martiyanov/bukifon/docs/assets/design-panel-3.jpg

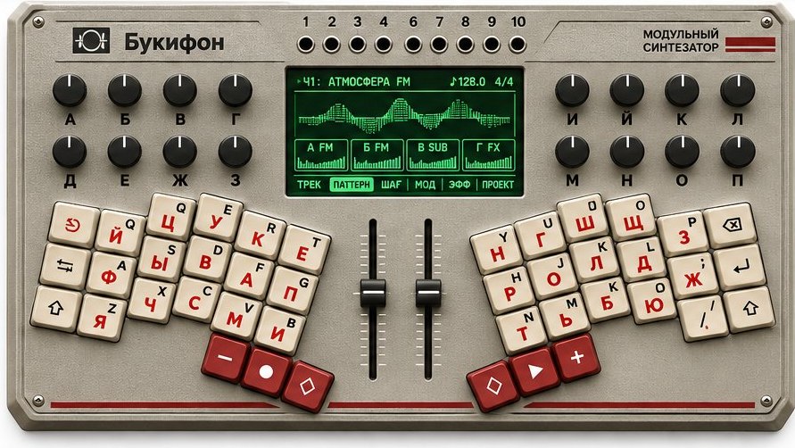
docs/assets/design-panel-3.jpg
