martiyanov/bukifon/docs/press/design-panel-1.jpg

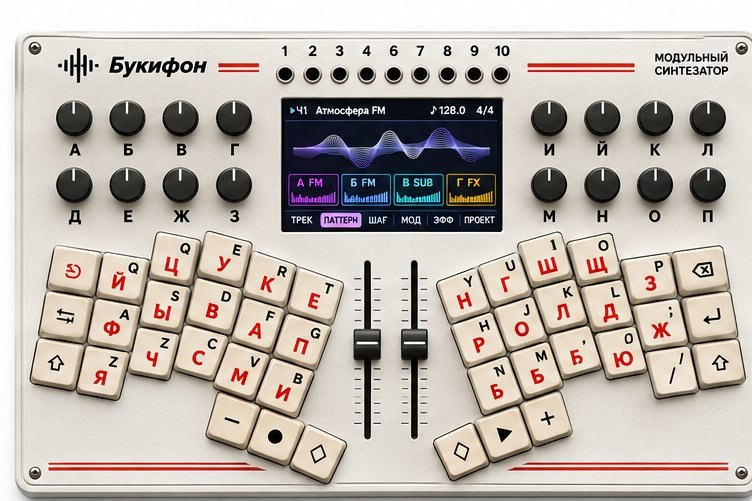
docs/press/design-panel-1.jpg
