martiyanov/bukifon/README.md

# Букифон (Bukifon) — открытая платформа: сэмплер + синтезатор + модули

**Версия: 0.57.0** · сайт: **https://bukifon.ru/** (канон, HTTPS), `bukifon.com` → 301, зеркало: https://martiyanov.github.io/bukifon/ (см. [`VERSION`](VERSION), [`CHANGELOG.md`](CHANGELOG.md))

**Букифон** — настольный музыкальный инструмент-платформа, который собирается из
доступных компонентов, печатается на 3D-принтере, расширяется модулями и полностью
открыт: схемы (KiCad), прошивка (C++), механика (STL/генератор), документация.

## Народный синтезатор

Букифон задуман как **народный инструмент**: доступный, повторяемый и открытый. Целевые
ориентиры комплекта (без печати и работы): «народный» на ESP32-S3 — **≤ $200**,
«стандарт» на ESP32-P4 — **≤ $300**, «полный» с аналоговыми картриджами — **≤ $400**.
Подробности и cost-down план — [spec/00-vision.md §13](spec/00-vision.md).

## Что это по сути

Один корпус **380 × 210 × 63 мм**, три режима:

- **Sampler** (в духе Elektron Digitakt) — сэмплы, запись/импорт по USB-C и SD,
  срезы, гранулярность, insert-FX, p-locks, условия триггеров;
- **Synth** (в духе Elektron Syntakt) — 4 части, 8 голосов, 4-оп FM, wavetable,
  ZDF-фильтры, лестница Муга, 3D-мод-матрица 16 слотов;
- **Hybrid** — сэмплы как источники синтеза, общий секвенсор и мод-матрица.

Плюс **режим компьютерной клавиатуры/контроллера**: USB-C композит (HID-клавиатура + MIDI +
UAC2 аудио), DAW-режим (16 энкодеров как CC, transport), **Wi-Fi и Bluetooth** (BLE-MIDI,
BLE HID, передача проектов). То есть Букифон — ещё и необычная механическая клавиатура
с 16 ручками.

**Свои модули может писать каждый:** программный модуль (SDK `BukifonModule`, C++/Lua),
аналоговый картридж на шине 26-pin или сменная панельная дека (18 пэдов / 42 клавиши).
Подробнее — [spec/00-vision.md §12](spec/00-vision.md).

## Текущее состояние (v0.57.0)

| Блок | Состояние |
|---|---|
| **Панель v0.4** | 380 × 210 × 3 мм: 42 клавиши Lapka-42 (точная геометрия, ±18°), 16 энкодеров Ø14, экран 5.0″ 800×480 без рамки, 10 mini-jack, 2 фейдера 60 мм; пересечений 0 |
| **Корпус v0.5-B** | **клин 8°**: 380 × 210 × 61.5 мм (перед 32 / зад 61.5), 6 деталей watertight, печать без поддержек 279 г / 18.3 ч, fitcheck 32/0, профиль 1:1 для картонной проверки |
| **EXT в прошивке** | 8 MIDI-треков (CH/PC/vel/len, 1 CC p-lock), clock out/in 24 ppqn, GEN на внешних, live record, save/load EXTP+CRC32, DIN+USB без дублей; UI-вкладка EXT; **407/407 тестов** (`docs/70 §7`) |
| **Микрофон/голос (реализовано)** | PANEL-2 rev.3: **ICS-43434 I2S MEMS** + порт Ø1.8 (122, 5.5) + LED; CORE-2 rev.3: I2S1 GPIO40/41/42 + J19 + 3.5 мм jack/MAX9814/TS5A + SW3 mute; прошивка: захват/запись ≤30 с/битбокс kick-snare-hat/UNDO/приватность/UI MIC; **407/407 тестов** |
| **Идея → звук** | метрики интуитивности в docs/68: time-to-sound ≤10 с, time-to-idea ≤30 с, 0 критических ошибок за 5 мин, blind-тест 5 людей |
| **Module SDK v0.2** | манифест `bukifon.module.v2` (schema/id/version/api/abi/permissions/params/sha256), валидатор + безопасный loader (API/ABI/SHA до исполнения), 2 примера (`mod_tape_delay`, `mod_euclid_arp`), упаковка `--check` |
| **Внешний секвенсор** | **8 MIDI-треков + 4 внутренние партии**: channel/PC/vel/length, clock out/in, p-lock CC, GEN на внешних, live record; паритет с Octatrack по MIDI (`docs/70`) |
| **Философия интерфейса** | «конституция»: 10 принципов, зеркальная карта ручка↔ячейка, грамматика жестов (`docs/68`) |
| **Читаемость** | экран 5″ 800×480 = 188 PPI, пиксель 0.135 мм; шкала 12/18/24–28 px, проверка по угловым минутам и контрасту (`docs/69`) |
| **Демо = панель** | раскладка как у реального синтезатора (16 энкодеров вокруг экрана, 10 джеков сверху, кластеры ±18°, фейдеры между кластерами); проверка `tools/check_demo_layout.js` → LAYOUT OK (`docs/67`) |
| **Внешнее ревью** | ChatGPT-ревью (`tools/chatgpt_review.sh`, Codex) — 10 рисков, 5 изменений; внедрены контекст-строка/HOME/UNDO/COMPARE/Shift-overlay (`docs/reviews/`, `docs/65 §4a`) |
| **UX-паттерны** | исследование синтезаторных практик (Elektron, Kaleidoscope Минкина, Nord/Deluge/OP-1/Push/M8) и рубрика 9/10 — `docs/65`; GEN-страница, мультивыбор, пресеты, A/B, mod-индикация в демо |
| **Home offload** | `tools/home_offload.sh` — rsync+SSH на домашний ПК (8 ядер, RTX 3060); host-тесты прошли там 226/226 |
| **Темы в прошивке** | 4 темы × 12 токенов (docs/62), рендер на токенах, CLI `--theme`, **226/226 тестов** |
| **UI/UX** | 3 итерации, 16 энкодеров (8 страниц + 8 макросов), фейдеры TRACK/SCENE/DJ + Fn, REC-ресемплинг, 4 темы экрана 800×480 (`docs/61–64`) |
| **Кириллица** | 66 глифов 6×8 (А–Я, а–я, Ё/ё), UTF-8 lookup, транслитерация удалена; метрика: max 90 px при ячейке 94 px; 10 скриншотов RU/EN |
| **Локализация** | UI RU/EN: 90+ ключей (`tr()`), переключение и сохранение языка (project v2), **кириллический glyph-пакет 6×8 (66 глифов, транслитерация удалена)**, 10 RU/EN-скриншотов |
| **Хранение** | storage backend (MockFlash/SD/NVS-stub), **атомарная A/B запись** с CRC32 и recovery; project v2, preset bank, язык — через backend; power-cut/bit-flip тесты |
| **Проект v2** | `.bkfp`: 4 партии + 8 EXT-треков + GEN + mic + модули + тема/транспорт, CRC32, миграция v1, транзакционная загрузка |
| **P4 bring-up app** | UART-баннер/чип/PSRAM, I2C-скан 8/8, RGB565-паттерны, engine bench ≤650 µs, I2S MEMS 1 с; **сборка 330 512 Б, 0 warnings** (IDF 5.5, home) |
| **P4 toolchain** | **сборка проверена** на `pole`: ESP-IDF v5.5 → `bukifon_p4.bin` 250 КБ (83 % app-раздела свободно), bootloader+table; PlatformIO P4 по-прежнему не умеет (`docs/59`) |
| **Демо RU/EN** | 256 ключей, переключатель RU/EN (URL `?lang=en`, localStorage), canvas через `t()`; **a11y**: роли/aria, клавиатурные энкодеры/фейдеры/джеки, видимый фокус, live-region; UX-тест 8/8 RU и EN |
| **Веб-демо** | интерактивная модель: [martiyanov.github.io/bukifon/demo](https://martiyanov.github.io/bukifon/demo/) — 42 клавиши, 16 энкодеров, секвенсор, FM-звук, 4 режима (`docs/58`) |
| **Закупки** | единый лист: P1 $426 + PWR $276.92 + LCD-адаптер $72.8 + печать $42 ≈ **$784** с зачётом пересечений (`docs/54`) |
| **Серийники/QR** | `tools/make_labels.py` (A4 3×8, 60×30 мм, QR+manifest), identity 114 B + двухслотовая flash-модель (`docs/55`); **216/216 тестов** |
| **Протокол P1** | 8 сценариев, пороги, пустые таблицы, матрица P4/H743 + CSV-форма (`docs/56`) |
| **LCD-адаптер** | FFC-40 breakout для HotLCD ST7262 (31×0R pinout-jumper, 35 TP, JST подсветки), ERC 0/0 — проверка экрана на стенде до PCB (`docs/49`) |
| **Release bundle** | `tools/make_release_bundle.sh` → 339 файлов / 15 МБ, SHA256SUMS; `RELEASE_BUNDLE.md`, `docs/50` |
| **Медиа** | PNG→JPEG (60 файлов, −83 МБ), SVG→.svg.gz (19, −46 МБ), дубликаты убраны; tracked **71 МБ** (`docs/52`) |
| **Дисплей** | RGB565 поверх RGB888 FPC-40: **TFT-H050A1SVIST4R40** (HotLCD/ST7262, 40-pin, 1000 нит, $18–25), резерв NHD/EJ050NA; DSI — rev.3.1 (`docs/47`) |
| **PWR-стенд** | 13 измерений до PCB (`docs/44`); BOM: база $123.92 + EVM $153 = **$276.92** (вариант A, D-79); breadboard запрещён |
| **Fab dry-run** | 4 пакета `fab/*/rev1-scaffold`: 16 Gerber-слоёв, PTH+NPTH (129/45/45/4 отверстий), CPL⊆BOM, Edge.Cuts, **checker PASS**; `tools/export_fab_dryrun.sh` — проверка пайплайна до заказа |
| **P4 NVS/partitions** | `partitions.csv` (nvs 24K, factory 1 MiB, storage 1 MiB, coredump 64K), real NVS backend, self-test `project.meta`/`lang`; **bin 369 552 Б, 65 % factory свободно** |
| **PCB rev.1: статус** | 0 placeholder, но **328 упрощённых падов** и GND без заливки: полные реальные пассивы/зоны **не проходят DRC** на 200×108 при 373 компонентах — оставлен DRC-clean каркас (0/0); скрипты упаковки/зон сохранены до трассировки после MCU freeze (docs/82 §12, D-105) |
| **PCB rev.1: реальные футпринты** | **0 placeholder**; кастомные `.kicad_mod` (P4-адаптер, C6, MP1584, Choc) + стандартные KiCad (TRS/DC/кнопки/QFN); DRC-классы Default/Power/USB_HS(90 Ω)/Audio/RF; **DRC 0/0**, RULES PASS; план GND-полигонов |
| **PCB rev.1: нетлист + футпринты** | CORE-2 **373 refs/1224 пада** (16 placeholder), PANEL-2 left/right 181/174 (по 21 Choc), PWR-2 128 (0 placeholder); **DRC 0/0**, verify PASS; unconnected — неразведённые цепи |
| **PCB rev.1 scaffolds** | KiCad-каркасы: CORE-2 200×108 6L, PANEL-2 2×180×190 4L, PWR-2 90×70 4L/2oz; Edge.Cuts/NPTH/keepout, **DRC 0/0**, verify ±0.05 мм (`hardware/*/rev1/`) |
| **Раскладка Lapka-42** | клавиши PANEL-2 исправлены: каждая плата — свои 21 (L01–L21 / R01–R21) по spec (остаточное 0.006 мм от Lapka-42), DRC 0/0; превью `docs/assets/panel-lapka-*.png` |
| **Вырезы разъёмов** | **11 задних**: MIDI IN/OUT **TRS-A Ø8.2** (X30/44), DC Ø9 X91, EXP Ø8.2 X120.5, mic Ø8.2 X140, **LINE OUT** (стерео TRS) X160, PHONES X172, AUDIO IN L/R X184/196, **CV5/6** X208/220; SD 12×2, USB-C; перемычки ≥3.8 мм; B-light **228.9 г/11.0 ч**; fitcheck 16/0 |
| **Board-fit (PCB rev.1)** | контуры для KiCad: CORE-2 200×108, PANEL-2 две платы 180×180 (360×190), PWR-2 90×70; DXF/assembly/spec, 22 проверки 0 конфликтов (`mechanical/board-fit/`) |
| **PANEL-2 ∥ панели** | стойки/плата наклонены вместе с панелью: угол **0.00°**, зазор **12 мм**, оси энкодеров/клавиш ⊥ панели; fitcheck B-light **47/0**; B-light **228.9 г/11.0 ч**; `panel_parallel.jpg` |
| **Корпуса** (с микрофоном) | B_mic ≈278 г/18.4 ч, C_mic ≈316 г/20.9 ч (порт/LED/MEMS на панелях; fitcheck 44/0 и 49/0) |
| **Корпуса** | A flat 301 г/19.9 ч · B 8° 275.5 г/18.2 ч · **B-light 228.9 г / 11.0 ч** · C 12° 313.2 г/20.7 ч; B_mic 276.8, C_mic 314.6; PANEL-2 ∥ панели (0.00°) — `docs/45` |
| **Factory test** | 14 тестов, CLI `factory --json`, loopback-плаг, EOL 2–2.5 мин (`docs/46`); **183/183 тестов** |
| **Product BOM P4 (первый SKU)** | `BOM-p4.csv` + `docs/33/40` (rev.3 с микрофоном): COGS **$241/$215/$196** на 1/10/25 (mic-узел $17.6); **P4 Standard $299** (gross 28.1 % на 10, net ~18 %), Full Bundle $399; S3 lite — $224/$199/$181 |
| **Сборка** | `renders/templates/bukifon_assembly_map_1to1.pdf` (4 стр: слои, панель 1:1, крепёж/шлейфы), `docs/34`, `docs/35` print-first, 3D exploded |
| **UI = философия** | 16 ячеек зеркально ручкам, шкала 12/18/24–28 px, контекст-строка, HOME; Cream AA; **263/263 тестов** (`docs/66/68/69`) |
| **GEN/UX в прошивке** | PROB/EUCLID/MUTATE/SCALE/ARP/EVOLVE/SEED (детерминированно), 5-я вкладка GEN, 8 пресетов с CRC32, A/B, мультивыбор, mod-visible «M»; **248/248 тестов** (`docs/66`) |
| **Прошивка v0.7** | **160/160 тестов**; S3 HAL сборка SUCCESS; spike `spike_s3` SUCCESS; **P1 P4-профиль** PASS (RGB/DSI 52 fps, HS UAC2 8×8, max block 320 µs); UI 4 режимов; Module API v0.1 |
| **CORE-2 rev.2 (основная плата)** | ESP32-P4 + ESP32-C6, 32 МБ PSRAM, USB HS, RGB565/DSI, ERC 0/0; DFM/DFT: 30 TP, **21 self-test** (вкл. микрофон), recovery, 6 слоёв — PRE-FREEZE |
| **Корпус B-light** | **228.9 г / 11.0 ч** (−17 % массы, −39 % времени): стенки 2.0/дно 1.8, 3 периметра + локальные рёбра, панели-оболочки; 6 STL watertight, fitcheck **47/0**; PANEL-2 ∥ панели |
| **CORE-2 rev.2** | схема внесена: J17/J18, входы 12V_EXT/N12_EXT/+5V_EXT/5V_LED, EN-развязки, CV IN3/4 на MCP3208, re-pin J14/J15/J16, DNP 46; **ERC 0/0**, pinmap PASS |
| **PANEL-2 rev.2** | J13/J14 (5V_LED, LED_RET, EN_RAILS, EN_LED5), re-pin по канону, GATE_IN на MCP23017 0x23, LED_DATA 3.3 В + shifter; **ERC 0 err/6 warn**, verify 1290/0 |
| **PWR-2 rev.1** | батарея 1S2P + BMS BQ297 + **MAX17048** + рельсы шины: +12 В 330 мА (TPS61088), −12 В 95 мА (LMR33630 IBB), +5 В 1.6 А, +5V_LED; master load-switch, EN рельсов, питание только от BQ24074 OUT/VSYS; ERC **0/0**, PRE-FREEZE |
| **Электроника rev.1** | **CORE-2** (ESP32-P4 + ESP32-C6 Wi-Fi/BLE по SPI, USB HS composite, аудио PCM5102A/PCM1808, CV, MIDI, шина) — ERC **0/0**, pinmap PASS (54/55 GPIO), **PRE-FREEZE**; **PANEL-2** (16 энкодеров + 42 клавиши через 4× MCP23017, LCD, 10 джеков, 2 фейдера, 3 шлейфа) — ERC 0 errors / 6 warnings, **PRE-FREEZE**. Не заказывать до бенчмарка P1 |
| **Прошивка v0.6** | host-демо UI 800×480, секвенсор 4×16 (хранение 8 дорожек), save/load с CRC16, Module API v0, режимы Synth/Sampler/DAW/USB-keyboard, каркасы USB composite и BLE/Wi-Fi; **120/120 тестов**; сборки ESP32-S3 и RP2040; P4 — toolchain пока нет |
| **P1-стенд** | `docs/26` — что купить (P4 EV, H743, S3, PCM5102A/1808, дисплей, SD, БП/нагрузка), схема стенда, протокол измерений и таблица решения; без стенда MCU не фиксируется |
| **Cost-down / первый SKU** | `docs/27`: product BOM вместо «мастерской», S3-base **kit $199** (партия 10–25, direct-sale), P4 $299 после P1, full $399 bundle; батарея — не россыпь 18650 |
| **Бумажный макет** | `renders/templates/bukifon_paperkit_1to1.pdf` (4 стр: панель 1:1 ×2, профиль 8°, карта 7 проверок) + `docs/28` |
| **Бенчмарк P1** | workload freeze + харнесс `firmware/bench` (7 сценариев, JSON/CSV, детерминизм, 0 аллокаций): host worst **218 µs** = 16.4 % дедлайна, 431 µs запаса до критерия 650 µs; `bench_s3` собран; **протокол приёма стендов P4/H743 готов** (`docs/56`, CSV-форма), стенды — следующие |
| **SDK модулей** | Module API v0 (10 функций, лимиты, WCET/bypass), каталог `modules/` (template + gain_fx C++ + LFO Lua), `tools/validate_module.py`, `tools/new_module.sh`, CI `modules.yml` |
| **BOM (draft)** | 92 позиции: база ≈ 21 657 ₽ (~$271), полный ≈ 32 518 ₽ (~$406); «народная» цель ≤ $200 / стандарт ≤ $300 — cost-down план в spec/00 §13 |
| **Безопасность** | история очищена от GPS EXIF и vendor-PDF с IP, санитизация путей, `SECURITY.md`, `tools/security_scan.sh` |

## Ключевые документы

| Документ | О чём |
|---|---|
| [spec/90-requirements-registry.md](spec/90-requirements-registry.md) | реестр требований R-01…, журнал решений D-01… — единственный источник истины |
| [docs/12-roadmap.md](docs/12-roadmap.md) | дорожная карта P0–P8 с числовыми критериями выхода |
| [docs/10-elektron-hardware.md](docs/10-elektron-hardware.md) | что стоит внутри Elektron (ColdFire, DSP56300, SHARC, FPGA) |
| [docs/11-esp32-feasibility.md](docs/11-esp32-feasibility.md) | можно ли на ESP32: расчёт нагрузки, P4/S3/H743/Teensy |
| [docs/03-second-opinion-mcu.md](docs/03-second-opinion-mcu.md) | независимое ревью плана (DeepSeek) |
| [docs/04-consultation-gpt.md](docs/04-consultation-gpt.md) | консультация GPT/Codex (gpt-5.6) по MCU и архитектуре |
| [docs/00-context-transfer.md](docs/00-context-transfer.md) | контекст проекта для передачи другим агентам |
| [PULL_REQUEST.md](PULL_REQUEST.md) | описание MR v0.4 |
| [docs/20-analog-projects.md](docs/20-analog-projects.md) | разведка аналогов (Deluge, M8, Polyend, Daisy, PreenFM, Norns…) |
| [docs/21-ergonomics.md](docs/21-ergonomics.md) | эргономика: клин 8°, 32/61.5 мм, экран 35° |
| [docs/22-night-plan.md](docs/22-night-plan.md) | ночной план и scope freeze |
| [docs/23-nightly-report.md](docs/23-nightly-report.md) | отчёт ночи: что готово/симулируется/нельзя заказывать |
| [docs/24-module-sdk.md](docs/24-module-sdk.md) | SDK модулей: Module API v0, упаковка, ограничения |
| [docs/25-power-architecture.md](docs/25-power-architecture.md) | питание: ±12 В, BQ24074, MAX17048, земля, стенд до PCB |
| [docs/26-p1-bench-kit.md](docs/26-p1-bench-kit.md) | P1-стенд: закупка, схема, протокол измерений, таблица решения MCU |
| [docs/27-costdown.md](docs/27-costdown.md) | cost-down, product BOM, первый SKU S3-kit $199, батарея, дефицит |
| [docs/28-paper-kit.md](docs/28-paper-kit.md) | бумажный макет 1:1 за 30 минут: 7 проверок эргономики |
| [docs/29-p1-order.md](docs/29-p1-order.md) | точный список заказа P1-стенда (что, где, сколько) |
| [docs/54-shopping-list.md](docs/54-shopping-list.md) | **единый закупочный лист**: P1 + PWR + LCD-адаптер + печать, итоги A–D, порядок |
| [docs/30-security-purge.md](docs/30-security-purge.md) | запрос на purge старых PII-объектов GitHub (SHA) |
| [docs/31-core-s3-constraints.md](docs/31-core-s3-constraints.md) | CORE-S3: GPIO 31, 1-bit SD, USB endpoint ceiling, RGB+1FB, TPS63802 |
| [docs/32-progress-report.md](docs/32-progress-report.md) | сводный отчёт v0.4→v0.13.0: вехи, блокеры, следующий шаг |
| [docs/49-lcd-adapter.md](docs/49-lcd-adapter.md) | LCD FFC-40 адаптер и pinout J12 |
| [docs/50-downloads.md](docs/50-downloads.md) | где скачать STL/PDF/BOM/прошивку |
| [docs/51-pwr-log.md](docs/51-pwr-log.md) | журнал 13 измерений PWR и матрица go/no-go |
| [docs/52-media-policy.md](docs/52-media-policy.md) | форматы медиа и размер репозитория |
| [docs/54-shopping-list.md](docs/54-shopping-list.md) | единый закупочный лист до PCB |
| [docs/55-labels-traceability.md](docs/55-labels-traceability.md) | серийники, QR-метки, traceability |
| [docs/56-p1-measurements.md](docs/56-p1-measurements.md) | протокол P1: P4 vs H743 |
| [docs/57-usability-test.md](docs/57-usability-test.md) | тест эргономики на макете |
| [docs/58-web-demo.md](docs/58-web-demo.md) | веб-демо интерфейса и звука |
| [docs/59-p4-toolchain.md](docs/59-p4-toolchain.md) | P4: ESP-IDF scaffold и сборка |
| [docs/60-module-distribution.md](docs/60-module-distribution.md) | упаковка и распространение модулей |
| [docs/61-ui-design.md](docs/61-ui-design.md) | UI/UX: итерации и лучшие практики |
| [docs/62-screen-palette.md](docs/62-screen-palette.md) | палитра экрана 800×480 (4 темы) |
| [docs/63-resampling-looper.md](docs/63-resampling-looper.md) | ресемплинг (v1.0) и луппер (backlog) |
| [docs/64-fader-modes.md](docs/64-fader-modes.md) | режимы фейдеров: Octatrack-сцены, DJ, Fn |
| [docs/65-ux-patterns.md](docs/65-ux-patterns.md) | UX-паттерны синтезаторов, связка с железом, рубрика 9/10 |
| [docs/66-ux-implementation.md](docs/66-ux-implementation.md) | реализация UX-паттернов: GEN, пресеты, A/B, мультивыбор |
| [docs/67-panel-demo-layout.md](docs/67-panel-demo-layout.md) | сверка раскладки демо с панелью v0.4 |
| [docs/68-interface-philosophy.md](docs/68-interface-philosophy.md) | философия интерфейса и продукта (конституция) |
| [docs/69-screen-legibility.md](docs/69-screen-legibility.md) | читаемость экрана 800×480: физика, шрифты, контраст |
| [docs/70-external-sequencer.md](docs/70-external-sequencer.md) | Букифон как секвенсор для внешних синтезаторов |
| [docs/71-mic-voice.md](docs/71-mic-voice.md) | микрофон/голос: запись, битбокс, вокодер, приватность |
| [docs/72-assembly-workshops.md](docs/72-assembly-workshops.md) | где собрать: мастерские Москвы/СПб/НН, RFQ, цены |
| [docs/73-morning-report.md](docs/73-morning-report.md) | утренний отчёт: состояние, блокеры, план, риски |
| [docs/74-usability-test-harness.md](docs/74-usability-test-harness.md) | blind UX-тест: 8 задач, таймер, JSON (`/demo/?test=1`) |
| [docs/75-release-readiness.md](docs/75-release-readiness.md) | ворота G1–G12 до v1.0-rc, статусы, stop/go |
| [docs/76-known-limitations.md](docs/76-known-limitations.md) | честные ограничения v1.0-rc (до покупки) |
| [docs/77-quick-start.md](docs/77-quick-start.md) | быстрый старт: идея за 10 минут |
| [docs/78-support-repair.md](docs/78-support-repair.md) | поддержка/ремонт: диагностика, recovery, запчасти, гарантия |
| [docs/79-competitors-2026.md](docs/79-competitors-2026.md) | аналоги 2025–2026, позиционирование и цены |
| [docs/80-day1-bringup.md](docs/80-day1-bringup.md) | день 1 с железом: PWR→P1→CORE-2, 15 шагов, stop/go |
| [docs/81-faq.md](docs/81-faq.md) · [docs/press/](docs/press/) | FAQ для покупателя · пресс-кит (буилерплейт RU/EN, изображения) |
| [docs/82-pcb-layout-plan.md](docs/82-pcb-layout-plan.md) | план разводки rev.1: стеки, floorplan, DRC/DFM, критичные цепи |
| [docs/83-fab-package.md](docs/83-fab-package.md) · [fab/](fab/) | состав fab-пакета, CPL/BOM, чек-лист, приёмка; `tools/check_fab_package.py` |
| [docs/84-costdown.md](docs/84-costdown.md) | cost-down: где деньги, варианты снижения, маржа $299/$319/$349 |
| [docs/85-second-source.md](docs/85-second-source.md) | вторые источники, supply-риски, чек-лист до заказа |
| [docs/86-backlog-webapp-plugin.md](docs/86-backlog-webapp-plugin.md) | бэклог: сайт на VDS, PWA-приложение, DAW-плагин |
| [docs/91-software-modules.md](docs/91-software-modules.md) | софтовые модули/машины: `.bkm`, USB/SD/Wi-Fi, sandbox, каталог |
| [docs/87-v1.0-rc-notes-draft.md](docs/87-v1.0-rc-notes-draft.md) | черновик release notes v1.0-rc (критерии, проверки) |
| [docs/88-vds-deploy.md](docs/88-vds-deploy.md) | деплой сайта на VDS (bukifon.ru/.com): DNS, TLS, скрипт |
| [docs/en/README.md](docs/en/README.md) · [quick-start](docs/en/quick-start.md) | English docs index / quick start |
| [docs/72-assembly-workshops.md](docs/72-assembly-workshops.md) | где собрать: мастерские Москвы/СПб/НН, RFQ, цены |
| [docs/73-morning-report.md](docs/73-morning-report.md) | утренний отчёт: состояние, блокеры, план, риски |
| [docs/74-usability-test-harness.md](docs/74-usability-test-harness.md) | blind UX-тест: 8 задач, таймер, JSON (`/demo/?test=1`) |
| [docs/75-release-readiness.md](docs/75-release-readiness.md) | ворота G1–G12 до v1.0-rc, статусы, stop/go |
| [docs/76-known-limitations.md](docs/76-known-limitations.md) | честные ограничения v1.0-rc (до покупки) |
| [docs/77-quick-start.md](docs/77-quick-start.md) | быстрый старт: идея за 10 минут |
| [docs/78-support-repair.md](docs/78-support-repair.md) | поддержка/ремонт: диагностика, recovery, запчасти, гарантия |
| [docs/79-competitors-2026.md](docs/79-competitors-2026.md) | аналоги 2025–2026, позиционирование и цены |
| [docs/80-day1-bringup.md](docs/80-day1-bringup.md) | день 1 с железом: PWR→P1→CORE-2, 15 шагов, stop/go |
| [docs/81-faq.md](docs/81-faq.md) · [docs/press/](docs/press/) | FAQ для покупателя · пресс-кит (буилерплейт RU/EN, изображения) |
| [docs/82-pcb-layout-plan.md](docs/82-pcb-layout-plan.md) | план разводки rev.1: стеки, floorplan, DRC/DFM, критичные цепи |
| [docs/83-fab-package.md](docs/83-fab-package.md) · [fab/](fab/) | состав fab-пакета, CPL/BOM, чек-лист, приёмка; `tools/check_fab_package.py` |
| [docs/84-costdown.md](docs/84-costdown.md) | cost-down: где деньги, варианты снижения, маржа $299/$319/$349 |
| [docs/85-second-source.md](docs/85-second-source.md) | вторые источники, supply-риски, чек-лист до заказа |
| [docs/86-backlog-webapp-plugin.md](docs/86-backlog-webapp-plugin.md) | бэклог: сайт на VDS, PWA-приложение, DAW-плагин |
| [docs/91-software-modules.md](docs/91-software-modules.md) | софтовые модули/машины: `.bkm`, USB/SD/Wi-Fi, sandbox, каталог |
| [docs/87-v1.0-rc-notes-draft.md](docs/87-v1.0-rc-notes-draft.md) | черновик release notes v1.0-rc (критерии, проверки) |
| [docs/88-vds-deploy.md](docs/88-vds-deploy.md) | деплой сайта на VDS (bukifon.ru/.com): DNS, TLS, скрипт |
| [docs/en/README.md](docs/en/README.md) · [quick-start](docs/en/quick-start.md) | English docs index / quick start |
| [docs/53-pwr-log.md](docs/51-pwr-log.md) | журнал 13 измерений PWR и go/no-go |
| [docs/33-bom-s3.md](docs/33-bom-s3.md) | product BOM S3-base: COGS 1/10/25, опции, маржа |
| [docs/34-assembly.md](docs/34-assembly.md) | пошаговая сборка S3-base (B-light) |
| [docs/35-print-first.md](docs/35-print-first.md) | что печатать первым и как проверить жёсткость |
| [docs/36-rc-definition.md](docs/36-rc-definition.md) | Definition of Done для v1.0-rc (S3-base) |
| [docs/37-compliance.md](docs/37-compliance.md) | RED/GPSR, батарея, EMC, SBOM, гарантия, SKU-экономика |
| [docs/05-benchmark-workload.md](docs/05-benchmark-workload.md) | workload freeze P1 и критерии |
| [docs/05a-benchmark-howto.md](docs/05a-benchmark-howto.md) | как запустить бенчмарк на S3/P4/H743 |
| [docs/56-p1-measurements.md](docs/56-p1-measurements.md) | **протокол P1 P4 vs H743**: стенд, 8 сценариев, пороги, матрица решения, fallback H743 |
| [docs/p1-results-template.csv](docs/p1-results-template.csv) | машиночитаемая форма результатов P1 (P4/H743 × 8 сценариев) |
| [modules/](modules/) | каталог модулей: шаблон, примеры gain_fx и LFO |
| [firmware/bench/](firmware/bench/) | харнесс P1 (fm/granular/mix/psram/ui/usb, JSON/CSV) |
| [SECURITY.md](SECURITY.md) | политика безопасности и приватности |

## Компоновка панели v0.4

Канон — [`spec/panel-spec-v0.4.json`](spec/panel-spec-v0.4.json) (координаты всех элементов в мм).
Печать 1:1: [renders/templates/bukifon_v04_panel_1to1.pdf](renders/templates/bukifon_v04_panel_1to1.pdf)
(**A3** 420×297) или [4×A4 с перекрытием](renders/templates/bukifon_v04_panel_tiles_A4.pdf); печатать 100 %, проверить линейку 50 мм.

| Элемент | Координаты (мм) |
|---|---|
| Клавиши | 2 × 21 Lapka-42, Choc 18 × 17, половины ±18°, кластеры центром (83, 148) и (297, 148) |
| Энкодеры Ø14 | X = 25.2 / 54.1 / 82.6 / 111.4 и 269.3 / 297.8 / 326.6 / 355.8; Y = 35.7 / 68.5 |
| Экран 5.0″ | вырез 108 × 64.8, центр (190, 58.7), без рамки |
| Mini-jack 3.5 | 10 шт., X = 129.9…247.8 (шаг 13.1), Y = 10.5 |
| Фейдеры | X = 175.1 / 204.0, центр Y = 150, прорезь 2.5 × 63 |
| Динамики | **нет** (по ТЗ) |
| Разъёмы под экраном | **нет** (по ТЗ) |

Превью: [renders/templates/bukifon_v04_render.png](renders/templates/bukifon_v04_render.png),
сравнение с концептом заказчика: [renders/templates/bukifon_v04_vs_concept.jpg](renders/templates/bukifon_v04_vs_concept.jpg).

## 3D-печать (корпус v0.4)

- STL/3MF: [`mechanical/stl_v04/`](mechanical/stl_v04/) — panel_L/panel_R, body_L/body_R, foot, keycap;
  сборка `bukifon_v04_assembly.3mf`;
- рендеры: [`mechanical/preview_v05_compare/`](mechanical/preview_v05_compare/) (сравнение вариантов, изометрия, вид сверху,
  наложение на 2D-эталон, разнесённый вид, close-up);
- параметры печати и время: [mechanical/prints.md](mechanical/prints.md);
- сборка: [mechanical/assembly.md](mechanical/assembly.md), проверки: [mechanical/fit_check.md](mechanical/fit_check.md).

## Сборка прошивки (прототип RP2040)

```bash
export PLATFORMIO_CORE_DIR=/tmp/piocore
/tmp/msvenv/bin/pio run -d firmware/Bukifon      # сборка UF2
cd firmware/host && make test                    # host-тесты DSP (407 тестов)
```

## Структура репозитория

Текущее — в рабочих папках; старые версии доступны в **git-тегах** и `dist/bukifon-fresh-*.bundle` (архивные папки удалены 06.11.2025 для чистоты дерева); карта — [STRUCTURE.md](STRUCTURE.md).

```
spec/            требования, архитектура, электрика, механика, прошивка, реестр требований
docs/            обзор, гайд сборки, лицензии, ревью MCU, консультация GPT, дорожная карта
hardware/        KiCad: CORE-1, PANEL-1, деки, аналоговые модули, питание
firmware/        прошивка (движок, драйверы, UI, тесты)
mechanical/      параметрический генератор корпуса, STL/3MF, рендеры, печать/сборка
tools/           генераторы раскладок, печатных листов, трассировка концепта
renders/         шаблоны 1:1 и превью (templates/)
refs/            эскизы и фото заказчика, пакет handoff v0.3
BOM.csv          сводный BOM
```

## Версионирование

SemVer + аннотированный тег на каждый релиз. Правила — в [AGENTS.md](AGENTS.md).
История — [CHANGELOG.md](CHANGELOG.md). Теги: `v0.1.0` (прототип 315×145), `v0.2.0`
(печатные листы), `v0.3.0` (раскладка 380×210), `v0.4.0` (канон v0.4).

## Лицензии и атрибуция

- аппаратура и механика — CERN-OHL-S-2.0;
- прошивка — GPL-3.0-or-later;
- документация — CC BY-SA 4.0;
- раскладка Lapka-42 — атрибуция braindefender/lapka-42 (см. [NOTICE](NOTICE)).

## Репозиторий

**https://github.com/martiyanov/bukifon** — `main` (стабильная ветка), работа ведётся
в `feature/panel-v04-canonical` до слияния MR.
