martiyanov/bukifon/mechanical/README.md

# Букифон — механика корпуса (v1.0)

3D-печатный корпус-геймпад для открытого синтезатора **Букифон**:
315 × 145 × 48 мм (высота без ручек), две рукоятки, 8 ручек, 2 слайдера,
сменный модуль ввода (18 пэдов **или** 42 клавиши), верхний и нижний доки.

- Спецификация: [`spec/30-mechanics.md`](../spec/30-mechanics.md) (главный
  контракт), [`spec/10-panel-ui.md`](../spec/10-panel-ui.md) (координаты
  органов управления), [`spec/00-vision.md`](../spec/00-vision.md),
  [`spec/20-electronics.md`](../spec/20-electronics.md) §9 (разъёмы).
- Лицензия: **CERN-OHL-S-2.0** (см. `LICENSE`).
- Генератор: `generator/case.py` + `generator/params.py`
  (все числа — из spec, с комментариями-источниками).

## 0a. Актуальные варианты корпуса (v0.5, текущий генератор)

| Вариант | Угол | Файлы STL | Масса / время | Когда |
|---|---|---|---|---|
| **A — flat** | 0° | `stl_v05_A/` (body 193/190×210×60, копия v0.4) | ≈302 г / 20.0 ч | студия/настольный, v0.4-совместимость |
| **B — клин 8°** | 8° | `stl_v05_B/` | ≈277 г / 18.3 ч | базовый v1.0-rc |
| **B-light** | 8° | `stl_v05_B_light/` (+ mic_guide/clip) | ≈231 г / 11.2 ч с микрофоном | народная версия (0.6/3 периметра) |
| **C — клин 12°** | 12° | `stl_v05_C/` (+ battery_lid, stand) | ≈314 г / 20.8 ч | нишевый: отсек 1S2P + подставка |

Генератор: `generator/case_v05.py A|B|C`; fitcheck: `fitcheck_v05_light.py`
(B-light), `fitcheck_v05_A.py` (A), `fitcheck_v05_C.py` (C); документы —
`docs/45-case-variants.md`, `prints.md`, `docs/27-costdown.md` §5.

## 1. Что лежит в папке

```
mechanical/
├── generator/
│   ├── params.py          # ВСЕ константы (габарит, Z-стек, окна, платы)
│   ├── case.py            # параметрический генератор → STL + assembly.json
│   ├── fitcheck.py        # проверка коллизий → fit_check.md
│   ├── render_blender.py  # рендеры (Blender headless)
│   └── assembly.json      # сгенерированные трансформы сборки (для рендера)
├── stl_v05_A/             # flat 0°: body_L/R, panel_L/R, foot, keycap (+3MF, сборка)
├── stl_v05_B/             # клин 8°: body_L/R (v1.0-rc)
├── stl_v05_B_light/       # клин 8° облегчённый + микрофон (mic_guide/clip/holder)
├── stl_v05_C/             # клин 12° + батарейный отсек + подставка
├── stl/                   # 20 STL (список ниже)
├── preview/               # PNG-рендеры (iso, front, rear, exploded, parts_all,
│                          #   deck_pad_closeup, deck_keys_closeup)
├── test_fit/test_cross.stl# калибровочный крест (втулка M3 + шип + паз)
├── prints.md              # карта печати: ориентация, материал, граммы, время
├── assembly.md            # порядок сборки и крепёж
├── fit_check.md           # отчёт о проверке коллизий (генерируется)
├── exploded.jpg           # взрыв-схема (копия из preview/)
└── README.md              # этот файл
```

## 2. Как перегенерировать

Зависимости: Python 3.12+ (venv `/tmp/msvenv`), `trimesh 5.x`, `manifold3d`,
`shapely 2.x`, `mapbox_earcut`, `numpy`, `matplotlib`; Blender 5.1 (только для
рендеров).

```bash
cd <repo>

# 1) STL + assembly.json + fit_check.md
MPLCONFIGDIR=/tmp/mplcache /tmp/msvenv/bin/python mechanical/generator/case.py

# 2) рендеры (Blender headless, Cycles CPU; ~30–60 c на кадр)
MPLCONFIGDIR=/tmp/mplcache /Applications/Blender.app/Contents/MacOS/Blender \
  -b -P mechanical/generator/render_blender.py -- \
  --samples 48 --res 1600 1000
```

Время генерации STL — около **2–3 секунд**, все детали watertight.
`fit_check.md` перезаписывается автоматически при каждом запуске `case.py`.

Параметры правятся **только** в `params.py`; `case.py` читает их и строит
геометрию. Если правится spec — сначала spec, потом `params.py` (каждая
константа помечена источником).

## 3. Состав STL (20 файлов)

| Файл | Кол-во в изделии | Габарит, мм | Материал |
|---|---|---|---|
| `bottom_L.stl`, `bottom_R.stl` | 2 | 157.5 × 145 × 43 | PETG |
| `panel_upper_L.stl`, `panel_upper_R.stl` | 2 | 157.5 × 66 × 3 | PLA/PETG |
| `deck_plate_L_pads.stl`, `deck_plate_R_pads.stl` | 2 | 148 × 78 × 2.5 | PLA |
| `deck_plate_L_keys.stl`, `deck_plate_R_keys.stl` (опция) | — | 148 × 78 × 2.5 | PLA |
| `knob.stl` | 8 | Ø18 × 15 | PETG прозрачный |
| `pad_cap.stl` | 18 | 20 × 20 × 9 | TPU/PLA |
| `keycap.stl` | 42 (KEYS) | 17.5 × 16.5 × 8 | PLA полупрозрачный |
| `fader_cap.stl` | 2 | 16 × 9 × 8 | PETG |
| `shoulder_cap.stl` | 4 | Ø10 × 4 | PETG |
| `light_guide.stl` | 9 | Ø4 × 6 | PETG прозрачный |
| `dock_cradle.stl` | 1 | 110 × 45 × 23 | PETG |
| `bay_hatch.stl` | 1 | 210 × 70 × 2 | PETG |
| `rear_plate_L.stl`, `rear_plate_R.stl` | 2 | 150 × 44 × 2 | PETG |
| `grip_pad.stl` | 2 | 55 × 85 × 3.5 | TPU |
| `seam_key.stl` | 2 | 6 × 3 × 2 | PETG |
| `test_fit/test_cross.stl` | 1 | 30 × 16 × 15 | PLA/PETG |

Все детали ≤ 220 × 220 (Ender-3): максимум — `bay_hatch` 210 мм.
Габариты и watertight-статус каждой детали — в `fit_check.md` §2.

## 4. Что проверено

| Проверка | Как | Результат |
|---|---|---|
| Замкнутость (watertight) всех STL | `trimesh` в `case.py` | **все 20 деталей watertight**, самопересечений нет |
| Габариты деталей ≤ 220³ | автоматически | OK |
| Коллизии плат (CORE-1, PANEL-1, DECK, экран) | точные булевы пересечения (manifold3d) | OK, кроме 1 известного конфликта (см. ниже) |
| Коллизии ручек/колпачков/накладок с пластинами | булевы пересечения | OK |
| Z-стек и зазоры (0…61) | арифметика по params | OK |
| Габарит корпуса | STL + сборка | 315 × 145 × 46 (+2 мм TPU = 48) |

**Один известный конфликт** (честно, в `fit_check.md` §2 и §4):
2 из 4 стоек слайдеров (Y = 94) проходят через зону CORE-1 (200 × 108 @ Z16).
Варианты: 2 отверстия Ø6.4 в CORE-1 **или** сдвиг слайдеров/стоек на 5–7 мм.
Колпачки пэдов/клавиш, экран, док, задняя панель, крышка брюха — без
пересечений (касания < 3 мм³ считаются посадкой «в натяг»).

Не проверялось: реальная топология PCB и высоты компонентов, трассы
шлейфов, прочность PETG, точность FDM (для неё — калибровочный крест).

## 5. Отклонения от spec (осознанные, с числами)

1. **«Рукоятки до 56 мм»** не достижимы при полноразмерной панели 315 × 145:
   любая точка выше 46 пересекает панельные пластины. Корпус 0…46,
   рукоятки — подвесные поды 0…8 (толщина 8 «сверх дна»), полная высота с
   TPU-ножками **48 мм**, ручки 46…61. Это зафиксировано в `fit_check.md` §4.
2. **«Горб под ладонь +8»** реализован как подушка рукоятки толщиной 8 мм
   ниже дна скорлупы + скругление R22, а не как подъём над панелью.
3. **«Седло» 0.8 мм** панели не выполнено: панель плоская (печать без
   поддержек и совместимость с окнами важнее; R8 по углам сохранён).
4. **PANEL-1 300 × 132 и DECK 290 × 78 на одном Z = 37 пересекаются** по
   spec/30 §1. В модели у PANEL-1 сделан вырез 290 × 78 (`PANEL1_CUT`), DECK
   ставится в вырез. Требуется учесть в разводке PANEL-1.
5. **Переходные отверстия плат**: стойки панельных пластин Ø6.2 проходят
   сквозь PANEL-1 в точках (12,40), (100,10), (215,10), (303,40); стойки
   DECK Ø6.2 — (88,138), (125,138), (190,138), (227,138). Нужно учесть в PCB.
6. **DECK PCB сдвинут на 1.7 мм** к задней стенке (Y 64.5…142.3, 78 мм):
   при Y 66…144 PCB упирается в переднюю стенку скорлупы.
7. **`rear_plate` разделён на L/R** по 150 × 44 × 2: деталь 300 мм не влезает
   в Ender-3 (220). Стык по X = 157.5, скрыт; всего 6 винтов M3.
8. **`dock_cradle` 110 × 45 × 23** вместо 110 × 40 × 20: L-образная скоба
   крепится к задней стенке и стоит **за** корпусом (Y −42…3), чтобы не
   накрывать экран и ручки; +5 Y и +3 Z — крепёжные лапки и полка.
9. **Колпачки KEYS** 17.5 × 16.5 не проходят в окно 14.2 — это гнездо Choc;
   колпачки стоят **над** пластиной (Z 45.6…53.6), верх клавиш выше
   номинала spec/30 §1 (46.8). Окно 14.2 оставлено как окно гнезда.
10. **Пэды**: колпачок 20 × 20 × 9 проходит в окно 20.6 × 20.6 (зазор 0.3/
    сторону), верх 47.6 (+1.6 над панелью вместо +0.8).
11. **Шипы шва 6 × 3** — отдельные печатные шпонки `seam_key` (2 шт.) в пазах
    половин: так `bottom_L/R` остаются ровно 157.5 мм. 4 стяжных винта
    M3 × 16 — горизонтальные, доступ из брюха после снятия крышки.

## 6. Быстрые ссылки

- Как печатать: [`prints.md`](prints.md)
- Как собирать: [`assembly.md`](assembly.md)
- Отчёт о коллизиях: [`fit_check.md`](fit_check.md)
<!-- section:v1.7-readme -->

---

# Букифон v1.7 — корпус 380 × 210 × 63 (task-9)

Актуальная версия корпуса — по утверждённому концепту заказчика
(`refs/concept-panel.jpg`, `spec/panel-spec-v1.7.json`).

## Файлы v1.7

```
mechanical/
├── generator/params_v17.py      # все константы; панель читается из JSON
├── generator/case_v17.py        # генератор: STL + 3MF + assembly_v17.json
├── generator/fitcheck_v17.py    # проверки (секция v1.7 в fit_check.md)
├── generator/render_v17.py      # рендеры Blender → preview_v17/
├── stl_v17/                     # body_L/R, panel_L/R, foot, keycap_v17 (STL + 3MF)
├── preview_v17/                 # iso_top, front_panel, exploded, panel_closeup,
│                                #   top_ortho (строго сверху) + top_ortho_overlay
│                                #   (наложение на утверждённый 2D-эталон)
├── prints.md                    # раздел «Букифон v1.7»
├── assembly.md                  # раздел «Букифон v1.7»
└── fit_check.md                 # секция v1.7 (0 конфликтов)
```

## Как перегенерировать v1.7

```bash
cd <repo>
MPLCONFIGDIR=/tmp/mplcache /tmp/msvenv/bin/python mechanical/generator/case_v17.py
MPLCONFIGDIR=/tmp/mplcache /Applications/Blender.app/Contents/MacOS/Blender \
  -b -P mechanical/generator/render_v17.py -- --samples 36 --res 1600 1000
```

## Решения v1.7

1. **Габарит в сборе:** 380 × 210 × 63 мм — корпус 0…60 (дно 3, стенка 2.5),
   панель 60…63 (3 мм), втулки/винты утоплены; ножки Ø12 × 2.5 утоплены в дно
   и высоту не добавляют.
2. **Разрез печати X = 190** (детали ≤ 220): панель 193 + 190 мм,
   корпус 193 + 190 мм. Шов проходит через окно экрана (скрыт стеклом),
   между джеками (184.5 / 195.5), между фейдерами (180 / 200) и по
   центральному зазору клавиатур (143.7…236.3) — на лицевой стороне видна
   только тонкая линия в промежутках.
3. **Стык:** шип 3 × 1.2 мм в нижних слоях панели + паз 3.2; шип дна корпуса
   3 × 3 мм + паз. Печать без поддержек: панели лицом вверх, корпус —
   открытой полостью вверх.
4. **Панель** (380 × 210 × 3): 42 окна Choc 14 × 14 с поворотом по JSON,
   16 × Ø7.2 под EC11 + утопление гайки Ø14.4 × 1.4, 10 × Ø6.2 mini-jack +
   гайка Ø8.2, вырез экрана 108 × 64.8 без рамки + 4 × M2.5 снизу,
   2 окна фейдеров 8 × 68 + 8 × M2.5, 4 × M3 по углам, вырез USB-C на задней
   кромке (9.4 × 3.6).
5. **Внутри:** PANEL-1 rev.2 360 × 190 на 6 стойках Z47 (с вырезами под
   панельные компоненты), CORE-1 rev.3 200 × 108 на 4 стойках Z12,
   батарея 1S2P 18650 в 3 седлах у правой стенки, рёбра жёсткости,
   6 вентщелей в дне, окно USB-C-кабеля в задней стенке.
6. **Платы** PANEL-1 rev.2 / CORE-1 rev.3 приняты как посадочные габариты
   (документации ревизий в репозитории нет) — см. fit_check §v1.7-2.
<!-- section:v0.4-readme -->

---

# Букифон v0.4 — панель по канону (task-10)

Канон панели — `spec/panel-spec-v0.4.json` (точная Lapka-42 ±18°).
Пересобрана **только панель**; корпус/ножки/крепёж — из v1.7.

```
mechanical/
├── generator/params_v04.py     # все координаты панели из v0.4 JSON
├── generator/case_v04.py       # panel_L/R + копии корпуса/ножек/колпачков
├── generator/fitcheck_v04.py   # проверки → секция v0.4 в fit_check.md
├── generator/render_v04.py     # рендеры → preview_v04/
├── stl_v04/                    # panel_L/R (+3MF), копии body/foot/keycap_v17
├── preview_v04/                # iso_top, top_ortho, top_ortho_overlay,
│                               #   panel_closeup (строго по канону v0.4)
└── fit_check.md                # секция v0.4 (0 конфликтов)
```

Перегенерация:

```bash
MPLCONFIGDIR=/tmp/mplcache /tmp/msvenv/bin/python mechanical/generator/case_v04.py
MPLCONFIGDIR=/tmp/mplcache /Applications/Blender.app/Contents/MacOS/Blender \
  -b -P mechanical/generator/render_v04.py -- --samples 32 --res 1600 1000
```

Ключевые проверки v0.4: все центры вырезов = JSON ±0.05 мм; 83 сквозных
отверстия; 0 пересечений (корпус/платы/компоненты); габарит 380 × 210 × 63;
overlay `top_ortho_overlay.png` — наложение на `renders/templates/bukifon_v04_render.png`.
