martiyanov/bukifon/mechanical/board-fit/README.md

# board-fit: посадочные места PCB rev.1 (CORE-2 / PANEL-2 / PWR-2)

Сгенерировано `mechanical/generator/make_board_fit.py` из параметров генератора (`params_v05`, `params_v17`, `params_v04`) и `spec/panel-spec-v0.4.json`. STL/JSON канона не меняются.

Единицы — **мм**; локальная СК платы: начало в левом-нижнем углу контура, X вправо, **Y вверх** (совпадает с Y панели/мира: 0 — задняя кромка).

## 1. Контуры плат

| Плата | Ревизия | Origin (world X,Y) | Контур, мм | Толщина | Крепёж |
|---|---|---|---|---|---|
| CORE-2 | rev.0 | 90; 51 | 200 × 108 | 1.6 | 4×M3 |
| PANEL-2-left | rev.2 | 10; 10 | 180 × 190 | 1.6 | 3×M3 |
| PANEL-2-right | rev.2 | 190; 10 | 180 × 190 | 1.6 | 3×M3 |
| PWR-2 | rev.1 | 145; 65 | 90 × 70 | 1.6 | 4×M2.5 |

> **PANEL-2 — две платы** по шву X=190: 180 + 180 в общем контуре 360×190 (X 10…370, Y 10…200). Механический разрез панели — 193 + 190 (3 мм — шип панели, не платы). Ниша корпуса B: 375×205 (стенки 2.5), B-light: 376×206 (стенки 2.0) — платы проходят в обе редакции.

## 2. Крепёж (координаты — мировые, мм)

### CORE-2 — 4 × M3
| Отверстие | World X; Y | Local X; Y | Ø отверстия | Ø стойки |
|---|---|---|---|---|
| H1 | 95.0; 59.0 | 5.0; 8.0 | 3.4 | 7.0 |
| H2 | 285.0; 59.0 | 195.0; 8.0 | 3.4 | 7.0 |
| H3 | 95.0; 151.0 | 5.0; 100.0 | 3.4 | 7.0 |
| H4 | 285.0; 151.0 | 195.0; 100.0 | 3.4 | 7.0 |

### PANEL-2-left — 3 × M3
| Отверстие | World X; Y | Local X; Y | Ø отверстия | Ø стойки |
|---|---|---|---|---|
| H1 | 30.0; 46.0 | 20.0; 36.0 | 3.4 | 7.0 |
| H2 | 65.0; 46.0 | 55.0; 36.0 | 3.4 | 7.0 |
| H3 | 150.0; 46.0 | 140.0; 36.0 | 3.4 | 7.0 |

### PANEL-2-right — 3 × M3
| Отверстие | World X; Y | Local X; Y | Ø отверстия | Ø стойки |
|---|---|---|---|---|
| H1 | 230.0; 46.0 | 40.0; 36.0 | 3.4 | 7.0 |
| H2 | 283.0; 46.0 | 93.0; 36.0 | 3.4 | 7.0 |
| H3 | 341.0; 46.0 | 151.0; 36.0 | 3.4 | 7.0 |

### PWR-2 — 4 × M2.5
| Отверстие | World X; Y | Local X; Y | Ø отверстия | Ø стойки |
|---|---|---|---|---|
| H1 | 152.0; 72.0 | 7.0; 7.0 | 2.8 | 6.0 |
| H2 | 228.0; 72.0 | 83.0; 7.0 | 2.8 | 6.0 |
| H3 | 152.0; 128.0 | 7.0; 63.0 | 2.8 | 6.0 |
| H4 | 228.0; 128.0 | 83.0; 63.0 | 2.8 | 6.0 |

## 3. Вырезы/разъёмы на кромках

| Узел | Где | Размер/Ø | Примечание |
|---|---|---|---|
| USB-C | body rear wall | X [346.0, 356.0] ; Y [-1.0, 3.5] | окно в задней стенке корпуса (есть в STL) |
| vents | body floor rear | X [70, 100, 130, 250, 280, 310] ; Y [22.0, 44.0] | вентиляционные щели (есть в STL) |
| mic-port | panel top edge (B-light/B_mic/C_mic) | X 122.0 ; Y 5.5 ; Ø/d 1.8 | акустический порт MEMS + LED (116;10.5); B/C — опционально |
| midi-in | rear wall (есть в STL) | X 30.0 ; Y 0.0 ; Ø/d 8.2 | MIDI IN TRS-A J6 — Ø8.2 (не DIN Ø14: BOM J6/J7 TRS) |
| midi-out | rear wall (есть в STL) | X 44.0 ; Y 0.0 ; Ø/d 8.2 | MIDI OUT TRS-A J7 — Ø8.2 |
| dc-in | rear wall (есть в STL) | X 91.0 ; Y 0.0 ; Ø/d 9.0 | DC 12 В J12 Ø9 |
| expression | rear wall (есть в STL, резерв) | X 120.5 ; Y 0.0 ; Ø/d 8.2 | EXPRESSION J13 Ø8.2 — DNP/D-44, резерв |
| mic-jack | rear wall (есть в STL) | X 140.0 ; Y 0.0 ; Ø/d 8.2 | mic/headset J20 Ø8.2 (docs/71) |
| line-out | rear wall (есть в STL) | X 160.0 ; Y 0.0 ; Ø/d 8.2 | LINE OUT L/R (стерео TRS J8) |
| phones | rear wall (есть в STL) | X 172.0 ; Y 0.0 ; Ø/d 8.2 | PHONES J9 Ø8.2 |
| audio-in-l | rear wall (есть в STL) | X 184.0 ; Y 0.0 ; Ø/d 8.2 | AUDIO IN L J10 Ø8.2 |
| audio-in-r | rear wall (есть в STL) | X 196.0 ; Y 0.0 ; Ø/d 8.2 | AUDIO IN R J11 Ø8.2 |
| cv5 | rear wall (есть в STL) | X 208.0 ; Y 0.0 ; Ø/d 8.2 | CV OUT 5 (задний джек, D-44) |
| cv6 | rear wall (есть в STL) | X 220.0 ; Y 0.0 ; Ø/d 8.2 | CV OUT 6 (задний джек) |
| sd-card | left side wall (есть в STL) | X 0.0 ; Y [150.0, 162.0] | microSD: сквозной слот 12×2 |
| usb-c | rear wall (есть в STL) | X [346.0, 356.0] ; Y [-1.0, 3.5] | USB-C: окно в задней стенке |

> В STL сейчас реально есть только **USB-C-окно** (346…356, задняя стенка), **вентиляционные щели** и **порт MEMS** (B-light/B_mic/C_mic). Остальные вырезы (MIDI TRS, DC, EXPRESSION, mic jack, SD) — предложение; перед печатью корпуса их нужно добавить в генератор.

## 4. Keepout'ы (панель/платы)

### CORE-2
| Зона | Тип/размер | Local | Назначение |
|---|---|---|---|
| USB-C | 12×6 | 255; -49 | USB-C: окно в задней стенке X 346…356, кабель/FFC до окна |
| C6-antenna | 40×20 | 0; 0 | антенна ESP32-C6: зона 40×20 у задней кромки, keepout ≥15 мм (медь/винты/батарея вне) |
| analog | 40×39 | 160; 69 | аналог (DAC/ADC/OUT): отдельная зона, звезда GND |
| DC-DC | 70×59 | 0; 49 | импульсные преобразователи: подальше от аналога/аудио |

### PANEL-2-left
| Зона | Тип/размер | Local | Назначение |
|---|---|---|---|
| screen | 56×69 | 124; 14 | экран 5" 108×64.8 + 2 мм, FPC-40 — без меди/высоких компонентов |
| L_ENC_A | круг Ø16 | 15; 26 | энкодер EC11 Ø14 + гайка Ø14.4 |
| L_ENC_E | круг Ø16 | 15; 58 | энкодер EC11 Ø14 + гайка Ø14.4 |
| L_ENC_B | круг Ø16 | 44; 26 | энкодер EC11 Ø14 + гайка Ø14.4 |
| L_ENC_F | круг Ø16 | 44; 58 | энкодер EC11 Ø14 + гайка Ø14.4 |
| L_ENC_C | круг Ø16 | 73; 26 | энкодер EC11 Ø14 + гайка Ø14.4 |
| L_ENC_G | круг Ø16 | 73; 58 | энкодер EC11 Ø14 + гайка Ø14.4 |
| L_ENC_D | круг Ø16 | 101; 26 | энкодер EC11 Ø14 + гайка Ø14.4 |
| L_ENC_H | круг Ø16 | 101; 58 | энкодер EC11 Ø14 + гайка Ø14.4 |
| L_K01 | 20×19 | 65; 91 | Choc v1: окно 14×14, сокет hot-swap |
| L_K02 | 20×19 | 84; 101 | Choc v1: окно 14×14, сокет hot-swap |
| L_K03 | 20×19 | 101; 107 | Choc v1: окно 14×14, сокет hot-swap |
| L_K04 | 20×19 | 43; 92 | Choc v1: окно 14×14, сокет hot-swap |
| L_K05 | 20×19 | 61; 107 | Choc v1: окно 14×14, сокет hot-swap |
| L_K06 | 20×19 | 79; 117 | Choc v1: окно 14×14, сокет hot-swap |
| L_K07 | 20×19 | 96; 123 | Choc v1: окно 14×14, сокет hot-swap |
| L_K08 | 20×19 | 21; 102 | Choc v1: окно 14×14, сокет hot-swap |
| L_K09 | 20×19 | 41; 108 | Choc v1: окно 14×14, сокет hot-swap |
| L_K10 | 20×19 | 3; 101 | Choc v1: окно 14×14, сокет hot-swap |
| L_K11 | 20×19 | 57; 124 | Choc v1: окно 14×14, сокет hot-swap |
| L_K12 | 20×19 | 74; 134 | Choc v1: окно 14×14, сокет hot-swap |
| L_K13 | 20×19 | 91; 139 | Choc v1: окно 14×14, сокет hot-swap |
| L_K14 | 20×19 | 20; 118 | Choc v1: окно 14×14, сокет hot-swap |
| L_K15 | 20×19 | 38; 125 | Choc v1: окно 14×14, сокет hot-swap |
| L_K16 | 20×19 | 2; 118 | Choc v1: окно 14×14, сокет hot-swap |
| L_K17 | 20×19 | 19; 135 | Choc v1: окно 14×14, сокет hot-swap |
| L_K18 | 20×19 | 76; 156 | Choc v1: окно 14×14, сокет hot-swap |
| L_K19 | 20×19 | 1; 135 | Choc v1: окно 14×14, сокет hot-swap |
| L_K20 | 20×19 | 94; 164 | Choc v1: окно 14×14, сокет hot-swap |
| L_K21 | 20×16 | 110; 174 | Choc v1: окно 14×14, сокет hot-swap |
| F1 | 16×63 | 157; 108 | фейдер 60 мм: корпус 16×75, прорезь 2.5×63 |
| J01 | круг Ø10 | 120; 0 | mini-jack 3.5: гайка Ø8.2, вырез по кромке Y |
| J02 | круг Ø10 | 133; 0 | mini-jack 3.5: гайка Ø8.2, вырез по кромке Y |
| J03 | круг Ø10 | 146; 0 | mini-jack 3.5: гайка Ø8.2, вырез по кромке Y |
| J04 | круг Ø10 | 159; 0 | mini-jack 3.5: гайка Ø8.2, вырез по кромке Y |
| J05 | круг Ø10 | 172; 0 | mini-jack 3.5: гайка Ø8.2, вырез по кромке Y |
| MIC_LED | круг Ø8 | 106; 0 | LED MIC ON Ø1.6 + цековка Ø2.8 (116;10.5) |

### PANEL-2-right
| Зона | Тип/размер | Local | Назначение |
|---|---|---|---|
| screen | 56×69 | 0; 14 | экран 5" 108×64.8 + 2 мм, FPC-40 — без меди/высоких компонентов |
| R_ENC_A | круг Ø16 | 79; 26 | энкодер EC11 Ø14 + гайка Ø14.4 |
| R_ENC_E | круг Ø16 | 79; 58 | энкодер EC11 Ø14 + гайка Ø14.4 |
| R_ENC_B | круг Ø16 | 108; 26 | энкодер EC11 Ø14 + гайка Ø14.4 |
| R_ENC_F | круг Ø16 | 108; 58 | энкодер EC11 Ø14 + гайка Ø14.4 |
| R_ENC_C | круг Ø16 | 137; 26 | энкодер EC11 Ø14 + гайка Ø14.4 |
| R_ENC_G | круг Ø16 | 137; 58 | энкодер EC11 Ø14 + гайка Ø14.4 |
| R_ENC_D | круг Ø16 | 166; 26 | энкодер EC11 Ø14 + гайка Ø14.4 |
| R_ENC_H | круг Ø16 | 166; 58 | энкодер EC11 Ø14 + гайка Ø14.4 |
| R_K01 | 20×19 | 95; 91 | Choc v1: окно 14×14, сокет hot-swap |
| R_K02 | 20×19 | 76; 101 | Choc v1: окно 14×14, сокет hot-swap |
| R_K03 | 20×19 | 59; 107 | Choc v1: окно 14×14, сокет hot-swap |
| R_K04 | 20×19 | 117; 92 | Choc v1: окно 14×14, сокет hot-swap |
| R_K05 | 20×19 | 99; 107 | Choc v1: окно 14×14, сокет hot-swap |
| R_K06 | 20×19 | 81; 117 | Choc v1: окно 14×14, сокет hot-swap |
| R_K07 | 20×19 | 64; 123 | Choc v1: окно 14×14, сокет hot-swap |
| R_K08 | 20×19 | 139; 102 | Choc v1: окно 14×14, сокет hot-swap |
| R_K09 | 20×19 | 119; 108 | Choc v1: окно 14×14, сокет hot-swap |
| R_K10 | 20×19 | 157; 101 | Choc v1: окно 14×14, сокет hot-swap |
| R_K11 | 20×19 | 103; 124 | Choc v1: окно 14×14, сокет hot-swap |
| R_K12 | 20×19 | 86; 134 | Choc v1: окно 14×14, сокет hot-swap |
| R_K13 | 20×19 | 69; 139 | Choc v1: окно 14×14, сокет hot-swap |
| R_K14 | 20×19 | 140; 118 | Choc v1: окно 14×14, сокет hot-swap |
| R_K15 | 20×19 | 122; 125 | Choc v1: окно 14×14, сокет hot-swap |
| R_K16 | 20×19 | 158; 118 | Choc v1: окно 14×14, сокет hot-swap |
| R_K17 | 20×19 | 141; 135 | Choc v1: окно 14×14, сокет hot-swap |
| R_K18 | 20×19 | 84; 156 | Choc v1: окно 14×14, сокет hot-swap |
| R_K19 | 20×19 | 159; 135 | Choc v1: окно 14×14, сокет hot-swap |
| R_K20 | 20×19 | 66; 164 | Choc v1: окно 14×14, сокет hot-swap |
| R_K21 | 20×16 | 50; 174 | Choc v1: окно 14×14, сокет hot-swap |
| F2 | 16×63 | 6; 108 | фейдер 60 мм: корпус 16×75, прорезь 2.5×63 |
| J06 | круг Ø10 | 5; 0 | mini-jack 3.5: гайка Ø8.2, вырез по кромке Y |
| J07 | круг Ø10 | 18; 0 | mini-jack 3.5: гайка Ø8.2, вырез по кромке Y |
| J08 | круг Ø10 | 32; 0 | mini-jack 3.5: гайка Ø8.2, вырез по кромке Y |
| J09 | круг Ø10 | 45; 0 | mini-jack 3.5: гайка Ø8.2, вырез по кромке Y |
| J10 | круг Ø10 | 58; 0 | mini-jack 3.5: гайка Ø8.2, вырез по кромке Y |
| battery | 40×67 | 102; 45 | 2×18650 под PANEL-2: без высоких компонентов снизу |

### PWR-2
| Зона | Тип/размер | Local | Назначение |
|---|---|---|---|
| battery-conn | 30×60 | 60; 5 | батарейный разъём/предохранитель/шунт — у края |
| hot-loop | 40×40 | 0; 0 | TPS61088 + индуктивность: тепловой полигон, горячий контур |

Правила: **MEMS ≥10 мм от WS2812/BL**; **антенна C6 keepout ≥15 мм**; батарея под PANEL-2 — без высоких компонентов; экран +2 мм; клавиши/энкодеры/фейдеры — по `spec/panel-spec-v0.4.json` ±0.1 мм.

## 5. DXF для KiCad

| Файл | Содержимое |
|---|---|
| `core2.dxf` | контур + 4×M3 (Ø3.4) |
| `panel2left.dxf` | контур 180×190 + 3×M3 + вырезы джеков по кромке |
| `panel2right.dxf` | контур 180×190 + 3×M3 + вырезы джеков |
| `pwr2.dxf` | контур 90×70 + 4×M2.5 (Ø2.8) |
| `assembly.dxf` | все контуры и отверстия в мировой СК |

Импорт: KiCad → File → Import → DXF, слой **Edge.Cuts**; единицы мм, Y-up (как в файлах). Контуры замкнутые, отверстия — CIRCLE.

## 6. Проверки (2D)

| Проверка | Условие | Результат | Статус |
|---|---|---|---|
| CORE-2: контур внутри ниши B (2.5…377.5 / 2.5…207.5) | зазор ≥1 мм | 48.50 мм | **OK** |
| CORE-2: контур внутри ниши B-light | зазор ≥1 мм | 49.00 мм | **OK** |
| CORE-2: отверстия = центры стоек (4×M3) | Δ≤0.01 мм | вне допуска: 0 | **OK** |
| CORE-2: стойки не режут кромку контура | ≥0.5 мм от кромки | проблемных: 0 | **OK** |
| PANEL-2-left: контур внутри ниши B (2.5…377.5 / 2.5…207.5) | зазор ≥1 мм | 7.50 мм | **OK** |
| PANEL-2-left: контур внутри ниши B-light | зазор ≥1 мм | 8.00 мм | **OK** |
| PANEL-2-left: отверстия = центры стоек (3×M3) | Δ≤0.01 мм | вне допуска: 0 | **OK** |
| PANEL-2-left: стойки не режут кромку контура | ≥0.5 мм от кромки | проблемных: 0 | **OK** |
| PANEL-2-right: контур внутри ниши B (2.5…377.5 / 2.5…207.5) | зазор ≥1 мм | 7.50 мм | **OK** |
| PANEL-2-right: контур внутри ниши B-light | зазор ≥1 мм | 8.00 мм | **OK** |
| PANEL-2-right: отверстия = центры стоек (3×M3) | Δ≤0.01 мм | вне допуска: 0 | **OK** |
| PANEL-2-right: стойки не режут кромку контура | ≥0.5 мм от кромки | проблемных: 0 | **OK** |
| PWR-2: контур внутри ниши B (2.5…377.5 / 2.5…207.5) | зазор ≥1 мм | 62.50 мм | **OK** |
| PWR-2: контур внутри ниши B-light | зазор ≥1 мм | 63.00 мм | **OK** |
| PWR-2: отверстия = центры стоек (4×M2.5) | Δ≤0.01 мм | вне допуска: 0 | **OK** |
| PWR-2: стойки не режут кромку контура | ≥0.5 мм от кромки | проблемных: 0 | **OK** |
| PANEL-2: половины не перекрываются (шов X=190) | площадь <0.01 мм² | 0.000 мм² | **OK** |
| PANEL-2-left: keepout'ы компонентов внутри контура | 0 выходов за контур | 0 | **OK** |
| PANEL-2-right: keepout'ы компонентов внутри контура | 0 выходов за контур | 0 | **OK** |
| CORE-2/PWR-2 keepout'ы (antenna, DC-DC, battery-conn) | информационные зоны floorplan | см. board-spec/README | **OK** |
| MEMS (122;5.5) ≥10 мм от WS2812/BL | по правилу docs/82 §3 | keepout r=10 мм в board-spec | **OK** |
| Антенна C6: keepout ≥15 мм | 40×20 у задней кромки CORE-2 | см. CORE-2 keepout | **OK** |

0 конфликтов — контуры в нише, отверстия на стойках, половины PANEL-2 не перекрываются, отверстия вне keepout. Дополнение к `mechanical/fit_check.md` (секция board-fit).

## 7. Расхождения с docs/82 §2 (исправлено в docs/82)

- В docs/82 было «PANEL-2 6×M3 (30/145/260 × 30/180)» — **не совпадает** с фактическим fitcheck: 6 стоек PANEL-2 = (30/65/150/230/283/341; Y=46) в координатах панели (world Y ≈ 46.6 при 8°). Эти числа и есть в board-spec.

- docs/82 «PANEL-2 380×210-контур» — фактический контур платы 360×190 (X 10…370, Y 10…200), как в fitcheck; панель 380×210 — механическая деталь.

- Шов PANEL-2: X=190 (левая/правая платы по 180 мм), механический разрез панели 193+190.

## 9. mount_plane PANEL-2 (round 35)

PANEL-2 монтируется **параллельно панели**: 6×M3 стоек — оси ∥ нормали панели,
верх ∥ панели; низ панели ↔ верх платы = **12.0 мм**, низ платы 13.6 мм;
углы: A 0°, B/B-light/B_mic 8°, C/C_mic 12°. В `board-spec.json` у PANEL-2 добавлено
поле `mount_plane` (угол по вариантам, offset 12 мм, толщина 1.6, ось крепежа —
нормаль, 6 стоек). Fitcheck: строки [P] — угол 0.00°, зазор 12.00 мм, 0 конфликтов.
