martiyanov/bukifon/hardware/panel2/README.md

# PANEL-2 rev.3 — PRE-FREEZE (не заказывать плату)

Схема панели **v0.4** (380 × 210 мм): 16 × EC11, 42 × Kailh Choc (Lapka-42, матрица 6×7), экран 5.0" 800×480 RGB 16 бит, 10 × mini-jack, 2 фейдера 60 мм, 17 × WS2812B. Статус: **PRE-FREEZE / DO NOT FABRICATE** — цель этапа не «плата к заказу», а проверенный контракт CORE-2 ↔ PANEL-2 и ревью решений. **rev.3**: **I2S MEMS-микрофон ICS-43434** (верхняя кромка: порт **Ø1.8 в (X 122.0, Y 5.5)**, цековка Ø3.4×0.7, углубление MEMS Ø5×1.2, LED MIC ON **Ø1.6 в (X 116.0, Y 10.5)** — fitcheck mechanical), аппаратный мьют + LED (R-37), линии I2S1 в **J16 IDC-6** (pinout 1:1 с CORE-2 J19). rev.2: EN_RAILS/EN_LED5, 5V_LED/LED_RET, LED_DATA 3.3 В, GATE_IN на панели.

Лицензия: CERN-OHL-S-2.0. Геометрия: `spec/panel-spec-v0.4.json` (единственный источник); реестр требований: `spec/90-requirements-registry.md` (R-01…R-11).

## 1. Файлы

| Файл | Что |
|---|---|
| `PANEL-2.kicad_sch` | схема (KiCad 10, S-expr 20250114), A0, штамп PRE-FREEZE на листе |
| `PANEL-2.pdf`, `svg/` | экспорт схемы |
| `PANEL-2.net` | netlist (импорт в pcbnew) |
| `erc/PANEL-2-erc.rpt` | ERC-отчёт (0 errors, 6 warnings — см. §5) |
| `pinmap.md`, `pinmap.csv` | контракт PANEL-2 ↔ CORE-2: все линии, направления, уровни |
| `matrix.md` | матрица 42 клавиш (ключ → строка/столбец/диод/номер JSON) + энкодеры → MCP |
| `interfaces.md` | электрические интерфейсы: джеки/защита, дисплей, энкодеры, матрица, фейдеры, LED, питание |
| `BOM-panel2.csv` | черновой BOM (номинал/корпус/артикул/кол-во) |
| `tools/gen_panel2.py` | генератор схемы и всех таблиц из одного источника данных |
| `tools/verify_netlist.py` | сверка netlist ↔ контракт (intent, pinmap.csv, matrix.md) |

Пересборка: `cd hardware/panel2 && ./tools/build.sh` (генерация → ERC → PDF/SVG/netlist → проверка).

## 2. Архитектурные решения

1. **Энкодеры через I2C, 4 × MCP23017**: 16 × (A,B,SW) = 48 + матрица 13 = 61 линия. 2 чипа дают только 32 входа — недостаточно; 4 чипа (0x20…0x23) сводят всё к SDA/SCL/INT. Скорость: INT-чтение 75 мкс, 16 энкодеров ≤ 24 % шины, матрица 500 Гц ≈ 10 %.
2. **Три шлейфа, а не один IDC-26**: сигналов 37 (21 LCD + 3 I2C/INT + 1 LED + 10 джеков + 2 фейдера) — в IDC-26 помещается максимум 13 сигнальных. Отсюда **J12 FFC-40** (LCD RGB) + **J13 IDC-16** (цифровое/питание) + **J14 IDC-26** (аналог, «сигнал/AGND»). Это ответ на вопрос «хватает ли одного IDC-26» — нет. Подробно: `pinmap.md` §1.
3. **Джек-поле**: 4 CV OUT + 4 CV IN + GATE OUT + GATE IN (10 по R-06). Аудио — **5 джеков на задней панели CORE-2** (LINE OUT L, LINE OUT R, PHONES, AUDIO IN L, AUDIO IN R; AC-coupling — `interfaces.md` §1.2; решение Lead 05.11).
4. **Экран**: FPC-40 на панели (J11) + FFC-40 в CORE-2 (J12); **драйвер подсветки — на CORE-2** (высокое напряжение не идёт через шлейф панели), на PANEL-2 только `BL_PWM` + клеммы `BL_ANODE`/`BL_CATHODE`; J15 — альтернатива SPI (DNP).
5. **Защита джеков**: CV OUT 1k + SMAJ12A; CV IN 100R + SMAJ15A (0.1 % погрешности); GATE OUT 1k + SMAJ5.0A; GATE IN 4.7k + BAT54S + 74LVC1G17.
6. **Матрица**: 1N4148 в каждой клавише (антифантом), строки сканируются по одной, внешние подтяжки 10 кОм по столбцам. rev.2 canon: ROW1…6 = GPB0…5 (выходы), COL1…7 = GPA0…6 (входы).
8. **rev.3 — цифровой микрофон** (docs/71, D-91/D-94): **ICS-43434** (I2S MEMS, 24 бит/48 кГц, 3.3 В) на верхней кромке панели; акустический порт **Ø1.8 (X 122.0, Y 5.5)** с цековкой Ø3.4×0.7, сеткой и поролоном 1–2 мм, звуковод ≤3 мм; MEMS — под звуководом (X≈122) с зазором до WS2812/BL ≥10 мм; LED MIC ON — **Ø1.6 в (X 116.0, Y 10.5)**. Питание через **аппаратный мьют SW1** (разрывает +3V3, R-37) + FB1 600 Ом + 10u/100n; ESD SRV05-4 + серия 33R на BCK/WS/DATA; LED_MICON = «питание микрофона вкл.». Линии I2S1 — **J16 IDC-6** (1 BCK, 2 GND, 3 WS, 4 GND, 5 DATA, 6 +3V3; канон 1:1 с CORE-2 **J19**), TP36…TP39. 85 сквозных отверстий = 83 из JSON + порт + LED (JSON не менялся).
7. **rev.2 sync с CORE-2/PWR-2**: J13.9/13 = `5V_LED`, J13.16 = `LED_RET` (отдельный коммутируемый возврат LED, не через землю аудио), J13.15 = `EN_RAILS` (0x23 GPA7), J14.25 = `EN_LED5` (0x23 GPB6); `GATE_IN` читается на PANEL-2 (0x23 GPB7, через 1k от 74LVC1G17) → 0 GPIO CORE-2; `LED_DATA` с CORE-2 — 3.3 В (U44/R90 на CORE-2 DNP), level shifter U6 — на PANEL-2.

## 3. Статус ERC

| Плата | Errors | Warnings | Компонентов | Соединений |
|---|---:|---:|---:|---:|
| PANEL-2 rev.3 | **0** | **6** (isolated_pin_label, nets SPI2_* на DNP-разъёме J15) | 361 | 1019 |

## 4. Проверки (не «на глаз»)

* **Геометрия**: генератор берёт позиции клавиш тем же кодом, что и `spec/panel-spec-v0.4.json` (`tools/make_canonical_v04.py`), и **assert**-ит отклонение от JSON: текущее **0.00 мм** (порог 0.1 мм).
* **Уникальность**: 42 клавиши → 42 уникальные ячейки (6×7), 42 диода; 16 энкодеров → 48 уникальных линий в MCP23017; 4 чипа имеют разные адреса.
* **Netlist ↔ контракт**: `tools/verify_netlist.py` сверяет netlist с pinmap.csv и matrix.md.
* **ERC**: `kicad-cli sch erc` — 0 errors; 6 warnings перечислены в §5.

## 5. Предупреждения ERC (все 6 — осознанные)

`isolated_pin_label` × 6: `SPI2_SCK`, `SPI2_MOSI`, `SPI2_CS`, `SPI2_DC`, `SPI2_RST`, `SPI2_MISO` — цепи альтернативного SPI-дисплея на J15 (DNP, R-18 открыт). Каждая цепь имеет один пин (разъём); в CORE-2 они придут, если SPI-вариант будет выбран. На PCB-этапе либо подключить их к CORE-2, либо убрать J15.

## 6. Открытые вопросы (статус после ревью Lead 05.11)

| # | Вопрос | Статус |
|---|---|---|
| 1 | Аудио-джеки (LINE/PHONES/AUDIO IN) | ✅ **решено**: 5 джеков на задней панели CORE-2 (LINE OUT L, LINE OUT R, PHONES, AUDIO IN L, AUDIO IN R). Верхние 10 — 4 CV OUT + 4 CV IN + GATE OUT + GATE IN. AC-coupling — `interfaces.md` §1.2 |
| 2 | Распиновка FPC-40 | ⏳ **TBD**: пин-аут по datasheet конкретного модуля 5.0" перед PCB (текущая таблица — предлагаемый контракт, `pinmap.md` §5) |
| 3 | Подсветка | ✅ **решено**: boost/CC-драйвер перенесён на **CORE-2**; на PANEL-2 только `BL_PWM`, `BL_ANODE`, `BL_CATHODE`; модуль со своим драйвером → пара BL_ANODE/BL_CATHODE DNP |
| 4 | Крепёж 4×M3 vs 6 стоек | ✅ **решено**: 6×M3 по механике PANEL-1 rev.2 (30/145/260 × 30/180) |
| 5 | 25 пинов CORE-2 (I2C/INT + LCD RGB + BL_PWM) | ✅ **решено**: принято и передано в CORE-2 |
| 6 | `DISP` (LCD_DISP, CORE-2 GPIO50) | ⚠️ **открыт**: CORE-2 `pinmap.md` §8 ожидает LCD_DISP, но в J12 PANEL-2 цепи DISP нет. Решение — вывести на свободный пин J12 (напр. 33) при финализации pinout FPC-40 |
| 7 | `GATE_IN_CLEAN` на J14.19 | ⚠️ **на стороне CORE-2**: в `core2/pinmap.md` §9 линия ещё указана на J14.19, но rev.2-решение — читать на PANEL-2 (0x23 GPB7). CORE-2 должен убрать её из своего pinout |
| 8 | CVIN3/4 → MCP3208 CH4/CH5, EXPRESSION теряет канал | ⚠️ **на стороне CORE-2** (открытые N-2/N-3 в `core2/rev2-plan.md` §9) |
| 9 | Акустический порт MEMS + LED MIC ON | ✅ **согласовано с mechanical**: порт **Ø1.8, центр (X 122.0, Y 5.5)**, цековка Ø3.4×0.7, углубление MEMS Ø5×1.2 снизу, звуковод ≤3 мм; LED MIC ON **Ø1.6, центр (X 116.0, Y 10.5)**. 85 сквозных отверстий (83 JSON + порт + LED), `spec/panel-spec-v0.4.json` не менялся, B-light ≈231.4 г / 11.2 ч |
| 10 | CORE-2 rev.3: I2S1 RX + ответный **J19 IDC-6** | ⚠️ **канон**: PANEL-2 **J16** ↔ CORE-2 **J19**, 1:1 — 1 BCK, 2 GND, 3 WS, 4 GND, 5 DATA, 6 3V3. **Конфликт к решению Lead:** в `hardware/core2` rev.3 фактический J19 — *3V3_MIC, GND, BCK, WS, DATA, GND* (pins 3/4/5 = BCK/WS/DATA). Для кабеля 1:1 нужен один порядок: либо CORE-2 J19 → 1 BCK, 2 GND, 3 WS, 4 GND, 5 DATA, 6 3V3 (4 цепи на CORE-2), либо PANEL-2 J16 → 1 3V3, 2 GND, 3 BCK, 4 WS, 5 DATA, 6 GND (4 цепи на PANEL-2, без смены компонентов) |
| 11 | Резервный MEMS `SPH0645LM4H` | ⚠️ назначение выводов совпадает, но **пады LGA-6 другого размера** (Knowles 3.5×2.65 vs InvenSense) — замена = другой footprint |

## 7. Режимы работы (требование заказчика: DAW-контроллер + HID)

**Схема PANEL-2 при этом не меняется**: 42 клавиши уже HID-совместимы (матрица 6×7 с диодами, скан 500 Гц; одновременно читаются все 6 строк — n-key rollover ограничен только сканом), 16 энкодеров — 16 относительных каналов, 2 фейдера — абсолютные, 10 джеков — CV/GATE. Меняется только прошивка CORE-2 (реестр R-12/R-18):

| Режим | Что делает | Использует на PANEL-2 |
|---|---|---|
| **HID-клавиатура** | 42 клавиши как раскладка (ноты/аккорды/транспорт/шаги) со слоями (SHIFT-слой, 3 слоя), 16 энкодеров как колёса/зум/скраб | матрица 6×7 + 16 × A/B |
| **MIDI-контроллер** | 16 энкодеров → CC (банки по 16 CC), нажатия энкодеров → CC/PC, 2 фейдера → CC 7/11 (volume/expression), 42 клавиши → note/transport | матрица, энкодеры, фейдеры |
| **BLE-MIDI / BLE-HID** | те же функции по радио: BLE-MIDI (GATT-MIDI) + BLE-HID; на ESP32-S3 — нативно, на ESP32-P4 — через компаньон ESP32-C6 (CORE-2) | ничего не меняется |
| **USB-композит** | один USB-кабель: HID-клавиатура + USB-MIDI + UAC2 аудио-интерфейс (запись с PCM1808 / воспроизведение в PCM5102A) | матрица/энкодеры/фейдеры/джеки |

Переключение режимов — по USB-дескриптору при подключении и/или комбинации SHIFT; аудио-джеки (rear) и CV/GATE (верх) работают независимо от режима. PANEL-2 остаётся «тупой» панелью ввода: вся логика режимов и радио — на CORE-2.

## 8. Что не сделано (осознанно)

* `.kicad_pcb`: разводка/трассировка не делалась (PCB-этап после freeze).
* Footprint Kailh Choc hot-swap и FPC-40 зависят от выбранных компонентов — на PCB-этапе.
* Номиналы защиты требуют проверки на макете (TVS под конкретные модули); драйвер подсветки — на CORE-2, на PANEL-2 его нет.
* **Акустика микрофона** (чувствительность, SNR, тест речи/свиста на 30 см) проверяется только на образце PANEL-2 + шлейфе J16 + CORE-2 rev.3; сейчас — схема и порт.
