martiyanov/bukifon/hardware/panel/README.md

# Букифон — схемы PANEL-1 / DECK-PAD / DECK-KEYS

Открытые схемы (KiCad 10, формат `.kicad_sch` версии 20250114) трёх плат панели
синтезатора-геймпада Букифон. Лицензия: **CERN-OHL-S-2.0** (см. `spec/00-vision.md` §5).

Лист схемы: PANEL-1 — A1, DECK-PAD — A1, DECK-KEYS — A0 (KiCad paper size).

| Плата | Габарит | Файл | Состав |
|---|---|---|---|
| **PANEL-1** | 300 × 132 × 1.6 мм | `panel-1/panel-1.kicad_sch` | 8 × EC11 + RC, 6 × 74HC165 (48 бит), 4 плечевых 6×6, экран 2.8" 1×14, 9 × WS2812B-2020, IDC-16 (дека), IDC-32 (CORE-1) |
| **DECK-PAD** | 290 × 78 × 1.6 мм | `deck-pad/deck-pad.kicad_sch` | 18 × такт 12×12×5 (матрица 3×6), 18 × WS2812B-2020, 2 × слайдер 30 мм, MCP23017 (0x20), 2 × 74HC4067 + 18 мест FSR, IDC-16 |
| **DECK-KEYS** | 290 × 78 × 1.6 мм | `deck-keys/deck-keys.kicad_sch` | 42 × Kailh Choc hot-swap + 42 × 1N4148 (матрица 6×7), 42 × SK6812MINI-E, 2 × слайдер 30 мм, MCP23017 (0x20), 2 индикатора режима, IDC-16 |

Контракт: `spec/10-panel-ui.md` §2–5, `spec/20-electronics.md` §2, §6. Спецификация не менялась.
Все координаты органов управления в таблицах — из `spec/10-panel-ui.md` (система панели:
X 0…315 вправо, Y 0…145 вперёд, мм).

---

## 1. Артефакты

```
hardware/panel/
├── panel-1/     panel-1.kicad_sch  panel-1.pdf  panel-1.svg.gz/  panel-1.net
├── deck-pad/    deck-pad.kicad_sch deck-pad.pdf deck-pad.svg.gz/ deck-pad.net
├── deck-keys/   deck-keys.kicad_sch deck-keys.pdf deck-keys.svg.gz/ deck-keys.net
├── erc/         <плата>-erc.rpt  (ERC-отчёты KiCad), <плата>-bom.csv (BOM KiCad)
├── matrix-tables.md   таблицы: 48 бит 74HC165, матрица пэдов 3×6, матрица клавиш 6×7,
│                      каналы 74HC4067/FSR, LED-цепочки, координаты ↔ цепи, DECK_ID
├── BOM-panel.csv      BOM трёх плат: номинал / корпус / артикул-предложение / кол-во
├── coords-panel.csv   координаты всех органов управления (77 позиций) для механики:
│                       X/Y в системе панели, отверстие/окно, ROW/COL матрицы
└── tools/
    ├── kicad_sch.py       мини-библиотека записи .kicad_sch (S-expression)
    ├── gen.py             генератор трёх схем + matrix-tables.md + BOM-panel.csv
    ├── verify_netlist.py  проверка netlist ↔ проектная таблица ↔ matrix-tables.md
    └── build.sh           полный прогон: генерация, ERC, экспорт, проверка
```

Пересборка (нужен KiCad 10 CLI):

```bash
cd hardware/panel && ./tools/build.sh
```

Проверено на KiCad **10.0.4** (macOS). Скрипт использует только стоковые библиотеки
символов KiCad: `Device`, `74xx`, `Interface_Expansion`, `LED`, `Diode`, `Switch`,
`Connector_Generic`, `Transistor_FET`, `power`.

## 2. Статус ERC и проверок

| Плата | ERC ошибки | ERC предупреждения | Цепей / выводов в netlist | Проверок netlist |
|---|---:|---:|---:|---:|
| PANEL-1 | **0** | **0** | 76 цепей / 396 выводов | 2967 (суммарно) |
| DECK-PAD | **0** | **0** | 67 цепей / 338 выводов | ↑ |
| DECK-KEYS | **0** | **0** | 114 цепей / 500 выводов | ↑ |

ERC выполнялся `kicad-cli sch erc` со стандартными правилами (без проекта и без
переопределений severity). Отчёты — `erc/<плата>-erc.rpt`.

Что реально проверено (не «на глаз»):

1. **ERC** каждой схемы = 0 нарушений (включая `pin_not_connected`,
   `power_pin_not_driven`, `pin_to_pin`, `endpoint_off_grid`, `lib_symbol_mismatch`).
2. **`tools/verify_netlist.py`** читает экспортированные KiCad-netlist-ы и файлы
   спецификации, и проверяет **2967 утверждений**:
   - совпадение pin→net в netlist с проектной картой соединений генератора
     (ловит неверные координаты выводов, «повисшие» метки, случайные замыкания
     совпавших координат) — сравнение в обе стороны, включая лишние соединения;
   - **спецификация ↔ netlist**: карта 48 бит 74HC165 (`spec/20` §6.1), распиновка
     J-DECK IDC-16 (`spec/20` §6.2, 16 пинов × 3 платы), число LED и строк матриц
     (§6.1/6.3/6.4), адрес MCP23017 = 0x20 (A0…A2 = GND), INTA → `DECK_INT`,
     номиналы делителей DECK_ID (33k/4.7k и 4.7k/33k);
   - таблицы из `matrix-tables.md` (48 бит 74HC165, матрица пэдов 3×6, матрица клавиш
     6×7, LED-цепочки, 16 пинов J-DECK) против netlist;
   - **`coords-panel.csv` ↔ `spec/10-panel-ui.md`**: 8 энкодеров, 4 плечевых, экран,
     все 18 пэдов, 42 клавиши, 2 слайдера на обеих деках — координаты из CSV
     сравниваются с таблицами спецификации (наборы координат, с точностью 0.1 мм).
3. Экспорт PDF/SVG (`kicad-cli sch export pdf|svg`) открывается, netlist-ы
   импортируемы в pcbnew.

Итог последнего прогона: `verification checks: 2967, failures: 0`.
Важно: `spec/10-panel-ui.md` был обновлён Lead-ом по ходу работы (верхняя часть панели
Y 0…66, ниша деки 66…145, пэды Y 78/104/130, слайдеры 98…128, клавиши X 20…110/205…295,
ряды 74/91/108, thumb-ряд y 126); координаты в схемах/таблицах/CSV пересчитаны под
актуальную версию, проверка `coords-panel.csv ↔ spec` это подтверждает.

## 3. Архитектурные решения, важные для чтения схем

- **Соединения заданы именами цепей** (метка на 2.54 мм выводе каждого пина).
  Это стандартный способ рисовать большие матричные/шинные схемы и единственный
  практичный при 42 клавишах и 48 битах сдвиговых регистров: схема читается по
  именам цепей, а полная карта соединений — в `matrix-tables.md` (сверена с netlist).
  Разводка «проводами» была бы нечитаемой и не несёт дополнительной информации.
- **Питание**: символы `power:+3V3`, `power:GND`, `power:+5V` + `PWR_FLAG` (в начале
  каждой схемы). `PWR_FLAG` нужен ERC, чтобы обозначить, что питание приходит по
  шлейфу, а не вырабатывается на плате.
- **Символы производных библиотечных элементов** (`74HC165`, `1N4148`, `SK6812MINI-E`,
  `MCP23017x-x-SP`, `2N7002`) взяты как базовые аналоги (`74LS165`, `1N4001`,
  `SK6812`, `MCP23017x-x-SO`, `Q_NMOS_GSD`) с правильным значением/корпусом: иначе
  ERC выдаёт `lib_symbol_mismatch` на каждый экземпляр. Электрически и по цоколёвке
  они идентичны; важно для BOM — там стоит правильное изделие.
- **74HC165**: каскад `U1.Q7 → U2.DS → … → U6.Q7 = HC_QH`; бит 0 — `U1.D0`,
  бит 47 — `U6.D7` (первым по MISO читается `U6.H`). Свободные биты 28…47
  посажены на GND; `~Q7` не используются (no-connect), `~CE` = GND.
- **WS2812B-2020 / SK6812MINI-E**: цепочка PANEL-1 (9 LED) питается от **+5 В**
  (`spec/20-electronics.md` §2/§3/§6.1), данные `LED_DATA` (GP7, 3.3 В) идут через
  буфер **U7 74HCT1G125** (VCC = +5 В, TTL-совместимый вход) → R300 330 Ω → `LED_IN`
  → LED_ENC1…8 → LED_STATUS → `LED_OUT` (pin 7 J-DECK) → цепочка деки (18 или 42 LED).
  100 нФ на каждый светодиод, ёмкости — на +5 В. Цепочки дек питаются тем же +5 В
  через **pin 16 IDC-16** (`spec/20-electronics.md` §6.2: pin 15 = FSR, pin 16 = +5V):
  `LED_IN` приходит с панели уже с уровнем 5 В, т.е. уровни данных и питания
  светодиодов совпадают (даташитные ограничения соблюдены).
- **Энкодеры**: каждая фаза — 10 кΩ к +3V3 (это и есть R фильтра) + 100 нФ на GND
  ⇒ 16 RC-цепочек; кнопка энкодера — отдельный 10 кΩ pull-up (8 шт.).
- **Слайдеры/FSR**: RC 1 кΩ + 100 нФ стоят на PANEL-1, перед MCP3208 (CH0/CH1 для
  SL1/SL2, CH6 для FSR), как в `spec/20-electronics.md` §6.2.
- **I2C**: на PANEL-1 добавлены 4.7 кΩ подтяжки для сегмента шлейфа деки (на CORE-1
  свои 4.7 кΩ) — эффективно 2.35 кΩ, допустимо для 100 кГц/400 кГц.
- **Матрицы пэдов/клавиш**: столбцы читаются с внешними 10 кΩ подтяжками
  (`R21..R26`/`R21..R27`): встроенные 100 кΩ MCP23017 слабоваты для шлейфа 10 см.
  Строки — выходы MCP23017, активный низкий; диоды 1N4148 в деке клавиш
  (анод = клавиша, катод = столбец).

## 4. Ограничения и открытые вопросы

1. **Все LED-цепочки на +5 В** (дефект «WS2812 при 3.3 В» закрыт). Панель: GP7 (3.3 В) →
   буфер **U7 74HCT1G125** (VCC = +5 В, TTL-совместимый вход) → R300 330 Ω → LED_ENC1…8 →
   LED_STATUS → `LED_OUT`; 9×WS2812B-2020 и их 100 нФ — на +5 В. Деки: +5 В приходит
   через **pin 16 IDC-16** (`spec/20-electronics.md` §6.2), 18×WS2812B-2020 /
   42×SK6812MINI-E и их 100 нФ — на +5 В; `LED_IN` с панели уже имеет уровень 5 В,
   поэтому уровни питания светодиодов и данных совпадают. Питание +5 В на панели —
   J-CORE pin 21, на деках — pin 16 J-DECK; на каждой плате стоит `PWR_FLAG` (+5V).
2. **DECK_ID** — точные значения по `spec/20-electronics.md` §6.2: DECK-PAD = 33k/3.3k
   ⇒ **0.30 В**, DECK-KEYS = 3.3k/33k ⇒ **3.00 В** (допуск ±0.15 В). Проверяется
   `verify_netlist.py` по номиналам из netlist.
3. **`DECK_INT` → GP28** — закреплено в `spec/20-electronics.md` §2 (GP28 = DECK_INT,
   прерывание MCP23017 деки; при этом GATE1 = GP22, GATE2 = GP26, DECK_ID = GP27).
   Цепь идёт: pin 5 J-DECK → pin 19 J-CORE → GP28 CORE-1; подписано в схемах и в
   `matrix-tables.md` §2.6.
4. **Kailh Choc hot-swap**: посадочного места в стоковых библиотеках KiCad нет,
   поле Footprint у `KEYn` пустое (иначе ERC ругается на несуществующую библиотеку).
   Нужно нарисовать footprint гнезда (CPG1350) — это задача этапа PCB.
5. **IDC-32 (2×16)**: в стоковой библиотеке `Connector_IDC` есть 2×08, но нет 2×16,
   поэтому в схеме стоит `PinHeader_2x16_P2.54mm_Vertical`; при заказе платы
   заменить на IDC-бокс 2×16 (или оставить штыревой разъём + шлейф).
6. **Нумерация выводов светодиодов** (DIN/DOUT/VDD/VSS) взята из символов библиотеки
   KiCad 10 (`LED:WS2812B-2020`, `LED:SK6812`), а не из даташита. Перед разводкой
   платы сверить с даташитом конкретного светодиода (для SK6812MINI-E вывод 1 = VSS
   в библиотеке KiCad).
7. **Только схема**: `.kicad_pcb` (размещение/трассировка), 3D-модели и проверка
   технологичности в этот объём не входят. Схемы дают полный netlist для импорта.
8. **Монтаж**: `PANEL-1` — 1.6 мм, EC11 и тактовые кнопки THT, логика SMD (SOIC/DIP по
   BOM); TP-точки не добавлялись (не требуются спецификацией).
9. **Питание LED-цепочек**: все цепочки на +5 В (9 LED панели + 18/42 LED деки;
   до 51 LED при DECK-KEYS). При 10 мА на LED это ≤ 510 мА по +5 В (бюджет +5 В —
   до 0.8 А, `spec/20-electronics.md` §3), +3V3 разгружен до экрана и логики.
   Ограничение яркости в прошивке (`spec/40-firmware.md`) всё равно обязательно:
   средний ток LED держать ≤ 10 мА, чтобы не перегревать деки и шлейф.

## 5. Соответствие спецификации (что где реализовано)

| Требование `spec/20-electronics.md` §6 / `spec/10-panel-ui.md` | Реализация |
|---|---|
| PANEL-1: 8 × EC11 + RC 10k/100n на фазах, подтяжки | `ENC1..ENC8`, R100…R122 10k, C100…C115 100n, R201…R208 (push) |
| 6 × 74HC165 каскадом, CP/PL/QH, 48 бит | `U1..U6`, цепи `HC_CP`/`HC_PL`/`HC_QH`, биты 0…47 в `matrix-tables.md` §1 |
| Биты 0…15 энкодеры A/B, 16…23 кнопки энкодеров, 24…27 L1/L2/R1/R2 | `ENCn_A`/`ENCn_B`, `ENCn_PUSH`, `BTN_L1/L2/R1/R2` (проверено netlist) |
| 4 плечевых 6×6 | `BTN_L1`, `BTN_L2`, `BTN_R1`, `BTN_R2` (`SW_PUSH_6mm`) |
| Экран 2.8" ST7789, 1×14, 3V3, BL через 2N7002 (ШИМ GP15) | `J-LCD`, `Q1` 2N7002, `R301` 33 Ω, `R302` 100 Ω, `R303` 10k |
| 9 × WS2812B-2020 с LED_OUT, питание +5 В, буфер 74HCT1G125 | `LED_ENC1..8` + `LED_STATUS`, `LED_DATA → U7 74HCT1G125 (VCC=+5V) → R300 330 Ω → LED_IN → … → LED_OUT`; деки получают +5 В по pin 16 J-DECK |
| Разъём деки IDC-16 (2×8) по §6.2 | `J-DECK`, пины 1…16 ровно как в §6.2 (pin 15 = FSR, **pin 16 = +5V** для LED-цепочек деки), сверено netlist |
| IDC-32 к CORE-1 (SPI1, SPI0 SCK/MISO, HC_PL, LED_DATA, I2C0, питание) | `J-CORE` 2×16, pinout в §2.6 `matrix-tables.md` и текстом в схеме; pin 21 = +5V (LED-цепочка) |
| DECK_INT → CORE-1 GP28 | цепь `DECK_INT`: J-DECK pin 5 → J-CORE pin 19 → GP28 (GATE1/2 = GP22/GP26, DECK_ID = GP27) |
| DECK-PAD: 18 тактовых 12×12×5 | `PAD1..PAD18` (`SW_PUSH-12mm`), матрица 3×6 на MCP23017 |
| 18 × WS2812B-2020 | `LED_PAD1..18` (+5 В с pin 16 J-DECK) |
| 2 × слайдер 30 мм 10k на 3.3 В | `SL1`, `SL2` (`PTA3043`), wiper → `SLn_RAW` |
| MCP23017 0x20, матрица 3×6, INT | `U1`, A0…A2 = GND, `INTA → DECK_INT`, IOC |
| 2 × 74HC4067 + 18 мест FSR | `U2`, `U3`, `FSR1..FSR18` + 18 × 10k pull-up, `FSR → J-DECK.15` |
| DECK-KEYS: 42 гнезда Choc + 42 × 1N4148, матрица 6×7 | `KEY1..KEY42` + `D1..D42`, матрица в `matrix-tables.md` §4 |
| 42 × SK6812MINI-E | `LED_KEY1..42` (+5 В с pin 16 J-DECK) |
| 2 × слайдер + 2 индикатора режима | `SL1`, `SL2`, `LED_MODE1/2` на GPA7/GPB7 |
| DECK_ID: PAD 0.3 В, KEYS 3.0 В | `R10` 33k / `R11` 3.3k → **0.30 В**; `R4` 3.3k / `R5` 33k → **3.00 В** |
| Имена для прошивки (`PADn`, `KEYn`, `ENCn`, `LED_*`, `SL*`) | позиционные обозначения в схемах и `netlist` совпадают с `spec/10-panel-ui.md` §6 |

## 6. Как читать схемы

1. Верхний уровень — блоки с текстовыми комментариями (энкодеры, регистры, экран,
   LED, разъёмы). Внутри блока — компоненты с метками цепей.
2. Имя цепи — то, что читает прошивка: например `ENC3_PUSH`, `ROW2`, `COL5`,
   `MUX_S1`, `LED_CH12`, `SL1_RAW`.
3. Полная таблица «координата панели ↔ цепь ↔ бит/канал» — `matrix-tables.md`;
   она автоматически сверяется с netlist при каждом `./tools/build.sh`.
4. Если меняете схему — правьте `tools/gen.py` (данные в начале файла) и запускайте
   `./tools/build.sh`: перегенерируются схемы, таблицы, BOM, ERC и проверка.

## 7. BOM

`BOM-panel.csv` (разделитель `;`) — три платы, строки сгруппированы по
номинал+корпус, есть итоги по позициям. Колонка «Артикул (предложение)» — типовые
MPN для закупки (проверять наличие/цену при заказе; сводный BOM проекта с ценами —
`../docs/BOM.md`, задача task-6). Для деков BOM считается на один вариант: PANEL-1
общая для обоих деков, LED-цепочки отличаются (9 + 18 либо 9 + 42).
