martiyanov/bukifon/hardware/power/README.md

# PWR-BATT-1 — встроенное аккумуляторное питание Букифон

**Ревизия:** 1.0 · **Дата:** 2026-11-05 · **Лицензия:** CERN-OHL-S-2.0
**Исполнитель:** hw-power (подсистема питания)
**Схема:** `PWR-BATT-1.kicad_sch` (KiCad 10, `version 20250114`), генератор `gen_batt_sch.py`
**Статус ERC:** **0 ошибок, 1 предупреждение** (см. §8)

Задача: дать Букифон встроенный аккумулятор **1S2P Li-ion 18650** и зарядку от **USB-C**,
не переделывая CORE-1. Выход блока — **те же 12 В**, которые CORE-1 уже умеет принимать
через J-DC: все рельсы ±12 В/+5 В/+3.3 В, аудио, CV и порты шины продолжают работать
без изменений в схеме ядра.

---

## 1. Что это и почему «брюшная» плата, а не секция CORE-1

Выбран **отдельный модуль PWR-BATT-1 (150 × 60 мм, брюшной/нижний отсек)**:

| Критерий | Отдельная плата (выбрано) | Секция CORE-1 rev.2 |
|---|---|---|
| Площадь CORE-1 | CORE-1 уже 200 × 108 занята, ERC 0/0; батарее нужно ≈ 55 × 60 мм под силовую часть + 2 × 18650 вне платы | пришлось бы расширять/перекомпоновать ядро — риск для готового ERC и разъёмов |
| Тепло | TP4056 (1.3 Вт) + MT3608 (0.7 Вт) греются; лучше отдельно от аналогового аудиотракта CORE-1 | нагрев рядом с PCM5102A/TL074 и −12 В инвертором |
| Сервис/безопасность | батарея и её защита — сменный узел; вынимается/меняется без разборки ядра | замена банок = разборка всего прибора |
| Механика | брюшной/нижний отсек уже предусмотрен (`bay_hatch`, окно снизу) | нужен новый вырез в скорлупе |
| Совместимость | CORE-1 **не меняется вообще** (только кабель J-DC → J5) | правка CORE-1, повторный ERC, риск регресса |

Размер: **150 × 60 × 1.6 мм**, 4 × M3, крепление к нижней скорлупе; силовая часть
(USB-C, TP4056, boost, BMS) — на плате, **2 × 18650 — в держателях рядом** (см. §7).

---

## 2. Архитектура

```
        J4 (12 В внешний БП, с панельного J-DC)                J1 USB-C (заряд, 5 В)
              │                                                  │
        F1 2A │                                                 CC1/CC2 ─ R1,R2 5.1k → GND (UFP!)
              ├─ F1 ── D4 SMAJ15A(TVS) ── C9 100мкФ/25В           │
              │                                                  U1 USBLC6-2SC6 (ESD)
              │                                                  │
              ▼ 12V_EXT_F                                        F2 1.1A (полифьюз)
        D3 SS34 (диод ИЛИ, защита от переполюсовки)               │  CHG_IN (5 В)
              │                                                  ▼
              │                                            U2 TP4056 (1 A, 4.2 В)
              │                                              │        │
              │                                    LED1 CHRG/LED2 STDBY
              │                                              ▼
              │                                    J2 BMS 1S 2P (B−/B+/P−/P+)
              │                                              │  SYS_BAT_P (3.0…4.2 В)
              │                                        F3 2A ─ SW1 (BATT ON/OFF)
              │                                              │  VBAT_SW
              │                                        C4 22мкФ
              │                                              ▼
              │                                    U3 MT3608 boost 1.2 МГц
              │                                     L1 22мкГн, D2 SS34
              │                                     ОС: 12V_BUS → 91k/4.7k → 12.22 В
              │                                              │
              │                                       R9 100k ↑EN
              │                                       Q1 2N7002 ← EXT_DET (R10 100k/R11 22k)
              └──────────────┬───────────────────────────────┘
                             ▼
                     12V_BUS ── C7/C8 22мкФ ── J5 → CORE-1 (вход J-DC) ── все рельсы
                             │
                             ├─ J6 MON: BAT_ADC (R16 100k/R17 47k, C10) → MCP3208 CH4
                             │          TEMP_ADC (R7/R8 200k → 1/2)     → MCP3208 CH5
                             └─ TP1 (VBAT) / TP2 (12V_OUT) / TP3 (GND)
```

### 2.1 Режимы

| Режим | Условие | Что происходит | Кто питает 12 В |
|---|---|---|---|
| **Внешний БП** | на J4 есть 12 В | D3 открыт, шина = 12 В − 0.45 В ≈ **11.55 В**; EXT_DET ≈ 2.16 В открывает Q1 → **EN MT3608 = 0 → boost выключен**; батарея не разряжается | внешний БП (приоритет) |
| **Батарея** | J4 без напряжения | Q1 закрыт, R9 поднимает EN → boost работает, шина = **12.22 В − 0.45 В ≈ 11.75 В**; D3 заперт (обратное смещение) | батарея через boost |
| **Заряд + работа** | USB-C подключён | TP4056 заряжает банки 1 А; система в это время работает от батареи или от внешнего БП; boost не мешает заряду (EN не связан с VBUS) | по наличию J4 |
| **Батарея OFF** | SW1 в OFF | банки отключены от boost; прибор работает только от внешнего 12 В | внешний БП |
| **Хранение** | SW1 OFF + батареи вынуты/отключены | ток утечки BMS ≈ 3…5 мкА | — |

Ключевое: **приоритет внешнего источника — аппаратный** (не прошивочный). Он реализован
не «идеальным диодом на компараторе», а связкой «диод ИЛИ SS34 + гашение EN буста»
(см. §9, почему так и когда ставить MOSFET ideal-diode). Если внешний БП пропал, boost
включается сам; переход «внешний → батарея» проходит без сброса Pico (на шине остаётся
11.55 → 11.75 В, CORE-1 имеет 1000 мкФ и свои стабилизаторы).

### 2.2 Почему выход именно 12 В, а не 5 В

CORE-1 формирует **все** рельсы из одного входа 12 В: MP1584 → +5 В, AP2112 → +3.3 В,
MC34063 → −12 В. Подать 12 В на месте J-DC — единственный способ запитать прибор
**без переделки** CORE-1 (и единственный, который даёт −12 В для аналоговых модулей).
Подача 5 В напрямую потребовала бы второго boost и не дала бы −12 В.

---

## 3. Состав и номиналы (ключевое)

| Узел | Компонент | Номинал / расчёт |
|---|---|---|
| USB-C вход | J1 16P, R1/R2 5.1k (CC1/CC2 → GND) | UFP-резисторы: без них зарядник USB-C не даст 5 В |
| ESD | U1 USBLC6-2SC6 | I/O1 на VBUS, I/O2 на CC1; порт **только зарядный**, D+/D− не используются |
| Защита входа | F2 полифьюз 1.1 А, C1 10 мкФ | заряд ≤ 1 А |
| Заряд | U2 TP4056-42-ESOP8, R3 1.2k (PROG) | I = 1000 мА; CV 4.2 В ±1 %; CE = VCC (всегда включён) |
| Индикация | LED1 (CHRG, красный), LED2 (STDBY, зелёный), R4/R5 1k | ток ≈ 3 мА, open-drain выходы TP4056 |
| Контроль T | TH1 NTC 10k B3950 на банках, R6 10k от CHG_IN | окно 45…80 % VCC = штатная логика TP4056: заряд блокируется < 0 °C и > 45 °C |
| АЦП температуры | R7/R8 200k (÷2), C3 100n | 0…2.5 В на CH5; при отключённом USB ≈ 0 В ⇒ **прошивка видит сам факт заряда** |
| Батарея | 2 × 18650 3.6 В 3.5 А·ч в параллель (1S2P) | 3.5…7 А·ч, 12.6…25 Вт·ч (в ТЗ 5…7 А·ч); 3.0…4.2 В |
| Защита | J2 — модуль BMS 1S 2P (DW01A + FS8205A), 5 А | перезаряд 4.25…4.30 В, переразряд 2.35…2.50 В, КЗ/перегрузка 3…6 А |
| Предохранитель батареи | F3 полифьюз 2 А | до выключателя, защищает шлейф/плату |
| Выключатель | SW1 SPDT (MSK-12C02) | полное отключение банок = хранение/транспорт |
| Boost | U3 MT3608 (SOT-23-6), L1 22 мкГн / 3 А, D2 SS34, C4 22 мкФ, C7/C8 22 мкФ/25 В | f 1.2 МГц; Vout = 0.6 · (1 + 91k/4.7k) = **12.22 В**; ОС снимается **после** D2 (компенсация падения диода) |
| Приоритет | D3 SS34, R10 100k / R11 22k (EXT_DET), Q1 2N7002, R9 100k, C5/C6 100n | внешние 12 В ⇒ EN = 0 ⇒ boost off |
| Выход | J5 (KF128-2P, 3.81 мм) → CORE-1 J-DC | 11.75…11.8 В в батарейном режиме |
| Контроль | R16 100k / R17 47k, C10 100n → CH4 | 3.0 В → 0.96 В, 4.2 В → 1.34 В (0…3.3 В шкала) |
| TVS | D4 SMAJ15A + C9 100 мкФ/25 В на входе 12 В | импульсы БП, статика |

Полный перечень — `BOM-power.csv` (55 позиций).

---

## 4. Расчёт времени работы

### 4.1 Энергия в батарее

- 2 × 18650 по 3.5 А·ч в параллель: **7.0 А·ч**, номинал 3.6 В → **25.2 Вт·ч**
- с учётом BMS-отсечки 3.0 В и температурных потерь: **≈ 21 Вт·ч полезных**
  (вариант с банками 2.5 А·ч: 5 А·ч / 18 Вт·ч / ≈ 15 Вт·ч полезных)
- η(boost MT3608 при 3.6 → 12 В, 0.2…1.5 А) ≈ **0.85** (паспорт 93 % при 5 В→12 В,
  но при 3.6 В и малом токе реально 0.80…0.88; при 3.0 В — 0.78)

Время = `E_полезн / (P_12В / η)`

### 4.2 Сценарии (бюджет CORE-1 из spec/20 §3)

| Сценарий | +12 В | −12 В | +5 В | +3.3 В | P(12 В шина) | P(батарея) | Ток батареи | Время (21 Вт·ч) |
|---|---|---|---|---|---|---|---|---|
| **Idle** (меню, экран, LED 20 %, без модулей) | 30 мА = 0.36 Вт | 30 мА = 0.36 / 0.70 = 0.51 Вт | 0.25 А = 1.25 / 0.88 = 1.42 Вт | 0.09 А → 0.30 / 0.85 = 0.35 Вт | **2.6 Вт** | 3.1 Вт | 0.86 А | **≈ 6.8 ч** |
| **Типичный** (1 аналоговый модуль, LED 40 %, наушники) | 0.12 А = 1.44 Вт | 60 мА = 0.72 / 0.70 = 1.03 Вт | 0.37 А = 1.85 / 0.88 = 2.10 Вт | 0.10 А → 0.33 / 0.85 = 0.39 Вт | **5.0 Вт** | 5.8 Вт | 1.62 А | **≈ 3.6 ч** |
| **Максимум по бюджету CORE-1** (3 модуля, LED 100 %, громко) | 0.40 А = 4.80 Вт | 0.20 А = 2.40 / 0.70 = 3.43 Вт | 0.80 А = 4.00 / 0.88 = 4.55 Вт | 0.12 А → 0.40 / 0.85 = 0.47 Вт | **13.3 Вт** | 15.6 Вт | 4.3 А | 1.35 ч **теоретически** |
| **Предел блока на батарее** (тепловой/токовый лимит MT3608) | 12 В / 0.42 А | — | — | — | **≈ 5 Вт** | 5.9 Вт | 1.64 А | **≈ 3.5 ч** |

**Вывод:** на батарее прибор рассчитан на **2…3.5 Вт на шине 12 В** (типично 5 Вт,
предел 5…6 Вт). Максимальный бюджет CORE-1 (13.3 Вт на шине) на батарее **недостижим** —
это ограничение MT3608 (ключ 2 А), а не банок: при 13.3 Вт входной ток буста был бы 4.3 А.
Полная мощность (3 модуля + все LED на максимум) — **только от внешнего 12 В 2 А**
или от USB-C PD (не реализовано, см. §10).

**Режим «максимум» на батарее** (предложение для прошивки): при питании от батареи
автоматически ограничивать яркость WS2812-цепочек (например, ≤ 30 %) и предупреждать
при попытке включить 3 аналоговых модуля; BAT_ADC даёт «сколько осталось», TEMP_ADC
(≈ 0 В при отсутствии заряда) — признак «работаем от батареи».

### 4.3 Заряд

- 1 А на 7 А·ч → CC ≈ 6.5 ч, с CV-хвостом **7.5…8 ч**; на банки 2.5 А·ч — 5.5 ч
- заряд от USB-C 5 В/1 А (любой 5 A-БП или зарядник телефона ≥ 1.5 А; 1.1 А полифьюз)
- заряд и работа одновременно **разрешены** (TP4056 не отключает нагрузку), но время
  заряда растёт на ток нагрузки; при работе от батареи во время заряда суммарный
  ток через банки может быть 0.6…1.6 А — для 2 банок это ≤ 0.25C, безопасно

---

## 5. Контроль: как измерять батарею

| Сигнал | Куда | Формула / расчёт | Что даёт |
|---|---|---|---|
| `BAT_ADC` (J6 pin 1) | **MCP3208 CH4** | `Vadc = Vbat · 47/(100+47)`; код = `Vadc/3.3·4096` ⇒ `Vbat = Vadc · 3.128`; 1 LSB ≈ 2.5 мВ ≈ 2.5 мВ на 1 код | напряжение банок, % заряда (по кривой Li-ion), «пора заряжать» |
| `TEMP_ADC` (J6 pin 2) | **MCP3208 CH5** | `Vadc = Vtemp/2`; при 25 °C ≈ 1.25 В; **0 В = заряд не идёт** (нет 5 В на плече NTC) | температура банок при заряде + признак «USB-C подключён» |
| `LED1` (красный) | локально на плате | CHRG open-drain | индикация «идёт заряд» |
| `LED2` (зелёный) | локально на плате | STDBY open-drain | индикация «заряд окончен» |
| `LED3` (зелёный) | локально на плате | от 12V_EXT_F | «внешний БП подключён» |
| `LED4` (синий) | локально на плате | после SW1 | «батарея включена» |
| `TP1/TP2/TP3` | тестовые площадки | — | наладка: VBAT / 12.22 В / GND |

### 5.1 Конфликт с картой АЦП CORE-1 и минимальная правка

На CORE-1 (рев. 1.0, ERC 0/0) **CH4 и CH5 притянуты к AGND** (README CORE-1 §5, п.7:
«резерв — притянуты к AGND, не висят в воздухе»). Это единственный конфликт с существующей
схемой ядра. Он снимается **минимальной правкой CORE-1 rev.2**:

1. убрать два резистора-перемычки CH4/CH5 на AGND (DNP, площадки остаются);
2. добавить на CORE-1 разъём **J-BATT-MON 1×3** (шаг 2.54): `1 = CH4`, `2 = CH5`, `3 = AGND`;
   шлейф 10 см до J6 на PWR-BATT-1;
3. в прошивке `MCP3208 CH4 = BAT`, `CH5 = BAT_TEMP`; калибровка в 24C32 (0x57, уже есть).

Если правку CORE-1 делать не хочется, альтернатива — **не выводить** BAT_ADC/TEMP_ADC,
а определять заряд/разряд только по просадке 12 В шины… это требует внешнего делителя
на свободный GPIO, которого нет. Поэтому рекомендуется правка rev.2 с 2 DNP + 1 разъём
(цена — копейки, ERC не затрагивается).

**Второй конфликт (механика, §7):** второй USB-C (зарядный) — новое отверстие в задней
панели. Свободное место в таблице §9 spec/20: после MASTER VOL (X = 188) зона
X 190…282 не занята. Предложение: **USB-C (заряд) X = 210, Z = 24, Ø/размер 12 × 7**.
Правка `spec/20-electronics.md` §9 и `rear_plate` в механике (1 строка).

---

## 6. Безопасность

**Что стоит в схеме (защита по цепочке «банка → система»):**

| Уровень | Элемент | Порог / поведение |
|---|---|---|
| Банка | защищённые 18650 с собственным PTC (рекомендуется) | резервный уровень |
| BMS 1S 2P | DW01A + FS8205A | перезаряд 4.25…4.30 В (откл.), переразряд 2.35…2.50 В (откл.), перегруз 3…6 А, КЗ — отключение, автовосстановление после снятия нагрузки |
| Температура заряда | NTC на банках + TP4056 TEMP | заряд запрещён < 0 °C и > 45 °C (внутренняя логика TP4056), индикация — LED мигает/не заряжает |
| Ток батареи | F3 полифьюз 2 А (самовосстановление) | КЗ в шлейфе/плате |
| Ток заряда | F2 полифьюз 1.1 А | КЗ в USB-C/TP4056; TP4056 ограничивает 1 А |
| Вход 12 В | F1 2 А + D4 SMAJ15A TVS + D3 SS34 (переполюсовка) | импульсы, статика, «минус на плюсе» |
| Выход 12 В | D2 SS34 (обратный ток), CORE-1: F1 2 А + TVS + 1000 мкФ | шина защищена дважды |
| Выключатель | SW1 SPDT | полное отключение банок (хранение/транспорт) |

**Категорически нельзя:**
1. **Ставить банки «минусом на плюс»** — держатель 18650 симметричен, BMS **не** защищает
   от переполюсовки. Проверить полярность мультиметром до включения; маркировка «+» на плате
   и на держателе, ключ-выступ на держателе (reverse-polarity protected holders — предпочтительны).
2. Смешивать банки **разной ёмкости/химии/износа** (параллель!) — только одинаковые,
   одного производителя и партии, заряженные до одинакового напряжения (±0.02 В).
   Разброс → переток между банками.
3. Заряжать **током > 1 А** (R3 1.2k = 1 А; ниже 1.2k — режим вне спецификации TP4056-SOP8),
   заряжать без NTC или с отключённым TEMP-контролем.
4. **Замыкать выход** батареи: BMS отключит, но ток КЗ (десятки ампер) старит контакты;
   F3 — вторичная защита.
5. Разбирать/паять **непосредственно на выводах банок** — только точечная сварка или холдеры.
6. Заряжать при **T < 0 °C** (литий осаждается металлом → внутреннее КЗ) и **T > 45 °C**
   (риск разгона). После «глубокого» разряда (< 2.5 В) банку не заряжать — утилизировать.
7. Оставлять прибор заряжаться **без присмотра на горючей поверхности** (общее правило
   для DIY Li-ion; TP4056 не имеет независимого второго уровня защиты по напряжению).
8. Хранить при 100 % заряда месяцами — деградация; хранить при **3.7…3.8 В (≈ 50 %)**,
   10…25 °C, SW1 = OFF, в сухом месте вне прибора при длительном хранении.

**Транспортировка:** SW1 = OFF, лучше — вынуть банки; при авиаперевозке банки только
в ручной клади, клеммы изолированы, ≤ 100 Вт·ч на элемент (18650 3.5 А·ч = 12.6 Вт·ч — ок).

---

## 7. Встраивание в корпус

**Плата:** 150 × 60 × 1.6, 4 × Ø3.3 (M3 + термовтулка 4.6 × 6), стойки 6 мм.
**Батарейный отсек:** 2 × 18650 в параллель:

| Вариант держателя | Габарит | Примечание |
|---|---|---|
| 2 × Keystone 1042 (SMT, 1 банка) | 2 × (77.1 × 21 × 15) | на плате 150 × 60 два холдера 77 мм по длине — влезают в 150 × 60 только повёрнутыми: 2 × 21 = 42 < 60, длина 77 < 150 ✔ |
| Сдвоенный держатель (2-slot, 77.1 × 39.8 × 14.9) | 77 × 40 × 15 | компактнее, один узел, банки параллельно |
| Банки без держателя (точечная сварка + 3D-корпус) | 68 × 38 × 20 | минимум объёма, нужен принтерный ложемент |

**Конфликт Z-стека (важно, нужен решение механики):** по `spec/30-mechanics.md` §1
брюшной отсек — **Z 0…8** (окно снизу 200 × 60), дно скорлупы на Z = 8, внутренняя
полость с 11.4, CORE-1 на 16. То есть под CORE-1 доступно **8 мм**, а 2 × 18650
с держателем требуют **≈ 21 мм** (банка Ø18.4 + 2 мм). «Запихнуть» в существующий
брюшной отсек нельзя.

Предлагаемые варианты (по возрастанию вмешательства):

- **A (рекомендую). «Батарейная брюшная коробка»:** `bay_hatch` (210 × 70 × 2) заменяется
  на `battery_hatch` — коробку **150 × 62 × 24** с 4 × M3, выступающую на ≈ 16 мм ниже
  дна (как батарейный блок геймпада). Внутри — плата PWR-BATT-1 (60 мм) + 2 × 18650.
  При этом: нижний док (окно PORT2 36 × 10 в дне) переносится на заднюю часть
  `bay_hatch` или отменяется — **это решение Lead/mechanical**, см. §10.
- **B. Внешний «батарейный картридж»** в нижний док: 110 × 70 × 25 по формату модулей
  шины, разъём 2 × 12 В + 3 контроля. Плюс: ноль изменений корпуса, минус: блок
  свисает снизу, ёмкость та же, но выглядит как отдельный модуль.
- **C.** Батарея в рукоятках/тыльном «горбе»: там нет полости (рукоятки — сплошные
  накладки, Z 0…8 сверх дна), нужен полный редизайн скорлупы. Не рекомендую.

**Раскладка платы (150 × 60):** левые 60 × 60 — USB-C (край, вырез 12 × 7), F2, U1, U2
TP4056, индикаторы LED1/LED2 (световоды Ø3 на торец/низ); центр 40 × 60 — BMS-модуль,
F3, SW1 (доступ через батарейную крышку), TH1; правые 50 × 60 — boost (L1, U3, D2),
K1-разъёмы J4/J5/J6 (клеммники 3.81 мм, доступ при снятой крышке), TP1…TP3.
Провода к батарейному отсеку — силиконовые 20 AWG ≤ 15 см (КЗ-стойкие), витая пара
для NTC. (Разводка PCB — следующий этап, вместе с CORE-1; footprint'ы в схеме черновые.)

---

## 8. ERC и проверка

```
cd hardware/power && /opt/homebrew/bin/python3 gen_batt_sch.py     # схема + ERC + PDF/SVG + BOM
```
- KiCad **10.0.4**, `kicad-cli sch erc --severity-all`: **0 ошибок, 1 предупреждение**
- предупреждение: `lib_symbol_mismatch` для `USBLC6-2SC6` — артефакт генератора
  (символ в библиотеке KiCad задан через `extends "USBLC6-2P6"`, встроенная копия
  разворачивается генератором; электрически это тот же символ, в KiCad GUI открывается
  без замечаний). Устраняется копированием символа в проектную библиотеку (как
  `bukifon.kicad_sym` в hardware/core) — на электрику не влияет.
- 27 цепей; netlist выгружен (`netlist.net` = KiCad s-expr, `netlist.xml` = XML) и
  сверен с таблицей компонентов генератора; счётчики цепей и пинов совпадают.
- **ERC не проверяет** номиналы, тепловые режимы, токи — см. §4 и §6 (расчёт вручную).
- **На макете не проверялось:** пульсации и КПД MT3608 при 3.0 В и 6 Вт, тепловой режим
  TP4056 при 1 А (ESOP8 с EPAD, нужно ≥ 300 мм² меди), поведение перехода
  «внешний ↔ батарея» (нагрузка 0.5 А), точность порога EXT_DET (разброс R10/R11 ±5 % →
  ±0.1 В, гистерезис не заложен — дребезг при просадке внешнего БП ниже 10 В **возможен**,
  рекомендуется C6 и, при наладке, резистор 1 МОм ОС от BOOST_EN для гистерезиса).

---

## 9. Решения и отклонения от буквы задания (важно)

1. **BMS — готовым модулем 1S 2P (J2, 4 контакта), а не дискретно DW01A + 2 × FS8205A.**
   Причина: у модуля уже разведены силовые полигоны и защита от переполюсовки нагрузки,
   он дешевле и проверен; дискретная версия в схеме дала бы лишние 8 позиций и ошибки
   в типовой обвязке. Если нужна дискретная реализация — DW01A есть в библиотеке KiCad,
   FS8205A — нет (заменить на 2 × AO3400 / SI2302, схема типовая, 10 деталей).
2. **«Идеальный диод» = SS34 (D3/D2) + гашение EN буста, а не MOSFET-ideal-diode с
   компаратором.** Задача говорит «ideal-diode на SS34/MOSFET» — SS34-вариант реализован
   и достаточен: при внешних 12 В boost выключен по EN, а D2 закрыт обратным смещением,
   т.е. батарея не разряжается. Цена: 0.45 В падения и 0.5 Вт потерь на D2 при 1.2 А.
   **Улучшение на будущее:** P-MOSFET AO3401A + компаратор (например, TLV4021) или
   готовый TPS2113A — КПД +3…4 %, но +6 деталей. Вариант на MOSFET без компаратора
   рискован (канал проводит в обе стороны, нужна логика затвора).
3. **TPS61088 не выбран.** Он держит полную мощность (10 А ключ), но это QFN-20 3 × 3
   с обязательной разводкой и термопадом — для DIY-платы 150 × 60 на 2 слоя
   неоправданно; MT3608 + программное ограничение нагрузки на батарее дешевле,
   и полная мощность всё равно доступна от внешнего БП. Если заказчик захочет
   «всё от батареи» — замена узла U3 на TPS61088 (документ: `availability.md`, §альтернативы).
4. **TP4056, а не BQ24075.** BQ24075 (QFN-16, power-path) лучше (может питать нагрузку
   от USB без разряда батареи), но: QFN-16 3 × 3 не паяется вручную новичком, требует
   внешнего индуктора/настройки ILIM, и в РФ/LCSC дешевле и доступнее TP4056.
   Power-path в нашей топологии не критичен: система питается от 12 В-шины, а не от 5 В.
   BQ24075 оставлен как опция в `availability.md`.
5. **USB-C на PWR-BATT-1 — только заряд (VBUS + CC).** MIDI по USB-C остаётся на Pico
   (как в ТЗ). D+/D− не разведены, SBU — no-connect, ESD стоит на VBUS и CC1.
   Это второй USB-C на задней панели; если заказчик хочет **один** разъём,
   нужен USB-C-хаб/мультиплексор или зарядка от 5 В через Pico — не рекомендую
   (Pico VBUS нельзя нагружать током заряда).
6. **Термистор один**, обслуживает и TP4056 (аппаратная отсечка по T), и АЦП (через
   делитель 200k/200k). Ограничение: температура читается только при подключённом
   USB-C (верх плеча NTC — от 5 В). Это осознанно: при разряде контроль температуры
   не нужен (BMS + PTC), а «0 В на TEMP_ADC» прошивка использует как признак «заряд идёт».
7. **Не реализовано (осознанно, вне объёма этой задачи):** USB-C PD/QC (5 В/1 А
   достаточно: 7 А·ч заряжаются за 7.5 ч; PD ускорил бы до 3 ч, но требует
   контроллера, например CH224K), заряд от внешнего 12 В (можно добавить buck 12→5 В
   и диод ИЛИ — сейчас заряд только USB-C), индикация уровня заряда на экране
   (нужна прошивка, железо готово: CH4).
8. **GND на PWR-BATT-1 — единая цепь** (PGND). На CORE-1 она приходит на вход J-DC
   (там PGND/TVS/полифьюз), а «звезда» AGND/DGND/PGND уже сделана на CORE-1 (NT1/NT2).
   Отдельных земель на этой плате не нужно: аналоговых сигналов нет, только медленные
   АЦП-делители с RC-фильтрами.

---

## 10. Открытые вопросы (к Lead / mechanical / firmware)

1. **Механика батарейного отсека** — блокирующий: 2 × 18650 (21 мм) не входят в брюшной
   отсек (8 мм). Нужно решение по варианту A/B (§7) и правка `spec/30-mechanics.md`
   (Z-стек, `bay_hatch` → `battery_hatch`, судьба нижнего дока PORT2).
2. **Второй USB-C на задней панели** — подтвердить координату X = 210, Z = 24
   (правка `spec/20-electronics.md` §9 + `rear_plate`) либо выбрать вариант «зарядный
   разъём в батарейной крышке/снизу».
3. **CORE-1 rev.2**: снять притяжки CH4/CH5 к AGND, добавить J-BATT-MON 1×3
   (CH4/CH5/AGND). Это единственная правка ядра.
4. **Прошивка**: драйвер MCP3208 CH4/CH5, кривая Li-ion → %, порог «заряжать»,
   ограничение яркости LED на батарее, запрет «3 модуля на батарее»,
   признак «внешний БП / батарея» (по BAT_ADC и TEMP_ADC).
5. **BOM**: цены/поставщики в `BOM-power.csv` не заполнены (по правилам задачи — не
   выдумывать). Доступность и ориентиры — `availability.md`; влить позиции в общий
   `BOM.csv` (зона docs-bom) после согласования с Lead.
6. **BCD/DRC**: разводка платы (150 × 60, 2 слоя) не делалась — следующий этап после
   фиксации механического варианта; силовые полигоны 12 В/батареи ≥ 2 мм,
   тепловой полигон TP4056 ≥ 300 мм², кельвиновские точки для FB.

---

## 11. Файлы

| Файл | Что это |
|---|---|
| `PWR-BATT-1.kicad_sch` | схема KiCad 10 (главный артефакт), 55 компонентов, 27 цепей |
| `PWR-BATT-1.kicad_pro` | проект KiCad |
| `gen_batt_sch.py` | генератор схемы + ERC + PDF/SVG/netlist/BOM |
| `tools/kicad_sch.py` | писатель `.kicad_sch` (копия `hardware/panel/tools/`, автор hw-panel) |
| `erc/erc.rpt`, `erc/erc.json` | ERC-отчёт (`--severity-all`) |
| `PWR-BATT-1.pdf`, `svg/PWR-BATT-1.svg.gz` | экспорт схемы (A2, 1 лист) |
| `netlist.net`, `netlist.xml` | netlist (s-expr и XML) |
| `BOM-power.csv` | BOM: артикул, позиция, номинал, корпус, MPN/замены, примечание |
| `availability.md` | доступность ключевых позиций (веб, с датой и ссылками) |

```bash
# проверка артефактов
cd hardware/power
ls PWR-BATT-1.kicad_sch PWR-BATT-1.kicad_pro erc/erc.rpt PWR-BATT-1.pdf svg/PWR-BATT-1.svg.gz \
   netlist.net netlist.xml BOM-power.csv README.md availability.md
grep -E "ERC messages" erc/erc.rpt
```
