martiyanov/bukifon/hardware/power2/README.md

# PWR-2 (rev.1) — батарея + рельсы шины для CORE-2

> ## ⛔ PRE-FREEZE / DO NOT FABRICATE
> **Схема не готова к заказу плат.** Нельзя отправлять в производство до:
> 1) стендовых измерений §8 `power-tree-pwr2.md` (КПД/шум/тепло/ток OFF, в первую очередь
>    инвертирующий −12 В и power-path BQ24074);
> 2) согласования правок CORE-2 rev.2 `interfaces.md` §5 (DNP MT3608 #1/#2, MC34063, BMS);
> 3) подписи требований `spec/90-requirements-registry.md` (design freeze);
> 4) решения по разъёму J3 при 3 А (IDC-20 ↔ Micro-Fit 3.0).
> Это исследовательская ревизия новой триады CORE-2 / PANEL-2 / PWR-2, а не релиз.
> V1.0-плата питания — `hardware/power/` (PWR-BATT-1), **она не меняется**.

**Роль:** третья плата триады. CORE-2 отвечает за MCU/аудио/CV/USB и **заряд с power-path
(BQ24074)**; PANEL-2 — за UI. PWR-2 = энергия: пакет 1S2P с защитой, гейдж и **рельсы
шины модулей +12 В / −12 В / +5 В / +5V_LED**, соединение с CORE-2 одним силовым (IDC-20)
и одним управляющим (IDC-12) разъёмом.

**Лицензия:** CERN-OHL-S-2.0 (аппаратура) · **ERC:** 0 errors / 0 warnings (KiCad 10.0.4).

**Основание:** консультация инженера по питанию — [`docs/25-power-architecture.md`](../../docs/25-power-architecture.md);
решения **D-27…D-31** — [`spec/90-requirements-registry.md`](../../spec/90-requirements-registry.md);
freeze-пакет — [`docs/schema/pwr2.md`](../../docs/schema/pwr2.md).

---

## 1. Что на плате

| Блок | Состав |
|---|---|
| **Пакет 1S2P** | 2 × 18650 параллельно (холдеры вне платы, J1 3P), F1 5 А, Q1 AO3401A (защита от переполюсовки), D1 SMBJ5.0A TVS, TH1 NTC 10 k на банке |
| **BMS 1S** | U1 BQ297xy + Q2/Q3 AO3400A (общий исток), VBAT = P+ → BQ24074 BAT (CORE-2); OVP 4.25–4.30 В, UVP 2.35–2.50 В, OCP/SCP; BMS = аварийная защита, не кнопка |
| **Master load switch** | Q4/Q5 back-to-back AO3401A (reverse blocking, ≈22 мОм), Q6 MMBT3904 драйвер, J2/SW1 (панельный тумблер), C2 100 n (плавный пуск/inrush), D2 TVS |
| **Fuel gauge** | U2 MAX17048 (I2C 0x36, ±7.5 мВ, без шунта), Kelvin-питание от банки (R10 10 Ω), C4/C5, серия 22 Ω на I2C; **резервный ADC** — `BATT_MON` (сырой VBAT через 1 к) на CH6 CORE-2 |
| **+12 В (330 мА)** | U3 TPS61088 синхронный boost 12.15 В (10-А ключ, запас 4×), L1 10 мкГн, C-L-C π-фильтр (L2 4.7 мкГн + 2 × 47 мкФ/25 В), F2 0.5 А, **D7 SS34** (back-feed), D3 SMAJ15A, R17 разряд |
| **−12 В (95 мА)** | U4 LMR33630 в **инвертирующем buck-boost** (GND МС = −12 В, VIN = VSYS+12 В = 15.7 В), L3 22 мкГн, ОС 110k/10k = 12.0 В, EN через оптопару U5 PC817, π-фильтр (L4 + 2 × 47 мкФ/25 В), F3 0.3 А, **D8 SS34**, D4 SMAJ15A, R24 разряд |
| **+5 В (1.6 А)** | U6 TPS61088 boost 5.10 В, L5 10 мкГн, π-фильтр (L6 + 2 × 47 мкФ), F4 2 А, D5 SMBJ5.0A, R28 разряд |
| **+5V_LED** | F5 2.5 А, C33 47 мкФ, D6 SMBJ5.0A, **Q7 AO3400A low-side ключ возврата** (EN_LED5, OFF по умолчанию) |
| **Супервизор** | U7 MCP130-270: `PWR_GOOD` open-drain (LOW = VSYS < 2.70 В) |
| **EN-входы** | EN_BUS12 (Q9), EN_N12 (U5 оптопара), EN_LED5 (Q7), EN_5V (Q10) — все **3.3 V-safe**, дефолт: рельсы ON, LED OFF |
| **Разъёмы** | J3 IDC-20 (VSYS/VBAT/+12/−12/+5/5V_LED/LED_RET + парные PGND), J4 IDC-12 (BATT_MON/NTC/I2C/ALRT/PWR_GOOD/4×EN), J1 PACK 3P, J2 панельный тумблер, TP1…TP9 |

## 2. Ключевые решения (и почему)

1. **Преобразователи питаются только от VSYS (BQ24074 OUT), не от PACK.** Иначе ломается
   power-path и алгоритм окончания заряда (требование ревью питания).
2. **Заряд остаётся на CORE-2 (BQ24074).** PWR-2 — «энергетическая» плата, но не зарядник:
   одна точка ответственности за power-path.
3. **±12 В: синхронный boost + инвертирующий buck-boost. MC34063 и charge-pump исключены**
   (КПД 55–75 % / 30–60 %, шум в аудиополосе, ключ 1.5 А не тянет 3 В→12 В/300 мА).
   Подробное сравнение с push-pull-трансформатором — `power-tree-pwr2.md` §3.
4. **−12 В сделан как IBB («buck с плавающей землёй»)**: МС видит VIN = 15.7 В, её «земля» =
   −12 В, выход = системная земля; ОС — обычный делитель (Vref 1.0 В), EN — через оптопару.
   КПД 87 %, тепла 0.17 Вт, один индуктор, нет кастомных трансформаторов.
5. **TPS61088 ×2** (+12 В и +5 В) — один MPN, одна квалифицируемая МС на стенде (меньше
   риска для PRE-FREEZE). Альтернатива cost-down — TPS61090 для +5 В с исключением на VBAT<3.4 В.
6. **D7/D8 (SS34) в выходах ±12 В** — не «диод ИЛИ», а **защита от back-feed**: внешний 12 В
   (на CORE-2) и шина модулей не могут «тянуть» наши преобразователи, а батарея не
   разряжается через выход при работе от внешнего БП. Это делает топологию
   двух-источниковой безопасной **аппаратно**, без обязательной координации по EN.
7. **`PWR_GOOD` = open-drain супервизор 2.70 В** (ниже UVP BMS 2.5 В) — система узнаёт о
   просадке заранее; pull-up на CORE-2.
8. **Master switch — back-to-back P-FET**, а не «BMS как выключатель»: BMS остаётся аварийной
   защитой, а питание выключается штатно (тумблер), с плавным пуском через C2.
9. **LED-ветка коммутируется по возврату** (low-side AO3400A): питание +5 В для логики/аудио
   остаётся всегда, а цепочка WS2812 обесточивается (нет утечки и «тлеющих» LED), и возврат
   LED не течёт через землю аудио-CORE-2.
10. **Гейдж + резервный ADC**: MAX17048 (I2C 0x36) даёт SOC; `BATT_MON` — независимая
     аналоговая проверка через MCP3208 CH6 CORE-2 (делитель остаётся на CORE-2 — не дублируем).

## 3. Файлы

| Файл | Что это |
|---|---|
| `PWR-2.kicad_sch` + `PWR-2.kicad_pro` | схема KiCad 10 (S-expr 20250114, 1 лист A0), 128 компонентов, 59 цепей |
| `PWR-2.pdf`, `svg/PWR-2.svg.gz` | экспорт схемы (баннер PRE-FREEZE на листе) |
| `erc/erc.rpt`, `erc/erc.json` | ERC (`kicad-cli sch erc --severity-all`): **0 errors / 0 warnings** |
| `netlist.net`, `netlist.xml` | netlist (s-expr и XML, относительные пути в `<source>`) |
| `BOM-power2.csv` | BOM: артикул PM-PWR2-NNN; MPN (draft); номинал; кол-во; позиции; корпус; примечание |
| `power-tree-pwr2.md` | дерево питания: таблица рельсов (Vin/Vout/Imax/КПД/тепло), бюджеты, сравнение топологий ±12 В, защиты, тепловой бюджет, ток OFF, стенд-план |
| `interfaces.md` | контракт PWR-2 ↔ CORE-2: J3/J4, EN-семантика, земли, I2C-карта, калибровка гейджа, правки CORE-2 rev.2 |
| `picomod2.kicad_sym`, `sym-lib-table` | проектная библиотека (TPS61088, MAX17048 — draft pinout) |
| `gen_pwr2_sch.py` | генератор схемы + ERC + PDF/SVG/netlist + BOM |
| `tools/kicad_sch.py` | писатель `.kicad_sch` (копия `hardware/core2/tools/`, автор hw-core) |
| `dfm.md` | DFM/testability: TP1–TP9 + J4-пады, self-test 8, DFM 3 А/J3, чек-лист 15 |
| `bench-macet.md` | карта стенда-макета (gate до PCB): M1–M11, B-метки, быстрый чек-лист |
| `../../docs/schema/pwr2.md` | freeze-пакет: рельсы, топология ±12 В, земля/тепло, перечень стендовых измерений |
| `../../docs/44-pwr-bench.md` | **процедура стенда до PCB**: состав/бюджет $80–150, 13 измерений T1–T13 с критериями |

## 4. Как перегенерировать и проверить

```bash
cd hardware/power2
/opt/homebrew/bin/python3 gen_pwr2_sch.py     # схема + ERC + PDF/SVG/netlist + BOM
/Applications/KiCad/KiCad.app/Contents/MacOS/kicad-cli sch erc --severity-all \
    --format report -o erc/erc.rpt PWR-2.kicad_sch
grep "ERC messages" erc/erc.rpt               # → Errors 0  Warnings 0
```

## 5. Ограничения (что НЕ сделано)

- **Нет PCB/DRC** — только схема (PRE-FREEZE). Footprint'ы частично draft
  (`QFN-20 3×3`, `SOIC-8 PowerPAD`, `DIP-4` оптопара, IDC) — проверять при разводке.
- **Пиноут TPS61088 и MAX17048 в проектных символах — DRAFT** (номера выводов по памяти
  архитектуры); сверить с datasheet TI/Maxim до трассировки. Электрическая топология
  (функции выводов) корректна.
- **Номиналы индукторов/конденсаторов — расчётные стартовые**; после стенда (КПД, ripple)
  возможна коррекция (10 → 6.8 мкГн и т.п.).
- **Не проверено на макете**: КПД/тепло/шум всех трёх преобразователей, поведение IBB на
  VBAT 3.0 В, power-path BQ24074 при заряде + максимальной нагрузке, ток OFF, пороги BMS
  с реальными деталями.
- **Не заказаны** цены/поставщики в BOM (не выдумывались); MPN — черновые.
- **Утечка/поведение при выключении**: расчёт ≤ 10 мкА вклада PWR-2; полный ток OFF
  системы зависит от BQ24074 на CORE-2 — измерять.
- **GPIO-бюджет CORE-2 исчерпан (0 свободных)** → 4 EN-линии требуют MCP23017 на PANEL-2
  (или не разводятся, дефолт = всё включено).

## 6. Что нельзя заказывать до бенчмарка P1

1. **Плату PWR-2** — до подписи spec/90 и измерений §8 (`power-tree-pwr2.md`).
2. **−12 В (IBB) без стендовой проверки**: инвертирующий buck с плавающей землёй —
   обязательный тест на макете при VBAT 3.0 В / 150 мА (Vout, ripple, тепло, поведение EN).
3. **Разъём J3** — если 3 А не пройдут по нагреву/падению (IDC 2.54 мм на границе),
   перейти на **Molex Micro-Fit 3.0** (2×6) до разводки.
4. **TPS61088 ×2** — проверить реальную доступность/цену; альтернатива +5 В: TPS61090 (2 А).
5. **CORE-2 rev.2** — сначала согласовать DNP-список (MT3608 #1/#2, MC34063, BMS) и
   точку подключения +12 В/5 В/−12 В (`interfaces.md` §5), иначе два источника на шине.
6. **Аккумуляторы** — не закупать партию до решения 1S2P vs 2S (при 2S все токи вдвое
   ниже и КПД ±12 В выше; см. `power-tree-pwr2.md` §2.2, §7).
7. **BQ24074 thermal** — до разводки CORE-2-REV2 замерить нагрев при 1.5 А заряда
   (линейный, до ~2 Вт) и при необходимости снизить ILIM/ISET.

## 7. Открытые вопросы

1. Бюджет +5 В: 1.0 А (CORE-2 power-tree) против 1.6 А (с учётом входа MP1584 → +3V3_MCU).
   Рекомендация — перевести MP1584 на +12 В (снимает 0.5 А с +5 В).
2. Одновременный максимум VSYS 2.74…4.9 А против 3 А power-path BQ24074 — прошивочный
   профиль/cap LED; при 2S — снимается.
3. Правки CORE-2 rev.2 (DNP + 4 EN + подтяжки) — `interfaces.md` §5.
4. Разъём J3 (IDC-20 vs Micro-Fit 3.0) при 3 А.
5. Точка подключения +12 В (12V_EXT с D2, падение 0.45 В) и −12 В (без диод-ИЛИ на CORE-2).
6. Уточнить семантику MAX17048 `QSTRT`/`CTG` по datasheet (сейчас QSTRT=GND, CTG=NC).

## DFM/testability

До разводки: [`dfm.md`](dfm.md) — TP рельсов/EN, self-test БП/гейджа, DFM 3 А/J3, чек-лист 15.
