martiyanov/bukifon/hardware/panel2/adapter-lcd/README.md

# LCD FFC-40 адаптер (HotLCD ST7262) — PRE-FREEZE bench adapter

**Не заказывать плату без ревью.** Назначение — проверить 5.0″ 800×480 RGB565 FFC-40 панель (MPN **TFT-H050A1SVIST4R40**, ST7262) на P1-стенде до PCB: повторяет pinout PANEL-2 **J12** (FFC-40, 23 сигнала) и даёт тестпоинты на все линии панели. Полная документация — [`docs/49-lcd-adapter.md`](../../../docs/49-lcd-adapter.md).

## 1. Файлы

| Файл | Что |
|---|---|
| `LCD-ADAPTER.kicad_sch` | схема (KiCad 10, A1, штамп PRE-FREEZE) |
| `LCD-ADAPTER.pdf`, `svg/` | экспорт схемы |
| `LCD-ADAPTER.net` | netlist |
| `erc/LCD-ADAPTER-erc.rpt` | ERC-отчёт (0 errors) |
| `BOM-lcd-adapter.csv` | BOM (черновой) |
| `pinout-adapter.csv` | таблица J12 pin ↔ J1 ↔ 0R ↔ J2 pin ↔ панель |
| `tools/gen_lcd_adapter.py` | генератор схемы/BOM/доков |

## 2. Схема в двух словах

* **J1** — вход FFC-40 (ZIF 0.5 мм), pinout = PANEL-2 J12 (rev.2, 23 сигнала: 16 RGB, PCLK/DE/HSYNC/VSYNC, BL_PWM, BL_ANODE/BL_CATHODE, LCD_3V3, GND).
* **J2** — выход FFC-40 на хвост панели (пин-аут — предположение, 0R-перемычки позволяют переназначить любую линию).
* **0R-перемычки (R1…R31)** — «pinout jumper»: P_<сигнал> ↔ J12-линия / GND / DISP_CTRL. Позволяют собрать правильный пин-аут после промера образца.
* **Тестпоинты** — 31 сигнал панели (R0-R7, G0-G7, B0-B7, PCLK, DE, HS, VS, DISP, LED_A, LED_K) + BL_PWM, +3V3, GND.
* **J3** (JST PH 2-pin) — вход внешнего boost подсветки 18…22 В / 40 мА (R34/R35); штатно подсветка идёт с CORE-2 через J12 (R30/R31).
* Габарит 120 × 76 мм, 2 слоя, крепление панели 4 × M3 (outline панели 120.7 × 75.8).

## 3. Pinout (генерируется из той же таблицы, что схема)

| J2 pin | панель (предложение) | через 0R к | J12 pin |
|---:|---|---|---:|
| 1 | LED_K | P_LED_K ↔ J12.32 / J3 | 32 |
| 2 | LED_A | P_LED_A ↔ J12.31 / J3 | 31 |
| 4 | 3V3 | +3V3 | 27, 27 |
| 6 | R0 | GND (0R) | — |
| 7 | R1 | GND (0R) | — |
| 8 | R2 | GND (0R) | — |
| 9 | R3 | P_R3 ↔ J12.3 | 3 |
| 10 | R4 | P_R4 ↔ J12.4 | 4 |
| 11 | R5 | P_R5 ↔ J12.5 | 5 |
| 12 | R6 | P_R6 ↔ J12.6 | 6 |
| 13 | R7 | P_R7 ↔ J12.7 | 7 |
| 14 | G0 | GND (0R) | — |
| 15 | G1 | GND (0R) | — |
| 16 | G2 | P_G2 ↔ J12.8 | 8 |
| 17 | G3 | P_G3 ↔ J12.9 | 9 |
| 18 | G4 | P_G4 ↔ J12.10 | 10 |
| 19 | G5 | P_G5 ↔ J12.11 | 11 |
| 20 | G6 | P_G6 ↔ J12.12 | 12 |
| 21 | G7 | P_G7 ↔ J12.13 | 13 |
| 22 | B0 | GND (0R) | — |
| 23 | B1 | GND (0R) | — |
| 24 | B2 | GND (0R) | — |
| 25 | B3 | P_B3 ↔ J12.14 | 14 |
| 26 | B4 | P_B4 ↔ J12.15 | 15 |
| 27 | B5 | P_B5 ↔ J12.16 | 16 |
| 28 | B6 | P_B6 ↔ J12.17 | 17 |
| 29 | B7 | P_B7 ↔ J12.18 | 18 |
| 31 | PCLK | P_PCLK ↔ J12.21 | 21 |
| 32 | DE | P_DE ↔ J12.22 | 22 |
| 33 | HS | P_HS ↔ J12.23 | 23 |
| 34 | VS | P_VS ↔ J12.24 | 24 |
| 35 | DISP | DISP_CTRL (10k→3V3, TP) | — |
| 37 | 3V3 | +3V3 | 27, 27 |
| 38 | 3V3 | +3V3 | 27, 27 |

## 4. Что проверить до питания

1. Прозвонить GND (J2 3/5/30/36/39/40) и 3V3 (4/37/38) — КЗ нет.
2. Сверить пин-аут панели с даташитом (O-15): при расхождении перепаять 0R.
3. Проверить контактную сторону FFC (same/opposite) и pin 1.
4. Подсветка: не подавать 18…22 В на J12 — только J3 (R34/R35).

## 5. Открытые вопросы

* **O-15** — LCD_DISP: на PANEL-2 J12 DISP нет; на адаптере DISP подтянут к 3V3 (можно подать внешний на TP). Решение о пине J12 — после проверки образца.
* Пин-аут HotLCD — предположение, подтверждается мультиметром/даташитом образца.
* PCB (2 слоя, 120×76) не разводился: сначала заказ/проверка образцов (docs/42 §144).
