martiyanov/bukifon/spec/90-requirements-registry.md

# Реестр требований Букифона (единственный источник истины)

Причина появления: в репозитории одновременно жили три разных описания железа
(315×145/8 ручек/2.8″ против 380×210/16 ручек/5″, плюс старые цифры в README и
firmware/README). Этот файл фиксирует актуальные требования; всё, что противоречит
ему — устарело и должно быть исправлено или удалено.

Статус: **черновик на подпись** (см. раздел «Подпись»).
Дата: 05.11.2025.

## 1. Зафиксировано (закрыто)

| ID | Требование | Значение | Статус |
|---|---|---|---|
| R-01 | Форм-фактор | настольный, 380 × 210 × 63 мм | ✅ закрыто |
| R-02 | Панель | 380 × 210 × 3 мм, PETG, без динамиков, без джеков под экраном | ✅ закрыто |
| R-03 | Клавиатура | 2 × 21 = 42 клавиши Lapka-42, Choc 18×17, половины ±18° | ✅ закрыто |
| R-04 | Энкодеры | 16 шт., Ø14, сетка 27 мм, 2 блока A–D / E–H | ✅ закрыто |
| R-05 | Экран | 5.0″ 800×480, вырез 108 × 64.8, без рамки | ⚠️ под вопросом (P1: SPI vs DSI) |
| R-06 | Джек-поле | 10 × mini-jack 3.5 мм сверху (шаг 13.1) | ✅ закрыто |
| R-07 | Фейдеры | 2 шт., 60 мм, между клавиатурами | ✅ закрыто |
| R-08 | Питание | Li-ion 1S2P 18650 / LiPo 5000 мА·ч, USB-C заряд | ✅ закрыто |
| R-09 | Аудио | PCM5102A DAC + PCM1808 ADC (вход для сэмплирования) | ✅ закрыто |
| R-10 | CV | 2 × MCP4728 (6 CV out), MCP3208 (CV in) | ✅ закрыто |
| R-11 | Шина модулей | 26-pin (питание ±12 В, CV, gate, аудио) | ✅ закрыто |

## 2. Открыто (нужно решение в P1–P2)

| ID | Требование | Варианты | Когда решаем |
|---|---|---|---|
| R-12 | MCU | ESP32-P4 (рекоменд.) / ESP32-S3 «лайт» / STM32H743 | P1 (бенчмарк) |
| R-13 | Число дорожек сэмплера | 8 стерео / **8 моно** / 6 моно | P2 (cut-list) |
| R-14 | Число голосов синтеза | 8 / 6 | P2 |
| R-15 | Insert-FX на дорожку | 2 / **1 insert + 2 send** | P2 |
| R-16 | Time-stretch | phase vocoder / **только гранулярный** | P2 |
| R-17 | USB audio | стерео FS / **UAC2 multichannel HS** | P1 (замер) |
| R-18 | Экран: интерфейс | SPI 13 fps / DSI 60 fps / LTDC | P1 |
| R-19 | Модули | **статические C++ (аудио) + Lua (control)** / WASM / отдельный MCU | P2 |
| R-20 | Критерий реального времени | **max block time ≤ 0.65 мс** при дедлайне 1.333 мс + 24 ч soak без xruns | P1–P2 |
| R-21 | Память под сэмплер | 8 mono × 30 с = 23 МБ + 1.54 МБ фреймбуферы → **32 МБ PSRAM обязательны**, длинные сэмплы стримятся с SD | P1 |
| R-22 | Цифровой expansion | TDM/I²S + SPI mailbox (26-pin только аналоговая) | P2 |
| R-23 | Quality tiers | каталог FX, admission control stretch, фикс. итерации ZDF | P2 |
| R-24 | Альтернатива MCU | STM32H743 + SDRAM (LTDC/DMA2D, HS USB через ULPI) | P1 |
| R-25 | USB-композит | один USB-C: **HID-клавиатура + MIDI + UAC2** (+CDC для отладки), TinyUSB composite | P4 |
| R-26 | Радио | **Wi-Fi + Bluetooth** обязательно: S3 — нативно; P4 — сопроцессор ESP32-C6 (Wi-Fi 6/BLE 5.3, SDIO/UART) | P1–P2 |
| R-27 | Режим DAW-клавиатуры | HID-клавиатура с раскладками (Lapka-42 как печатная клавиатура), transport/consumer control, MIDI-контроллер (CC + Mackie/HUI по запросу) | P4 |
| R-28 | BLE MIDI + BLE HID | BLE-MIDI (NimBLE) и BLE HID клавиатура, переключение режимов без перезагрузки | P4 |
| R-29 | **Мгновенная запись/ресемплинг**: в любой момент игры записать звук синтезатора (с эффектами/секвенсором) и сразу использовать как сэмпл — назначить на дорожку/пэд, зациклить, сохранить на SD. Запись не должна прерывать звук и не аллоцировать в audio-пути. | 06.11 | ответ заказчика |
| R-30 | **Многодорожечный лупер** (backlog, после v1.0-rc): N дорожек, overdub, undo, reverse/half-speed, синхронизация с транспортом, квантизация длины по тактам. | 06.11 | ответ заказчика (бэклог) |
| R-31 | **Фейдеры-мультирежим**: Octatrack-сцены (кроссфейдер A↔B), DJ-кроссфейд, модификатор Fn = громкость, MACRO, pickup без скачков. | 06.11 | ответ заказчика |
| R-32 | **UX-паттерны**: L1 без меню, L2 ≤1 жест, L3 ≤2, модуляция видна, мультивыбор, сцены, undo/pickup, пресеты, генеративные функции (PROB/EUCLID/MUTATE/SCALE/ARP/EVOLVE/SEED). | 06.11 | docs/65 |
| R-33 | **Внешний MIDI-секвенсор**: 8 треков (channel/PC/note/vel/length), clock out/in, transport, p-lock CC, GEN на внешних, live record, save/load — паритет с Octatrack по MIDI-части. | 06.11 | ответ заказчика |
| R-34 | **MIDI-роутинг**: DIN out + USB MIDI out одновременно, без дублей; CV/GATE как отдельные голоса. | 06.11 | docs/70 |
| R-35 | **USB-MIDI host** (P4) — опция rev.3, не блокер v1.0-rc. | 06.11 | docs/70 |
| R-36 | **Clock/транспорт**: master 24 ppqn, slave, jitter ≤1 мс, start/stop/continue. | 06.11 | docs/70 |
| R-37 | **Микрофон/голос**: запись голоса в любой момент → сэмпл/пэд; всегда доступный вход (MEMS I2S + 3.5 мм), аппаратный mute + LED. | 06.11 | ответ заказчика |
| R-38 | **Битбокс → паттерн**: onset/velocity → шаги, классы kick/snare/hat (v1.0 простые, v1.1 классы). | 06.11 | docs/71 |
| R-39 | **Вокодер** (backlog v1.1): 8–16 полос, голос = модулятор, внутренний синтез = несущая. | 06.11 | docs/71 |
| R-40 | **Сборка и производство**: контрактные мастерские РФ (Москва/СПб/НН) — платы, корпуса, пилот; RFQ-шаблон и чек-лист передачи. | 06.11 | docs/72 |
| R-41 | **Сайт на VDS** (bukifon.ru/.com, как agonarena.ru): nginx/TLS/DNS, витрина + `app.` — бэклог после v1.0-rc. | 06.11 | ответ заказчика |
| R-42 | **Веб-приложение** (не демо): PWA, Web MIDI in/out, микрофон (запись/битбокс), 4+8 треков, project v2, WAV/stems export, share, RU/EN. | 06.11 | docs/86 |
| R-43 | **DAW-плагин**: VST3/AU (JUCE 8) + CLAP, общий C++ движок, пресеты project v2; после RC/пилота. | 06.11 | docs/86 |
| R-44 | **Домены/инфраструктура**: bukifon.ru/.com, DNS, TLS (Let's Encrypt), деплой/бэкапы; без секретов в репо. | 06.11 | docs/86 |
| R-45 | **Софтовые модули/машины**: `.bkm` (manifest, подпись, ABI), установка USB/SD/Wi-Fi, менеджер модулей, sandbox/лимиты; machine/effect/generator/utility. | 06.11 | docs/91 |
| R-46 | **Загрузка по Wi-Fi/USB**: локальный web-UI на C6 (`/modules`), upload/install/manage, без аудио-стриминга. | 06.11 | docs/91 |

## 3. Устаревшие документы (требуют правки в P2)

| Документ | Что неверно | Действие |
|---|---|---|
| `README.md` | 315 × 145 × 48, 8 ручек, 2.8″ | переписать под v0.4 |
| `firmware/README.md` | Flash 36.1 %, RAM 80.1 % — для старой панели | пометить как прототип RP2040 |
| `spec/20-electronics.md` §2 | 8 энкодеров, 2.8″, Pico, все GPIO заняты | обновить под 16 энкодеров / 5″ |
| `spec/40-firmware.md` §4 | 8 энкодеров, 320×240 | обновить |
| `spec/10-panel-ui.md` | раскладка 315×145 | заменить ссылкой на `spec/panel-spec-v0.4.json` |

## 4. Журнал решений

| # | Дата | Решение | Основание |
|---|---|---|---|
| D-01 | 05.11 | панель 380×210 (а не 340×185) | при ±18–22° две Lapka + фейдеры не влезают в 185 |
| D-02 | 05.11 | клавиши — точная Lapka-42, половины ±18° | концепт нарисован «на глаз» (RMS 7.5 мм) |
| D-03 | 05.11 | 10 джеков сверху, без джеков под экраном | ТЗ заказчика |
| D-04 | 05.11 | нет динамиков | ТЗ заказчика |
| D-05 | 05.11 | платформа = сэмплер + синтез + модули сообщества | требование заказчика |
| D-06 | 05.11 | первый этап — бенчмарк, не rev.3 | ревью `docs/03-second-opinion-mcu.md` |
| D-07 | 05.11 | ESP32-P4 — основной кандидат (после бенчмарка) | USB HS + DSI + 32 МБ PSRAM |
| D-08 | 05.11 | критерий бенчмарка — max block time ≤ 0.65 мс (дедлайн 1.333 мс), а не средний CPU | консультация GPT/Codex (`docs/04`) |
| D-09 | 05.11 | S3 исключён для 8×8 UAC2 (9.2 Мбит/с > FS); сравнение P4 vs STM32H743 | консультация GPT/Codex |
| D-10 | 05.11 | cut-list: сначала сложность FX → admission control stretch → ZDF-итерации → голоса → дорожки | консультация GPT/Codex |
| D-11 | 05.11 | цифровой expansion-интерфейс TDM/I²S + SPI mailbox; недоверенный audio-rate — RP2350-картридж | консультация GPT/Codex |
| D-12 | 05.11 | SemVer + тег на каждый релиз, README обновляется в том же коммите | требование заказчика (AGENTS.md) |
| D-13 | 06.11 | «Народный синтезатор»: S3-версия ≤ $200 — основная, P4 + C6 — «стандарт/pro»; цена — критерий P6 | требование заказчика + BOM draft |
| D-14 | 06.11 | USB-композит (HID клавиатура + MIDI + UAC2) и Wi-Fi/BT — обязательные функции, не опции | требование заказчика |
| D-15 | 06.11 | Аудио-джеки (LINE OUT L/R, PHONES, AUDIO IN L/R) — на задней панели CORE-2; 10 верхних джеков = CV/GATE | hw-panel/PANEL-2, вопрос закрыт |
| D-16 | 06.11 | Подсветка экрана: boost MT3608 на CORE-2 (высокое напряжение не идёт через шлейф панели) | hw-panel, hw-core |
| D-17 | 06.11 | Крепёж панели: 6 × M3 (по стойкам механики), не 4 | PANEL-2 / mechanical |
| D-18 | 06.11 | PANEL-2 ↔ CORE-2: 3 шлейфа (FFC-40 LCD, IDC-16 цифра/питание, IDC-26 аналог); 16 энкодеров и матрица 42 клавиш через 4× MCP23017 (61 линия → 3) | PANEL-2 verify: 1314 проверок, 0 провалов |
| D-19 | 06.11 | FPC-40 пин-аут дисплея — TBD по datasheet выбранного модуля 5.0″ (до PCB-этапа) | PANEL-2 |
| D-20 | 06.11 | Корпус v1.0-rc: **клин 8°**, перед 32 / зад 61.5 мм, экран 35° к панели, R4 | docs/21 + mechanical v0.5-B |
| D-21 | 06.11 | CORE-2: ESP32-C6 по **SPI** (esp-hosted), SDIO не выбран из-за бюджета GPIO (54/55 занято) | CORE-2 |
| D-22 | 06.11 | PANEL-2: **4× MCP23017** (0x20–0x23), 3 шлейфа FFC-40 + IDC-16 + IDC-26; открытый пункт: CORE-2 README должен быть синхронизирован (было 3×) | PANEL-2 / CORE-2 |
| D-23 | 06.11 | USB-композит на выделенных HS-пинах P4, ESD USBLC6, BQ24074 power-path; TinyUSB в прошивке | CORE-2 / firmware |
| D-24 | 06.11 | Module API — **v0 experimental**, стабильный ABI только после бенчмарка P1 | firmware |
| D-25 | 06.11 | «Народная» версия — ESP32-S3 (Wi-Fi/BT нативно), P4+C6 — «стандарт/pro» | spec/00 §13, BOM |
| D-26 | 06.11 | Публичный репозиторий: PII/секреты запрещены, обязательные проверки `tools/security_scan.sh` + `tools/sanitize_paths.sh` | SECURITY.md / AGENTS.md |
| D-27 | 06.11 | Бюджет шины: +12 В ≈ 330 мА, −12 В ≈ 95 мА (не 300 мА на каждый) | консультация GPT, docs/25 |
| D-28 | 06.11 | PWR-2: без MC34063/charge-pump; sync boost + inverting buck-boost или push-pull ±14 В + LDO, π-фильтры | docs/25 |
| D-29 | 06.11 | Питание PWR-2 только от BQ24074 OUT/VSYS; батарея через fuse+BMS; NTC→TS; ideal-diode не нужен; master load-switch + EN рельсов | docs/25 |
| D-30 | 06.11 | MAX17048 остаётся, ADC-делитель — только резервный контроль | docs/25 |
| D-31 | 06.11 | После P1 — сначала PCB rev.1, затем SDK v0.1, cost-down последним | консультация GPT |
| D-32 | 06.11 | PWR-2: +12 В TPS61088 boost, −12 В LMR33630 IBB, +5 В TPS61088; push-pull оставлен резервом rev.2 | PWR-2, docs/25 |
| D-33 | 06.11 | EN рельсов — с MCP23017 PANEL-2 (у P4 0 свободных GPIO), дефолт: рельсы ON, LED OFF | PWR-2 |
| D-34 | 06.11 | CORE-2 rev.2 DNP: MT3608 #2 (+5 В), MC34063 (−12 В), BMS (модуль питания PWR-2); +12 В от PWR-2 → 12V_EXT (D2) | PWR-2 |
| D-35 | 06.11 | Прошивочный cap WS2812 (0.55 А) и профиль яркости; полная мощность — от внешнего 12 В | PWR-2 |
| D-36 | 06.11 | J3 (PWR-2↔CORE-2) — IDC-20/CORE-2 IDC-12; при >100 мВ падения на 3 А → Micro-Fit 3.0 | PWR-2 |
| D-37 | 06.11 | Разделить **product BOM** и workshop/tooling; считать фактический пластик (279 г), партии 5–25 | docs/27 |
| D-38 | 06.11 | Первый SKU: **S3-base kit $199**, партия 10–25, direct-sale, статус limited DIY/beta; P4-стандарт $299 — после P1; full $399 — опционный bundle | docs/27 |
| D-39 | 06.11 | Не продавать kit с россыпью 18650: assembled — 1S LiPo или сваренный 1S2P+NTC; DIY-kit — батарея опция, старт от внешнего БП | docs/27 |
| D-40 | 06.11 | J3 — **Micro-Fit 3.0** для силовых (≥2 VSYS, 3–4 GND); IDC — только сигнальные линии | docs/27, PWR-2 |
| D-41 | 06.11 | 3.3 В MCU — отдельный buck-boost от VSYS; не питать через 1S→+12→MP1584 (двойное преобразование/шум) | docs/27 |
| D-42 | 06.11 | VSYS: прошивочный cap LED, последовательный запуск рельсов, профиль «battery»; полная яркость + картриджи — только внешний БП | docs/27 |
| D-43 | 06.11 | Дисплей: зафиксировать MPN, закупка batch 20–50 + FPC-адаптер; MCP4728 — один адрес + программирование на стенде | docs/27 |
| D-44 | 06.11 | EXPRESSION убран; CV OUT 5/6 — резерв/тест-пэды в прототипе, 2 задних джека в rev.3 | CORE-2 rev.2 |
| D-45 | 06.11 | J3: прототип IDC-20 (тест), rev.2 — Micro-Fit 3.0; O-11 закрыт | docs/27, CORE-2 |
| D-46 | 06.11 | Два профиля выхода: **S3-base** (первый SKU $199) и **full/P4**; S3 — полноценный профиль P1, не reference | docs/31 |
| D-47 | 06.11 | CORE-S3: SD **1-bit SDMMC**, RGB565 один framebuffer + dirty rects + bounce, без UART, медленные сигналы на MCP23017 | docs/31 |
| D-48 | 06.11 | CORE-S3 USB: **stereo UAC2 24/48** + HID+MIDI+CDC на FS; 8×8 UAC2 только P4/H743 (HS) | docs/31 |
| D-49 | 06.11 | 3.3 В CORE-S3: **TPS63802** (fallback TPS63020), 1 А cont / ≥1.5 А transient | docs/31 |
| D-50 | 06.11 | Корпус B-light: цель 225–245 г / 11–14 ч; масса снимается с оболочек, возвращается в стойки/шов/рёбра | docs/27, docs/31 |
| D-51 | 06.11 | **S3-base: SPI-дисплей 800×480** (6 линий, partial redraw 10–20 fps; full ~13 fps) — на N16R8 RGB565 не помещается (31 доступная линия, нужно 38–40); RGB565/DSI — только P4 full. Пересмотреть после devkit-спайка | CORE-S3 rev.0 |
| D-52 | 06.11 | CORE-S3: GATE2 и CV OUT5/6 не разводятся (нет линий/0x23 занят), DISP к +3V3; TPS63000 placeholder → TPS63802/TPS63020 до PCB | CORE-S3 rev.0 |
| D-53 | 06.11 | v1.0-rc = **собранный S3-base**; критический путь разделён: S3-ветка (10–14 нед) и P4-ветка ($299, после P1) | docs/36 |
| D-54 | 06.11 | **RC Definition of Done** + критерии приёмки (8 тестов) — docs/36; без них не начинать PCB | docs/36 |
| D-55 | 06.11 | $199 = **founders beta 10–25 шт, at-cost**, не розничная цена; честный S3 Complete $249–269; landed COGS для $199 ≤$125–135 | docs/37 |
| D-56 | 06.11 | Первая партия **без батареи** (внешний БП); позже — только traceable pack с PCM/NTC | docs/37, D-39 |
| D-57 | 06.11 | Compliance до продаж: RED/GPSR (ЕС), pre-compliance EMC/ESD, SBOM/лицензии модулей, support/RMA | docs/37 |
| D-58 | 06.11 | **Первый SKU — P4-версия с RGB565/DSI** (Complete); S3-base $199 отменён, S3 уходит в «lite later» | ответ заказчика |
| D-59 | 06.11 | Стартовый комплект — **Complete ($299)**, не founders beta; Full Bundle $399 позже | ответ заказчика |
| D-60 | 06.11 | **P1-стенд заказан** (P4 EV + H743 + кодеки, ~$110–130) — решение принято | ответ заказчика |
| D-61 | 06.11 | **Репозиторий пересоздать** (удалить и создать заново с чистой историей) для purge PII | ответ заказчика |
| D-62 | 06.11 | Тестовая половинка B-light (70 г / 3.4 ч) — **печатать**; батарея в первой партии **не продаётся** | ответ заказчика |
| D-63 | 06.11 | Базовый DFT: **единое 30-точечное pogo-поле** (CORE 14 / PANEL-2 7 / PWR-2 9), шаг 2.54, одна сторона | docs/42 |
| D-64 | 06.11 | Серийники/калибровки: identity во **flash factory_data** (2 копии + CRC) + eFuse MAC; калибровки — 24C32; SN/QR на корпусе | docs/42 |
| D-65 | 06.11 | Recovery: ROM USB download (BOOT+RESET), UART-пады, dual OTA + factory image, safe mode, rollback после 3 неудач | docs/42 |
| D-66 | 06.11 | Stackup: CORE/PWR — 4 слоя, PANEL-2 — 4 слоя (2 только после route-review); bow/twist ≤0.75 % | docs/42 |
| D-67 | 06.11 | EOL: **2–2.5 мин** авто+оператор, полный цикл 6–8 мин/устройство; first-pass yield ≥80 % на 5 прототипах; founders beta = 3 инженерных + 2 валидационных | docs/42 |
| D-68 | 06.11 | P4 recovery: **UART0 + BOOT обязательны**, JTAG 10-pin — DNP-пады для bring-up; ROM UART download как аварийный путь | CORE-2 DFM |
| D-69 | 06.11 | 24C32 карта: SN/ревизии/калибровки по offset-карте DFM + дубль во flash factory_data; QR/SN на корпусе | CORE-2 DFM |
| D-70 | 06.11 | TP28–TP30 (LED_RET, I2S_BCK, I2S_LRCK) добавить пады в следующей правке схемы CORE-2 | CORE-2 DFM |
| D-71 | 06.11 | MAX17048 0x36, EN-полярность по PWR-2 interfaces — утверждено; FPC-40 RGB pinout фиксируется вместе с MPN дисплея до PCB | CORE-2/PANEL-2 DFM |
| D-72 | 06.11 | DSI — опция rev.3; первый SKU — **RGB565 FPC-40** дисплей | docs/36, D-58 |
| D-73 | 06.11 | Дисплей первого SKU: **RGB565 поверх RGB888 FPC-40** (20 линий: 16 data + PCLK + DE + HS/VS); DE-only (18) — только после подтверждения datasheet и стенда | docs/47 |
| D-74 | 06.11 | Основной кандидат панели — **MIDAS MDT0500D5ISC-RGB** (2 образца до freeze), резерв Topway/BuyDisplay; RGB565 подключать на старшие биты RGB888, младшие — GND | docs/47 |
| D-75 | 06.11 | DSI — только rev.3.1 (Topway LMT050FNCFWA после получения controller/lane/init), не в первой PCB | docs/47 |
| D-76 | 06.11 | PWR-стенд: **EVM-платы** (TPS61088EVM-677, LMR33630ADDAEVM в IBB, TPS63802EVM, BQ24074EVM, BQ29700EVM, MAX17048 EVKIT/breakout), сверлёные платы, **breadboard запрещён** | docs/44 |
| D-77 | 06.11 | Fallback H743 — **отдельная плата CORE-2-H743** с общим outline/разъёмами/FFC, не dual-MCU плата; мезонин-подход как запас | rev3-plan |
| D-78 | 06.11 | Вычисления — на домашний ПК через Tailscale (рендеры Blender/сборки); SSH пока не настроен | docs/48 |
| D-79 | 06.11 | PWR-стенд: **вариант A** — 3 критичных EVM (LMR33630ADDAEVM-IBB, TPS61088EVM-677, BQ24074EVM ≈$150) + bare-IC на сверлёных платах + MAX17048 breakout; стенд ≈$250–280; samples параллельно | docs/44 §24 |
| D-80 | 06.11 | Критерии PWR-стенда (docs/44 §7): DC ±2 %, ripple ≤30 мВpp (target 20), audio ≤1 мВrms, load-step 33↔330/10↔95 мА, recovery ≤250–300 мкс, η ≥85/75 %, тепло ≤85 °C@25 °C, ток OFF ≤100 мкА, BMS OVP 4.25–4.30/0.35–2.50, J3 ≤100 мВ@3 А | docs/44 |
| D-81 | 06.11 | `bench-bom.csv` дополнить мелочёвкой под 13 тестов (+~$15–20: IDC-20+шлейф, PC817/2N7002, AO3401A, SS34/полифьюз/TVS, π-фильтры) | docs/44 |
| D-82 | 06.11 | UX-итерации UI: MAIN/FM/ENV/FX страницы, mute/solo, undo, copy/paste паттерна, 4 темы экрана; палитра — docs/62 | docs/61–62 |
| D-83 | 06.11 | **Мгновенный ресемплинг** — обязательная функция v1.0-rc (R-29): запись с любого момента без остановки звука, назначение на пэд/дорожку, SD | docs/63 |
| D-84 | 06.11 | **Многодорожечный луппер** — бэклог после v1.0-rc (R-30), не входит в первый релиз | docs/63 |
| D-87 | 06.11 | Внешний секвенсор: **8 MIDI-треков + 4 внутренние партии** одновременно, единый seq engine, общий GEN/транспорт | docs/70 |
| D-88 | 06.11 | MIDI out: **DIN + USB** одновременно; USB-MIDI host — опция rev.3 (P4 host mode) | docs/70 |
| D-89 | 06.11 | UX внешнего секвенсора: страница **EXT**, p-lock CC (удержать шаг + энкодер), CC learn, live record; без новых кнопок | docs/70 |
| D-91 | 06.11 | Микрофон: **I2S MEMS (ICS-43434/SPH0645) на PANEL-2** + **3.5 мм mic jack с MAX9814 AGC** на CORE-2; до PCB — rev.3 обеих плат | docs/71 |
| D-92 | 06.11 | Приватность: **аппаратный mic mute switch + LED**, запрет записи при mute, никакой передачи звука без явного действия | docs/71 |
| D-93 | 06.11 | Голос как вход: в v1.0-rc — запись голоса → сэмпл и битбокс→шаги (onset/velocity); классы и вокодер — v1.1 | docs/71 |
| D-94 | 06.11 | «Торчащий» микрофон: 3.5 мм гусиная шея + печатная клипса/держатель; порт/сетка на верхней кромке PANEL-2 | docs/71 |
| D-97 | 06.11 | Сайт/VDS/веб-приложение — **бэклог после v1.0-rc**; сначала железо/релиз, не распылять силы | docs/86 |
| D-98 | 06.11 | Веб-приложение — PWA на базе демо (Web MIDI, микрофон, треки, export), без аккаунтов в MVP | docs/86 |
| D-99 | 06.11 | Плагин: JUCE 8 → VST3+AU+Standalone, затем CLAP; движок общий с прошивкой | docs/86 |
| D-100 | 06.11 | bukifon.ru/.com — DNS на VDS, TLS Let's Encrypt, деплой rsync/git; секреты вне репо | docs/86 |
| D-101 | 06.11 | PCB rev.1 layout scaffolds из `mechanical/board-fit/`: CORE-2 200×108/6 слоёв, PANEL-2 L/R 180×190/4, PWR-2 90×70/4 (2 oz); DRC 0, verify ±0.05 мм | docs/82 §9 + hardware/*/rev1 |
| D-102 | 06.11 | Первый импорт нетлиста в каркасы: CORE-2 373 refs/16 placeholder, PANEL-2 L181+R174/21+21, PWR-2 128/0; DRC 0 errors, unconnected зафиксированы; трассировка — после MCU freeze | docs/82 §10 + hardware/*/rev1 |
| D-103 | 06.11 | Реальные футпринты (0 placeholder): custom A1/C6/MP1584/CHOC + KiCad стандартные; DRC-классы/impedance (USB_HS 90 Ω, Power/Audio/RF), правила; DRC 0/0; GND-полигоны — план до трассировки | docs/82 §11 + hardware/*/rev1 |
| D-104 | 06.11 | Fab dry-run из каркасов rev.1: gerbers/drill/CPL/BOM/PDF в `fab/<board>/rev1-scaffold`, `tools/export_fab_dryrun.sh`, checker PASS (4 пакета); не для заказа PCB | docs/83 §8 + fab/ |
| D-105 | 06.11 | Реальные пассивы и GND-полигоны rev.1 — **частично**: 0 placeholder, стандартные пады упрощённые (328), GND/AGND/PGND не залиты (DRC не проходит из-за плотности); скрипты `build_full_pcb.py`/`add_gnd_zones.py` сохранены; нужен MCU freeze + трассировка | docs/82 §12 + hardware/*/rev1 |
| D-107 | 06.11 | Софтовые модули — **бэклог после v1.0-rc**; единый движок/пресеты с DAW-плагином | docs/91 |
| D-108 | 06.11 | `.bkm` = zip+manifest+подпись Ed25519+sha256; установка SD→USB→Wi-Fi; sandbox MPU/watchdog | docs/91 |
| D-106 | 06.11 | Двусторонняя расстановка реальных футпринтов + GND-зоны — **попытка FAIL**: DRC 1810/1160/1152/896 (clearance/shorting/courtyard/zones_intersect), area хватает; main DRC 0/0 оставлен, two-sided в `rev1/two-sided/`; нужен floorplanner после MCU freeze | docs/82 §13 |
| D-96 | 06.11 | Сборка: прототипы — Резонит/Интер-Плата, пилот — А-Контракт/НПП Асти/Телерем, корпуса — Modelica3D/ПИМТЕХ/фаблаб, профильная сборка — VG-Line (Москва) | docs/72 |
| D-95 | 06.11 | Принцип «идея → звук»: метрики time-to-sound ≤10 с, time-to-idea ≤30 с, blind-тест 5 людей — в docs/68 | docs/68 |
| D-90 | 06.11 | Паритет-цель v1.0-rc: 8 треков/канал/PC/vel/length, clock, transport, 1 CC p-lock, GEN, save/load | docs/70 |
| D-86 | 06.11 | UX-рубрика 9/10 (docs/65 §5) принята как критерий готовности интерфейса; GEN-страница и мультивыбор — в v1.0-rc | docs/65 |
| D-85 | 06.11 | **Фейдеры с режимами**: TRACK / SCENE (Octatrack A↔B морфинг) / DJ (equal-power) / MACRO / Fn-модификатор (мастер-громкость); pickup без скачков | docs/64 |

## 6a. Открытые вопросы (не закрывать без измерений)

| ID | Вопрос | Что нужно |
|---|---|---|
| O-1 | +5 В CORE-2 занижен (1.0 → 1.6 А) | **решено**: отдельный 3.3 В buck-boost от VSYS (D-41), +5 В бюджет 1.6 А |
| O-2 | VSYS 3 А vs пик 2.74–3.38 А | **решено**: cap LED + последовательный запуск + профиль (D-42) |
| O-3 | CORE-2 rev.2 DNP-список | в работе (task-18), зафиксировать D-34 |
| O-4 | 4 EN-линии при 0 свободных GPIO P4 | **решено**: с MCP23017 PANEL-2 (D-33) |
| O-5 | J3 на 3 А | **решено**: Micro-Fit 3.0 (D-40) |
| O-6 | 1S2P vs 2S | первый kit/P4 — **1S**; 2S — отдельная PWR-3 для full (D-39) |
| O-7 | Символы TPS61088/MAX17048 | draft, сверить с datasheet до трассировки |
| O-8 | `PWR_GOOD`/`FUEL_ALRT` некуда читать на P4 | **решено**: свободные GPIO ESP32-C6 (P4); опрос MAX17048 по I2C (S3) |
| O-9 | PANEL-2 J14 CVIN3/4 и GATE_IN отсутствуют в CORE-2 | **решено**: CVIN3/4 → MCP3208 CH4/CH5; GATE_IN → MCP23017 0x23 GPB7 на PANEL-2; EXPRESSION убрать/на C6 |
| O-10 | Цифровое расширение TDM/I2S+SPI (R-22) не влезает в J16 | **отложено** до rev.3 (отметить в rev2-plan) |
| O-11 | J3 IDC-20 vs Micro-Fit 3.0 | **прототип — IDC-20** (тест ≤100 мВ/≤30 °C), **rev.2 — Micro-Fit 3.0** (D-40) |
| O-15 | LCD_DISP: CORE-2 ждёт GPIO50, в J12 PANEL-2 цепи DISP нет | решить при фиксации FPC-40 (вывести на свободный пин J12) |
| O-13 | `GATE_IN_CLEAN` в CORE-2 pinmap | **решено**: читается на PANEL-2 (0x23 GPB7), из CORE-2 убрано (rev.2) |
| O-14 | EXPRESSION после переноса CVIN3/4 | **решено**: убран в rev.2 (D-44) |
| O-16 | CV OUT 5/6 (MCP4728 #2 A/B) не выведены в J14 | **прототип**: тест-пэды/резерв; **rev.3**: 2 задних джека на CORE-2 (D-44) |
| O-17 | `TL074 qty=20` в BOM-cores3 (ожидается 4–6) | пересчитать по netlist CORE-S3 до PCB |
| O-18 | `TPS63000` placeholder в CORE-S3 | заменить на TPS63802/TPS63020 (D-49) до PCB |
| O-19 | Дисплей 5″ SPI не имеет отдельной product-строки в BOM-s3 | добавить MPN/40–50-pin до закупки |

## 5. Подпись

- [ ] Заказчик подтверждает R-01…R-11 и cut-list по R-13…R-16.
- [ ] После подписи документ считается «design freeze» для P3–P5.
