martiyanov/bukifon/docs/00-overview.md

# Букифон — обзор для пользователя

**Версия:** 1.0 · **Дата:** 2025-11-05
**Что это:** открытый настольный цифро-аналоговый синтезатор-геймпад, который собирается
из покупных модулей, печатается на 3D-принтере и расширяется картриджами.

---

## 1. Одним абзацем

Букифон — это инструмент размером с большую книгу (315 × 145 × 48 мм, ≤ 700 г), который
можно держать двумя руками как геймпад: ладони на рукоятках, большие пальцы — на сменной
деке ввода (пэды или клавиши), указательные — на верхнем ряду из восьми энкодеров, экран
по центру. Внутри — Raspberry Pi Pico с 8-голосым движком и двумя ядрами, честный I2S-ЦАП
PCM5102A, 4 CV-выхода и 4 CV-входа, MIDI USB и TRS. Снизу — «брюшной» отсек под аналоговые
картриджи, снаружи — верхний и нижний доки. Проект полностью открыт: схемы, прошивка,
механика и BOM с ценами.

Эталонное описание — [`spec/00-vision.md`](../spec/00-vision.md).

## 2. Как его держать и что где находится

| Зона | Что там | Для чего |
|---|---|---|
| Верхняя панель (Y 0…60) | экран 2.8″ по центру, 8 энкодеров EC11 с подсветкой, 4 плечевые кнопки | «крутилки» и навигация: CUTOFF/RESONANCE/ADSR/LEVEL/TEMPO |
| Сменная дека (Y 60…145) | DECK-PAD: 18 пэдов + 2 слайдера; DECK-KEYS: 42 клавиши Choc + 2 слайдера | ввод нот, шагов секвенсора, перформанс |
| Рукоятки | слева и справа, с канавками под пальцы | хват двумя руками, инструмент стоит на рукоятках |
| Задняя стенка | DC 12 В, тумблер, USB, RESET, LINE/PHONES, MIDI TRS, CV/GATE джеки, MASTER VOL | всё, что «втыкается» |
| Брюхо (снизу) | 2 слота шины Bukifon Bus | аналоговые картриджи |
| Верх/низ | доки на 26-pin шину | модули снаружи, как картриджи |

Эргономическое правило: **перехват не требуется ни для одной функции** — все органы
достижимы из основного хвата. Точные координаты — [`spec/10-panel-ui.md`](../spec/10-panel-ui.md) §1–§3.

## 3. Три уровня модульности

Букифон расширяется на трёх уровнях — это главная архитектурная идея.

### L1 — аппаратные модули (шина Bukifon Bus, 26 pin)

Один стандарт разъёма (2×13 IDC, 2.54 мм) на все порты: питание +12 В/−12 В/+5 В/+3.3 В,
4 CV (2 в модуль, 2 из модуля), 2 гейта, 2 аудиолинии, I2C, SPI. Модуль — плоский
картридж 110 × 70 мм: вставляется в брюшной слот или в док снаружи. Электрический
контракт — [`spec/20-electronics.md`](../spec/20-electronics.md) §7.

Базовые модули-примеры: **VCO-1** (AS3340), **FILTER-1** (LM13700 SVF), **PROTO-1**
(макетка). Опционально: **LADDER-1** (AS3320, лестница Муга) и **ENSEMBLE-1**
(BBD/PT2399-ансамбль в духе Поливокса) — [`spec/20-electronics.md`](../spec/20-electronics.md) §1.

### L2 — программные модули (открытый API)

Движки, фильтры, эффекты, модуляторы и секвенсоры — это C++-модули с интерфейсом
`IModule`/`IOscillator`/`IEffect`/…, которые регистрируются статически и появляются
в меню. Свой модуль можно написать, не трогая ядро: [`spec/40-firmware.md`](../spec/40-firmware.md) §9.

### L3 — «умные» модули (автоопределение)

У каждого аппаратного модуля — EEPROM 24C02/24C32 на I2C по адресу `0x50 + номер порта`.
Первые 32 байта — дескриптор: тип, число параметров, имя, CV-маршруты, потребление,
CRC. Прошивка сама находит модуль при старте и горячем подключении, показывает его
на странице MODULES и, для I2C-модулей, шлёт `SET_PARAM`. Нет EEPROM — порт просто
показывается как «пусто», аудио не блокируется. Формат — [`spec/40-firmware.md`](../spec/40-firmware.md) §8.

### Плюс сменные деки и доки

Дека — не «шина», а отдельный посадочный узел: 290 × 78 мм, свой шлейф 2×8 IDC,
автоопределение по аналоговому `DECK_ID`. Сейчас есть DECK-PAD (пэды) и DECK-KEYS
(42 клавиши); в тот же узел можно сделать свою деку. Доки сверху и снизу — тот же
26-pin стандарт, что и внутренние слоты.

## 4. Шина и деки: как это стыкуется

```
                 ┌──────────── PANEL-1 (300×132) ────────────┐
   экран 2.8″ ───┤ 8×EC11 + 6×74HC165 + 4 кнопки + 9×WS2812  │
                 └───────┬───────────────────────┬────────────┘
                 IDC-32  │                       │ IDC-16 (deck)
                         │                       ├── DECK-PAD (18 пэдов, 2 слайдера)
                 ┌───────┴──────── CORE-1 (200×108) ─────────┐
                 │ Pico + PCM5102A + MCP4728 + MCP3208 + MIDI │
                 └───┬───────────────┬───────────────┬───────┘
              IDC-26 │          IDC-26│          IDC-26│
             PORT0 (верхний док)  PORT1 (слот A)  PORT2 (слот B / нижний док)
```

- **Данные с панели:** 6 × 74HC165 каскадом по SPI0, 48 бит: энкодеры, их кнопки,
  плечевые кнопки, резерв. Слайдеры и CV — в MCP3208.
- **Экран:** SPI1 (ST7789, 320×240), подсветка — ШИМ через ключ 2N7002.
- **Подсветка:** одна цепочка WS2812 от GP7: 9 LED панели → LED_OUT в деку
  (18 у PAD или 42 у KEYS). Прошивка знает длину по `DECK_ID`.
- **Дека:** I2C (MCP23017), 2 аналоговых слайдера, `DECK_ID`, опционально FSR
  и INT. Распиновка — [`spec/20-electronics.md`](../spec/20-electronics.md) §6.2.

## 5. Звук и управление: что берём у лучших

Букифон не «ещё один субтрактив». Звук собран из трёх школ, и это зафиксировано
в спецификации:

- **4 независимые части** (как в Kaleidoscope): у каждой свой тембр, свои осцилляторы,
  фильтр, огибающие и эффекты. На часть — 2 осциллятора: wavetable (8 таблиц × 2048 ×
  8 mip-уровней) + **4-операторный FM с 8 алгоритмами** в духе Digitone, плюс
  additive/waveshaper/wavefolder/hardsync/ring-mod, sub, noise, unison до 4 голосов.
  Всего 8 голосов, 2× оверсэмплинг FM-ядра — [`spec/40-firmware.md`](../spec/40-firmware.md) §2.1.
- **3D-мод-матрица** (главная фишка Kaleidoscope): 16 слотов вида
  `[источник] → [цель] → [глубина] → [кривая] → [часть] → [условие]`. Модулировать можно
  **чем угодно что угодно**: огибающие — время других огибающих, LFO — глубину других
  слотов, секвенсорные дорожки — параметры FX, выходы частей — части-получатели.
  Разрешены кросс-части и обратные связи (отрицательная стабилизирует, положительная
  даёт хаос); глубина ограничивается и сглаживается. Экран показывает фактическое,
  уже промодулированное значение — [`spec/40-firmware.md`](../spec/40-firmware.md) §2.3.
- **Elektron-воркфлоу**: секвенсор 16 шагов × 4 дорожки с независимой длиной, скорости
  и swing; **параметр-локи** (любой параметр части на шаг, до 8 локов), **sound-локи**,
  **условия триггеров** (1st/not-1st/fill/!fill/A:B/проценты), **микротайминг** ±1/16 шага,
  **performance-макросы** (4 шт., каждый до 8 целей), **ctrl-all**, живая и пошаговая
  запись, копирование шагов/паттернов, арпеджиатор на дорожку — [`spec/40-firmware.md`](../spec/40-firmware.md) §6.1.
- **Аналоговые характеры Муг и Поливокс** — двумя путями. Цифровой: модель
  4-полюсной лестницы Муга с насыщением и drive, и «поливоксовый» характер
  (формантный резонанс + трёхголосный ансамбль/BBD) — параметр CHARACTER и режим POLYVOX.
  Аналоговый: звук части физически выводится на шину (AUD_IN → модуль → AUD_OUT),
  обрабатывается картриджами **LADDER-1** и **ENSEMBLE-1** и возвращается в микс
  с компенсацией задержки — [`spec/40-firmware.md`](../spec/40-firmware.md) §2.1,
  [`spec/00-vision.md`](../spec/00-vision.md) §2a.

## 5a. Питание и интерфейсы (v1.1)

В v1.1 добавлены автономность и «взрослые» входы-выходы — контракт
[`spec/50-v1.1.md`](../spec/50-v1.1.md) §1–3.

**Батарея.** 1S2P литий-ион 18650 (3.6 В ном., 5000–7000 мА·ч ≈ 18–25 Вт·ч) с BMS
(DW01+/FS312F) и предохранителем 3 А. Заряд — по отдельному **USB-C «CHARGE»** через
TP4056 (1 А, полный заряд ~5–7 ч) с индикацией. Boost MT3608 поднимает до **12.2 В/2 А**
и подаёт на существующий вход J-DC — вся цепочка CORE-1 (MP1584 → 5.1 В, AP2112K → 3.3 В,
MC34063 → −12 В) работает без переделки. При подключённом внешнем БП батарея
заряжается и не разряжается (ideal-diode / MOSFET-OR). Время работы: ≈6 ч тихо,
≈3.5 ч обычная игра, ≈2 ч максимум; заряд + игра — не ограничено.

**USB-C MIDI.** Два разъёма: **USB-C DATA/MIDI** (Pico, USB-MIDI class через TinyUSB:
16 каналов, MPE-lite, SysEx-дамп патчей) и **USB-C CHARGE** (только питание TP4056).
TRS MIDI IN/OUT Type A сохраняются и работают одновременно с USB.

**Аудиовход.** AUDIO IN L/R на **PCM1808** (I2S ADC, 24 бит/96 кГц) — внешний звук
заводится в цифровой тракт (FX, вокодер-лайт). Нужен MCLK 256fs (~12.288 МГц).
**Педаль экспрессии / sustain** — TRS 6.35 мм → MCP3208 CH4 (бывший резерв) —
четвёртая CV-ось в мод-матрице.

**Безопасность:** только качественные 18650 с защитой и одинаковые элементы в 1S2P;
не заряжать при < 0 °C, не оставлять на солнце; BMS — до холдера; F3 A — по выходу.

**Вариант B «A5» (компактный настольный, 210 × 148 × 40 мм).** Второй эскиз заказчика
(`refs/sketch2-folded-a4.jpg`): 16 энкодеров (8 + 8), экран 2.8″ в обрамлении 8 кнопок, 2 слайдера
по центру, две группы 3×3 пэдов, батарея 1S2P внутри. Для него потребуются **PANEL-1B**
(~200 × 110) и **CORE-1B** (та же архитектура + PCM1808 + батарейное питание), корпус
без рукояток; прошивка ядра не меняется, добавляются страница «16 параметров» и Audio In.
Раскладка и координаты — [`spec/50-v1.1.md`](../spec/50-v1.1.md) §4; черновая
визуализация — [`renders/templates/bukifon_v04_render.png`](../renders/templates/bukifon_v04_render.png).
Артефакты v1.0 (handheld 315 × 145) остаются в силе.

## 6. Что в коробке (после сборки)

- CORE-1 — плата ядра с Pico, ЦАП/АЦП, MIDI, микшером и тремя портами шины.
- PANEL-1 — плата панели с 8 энкодерами, 6 × 74HC165, экраном, подсветкой.
- Одна дека ввода на выбор: **DECK-PAD** (18 RGB-пэдов + 2 слайдера) или
  **DECK-KEYS** (42 клавиши Choc + 2 слайдера). Вторая — опция.
- Два аналоговых модуля-примера (VCO-1, FILTER-1) и макетный PROTO-1.
- Корпус из PETG (16 деталей, печать 18–22 ч), панель, задняя стенка, крышка брюха,
  ручки, колпачки, световоды, ножки.
- БП 12 В 2 А (опция v1.1 — аккумуляторный блок 1S2P 18650 + TP4056/USB-C + MT3608),
  шлейфы IDC, USB-кабель, крепёж.
- Прошивка с фабричным банком 16 патчей (64 патча всего), документация и лицензии.

Смета и ссылки на покупку — [`docs/BOM.md`](BOM.md). Чего в v1.0 **нет**:
аккумулятора, SD-карты, беспроводного MIDI, корпуса с наклоном — это задел на v1.1.

## 7. Что можно делать сразу

1. **Играть:** DECK-PAD — пэды/шаги, DECK-KEYS — 3.5 октавы изоморфной раскладки;
   SHIFT меняет слой (ноты / аккорды / шаги секвенсора).
2. **Крутить:** 8 энкодеров — параметры текущей страницы; нажатие — сброс,
   ENC1/ENC8 + SHIFT — листание страниц (OSC, FILTER/ENV, LFO/MOD, SEQ, CV I/O,
   MODULES, FX, SYSTEM). UI — [`spec/10-panel-ui.md`](../spec/10-panel-ui.md) §4.
3. **Секвенсить:** 16 шагов × 4 дорожки, plocks, условия, swing, микротайминг,
   цепочки паттернов, арпеджиатор.
4. **Патчить аналог:** CV/GATE на шину и джеки, 4 CV out / 4 CV in, 1V/oct,
   калибровка в EEPROM.
5. **Подключать MIDI:** USB-MIDI и TRS Type A, MPE-lite, aftertouch, CC-learn,
   MIDI-клок.
6. **Расширять:** картриджи L1/L3, свои программные модули L2, своя дека.

## 8. С чего начать

| Шаг | Документ |
|---|---|
| Понять, что и за сколько покупать | [`docs/BOM.md`](BOM.md), [`BOM.csv`](../BOM.csv) |
| Что нового в v1.1 (батарея, USB-C, AUDIO IN, вариант «A5») | [`spec/50-v1.1.md`](../spec/50-v1.1.md) |
| Заказать → напечатать → спаять → прошить | [`docs/01-quickstart.md`](01-quickstart.md) |
| Разобраться в лицензиях и атрибуции | [`docs/09-licensing.md`](09-licensing.md) |
| Электрика, пины, шина | [`spec/20-electronics.md`](../spec/20-electronics.md) |
| Панель и UI | [`spec/10-panel-ui.md`](../spec/10-panel-ui.md) |
| Корпус и печать | [`spec/30-mechanics.md`](../spec/30-mechanics.md) |
| Прошивка и API | [`spec/40-firmware.md`](../spec/40-firmware.md) |

## 9. Источники истины и структура репозитория

Расхождение с файлами `spec/` — ошибка; изменения вносит только Lead.

```
spec/        контракты: vision, panel-ui, electronics, mechanics, firmware
hardware/    KiCad-проекты плат (CORE-1, PANEL-1, деки, модули)
firmware/    прошивка (arduino-pico / Pico SDK), host-сборка, тесты
mechanical/  STL, параметрический генератор корпуса, карты печати
docs/        обзор, quickstart, BOM, лицензии, гайд сборки
refs/        эскиз заказчика и референсы
```

## 10. Лицензии коротко

- Аппаратура и механика — **CERN-OHL-S-2.0** (схемы, PCB, STL, BOM).
- Прошивка — **GPL-3.0-or-later**.
- Документация — **CC BY-SA 4.0**.

Подробно — [`docs/09-licensing.md`](09-licensing.md).
