martiyanov/bukifon/docs/25-power-architecture.md

# Архитектура питания Букифона (консультация GPT, 06.11.2025)

Источник: консультация инженера по питанию (Codex/gpt-5.6), полный текст — в отчёте
этого раунда. Ниже — зафиксированные решения для PWR-2 и правила P1.

## Главный вывод

Текущая архитектура перегружена: три MT3608 + MC34063 + зарядник на одной CORE-2 дают
тепло и помехи рядом с аудио. «±12 В × 300 мА на рельс» — это ~7.2 Вт и ~2.4–3 А от 1S,
а не «маломощная шина».

**Реальный бюджет шины (P1):** +12 В ≈ **330 мА**, −12 В ≈ **95 мА**.
Если картриджам нужно больше — отдельно обосновать и пересчитать от батареи.

## ±12 В: что выбираем

| Вариант | КПД от 1S | Шум после фильтра | Вердикт |
|---|---:|---:|---|
| MC34063 boost + inverter | 50–70 % | 30–200 мВ p-p, гармоники ~100 кГц | ❌ исключить |
| Charge-pump + LDO | 30–60 % | средний/высокий | ❌ исключить |
| Push-pull → ±14 В → LDO | 70–82 % | 1–10 мВ p-p | ✅ при расчёте трансформатора |
| Sync boost + inverting buck-boost | 78–90 % | 5–30 мВ p-p после LC/LDO | ✅ рекомендуется для PWR-2 |
| Готовый DC/DC-модуль ≥10 Вт | 75–90 % | 20–200 мВ p-p | ⚠️ только как референс для P1 |

После преобразователя — **π-фильтр C–L–C** (22–47 мкФ / 4.7–10 мкГн / 47–100 мкФ).
Источники: [TI MC34063A](https://www.ti.com/product/MC34063A), [TI SN6505](https://www.ti.com/lit/ds/symlink/sn6505b.pdf).

## Цепь питания

```
2×18650 (parallel) → fuse 4–5 A → BMS 1S → BQ24074 BAT
USB-C → BQ24074 IN
BQ24074 OUT/VSYS → master load-switch → CORE-2 + PWR-2 converters
                                        ├── +12 В (EN)
                                        ├── −12 В (EN)
                                        └── +5 В LED/BL (EN)
```

Правила:
- преобразователи питаются **только от VSYS/OUT BQ24074**, не от PACK;
- NTC 10 кОм на банке → TS BQ24074 — обязателен;
- fuse у батареи, индивидуальные fusible-соединения банок — желательно;
- master load-switch (back-to-back MOSFET) с настоящим shutdown;
- ideal-diode между BMS и BQ24074 **не нужен** (лишнее падение);
- BMS cutoff — аварийный порог, **не кнопка питания**;
- BQ24074 линейный: до ~2 Вт при 1.5 А заряда → медь, thermal vias, тепловой тест.

Источник: [TI BQ24074](https://www.ti.com/product/BQ24074).

## Fuel gauge

**MAX17048 остаётся** (I²C, ±7.5 мВ, без шунта, моделирует SOC под нагрузкой);
ADC-делитель — только независимый контроль напряжения. Калибровка: разряд 4.2→3.0 В
при реальной средней нагрузке, проверка SOC в 100/75/50/25/10/0 %, RCOMP по химии.
Источник: [ADI MAX17048](https://www.analog.com/en/products/max17048.html).

## Земля и тепло

- PGND преобразователей — на PWR-2 и одним силовым соединением на CORE-2;
- AGND аудио/CV — одна контролируемая точка у codec/reference;
- возврат WS2812/BL **не** через землю PCM1808/PCM5102A;
- ±12 В — парные supply/return, не «земля через корпус»;
- тепловые риски: MT3608 5 В/1 А (~5 Вт), MT3608 BL 20 В (dv/dt), MT3608 +12 В (~4 Вт),
  MC34063 −12 В (исключаем), BQ24074 (до 2 Вт), WS2812 (импульсный ток).

## Что измерить на стенде до PCB (обязательно для P1)

1. Электронные нагрузки на каждом рельсе при VBAT 4.2 / 3.6 / 3.0 В.
2. Одновременный worst-case: экран 100 %, LED-паттерн, USB HS, SD write, Wi-Fi TX,
   аудио и оба картриджа.
3. Load-step 10→100 %: выброс, восстановление, brownout.
4. Ripple (ground-spring) и спектр 20 Гц–10 МГц.
5. FFT аудиовыхода при вкл/выкл BL, Wi-Fi, WS2812 и ±12 В.
6. CV-ошибка/шум в мВ и переходные при смене LED/экрана.
7. Температура BQ24074, ключей, диодов, дросселей, банок за 60 минут (<80 °C компоненты).
8. USB plug/unplug, заряд + max load, выключение, BMS cutoff/recovery, пуск при 3.0 В.

Первые тесты — от лабораторного БП/симулятора батареи с ограничением тока, не от голых 18650.

## Границы

- **До P1:** зафиксировать бюджеты, проверить BQ24074+BMS+VSYS, выбрать топологию ±12 В
  экспериментом с аудио-FFT, проверить MT3608 при 3.0 В, тепловая карта, 2 ч → 24 ч soak.
- **После P1:** PCB rev.1 (CORE-2/PANEL-2/PWR-2) → bring-up → Module SDK v0.1 → cost-down.
- **Не делать сейчас:** заказывать платы, считать MT3608 «2 А выходными», использовать BMS
  как кнопку, стабилизировать SDK/ABI до фиксации шины.
