martiyanov/bukifon/docs/23-nightly-report.md

# Ночной отчёт: 05–06.11.2025 (v0.6.0)

Цель ночи по плану GPT: **интегрированный цифровой прототип**, который запускается и
проверяет будущие платы. Достигнуто; аппаратная v1.0 — нет и не планировалась.

## Что готово и проверено

| Артефакт | Статус | Проверка |
|---|---|---|
| Host-демо UI 800×480 | готово | `firmware/tests/run_sim_demo.sh` — 16 тактов, 1 536 000 frames, два прогона byte-identical |
| Секвенсор 4×16 + p-lock + save/load | готово | host-тесты: 112/112, покрытие 83.5 % |
| Module API v0 + 2 примера | готово (experimental) | тесты модулей, budget/bypass |
| Режимы Synth/Sampler/DAW/USB-keyboard | каркас | unit-тесты переключения |
| USB composite HID+MIDI+UAC2+CDC | каркас (descriptor builder) | unit-тесты; TinyUSB glue — TODO(hw) |
| BLE-MIDI/HID, Wi-Fi AP/web/OTA | заглушки API | state machine + тесты |
| Корпус v0.5-B (клин 8°) | готово | 6 STL watertight, fitcheck 32/0, профиль 1:1 |
| CORE-2 rev.1 | pre-freeze | ERC 0/0, pinmap PASS, 54/55 GPIO |
| PANEL-2 rev.1 | pre-freeze | ERC 0 errors/6 warnings, 1288 проверок, 4× MCP23017 |
| BOM draft | готово (draft) | база ≈ $271, полный ≈ $406 |
| Сайт RU/EN | обновлён v0.6.0 | GitHub Pages 200 |
| Безопасность | вычищено | `tools/security_scan.sh` — ok |

## Что симулируется (не железо)

- UI и ввод — host-симулятор, не P4;
- USB-композит — только дескрипторы, не реальный枚举;
- BLE/Wi-Fi — заглушки API, не радио;
- P4-сборка не проверена (нет toolchain), проверена S3 и RP2040;
- CORE-2/PANEL-2 — схемы, без PCB и без бенчмарка реального времени.

## Что НЕЛЬЗЯ заказывать до P1-бенчмарка

1. PCB CORE-2/PANEL-2 и корпус — схемы pre-freeze.
2. Физический модуль P4 (слот 2×32) — не выбран.
3. RGB565 vs DSI (R-18) — открыто.
4. SDIO vs SPI для C6 — выбран SPI по бюджету GPIO (пересмотр при необходимости).
5. Запас VSYS 3 % — помечен как исключение, требует проверки power-path.

## Известные расхождения/долги

- CORE-2 README упоминает 3× MCP23017, PANEL-2 требует 4× (0x20–0x23) — синхронизировать (D-22).
- FPC-40 пин-аут дисплея — TBD по datasheet модуля.
- P4 toolchain/плата — ждём; env:p4 закомментирован.
- «Народная» цена ≤ $200 не достигнута: draft ≈ $271; нужен cost-down (spec/00 §13).
- Старые коммиты GitHub могут оставаться доступными по SHA после rewrite — нужен purge
  (см. SECURITY.md).

## Следующие шаги (P1–P3)

1. Заказать devkit P4 + H743, заморозить workload (P0 уже частично: демо-сценарий есть).
2. Бенчмарк: granular PSRAM, DSP-ядра, USB 8×8, дисплей; критерий max block time ≤ 0.65 мс.
3. Свести MCP23017/шлейфы, выбрать дисплей (FPC-40), решить DSI/SPI.
4. Cost-down до «народной» цены; вариант S3 как основной.
5. После бенчмарка — freeze требований и rev.1 PCB.
