martiyanov/bukifon/spec/00-vision.md

# Букифон — открытый модульный настольный синтезатор

**Версия спецификации:** 1.0 (контракт для команды)
**Дата:** 2025-11-05
**Автор концепции:** Lead (по эскизу заказчика `refs/sketch1-panel.jpg`)

---

## 0. Название

**Букифон / Bukifon**: «буки» (вторая буква кириллицы, «аз буки веди») + греч. φωνή — голос/звук.
Читается как «звук букв/знаков» и как инструмент в ряду «граммофон/саксофон/меллотрон».
Логотип: `mechanical/branding/bukifon_wordmark.svg`.

## 1. Что это

Букифон — настольный цифро-аналоговый синтезатор, который:

1. **Собирается технологично** из покупных модулей (Raspberry Pi Pico, PCM5102A, MCP4728,
   MCP3208, 74HC165, EC11, тактовые кнопки, слайдеры) и/или из 2-3 печатных плат,
   которые можно заказать на JLCPCB/Rezon/Seeed.
2. **Печатается на 3D-принтере** (корпус по эскизу заказчика, все детали ≤ 220×220×220 мм,
   без поддержек, крепёж M3 + термовтулки).
3. **Модульный на трёх уровнях**:
   - **L1 — аппаратные модули** (аналоговые и цифровые) подключаются к шине Букифон
     Bus (26 pin): 2 слота внутри корпуса + верхний док + нижний док;
   - **L2 — программные модули** (движки, эффекты, модуляторы, секвенсоры) с открытым API;
   - **L3 — «умные» модули** (со своим МК) автоопределяются по I2C-EEPROM и появляются
     в меню синтезатора.
4. **Полностью открытый**: схемы (KiCad, CERN-OHL-S-2.0), прошивка (GPL-3.0-or-later),
   механика (STL + параметрический генератор, CERN-OHL-S-2.0), BOM с ценами и ссылками.

## 2. Ключевые решения (и почему)

| Решение | Выбор | Причина |
|---|---|---|
| Мозг | Raspberry Pi Pico (RP2040), Arduino-ядро arduino-pico | доступен, дёшев (~4 $), 2 ядра, PIO для I2S, отлаженный Arduino-стек |
| Альтернативные мозги | ESP32-S3, Teensy 4.0, Arduino Nano 33 (адаптер) | модульность L1: brain-cartridge меняется без переделки корпуса |
| ЦАП звука | PCM5102A (I2S, 112 дБ) | 3 $, идеально для DIY, не требует MCLK |
| ЦАП CV | MCP4728 (4×12 бит, I2C) | 4 CV-выхода 0..10 В, дешёвый DIP/SOIC |
| АЦП CV | MCP3208 (8×12 бит, SPI) | 4 CV-входа + 2 фейдера + служебные каналы |
| Ввод | 8 энкодеров EC11 + 18 пэдов + 2 слайдера через 74HC165 | без дребезга, без I2C-задержек, копейки |
| Экран | 3.5" IPS 480×320 SPI (ST7796/ILI9488) | точно как на эскизе, ~10 $ |
| Питание | 12 В 2 А внешний БП → +12 В / −12 В / +5 В / +3.3 В | совместимо с аналоговыми модулями (еврорек-подобные ±12 В) |
| Шина модулей | 26-pin IDC: питание, 4 CV, 2 гейта, 2 аудио, I2C, SPI | один стандарт для всех 4 портов |

## 2a. Звук и управление: что берём у лучших

Заказчик попросил вобрать лучшее из трёх школ. Реализация:

| Источник | Что берём | Где в проекте |
|---|---|---|
| **Vadim Minkin «Kaleidoscope»** ([mmag.ru](https://mmag.ru/magazin/synthesizers/vadim-minkin-kaleidoscope-sale.html), [bonedo.de](https://www.bonedo.de/artikel/vadjuse-kaleidoscope-digitaler-generativer-synthesizer/)) | 4 независимых части с разными тембрами; **3D-мод-матрица** — модулировать можно что угодно чем угодно, включая время огибающих, другие модуляторы, другие части, обратные связи; генеративный секвенсор с функциональными модуляторами; экран показывает фактическое (модулированное) значение | `40-firmware.md` §2.3, §6.2 |
| **Elektron (Digitone/Digitakt)** | постраничный UI на 8 энкодеров; **параметр-локи**, sound-локи, условия триггеров, микротайминг, swing, цепочки паттернов, performance-макросы, ctrl-all, живая/пошаговая запись, арпеджиатор на дорожку | `40-firmware.md` §6.1 |
| **Moog / Поливокс** | честный аналоговый тракт через шину: модули **LADDER-1** (лестничный фильтр Муга на AS3320) и **ENSEMBLE-1** (ансамбль/BBD в духе Поливокса) + цифровые модели обоих характеров, включаемые без модуля | `20-electronics.md` §7, `40-firmware.md` §2.1 |

FM — не «плюс к субтрактиву», а равноправный движок: **4 оператора, 8 алгоритмов**,
оверсэмплинг 2×, гибрид FM + wavetable. Аналоговый звук — не эмуляция «для галочки»:
звук части можно физически вывести на аналоговый модуль (AUD_IN → модуль → AUD_OUT) и
вернуть в микс с компенсацией задержки.

## 3. Границы проекта (v1.0)

**В объёме:**
- CORE-1: плата ядра (Pico, питание, АЦП/ЦАП, MIDI, аудиомикшер, 4 порта шины).
- PANEL-1: плата панели (8 энкодеров, 18 пэдов, 2 слайдера, экран, 8 индикаторов).
- 2 аналоговых модуля-примера: **VCO-1** (AS3340) и **FILTER-1** (LM13700 SVF).
- Макетный модуль **PROTO-1** (для своих схем).
- Корпус, панель, док-станции, крепёж — STL + параметрический генератор.
- Прошивка: 8-голосый движок, 16-шаговый секвенсор, 4 CV out / 4 CV in, MIDI USB + TRS,
  пресеты, API модулей.
- Документация: сборка, BOM, разработка модулей, лицензии.

**Вне объёма v1.0 (задел на v1.1):** корпус с наклоном, аккумулятор, SD-карта,
эффект-процессор на втором RP2040, беспроводной MIDI.

## 4. Себестоимость

Точные позиции, ссылки и цены — в `docs/BOM.md` и `BOM.csv` (фиксация 2025-11-05,
USD ≈ 80 ₽). Итоги по BOM:

| Вариант | Позиций | Бюджет (импорт), ₽ | Оптимум (розница РФ), ₽ |
|---|---:|---:|---:|
| База: CORE-1 + PANEL-1 + DECK-PAD + VCO-1 + FILTER-1 + PROTO-1 + корпус + кабели + БП | 79 | **16 855** | **32 198** |
| Опции: DECK-KEYS, FSR-velocity, LADDER-1, ENSEMBLE-1, 2-й VCO, 6.35 мм, аккумулятор/USB-C/PCM1808 (v1.1) | 35 | +12 720 | +24 263 |
| Полный комплект | 114 | **29 575** | **56 460** |

Минимальный вход (одна дека, без филамента/расходников) — ≈ 14 000 / 27 200 ₽.
Первоначальная оценка ≈ 11 300 ₽ оказалась оптимистичной (экран 2.8", 8 конструкций
плат, AS33xx, курс и доставка) — см. сверку в `docs/BOM.md`.

## 5. Лицензии

- Аппаратура (схемы, PCB, BOM): **CERN-OHL-S-2.0**
- Прошивка: **GPL-3.0-or-later**
- Механика (STL, SCAD, генератор): **CERN-OHL-S-2.0**
- Документация: **CC BY-SA 4.0**

## 6. Источники истины

| Файл | Что фиксирует | Владелец |
|---|---|---|
| `spec/10-panel-ui.md` | координаты всех органов управления, окна, UI-раскладка | Lead |
| `spec/20-electronics.md` | карта пинов, шина, питание, аудиотракт, перечень плат | Lead |
| `spec/30-mechanics.md` | габариты, разбиение на печать, Z-уровни, док-станции | Lead |
| `spec/40-firmware.md` | контракт прошивки, API модулей, тесты | Lead |

Любое расхождение с этими файлами — ошибка. Изменения вносит только Lead.

## 12. Платформа: сэмплер + синтезатор + модули сообщества (05.11.2025)

Букифон — не один инструмент, а **платформа** в одном корпусе 380 × 210 × 63:

1. **Сэмплер в духе Elektron Digitakt.** 8 стерео-дорожек, запись/импорт сэмплов
   (USB-C mass storage + SD), time-stretch/pitch-shift, срезы и гранулярность,
   2 insert-эффекта на дорожку, per-track LFO, параметр-локи, условия триггеров,
   микротайминг, ctrl-all. Сэмплы хранятся в PSRAM/SD, звук — PCM5102A.
2. **Синтезатор в духе Elektron Syntakt.** 4 части, 8 голосов: 4-операторный FM,
   wavetable, ZDF-фильтры, лестница Муга (AS3320), характер Поливокса,
   4 огибающих с loop-режимом, 3D-мод-матрица 16 слотов, аналоговые модули
   (VCO на AS3340, фильтр на LM13700, PT2399) через шину 26-pin.
3. **Открытые модули для сообщества.** Любой может написать свой модуль:
   - **программный** — C++/Lua-модуль через SDK: `BukifonModule` (init/process/
     параметры/UI-сетка), ставится на SD/USB, появляется в списке машин;
   - **аналоговый** — картридж на шине 26-pin (питание ±12 В, CV, gate, аудио),
     формат `hardware/modules/CARTRIDGE.md`, корпус печатается по шаблону;
   - **панельный** — сменная дека (18 пэдов / 42 клавиши) с EEPROM-идентификацией.
4. **Один и тот же звуковой движок** переключается между режимами (Sampler / Synth /
   Hybrid), состояние проекта общее; секвенсор и мод-матрица работают одинаково
   во всех режимах.

Следствия для железа: CORE-1 rev.3 — PSRAM 8 МБ + SD, USB-C (данные + питание),
PCM5102A + PCM1808 (вход для сэмплирования), 2 × MCP4728 (CV), шина модулей;
панель — 16 энкодеров, экран 5″ 800×480, 10 mini-jack, 2 фейдера, 42 клавиши.

## 13. «Народный синтезатор» — позиционирование (06.11.2025)

Букифон должен стать **народным инструментом**: доступным по цене, повторяемым в сборке
и открытым для сообщества. Это не «ещё один премиум-синт», а платформа, которую может
собрать мастерская в регионе, кружок или один человек на своём 3D-принтере.

### Принципы

1. **Цена как функция.** Целевые ориентиры (комплект, без печати корпуса и работы):
   - «Народный» (ESP32-S3, 8 моно-дорожек, 6 голосов, экран 5″ 800×480) — **≤ $200**;
   - «Стандарт» (ESP32-P4, 8 дорожек/8 голосов, UAC2) — **≤ $300**;
   - «Полный» (P4 + аналоговые картриджи + аккумулятор) — **≤ $400**.
   Текущий draft BOM: база ≈ $271, полный ≈ $406 — нужно cost-down (см. ниже).
2. **Повторяемость.** Один BOM, один набор STL, печатные шаблоны 1:1, проверка fitcheck,
   версии по SemVer — чтобы у двух сборщиков получился одинаковый инструмент.
3. **Открытость без заложников.** KiCad, C++, STL, документация, RU/EN; никаких закрытых
   прошивок и облаков; формат проекта документирован и переносим.
4. **Ремонтопригодность.** Модульность (CORE/PANEL/PWR/деки/картриджи), стандартные
   компоненты (Choc, EC11, Thonkiconn, 18650), доступность в РФ и на LCSC/Mouser.
5. **Сообщество.** Модули пишутся сообществом (C++/Lua/картриджи), каталог модулей,
   примеры, «свой модуль за вечер»; локальные мастерские собирают kits.

### Cost-down план (к P6 дорожной карты)

| Рычаг | Экономия (оценка) |
|---|---|
| ESP32-S3-модуль вместо P4-девборда в «народной» версии | −$20…40 |
| Модуль P4 вместо EV-board (если P4) | −$30…50 |
| Дисплей 5″ RGB FPC без тачскрина, оптовая цена | −$5…10 |
| Один разъём IDC-26 + MCP23017 вместо россыпи GPIO | −$3…6 |
| Печать корпуса владельцем/мастерской (без PCBA-услуг) | −$30…60 |
| Отказ от аналоговых картриджей в базовой версии | −$20…40 |
| Унификация плат (3 вместо 5-6 конструкций) | −$5…10 |
| Аккумулятор 1S2P 18650 вместо LiPo + BMS | −$5…10 |

Цель: «народная» версия **≤ $200**, «стандарт» **≤ $300** при сохранении 42 клавиш,
16 энкодеров, экрана 5″ и 10 джеков.

### Что НЕ режем ради цены

- 42 клавиши Lapka-42 и splay — это эргономика, ради которой всё делается;
- 16 энкодеров — основной способ управления FM/сэмплером;
- экран 5″ 800×480 — рабочий стандарт (Polyend Tracker, см. docs/20);
- открытость схем/прошивки/геометрии.

## 14. Режим компьютерной клавиатуры и DAW (06.11.2025)

Букифон должен работать **и как самостоятельный инструмент, и как клавиатура/контроллер
для компьютера**:

1. **USB-композит на одном USB-C**: HID-клавиатура (42 клавиши Lapka-42 как печатная
   раскладка с слоями и макросами) + MIDI (class-compliant) + UAC2 аудиоинтерфейс
   (+CDC для отладки). Переключение режимов — без перезагрузки.
2. **DAW-режим**: 16 энкодеров как CC-контроллеры с банками; transport (play/stop/rec);
   по желанию — Mackie Control/HUI эмуляция; 42 клавиши как ноты или хоткеи.
3. **Wi-Fi + Bluetooth обязательны**: BLE-MIDI (играть без провода), BLE HID-клавиатура,
   Wi-Fi для передачи проектов/сэмплов и обновлений (веб-редактор, RTP-MIDI — опционально).
   - ESP32-S3 — радио нативно (народная версия);
   - ESP32-P4 — сопроцессор **ESP32-C6** (Wi-Fi 6 + BLE 5.3) по SDIO/UART (версия «стандарт/pro»).
4. **Печатная клавиатура как бонус**: Lapka-42 — это сплит-клавиатура; в режиме HID
   устройство становится необычной «механической клавиатурой» с 16 ручками, что само по себе
   фича для тех, кто много работает за компьютером.
