martiyanov/bukifon/spec/20-electronics.md

# 20. Электрическая архитектура и шина Букифон (handheld)

Контракт для `hw-core`, `hw-modules`, `firmware-dsp`. Имена цепей обязательны.

---

## 1. Состав электроники

| Плата | Габарит (мм) | Что делает |
|---|---|---|
| **CORE-1** | 200 × 108 × 1.6 | Pico (SMD-пайка на кастеляцию), питание, I2S-ЦАП, CV-ЦАП/АЦП, MIDI, аналоговый микшер, 3 порта шины |
| **PANEL-1** | 300 × 132 × 1.6 | 8 энкодеров + световоды, 6×74HC165, 4 плечевых кнопки, экран 2.8", 9×WS2812, разъём deck |
| **DECK-PAD** | 290 × 78 × 1.6 | 18 RGB-пэдов, 2 слайдера, MCP23017, 2×74HC4067 (FSR-velocity), 18×WS2812 — сменный модуль ввода |
| **DECK-KEYS** | 290 × 78 × 1.6 | 42 клавиши Choc (матрица 6×7 + 1N4148), 42×SK6812MINI-E, 2 слайдера, MCP23017 — сменный модуль ввода |
| **MOD-VCO-1** | 110 × 70 × 1.6 | аналоговый VCO на AS3340 |
| **MOD-FILTER-1** | 110 × 70 × 1.6 | аналоговый SVF на LM13700 |
| **MOD-LADDER-1** | 110 × 70 × 1.6 | лестничный фильтр Муга на AS3320 (DIP-18): CV cutoff, резонанс, drive, LP/HP |
| **MOD-ENSEMBLE-1** | 110 × 70 × 1.6 | ансамбль/хорус в духе Поливокса: 2 × BBD-линия или PT2399-ансамбль + фильтр-формант |
| **MOD-PROTO-1** | 110 × 70 × 1.6 | макетный модуль (все цепи шины на гребёнке) |

Внутренние модули — плоские картриджи, вставляются в «брюшной» отсек снизу.
Модули верхнего/нижнего дока — те же картриджи, крепятся снаружи печатной скобой.

## 2. CORE-1: карта пинов Raspberry Pi Pico

| GPIO | Функция | Куда |
|---|---|---|
| GP0 | UART0 TX | MIDI OUT через 74HCT125 |
| GP1 | UART0 RX | MIDI IN через 6N137 |
| GP2 | SPI0 SCK | MCP3208 SCLK + 74HC165 CP |
| GP3 | SPI0 MOSI | MCP3208 DIN |
| GP4 | SPI0 MISO | MCP3208 DOUT + 74HC165 QH |
| GP5 | GPIO | MCP3208 CS |
| GP6 | GPIO | 74HC165 PL |
| GP7 | GPIO/PIO | **LED_DATA** — WS2812-цепочка (27/51 LED); данные через буфер 74HCT1G125 (5 В), цепочка питается от +5 В |
| GP8 | I2C0 SDA | MCP4728, 24C32 (pull-up 4.7 k на 3.3 В) |
| GP9 | I2C0 SCL | MCP4728, 24C32 |
| GP10 | SPI1 SCK | PANEL-1 → экран SCK |
| GP11 | SPI1 MOSI | PANEL-1 → экран SDI |
| GP12 | GPIO | LCD_CS |
| GP13 | GPIO | LCD_DC |
| GP14 | GPIO | LCD_RST |
| GP15 | PWM | LCD_BL (подсветка, ключ 2N7002) |
| GP16 | PIO I2S | PCM5102A BCK |
| GP17 | PIO I2S | PCM5102A LRCK |
| GP18 | PIO I2S | PCM5102A DIN |
| GP19 | GPIO | PORT0_CS — верхний док |
| GP20 | GPIO | PORT1_CS — внутренний слот A |
| GP21 | GPIO | PORT2_CS — внутренний слот B / нижний док |
| GP22 | GPIO | **GATE1** (2N7000, на шину и джек) |
| GP26 | GPIO | **GATE2** (2N7000, на шину и джек) |
| GP27 | ADC1 | **DECK_ID** (аналоговое определение деки, делитель 33k/3.3k) |
| GP28 | GPIO | **DECK_INT** (прерывание MCP23017 деки; прерывание доступно на любом GPIO) |
| VSYS | 5 В | +5V через диод Шоттки SS34 |
| 3V3 | — | только Pico; панель питается от отдельного LDO 3.3 В |
| RUN | reset | кнопка RESET на задней стенке |
| USB | USB FS | разъём Pico — вырез в задней стенке |

**Монтаж Pico:** SMD-пайка на кастеляцию (низкий профиль, 6 мм) или низкопрофильные
гребёнки 2 мм. В корпусе высота 48 мм — критично.

## 3. Питание

Вход: **12 В DC, 2 А**, 5.5/2.1 мм, центр «+». Альтернатива — модуль батареи
(3×18650 + boost 12 В) в нижнем доке.

```
J-DC ── F1 2A ── D1 SS34 ──┬── +12V ── модули
                           ├── U1 MP1584 (5.1 В, 3 А) ── +5V
                           │        └── U2 AP2112K-3.3 ── +3V3 (панель, экран, LED)
                           └── U3 MC34063 инвертор ── -12V (250 мА)
TVS SMAJ15A + 1000 мкФ/25 В на входе, ферриты 600 Ом на +5V и ±12V
```

| Рельс | Бюджет |
|---|---|
| +12 В | 3 порта × 60 мА + запас, лимит 400 мА |
| −12 В | 3 × 40 мА, лимит 200 мА |
| +5 В | Pico 120 мА, MIDI 10 мА, лог. 20 мА → ≤ 0.8 А |
| +3.3 В | экран 60 мА, панель 30 мА → ≤ 120 мА (LDO 600 мА) |
| +5 В (LED) | 27/51 × WS2812 ≈ 220/420 мА при ограничении яркости прошивкой |

## 4. Аудиотракт

```
Pico PIO I2S ── PCM5102A ── L,R (2.1 В rms) ──┬── 10 мкФ/10 k ──┐
                                              │                ├── TL074 инверт. сумматор (22 k/10 k)
PORT0..2 AUD_OUT (±5 В) ── 10 k ── защита ────┴────────────────┤
                                                               │
                                  MASTER VOL (сдвоенный 10 k) ─┤
                                                               │
                                  TL072 буфер ── 100 Ω ──┬── 3.5 мм LINE OUT (стерео)
                                                         └── 3.5 мм PHONES
```

- **AUD_IN** (core → module) = DAC L через буфер ×0.5, 1 kΩ, 1 В rms.
- **AUD_OUT** (module → core) = 10 kΩ в сумматор, ±5 В, AC.
- Защита каждого аудиовхода: 1 kΩ + BAT54S + 100 pF.
- MASTER VOL — на задней стенке, сдвоенный потенциометр 10 kΩ (лог.).

## 5. CV / GATE

| Сигнал | Диапазон | Схема |
|---|---|---|
| CV1…CV4 (шина) | 0…10 В | MCP4728 #1 **A0** (0x60) CH A…D (Vref 2.048) → TL074 ×4.883 → 1 kΩ + BAT54S |
| CV OUT 1…2 (джеки) | 0…10 В | MCP4728 #2 **A1** (0x61) CH A/B → TL074 ×4.883 → 1 kΩ + BAT54S |
| CV IN 1…2 (джеки) | −10…+10 В | инверт. аттенюатор 100 kΩ/16.5 kΩ со сдвигом +1.65 В (47 k/47 k от +3V3 через буфер TL074): Vadc = 1.65 − 0.165·Vin → BAT54S → RC → MCP3208 CH2/CH3 (измеряет обе полуволны) |
| CV-возврат с модулей | — | **не предусмотрен шиной** (все 4 линии CV — core→module); умные модули сообщают состояние по I2C/SPI |
| GATE1/2 | 0/5 В | 2N7000 open-drain + 4.7 kΩ на +5 В + 1 kΩ |
| Калибровка | EEPROM 24C32 (адрес **0x57**, чтобы не конфликтовать с EEPROM модулей 0x50+порт) | 2 точки на канал CV |

MCP3208 (Vref 3.3 В): CH0 = SL1, CH1 = SL2, CH2/CH3 = CV IN 1/2 (джеки),
CH4/CH5 = резерв (модуляция/внешний вход), CH6 = FSR-мультиплексор (velocity / deck),
CH7 = SYS_MON. **CV-ЦАП: 2 × MCP4728** — #1 (0x60) на шину CV1…4, #2 (0x61) на джеки CV OUT 1/2.
DECK_ID — на внутренний ADC Pico (GP27).

## 6. PANEL-1, DECK-PAD, DECK-KEYS

### 6.1 PANEL-1

- 8 × EC11 (гладкие), RC на фазах 10 kΩ + 100 nF (16 шт.), подтяжки 10 kΩ.
- 6 × 74HC165 каскадом: CP = GP2, PL = GP6, QH → MISO (GP4), 48 бит.
  Бит 0…15 — энкодеры A/B (ENC1…8), 16…23 — кнопки энкодеров,
  24…27 — BTN_L1/L2/R1/R2, 28…47 — резерв (под будущие крылья/педали).
- 4 × плечевые кнопки 6×6 мм — на те же 74HC165 (биты 24…27).
- Экран 2.8" ST7789: разъём 1×14, SPI1, 3V3, BL через 2N7002 (ШИМ GP15).
- 9 × WS2812B-2020 (8 ручек + статус), цепочка: GP7 → PANEL → **LED_OUT в deck**.
- Разъём deck — IDC-16 (2×8) на PANEL-1, ответная вилка на DECK.
- DECK_INT (MCP23017 INTA) → PANEL-1 → CORE-1 **GP28**. GATE1 = GP22, GATE2 = GP26.
- **Питание LED-цепочек деки: +5 В** (пин 16 IDC-16). Данные LED_IN приходят с выхода
  последнего LED панели (уровень 5 В), поэтому деки и панель работают на одном уровне.
- IDC-32 (2×16) к CORE-1: SPI1 (SCK, MOSI), LCD_CS/DC/RST/BL, SPI0 SCK/MISO,
  HC165_PL, LED_DATA, I2C0 SDA/SCL (для deck), 3V3, 5V, GND.

### 6.2 Интерфейс deck (IDC-16, 2×8)

| Pin | Сигнал | Pin | Сигнал |
|---|---|---|---|
| 1 | 3V3 | 2 | GND |
| 3 | SDA (I2C0) | 4 | SCL (I2C0) |
| 5 | INT (MCP23017) | 6 | GND |
| 7 | LED_IN (WS2812) | 8 | GND |
| 9 | SL1 (аналог) | 10 | GND |
| 11 | SL2 (аналог) | 12 | GND |
| 13 | DECK_ID (аналог) | 14 | GND |
| 15 | FSR (аналог, опция) | 16 | **+5V** (питание LED-цепочек деки) |

- DECK_ID: делитель 3V3 — DECK_PAD = 0.30 В (**33 k / 3.3 k**), DECK_KEYS = 3.00 В (**3.3 k / 33 k**),
  читается ADC GP27 (±0.15 В допуск).
- MCP23017 адрес 0x20 (дека) / 0x21 (резерв).
- SL1/SL2 → MCP3208 CH0/CH1 (через шлейф PANEL-1, RC 1 k/100 nF).
- FSR → MCP3208 CH6; на DECK-PAD 18 FSR через 2 × 74HC4067 (EN и S0…S3 от MCP23017).

### 6.3 DECK-PAD

- 18 × тактовая кнопка 12×12×5 (THT), 18 × WS2812B-2020, 2 × слайдер 30 мм (10 kΩ на 3.3 В).
- FSR-опция: 18 посадочных мест под FSR-плёнку + 2 × 74HC4067 (32 канала).
- 4 отверстия M3, разъём IDC-16 в правом заднем углу (ответная часть).
- Занимает 42 из 48 бит 74HC165? **Нет:** пэды читаются через MCP23017 (16 I/O)
  матрицей 3×6 (3 выхода, 6 входов), а не через HC165 — так меньше проводов.
  HC165 PANEL-1 обслуживает только энкодеры/кнопки.

### 6.4 DECK-KEYS

- 42 гнезда Kailh Choc (hot-swap), диоды 1N4148 (матрица 6 строк × 7 столбцов = 42).
- 42 × SK6812MINI-E, цепочка в общий LED-поток после LED_IN.
- 2 × слайдер 30 мм в центральной зоне, 2 индикатора режима.
- MCP23017 (0x20) — матрица и сканирование, INT на PANEL-1.
- Колпачки (MBK-подобные) печатаются; шаг 18 × 17 мм.

## 7. Шина Bukifon Bus — 26 pin (2×13 IDC, 2.54 мм)

Три порта: PORT0 = верхний док, PORT1 = внутренний слот A, PORT2 = слот B / нижний док.

| Pin | Сигнал | Направление | Уровень |
|---|---|---|---|
| 1 | +12V | питание | 12 В |
| 2 | GND | | |
| 3 | -12V | питание | −12 В |
| 4 | GND | | |
| 5 | +5V | питание | 5 В |
| 6 | GND | | |
| 7 | +3V3 | питание | 3.3 В, ≤ 100 мА на порт |
| 8 | GND | | |
| 9 | CV1 | core → module | 0…10 В |
| 10 | GND | | |
| 11 | CV2 | core → module | 0…10 В |
| 12 | GND | | |
| 13 | CV3 | core → module | 0…10 В |
| 14 | GND | | |
| 15 | CV4 | core → module | 0…10 В |
| 16 | GND | | |
| 17 | GATE1 | core → module | 0/5 В |
| 18 | GATE2 | core → module | 0/5 В |
| 19 | AUD_IN | core → module | ±5 В, AC |
| 20 | AUD_OUT | module → core | ±5 В, AC |
| 21 | SDA | I2C0 | 3.3 В |
| 22 | SCL | I2C0 | 3.3 В |
| 23 | SCK | SPI0 | 3.3 В |
| 24 | MOSI | SPI0 | 3.3 В |
| 25 | MISO | SPI0 | 3.3 В |
| 26 | CS | core → module | активный низкий, отдельный на порт |

Требования к модулю:
1. Вилка IDC-26, шлейф ≤ 15 см.
2. Потребление: +12 В ≤ 60 мА, −12 В ≤ 40 мА, +5 В ≤ 150 мА, +3V3 ≤ 100 мА.
3. EEPROM 24C02/24C32 на I2C по адресу **0x50 + номер порта** (перемычки):
   первые 32 байта — дескриптор (см. `40-firmware.md`).
4. Аудио — только AC; постоянка на шину запрещена.
5. MISO — только при CS = 0 (или буфер).

## 8. Разъёмы CORE-1

| Обозначение | Тип | Назначение |
|---|---|---|
| P0 | IDC-26 вилка (на верхнюю панель, шлейф) | верхний док |
| P1, P2 | IDC-26 вилка вниз | внутренние слоты / нижний док |
| J-PANEL | IDC-32 (2×16) | PANEL-1 |
| J-DECK | IDC-16 (2×8) на PANEL-1 | сменный deck |
| J-MIDI-IN/OUT | TRS 3.5 мм Type A | MIDI |
| J-LINE | 3.5 мм стерео | LINE OUT |
| J-PHONES | 3.5 мм стерео | наушники |
| J-CVOUT1/2 | 3.5 мм моно | CV OUT |
| J-CVIN1/2 | 3.5 мм моно | CV IN |
| J-GATE1/2 | 3.5 мм моно | GATE OUT |
| J-DC | 5.5/2.1 мм | 12 В |
| J-PWR-SW | тумблер | питание |
| HDR-EXT | 1×3 | SWD |

**Разъёмы для джеков — панельные, к CORE-1 подключаются проводами через клеммники
2×12 (3.81 мм).** Это важно: корпус разбирается, плата не висит на разъёмах.

### 8a. Механические вырезы печатных плат (согласовано с механикой)

Вырезы не несут меди, не влияют на ERC/netlist, но обязательны при разводке PCB.

| Плата | Вырезы | Координаты (в системе платы, от левого нижнего угла, мм) |
|---|---|---|
| CORE-1 (200×108) | 2 × Ø6.4 | (79.5, 75.5) и (120.5, 75.5) — проход стоек слайдеров SL1/SL2 |
| PANEL-1 (300×132) | 4 × Ø6.2 | (4.5, 33.5), (132.5, 8.5), (167.5, 8.5), (295.5, 33.5) — стойки панельных пластин |
| PANEL-1 (300×132) | вырез под DECK | 290 × 74 мм: X 300−290, Y 58…132 (см. мех. fit_check §4) |
| DECK (290×78) | 4 × Ø6.2 | (75.5, 73.5), (112.5, 73.5), (177.5, 73.5), (214.5, 73.5) — стойки деки |

Допуск отверстий +0.3 мм; вокруг вырезов keep-out без меди 1 мм.

## 9. Задняя стенка (для механики)

330 → фактическая ширина 315, высота 48, полезная зона 250 × 40 (X 32…282).
Координаты X от левого края, Y (Z) от низа.

| Элемент | X | Z | Ø/размер |
|---|---|---|---|
| J-DC | 40 | 15 | 9.0 |
| J-PWR-SW | 40 | 33 | 13 × 10 |
| USB-C DATA (Pico) | 62 | 24 | 12 × 7 (R2) |
| USB-C CHARGE (v1.1) | 210 | 24 | 12 × 7 (R2) |
| RESET | 78 | 24 | 6.0 |
| J-LINE | 92 | 15 | 6.0 |
| J-PHONES | 92 | 33 | 6.0 |
| J-MIDI-IN | 110 | 15 | 6.0 |
| J-MIDI-OUT | 110 | 33 | 6.0 |
| J-CVOUT1/2 | 128, 142 | 15 | 6.0 |
| J-CVIN1/2 | 128, 142 | 33 | 6.0 |
| J-GATE1/2 | 156, 170 | 15 | 6.0 |
| MASTER VOL | 188 | 24 | 7.2 |
| Окно PORT0 (верх док) | 157.5 | верх | 36 × 10 на верхней панели |
| Окно PORT2 (низ док) | 157.5 | низ | 36 × 10 на дне |

## 10. Кабели

| Кабель | Кол-во | Длина |
|---|---|---|
| IDC-26 мама-мама | 3 | 12 см |
| IDC-32 мама-мама | 1 | 15 см |
| IDC-16 мама-мама (deck) | 2 | 10 см |
| Шлейф экрана 1×14 | 1 | 10 см |

## 11. Чек-лист CORE-1 для ERC

- [ ] Pico-посадочное место (2×20 кастеляция + гребёнки), маркировка.
- [ ] Питание: F1, TVS, SS34, MP1584, AP2112, MC34063, 4 рельса.
- [ ] PCM5102A + RC + развязка.
- [ ] 2 × MCP4728 (0x60/0x61) + 6 каналов буфера TL074 + защита.
- [ ] MCP3208 + 6 входных цепей.
- [ ] TL074 сумматор + TL072 буфер + MASTER VOL.
- [ ] MIDI IN 6N137, MIDI OUT 74HCT125.
- [ ] 24C32.
- [ ] P0/P1/P2 IDC-26, J-PANEL IDC-32, клеммники джеков.
- [ ] 2 × 2N7000 (гейты), 2N7002 (подсветка), LED_DATA с резистором 330 Ω.
- [ ] Разъём deck IDC-16, INT/FSR/SL1/SL2/DECK_ID.
- [ ] PANEL-1: 6 × 74HC165, 4 плечевых, разъём экрана, разъём деки.
- [ ] AGND/DGND/PGND, одна точка соединения.
