martiyanov/bukifon/spec/40-firmware.md

# 40. Прошивка: контракт, API модулей, тесты

Контракт для `firmware-dsp`. Язык — C++17, среда — **arduino-pico** (Raspberry Pi Pico,
RP2040, 2 ядра), альтернативная сборка — Pico SDK. Прошивка **GPL-3.0-or-later**.

---

## 1. Разделение по ядрам

| Ядро | Задача | Частота |
|---|---|---|
| core0 | UI, энкодеры, пэды/клавиши, экран, меню, MIDI-парсер, CV-логика, секвенсор | цикл ~1 кГц |
| core1 | аудио-движок: генерация, фильтры, огибающие, эффекты, микшер, I2S DMA | 48 кГц, блок 128/256 сэмплов |

- I2S через PIO (BCK GP16, LRCK GP17, DIN GP18), DMA double-buffer, 16 бит.
- Архитектура — **4 части (track/part)**, как у Kaleidoscope: у каждой свой тембр, свой
  секвенсор и свои маршруты модуляции. Полифония общая: 8 голосов распределяются
  между частями динамически (настраиваемое распределение 8/0/0/0 … 2/2/2/2).
- Итоговый звук — 24 бит внутри, 16 бит на PCM5102A, dither + мягкий лимитер.
- Обмен между ядрами — lock-free SPSC-очереди (параметры UI→аудио, счётчики аудио→UI).
- Вся работа с I2C/SPI — только на core0 (аудио не блокируется).

## 2. Аудио-движок: 4 части × 2 осциллятора, FM 4-op, аналоговые модели

### 2.1 Осцилляторы и синтез
- 2 осциллятора на голос: wavetable (8 таблиц × 2048 × 8 mip-уровней) + **4-операторный FM**
  (8 алгоритмов в духе Digitone, ratios 0.5…32, уровни, feedback на оператор).
- Additive/waveshaper/wavefolder/hardsync/ring-mod — по одному режиму на осциллятор.
- Sub-осциллятор, noise, unison до 4 голосов с detune/spread.
- Anti-aliasing: 2× oversampling FM-ядра + mip-таблицы; проверка «алиасинг < −60 дБ».
- Фильтры: ZDF SVF (LP/BP/HP/Notch, 12/24 дБ) + **модель лестничного фильтра Муга**
  (4-полюсный ZDF-ladder с насыщением и drive) — выбор характера на каждую часть.
- **Polyvox-характер**: цифровая модель «Поливокса» — фильтр с формантным резонансом +
  трёхголосный ensemble/BBD-хорус, включённый после фильтра (параметр CHARACTER 0…100 %
  и отдельный режим POLYVOX). Настоящий аналог — через модули шины LADDER-1/ENSEMBLE-1
  (звук уходит на AUD_IN и возвращается в AUD_OUT, задержка компенсируется).
- Шум/драйв/биткраш — на часть.

### 2.2 Огибающие и LFO
- 4 огибающих на часть: **ADSR + режим function generator** (loop / one-shot / гейт,
  кривые лог/лин/эксп, время 0.5 мс…20 с, ретриггер, keytrack).
- 4 LFO: 8 форм, free/sync/retrig/keytrack, диапазон до **аудио-рейта** (0.02 Гц…2 кГц),
  сглаживание, фаза, фейд-ин.
- 2 random/S&H (Smooth/Random), 2 циклич. модулятора (шаг-модулятор 8 шагов).

### 2.3 3D-мод-матрица (главная фишка Kaleidoscope)
- **16 слотов** модуляции; каждый: [источник] → [цель] → [глубина −100…+100] → [кривая] →
  [часть-получатель] → [условие].
- Источники: 4 огибающих, 4 LFO, random, velocity, aftertouch, keytrack, CV1…4, MIDI CC,
  секвенсорные дорожки, **другие слоты матрицы** (модуляция модуляции), выходы частей.
- Цели: **любой параметр любого голоса/части**, включая **время и кривую огибающих,
  частоту LFO, глубину других слотов, шаговый режим секвенсора, параметры FX**.
- Разрешены **кросс-части и обратные связи** (отрицательная — стабилизация, положительная —
  хаос); глубина ограничивается и сглаживается, чтобы не было клиппинга/разгона.
- Слоты можно назначать на панель (8 энкодеров + 4 макро) и сохранять в патч.
- Экран показывает **фактическое (модулированное) значение** параметра — как в Kaleidoscope.

### 2.4 Голоса и CPU
- 8 голосов суммарно; бюджет ≤ 75 % core1 при 8 голосах + 2 эффектах.
- При перегрузке — приоритет: голоса с меньшим временем жизни, плавное затухание.

## 3. MIDI

- USB-MIDI (TinyUSB) + TRS UART (31250).
- Каналы 1…16, MPE-lite (канал-на-голос, pitch bend per channel), aftertouch (poly).
- CC-learn: энкодеры назначаются на CC из меню.
- Clock: master/slave (24 ppqn), Start/Stop/Continue.
- SysEx: дамп патча (≤ 512 байт), запрос версии.

## 4. Ввод: deck, энкодеры, кнопки

- **Автоопределение deck** через DECK_ID (GP27): DECK_PAD (0…0.5 В) / DECK_KEYS (2.8…3.3 В).
  Цепочка WS2812: 9 LED панели + 18 (PAD) или 42 (KEYS) LED деки = 27 или 51.
- **DECK-PAD**: 18 пэдов через MCP23017 (матрица 3×6, активный низкий, антидребезг 5 мс),
  velocity — опция FSR (MCP3208 CH6 через 2×74HC4067): velocity = f(нарастание силы);
  без FSR — fixed 127.
- **DECK-KEYS**: 42 клавиши через MCP23017 (матрица 6×7 + диоды), антидребезг 3 мс,
  раскладка изоморфная (по умолчанию — хроматика от C3, 3.5 октавы), слой SHIFT меняет
  назначение (ноты/аккорды/шаги секвенсора).
- **Энкодеры**: квадратурное декодирование с ускорением (1/2/4/8 шагов в зависимости
  от скорости), 6×74HC165 (SPI0, CS GP6/PL), чтение 20 кГц.
- **Слайдеры**: 12 бит через MCP3208, фильтр скользящего среднего, дед-зона 2 LSB.
- **Плечевые**: L1/L2 — октава, R1 — SHIFT, R2 — PLAY/STOP.

## 5. CV / GATE

- MCP4728 #1 (0x60): CH A…D — CV1…CV4 на шину; MCP4728 #2 (0x61): CH A/B — джеки CV OUT 1/2.
  Обновление 1 кГц,
  4-точечная калибровка (0/25/50/100 %) в EEPROM 24C32, вывод в вольтах.
- MCP3208: CH0/CH1 — слайдеры, CH2/CH3 — CV IN 1/2 (джеки), CH4/CH5 — резерв,
  CH6 — FSR/velocity, CH7 — SYS_MON. CV-возврата с шины нет (все 4 линии CV — выходы).
- CV→параметр: назначаемые маршруты 1V/oct с квантованием, фильтрация 100 Гц.
- GATE1/2 — 2N7000, длительность/задержка настраиваются, режим «clock out».

## 6. Секвенсор: Elektron-воркфлоу + генеративный движок

### 6.1 Электрон-механика (обязательно)
- 16 шагов × **4 дорожки** (по одной на часть), длина дорожки независима (1…16),
  скорость 1/1…1/8, swing 0…70 %, микротайминг ± 1/16 шага.
- **Параметр-локи (plocks)** на шаг: любой параметр части, до 8 локов на шаг;
  **sound-locks**: шаг может играть другой пресет (как в Digitakt/Digitone).
- **Условия триггера**: 1st, not-1st, fill, !fill, A:B (1:2…8:8), проценты 0…100 %.
- **Performance-макросы** 4 шт., каждый → до 8 целей со своей кривой; отдельный экран.
- **Ctrl-all**: удержание R1 — изменение параметра во всех частях одновременно.
- Живая запись, пошаговая запись, copy/paste шага/паттерна, undo (1 уровень), квантайз.
- Паттерны: 8 на проект, цепочка паттернов до 16, сохранение в патч.
- Арпеджиатор на часть: up/down/updown/random, октавы 1…4, gate, latch, свой режим
  plocks (арп сам может быть модулирован матрицей).

### 6.2 Генеративный слой (из Kaleidoscope)
- Каждая дорожка имеет **функциональный «шаговый модулятор»**: 8 шагов, значениями
  которых могут быть константы, функции (синус/пила/шум/рамп), результаты других
  модуляторов и **огибающие в режиме loop**.
- **Параметрическая ритмика**: вероятность триггера, «динамические» условия
  (например, каждый 2-й проход по диапазону), ратио-паттерны.
- Генеративный слой работает поверх обычного секвенсора и не конфликтует с MIDI-клоком
  и внешним секвенсором (как в Kaleidoscope).

## 7. Пресеты и хранение

- 64 патча в файловой системе LittleFS (flash) + RAM-кэш.
- 24C32: калибровка CV, DECK_ID-калибровка, таблица модулей, счётчик часов.
- Формат патча — структура ≤ 512 байт, версия, CRC16; совместимость с SysEx.
- Фабричный банк (16 патчей) вкомпилирован.

## 8. API модулей (аппаратных, шина)

Модуль обязан иметь EEPROM 24C02/24C32 по адресу **0x50 + номер порта**.
Первые 32 байта — дескриптор:

| Смещение | Поле |
|---|---|
| 0 | magic `'P','M','O','D'` |
| 4 | transport: 0 = аналоговый, 1 = I2C-управляемый, 2 = SPI |
| 5 | kind: 1 VCO, 2 VCF, 3 VCA, 4 LFO, 5 FX, 6 секвенсор, 0xFF свой |
| 6 | params (0…16) |
| 7 | version |
| 8…23 | name (16 байт ASCII) |
| 24…27 | CV-маршруты (4 байта: 0=нет, 1=CV1…4 на вход модуля) |
| 28…29 | макс. ток по +12 В, мА / 10 |
| 30…31 | CRC16 |

Поведение:
- при старте и по горячему подключению (GP21-22 мониторинг) сканируются 3 порта;
- для transport=1 (I2C) прошивка шлёт `SET_PARAM(index, value)` по адресу модуля;
- для аналоговых — модуль показывается в меню страницы MODULES как «пассивный»,
  с подсказкой, какие CV/гейты к нему приходят;
- ошибки/отсутствие EEPROM — порт показывается как «пусто», без блокировки аудио.

## 9. Программные модули (API)

```cpp
struct IModule {
  virtual const char* name() const = 0;
  virtual void process(float* l, float* r, size_t n) = 0;   // для FX
  virtual void tick() {}                                     // 1 кГц, для UI-модулей
};
// реестр: MOD_REGISTER(MyFx); — сборка списка через X-macro
```
- Типы: `IOscillator`, `IFilter`, `IEffect`, `IModulator`, `ISequencer`.
- Регистрация статическая (нет динамической загрузки на RP2040): модули включаются
  в сборку, доступны в меню.
- Внешние (I2C) модули — через `HwModuleProxy` (обёртка над дескриптором).

## 10. Структура репозитория `firmware/`

```
firmware/
  Букифон/                Arduino-скетч (main.cpp + build)
    Bukifon.ino
    platformio.ini        (env: pico; core: arduino-pico)
  src/
    audio/                движок (портируемый C++, без Arduino-зависимостей)
    dsp/                  таблицы, фильтры, осцилляторы
    ui/                   меню, страницы, отрисовка
    io/                   encoders, deck, cv, midi, leds
    modules/              программные модули + реестр
    storage/              presets, eeprom
  host/                   native-сборка (g++/cmake) для тестов
  tests/                  unit + render-тесты
  tools/                  render_wav, fft_report
```

## 11. Тесты (обязательны)

1. **Host-сборка** `firmware/host` — `g++ -std=c++17 -O2` без Arduino-зависимостей,
   движок компилируется и рендерит 5 с WAV.
2. **FFT-проверка**: нота A4 = 440 Гц ± 0.1 %; в спектре нет побочных выше −60 дБ
   (алиасинг) в полосе до 20 кГц; тест 8 голосов; тест FM-алгоритмов (8 шт.) на
   отсутствие субгармоник/артефактов; тест ladder-модели на устойчивость при res=100 %.
3. **Огибающие**: ADSR-тайминги ± 2 %; проверка клика на краях (± 1 сэмпл);
   loop-режим без разрывов; модуляция времени огибающей другим модулятором.
   **Тест матрицы**: 16 слотов, кросс-части и обратная связь — выход конечен, без NaN/клиппинга.
   **Тест секвенсора**: plocks/условия/микротайминг/MIDI-клок — unit-тесты.
4. **MIDI-парсер**: unit-тесты на note on/off, CC, pitch bend, SysEx dump.
5. **Прошивка компилируется** для RP2040 (PlatformIO/arduino-cli). Если инструменты
   недоступны — `host`-сборка + скрипт `firmware/tools/build_pico.sh` с инструкцией.
6. Отчёт `firmware/tests/REPORT.md` с числами.

## 12. Что получает `firmware-dsp`

- `spec/10-panel-ui.md` — имена и раскладка.
- `spec/20-electronics.md` — карта пинов, цепи, deck-интерфейс.
- `spec/30-mechanics.md` — только для понимания ограничений корпуса.
- Запрещено менять `spec/`; расхождения — сообщать Lead.
