martiyanov/bukifon/spec/50-v1.1.md

# 50. Версия 1.1: аккумулятор, USB-C, расширенные входы/выходы, вариант «A5»

Заказчик добавил требования (05.11.2025):
1. **встроенный аккумулятор**;
2. **различные входы и выходы**, CV, **MIDI по USB-C**;
3. второй эскиз `refs/sketch2-folded-a4.jpg` — **свёрнутый лист A4** (формат A5, 210 × 148):
   компактный настольный вариант.

Этот файл фиксирует решения и объём доработки. Артефакты v1.0 (handheld 315×145)
остаются в силе; ниже — что добавляется.

---

## 1. Питание с аккумулятором (PWR-BATT-1)

**Топология:** батарейный блок подаёт **12 В** на вход J-DC синтезатора — тогда вся
существующая цепочка CORE-1 (MP1584 5.1 В, AP2112K 3.3 В, MC34063 −12 В) работает
без переделки; при подключённом внешнем БП батарея заряжается и не разряжается
(ideal-diode / MOSFET-OR).

```
USB-C (заряд 5 В) ── USBLC6-2SC6 ── TP4056 (1 А) ── 1S2P 18650 (3.6 В, 5000–7000 мА·ч)
                                                        │ BMS DW01+FS312F / готовый 1S BMS
                                                        ▼
                              MT3608 (boost 12.2 В, 2 А) ── ideal-diode ──► 12V (J-DC)
J-DC 12 В (внешний БП) ── SS34 ──────────────────────────────┘ (приоритет внешнего)
```

| Параметр | Значение |
|---|---|
| Батарея | 1S2P Li-ion 18650: 3.6 В номинально, 4.2 В максимум, 2.8 В отсечка BMS |
| Ёмкость | 5000–7000 мА·ч ≈ 18–25 Вт·ч |
| Заряд | USB-C 5 В, TP4056 1 А (полный заряд ~5–7 ч) |
| Повышение | MT3608 до 12.2 В, 2 А (пиковая), КПД ≈ 88 % |
| Защита | BMS: перезаряд/переразряд/КЗ/перегрузка; термистор; предохранитель 3 А |
| Индикация | 2 светодиода заряда + напряжение батареи на ADC (CH4/CH5 MCP3208) |
| Разъёмы | USB-C «CHARGE» (5 В), выход на J-DC (12 В) |

**Расчёт времени работы** (КПД boost 0.88, глубина разряда 80 %):

| Режим | Потребление 12 В | Вт | Время (21 Вт·ч) |
|---|---|---|---|
| Тихо, 2 аналоговых модуля, экран 30 % | 0.10 А | 1.2 Вт + 5 В 0.25 А → ≈ 2.5 Вт | **≈ 6.0 ч** |
| Обычная игра, 3 модуля, LED 30 % | 0.18 А | ≈ 4.2 Вт | **≈ 3.5 ч** |
| Максимум (4 модуля, все LED, наушники) | 0.40 А | ≈ 7.5 Вт | **≈ 2.0 ч** |
| Заряд + игра одновременно | — | внешний БП 12 В 2 А | не ограничено |

**Решение по месту (05.11.2025, после проверки fit_check):** батарея 2×18650 с
холдером (68 × 40 × 21 мм) не влезает в брюшной отсек Z 0…8. Принят **вариант A —
«батарейная спина»**: на дне, между рукоятками, печатается выступ 150 × 62 мм,
выступающий на 16 мм ниже дна (общая толщина 48 + 16 = 64 мм в центре), с
закруглением R8 и крышкой `battery_hatch` на 4 винта M3. Это эргономично
(подушечка под пальцы при хвате двумя руками), не требует редизайна рукояток,
и сохраняет оба внутренних слота шины. Нижний док PORT2 при этом переносится
на верхнюю кромку (рядом с PORT0) — см. спеку 20 §8 (уточнение для мех. v1.1).
Ориентировочно: `bottom_L/R` +8…16 мм по Z в центральной зоне, `battery_hatch`,
2 стойки, 6 отверстий M3.

**Безопасность:** только качественные 18650 с защитой; не заряжать при <0 °C;
не оставлять на солнце; при набухании — утилизировать; BMS ставится до батарейного
холдера; предохранитель по выходу.

### 1a. Принятые решения по PWR-BATT-1 (после схемы)

- Схема `hardware/power/PWR-BATT-1.kicad_sch` (55 компонентов, ERC 0 ошибок / 1
  предупреждение): USB-C 16P (CC 5.1k UFP, USBLC6-2SC6, полифьюз 1.1 А) → TP4056 →
  BMS 1S 2P → MT3608 (L 22 мкГн, SS34, ОС 91k/4.7k = 12.22 В) → J-DC CORE-1.
  Приоритет внешнего питания аппаратный (диод ИЛИ + EXT_DET → EN буста).
- **Встройка — вариант A** (см. §1): батарейная спина 150 × 62 × 16 мм.
- **Второй USB-C (CHARGE)** — задняя стенка, X = 210, Z = 24, 12 × 7 (правка
  `rear_plate`); USB-C DATA — существующий разъём Pico.
- **CORE-1 rev.2:** снять притяжки MCP3208 CH4/CH5 к AGND (DNP), добавить
  `J-BATT-MON` 1×3 (CH4 = BAT_ADC 100k/47k, CH5 = TEMP_ADC NTC/2, AGND).
  Без этой правки контроль батареи некуда вывести (все GPIO заняты).
- **Прошивка v1.1:** кривая Li-ion → %, индикация заряда, ограничение яркости LED
  на батарее, запрет «3 модуля на батарее» (MT3608 не вытянет), сигнал EXT_DET.

## 2. USB-C MIDI и данные

- **USB-C #1 (DATA/MIDI):** разъём Pico выведен на заднюю стенку; USB-MIDI class
  (TinyUSB), 16 каналов, MPE-lite; одновременно USB-питание/зарядка (Pico) и
  передача SysEx (дамп патчей).
- **USB-C #2 (CHARGE):** только питание TP4056, без данных; маркировка на корпусе.
- TRS MIDI IN/OUT (Type A) сохраняются — работают одновременно с USB.

## 3. Расширенные входы и выходы

| Разъём | Тип | Что даёт |
|---|---|---|
| CV OUT 1…2 | TS 3.5 мм | 0…10 В, калибровка |
| CV IN 1…2 | TS 3.5 мм | ±10 В, инверт. аттенюатор со сдвигом |
| GATE OUT 1…2 | TS 3.5 мм | 0/5 В |
| **AUDIO IN L/R** (v1.1) | TS 3.5 мм ×2 или стерео | внешний звук в цифровой тракт (FX, вокодер-лайт) — **PCM1808** (I2S ADC, 24 бит/96 кГц) на CORE-1B |
| **EXPRESSION / SUSTAIN** (v1.1) | TRS 6.35 мм | педаль экспрессии → MCP3208 CH4 (сейчас резерв) |
| PHONES | 3.5 мм стерео | TPA6132 или буфер TL072 |
| LINE OUT | 3.5 мм стерео + 6.35 мм моно | мастер-микс |
| MIDI IN / OUT | TRS 3.5 мм Type A | + USB-C MIDI |
| DC 12 В | 5.5/2.1 | внешний БП / заряд |
| **USB-C CHARGE** | USB-C | заряд батареи |

Прошивка: PCM1808 добавляет I2S-вход (второй PIO-стрим или тот же PIO), EXPRESSION —
4-я CV-ось в мод-матрице, USB-C MIDI уже поддержан. Отражено в `spec/40-firmware.md`
как v1.1-расширение (не ломает v1.0).

## 4. Вариант B: компактный корпус «A5» (свёрнутый A4)

Формат 210 × 148 × 40 мм (рукоятки/скос — по желанию), **настольный**, батарея 1S2P
внутри. Раскладка по второму эскизу: 16 ручек (8 + 8), экран в центре в обрамлении
8 маленьких кнопок (4 + 4), 2 слайдера в центре, две группы 3×3 пэдов.

Координаты панели (X вправо 0…210, Y к себе 0…148):

| Элемент | Координаты | Примечание |
|---|---|---|
| Ручки ENC1…8 (левая группа) | x = 10, 27, 44, 61; y = 14, 34 | Ø11 мм, шаг 17 |
| Ручки ENC9…16 (правая группа) | x = 149, 166, 183, 200; y = 14, 34 | зеркально |
| Экран 2.8" (окно 54 × 42) | центр (105, 30) | x 78…132, y 9…51 |
| Кнопки у экрана BTN1…4 | x = 73; y = 12, 24, 36, 48 | 9 × 9 мм |
| Кнопки у экрана BTN5…8 | x = 137; y = 12, 24, 36, 48 | зеркально |
| Слайдеры SL1/SL2 | x = 94 / 116; ход y 92…122 | 30 мм |
| Пэды PAD1…9 | x = 16, 35, 54; y = 90, 109, 128 | 16 × 16, шаг 19 |
| Пэды PAD10…18 | x = 156, 175, 194; y = 90, 109, 128 | зеркально |
| STATUS RGB | (105, 66) | |
| Задняя стенка | 210 × 40 | DC, USB-C ×2, MIDI TRS ×2, CV/GATE, LINE, PHONES, AUDIO IN, EXPR |

Черновая визуализация: `renders/variantB_panel.png` (генерируется
`tools/panel_layout.py --variant-b`).

**Что нужно доработать для варианта B:**
- **PANEL-1B** — новая плата панели ~200 × 110 мм (16 энкодеров, 6×(74HC165) или
  8×(MCP23017), 8 кнопок, экран, 18 пэдов, LED); схема — переиспользовать блоки
  `hardware/panel/`, переразвести.
- **CORE-1B** — та же архитектура + PCM1808 (audio in) + батарейный разъём/гейт;
  корпус без рукояток, толщина 40 мм.
- **Корпус B** — 210 × 148 × 40, печать на любой 220-принтер в 2 половинах,
  отсек 2×18650, батарейный люк.
- Прошивка: без изменений ядра, добавить страницу «16 параметров» и Audio In.

## 5. Статус и порядок работ

| Узел | v1.0 (handheld 315×145) | v1.1 |
|---|---|---|
| CORE-1 | готово (ERC 0/0) | CORE-1B: + PCM1808, + батарейное питание |
| PANEL-1 / деки | готово (ERC 0/0) | PANEL-1B для варианта B |
| Корпус | готово (STL, 20 деталей) | отсек батареи + USB-C CHARGE; вариант B |
| PWR-BATT-1 | — | **в работе** (`hardware/power/`) |
| Прошивка | host-тесты 67/67 | + audio-in, + педаль, + индикация заряда |
| BOM | `BOM.csv` (97 поз.) | + батарея, TP4056, MT3608, BMS, USB-C, PCM1808 |

Обновление BOM под 2×MCP4728 и батарею — отдельный патч (`docs/BOM.md`, `BOM.csv`).
