martiyanov/bukifon/hardware/core2/dfm.md

# CORE-2 (P4) — DFM / testability (до разводки PCB)

> **STATUS: PRE-FREEZE / DO NOT FABRICATE.** Документ фиксирует требования к тестопригодности,
> серийному номеру, recovery и DFM **до** разводки CORE-2 rev.2 (P4-ветка — главная).
> Основание: `docs/36-rc-definition.md` §2 (критерии приёмки) и §4.4 (DFM до разводки),
> `docs/38-dfm-testability.md`. Платы не заказывать до P1-стенда и подписи реестра.

## 1. Test points (≤30; доступ после сборки)

TP1…TP32 — все в `CORE-2.kicad_sch` (TP28–TP30: LED_RET/I2S_BCK/I2S_LRCK; TP31/TP32:
MIC_DATA/MIC_BCK — mic D-91); остальные сигналы доступны на разъёмах/падах компонентов.
BOOT/RESET/UART0 — TP17/TP18 + J4 (UART0 TP), отдельных падов не требуют.

| # | TP | Цепь | Где / доступ | Назначение |
|---:|---|---|---|---|
| 1 | TP1 | `VBUS_CHG` | USB-C вход, пад 1.5 мм | заряд/питание USB |
| 2 | TP2 | `VSYS` | выход BQ24074, пад | power-path, battery |
| 3 | TP3 | `12V` | после D2 (12V_EXT→+12 В) | шина +12 В |
| 4 | TP4 | `-12V` | после D19 (N12_EXT→−12 В) | шина −12 В |
| 5 | TP5 | `5V` | +5 В (PWR-2 J17, после FB7) | логика/аудио 5 В |
| 6 | TP6 | `3V3` | +3V3 AP2112K | периферия/аудио |
| 7 | TP7 | `3V3_MCU` | MP1584 выход | P4/PSRAM (706 мА) |
| 8 | TP8 | `BATT_MON` | делитель R75/R76 | контроль VBAT |
| 9 | TP9 | `I2S_MCLK` | 12.288 МГц | аудио-клок |
| 10 | TP10 | `SD_CLK` | SDIO CLK | SD |
| 11 | TP11 | `USB_HS_DP` | USB HS D+ (A1.6) | USB HS |
| 12 | TP12 | `USB_HS_DM` | USB HS D− (A1.7) | USB HS |
| 13 | TP13 | `AGND` | аналоговая земля | опора измерений |
| 14 | TP14 | `DGND` | цифровая земля | опора |
| 15 | TP15 | `PGND` | силовая земля | опора |
| 16 | TP16 | `LED_DATA` | после 74HCT1G125 | цепочка WS2812 |
| 17 | TP17 | `CHIP_PU` | reset P4 | BOOT/JTAG |
| 18 | TP18 | `BOOT` | GPIO35 strap | download boot |
| 19 | TP19 | `3V3_C6` | LDO C6 | Wi-Fi/BLE C6 |
| 20 | TP20 | `BL_20V` | MT3608 #3 выход | подсветка (осторожно, 20 В) |
| 21 | TP21 | `C6_CS` | SPI2 CS1 | линк C6 |
| 22 | TP22 | `C6_RST` | reset C6 | линк C6 |
| 23 | TP23 | `N12_EXT` | вход −12 В с PWR-2 | protection D19/D20 |
| 24 | TP24 | `5V_EXT` | вход +5 В с PWR-2 | protection FB7/C117 |
| 25 | TP25 | `5V_LED` | вход 5V_LED с PWR-2 | LED-ветвь |
| 26 | TP26 | `PWR_GOOD` | J18.6, open-drain | VSYS<2.70 В |
| 27 | TP27 | `EN_RAILS` | J16.15 → J18.7/8/10 | EN +12/−12/+5 |
| 28 | TP28 | `LED_RET` | J16.16 → J18.18 | возврат LED (Q7 PWR-2) |
| 29 | TP29 | `I2S_BCK` | пад у PCM5102A/PCM1808 | аудио BCK |
| 30 | TP30 | `I2S_LRCK` | пад у кодека | аудио LRCK |
| 31 | TP31 | `MIC_DATA` | J19.5 / пад | MEMS I2S1 data (D-91) |
| 32 | TP32 | `MIC_BCK` | J19.1 / пад | MEMS I2S1 bit clock (D-91) |

Групповой доступ (не отдельные TP): I2C — J16.1/3 и J18.3/4; SPI2 — J16?/U40 пады + C6 (TP21);
CV OUT1-4/CV IN1-4/GATE — J14; MIDI — J6/J7; SDIO D0-D3/CMD — пады J5; UART0 — J4 (TX/RX/GND);
C6 SPI — TP21/22 + U31; PWR-2 EN/I2C/гейдж — J18.

**Правила:** TP не под разъёмом/шлейфом; пад ≥1.5 мм, маска открыта, шелкография `TPn` + цепь;
TP на 20 В (TP20) — только с предупреждением и щупом 100:1; все TP доступны после сборки
(верх/низ платы с учётом корпуса, docs/21 — 6×M3, задняя крышка).

## 2. Self-test 20 + mic (21) (прошивка + производственный тест)

| # | Тест | Метод | Pass | Auto (BIST) |
|---:|---|---|---|---|
| 1 | Рельсы | DMM на TP2/3/4/5/6/7/19/23/24/25 + PWR_GOOD | 3.0–4.4 / 11.7±0.3 / −11.55±0.3 / 5.1±0.15 / 3.3±0.1 / 3.3±0.1 / 3.3±0.1 В; PWR_GOOD high | частично (PWR_GOOD/BATT_MON) |
| 2 | I2C-скан | I2C0 400 кГц | адреса 0x57, 0x60, 0x61, 0x20–0x23 (панель), 0x36 (PWR-2) | да |
| 3 | EEPROM 24C32 | чтение/запись 32 байт @0x57 | совпадение, SN читается | да |
| 4 | MCP23017 (панель) | запись/чтение IODIR/GPIO, INT | 4 чипа, INT wire-OR работает | да |
| 5 | MCP4728 ×2 | запись каналов, readback (DAC reg) | 8 каналов, код = запись ±1 LSB | да |
| 6 | MCP3208 | чтение CH0–CH7 при известных входах | код монотонен, шум ≤3 LSB | да |
| 7 | C6 линк | esp-hosted RPC: версия/скан Wi-Fi | ответ <100 мс, версия читается | да |
| 8 | Кодек loopback | LINE OUT → AUDIO IN кабелем, синус 1 кГц | уровень −6…−3 dBFS, SNR ≥80 дБ (THD+N ≤0.05 %) | да |
| 9 | RGB-дисплей | тест-картинка/чекер, BL_PWM | нет битых пикселей/полос, 800×480, ≥15 fps full | частично (визуально) |
| 10 | SDIO | mount, запись/чтение 1 МБ, CRC | CRC ok, latency ≤50 мс, hot-remove без потерь | да |
| 11 | Клавиатура/энкодеры | скан 42×6×7 через MCP23017, 16 энкодеров | все клавиши/шаги, debounce 5–10 мс | да (оператор) |
| 12 | Фейдеры | MCP3208 CH2/3 | 0…3.3 В, шум ≤3 LSB | да |
| 13 | CV OUT1-4 | loopback CV OUT→CV IN, 0/5/10 В | ошибка ≤±0.5 % FS | да (кабель) |
| 14 | CV IN1-4 | калибратор 0/±10 В | код ±1 %, защита TVS не греется | да |
| 15 | GATE OUT/IN | J14.17/19 loopback | 0/5 В, задержка ≤1 мс | да |
| 16 | MAX17048 | I2C 0x36: V, SOC, ALRT | V ±15 мВ от TP8, ALRT | да |
| 17 | NTC/TS | TEMP_MON (MCP3208 CH7), заряд при 25 °C | 10 кОм→код, TS в окне | да |
| 18 | USB HS composite | enumerate Win/macOS/Linux, HID+MIDI+UAC2+CDC | 0 drop/reconnect за 30 мин | да |
| 19 | UART0/BOOT | J4 лог + BOOT strap | лог 115200, download boot | да |
| 20 | Серийник/ревизия | чтение EEPROM, QR на корпусе | SN/rev/date/batch совпадают | да |
| 21 | **Mic (D-91)** | MEMS: I2S1 record 48/24, VAD; electret: MIC_SEL=1, MAX9814 AGC, loopback mic→PCM1808→I2S0; SW3 mute=0 и LED | запись без клиппинга, SNR ≥65 дБ, mute глушит, задержка ≤5 мс | да (оператор) |

## 3. Serialization / traceability

На CORE-2 есть **24C32 (U41, I2C 0x57, 4 КБ)** — используем как основной носитель:
| Offset | Поле | Формат |
|---|---|---|
| 0x000 | magic `BFSN` + версия карты | 4+1 байт |
| 0x008 | SN (10 символов, base32) | 10 байт |
| 0x018 | ревизия платы (rev.2 = 0x02) | 1 байт |
| 0x019 | дата сборки (YYMMDD) | 3 байт |
| 0x01C | batch id | 2 байт |
| 0x020 | калибровка CV DAC (offset/gain ×8 каналов) | 32 байт |
| 0x040 | калибровка AUDIO (bias/уровень) | 16 байт |
| 0x100 | лог производства (тест/оператор/дата) | 64 байт |

Fallback: OTP/eFuse P4 или защищённая flash-зона `nvs` + копия в 24C32; QR/DataMatrix на
корпусе (SN+rev), дублируется на наклейке платы (не под разъёмом). Прошивка читает SN через
I2C при boot, пишет в USB-дескриптор (iSerial) и лог.

## 4. Recovery / bootloader

- **P4 ROM download:** UART0 (J4: GND/TX/RX) + BOOT (GPIO35=0, GPIO36=1 для joint download);
  `esptool`/`idf.py flash`; BOOT-кнопка SW1 и RESET SW2 на плате.
- **USB:** P4 ROM не имеет USB-DFU как S3; recovery — через UART0; в приложении — CDC/DFU-класс
  (esp_tinyusb) для обновления без кнопок; проверить на P1 (открытый пункт).
- **Partition table:** factory + ota_0 + ota_1 + otadata + nvs; `esp_ota_mark_app_valid` rollback;
  safe mode: 3 неудачных boot → factory + подсветка ошибки; watchdog.
- **Что добавить на PCB сейчас:** BOOT/RESET кнопки (есть), UART0 TP J4 (есть), тестпады
  GPIO35/GPIO36, индикатор питания/заряда (есть LED CHG), 2-пин recovery jumper (BOOT→GND) —
  опционально; отдельный JTAG-разъём не нужен (P4 JTAG — через UART0/USB на P1 проверить).
- **Битая прошивка:** ROM не стартует app → UART0 download; OTA rollback; SD/USB hot-remove
  не повреждает проект (журнал/резерв, docs/36 тест 5).

## 5. DFM (CORE-2 rev.2)

- **Стек:** 6 слоёв (RGB/HS USB/DSI), 1.6 мм FR4, 1 oz; min trace/space 0.10/0.10 мм, via 0.2/0.45.
- **Импедансы:** USB HS 90 Ω differential (TP11/12), SDIO 50 Ω, RGB PCLK/data — согласование,
  длина PCLK/DE к FPC ≤40 мм; I2S — экранировать/короткие.
- **FPC-40 (J15):** ориентация pin1 (треугольник), ключ/стоппер, stiffener; под шлейфом нет
  меди/TP; ground fingers; фиксация после сборки.
- **Разъёмы J14/J15/J16/J17/J18:** шелкография pin1/направление, ключ IDC, ответные вилки;
  J17/J18 — силовые пары PGND, при 3 А — альтернатива Micro-Fit 3.0 (O-11).
- **Крепёж:** 6×M3 (3.2 мм отверстия, keepout Ø6 мм, без меди/TP под головкой), стойки корпуса
  docs/21; высота под FPC/шлейфы.
- **Панелизация:** 2×2 (или 4×1) с рельсами 5 мм, tooling holes, fiducials 3×1 мм, V-score только
  прямые края; зазоры между платами ≥2 мм.
- **Зазоры:** 20 В BL ≥0.5 мм (лучше 2 мм), HV-зона маркировать; AGND/DGND/PGND — звезда NT1/NT2,
  stitching via; C6 antenna keepout ≥15 мм без меди/шелкографии.
- **Шелкография:** `CORE-2 rev.2`, pin1 всех разъёмов, полярность диодов/электролитов/LED,
  SN/QR-зона, TP-подписи, предупреждение о 20 В; не ставить шелкографию под FPC.
- **TP/пады:** не под разъёмами и не в зоне шлейфов, доступ после сборки, маска открыта.
- **ESD/защита:** USBLC6, TVS на входы/джеках, polyfuse; проверка после сборки.
- **Mic (D-91):** J19 canon (1 BCK, 2 GND, 3 WS, 4 GND, 5 DATA, 6 +3V3; PANEL-2 J16 1:1) — экранированный кабель ≤150 мм, BCK/WS/DATA в отдельной зоне от BL_20V и
  WS2812 (guard GND между), 3V3_MIC через FB8; аналоговая часть MAX9814/PCM1808 — keepout от
  цифровых/20 В; TP31/32 не под шлейфом; SW3 mute доступен снаружи; loopback mic→PCM1808→DAC.

## 5a. Сверка с datasheet (MAX9814 / TS5A23157, 2026-11-06)

Официальные datasheet: [MAX9814 (Analog Devices)](https://www.analog.com/media/en/technical-documentation/data-sheets/MAX9814.pdf),
[TS5A23157 (TI)](https://www.ti.com/lit/ds/symlink/ts5a23157.pdf). Сверены все пины U46/U47;
**найдено 4 расхождения — исправлены в схеме** (ERC 0/0 после правки).

### MAX9814 (TDFN-14, U46)

| Пин | Datasheet | У нас (net) | Статус |
|---:|---|---|---|
| 1 | CT (тайминг AGC) | `CT` → C125 **470 нФ** → AGND | ✔ (номинал приведён к datasheet) |
| 2 | SHDN, active-low | `SHDN` ← R113 100k к 3V3_MIC; SW3 → AGND = mute | ✔ полярность верна: SW3 замкнут = shutdown |
| 3 | CG | `CG` → C124 2.2 мкФ → AGND | ✔ |
| 4, 11 | N.C. → GND | `AGND` | ✔ |
| 5 | VDD (1 мкФ bypass) | `3V3_MIC` (C128 10 мкФ + C129 100 нФ) | ✔ |
| 6 | MICOUT | `MIC_AGC` → C126 1 мкФ | ✔ |
| 7 | GND | `AGND` | ✔ |
| 8 | MICIN | `MICIN_A` ← C127 100 нФ ← `MIC_IN` | ✔ |
| 9 | A/R | `AGND` → 1:500 | ✔ |
| 10 | GAIN | `AGND` → 50 дБ | ✔ (40/50/60 по strap) |
| 12 | BIAS (0.47 мкФ) | `BIAS` → C123 470 нФ | ✔ |
| 13 | MICBIAS | `MICBIAS_N` → C122 1 мкФ; R106 2.2 к → `MIC_BIAS` | ✔ |
| 14 | **TH** (AGC threshold) | **`TH`** ← R107 150k от MICBIAS, R108 100k на AGND (V_TH≈0.4·MICBIAS) | **исправлено** (был EP) |
| EP | Exposed pad → GND | `EP` (pin 15) → AGND | **исправлено** (пад добавлен) |

### TS5A23157 (DGS/VSSOP-10, U47)

| Пин | Datasheet | У нас (net) | Статус |
|---:|---|---|---|
| 1 | IN1 | `MIC_SEL` | ✔ |
| 2 | NO1 | `SW_MIC` | **исправлено** (NO=MIC) |
| 3 | GND | `AGND` | ✔ |
| 4 | NO2 | `SW_MIC` | **исправлено** |
| 5 | **IN2** | `MIC_SEL` | **исправлено** (был COM2) |
| 6 | **COM2** | `SW_R_COM` | **исправлено** (был NC2) |
| 7 | **NC2** | `AUDIN_R_F` (LINE R) | **исправлено** (был IN2) |
| 8 | V+ | `3V3` | ✔ |
| 9 | NC1 | `AUDIN_L_F` (LINE L) | ✔ |
| 10 | COM1 | `SW_L_COM` | ✔ |

**Truth table:** IN=L → NC–COM ON; IN=H → NO–COM ON. Поэтому NO=MIC, NC=LINE:
`MIC_SEL=0` → LINE (R110 100k PD — дефолт), `MIC_SEL=1` → MIC. COM1/COM2 → C78/C80 → PCM1808
VINL/VINR — подтверждено.

**Вердикт:** pinout и полярность теперь соответствуют datasheet; остаётся только сверить
посадочные места (TDFN-14-1EP, MSOP-10) с land pattern производителя на этапе PCB.

## 6. Чек-лист «перед заказом PCB» (20 пунктов)

1. [ ] Реестр `spec/90` подписан, PRE-FREEZE снят для rev.2.
2. [ ] P1-стенд P4/C6/PSRAM пройден (DMA/дисплей/USB/AUDIO).
3. [ ] ERC 0/0 и `check_pinmap`/`check_schematic` PASS на финальной схеме.
4. [ ] Все TP (TP1–TP32) на плате, не под разъёмами.
5. [ ] BOOT/RESET + UART0 J4 + strap-пады GPIO35/36.
6. [ ] EEPROM 24C32 на I2C 0x57, адреса панели 0x20–0x23, 0x36 PWR-2 свободны/подтверждены.
7. [ ] Recovery-сценарий (UART0 download) проверен на devkit.
8. [ ] Стек/импедансы подтверждены фабрикой (HS USB 90 Ω, 6 слоёв).
9. [ ] FPC-40 pinout сверен с PANEL-2 J12 (D-19), ключ/ориентация.
10. [ ] J14/J15/J16/J17/J18 pinout и ключи сверены с PANEL-2/PWR-2.
11. [ ] 6×M3, keepout, высоты проверены по docs/21 (корпус).
12. [ ] Панелизация/fiducials/tooling согласованы с фабрикой.
13. [ ] 20 В BL-зона: зазоры/маркировка; C6 antenna keepout.
14. [ ] Test points/маска/шелкография (pin1, полярность, rev, SN) проверены.
15. [ ] DNP-список (46) и BOM-core2 сходятся с монтажной картой.
16. [ ] DFM-ревью фабрики (min drill/annular ring/soldermask).
17. [ ] Производственный тест-план (docs/38) и прошивка BIST готовы.
18. [ ] Серийные номера/QR и способ записи EEPROM согласованы.
19. [ ] Корпус/крепёж/разъёмы имеют 3D-проверку (fit), нет пересечений.
20. [ ] Страховка: заказ 3–5 прототипов, резерв на respin.

## 7. PANEL-2 / PWR-2 / CORE-S3

- PANEL-2: `hardware/panel2/dfm.md` — TP 3V3/5V/GND/I2C/INT/LED_DATA/BL_PWM, self-test
  матрицы/энкодеров/фейдеров/LED/джеков, DFM FFC-40/IDC-16/IDC-26 и 10 джеков.
- PWR-2: `hardware/power2/dfm.md` — TP рельсов/PWR_GOOD/LED_RET, self-test БП/EN/гейджа/NTC,
  DFM силовых цепей 3 А и J3 (IDC vs Micro-Fit).
- CORE-S3 (lite later): `hardware/cores3/dfm.md` — сокращённый пакет; S3-base уходит в «lite later».
