martiyanov/bukifon/hardware/core2/power-tree.md

# CORE-2 rev.2 — дерево питания и бюджеты токов

> **STATUS: PRE-FREEZE / DO NOT FABRICATE.** rev.2: рельсы ±12 В/+5 В/5V_LED приходят
> с **PWR-2** (J17), CORE-2 формирует только локальные +3V3 / +3V3_C6 / +3V3_MCU / BL_20 V.
> **Схема CORE-2 — rev.2** (ERC 0/0); DNP-список (46) и изменения — `rev2-plan.md`. Числа расчётные.

## 1. Топология rev.2

```
USB-C (5 V, данные+заряд) -> USBLC6 -> F1 1.5 A -> BQ24074 (power-path, заряд 1S2P)
       BQ24074 BAT <-> PWR-2 J3 «VBAT» (пакет 1S2P + BMS + MAX17048 на PWR-2)
       BQ24074 OUT = VSYS --> PWR-2 J3 «VSYS» --> master switch --> PWR-2 boost/IBB:
            +12 V (330 мА) --D7--> CORE-2 12V_EXT --D2--> +12 V  (DNP MT3608 #1)
            -12 V (95 мА)  --D8--> CORE-2 N12_EXT --D19--> -12 V (DNP MC34063)
            +5 V (1.6 А)   -----> CORE-2 +5V_EXT ------> +5 V  (DNP MT3608 #2)
            5V_LED/LED_RET -----> CORE-2 5V_LED / LED_RET (WS2812, низкий ключ на PWR-2)

CORE-2 local:
  +5 V --> AP2112K --> +3V3 (periph/analog)   [+3V3 150 мА из 450]
  +5 V --> AP2112K --> +3V3_C6 (C6 radio)     [+3V3_C6 250 мА из 450]
  +5 V --> MP1584  --> +3V3_MCU (P4/PSRAM)    [+3V3_MCU 700 мА из 2400; вход ~510 мА]
  +5 V --> MT3608 #3 --> BL_20 V (LCD BL)     [BL_20 30 мА из 100; вход ~80 мА]
  AGND/DGND/PGND — звезда NT1/NT2; входы ±12/+5 защищены D19/D20/C112-C115, D2.
```

## 2. Рельсы, импортируемые с PWR-2 J3

| Рельс | Vout на CORE-2 | Бюджет | Пик | Нагрузки CORE-2 | Запас |
|---|---|---:|---:|---|---:|
| +12V (PWR-2) | 11.7 (12.15 до D7) | 330 мА | 420 мА | шина 2 порта 120 + ОУ 30 + MP1584 (опц. вариант a) 216 | 36 % |
| -12V (PWR-2) | -11.55 (-12.0 до D8) | 95 мА | 150 мА | шина 2 порта 80 + ОУ 15 | 58 % |
| +5V (PWR-2) | 5.10 | 1600 мА | 2000 мА | см. таблицу +5 В rev.2 (1500 мА) / вариант a 990 мА | 25 % |
| 5V_LED (PWR-2) | 5.0 + LED_RET | 550 мА | 2500 мА | WS2812 74 LED (прошивочный cap 550 мА) | 78 % |

Источник цифр: `hardware/power2/power-tree-pwr2.md` §2 (TPS61088 ×2, LMR33630 IBB).
Падения D7/D8 на PWR-2 (0.45 В) учтены: +11.7 В / −11.55 В на CORE-2.

## 3. Локальные рельсы CORE-2 (rev.2)

| Рельс | Источник | Преобразователь | Бюджет | Возможность | Запас | Основные нагрузки |
|---|---|---|---:|---:|---:|---|
| +3V3 | +5 V | AP2112K-3.3 (600 mA LDO) | 150 мА | 450 мА | 67 % | LCD logic 60, MCP23017 x4 4, MCP4728 x2 2, MCP3208 1, 24C32 1, PCM5102A 20, PCM1808 VDD 15, mic (MAX9814+MEMS) 8, логика 10, датчики 20 |
| +3V3_C6 | +5 V | AP2112K-3.3 dedicated (600 mA) | 250 мА | 450 мА | 44 % | ESP32-C6 Wi-Fi/BLE peak 240, модуль/IO 10 |
| +3V3_MCU | +5 V (вариант b) | MP1584 buck (3 A) | 700 мА | 2400 мА | 71 % | P4+PSRAM пик 600, IO 100; вход с +5: 510 мА |
| BL_20V | +5 V | MT3608 boost #3 (2 A switch) | 30 мА | 100 мА | 70 % | LCD backlight LED string 20-25 мА; вход с +5: 80 мА |

Проверка запаса ≥25 %: все локальные рельсы проходят (+3V3 67 %, +3V3_C6 44 %,
+3V3_MCU 71 %, BL_20V 70 %). Импортируемые: +12 36 %, −12 58 %, +5 **25 %** (ровно),
5V_LED 78 %. Исключение — **VSYS/power-path** (см. §5), зафиксировано в O-2.

## 4. +5 В: бюджет 1.0 → 1.6 А (O-1)

| Нагрузка | Ток | Примечание |
|---|---:|---|
| WS2812 74 LED (кап 550 мА) | 550 мА | отдельная ветвь PWR-2 (F5 2.5 А, Q7) |
| PCM1808 VCC 30 + MIDI 10 + панельная логика 20 | 60 мА | +5 |
| AP2112K-3.3 (+3V3 периферия, 150 мА) | 110 мА | +5 |
| AP2112K-3.3 (+3V3_C6, 250 мА) | 190 мА | +5 |
| MP1584 -> +3V3_MCU (700 мА, вариант b: от +5) | 510 мА | +5 |
| вход BL-boost (19-22 В, 25 мА) | 80 мА | +5 |
| **Итого +5 (логика, вариант b)** | **950 мА** | из 1.6 А бюджета |
| 5V_LED (отдельно) | 550 мА | из того же TPS61088 через F5 |
| **Полная нагрузка на +5 PWR-2** | **1500 мА** | 1.6 А бюджет / 2.0 А возможность |

**Вариант (a):** MP1584 → +3V3_MCU перевести на +12 В (освобождает 510 мА на +5,
добавляет 216 мА на +12). Итоги: +5 = 1540 мА (77 % возможности),
**+12 = 366 мА при бюджете 330/возможности 420 → запас 13 % (<25 %)**.

**Вариант (b):** оставить MP1584 на +5 В, принять бюджет **1.6 А**.
Итоги: +5 = 1500 мА (75 % возможности, **запас 25 %**), +12 = 150 мА (45 % бюджета).

**Рекомендация — (b).** Причина: +12 В у PWR-2 ограничен 330 мА бюджетом / 420 мА
возможностью, и MP1584 съедает 216 мА резерва; +5 В имеет TPS61088 с 10-А ключом и
запас 25 % ровно. Вариант (a) — предпочтителен после 2S-пака (O-6) или увеличения
+12 бюджета PWR-2 до ≥450 мА; переделки CORE-2 не требует (только вход MP1584).
Тепло PWR-2 на +5: ≈0.76 Вт при 1.5 А (при бюджете 1.6 А — 0.81 Вт) — стенд обязателен.

## 5. VSYS / power-path: 3 А против пика 2.74–3.38 А (O-2, D-35)

| Сценарий (PWR-2 §2.2) | I(VSYS) @3.7 В | @3.0 В |
|---|---:|---:|
| Idle (меню, LED 20 %) | 0.66 А | 0.82 А |
| Типичный (1 модуль, LED 40 %) | 2.13 А | 2.62 А |
| **Реалистичный максимум** | **2.74 А** | **3.38 А** |
| Сумма паспортных бюджетов | 3.94 А | 4.87 А |

BQ24074 power-path рассчитан на ≈3 А. Меры: **прошивочный cap WS2812 550 мА** +
профиль яркости (на батарее ≤30 %, автоснижение при `PWR_GOOD=0`), последовательное
включение рельсов (EN_RAILS → LED), запрет «3 картриджа + max яркость» на батарее.
Полная мощность — от внешнего 12 В (снимает +12, но **+5 остаётся от VSYS**); для
абсолютного максимума — 2S (O-6).

## 6. Защита входов, inrush, DNP

| Вход | Защита CORE-2 |
|---|---|
| `12V_EXT` | D2 SS34 (diode-OR с внешним J-DC), C110 100 мкФ/25 В, C111 100 нФ; на PWR-2 — D7 SS34 + F2 0.5 А |
| `N12_EXT` | **D19 SS34** series, **D20 SMAJ15A**, C112 100 мкФ/25 В, C113 100 нФ; на PWR-2 — D8 SS34 + F3 0.3 А |
| `+5V_EXT` | C114 100 мкФ/10 В, C115 100 нФ; на PWR-2 — F4 2 А + C-L-C |
| `5V_LED` / `LED_RET` | ключ Q7 + F5 2.5 А на PWR-2; на CORE-2 только 100 нФ у разъёма |
| USB-C | USBLC6-2SC6, F1 1.5 A, BQ24074 ILIM |

DNP rev.2 (см. `rev2-plan.md` §3): MT3608 #1/#2, MC34063, BMS, EXPRESSION/SPARE (46 позиций). Остаются:
MT3608 #3 (BL), MP1584, AP2112K ×2, BQ24074, USB/ESD.

## 7. Тестпоинты rev.2

| TP | Цепь | Назначение |
|---|---|---|
| TP1 | `VBUS_CHG` | USB-C input |
| TP2 | `VSYS` | power-path output |
| TP3 | `12V` | +12 V from PWR-2 (after D2) |
| TP4 | `-12V` | −12 V from PWR-2 (after D19) |
| TP5 | `5V` | +5 V from PWR-2 |
| TP6 | `3V3` | +3.3 V peripherals |
| TP7 | `3V3_MCU` | +3.3 V MCU/PSRAM |
| TP8 | `BATT_MON` | battery ADC |
| TP9 | `I2S_MCLK` | 12.288 MHz |
| TP10 | `SD_CLK` | SDIO clock |
| TP11 | `USB_HS_DP` | USB D+ |
| TP12 | `USB_HS_DM` | USB D- |
| TP13 | `AGND` | analog ground |
| TP14 | `DGND` | digital ground |
| TP15 | `PGND` | power ground |
| TP16 | `LED_DATA` | WS2812 data |
| TP17 | `CHIP_PU` | reset |
| TP18 | `BOOT` | boot strap GPIO35 |
| TP19 | `3V3_C6` | C6 rail |
| TP20 | `BL_20V` | backlight rail |
| TP21 | `C6_CS` | C6 SPI select |
| TP22 | `C6_RST` | C6 reset |
| TP23 | `N12_EXT` | −12 V input from PWR-2 (rev.2) |
| TP24 | `5V_EXT` | +5 V input from PWR-2 (rev.2) |
| TP25 | `5V_LED` | LED rail (rev.2) |
| TP26 | `PWR_GOOD` | supervisor (rev.2) |
| TP27 | `EN_RAILS` | EN analog rails (rev.2) |

## 8. Что нельзя заказывать до стенда PWR-2 (O-5/O-6)

1. Тепло/КПД TPS61088 +5 В при 1.5 А (0.76 Вт) и +12 В при 330/420 мА.
2. −12 В LMR33630 IBB при VBAT 3.0 В / 150 мА (ripple, устойчивость EN).
3. Падение/нагрев J3 IDC-20 при 3 А (критерий ≤100 мВ / ≤30 °C) → IDC vs Micro-Fit.
4. Профиль яркости LED и последовательность EN по замерам VSYS-пиков.
5. Решение 1S2P vs 2S (O-6) — меняет бюджеты и выбор варианта (a)/(b).
