martiyanov/bukifon/hardware/panel2/interfaces.md

# PANEL-2 — электрические интерфейсы (PRE-FREEZE draft)

Сгенерировано `tools/gen_panel2.py`. **Плата не заказывается** — документ фиксирует контракт для ревью (R-01…R-11, `spec/90-requirements-registry.md`).

## 1. Джек-поле (10 × 3.5 мм, R-06, шаг 13.1 мм, верхний ряд)

Принятое назначение: **4 CV OUT + 4 CV IN + GATE OUT + GATE IN** (строго 10 по R-06). Аудио-джеков в верхнем поле нет — LINE/PHONES/AUDIO IN выносятся на заднюю панель CORE-2 (см. §1.2); это предмет решения Lead (см. README «Открытые вопросы»).

| Джек | X | Y (панель) | Назначение | Уровень | Защита на PANEL-2 |
|---|---:|---:|---|---|---|
| J01 | 129.9 | 10.5 | CV OUT 1 (out) | 0..10 V | MCP4728 (CORE-2) → 1k → TVS SMAJ12A |
| J02 | 143.0 | 10.5 | CV OUT 2 (out) | 0..10 V | MCP4728 → 1k → TVS SMAJ12A |
| J03 | 156.1 | 10.5 | CV OUT 3 (out) | 0..10 V | MCP4728 → 1k → TVS SMAJ12A |
| J04 | 169.2 | 10.5 | CV OUT 4 (out) | 0..10 V | MCP4728 → 1k → TVS SMAJ12A |
| J05 | 182.3 | 10.5 | CV IN 1 (in) | ±10 V | 100R → TVS SMAJ15A → MCP3208 (CORE-2) |
| J06 | 195.4 | 10.5 | CV IN 2 (in) | ±10 V | 100R → TVS SMAJ15A → MCP3208 |
| J07 | 208.5 | 10.5 | CV IN 3 (in) | ±10 V | 100R → TVS SMAJ15A → MCP3208 |
| J08 | 221.6 | 10.5 | CV IN 4 (in) | ±10 V | 100R → TVS SMAJ15A → MCP3208 |
| J09 | 234.7 | 10.5 | GATE OUT (out) | 0/5 V | 1k → TVS SMAJ5.0A (open-drain CORE-2) |
| J10 | 247.8 | 10.5 | GATE IN (in) | 0..12 V | 4.7k → BAT54S → 74LVC1G17 → CORE-2 GPIO |

### 1.1 Защита (детали)

* **CV OUT (J01…J04)**: выход буфера CORE-2 → `1 кОм` → TVS **SMAJ12A** на GNDA + `100 нФ`. TVS ограничивает выброс / ошибочное подключение ±12 В к выходу; 1 кОм развязывает буфер.
* **CV IN (J05…J08)**: джек → `100 Ом` → узел `CVINn` (в CORE-2) + TVS **SMAJ15A** на GNDA + `100 нФ`. 100 Ом при входном 100 кОм CORE-2 даёт **0.1 %** погрешности — важно для 1 В/окт; TVS 15 В не открывается при штатных ±12 В и срабатывает на выбросы; ток при ±24 В ≤ 90 мА.
* **GATE OUT (J09)**: `1 кОм` + TVS **SMAJ5.0A** + `100 нФ` (open-drain 2N7000 на CORE-2, подтяжка 4.7 кОм к +5 В — на CORE-2).
* **GATE IN (J10)**: `4.7 кОм` + **BAT54S** (кламп к +3.3 В / GNDA: ток при +12 В ≤ 1.8 мА) + `100 нФ` + **74LVC1G17** (триггер Шмитта, 3.3 В) → `GATE_IN_CLEAN` в CORE-2.
* **Земли**: цифровая `GND` и аналоговая `GNDA` соединены в одной точке (R112 = 0 Ω) — звезда на PCB, чтобы не гнать цифровые токи через аналоговый возврат.

### 1.2 Аудио — 5 джеков на задней панели CORE-2 (решение Lead 05.11)

Верхнее джек-поле PANEL-2 (10 шт., R-06) — только CV/GATE. Аудио целиком на CORE-2:

| Джек (rear) | Тип | AC-coupling | Защита |
|---|---|---|---|
| LINE OUT L | 3.5 мм моно/TRS | `10 мкФ` + `10 кОм` на GNDA (срез ~1.6 Гц) | `1 кОм` + `BAT54S` + `100 пФ` на выходе буфера TL072 |
| LINE OUT R | 3.5 мм моно/TRS | `10 мкФ` + `10 кОм` | `1 кОм` + `BAT54S` + `100 пФ` |
| PHONES | 3.5 мм TRS (стерео) | `10 мкФ` + `10 кОм` на канал, последовательно `100 Ом` | `BAT54S` |
| AUDIO IN L | 3.5 мм моно/TRS | `2.2 мкФ` + `10 кОм` (срез ~7 Гц) | `1 кОм` + `BAT54S` + `100 пФ` |
| AUDIO IN R | 3.5 мм моно/TRS | `2.2 мкФ` + `10 кОм` | `1 кОм` + `BAT54S` + `100 пФ` |

Постоянка на разъёмы не выходит (последовательный конденсатор), вход PCM1808 защищён от фантомного питания. PANEL-2 эти цепи не содержит и не меняет.

## 2. Экран 5.0" 800×480 RGB 16 бит

* **J11** — FPC-40 (0.5 мм) под хвост панели; **J12** — FFC-40 в CORE-2. Пины: R0-R4 (5), G0-G5 (6), B0-B4 (5), PCLK, DE, HSYNC, VSYNC, BL_PWM, BL_ANODE, BL_CATHODE + LCD_3V3/GND (5 В на J12 не нужно — boost уехал в CORE-2). ⚠️ **Пин-аут TBD** по datasheet конкретного модуля 5.0" перед PCB.
* RGB565: младшие биты R5/G6/G7/B5 не разводятся — 16 бит достаточно для UI (65 536 цветов); панель 24-битная, младшие биты можно посадить на GND на CORE-2.
* Тайминг-бюджет (ориентир): 800×480 @ 60 Гц, PCLK ≈ 33 МГц, HBP/HFP/VBP/VFP — по datasheet панели; линии PCLK/DE/HSYNC/VSYNC — короткие, с FFC 0.5 мм «земля-сигнал-земля».
* **Подсветка**: драйвер (boost ~19 В / CC) перенесён на **CORE-2** — высокое напряжение не тащим через шлейф панели. На PANEL-2 только: `BL_PWM` (вход драйвера), `BL_ANODE` и `BL_CATHODE` — клеммы LED-линейки панели (J11 pin 31/30), выведенные на J12 (pin 31/32). Если выбранный модуль 5.0" имеет собственный драйвер подсветки — пара BL_ANODE/BL_CATHODE не используется (DNP), BL_PWM идёт прямо на модуль.
* Альтернатива **J15** (1×14, DNP): SPI-дисплей по R-18 (SPI2_SCK/MOSI/CS/DC/RST/MISO/BL). Nets SPI2_* намеренно никуда не идут — это точка расширения; ERC даёт 6 warnings `isolated_pin_label` на них (см. README).

### 2.1 J12 ↔ внешний FFC-40 LCD-адаптер (стенд, `docs/49-lcd-adapter.md`)

Текущий pinout J12 (FFC-40, 23 сигнала) **повторяется 1:1** стендовым адаптером `hardware/panel2/adapter-lcd/` — чтобы проверить экран на P1-стенде до PCB:

| J12 pin | сигнал | J12 pin | сигнал |
|---:|---|---:|---|
| 1 | `GND` | 2 | `GND` |
| 3 | `R0` | 4 | `R1` |
| 5 | `R2` | 6 | `R3` |
| 7 | `R4` | 8 | `G0` |
| 9 | `G1` | 10 | `G2` |
| 11 | `G3` | 12 | `G4` |
| 13 | `G5` | 14 | `B0` |
| 15 | `B1` | 16 | `B2` |
| 17 | `B3` | 18 | `B4` |
| 19 | `GND` | 20 | `GND` |
| 21 | `PCLK` | 22 | `DE` |
| 23 | `HSYNC` | 24 | `VSYNC` |
| 25 | `GND` | 26 | `GND` |
| 27 | `LCD_3V3` | 28 | `LCD_3V3` |
| 29 | `GND` | 30 | `BL_PWM` |
| 31 | `BL_ANODE` | 32 | `BL_CATHODE` |
| 33 | `GND` | 34 | `GND` |
| 35 | `GND` | 36 | `GND` |
| 37 | `GND` | 38 | `GND` |
| 39 | `GND` | 40 | `GND` |

Адаптер: J1 = вход FFC-40 (этот pinout), 31 тестпоинт на линии панели, 0R-«перемычки» для набора реального пин-аута HotLCD (TFT-H050A1SVIST4R40, ST7262), J2 = FFC-40 на хвост панели, J3 = вход внешнего boost подсветки 18…22 В. Плата 2 слоя, ~120×76, крепление панели 4×M3. Схема: `adapter-lcd/LCD-ADAPTER.kicad_sch` (ERC 0/0).

**O-15 (LCD_DISP)** — статус **«адаптер ждёт образец»**: в J12 линии DISP нет; на адаптере DISP подтянут к +3V3 (10k) и выведен на тестпоинт для внешнего управления. Пин J12 под DISP назначается после проверки панели (кандидат — свободный pin 33).

## 3. Энкодеры (16 × EC11) — I2C

| Параметр | Значение |
|---|---|
| Чипы | 4 × MCP23017: 0x20 (ENC1…8: GPA=A, GPB=B), 0x21 (ENC9…16: GPA=A, GPB=B), 0x22 (16 × SW), 0x23 (матрица + EN-линии + GATE_IN) |
| Шина | I2C0, 400 кГц, подтяжка 4.7 кОм на +3V3 (на PANEL-2) |
| INT | INTA всех чипов open-drain → общая линия `INT` + 10 кОм; IOC на обеих сторонах |
| Фильтр фазы | 10 кОм подтяжка → 1 кОм → 100 нФ → вход MCP (fc ≈ 1.6 кГц) |
| Кнопка энкодера | 10 кОм подтяжка + 100 нФ, дебаунс 5…10 мс в прошивке |
| Бюджет шины | INT-событие = 1 × 2-байтовое чтение ≈ 75 мкс; 16 энк. × 200 событий/с = 3200 × 75 мкс = 24 % шины; скан матрицы 500 Гц ≈ 10 %; запас > 60 % |

**Почему 3 чипа, а не 2**: 16 энкодеров × 3 линии = 48 входов; 2 × MCP23017 = 32 — не хватает. Выбирать «напрямую» = 48 GPIO + 13 матрицы = 61 линия на шлейфе — нереально. 4 чипа дают 3 линии (SDA/SCL/INT) вместо 61.

## 4. Матрица клавиш (42 × Choc, 6×7)

* rev.2 (canon CORE-2): строки ROW1…ROW6 = **GPB0…GPB5** (выходы, прижимаются к 0 по одной); столбцы COL1…COL7 = **GPA0…GPA6** (входы, внешняя подтяжка 10 кОм).
* В каждой клавише — **1N4148**: анод = клавиша, катод = столбец → фантом при диагональных нажатиях исключён.
* Скан: 6 × (запись + чтение) ≈ 0.5 мс при 400 кГц → рекомендовано 500 Гц (2 мс). INT по изменению столбцов (IOC) — мгновенная реакция.
* Полная таблица ключ → строка/столбец/диод — `matrix.md`.

### 4.1 EN-линии питания и GATE_IN (rev.2, D-33)

| Линия | Источник/приёмник | Назначение | Логика |
|---|---|---|---|
| `EN_RAILS` | MCP23017 0x23 **GPA7** → J13.15 → CORE-2 → PWR-2 | разрешение +12/−12/+5 В | active-high **disable**; high-Z (MCP вход после сброса) = рельсы ON |
| `EN_LED5` | MCP23017 0x23 **GPB6** → J14.25 → CORE-2 → PWR-2 J18.9 | включение 5V_LED (Q7 low-side на PWR-2) | active-high **enable**, default OFF |
| `GATE_IN_CLEAN` | джек J10 → 4.7k+BAT54S+100n → 74LVC1G17 → 1k → MCP23017 0x23 **GPB7** | состояние GATE IN читается прошивкой **по I2C** (0 GPIO CORE-2) | 0/3.3 В |

> Рельсы +12/−12/+5 включаются PWR-2 по умолчанию; PANEL-2 только *разрешает* их (high-Z = ON) и **не** разводит силовые EN — это делает CORE-2 (0R R94…R96).

## 5. Фейдеры (2 × 60 мм)

* 10 кОм линейные (Bourns PTA6043), включены между +3V3 и GNDA; ток 0.33 мА.
* Ползунок → `1 кОм` → `100 нФ` на GNDA → `FADER1/FADER2` → **MCP3208 на CORE-2** (12 бит; 0.8 мВ/LSB, fc RC = 1.6 кГц).
* Линейность: резистивная дорожка линейная (не логарифм); прошивка может применить кривую.

## 6. LED-индикация (17 × WS2812B-2020)

* 16 колец под энкодерами + 1 статус; питание **5V_LED** с **отдельным возвратом LED_RET** (коммутируемый Q7 на PWR-2; возврат LED не идёт через землю аудио/цифровую GND).
* Данные: `LED_DATA` с CORE-2 — **3.3 В** (на CORE-2 буфер U44/R90 **DNP**); на PANEL-2 level shifter **U6 74HCT1G125** (VCC = 5V_LED, /OE = 0) → 330 Ω → цепочка; 100 нФ на каждый LED между 5V_LED и LED_RET.
* Бюджет тока: 17 × 10 мА = 170 мА по 5V_LED (cap прошивки 0.55 А); ограничение яркости — в прошивке; при LED_RET = OFF цепочка обесточена.

## 7. Питание PANEL-2

| Рельс | Откуда | Потребители | Оценка |
|---|---|---|---|
| +3V3 | CORE-2 (J13) | 4 × MCP23017, матрица/подтяжки, буфер Шмитта, 74HCT1G125 | ≈ 30 мА |
| 5V_LED | CORE-2 (J13.9/13, PWR-2) | 17 × WS2812, VCC буфера U6 | ≈ 175 мА (cap 0.55 А) |
| LED_RET | PANEL-2 → PWR-2 (J13.16) | возврат LED-цепочки через Q7 на PWR-2 | тот же ток |
| GND / GNDA | CORE-2 (J13/J14) | возвраты | — |

## 8. I2S MEMS-микрофон (rev.3, docs/71, D-91/D-94)

**MPN:** `ICS-43434` (TDK InvenSense, I2S MEMS, 24 бит, 3.3 В, −26 дБFS, LGA-6 3.5×2.65); резерв — `SPH0645LM4H` (Knowles; pin-функции совпадают, **пады другого размера**).

| Параметр | Значение |
|---|---|
| Интерфейс | I2S1 RX: `MIC_BCK` (SCK), `MIC_WS` (LRCLK), `MIC_DATA` (SD) |
| Питание | +3V3 через аппаратный мьют и ferrite bead 600 Ом (развязка от WS2812/BL) |
| Развязка | FB1 + 10 мкФ + 100 нФ (MIC_VDD), 100 нФ на MIC_VDD_SW |
| ESD/RC | SRV05-4 (ESD-матрица на BCK/WS/DATA) + серия 33 Ом перед выводами MEMS |
| Канал | LR = GND → моно/левый канал I2S1 |
| Мьют (R-37) | **SW1** разрывает питание микрофона + R120 100k (разряд) + **LED_MICON** (R121 1k) — горит только при включённом питании |
| Линии на CORE-2 | **J16 IDC-6** ↔ CORE-2 **J19 IDC-6** (канон 1:1): 1 MIC_BCK, 2 GND, 3 MIC_WS, 4 GND, 5 MIC_DATA, 6 +3V3; в CORE-2 rev.3 — I2S1 RX. ⚠️ **конфликт к решению Lead:** фактический J19 в `hardware/core2` rev.3 = *3V3_MIC, GND, BCK, WS, DATA, GND* — порядок нужно выровнять (4 цепи, README §6 п.10) |
| TP | TP36 MIC_BCK, TP37 MIC_WS, TP38 MIC_DATA, TP39 MIC_VDD |
| Акустический порт | **Ø1.8 мм**, центр **(X 122.0, Y 5.5)** панели; цековка Ø3.4×0.7, углубление MEMS Ø5×1.2 снизу; сетка + поролон 1–2 мм, звуковод ≤3 мм (MEMS под звуководом, X≈122) — по fitcheck mechanical |
| LED MIC ON | **Ø1.6 мм**, центр **(X 116.0, Y 10.5)**; R121 1k от MIC_VDD_SW |

**Приватность (R-37):** мьют физически разрывает питание MEMS — прошивка не может включить микрофон программно; LED — единственный индикатор. Требование docs/71 §2/§5.

**Layout-правила (PCB):** MEMS — у верхней кромки под звуководом (X≈122), ≥10 мм от WS2812 и разъёма подсветки; земля MIC — отдельный полигон/звезда к GND у J16; I2S-линии — «сигнал/земля» в шлейфе, длина ≤100 мм.
