martiyanov/bukifon/hardware/power2/bench-macet.md

# PWR-2 — карта стенда-макета (gate до PCB)

> **STATUS: PRE-FREEZE / DO NOT FABRICATE.** Карта макета, на котором проходят **13 обязательных
> измерений** PWR-2 до заказа платы (DFM: `docs/42-dfm-review-gpt.md` §8 — стоп-фактор
> «PWR-стенд»).
>
> - **Полный протокол (методика, критерии, пустые таблицы):**
>   [`docs/44-pwr-bench.md`](../../docs/44-pwr-bench.md) — **Часть II** (§7–§25: 13 измерений
>   T1…T13, критерии D-76, 3×3 matrix, ripple+FFT A–D, ток OFF, BMS, гейдж, EVM-бюджет).
> - **BOM стенда:** [`bench-bom.csv`](bench-bom.csv) (≈$103, 18 позиций; EVM — отдельно, §24
>   docs/44).
> - **Платформа по D-76:** EVM-платы + **сверлёные платы с пайкой**;
>   **breadboard (макетные «дырчатые» платы без пайки) запрещён.**
> - Схема PWR-2: [`PWR-2.kicad_sch`](PWR-2.kicad_sch); бюджеты: [`power-tree-pwr2.md`](power-tree-pwr2.md);
>   интерфейс: [`interfaces.md`](interfaces.md); DFM-чек-лист: [`dfm.md`](dfm.md) §4.

## 1. Узлы стенда (M1…M12)

| ID | Узел | Платформа (D-76) | Позиции `bench-bom.csv` | Тесты |
|---|---|---|---|---|
| M1 | Имитатор батареи | ЛБП 0…5 В/5 А + 0.1 Ω/5 Вт (Ri) | P-12/P-13 (нагрузка/резисторы) | T1–T7 |
| M2 | Пакет 1S2P + BMS | 2×18650 в холдерах → F1 5 А → BQ29700EVM-сборка | P-07, P-08, P-09 | T6, T8, T9, T10 |
| M3 | Заряд/power-path | **BQ24074EVM** | P-05 (bare) / EVM §24 | T6 |
| M4 | +12 В | **TPS61088EVM-677** + D7 SS34 + π (сверлёная плата) | P-01/P-02 | T1–T4 |
| M5 | +5 В | **TPS61088EVM-677** (2-й) или **TPS63802EVM** (вариант B) | P-01/P-02/P-04 | T1–T4, T2b/T3b |
| M6 | −12 В IBB | **LMR33630ADDAEVM**, переделанный в IBB + D8 SS34 + π | P-03 | **T5**, T1–T4 |
| M7 | 5V_LED / LED_RET | мини-плата: AO3400A low-side + 9.1 Ω/5 Вт (550 мА) | P-14/P-15 | T3 (B), T12 |
| M8 | Master switch | мини-плата: 2×AO3401A + MMBT3904 + C2 100 n | P-14/P-15 | T7, T11 |
| M9 | Гейдж | **MAX17048 EVKIT** / Adafruit breakout (I2C 0x36) | P-06 | T10 |
| M10 | Приборы | INA226 ×2–3 (P-10), термопара K (P-17), осц. ≥100 МГц, DMM 4½ ×2 | P-10, P-17 | все |
| M11 | Разъём J3 | IDC-20 + шлейф (2 пина/полярность) | добавить в bench-bom | T13 |
| M12 | +3.3 В (CORE-S3) | **TPS63802EVM** — справочно (D-41/D-49) | P-04 | T2b/T3b |

## 2. Схема соединений

```
        ┌──────────────── M1: имитатор батареи ────────────────┐
        │  ЛБП 0…5 В / 5 А  +  0.1 Ω / 5 Вт (Ri = 1S2P)       │
        └───────────────────────┬─────────────────────────────┘
                                │ PACK+ ── F1 5 А ──┐
                          ┌─────┴──────┐           │
                          │ M2: BMS 1S │  P+ = VBAT│
                          └─────┬──────┘           │
                                │ VBAT             │
        ┌───────────────────────┴──────────────────┴──────────────────────┐
        │ M3: BQ24074EVM   USB 5 В / 1.5 А → IN,  OUT = VSYS,  BAT = VBAT  │
        └───────────────────────────────┬─────────────────────────────────┘
                                        │ VSYS  (INA226#1: шунт 5 мОм)
     ┌──────────────┬───────────────────┼────────────────────┬───────────────────┐
     ▼              ▼                   ▼                    ▼                   ▼
 [M4 +12 В]     [M5 +5 В]         [M6 −12 В IBB]        [M12 +3.3 В]        [M8 master sw]
 TPS61088EVM    TPS61088EVM       LMR33630EVM (IBB)     TPS63802EVM        2×AO3401A
     │              │                   │                    │                   │
  D7 SS34         π-фильтр           D8 SS34             (справочно)        от VSYS → VSYS_SW
     │              │                   │                                           │
  π-фильтр       INA226#3           π-фильтр                                    M7: LED-ключ
     │              │                   │                                           │
 INA226#2      нагрузка 3.2 Ω      нагрузка 126 Ω                          5V_LED → 9.1 Ω → PGND
 (+12 В)          (1.6 А)             (95 мА)                                  (550 мА, эмул. WS2812)
     │              │                   │
  нагрузка       5V_LED ветвь       PGND (возврат −12 В — только PGND)
  36 Ω/5 Вт
  (330 мА)

 M9: MAX17048 EVKIT — VDD ← VBAT (Kelvin), GND = PGND, SDA/SCL → USB-I2C (0x36), ALRT → лог
 M10: INA226 ×2–3 → USB-I2C (0x40/0x41/0x44); DMM V на B2/B3/B4; осц. на B2/B3/B4; термопары
```

**Ключевые связи (не путать):**
- **VSYS → boost +12 → (D7) → +12**; **VSYS → IBB −12** (GND микросхемы IBB = −12 В!);
  **VSYS → +5** (и опционально **VSYS → TPS63802 → +3.3** для CORE-S3);
- **заряд:** USB 5 В → BQ24074 IN; BQ24074 OUT = VSYS; BQ24074 BAT = VBAT (P+ после BMS);
- **5V_LED:** +5 В → F5 2.5 А → 5V_LED → низковольтный ключ AO3400A → LED_RET → PGND;
- **PGND** — одна силовая земля стенда; у IBB она же «выход buck» (см. docs/44 T5).

## 3. Где мерить (B-метки) и чем

| Метка | Цепь | Точка/способ | Прибор |
|---|---|---|---|
| B1 | VSYS | шунт 5 мОм, 4-проводно | INA226#1 + DMM |
| B2 | +12 В (после D7/π) | Kelvin на выходном конденсаторе | INA226#2, DMM, осц. 1×+пружина |
| B3 | −12 В (после D8/π) | Kelvin; осц. **дифференциально** (2 канала A−B) | DMM, осц. |
| B4 | +5 В | Kelvin на выходном конденсаторе | INA226#3, DMM, осц. |
| B5 | 5V_LED | шунт 10 мОм последовательно | DMM/INA |
| B6 | LED_RET | точка ключа Q7 | осц. (переключение EN) |
| B7 | VBAT (P+) | двунаправленный шунт 5 мОм | INA226, DMM |
| B8 | PACK+ | µA-режим | DMM 4½ |
| B9 | PGND | опорная точка пробников (только здесь «земля») | — |
| B10 | PWR_GOOD | лог. вход | осц./лог. анализатор |
| B11 | EN_BUS12/N12/LED5/5V | генератор 0/3.3 В + DMM | DMM, осц. |
| B12 | FUEL_SDA/SCL/ALRT | USB-I2C | адаптер + скрипт |

## 4. Правила проводки (обязательны)

1. **Только пайка**: EVM, сверлёные платы, мини-PCB. **Breadboard и Dupont-«сопли» запрещены**
   (D-76): контактные потери и шум несопоставимы с платой.
2. **Витая пара** для силовых пар (supply+return): VSYS, +12 В, −12 В, +5 В, 5V_LED.
   Провод **20 AWG** (до 3 А), длина ≤15 см.
3. **Kelvin-сенс** — отдельные тонкие провода (26–28 AWG) прямо к выводам выходного
   конденсатора; шунт INA226 — 4-проводно.
4. **Ripple**: 1× пробник с пружиной земли на конденсаторе; для −12 В — дифференциально
   (земля осциллографа **не** подключается к −12 В).
5. Силовые петли — минимальной площади; входные конденсаторы EVM/мини-платы — максимально
   близко к ИС (это то, что нельзя воспроизвести на макете — см. §5).
6. Все соединения — пайка/клеммы с натягом; никаких «скруток» в силовых путях.

## 5. Что на EVM, что на мини-плате, что нельзя проверить на EVM

| Проверяется | Где | Комментарий |
|---|---|---|
| Топология/КПД/шум/тепло преобразователей | EVM (M4–M6, M12) | нижняя оценка; финальный ripple/тепло — на PCB |
| IBB −12 В (переделка EVM) | EVM + мини-плата | перепайка ОС/земли по TI SLVA542 |
| Power-path/тепло BQ24074 | BQ24074EVM | T6 |
| EN-обвязка, master switch, LED-ключ | мини-плата (пайка) | аналогов нет на EVM |
| Разъём J3 при 3 А | реальный IDC-20 | T13 |
| **Нельзя на EVM:** | | |
| тепловой режим реальной платы 130×80 (θJA/медь/полигоны) | — | консервативная оценка + финал на PCB |
| layout-зависимый шум (горячие петли, звезда PGND, AGND) | — | T3 = нижняя оценка |
| взаимодействие с CORE-2 (PWR_GOOD/EN от MCP23017, BL/Wi-Fi/USB HS) | — | только на связке |
| ток OFF (утечки платы), EMI/ESD в корпусе, soak 24 ч | — | на PCB/собранном изделии |
| точный КПД на финальных индукторах/разводке | — | оценка ±3…5 % |

Полный список «что нельзя проверить на EVM» — `docs/44` **§7.0** (10 пунктов).

## 6. Быстрый чек-лист первого дня

1. ☐ Собрать мини-платы: IBB-обвязка (L 22 мкГн, C_in 22 мкФ/25 В, C_out 22 мкФ×2, R 110k/10k,
   C_BOOT 100 н, C_VCC 1 мкФ, D8), master switch, LED-ключ, EN-опто — **только пайка**.
2. ☐ Прозвонить: PGND↔N12 **не** КЗ; вход 25 В керамика; полярность C_out (N12 — минус).
3. ☐ Первый пуск IBB: ЛБП 3.7 В, **ограничение 0.3 А**, без нагрузки, смотреть −12 В на 126 Ω.
4. ☐ Подключить INA226 ×2–3 + USB-I2C, проверить лог 1 Гц (CSV по §5 docs/44).
5. ☐ Прогнать T1 (3×3) → затем T2/T5; на термопары — U(TPS61088), U(LMR33630), U(BQ24074), банки.
6. ☐ ES-меры: обувь/коврик; банки — только защищённые; заряд — под присмотром.

## 7. Результаты

- Логи: `results/T01_<дата>.csv` … `results/T13_*.csv`; скриншоты FFT/step:
  `results/T03_fft_A…D.png`, `results/T04_step_*.png`.
- Сводная таблица PASS/FAIL — `docs/44` **§23**, затем `docs/schema/pwr2.md` §5–§6.
- После 13/13 PASS: обновить `power-tree-pwr2.md` (измеренные КПД/тепло/шум),
  `BOM-power2.csv` (если номиналы менялись) и `docs/schema/pwr2.md` §6 — **только затем PCB**.
- Перед PCB — `dfm.md` §4 (чек-лист 15) и `docs/42` §8 (обязательные пункты).

## 8. Безопасность (коротко)

- Первые тесты — **от имитатора батареи**, не от «голых» 18650; F1 5 А в плюсовом проводе — всегда.
- Ограничение тока ЛБП ≤5 А; КЗ/SCP-тесты — только с ограничением и предохранителем.
- «Земля» осциллографа **не** на −12 В (только дифф./2 канала).
- Li-ion: заряд только с NTC/TS и под присмотром; при нагреве банки >45 °C — стоп.
