martiyanov/bukifon/hardware/power2/dfm.md

# PWR-2 — DFM / testability

> **STATUS: PRE-FREEZE / DO NOT FABRICATE.** Пакет до разводки PWR-2 (главная P4-ветка).
> Общий обзор — `docs/38-dfm-testability.md`; CORE-2 — `hardware/core2/dfm.md`.

## 1. Test points (TP1…TP9 на схеме + 3 пада)

| TP | Цепь | Где | Назначение |
|---|---|---|---|
| TP1 | `PACK+` | после F1/Q1 | пакет 1S2P |
| TP2 | `VBAT` | после BMS | заряд/разряд |
| TP3 | `VSYS` | J3.1/2 | выход BQ24074 OUT |
| TP4 | `+12V` | J3.5/6 | шина +12 В (330 мА) |
| TP5 | `−12V` | J3.9/10 | шина −12 В (95 мА) |
| TP6 | `+5V` | J3.13/14 | шина +5 В (1.6 А) |
| TP7 | `5V_LED` | J3.17 | LED-ветвь |
| TP8 | `LED_RET` | J3.18 | возврат LED (Q7) |
| TP9 | `PWR_GOOD` | U7 | VSYS<2.70 В |
| TP-P1* | `EN_BUS12/N12/5V/LED5` | J4.7–10 | EN-линии |
| TP-P2* | `FUEL_SDA/SCL` | J4.3/4 | MAX17048 0x36 |
| TP-P3* | `NTC_PACK` | J4.2 | TS/NTC |

`*` — пады на разъёме J4 (доступ после сборки).

## 2. Self-test

| # | Тест | Метод | Pass |
|---:|---|---|---|
| 1 | Рельсы | DMM TP4/5/6/7: 11.7/−11.55/5.1/5.0 В | ±3 %, ripple ≤50 мВ |
| 2 | VSYS | TP3 3.0–4.4 В, master switch | без просадки при 3 А |
| 3 | PWR_GOOD | U7: VSYS<2.70 В → LOW | срабатывание, гистерезис |
| 4 | EN-линии | J4.7–10: high-Z=ON, high=OFF | +12/−12/+5 вкл/выкл по EN |
| 5 | MAX17048 | I2C 0x36: V/SOC | V ±15 мВ, SOC монотонен |
| 6 | NTC | J4.2 10 кОм | TS в окне, заряд не блокируется при 25 °C |
| 7 | Заряд | BQ24074 (CORE-2) 1 А | ток/тепло, termination |
| 8 | 5V_LED ключ | EN_LED5=1 | LED_RET замкнут на PGND через Q7 |

## 3. DFM

- Силовые пути: 3 А по VSYS/VBAT — ширина ≥3 мм/слой, 2 слоя меди, vias 0.3×3+;
  пары PGND в J3, звезда PGND у входных ёмкостей.
- J3 (IDC-20) 3 А — на границе; альтернатива Micro-Fit 3.0 (O-11/D-36): при падении >100 мВ
  или нагреве >30 °C перейти.
- Индукторы/бусты: тепловой зазор, полигоны, снабберы; −12 В IBB — изоляция GND МС.
- F1/F2-F5, TVS, NTC: посадочные, полярность, шелкография.
- BMS/пакет: холдеры вне платы (J1 3P), NTC на банке, Kelvin гейджа.
- Панелизация 2×2, fiducials, tooling; 4×M3 (по корпусу).
- Шелкография: `PWR-2 rev.1`, полярность, TP, rev/SN, предупреждение о токе 3 А.

## 4. Чек-лист перед PCB (15)

> **Процедура подтверждения п.1, 5, 11 (и всего gate «стенд до PCB»):**
> [`docs/44-pwr-bench.md`](../../docs/44-pwr-bench.md) — Часть II: 13 обязательных измерений
> T1…T13 (методика, приборы, точки, критерии PASS/FAIL по D-76, длительность, пустые таблицы),
> 3×3 load matrix, ripple+FFT (BL/Wi-Fi/WS2812), USB+charge+max load, ток OFF ≤100 мкА,
> BMS-пороги, переполюсовка, гейдж, EVM-бюджет. Платформа — EVM + пайка, **breadboard запрещён**.
> Карта стенда — [`bench-macet.md`](bench-macet.md).
> **PCB заказывается только при 13/13 PASS** (или документированном исключении Lead).

1. [ ] Бюджеты +12/−12/+5/5V_LED подтверждены стендом (КПД/тепло/шум).
2. [ ] J3/J4 pinout сверены с CORE-2 J17/J18.
3. [ ] VSYS/VBAT 3 А: ширина/медь/vias/термал.
4. [ ] Решение IDC-20 vs Micro-Fit 3.0 (O-11).
5. [ ] −12 В IBB: устойчивость/ripple/EN оптопара.
6. [ ] BMS/пакет/холдеры/предохранитель 5 А.
7. [ ] MAX17048 Kelvin, адрес 0x36, подтяжки.
8. [ ] PWR_GOOD/EN-линии 3.3 V-safe.
9. [ ] TVS/полифьюзы/супервизор.
10. [ ] TP1–TP9 + J4-пады доступны.
11. [ ] Тепло TPS61088/LMR33630 при max.
12. [ ] Панелизация/fiducials/крепёж.
13. [ ] Шелкография pin1/полярность/rev.
14. [ ] BOM-power2 и монтажная карта сходятся.
15. [ ] Производственный тест (рельсы/EN/гейдж) готов.
