martiyanov/bukifon/hardware/panel2/dfm.md

# PANEL-2 — DFM / testability

> **STATUS: PRE-FREEZE / DO NOT FABRICATE.** Пакет до разводки PANEL-2 rev.2 (главная P4-ветка).
> Общий обзор — `docs/38-dfm-testability.md`; CORE-2 — `hardware/core2/dfm.md`.

## 1. Test points (≤20, доступ после сборки)

| TP | Цепь | Где | Назначение |
|---|---|---|---|
| TP-P1 | `3V3` | J13.11 / пад | логика MCP23017/LCD |
| TP-P2 | `5V` (`5V_LED`) | J13.9/13 | LED-цепочка |
| TP-P3 | `DGND` | пад у J13 | опора |
| TP-P4 | `AGND` | пад у J14 | опора аналога |
| TP-P5 | `I2C0_SDA` | J13.1 | шина |
| TP-P6 | `I2C0_SCL` | J13.3 | шина |
| TP-P7 | `PANEL_IRQ` | J13.5 | INT экспандеров |
| TP-P8 | `LED_DATA` | J13.7 | WS2812 |
| TP-P9 | `BL_PWM` | J12.30 | подсветка |
| TP-P10 | `BL_ANODE` | J12.31 | 19–22 В (осторожно) |
| TP-P11 | `CVOUT1…4` | J14.1/3/5/7 | CV выходы |
| TP-P12 | `CVIN1…4` | J14.9/11/13/15 | CV входы |
| TP-P13 | `GATE_OUT` | J14.17 | GATE |
| TP-P14 | `GATE_IN_CLEAN` | J14.19 | GATE вход |
| TP-P15 | `FADER1/2` | J14.21/23 | фейдеры |

## 2. Self-test

| # | Тест | Метод | Pass |
|---:|---|---|---|
| 1 | Матрица 42 клавиши | скан 6×7 через MCP23017 0x23, диагональные комбинации | все 42, фантомов 0 |
| 2 | 16 энкодеров | A/B/push через 0x20/0x21/0x22 | 16/16, шаг/направление, debounce |
| 3 | INT панели | IOC по клавише/энкодеру | IRQ ≤5 мс |
| 4 | LED-цепочка 17 WS2812 | залить белым/цветами, проверить порядок | 17/17, без мерцания |
| 5 | Дисплей RGB565 | тест-картинка 800×480, BL_PWM 10–100 % | нет битых пикселей/полос |
| 6 | Фейдеры | MCP3208 CH2/3 (на CORE-2) | 0…3.3 В, шум ≤3 LSB |
| 7 | Джеки CV/GATE | loopback J14 ↔ CORE-2 CV | ошибка ≤±0.5 % FS, защита не греется |
| 8 | I2C-адреса | скан 0x20–0x23 | все 4 чипа, без конфликтов |

## 3. DFM

- FFC-40 J12: pin1/ключ, stiffener, ground fingers, без меди/TP под шлейфом; кабель ≤150 мм.
- IDC-16 J13 / IDC-26 J14: ключ, pin1, ответные вилки; J14 — «сигнал/GNDA» (нечёт/чёт).
- 10 джеков: шаг 13.1 мм, крепёж на панель, зазор до энкодеров; TVS/RC у джеков.
- Энкодеры/клавиши: 10 кОм/100 нФ фильтры, посадочные под EC11/Choc, без люфта.
- Панель: 6×M3? (по docs/21 — крепёж корпуса), зазор до шлейфа, шелкография подписей джеков.
- LED: 74HCT1G125 (если 5 В) или прямой 3.3 В, 330 Ω, 100 нФ на LED.
- Шелкография: `PANEL-2 rev.2`, pin1, полярность, номера джеков/клавиш, SN-зона.
- Панелизация: 2×2 с рельсами, fiducials, V-score.

## 4. Чек-лист перед PCB (15)

1. [ ] J12 FFC-40 pinout сверен с CORE-2 J15 (D-19).
2. [ ] J13/J14 pinout сверены с CORE-2 J16/J14.
3. [ ] 4×MCP23017 адреса 0x20–0x23, INT wire-OR, 3 линии J13.15/J14.25/GATE_IN.
4. [ ] LED_DATA 3.3 В и level shifter на PANEL-2.
5. [ ] BL_ANODE/BL_CATHODE и зазоры 20 В.
6. [ ] Джеки/фейдеры/энкодеры/клавиши посажены по panel-spec.
7. [ ] TVS/RC защита джеков.
8. [ ] 6×M3/крепёж и высоты по корпусу.
9. [ ] TP не под шлейфами/джек-полем.
10. [ ] Шелкография pin1/полярность/rev/SN.
11. [ ] I2C подтяжки 4.7 к/2.2 к и ёмкость шины.
12. [ ] Скан-матрица без фантомов (диоды 1N4148).
13. [ ] Панелизация/fiducials/tooling.
14. [ ] BOM-panel2 и монтажная карта сходятся.
15. [ ] Производственный self-test (раздел 2) готов в прошивке.
