martiyanov/bukifon/hardware/power2/interfaces.md

# PWR-2 ↔ CORE-2 — интерфейсный контракт

> **STATUS: PRE-FREEZE / DO NOT FABRICATE.** Контракт исследовательский: часть выводов
> требует правки CORE-2 rev.2 (см. §5). Схема PWR-2: [`PWR-2.kicad_sch`](PWR-2.kicad_sch),
> бюджеты: [`power-tree-pwr2.md`](power-tree-pwr2.md).

## 0. Роли плат в триаде

| Плата | Что делает | Что НЕ делает |
|---|---|---|
| **CORE-2** | ESP32-P4+PSRAM, аудио, CV, USB-C (данные+MIDI+UAC2), **BQ24074 (заряд + power-path)**, +3V3/+3V3_C6/+3V3_MCU, BL-boost 19–22 В, шина IDC-26 | не содержит батарейного пакета, BMS и рельсов ±12 В/+5 В (переданы PWR-2) |
| **PANEL-2** | 4 × MCP23017, LCD RGB565, энкодеры/клавиши, джеки CV/GATE | не питается от PWR-2 напрямую (только через CORE-2) |
| **PWR-2** | пакет 1S2P + BMS + NTC + предохранитель + reverse-FET, MAX17048, master load-switch, **+12 В / −12 В / +5 В / +5V_LED**, PWR_GOOD, EN | не заряжает батарею, не формирует 3.3 В, не питается от PACK напрямую (только VSYS) |

**Единственный путь энергии в преобразователи PWR-2 — `VSYS` (выход BQ24074 OUT).**
Это требование ревью: иначе ломается power-path и окончание заряда.

---

## 1. J3 — силовой разъём PWR-2 ↔ CORE-2 (IDC-20, 2×10, 2.54 мм)

Парные пины — для парной трассировки supply/return и распределения тока 3 А.
Возвраты на PWR-2 сведены в одну звезду PGND (на PCB, у входных ёмкостей).

| Pin | Сигнал | Направление | Уровень / ток | Примечание |
|---:|---|---|---|---|
| 1, 2 | **VSYS** | CORE-2 → PWR-2 | 3.0…4.4 В, до **3 А** | выход BQ24074 OUT (power-path); вход master-switch PWR-2 |
| 3, 4 | **VBAT** | PWR-2 → CORE-2 | 3.0…4.2 В, заряд до 1.5 А / разряд до 3 А | P+ после BMS (Q1/Q2/Q3) → BQ24074 BAT; путь заряда |
| 5, 6 | **+12V** | PWR-2 → CORE-2 | **11.7 В** (после D7), бюджет 330 мА, пик 420 мА | идёт в CORE-2 на вход 12 В (диод ИЛИ с внешним БП, см. §5.2) |
| 7, 8 | **PGND** | — | возврат +12 В | пара к +12 В |
| 9, 10 | **−12V** | PWR-2 → CORE-2 | **−11.55 В** (после D8), бюджет 95 мА, пик 150 мА | шина модулей, аналоговые картриджи |
| 11, 12 | **PGND** | — | возврат −12 В | пара к −12 В (для IBB возврат = PGND) |
| 13, 14 | **+5V** | PWR-2 → CORE-2 | 5.10 В, бюджет 1.6 А, пик 2.0 А | логика, аудио (PCM1808), MIDI, вход BL-boost, LDO 3V3/3V3_C6, MP1584 |
| 15, 16 | **PGND** | — | возврат +5 В | пара к +5 В |
| 17 | **5V_LED** | PWR-2 → CORE-2 | 5.0 В, 0.55 А (прошивочный cap) | питание цепочки WS2812 (74 LED) |
| 18 | **LED_RET** | PWR-2 ← CORE-2 | возврат LED, 0.55 А | **коммутируемый возврат**: Q7 (AO3400A) на PWR-2; OFF = цепочка обесточена |
| 19, 20 | **PGND** | — | общий | единственная «силовая» точка соединения земель |

Токи: 2 пина на цепь, IDC 2.54 мм ≈ 1 А/контакт → 2 А на пару. Для 3 А (VSYS/VBAT) —
**на границе**: см. открытый вопрос в `power-tree-pwr2.md` §9.5 (переход на Micro-Fit 3.0).

## 2. J4 — управляющий разъём (IDC-12, 2×6, 2.54 мм)

| Pin | Сигнал | Направление | Уровень | Примечание |
|---:|---|---|---|---|
| 1 | **BATT_MON** | PWR-2 → CORE-2 | 3.0…4.2 В (сырой VBAT через 1 к) | на CORE-2 → делитель 100k/47k → **MCP3208 CH6** (резервный контроль) |
| 2 | **NTC_PACK** | PWR-2 → CORE-2 | 10 k NTC, нижний вывод = B− | на CORE-2 → **TS BQ24074** (обязателен!) и делитель 10k/10k → **CH7 TEMP_MON** |
| 3 | **FUEL_SDA** | ↔ | 0/3.3 В, open-drain | I2C0 CORE-2, **адрес MAX17048 = 0x36**; подтяжки 2.2k — на CORE-2; на PWR-2 серия 22 Ом |
| 4 | **FUEL_SCL** | ← CORE-2 | 0/3.3 В | то же |
| 5 | **FUEL_ALRT** | PWR-2 → CORE-2 | open-drain, LOW = тревога | подтяжка на CORE-2 (100k к +3V3) |
| 6 | **PWR_GOOD** | PWR-2 → CORE-2 | open-drain, **LOW = VSYS < 2.70 В** | подтяжка на CORE-2 (100k к +3V3); активный низкий! |
| 7 | **EN_BUS12** | CORE-2 → PWR-2 | 0/3.3 В, high-Z = rail ON | **высокий уровень ВЫКЛЮЧАЕТ +12 В** (Q9 тянет EN МС к PGND) |
| 8 | **EN_N12** | CORE-2 → PWR-2 | 0/3.3 В, high-Z = rail ON | высокий = ВЫКЛ −12 В (через PC817, ток LED ≤ 2.1 мА) |
| 9 | **EN_LED5** | CORE-2 → PWR-2 | 0/3.3 В | **высокий = LED-ветка ВКЛ** (Q7 low-side); по умолчанию OFF |
| 10 | **EN_5V** | CORE-2 → PWR-2 | 0/3.3 В, high-Z = rail ON | высокий = ВЫКЛ +5 В (Q10) |
| 11, 12 | **PGND** | — | — | возврат сигналов |

**Полярность EN:** EN_BUS12 / EN_N12 / EN_5V — «active-high disable» (pull-up внутри
PWR-2, CORE-2 только тянет/отпускает), поэтому входы **3.3 V-safe** (никаких 4.2 В на
GPIO). EN_LED5 — «active-high enable». Дефолт без CORE-2: все рельсы, кроме LED, включены.

### 2.1 Семантика PWR_GOOD

`PWR_GOOD` — open-drain выход супервизора **MCP130-270** (порог 2.70 В, гистерезис 10 мВ):
- VSYS ≥ 2.70 В → выход отпущен → CORE-2 (подтяжка 100k к +3V3) читает **1**;
- VSYS < 2.70 В → выход притянут к PGND → **0**;
- UVP BMS 2.35–2.50 В — ниже порога PWR_GOOD, т.е. система узнаёт о проблеме заранее.

## 3. Что PWR-2 предоставляет CORE-2 по энергии (сводка)

| Рельс | Vout на J3 | Бюджет | Пик | КПД | Тепло на PWR-2 |
|---|---|---|---|---|---|
| +12V | 11.7 В (12.15 до D7) | 330 мА | 420 мА | 0.93 | 0.30 Вт |
| −12V | −11.55 В (−12.0 до D8) | 95 мА | 150 мА | 0.87 | 0.17 Вт |
| +5V | 5.10 В | 1.6 А | 2.0 А | 0.91 | 0.81 Вт |
| 5V_LED | 5.0 В + LED_RET | 0.55 А | 2.5 А (F5) | ≈1.0 | 0.01 Вт |
| VBAT | 3.0…4.2 В | 3 А | 5–8 А (BMS) | ≈1.0 | 0.2…0.4 Вт |

Падения D7/D8 (по 0.45 В) намеренны: это защита от back-feed внешнего 12 В и от
взаимного «перетягивания» источников. Бюджеты CORE-2 (12 В: 330 мА) с запасом 25 %
перекрываются с учётом падения.

## 4. Земля (правила, обязательные на PCB)

1. На PWR-2 — **одна силовая земля PGND** (медно-сплошная, без разрезов под
   преобразователями); возвраты ±12 В/+5 В/LED подводятся к звезде у входных ёмкостей
   отдельными полигонами/дорожками (парная трассировка).
2. Соединение с CORE-2 — **одним силовым путём** через J3 pins 19/20 (и пары возвратов);
   на CORE-2 это приходит в звезду PGND/AGND (net-tie).
3. **AGND аудио/CV формируется на CORE-2** (одна точка). PWR-2 не имеет AGND — это
   осознанно: на PWR-2 нет аналоговых сигналов, только медленные делители.
4. Возврат WS2812 и BL-boost **не должен** идти через землю PCM1808/PCM5102A:
   - WS2812: возврат = `LED_RET` → Q7 → PGND на PWR-2 (не через аудио-полигон CORE-2);
   - BL-boost: остаётся на CORE-2, его возврат — отдельный полигон PGND у boost.
5. ±12 В трассировать парой (supply + return) от J3 до входов модулей.

## 5. Требуемые правки CORE-2 rev.2 (вне зоны PWR-2)

| # | Что | Зачем |
|---|---|---|
| 5.1 | **DNP**: U2 MT3608 (+5 В), U5 MC34063 (−12 В), BMS (BQ297xy + 2 × N-MOS) | два источника на одной шине недопустимы; пакет и рельсы теперь на PWR-2 |
| 5.2 | **+12 В от PWR-2** завести на узел `12V_EXT` (там уже есть SS34 D2 «diode-OR external 12 V (PWR-2)»); внешний БП 12 В остаётся на J-DC/12V_EXT | D7 на PWR-2 не даёт внешнему БП back-feed'ить буст; при внешних 12 В шина = 11.55 В, при батарее = 11.7 В; MT3608 #1 можно оставить (DNP по желанию) — конфликта нет благодаря D2 |
| 5.3 | **+5 В от PWR-2** подать вместо выхода MT3608 #2 на узел +5 В (после его DNP) | тот же принцип; BL-boost #3 остаётся на CORE-2 и питается от PWR-2 +5 В |
| 5.4 | **−12 В от PWR-2** подать на узел −12 В (после DNP MC34063) | отрицательные источники нельзя диод-ИЛИть |
| 5.5 | подтяжки `PWR_GOOD` и `FUEL_ALRT` — 100k к +3V3 на CORE-2 | open-drain выходы PWR-2 |
| 5.6 | EN-линии (4 шт.): в бюджете GPIO P4 **0 свободных** → взять с PANEL-2 MCP23017 (свободные линии экспандеров) и провести на J4 CORE-2 | иначе EN не управляются; дефолт PWR-2 = всё включено, LED выключен |
| 5.7 | `NTC_PACK` → TS BQ24074: проверить обвязку TS (10 k NTC, окно 0…45 °C) | обязательный температурный контроль заряда |
| 5.8 | `BATT_MON` → CH6, `NTC_PACK` → CH7 (делители уже есть в CORE-2) | резервный ADC-контроль |
| 5.9 | +5 В бюджет 1.6 А (сейчас 1.0 А) **или** перевести MP1584 на +12 В | в CORE-2 не учтён вход MP1584 (~0.51 А) |
| 5.10 | Бюджет VSYS 3 А: одновременный максимум 2.74…4.9 А — прошивочный cap + предупреждение по PWR_GOOD | power-path BQ24074 |

## 6. I2C — карта адресов (CORE-2 I2C0)

| Адрес | Устройство | Плата |
|---|---|---|
| 0x20…0x23 | MCP23017 ×4 | PANEL-2 |
| 0x36 | **MAX17048 (fuel gauge)** | **PWR-2** |
| 0x57 | 24C32 (калибровка) | CORE-2 |
| 0x60, 0x61 | MCP4728 ×2 | CORE-2 |

Конфликтов нет. Подтяжки 2.2k стоят на CORE-2; на PWR-2 — последовательные 22 Ом
(R11/R12) и 100 nF у гейджа. Шина 3.3 В; MAX17048 питается от банки (до 4.2 В), его
I/O — open-drain, абсолютный максимум по datasheet проверить (ревью: 6 В — ок).

## 7. Калибровка гейджа (1S2P)

1. **RCOMP** — по химии банок (Li-ion 3.6/3.7 В: типовое значение подбирается зарядом/
   разрядом; регистр 0x0C `CONFIG`); после записи — `POR`/`QUICKSTART` (регистр 0x06 =
   0x4000) и обнулить `SOC` (0x06 = 0x0000) для пересчёта.
2. **Полный цикл**: заряд до 4.20 В (CV-хвост по BQ24074) → пауза 2 ч → разряд реальной
   нагрузкой до 3.0 В (лог 1 Гц по I2C) → заряд. Проверить: SOC 100 % при 4.18…4.20 В,
   SOC 0 % при 3.0…3.1 В, линейность в середине.
3. **Параллельные банки (1S2P)**: гейдж видит суммарное напряжение и считает SOC по
   напряжению → **ёмкость не измеряется** (MAX17048 — ModelGauge v3 по напряжению/модели,
   не кулонометр). Для % заряда в 1S2P это корректно (напряжение то же), но:
   - `SOC` будет «прыгать» при нагрузке из-за Ri·I (2 × 18650: Ri ≈ 25 мОм/банка →
     12 мОм/пара; при 3 А просадка 36 мВ ≈ 3 % SOC — допустимо);
   - калибровать при **типичной** нагрузке (не на холостом ходу);
   - заводской `VERSION` (0x08) и `CONFIG` зафиксировать в 24C32 (калибровки CORE-2).
4. **Резервный ADC**: `BATT_MON` (CH6) даёт абсолютное напряжение без I2C — по нему
   проверять согласие с гейджем (±30 мВ); расхождение > 50 мВ = плохой контакт/смещение.
5. **Температура**: NTC → TS (заряд) и CH7 (прошивка); гейдж температуры не измеряет.

## 8. Последовательность включения (рекомендация)

```
USB/батарея → BQ24074 OUT = VSYS (CORE-2) → J3 → master switch →
   +5V (CORE-2: 3V3_MCU/3V3_C6/3V3, BL-boost вход) → P4 старт →
   прошивка включает +12/−12 (EN = 0/отпущено) → аналоговые модули → LED-ветка (EN_LED5=1) → BL
```
Отключение: LED → BL → ±12 В (EN = 1) → master switch (всё). BMS — только авария.

## 9. Открытые вопросы по интерфейсу

1. Разъём J3 при 3 А (IDC-20, 2 пина/цепь) — см. §9.5 в `power-tree-pwr2.md`.
2. Точка подключения +12 В на CORE-2: `12V_EXT` (с D2) или отдельный вход с ещё одним
   SS34 — влияет на итоговое падение (0.45 vs 0.9 В).
3. 4 EN-линии при 0 свободных GPIO P4 — источник линий (MCP23017 PANEL-2) и их путь.
4. PWR_GOOD активный низкий — подтвердить прошивкой CORE-2.
5. Нужен ли `MASTER_SW` (состояние тумблера) в CORE-2? Сейчас **не выводится** (при
   выключенном тумблере CORE-2 всё равно обесточен, читать нечем).
