martiyanov/bukifon/hardware/power2/power-tree-pwr2.md

# PWR-2 — дерево питания, токи, КПД и тепло

> **STATUS: PRE-FREEZE / DO NOT FABRICATE.** Числа — расчётные (даташиты + бюджеты
> CORE-2 `hardware/core2/power-tree.md`); на макете не измерялись. См. §8 (стенд) и
> `docs/schema/pwr2.md` (перечень обязательных измерений до разводки).

Схема: [`PWR-2.kicad_sch`](PWR-2.kicad_sch) · генератор: [`gen_pwr2_sch.py`](gen_pwr2_sch.py) ·
интерфейс: [`interfaces.md`](interfaces.md) · ERC: `erc/erc.rpt` (0 errors / 0 warnings).

---

## 1. Топология

```
                    J1 PACK (2x18650 1S2P, 3.0...4.2 В)
                          │  B+ ── F1 5 A ── Q1 P-FET (reverse) ── VBAT ──► J3 «VBAT» ──► CORE-2 BQ24074 BAT
                          │                                          │
                          │  B- ── BMS (BQ297xy + Q2/Q3 AO3400A) ── P- (PGND)
                          │
                          └── TH1 NTC 10k ──► J4 «NTC_PACK» ──► CORE-2 TS BQ24074 (и CH7 TEMP_MON)
                                                 └──► MAX17048 (I2C 0x36, Kelvin на банку)

   CORE-2 BQ24074 OUT ──► VSYS (J3) ──► Master load switch (Q4/Q5 back-to-back, Q6 драйвер)
                                            │
                                        VSYS_SW ──┬── U3 TPS61088 boost ──► 12.15 В ── C-L-C ── F2 0.5 A ──► +12V шины (330 мА)
                                                  ├── U6 TPS61088 boost ──►  5.10 В ── C-L-C ── F4 2 A   ──► +5V  (1.6 А)
                                                  │                                              └── F5 2.5 A ──► 5V_LED ──► Q7 low-side ──► LED_RET
                                                  └── U4 LMR33630 IBB   ──► -12.0 В ── C-L-C ── F3 0.3 A ──► -12V шины (95 мА)
                                                          (GND МС = -12 В, VIN = VSYS+12 В = 15.7 В)
```

Ключевые принципы (по ревью консультанта, 2026-11-05):

1. **Заряд и power-path остаются на CORE-2** (BQ24074). PWR-2 не заряжает и не «отбирает»
   батарею: единственный вход энергии для преобразователей — **VSYS = BQ24074 OUT**.
   Поэтому при подключённом USB система питается от USB, а батарея заряжается — power-path
   не ломается.
2. **BMS — аварийная защита, а не кнопка питания.** Питание выключает master load-switch
   (back-to-back P-FET + драйвер) по панельному тумблеру; BMS срабатывает только при
   OVP/UVP/OCP/SCP.
3. **Нет MC34063 и нет charge-pump** (см. §3): +12 В — синхронный boost, −12 В —
   инвертирующий buck-boost (IBB), +5 В — синхронный boost.
4. **Питание батареи: 2×18650 → F1 5 А → Q1 (защита от переполюсовки) → BMS → VBAT → BQ24074 BAT.**
   Ideal-diode между BMS и BQ24074 не нужен (единственный путь, его роль играет power-path).
5. **±12 В и +5 В — свои π-фильтры C-L-C** (22–47 мкФ / 4.7–10 мкГн / 47–100 мкФ) и
   полифьюзы на выходе; возвраты — отдельными пинами в разъёме (парные).
6. **`PWR_GOOD`** = open-drain выход супервизора MCP130-270 (LOW = VSYS ниже 2.70 В);
   подтяжка — на CORE-2 к +3V3.

---

## 2. Таблица рельсов (Vin / Vout / Imax / КПД / тепло)

Расчёт: `Pin = Pout/η`; `Iin = Pin/Vin`; `Heat = Pin − Pout`. Vin = VSYS (3.0…4.4 В,
номинал 3.7 В); Iin приведён для 3.7 В и для худшего 3.0 В.

| Рельс | Топология | Vout | Imax (бюджет) | Возможность | η | Pout | Pin @3.7 В | Iin @3.7 В | Iin @3.0 В | Тепло |
|---|---|---|---|---|---|---|---|---|---|---|
| **+12V** | TPS61088 sync boost, L 10 мкГн | 12.15 В | **330 мА** | 420 мА (ключ 10 А) | 0.93 | 4.01 Вт | 4.31 Вт | 1.17 А | 1.44 А | **0.30 Вт** |
| **−12V** | LMR33630 IBB (floating GND), L 22 мкГн | −12.0 В | **95 мА** | 150 мА | 0.87 | 1.14 Вт | 1.31 Вт | 0.35 А | 0.44 А | **0.17 Вт** |
| **+5V** | TPS61088 sync boost, L 10 мкГн | 5.10 В | **1.6 А** | 2.0 А (ключ 10 А) | 0.91 | 8.16 Вт | 8.97 Вт | 2.42 А | 2.99 А | **0.81 Вт** |
| **+5V_LED** | AO3400A low-side (28 мОм) + F5 2.5 А | 5.0 В | 0.55 А (прошивка) | 2.5 А (полифьюз) | ≈1.00 | 2.75 Вт | (учтено в +5V) | — | — | 0.008 Вт |
| **VBAT→BQ24074** | BMS 2×AO3400A + F1 5 А + Q1 | 3.0…4.2 В | 3.0 А | 5–8 А (BMS) | ≈1.00 | — | — | — | — | 0.18…0.36 Вт (BMS, Q1) |
| **Master switch** | 2×AO3401A back-to-back (≈22 мОм) | — | 3.0 А | 4 А | ≈1.00 | — | — | — | — | 0.20 Вт @3 А |

### 2.1 Бюджеты по нагрузкам (откуда 330 / 95 / 1.6 А)

**+12 В (330 мА)** — шина модулей, 2 порта: 2 × 60 мА = 120 мА; ОУ аудио/ЦАП по +12 В = 30 мА;
запас на 1 аналоговый картридж/расширение = 180 мА. Лимит по ТЗ — «≤300 мА»: бюджет 330 мА
есть **потолок шины**, а не непрерывная нагрузка.

**−12 В (95 мА)** — 2 порта × 40 мА = 80 мА; V− ОУ (TL074/TL072, PCM5102A charge pump не
использует −12 В, но ОУ сумматора/буфера — да) = 15 мА. Лимит по ТЗ «≤300 мА»: превышение
бюджета в 3 раза **невозможно физически** на 1S — при 300 мА×12 В = 3.6 Вт от батареи это
3.6/(0.87·3.0) = 1.4 А только на отрицательный рельс; поэтому бюджет зафиксирован 95 мА, а
возможность преобразователя — 150 мА (запас 58 %).

**+5 В (1.6 А)** — ⚠️ здесь **исправлен бюджет CORE-2** (в `hardware/core2/power-tree.md`
указано 1000 мА):

| Нагрузка +5 В | Ток |
|---|---|
| WS2812-цепочка 74 LED (прошивочный cap) | 550 мА |
| PCM1808 VCC 30 + MIDI 10 + панельная логика 20 | 60 мА |
| AP2112K-3.3 (+3V3 периферия, бюджет 150 мА) | 110 мА (вход LDO) |
| AP2112K-3.3 (+3V3_C6, бюджет 250 мА) | 190 мА (вход LDO) |
| **MP1584 → +3V3_MCU (700 мА из 5 В)** | **510 мА** ← в CORE-2 пропущено |
| вход BL-boost (19–22 В) | 80 мА |
| **Итого** | **1500 мА** → бюджет 1.6 А, возможность 2.0 А |

Это открытый пункт для CORE-2 rev.2: либо +5 В бюджет 1.6 А (как здесь), либо +3V3_MCU
питать от +12 В (buck с 12 В выгоднее: 3.3·0.7/(0.88·12.15) = 216 мА по +12 В против
510 мА по +5 В). **Рекомендация: перевести MP1584 на +12 В** — снимает 0.5 А с +5 В.

### 2.2 Одновременная нагрузка на VSYS (ограничение BQ24074)

| Сценарий | +12 В | −12 В | +5 В | Pin (3.7 В) | I(VSYS) @3.7 В | I @3.0 В |
|---|---|---|---|---|---|---|
| Idle (меню, LED 20 %) | 60 мА | 20 мА | 0.35 А | 0.22+0.28+1.96 = 2.5 Вт | 0.66 А | 0.82 А |
| Типичный (1 модуль, LED 40 %) | 180 мА | 55 мА | 0.85 А | 2.35+0.76+4.76 = 7.9 Вт | 2.13 А | 2.62 А |
| Реалистичный максимум | 240 мА | 80 мА | 1.05 А | 3.14+1.10+5.89 = 10.1 Вт | **2.74 А** | **3.38 А** |
| Сумма паспортных бюджетов | 330 мА | 95 мА | 1.6 А | 4.31+1.31+8.97 = 14.6 Вт | **3.94 А** | **4.87 А** |

**Ограничение (исключение, зафиксировано):** BQ24074 power-path рассчитан на ~3 А
(`hardware/core2/power-tree.md`: VSYS 3000 мА). Сумма бюджетов (3.94…4.87 А) **недостижима**
одновременно; реалистичный максимум 2.74 А @3.7 В (запас 9 % к 3 А — ниже нормы 25 %).
Причины: 1S-батарея + power-path 3 А, а не преобразователи PWR-2 (у них запас 2.4…7×).

**Меры (обязательны на этапе прошивки/наладки):**
1. Прошивочный cap LED (550 мА) — уже в бюджете; на батарее ≤ 30 % яркости.
2. Запрет «3 аналоговых картриджа + максимальная яркость» одновременно на батарее.
3. `PWR_GOOD` + `BATT_MON` → предупреждение и автоснижение яркости.
4. Для полной мощности — внешний 12 В на J-DC (диод ИЛИ на CORE-2, D2 SS34) либо переход на
   **2S-пак** в rev.2 (тогда ±12 В бусты работают с 7.4 В, КПД выше, токи в 2 раза ниже).
5. Не забыть: BQ24074 ILIM 1.5 А ограничивает **заряд**, не систему; system-путь — отдельный.

---

## 3. Почему ±12 В именно так (сравнение топологий)

Решения **D-27/D-28** (`spec/90-requirements-registry.md`) и `docs/25-power-architecture.md`.

Требование: **+12 В ≤ 330 мА** и **−12 В ≤ 95 мА** из 1S (3.0…4.4 В), шум в аудиополосе
минимален (рельсы идут в аналоговые картриджи и ОУ), цена/размер — DIY-уровня.

| Вариант | КПД (3.7→12 В) | Шум | Цена | Размер | Тепло | Вывод |
|---|---|---|---|---|---|---|
| **MC34063 инвертор + boost** | 55…75 % | плохой: 33…50 кГц, иглы 2.5 А ключа в аудиополосе и выше | $0.2 | малый | 1.2…1.7 Вт на −12 В | **исключён** (ревью): ключ 1.5 А не тянет 12 В/300 мА из 3 В (нужно 1.9 А), КПД/шум неприемлемы |
| **Charge-pump + LDO** | 30…60 % | средний | $0.3 | малый | высокий (LDO) | **исключён**: 12 В из 3.7 В требует ×4 каскада; >100 мА недостижимы |
| **Push-pull трансформатор ±14 В + LDO** | 70…76 % (без потерь LDO) | **лучший** (изолированный, после LDO < 1 мВ) | $5…7 | средний | 0.5…0.8 Вт на LDO + 0.4 Вт ключи | **резерв**: нет в наличии дешёвого трансформатора 1:4 для SN6501/SN6505 под 3.3 В→12 В; оставить как вариант rev.2, если шум не пройдёт стенд |
| **✅ Выбрано: TPS61088 sync boost (+12 В) + LMR33630 IBB (−12 В)** | **93 % / 87 %** | средний, снимается C-L-C π-фильтром и раздельными возвратами | $1.7 + $0.9 | малый: 2 индуктора 10/22 мкГн, QFN-20 + SOIC-8 | **0.30 + 0.17 Вт** | лучший баланс: 2 современных синхронных преобразователя, нет кастомных магнитиков, есть запас по току/теплу |

### 3.1 Как работает −12 В (IBB, ключевая инженерная деталь)

LMR33630 — обычный **синхронный buck**, включённый «инвертирующим buck-boost» (TI SLVA542):
- «земля» микросхемы (pin 1/9) подключена к **−12 В**;
- VIN микросхемы = VSYS − (−12 В) = **15.7 В** при 3.7 В батареи (макс 16.4 В, керамика 25 В);
- выход buck = **системная земля (PGND)**, т.е. относительно своей земли МС выдаёт +12 В
  (коэффициент 12/15.7 = 0.76 — штатный buck);
- индуктор L3 идёт от SW к PGND; входные ёмкости — между VSYS и −12 В, выходные — между PGND
  и −12 В;
- ОС — обычный делитель R19/R20 в домене МС (Vref 1.0 В): `|Vout| = 1.0·(1+110k/10k) = 12.0 В`;
- **EN** — через оптопару PC817 (уровень CORE-2 3.3 В → домен −12 В), дефолт ON;
- PGND-возврат рельса — это PGND (по топологии), поэтому пара «−12 В / возврат» на разъёме
  реализована как два пина PGND рядом с −12 В (парная трассировка, звезда на PWR-2).

Почему не «просто MC34063 с плавающей землёй» (как в CORE-1 rev.1): тот же принцип, но
MC34063 не синхронный, ключ 1.5 А, 33 кГц, КПД 70 % — на 3 В батареи это 1.4 А входа и
1.2 Вт тепла. LMR33630 — синхронный, 400 кГц…2.1 МГц, Rds малый, тепла 0.17 Вт.

### 3.2 Почему +12 В и +5 В — один и тот же TPS61088

- +12 В: 330 мА из 10-А ключа → запас 4.4×, η 93 %, тепла 0.3 Вт.
- +5 В: 1.6 А → запас 2.4×, η 91 %.
- Один MPN в BOM и **одна квалифицируемая микросхема** на стенде (меньше риска для
  PRE-FREEZE), одинаковая обвязка (SS, FB, π-фильтр).
- Альтернатива для cost-down после замера: **+5 В на TPS61090** (2 А, $1.0, 16-pin QFN),
  с исключением «при VBAT < 3.4 В LED cap 400 мА» (Iin 2.3 А > 2 А ключа). Зафиксировано.

---

## 4. Защиты и поведение

| Узел | Защита | Где |
|---|---|---|
| Пакет | предохранитель F1 5 А, TVS D1 SMBJ5.0A, NTC TH1 10 k на банке | PWR-2 |
| Переполюсовка банки/пакета | Q1 P-FET (body diode в рабочем направлении, обратное — закрыто) + **держатели с ключом** + маркировка; F1 как вторичная защита | PWR-2 |
| BMS | BQ297xy: OVP 4.25–4.30 В, UVP 2.35–2.50 В, OCP/SCP через Q2/Q3 (AO3400A, 2×2.8 А имп.) + F1 | PWR-2 |
| Заряд | BQ24074: ILIM 1.5 А, DPPM, TS по NTC (заряд запрещён < 0 °C и > 45 °C), ITERM, TMR | CORE-2 |
| КЗ/перегрузка выходов | F2 0.5 А (+12 В), F3 0.3 А (−12 В), F4 2 А (+5 В), F5 2.5 А (LED) — самовосстанавливающиеся | PWR-2 |
| Импульсы/статика на рельсах | D3 SMAJ15A (12 В), D4 SMAJ15A (−12 В), D5/D6 SMBJ5.0A (5 В/LED), D2 SMBJ5.0A (VSYS_SW) | PWR-2 |
| Плавный старт | SS-конденсаторы TPS61088 (C9/C28), C-L-C фильтры, C2 100 n на затворах load-switch (ограничение inrush), внутренний soft-start LMR33630 | PWR-2 |
| Разряд при выключении | R17 4.7 k (+12 В), R24 4.7 k (−12 В), R28 1 k (+5 В), R32 1 k (5V_LED), R29 100 k (LED_RET) | PWR-2 |
| Обратная закачка с шины | CORE-2: SS34 (D2) на внешний 12 В; на PWR-2 — полифьюзы + TVS | CORE-2/PWR-2 |
| «Не сосать батарею» при OFF | master switch режет VSYS_SW (все преобразователи), LED-ветка OFF по умолчанию, утечки PWR-2 ≤ 10 мкА (§6) | PWR-2 |

**Порядок секвенирования (рекомендация прошивке):** VSYS → +5 В (нужен для логики CORE-2) →
+12/−12 В (EN по умолчанию ON) → LED-ветка по команде → BL по команде. Выключение обратное:
LED → аналоговые ±12 В → +5 В → master switch.

---

## 5. Тепловой бюджет

| Источник тепла | При бюджете | При реалистичном максимуме |
|---|---|---|
| U3 TPS61088 (+12 В) | 0.30 Вт | 0.22 Вт |
| U4 LMR33630 (−12 В) | 0.17 Вт | 0.14 Вт |
| U6 TPS61088 (+5 В) | 0.81 Вт | 0.53 Вт |
| Master switch Q4/Q5 (22 мОм, 3 А) | 0.20 Вт | 0.13 Вт |
| BMS Q2/Q3 + Q1 + F1 (~50 мОм, 2.4 А) | 0.29 Вт | 0.29 Вт |
| LED-ключ Q7 (28 мОм, 0.55 А) | 0.008 Вт | 0.008 Вт |
| Гейдж + делители + EN | 0.01 Вт | 0.01 Вт |
| **Итого PWR-2** | **≈ 1.8 Вт** | **≈ 1.3 Вт** |

Оценка перегрева: плата 130 × 80 мм, 2 слоя 35 мкм, двусторонняя медь ≈ 208 см²;
естественная конвекция h ≈ 10 Вт/(м²·К) → Rth ≈ 1/(10·0.0208) ≈ 4.8 К/Вт (идеал) —
реально с учётом локальных пятен **10…20 К/Вт**. При 1.3…1.8 Вт: **ΔT ≈ 15…30 К**
→ при 40 °C внутри корпуса корпуса ИС ≤ 70 °C (TPS61088 θJA ≈ 45 К/Вт в QFN-20 3×3;
при 0.81 Вт на +5 В → +36 К от своего полигона; нужно ≥ 300 мм² меди под U6 и thermal vias).

**Вне PWR-2, но критично (передать в CORE-2):** BQ24074 линейный — при заряде 1.5 А
рассеивает (5.0 − 3.7)·1.5 ≈ **1.95 Вт** → нужен полигон ≥ 400…600 мм², 9 thermal vias,
термотест 30 мин (корпус ≤ 85 °C), при перегреве — снизить заряд до 1.0 А (ISET).

---

## 6. Ток выключенного состояния

| Потребитель (master OFF, USB отключён) | Ток от банки |
|---|---|
| MAX17048 (VDD = Kelvin на банку) | ≤ 3 мкА (sleep) |
| BMS BQ297xy + утечки FET | ≤ 3 µА (datasheet) |
| Q1/Q2/Q3/Q9/Q10 утечки | ≤ 2 µА |
| MCP130 (VDD = VSYS_SW — обесточен) | 0 |
| Преобразователи (EN = 0, VSYS_SW = 0) | 0 |
| **Итого вклад PWR-2** | **≤ 10 мкА** |
| BQ24074 Q(OUT) + CORE-2 остаток | измеряется (цель системы ≤ 100 мкА) |

**Цель системы:** ≤ 100 мкА от пакета при OFF → саморазряд 7 А·ч-пакета не заметен
(0.1 мА × 24 ч = 2.4 мА·ч/сут ≈ 0.03 %/сут). Если BQ24074 даст больше 100 мкА — рассмотреть
полное отключение пакета вторым полюсом тумблера (разрыв VBAT) в rev.2.

---

## 7. Время работы (для справки)

Пакет 2 × 18650 (7 А·ч, 25 Вт·ч, полезно ≈ 21 Вт·ч), средний КПД тракта PWR-2 0.90:

| Сценарий | Pin от батареи | Время |
|---|---|---|
| Idle | 2.5 Вт | ≈ 8 ч |
| Типичный (1 модуль, LED 40 %) | 7.9 Вт | ≈ 2.7 ч |
| Реалистичный максимум | 10.1 Вт | ≈ 2.1 ч |

Это ниже PWR-1 (там был 1 boost и рельсы CORE-1): у CORE-2 больше нагрузок (P4+PSRAM,
LCD 800×480, Wi-Fi C6, SD, 74 WS2812). Если нужно ≥ 4 ч типичной работы — вариант **2S2P**
(14.4 Вт·ч → 28 Вт·ч) или 4 × 18650 в параллель (14 А·ч).

---

## 8. Что измерять на стенде ДО разводки (PRE-FREEZE gate)

| # | Измерение | Условия | Критерий |
|---|---|---|---|
| 1 | +12 В / −12 В / +5 В на всём диапазоне VBAT | VBAT 3.0 / 3.6 / 4.2 В; нагрузка 10/50/100 % бюджета; 10 мин | Vout ±3 % (12.15 / −12.0 / 5.10 В) |
| 2 | КПД каждого преобразователя | Pin/Pout по 4-проводной схеме, 3 точки VBAT × 3 нагрузки | ≥ 0.88 (+12), ≥ 0.82 (−12), ≥ 0.88 (+5) |
| 3 | Ripple + FFT на ±12 В | 20 МГц полоса, 1× пробник, 10 мВ/дел, нагрузка 50 % | < 5 мВ p-p; в аудиополосе 20 Гц…20 кГц < 1 мВ rms; пики: fsw + гармоники, с BL/Wi-Fi/WS2812 — не выше +6 дБ |
| 4 | Load-step | +12 В 10→90 % (100 мА), −12 В 10→90 %, +5 В 0.1→1.2 А (74 WS2812 burst) | выброс < ±5 %, восстановление < 200 мкс |
| 5 | IBB −12 В на минимуме | VBAT 3.0 В, нагрузка 150 мА, 30 мин | Vout −12.0 ±3 %, входная ёмкость 15.7 В, T(U4) ≤ 80 °C |
| 6 | USB-C + заряд + максимум нагрузки | USB 5 В 1.5 А + нагрузка реалистичный максимум | power-path не разряжает пакет; T(BQ24074) ≤ 85 °C; DPPM стабилен |
| 7 | Ток OFF | master OFF, USB отключён, 4½-значный мультиметр | ≤ 100 мкА (PWR-2 ≤ 10 мкА) |
| 8 | BMS: OVP/UVP/OCP/SCP | ЛБП с ограничением тока, электронная нагрузка | OVP 4.25–4.30 В, UVP 2.35–2.50 В, OCP/SCP по паспорту BQ297xy; автовосстановление |
| 9 | Переполюсовка / горячее подключение | одна банка вставлена обратно (имитация — источник), hot-plug | Q1 закрыт, F1 не срабатывает при штатном токе; TVS не пробит |
| 10 | Гейдж MAX17048 | сравнение с 4½-значным вольтметром при 3.0/3.6/4.2 В; I2C 0x36 | ±7.5 мВ; SOC воспроизводим; ALRT по порогу |
| 11 | Master switch | 0.1…3 А, нагрев, inrush 100 мкФ+ | падение ≤ 80 мВ @3 А, T(ключей) ≤ 70 °C; пуск без срабатывания BMS |
| 12 | EN-линии | 0/3.3 В с CORE-2 (или ЛБП), все 4 EN | EN low = рельс off, EN high = on; входной ток EN ≤ 1 мА; 4.4 В на входе EN не появляется (3.3 V-safe) |

---

## 9. Открытые вопросы (к Lead / CORE-2 / прошивке)

1. **+5 В бюджет 1.6 А** против 1.0 А в `hardware/core2/power-tree.md` (пропущен вход
   MP1584 → +3V3_MCU). Решение: либо принять 1.6 А (PWR-2 уже рассчитан), либо перенести
   MP1584 на +12 В (рекомендация: −0.5 А с +5 В, +0.22 А на +12 В).
2. **VSYS 3 А (BQ24074) vs одновременный максимум 2.74…4.9 А** — исключение зафиксировано;
   прошивочный профиль обязателен (см. §2.2).
3. **CORE-2 rev.2 DNP**: U1/U2 (MT3608 +12/+5), U5 (MC34063 −12), BMS (BQ297xy + 2 NMOS) —
   иначе два источника на одной шине. Список и последствия — в `interfaces.md` §5.
4. **Разъём J3 IDC-20** при 3 А: IDC 2.54 мм обычно 1 А/контакт; у нас парные пины (2 пина
   на 2 А) — **на границе**. Проверить на стенде падение/нагрев; при > 100 мВ — перейти на
   Molex Micro-Fit 3.0 (2×6, до 5 А/контакт) или JST VH. Решение до разводки.
5. **NTC → BQ24074 TS**: сеть делителя и пороги (0 °C/45 °C) реализуются на CORE-2 —
   подтвердить, что TS-обвязка в CORE-2 соответствует 10 k NTC.
6. **PWR_GOOD** активный низкий (open-drain) — согласовать с прошивкой CORE-2 (подтяжка 100 k
   к +3V3, читать инверсию).
