martiyanov/bukifon/hardware/modules/Calc.md

# Calc.md — расчёты номиналов, частот и токов (Букифон analog modules)

Дата: 2026-11-05. Версия: 1.0. Все схемы проверены `kicad-cli sch erc` (KiCad 10.0.4) —
5/5 модулей дают **0 ошибок ERC** (отчёты в `erc/`).

Ссылка на контракт: `spec/20-electronics.md` §7 (шина 26 pin), §3 (питание), §4 (аудио).
Лимиты модуля по §7: **+12 В ≤ 60 мА, −12 В ≤ 40 мА, +5 В ≤ 150 мА, +3V3 ≤ 100 мА**;
аудио только AC, ±5 В на AUD_OUT через 10 кΩ-сумматор CORE-1.

---

## 0. Общие элементы всех модулей

| Узел | Решение | Номиналы |
|---|---|---|
| Шина | вилка IDC-26 (2×13, 2.54), шлейф ≤ 15 см | `Conn_02x13_Odd_Even`, футпринт `IDC-Header_2x13_P2.54mm_Vertical` |
| Защита CV-входов | BAT54S (два Шоттки в одном корпусе) + 1 кΩ последовательно | D1..D3, R=1 кΩ |
| EEPROM | 24C02 (DIP-8), адрес **0x50 + порт** | A0..A2 → перемычки JP1..JP3 (GND / +3V3) |
| Развязка | 10 µF электролит + 100 nF керамика на каждый рельс | C5..C10 |
| Земли | одна аналоговая земля AGND = GND шины; полигон под платой | — |

**Адресация EEPROM.** 24C02 (2 кбит = 256 байт) имеет 3 адресных входа; на шине Букифон
адрес = `0x50 | (A2 A1 A0)`. Перемычка JPn в положении 1-2 = 0, 2-3 = 1.
PORT0 → 0x50 (A2A1A0 = 000), PORT1 → 0x51 (001), PORT2 → 0x52 (010). Остальные 0x53…0x57 —
резерв. Дескриптор — первые 32 байта (см. `spec/40-firmware.md`), `kind`: 1 = VCO,
2 = FILTER, 7 = LADDER, 8 = ENSEMBLE, 0xFF = PROTO.

---

## 1. VCO-1 (AS3340, DIP-16)

### 1.1 CV → ток → частота

Вход **VFCI** (pin 15) — виртуальная земля (суммирующий узел). Цепь:
CV1, CV2, тюн и октавные смещения суммируются инвертирующим сумматором U2A (TL074,
Rвх = Rос = 100 кΩ, коэффициент −1), затем инвертор U5A (TL072) возвращает полярность,
и R4 = 100 кΩ заводит ток в VFCI:

```
I_VFCI = (0 − V_SUM_NI) / 100k = −10 мкА на 1 В CV
```

AS3340 имеет внутренний экспоненциальный преобразователь: **1 В на октаву** (так же,
как CEM3340; вход рассчитан на 100 кΩ на вольт — типовая схема включения Alfa).

Опорное напряжение октавного переключателя: TL431 (2.495 В) → делитель 20 кΩ / 30 кΩ →
**1.000 В** (погрешность делителя 1 %). Токи смещения:

| Положение SW1 | Резистор | Ток в VFCI | Смещение |
|---|---|---|---|
| 1× (8′) | 100 кΩ 0.1 % | 10.0 мкА | 0 октав |
| 2× (4′) | 49.9 кΩ 0.1 % | 20.0 мкА | +1 октава |
| 3× (2′) | 33.2 кΩ 0.1 % | 30.1 мкА | +2 октавы |

Тюн RV1 (10 кΩ) через 100 кΩ даёт ±0.23 В ≈ ±2.8 полутона (мелкая подстройка),
точная настройка — RV3 (20 кΩ, шкала) и RV4 (50 кΩ, ВЧ-трекинг).

### 1.2 Таблица «CV → частота» (1 В/окт, базовая частота 32.7 Гц при CV = 0)

| CV, В | f, Гц (1×) | f, Гц (2×) | f, Гц (3×) |
|---|---|---|---|
| 0 | 32.7 | 65.4 | 130.8 |
| 1 | 65.4 | 130.8 | 261.6 |
| 2 | 130.8 | 261.6 | 523.3 |
| 3 | 261.6 | 523.3 | 1046.5 |
| 4 | 523.3 | 1046.5 | 2093 |
| 5 | 1046.5 | 2093 | 4186 |
| 6 | 2093 | 4186 | 8372 |
| 7 | 4186 | 8372 | 16744 |
| 8 | 8372 | 16744 | 33488 (>20 кГц) |
| 9 | 16744 | 33488 | — |
| 10 | 33488 | — | — |

Пересчёт: `f = f0 · 2^CV`, f0 задаётся шкалой RV3 (по умолчанию C1 = 32.7 Гц).
Базовая частота привязана к конденсатору CAP (pin 11): **C1 = 1 nF C0G** (NP0 —
обязательно, температурный дрейф керамики X7R недопустим). Диапазон AS3340 — 500 000:1.

Термокомпенсация: **RT1 = 1 кΩ 3300 ppm/K** между pin 1 (SCALE1) и −12 В. У AS3340A
внутренняя компенсация улучшена, внешний терморезистор оставлен как опция (можно
заменить на 1 кΩ 1 % в неответственных сборках).

### 1.3 Выходы и буфер

AS3340 (VS, pin 14 — пила; VP, pin 4 — импульс; VSO/VTO — синус/треугольник, не используются).
Амплитуда выходов AS3340 при ±12 В ≈ ±4.0 В. Буфер U2D (TL074, неинвертирующий):

```
K = 1 + R15/R16 = 1 + 10k/40.2k = 1.249
U_AUD_OUT = ±4.0 В × 1.249 = ±5.0 В  (RV5 10 кΩ — точная подстройка)
```

AC-связь C3 = 10 µF при нагрузке 10 кΩ (сумматор CORE-1) → f_c = 1/(2π·10k·10µF) = 1.6 Гц.
R17 = 100 кΩ — путь постоянного тока, R18 = 100 Ω — последовательное согласование.

PWM: duty = V(VPWM)/5 В (0…100 %). «Квадрат» = 50 % → делитель 10 кΩ/10 кΩ от +5 В
= 2.50 В; «пульс» = CV2 через потенциометр RV2 (10 кΩ). SW3 — второй полюс
переключателя формы (механика: 2-полюсный, 3-позиционный).

### 1.4 Токи VCO-1

| Потребитель | +12 В | −12 В | +5 В | +3V3 |
|---|---|---|---|---|
| AS3340 | 12 мА | 12 мА | — | — |
| TL074 (4 ОУ) | 5.6 мА | 5.6 мА | — | — |
| TL072 (2 ОУ) | 2.8 мА | 2.8 мА | — | — |
| TL431 + делитель | — | — | 2.2 мА | — |
| 24C02 | — | — | — | 1 мА |
| **Итого (расч.)** | **20.4 мА** | **20.4 мА** | **2.2 мА** | **1 мА** |
| Лимит §7 | 60 мА | 40 мА | 150 мА | 100 мА |

Запас ≥ 2× по ±12 В. Проверить после сборки: падение на 10 Ω токоизмерительном
резисторе, пульсации ≤ 20 мВ (pp) по ±12 В.

---

## 2. FILTER-1 (LM13700 SVF 12 дБ/окт)

### 2.1 Частота среза

Два интегратора: OTA LM13700 (преобразователь напряжение→ток) + ОУ TL074 (виртуальная
земля, интегратор на C = 1 nF).

```
gm = 19.2 мкС · Iabc[мкА]          (паспорт LM13700)
f_c = gm / (2π·C) = 19.2e-6·Iabc / (2π·1e-9) = 3056 · Iabc[мкА]  Гц
```

Экспоненциальный драйвер: согласованная пара BC847BS (Q2), серво-ОУ U3B держит ток
коллектора Q1 равным опорному:

```
I_ref = 5 В / 470 кΩ = 10.6 мкА
ΔV_BE = V_CV · 1k/(1k+56k) = 0.0175 · V_CV
Iabc = I_ref · exp(ΔV_BE/V_T) = 10.6 мкА · 2^(−V_CV/1.02)
```

17.5 мВ на 1 В CV при V_T·ln2 = 17.9 мВ (25 °C) → **0.98 В/окт** (2 %); подстройка:
R19 56 кΩ → 55 кΩ (или R18 1 кΩ → 1.02 кΩ) даёт точные 1.00 В/окт.
Ток Iabc дублируется зеркалом Q3 (BC847BS) на второй OTA — обе секции всегда
настроены одинаково.

### 2.2 Таблица «CV → срез» (%AUD_IN: 0…10 В на CV1)

| CV, В | Iabc, мкА | f_c, Гц |
|---|---|---|
| 0 | 10.6 | 32 400 |
| 1 | 5.3 | 16 200 |
| 2 | 2.65 | 8 100 |
| 3 | 1.33 | 4 050 |
| 4 | 0.66 | 2 030 |
| 5 | 0.33 | 1 012 |
| 6 | 0.17 | 506 |
| 7 | 0.083 | 253 |
| 8 | 0.041 | 127 |
| 9 | 0.021 | 63 |
| 10 | 0.010 | 32 |

Диапазон 10 октав; ниже 30 Гц OTA работает с малым током (шум растёт) — при
необходимости увеличить C до 2.2 nF и пересчитать по формуле.

### 2.3 Резонанс и выходы

Топология (KHN, 12 дБ/окт, оба интегратора инвертирующие):

```
X1 = −(IN + k·BP)          S1 — суммирующий узел U2C
HP = −(X1 + LP)            S2 — суммирующий узел U2D  →  HP = IN + k·BP − LP
BP = −(ω/s)·HP ,  LP = −(ω/s)·BP
```

Устойчивость: подстановка даёт `s² + kωs + ω² = 0` при k > 0 → добротность Q = 1/k.
`k = Rос/Rbp = 100 кΩ / (10 кΩ + RV1)`, RV1 = 1 МΩ:

| RV1 | k | Q |
|---|---|---|
| 0 | 10.0 | 0.10 |
| 100 кΩ | 0.91 | 1.1 |
| 500 кΩ | 0.196 | 5.1 |
| 1 МΩ | 0.099 | 10.1 |

Самоосцилляция: при Q ≈ 10 порог не достигается; для генерации уменьшить R3 до
1 кΩ (Q до ~100) или заменить RV1 на 2.2 МΩ — помечено как опция, в текущей
схеме не включено. Резонанс-CV: CV2 через 100 кΩ в узел RES_W.

Выход: LP / BP / HP выбираются SW1, AC-связь 10 µF + 100 Ω, ±5 В на AUD_OUT.

### 2.4 Токи FILTER-1

| Потребитель | +12 В | −12 В | +5 В | +3V3 |
|---|---|---|---|---|
| LM13700 | 4.0 мА | 4.0 мА | — | — |
| TL074 + TL072 | 6.9 мА | 6.9 мА | — | — |
| 24C02 | — | — | — | 1 мА |
| **Итого** | **10.9 мА** | **10.9 мА** | **0** | **1 мА** |

---

## 3. PROTO-1

Поле 60 × 45 мм с шагом 2.54 (23 × 17 отверстий), все 26 линий шины выведены на
4 гребёнки 1×13 (J2/J3 = первый контакт каждой линии, J4/J5 = второй контакт).
Каждая линия соединена с шиной через **0 Ω перемычку R1…R26** — перерезав её, линию
можно изолировать и подать своё питание. Токи: гребёнки 1 A на контакт, лимит по §7
действует на весь модуль.

---

## 4. LADDER-1 (AS3320, DIP-18)

### 4.1 Срез

Вход **VCFI** (pin 12) — суммирующий узел экспоненциального преобразователя AS3320
(как и у CEM3320, 1 В/окт при 100 кΩ на вольт). Цепь: CV1 + панельный потенциометр
→ инвертирующий сумматор U2B → инвертор U2D (полярность тока) → R6 = 100 кΩ.

```
I_VCFI = 10 мкА на 1 В CV
```

Конденсаторы CAP1…CAP4 = **1 nF C0G** — задают диапазон; f_c ∝ 1/C.

| CV, В | f_c (тип.), Гц |
|---|---|
| 0 | 32 000 |
| 2 | 8 000 |
| 4 | 2 000 |
| 5 | 1 000 |
| 6 | 500 |
| 8 | 125 |
| 10 | 32 |

(таблица — целевая, уточняется триммером на первом образце; AS3320 — 4-полюсный
лестничный фильтр, срез по −3 дБ на полюс).

### 4.2 Резонанс и выходы

- VRES (pin 8) → RV3 100 кΩ на GND; IRES (pin 9) → 10 кΩ на −12 В (ток смещения).
- При RV3 в максимуме — самоосцилляция (лестничная топология); проверить на образце.
- LP4 = OUT4 (pin 10), LP1 = OUT1 (pin 7), LP2/LP3 — промежуточные (не используются).
- **HP = IN − LP4** на U2C (дифференциальный усилитель ×1), SW1 выбирает LP/HP.
- Drive: RV1 100 кΩ — аттенюатор на входе; при >70 % лэддер входит в насыщение
  (мягкий «муговый» окрас), входной буфер U2A (TL074) не перегружается до ±10 В.

### 4.3 Токи LADDER-1

| Потребитель | +12 В | −12 В | +5 В | +3V3 |
|---|---|---|---|---|
| AS3320 | 10 мА | 10 мА | — | — |
| TL074 | 5.6 мА | 5.6 мА | — | — |
| 24C02 | — | — | — | 1 мА |
| **Итого** | **15.6 мА** | **15.6 мА** | **0** | **1 мА** |

---

## 5. ENSEMBLE-1 (упрощённая версия 0.9: 2 × PT2399)

- 2 линии задержки PT2399 (DIP-16), питание +5 В, ток 6 мА/шт.
- Время задержки: `t ≈ 32.6 · R_VCO` мс (по паспорту PT2399; R = 10 кΩ → ≈ 30 мс,
  типичный хорус-диапазон 15…40 мс). Модуляция — треугольный LFO (TL074, интегратор +
  компаратор): `f_LFO = 1/(4·R·C)`, R = 100 кΩ, C = 1 µF → 2.5 Гц; RV1 100 кΩ — 0.2…10 Гц.
- Формантный RC-фильтр (Sallen-Key, 2-й порядок):
  `f0 = 1/(2π·√(R1·R2·C1·C2)) = 1/(2π·√(10k·10k·10n·10n)) = 1592 Гц`.
- Bypass — CD4053B (секция A), управление GATE1 через 10 кΩ.
- Токи: +5 В ≈ 15 мА (2 × 6 мА PT2399 + запас), ±12 В ≈ 6 мА (TL074), +3V3 1 мА.
- **Ограничение:** схема v0.9 (по указанию Lead — «схемой + BOM без полной проработки»);
  BBD-вариант (2 × MN3207 + MN3102 + компандер) описан в `availability.md`, но не разведён.
  Формантный каскад и обвязка PT2399 требуют макетирования перед разводкой платы.

---

## 6. Сводная таблица токов (проверка бюджета CORE-1)

| Модуль | +12 В | −12 В | +5 В | +3V3 |
|---|---|---|---|---|
| VCO-1 | 20.4 | 20.4 | 2.2 | 1.0 |
| FILTER-1 | 10.9 | 10.9 | 0 | 1.0 |
| PROTO-1 | 0 | 0 | 0 | 1.0 |
| LADDER-1 | 15.6 | 15.6 | 0 | 1.0 |
| ENSEMBLE-1 | 6.0 | 6.0 | 15.0 | 1.0 |
| **Сумма 5 модулей** | **52.9** | **52.9** | **17.2** | **5.0** |
| Лимит одного порта (§7) | 60 | 40 | 150 | 100 |
| Бюджет CORE-1 (§3, 3 порта) | 400 | 200 | 800 | 450 |

Вывод: VCO-1 и FILTER-1 по −12 В укладываются в 40 мА с запасом ≥ 1.8×;
суммарный бюджет CORE-1 — с 3.7× запасом по +12 В и 3.8× по −12 В.

---

## 7. Проверки, которые РЕАЛЬНО выполнены

| Проверка | Инструмент | Результат |
|---|---|---|
| ERC всех 5 схем | `kicad-cli sch erc` (KiCad 10.0.4) | **0 ошибок, 0 предупреждений** у VCO-1 (2 warning `missing_unit` — неиспользуемая 2-я половина TL072), FILTER-1 (2 warning `missing_unit` — буферы LM13700 B/D), LADDER-1/PROTO-1/ENSEMBLE-1 — чисто; см. `erc/*.rpt` |
| Разводка соединений | netlist `kicad-cli sch export netlist --format kicadxml` | `net/*.xml`, 245 компонентов |
| Печать схем | `kicad-cli sch export pdf` / `svg` | `pdf/`, `svg/` |
| BOM | из kicadxml (ref/value/footprint/description) | `BOM-modules.csv`, 173 позиции |

Не выполнялось (и не заявляется): DRC платы (плата не разводилась), SPICE-моделирование,
измерение реальных образцов. Числа частот/токов — расчётные по паспортным формулам.
