martiyanov/bukifon/hardware/modules/CARTRIDGE.md

# CARTRIDGE.md — чертёж картриджа модуля (110 × 70 мм)

Согласовано с `spec/20-electronics.md` §1 (габарит модуля 110 × 70 × 1.6),
§7 (вилка IDC-26, шлейф ≤ 15 см, 4 × M3), `spec/30-mechanics.md` (внутренние
модули — плоские картриджи, вставляются в «брюшной» отсек снизу).

## 1. Габариты

| Элемент | Размер | Примечание |
|---|---|---|
| Корпус картриджа (печать) | **110.0 × 70.0 × 6.0 мм** | PLA/PETG, без поддержек, стенка 1.6 мм |
| Печатная плата | **109.0 × 69.0 × 1.6 мм** | зазор 0.5 мм по периметру в корпус |
| Радиус скругления платы | R2.0 мм (4 угла) | совпадает со скруглением корпуса R2.5 |
| Высота компонентов на плате | ≤ 12 мм (односторонний монтаж) | суммарно с платой ≤ 13.6 мм |
| Глубина посадочного окна в корпусе | 70.5 мм | допуск +0.3/−0.0 |

## 2. Система координат

Начало координат — **левый нижний угол платы** (вид со стороны монтажа, X вправо,
Y вверх), единица — мм. Все координаты — центра отверстия/площадки.

## 3. IDC-26 (вилка шины)

Вилка IDC-26 (2×13, шаг 2.54 мм) — **на длинной стороне (109 мм), нижняя кромка**.
Ориентация: pin 1 — левый нижний (сторона монтажа), нумерация змейкой 1-2-3…26.
Рекомендуемый футпринт KiCad: `Connector_IDC:IDC-Header_2x13_P2.54mm_Vertical`
(с направляющим ключом-вырезом в корпусе).

| Параметр | Значение |
|---|---|
| Шаг | 2.54 мм, 2 ряда |
| Ряд нечётных (1,3,…,25) | Y = 5.08 мм |
| Ряд чётных (2,4,…,26) | Y = 7.62 мм |
| X pin 1 / pin 26 | 38.10 / 70.90 мм |
| X pin N (нечётный) | 38.10 + 2.54·((N−1)/2) |
| X pin N (чётный) | 38.10 + 2.54·((N−2)/2) |
| Центр вилки | (54.50; 6.35) мм |
| Корпус вилки (с ключом) | 38.1 × 9.0 мм, X 35.45…73.55, Y 1.85…10.85 |
| Вырез в корпусе картриджа под вилку | 39.5 × 10.5 мм, центр (54.50; 6.35) |

> Шлейф IDC-26 мама-мама ≤ 15 см; длина выбрана по §7 п.1. При монтаже в слот
> кабель выходит в вырез 36 × 10 мм (`spec/20` §9, окна PORT0/PORT2).

## 4. Крепёж — 4 × M3

Отверстия Ø3.2 мм, keepout под головку винта Ø6.5 мм, термовтулки M3×5×4 в корпусе.

| № | X, мм | Y, мм | Назначение |
|---|---|---|---|
| H1 | 5.00 | 5.00 | левый нижний (рядом с вилкой) |
| H2 | 104.00 | 5.00 | правый нижний (рядом с вилкой) |
| H3 | 5.00 | 64.00 | левый верхний |
| H4 | 104.00 | 64.00 | правый верхний |

Проверка зазоров: H1/H2 (X = 5 / 104) не конфликтуют с вилкой (X 35.45…73.55);
keepout Ø6.5 мм вокруг H1 доходит до X = 8.25 мм — свободно.

## 5. Зоны платы (все модули)

| Зона | X, мм | Y, мм | Что стоит |
|---|---|---|---|
| Шинный разъём | 35.45…73.55 | 1.85…10.85 | J1 IDC-26 |
| EEPROM + перемычки | 88.0…106.0 | 2.0…14.0 | 24C02, JP1…JP3, C развязки |
| Аналоговое ядро | 10.0…70.0 | 20.0…55.0 | основная ИС + ОУ |
| Питание/развязка | 75.0…105.0 | 20.0…55.0 | 10 µF + 100 nF на рельс |
| Тест-площадки | 5.0…30.0 | 58.0…65.0 | +12, −12, +5, +3V3, GND, AUD_OUT (Ø1.3 мм) |
| PROTO-1: поле | 20.0…80.0 | 15.0…60.0 | 23 × 17 отверстий 2.54 (60 × 45 мм) |

## 6. Совместимость с шиной (проверка по §7)

| Pin | Сигнал | Направление | На модуле |
|---|---|---|---|
| 1 / 3 / 5 / 7 | +12V / −12V / +5V / +3V3 | питание | развязка 10 µF + 100 nF |
| 2, 4, 6, 8, 10, 12, 14, 16 | GND | — | AGND (единая земля) |
| 9 / 11 | CV1 / CV2 | core → module | 1 кΩ + BAT54S + RC |
| 13 / 15 | CV3 / CV4 | module → core | не используются (см. README) |
| 17 / 18 | GATE1 / GATE2 | core → module | 4.7 кΩ + BAT54S |
| 19 / 20 | AUD_IN / AUD_OUT | core ⇄ module | AC, 10 µF, ±5 В, 10 кΩ |
| 21 / 22 | SDA / SCL | I2C0 | EEPROM 24C02 (0x50+порт) |
| 23…26 | SCK/MOSI/MISO/CS | SPI0 | NC на аналоговых модулях |

Требования §7 п.1–5 выполнены: IDC-26, шлейф ≤ 15 см, токи в пределах (§7 п.2,
см. `Calc.md` §6), адрес EEPROM 0x50+порт (§7 п.3), аудио только AC (§7 п.4),
MISO не драйвится: на аналоговых модулях линия MISO не подключена (NC) — §7 п.5.

## 7. Что нужно доделать в механике

- Вырез/посадочное место под вилку IDC-26 в корпусе картриджа (координаты §3).
- Термовтулки M3 в 4 стойках по §4 (глубина 5 мм, наружный Ø5).
- Направляющие клинья картриджа в слоте (по `spec/30-mechanics.md`).
- Проверить, что радиатор/высокие компоненты (DIP-18 AS3320 — 4.5 мм) не упираются
  в верхнюю крышку картриджа: суммарная высота ≤ 13.6 мм.
