martiyanov/bukifon/hardware/panel/matrix-tables.md

# Bukifon PANEL-1 / DECK-PAD / DECK-KEYS — таблицы соединений

Сгенерировано `tools/gen.py` из тех же структур данных, что и схемы; сверено с
экспортированными netlist-ами скриптом `tools/verify_netlist.py` (см. `erc/` и README).
Координаты — в системе панели `spec/10-panel-ui.md` §1 (X 0…315 вправо, Y 0…145 вперёд), мм.

---

## 1. PANEL-1: 74HC165 — карта 48 бит

6 × 74HC165 включены каскадом: `U1.Q7 → U2.DS → … → U6.Q7 = HC_QH` (MISO).
Первым из линии читается `U6.H` (бит 47), последним — `U1.A` (бит 0).
Тактирование: `HC_CP` = GP2 (SPI0 SCK), загрузка: `HC_PL` = GP6, данные: `HC_QH` = GP4.

| Бит | 74HC165 | Вход | Цепь | Функция |
|---:|---|---|---|---|
| 0 | U1 | D0 | `ENC1_A` | ENC1 фаза A |
| 1 | U1 | D1 | `ENC1_B` | ENC1 фаза B |
| 2 | U1 | D2 | `ENC2_A` | ENC2 фаза A |
| 3 | U1 | D3 | `ENC2_B` | ENC2 фаза B |
| 4 | U1 | D4 | `ENC3_A` | ENC3 фаза A |
| 5 | U1 | D5 | `ENC3_B` | ENC3 фаза B |
| 6 | U1 | D6 | `ENC4_A` | ENC4 фаза A |
| 7 | U1 | D7 | `ENC4_B` | ENC4 фаза B |
| 8 | U2 | D0 | `ENC5_A` | ENC5 фаза A |
| 9 | U2 | D1 | `ENC5_B` | ENC5 фаза B |
| 10 | U2 | D2 | `ENC6_A` | ENC6 фаза A |
| 11 | U2 | D3 | `ENC6_B` | ENC6 фаза B |
| 12 | U2 | D4 | `ENC7_A` | ENC7 фаза A |
| 13 | U2 | D5 | `ENC7_B` | ENC7 фаза B |
| 14 | U2 | D6 | `ENC8_A` | ENC8 фаза A |
| 15 | U2 | D7 | `ENC8_B` | ENC8 фаза B |
| 16 | U3 | D0 | `ENC1_PUSH` | ENC1 кнопка (нажатие) |
| 17 | U3 | D1 | `ENC2_PUSH` | ENC2 кнопка (нажатие) |
| 18 | U3 | D2 | `ENC3_PUSH` | ENC3 кнопка (нажатие) |
| 19 | U3 | D3 | `ENC4_PUSH` | ENC4 кнопка (нажатие) |
| 20 | U3 | D4 | `ENC5_PUSH` | ENC5 кнопка (нажатие) |
| 21 | U3 | D5 | `ENC6_PUSH` | ENC6 кнопка (нажатие) |
| 22 | U3 | D6 | `ENC7_PUSH` | ENC7 кнопка (нажатие) |
| 23 | U3 | D7 | `ENC8_PUSH` | ENC8 кнопка (нажатие) |
| 24 | U4 | D0 | `BTN_L1` | плечевая L1 (OCT−) |
| 25 | U4 | D1 | `BTN_L2` | плечевая L2 (OCT+) |
| 26 | U4 | D2 | `BTN_R1` | плечевая R1 (SHIFT) |
| 27 | U4 | D3 | `BTN_R2` | плечевая R2 (PLAY/STOP) |
| 28 | U4 | D4 | `GND` | резерв (подтянут к GND) |
| 29 | U4 | D5 | `GND` | резерв (подтянут к GND) |
| 30 | U4 | D6 | `GND` | резерв (подтянут к GND) |
| 31 | U4 | D7 | `GND` | резерв (подтянут к GND) |
| 32 | U5 | D0 | `GND` | резерв (подтянут к GND) |
| 33 | U5 | D1 | `GND` | резерв (подтянут к GND) |
| 34 | U5 | D2 | `GND` | резерв (подтянут к GND) |
| 35 | U5 | D3 | `GND` | резерв (подтянут к GND) |
| 36 | U5 | D4 | `GND` | резерв (подтянут к GND) |
| 37 | U5 | D5 | `GND` | резерв (подтянут к GND) |
| 38 | U5 | D6 | `GND` | резерв (подтянут к GND) |
| 39 | U5 | D7 | `GND` | резерв (подтянут к GND) |
| 40 | U6 | D0 | `GND` | резерв (подтянут к GND) |
| 41 | U6 | D1 | `GND` | резерв (подтянут к GND) |
| 42 | U6 | D2 | `GND` | резерв (подтянут к GND) |
| 43 | U6 | D3 | `GND` | резерв (подтянут к GND) |
| 44 | U6 | D4 | `GND` | резерв (подтянут к GND) |
| 45 | U6 | D5 | `GND` | резерв (подтянут к GND) |
| 46 | U6 | D6 | `GND` | резерв (подтянут к GND) |
| 47 | U6 | D7 | `GND` | резерв (подтянут к GND) |

Соответствие пинов 74HC165: D0…D7 = выводы 11,12,13,14,3,4,5,6; CP = 2, ~PL = 1,
~CE = 15 (GND), DS = 10, Q7 = 9, ~Q7 = 7 (не используется, no-connect), VCC = 16, GND = 8.

## 2. PANEL-1: координаты ↔ цепи

### 2.1 Энкодеры EC11 (`spec/10-panel-ui.md` §2.2)

| Имя | X | Y | Функция v1.0 | Цепи |
|---|---:|---:|---|---|
| ENC1 | 30.0 | 24.0 | CUTOFF | `ENC1_A`, `ENC1_B` (74HC165 биты 0/1), `ENC1_PUSH` (бит 16) |
| ENC2 | 66.0 | 24.0 | RESONANCE | `ENC2_A`, `ENC2_B` (74HC165 биты 2/3), `ENC2_PUSH` (бит 17) |
| ENC3 | 30.0 | 56.0 | ATTACK | `ENC3_A`, `ENC3_B` (74HC165 биты 4/5), `ENC3_PUSH` (бит 18) |
| ENC4 | 66.0 | 56.0 | DECAY | `ENC4_A`, `ENC4_B` (74HC165 биты 6/7), `ENC4_PUSH` (бит 19) |
| ENC5 | 249.0 | 24.0 | SUSTAIN | `ENC5_A`, `ENC5_B` (74HC165 биты 8/9), `ENC5_PUSH` (бит 20) |
| ENC6 | 285.0 | 24.0 | RELEASE | `ENC6_A`, `ENC6_B` (74HC165 биты 10/11), `ENC6_PUSH` (бит 21) |
| ENC7 | 249.0 | 56.0 | LEVEL/MIX | `ENC7_A`, `ENC7_B` (74HC165 биты 12/13), `ENC7_PUSH` (бит 22) |
| ENC8 | 285.0 | 56.0 | TEMPO | `ENC8_A`, `ENC8_B` (74HC165 биты 14/15), `ENC8_PUSH` (бит 23) |

RC-фильтр на каждой фазе: 10 kΩ к +3V3 (он же подтяжка) + 100 nF на GND.
Кнопка энкодера: 10 kΩ к +3V3, второй контакт на GND, активный низкий.

### 2.2 Плечевые кнопки (`spec/10-panel-ui.md` §2.3)

| Имя | X | Y | Ø | Функция | Бит 74HC165 |
|---|---:|---:|---:|---|---:|
| BTN_L1 | 16 | 8 | 8 | OCT- | 24 |
| BTN_L2 | 52 | 8 | 8 | OCT+ | 25 |
| BTN_R1 | 263 | 8 | 8 | SHIFT | 26 |
| BTN_R2 | 299 | 8 | 8 | PLAY/STOP | 27 |

### 2.3 Экран 2.8" ST7789 — разъём `J-LCD` 1×14

| Pin | Цепь | К CORE-1 |
|---:|---|---|
| 1 | `GND` | — |
| 2 | `+3V3` | — |
| 3 | `LCD_CS` | GP12 |
| 4 | `LCD_DC` | GP13 |
| 5 | `LCD_RST` | GP14 |
| 6 | `LCD_SCK` | GP10 (SPI1 SCK) |
| 7 | `LCD_MOSI` | GP11 (SPI1 MOSI) |
| 8 | `GND` | — |
| 9 | `LCD_BL_A` | через 33 Ω от +3V3 |
| 10 | `LCD_BL_K` | сток Q1 2N7002 |
| 11 | `GND` | — |
| 12 | `GND` | — |
| 13 | `GND` | — |
| 14 | `GND` | — |

Подсветка: `LCD_BL` (GP15, ШИМ) → 100 Ω → затвор Q1 (2N7002), 10 kΩ на GND,
сток Q1 = `LCD_BL_K` (pin 10), исток = GND; анод (pin 9) через 33 Ω на +3V3.

### 2.4 LED-цепочка PANEL-1 (9 × WS2812B-2020)

Цепочка питается от **+5 В**. `LED_DATA` (GP7, 3.3 В) → U7 `74HCT1G125` (VCC = +5 В, TTL-вход) → R300 330 Ω → `LED_IN` = LED_ENC1 → … → LED_ENC8 → LED_STATUS → `LED_OUT` (pin 7 J-DECK → LED_IN деки). 100 нФ на каждый светодиод — на +5 В.

| # | Позиция | Цепь DIN | Цепь DOUT |
|---:|---|---|---|
| 1 | LED_ENC1 | `LED_IN` | `LED_CHAIN1` |
| 2 | LED_ENC2 | `LED_CHAIN1` | `LED_CHAIN2` |
| 3 | LED_ENC3 | `LED_CHAIN2` | `LED_CHAIN3` |
| 4 | LED_ENC4 | `LED_CHAIN3` | `LED_CHAIN4` |
| 5 | LED_ENC5 | `LED_CHAIN4` | `LED_CHAIN5` |
| 6 | LED_ENC6 | `LED_CHAIN5` | `LED_CHAIN6` |
| 7 | LED_ENC7 | `LED_CHAIN6` | `LED_CHAIN7` |
| 8 | LED_ENC8 | `LED_CHAIN7` | `LED_CHAIN8` |
| 9 | LED_STATUS | `LED_CHAIN8` | `LED_OUT` |

### 2.5 Разъём деки `J-DECK` IDC-16 (2×8) — `spec/20-electronics.md` §6.2

| Pin | Сигнал PANEL | Pin | Сигнал |
|---:|---|---:|---|
| 1 | `+3V3` | 2 | `GND` |
| 3 | `SDA` | 4 | `SCL` |
| 5 | `DECK_INT` | 6 | `GND` |
| 7 | `LED_OUT` | 8 | `GND` |
| 9 | `SL1_RAW` | 10 | `GND` |
| 11 | `SL2_RAW` | 12 | `GND` |
| 13 | `DECK_ID` | 14 | `GND` |
| 15 | `FSR_RAW` | 16 | `+5V` |

Pin 16 = **+5 В** — питание LED-цепочек деки (`spec/20-electronics.md` §6.2); данные
`LED_IN` приходят с панели с уровнем 5 В, поэтому уровни светодиодов деки и данных совпадают.
SL1/SL2: на PANEL-1 RC 1 kΩ + 100 nF → `SL1`/`SL2` → MCP3208 CH0/CH1 (CORE-1).
FSR: RC 1 kΩ + 100 nF → `FSR` → MCP3208 CH6. DECK_ID → GP27 (ADC1/ADC2 вход Pico).
Interrupt деки → `DECK_INT` → **GP28** (`spec/20-electronics.md` §2: «GP28 — DECK_INT,
прерывание MCP23017 деки»; GATE1 = GP22, GATE2 = GP26, DECK_ID = GP27).
На PANEL-1 цепь идёт: pin 5 J-DECK → pin 19 J-CORE → GP28 CORE-1.

### 2.6 `J-CORE` IDC-32 (2×16) → CORE-1 `J-PANEL`

| Pin | Сигнал | Пины Pico (CORE-1) | Pin | Сигнал |
|---:|---|---|---:|---|
| 1 | `+3V3` | LDO 3.3 В | 2 | GND |
| 3 | `LCD_SCK` | GP10 | 4 | LCD_MOSI / GP11 |
| 5 | `LCD_CS` | GP12 | 6 | LCD_DC / GP13 |
| 7 | `LCD_RST` | GP14 | 8 | LCD_BL / GP15 |
| 9 | `HC_CP` | GP2 | 10 | HC_PL / GP6 |
| 11 | `HC_QH` | GP4 | 12 | LED_DATA / GP7 |
| 13 | `SDA` | GP8 | 14 | SCL / GP9 |
| 15 | `SL1` | MCP3208 CH0 | 16 | SL2 / MCP3208 CH1 |
| 17 | `FSR` | MCP3208 CH6 | 18 | DECK_ID / GP27 |
| 19 | `DECK_INT` | GP28 (DECK_INT) | 20 | GND |
| 21 | `+5V` | MP1584 / LED-цепочка | 22 | GND |
| 23 | `GND` | — | 24 | GND |
| 25 | `GND` | — | 26 | GND |
| 27 | `GND` | — | 28 | GND |
| 29 | `GND` | — | 30 | GND |
| 31 | `GND` | — | 32 | GND |

Чётные пины 2, 6…20 — GND; 22…32 — GND (шлейф, экран). Полная таблица — в схеме
(`Text` у разъёма) и в `panel-1/panel-1.kicad_sch`.

---

## 3. DECK-PAD: матрица 3×6 на MCP23017 (адрес 0x20)

Строки `ROW1..ROW3` — выходы GPA0..GPA2 (поочерёдно 0), столбцы `COL1..COL6` —
входы GPB0..GPB5 с внешней подтяжкой 10 кΩ к +3V3 (R21..R26), активный низкий уровень.

| Пэд | ROW | COL | X | Y | Цепь строки | Цепь столбца |
|---|---:|---:|---:|---:|---|---|
| PAD1 | 1 | 1 | 22 | 78 | `ROW1` (GPA0) | `COL1` (GPB0) |
| PAD2 | 1 | 2 | 48 | 78 | `ROW1` (GPA0) | `COL2` (GPB1) |
| PAD3 | 1 | 3 | 74 | 78 | `ROW1` (GPA0) | `COL3` (GPB2) |
| PAD4 | 2 | 1 | 22 | 104 | `ROW2` (GPA1) | `COL1` (GPB0) |
| PAD5 | 2 | 2 | 48 | 104 | `ROW2` (GPA1) | `COL2` (GPB1) |
| PAD6 | 2 | 3 | 74 | 104 | `ROW2` (GPA1) | `COL3` (GPB2) |
| PAD7 | 3 | 1 | 22 | 130 | `ROW3` (GPA2) | `COL1` (GPB0) |
| PAD8 | 3 | 2 | 48 | 130 | `ROW3` (GPA2) | `COL2` (GPB1) |
| PAD9 | 3 | 3 | 74 | 130 | `ROW3` (GPA2) | `COL3` (GPB2) |
| PAD10 | 1 | 4 | 241 | 78 | `ROW1` (GPA0) | `COL4` (GPB3) |
| PAD11 | 1 | 5 | 267 | 78 | `ROW1` (GPA0) | `COL5` (GPB4) |
| PAD12 | 1 | 6 | 293 | 78 | `ROW1` (GPA0) | `COL6` (GPB5) |
| PAD13 | 2 | 4 | 241 | 104 | `ROW2` (GPA1) | `COL4` (GPB3) |
| PAD14 | 2 | 5 | 267 | 104 | `ROW2` (GPA1) | `COL5` (GPB4) |
| PAD15 | 2 | 6 | 293 | 104 | `ROW2` (GPA1) | `COL6` (GPB5) |
| PAD16 | 3 | 4 | 241 | 130 | `ROW3` (GPA2) | `COL4` (GPB3) |
| PAD17 | 3 | 5 | 267 | 130 | `ROW3` (GPA2) | `COL5` (GPB4) |
| PAD18 | 3 | 6 | 293 | 130 | `ROW3` (GPA2) | `COL6` (GPB5) |

`INT` (INTA, вывод 20) → `DECK_INT` (pin 5 J-DECK); `A0..A2` = GND → адрес 0x20;
`/RESET` через 10 kΩ на +3V3; NC (выводы 11, 14) не подключены.

### 3.1 74HC4067 / FSR (опция velocity)

S0..S3 = GPA3..GPA6 (общие для обоих мультиплексоров), ~E1 = GPB6, ~E2 = GPB7.
`COM` обоих мультиплексоров объединён в цепь `FSR` → pin 15 J-DECK → MCP3208 CH6.
Каждый канал: +3V3 → 10 kΩ → узел `FSRn` → плёнка FSR → GND; узел на вход Ix.

| MUX | Канал | Цепь | Пэд | ROW/COL пэда | X | Y |
|---|---:|---|---|---:|---:|---:|
| U2 | I0 | `FSR1` | PAD1 | 1/1 | 22 | 78 |
| U2 | I1 | `FSR2` | PAD2 | 1/2 | 48 | 78 |
| U2 | I2 | `FSR3` | PAD3 | 1/3 | 74 | 78 |
| U2 | I3 | `FSR4` | PAD4 | 2/1 | 22 | 104 |
| U2 | I4 | `FSR5` | PAD5 | 2/2 | 48 | 104 |
| U2 | I5 | `FSR6` | PAD6 | 2/3 | 74 | 104 |
| U2 | I6 | `FSR7` | PAD7 | 3/1 | 22 | 130 |
| U2 | I7 | `FSR8` | PAD8 | 3/2 | 48 | 130 |
| U2 | I8 | `FSR9` | PAD9 | 3/3 | 74 | 130 |
| U2 | I9 | `FSR10` | PAD10 | 1/4 | 241 | 78 |
| U2 | I10 | `FSR11` | PAD11 | 1/5 | 267 | 78 |
| U2 | I11 | `FSR12` | PAD12 | 1/6 | 293 | 78 |
| U2 | I12 | `FSR13` | PAD13 | 2/4 | 241 | 104 |
| U2 | I13 | `FSR14` | PAD14 | 2/5 | 267 | 104 |
| U2 | I14 | `FSR15` | PAD15 | 2/6 | 293 | 104 |
| U2 | I15 | `FSR16` | PAD16 | 3/4 | 241 | 130 |
| U3 | I0 | `FSR17` | PAD17 | 3/5 | 267 | 130 |
| U3 | I1 | `FSR18` | PAD18 | 3/6 | 293 | 130 |

Если плёнка FSR не установлена, узел подтянут к +3V3 → канал читается как максимум;
это нормально, velocity-режим просто выключен в прошивке.

### 3.2 DECK-PAD: слайдеры и DECK_ID

| Имя | X | Ход Y | Функция | Цепь |
|---|---:|---|---|---|
| SL1 | 137.0 | 98…128 | CUTOFF | `SL1_RAW` (pin 9 J-DECK) |
| SL2 | 178.0 | 98…128 | MIX | `SL2_RAW` (pin 11 J-DECK) |

DECK_ID (pin 13): 33 kΩ на +3V3, 3.3 kΩ на GND → 3.3 × 3.3 / 36.3 = **0.30 В**
(`spec/20-electronics.md` §6.2: DECK_PAD = 0.30 В ±0.15 В).

---

## 4. DECK-KEYS: матрица 6×7 на MCP23017 (адрес 0x20)

ROW1..ROW3 — левая половина, ROW4..ROW6 — правая; COL1..COL6 — основные колонки,
COL7 — ряд больших пальцев. ROWn = GPA(n−1) (низкий активный), COLn = GPB(n−1)
с внешней подтяжкой 10 кΩ к +3V3 (R21..R27). Диод 1N4148: анод = клавиша, катод = столбец.
GPA7 / GPB7 свободны → 2 индикатора режима (`LED_MODE1`, `LED_MODE2`, 1 kΩ, активный низкий).

| Клавиша | ROW | COL | X | Y | Диод |
|---|---:|---:|---:|---:|---|
| KEY1 | 1 | 1 | 20 | 74 | D1 (анод=клавиша, катод=`COL1`) |
| KEY2 | 1 | 2 | 38 | 74 | D2 (анод=клавиша, катод=`COL2`) |
| KEY3 | 1 | 3 | 56 | 74 | D3 (анод=клавиша, катод=`COL3`) |
| KEY4 | 1 | 4 | 74 | 74 | D4 (анод=клавиша, катод=`COL4`) |
| KEY5 | 1 | 5 | 92 | 74 | D5 (анод=клавиша, катод=`COL5`) |
| KEY6 | 1 | 6 | 110 | 74 | D6 (анод=клавиша, катод=`COL6`) |
| KEY7 | 2 | 1 | 20 | 91 | D7 (анод=клавиша, катод=`COL1`) |
| KEY8 | 2 | 2 | 38 | 91 | D8 (анод=клавиша, катод=`COL2`) |
| KEY9 | 2 | 3 | 56 | 91 | D9 (анод=клавиша, катод=`COL3`) |
| KEY10 | 2 | 4 | 74 | 91 | D10 (анод=клавиша, катод=`COL4`) |
| KEY11 | 2 | 5 | 92 | 91 | D11 (анод=клавиша, катод=`COL5`) |
| KEY12 | 2 | 6 | 110 | 91 | D12 (анод=клавиша, катод=`COL6`) |
| KEY13 | 3 | 1 | 20 | 108 | D13 (анод=клавиша, катод=`COL1`) |
| KEY14 | 3 | 2 | 38 | 108 | D14 (анод=клавиша, катод=`COL2`) |
| KEY15 | 3 | 3 | 56 | 108 | D15 (анод=клавиша, катод=`COL3`) |
| KEY16 | 3 | 4 | 74 | 108 | D16 (анод=клавиша, катод=`COL4`) |
| KEY17 | 3 | 5 | 92 | 108 | D17 (анод=клавиша, катод=`COL5`) |
| KEY18 | 3 | 6 | 110 | 108 | D18 (анод=клавиша, катод=`COL6`) |
| KEY19 | 1 | 7 | 39 | 126 | D19 (анод=клавиша, катод=`COL7`) |
| KEY20 | 2 | 7 | 57 | 126 | D20 (анод=клавиша, катод=`COL7`) |
| KEY21 | 3 | 7 | 75 | 126 | D21 (анод=клавиша, катод=`COL7`) |
| KEY22 | 4 | 1 | 205 | 74 | D22 (анод=клавиша, катод=`COL1`) |
| KEY23 | 4 | 2 | 223 | 74 | D23 (анод=клавиша, катод=`COL2`) |
| KEY24 | 4 | 3 | 241 | 74 | D24 (анод=клавиша, катод=`COL3`) |
| KEY25 | 4 | 4 | 259 | 74 | D25 (анод=клавиша, катод=`COL4`) |
| KEY26 | 4 | 5 | 277 | 74 | D26 (анод=клавиша, катод=`COL5`) |
| KEY27 | 4 | 6 | 295 | 74 | D27 (анод=клавиша, катод=`COL6`) |
| KEY28 | 5 | 1 | 205 | 91 | D28 (анод=клавиша, катод=`COL1`) |
| KEY29 | 5 | 2 | 223 | 91 | D29 (анод=клавиша, катод=`COL2`) |
| KEY30 | 5 | 3 | 241 | 91 | D30 (анод=клавиша, катод=`COL3`) |
| KEY31 | 5 | 4 | 259 | 91 | D31 (анод=клавиша, катод=`COL4`) |
| KEY32 | 5 | 5 | 277 | 91 | D32 (анод=клавиша, катод=`COL5`) |
| KEY33 | 5 | 6 | 295 | 91 | D33 (анод=клавиша, катод=`COL6`) |
| KEY34 | 6 | 1 | 205 | 108 | D34 (анод=клавиша, катод=`COL1`) |
| KEY35 | 6 | 2 | 223 | 108 | D35 (анод=клавиша, катод=`COL2`) |
| KEY36 | 6 | 3 | 241 | 108 | D36 (анод=клавиша, катод=`COL3`) |
| KEY37 | 6 | 4 | 259 | 108 | D37 (анод=клавиша, катод=`COL4`) |
| KEY38 | 6 | 5 | 277 | 108 | D38 (анод=клавиша, катод=`COL5`) |
| KEY39 | 6 | 6 | 295 | 108 | D39 (анод=клавиша, катод=`COL6`) |
| KEY40 | 4 | 7 | 240 | 126 | D40 (анод=клавиша, катод=`COL7`) |
| KEY41 | 5 | 7 | 258 | 126 | D41 (анод=клавиша, катод=`COL7`) |
| KEY42 | 6 | 7 | 276 | 126 | D42 (анод=клавиша, катод=`COL7`) |

DECK_ID (pin 13): 3.3 kΩ на +3V3, 33 kΩ на GND → 3.3 × 33 / 36.3 = **3.00 В**
(`spec/20-electronics.md` §6.2: DECK_KEYS = 3.00 В ±0.15 В).

### 4.1 DECK-KEYS: LED-цепочка (42 × SK6812MINI-E)

`LED_IN` (pin 7 J-DECK) → LED_KEY1 → … → LED_KEY42 → `LED_END` (последний DOUT, без
нагрузки). Порядок = порядок номеров KEYn (левая половина 1…21, правая 22…42).

| # | Цепь DIN | Цепь DOUT | Клавиша | X | Y |
|---:|---|---|---|---:|---:|
| 1 | `LED_IN` | `LED_CH1` | KEY1 | 20 | 74 |
| 2 | `LED_CH1` | `LED_CH2` | KEY2 | 38 | 74 |
| 3 | `LED_CH2` | `LED_CH3` | KEY3 | 56 | 74 |
| 4 | `LED_CH3` | `LED_CH4` | KEY4 | 74 | 74 |
| 5 | `LED_CH4` | `LED_CH5` | KEY5 | 92 | 74 |
| 6 | `LED_CH5` | `LED_CH6` | KEY6 | 110 | 74 |
| 7 | `LED_CH6` | `LED_CH7` | KEY7 | 20 | 91 |
| 8 | `LED_CH7` | `LED_CH8` | KEY8 | 38 | 91 |
| 9 | `LED_CH8` | `LED_CH9` | KEY9 | 56 | 91 |
| 10 | `LED_CH9` | `LED_CH10` | KEY10 | 74 | 91 |
| 11 | `LED_CH10` | `LED_CH11` | KEY11 | 92 | 91 |
| 12 | `LED_CH11` | `LED_CH12` | KEY12 | 110 | 91 |
| 13 | `LED_CH12` | `LED_CH13` | KEY13 | 20 | 108 |
| 14 | `LED_CH13` | `LED_CH14` | KEY14 | 38 | 108 |
| 15 | `LED_CH14` | `LED_CH15` | KEY15 | 56 | 108 |
| 16 | `LED_CH15` | `LED_CH16` | KEY16 | 74 | 108 |
| 17 | `LED_CH16` | `LED_CH17` | KEY17 | 92 | 108 |
| 18 | `LED_CH17` | `LED_CH18` | KEY18 | 110 | 108 |
| 19 | `LED_CH18` | `LED_CH19` | KEY19 | 39 | 126 |
| 20 | `LED_CH19` | `LED_CH20` | KEY20 | 57 | 126 |
| 21 | `LED_CH20` | `LED_CH21` | KEY21 | 75 | 126 |
| 22 | `LED_CH21` | `LED_CH22` | KEY22 | 205 | 74 |
| 23 | `LED_CH22` | `LED_CH23` | KEY23 | 223 | 74 |
| 24 | `LED_CH23` | `LED_CH24` | KEY24 | 241 | 74 |
| 25 | `LED_CH24` | `LED_CH25` | KEY25 | 259 | 74 |
| 26 | `LED_CH25` | `LED_CH26` | KEY26 | 277 | 74 |
| 27 | `LED_CH26` | `LED_CH27` | KEY27 | 295 | 74 |
| 28 | `LED_CH27` | `LED_CH28` | KEY28 | 205 | 91 |
| 29 | `LED_CH28` | `LED_CH29` | KEY29 | 223 | 91 |
| 30 | `LED_CH29` | `LED_CH30` | KEY30 | 241 | 91 |
| 31 | `LED_CH30` | `LED_CH31` | KEY31 | 259 | 91 |
| 32 | `LED_CH31` | `LED_CH32` | KEY32 | 277 | 91 |
| 33 | `LED_CH32` | `LED_CH33` | KEY33 | 295 | 91 |
| 34 | `LED_CH33` | `LED_CH34` | KEY34 | 205 | 108 |
| 35 | `LED_CH34` | `LED_CH35` | KEY35 | 223 | 108 |
| 36 | `LED_CH35` | `LED_CH36` | KEY36 | 241 | 108 |
| 37 | `LED_CH36` | `LED_CH37` | KEY37 | 259 | 108 |
| 38 | `LED_CH37` | `LED_CH38` | KEY38 | 277 | 108 |
| 39 | `LED_CH38` | `LED_CH39` | KEY39 | 295 | 108 |
| 40 | `LED_CH39` | `LED_CH40` | KEY40 | 240 | 126 |
| 41 | `LED_CH40` | `LED_CH41` | KEY41 | 258 | 126 |
| 42 | `LED_CH41` | `LED_END` | KEY42 | 276 | 126 |

---

## 5. Сводка по шинам питания (по схемам)

| Плата | +5V (оценка) | +3V3 (оценка) | Что питается |
|---|---|---|---|
| PANEL-1 | 9 LED × ~10 мА + буфер U7 (5 мА) | ≈ 100 мА (экран 60 мА) | 9×WS2812B-2020 (+5 В), 74HCT1G125, 8×EC11 (RC), 6×74HC165, ST7789, Q1 BL |
| DECK-PAD | 18 LED × ~10 мА (pin 16 J-DECK) | MCP23017 (1 мА) + 2 мультиплексора + матрица | 18×WS2812B-2020 (+5 В), 18×12 мм кнопок, FSR-делители |
| DECK-KEYS | 42 LED × ~10 мА (pin 16 J-DECK) | MCP23017 + матрица + 2 fader | 42×SK6812MINI-E (+5 В) |

Все LED-цепочки питаются от **+5 В**: панель — напрямую (J-CORE pin 21), деки — через
pin 16 IDC-16 (`spec/20-electronics.md` §6.2). Данные `LED_DATA` (GP7, 3.3 В) проходят
через буфер U7 `74HCT1G125` (VCC = +5 В) и далее идут по цепочке с уровнем 5 В, включая
`LED_IN` деки — уровни светодиодов и данных совпадают, даташитные ограничения соблюдены.

Ограничение яркости — обязанность прошивки (`spec/40-firmware.md`): 9 LED на панели и 18/42
в деке; при 10 мА на LED суммарно по +5 В ≈ 120…200 мА (бюджет +5 В — до 0.8 А).

## 6. Обозначения для прошивки

| Сущность | Обозначение в схеме | Индексы |
|---|---|---|
| Энкодеры | `ENC1..ENC8` (+ `ENCn_A`, `ENCn_B`, `ENCn_PUSH`) | 1…8 |
| Плечевые | `BTN_L1`, `BTN_L2`, `BTN_R1`, `BTN_R2` | — |
| Пэды | `PAD1..PAD18` (+ `ROW1..3`, `COL1..6`) | 1…18 |
| Клавиши | `KEY1..KEY42` (+ `ROW1..6`, `COL1..7`) | 1…42 |
| Слайдеры | `SL1`, `SL2` (+ `SL1_RAW`, `SL2_RAW`) | 1…2 |
| RGB панели | `LED_ENC1..8`, `LED_STATUS` | 9 |
| RGB пэдов | `LED_PAD1..18` | 18 |
| RGB клавиш | `LED_KEY1..42` | 42 |
| Тип деки | `DECK_ID` | PAD = 0.41 В, KEYS = 2.89 В |
