martiyanov/bukifon/hardware/power/availability.md

# PWR-BATT-1 — доступность ключевых позиций

**Дата проверки:** 2026-11-05 (веб-поиск; ссылки — карточки поставщиков).
**Правило:** цены не выдумываются. Ниже — только то, что видно в карточках на дату проверки
(ориентировочно, за малые партии; фактическая цена зависит от партии/доставки/курса).
Пустая ячейка = данных нет, не проверялось.

| Позиция | Что именно | Доступность (2026-11-05) | Ориентир цены | Ссылка / замена |
|---|---|---|---|---|
| **TP4056** | `TP4056-MS-N1`, SOP-8-EP, MSKSEMI | **есть, 22 520 шт** (LCSC C54863579) | $0.057 (10+), $0.035 (1k+) | [LCSC C54863579](https://www.lcsc.com/product-detail/C54863579.html) |
| **TP4056** (замена) | `TP4056 (LX)`, lingxingic | **есть, 8 480 шт** (LCSC C49246856) | $0.037 (20+), $0.019 (20k+) | [LCSC C49246856](https://www.lcsc.com/product-image/C49246856.html) |
| TP4056 (готовый модуль) | плата 5 В/1 А с USB-C, 2.5 × 1.8 см | есть, AliExpress/Таобао | $0.08…0.20 | [пример пула модулей](https://www.accio.ai/find-product/tp4056-module-board) |
| **BQ24075** (альтернатива) | `BQ24075RGTR`, QFN-16-EP 3 × 3 | есть, TI (у LCSC/ДиП) | ≈ 0.95 $ (6.8 ¥) / 1 шт, дешевле от 100 | [карточка BQ24075RGTR](https://ebumall.ningmengdou.com/product/detail/82019) · замена: TP4056 (выбрано) |
| **MT3608** | `MT3608`, SOT-23-6, XI'AN Aerosemi, 1.2 МГц / 2 А | **есть** (LCSC C84817) | $0.06 (≈, см. BOM-обзор [hardware-x](https://www.hardware-x.com/action/showFullTableHTML?isHtml=true&tableId=utbl3&pii=S2468-0672%2825%2900025-2)) | [LCSC C84817](https://www.lcsc.com/ko/product-detail/C84817.html) |
| MT3608 (модуль) | плата step-up 2…24 В → 5…28 В, 2 А | есть (AliExpress, РФ-магазины) | 17…25 ₽ / 0.2…0.3 $ | [пример: voron.ua](https://old.voron.ua/en/search.php?search=dc-dc) |
| **TPS61088** (альтернатива «полная мощность») | QFN-20 3 × 3, 10 А ключ | есть у TI-дистрибьюторов | не проверено | замена: MT3608 + ограничение нагрузки (выбрано) |
| **BMS 1S 2P** | модуль DW01A + FS8205A, 2.5…5 А, 15 × 35 мм | есть (AliExpress, arduino.ua, РФ) | $0.3…0.8 | [пример: BMS 1S на DW01A/8205A](https://arduino.ua/cat504-1s) |
| **USB-C 16P** | `TYPE-C-31-M-12`, Korean Hroparts, SMD right-angle | **есть** (LCSC C165948; MOQ 5) | $0.188 (5+), $0.13 (150+) | [LCSC C165948](https://www.lcsc.com/product-detail/C165948.html) |
| USB-C (панельный пигтейл) | гнездо USB-C на кабель 15 см, 2 × USB-C | есть | $0.5…1.5 | замена SMD-разъёма, если нужен вынос на заднюю панель |
| **18650 держатель ×1 (SMT)** | Keystone **1042** (SMT, 1 банка) / **1043** (PCB) | есть у TME/Mouser/LCSC | ≈ 1.5…2.5 $ | [TME: держатели 18650 KEYS1042/1043/1049](https://www.tme.eu/html/EN/battery-holders-18650/ramka_10489_EN_pelny.html) |
| **18650 держатель ×2** | Keystone **1049** (PCB, 2 банки) | есть у TME | ≈ 2.5…3.5 $ | там же; либо сдвоенный 2-slot 77.1 × 39.8 × 14.9 ([SDTC](https://www.wantitall.co.za/SDTC-Tech-37V-18650-Battery-Holder-2Slot-Parallel-or-Series-PCB-SMT-Battery-Case-with-Copper-Pin-Contacts-for--ap-B08592R2CN.html)) |
| **Банки 18650** | 3.5 А·ч, защищённые (или без защиты + BMS) | есть (LiitoKala, Samsung INR18650-35E, РФ-магазины) | $2.5…5 / шт | рекомендуется: одинаковые, одна партия, **защищённые** как резервный уровень |
| **NTC 10k B3950** | термистор-бусина Ø1.5…2 мм, 10 кОм | есть | $0.1…0.3 | монтируется на банках, выводы — на J3 pin3 |
| **SS34** | SMA, 3 А / 40 В Schottky | есть (LCSC, РФ) | $0.02…0.05 | замена: SK34, 1N5822 |
| **USBLC6-2SC6** | SOT-23-6, ESD 2 линии | есть (LCSC C7519 и др.) | $0.05…0.10 | замена: PRTR5V0U2X, TPD2E2U06 |
| **SMAJ15A** | TVS 15 В, SMA | есть | $0.03…0.06 | замена: P6SMB16A |
| **Полифьюзы 1.1 / 2 А** | 1206 PPTC (MF-MSMF110/200) | есть | $0.05…0.12 | замена: 1206L110/1206L200 |
| **MC34063 / MP1584** | (на CORE-1, не на PWR-BATT-1) | см. `hardware/core/BOM-core.csv` | — | — |

## Выводы по доступности

1. **Все ключевые позиции доступны** на LCSC/ AliExpress/ TME; дефицитных нет.
   Самые «узкие»: сдвоенные держатели 18650 (TME, но есть и одиночные Keystone) и
   качественные банки 3.5 А·ч (только у проверенных продавцов — подделки 18650 массовы).
2. **TP4056 и MT3608 — копеечные и массовые** (22 тыс. и C84817 в наличии): выбор этих
   микросхем снижает риск закупки, в отличие от BQ24075/TPS61088 (QFN, дороже, 10…20×).
3. **USB-C 16P** (C165948, MOQ 5) — стандартный, для панельного варианта есть пигтейлы.
4. **BMS 1S 2P** — массовый товар, но качество разное: брать с реальными заявленными
   порогами (4.25/2.5 В) и с силовыми полигонами, а не «на 1 А». Проверять порог
   отключения каждого модуля перед установкой (ЛБП + вольтметр).
5. **Банки:** для 1S2P критично подобрать пару (ёмкость ±5 %, Ri ±10 %, напряжение ±0.02 В),
   иначе переток и ускоренная деградация.

## Что не проверено

- Наличие на **Rezon/Чип-и-Дип** (РФ) — не смотрел вебом в этот раз; цены РФ-розницы
  обычно 2…4× от LCSC.
- **Цены в `BOM-power.csv` намеренно пустые** — по правилам задачи цены не выдумываются;
  заполнять после решения Lead о канале закупки (LCSC vs РФ).
- Даты карточек: часть источников показывает дату обновления карточки 2026-09…2026-10
  (LCSC), т.е. данные свежие на дату проверки.
