martiyanov/bukifon/PULL_REQUEST.md

# MR: Букифон v0.4 — каноническая панель + 3D-корпус + платформа модулей

## Что в этом MR

**1. Каноническая раскладка панели v0.4** (`spec/panel-spec-v0.4.json`)
- Панель **380 × 210 × 3 мм**, глубина 63 мм.
- **42 клавиши** — точная геометрия Lapka-42 (21 на половину, Choc 18 × 17, родной
  splay), половины развёрнуты **±18°** как на утверждённом концепте. Относительная
  геометрия не искажена (в отличие от трассировки по фото).
- **16 энкодеров** Ø14: X = 25.2/54.1/82.6/111.4 и 269.3/297.8/326.6/355.8, Y = 35.7/68.5.
- **10 mini-jack 3.5 мм**: X = 129.9…247.8 (шаг 13.1), Y = 10.5.
- **Экран 5.0″ 800×480**: вырез = активная область 108 × 64.8, без рамки, центр (190, 58.7).
- **2 фейдера**: X = 175.1 / 204.0, прорезь 2.5 × 63, ход 60 мм.
- Проверка пересечений: **0** (`renders/templates/bukifon_v04_collisions.json`).

**2. 3D-корпус v0.4** (`mechanical/`)
- `stl_v04/`: panel_L 193×210×3, panel_R 190×210×3, body_L/R, ножки, колпачки; 3MF сборка.
- Все STL watertight, печать без поддержек, панель режется 193 + 190 мм с шипом.
- **83 сквозных выреза**, центры = JSON с точностью **0.0000 мм**; fitcheck: **0 конфликтов**.
- Рендеры: `mechanical/preview_v04/` (top_ortho, overlay на эталон, iso, closeup, exploded).

**3. Документы**
- `docs/10-elektron-hardware.md` — что стоит внутри Elektron (ColdFire + DSP56300/SHARC/FPGA).
- `docs/11-esp32-feasibility.md` — можно ли на ESP32: расчёт нагрузки, сравнение S3 / P4 /
  RP2040 / STM32H7 / Teensy, вердикт (v1.0 — ESP32-S3, v1.1 — ESP32-P4).
- `docs/12-roadmap.md` — дорожная карта P1–P7 с критериями выхода и рисками.
- `docs/00-context-transfer.md` — контекст проекта для передачи другим агентам.
- `spec/00-vision.md §12`, `README.md` — позиционирование платформы: **сэмплер (Digitakt-класс)
  + синтезатор (Syntakt-класс) + открытые модули сообщества** (программные, аналоговые
  картриджи, сменные деки).

**4. Прочее**
- Принят и сохранён машиночитаемый пакет заказчика v0.3: `refs/handoff_v03/` (JSON, DXF,
  SVG, CSV, OpenSCAD, HANDOFF.md), `spec/panel-spec-v0.3.json`.
- Печатные листы 1:1: `renders/templates/bukifon_v04_panel_1to1.pdf` (2 × A4 с перекрытием).
- Сравнение с концептом: `renders/templates/bukifon_v04_vs_concept.jpg`.

## Как проверить

1. `python tools/panel_from_json.py spec/panel-spec-v0.4.json bukifon_v04` — пересборка
   шаблона/рендера/проверки пересечений (должно быть 0).
2. `python mechanical/generator/case_v04.py && python mechanical/generator/fitcheck_v04.py` —
   пересборка STL и проверка (0 конфликтов).
3. Открыть `renders/templates/bukifon_v04_panel_1to1.pdf` и напечатать 1:1 (проверить
   линейку 50 мм) — наложить на макет.

## Известные ограничения

- Концепт-картинка нарисована «на глаз»: реальная Lapka-42 ложится на неё с RMS ≈ 7.5 мм.
  Для производства используется точная геометрия Lapka-42 (этот MR), а не картинка.
- Физический макет заказчика соответствует наклону ≈ ±22°; при 210 мм высоты панели
  с экраном 5″ такой наклон не помещается (нужно ~230 мм). В v0.4 принято ±18°.
- Для окончательных посадочных отверстий клавиш нужен оригинальный `.kicad_pcb` Lapka-42
  (сейчас используется открытая геометрия проекта braindefender/lapka-42).
