martiyanov/bukifon/docs/82-pcb-layout-plan.md

# План разводки PCB rev.1 (CORE-2 / PANEL-2 / PWR-2)

Документ-«мостик» между PRE-FREEZE-схемами и разводкой. Разводка начинается **только после**
MCU freeze (docs/56) и PWR 13/13 (docs/51); до этого — подготовка правил и посадочных мест.

## 1. Стек и материалы

| Плата | Слои | Стек | Толщина | Медь | Примечание |
|---|---|---|---|---|---|
| CORE-2 | 6 | Sig / GND / Sig / PWR / GND / Sig | 1.6 мм | 1 oz (внутр. 0.5 oz) | USB HS 90 Ω, I2S, аудио |
| PANEL-2 | 4 | Sig / GND / PWR / Sig | 1.6 мм | 1 oz | **две платы 180+180** в контуре 360×190, 42 клавиши, FPC-40 |
| PWR-2 | 4 | Sig / GND / PWR / Sig | 1.6 мм | **2 oz** | 1.6 А + батарея, тепловые полигоны |
| CORE-S3 (lite) | 4 | Sig / GND / PWR / Sig | 1.6 мм | 1 oz | отдельный профиль |

Импеданс: USB HS D+/D− — **90 Ω ±10 %** (дифф.), USB FS — 90 Ω; I2S/SPI — без импеданса,
но длина <50 мм; PSRAM/Flash — короткие трассы, без стабов.

## 2. Контуры и крепёж (зафиксировано: `mechanical/board-fit/`)

Источник чисел — `mechanical/generator/make_board_fit.py` (из параметров генератора
и `spec/panel-spec-v0.4.json`), пакет: **`mechanical/board-fit/`**
(`board-spec.json`, DXF `core2/panel2left/panel2right/pwr2` + `assembly.dxf`, SVG/PNG,
README). Проверки 2D: 22 проверки, **0 конфликтов** (`mechanical/fit_check.md`).

| Плата | Контур, мм | Origin (world X; Y) | Крепёж | Ø отв. / стойки |
|---|---|---|---|---|
| CORE-2 rev.0 | **200 × 108** | 90; 51 | 4 × M3 | Ø3.4 / Ø7.0 |
| PANEL-2 rev.2, левая | **180 × 190** | 10; 10 | 3 × M3 (всего 6) | Ø3.4 / Ø7.0 |
| PANEL-2 rev.2, правая | **180 × 190** | 190; 10 | 3 × M3 (всего 6) | Ø3.4 / Ø7.0 |
| PWR-2 rev.1 | **90 × 70** | 145; 65 | 4 × M2.5 | Ø2.8 / Ø6.0 |

- **PANEL-2 — две платы** по шву X=190 (180 + 180 в общем контуре 360×190:
  X 10…370, Y 10…200). Механический разрез панели — **193 + 190** (3 мм — шип
  панели, не платы; PCB повторяет шов, но без шипа).
- Стойки PANEL-2 фактически: **(30, 65, 150, 230, 283, 341) × Y=46** в координатах
  панели (world Y ≈ 46.6 при клине 8°). Прежние «(30/145/260 × 30/180)» были TBD и
  **не совпали** с fitcheck — заменены фактическими.
- CORE-2/PWR-2: контуры = внутренняя ниша корпуса; ниша B — 375×205 (стенки 2.5),
  B-light — 376×206 (стенки 2.0); платы проходят в обе редакции (зазор ≥7.5 мм).
- Вырезы/разъёмы и keepout'ы — таблицы в `mechanical/board-fit/README.md`:
  USB-C-окно (X 346…356), вентиляция, порт MEMS (122;5.5) и LED (116;10.5);
  джеки/энкодеры/клавиши/фейдеры/экран — по JSON; MIDI TRS/DC/EXPRESSION/mic jack/SD —
  предложение (в STL вырезов пока нет, добавить в корпус перед печатью).
- Импорт DXF в KiCad: File → Import → DXF, слой **Edge.Cuts**, мм, Y-up (файлы уже в
  таком виде).

## 2a. PANEL-2 — параллельна панели (плата, а не горизонтальная полка)

Для эргономики (оси энкодеров/клавиш ⊥ панели) **PANEL-2 лежит в плоскости панели**:
- наклон: **8°** (B/B-light/B_mic), **12°** (C/C_mic), **0°** (A flat);
- 6×M3 стоек — **оси ∥ нормали панели**, верх стоек ∥ панели; втулки M3 — вдоль нормали;
- зазор низ панели ↔ верх платы: **12.0 мм** (низ платы 13.6 мм; под колпачки/энкодеры);
- энкодеры/клавиши/фейдеры — одинаковые высоты и оси ⊥ панели по всей площади;
- CORE-2/PWR-2 остаются горизонтально; шлейфы J13/J14/J16 достают.

Числа для PCB/сборки: `mechanical/board-fit/board-spec.json` → у плат PANEL-2 поле
`mount_plane` (угол панели по вариантам, offset 12 мм, толщина 1.6, ось крепежа —
нормаль). Fitcheck: строки `[P]` — угол 0.00°, зазор 12.00 мм, оси стоек ∥ нормали
(0 конфликтов). Подробно — `mechanical/prints.md` § «PANEL-2 параллельна панели».

## 3. Зоны размещения (floorplan)

| Плата | Зоны | Правила |
|---|---|---|
| CORE-2 | USB-C (край), P4+C6 (антенна ≥15 мм), PSRAM, DAC/ADC (аналог), PCM5102A/1808, BMS/заряд, SD | аналог отдельной зоной, звезда GND; C6-антенна на краю, keepout под ней; USB HS пары до разъёма без переходных отверстий |
| PANEL-2 (две платы 180+180) | 42 Choc, 16 EC11, 10 джеков, фейдеры, FPC-40, MCP23017×4, MEMS (122,5.5), LED-цепочка | клавиши/энкодеры по JSON ±0.1 мм; MEMS ≥10 мм от WS2812/BL; FPC-40 — прямой выход, без резких изгибов; контуры/стойки — `mechanical/board-fit/` |
| PWR-2 | TPS61088 + индуктивность, LMR33630, BMS, батарейный разъём, master switch | тепловые полигоны, силовые трассы ≥2 мм (2 oz), обратная связь отдельно, TVS у разъёмов |

## 4. Критичные цепи

- **USB HS** (CORE-2): дифф-пара 90 Ω, без стабов, ESD у разъёма, длина <40 мм.
- **I2S/DAC** (CORE-2): MCLK/BCK/WS параллельно, экран GND, аналоговые выходы после DAC —
  отдельная зона, без пересечения с DC-DC.
- **Микрофон** (PANEL-2/CORE-2): MIC_BCK/WS/DATA — короткие, экранированные, I2S1 J16↔J19 1:1;
  MIC_VDD через FB, отдельная земля MIC звездой.
- **LED-цепочка** (PANEL-2): LED_DATA 3.3 В, последовательно 17×WS2812, буфер/уровни, ток ≥1.5 А
  по 5V_LED, возврат LED_RET отдельно от аудио GND.
- **CV/GATE**: MCP4728 → джеки, RC-фильтр, защита; CV IN — TVS, делитель.

## 5. DRC/DFM-правила (минимум)

- зазор/трасса: 6/6 mil (сигнал), 8/8 mil (питание), 10 mil (класс), 0.2 мм к краю;
- переходные: 0.3/0.6 мм (сигнал), 0.45/0.8 мм (питание), термо-барьеры;
- шёлкография: ≥0.15 мм, не на падах; полярность/позиционные обозначения;
- паяльная маска: 0.1 мм зазор; тест-поинты φ1.0 мм (TP1–TP32 CORE-2, TP36–39 PANEL-2);
- отверстия/пазы по краю — фрезой ≥1 мм, радиусы ≥0.5 мм;
- **fiducials** 3×1 мм по углам + tooling holes; panelization ≤220×220 для домашней печати.

## 6. Пошаговый процесс (после freeze)

1. Импорт netlist из `.kicad_sch`; создать `.kicad_pcb` с контуром/крепёжом.
2. Floorplan по §3; критичные цепи — первыми, затем питания, затем сигнал.
3. Заливки GND (4 слоя), проверка возвратных токов; аналог/цифра — звезда.
4. DRC + ERC-чеклист; проверка DFM (docs/38) и test points.
5. Импеданс-отчёт (USB) и stackup от фабрики.
6. Ревью: Lead + внешний (по возможности); фото/скриншоты; чек-лист.
7. Gerber/Drill/CPL → `fab/` по [docs/83](83-fab-package.md); заказ только после gate.

## 7. Риски

- P4 BGA/модуль и USB HS — главный риск первой платы; при возможности — 4 слоя для USB-зоны.
- PANEL-2 360×190 (две платы 180+180): прогиб/панелизация; жёсткость 1.6 мм, 6×M3.
- PWR-2 2 oz: минимальные зазоры; тепловой расчёт TPS61088 (docs/44).
- Микрофон: акустика/изоляция от LED — проверять на прототипе (docs/71).

## 9. Каркасы rev.1 готовы (2026-11-06)

Созданы первые файлы разводки из `mechanical/board-fit/` (D-101). Только контур/крепёж/
keepout/стек — **без компонентов, netlist и меди**; PCB не заказывать.

| Плата | Файл | Контур | Слои/медь | Крепёж | DRC | Verify ±0.05 |
|---|---|---|---|---|---|---|
| CORE-2 | `hardware/core2/rev1/CORE-2-rev1.kicad_pcb` | 200×108 | 6, 1 oz | 4×M3 Ø3.4 | 0/0/0 | PASS |
| PANEL-2-left | `hardware/panel2/rev1/PANEL-2-left-rev1.kicad_pcb` | 180×190 | 4, 1 oz | 3×M3 Ø3.4 | 0/0/0 | PASS |
| PANEL-2-right | `hardware/panel2/rev1/PANEL-2-right-rev1.kicad_pcb` | 180×190 | 4, 1 oz | 3×M3 Ø3.4 | 0/0/0 | PASS |
| PWR-2 | `hardware/power2/rev1/PWR-2-rev1.kicad_pcb` | 90×70 | 4, **2 oz** | 4×M2.5 Ø2.8 | 0/0/0 | PASS |

- Edge.Cuts: прямоугольник + дуги вырезов джеков Ø8.2 (PANEL-2) точно по `board-spec.json`;
  крепёж — NPTH-пады (`np_thru_hole`) с позициями H1…; keepout-зоны (медь/трассы/via)
  для антенны C6, аналога, DC-DC, экрана/клавиш/энкодеров/фейдеров, батареи.
- Стек: 6 слоёв (CORE-2), 4 слоя (PANEL-2, PWR-2 2 oz), толщина 1.6 мм; импедансы — по §1.
- Проверки: `kicad-cli pcb drc --severity-all` — **0 нарушений, 0 unconnected** на всех 4;
  `verify_scaffold.py` — контуры/отверстия/вырезы/keepout/стек совпадают с board-spec (±0.05 мм).
- SVG/PDF контура: `hardware/*/rev1/*.svg|*.pdf`; README — в каждой `rev1/`.
- Особенности: keepout разрешает NPTH-пады (механическая несовместимость антенны C6 и стойки H1 —
  проверить RF до финальной разводки); USB-C keepout из board-spec лежит вне платы (окно корпуса).
- **Дальше (следующий шаг):** импорт netlist CORE-2 rev.3 / PANEL-2 rev.2 / PWR-2 rev.1,
  посадочные места, правила DRC/импедансов, медные полигоны; PCB — только после MCU freeze
  (docs/56) и PWR 13/13 (docs/51).

## 10. Нетлист/футпринты: первый импорт (2026-11-06)

Импорт нетлиста выполнен генератором `hardware/core2/rev1/import_netlist.py` (KiCad CLI не умеет
«Update PCB from schematic»; компоненты/сети/пады сгенерированы из netlist + BOM).
Схемы не менялись, трассировки нет.

| Плата | Refs на плате | Footprints | Placeholder | Pads | DRC errors/warnings | Unconnected |
|---|---:|---:|---:|---:|---:|---:|
| CORE-2 rev.1 | 373 (+4 NPTH) | 373 | **16** | 1224 | **0 / 0** | 499 |
| PANEL-2-left | 181 (+3 NPTH) | 181 | **21** | 585 | **0 / 0** | 368 |
| PANEL-2-right | 174 (+3 NPTH) | 174 | **21** | 443 | **0 / 0** | 265 |
| PWR-2 rev.1 | 128 (+4 NPTH) | 128 | **0** | 328 | **0 / 0** | 263 |

- `verify_import.py`: все ref из нетлиста присутствуют (кроме H-креплений — они представлены
  NPTH-падами каркаса), каждому назначен footprint; `PLACEHOLDER_*` перечислены в README каждой платы.
- Footprint-маппинг: стандартные R/C/SOT/QFN/TDFN/MSOP/USB-C/IDC/FFC — из BOM (KiCad-библиотеки,
  в PCB — bare-имена, библиотека в BOM); кастомные (P4-модуль, C6-MINI-1, джеки TRS/DC, кнопки,
  Choc-клавиши) — placeholder с корректным числом падов; полный список в README.
- Расстановка (не разводка): CORE-2 — USB-C J1 у задней кромки, C6 U31 у антенной зоны (вне keepout),
  A1 в центре; PANEL-2 — энкодеры/клавиши/фейдеры/джеки по центрам keepout/вырезов board-fit,
  остальное поровну; PWR-2 — сетка, силовая зона под ручную разводку. Пересечений с **антенным**
  keepout нет (кроме NPTH H1 — механика, RF-проверка).
- Ограничения: нет трассировки/полигонов; в каркасе пады сгенерированы **упрощённо**
  (0.5×0.8 мм, шаг 1.0) с корректными номерами и числом — реальные `.kicad_mod` из KiCad-библиотек
  (имена footprint'ов уже в BOM) подтянуть при разводке; placeholder'ы и bare-имена требуют замены/
  связывания с библиотеками; DRC-unconnected (499/368/265/263) — ожидаемо на каркасе.
- **Fab dry-run:** `bash tools/export_fab_dryrun.sh` → генерирует `fab/<board>/rev1-scaffold/` на месте (gerbers/drill/CPL/BOM/PDF); в git не хранится; checker PASS; см. docs/83 §8. **Не для заказа.**
- **Дальше:** реальные футпринты кастомных (см. README), правила DRC/импедансов, медные полигоны/GND,
  затем трассировка — только после MCU freeze (docs/56) и PWR 13/13 (docs/51).

## 10a. Исправление раскладки клавиш (06.11.2025)

Найдена и исправлена ошибка каркасов PANEL-2: refs `KEY_*` делились по номеру **без учёта L/R**,
из-за чего на левой плате оказывались `KEY_R01…R11`, на правой — `KEY_L11…L21`, и клавиши
накладывались. Теперь **каждая плата содержит ровно свои 21 клавишу** (`KEY_L01…L21` /
`KEY_R01…R21`) по координатам и углам из `spec/panel-spec-v0.4.json` — это точная геометрия
Lapka-42 (upstream `braindefender/lapka-42`, `KiCad/Lapka42.kicad_pcb`; проверка: после поворота
на +18° остаточное отклонение **0.006 мм**). DRC после исправления — **0/0**; превью:
`docs/assets/panel-lapka-left.png`, `panel-lapka-right.png`.

## 11. Реальные футпринты и DRC-правила (2026-11-06)

- **Placeholder'ы заменены полностью: 0** на всех платах. Кастомные `.kicad_mod` созданы в
  `hardware/*/rev1/footprints/` + `fp-lib-table`: `A1_P4_MODULE_ADAPTER` (2×32, адаптер 90×28),
  `C6_MINI_1` (13.2×16.6), `MP1584_MODULE` (4 пада), `CHOC_V1` (Kailh Choc hot-swap, 18×18).
  Стандартные: TRS — `Connector_Audio:Jack_3.5mm_CUI_SJ1-3535NG_Horizontal`, DC —
  `Connector_BarrelJack:BarrelJack_CUI_PJ-063AH_Horizontal`, кнопки —
  `Button_Switch_THT:SW_PUSH_6mm`, BQ24074 — `Package_DFN_QFN:QFN-16-1EP_3x3mm_P0.5mm_EP1.75x1.75mm`.
  Вставка — через **pcbnew Python API** (реальная геометрия, пады с net).
- **DRC-правила/сет-классы** в `.kicad_pro`: `Default`, `Power` (ширина 1.0 мм; силовые до 2 мм
  при разводке), `USB_HS` (90 Ω: diff width/gap 0.2/0.2, clearance 0.15), `Audio` (0.25 мм),
  `RF` (C6 SPI); track widths 0.2–2.0, via 0.6/0.3 и 0.8/0.45, diff pair 0.2/0.2; каркасные
  silk/courtyard — ignore. Проверка: `verify_import.py` — **RULES PASS** (5 классов, 5 ключевых
  netов: USB_HS_DP/DM, +12V, AUDOUT_L, C6_CS).
- **Счётчики:** CORE-2 373 refs/1259 pads, PANEL-2 181+174/630+488, PWR-2 128/332;
  **DRC 0 errors / 0 warnings** на всех 4; unconnected 499/367/264/263 (допустимо).
- **GND-полигоны (план, заливка позже):** GND на F.Cu/B.Cu после трассировки; AGND — отдельная
  зона (DAC/ADC), звезда в NT1/NT2; PGND — силовая зона у J17, звезда у входных ёмкостей;
  под антенной C6 — keepout без меди; LED-возврат — отдельно к J13. Заливку/stitching — после
  MCU freeze и трассировки.
- **Ограничение:** для не-заменённых стандартных компонентов в каркасе пады упрощённые
  (0.5×0.8/шаг 1.0) — полные `.kicad_mod` подтягиваются при разводке; правила/классы уже готовы.

## 12. Реальные футпринты пассивов и GND-полигоны — статус (2026-11-06)

**Частично выполнено; полный перевод на реальные пассивы и заливка GND пока не прошли DRC.**

| Пункт | Статус |
|---|---|
| Placeholder'ы (A1/C6/MP1584/CHOC/джеки/кнопки/QFN) | **заменены, 0** |
| Стандартные пассивы (R/C/диоды/ОП/MCP/QFN/электролиты/дроссели) | **остались упрощёнными падами 0.5×0.8** — 328 шт.; footprint-имена из BOM/KiCad уже назначены |
| GND/AGND/PGND-полигоны + stitching | **не залиты** (только план §11) |
| DRC | **0 errors / 0 warnings** на всех 4 (текущее состояние) |
| verify_import | **PASS**, но `SIMPLIFIED PADS: 328` (цель 0) |

**Что пробовали (скрипты сохранены):**
- `hardware/core2/rev1/build_full_pcb.py` — загрузка реальных `.kicad_mod` для **всех** 373/181/174/128
  компонентов через pcbnew, MaxRects-упаковка, звёздные AGND/PGND-зоны, stitching. Результат:
  DRC **FAIL** (clearance/shorting/holes_co_located: реальные футпринты крупнее упрощённых падов,
  на 200×108 и 180×190 при 373/181 компонентах упаковка без пересечений не сходится; плюс
  `zones_intersect`/`isolated_copper`/`starved_thermal`).
- `hardware/core2/rev1/add_gnd_zones.py` — GND-зоны, обходящие все keepout, + via stitching.
  CORE-2: 1 `isolated_copper`; PANEL-2: `zones_intersect` (126), `isolated_copper`, `starved_thermal`;
  PWR-2: `starved_thermal`/`isolated_copper` → не применяли.
- GND-полигоны требуют **трассировки/оптимизации размещения** (реальные площади футпринтов,
  зазоры, thermal relief, разрезание зон под keepout) — это следующий шаг после MCU freeze
  (docs/56) и трассировки; текущие каркасы остаются DRC-clean.

**Текущее состояние (принято для rev.1 scaffold):** 0 placeholder, DRC 0/0, verify PASS,
стандартные пады упрощённые (документировано), GND-полигоны — план. Это осознанный компромисс:
каркас не для заказа, а следующий шаг (реальные пассивы+заливка) требует трассировки.

## 13. Двусторонняя расстановка реальных футпринтов + GND-зоны (2026-11-06)

**Попытка №2 (top+bottom) — DRC снова не 0/0; основная версия оставлена DRC-clean.**

- Скрипт: `hardware/core2/rev1/build_two_sided.py`; результаты **удалены из дерева** после фиксации FAIL (воспроизводимы скриптом)
  (копии, **не промоутнуты** в основную). Main-платы по-прежнему DRC **0/0**, verify PASS.
- Разделение сторон: top — IC/разъёмы/клавиши/энкодеры/джеки/фейдеры (A1/U/J/SW/KEY/ENC/F/LED/TB),
  bottom — пассивы (R/C/D/Q/L/TP/FB); баланс по площади ~60/40.
  CORE-2 top **61** / bottom **312**; PANEL-2-left **45/136**; PANEL-2-right **40/134**; PWR-2 **19/109**.
- Футпринты: **все реальные** (`.kicad_mod` из KiCad-библиотек/кастомные), площадь падов
  CORE-2 ≈ **9 881 мм²** при доступных 2×21 600 мм² (по площади помещается).
- **DRC итог (FAIL):** CORE-2 **1810** нарушений (500 clearance, 200 shorting_items,
  200 solder_mask_bridge, silk/courtyard), PANEL-2-left **1160** / right **1152**
  (`courtyards_overlap`, `solder_mask_bridge`, `zones_intersect` 122, `silk_over_copper`),
  PWR-2 **896** (clearance/shorting/silk/courtyard). Unconnected ~499/499/499/499.
- **Причины:** (1) простая shelf/MaxRects-упаковка не обеспечивает зазор 0.15–0.2 мм и
  отсутствие пересечений **courtyard** для реальных футпринтов разной высоты/ширины;
  (2) нижняя сторона (зеркальные футпринты + silk/mask) добавляет `solder_mask_bridge`/
  `silk_overlap`; (3) GND-зоны после такой упаковки пересекаются с keepout/фрагментами
  (`zones_intersect`, `isolated_copper`, `starved_thermal`). По площади места достаточно —
  проблема в **алгоритме размещения**, а не в площади.
- **Что нужно для успеха:** специализированный floorplanner (courtyard-aware, с поворотами и
  явными зонами), итеративная оптимизация + трассировка; это этап **после MCU freeze**, а не
  каркас. Основные DRC-clean платы не тронуты; `SIMPLIFIED PADS` в них остаются **328**.

**Статус:** основная версия — DRC 0/0, 0 placeholder, 328 упрощённых падов, GND-полигоны
не залиты; двусторонний эксперимент зафиксирован как FAIL (DRC-числа в отчёте), артефакты удалены.
