martiyanov/bukifon/docs/75-release-readiness.md

# Готовность к v1.0-rc: ворота, статусы, владельцы

Единая таблица «что осталось до собранного устройства». Инженерная часть закрыта
настолько, насколько возможно без железа; дальше — заказы, печать и измерения.

## 1. Ворота (gates)

| # | Ворота | Условие прохода | Статус | Владелец | Доказательство |
|---|---|---|---|---|---|
| G1 | **Заказ P1-стенда** | заказаны P4 EV, H743, S3, кодеки, дисплеи | ⏳ ждёт оплаты | владелец | docs/54, docs/29 |
| G2 | **Заказ PWR-стенда** | EVM вариант A + bare-IC + нагрузка | ⏳ ждёт оплаты | владелец | docs/44, bench-bom |
| G3 | **LCD-адаптер + образцы** | 2 платы, ZIF/FFC, HotLCD ×2 | ⏳ ждёт оплаты | владелец | docs/49 |
| G4 | **Печать половинки B-light** | 230.9 г / 11.2 ч, без люфтов | ⏳ ждёт печати | владелец/мастерская | docs/35 |
| G5 | **PWR 13/13 PASS** | ripple ≤30 мВ, load-step, тепло, BMS | ⏳ после G2 | инженер | docs/51, docs/44 |
| G6 | **P1 P4 vs H743** | max block ≤650 µs, UI ≥30 fps, USB 8×8, 24 ч | ⏳ после G1 | инженер | docs/56 |
| G7 | **MCU freeze** | выбор платформы по docs/56 | ⏳ после G6 | Lead | spec/90 |
| G8 | **PCB rev.1 заказ** | G5+G6+G7 + DRC/DFM ревью | ⛔ заблокировано | инженер | docs/38, 42 |
| G9 | **3–5 прототипов** | сборка (docs/72), bring-up 15 шагов | ⏳ после G8 | мастерская | docs/43 |
| G10 | **RC DoD** | 8 тестов (docs/36) + UX blind 5 людей | ⏳ после G9 | Lead | docs/36, 74 |
| G11 | **Release bundle v1.0-rc** | герберы/CPL, прошивка bin+source, recovery, гайды | ⏳ после G10 | Lead | RELEASE_BUNDLE.md |
| G12 | **Репозиторий** | пересоздан, PII purge, `.git` ~размер дерева | ⏳ ждёт владельца | владелец | docs/41 |

## 2. Что уже закрыто (инженерно)

- [x] панель/корпуса/эргономика (4 варианта, paperkit, fitcheck 0);
- [x] CORE-2 rev.3, PANEL-2 rev.3, PWR-2 rev.1 — ERC/PINMAP/SCHEMATIC PASS;
- [x] микрофон: схемы + datasheet-сверка (4 расхождения исправлены) + прошивка + UI;
- [x] прошивка: **407/407 тестов**, UI 7 вкладок, 12 треков, GEN/EXT/MIC, SDK, **factory self-test 21**;
- [x] P4 toolchain: ESP-IDF v5.5 собирает bin;
- [x] демо 9/10 + **blind UX-харнесс** + **авто-прогон 8/8** (`node tools/test_demo_ux.js`);
- [x] философия/читаемость/UX-паттерны (docs/65/68/69);
- [x] гид по сборке в РФ (docs/72), закупочный лист (docs/54);
- [x] **PCB rev.1 каркасы**: 4 платы (контуры/нетлист/футпринты), DRC 0/0, fab dry-run PASS
  (не для заказа), скрипты упаковки/GND сохранены (docs/82 §10–12);
- [x] **сайт**: bukifon.ru (HTTPS, канон), .com → 301, деплой/бэкапы/авто-TLS (docs/88);
- [x] **корпуса**: все вырезы разъёмов (11 задних + SD + USB-C), B-light 230.9 г;
- [x] security/EXIF/PII, release bundle, fresh-history bundle;

## 3. Порядок действий (следующие 2 недели при заказе «завтра»)

1. **День 1**: заказ G1+G2+G3; печать G4; пересоздание репо G12.
2. **Дни 2–7**: приход EVM → 13 измерений (2.5 дня) → G5; приход P4 EV → hello/I2C/engine/bench → G6.
3. **Дни 7–10**: MCU freeze (G7); если P4 проходит — PCB rev.1 дизайн; если нет — fallback H743.
4. **Дни 10–21**: заказ PCB+stencil (G8), сборка 3–5 прототипов (G9, docs/72).
5. **Дни 21–28**: bring-up (docs/43), factory self-test 21, RC DoD (G10), UX-тест 5 людей.
6. **Релиз v1.0-rc**: bundle, тег, сайт, отчёт (G11).

## 4. Точки stop/go

- **PWR**: любой FAIL в T3/T4/T5/T6 → фикс макета и повтор, **PCB не заказывать**.
- **P1**: max block >650 µs или UI <30 fps у P4 → H743-ветка (CORE-2-H743), P4 — в lite.
- **Сборка**: first-pass yield <80 % на 5 прототипах → правка DFM/сборки до партии.
- **UX**: <4/5 проходят time-to-sound ≤10 с → правки UI до релиза.

## 5. Чего пока нет (осознанно)

- герберов/CPL (появятся после G7/G8);
- бинарников P4/S3 с реального железа (после G9);
- заводских прошивок/QR партии (после G9);
- финального SBOM с версиями зависимостей (перед релизом).
