martiyanov/bukifon/docs/71-mic-voice.md

# Микрофон и голос как вход: запись, битбокс, вокодер

Идея: **голос — самый быстрый вход musical idea**. Пропеть/настучать идею и сразу получить
сэмпл, паттерн или (позже) вокодер. Микрофон — не «опция для студии», а часть инструмента,
всегда доступная, с честной приватностью (кнопка mute + LED).

## 1. Сценарии

| # | Сценарий | Версия |
|---|---|---|
| 1 | **Записать голос/фразу** в любой момент → сэмпл на пэд, обрезка, loop | v1.0-rc |
| 2 | **Битбокс → паттерн**: настучать «кик/снейр/хэт» → шаги секвенсора (простые классы) | v1.0-rc (onset/velocity), классы — v1.1 |
| 3 | **Вокодер**: голос управляет синтезатором (8–16 полос) | v1.1 (backlog R-39) |
| 4 | Пение в реальном времени как модулятор/экспрессия | v1.2 |

## 2. Аппаратно

### Микрофон
- **Основной: цифровой I2S MEMS-микрофон** (ICS-43434 / SPH0645LM4H) на PANEL-2,
  верхняя кромка, акустический порт с сеткой/поролоном; 24 бит/48 кГц, без аналогового шума.
- **Дополнительный: 3.5 мм TRS jack** (mic/headset) на задней панели CORE-2 для
  петлички/гусиной шеи: электрет → **MAX9814** (AGC, 20–60 дБ) → аналоговый коммутатор →
  PCM1808 (line-in) или отдельный вход. Питание микрофона 3.3 В через bias-резистор 2.2 кОм.
- **«Торчащий» микрофон**: гибкая гусиная шея на 3.5 мм — вставляется в mic-jack, крепится
  клипсой к корпусу; либо короткий жёсткий держатель на верхней кромке (печатная деталь).
- **Приватность (обязательно)**: аппаратный **mic mute switch** (переключатель, разрывающий
  питание/сигнал) + **LED «MIC ON»**; в прошивке — индикатор и запрет записи при mute;
  никакой постоянной передачи звука наружу (Wi-Fi/BT) без явного действия.

### Маршрут сигнала
```
MEMS I2S ──────────────► P4 I2S1 (RX)
3.5mm → MAX9814 AGC ───► PCM1808 IN (L/R) ──► P4 I2S0 (RX)
                                    └─► (v1.1) вокодер: голос = модулятор,
                                        внутренний синтез = несущая
```
- I2S1 на P4 отдельный от аудио-кодека; при необходимости — TDM (mic + codec).
- Задержка: mic→P4 ≤ 5 мс (I2S DMA), для вокодера — компенсация.

### Механика (реализовано: D-94, корпус v0.5-B-light)

**Где порт в печатных вариантах.** Порт есть в `mechanical/stl_v05_B_light/`
(по умолчанию), а также в опциональных `stl_v05_B_mic/` и `stl_v05_C_mic/`
(пересборка: `python mechanical/generator/case_v05.py --mic`). Варианты
`stl_v05_B/` и `stl_v05_C/` — без порта; панель можно заменить на `*_mic`.
Везде координаты одинаковые:

**Порт MEMS (панель).** На верхней (задней) кромке панели, **слева от экрана**:
центр **(X = 122.0, Y = 5.5)**, в 5.5 мм от задней кромки; свободно от джеков
(ближайший X 129.9, гайка Ø8.2 → зазор 3.9 мм) и энкодеров левого блока
(ближайший X 111.4, Y 35.7). Вырезы:
- акустический порт **Ø1.8** сквозной;
- цековка под сетку/поролон **Ø3.4 × 0.7** (снаружи) — защита от пыли/влаги;
- углубление под MEMS/флянец звуковода **Ø5 × 1.2** (снизу), остаточная
  толщина панели над углублением ≈ 0.8 мм;
- **LED MIC ON**: отверстие **Ø1.6** + цековка Ø2.8 × 0.5, центр
  **(X = 116.0, Y = 10.5)** — рядом с портом, слева; зазор до гнезда джека 4.0 мм.

Исходные 83 выреза панели из `spec/panel-spec-v0.4.json` **не менялись**:
панель = JSON + 2 новых отверстия (порт + LED). Fitcheck:
`mechanical/fit_check.md`, секция v0.5-B-light — **41 проверка, 0 конфликтов**.

**Гнездо mic jack в корпусе:** в задней стенке B-light (и B/B_mic/C_mic) —
**Ø8.2, X=140, Z=17** (ось Y); рядом вся аудио-группа: LINE OUT L/R X160,
PHONES X172, AUDIO IN L/R X184/196, CV OUT 5/6 X208/220, MIDI IN/OUT X30/44,
DC X91. Гусиная шея/TRS вставляется сзади, кабель — внутрь к CORE-2 (MAX9814).
Вырезы проверены: перемычки ≥3.8 мм, панель не менялась
(`fit_check.md` § «вырезы разъёмов»).

**Звуковод** (`mechanical/stl_v05_B_light/mic_guide.stl`, опционально STEP):
флянец Ø8 × 1 мм под панелью, раструб Ø6→Ø7, внутренний канал Ø2.0→Ø4.5,
высота **7.5 мм**; низ на 0.5 мм выше PANEL-2 (MEMS на PANEL-2 сверху,
порт — через панель). Клеится/прижимается флянцем в углубление Ø5.

**Держатель гусиной шеи 3.5 мм — 2 печатных варианта:**
1. `mic_clip_rear.stl` — **клипса на заднюю кромку панели**: C-зажим, зев
   **3.6 мм** (панель 3.0 + 0.6), 18 × 16 × 14 мм, вертикальное гнездо
   Ø6.8 × 8 мм с отверстием Ø3.6; масса ≈ 0.65 г, печать 0.4 / 0.12, 100 %,
   без поддержек;
2. `mic_holder_top.stl` — **короткий держатель на верхнюю кромку**: низкий
   профиль 20 × 20 × 11 мм, тот же зев 3.6 мм, гнездо Ø6.8 × 5 мм; масса
   ≈ 0.63 г.

Обе детали watertight, входят в габарит ≤220×220×200, крепятся без винтов
(зажим на кромку). В сборе B-light — отдельные принадлежности (в 3D-превью
рядом с корпусом). Гусиная шея 3.5 мм вставляется в гнездо Ø3.6 (зазор 0.1 мм),
кабель — в mic-jack на задней панели CORE-2.

**Вес/время с микрофоном:** B-light — 230 г / 11.1 ч → **≈231.4 г / 11.2 ч**;
B + mic — **≈278 г / 18.4 ч**; C + mic — **≈316 г / 20.9 ч** (+1.4 г: звуковод
0.1, клипса 0.65, держатель 0.63 г). Fitcheck: B-light 41/0, B-mic 44/0, C-mic 49/0.

**Что проверить на макете/печати:** сетка/поролон в цековке не выступает над
панелью; MEMS не касается панели (зазор 0.5 мм до звуковода); LED виден при
взгляде сверху; клипса держится на кромке без люфта и не мешает панели;
гусиная шея не вырывает гнездо при изгибе.

## 3. Прошивка

| Блок | Что |
|---|---|
| Capture | I2S1 RX, ring buffer 2×N, VAD (порог/AGC), 24/48 |
| Record | запись в PSRAM → сэмпл → пэд/SD (как REC, docs/63), авто-обрезка тишины |
| Beatbox | onset detection (энергия+производная), классификация v1: low/mid/high → kick/snare/hat; velocity → акцент; заполнение шагов с квантизацией |
| Vocoder (v1.1) | 8–16 полос (biquad/FFT), огибающие голоса → усиление полос несущей; formant/vocoder presets |
| UI | страница **MIC**: SOURCE (LINE/MIC), GAIN, THRESH, MONITOR, BEATBOX (on/off + чувствительность), REC → PAD |
| Приватность | MUTE switch → LED; индикатор в контекст-строке; запрет записи при mute |
| Сохранение | mic-настройки в проекте/пресете; сэмплы — как обычные |

## 4. UX (в духе docs/68)

- **L1**: кнопка REC + источник; уровни/индикатор всегда в статусе (маленький).
- **L2**: страница MIC (source/gain/thresh/beatbox/monitor) — один жест.
- **Быстрый сценарий «идея за 10 секунд»**: включил → MIC → REC → спел/настучал → PAD/шаги →
  играешь. Никаких меню.
- **Битбокс**: включил BEATBOX, выбрал партию, настучал — шаги заполнились; UNDO откатывает.
- **Вокодер** (v1.1): GEN/страница VOCODER: несущая (партия), полосы, formant, mix; голос
  управляет фильтрами в реальном времени.

## 5. Требования и критерии приёмки

| # | Требование | Критерий |
|---|---|---|
| 1 | Запись голоса в любой момент | 0 xruns, ≤30 с, сэмпл на пэде |
| 2 | Mute + LED | запись невозможна при mute; LED горит только при включении |
| 3 | Битбокс | ≥80 % попаданий в шаги на 4/4 при 90–140 BPM, классы kick/snare/hat |
| 4 | Задержка mic→P4 | ≤5 мс |
| 5 | Уровень/AGC | нет клиппинга при крике, слышно шёпот (AGC 40 дБ) |
| 6 | Приватность | нет передачи без действия; mute разрывает питание |
| 7 | Вокодер (v1.1) | разборчивость ≥80 % слов по тесту, 8 полос |

## 6. Влияние на ревизии (до заказа PCB!)

- **PANEL-2 rev.3**: MEMS I2S (ICS-43434) + акустический порт + линии I2S1/3V3/GND в J13/J14
  + опционально 3.5 мм mic jack (если на панели) — либо jack на CORE-2.
- **CORE-2 rev.3**: I2S1 RX (2 линии), 3.3 В mic power, MAX9814 + аналоговый коммутатор
  (line/mic), ESD; DFM: TP на MIC_DATA/BCK, экранирование от BL/WS2812.
- **Механика**: отверстие/сетка, клипса гусиной шеи, fitcheck + акустический тест.
- **BOM**: MEMS ~$1–2, MAX9814 ~$1, jack ~$1, сетка/поролон.

## 7. Что нельзя делать

- Не делать «always-on mic» без аппаратного mute и LED.
- Не отправлять звук по Wi-Fi/BT без явного действия пользователя.
- Не добавлять микрофон «после PCB» — это ревизия PANEL-2/CORE-2, делаем до заказа плат.
- Не обещать студийное качество: MEMS + AGC — для идей/битбокса/вокодера, не для вокала.

---

## 8. Реализация PANEL-2 rev.3 (electrical, PRE-FREEZE)

Схема: [`hardware/panel2/PANEL-2.kicad_sch`](../hardware/panel2/PANEL-2.kicad_sch) ·
ERC 0 errors / 6 warnings (прежние `isolated_pin_label` на `SPI2_*` DNP-разъёма J15) ·
[`interfaces.md` §8](../hardware/panel2/interfaces.md) · [`pinmap.md`](../hardware/panel2/pinmap.md) ·
[`matrix.md` §5](../hardware/panel2/matrix.md).

### 8.1 Компоненты и цепь

| Позиция | MPN / номинал | Назначение |
|---|---|---|
| `U8` | **ICS-43434** (TDK InvenSense, LGA-6 3.5×2.65) | I2S MEMS, 24 бит/48 кГц, −26 дБFS, 3.3 В |
| резерв | `SPH0645LM4H` (Knowles) | pin-функции совпадают, **пады другого размера** — замена = новый footprint |
| `SW1` | SS-12D00 (SPST слайд) | **аппаратный мьют**: разрывает +3V3 микрофона (R-37) |
| `R120` | 100 кОм | разряд MIC_VDD при мьюте |
| `FB1` | 600 Ом @100 МГц 0603 | развязка MIC от WS2812/подсветки |
| `C81/C82` | 10 мкФ + 100 нФ | MIC_VDD; `C80` 100 нФ на MIC_VDD_SW |
| `R122…R124` | 33 Ом | серия BCK/WS/DATA перед выводами MEMS |
| `U9` | SRV05-4 | ESD-матрица BCK/WS/DATA (VP=+3V3, VN=GND) |
| `R121` + `LED_MICON` | 1 кОм + LED 0603 | индикатор «MIC ON» (питание включено) |
| `J16` | IDC-6 2×3 (Hirose/аналог) | шлейф I2S1 к CORE-2 |
| `TP36…TP39` | тестпоинты | MIC_BCK / MIC_WS / MIC_DATA / MIC_VDD |

Схема: `3V3 → SW1 (мьют) → MIC_VDD_SW → FB1 → MIC_VDD → U8.VDD`; `U8.LR = GND` (моно/левый);
`U8.SCK/WS/SD → 33R → MIC_BCK/WS/DATA → J16` (ESD на стороне шлейфа).

### 8.2 Пины и линии (PANEL-2 → CORE-2)

| J16 pin | Сигнал | Направление | CORE-2 rev.3 |
|---:|---|---|---|
| 1 | `MIC_BCK` | CORE-2 → PANEL-2 | I2S1 SCK (1.4…3.1 МГц) |
| 2 | `GND` | — | GND (рядом с BCK) |
| 3 | `MIC_WS` | CORE-2 → PANEL-2 | I2S1 WS/LRCLK (48 кГц) |
| 4 | `GND` | — | GND (рядом с DATA) |
| 5 | `MIC_DATA` | PANEL-2 → CORE-2 | I2S1 RX (SD, 24 бит) |
| 6 | `+3V3` | CORE-2 → PANEL-2 | 3.3 В, ≤5 мА (после мьюта) |

На PANEL-2: `MIC_BCK/WS/DATA` также на TP36/TP37/TP38, `MIC_VDD` — TP39.
**J16 (PANEL-2) ↔ J19 (CORE-2) — pinout 1:1**: 1 BCK, 2 GND, 3 WS, 4 GND, 5 DATA, 6 3V3
(зафиксировано; на стороне CORE-2 rev.3 остаётся разводка I2S1 RX).

### 8.3 Акустический порт и механика (согласовано с mechanical)

> Координаты и размеры — **из fitcheck mechanical** (v0.4), `spec/panel-spec-v0.4.json`
> **не менялся**: 85 сквозных отверстий = 83 из JSON + порт + LED; B-light ≈231.4 г / 11.2 ч.

* **Акустический порт Ø1.8 мм**, центр **(X 122.0, Y 5.5)** панели (верхняя кромка, левее
  джек-поля: первый джек J01 — X 129.9). **Цековка Ø3.4 × 0.7 мм** под сетку;
  **углубление под MEMS Ø5 × 1.2 мм снизу** (посадочное место модуля LGA-6 3.5×2.65).
* **LED MIC ON Ø1.6 мм**, центр **(X 116.0, Y 10.5)** — световод/утопление в шелле,
  рядом с портом.
* **Звуковод ≤3 мм** — канал от цековки порта до входного отверстия MEMS на PCB; MEMS
  ставится **под звуковод (X≈122)**. Допустим силиконовый/печатный сапожок-прокладка
  (gasket) между PCB и шеллом; зазор до ближайшего WS2812 и разъёма подсветки ≥10 мм.
* **Сетка** (тканевая/акустическая, 0.2–0.5 мм ячейка) + **поролон 1–2 мм** под ней —
  защита от пыли/влаги; клей/двусторонний скотч по периметру цековки.
* Земля MIC — отдельная звезда к GND у J16 (не через полигон WS2812/подсветки).
* **Опция (D-94)**: клипса/держатель 3.5 мм гусиной шеи — печатная деталь у верхней кромки;
  сама шея вставляется в mic-jack на задней панели CORE-2 (MAX9814), PANEL-2 её не касается.
* Если PANEL-2 смонтирована на стенде без корпуса, порт можно проверить «на весу»:
  микрофон слышит через торец PCB, чувствительность ниже на ~6–10 дБ — для проверки годится.

### 8.4 Тест акустики (после сборки PANEL-2 rev.3 + CORE-2 rev.3)

| # | Тест | Как | Критерий |
|---:|---|---|---|
| 1 | **Питание/мьют** | TP39 при SW1 ON/OFF | 3.3 В / 0 В; LED гаснет |
| 2 | **I2S-данные** | осциллограф/логический анализатор на TP36…TP38 | BCK 1.4…3.1 МГц, WS 48 кГц, данные меняются от звука |
| 3 | **Цифровой ноль** | тишина в комнате, запись 5 с | SNR ≥ 60 дБ (dBA, взвешенный), шум ≤ −60 дБFS |
| 4 | **Речь на 30 см** | обычная громкость, запись 5 с | разборчиво, уровень −18…−6 дБFS, без клиппинга |
| 5 | **Свист на 30 см** | свист/тон 1 кГц (или генератор) на 30 см | уверенная детекция, нет «залипания» VAD |
| 6 | **Крик** | 20 см, максимальная громкость | **нет клиппинга на аналоге** (цифровой — по уровню), AGC в прошивке |
| 7 | **Латентность** | импульс/хлопок + осциллограф | mic→I2S ≤ 5 мс (docs/71 §5 п.4) |
| 8 | **Изоляция от WS2812/BL** | LED на 100 % яркости + BL 100 %, запись 5 с | прирост шума ≤ 3 дБ (ferrite/FB1 работает) |
| 9 | **Мьют-приватность** | SW1 OFF, попытка записи | запись блокируется в прошивке, LED не горит, пиков нет |

> **Без образца PANEL-2 нельзя проверить:** акустику порта (SNR/АЧХ), реальную чувствительность
> (−26 дБFS ±3 дБ), влияние корпуса/поролона, латентность тракта P4 I2S1 — только после сборки
> стенда PANEL-2 + CORE-2 rev.3.

### 8.5 Заказать для прототипа

| Позиция | Кол-во | Примечание |
|---|---:|---|
| ICS-43434 | 2 | + резерв SPH0645LM4H (Knowles) — 1 шт, **другой footprint** |
| Акустическая сетка Ø3.4 мм (под цековку Ø3.4×0.7; ткань/металл, ячейка 0.2–0.5 мм) | 5 | вырезать по месту |
| Поролон 1–2 мм (акустический, закрытоячеистый) | лист | прокладка под сетку |
| J16 IDC-6 + шлейф 6×2.54 100 мм | 2 + 2 | или 1×6 pin header на стенде |
| Слайд-переключатель SS-12D00 | 2 | мьют |
| SRV05-4, FB 600 Ом 0603, 33R/1k/100k, 10u/100n, LED 0603 | по BOM | [`BOM-panel2.csv`](../hardware/panel2/BOM-panel2.csv) |

---

## 5. Реализация CORE-2 rev.3 (D-91) — сделано в схеме

Схема `hardware/core2/CORE-2.kicad_sch` обновлена (rev.3-итерация): ERC **0 errors / 0 warnings**,
`check_pinmap`/`check_schematic` PASS, BOM 265 строк. PII-чисто.

| Узел | Компоненты/цепи | Пины (P4) |
|---|---|---|
| MEMS I2S1 RX с PANEL-2 | J19 IDC-6 canon: **1 `MIC_BCK`, 2 DGND, 3 `MIC_WS`, 4 DGND, 5 `MIC_DATA`, 6 `3V3_MIC`** (PANEL-2 J16 1:1); FB8 + C128 10 мкФ + C129 100 нФ; ESD U48/U49 (USBLC6) | GPIO40 `MIC_BCK`, GPIO41 `MIC_WS`, GPIO42 `MIC_DATA` |
| 3.5 мм mic jack | J20 TRS (tip=`MIC_IN`, ring=`MIC_BIAS`, sleeve=AGND); D30 SMAJ5.0A; C127 100 нФ; R106 2.2 к bias | — |
| MAX9814 AGC | U46 (TDFN-14): CT/CG/BIAS-конденсаторы C125/C124/C123, MICBIAS C122, выход `MIC_AGC` → C126 1 мкФ | — |
| Line/mic switch | U47 TS5A23157: COM1/COM2 → C78/C80 → PCM1808 VINL/VINR; NO=LINE (`AUDIN_L_F/R_F`), NC=MIC (`SW_MIC`); R110 100k PD | GPIO54 `MIC_SEL` (0=LINE, 1=MIC) |
| Приватность (D-92) | SW3 MIC MUTE → SHDN=GND; R113 pull-up; Q5+D31+R114 LED «MIC ON»; прошивка запрещает запись при mute | — |
| TP | TP31 `MIC_DATA`, TP32 `MIC_BCK` (всего TP1–TP32) | — |

**Изменения относительно rev.2:** SDIO **4-bit → 1-bit** (J5 DAT1/2/3 = NC, R32–R34 удалены;
GPIO40/41/42 отданы I2S1; ~6 МБ/с достаточно для 8-дорожечного стриминга); `VBUS_DET` (GPIO54)
заменён на `MIC_SEL` (USB-режим определяется через BQ24074/перечисление); добавлены J19/J20, U46–U49,
Q5, SW3, D30/D31, FB8, C122–C129, R106/R110/R113/R114; TP31/32.
**DFM:** `hardware/core2/dfm.md` — TP, self-test №21 (mic loopback), экранирование J19/аналоговый
keepout, SW3 снаружи, loopback mic→PCM1808→DAC. **План:** `hardware/core2/rev3-plan.md` §4a.

**Что осталось:** PANEL-2 rev.3 — MEMS (ICS-43434/SPH0645) + ответный J19, акустический порт/сетка,
mute MEMS; прошивка I2S1 DMA/VAD/запись (docs/71 §3); сверить pinout MAX9814/TDFN-14 и
TS5A23157/DGS по datasheet до PCB; при необходимости 4-bit SDIO — освободить GATE2/SD_CD/LED.

---

## 8. Реализация в прошивке (v1.0-rc, раунд 15)

**Готово (host-модель, тесты):**

| Блок | Реализация | Тесты |
|---|---|---|
| Capture | `MicCapture` (`src/io/mic.*`): push-модель I2S1, source LINE/MIC, gain dB, RMS level/peak, VAD по порогу | `MicCaptureLevelAndPeak`, `MicGainAffectsLevel`, `MicVadThreshold`, `MicSourceSelection` |
| Record | `beginRecording/endRecording`: буфер **≤30 с** (`kMicMaxSeconds`), авто-обрезка тишины по порогу, имя, PAD, PSRAM/SD, пик | `MicRecordingBasicTake`, `MicRecordingTrimSilence` |
| Приватность | `MicPrivacy`: mute switch + LED, запись запрещена при mute; `micNetworkTransmissionAllowed(false)` — нет неявной передачи BLE/Wi-Fi; MIC в контекст-строке | `MicPrivacyBlocksRecording`, `MicPrivacyLedAndNoNetwork`, `UiMicPrivacyBannerAndContext` |
| Beatbox | `BeatboxDetector`: onset по энергии+производной в 16 окнах (шаг/1/16), классы kick/snare/hat по low/high/ZCR, velocity/акцент; `applyToSteps` пишет ноты 36/38/42 с квантизацией; `BeatboxPattern` — UNDO | `MicBeatboxOnsetDetection`, `MicBeatboxClassRules`, `MicBeatboxAccuracy90/110/140` (≥80 %), `MicBeatboxApplyStepsAndUndo`, `MicBeatboxVelocityAccent`, `MicBeatboxEmptyBar`, `MicBeatboxClassNamesAndNotes` |
| UI | 7-я вкладка **MIC** (MAIN/SEQ/MIX/MOD/GEN/EXT/MIC): MIC ON/MUTED, SOURCE, LEVEL-метр, BEATBOX ON/OFF, REC PAD + имя тейка, поля SRC/GAIN/THR/MON/BEAT/SENS/PAD/LVL + макросы (16-ячеечная зеркальная карта docs/68/69) | `UiMicSnapshotFields`, `UiMicRendersAllThemes`, `UiMicBeatboxAndMeterVisuals`, `UiMicMirrorFields` |

**Скриншот:** [`firmware/artifacts/ui/mic.png`](../firmware/artifacts/ui/mic.png)
(MIC ON, SOURCE MIC, BEATBOX ON, level/peak, REC PAD TAKE 1, поля и макросы).

**Тесты:** 311/311 host (23 новых в раунде 15).

## 8.6 Приёмочный чек-лист шлейфа PANEL-2 ↔ CORE-2

- [ ] J16 (PANEL-2) ↔ J19 (CORE-2) **1:1**: 1 BCK, 2 GND, 3 WS, 4 GND, 5 DATA, 6 +3V3;
- [ ] прозвонить: 3V3 на пине 6, а не на BCK; TP36/TP39 (панель), TP31/TP32 (ядро);
- [ ] шлейф ≤150 мм, экранированный; DATA+GND витой парой;
- [ ] SW1 (панель) и SW3 (ядро) разрывают/глушат микрофон; LED гаснет;
- [ ] запись при mute невозможна (прошивка), индикатор MIC в контекст-строке.

## 8.7 Сверка с datasheet (ЗАКРЫТО 06.11.2025)

MAX9814 (ADI, TDFN-14): pin14=TH (делитель R107 150k/R108 100k от MICBIAS, V_TH≈0.4·MICBIAS),
EP=pin15→AGND, CT=470 нФ; SHDN active-low (SW3 замкнут = mute); GAIN=GND (50 дБ), A/R=GND.
TS5A23157 (TI, DGS-10): исправлены пины 5/6/7 (IN2/COM2/NC2), truth table IN=L→NC–COM (LINE),
IN=H→NO–COM (MIC); MIC_SEL=0 → LINE (PD 100k), 1 → MIC. Netlist/ERC 0/0, check_pinmap/
check_schematic PASS; подробные таблицы — `hardware/core2/dfm.md` §5a, docs/71 §6.
Осталось только сверить footprints TDFN-14-1EP и VSSOP-10 при разводке PCB.

## 9. TODO(hw)

1. **I2S1 RX DMA** (MEMS ICS-43434/SPH0645LM4H), реальный ring buffer, 24 бит/48 кГц,
   `mic→P4 ≤5 мс` замерить; сейчас `MicCapture` — host-модель без I2S.
2. **Line/mic mux** MAX9814 AGC + PCM1808 (CORE-2), bias 2.2 кОм, ESD; выбор LINE/MIC GPIO.
3. **PSRAM/SD запись** сэмпла (сейчас `VoiceTake` в heap host-модели) и воспроизведение на пэд;
   авто-обрезка/loop — как у сэмплов docs/63.
4. **HARDWARE mic mute switch + LED** (GPIO): прошивка проверяет switch до REC и управляет LED;
   в host-модели это `MicPrivacy`.
5. **Beatbox v1.1**: устойчивость к шуму/речи, больше классов/акцентов, CC learn; вокодер
   (v1.1, backlog R-39).
6. **Приватность-аудит**: подтвердить, что Wi-Fi/BT стек не получает mic-буфер; оставить
   только явную пользовательскую передачу.

---

## 6. Сверка с datasheet (MAX9814 / TS5A23157, 2026-11-06)

Официальные datasheet: [MAX9814 (ADI)](https://www.analog.com/media/en/technical-documentation/data-sheets/MAX9814.pdf),
[TS5A23157 (TI)](https://www.ti.com/lit/ds/symlink/ts5a23157.pdf). Сверены все пины U46/U47;
**найдено 4 расхождения, исправлены в схеме** (ERC 0/0).

### MAX9814 (TDFN-14, U46)

| Пин | Datasheet | У нас | Статус |
|---:|---|---|---|
| 1 | CT | C125 **470 нФ** → AGND | ✔ (номинал приведён к datasheet) |
| 2 | SHDN active-low | R113 100k↑, SW3→GND (mute) | ✔ SW3 замкнут = shutdown; разомкнут = mic on |
| 3 | CG | C124 2.2 мкФ → AGND | ✔ |
| 4, 11 | N.C. → GND | AGND | ✔ |
| 5 | VDD (1 мкФ) | 3V3_MIC, C128 10 мкФ + C129 100 нФ | ✔ |
| 6 | MICOUT | MIC_AGC → C126 1 мкФ | ✔ |
| 7 | GND | AGND | ✔ |
| 8 | MICIN | C127 100 нФ ← MIC_IN | ✔ |
| 9 | A/R | AGND (1:500) | ✔ |
| 10 | GAIN | AGND (50 дБ) | ✔ |
| 12 | BIAS (0.47 мкФ) | C123 470 нФ | ✔ |
| 13 | MICBIAS | C122 1 мкФ; R106 2.2 к → bias | ✔ |
| 14 | **TH** | R107 150k / R108 100k (V_TH≈0.4·MICBIAS) | **исправлено** (был EP) |
| EP | пад → GND | pin 15 EP → AGND | **исправлено** (добавлен) |

### TS5A23157 (DGS/VSSOP-10, U47)

| Пин | Datasheet | У нас | Статус |
|---:|---|---|---|
| 1 | IN1 | MIC_SEL | ✔ |
| 2 | NO1 | SW_MIC | **исправлено** (NO=MIC) |
| 3 | GND | AGND | ✔ |
| 4 | NO2 | SW_MIC | **исправлено** |
| 5 | **IN2** | MIC_SEL | **исправлено** (был COM2) |
| 6 | **COM2** | SW_R_COM | **исправлено** (был NC2) |
| 7 | **NC2** | AUDIN_R_F (LINE R) | **исправлено** (был IN2) |
| 8 | V+ | 3V3 | ✔ |
| 9 | NC1 | AUDIN_L_F (LINE L) | ✔ |
| 10 | COM1 | SW_L_COM | ✔ |

**Полярность:** IN=L → NC–COM ON ⇒ `MIC_SEL=0` = LINE (дефолт, R110 PD); IN=H → NO–COM ON ⇒
`MIC_SEL=1` = MIC. COM1/COM2 → C78/C80 → PCM1808 VINL/VINR — подтверждено.
**Вердикт:** пины и полярность соответствуют datasheet; остаётся проверить land pattern
TDFN-14-1EP и MSOP-10 при разводке PCB.
