martiyanov/bukifon/docs/42-dfm-review-gpt.md

# DFM/DFT-ревью (GPT): единый пого-поле, self-test, серийники, recovery

Источник — консультация GPT по производству. Внедряется в `hardware/*/dfm.md`,
`docs/38-dfm-testability.md` и RC DoD (docs/36). Платы пока PRE-FREEZE — это требования
к разводке, а не разрешение заказывать.

## 1. Test points: 30-точечное одностороннее пого-поле

Все точки: круглые пады Ø1.3–1.5 мм, mask opening Ø1.8–2.0 мм, шаг ≥2.54 мм, keepout 1 мм,
одна сторона, не ближе 3 мм к краю и 5 мм к стойкам/высоким деталям.

| Плата | Точек | Обязательные |
|---|---:|---|
| **CORE** | 14 | PGND/DGND/AGND, VBUS_CHG, VSYS, +3V3, USB D+/D−, CHIP_PU/RESET, BOOT/GPIO0, I2S_MCLK, I2S_ADC_DOUT, SD_CLK, SPI3_SCK |
| **PANEL-2** | 7 | GNDA/GND, +3V3_PANEL, +5V_LED, SDA, SCL, PANEL_IRQ, LED_DATA после shifter |
| **PWR-2** | 9 | BATT_CELL_P (Kelvin), VBAT после BMS, VSYS_SW, +12V, −12V, +5V, LED_RET, PWR_GOOD, PGND |
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
