martiyanov/bukifon/docs/assets/case-iso.jpg

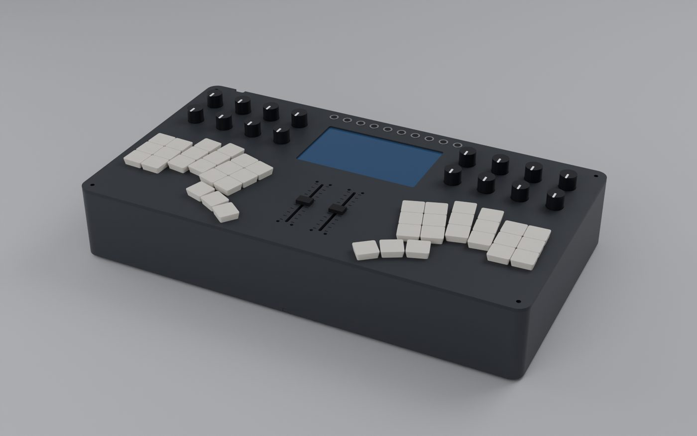
docs/assets/case-iso.jpg
