martiyanov/bukifon/docs/assets/case-profiles.jpg

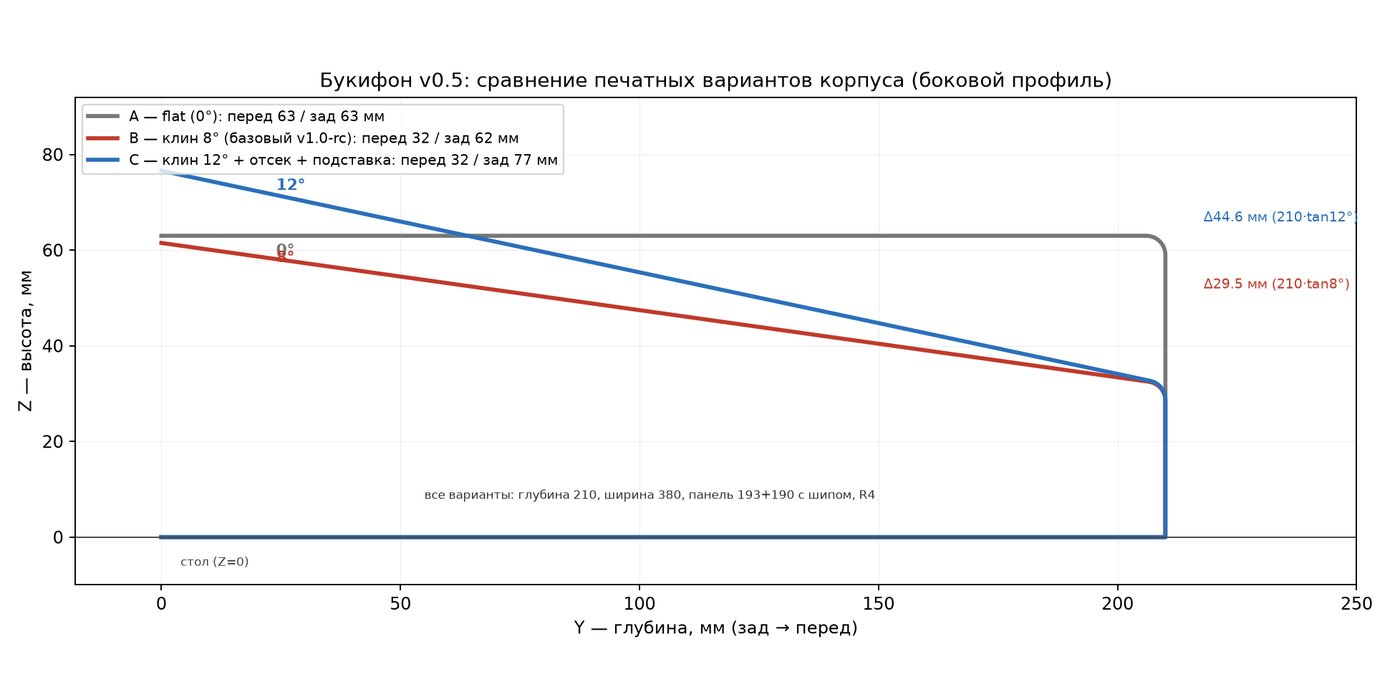
docs/assets/case-profiles.jpg
