martiyanov/bukifon/docs/assets/case-wedge8.jpg

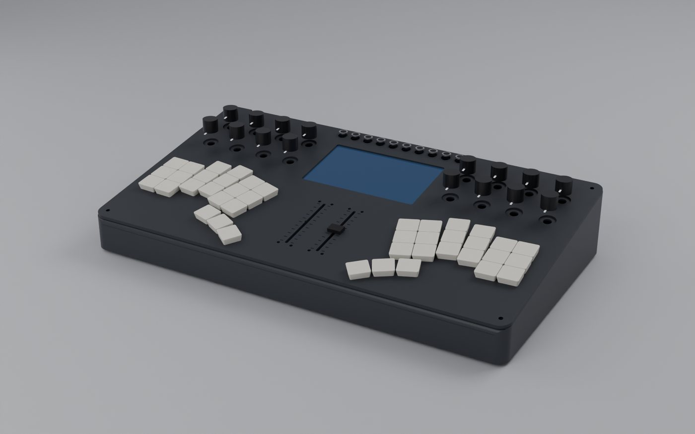
docs/assets/case-wedge8.jpg
