martiyanov/bukifon/docs/assets/closeup.jpg

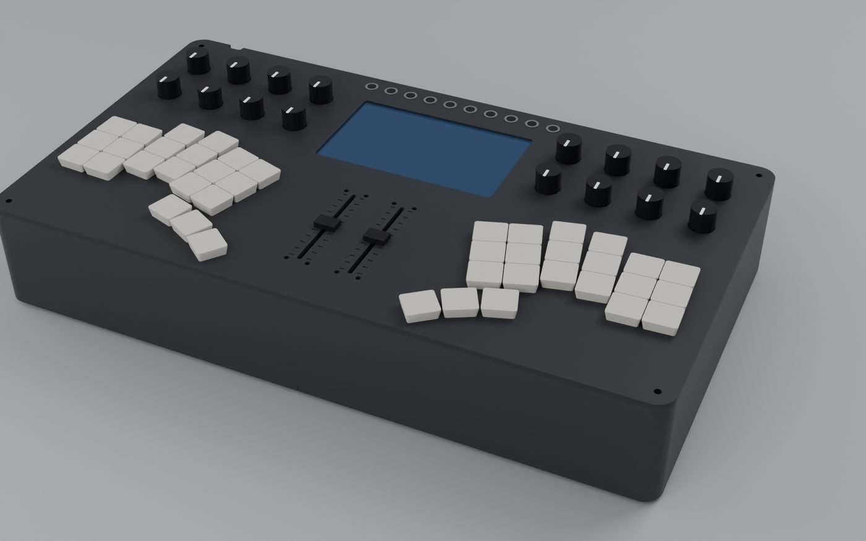
docs/assets/closeup.jpg
