martiyanov/bukifon/docs/assets/compare.jpg

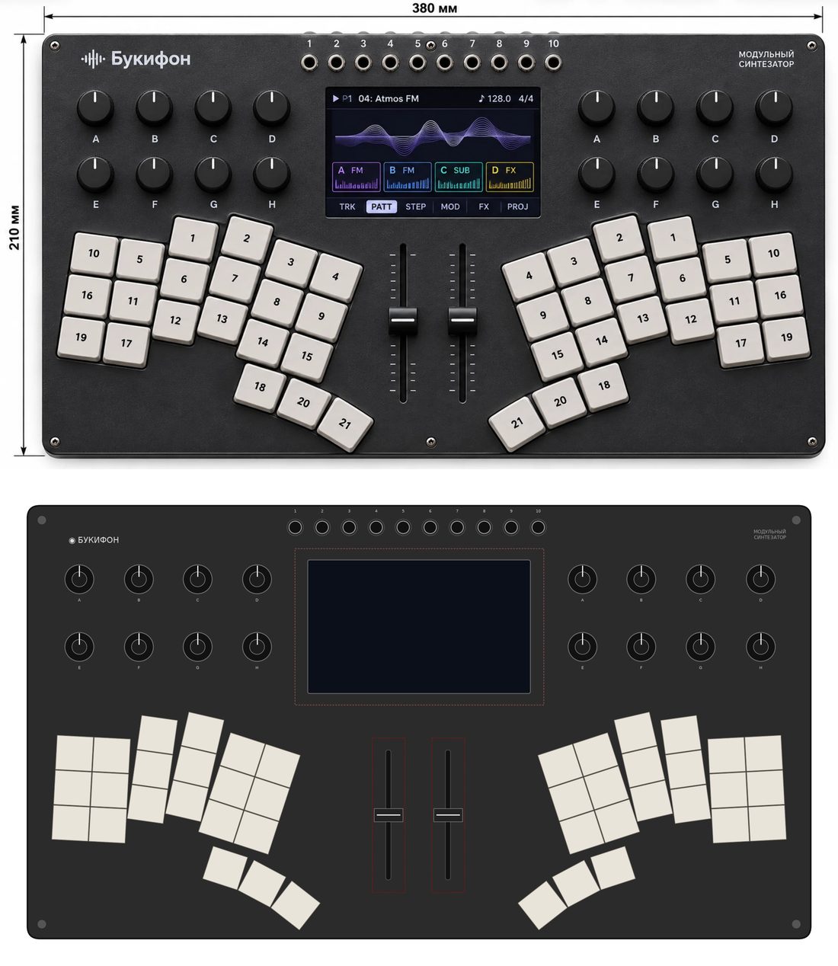
docs/assets/compare.jpg
