martiyanov/bukifon/docs/assets/design-panel-2.jpg

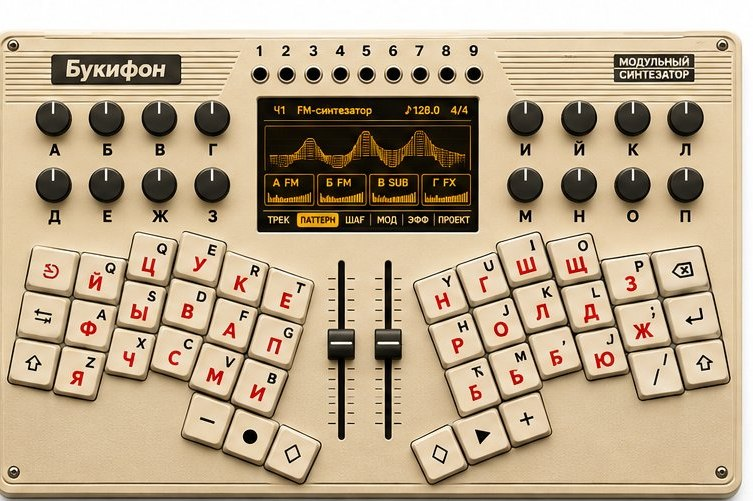
docs/assets/design-panel-2.jpg
