martiyanov/bukifon/docs/assets/panel-lapka-left.png

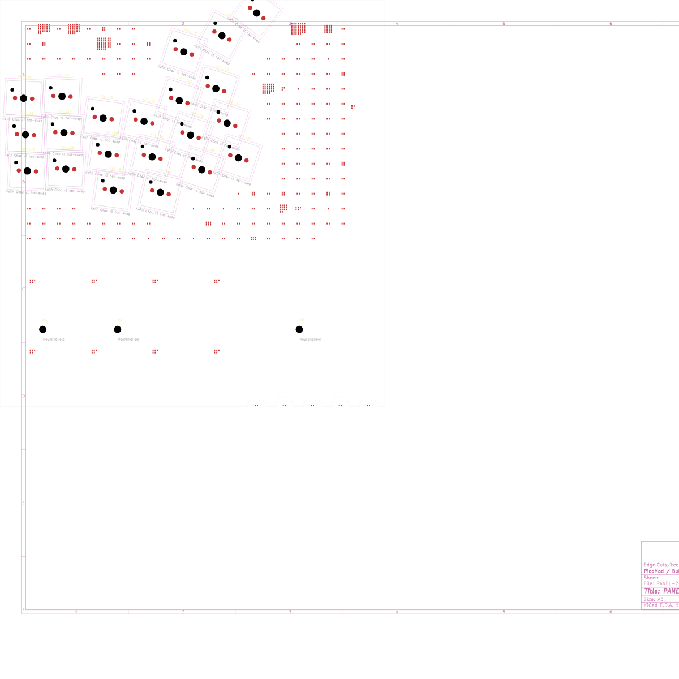
docs/assets/panel-lapka-left.png
