martiyanov/bukifon/docs/assets/panel-lapka-right.png

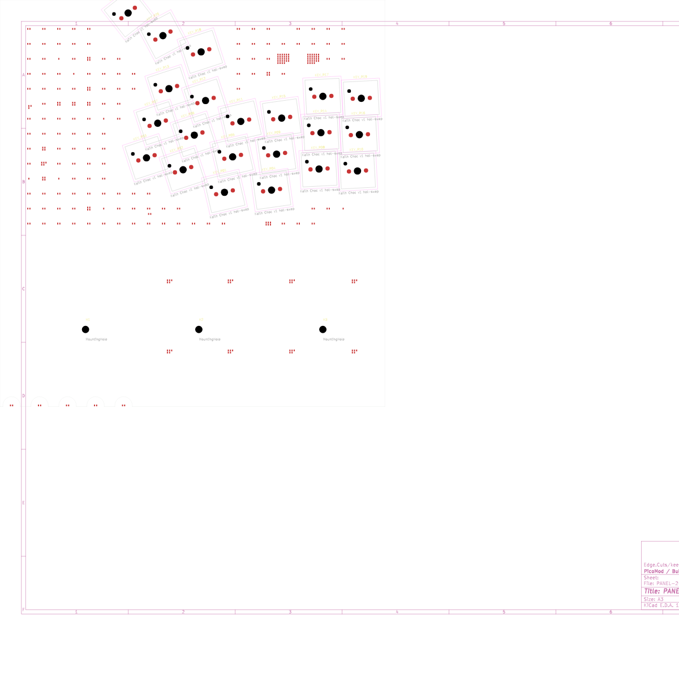
docs/assets/panel-lapka-right.png
