martiyanov/bukifon/docs/assets/panel-ru.jpg

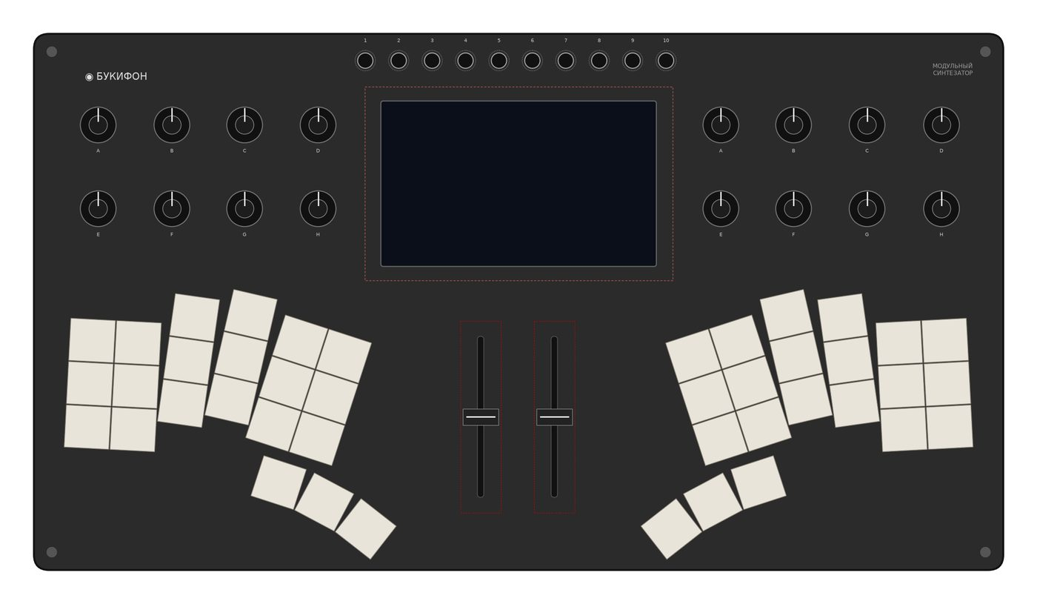
docs/assets/panel-ru.jpg
