martiyanov/bukifon/docs/assets/profile8.jpg

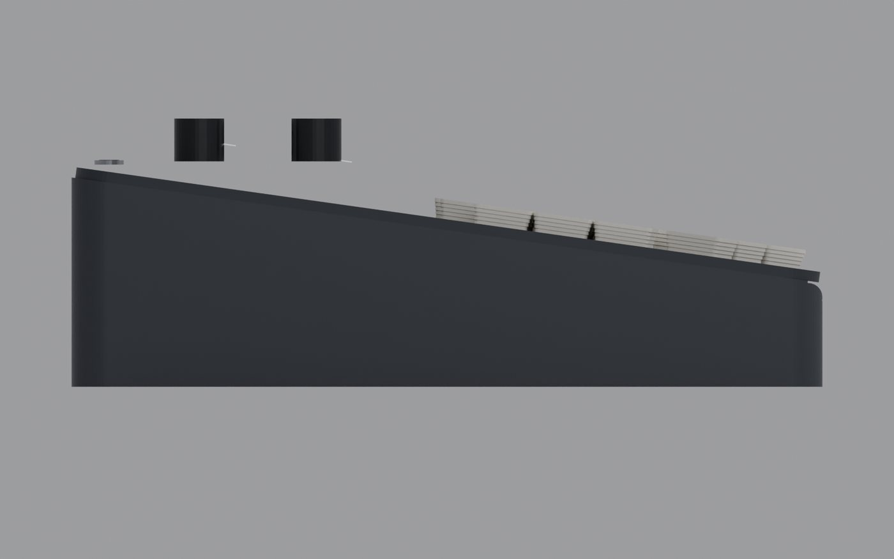
docs/assets/profile8.jpg
