martiyanov/bukifon/docs/assets/ui-daw.jpg

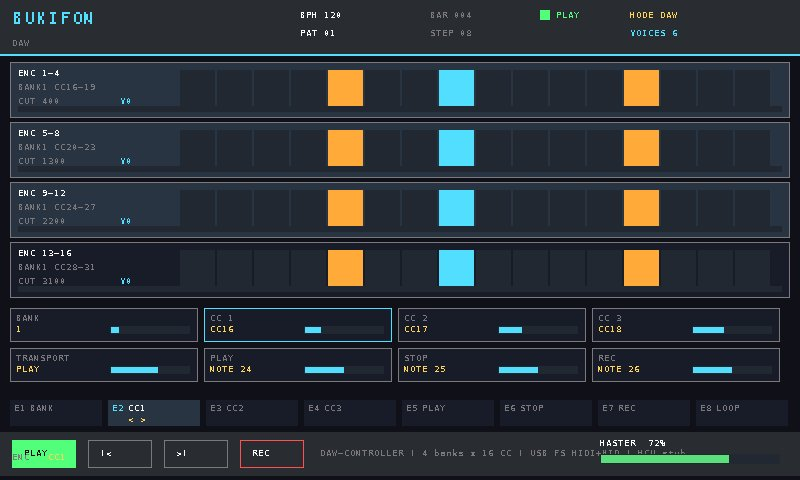
docs/assets/ui-daw.jpg
