martiyanov/bukifon/docs/assets/ui-sampler.jpg

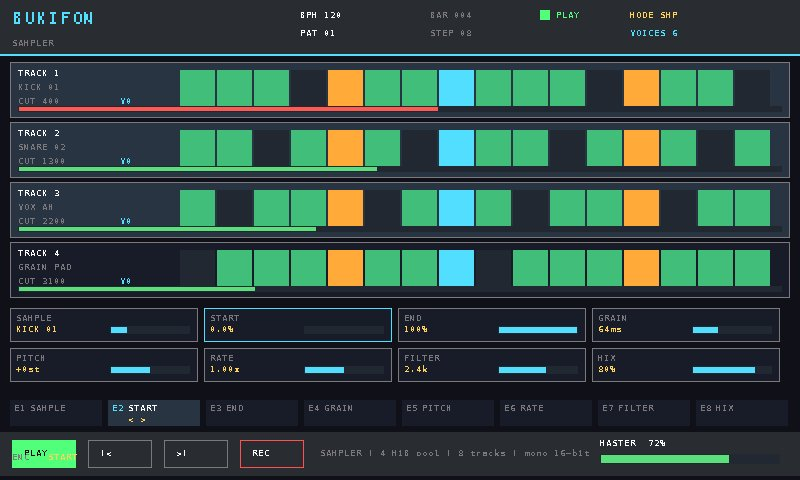
docs/assets/ui-sampler.jpg
