martiyanov/bukifon/docs/assets/ui-synth.jpg

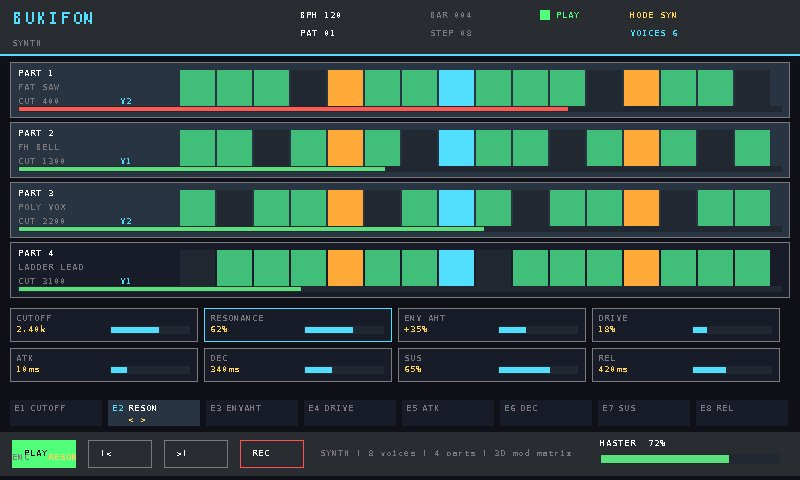
docs/assets/ui-synth.jpg
