martiyanov/bukifon/docs/assets/ui-theme-amber.jpg

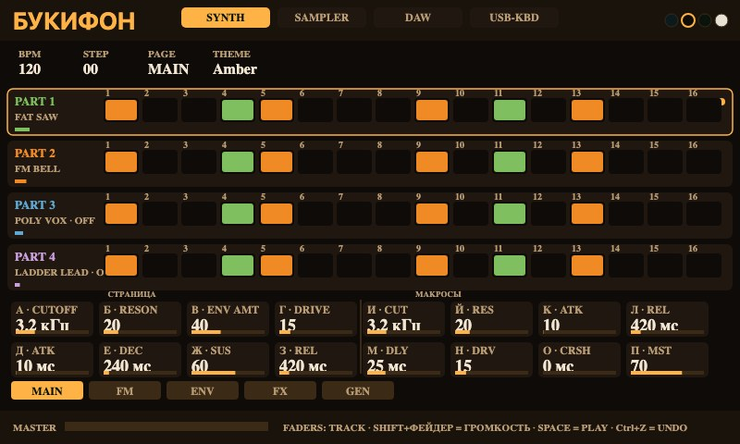
docs/assets/ui-theme-amber.jpg
