martiyanov/bukifon/docs/assets/ui-theme-cream.jpg

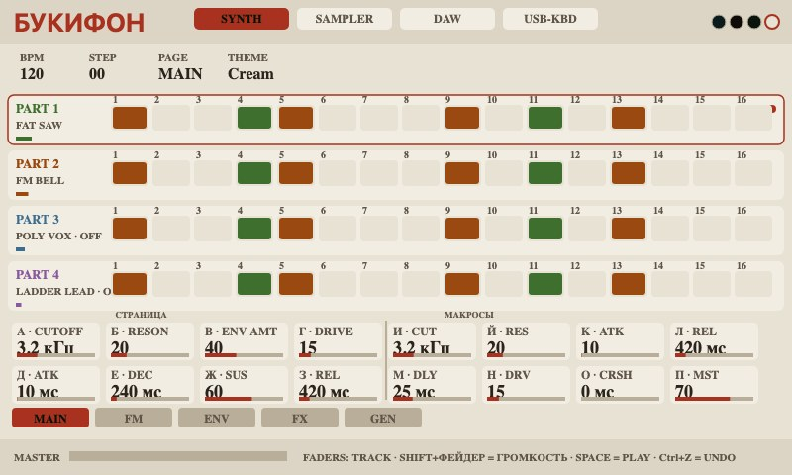
docs/assets/ui-theme-cream.jpg
