martiyanov/bukifon/docs/assets/ui-theme-green.jpg

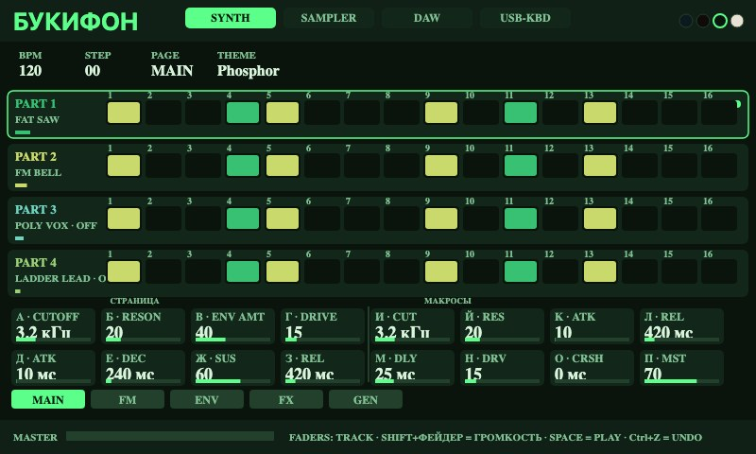
docs/assets/ui-theme-green.jpg
