martiyanov/bukifon/docs/press/screenshot-demo.jpg

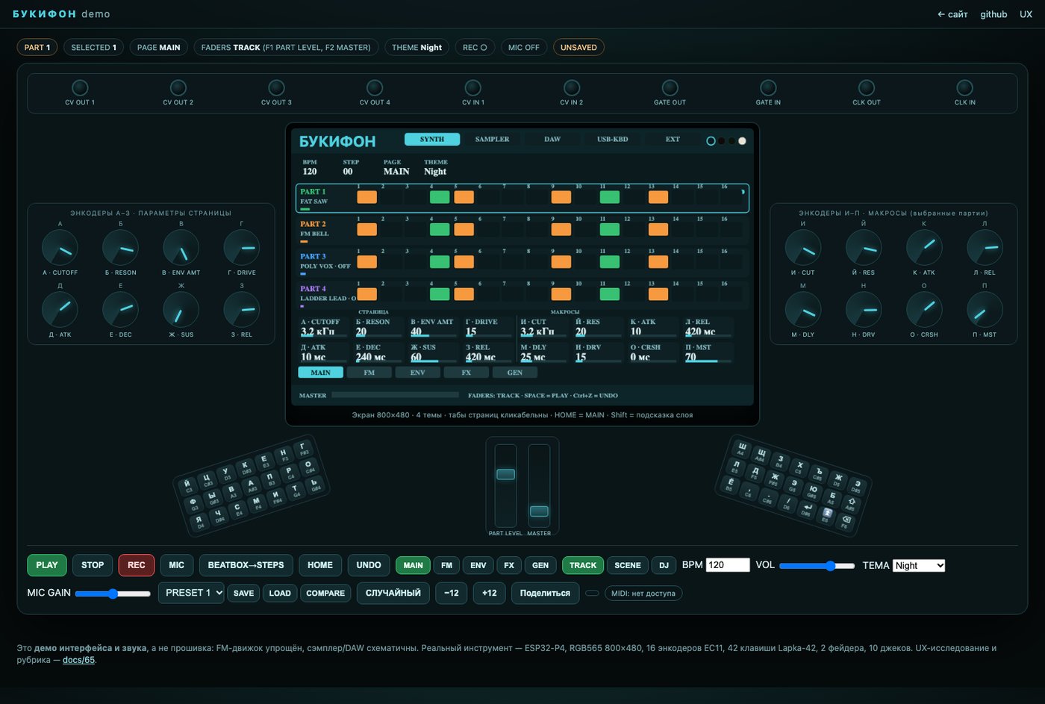
docs/press/screenshot-demo.jpg
