martiyanov/bukifon/docs/press/ui-night.jpg

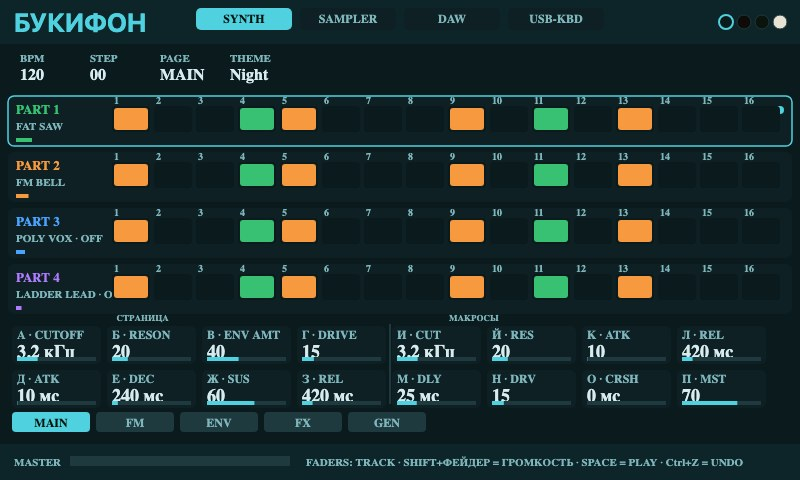
docs/press/ui-night.jpg
