martiyanov/bukifon/hardware/core/CORE-1-blocks.png

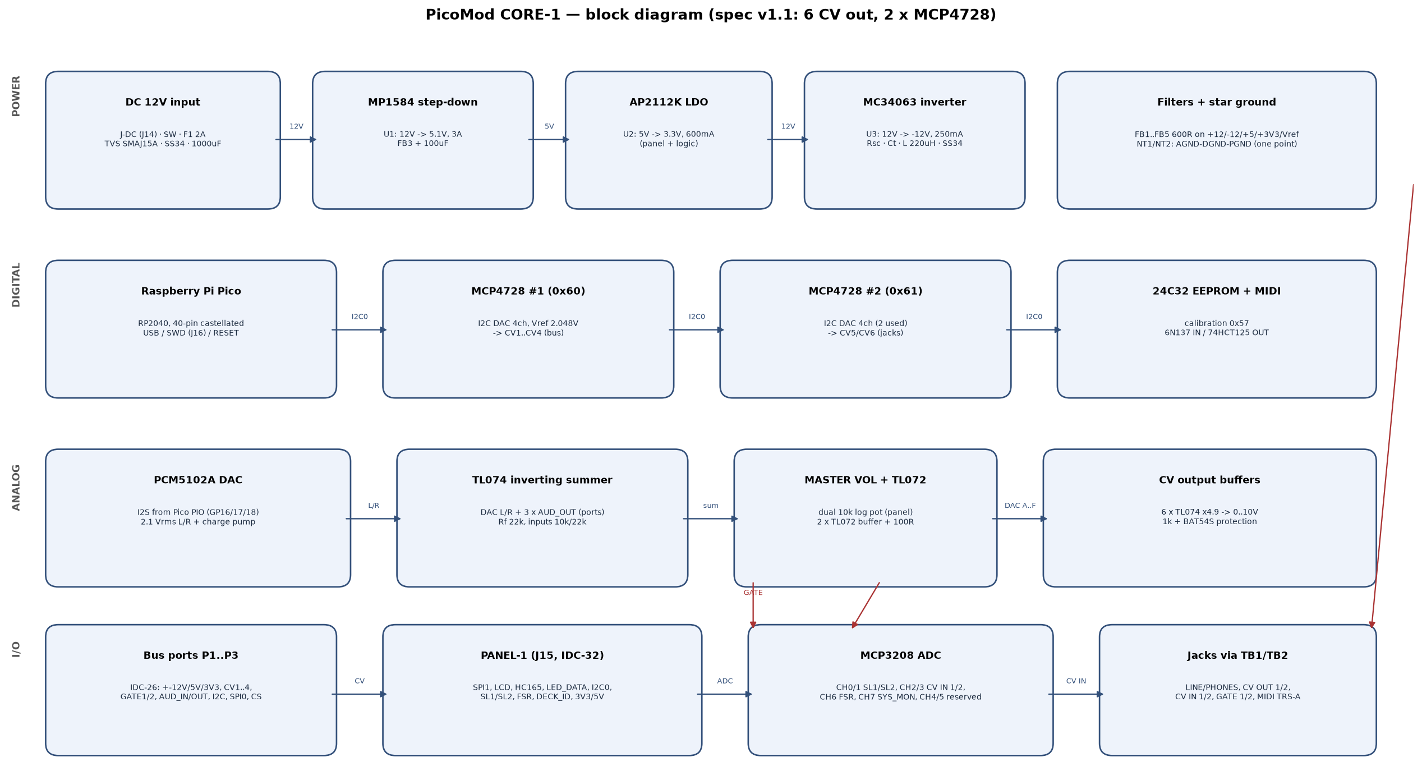
hardware/core/CORE-1-blocks.png
