martiyanov/bukifon/mechanical/board-fit/board-fit-preview.png

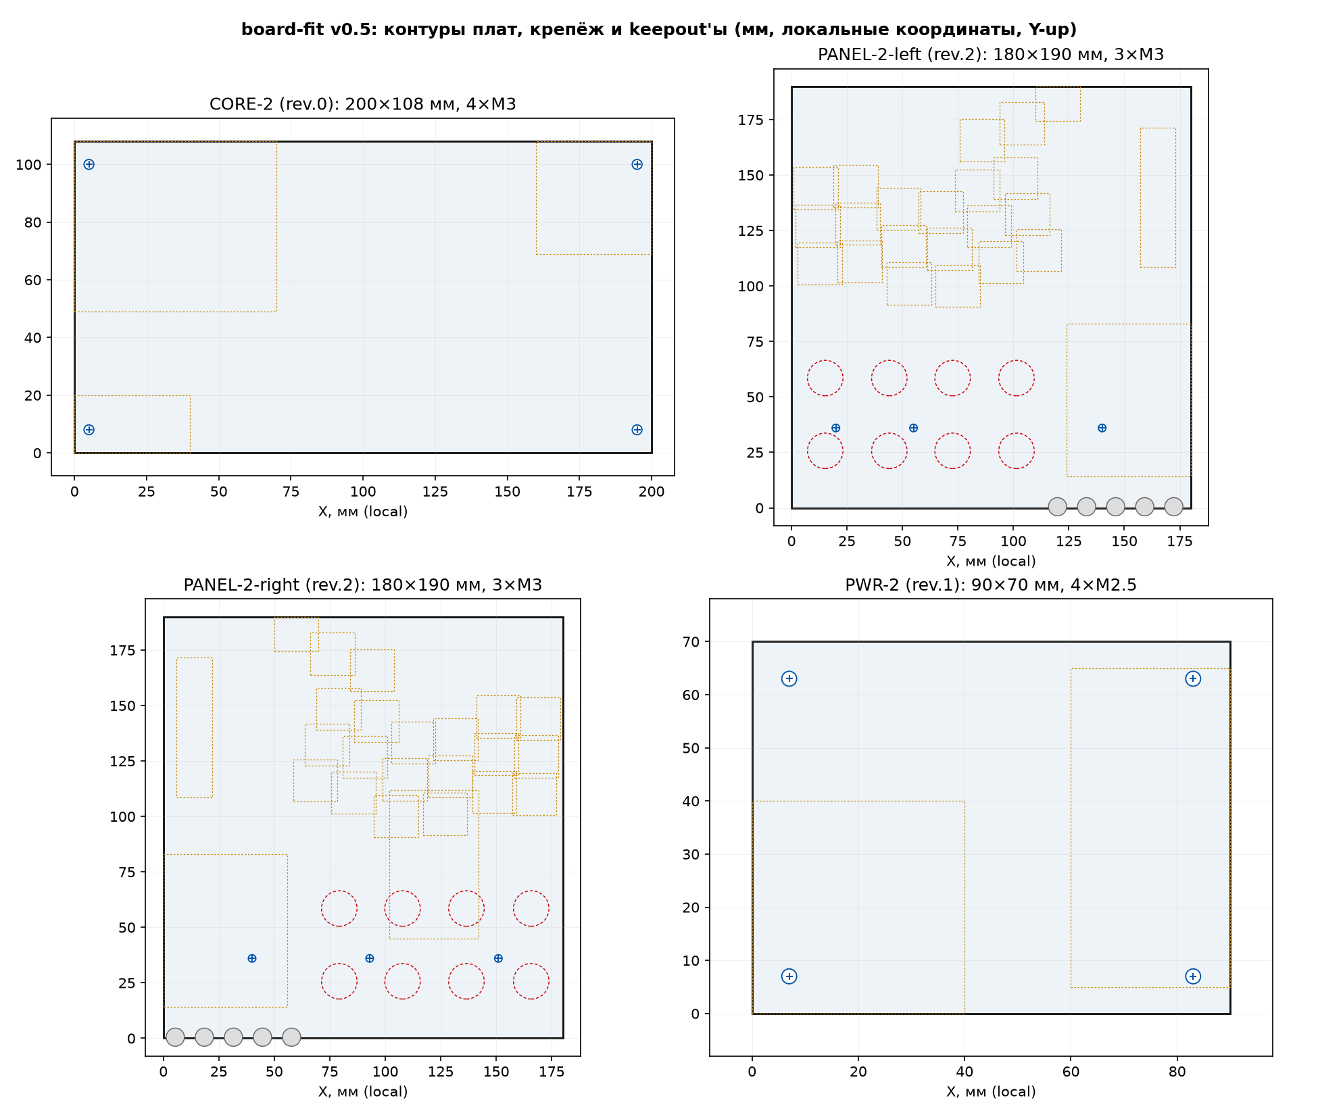
mechanical/board-fit/board-fit-preview.png
