martiyanov/bukifon/mechanical/branding/bukifon_wordmark.png

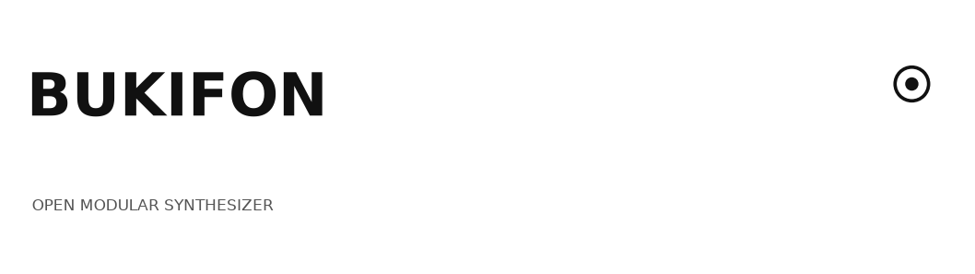
mechanical/branding/bukifon_wordmark.png
