martiyanov/bukifon/mechanical/exploded.png

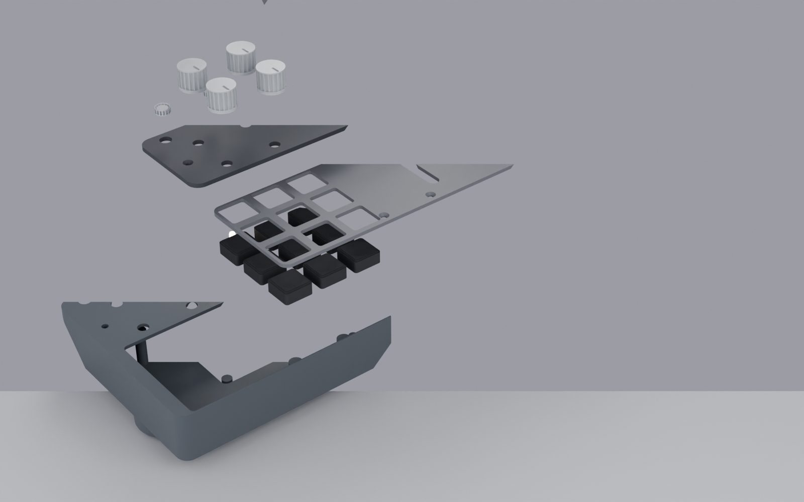
mechanical/exploded.png
