martiyanov/bukifon/mechanical/preview_v05_A/front_panel.jpg

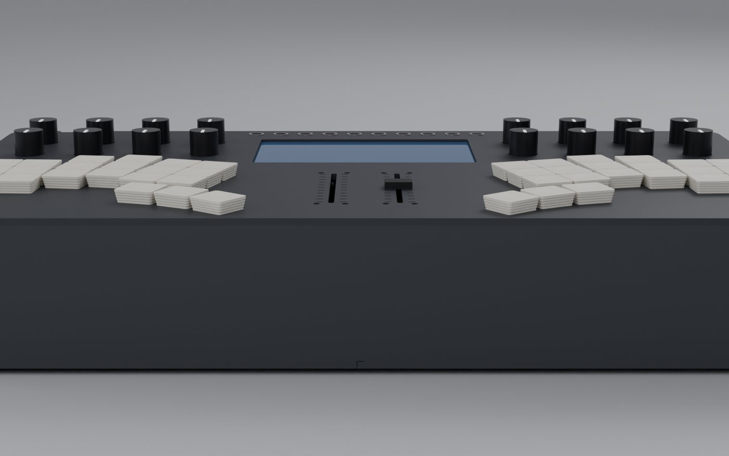
mechanical/preview_v05_A/front_panel.jpg
