martiyanov/bukifon/mechanical/preview_v05_A/left_ports.jpg

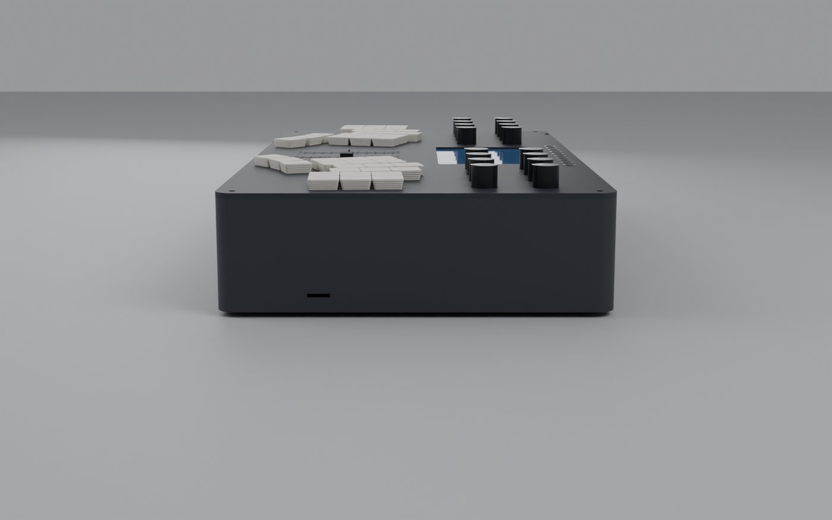
mechanical/preview_v05_A/left_ports.jpg
