martiyanov/bukifon/mechanical/preview_v05_A/rear_ports.jpg

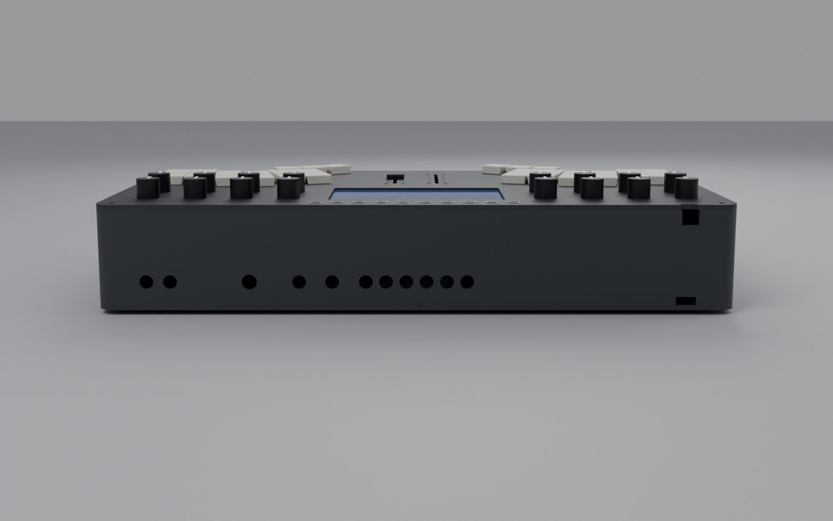
mechanical/preview_v05_A/rear_ports.jpg
