martiyanov/bukifon/mechanical/preview_v05_A/side_profile.jpg

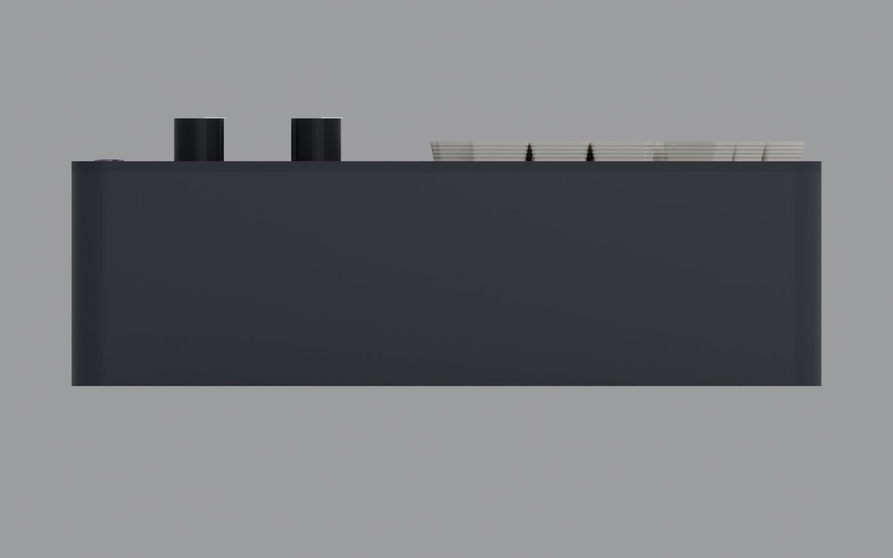
mechanical/preview_v05_A/side_profile.jpg
