martiyanov/bukifon/mechanical/preview_v05_A/top_ortho.jpg

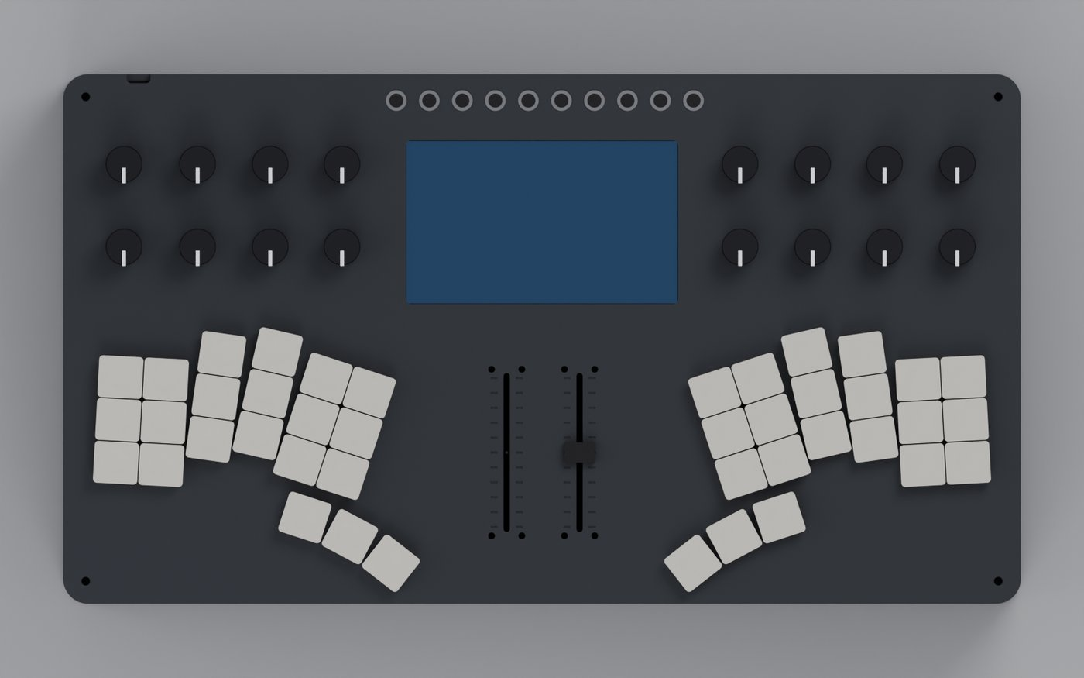
mechanical/preview_v05_A/top_ortho.jpg
