martiyanov/bukifon/mechanical/preview_v05_A_mic/iso_top.jpg

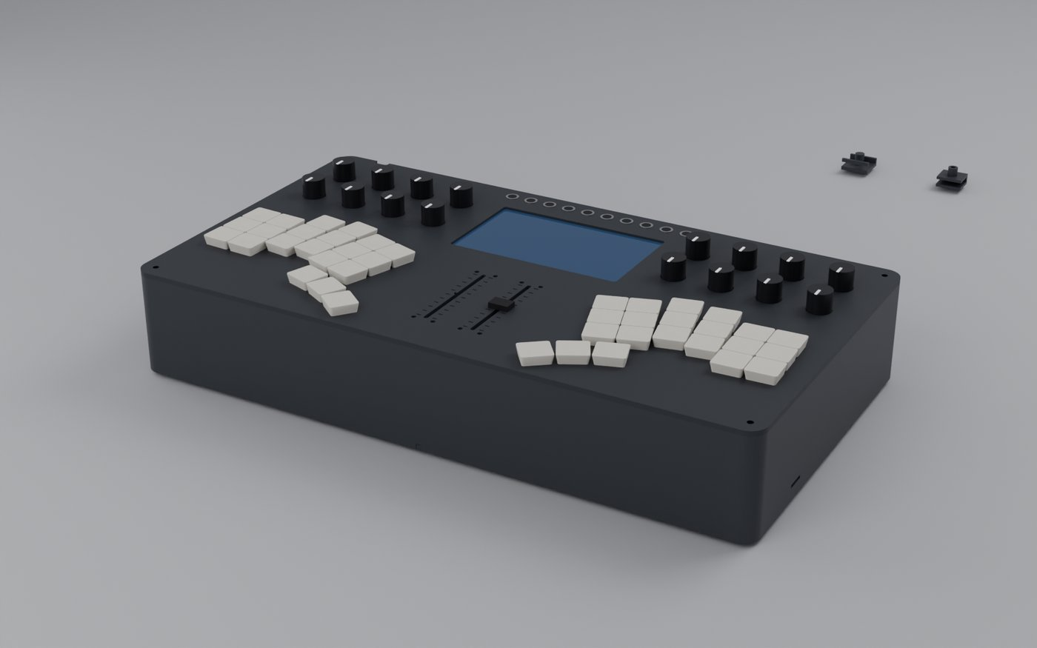
mechanical/preview_v05_A_mic/iso_top.jpg
