martiyanov/bukifon/mechanical/preview_v05_B/exploded.jpg

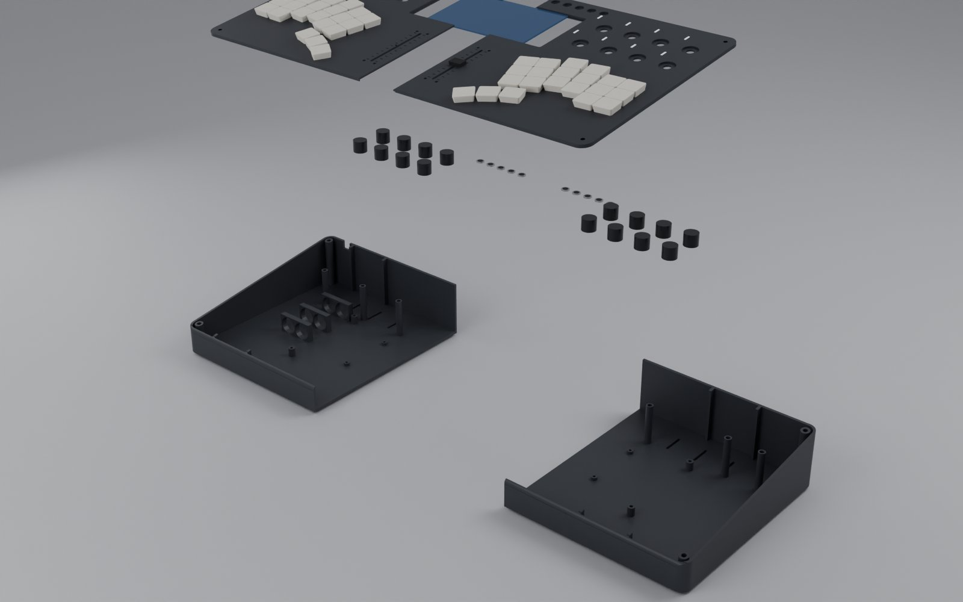
mechanical/preview_v05_B/exploded.jpg
