martiyanov/bukifon/mechanical/preview_v05_B/front_panel.jpg

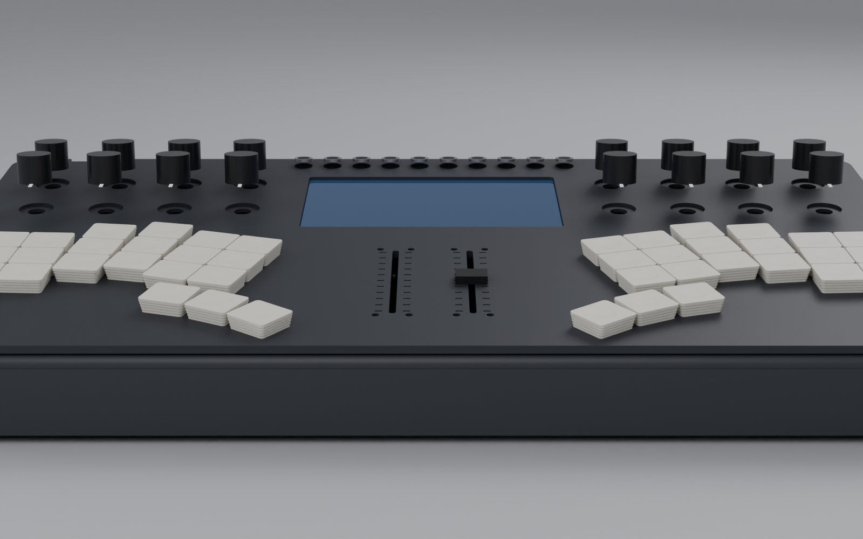
mechanical/preview_v05_B/front_panel.jpg
