martiyanov/bukifon/mechanical/preview_v05_B/panel_parallel.jpg

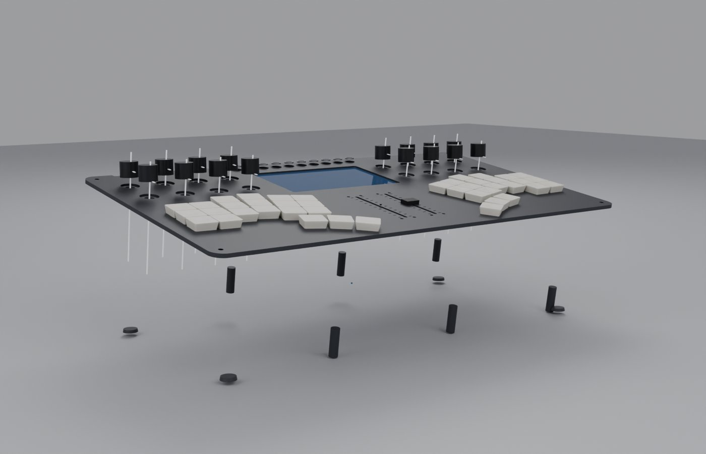
mechanical/preview_v05_B/panel_parallel.jpg
