martiyanov/bukifon/mechanical/preview_v05_B/paperkit_page3_profile.jpg

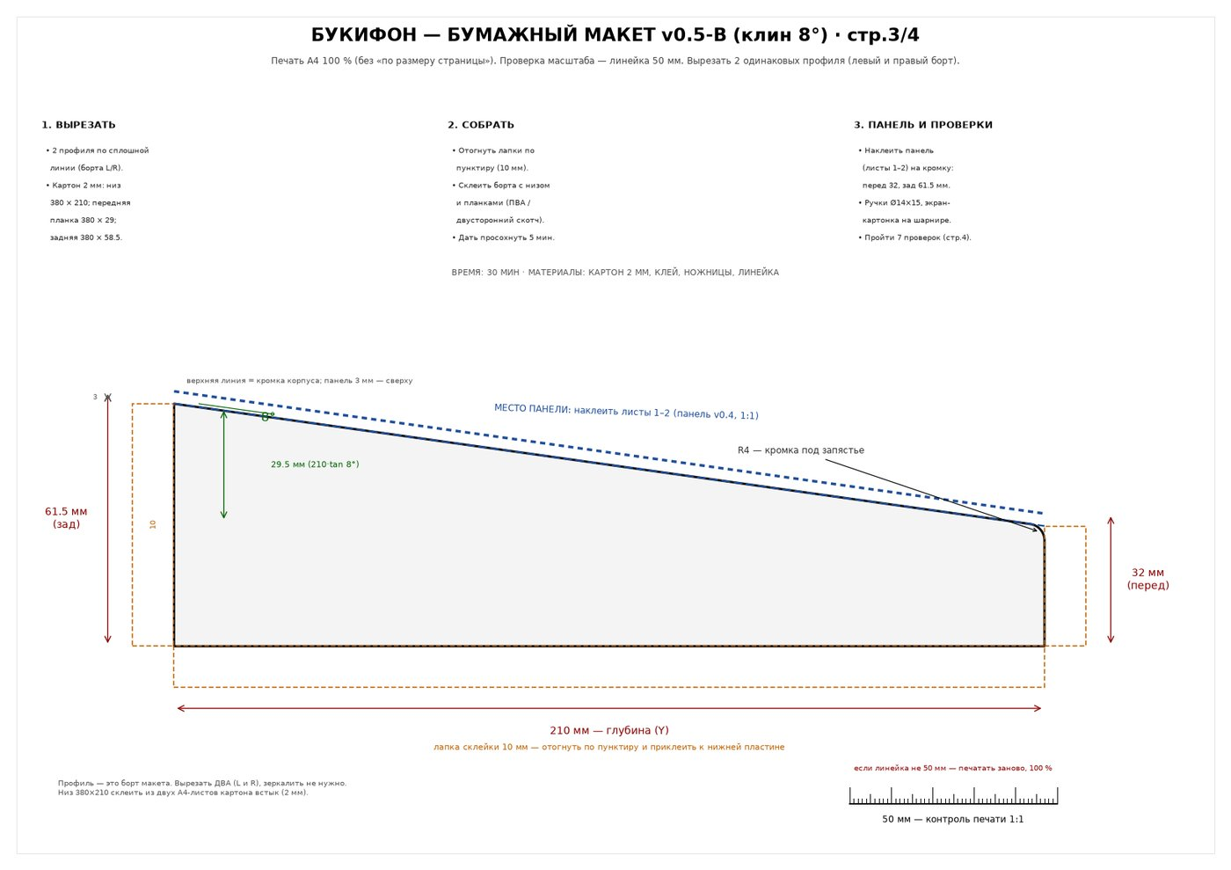
mechanical/preview_v05_B/paperkit_page3_profile.jpg
