martiyanov/bukifon/mechanical/preview_v05_B/paperkit_page4_checkmap.jpg

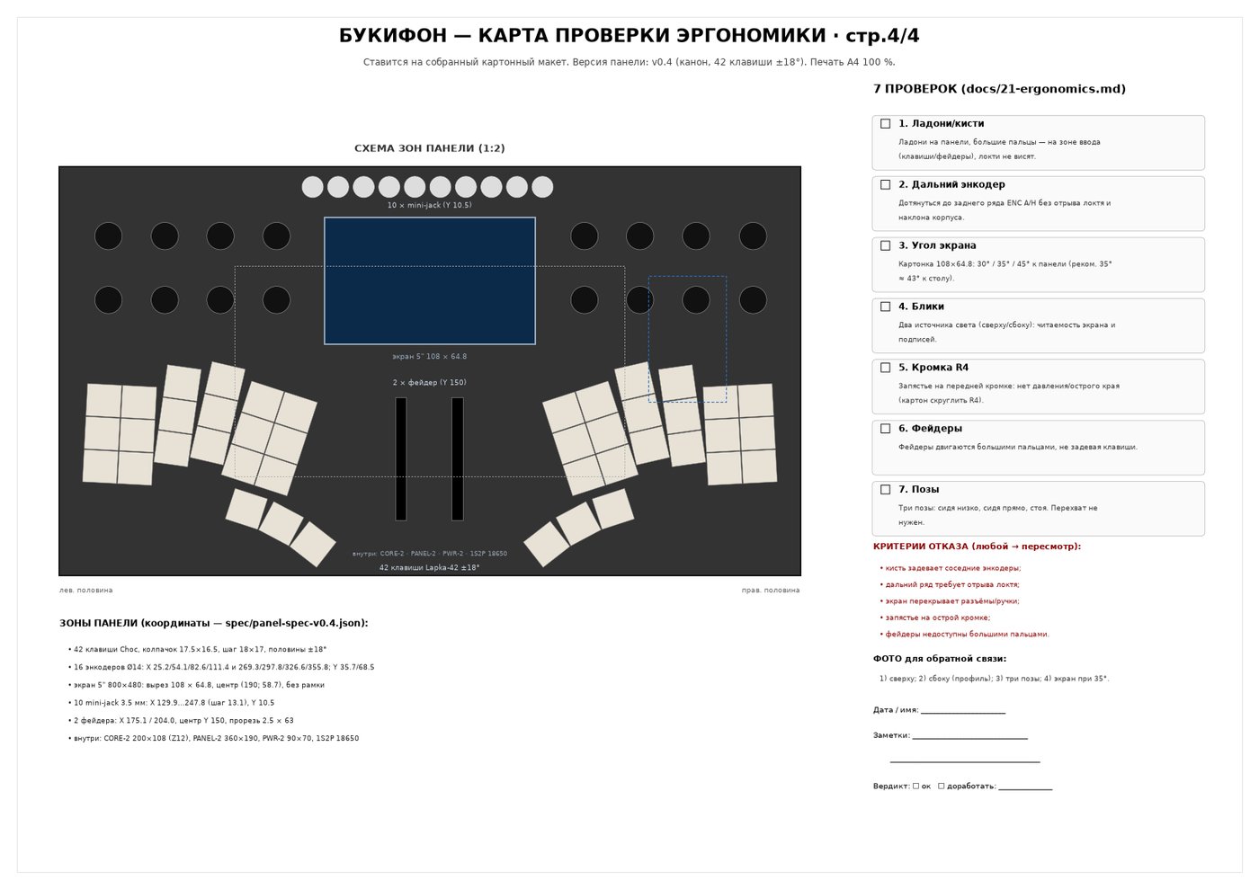
mechanical/preview_v05_B/paperkit_page4_checkmap.jpg
