martiyanov/bukifon/mechanical/preview_v05_B_light/asm_map_p2.jpg

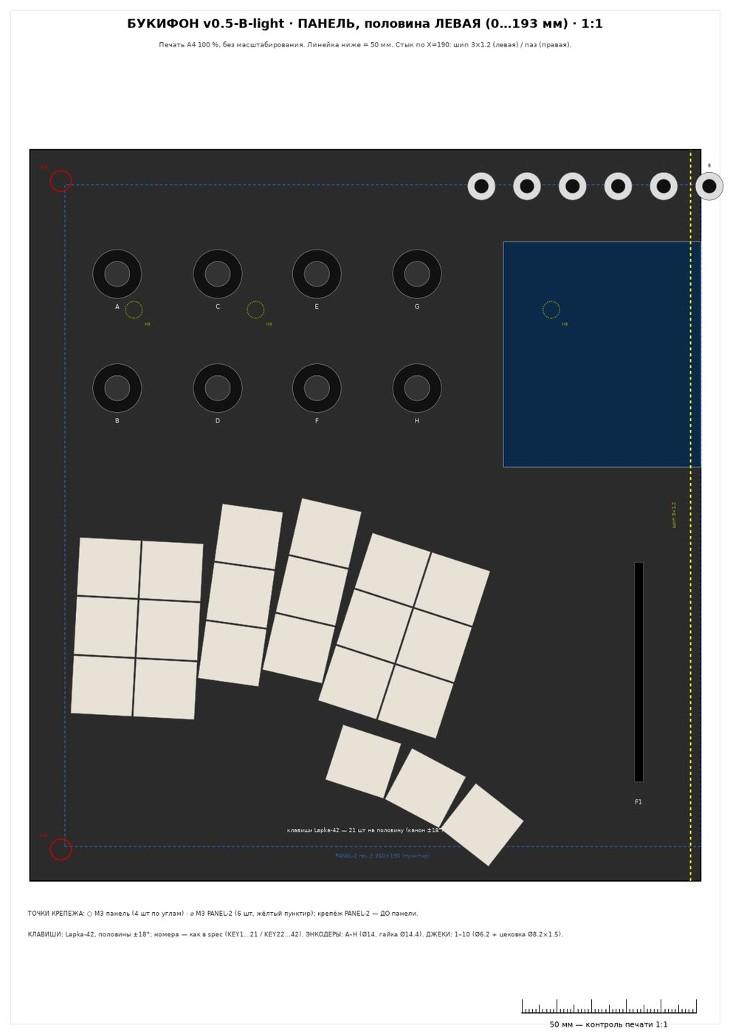
mechanical/preview_v05_B_light/asm_map_p2.jpg
