martiyanov/bukifon/mechanical/preview_v05_B_light/left_ports.jpg

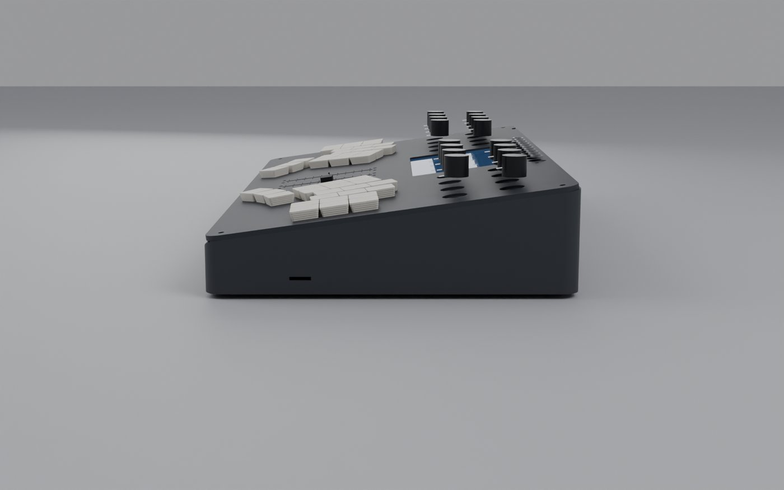
mechanical/preview_v05_B_light/left_ports.jpg
