martiyanov/bukifon/mechanical/preview_v05_B_light/mic_closeup.jpg

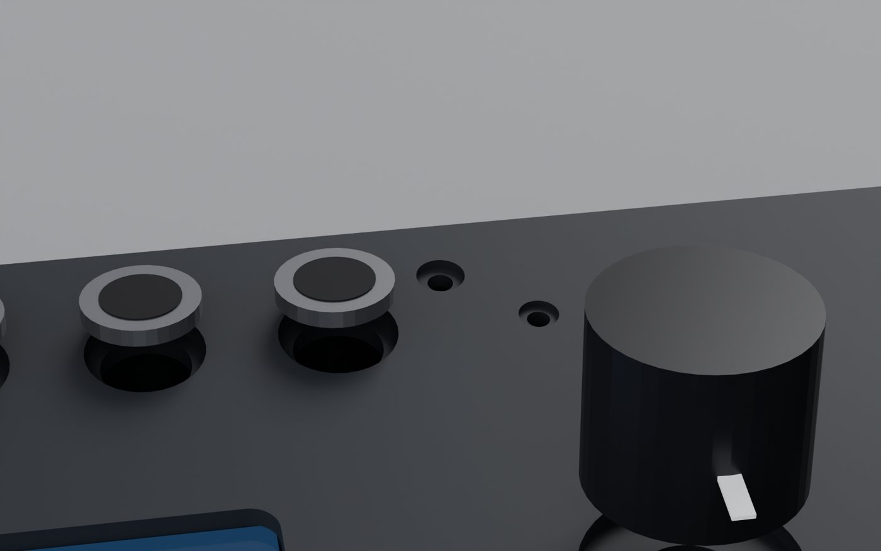
mechanical/preview_v05_B_light/mic_closeup.jpg
