martiyanov/bukifon/mechanical/preview_v05_B_mic/iso_top.jpg

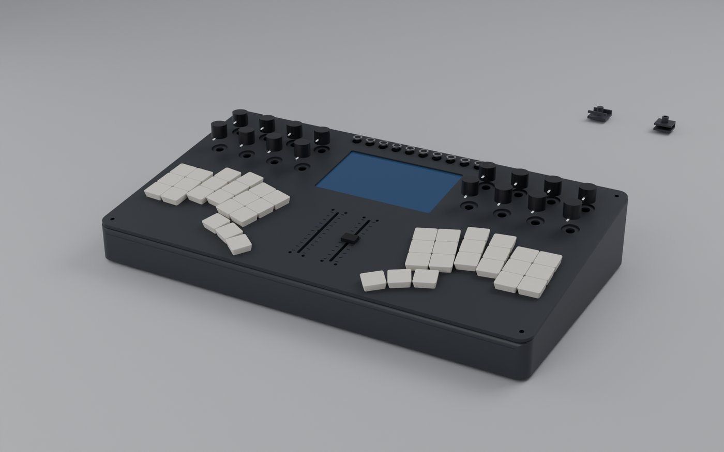
mechanical/preview_v05_B_mic/iso_top.jpg
