martiyanov/bukifon/mechanical/preview_v05_B_mic/rear_ports.jpg

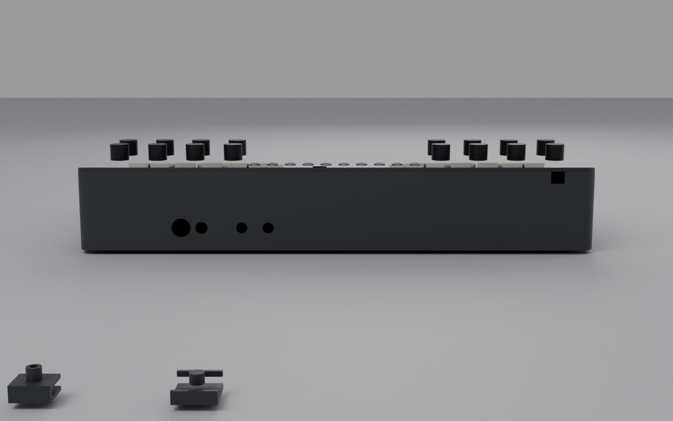
mechanical/preview_v05_B_mic/rear_ports.jpg
