martiyanov/bukifon/mechanical/preview_v05_B_mic/side_profile.jpg

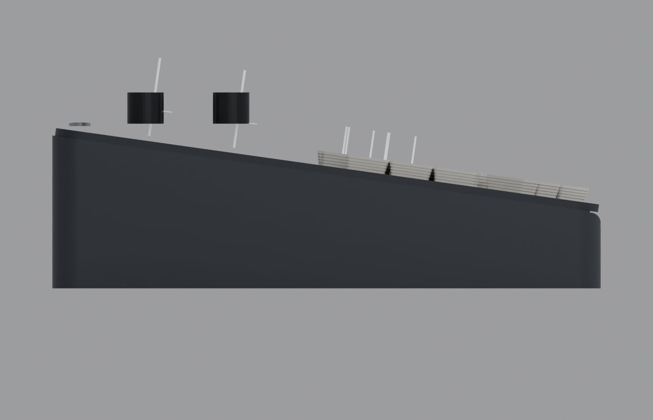
mechanical/preview_v05_B_mic/side_profile.jpg
