martiyanov/bukifon/mechanical/preview_v05_C/exploded.jpg

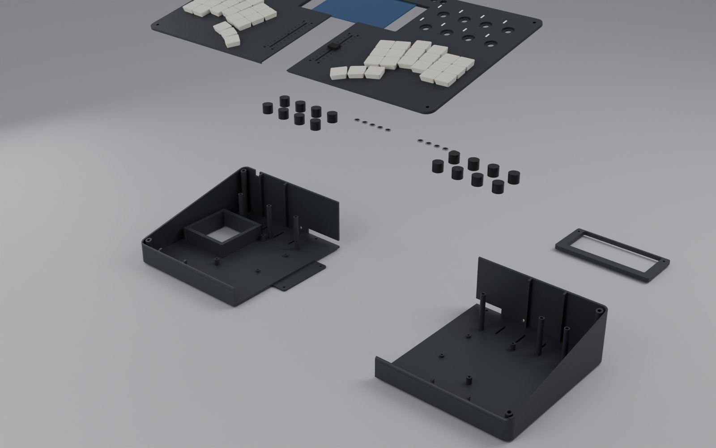
mechanical/preview_v05_C/exploded.jpg
