martiyanov/bukifon/mechanical/preview_v05_C/front_panel.jpg

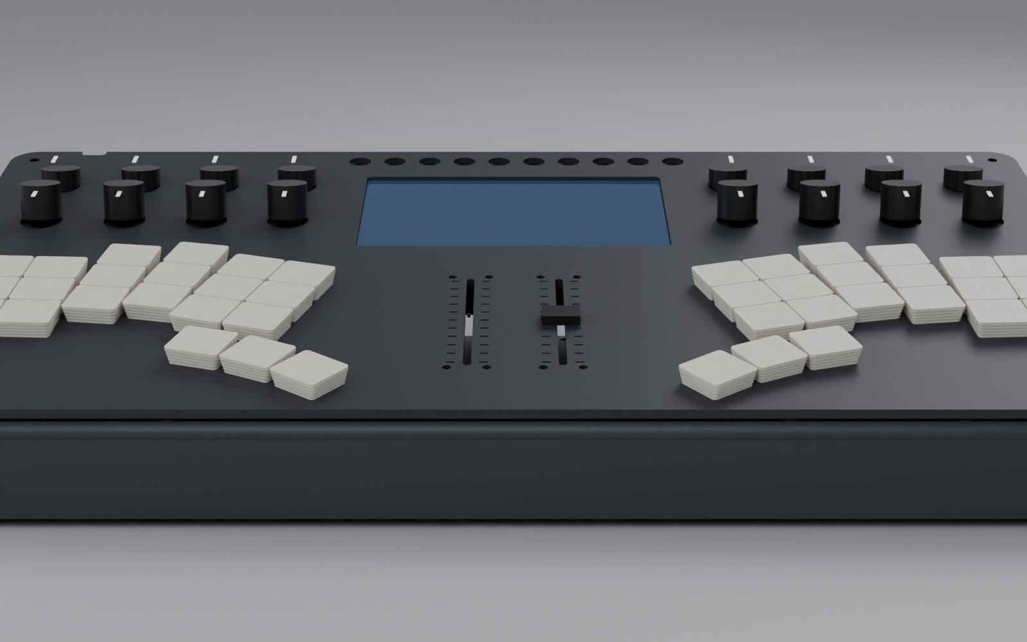
mechanical/preview_v05_C/front_panel.jpg
