martiyanov/bukifon/mechanical/preview_v05_C/panel_parallel.jpg

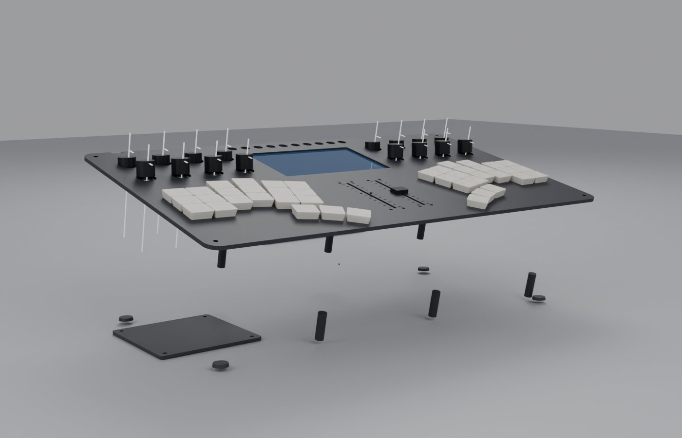
mechanical/preview_v05_C/panel_parallel.jpg
