martiyanov/bukifon/mechanical/preview_v05_C/side_profile.jpg

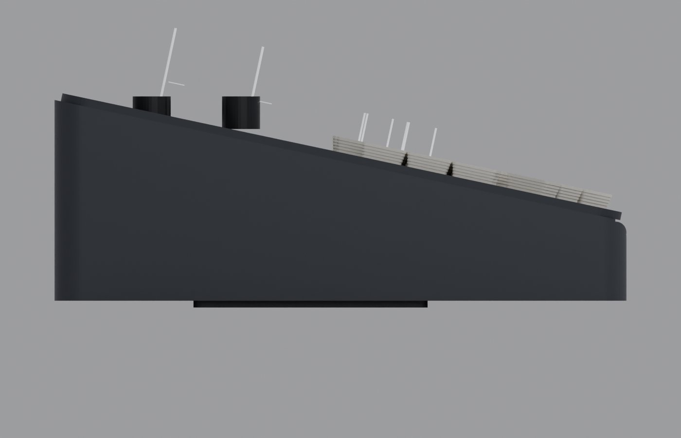
mechanical/preview_v05_C/side_profile.jpg
