martiyanov/bukifon/mechanical/preview_v05_C_mic/mic_closeup.jpg

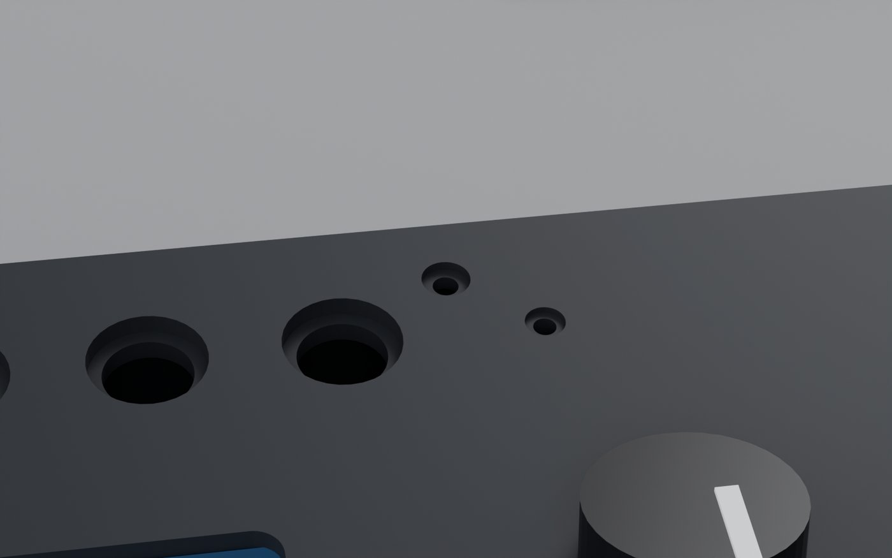
mechanical/preview_v05_C_mic/mic_closeup.jpg
