martiyanov/bukifon/mechanical/preview_v05_C_mic/rear_ports.jpg

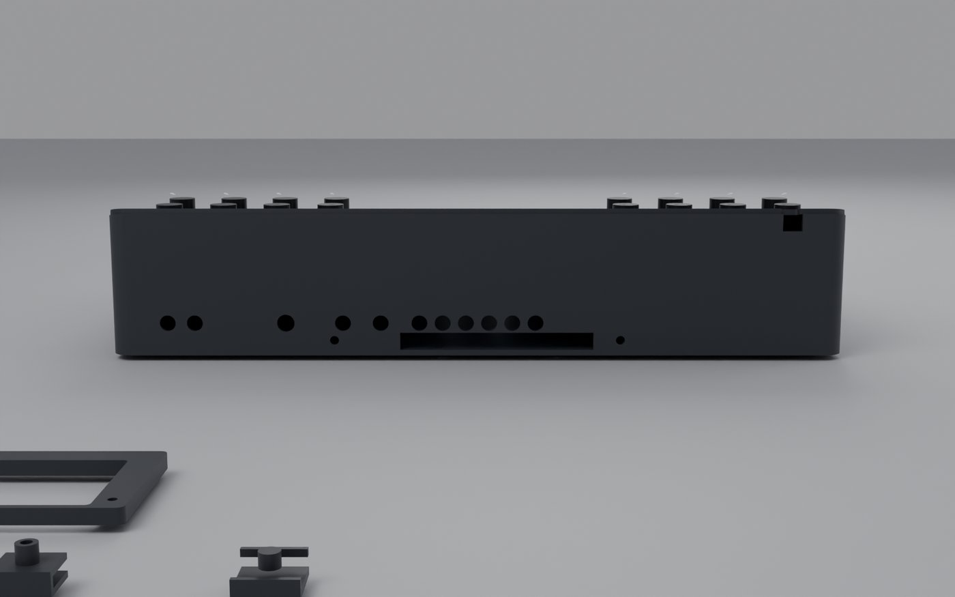
mechanical/preview_v05_C_mic/rear_ports.jpg
