martiyanov/bukifon/mechanical/preview_v05_compare/profiles_compare.jpg

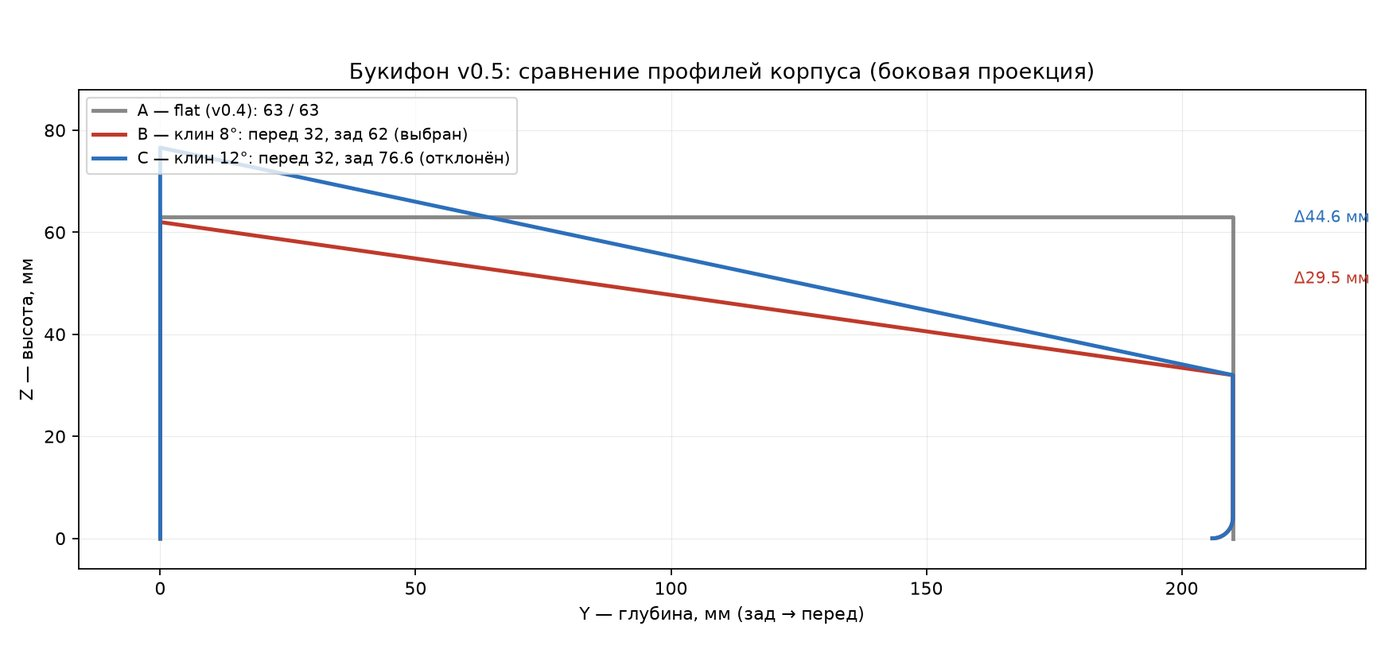
mechanical/preview_v05_compare/profiles_compare.jpg
