martiyanov/bukifon/refs/concept-panel.jpg

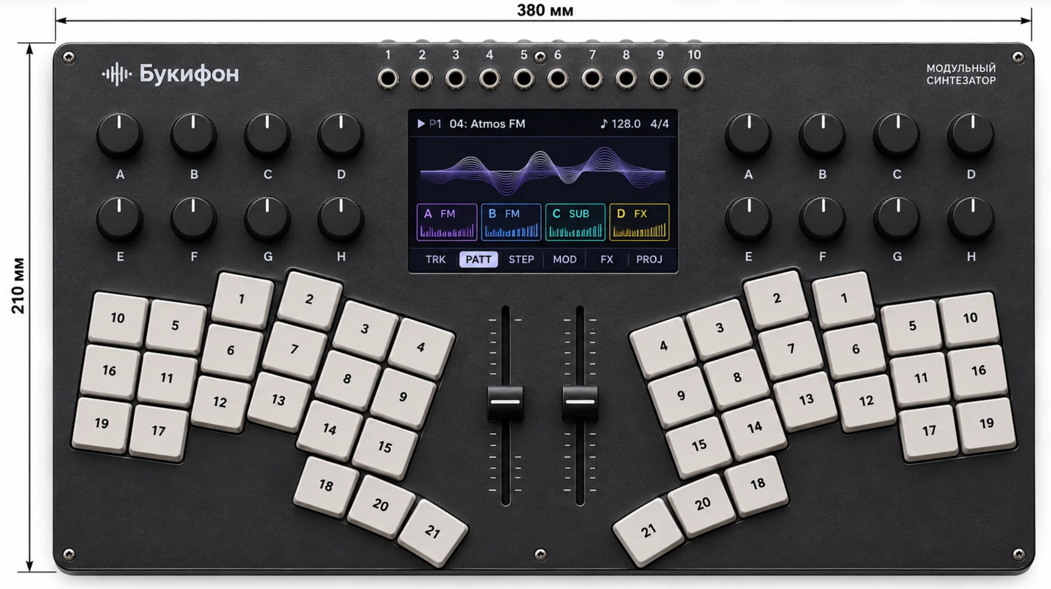
refs/concept-panel.jpg
