martiyanov/bukifon/refs/sketch1-panel.jpg

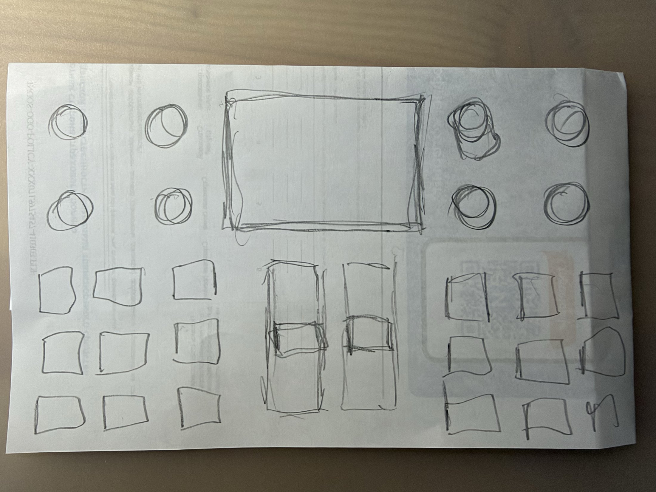
refs/sketch1-panel.jpg
