martiyanov/bukifon/refs/sketch2-folded-a4.jpg

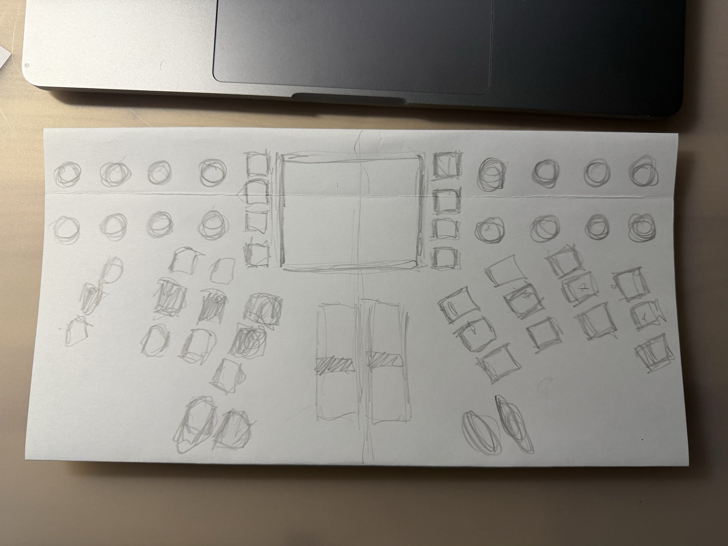
refs/sketch2-folded-a4.jpg
