martiyanov/bukifon/refs/sketch4-keyfit.jpg

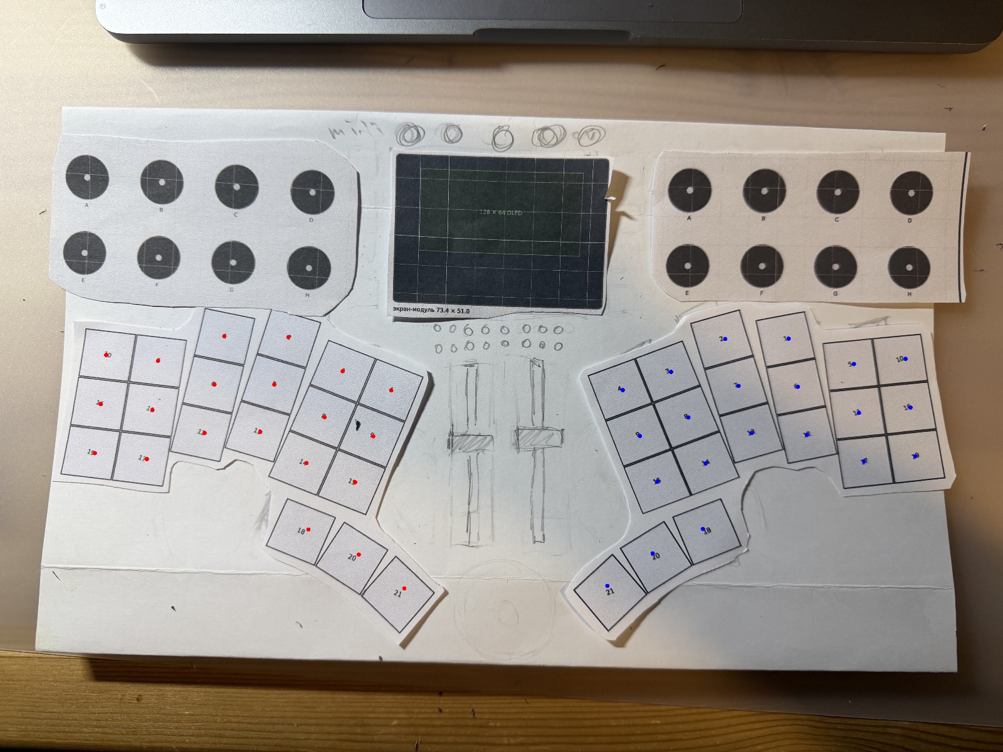
refs/sketch4-keyfit.jpg
