martiyanov/bukifon/renders/mech/bottom_grip.png

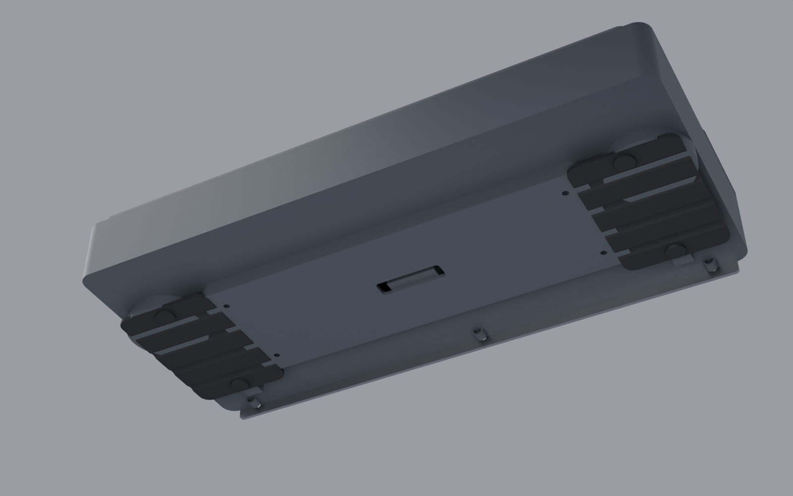
renders/mech/bottom_grip.png
