martiyanov/bukifon/renders/mech/deck_keys_closeup.png

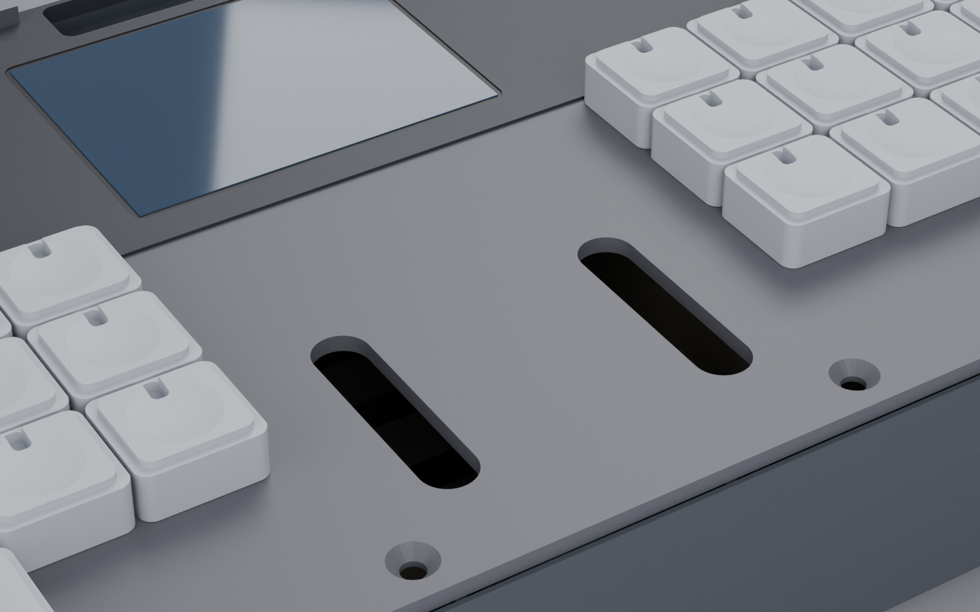
renders/mech/deck_keys_closeup.png
