martiyanov/bukifon/renders/mech/deck_pad_closeup.png

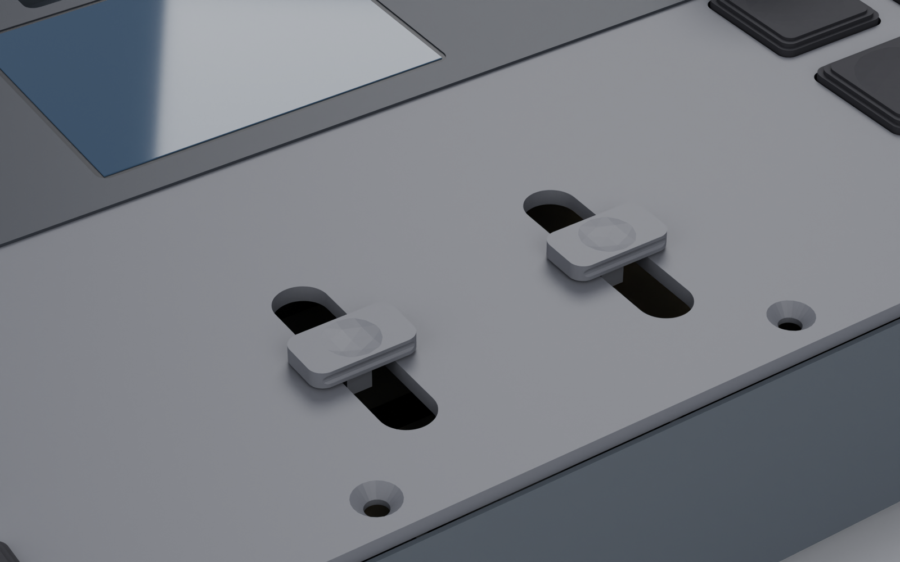
renders/mech/deck_pad_closeup.png
