martiyanov/bukifon/renders/mech/front_panel.png

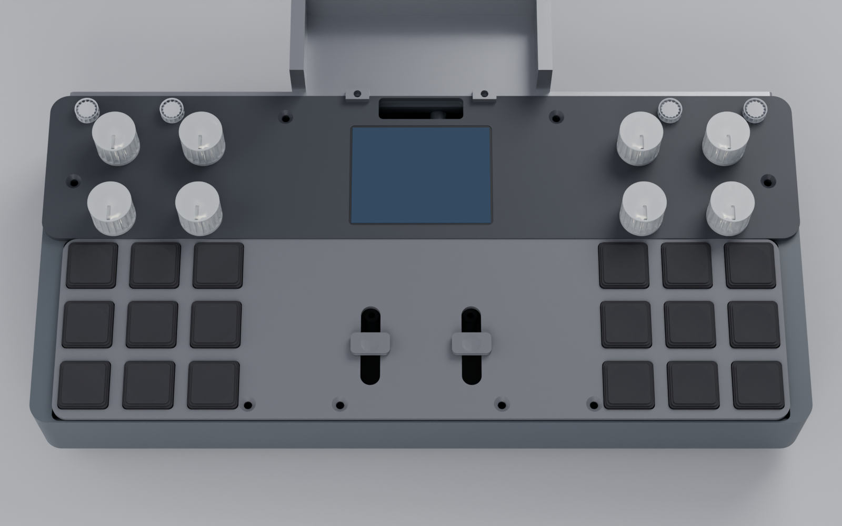
renders/mech/front_panel.png
