martiyanov/bukifon/renders/mech/rear_connectors.png

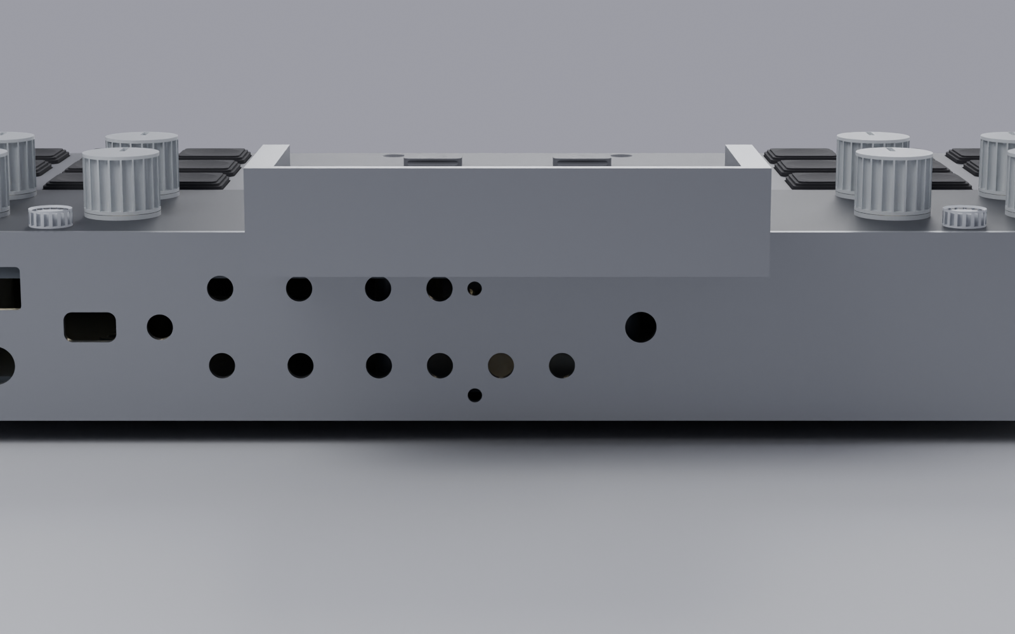
renders/mech/rear_connectors.png
