martiyanov/bukifon/renders/panel_layout.png

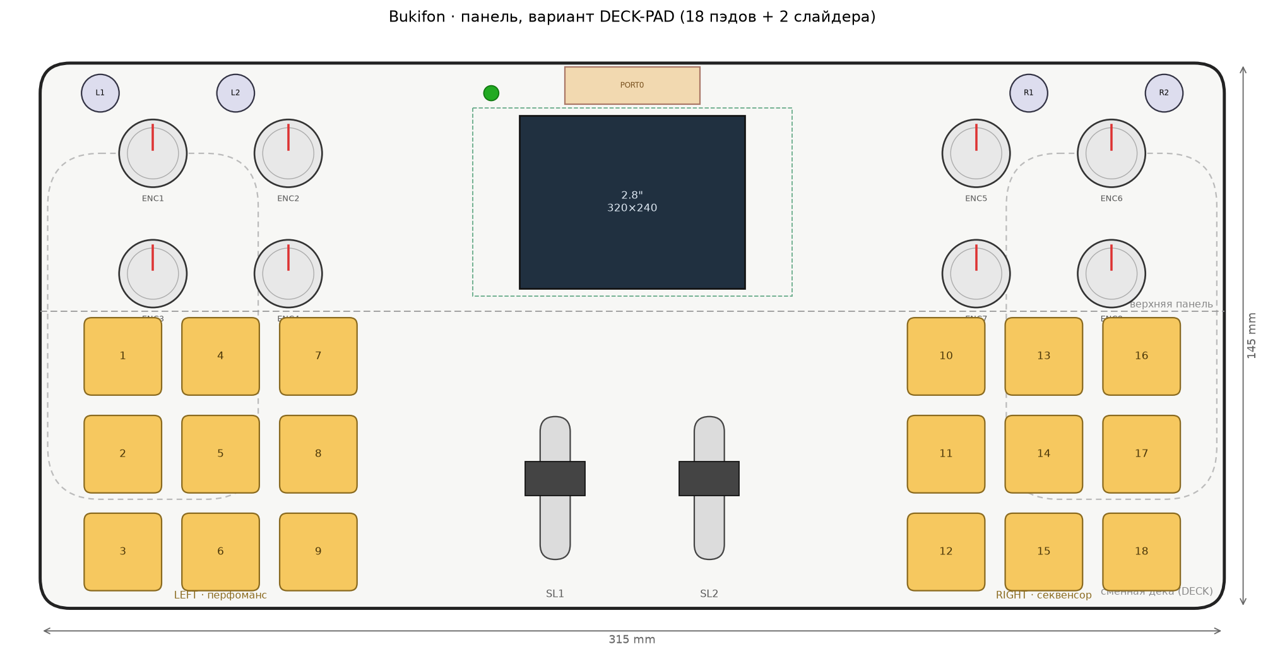
renders/panel_layout.png
