martiyanov/bukifon/renders/panel_layout_keys.png

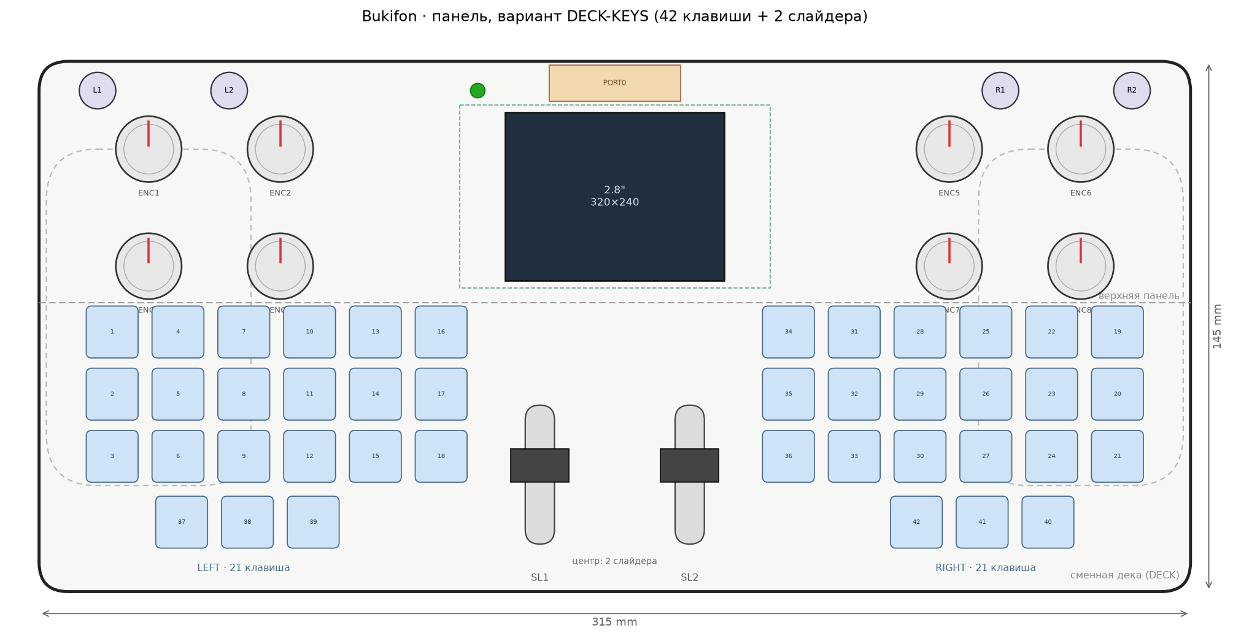
renders/panel_layout_keys.png
