martiyanov/bukifon/renders/templates/bukifon_v1_4_full.png

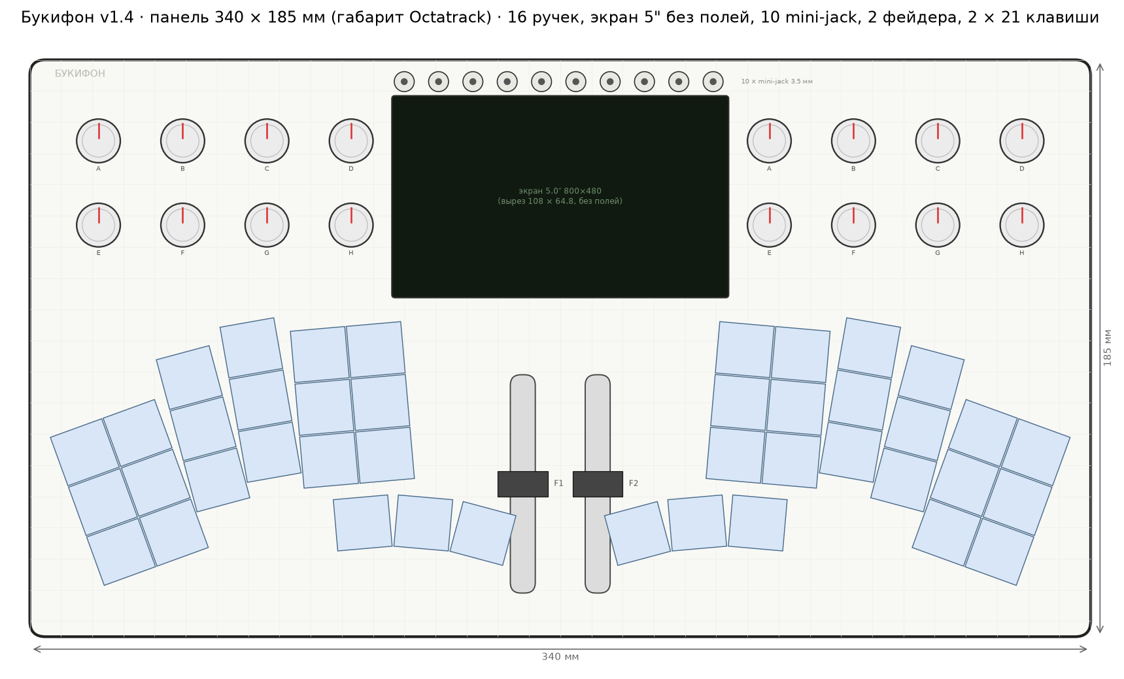
renders/templates/bukifon_v1_4_full.png
