martiyanov/bukifon/renders/templates/bukifon_v1_4_page1.png

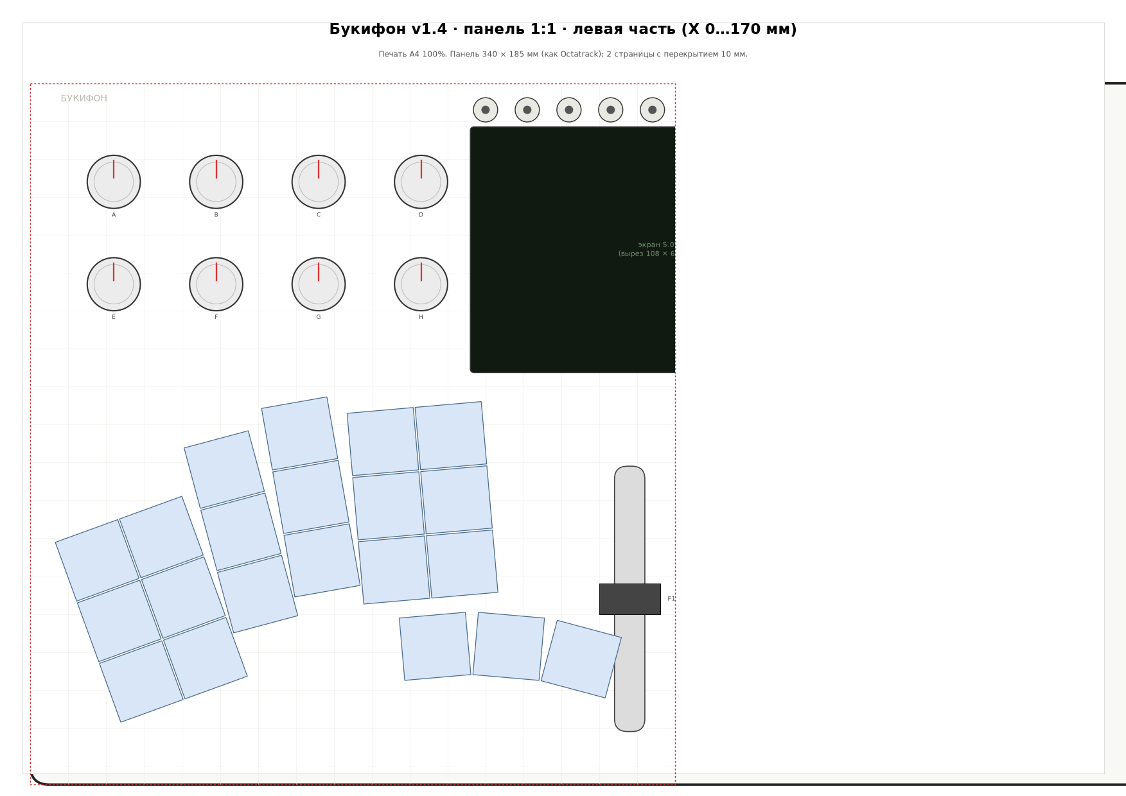
renders/templates/bukifon_v1_4_page1.png
