martiyanov/bukifon/renders/templates/bukifon_v1_4_page2.png

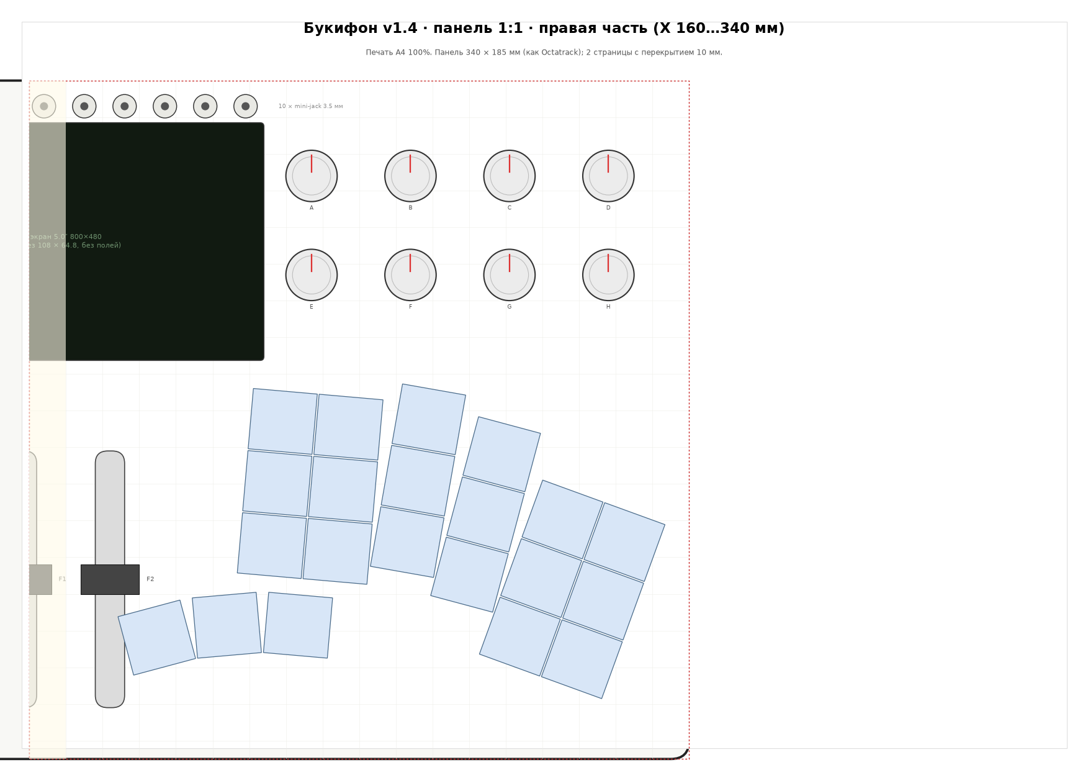
renders/templates/bukifon_v1_4_page2.png
