martiyanov/bukifon/renders/templates/bukifon_v1_4_panel_preview.png

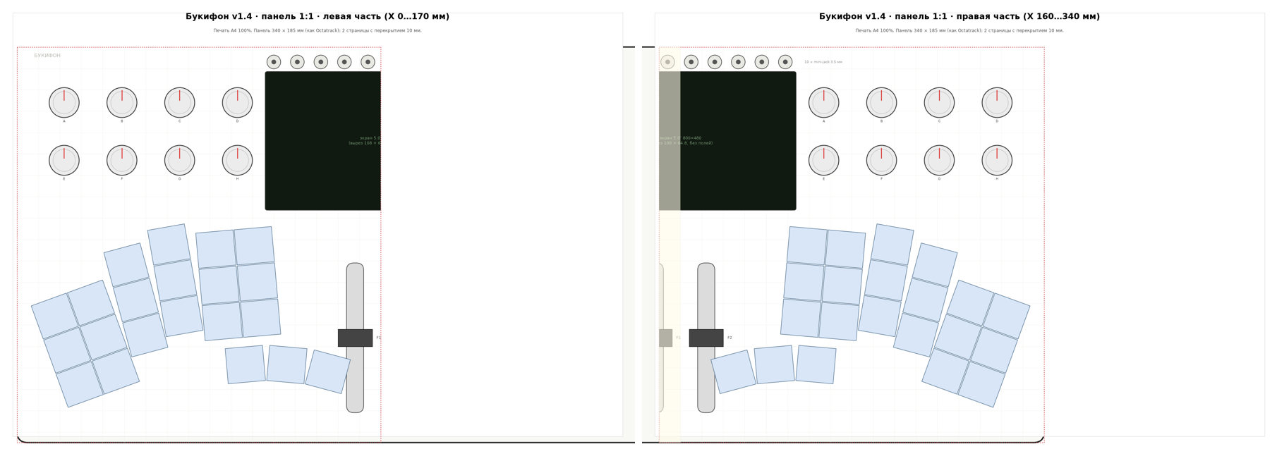
renders/templates/bukifon_v1_4_panel_preview.png
