martiyanov/bukifon/renders/templates/bukifon_v1_5_full.png

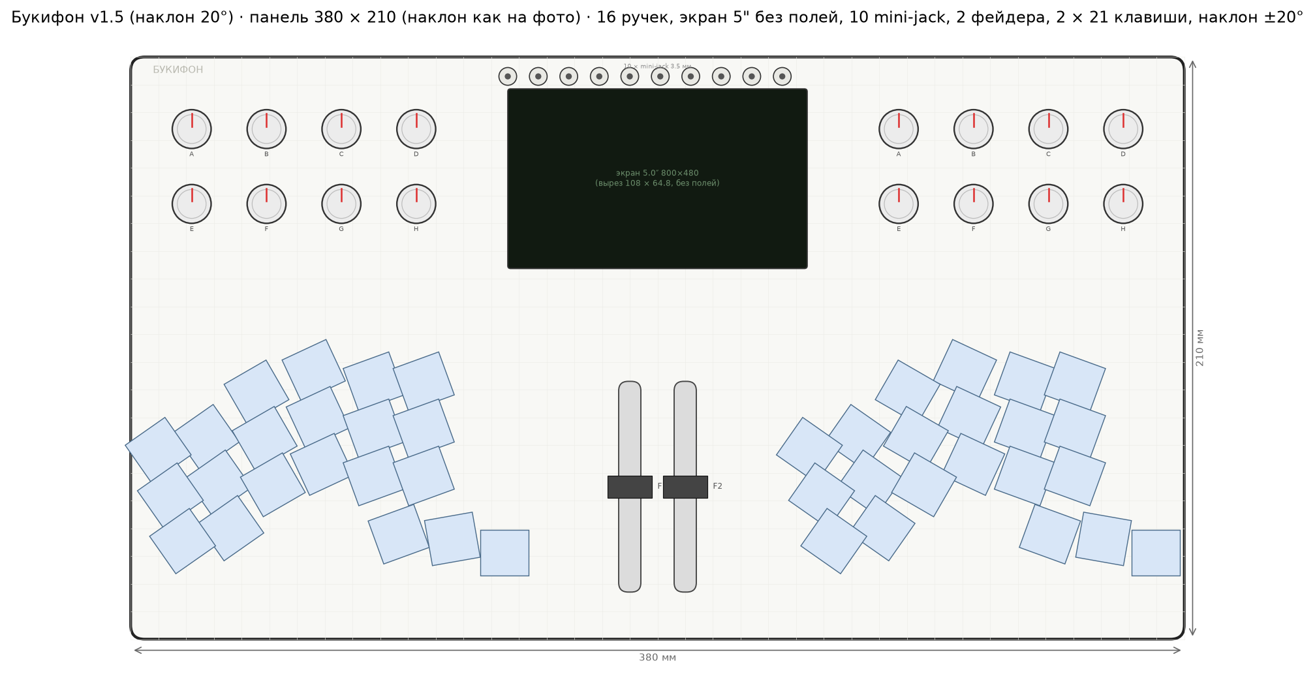
renders/templates/bukifon_v1_5_full.png
