martiyanov/bukifon/renders/templates/bukifon_v1_5_page1.png

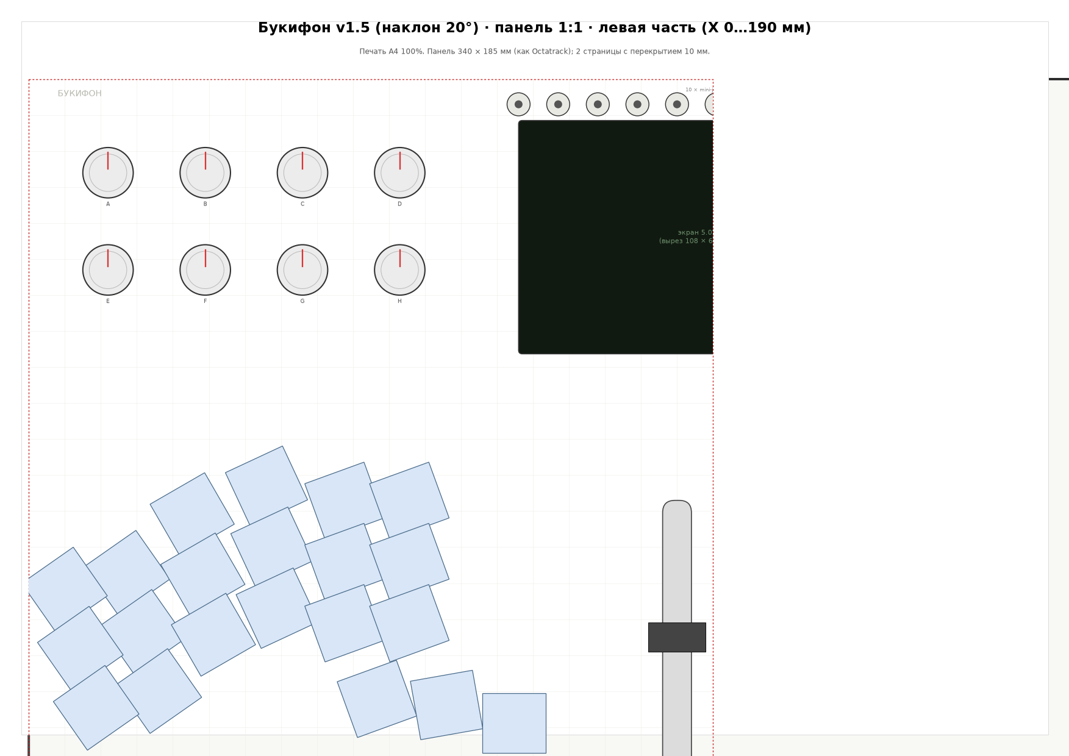
renders/templates/bukifon_v1_5_page1.png
