martiyanov/bukifon/renders/templates/bukifon_v1_5_page2.png

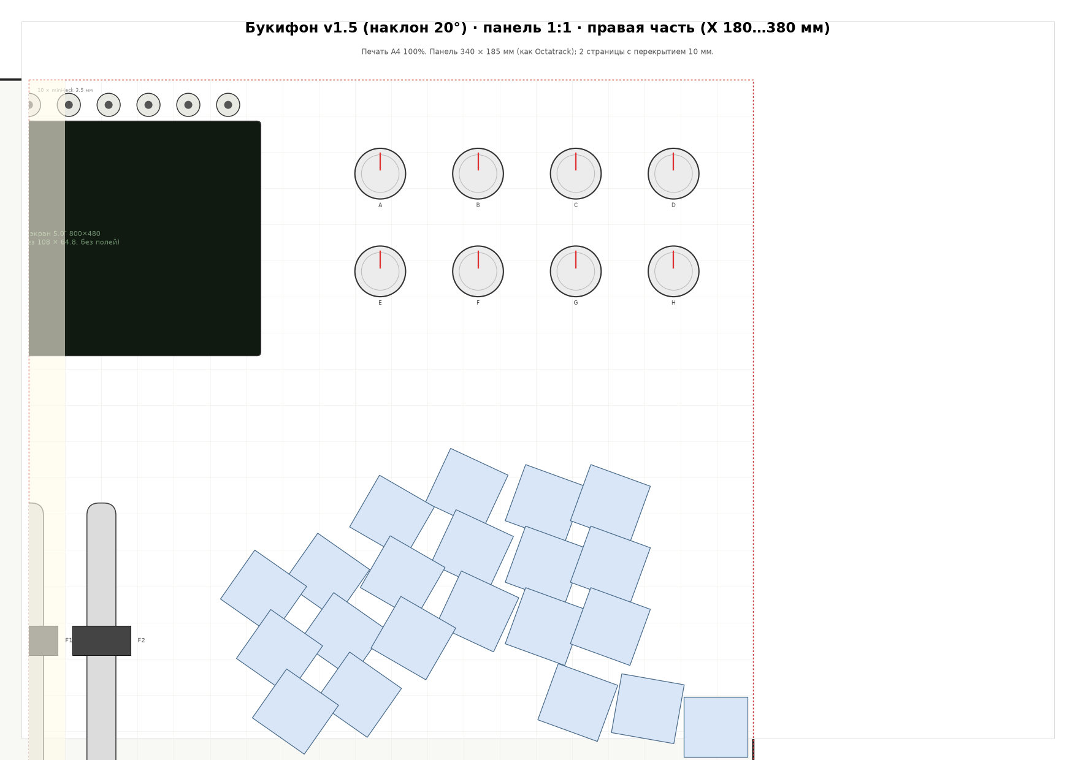
renders/templates/bukifon_v1_5_page2.png
