martiyanov/bukifon/renders/templates/bukifon_v1_5_panel_preview.png

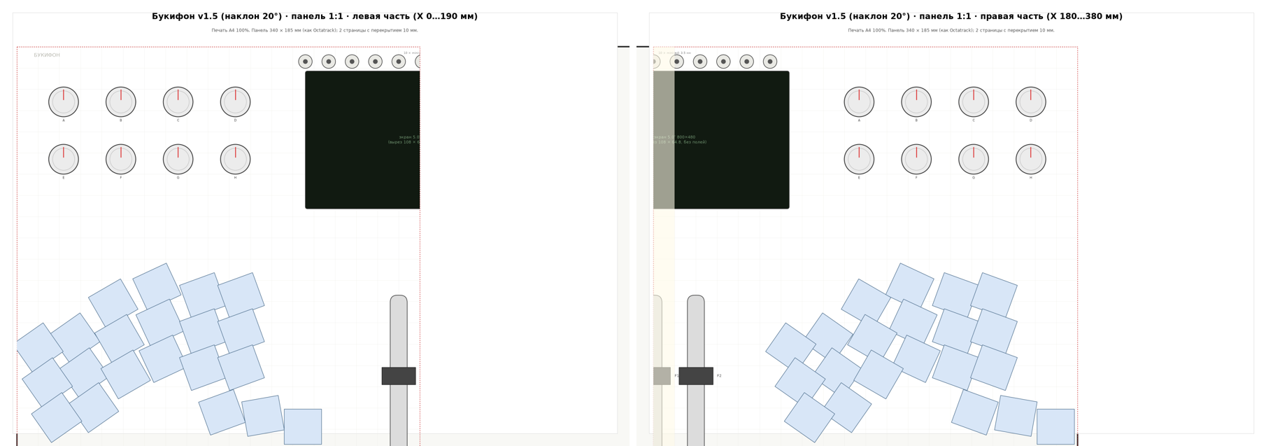
renders/templates/bukifon_v1_5_panel_preview.png
