martiyanov/bukifon/renders/templates/bukifon_v1_6_page1.png

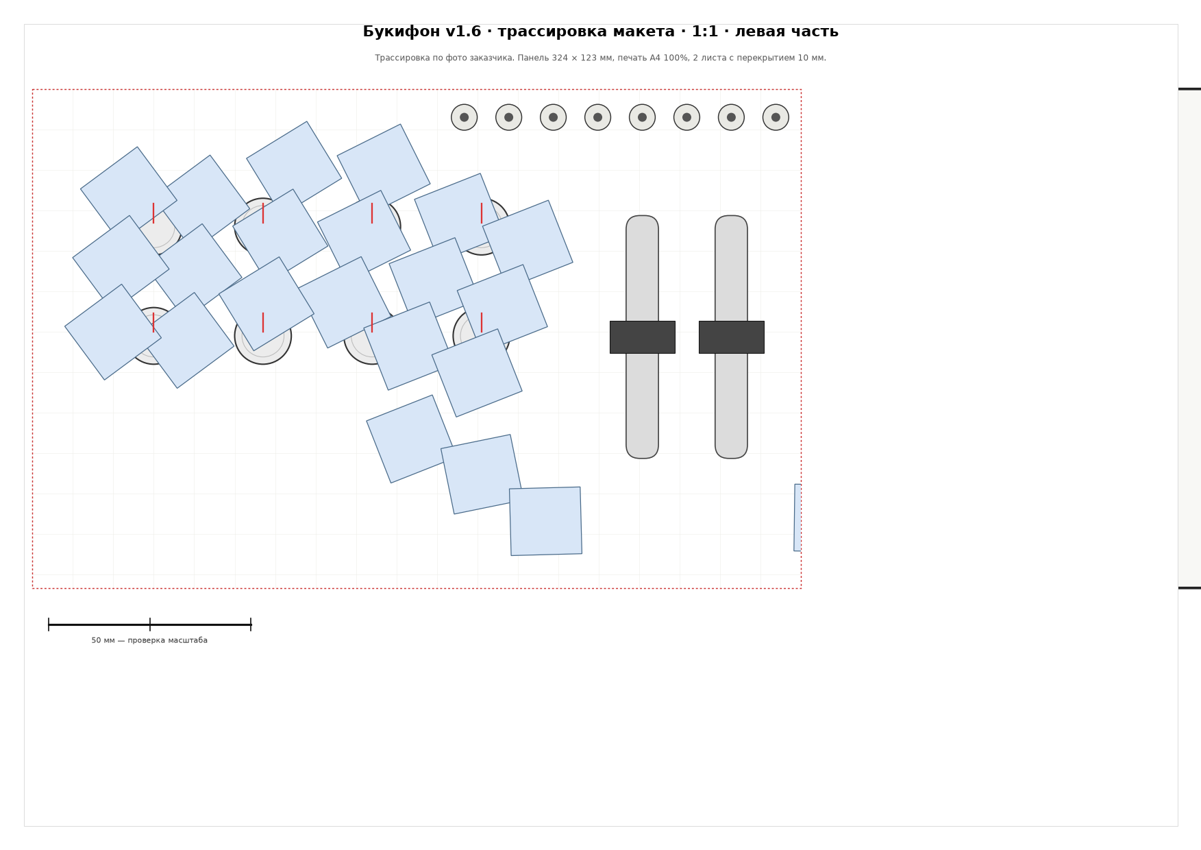
renders/templates/bukifon_v1_6_page1.png
