martiyanov/bukifon/renders/templates/bukifon_v1_6_page2.png

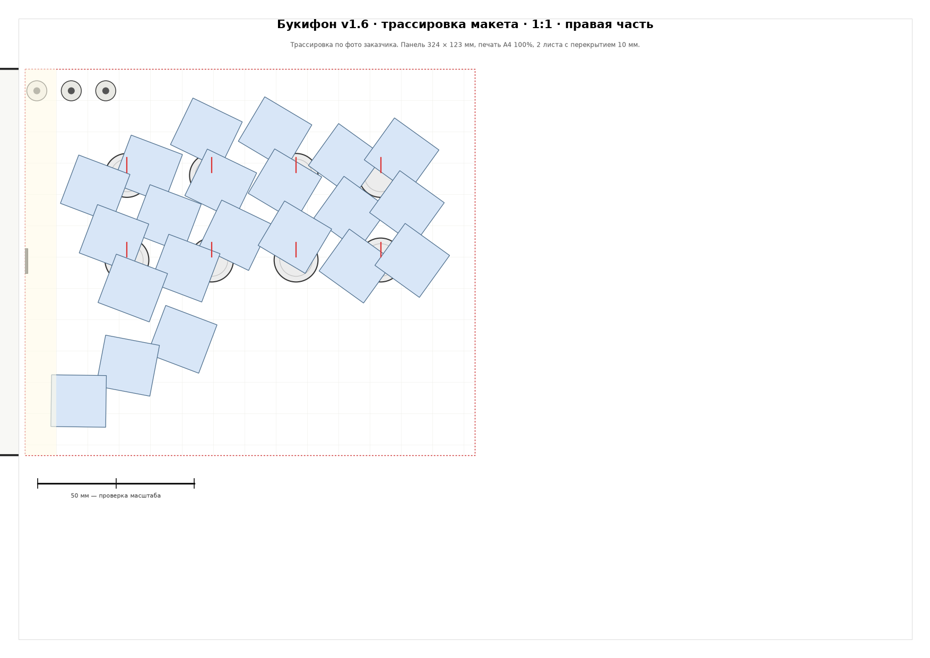
renders/templates/bukifon_v1_6_page2.png
