martiyanov/bukifon/renders/templates/bukifon_v1_6_traced_full.png

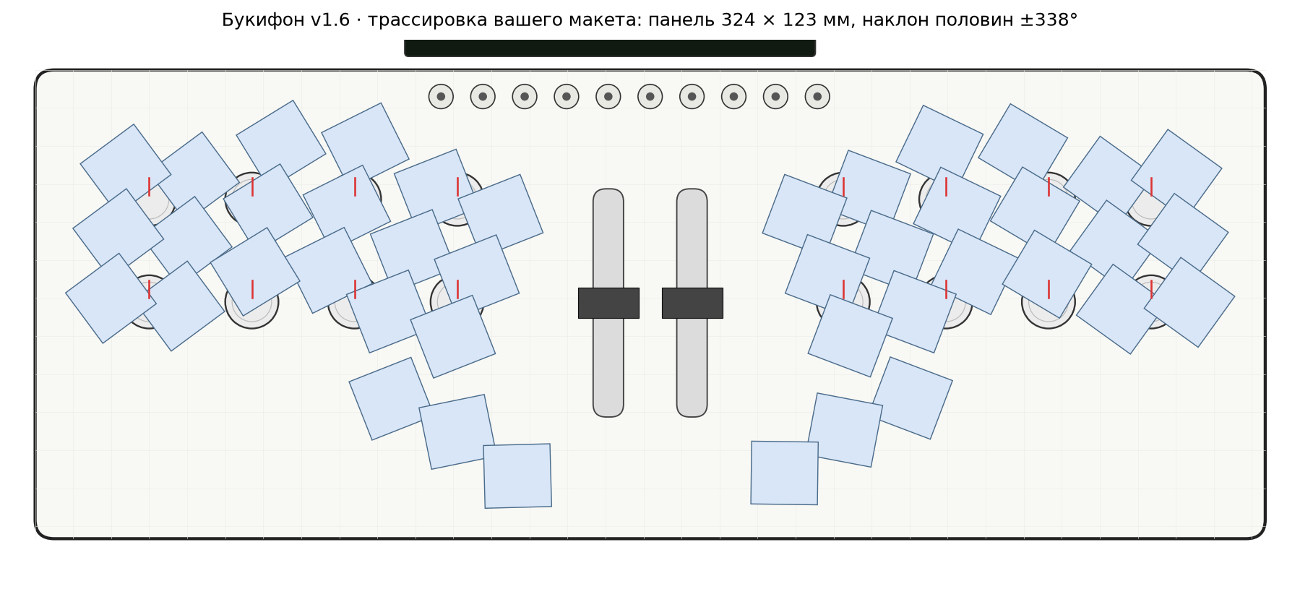
renders/templates/bukifon_v1_6_traced_full.png
