martiyanov/bukifon/renders/templates/bukifon_v1_7_full.png

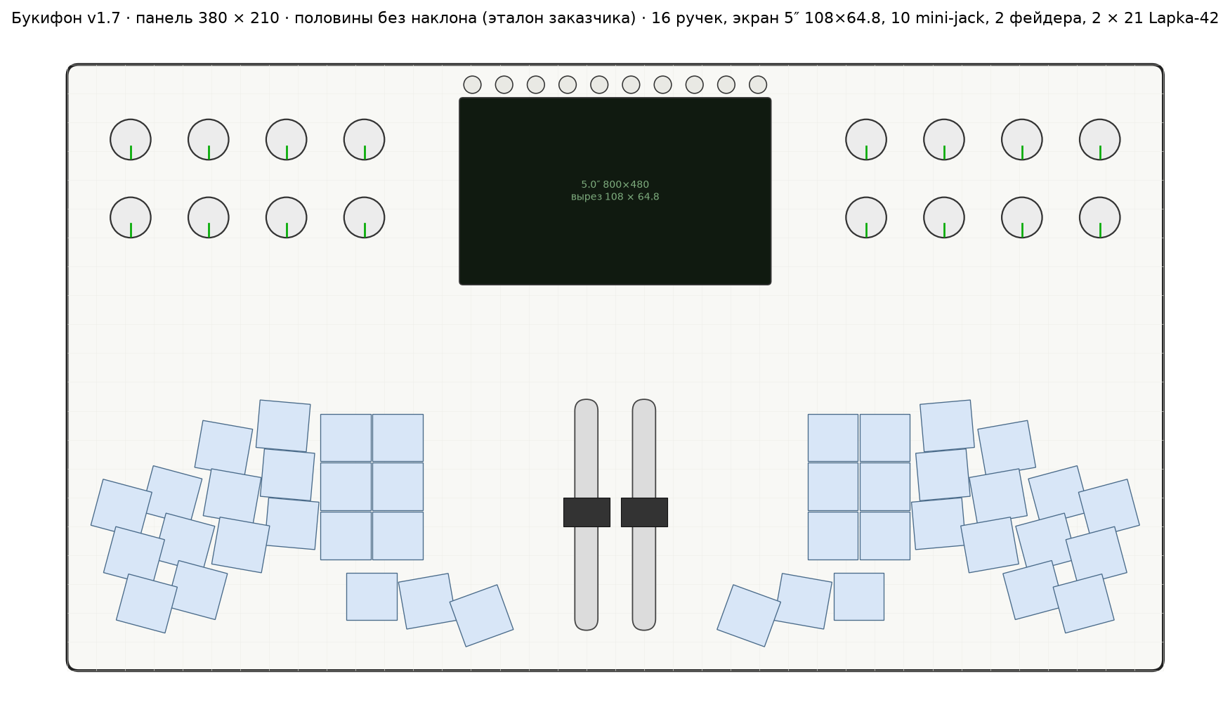
renders/templates/bukifon_v1_7_full.png
