martiyanov/bukifon/renders/templates/bukifon_v1_7_page1.png

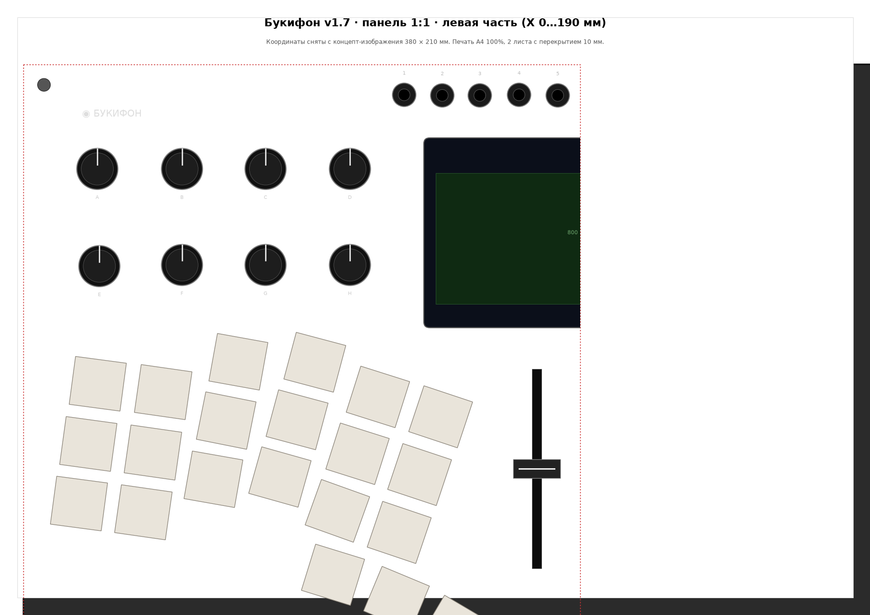
renders/templates/bukifon_v1_7_page1.png
