martiyanov/bukifon/renders/templates/bukifon_v1_7_page2.png

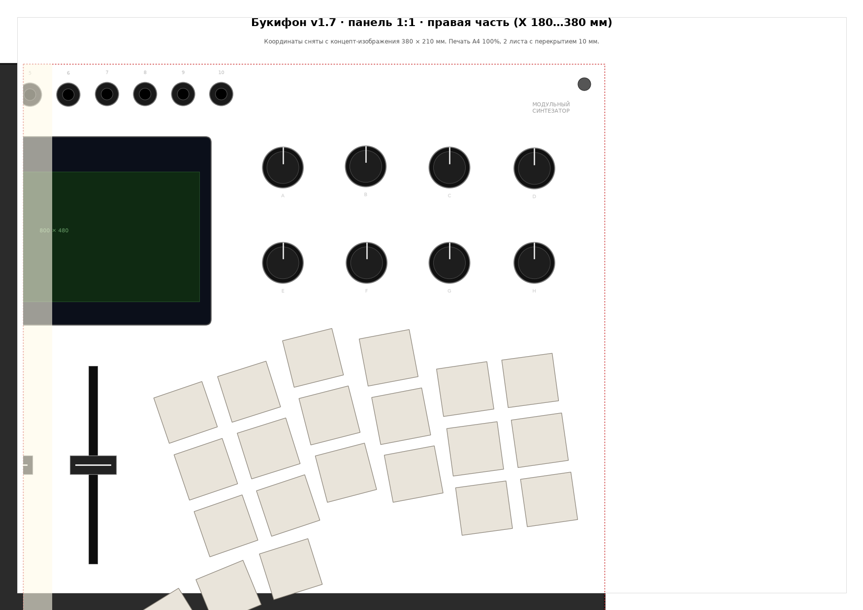
renders/templates/bukifon_v1_7_page2.png
