martiyanov/bukifon/renders/templates/bukifon_v1_7_variants.png

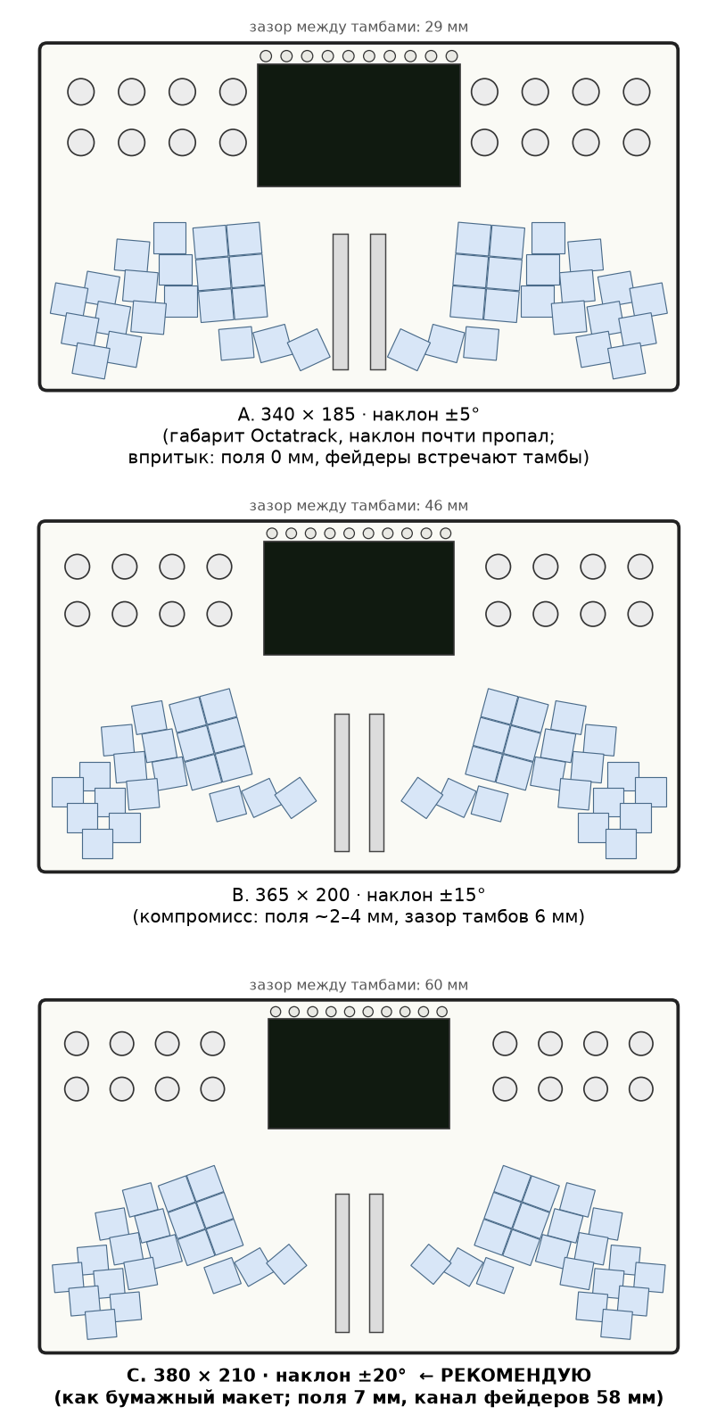
renders/templates/bukifon_v1_7_variants.png
