martiyanov/bukifon/renders/templates/bukifon_v1_8_full.png

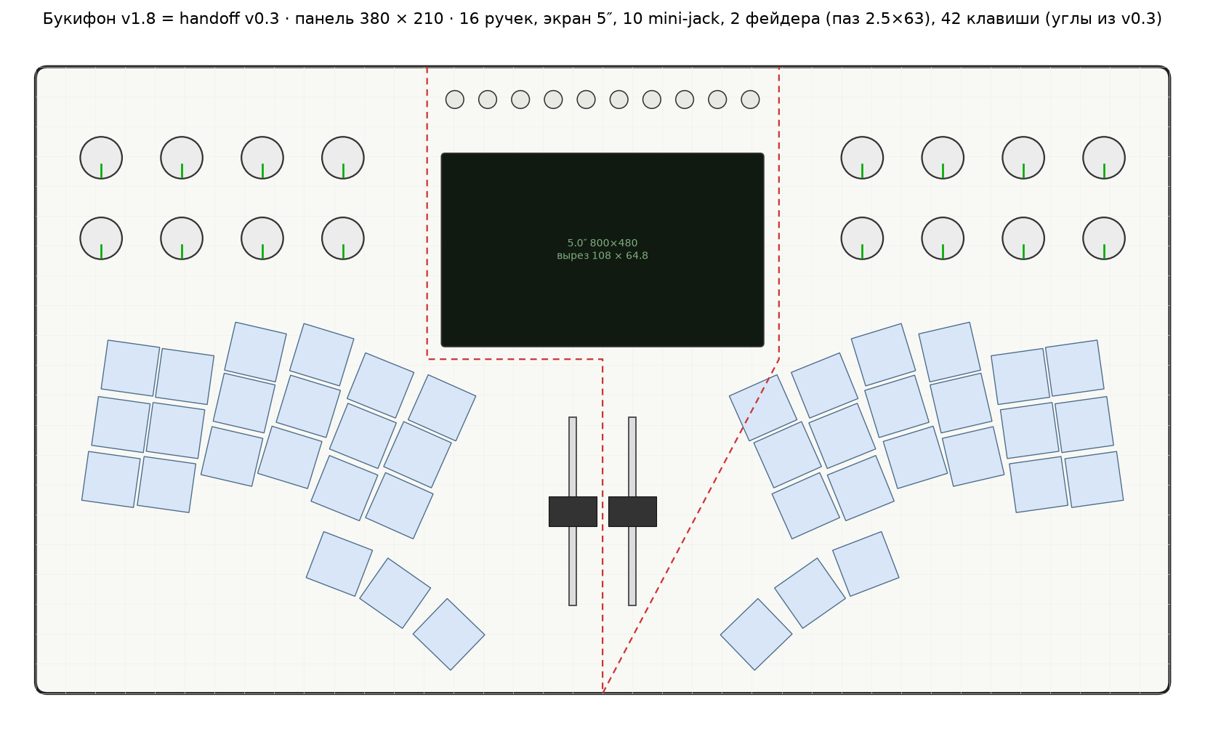
renders/templates/bukifon_v1_8_full.png
