martiyanov/bukifon/renders/templates/bukifon_v1_8_overlay.png

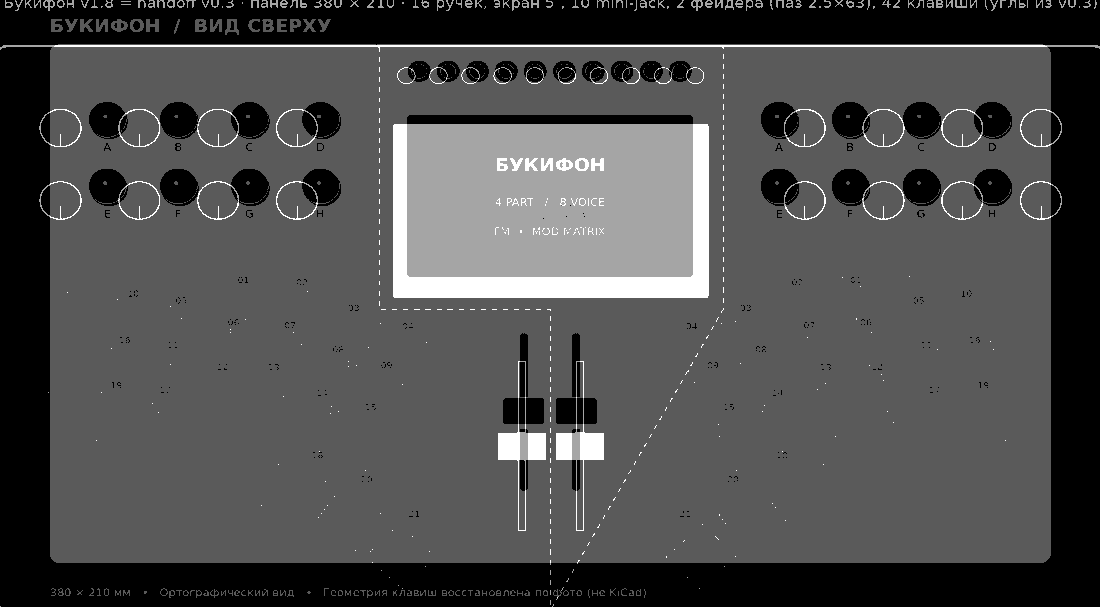
renders/templates/bukifon_v1_8_overlay.png
