martiyanov/bukifon/renders/templates/bukifon_v03_page1.png

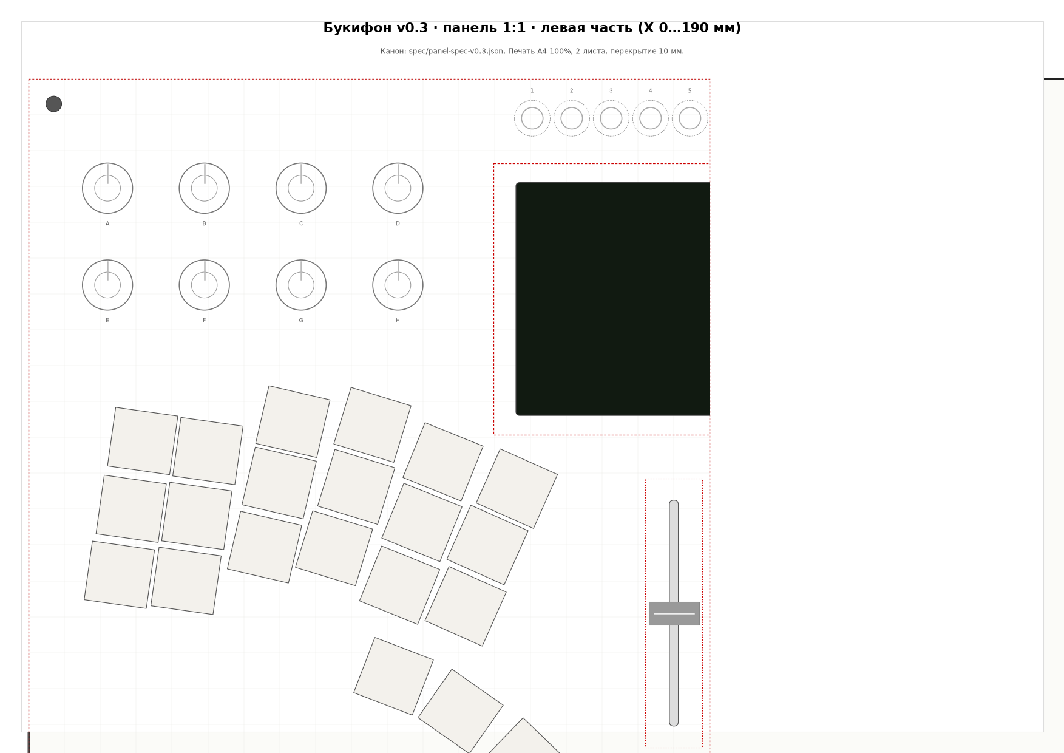
renders/templates/bukifon_v03_page1.png
