martiyanov/bukifon/renders/templates/bukifon_v03_page2.png

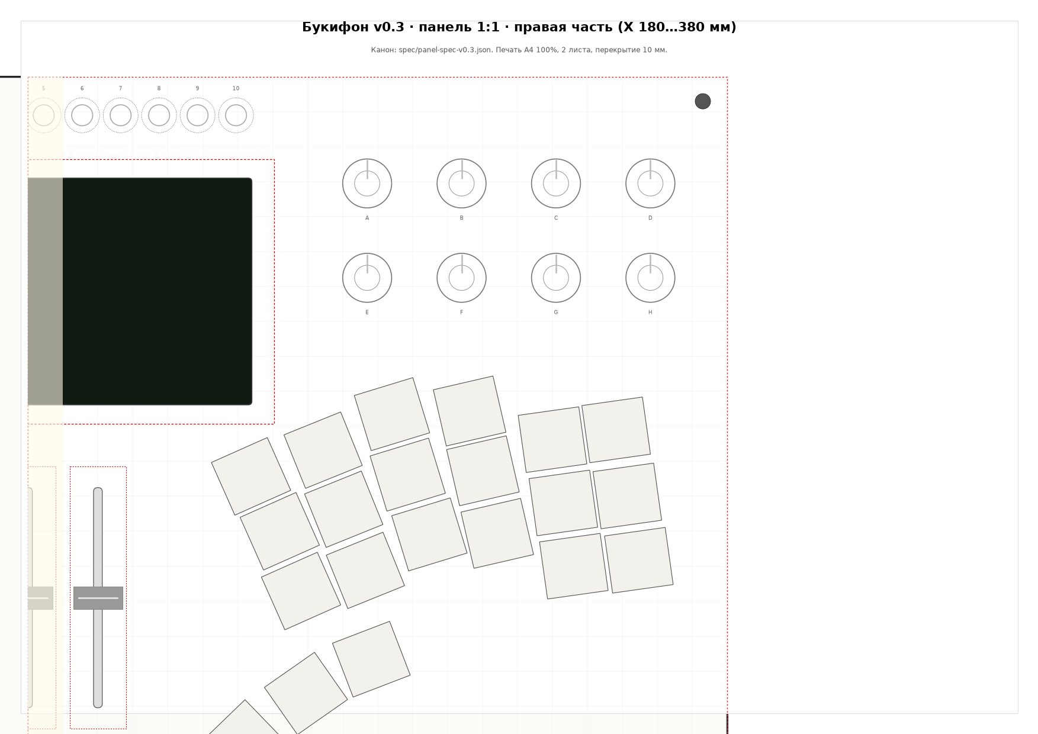
renders/templates/bukifon_v03_page2.png
