martiyanov/bukifon/renders/templates/bukifon_v03_render.png

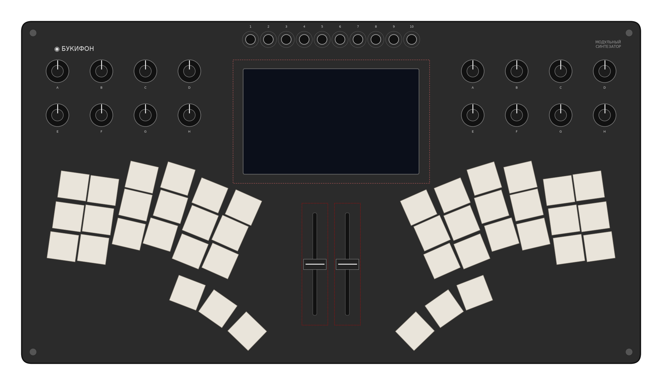
renders/templates/bukifon_v03_render.png
