martiyanov/bukifon/renders/templates/bukifon_v03_template.png

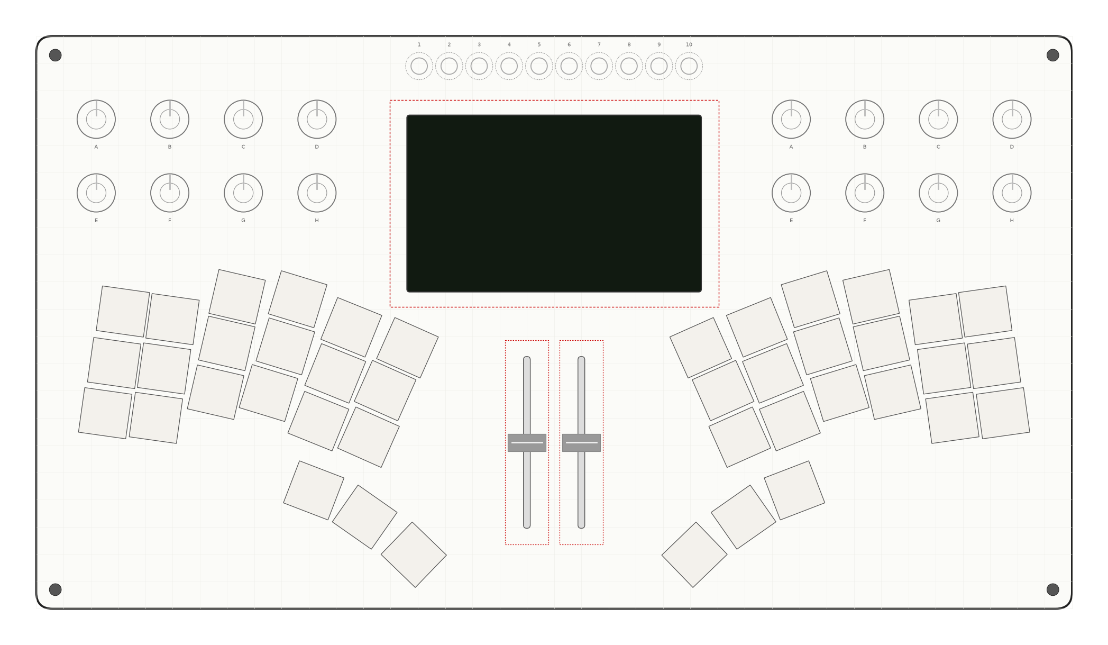
renders/templates/bukifon_v03_template.png
