martiyanov/bukifon/renders/templates/bukifon_v03_vs_concept.png

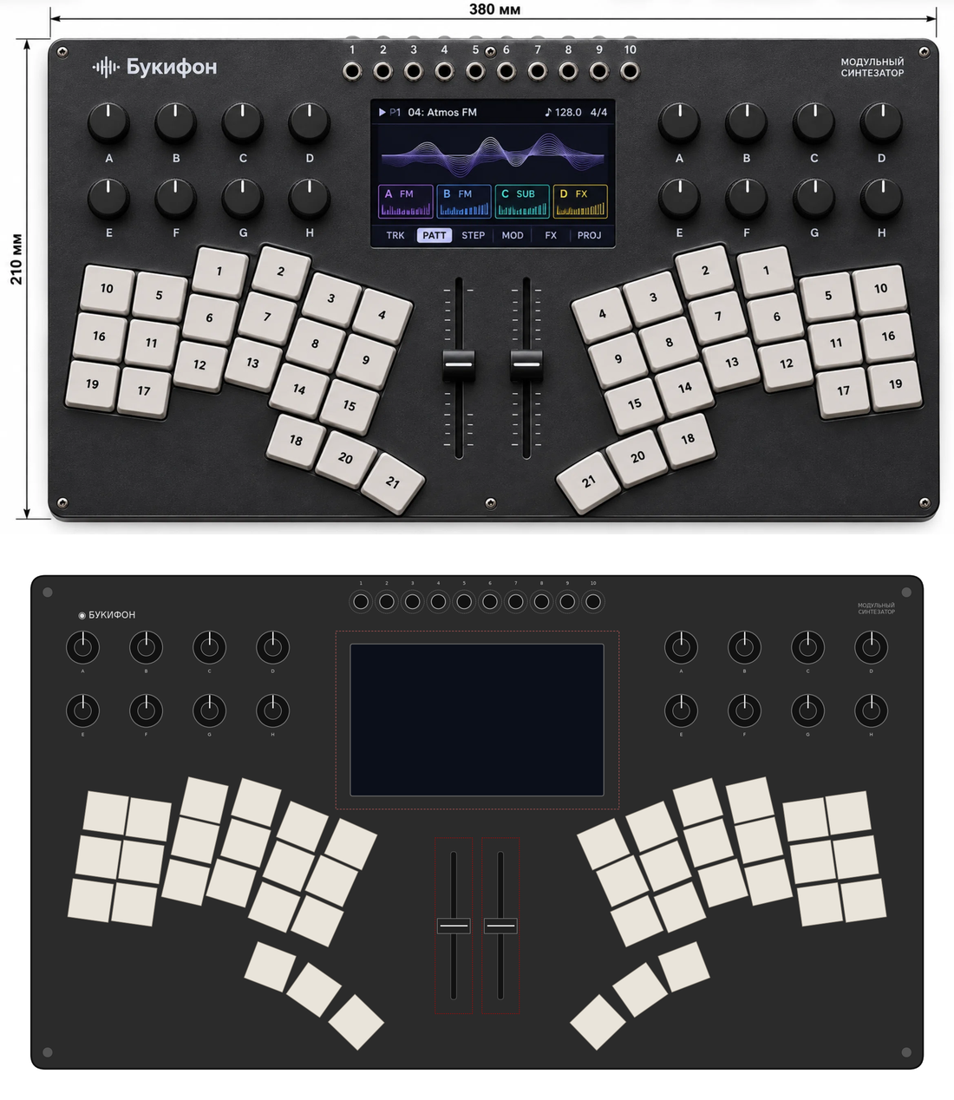
renders/templates/bukifon_v03_vs_concept.png
