martiyanov/bukifon/renders/templates/bukifon_v04_a3.png

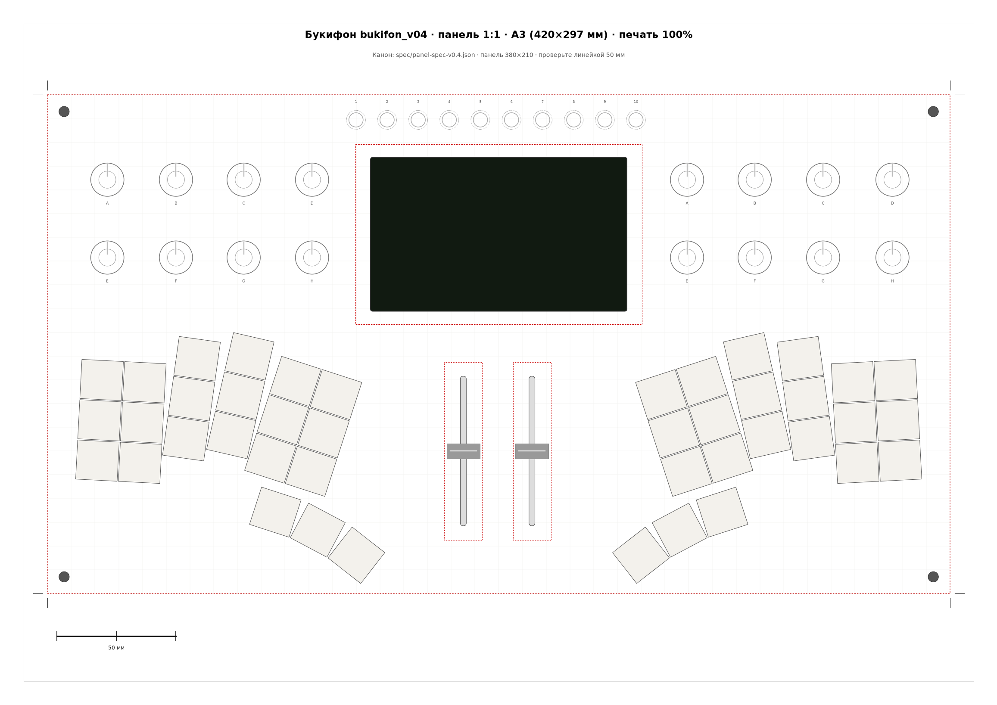
renders/templates/bukifon_v04_a3.png
