martiyanov/bukifon/renders/templates/bukifon_v04_template.png

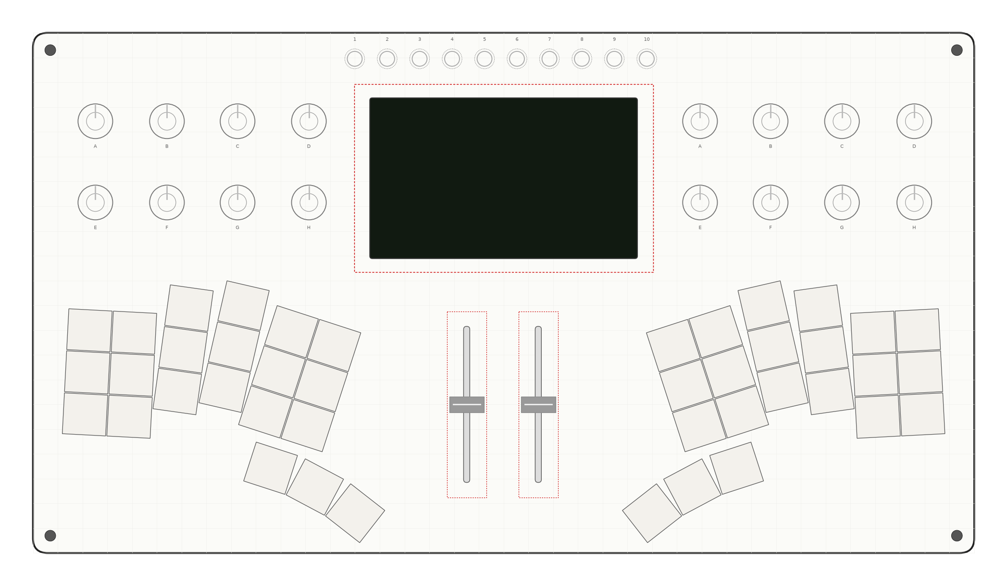
renders/templates/bukifon_v04_template.png
