martiyanov/bukifon/renders/templates/bukifon_v04_tile1.png

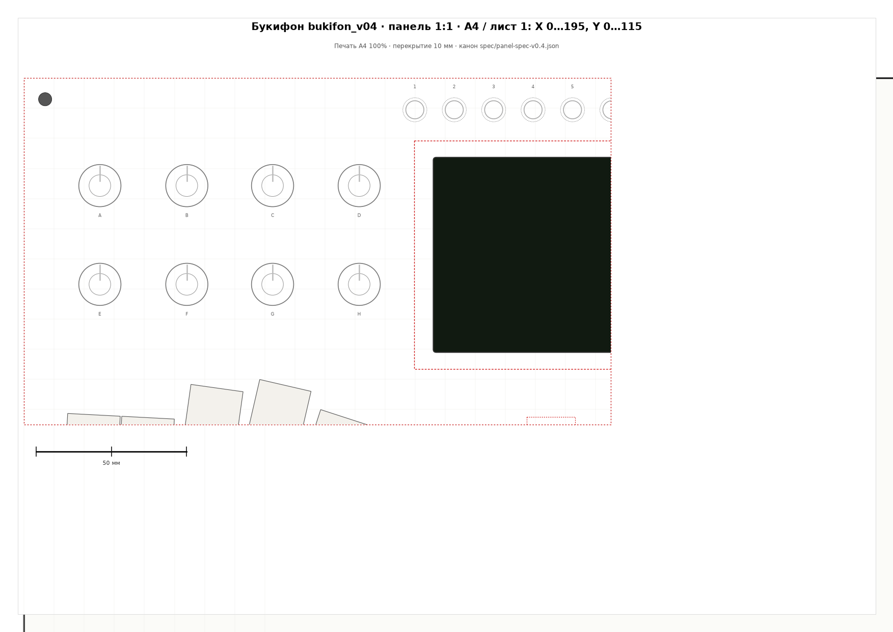
renders/templates/bukifon_v04_tile1.png
