martiyanov/bukifon/renders/templates/bukifon_v04_tile2.png

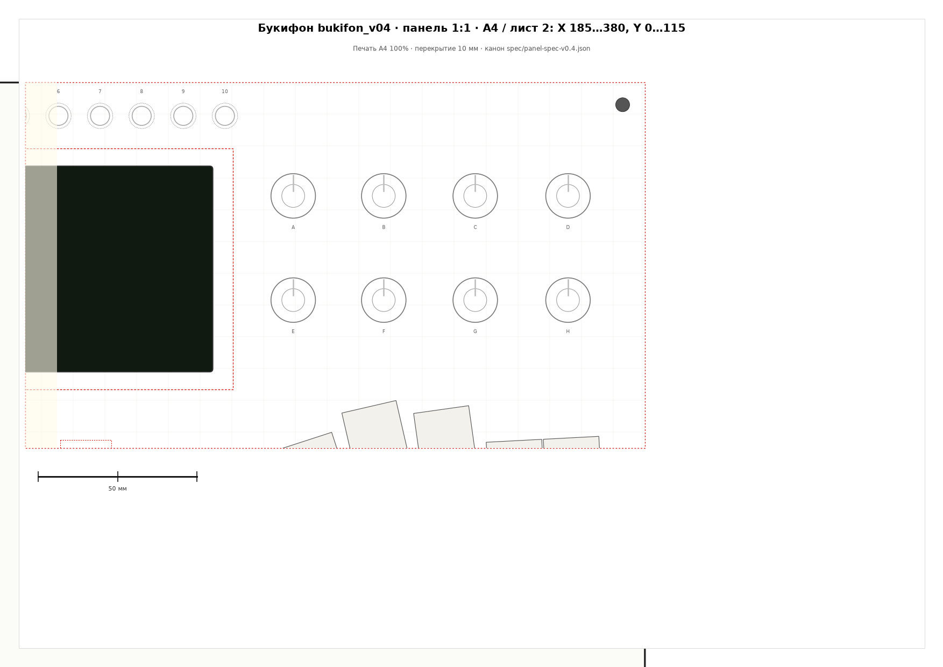
renders/templates/bukifon_v04_tile2.png
