martiyanov/bukifon/renders/templates/bukifon_v04_tile3.png

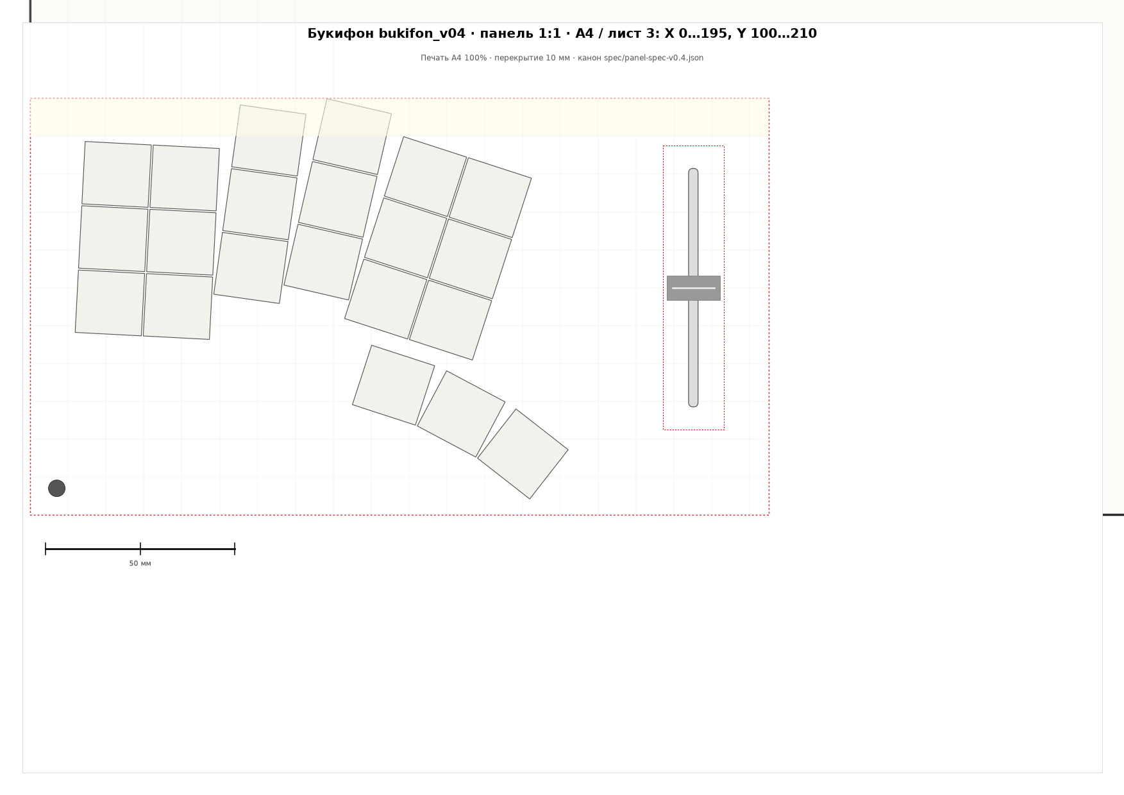
renders/templates/bukifon_v04_tile3.png
