martiyanov/bukifon/renders/templates/bukifon_v04_tile4.png

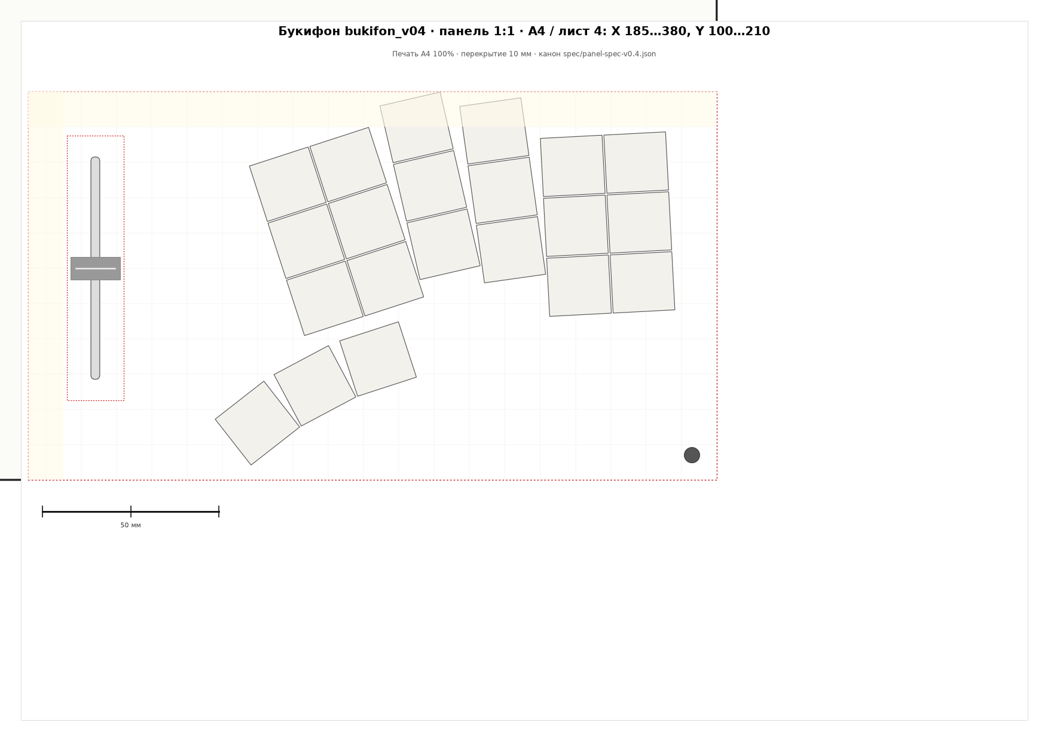
renders/templates/bukifon_v04_tile4.png
