martiyanov/bukifon/renders/templates/compare_ref_v18_v04.png

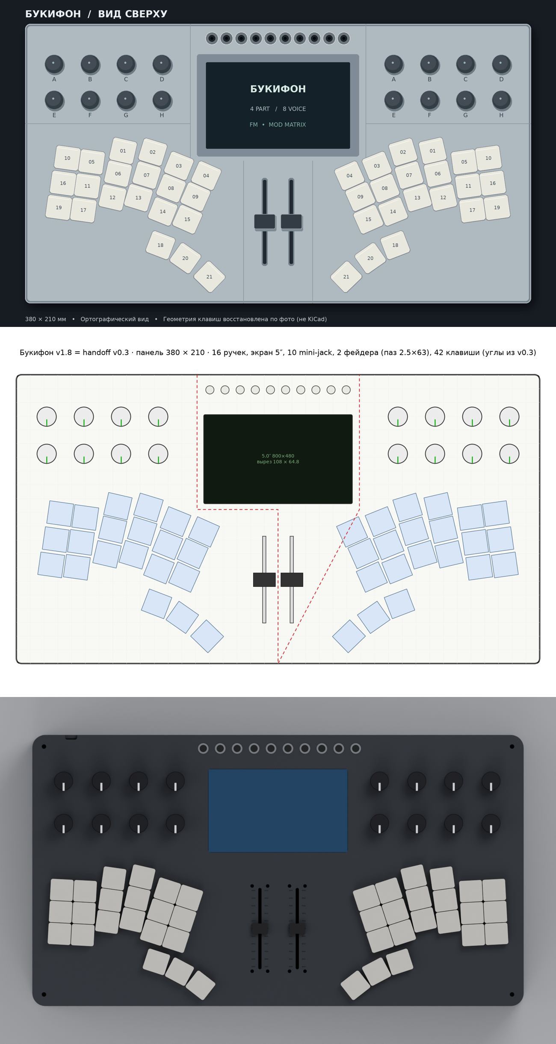
renders/templates/compare_ref_v18_v04.png
