martiyanov/bukifon/renders/templates/digitone2_top_preview.png

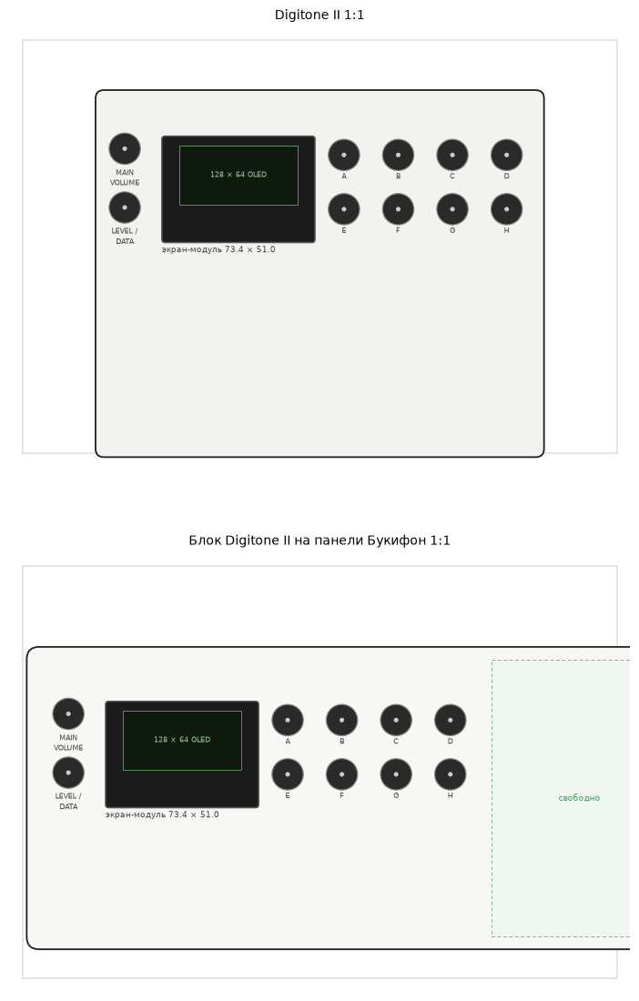
renders/templates/digitone2_top_preview.png
