martiyanov/bukifon/renders/templates/panel_preview.png

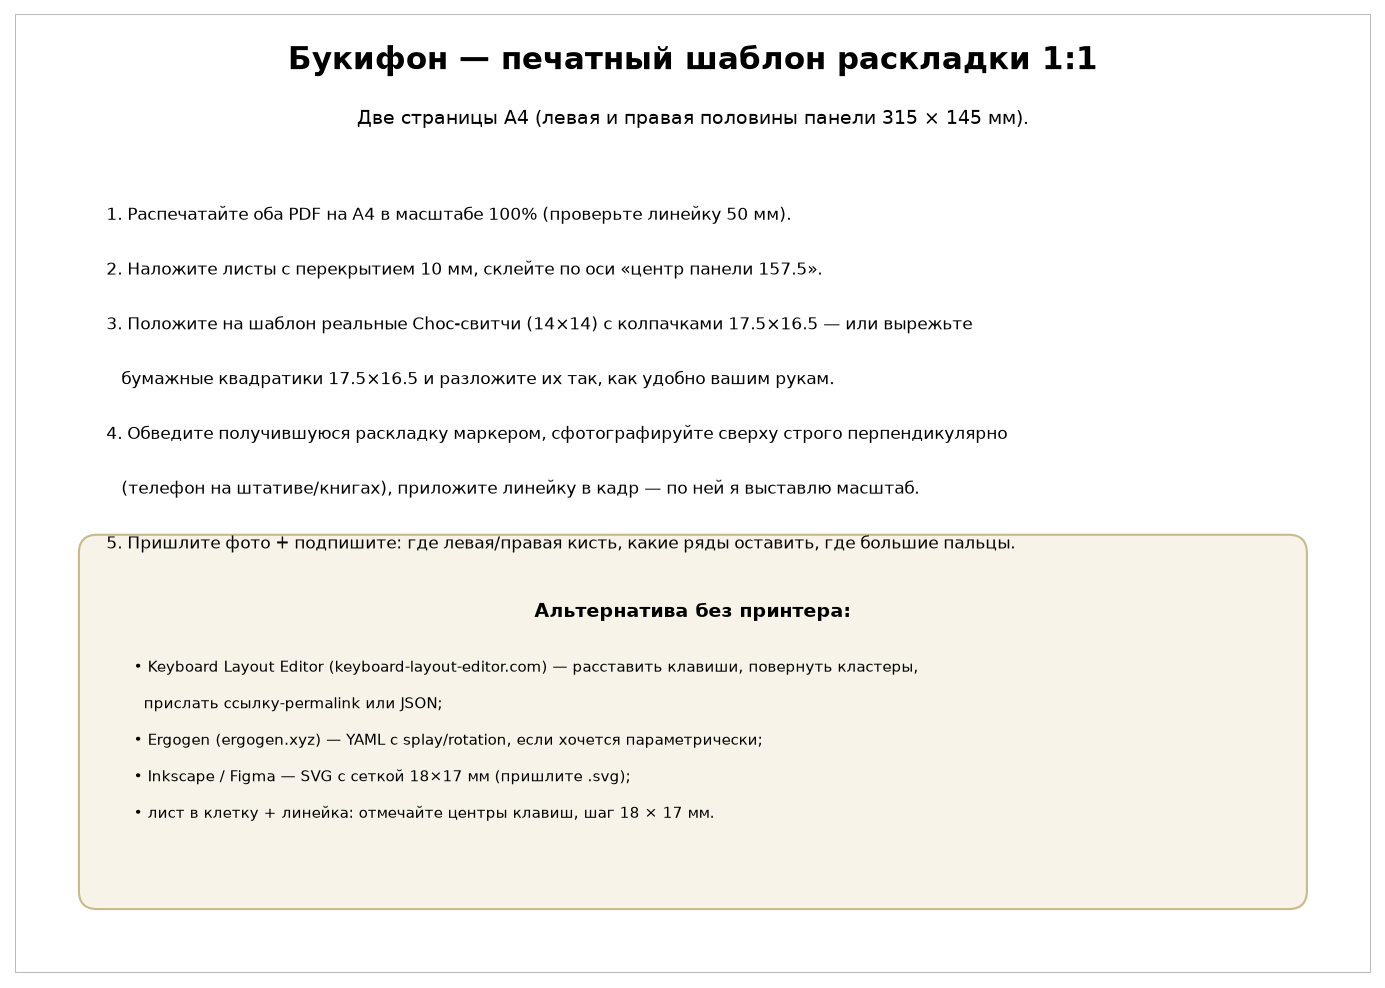
renders/templates/panel_preview.png
