martiyanov/bukifon/renders/templates/v1_7_diff_ref_vs_mine.png

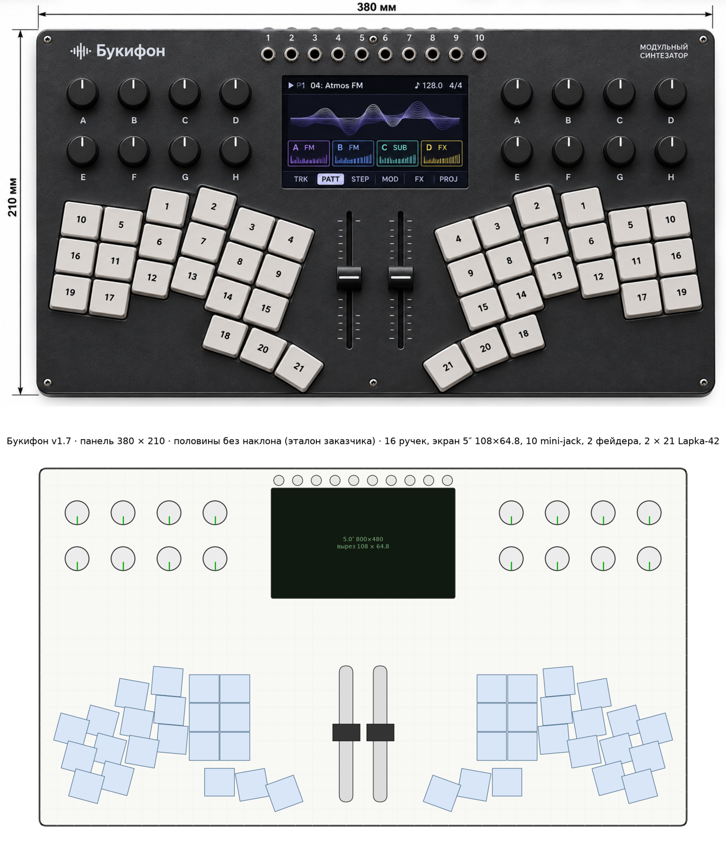
renders/templates/v1_7_diff_ref_vs_mine.png
