martiyanov/bukifon/renders/templates/v1_7_tilt_sign_AB.png

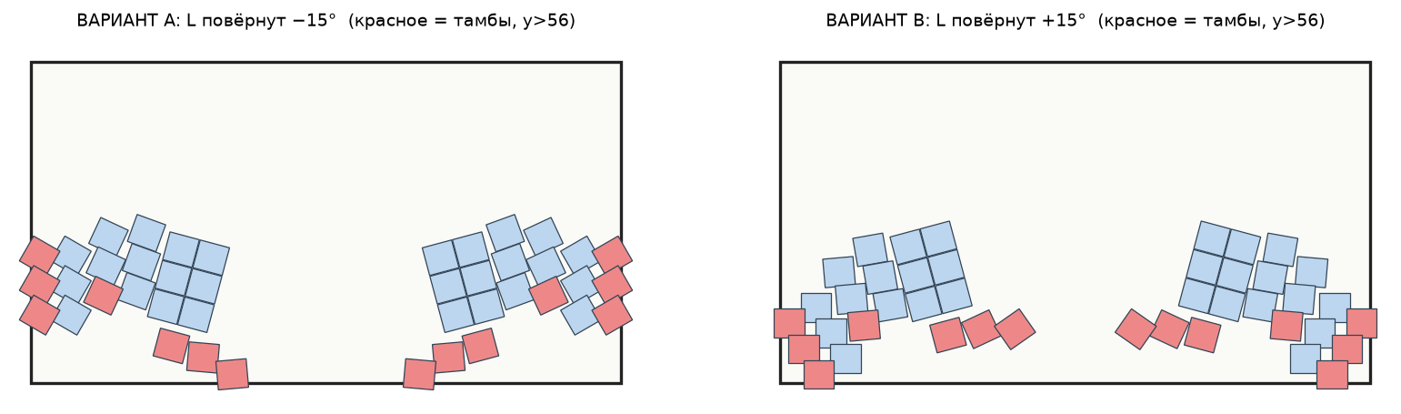
renders/templates/v1_7_tilt_sign_AB.png
