martiyanov/bukifon/renders/templates/v1_8_side_by_side.png

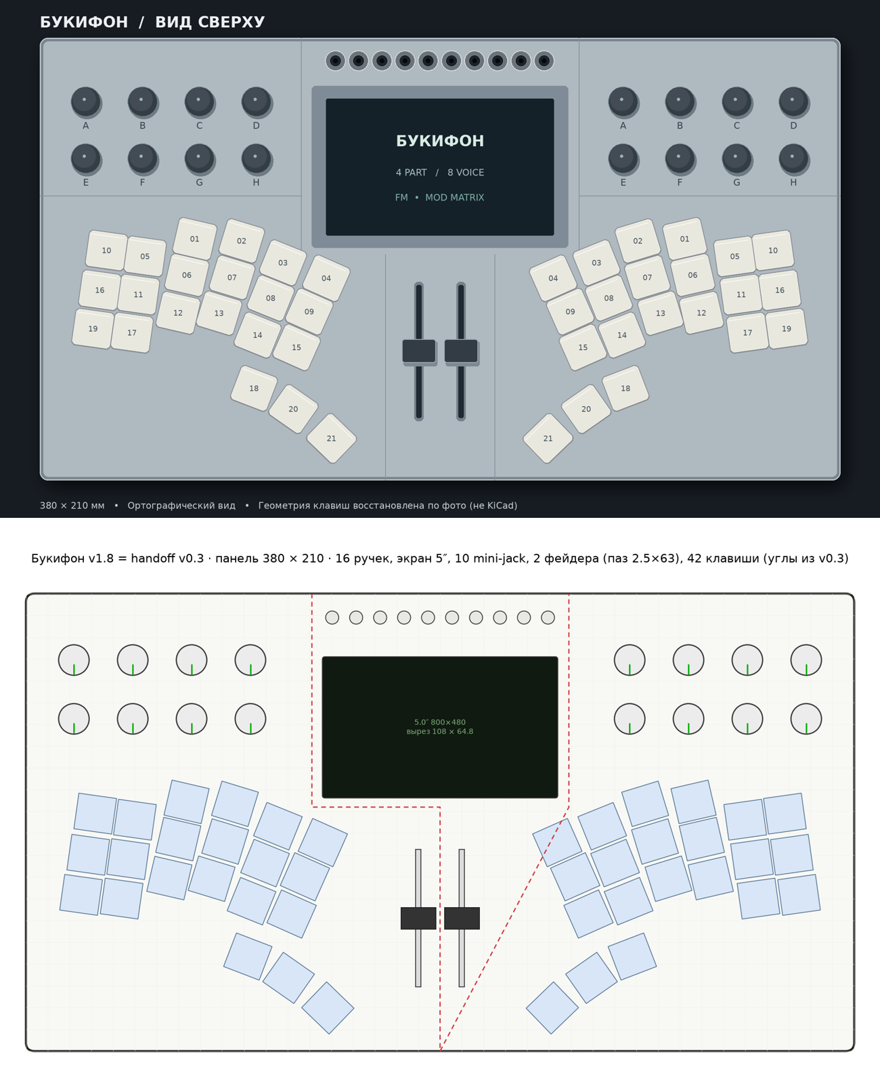
renders/templates/v1_8_side_by_side.png
