martiyanov/bukifon/renders/v1_2_deck_lapka.png

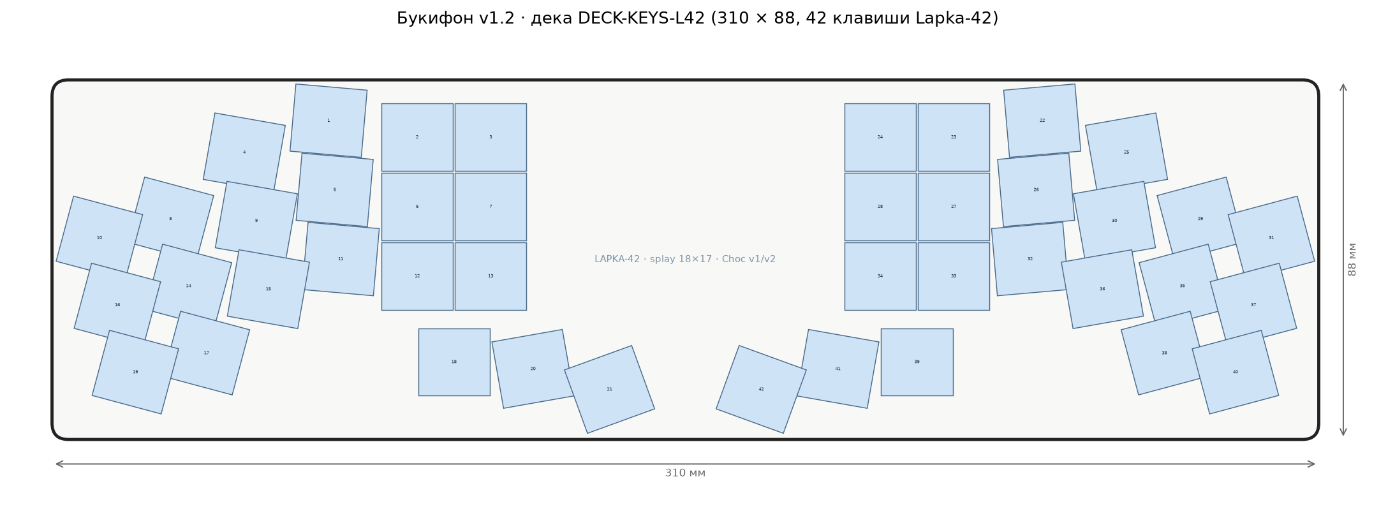
renders/v1_2_deck_lapka.png
