martiyanov/bukifon/renders/v1_2_deck_pads.png

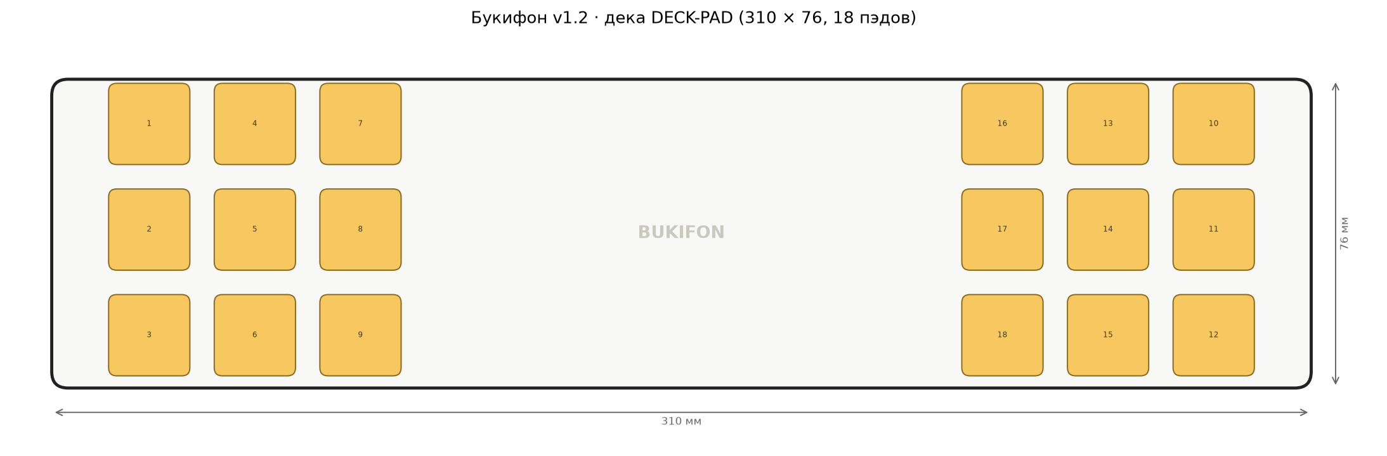
renders/v1_2_deck_pads.png
