martiyanov/bukifon/renders/v1_2_head.png

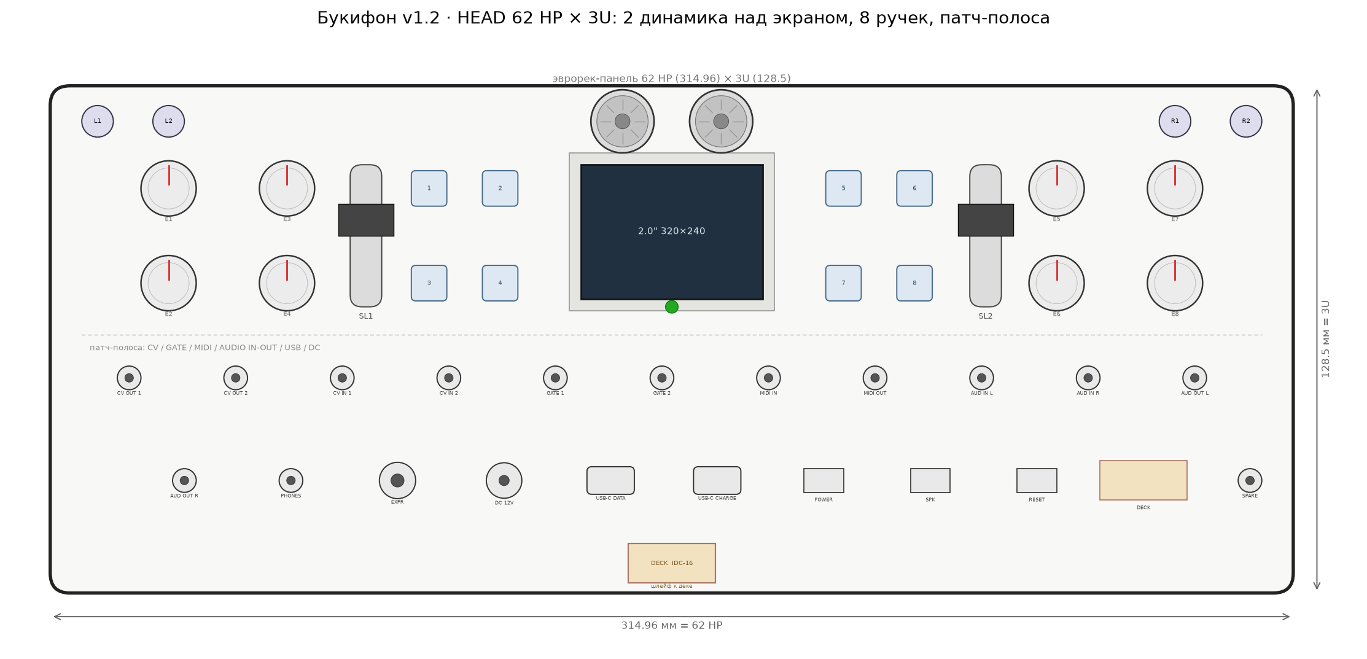
renders/v1_2_head.png
