martiyanov/bukifon/renders/v1_3_option_A.png

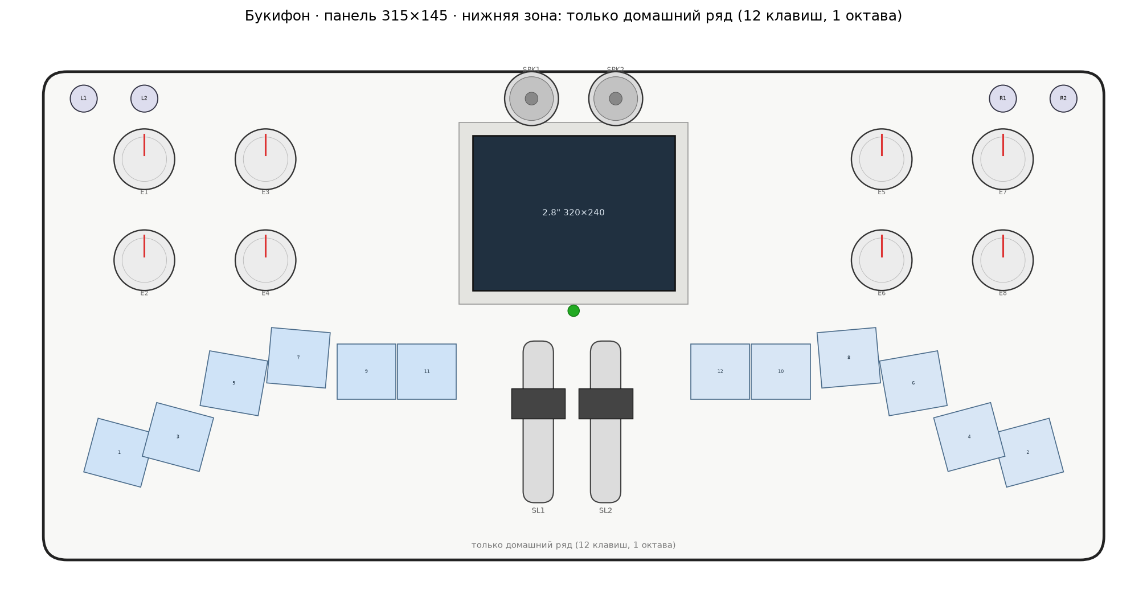
renders/v1_3_option_A.png
