martiyanov/bukifon/renders/v1_3_option_C.png

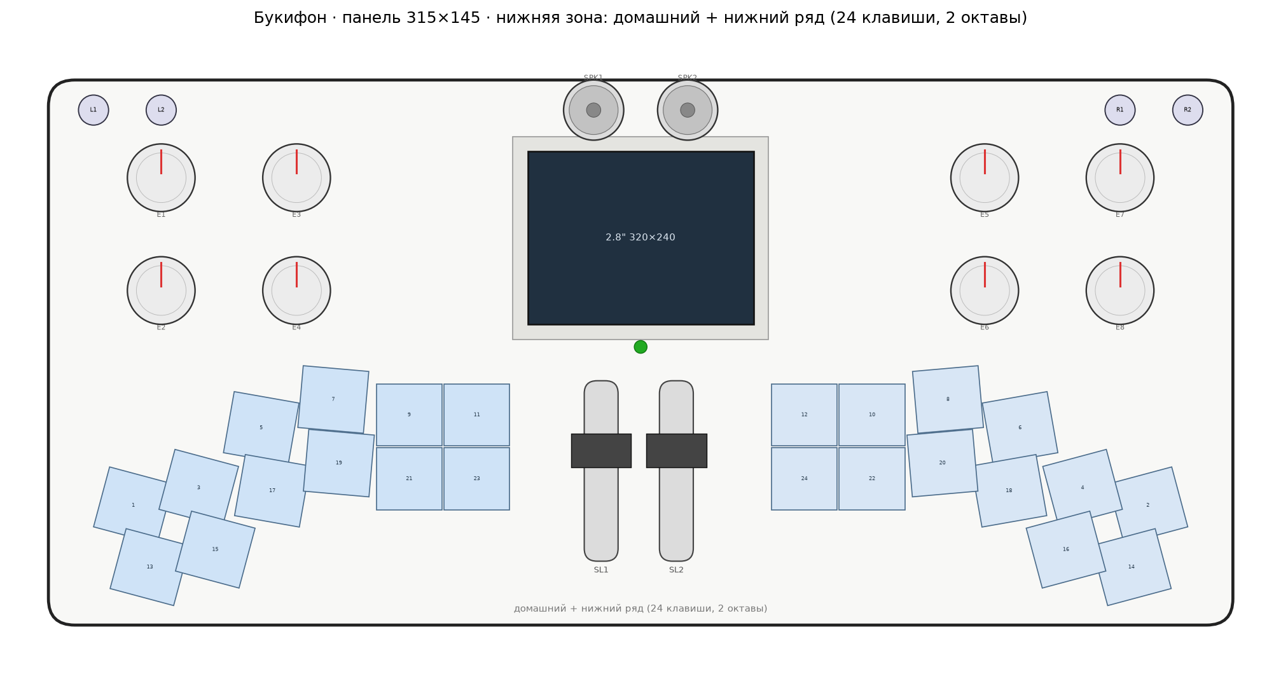
renders/v1_3_option_C.png
