martiyanov/bukifon/renders/v1_3_option_D.png

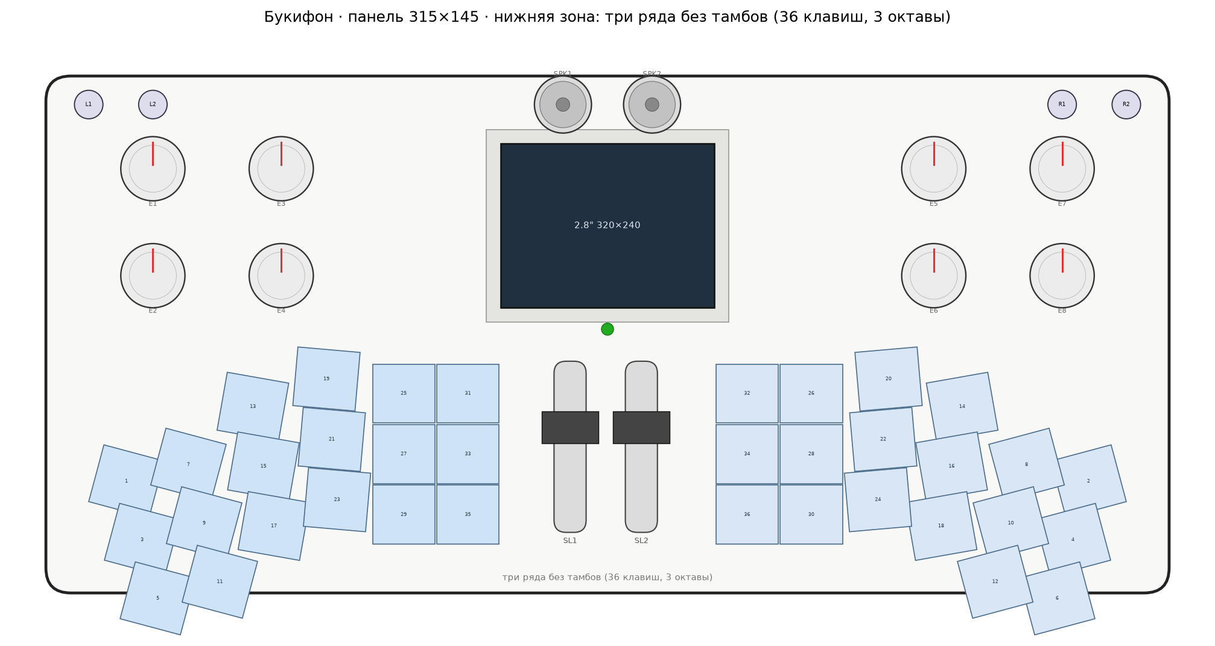
renders/v1_3_option_D.png
