martiyanov/bukifon/renders/v1_8/exploded.png

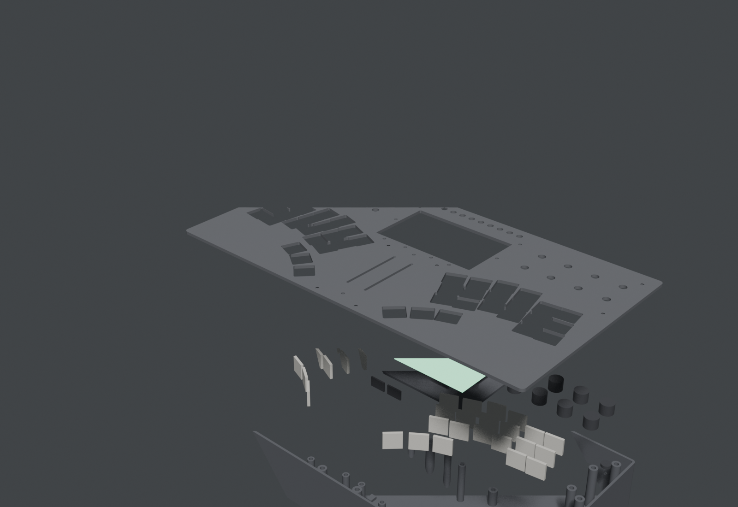
renders/v1_8/exploded.png
