martiyanov/bukifon/renders/v1_8/front.png

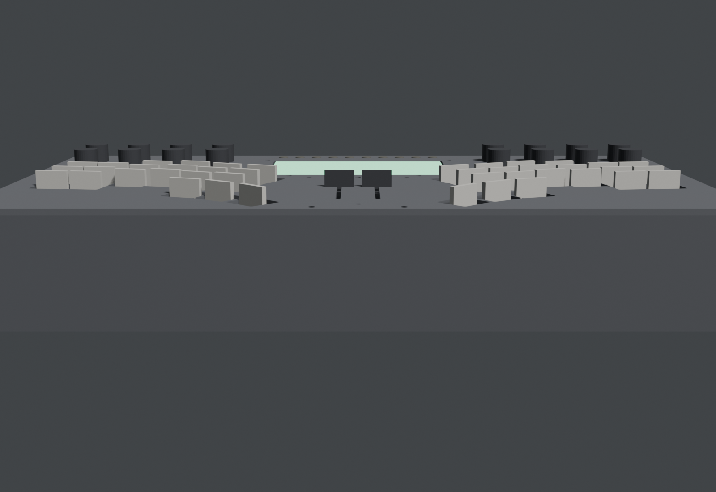
renders/v1_8/front.png
