martiyanov/bukifon/renders/v1_8/hero.png

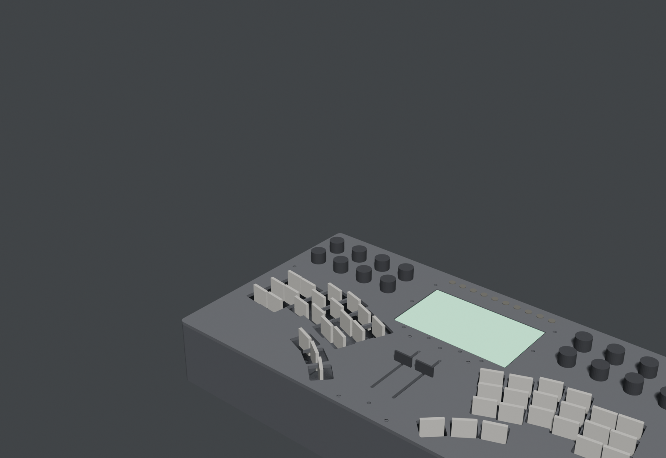
renders/v1_8/hero.png
