martiyanov/bukifon/renders/v1_8/top.png

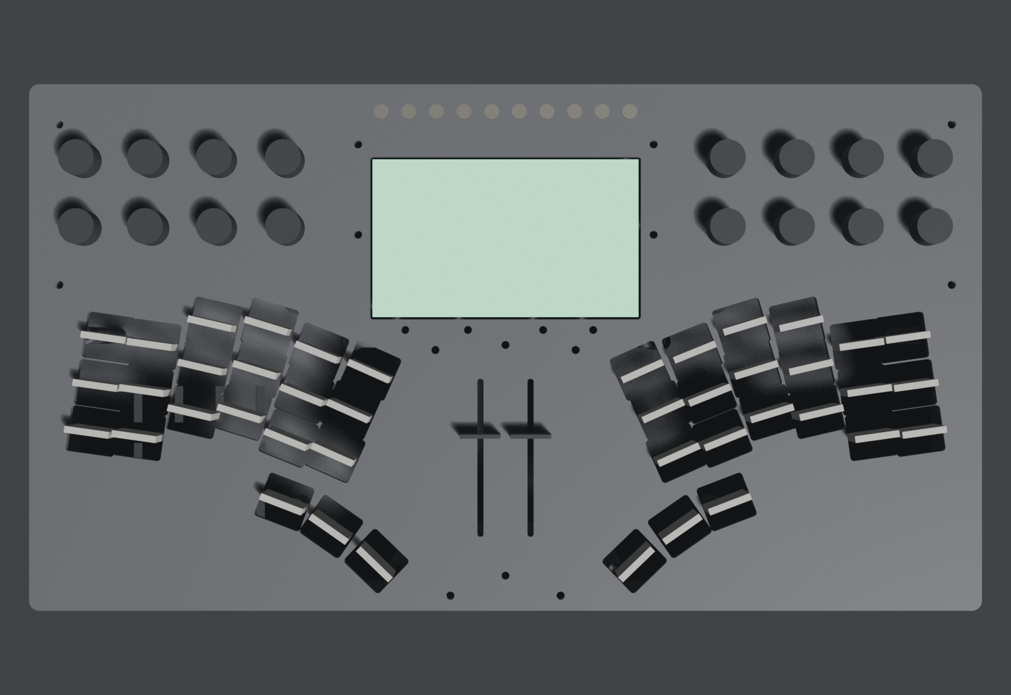
renders/v1_8/top.png
