martiyanov/bukifon/renders/variantB_panel.png

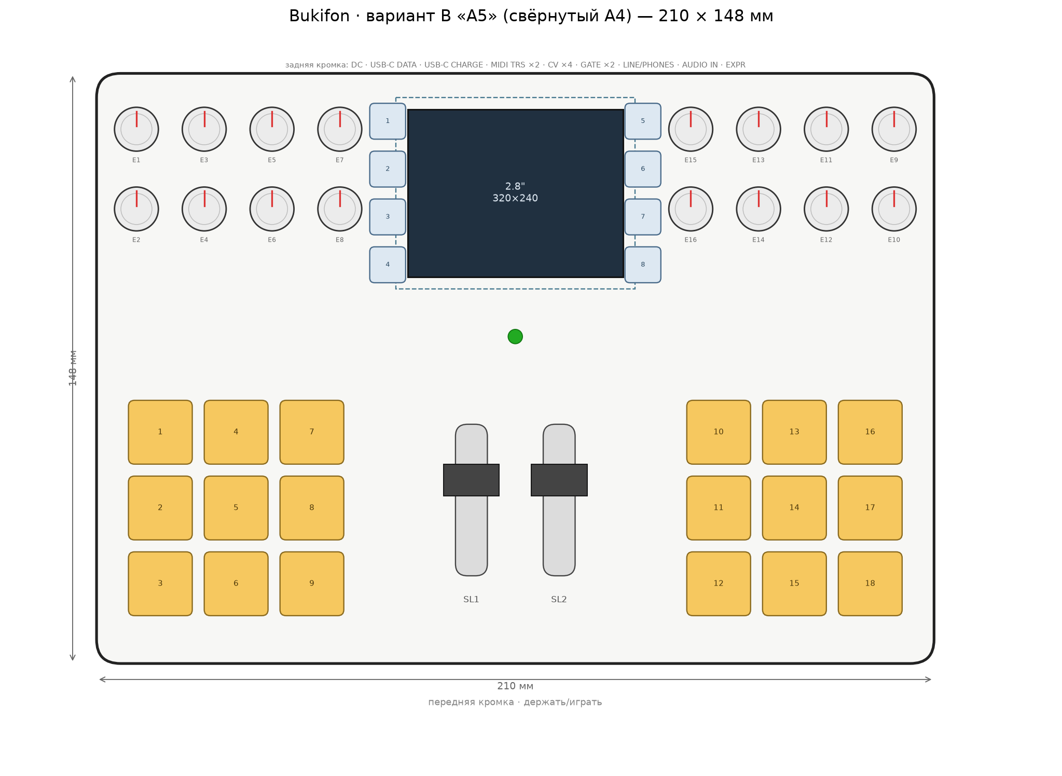
renders/variantB_panel.png
