martiyanov/bukifon/docs/33-bom-s3.md

# 33. Product BOM: P4 Standard ($299) и S3 lite

**Дата:** 2026-11-05 · **Статус: DRAFT** · **Product BOM ≠ мастерский BOM.**
Первый SKU — **P4 Standard (Complete), $299** (P4 + C6, RGB565/DSI, HS USB).
S3 — **lite later** (второй профиль). Мастерский [`BOM.csv`](../BOM.csv) — справочный
(катушки/инструмент), себестоимостью изделия **не является**.

| Файл | Назначение | Позиций |
|---|---|---:|
| [`BOM-p4.csv`](../BOM-p4.csv) | **primary:** P4 Standard, COGS на 1/10/25 шт | 87 (80 kit + 7 опций) |
| [`BOM-s3.csv`](../BOM-s3.csv) | S3 lite (SPI-дисплей, тот же корпус/панель/PWR) | 85 (78 kit + 7 опций) |
| [`BOM.csv`](../BOM.csv) | мастерский/workshop, не product | 92 |

Формат: `;`, UTF-8 BOM, колонки `BOM.csv` + `цена 10+`, `итого 10 шт`, `цена 25+`,
`итого 25 шт`. Курс — **80 ₽/$** (план; закупка в ₽). Все цены — **draft ±30%**.

---

## 1. P4 Standard (Complete) — COGS и состав

### Итоги

| Показатель | 1 шт | Партия 10 | Партия 25 |
|---|---:|---:|---:|
| **COGS, ₽** | **19 240** | **17 187 ₽/шт** | **15 648 ₽/шт** |
| **COGS, $** | **≈ $241** | **≈ $215** | **≈ $196** |
| Платы (3 шт: CORE-2, PANEL-2, PWR-2) | 1 100 ₽ | 780 ₽ | 600 ₽ |
| Опции (все сразу) | +11 050 ₽ ≈ $138 | — | — |

### По блокам (₽/изделие)

| Блок | 1 шт | 10 шт | 25 шт | Позиций |
|---|---:|---:|---:|---:|
| CORE-2 rev.3 (P4+C6, аудио, CV, память, микрофон/voice) | 7 091 | 6 531 | 6 059 | 32 |
| PANEL-2 rev.3 (16 EC11, 42 Choc, 4×MCP23017, фейдеры, 10 джеков, MEMS-микрофон) | 7 153 | 6 099 | 5 415 | 22 |
| PWR-2 rev.1 (TPS61088×2, LMR33630, BMS, fuel gauge) | 2 266 | 1 990 | 1 770 | 18 |
| Дисплей RGB 5″ 800×480 (FPC-40, TFT-H050A1SVIST4R40) | 1 500 | 1 400 | 1 300 | 1 |
| Корпус B-light (230 г PETG) + колпачки/ручки + крепёж + шлейфы + mic-детали | 1 230 | 1 167 | 1 104 | 6 |
| **Итого kit** | **19 240** | **17 187** | **15 648** | **80** |

### Маржа P4

Выручка: $299 = 23 920 ₽; $349 = 27 920 ₽; $399 = 31 920 ₽.

| Цена | COGS (партия 10) | Gross, ₽ | Gross, % | Net после 10 % (логистика/упаковка/платёжка) |
|---|---:|---:|---:|---:|
| **$299** | 17 187 | 6 733 | 28.1 % | 4 341 ₽ (18.1 %) |
| **$349** | 17 187 | 10 733 | 38.4 % | 7 941 ₽ (28.4 %) |
| **$399 Full Bundle** (kit + картриджи + DECK-PAD + премиум-колпачки: COGS 24 487) | 24 487 | 7 433 | 23.3 % | 4 241 ₽ (13.3 %) |

Вывод: **$299 жизнеспособен уже на партии 10** (net ≈18 %), при партии 25 — ≈25 %.
$299 — основная цена; $399 — bundle с картриджами/декой, не «всё сразу».

### rev.3: микрофон/voice (mic node)

Добавлено в **PANEL-2 rev.3** и **CORE-2 rev.3** (сверено с `hardware/panel2/BOM-panel2.csv`
и `hardware/core2/BOM-core2.csv`; протокол — [`docs/71-mic-voice.md`](71-mic-voice.md)):

| Узел | Состав | Итого, ₽ |
|---|---|---:|
| PANEL-2 rev.3 | ICS-43434 (I2S MEMS) 320; J16 IDC-6 + шлейф 160; SW1 SS-12D00 mute 40; LED MIC ON + R121 16; FB1 600Ω 24; SRV05-4 40; MIC passives (33R×3, 10u, 100n) 40 | **640** |
| CORE-2 rev.3 | MAX9814 (TDFN-14) 200; TS5A23157 (line/mic) 96; J20 3.5 мм TRS 120; ESD (D30 SMAJ5.0A + 2× USBLC6-2) 64; MIC passives/биас (R106 2.2k, R107 150k, R108 100k, R110/R113 100k, C122–C128) 120; J19 IDC-6 + FB8 80 | **680** |
| Механика | печать `mic_guide`/`mic_clip_rear`/`mic_holder_top` ≈1.4 г — 5; сетка/поролон — 80 | **85** |
| | **Mic node, 1 шт** | **1 405 ₽ ≈ $17.6** |

На партиях: **1 334 ₽** (10 шт) / **1 264 ₽** (25 шт). COGS с микрофоном:
P4 — **19 240 / 17 187 / 15 648 ₽** (+$17.6 / +$16.7 / +$15.8 к прежним $223/$198/$180);
S3 lite — **17 897 / 15 920 / 14 458 ₽** (тот же mic-node).

При rev.3 **сняты/DNP**: R25/R26/C52, R32–R34 — на COGS не влияют (отражено строкой
`C-2-32` в `BOM-p4.csv`). Оценки цен mic-node — **±30 %** (Mouser/LCSC/LCSC-партии).

---

## 2. Что входит в P4 Standard (Complete) и что опция

**Входит (kit, 80 позиций):** CORE-2 rev.3 (ESP32-P4NRW32 + 32 МБ PSRAM, ESP32-C6-MINI-1,
PCM5102A + PCM1808, 2×MCP4728, MCP3208, 24LC32A, 6N137/74HCT125, BQ24074, MP1584,
2×AP2112K, MT3608 подсветки, USB-C, FFC-40, IDC-26×3/16/20/12, microSD-слот, 7 задних
джеков), PANEL-2 rev.3 (16 EC11, 42×Choc+hot-swap+1N4148, 4×MCP23017, 2 фейдера,
10 mini-jack, 17×WS2812, **ICS-43434 MEMS**), PWR-2 rev.1, **RGB 5″ 800×480 FPC-40**,
**микрофонный узел** (MAX9814 + TS5A23157 + J19/J16 + J20 TRS + mute/LED), корпус B-light
(230 г PETG) + печатные колпачки/ручки + mic-детали + крепёж + шлейфы.

**Опции (вне $299):** аккумуляторный пак 1S2P+NTC 1 500 ₽ (D-56: первая партия без
батареи), внешний БП 12 В 2 А 600 ₽, microSD 32 ГБ 650 ₽, картриджи 4 шт 3 200 ₽,
DECK-PAD 2 600 ₽, премиум-колпачки MBK 1 500 ₽, USB-C кабель + сумка 1 000 ₽.

---

## 3. S3 lite (второй профиль, «на будущее»)

| Показатель | 1 шт | Партия 10 | Партия 25 |
|---|---:|---:|---:|
| COGS, ₽ | **17 897** | **15 920** | **14 458** |
| COGS, $ (80 ₽/$) | **≈ $224** | **≈ $199** | **≈ $181** |

Отличия от P4: ESP32-S3-WROOM-1-N16R8 вместо P4+C6; **SPI-дисплей 5″** вместо RGB565
(D-51); USB FS (stereo UAC2 + MIDI + HID, без 8×8 HS); меньше запаса по голосам/эффектам;
TPS63802 (D-49); BOM 78 kit-позиций (mic/rev.3 включён). Панель, PWR-2, корпус и органы управления — те же.
Позиционирование: $249–269 Complete (см. [`docs/40-kit-contents.md`](40-kit-contents.md)),
lite-вариант первого релиза. Продажа — только после P4 Standard.

---

## 4. Дисплеи: RGB (P4, основной) и SPI (S3 lite)

| | **RGB 5″ 800×480 (P4)** | **SPI 5″ 800×480 (S3 lite)** |
|---|---|---|
| Интерфейс | RGB565 16 бит, FPC-40, +PCLK/DE/HS/VS, BL_PWM/BL_20V | SPI 4-wire (SCK/MOSI/CS/DC/RST/BL), FPC-40 |
| FPS | ≥15 full / ≥30 partial (dirty rect) | ~12–15 full / 10–20 partial |
| Цена (draft) | 1 500 ₽ ≈ $19 (1 шт) / 1 400 / 1 300 | 1 800 / 1 700 / 1 600 |
| MPN/варианты | **TFT-H050A1SVIST4R40 (ST7262, 40-pin)** — primary; резерв NHD-5.0-800480AF-ASXP, EJ050NA-01G (50-pin); DSI — rev.3 (docs/47) | ER-TFTMC050-3 (RA8875/SPI), ILI9488/ST7796S; 40-pin |
| Риск | **pinout/timing/contact side** — 2–3 образца + NHD-эталон (O-15 закрыт, docs/47) | тот же риск; для lite допустимо |

**O-19 закрыт в product BOM:** дисплей — отдельной строкой в `BOM-p4.csv` (RGB, D-01,
MPN TFT-H050A1SVIST4R40) и `BOM-s3.csv` (SPI, D-01, ER-TFTMC050-3); выбор —
[`docs/47-display-selection.md`](47-display-selection.md). Для P4 BL-драйвер уже в CORE-2 (MT3608),
отдельной product-строки не требует.

---

## 5. BOM-хвосты O-17/O-18 (синк с hw-core)

- **O-17 (TL074/TL072):** в `hardware/cores3/BOM-cores3.csv` было `TL074 qty=20`
  и `TL072 qty=3` с дублирующимися позициями (`U37 U37 …`, `U33 U33 U33`).
  По netlist CORE-S3 реально: **TL074 = 4** (U37, U38, U39, U45), **TL072 = 1** (U33)
  → исправлено в `BOM-s3.csv`. В BOM-cores3 на дату — ещё не поправлено (зона hw-core);
  в product BOM считаем по netlist.
- **O-18 (TPS63802):** `TPS63000` placeholder заменён в `BOM-s3.csv` на
  **TPS63802 (fallback TPS63020)** (D-49). CORE-2 использует MP1584 3.3 В (P4) —
  отдельного TPS там нет.
- **O-19:** см. §4 — закрыт.

---

## 6. Отличия product BOM от мастерского `BOM.csv`

| Параметр | `BOM.csv` (workshop) | `BOM-p4.csv` / `BOM-s3.csv` |
|---|---|---|
| Назначение | «всё для мастерской» | себестоимость 1 изделия |
| Позиций | 92 | 71 (P4) / 69 (S3) |
| Пластик | катушки PETG/PLA/TPU | факт B-light 230 г PETG + 100 г PLA |
| Платы | 5+6 конструкций × 5 | 3 платы (CORE/PANEL/PWR) |
| MCU | P4 и S3 | P4 primary; S3 — lite |
| Батарея/БП/microSD/картриджи/дека | в базе | опции (D-39/D-56) |
| Инструмент/расходники | браслет, флюс, припой | исключены |

---

## 7. Риски

| Риск | Влияние | Что делать |
|---|---|---|
| **P4-модуль не выбран** (O-18) | цена/сроки CORE-2, J-MCU | P1-стенд → модуль/адаптер; fallback EV-board $55–70 (только dev) |
| **TFT RGB MPN (O-15/O-19)** | pinout/timing, 40 vs 50-pin | фиксировать MPN, batch 20–50, FPC-адаптер, 2–3 образца |
| TPS61088 / LMR33630 | перемаркировка/дефицит | TI/официальный канал; проверка ripple/тепла |
| EC11 / Choc / фейдеры | главный дефицит и цена | RFQ 2–3 поставщика, запас 10 % |
| PWR-2 rev.1 | 1S/рельсы до P1-бенчмарка | заказ PCB после DRC и P1; DNP-список D-34 |
| PCB 4 слоя CORE-2 | цена ±30 % | панелизация партии 10–25 |

---

## 8. Сверка с BOM плат

Источники: [`hardware/core2/BOM-core2.csv`](../hardware/core2/BOM-core2.csv) (241 строка,
40 DNP), [`hardware/panel2/BOM-panel2.csv`](../hardware/panel2/BOM-panel2.csv) (28),
[`hardware/power2/BOM-power2.csv`](../hardware/power2/BOM-power2.csv) (128).
Правила: пассив агрегирован по классу/корпусу; ИС/разъёмы — отдельными строками по MPN;
DNP-позиции CORE-2 rev.3 исключены (рельсы — с PWR-2, D-32/D-34); добавлены PCB, корпус,
печатные колпачки/ручки, крепёж, шлейфы, дисплей; задние джеки CORE-2 — отдельной строкой
(10 джеков PANEL-2 — CV/GATE).

---

## 9. Что завтра

1. Зафиксировать **MPN P4-модуля** и **RGB 5″ FPC-40** (2–3 образца, адаптер).
2. RFQ: EC11 100+, Choc 200+, PCB 10/25, TFT batch 20–50; заменить оценки.
3. Поправить `BOM-cores3.csv` (O-17) на стороне hw-core и пересинхронизировать S3.
4. Уточнить упаковку/логистику (docs/40) — после первой физической упаковки.
5. P4 Standard COGS target для $299: ≤ $230 landed (сейчас $176–219 без landed).

---

## 10. Ссылки

[`BOM-p4.csv`](../BOM-p4.csv) · [`BOM-s3.csv`](../BOM-s3.csv) · [`BOM.csv`](../BOM.csv) ·
[`docs/40-kit-contents.md`](40-kit-contents.md) · [`docs/27-costdown.md`](27-costdown.md) ·
[`docs/29-p1-order.md`](29-p1-order.md) · [`docs/36-rc-definition.md`](36-rc-definition.md) ·
[`docs/37-compliance.md`](37-compliance.md) · [`spec/90-requirements-registry.md`](../spec/90-requirements-registry.md)
(D-38…D-57, O-15/O-17/O-18/O-19) · [`mechanical/prints.md`](../mechanical/prints.md).
