martiyanov/bukifon/docs/54-shopping-list.md

# 54. Единый закупочный лист (P1 + PWR + LCD-адаптер + печать)

**Дата:** 2026-11-06 · **Статус: DRAFT** · **Курс:** 80 ₽/$ (план; оплата в валюте магазина)
**Цель:** оформить все закупки **до PCB** за один заход, чтобы не платить доставку 4 раза.
**Заказ делает владелец проекта** (доступ к оплате/доставке) — здесь только состав, цены
и порядок. Оценки ±30 % помечены; точные цены — по ссылкам.

Источники/сверка: [`docs/29`](29-p1-order.md) (P1), [`docs/44`](44-pwr-bench.md) +
[`bench-bom.csv`](../hardware/power2/bench-bom.csv) (PWR), [`docs/47`](47-display-selection.md)
(дисплей), [`docs/49`](49-lcd-adapter.md) + [`BOM-lcd-adapter.csv`](../hardware/panel2/adapter-lcd/BOM-lcd-adapter.csv)
(LCD-адаптер), [`docs/45`](45-case-variants.md)/[`prints.md`](../mechanical/prints.md) (печать).

---

## Сводка

| Группа | Что | $ | ₽ | Что блокирует | Приоритет |
|---|---|---:|---:|---|---|
| **A** | P1-стенд: MCU/аудио/дисплеи/приборы/**mic/voice** | **442.4** | **35 392** | фиксацию MCU (P1), старт P2 | **P0** |
| **B** | PWR-стенд: EVM вариант A + база | **276.92** | **22 154** | заказ PCB (критпуть PWR-2) | **P0** |
| **C** | LCD-адаптер: 2 платы + ZIF/FFC/панели | **72.8** | **5 824** | проверку экрана до PCB (O-15) | P1 |
| **D** | Печать/материалы (PETG/PLA/крепёж) | **42** | **3 360** | физическую сборку корпуса | P2 |
| **E** | Для домашнего ПК | **0** | **0** | — | — |
| | **Итого (gross)** | **834.12** | **66 730** | | |

Пересечения A↔B (INA226 ×2, термопара, нагрузка/ЭН ≈ $34) при одном заказе **не дублируются**:
**к оплате ≈ $800 (64 000 ₽)**. Если резервный NUCLEO-H753ZI не нужен — **−$34**; если
лабораторный БП/осциллограф/нагрузка уже есть — **−$90…100** → минимум **≈ $676 (54 100 ₽)**.

---

## A. P1-стенд (бенчмарк MCU)

| # | Позиция | MPN / где | Кол-во | $/шт | Итого $ | Примечание |
|---|---|---|---:|---:|---:|---|
| A1 | ESP32-P4 EV-борд | **356-ESP32P4FNEVBRD** (Mouser/Espressif) | 1 | 62 | 62 | 32 МБ PSRAM, HS USB, DSI — эталон P4 |
| A2 | NUCLEO-H743ZI2 | **511-NUCLEO-H743ZI2** (Mouser) | 1 | 34 | 34 | контрольный кандидат H743 |
| A2b | NUCLEO-H753ZI (резерв) | 511-NUCLEO-H753ZI (Mouser) | 1 | 34 | 34 | если H743 «obsolete» — резерв; можно не брать (−$34) |
| A3 | PCM5102A DAC-модуль | AliExpress/LCSC «PCM5102A module» | 1 | 4 | 4 | I2S out |
| A4 | PCM1808 ADC-модуль | AliExpress / LCSC PCM1808EVM | 1 | 5 | 5 | I2S in, loopback |
| A5 | USB-C кабели (data 480) | любой | 2 | 2.5 | 5 | HS/заряд |
| A6 | USB-C хаб с питанием | любой | 1 | 12 | 12 | HS + заряд одновременно |
| A7 | Лабораторный БП 0–30 В/3 А | местный | 1 | 55 | 55 | ограничение тока; если есть — 0 |
| A8 | Электронная нагрузка 0–5 А | местный/Ali | 1 | 35 | 35 | или мощные резисторы; если есть — 0 |
| A9 | Осциллограф ≥100 МГц | есть/аренда | 1 | 0 | 0 | обязателен для P1 PWR-тестов |
| A10 | Мультиметр + термопара | есть | 1 | 0 | 0 | термопара — в группе B |
| A11 | ESP32-S3-DevKitC-1 (N16R8) | Espressif/LCSC | 1 | 12 | 12 | S3-профиль/лайт |
| A12 | microSD-модуль + карта 32 ГБ | любой | 1 | 8 | 8 | SD-стриминг |
| A13a | **TFT-H050A1SVIST4R40** (ST7262, 40-pin) | HotLCD/AliExpress/LCSC | **2** | 20 | 40 | 2 образца для валидации |
| A13b | **NHD-5.0-800480AF-ASXP** (резерв) | Newhaven/DigiKey | 1 | 65 | 65 | эталон pinout/даташит; можно заменить образцом HotLCD (−$65) |
| A13c | **EJ050NA-01G** (50-pin резерв) | AliExpress | 1 | 22 | 22 | если 40-pin партия не пойдёт |
| A13d | FFC-40 same/opposite + ZIF FH12-40S + адаптер | Ali/LCSC | 1 | 12 | 12 | для стендовой проверки (см. C) |
| A14 | Логический анализатор 8–16 каналов | AliExpress | 1 | 15 | 15 | SPI/I2C/RGB |
| A15 | INA226 (ток/напряжение) | Ali/LCSC | 2 | 3 | 6 | пересечение с B (не дублировать) |
| A16 | **Mic/voice-набор:** ICS-43434 ×2, MAX9814, TS5A23157, J19/J16 IDC-6 ×2, J20 TRS, сетка/поролон | Mouser/LCSC/Ali | 1 компл. | 16.4 | 16.4 | для P1 voice-тестов; в product BOM mic-node ≈1 405 ₽ ($17.6) |
| | **Итого A** | | | | **442.4** | без A2b — $408; без БП/нагрузки — $352 |

> Дисплейные образцы по docs/29 13a оценивались $60–120; по позициям A13a–c выходит
> **$127** (NHD дороже); при замене NHD образцом HotLCD — **$62**. Допустимо ±30 %.

## B. PWR-стенд (13 измерений до PCB)

Утверждено Lead: **вариант A (D-79)**. Полный состав — [`bench-bom.csv`](../hardware/power2/bench-bom.csv),
методика — [`docs/44`](44-pwr-bench.md).

| Подгруппа | Состав | $ | Примечание |
|---|---|---:|---|
| B-base | 25 позиций `bench-bom.csv`: bare-IC TPS61088 ×2, LMR33630 ×2, TPS63802 ×2, BQ24074 ×2, MAX17048; модули Ali; ячейки/холдеры; INA226 ×2; нагрузка; монтаж; **P-19…P-25** (IDC-20+шлейф, USB-I2C, PC817/2N7002, AO3401A/MMBT3904, AO3400A, SS34/полифьюзы/TVS, π-фильтры) | **123.92** | база $103 + дозакупка $20 → $123.92 (не добавлять $20 повторно) |
| B-EVM | **P-EVM-01…04**: LMR33630ADDAEVM-IBB $45 + TPS61088EVM-677 $50 + BQ24074EVM $45 + MAX17048 breakout $13 | **153** | вариант A (D-79), samples B параллельно бесплатно |
| | **Итого B** | **276.92** | ₽ 22 154; пересечение с A (INA226/термопара/нагрузка ≈$34) → net ≈ $243 |

## C. LCD-адаптер (стендовая проверка экрана)

Схема и pinout — [`docs/49`](49-lcd-adapter.md), BOM — [`BOM-lcd-adapter.csv`](../hardware/panel2/adapter-lcd/BOM-lcd-adapter.csv)
(8 уникальных позиций/80 деталей на плату). Нужно **2 платы** (2 ревизии/2 образца).

| # | Позиция | MPN / где | Кол-во | $/шт | Итого $ |
|---|---|---|---:|---:|---:|
| C1 | PCB LCD-ADAPTER, 2 слоя 120×76 | JLCPCB (2 дизайна ×5 шт) | 1 компл. | 12 | 12 |
| C2 | ZIF FFC-40 0.5 мм **Hirose FH12-40S-0.5SH** | LCSC/Mouser (2 на плату) | **4** | 2 | 8 |
| C3 | FFC-40 100 мм, same side | AliExpress | 2 | 1.2 | 2.4 |
| C4 | FFC-40 100 мм, opposite side | AliExpress | 2 | 1.2 | 2.4 |
| C5 | JST PH 2-pin **B2B-PH-K** (вход BL-boost) | LCSC (1 на плату) | **2** | 1 | 2 |
| C6 | TFT-H050A1SVIST4R40 (панель для адаптера) | HotLCD/Ali | **2** | 20 | 40 |
| C7 | 0603: 0R ×68 (34/плату), 100n ×4, 10k ×2, 10u ×2; M3 ×8 | LCSC/Ali | 1 набор | 6 | 6 |
| | **Итого C** | | | | **72.8** |

> «Панель ×2» — те же MPN, что A13a; если 2 из 4 образцов A идут на адаптер — C6 можно
> не покупать отдельно (−$40). JST PH и ZIF — по BOM: 2 ZIF и 1 JST на плату.

## D. Печать и материалы

| # | Позиция | Кол-во | $ | Примечание |
|---|---|---:|---:|---|
| D1 | PETG 1 кг (1.75 мм) | 1 | 18 | B-light 230 г; запас на брак |
| D2 | PLA 0.5 кг (колпачки/ручки) | 1 | 9 | 100 г на комплект |
| D3 | Крепёж M3 + термовтулки 4.6×6 | набор | 6 | 24 втулки + винты M3/M2.5 |
| D4 | Сопло 0.6 мм (для B-light) | 1 | 4 | профиль 0.6/0.28–0.32 |
| D5 | Изопропанол/клей/смазка | набор | 5 | подготовка, втулки |
| | **Итого D** | | **42** | ₽ 3 360; печать на заказ — $25–35/комплект (альтернатива) |

## E. Для домашнего ПК

Ничего: сборка/рендеры/тесты — на текущей машине (docs/48); принтер — если есть.
Если принтера нет — вариант «печать на заказ» (D-альтернатива).

---

## Сборка плат и печать корпуса

Куда отдать в работу (Москва/СПб/НН): Резонит (Зеленоград/СПб, прототипы 2–3 дня),
Интер-Плата (5–500 плат), А-Контракт, НПП «Асти» (полный цикл), Пилотный центр МосПолитеха,
**VG-Line** (музыкальное оборудование, Москва), Телерем (НН), AXIOMA/Эрикон (СПб);
корпуса — Modelica3D/ПИМТЕХ/фаблабы. RFQ-шаблон, ориентиры цен и чек-лист передачи —
[`docs/72-assembly-workshops.md`](72-assembly-workshops.md).

## Порядок заказа (4 волны)

1. **Волна 1 (день 0) — ядро P1:** A1–A6, A11, A12 (Mouser/Espressif/Ali); A7–A8 — у местных,
   если нет своих.
2. **Волна 1b (тот же день) — критические образцы:** A13a–d (дисплеи+FFC/ZIF), **B-EVM:
   LMR33630ADDAEVM-IBB → TPS61088EVM-677 → BQ24074EVM** (Mouser/TI), bare-IC B-base (Mouser),
   P-19…P-25/Ali. **Это критический путь к PCB.**
3. **Волна 2 (после проверки pinout/адаптера) — C:** JLCPCB (адаптер) + C2–C7 (LCSC/Ali).
   Можно параллельно с волной 1b, если MPN ZIF/FFC подтверждены.
4. **Волна 3 — D:** филамент/крепёж/сопло (локально/Ali) — к моменту печати.

**Не заказывать:** PCB CORE-2/PANEL-2/PWR-2 (PRE-FREEZE, до DRC/DFM и RC-DoD —
[`docs/36`](36-rc-definition.md), [`docs/42`](42-dfm-review-gpt.md)).

## Где оценки (±30 %)

- Дисплеи A13a–c и C6 (HotLCD/Ali, партии/доставка), NHD $65 — по каталогу Newhaven/DigiKey;
- A7/A8 (БП, нагрузка) — местные цены; A14 — Ali;
- B-EVM — по каталогам TI/Mouser ($45–50), MAX17048 breakout $13;
- C1 PCB (JLCPCB, зависит от панелизации/доставки), C2 ZIF/FFC (LCSC/Ali);
- D — филамент/крепёж.

Точные MPN/цены — [`docs/29`](29-p1-order.md), [`bench-bom.csv`](../hardware/power2/bench-bom.csv),
[`BOM-lcd-adapter.csv`](../hardware/panel2/adapter-lcd/BOM-lcd-adapter.csv),
[`docs/47`](47-display-selection.md).

## Ссылки магазинов

- **Mouser:** [P4 EV](https://www.mouser.com/c/?q=356-ESP32P4FNEVBRD) ·
  [NUCLEO-H743ZI2](https://www.mouser.com/ProductDetail/STMicroelectronics/NUCLEO-H743ZI2) ·
  [LMR33630ADDAEVM](https://www.mouser.com/c/?q=LMR33630ADDAEVM) ·
  [TPS61088EVM-677](https://www.mouser.com/c/?q=TPS61088EVM-677) ·
  [BQ24074EVM](https://www.mouser.com/c/?q=BQ24074EVM) ·
  [FH12-40S-0.5SH](https://www.mouser.com/c/?q=FH12-40S-0.5SH)
- **LCSC:** [ESP32-S3-WROOM-1](https://www.lcsc.com/) · [INA226](https://www.lcsc.com/) ·
  [FH12-40S-0.5SH](https://www.lcsc.com/) · [B2B-PH-K](https://www.lcsc.com/)
- **AliExpress:** [PCM5102A](https://www.aliexpress.com/) · [PCM1808](https://www.aliexpress.com/) ·
  [TFT-H050A1SVIST4R40](https://www.aliexpress.com/) · [EJ050NA-01G](https://www.aliexpress.com/) ·
  [FFC-40](https://www.aliexpress.com/) · [INA226](https://www.aliexpress.com/)
- **Newhaven:** [NHD-5.0-800480AF-ASXP](https://newhavendisplay.com/5-0-inch-ips-tft-without-touchscreen/)
- **HotLCD:** [TFT-H050A1SVIST4R40](https://www.hotlcd.com/productdetail/1046)
- **JLCPCB:** [LCD-ADAPTER](https://cart.jlcpcb.com/)
