martiyanov/bukifon/docs/29-p1-order.md

# P1: точный список заказа (стенд бенчмарка) — **УТВЕРЖДЁН заказчиком 06.11.2025 (D-60)**

Цель — за минимальные деньги получить ответ «какой MCU тянет Букифон».
Контекст и протокол измерений: [docs/26-p1-bench-kit.md](26-p1-bench-kit.md),
workload: [docs/05](05-benchmark-workload.md), howto: [docs/05a](05a-benchmark-howto.md),
**протокол P1 (8 сценариев/матрица/CSV) — [docs/56](56-p1-measurements.md)**.

> **Единый закупочный лист** (P1 + PWR + LCD-адаптер + печать, итоги A–D, порядок
> и пересечения) — [`docs/54-shopping-list.md`](54-shopping-list.md).

## 1. Обязательный минимум (без него нет вердикта)

| # | Позиция (точный тип) | Где искать | Кол-во | Цена, $ |
|---|---|---|---:|---:|
| 1 | **ESP32-P4-Function-EV-Board** (ESP32-P4, 32 МБ PSRAM, USB HS, DSI) — Mouser **356-ESP32P4FNEVBRD** | [Mouser](https://www.mouser.com/c/?q=356-ESP32P4FNEVBRD), Espressif store | 1 | 55–70 |
| 2 | **NUCLEO-H743ZI2** (STM32H743, LTDC, HS USB) — Mouser **511-NUCLEO-H743ZI2** (в части регионов «obsolete» → NUCLEO-H753ZI как аналог) | [Mouser](https://www.mouser.com/ProductDetail/STMicroelectronics/NUCLEO-H743ZI2) | 1 | 27–40 |
| 3 | **PCM5102A DAC module** (I2S, 3.3 В, GY-PCM5102) | AliExpress/LCSC «PCM5102A DAC module» | 1 | 2–6 |
| 4 | **PCM1808 ADC module** (I2S in) | AliExpress «PCM1808 ADC board» / LCSC PCM1808EVM (C17384468) | 1 | 3–8 |
| 5 | USB-C кабель данных (USB 2.0, 480 Мбит/с) ×2 | любой | 2 | 3–6 |
| 6 | USB-C хаб с внешним питанием (для HS + заряд) | любой | 1 | 10–15 |
| 7 | Лабораторный БП 0–30 В / ≥3 А с ограничением тока | местный магазин/Amazon | 1 | 40–70 |
| 8 | Электронная нагрузка 0–5 А (или мощные резисторы + реле) | местный/Amazon | 1 | 25–50 |
| 9 | Осциллограф ≥100 МГц, 2 канала + пружинный ground | есть/аренда | 1 | — |
| 10 | Мультиметр + термопара/ИК-термометр | есть | 1 | — |

**Минимум: ~$110–130** (без осциллографа/БП, если есть).

## 2. Для полного вертикального теста (P2)

| # | Позиция | Где | Цена, $ |
|---|---|---|---:|
| 11 | **ESP32-S3-DevKitC-1** (N16R8: 16 МБ flash, 8 МБ PSRAM) | Espressif store/LCSC | 10–13 |
| 13 | microSD-модуль (SPI/SDIO) + карта 32 ГБ | любой | 6–10 |
| 13a | **TFT 5.0″ 800×480 RGB, FPC-40, ST7262** — TFT-H050A1SVIST4R40 (HotLCD) ×2; резерв: NHD-5.0-800480AF-ASXP ×1 (Newhaven), EJ050NA-01G ×1 (50-pin, Innolux) | HotLCD/AliExpress/LCSC; Newhaven/DigiKey; Ali | 60–120 |
| 13b | FPC-40 шлейфы/адаптер (same/opposite side) + ответный разъём Hirose FH12-40S | Ali/LCSC | 8–15 |
| 14 | Логический анализатор 8–16 каналов | AliExpress | 10–20 |
| 15 | INA219/INA226 токовый датчик | LCSC | 2–4 |

**Плюс ~$45–65** (без строки 12; детали — docs/54).

## 3. Порядок заказа

1. Сначала **1–4 + 5–6** (ядро стенда) — можно тестировать host-бенч на железе.
2. Потом **7–8** (питание/нагрузка) — для P2 и питания PWR-2.
3. Дисплей (13a/13b; строка 12 заменена ими) — **MPN зафиксирован** (O-15/O-19: TFT-H050A1SVIST4R40, 40-pin ST7262, 2–3 образца; резерв NHD/EJ; DSI — опция rev.3). Заказать сразу после 1–4.
4. S3 (11) — параллельно, для «народной» CORE-S3.

## 4. Что проверить сразу после распаковки

- платы определяются (esptool/STM32CubeProgrammer), PSRAM видна;
- I2S loopback PCM5102A→PCM1808 (синус 1 кГц);
- USB HS на P4/H743 (lsusb, скорость 480);
- замер тока покоя каждой платы;
- зафиксировать серийники и версии чипов в `docs/05-benchmark-workload.md` (раздел platform).

## 5. Бюджет

| Этап | Состав | $ |
|---|---|---:|
| Минимум | 1–6 | 75–100 |
| С питанием/нагрузкой | +7–8 | 140–200 |
| Полный | +11–15 | 190–260 |

## 6. Правила

- Заказ делает владелец проекта (доступ к оплате/доставке).
- Пока стенд не собран — **не заказывать PCB** (CORE-2/PANEL-2/PWR-2 pre-freeze).
- После замеров — заполнить таблицу решения в docs/26 §5 и зафиксировать MCU в spec/90.
