martiyanov/bukifon/docs/BOM.md

# BOM Букифон v0.5 (draft)

**Дата:** 2025-11-05 · **Версия:** 0.5.x · **Статус: DRAFT** — цены ориентировочные, не финальные.
**Валюта:** ₽ (RUB) и $ (USD), пересчёт по курсу **80 ₽/$**. Источники: LCSC, Mouser, DigiKey,
ЧипДип, Farnell, Thonk, AliExpress, JLCPCB (ссылки/цены — в [`BOM.csv`](../BOM.csv)).
**Новая архитектура:** ESP32-P4 (осн.) / ESP32-S3 (лайт), экран 5.0″ 800×480 RGB (FPC-40),
панель v0.4 (380 × 210: 16 EC11, 10 mini-jack, 2 фейдера 60 мм, 42 клавиши Lapka-42),
корпус v0.4/v0.5 (wedge 8°), питание 1S2P 18650 (TP4056/BQ24074 + MT3608).
Контракты: [`spec/90-requirements-registry.md`](../spec/90-requirements-registry.md),
[`spec/panel-spec-v0.4.json`](../spec/panel-spec-v0.4.json), [`spec/70-v1.8-case.md`](../spec/70-v1.8-case.md).

> Это **черновой** BOM: позиции и ориентиры цен для планирования. Перед закупкой — проверить
> наличие и цену по ссылкам (цены дрейфуют, часть — оценка ±30%).

## 1. Итоги

| Вариант | Позиций | Итого, ₽ | Итого, $ |
|---|---:|---:|---:|
| **База** — рабочий инструмент: P4-devboard, 5″ RGB, аудио DAC/ADC, панель, Lapka-42, батарея, корпус | 65 | **21657** | **271** |
| **Полный** — база + аналоговые картриджи (VCO/FILTER/LADDER/ENSEMBLE), DECK-PAD c FSR, ALPS-фейдеры, BQ24074, трафареты | 89 | **32518** | **406** |
| **Дельта** «полный − база» | +24 | +10861 | +136 |

Строки с пометкой «альтернатива» (ESP32-S3, услуга печати/SMD-монтажа) **не входят** в итоги.
Старый BOM v1.0 (Pico, 315×145, 114 позиций, база 16 855 ₽ / полный 56 460 ₽) заменён:
архитектура изменилась (ESP32-P4, экран 5″, 16 энкодеров, 42 клавиши Lapka-42, корпус 380×210).

## 2. Состав по блокам (draft)

#### Ядро v0.5 (MCU, аудио, память, IO)

| ref | Наименование | Номинал/корпус | Кол-во | ₽/шт | Итого, ₽ | $/шт | Итого, $ | Источник | Замена | Входит в |
|---|---|---|---:|---:|---:|---:|---:|---|---|---|
| C-01 | ESP32-P4 dev board / модуль (32 МБ PSRAM) | ESP32-P4-WROOM-1-N16R32 или dev-board, USB HS, RGB/DSI | 1 | 1500 | 1500 | 18.75 | 18.75 | AliExpress/LCSC: модуль ¥60 ≈ $8.5; ESP32-P4-Function-EV-Board $55–70 (Mouser/Voelkner) | ESP32-P4-Function-EV-Board; Waveshare ESP32-P4 | база+полный |
| C-02 | ESP32-S3-WROOM-1-N16R8 (альтернатива «лайт») | 16 МБ flash, 8 МБ PSRAM, PCB-антенна | 1 (опц.) | 410 | 410 | 5.08 | 5.08 | LCSC C2913202: $5.08 (1 шт) | ESP32-S3-WROOM-1-N8R2 | — |
| C-03 | PCM5102A (I2S ЦАП) | модуль/чип, 112 дБ | 1 | 280 | 280 | 3.5 | 3.5 | chipdip.ru (580 ₽) / Ali | PCM5102A-модуль; PCM5122 | база+полный |
| C-04 | PCM1808 (I2S АЦП, AUDIO IN) | TSSOP-14, 24 бит/96 кГц, 2 канала | 1 | 170 | 170 | 2.12 | 2.12 | Mouser 595-PCM1808PW: $2.12 (1 шт) | PCM1808QPWRQ1 (авто), PCM1804 | база+полный |
| C-05 | MCP4728A0-E/UN + MCP4728A1-E/UN | 2×4 канала 12 бит I2C, 0x60 + 0x61 | 2 | 300 | 600 | 3.75 | 7.5 | rlocman.ru ≈330 ₽; Ali ≈$3.5 | MCP4728A7 (один адрес) | база+полный |
| C-06 | MCP3208 (8×12 бит SPI АЦП) | SO-16 | 1 | 400 | 400 | 5 | 5 | chipdip.ru 880 ₽ / Ali | MCP3208-BI/SL | база+полный |
| C-07 | MCP23017 (I2C 16 I/O) | DIP-28/SOIC-28, 0x20/0x21/0x22 | 3 | 230 | 690 | 2.88 | 8.64 | rlocman.ru медиана ≈204 ₽ | MCP23S17 (SPI) | база+полный |
| C-08 | EEPROM 24C32 (калибровка) | DIP-8/SOIC-8, адрес 0x57 | 1 | 60 | 60 | 0.75 | 0.75 | chipdip.ru 280 ₽ / Ali | 24C32 | база+полный |
| C-09 | 6N137 (оптопара MIDI IN) | DIP-8, 10 Мбит/с | 1 | 60 | 60 | 0.75 | 0.75 | platan.ru 24–124 ₽ | HPL6N137-D8 | база+полный |
| C-10 | 74HCT125 (буфер MIDI OUT) | DIP-14 | 1 | 60 | 60 | 0.75 | 0.75 | chipdip/rlocman 56–120 ₽ | SN74HCT125N | база+полный |
| C-11 | MCP1700-3302E (LDO 3.3 В, 250 мА) | TO-92/SOT-23 | 1 | 77 | 77 | 0.96 | 0.96 | LCSC C511277: $0.96 (1 шт) | AP2112K-3.3 (600 мА) | база+полный |
| C-12 | USBLC6-2SC6 (ESD USB) | SOT-23-6 | 1 | 45 | 45 | 0.56 | 0.56 | chipdip.ru / Ali | PRTR5V0U2X | база+полный |
| C-13 | USB-C 16P (DATA + CHARGE) | панельные/на плату, 2 шт | 2 | 100 | 200 | 1.25 | 2.5 | AliExpress / chipdip.ru | USB4085, USB-C 16P | база+полный |
| C-14 | Слот microSD (push-push) | SMD, 0.5 мм | 1 | 50 | 50 | 0.62 | 0.62 | LCSC $0.15–0.65 / Ali | microSD push-push | база+полный |
| C-15 | microSD 32 ГБ (A1/U1) | SDHC, 32 ГБ | 1 | 650 | 650 | 8.12 | 8.12 | любой магазин | 32–64 ГБ A1 | база+полный |
| C-16 | FFC-разъём 40P 0.5 мм | SMD, right angle, flip-top | 1 | 45 | 45 | 0.54 | 0.54 | LCSC $0.54 / Ali | 40P 0.5 мм | база+полный |
| C-17 | FFC-шлейф 40P 0.5 мм, 100 мм | 40 pin, same side | 1 | 90 | 90 | 1.12 | 1.12 | AliExpress | FFC 40P 0.5 | база+полный |
| C-18 | FFC 50P 0.5 мм (комплект) | 50P разъём + шлейф | 1 (опц.) | 160 | 160 | 2 | 2 | AliExpress | — | только полный |
| C-19 | Ферриты/ESD/обвязка питания | 600 Ω 0805 + 100 нФ + электролиты | 1 | 150 | 150 | 1.88 | 1.88 | chipdip/Ali | — | база+полный |
| | **Итого блока** | | | | **5127 / 5287** | | **64 / 66** | | | |

#### Дисплей 5.0″ и подсветка

| ref | Наименование | Номинал/корпус | Кол-во | ₽/шт | Итого, ₽ | $/шт | Итого, $ | Источник | Замена | Входит в |
|---|---|---|---:|---:|---:|---:|---:|---|---|---|
| D-01 | TFT 5.0″ 800×480 IPS RGB, FPC-40 | активная 108×64.8, без рамки (R-05) | 1 | 960 | 960 | 12 | 12 | AliExpress $8.5–15 (MOQ 10) / DigiKey Newhaven $73 | NHD-5.0-800480TF-ATXL# (дорого), 50-pin вариант | база+полный |
| D-02 | Драйвер подсветки (boost CC) | 12 WLED, 19.2 В, 40 мА | 1 | 80 | 80 | 1 | 1 | AliExpress/chipdip | PT4115, MP3302, TPS61165 | база+полный |
| D-03 | Плёнка/пена под стекло | демпфер 0.5–1 мм | 1 | 80 | 80 | 1 | 1 | любой магазин | — | база+полный |
| | **Итого блока** | | | | **1120 / 1120** | | **14 / 14** | | | |

#### Панель: энкодеры, фейдеры, джеки, LED

| ref | Наименование | Номинал/корпус | Кол-во | ₽/шт | Итого, ₽ | $/шт | Итого, $ | Источник | Замена | Входит в |
|---|---|---|---:|---:|---:|---:|---:|---|---|---|
| P-01 | Энкодер EC11 с кнопкой (Ø14-ручка) | D-вал 6 мм, 20 имп/об | 16 | 140 | 2240 | 1.75 | 28 | radelin.ru 87–150 ₽; Ali $1–1.5 | EC11S, PEC11R | база+полный |
| P-02 | Фейдер 60 мм, 10 кОм (китайский) | ход 60 мм, 88×16 мм | 2 | 350 | 700 | 4.38 | 8.76 | AliExpress $3–4 | ALPS RS60N11 (P-03) | база+полный |
| P-03 | ALPS RS60N11 (премиум) | 10 кОм, лог/лин, 60 мм | 2 (опц.) | 750 | 1500 | 9.4 | 18.8 | Farnell/Mouser €8.68 (1 шт) | Bourns PTA6044 | только полный |
| P-04 | Mini-jack 3.5 мм (Thonkiconn/PJ301M-12) | моно/стерео, Ø6, шаг 13.1 | 10 | 60 | 600 | 0.75 | 7.5 | Thonk £0.38–0.49; RU PJ-307 50–80 ₽ | PJ398SM, WQP518MA, PJ307 | база+полный |
| P-05 | Тактовые кнопки 6×6×5 | THT, 4 шт (reset/boot/сервис) | 4 | 13 | 52 | 0.16 | 0.64 | rekshop.ru 13 ₽ | IT-1102WA | база+полный |
| P-06 | SK6812MINI-E (RGB под клавишами) | 3535, 42 шт | 42 | 9 | 378 | 0.11 | 4.62 | chipdip.ru 28 ₽ / 10.3 ₽ от 500 | WS2812B-2020 | база+полный |
| P-07 | WS2812B-2020 (кольца энкодеров + статус) | 2020, 17 шт | 17 | 8 | 136 | 0.1 | 1.7 | radiodetali.com 8.27 ₽ от 100 | SK6812MINI-E | база+полный |
| P-08 | 74HCT1G125 (буфер LED_DATA 3.3→5 В) | SOT-23-5 | 1 | 30 | 30 | 0.38 | 0.38 | chipdip.ru | 74AHCT1G125 | база+полный |
| P-09 | 2N7002 (ключ подсветки) | SOT-23 | 1 | 12 | 12 | 0.15 | 0.15 | chipdip.ru | BSS138 | база+полный |
| P-10 | Ручки Ø14 ×16 / колпачки фейдеров | печать PETG/PLA | 1 | 0 | 0 | 0 | 0 | печать (см. блок «Корпус») | — | база+полный |
| | **Итого блока** | | | | **4148 / 5648** | | **52 / 71** | | | |

#### Клавиатура Lapka-42 (42 клавиши)

| ref | Наименование | Номинал/корпус | Кол-во | ₽/шт | Итого, ₽ | $/шт | Итого, $ | Источник | Замена | Входит в |
|---|---|---|---:|---:|---:|---:|---:|---|---|---|
| K-01 | Kailh Choc v1 (низкопрофильный) | 5-pin, hot-swap | 42 | 35 | 1470 | 0.44 | 18.48 | ergosplits.ru 39.4 ₽/шт (100 шт) | Kailh Choc v2 (только v2-гнёзда) | база+полный |
| K-02 | Гнездо hot-swap Choc | CPG135001S30 | 42 | 5 | 210 | 0.06 | 2.52 | AliExpress $0.07–0.1 | Kailh CPG1350 | база+полный |
| K-03 | Диод 1N4148 (матрица 6×7) | DO-35, 42 шт | 42 | 2.5 | 105 | 0.03 | 1.26 | quartz1.com 6 ₽ (от 100 — 5 ₽) | 1N4148W SOD-123 | база+полный |
| K-04 | Колпачки 42 шт (печать) | PLA полупрозрачный / MBK | 1 | 0 | 0 | 0 | 0 | печать | — | база+полный |
| | **Итого блока** | | | | **1785 / 1785** | | **22 / 22** | | | |

#### Питание и батарея

| ref | Наименование | Номинал/корпус | Кол-во | ₽/шт | Итого, ₽ | $/шт | Итого, $ | Источник | Замена | Входит в |
|---|---|---|---:|---:|---:|---:|---:|---|---|---|
| W-01 | Аккумулятор 18650 Li-Ion (защищённый) | 3.6 В, ≥2500 мА·ч, 2 шт | 2 | 300 | 600 | 3.75 | 7.5 | AliExpress/Ozon | Samsung/LG/Panasonic; 21700 (другой холдер) | база+полный |
| W-02 | Холдер 2×18650 | с выводами, 68×40×21 | 1 | 120 | 120 | 1.5 | 1.5 | AliExpress | — | база+полный |
| W-03 | BMS 1S2P (защита) | DW01+FS312F / модуль 3–5 А | 1 | 150 | 150 | 1.88 | 1.88 | AliExpress | 1S BMS 10 А | база+полный |
| W-04 | TP4056 (заряд 1S, USB-C) | модуль 5 В/1 А | 1 | 100 | 100 | 1.25 | 1.25 | AliExpress | TP4056 с защитой | база+полный |
| W-05 | BQ24074 (charger + power-path) | VQFN-16, 1.5 А, USB-C | 1 (опц.) | 260 | 260 | 3.24 | 3.24 | Mouser 595-BQ24074RGTT: $3.24 | TP4056 + ideal-diode | только полный |
| W-06 | MT3608 (boost 12.2 В/2 А) | модуль, КПД ≈88 % | 1 | 120 | 120 | 1.5 | 1.5 | AliExpress | XL6009 | база+полный |
| W-07 | MP1584EN (buck 5.1 В/3 А) | SO-8EP | 1 | 55 | 55 | 0.69 | 0.69 | chipdip.ru 90 ₽ | — | база+полный |
| W-08 | MC34063A (инвертор −12 В) | DIP-8 | 1 | 25 | 25 | 0.31 | 0.31 | chipdip.ru | — | база+полный |
| W-09 | AP2112K-3.3 (LDO 600 мА) | SOT-23-5 | 1 | 20 | 20 | 0.25 | 0.25 | chipdip.ru 22 ₽ | MCP1700 | база+полный |
| W-10 | SS34 (Шоттки) | SMA, 40 В 3 А, 3 шт | 3 | 10 | 30 | 0.12 | 0.36 | platan.ru 10 ₽ | SK34 | база+полный |
| W-11 | SMAJ15A (TVS входа 12 В) | SMA 400 Вт | 1 | 10 | 10 | 0.12 | 0.12 | platan.ru | P6SMB16A | база+полный |
| W-12 | Полифьюз 1.1 А (USB-C заряд) | MF-R110 | 1 | 20 | 20 | 0.25 | 0.25 | chipdip.ru | F1.1 A | база+полный |
| W-13 | Предохранитель 3 А + держатель | по выходу батареи | 1 | 30 | 30 | 0.38 | 0.38 | chipdip.ru | F3 A стеклянный | база+полный |
| W-14 | Термистор NTC 10 кОм | B3950, 1 % | 1 | 30 | 30 | 0.38 | 0.38 | chipdip.ru | NTC 10k B3435 | база+полный |
| W-15 | Ideal-diode / MOSFET-OR | диод ИЛИ + EXT_DET | 1 | 80 | 80 | 1 | 1 | AliExpress | 2×SS34 (из W-10) | база+полный |
| W-16 | Гнездо DC 5.5/2.1 | панельное | 1 | 35 | 35 | 0.44 | 0.44 | chipdip.ru | DC-005 | база+полный |
| W-17 | Выключатель питания | тумблер/кнопка | 1 | 60 | 60 | 0.75 | 0.75 | elektro.ru | MTS-102 | база+полный |
| W-18 | Пассив питания | электролиты 1000/100 мкФ, ферриты, L 22 мкГн | 1 | 600 | 600 | 7.5 | 7.5 | chipdip/Ali | — | база+полный |
| | **Итого блока** | | | | **2085 / 2345** | | **26 / 29** | | | |

#### Печатные платы и монтаж

| ref | Наименование | Номинал/корпус | Кол-во | ₽/шт | Итого, ₽ | $/шт | Итого, $ | Источник | Замена | Входит в |
|---|---|---|---:|---:|---:|---:|---:|---|---|---|
| B-01 | PCB база: CORE-1 rev.3, PANEL-1 rev.2, DECK-KEYS, PWR-1, панель v0.5 | 5 конструкций × 5 шт, 2 слоя | 1 | 2000 | 2000 | 25 | 25 | JLCPCB (калькулятор) / Rezon | PcbWay/Seeed | база+полный |
| B-02 | PCB полный: DECK-PAD + 5 аналоговых картриджей | 6 конструкций × 5 шт | 1 (опц.) | 1400 | 1400 | 17.5 | 17.5 | JLCPCB | Rezon | только полный |
| B-03 | Трафарет для пасты (stencil) | 5 конструкций | 1 (опц.) | 500 | 500 | 6.25 | 6.25 | JLCPCB | — | только полный |
| B-04 | Услуга SMD-монтажа (оценка) | 5 плат (CORE/PANEL/PWR/DECK) | 1 (опц.) | 2500 | 2500 | 31.25 | 31.25 | JLCPCB PCBA / РФ-подрядчик | — | — |
| | **Итого блока** | | | | **2000 / 3900** | | **25 / 49** | | | |

#### Корпус, печать, крепёж

| ref | Наименование | Номинал/корпус | Кол-во | ₽/шт | Итого, ₽ | $/шт | Итого, $ | Источник | Замена | Входит в |
|---|---|---|---:|---:|---:|---:|---:|---|---|---|
| M-01 | PETG-филамент 1 кг | 1.75 мм | 1 | 700 | 700 | 8.75 | 8.75 | dakson.su 1377 ₽; чеки 625–1438 ₽ | любой PETG | база+полный |
| M-02 | PLA полупрозрачный 0.5 кг | 1.75 мм | 1 | 700 | 700 | 8.75 | 8.75 | любой магазин | — | база+полный |
| M-03 | TPU-филамент 0.5 кг | 1.75 мм, 95A | 1 | 1200 | 1200 | 15 | 15 | regard.ru 2280 ₽/кг | любой TPU | база+полный |
| M-04 | Крепёж M3 (набор) | винты/гайки/стойки | 1 | 300 | 300 | 3.75 | 3.75 | 9v.ru 380 ₽/120 шт | RUICHI KIT-M3 | база+полный |
| M-05 | Термовтулки M3 4.6×6.0 | 100 шт | 1 | 350 | 350 | 4.38 | 4.38 | AliExpress | — | база+полный |
| M-06 | Винты M2.5 (дисплей/фейдеры) | M2.5×6 ×4 + M2.5×8 ×4 | 8 | 4 | 32 | 0.05 | 0.4 | 9v.ru | набор M2.5 | база+полный |
| M-07 | Печать на заказ (если нет принтера) | весь комплект | 1 (опц.) | 3000 | 3000 | 37.5 | 37.5 | печатный сервис | — | — |
| M-08 | Магниты/защёлки/уплотнитель | 6×3 мм, лента | 1 | 200 | 200 | 2.5 | 2.5 | AliExpress | — | база+полный |
| | **Итого блока** | | | | **3482 / 3482** | | **44 / 44** | | | |

#### Кабели и расходники

| ref | Наименование | Номинал/корпус | Кол-во | ₽/шт | Итого, ₽ | $/шт | Итого, $ | Источник | Замена | Входит в |
|---|---|---|---:|---:|---:|---:|---:|---|---|---|
| X-01 | Шлейф IDC-26 (3 шт) | 12 см | 3 | 60 | 180 | 0.75 | 2.25 | darxton.ru 40 ₽ / сборка из ленты | готовый IDC26-8-E | база+полный |
| X-02 | Шлейф IDC-16 (2 шт) | 10 см | 2 | 40 | 80 | 0.5 | 1 | darxton/Ali | IDC-16 | база+полный |
| X-03 | Провод монтажный / Dupont | 22 AWG + Dupont | 1 | 200 | 200 | 2.5 | 2.5 | AliExpress | — | база+полный |
| X-04 | Кабель USB-C (2 шт) | 1 м, data | 2 | 150 | 300 | 1.88 | 3.76 | любой магазин | USB-C 2.0 | база+полный |
| X-05 | Припой, флюс, изопропанол | — | 1 | 700 | 700 | 8.75 | 8.75 | любой магазин | — | база+полный |
| X-06 | Антистатический браслет/мат | — | 1 | 300 | 300 | 3.75 | 3.75 | любой магазин | — | база+полный |
| X-07 | Термоусадка/кембрик | набор | 1 | 150 | 150 | 1.88 | 1.88 | любой магазин | — | база+полный |
| | **Итого блока** | | | | **1910 / 1910** | | **24 / 24** | | | |

#### Полный: аналоговые картриджи

| ref | Наименование | Номинал/корпус | Кол-во | ₽/шт | Итого, ₽ | $/шт | Итого, $ | Источник | Замена | Входит в |
|---|---|---|---:|---:|---:|---:|---:|---|---|---|
| N-01 | AS3340 (VCO-1, Alfa RPAR) | DIP-16 | 1 (опц.) | 700 | 700 | 8.75 | 8.75 | synthcube $7.95–8.13 | AS3340A, CEM3340 | только полный |
| N-02 | LM13700 (FILTER-1) | DIP-16 | 1 (опц.) | 300 | 300 | 3.75 | 3.75 | chipdip.ru 460 ₽ | LM13700N | только полный |
| N-03 | AS3320 (LADDER-1) | DIP-18 | 1 (опц.) | 1200 | 1200 | 15 | 15 | synth-parts €15.59; дефицит | AS3320D/AS3320-HYB; BCM847×4 | только полный |
| N-04 | PT2399 (ENSEMBLE-1) | DIP-16, 2 шт | 2 (опц.) | 70 | 140 | 0.88 | 1.76 | chipdip/Ali | — | только полный |
| N-05 | CD4053 (аналоговый ключ) | DIP-16 | 1 (опц.) | 30 | 30 | 0.38 | 0.38 | chipdip.ru | 74HC4053 | только полный |
| N-06 | TL074 (буферы модулей) | DIP-14, 4 шт | 4 (опц.) | 22 | 88 | 0.28 | 1.12 | chipcity 24 ₽ / chipdip 55 ₽ | TL084 | только полный |
| N-07 | TL072 (буферы модулей) | DIP-8, 2 шт | 2 (опц.) | 25 | 50 | 0.31 | 0.62 | chipdip.ru | NE5532 | только полный |
| N-08 | Панельки DIP-8/14/16/18 | набор ~15 шт | 1 (опц.) | 120 | 120 | 1.5 | 1.5 | rekshop.ru | — | только полный |
| N-09 | EEPROM 24C02 (дескриптор модуля) | DIP-8, 5 шт | 5 (опц.) | 20 | 100 | 0.25 | 1.25 | AliExpress | 24C32 | только полный |
| N-10 | Резисторы 0.1 % | набор 25 шт | 1 (опц.) | 500 | 500 | 6.25 | 6.25 | chipdip.ru | Vishay MRS25 | только полный |
| N-11 | Tempco 1 кОм 3300 ppm/K | THT | 1 (опц.) | 150 | 150 | 1.88 | 1.88 | AliExpress | — | только полный |
| N-12 | Гнёзда/тумблеры модулей | 3.5 мм ×8 + SPDT ×4 | 1 (опц.) | 300 | 300 | 3.75 | 3.75 | micro-chip/elektro | — | только полный |
| N-13 | TL431 (опорное 2.495 В) | TO-92/SOT-23 | 1 (опц.) | 25 | 25 | 0.31 | 0.31 | chipdip.ru | LM4040 | только полный |
| | **Итого блока** | | | | **0 / 3703** | | **0 / 46** | | | |

#### Полный: сменная дека DECK-PAD

| ref | Наименование | Номинал/корпус | Кол-во | ₽/шт | Итого, ₽ | $/шт | Итого, $ | Источник | Замена | Входит в |
|---|---|---|---:|---:|---:|---:|---:|---|---|---|
| F-01 | Тактовые кнопки 12×12×5 | THT, 18 шт | 18 (опц.) | 18 | 324 | 0.23 | 4.14 | quartz1.com 37 ₽ / 24 ₽ от 100 | — | только полный |
| F-02 | WS2812B-2020 (подсветка пэдов) | 2020, 18 шт | 18 (опц.) | 8 | 144 | 0.1 | 1.8 | radiodetali.com | SK6812MINI-E | только полный |
| F-03 | MCP23017 (матрица пэдов) | DIP-28, 0x23 | 1 (опц.) | 230 | 230 | 2.88 | 2.88 | rlocman.ru | MCP23S17 | только полный |
| F-04 | 74HC4067 (FSR-мультиплексор) | SO-24, 2 шт | 2 (опц.) | 50 | 100 | 0.62 | 1.24 | chipdip.ru 190 ₽ / chipcity 53 ₽ | — | только полный |
| F-05 | FSR-плёнка 18 шт | FSR400/402 | 18 (опц.) | 140 | 2520 | 1.75 | 31.5 | AliExpress $1.3–1.5 | Interlink 402 | только полный |
| F-06 | IDC-16 гнездо (дека) | 2×8 | 1 (опц.) | 20 | 20 | 0.25 | 0.25 | quartz1.com | — | только полный |
| | **Итого блока** | | | | **0 / 3338** | | **0 / 42** | | | |

## 3. Что нового по сравнению с v1.0

- **MCU:** Pico RP2040 → **ESP32-P4** (32 МБ PSRAM, USB HS, RGB/DSI); ESP32-S3 — лайт-альтернатива
  (S3 не проходит 8×8 UAC2: 9.2 Мбит/с > FS; экран ~13 fps — `docs/11-esp32-feasibility.md`).
- **Дисплей:** 2.8″ 320×240 ST7789 → **5.0″ 800×480 IPS RGB, FPC-40**, голое стекло под вырез
  108×64.8 + драйвер подсветки ~19 В.
- **Панель:** 8 энкодеров → **16 EC11 (Ø14)**, 4 плечевых → **10 mini-jack** (Thonkiconn/PJ301M-12),
  2 слайдера 30 мм → **2 фейдера 60 мм** (китайские/ALPS RS60N11), Lapka-42 42 × Choc v1
  + hot-swap + 42 × 1N4148 + колпачки (печать).
- **Звук:** PCM5102A (DAC) + **PCM1808** (ADC, AUDIO IN для сэмплера/эффектора), 2 × MCP4728
  (6 CV out), MCP3208 (CV in/фейдеры/батарея), 2 × MCP23017 (+1 на кнопки), microSD.
- **Питание:** 1S2P 18650 + BMS + **TP4056 (USB-C)** / **BQ24074** (power-path) + **MT3608**
  12.2 В + MP1584/MC34063/AP2112 (12/±12/5/3.3 В).
- **Платы:** CORE-1 rev.3, PANEL-1 rev.2, DECK-KEYS-L42, DECK-PAD, PWR-1, 5 аналоговых
  картриджей, панель v0.5 (варианты A/B/C — в `mechanical/stl_v05_*`, появятся).

## 4. Что завтра (не входит в ночную дельту)

1. Сверить позиции/MPN с реальной схемой CORE-1 rev.3 и PANEL-1 rev.2 (после P1–P2).
2. Уточнить цены/наличие: ESP32-P4 (module vs EV-board), 5″ панель (40 vs 50-pin), ALPS RS60N11,
   BQ24074, thumbwheel/encoders с кнопкой; добавить поставщиков РФ.
3. Добавить пассивную обвязку по платам (резисторы/конденсаторы/разъёмы) из будущих BOM плат.
4. Перевести BOM.md в финальный вид (без «draft»), посчитать варианты «бюджет/оптимум» по РФ/импорту.
5. Синхронизировать с `spec/90` (R-12 MCU — после бенчмарка P1).

## 5. Связанные документы

[`docs/02-build-guide.md`](02-build-guide.md) §«Сборка v0.5 (draft)» ·
[`docs/01-quickstart.md`](01-quickstart.md) · [`docs/09-licensing.md`](09-licensing.md) ·
[`spec/90-requirements-registry.md`](../spec/90-requirements-registry.md) ·
[`docs/12-roadmap.md`](12-roadmap.md).

---

## 6. Product BOM (отдельные файлы, с 2026-11-05)

Мастерский `BOM.csv` выше — **workshop/справочный**, не себестоимость изделия.
Product BOM для SKU ведутся отдельно:

| Файл | SKU | COGS (партия 10 / 25) |
|---|---|---:|
| [`BOM-p4.csv`](../BOM-p4.csv) | **P4 Standard (Complete) $299**, P4 Full Bundle $399 | $194 / $176 |
| [`BOM-s3.csv`](../BOM-s3.csv) | S3 Complete/lite ($249–269, later) | $175 / $157 |

Сводки и маржа — [`docs/33-bom-s3.md`](33-bom-s3.md); комплектация SKU, упаковка,
вкладыш, серийники, QC — [`docs/40-kit-contents.md`](40-kit-contents.md).
