martiyanov/bukifon/BOM-s3.csv

ref | блок | наименование | номинал/корпус | кол-во | цена за шт (RUB) | цена итого (RUB) | источник/ссылка | замена | примечание | цена за шт (USD) | итого (USD) | вариант | статус | цена 10+ (RUB/шт) | итого 10 шт (RUB) | цена 25+ (RUB/шт) | итого 25 шт (RUB)
C-S3-01 | CORE-S3 rev.3 | ESP32-S3-WROOM-1-N16R8 | 16 МБ flash, 8 МБ octal PSRAM | 1 | 410 | 410.0 | LCSC C2913202 $5.08 | ESP32-S3-WROOM-1-N8R2 | Ключевая позиция SKU; batch — ±3% | 5.12 | 5.12 | kit | draft; цена с источника | 400 | 400.0 | 390 | 390.0
C-S3-02 | CORE-S3 rev.3 | PCM5102A (I2S DAC) | TSSOP-20 | 1 | 280 | 280.0 | chipdip 580 ₽ / Ali | PCM5122 | Выход | 3.5 | 3.5 | kit | draft; оценка ±30% | 270 | 270.0 | 260 | 260.0
C-S3-03 | CORE-S3 rev.3 | PCM1808 (I2S ADC) | TSSOP-14 | 1 | 170 | 170.0 | Mouser $2.12 | PCM1804 | AUDIO IN / сэмплер | 2.12 | 2.12 | kit | draft; цена с источника | 160 | 160.0 | 150 | 150.0
C-S3-04 | CORE-S3 rev.3 | MCP4728A0-E/UN + MCP4728A1-E/UN | MSOP-10, 0x60/0x61 | 2 | 300 | 600.0 | rlocman ≈330 ₽ | SPI-DAC / прошивка адреса | 6 CV out; один адрес программируется на стенде (D-43) | 3.75 | 7.5 | kit | draft; оценка ±30% | 280 | 560.0 | 260 | 520.0
C-S3-05 | CORE-S3 rev.3 | MCP3208 (8×12 SPI ADC) | SO-16 | 1 | 400 | 400.0 | chipdip 880 ₽ | MCP3208-BI | CV in/фейдеры/батарея | 5 | 5 | kit | draft; оценка ±30% | 370 | 370.0 | 350 | 350.0
C-S3-06 | CORE-S3 rev.3 | EEPROM 24LC32A (калибровка) | DIP-8 | 1 | 60 | 60.0 | chipdip 280 ₽ / Ali | 24C32 | Калибровка/CV | 0.75 | 0.75 | kit | draft; оценка ±30% | 55 | 55.0 | 50 | 50.0
C-S3-07 | CORE-S3 rev.3 | 6N137 (MIDI IN) | DIP-8 | 1 | 60 | 60.0 | platan 24–124 ₽ | HPL6N137 | TRS MIDI | 0.75 | 0.75 | kit | draft; оценка ±30% | 55 | 55.0 | 50 | 50.0
C-S3-08 | CORE-S3 rev.3 | 74HCT125 (MIDI OUT) | SOIC-14 | 1 | 60 | 60.0 | chipdip/rlocman | SN74HCT125 | — | 0.75 | 0.75 | kit | draft; оценка ±30% | 55 | 55.0 | 50 | 50.0
C-S3-09 | CORE-S3 rev.3 | TL074 (CV-буферы) | DIP-14 | 4 | 22 | 88.0 | chipcity 24 ₽ | TL084 | O-17 исправлено по netlist CORE-S3: U37/U38/U39/U45 = 4 шт (в BOM-cores3 было qty=20 — ошибка агрегации; hw-core правит файл) | 0.28 | 1.1 | kit | draft; оценка ±30% | 20 | 80.0 | 18 | 72.0
C-S3-10 | CORE-S3 rev.3 | TL072 (LINE/PHONES) | DIP-8 | 1 | 25 | 25.0 | chipdip | NE5532 | O-17: U33 = 1 шт (в BOM-cores3 было qty=3 — дубли позиций) | 0.31 | 0.31 | kit | draft; оценка ±30% | 23 | 23.0 | 20 | 20.0
C-S3-11 | CORE-S3 rev.3 | TPS63802 (3.3 В buck-boost) | SON-10, 1 А; fallback TPS63020 | 1 | 200 | 200.0 | TI/Mouser $2.3–2.6 (оценка) | TPS63020 (fallback) | O-18 закрыт в product BOM: TPS63000 placeholder заменён на TPS63802/TPS63020 (D-49); цена — оценка | 2.5 | 2.5 | kit | draft; оценка ±30% | 185 | 185.0 | 170 | 170.0
C-S3-12 | CORE-S3 rev.3 | BQ24074 (charger + power-path) | VQFN-16 | 1 | 260 | 260.0 | Mouser $3.24 | TP4056 + ideal-diode | Заряд 1S от USB-C | 3.25 | 3.25 | kit | draft; цена с источника | 240 | 240.0 | 220 | 220.0
C-S3-13 | CORE-S3 rev.3 | MT3608 (boost подсветки 20 В) | SOT-23-6 | 1 | 80 | 80.0 | AliExpress | — | BL_20V | 1 | 1 | kit | draft; оценка ±30% | 70 | 70.0 | 60 | 60.0
C-S3-14 | CORE-S3 rev.3 | USBLC6-2SC6 (ESD USB) | SOT-23-6 | 1 | 45 | 45.0 | chipdip | PRTR5V0U2X | — | 0.56 | 0.56 | kit | draft; оценка ±30% | 40 | 40.0 | 35 | 35.0
C-S3-15 | CORE-S3 rev.3 | 2N7000 (ключ) | TO-92 | 1 | 15 | 15.0 | chipdip | BS170 | — | 0.19 | 0.19 | kit | draft; оценка ±30% | 13 | 13.0 | 12 | 12.0
C-S3-16 | CORE-S3 rev.3 | BAT54S (защита CV/аудио) | SOT-23, 12 шт | 12 | 15 | 180.0 | chipdip | BAV99 | — | 0.19 | 2.25 | kit | draft; оценка ±30% | 13 | 156.0 | 12 | 144.0
C-S3-17 | CORE-S3 rev.3 | Диоды/защита (SS34×7, SMAJ×4) | SMA | 11 | 12 | 132.0 | platan | SK34/P6SMB | 13–15 В шины | 0.15 | 1.65 | kit | draft; оценка ±30% | 11 | 121.0 | 10 | 110.0
C-S3-18 | CORE-S3 rev.3 | Пассив CORE-S3: R 0805 | 83 шт | 83 | 1.2 | 99.6 | LCSC/Ali | — | Резисторы | 0.01 | 1.24 | kit | draft; оценка ±30% | 1 | 83.0 | 0.9 | 74.7
C-S3-19 | CORE-S3 rev.3 | Пассив CORE-S3: C 0805 | 79 шт | 79 | 1.5 | 118.5 | LCSC/Ali | — | Керамика | 0.02 | 1.48 | kit | draft; оценка ±30% | 1.3 | 102.7 | 1.1 | 86.9
C-S3-20 | CORE-S3 rev.3 | Электролиты SMD | 15 шт | 15 | 6 | 90.0 | chipdip | — | 100–220 мкФ | 0.07 | 1.12 | kit | draft; оценка ±30% | 5 | 75.0 | 4.5 | 67.5
C-S3-21 | CORE-S3 rev.3 | Предохранители/ферриты/дроссели | 5+6+2 шт | 13 | 18 | 234.0 | LCSC/chipdip | — | Fuse 1206, 600R, 22uH/1.5uH | 0.23 | 2.92 | kit | draft; оценка ±30% | 16 | 208.0 | 14 | 182.0
C-S3-22 | CORE-S3 rev.3 | Разъёмы CORE-S3 (USB-C, FFC-40, IDC-16, 3×IDC-26, IDC-20, IDC-12, microSD, клеммник, DC) | 1 компл. | 1 | 640 | 640.0 | LCSC/Ali/chipdip | — | Инертные позиции, заказывать первыми | 8 | 8 | kit | draft; оценка ±30% | 600 | 600.0 | 560 | 560.0
C-S3-23 | CORE-S3 rev.3 | Задние джеки CORE-S3 (5 аудио + 2 MIDI) | 3.5 мм, 7 шт | 7 | 60 | 420.0 | Thonk/PJ-307 | PJ301M-12 | LINE L/R, PHONES, AUDIO IN L/R, MIDI IN/OUT | 0.75 | 5.25 | kit | draft; оценка ±30% | 55 | 385.0 | 50 | 350.0
C-S3-24 | CORE-S3 rev.3 | PCB CORE-S3 (1 шт) | 2 слоя, 1.6 мм | 1 | 300 | 300.0 | JLCPCB | Rezon | Панелизация партии 10–25 — ±30% | 3.75 | 3.75 | kit | draft; оценка ±30% | 200 | 200.0 | 150 | 150.0
C-2-26 | CORE-S3 rev.3 | MAX9814 (AGC mic preamp) | TDFN-14, 3×3 мм | 1 | 200 | 200.0 | Mouser/LCSC ≈$2.5 | — | D-91; AGC, V_TH=R107/R108; обвязка ниже | 2.5 | 2.5 | kit | draft; оценка ±30% | 190 | 190.0 | 180 | 180.0
C-2-27 | CORE-S3 rev.3 | TS5A23157 (line/mic switch) | MSOP-10/VSSOP-10 | 1 | 96 | 96.0 | Mouser ≈$1.2 | — | MIC_SEL: LINE по умолчанию (R110 pull-down) | 1.2 | 1.2 | kit | draft; оценка ±30% | 90 | 90.0 | 85 | 85.0
C-2-28 | CORE-S3 rev.3 | J20 MIC IN 3.5 мм TRS (electret) | панельный джек, tip=signal, ring=bias | 1 | 120 | 120.0 | chipdip/Thonk | PJ301M-12 | Задняя стенка; R106 2.2k bias | 1.5 | 1.5 | kit | draft; оценка ±30% | 115 | 115.0 | 110 | 110.0
C-2-29 | CORE-S3 rev.3 | MIC ESD: D30 SMAJ5.0A + 2× USBLC6-2 | SMA + SOT-23-6, 3 шт | 1 | 64 | 64.0 | platan/chipdip | — | Защита J20 и линий mic I2S (U48/U49) | 0.8 | 0.8 | kit | draft; оценка ±30% | 61 | 61.0 | 58 | 58.0
C-2-30 | CORE-S3 rev.3 | MIC passives/биас CORE-2 | R106 2.2k, R107 150k, R108 100k, R110/R113 100k; C122 1u, C123/C125 470n, C124 2.2u, C126 1u, C127 100n, C128 10u | 1 | 120 | 120.0 | LCSC/Ali | — | AGC threshold/attack/release, AC-связь, фильтры питания | 1.5 | 1.5 | kit | draft; оценка ±30% | 115 | 115.0 | 110 | 110.0
C-2-31 | CORE-S3 rev.3 | J19 IDC-6 + FB8 600Ω (mic I2S) | IDC-6 2×3 + феррит | 1 | 80 | 80.0 | quartz1/LCSC | — | MEMS-шлейф PANEL-2 J16 ↔ CORE-2 J19; FB8 фильтр 3.3 В | 1 | 1 | kit | draft; оценка ±30% | 76 | 76.0 | 72 | 72.0
C-2-32 | CORE-S3 rev.3 | Изменения rev.3: R25/R26/C52, R32–R34 сняты (DNP) | — | 1 | 0 | 0.0 | — | — | Не входят в COGS; для сверки с BOM-core2 rev.3 | 0 | 0 | kit | draft; оценка ±30% | 0 | 0.0 | 0 | 0.0
P-2-01 | PANEL-2 rev.3 | MCP23017 (I2C I/O) | SOIC-28, 0x20…0x23 | 4 | 230 | 920.0 | rlocman ≈204 ₽ | MCP23S17 | 16 EC11 + 42 кнопки + 10 джеков; 4 чипа (docs/31) | 2.88 | 11.5 | kit | draft; оценка ±30% | 210 | 840.0 | 190 | 760.0
P-2-02 | PANEL-2 rev.3 | Энкодер EC11 с кнопкой | 16 шт, D-вал 6 мм | 16 | 96 | 1536.0 | Ali/radelin, $0.65–0.90 (опт) | EC11E/EC12 | Главный риск дефицита; опт — ±30% | 1.2 | 19.2 | kit | draft; оценка ±30% | 72 | 1152.0 | 60 | 960.0
P-2-03 | PANEL-2 rev.3 | Kailh Choc v1 | 42 шт | 42 | 35 | 1470.0 | ergosplits 39.4 ₽ | Choc v2 | Опт 100+ — ±30% | 0.44 | 18.38 | kit | draft; оценка ±30% | 30 | 1260.0 | 28 | 1176.0
P-2-04 | PANEL-2 rev.3 | Гнездо hot-swap Choc | 42 шт | 42 | 5 | 210.0 | AliExpress | Kailh CPG1350 | Нет в BOM-panel2 — добавлено (оценка) | 0.06 | 2.62 | kit | draft; оценка ±30% | 4.5 | 189.0 | 4 | 168.0
P-2-05 | PANEL-2 rev.3 | Фейдер 60 мм (POT60) | Bourns PTA6043 / ALPS | 2 | 350 | 700.0 | Ali/Mouser | ALPS RS60N11 | Опт — ±30% | 4.38 | 8.75 | kit | draft; оценка ±30% | 300 | 600.0 | 250 | 500.0
P-2-06 | PANEL-2 rev.3 | Mini-jack 3.5 мм | Thonkiconn/PJ301M-12, 10 шт | 10 | 60 | 600.0 | Thonk £0.38–0.49 | PJ307 | 4 CV OUT + 4 CV IN + GATE OUT + GATE IN | 0.75 | 7.5 | kit | draft; оценка ±30% | 55 | 550.0 | 50 | 500.0
P-2-07 | PANEL-2 rev.3 | 1N4148 (матрица 42 клавиш) | SOD-323, 42 шт | 42 | 2.5 | 105.0 | quartz1 6 ₽ | 1N4148W | — | 0.03 | 1.31 | kit | draft; оценка ±30% | 2.2 | 92.4 | 2 | 84.0
P-2-08 | PANEL-2 rev.3 | WS2812B-2020 (подсветка) | 17 шт | 17 | 8 | 136.0 | radiodetali | SK6812MINI-E | 16 энкодеров + статус | 0.1 | 1.7 | kit | draft; оценка ±30% | 7 | 119.0 | 6 | 102.0
P-2-09 | PANEL-2 rev.3 | 74HCT1G125 (буфер LED) | SOT-23-5 | 1 | 30 | 30.0 | chipdip | 74AHCT1G125 | — | 0.38 | 0.38 | kit | draft; оценка ±30% | 28 | 28.0 | 25 | 25.0
P-2-10 | PANEL-2 rev.3 | 74LVC1G17 (GATE IN) | SOT-23-5 | 1 | 30 | 30.0 | chipdip | — | Шмитт-триггер | 0.38 | 0.38 | kit | draft; оценка ±30% | 28 | 28.0 | 25 | 25.0
P-2-11 | PANEL-2 rev.3 | BAT54S + SMAJ (защита джеков) | SOT-23 + SMA, 10 шт | 10 | 14 | 140.0 | chipdip/platan | — | — | 0.17 | 1.75 | kit | draft; оценка ±30% | 13 | 130.0 | 12 | 120.0
P-2-12 | PANEL-2 rev.3 | Пассив PANEL-2: R 0603 | 106 шт | 106 | 1 | 106.0 | LCSC/Ali | — | Подтяжки/RC | 0.01 | 1.32 | kit | draft; оценка ±30% | 0.9 | 95.4 | 0.8 | 84.8
P-2-13 | PANEL-2 rev.3 | Пассив PANEL-2: C 0603 | 70 шт | 70 | 1 | 70.0 | LCSC/Ali | — | 100 нФ | 0.01 | 0.88 | kit | draft; оценка ±30% | 0.9 | 63.0 | 0.8 | 56.0
P-2-14 | PANEL-2 rev.3 | Разъёмы PANEL-2 (FFC-40, IDC-16, IDC-26) | 1 компл. | 1 | 160 | 160.0 | Hirose FH12 / IDC | — | FFC-40 (FH12-40S) + IDC | 2 | 2 | kit | draft; оценка ±30% | 150 | 150.0 | 140 | 140.0
P-2-15 | PANEL-2 rev.3 | PCB PANEL-2 (1 шт) | 380×210, 2 слоя | 1 | 300 | 300.0 | JLCPCB | Rezon | ±30% | 3.75 | 3.75 | kit | draft; оценка ±30% | 200 | 200.0 | 150 | 150.0
P-2-16 | PANEL-2 rev.3 | ICS-43434 (I2S MEMS-микрофон) | TDK InvenSense, 3.5×2.65 мм, 24 бит, 3.3 В | 1 | 320 | 320.0 | Mouser/LCSC ≈$4 | INMP441 (дешевле) | Акустический порт верхней кромки; MIC ON LED | 4 | 4 | kit | draft; оценка ±30% | 300 | 300.0 | 280 | 280.0
P-2-17 | PANEL-2 rev.3 | J16 IDC-6 + MIC-шлейф | 2×3 box header + шлейф 10 см | 1 | 160 | 160.0 | quartz1/Ali | — | BCK/WS/DATA/3V3/2×GND, 1:1 к CORE-2 J19 | 2 | 2 | kit | draft; оценка ±30% | 150 | 150.0 | 140 | 140.0
P-2-18 | PANEL-2 rev.3 | SW1 SS-12D00 (слайд-мьют) | SPST slide, low profile | 1 | 40 | 40.0 | chipdip/Ali | — | Разрывает питание микрофона (R-37) | 0.5 | 0.5 | kit | draft; оценка ±30% | 38 | 38.0 | 36 | 36.0
P-2-19 | PANEL-2 rev.3 | LED MIC ON + R121 1k | LED 0603 зелёный + резистор | 1 | 16 | 16.0 | LCSC | — | Индикатор питания микрофона | 0.2 | 0.2 | kit | draft; оценка ±30% | 15 | 15.0 | 14 | 14.0
P-2-20 | PANEL-2 rev.3 | FB1 600Ω @100 МГц (MIC) | 0805 | 1 | 24 | 24.0 | LCSC/Ali | — | Развязка MIC от WS2812/BL | 0.3 | 0.3 | kit | draft; оценка ±30% | 23 | 23.0 | 22 | 22.0
P-2-21 | PANEL-2 rev.3 | SRV05-4 (ESD MIC_BCK/WS/DATA) | SOT-23-6 | 1 | 40 | 40.0 | LCSC | — | ESD-матрица 4 линии | 0.5 | 0.5 | kit | draft; оценка ±30% | 38 | 38.0 | 36 | 36.0
P-2-22 | PANEL-2 rev.3 | MIC passives PANEL-2: 33R×3 + 10u + 100n | 0603 | 1 | 40 | 40.0 | LCSC/Ali | — | Серия I2S, развязка | 0.5 | 0.5 | kit | draft; оценка ±30% | 38 | 38.0 | 36 | 36.0
W-2-01 | PWR-2 | TPS61088 (boost +12 В) | QFN-20 | 1 | 250 | 250.0 | TI/Mouser $2.5–3 | — | Шина +12 В (330 мА) | 3.12 | 3.12 | kit | draft; оценка ±30% | 230 | 230.0 | 210 | 210.0
W-2-02 | PWR-2 | TPS61088 (boost +5 В) | QFN-20 | 1 | 250 | 250.0 | TI/Mouser | — | +5 В 1 А | 3.12 | 3.12 | kit | draft; оценка ±30% | 230 | 230.0 | 210 | 210.0
W-2-03 | PWR-2 | LMR33630 (IBB −12 В) | SOIC-8 PowerPAD | 1 | 200 | 200.0 | TI/Mouser $2–2.5 | — | −12 В (D-32) | 2.5 | 2.5 | kit | draft; оценка ±30% | 185 | 185.0 | 170 | 170.0
W-2-04 | PWR-2 | BQ29700 (BMS 1S) | SOT-23-6 | 1 | 60 | 60.0 | chipdip/Ali | FS312F | Без банок (D-39); плата battery-ready | 0.75 | 0.75 | kit | draft; оценка ±30% | 55 | 55.0 | 50 | 50.0
W-2-05 | PWR-2 | MAX17048 (fuel gauge) | SOT-23-6 | 1 | 120 | 120.0 | Mouser $1.5 | — | I2C 0x36 | 1.5 | 1.5 | kit | draft; оценка ±30% | 110 | 110.0 | 100 | 100.0
W-2-06 | PWR-2 | MCP130-270 (супервизор) | SOT-23 | 1 | 40 | 40.0 | chipdip | — | PWR_GOOD | 0.5 | 0.5 | kit | draft; оценка ±30% | 36 | 36.0 | 32 | 32.0
W-2-07 | PWR-2 | PC817 (оптопара EN) | DIP-4 | 1 | 30 | 30.0 | chipdip | — | EN −12 В | 0.38 | 0.38 | kit | draft; оценка ±30% | 28 | 28.0 | 25 | 25.0
W-2-08 | PWR-2 | MOSFET AO3400A/AO3401A + MMBT3904 | SOT-23, 7 шт | 7 | 15 | 105.0 | LCSC | — | BMS/ключи/переполюсовка | 0.19 | 1.31 | kit | draft; оценка ±30% | 13 | 91.0 | 12 | 84.0
W-2-09 | PWR-2 | 2N7002 (ключ EN) | SOT-23, 2 шт | 2 | 12 | 24.0 | chipdip | — | — | 0.15 | 0.3 | kit | draft; оценка ±30% | 11 | 22.0 | 10 | 20.0
W-2-10 | PWR-2 | Диоды защиты (SMBJ/SMAJ) | SMA, 8 шт | 8 | 12 | 96.0 | platan | — | TVS рельсов | 0.15 | 1.2 | kit | draft; оценка ±30% | 11 | 88.0 | 10 | 80.0
W-2-11 | PWR-2 | Дроссели силовые | 6 шт | 6 | 40 | 240.0 | LCSC/Bourns | — | 10uH/4A, 22uH/2A, 4.7uH | 0.5 | 3 | kit | draft; оценка ±30% | 36 | 216.0 | 32 | 192.0
W-2-12 | PWR-2 | Пассив PWR-2 (R 0603) | 36 шт | 36 | 1 | 36.0 | LCSC/Ali | — | ОС/фильтры | 0.01 | 0.45 | kit | draft; оценка ±30% | 0.9 | 32.4 | 0.8 | 28.8
W-2-13 | PWR-2 | Пассив PWR-2 (C 0805/1210) | 33 шт | 33 | 1.5 | 49.5 | LCSC/Ali | — | Вход/выход | 0.02 | 0.62 | kit | draft; оценка ±30% | 1.3 | 42.9 | 1.1 | 36.3
W-2-14 | PWR-2 | Электролиты + предохранители | 12 шт | 12 | 8 | 96.0 | chipdip | — | 47 мкФ, полифьюзы | 0.1 | 1.2 | kit | draft; оценка ±30% | 7 | 84.0 | 6 | 72.0
W-2-15 | PWR-2 | Холдеры 18650 (Keystone) | 2 шт | 2 | 60 | 120.0 | Ali/Mouser | — | Холдеры с ключом; банки — опция | 0.75 | 1.5 | kit | draft; оценка ±30% | 55 | 110.0 | 50 | 100.0
W-2-16 | PWR-2 | Разъёмы PWR-2 (PACK 3P, IDC-20, IDC-12, SW) | 1 компл. | 1 | 160 | 160.0 | LCSC/chipdip | — | — | 2 | 2 | kit | draft; оценка ±30% | 150 | 150.0 | 140 | 140.0
W-2-17 | PWR-2 | NTC 10 кОм + силовой выключатель | 1 компл. | 1 | 90 | 90.0 | chipdip/Ali | — | — | 1.12 | 1.12 | kit | draft; оценка ±30% | 80 | 80.0 | 70 | 70.0
W-2-18 | PWR-2 | PCB PWR-2 (1 шт) | 2 слоя, 1.6 мм | 1 | 300 | 300.0 | JLCPCB | Rezon | ±30% | 3.75 | 3.75 | kit | draft; оценка ±30% | 200 | 200.0 | 150 | 150.0
M-01 | Корпус B-light и печать | Печать корпуса B-light (PETG) | 230 г, 11.1 ч, клин 8° | 230 | 1.5 | 345.0 | PETG 1 кг ≈1500 ₽ (dakson) | B (277 г) / v0.4 | Материал + ~10% брак; без амортизации принтера | 0.02 | 4.31 | kit | draft; оценка ±30% | 1.4 | 322.0 | 1.3 | 299.0
M-02 | Корпус B-light и печать | Печать колпачков/ручек (PLA) | 42 колпачка + 16 ручек ≈100 г | 100 | 1.5 | 150.0 | PLA 1 кг ≈1400 ₽ | премиум-колпачки (опция) | Базовая печать MBK-подобных | 0.02 | 1.88 | kit | draft; оценка ±30% | 1.4 | 140.0 | 1.3 | 130.0
M-03 | Корпус B-light и печать | Крепёж M3 + термовтулки | набор | 1 | 250 | 250.0 | 9v.ru/Ali | — | Винты/втулки/стойки | 3.12 | 3.12 | kit | draft; оценка ±30% | 240 | 240.0 | 230 | 230.0
M-04 | Корпус B-light и печать | Шлейфы/внутренний USB-C/FFC | комплект | 1 | 200 | 200.0 | darxton/Ali | — | IDC/FFC + USB-C | 2.5 | 2.5 | kit | draft; оценка ±30% | 190 | 190.0 | 180 | 180.0
M-05 | Корпус B-light и печать | Печать mic-деталей (mic_guide/mic_clip_rear/mic_holder_top) | PETG/PLA ≈1.4 г | 1 | 5 | 5.0 | печать (профиль B-light) | — | mic_holder_top + клипсы; +1.4 г к 230 г | 0.06 | 0.06 | kit | draft; оценка ±30% | 5 | 5.0 | 5 | 5.0
M-06 | Корпус B-light и печать | Сетка/поролон микрофона (расходник) | акустическая сетка + поролон | 1 | 80 | 80.0 | Ali/хозяйственный | — | Защита порта MEMS | 1 | 1 | kit | draft; оценка ±30% | 80 | 80.0 | 80 | 80.0
O-01 | Опции (вне $199 kit) | Аккумуляторный пак 1S2P matched + NTC | сваренный/с PCM | 1 | 1500 | 1500.0 | сборка/поставщик | 2×18650 в холдерах (600 ₽) | D-39: не продавать россыпь 18650 в kit | 18.75 | 18.75 | опция | draft; оценка ±30% | 1500 | 1500.0 | 1500 | 1500.0
O-02 | Опции (вне $199 kit) | Внешний БП 12 В 2 А | 5.5/2.1 | 1 | 500 | 500.0 | anteyr/любой | — | Старт без батареи | 6.25 | 6.25 | опция | draft; оценка ±30% | 500 | 500.0 | 500 | 500.0
O-03 | Опции (вне $199 kit) | microSD 32 ГБ A1 | SDHC | 1 | 650 | 650.0 | любой магазин | — | Сэмплы/пресеты | 8.12 | 8.12 | опция | draft; оценка ±30% | 650 | 650.0 | 650 | 650.0
O-04 | Опции (вне $199 kit) | Картриджи (VCO-1+FILTER-1+LADDER-1+ENSEMBLE-1) | 4 модуля + PCB | 1 | 3200 | 3200.0 | по BOM модулей | — | Аналоговая часть — опция (D-38) | 40 | 40 | опция | draft; оценка ±30% | 3200 | 3200.0 | 3200 | 3200.0
O-05 | Опции (вне $199 kit) | Сменная дека DECK-PAD | 18 пэдов (+FSR опция) | 1 | 2600 | 2600.0 | по BOM деки | — | Опция | 32.5 | 32.5 | опция | draft; оценка ±30% | 2600 | 2600.0 | 2600 | 2600.0
O-06 | Опции (вне $199 kit) | Премиум-колпачки (MBK) | 42 шт | 1 | 1500 | 1500.0 | Ali/групзакупка | — | Опция | 18.75 | 18.75 | опция | draft; оценка ±30% | 1500 | 1500.0 | 1500 | 1500.0
O-07 | Опции (вне $199 kit) | USB-C кабель + сумка | комплект | 1 | 1000 | 1000.0 | любой магазин | — | Опция | 12.5 | 12.5 | опция | draft; оценка ±30% | 1000 | 1000.0 | 1000 | 1000.0
D-01 | Дисплей 5″ (SPI, lite) | TFT 5.0″ 800×480 IPS SPI, FPC-40 (ER-TFTMC050-3 / ILI9488) | SPI 4-wire, 0.5 мм, 40-pin (варианты: 50-pin) | 1 | 1800 | 1800.0 | BuyDisplay ER-TFTMC050-3 $22.92 (SPI/RA8875, 40-pin) / Ali | ER-TFTM050-3 (ILI9488 SPI), ST7796S 40-pin; 50-pin через адаптер | S3-lite SPI-вариант (D-51). MPN: ER-TFTMC050-3 (контроллер на модуле, SPI/8080) или ILI9488/ST7796S 40-pin; для P4 основной — RGB 40-pin (docs/47) | 22.5 | 22.5 | kit | draft; оценка ±30% | 1700 | 1700.0 | 1600 | 1600.0
