martiyanov/bukifon/BOM.csv

ref | блок | наименование | номинал/корпус | кол-во | цена за шт (RUB) | цена итого (RUB) | источник/ссылка | замена | примечание | цена за шт (USD) | цена итого (USD) | вариант | статус
C-01 | Ядро v0.5 (MCU, аудио, память, IO) | ESP32-P4 dev board / модуль (32 МБ PSRAM) | ESP32-P4-WROOM-1-N16R32 или dev-board, USB HS, RGB/DSI | 1 | 1500 | 1500 | AliExpress/LCSC: модуль ¥60 ≈ $8.5; ESP32-P4-Function-EV-Board $55–70 (Mouser/Voelkner) | ESP32-P4-Function-EV-Board; Waveshare ESP32-P4 | Целевая платформа по spec/90 R-12/D-07; бенчмарк P1 — до закупки плат. S3 — только «лайт» (C-02). | 18.75 | 18.75 | да | draft; оценка ±30%
C-02 | Ядро v0.5 (MCU, аудио, память, IO) | ESP32-S3-WROOM-1-N16R8 (альтернатива «лайт») | 16 МБ flash, 8 МБ PSRAM, PCB-антенна | 1 | 410 | 410 | LCSC C2913202: $5.08 (1 шт) | ESP32-S3-WROOM-1-N8R2 | Не входит в итоги: для 8×8 UAC2 не проходит (9.2 Мбит/с > FS), экран ~13 fps (docs/11). | 5.08 | 5.08 | альтернатива | draft; цена с источника; альтернатива, не в итогах
C-03 | Ядро v0.5 (MCU, аудио, память, IO) | PCM5102A (I2S ЦАП) | модуль/чип, 112 дБ | 1 | 280 | 280 | chipdip.ru (580 ₽) / Ali | PCM5102A-модуль; PCM5122 | Основной выход; на chipdip под заказ. | 3.5 | 3.5 | да | draft; оценка ±30%
C-04 | Ядро v0.5 (MCU, аудио, память, IO) | PCM1808 (I2S АЦП, AUDIO IN) | TSSOP-14, 24 бит/96 кГц, 2 канала | 1 | 170 | 170 | Mouser 595-PCM1808PW: $2.12 (1 шт) | PCM1808QPWRQ1 (авто), PCM1804 | Вход для сэмплера/эффектора (spec/90 R-09); нужен MCLK 256fs. | 2.12 | 2.12 | да | draft; цена с источника
C-05 | Ядро v0.5 (MCU, аудио, память, IO) | MCP4728A0-E/UN + MCP4728A1-E/UN | 2×4 канала 12 бит I2C, 0x60 + 0x61 | 2 | 300 | 600 | rlocman.ru ≈330 ₽; Ali ≈$3.5 | MCP4728A7 (один адрес) | 6 CV out (R-10): #1 на шину CV1…4, #2 на джеки CV5/6. Адрес задаётся исполнением A0/A1. | 3.75 | 7.5 | да | draft; оценка ±30%
C-06 | Ядро v0.5 (MCU, аудио, память, IO) | MCP3208 (8×12 бит SPI АЦП) | SO-16 | 1 | 400 | 400 | chipdip.ru 880 ₽ / Ali | MCP3208-BI/SL | CV in, фейдеры, батарея/температура (spec/50 §1a). | 5 | 5 | да | draft; оценка ±30%
C-07 | Ядро v0.5 (MCU, аудио, память, IO) | MCP23017 (I2C 16 I/O) | DIP-28/SOIC-28, 0x20/0x21/0x22 | 3 | 230 | 690 | rlocman.ru медиана ≈204 ₽ | MCP23S17 (SPI) | 2 шт — 16 энкодеров A/B (32 линии); 1 шт — кнопки энкодеров/панель. Матрица 42 клавиш — 13 GPIO MCU. | 2.88 | 8.64 | да | draft; оценка ±30%
C-08 | Ядро v0.5 (MCU, аудио, память, IO) | EEPROM 24C32 (калибровка) | DIP-8/SOIC-8, адрес 0x57 | 1 | 60 | 60 | chipdip.ru 280 ₽ / Ali | 24C32 | Калибровка CV/DECK_ID, счётчик часов. | 0.75 | 0.75 | да | draft; оценка ±30%
C-09 | Ядро v0.5 (MCU, аудио, память, IO) | 6N137 (оптопара MIDI IN) | DIP-8, 10 Мбит/с | 1 | 60 | 60 | platan.ru 24–124 ₽ | HPL6N137-D8 | TRS MIDI Type A + USB-MIDI. | 0.75 | 0.75 | да | draft; оценка ±30%
C-10 | Ядро v0.5 (MCU, аудио, память, IO) | 74HCT125 (буфер MIDI OUT) | DIP-14 | 1 | 60 | 60 | chipdip/rlocman 56–120 ₽ | SN74HCT125N | MIDI THRU/OUT. | 0.75 | 0.75 | да | draft; оценка ±30%
C-11 | Ядро v0.5 (MCU, аудио, память, IO) | MCP1700-3302E (LDO 3.3 В, 250 мА) | TO-92/SOT-23 | 1 | 77 | 77 | LCSC C511277: $0.96 (1 шт) | AP2112K-3.3 (600 мА) | Питание логики/панели; AP2112K — если нужен больший ток. | 0.96 | 0.96 | да | draft; цена с источника
C-12 | Ядро v0.5 (MCU, аудио, память, IO) | USBLC6-2SC6 (ESD USB) | SOT-23-6 | 1 | 45 | 45 | chipdip.ru / Ali | PRTR5V0U2X | Защита USB-C DATA/CHARGE. | 0.56 | 0.56 | да | draft; оценка ±30%
C-13 | Ядро v0.5 (MCU, аудио, память, IO) | USB-C 16P (DATA + CHARGE) | панельные/на плату, 2 шт | 2 | 100 | 200 | AliExpress / chipdip.ru | USB4085, USB-C 16P | DATA/MIDI и CHARGE (TP4056/BQ24074). | 1.25 | 2.5 | да | draft; оценка ±30%
C-14 | Ядро v0.5 (MCU, аудио, память, IO) | Слот microSD (push-push) | SMD, 0.5 мм | 1 | 50 | 50 | LCSC $0.15–0.65 / Ali | microSD push-push | Сэмплы/пресеты; стриминг с SD. | 0.62 | 0.62 | да | draft; оценка ±30%
C-15 | Ядро v0.5 (MCU, аудио, память, IO) | microSD 32 ГБ (A1/U1) | SDHC, 32 ГБ | 1 | 650 | 650 | любой магазин | 32–64 ГБ A1 | Для 8 моно-дорожек по 30 с + пресеты. | 8.12 | 8.12 | да | draft; оценка ±30%
C-16 | Ядро v0.5 (MCU, аудио, память, IO) | FFC-разъём 40P 0.5 мм | SMD, right angle, flip-top | 1 | 45 | 45 | LCSC $0.54 / Ali | 40P 0.5 мм | Под дисплей FPC-40 (если 50-pin — C-18). | 0.54 | 0.54 | да | draft; цена с источника
C-17 | Ядро v0.5 (MCU, аудио, память, IO) | FFC-шлейф 40P 0.5 мм, 100 мм | 40 pin, same side | 1 | 90 | 90 | AliExpress | FFC 40P 0.5 | Дисплей → PANEL-1. | 1.12 | 1.12 | да | draft; оценка ±30%
C-18 | Ядро v0.5 (MCU, аудио, память, IO) | FFC 50P 0.5 мм (комплект) | 50P разъём + шлейф | 1 | 160 | 160 | AliExpress | — | Только если выбран 50-pin дисплей (проверить даташит панели). | 2 | 2 | полный | draft; оценка ±30%; только «полный»
C-19 | Ядро v0.5 (MCU, аудио, память, IO) | Ферриты/ESD/обвязка питания | 600 Ω 0805 + 100 нФ + электролиты | 1 | 150 | 150 | chipdip/Ali | — | Развязка цифры/аудио, защита входов. | 1.88 | 1.88 | да | draft; оценка ±30%
D-01 | Дисплей 5.0″ и подсветка | TFT 5.0″ 800×480 IPS RGB, FPC-40 | активная 108×64.8, без рамки (R-05) | 1 | 960 | 960 | AliExpress $8.5–15 (MOQ 10) / DigiKey Newhaven $73 | NHD-5.0-800480TF-ATXL# (дорого), 50-pin вариант | Голое стекло под вырез 108×64.8 (spec/70 §5); интерфейс RGB/DSI — проверяется на P1. | 12 | 12 | да | draft; оценка ±30%
D-02 | Дисплей 5.0″ и подсветка | Драйвер подсветки (boost CC) | 12 WLED, 19.2 В, 40 мА | 1 | 80 | 80 | AliExpress/chipdip | PT4115, MP3302, TPS61165 | 5″ панель требует ~19 В на подсветку — от 5 В напрямую нельзя. | 1 | 1 | да | draft; оценка ±30%
D-03 | Дисплей 5.0″ и подсветка | Плёнка/пена под стекло | демпфер 0.5–1 мм | 1 | 80 | 80 | любой магазин | — | Компенсатор под рамку screen_carrier (spec/70 §5). | 1 | 1 | да | draft; оценка ±30%
P-01 | Панель: энкодеры, фейдеры, джеки, LED | Энкодер EC11 с кнопкой (Ø14-ручка) | D-вал 6 мм, 20 имп/об | 16 | 140 | 2240 | radelin.ru 87–150 ₽; Ali $1–1.5 | EC11S, PEC11R | 16 шт по R-04; ручки Ø14 печатаются. | 1.75 | 28 | да | draft; оценка ±30%
P-02 | Панель: энкодеры, фейдеры, джеки, LED | Фейдер 60 мм, 10 кОм (китайский) | ход 60 мм, 88×16 мм | 2 | 350 | 700 | AliExpress $3–4 | ALPS RS60N11 (P-03) | Пазы 2.5×63 в панели (spec/70 §4); проверить на образце. | 4.38 | 8.76 | да | draft; оценка ±30%
P-03 | Панель: энкодеры, фейдеры, джеки, LED | ALPS RS60N11 (премиум) | 10 кОм, лог/лин, 60 мм | 2 | 750 | 1500 | Farnell/Mouser €8.68 (1 шт) | Bourns PTA6044 | Замена китайских фейдеров в «полном» варианте. | 9.4 | 18.8 | полный | draft; цена с источника; только «полный»
P-04 | Панель: энкодеры, фейдеры, джеки, LED | Mini-jack 3.5 мм (Thonkiconn/PJ301M-12) | моно/стерео, Ø6, шаг 13.1 | 10 | 60 | 600 | Thonk £0.38–0.49; RU PJ-307 50–80 ₽ | PJ398SM, WQP518MA, PJ307 | 10 джеков сверху (R-06): CV/GATE/MIDI/audio/phones. | 0.75 | 7.5 | да | draft; оценка ±30%
P-05 | Панель: энкодеры, фейдеры, джеки, LED | Тактовые кнопки 6×6×5 | THT, 4 шт (reset/boot/сервис) | 4 | 13 | 52 | rekshop.ru 13 ₽ | IT-1102WA | Служебные кнопки. | 0.16 | 0.64 | да | draft; оценка ±30%
P-06 | Панель: энкодеры, фейдеры, джеки, LED | SK6812MINI-E (RGB под клавишами) | 3535, 42 шт | 42 | 9 | 378 | chipdip.ru 28 ₽ / 10.3 ₽ от 500 | WS2812B-2020 | Подсветка Lapka-42 (5 В). | 0.11 | 4.62 | да | draft; оценка ±30%
P-07 | Панель: энкодеры, фейдеры, джеки, LED | WS2812B-2020 (кольца энкодеров + статус) | 2020, 17 шт | 17 | 8 | 136 | radiodetali.com 8.27 ₽ от 100 | SK6812MINI-E | 16 энкодеров + статус. | 0.1 | 1.7 | да | draft; оценка ±30%
P-08 | Панель: энкодеры, фейдеры, джеки, LED | 74HCT1G125 (буфер LED_DATA 3.3→5 В) | SOT-23-5 | 1 | 30 | 30 | chipdip.ru | 74AHCT1G125 | Перед цепочкой LED (5 В). | 0.38 | 0.38 | да | draft; оценка ±30%
P-09 | Панель: энкодеры, фейдеры, джеки, LED | 2N7002 (ключ подсветки) | SOT-23 | 1 | 12 | 12 | chipdip.ru | BSS138 | ШИМ подсветки. | 0.15 | 0.15 | да | draft; оценка ±30%
P-10 | Панель: энкодеры, фейдеры, джеки, LED | Ручки Ø14 ×16 / колпачки фейдеров | печать PETG/PLA | 1 | 0 | 0 | печать (см. блок «Корпус») | — | Входит в стоимость филамента; отдельная закупка не нужна. | 0 | 0 | да | draft; цена с источника
K-01 | Клавиатура Lapka-42 (42 клавиши) | Kailh Choc v1 (низкопрофильный) | 5-pin, hot-swap | 42 | 35 | 1470 | ergosplits.ru 39.4 ₽/шт (100 шт) | Kailh Choc v2 (только v2-гнёзда) | Точная геометрия Lapka-42 (R-03). | 0.44 | 18.48 | да | draft; цена с источника
K-02 | Клавиатура Lapka-42 (42 клавиши) | Гнездо hot-swap Choc | CPG135001S30 | 42 | 5 | 210 | AliExpress $0.07–0.1 | Kailh CPG1350 | Посадочное место — в PCB деке. | 0.06 | 2.52 | да | draft; оценка ±30%
K-03 | Клавиатура Lapka-42 (42 клавиши) | Диод 1N4148 (матрица 6×7) | DO-35, 42 шт | 42 | 2.5 | 105 | quartz1.com 6 ₽ (от 100 — 5 ₽) | 1N4148W SOD-123 | Col2Row, катод к столбцу. | 0.03 | 1.26 | да | draft; оценка ±30%
K-04 | Клавиатура Lapka-42 (42 клавиши) | Колпачки 42 шт (печать) | PLA полупрозрачный / MBK | 1 | 0 | 0 | печать | — | Печать: 42 × ~1.5 г PLA — в блоке «Корпус». | 0 | 0 | да | draft; цена с источника
W-01 | Питание и батарея | Аккумулятор 18650 Li-Ion (защищённый) | 3.6 В, ≥2500 мА·ч, 2 шт | 2 | 300 | 600 | AliExpress/Ozon | Samsung/LG/Panasonic; 21700 (другой холдер) | 1S2P 5000–7000 мА·ч; только одинаковые элементы с защитой. | 3.75 | 7.5 | да | draft; оценка ±30%
W-02 | Питание и батарея | Холдер 2×18650 | с выводами, 68×40×21 | 1 | 120 | 120 | AliExpress | — | Батарейная спина 150×62×16 (spec/50 §1). | 1.5 | 1.5 | да | draft; оценка ±30%
W-03 | Питание и батарея | BMS 1S2P (защита) | DW01+FS312F / модуль 3–5 А | 1 | 150 | 150 | AliExpress | 1S BMS 10 А | Перезаряд/переразряд/КЗ; до холдера. | 1.88 | 1.88 | да | draft; оценка ±30%
W-04 | Питание и батарея | TP4056 (заряд 1S, USB-C) | модуль 5 В/1 А | 1 | 100 | 100 | AliExpress | TP4056 с защитой | База: простой заряд; BQ24074 — «полный» (W-05). | 1.25 | 1.25 | да | draft; оценка ±30%
W-05 | Питание и батарея | BQ24074 (charger + power-path) | VQFN-16, 1.5 А, USB-C | 1 | 260 | 260 | Mouser 595-BQ24074RGTT: $3.24 | TP4056 + ideal-diode | Power-path: игра при заряде без разряда батареи. | 3.24 | 3.24 | полный | draft; цена с источника; только «полный»
W-06 | Питание и батарея | MT3608 (boost 12.2 В/2 А) | модуль, КПД ≈88 % | 1 | 120 | 120 | AliExpress | XL6009 | Питает J-DC 12 В (PWR-BATT-1). | 1.5 | 1.5 | да | draft; оценка ±30%
W-07 | Питание и батарея | MP1584EN (buck 5.1 В/3 А) | SO-8EP | 1 | 55 | 55 | chipdip.ru 90 ₽ | — | 5 В для P4/панели/аудио. | 0.69 | 0.69 | да | draft; цена с источника
W-08 | Питание и батарея | MC34063A (инвертор −12 В) | DIP-8 | 1 | 25 | 25 | chipdip.ru | — | −12 В только для аналоговых картриджей (при наличии). | 0.31 | 0.31 | да | draft; оценка ±30%
W-09 | Питание и батарея | AP2112K-3.3 (LDO 600 мА) | SOT-23-5 | 1 | 20 | 20 | chipdip.ru 22 ₽ | MCP1700 | 3.3 В для логики/панели. | 0.25 | 0.25 | да | draft; цена с источника
W-10 | Питание и батарея | SS34 (Шоттки) | SMA, 40 В 3 А, 3 шт | 3 | 10 | 30 | platan.ru 10 ₽ | SK34 | Вход/VSYS/инвертор. | 0.12 | 0.36 | да | draft; цена с источника
W-11 | Питание и батарея | SMAJ15A (TVS входа 12 В) | SMA 400 Вт | 1 | 10 | 10 | platan.ru | P6SMB16A | Защита входа. | 0.12 | 0.12 | да | draft; цена с источника
W-12 | Питание и батарея | Полифьюз 1.1 А (USB-C заряд) | MF-R110 | 1 | 20 | 20 | chipdip.ru | F1.1 A | По схеме PWR-BATT-1. | 0.25 | 0.25 | да | draft; оценка ±30%
W-13 | Питание и батарея | Предохранитель 3 А + держатель | по выходу батареи | 1 | 30 | 30 | chipdip.ru | F3 A стеклянный | Безопасность 1S2P. | 0.38 | 0.38 | да | draft; оценка ±30%
W-14 | Питание и батарея | Термистор NTC 10 кОм | B3950, 1 % | 1 | 30 | 30 | chipdip.ru | NTC 10k B3435 | Контроль температуры батареи (CH5 MCP3208). | 0.38 | 0.38 | да | draft; оценка ±30%
W-15 | Питание и батарея | Ideal-diode / MOSFET-OR | диод ИЛИ + EXT_DET | 1 | 80 | 80 | AliExpress | 2×SS34 (из W-10) | Приоритет внешнего 12 В, EN буста (spec/50 §1a). | 1 | 1 | да | draft; оценка ±30%
W-16 | Питание и батарея | Гнездо DC 5.5/2.1 | панельное | 1 | 35 | 35 | chipdip.ru | DC-005 | Вход 12 В. | 0.44 | 0.44 | да | draft; оценка ±30%
W-17 | Питание и батарея | Выключатель питания | тумблер/кнопка | 1 | 60 | 60 | elektro.ru | MTS-102 | — | 0.75 | 0.75 | да | draft; оценка ±30%
W-18 | Питание и батарея | Пассив питания | электролиты 1000/100 мкФ, ферриты, L 22 мкГн | 1 | 600 | 600 | chipdip/Ali | — | По PWR-BATT-1 и CORE-1 rev.3. | 7.5 | 7.5 | да | draft; оценка ±30%
B-01 | Печатные платы и монтаж | PCB база: CORE-1 rev.3, PANEL-1 rev.2, DECK-KEYS, PWR-1, панель v0.5 | 5 конструкций × 5 шт, 2 слоя | 1 | 2000 | 2000 | JLCPCB (калькулятор) / Rezon | PcbWay/Seeed | После ERC и DRC; заказ после бенчмарка P1 (D-06). | 25 | 25 | да | draft; оценка ±30%
B-02 | Печатные платы и монтаж | PCB полный: DECK-PAD + 5 аналоговых картриджей | 6 конструкций × 5 шт | 1 | 1400 | 1400 | JLCPCB | Rezon | Только вместе с блоками «полного» варианта. | 17.5 | 17.5 | полный | draft; оценка ±30%; только «полный»
B-03 | Печатные платы и монтаж | Трафарет для пасты (stencil) | 5 конструкций | 1 | 500 | 500 | JLCPCB | — | Упрощает монтаж SMD (P4/кодеки). | 6.25 | 6.25 | полный | draft; оценка ±30%; только «полный»
B-04 | Печатные платы и монтаж | Услуга SMD-монтажа (оценка) | 5 плат (CORE/PANEL/PWR/DECK) | 1 | 2500 | 2500 | JLCPCB PCBA / РФ-подрядчик | — | Альтернатива ручной пайке; не входит в итоги. | 31.25 | 31.25 | альтернатива | draft; оценка ±30%; альтернатива, не в итогах
M-01 | Корпус, печать, крепёж | PETG-филамент 1 кг | 1.75 мм | 1 | 700 | 700 | dakson.su 1377 ₽; чеки 625–1438 ₽ | любой PETG | Корпус 380×210×63, детали вариантов A/B/C. | 8.75 | 8.75 | да | draft; оценка ±30%
M-02 | Корпус, печать, крепёж | PLA полупрозрачный 0.5 кг | 1.75 мм | 1 | 700 | 700 | любой магазин | — | Колпачки 42 шт + световоды. | 8.75 | 8.75 | да | draft; оценка ±30%
M-03 | Корпус, печать, крепёж | TPU-филамент 0.5 кг | 1.75 мм, 95A | 1 | 1200 | 1200 | regard.ru 2280 ₽/кг | любой TPU | Ножки/накладки/демпферы. | 15 | 15 | да | draft; оценка ±30%
M-04 | Корпус, печать, крепёж | Крепёж M3 (набор) | винты/гайки/стойки | 1 | 300 | 300 | 9v.ru 380 ₽/120 шт | RUICHI KIT-M3 | Стойки плат, панель, корпус. | 3.75 | 3.75 | да | draft; оценка ±30%
M-05 | Корпус, печать, крепёж | Термовтулки M3 4.6×6.0 | 100 шт | 1 | 350 | 350 | AliExpress | — | Запрессовка в PETG. | 4.38 | 4.38 | да | draft; оценка ±30%
M-06 | Корпус, печать, крепёж | Винты M2.5 (дисплей/фейдеры) | M2.5×6 ×4 + M2.5×8 ×4 | 8 | 4 | 32 | 9v.ru | набор M2.5 | Крепление стекла/рамки и фейдеров. | 0.05 | 0.4 | да | draft; оценка ±30%
M-07 | Корпус, печать, крепёж | Печать на заказ (если нет принтера) | весь комплект | 1 | 3000 | 3000 | печатный сервис | — | Альтернатива своему принтеру; не входит в итоги. | 37.5 | 37.5 | альтернатива | draft; оценка ±30%; альтернатива, не в итогах
M-08 | Корпус, печать, крепёж | Магниты/защёлки/уплотнитель | 6×3 мм, лента | 1 | 200 | 200 | AliExpress | — | Крышки батареи/дек. | 2.5 | 2.5 | да | draft; оценка ±30%
X-01 | Кабели и расходники | Шлейф IDC-26 (3 шт) | 12 см | 3 | 60 | 180 | darxton.ru 40 ₽ / сборка из ленты | готовый IDC26-8-E | 3 порта шины. | 0.75 | 2.25 | да | draft; оценка ±30%
X-02 | Кабели и расходники | Шлейф IDC-16 (2 шт) | 10 см | 2 | 40 | 80 | darxton/Ali | IDC-16 | Деки. | 0.5 | 1 | да | draft; оценка ±30%
X-03 | Кабели и расходники | Провод монтажный / Dupont | 22 AWG + Dupont | 1 | 200 | 200 | AliExpress | — | Джеки, клеммники. | 2.5 | 2.5 | да | draft; оценка ±30%
X-04 | Кабели и расходники | Кабель USB-C (2 шт) | 1 м, data | 2 | 150 | 300 | любой магазин | USB-C 2.0 | DATA + CHARGE. | 1.88 | 3.76 | да | draft; оценка ±30%
X-05 | Кабели и расходники | Припой, флюс, изопропанол | — | 1 | 700 | 700 | любой магазин | — | Монтаж/отмывка. | 8.75 | 8.75 | да | draft; оценка ±30%
X-06 | Кабели и расходники | Антистатический браслет/мат | — | 1 | 300 | 300 | любой магазин | — | ESP32-P4 и кодеки чувствительны к статике. | 3.75 | 3.75 | да | draft; оценка ±30%
X-07 | Кабели и расходники | Термоусадка/кембрик | набор | 1 | 150 | 150 | любой магазин | — | — | 1.88 | 1.88 | да | draft; оценка ±30%
N-01 | Полный: аналоговые картриджи | AS3340 (VCO-1, Alfa RPAR) | DIP-16 | 1 | 700 | 700 | synthcube $7.95–8.13 | AS3340A, CEM3340 | Опция: аналоговый VCO на шине 26-pin. | 8.75 | 8.75 | полный | draft; оценка ±30%; только «полный»
N-02 | Полный: аналоговые картриджи | LM13700 (FILTER-1) | DIP-16 | 1 | 300 | 300 | chipdip.ru 460 ₽ | LM13700N | SVF 12 дБ/окт. | 3.75 | 3.75 | полный | draft; оценка ±30%; только «полный»
N-03 | Полный: аналоговые картриджи | AS3320 (LADDER-1) | DIP-18 | 1 | 1200 | 1200 | synth-parts €15.59; дефицит | AS3320D/AS3320-HYB; BCM847×4 | Лестница Муга. | 15 | 15 | полный | draft; оценка ±30%; только «полный»
N-04 | Полный: аналоговые картриджи | PT2399 (ENSEMBLE-1) | DIP-16, 2 шт | 2 | 70 | 140 | chipdip/Ali | — | Ансамбль/хорус (BBD-вариант не разведён). | 0.88 | 1.76 | полный | draft; оценка ±30%; только «полный»
N-05 | Полный: аналоговые картриджи | CD4053 (аналоговый ключ) | DIP-16 | 1 | 30 | 30 | chipdip.ru | 74HC4053 | ENSEMBLE-1. | 0.38 | 0.38 | полный | draft; оценка ±30%; только «полный»
N-06 | Полный: аналоговые картриджи | TL074 (буферы модулей) | DIP-14, 4 шт | 4 | 22 | 88 | chipcity 24 ₽ / chipdip 55 ₽ | TL084 | VCO/FILTER/LADDER/ENSEMBLE. | 0.28 | 1.12 | полный | draft; оценка ±30%; только «полный»
N-07 | Полный: аналоговые картриджи | TL072 (буферы модулей) | DIP-8, 2 шт | 2 | 25 | 50 | chipdip.ru | NE5532 | — | 0.31 | 0.62 | полный | draft; оценка ±30%; только «полный»
N-08 | Полный: аналоговые картриджи | Панельки DIP-8/14/16/18 | набор ~15 шт | 1 | 120 | 120 | rekshop.ru | — | Сменные ОУ/ИС. | 1.5 | 1.5 | полный | draft; оценка ±30%; только «полный»
N-09 | Полный: аналоговые картриджи | EEPROM 24C02 (дескриптор модуля) | DIP-8, 5 шт | 5 | 20 | 100 | AliExpress | 24C32 | Адрес 0x50 + порт. | 0.25 | 1.25 | полный | draft; оценка ±30%; только «полный»
N-10 | Полный: аналоговые картриджи | Резисторы 0.1 % | набор 25 шт | 1 | 500 | 500 | chipdip.ru | Vishay MRS25 | CV/экспо-цепи. | 6.25 | 6.25 | полный | draft; оценка ±30%; только «полный»
N-11 | Полный: аналоговые картриджи | Tempco 1 кОм 3300 ppm/K | THT | 1 | 150 | 150 | AliExpress | — | Термостабильность VCO. | 1.88 | 1.88 | полный | draft; оценка ±30%; только «полный»
N-12 | Полный: аналоговые картриджи | Гнёзда/тумблеры модулей | 3.5 мм ×8 + SPDT ×4 | 1 | 300 | 300 | micro-chip/elektro | — | Входы-выходы картриджей. | 3.75 | 3.75 | полный | draft; оценка ±30%; только «полный»
N-13 | Полный: аналоговые картриджи | TL431 (опорное 2.495 В) | TO-92/SOT-23 | 1 | 25 | 25 | chipdip.ru | LM4040 | Октавные сдвиги VCO. | 0.31 | 0.31 | полный | draft; оценка ±30%; только «полный»
F-01 | Полный: сменная дека DECK-PAD | Тактовые кнопки 12×12×5 | THT, 18 шт | 18 | 18 | 324 | quartz1.com 37 ₽ / 24 ₽ от 100 | — | Пэды 3×3 ×2. | 0.23 | 4.14 | полный | draft; оценка ±30%; только «полный»
F-02 | Полный: сменная дека DECK-PAD | WS2812B-2020 (подсветка пэдов) | 2020, 18 шт | 18 | 8 | 144 | radiodetali.com | SK6812MINI-E | — | 0.1 | 1.8 | полный | draft; оценка ±30%; только «полный»
F-03 | Полный: сменная дека DECK-PAD | MCP23017 (матрица пэдов) | DIP-28, 0x23 | 1 | 230 | 230 | rlocman.ru | MCP23S17 | 3×6. | 2.88 | 2.88 | полный | draft; оценка ±30%; только «полный»
F-04 | Полный: сменная дека DECK-PAD | 74HC4067 (FSR-мультиплексор) | SO-24, 2 шт | 2 | 50 | 100 | chipdip.ru 190 ₽ / chipcity 53 ₽ | — | Velocity-опция. | 0.62 | 1.24 | полный | draft; оценка ±30%; только «полный»
F-05 | Полный: сменная дека DECK-PAD | FSR-плёнка 18 шт | FSR400/402 | 18 | 140 | 2520 | AliExpress $1.3–1.5 | Interlink 402 | Опция velocity; без неё fixed 127. | 1.75 | 31.5 | полный | draft; оценка ±30%; только «полный»
F-06 | Полный: сменная дека DECK-PAD | IDC-16 гнездо (дека) | 2×8 | 1 | 20 | 20 | quartz1.com | — | — | 0.25 | 0.25 | полный | draft; оценка ±30%; только «полный»
