martiyanov/bukifon/hardware/core2/BOM-core2.csv

Артикул | MPN (draft) | Номинал/Тип | Кол-во | Позиции | Корпус | rev.2 | Примечание
PM-C2-001 | USB-C 16P (USB2.0) | USB-C 16P (data+charge) | 1 | J1 | Connector_USB:USB_C_Receptacle_HRO_TYPE-C-31-M-12 |  | USB 2.0 HS composite: HID+MIDI+UAC2+CDC (TinyUSB); rear wall
PM-C2-002 | USBLC6-2SC6 | USBLC6-2SC6 | 1 | U20 | Package_TO_SOT_SMD:SOT-23-6 |  | ESD/клэмп USB HS пары
PM-C2-003 |  | 5.1k | 1 | R28 | Resistor_SMD:R_0805_2012Metric |  | UFP CC1
PM-C2-004 |  | 5.1k | 1 | R29 | Resistor_SMD:R_0805_2012Metric |  | UFP CC2
PM-C2-005 |  | SMAJ5.0A | 1 | D1 | Diode_SMD:D_SMA |  | TVS по VBUS
PM-C2-006 |  | 1.5A | 1 | F1 | Fuse:Fuse_1206_3216Metric |  | polyfuse USB
PM-C2-007 |  | 10uF/10V | 14 | C1 C4 C6 C17 C20 C32 C41 C48 C49 C57 C63 C82 C84 C94 | Capacitor_SMD:C_0805_2012Metric
PM-C2-007 |  | 10uF/10V | 2 | C10 C14 | Capacitor_SMD:C_0805_2012Metric | DNP | DNP rev.2: (+5 V from PWR-2); (MT3608 #1 +12 V)
PM-C2-008 |  | 100nF/16V | 1 | C2 | Capacitor_SMD:C_0805_2012Metric
PM-C2-009 | BQ24074RGT | BQ24074RGT | 1 | U22 |  |  | charger + power-path (1.5 A)
PM-C2-010 |  | 1.5k | 1 | R1 | Resistor_SMD:R_0805_2012Metric |  | ILIM 1.5 A
PM-C2-011 |  | 1.5k | 1 | R2 | Resistor_SMD:R_0805_2012Metric |  | charge current ~1 A
PM-C2-012 |  | 2k | 1 | R3 | Resistor_SMD:R_0805_2012Metric |  | termination
PM-C2-013 |  | 100k | 1 | R4 | Resistor_SMD:R_0805_2012Metric |  | safety timer
PM-C2-014 |  | 10k | 1 | R5 | Resistor_SMD:R_0805_2012Metric | DNP | TS network; DNP rev.2: (N-2): TS driven by PWR-2 NTC_PACK; local 10k bias removed
PM-C2-015 |  | NTC 10k | 1 | TH1 | Resistor_SMD:R_0805_2012Metric | DNP | battery NTC; DNP rev.2: NTC comes from PWR-2 J4 NTC_PACK
PM-C2-016 |  | 100nF | 38 | C3 C5 C7 C19 C21 C22 C26 C37 C54 C55 C56 C60 C61 C62 C64 C68 C69 C73 C75 C81 C83 C85 C86 C87 C88 C89 C90 C91 C92 C93 C95 C96 C97 C98 C101 C102 C103 C129 | Capacitor_SMD:C_0805_2012Metric
PM-C2-016 |  | 100nF | 4 | C118 C119 C120 C121 | Capacitor_SMD:C_0805_2012Metric | NEW
PM-C2-016 |  | 100nF | 4 | C8 C16 C99 C100 | Capacitor_SMD:C_0805_2012Metric | DNP | DNP rev.2: (+5 V from PWR-2); (BMS on PWR-2); (N-2): EXPRESSION chain removed; (N-2): SPARE_ADC channel replaced by CVIN4
PM-C2-017 |  | 1k | 9 | R6 R44 R67 R68 R71 R72 R84 R87 R114 | Resistor_SMD:R_0805_2012Metric
PM-C2-017 |  | 1k | 2 | R103 R104 | Resistor_SMD:R_0805_2012Metric | NEW
PM-C2-018 |  | CHG | 1 | D3 | Capacitor_SMD:C_0805_2012Metric |  | charge LED (open-collector CHG)
PM-C2-019 |  | BATTERY 1S2P | 1 | J2 | Connector_JST:JST_XH_B2B-XH-A_1x02_P2.50mm_Vertical | DNP | 18650 1S2P pack (protected, with NTC); DNP rev.2: pack connector on PWR-2 J1
PM-C2-020 | BQ29700DSER | BQ29700DSER | 1 | U23 | Package_TO_SOT_SMD:SOT-23-6 | DNP | 1S BMS protector; DNP rev.2: (D-34): BMS on PWR-2
PM-C2-021 |  | 330 | 1 | R7 | Resistor_SMD:R_0805_2012Metric | DNP | BMS supply filter; DNP rev.2: (BMS on PWR-2)
PM-C2-022 |  | AO3400A | 1 | Q1 | Package_TO_SOT_SMD:SOT-23 | DNP | charge FET (BMS); DNP rev.2: (BMS on PWR-2)
PM-C2-023 |  | AO3400A | 1 | Q2 | Package_TO_SOT_SMD:SOT-23 | DNP | discharge FET (BMS); DNP rev.2: (BMS on PWR-2)
PM-C2-024 | MT3608 | MT3608 (+12V) | 1 | U24 | Package_TO_SOT_SMD:SOT-23-6 | DNP | boost 12.1 V (bus + analog); DNP rev.2: +12 V from PWR-2 J3 (keep for bench/USB-standalone option)
PM-C2-025 |  | 22uH | 1 | L4 | Inductor_SMD:L_1210_3225Metric
PM-C2-025 |  | 22uH | 2 | L1 L2 | Inductor_SMD:L_1210_3225Metric | DNP | DNP rev.2: (+5 V from PWR-2); (MT3608 #1 +12 V)
PM-C2-026 |  | SS34 | 2 | D21 D22 | Diode_SMD:D_SMA
PM-C2-026 |  | SS34 | 3 | D4 D5 D6 | Diode_SMD:D_SMA | DNP | DNP rev.2: (+5 V from PWR-2); (MC34063); (MT3608 #1 +12 V)
PM-C2-027 |  | 91k | 1 | R10 | Resistor_SMD:R_0805_2012Metric | DNP | FB 12.1 V; DNP rev.2: (MT3608 #1 +12 V)
PM-C2-028 |  | 4.7k | 1 | R11 | Resistor_SMD:R_0805_2012Metric | DNP | DNP rev.2: (MT3608 #1 +12 V)
PM-C2-029 |  | 100pF | 1 | C9 | Capacitor_SMD:C_0805_2012Metric | DNP | feed-forward; DNP rev.2: (MT3608 #1 +12 V)
PM-C2-030 |  | 100k | 1 | R19 | Resistor_SMD:R_0805_2012Metric |  | enable
PM-C2-030 |  | 100k | 2 | R12 R15 | Resistor_SMD:R_0805_2012Metric | DNP | enable; DNP rev.2: (+5 V from PWR-2); (MT3608 #1 +12 V)
PM-C2-031 |  | 220uF/25V | 1 | C11 | Capacitor_SMD:CP_Elec_6.3x7.7 | DNP | DNP rev.2: (MT3608 #1 +12 V)
PM-C2-032 |  | 100nF/50V | 6 | C34 C104 C106 C107 C109 C111 | Capacitor_SMD:C_0805_2012Metric
PM-C2-032 |  | 100nF/50V | 2 | C12 C29 | Capacitor_SMD:C_0805_2012Metric | DNP | DNP rev.2: (MC34063); (MT3608 #1 +12 V)
PM-C2-033 | MT3608 | MT3608 (+5V) | 1 | U25 | Package_TO_SOT_SMD:SOT-23-6 | DNP | boost 5.1 V (LED/panel/audio); DNP rev.2: (D-34): +5 V from PWR-2 J3
PM-C2-034 |  | 75k | 1 | R13 | Resistor_SMD:R_0805_2012Metric | DNP | FB 5.1 V; DNP rev.2: (+5 V from PWR-2)
PM-C2-035 |  | 10k | 1 | R77 | Resistor_SMD:R_0805_2012Metric
PM-C2-035 |  | 10k | 1 | R14 | Resistor_SMD:R_0805_2012Metric | DNP | DNP rev.2: (+5 V from PWR-2)
PM-C2-036 |  | 100pF | 5 | C31 C70 C71 C77 C79 | Capacitor_SMD:C_0805_2012Metric
PM-C2-036 |  | 100pF | 1 | C13 | Capacitor_SMD:C_0805_2012Metric | DNP | DNP rev.2: (+5 V from PWR-2)
PM-C2-037 |  | 220uF/10V | 1 | C15 | Capacitor_SMD:CP_Elec_6.3x7.7 | DNP | DNP rev.2: (+5 V from PWR-2)
PM-C2-038 | MP1584EN module | MP1584 3.3V/3A (MCU) | 1 | U26 |  |  | buck 5V->3.3V for P4/PSRAM
PM-C2-039 |  | 100uF/10V | 2 | C18 C40 | Capacitor_SMD:CP_Elec_6.3x7.7
PM-C2-040 |  | 600R@100MHz | 1 | FB1 | Inductor_SMD:L_0805_2012Metric
PM-C2-041 | AP2112K-3.3 | AP2112K-3.3 | 1 | U27 | Package_TO_SOT_SMD:SOT-23-5 |  | LDO 3.3 V peripherals/analog
PM-C2-042 |  | 1uF | 3 | C24 C25 C35 | Capacitor_SMD:C_0805_2012Metric
PM-C2-043 | MC34063AP | MC34063 | 1 | U28 | Package_DIP:DIP-8_W7.62mm | DNP | inverting -12 V (bus/opamps); DNP rev.2: (D-34): -12 V from PWR-2 J3
PM-C2-044 |  | 0.33 | 1 | R16 | Resistor_SMD:R_0805_2012Metric | DNP | DNP rev.2: (MC34063)
PM-C2-045 |  | 1.5nF | 1 | C27 | Capacitor_SMD:C_0805_2012Metric | DNP | DNP rev.2: (MC34063)
PM-C2-046 |  | 220uH | 1 | L3 | Inductor_SMD:L_1210_3225Metric | DNP | DNP rev.2: (MC34063)
PM-C2-047 |  | 33k | 1 | R17 | Resistor_SMD:R_0805_2012Metric | DNP | DNP rev.2: (MC34063)
PM-C2-048 |  | 3.9k | 1 | R18 | Resistor_SMD:R_0805_2012Metric | DNP | DNP rev.2: (MC34063)
PM-C2-049 |  | 220uF/25V | 1 | C39 | Capacitor_SMD:CP_Elec_6.3x7.7 |  | polarity + to PGND
PM-C2-049 |  | 220uF/25V | 1 | C28 | Capacitor_SMD:CP_Elec_6.3x7.7 | DNP | polarity + to PGND; DNP rev.2: (MC34063)
PM-C2-050 |  | 100uF/25V | 2 | C38 C110 | Capacitor_SMD:CP_Elec_6.3x7.7
PM-C2-050 |  | 100uF/25V | 1 | C30 | Capacitor_SMD:CP_Elec_6.3x7.7 | DNP | DNP rev.2: (MC34063)
PM-C2-051 | MT3608 | MT3608 (+20V BL) | 1 | U29 | Package_TO_SOT_SMD:SOT-23-6 |  | backlight boost 20 V (panel LED string)
PM-C2-052 |  | SS34 | 1 | D7 | Diode_SMD:D_SMA |  | 40 V Schottky
PM-C2-053 |  | 100k | 1 | R20 | Resistor_SMD:R_0805_2012Metric |  | FB 20.4 V
PM-C2-054 |  | 3.09k | 1 | R21 | Resistor_SMD:R_0805_2012Metric
PM-C2-055 |  | 10uF/35V | 1 | C33 | Capacitor_SMD:C_0805_2012Metric
PM-C2-056 | AP2112K-3.3 | AP2112K-3.3 (C6) | 1 | U30 | Package_TO_SOT_SMD:SOT-23-5 |  | dedicated LDO for Wi-Fi/BLE coprocessor
PM-C2-057 |  | 22uF/10V | 2 | C36 C53 | Capacitor_SMD:C_0805_2012Metric
PM-C2-058 |  | SS34 | 1 | D2 | Diode_SMD:D_SMA |  | diode-OR external 12 V (PWR-2)
PM-C2-059 |  | 600R@100MHz | 1 | FB2 | Inductor_SMD:L_0805_2012Metric |  | bus +12V
PM-C2-060 |  | 600R@100MHz | 1 | FB3 | Inductor_SMD:L_0805_2012Metric |  | bus -12V
PM-C2-061 |  | 600R@100MHz | 1 | FB4 | Inductor_SMD:L_0805_2012Metric |  | panel +5V
PM-C2-062 |  | 600R@100MHz | 1 | FB5 | Inductor_SMD:L_0805_2012Metric |  | panel +3V3
PM-C2-063 |  | AGND=DGND | 1 | NT1 | NetTie:NetTie-2_SMD_Pad0.5mm |  | single-point analog/digital ground
PM-C2-064 |  | DGND=PGND | 1 | NT2 | NetTie:NetTie-2_SMD_Pad0.5mm |  | single-point digital/power ground
PM-C2-065 | ESP32-P4NRW32 (+32MB PSRAM, module TBD) | ESP32-P4NRW32 + 32MB PSRAM (module TBD) | 1 | A1 |  |  | PRE-FREEZE: 2x32 logical module slot; adapter/physical module TBD after P1 benchmark
PM-C2-066 |  | 100nF | 6 | C42 C43 C44 C45 C46 C47 | Capacitor_SMD:C_0805_2012Metric |  | P4 decoupling
PM-C2-067 |  | BOOT | 1 | SW1 |  |  | boot strap GPIO35 (download boot)
PM-C2-068 |  | 10k | 1 | R22 | Resistor_SMD:R_0805_2012Metric |  | BOOT pull-up
PM-C2-069 |  | RESET | 1 | SW2 |  |  | reset
PM-C2-070 |  | 10k | 1 | R23 | Resistor_SMD:R_0805_2012Metric |  | CHIP_PU pull-up
PM-C2-071 |  | 100nF | 1 | C51 | Capacitor_SMD:C_0805_2012Metric |  | reset RC
PM-C2-072 |  | 10k | 1 | R24 | Resistor_SMD:R_0805_2012Metric |  | GPIO36 strap PU (joint download boot reachable)
PM-C2-073 |  | 10k | 1 | R91 | Resistor_SMD:R_0805_2012Metric |  | PANEL_IRQ pull-up (4x MCP23017 INTA wire-OR on PANEL-2)
PM-C2-074 |  | UART0 TP | 1 | J4 | Connector_PinHeader_2.54mm:PinHeader_1x03_P2.54mm_Vertical |  | UART0 testpoints/boot log
PM-C2-075 | ESP32-C6-MINI-1 (DNP if ESP32-S3 build) | ESP32-C6-MINI-1 (Wi-Fi6/BLE5.3) | 1 | U31 |  |  | Wi-Fi/BLE coprocessor; DNP if ESP32-S3 build; antenna keep-out >=15 mm
PM-C2-076 |  | 10k | 1 | R27 | Resistor_SMD:R_0805_2012Metric |  | C6 EN pull-up
PM-C2-077 | microSD socket (Hirose DM3AT) | microSD (SDIO 1-bit) | 1 | J5 | Connector_Card:microSD_HC_Hirose_DM3AT-SF-PEJM5 |  | SDMMC slot0, 1-bit (D1-D3 -> mic I2S1)
PM-C2-078 |  | 10k | 2 | R30 R31 | Resistor_SMD:R_0805_2012Metric |  | SDIO pull-up (1-bit)
PM-C2-079 |  | 10k | 1 | R35 | Resistor_SMD:R_0805_2012Metric |  | card detect pull-up
PM-C2-080 | PCM5102A | PCM5102A | 1 | U32 | Package_SO:TSSOP-20_4.4x6.5mm_P0.65mm |  | I2S DAC 112 dB (24/96)
PM-C2-081 |  | 1uF/10V | 1 | C58 | Capacitor_SMD:C_0805_2012Metric |  | charge-pump flying cap
PM-C2-082 |  | 1uF/10V | 1 | C59 | Capacitor_SMD:CP_Elec_6.3x7.7 |  | polarity + to AGND
PM-C2-083 |  | 10k | 1 | R36 | Resistor_SMD:R_0805_2012Metric |  | unmute
PM-C2-084 |  | 100nF | 1 | C65 | Capacitor_SMD:C_0805_2012Metric |  | mute RC: XSMT low at power-up
PM-C2-085 |  | 10uF/16V | 1 | C66 | Capacitor_SMD:CP_Elec_6.3x7.7 |  | AC coupling L
PM-C2-086 |  | 10uF/16V | 1 | C67 | Capacitor_SMD:CP_Elec_6.3x7.7 |  | AC coupling R
PM-C2-087 |  | 100k | 1 | R37 | Resistor_SMD:R_0805_2012Metric |  | bias/DC path
PM-C2-088 |  | 100k | 3 | R38 R63 R65 | Resistor_SMD:R_0805_2012Metric
PM-C2-088 |  | 100k | 2 | R99 R100 | Resistor_SMD:R_0805_2012Metric | NEW
PM-C2-089 |  | TL072 | 1 | U33 | Package_DIP:DIP-8_W7.62mm |  | LINE/PHONES buffer L
PM-C2-090 |  | 100 | 1 | R39 | Resistor_SMD:R_0805_2012Metric |  | LINE OUT L (rear)
PM-C2-091 |  | 100 | 1 | R40 | Resistor_SMD:R_0805_2012Metric |  | LINE OUT R (rear)
PM-C2-092 |  | 100 | 1 | R41 | Resistor_SMD:R_0805_2012Metric |  | PHONES L
PM-C2-093 |  | 100 | 1 | R42 | Resistor_SMD:R_0805_2012Metric |  | PHONES R
PM-C2-094 | PCM1808PWR | PCM1808PWR | 1 | U34 | Package_SO:TSSOP-14_4.4x5mm_P0.65mm |  | I2S ADC 24/96 (sampler/effector input)
PM-C2-095 |  | 10uF/10V | 2 | C72 C128 | Capacitor_SMD:CP_Elec_6.3x7.7
PM-C2-096 |  | 10uF/10V | 1 | C74 | Capacitor_SMD:CP_Elec_6.3x7.7 |  | VCC 5 V analog
PM-C2-097 |  | 100nF | 1 | C76 | Capacitor_SMD:C_0805_2012Metric |  | VDD 3.3 V digital
PM-C2-098 |  | 1k | 1 | R43 | Resistor_SMD:R_0805_2012Metric |  | input protection
PM-C2-099 |  | BAT54S | 1 | D8 | Package_TO_SOT_SMD:SOT-23 |  | clamp
PM-C2-100 |  | 1uF/16V | 1 | C78 | Capacitor_SMD:C_0805_2012Metric |  | AC coupling to VINL (after line/mic switch)
PM-C2-101 |  | BAT54S | 3 | D9 D16 D17 | Package_TO_SOT_SMD:SOT-23
PM-C2-101 |  | BAT54S | 2 | D24 D25 | Package_TO_SOT_SMD:SOT-23 | NEW
PM-C2-102 |  | 1uF/16V | 1 | C80 | Capacitor_SMD:C_0805_2012Metric |  | AC coupling to VINR (after switch)
PM-C2-103 |  | PANEL-2 MEMS mic (IDC-6) | 1 | J19 | Connector_IDC:IDC-Header_2x03_P2.54mm_Vertical |  | rev.3: MEMS I2S1 canon 1=BCK 2=GND 3=WS 4=GND 5=DATA 6=3V3 (mates PANEL-2 J16, 1:1); shielded, ESD
PM-C2-104 |  | 600R@100MHz | 1 | FB8 | Inductor_SMD:L_0805_2012Metric |  | mic 3.3 V filter
PM-C2-105 |  | USBLC6-2SC6 | 1 | U48 | Package_TO_SOT_SMD:SOT-23-6 |  | ESD mic I2S BCK/WS
PM-C2-106 |  | USBLC6-2SC6 | 1 | U49 | Package_TO_SOT_SMD:SOT-23-6 |  | ESD mic I2S DATA
PM-C2-107 |  | MIC IN 3.5mm TRS (electret) | 1 | J20 |  |  | off-board (rear/panel part); rear panel mic/headset jack; tip=signal, ring=bias
PM-C2-108 |  | SMAJ5.0A | 1 | D30 | Diode_SMD:D_SMA |  | ESD/защита mic jack
PM-C2-109 |  | 2.2k | 1 | R106 | Resistor_SMD:R_0805_2012Metric |  | electret bias (2.2k)
PM-C2-110 |  | 100nF | 1 | C127 | Capacitor_SMD:C_0805_2012Metric |  | AC coupling to MAX9814
PM-C2-111 |  | 1uF/10V | 1 | C122 | Capacitor_SMD:C_0805_2012Metric |  | mic bias decoupling
PM-C2-112 |  | MAX9814 (AGC mic amp) | 1 | U46 | Package_DFN_QFN:TDFN-14-1EP_3x3mm_P0.4mm_EP1.78x2.35mm |  | AGC mic preamp (D-91); pinout verified vs datasheet 2026-11-06 (TH/EP fixed)
PM-C2-113 |  | 470nF | 1 | C125 | Capacitor_SMD:C_0805_2012Metric |  | AGC attack/release (CT, datasheet typical)
PM-C2-114 |  | 2.2uF/10V | 1 | C124 | Capacitor_SMD:C_0805_2012Metric |  | DC offset adjust (CG)
PM-C2-115 |  | 470nF | 1 | C123 | Capacitor_SMD:C_0805_2012Metric |  | bias decoupling
PM-C2-116 |  | 100k | 1 | R113 | Resistor_SMD:R_0805_2012Metric |  | SHDN pull-up (mic on)
PM-C2-117 |  | MIC MUTE | 1 | SW3 |  |  | аппаратный mute: SHDN->GND (D-92)
PM-C2-118 |  | 2N7000 | 1 | Q5 | Package_TO_SOT_THT:TO-92_Inline |  | MIC ON LED driver
PM-C2-119 |  | MIC ON | 1 | D31 | Capacitor_SMD:C_0805_2012Metric |  | LED «MIC ON» (D-92)
PM-C2-120 |  | 1uF/16V | 1 | C126 | Capacitor_SMD:C_0805_2012Metric |  | MAX9814 out -> switch
PM-C2-121 |  | TS5A23157 (line/mic switch) | 1 | U47 | Package_SO:MSOP-10-1EP_3x3mm_P0.5mm_EP1.68x1.88mm |  | analog switch line(AUDIO IN)/mic, control MIC_SEL (footprint verify vs DGS)
PM-C2-122 |  | 150k | 1 | R107 | Resistor_SMD:R_0805_2012Metric |  | AGC threshold divider top (V_TH = MCBIAS*0.4)
PM-C2-123 |  | 100k | 1 | R108 | Resistor_SMD:R_0805_2012Metric |  | AGC threshold divider bottom
PM-C2-124 |  | 100k | 1 | R110 | Resistor_SMD:R_0805_2012Metric |  | MIC_SEL pull-down = LINE by default
PM-C2-125 | MCP4728A0-E/UN | MCP4728A0-E/UN (0x60) | 1 | U35 | Package_SO:MSOP-10_3x3mm_P0.5mm |  | CV1..CV4 (bus), I2C 0x60
PM-C2-126 | MCP4728A1-E/UN | MCP4728A1-E/UN (0x61) | 1 | U36 | Package_SO:MSOP-10_3x3mm_P0.5mm |  | CV5/CV6 (panel jacks), I2C 0x61
PM-C2-127 |  | TL074 | 1 | U37 | Package_DIP:DIP-14_W7.62mm |  | CV1 x4.9 buffer
PM-C2-128 |  | 39k | 1 | R45 | Resistor_SMD:R_0805_2012Metric |  | Rf CV1
PM-C2-129 |  | 10k | 1 | R51 | Resistor_SMD:R_0805_2012Metric |  | Rg CV1
PM-C2-130 |  | 1k | 1 | R57 | Resistor_SMD:R_0805_2012Metric |  | output CV1
PM-C2-131 |  | BAT54S | 1 | D10 | Package_TO_SOT_SMD:SOT-23 |  | CV1 protection
PM-C2-132 |  | 39k | 1 | R46 | Resistor_SMD:R_0805_2012Metric |  | Rf CV2
PM-C2-133 |  | 10k | 1 | R52 | Resistor_SMD:R_0805_2012Metric |  | Rg CV2
PM-C2-134 |  | 1k | 1 | R58 | Resistor_SMD:R_0805_2012Metric |  | output CV2
PM-C2-135 |  | BAT54S | 1 | D11 | Package_TO_SOT_SMD:SOT-23 |  | CV2 protection
PM-C2-136 |  | 39k | 1 | R47 | Resistor_SMD:R_0805_2012Metric |  | Rf CV3
PM-C2-137 |  | 10k | 1 | R53 | Resistor_SMD:R_0805_2012Metric |  | Rg CV3
PM-C2-138 |  | 1k | 1 | R59 | Resistor_SMD:R_0805_2012Metric |  | output CV3
PM-C2-139 |  | BAT54S | 1 | D12 | Package_TO_SOT_SMD:SOT-23 |  | CV3 protection
PM-C2-140 |  | 39k | 1 | R48 | Resistor_SMD:R_0805_2012Metric |  | Rf CV4
PM-C2-141 |  | 10k | 1 | R54 | Resistor_SMD:R_0805_2012Metric |  | Rg CV4
PM-C2-142 |  | 1k | 1 | R60 | Resistor_SMD:R_0805_2012Metric |  | output CV4
PM-C2-143 |  | BAT54S | 1 | D13 | Package_TO_SOT_SMD:SOT-23 |  | CV4 protection
PM-C2-144 |  | TL074 | 1 | U38 | Package_DIP:DIP-14_W7.62mm |  | CV5 x4.9 buffer
PM-C2-145 |  | 39k | 1 | R49 | Resistor_SMD:R_0805_2012Metric |  | Rf CV5
PM-C2-146 |  | 10k | 1 | R55 | Resistor_SMD:R_0805_2012Metric |  | Rg CV5
PM-C2-147 |  | 1k | 1 | R61 | Resistor_SMD:R_0805_2012Metric |  | output CV5 (panel)
PM-C2-148 |  | BAT54S | 1 | D14 | Package_TO_SOT_SMD:SOT-23 |  | CV5 protection
PM-C2-149 |  | 39k | 1 | R50 | Resistor_SMD:R_0805_2012Metric |  | Rf CV6
PM-C2-150 |  | 10k | 1 | R56 | Resistor_SMD:R_0805_2012Metric |  | Rg CV6
PM-C2-151 |  | 1k | 1 | R62 | Resistor_SMD:R_0805_2012Metric |  | output CV6 (panel)
PM-C2-152 |  | BAT54S | 1 | D15 | Package_TO_SOT_SMD:SOT-23 |  | CV6 protection
PM-C2-153 |  | TL074 | 1 | U39 | Package_DIP:DIP-14_W7.62mm |  | CV IN1 level shift
PM-C2-154 |  | 16.5k | 2 | R64 R66 | Resistor_SMD:R_0805_2012Metric |  | gain 0.165
PM-C2-154 |  | 16.5k | 2 | R101 R102 | Resistor_SMD:R_0805_2012Metric | NEW | gain 0.165
PM-C2-155 |  | 47k | 1 | R69 | Resistor_SMD:R_0805_2012Metric |  | 1.65 V
PM-C2-156 |  | 47k | 2 | R70 R76 | Resistor_SMD:R_0805_2012Metric
PM-C2-157 | MCP3208-CI/P | MCP3208 | 1 | U40 | Package_DIP:DIP-16_W7.62mm |  | 8-ch 12-bit SPI ADC
PM-C2-158 |  | 600R@100MHz | 1 | FB6 | Inductor_SMD:L_0805_2012Metric |  | ADC reference filter
PM-C2-159 |  | 1k | 1 | R73 | Resistor_SMD:R_0805_2012Metric | DNP | expression pedal; DNP rev.2: (N-2): EXPRESSION chain removed
PM-C2-160 |  | 1k | 1 | R74 | Resistor_SMD:R_0805_2012Metric | DNP | reserved channel to AGND; DNP rev.2: (N-2): SPARE_ADC channel replaced by CVIN4
PM-C2-161 |  | 100k | 1 | R75 | Resistor_SMD:R_0805_2012Metric |  | battery divider (raw VBAT from PWR-2 J18.1)
PM-C2-162 |  | NTC 10k | 1 | TH2 | Resistor_SMD:R_0805_2012Metric |  | pack temperature
PM-C2-163 |  | 2.2k | 2 | R78 R79 | Resistor_SMD:R_0805_2012Metric |  | I2C pull-up
PM-C2-164 | 24LC32A-I/P | 24LC32A | 1 | U41 | Package_DIP:DIP-8_W7.62mm |  | calibration EEPROM 0x57 (A2..A0=1)
PM-C2-165 | 6N137 | 6N137 | 1 | U42 | Package_DIP:DIP-8_W7.62mm |  | MIDI IN optocoupler
PM-C2-166 |  | 220 | 2 | R80 R83 | Resistor_SMD:R_0805_2012Metric
PM-C2-167 |  | 4.7k | 1 | R81 | Resistor_SMD:R_0805_2012Metric |  | 6N137 pull-up
PM-C2-168 | 74HCT125 | 74HCT125 | 1 | U43 | Package_SO:SOIC-14_3.9x8.7mm_P1.27mm |  | MIDI OUT buffer (5 V)
PM-C2-169 |  | 33 | 1 | R82 | Resistor_SMD:R_0805_2012Metric
PM-C2-170 |  | 2N7000 | 1 | Q3 | Package_TO_SOT_THT:TO-92_Inline |  | GATE1 open-drain
PM-C2-171 |  | 100k | 2 | R85 R88 | Resistor_SMD:R_0805_2012Metric |  | gate pull-down
PM-C2-172 |  | 4.7k | 1 | R86 | Resistor_SMD:R_0805_2012Metric |  | GATE1 pull-up
PM-C2-173 |  | 2N7000 | 1 | Q4 | Package_TO_SOT_THT:TO-92_Inline |  | GATE2 open-drain
PM-C2-174 |  | 4.7k | 1 | R89 | Resistor_SMD:R_0805_2012Metric |  | GATE2 pull-up
PM-C2-175 | 74HCT1G125 | 74HCT1G125 | 1 | U44 | Package_TO_SOT_SMD:SOT-353_SC-70-5 | DNP | WS2812 level shifter 3.3->5 V; DNP rev.2: level shifter 74HCT1G125 is on PANEL-2; CORE-2 drives 3.3 V LED_DATA
PM-C2-176 |  | 330 | 1 | R90 | Resistor_SMD:R_0805_2012Metric | DNP | series resistor; DNP rev.2: 330R on PANEL-2
PM-C2-177 |  | PicoMod analog bus IDC-26 PORT1 | 1 | P1 | Connector_IDC:IDC-Header_2x13_P2.54mm_Latch12.0mm_Vertical |  | bus: +-12V, CV1..4, GATE1/2, audio
PM-C2-178 |  | PicoMod analog bus IDC-26 PORT2 | 1 | P2 | Connector_IDC:IDC-Header_2x13_P2.54mm_Latch12.0mm_Vertical |  | bus: +-12V, CV1..4, GATE1/2, audio
PM-C2-179 |  | 0.5A | 1 | F2 | Fuse:Fuse_1206_3216Metric |  | port1 +12V
PM-C2-180 |  | SS34 | 1 | D18 | Diode_SMD:D_SMA |  | reverse protection
PM-C2-181 |  | 0.3A | 1 | F3 | Fuse:Fuse_1206_3216Metric |  | port1 -12V
PM-C2-182 |  | SS34 | 1 | D28 | Diode_SMD:D_SMA |  | reverse protection (was D19; renumbered rev.2)
PM-C2-183 |  | SMAJ15A | 1 | D29 | Diode_SMD:D_SMA |  | TVS port1 (was D20; renumbered rev.2)
PM-C2-184 |  | 10uF/25V | 2 | C105 C108 | Capacitor_SMD:CP_Elec_6.3x7.7
PM-C2-185 |  | 0.5A | 1 | F4 | Fuse:Fuse_1206_3216Metric |  | port2 +12V
PM-C2-186 |  | 0.3A | 1 | F5 | Fuse:Fuse_1206_3216Metric |  | port2 -12V
PM-C2-187 |  | SMAJ15A | 1 | D23 | Diode_SMD:D_SMA |  | TVS port2
PM-C2-188 | IDC-26 | PANEL-2 J14 (IDC-26) analog field [rev.2 canon] | 1 | J14 | Connector_IDC:IDC-Header_2x13_P2.54mm_Latch12.0mm_Vertical |  | CVOUT1-4, CVIN1-4, GATE_OUT, FADER1/2, EN_LED5; evens AGND
PM-C2-189 | FFC-40 0.5mm | PANEL-2 J12 (FFC-40) LCD RGB565+BL [rev.2 canon] | 1 | J15 | Connector_FFC-FPC:Hirose_FH12-40S-0.5SH_1x40-1MP_P0.50mm_Horizontal |  | RGB565 + sync + BL_PWM/BL_20V/BL_CATHODE, 3V3, GND (per PANEL-2 J12)
PM-C2-190 | IDC-16 | PANEL-2 J13 (IDC-16) digital/power [rev.2 canon] | 1 | J16 | Connector_IDC:IDC-Header_2x08_P2.54mm_Latch6.5mm_Vertical |  | I2C, INT, LED_DATA(3V3), 5V_LED/LED_RET, EN_RAILS; R-22 digital exp deferred to rev.3
PM-C2-191 |  | 0R | 1 | R97 | Resistor_SMD:R_0805_2012Metric | NEW | backlight LED return path
PM-C2-192 |  | MIDI IN TRS-A | 1 | J6 |  |  | off-board (rear/panel part); rear panel jack
PM-C2-193 |  | MIDI OUT TRS-A | 1 | J7 |  |  | off-board (rear/panel part); rear panel jack
PM-C2-194 |  | LINE OUT L/R 3.5mm | 1 | J8 |  |  | off-board (rear/panel part); rear panel jack
PM-C2-195 |  | PHONES 3.5mm | 1 | J9 |  |  | off-board (rear/panel part); rear panel jack
PM-C2-196 |  | AUDIO IN L 3.5mm | 1 | J10 |  |  | off-board (rear/panel part); rear panel jack
PM-C2-197 |  | AUDIO IN R 3.5mm | 1 | J11 |  |  | off-board (rear/panel part); rear panel jack
PM-C2-198 |  | DC 12V 5.5/2.1 | 1 | J12 |  |  | off-board (rear/panel part); rear panel jack (from PWR-2)
PM-C2-199 |  | EXPRESSION TRS | 1 | J13 |  | DNP | off-board (rear/panel part); rear panel jack; DNP rev.2: (N-2): EXPRESSION jack removed (CVIN3/4 take CH4/CH5)
PM-C2-200 |  | Rear audio terminal block | 1 | TB1 | TerminalBlock_Phoenix:TerminalBlock_Phoenix_MKDS-1-12-3.81_1x12_P3.81mm_Horizontal |  | jacks -> CORE-2 rear
PM-C2-201 |  | Rear MIDI/DC/EXPR terminal block | 1 | TB2 | TerminalBlock_Phoenix:TerminalBlock_Phoenix_MKDS-1-10-3.81_1x10_P3.81mm_Horizontal | DNP | DNP rev.2: (N-2): rear TB2 removed (EXPRESSION gone; DC/MIDI moved to PWR-2/panel harness)
PM-C2-202 |  | PWR-2 J3 (IDC-20) [rev.2] | 1 | J17 | Connector_IDC:IDC-Header_2x10_P2.54mm_Vertical | NEW | rev.2: силовой разъём PWR-2 J3; при 3 А — альтернатива Micro-Fit 3.0 2x6
PM-C2-203 |  | PWR-2 J4 (IDC-12) [rev.2] | 1 | J18 | Connector_IDC:IDC-Header_2x06_P2.54mm_Vertical | NEW | rev.2: управляющий разъём PWR-2 J4 (гейдж, PWR_GOOD, EN)
PM-C2-204 |  | SS34 | 1 | D19 | Diode_SMD:D_SMA | NEW | rev.2: N12_EXT series back-feed protection
PM-C2-205 |  | SMAJ15A | 1 | D20 | Diode_SMD:D_SMA | NEW | rev.2: N12_EXT TVS
PM-C2-206 |  | 100uF/25V | 1 | C112 | Capacitor_SMD:CP_Elec_6.3x7.7 | NEW | rev.2: N12_EXT bulk
PM-C2-207 |  | 100nF/50V | 1 | C113 | Capacitor_SMD:C_0805_2012Metric | NEW | rev.2: N12_EXT ceramic
PM-C2-208 |  | 100uF/10V | 1 | C114 | Capacitor_SMD:CP_Elec_6.3x7.7 | NEW | rev.2: +5V_EXT bulk
PM-C2-209 |  | 100nF | 1 | C115 | Capacitor_SMD:C_0805_2012Metric | NEW | rev.2: +5V_EXT ceramic
PM-C2-210 |  | 600R@100MHz | 1 | FB7 | Inductor_SMD:L_0805_2012Metric | NEW | rev.2: +5V from PWR-2 filter
PM-C2-211 |  | 100uF/10V | 1 | C117 | Capacitor_SMD:CP_Elec_6.3x7.7 | NEW | rev.2: +5V bulk (replaces DNP C15)
PM-C2-212 |  | 100nF | 1 | C116 | Capacitor_SMD:C_0805_2012Metric | NEW | rev.2: 5V_LED at J16
PM-C2-213 |  | 100k | 1 | R92 | Resistor_SMD:R_0805_2012Metric | NEW | rev.2: PWR_GOOD pull-up (O-8)
PM-C2-214 |  | 100k | 1 | R93 | Resistor_SMD:R_0805_2012Metric | NEW | rev.2: FUEL_ALRT pull-up (O-8)
PM-C2-215 |  | 0R | 1 | R94 | Resistor_SMD:R_0805_2012Metric | NEW | rev.2: EN_RAILS -> EN_BUS12 (J18.7)
PM-C2-216 |  | 0R | 1 | R95 | Resistor_SMD:R_0805_2012Metric | NEW | rev.2: EN_RAILS -> EN_N12 (J18.8)
PM-C2-217 |  | 0R | 1 | R96 | Resistor_SMD:R_0805_2012Metric | NEW | rev.2: EN_RAILS -> EN_5V (J18.10)
PM-C2-218 |  | 0R | 1 | R98 | Resistor_SMD:R_0805_2012Metric | NEW | rev.2: bypass LED level shifter (U44/R90 DNP); 3.3 V to PANEL-2
PM-C2-219 |  | 0R | 1 | R105 | Resistor_SMD:R_0805_2012Metric | NEW | rev.2: display always enabled (PANEL-2 J12 has no DISP pin)
PM-C2-220 |  | TL074 | 1 | U45 | Package_DIP:DIP-14_W7.62mm | NEW | CV IN3 level shift
PM-C2-221 |  | VBUS_CHG | 1 | TP1 | TestPoint:TestPoint_Pad_D1.5mm |  | USB-C input
PM-C2-222 |  | VSYS | 1 | TP2 | TestPoint:TestPoint_Pad_D1.5mm |  | power-path output
PM-C2-223 |  | 12V | 1 | TP3 | TestPoint:TestPoint_Pad_D1.5mm |  | +12 V bus rail
PM-C2-224 |  | -12V | 1 | TP4 | TestPoint:TestPoint_Pad_D1.5mm |  | -12 V bus rail
PM-C2-225 |  | 5V | 1 | TP5 | TestPoint:TestPoint_Pad_D1.5mm |  | +5 V rail
PM-C2-226 |  | 3V3 | 1 | TP6 | TestPoint:TestPoint_Pad_D1.5mm |  | +3.3 V peripherals
PM-C2-227 |  | 3V3_MCU | 1 | TP7 | TestPoint:TestPoint_Pad_D1.5mm |  | +3.3 V MCU/PSRAM
PM-C2-228 |  | BATT_MON | 1 | TP8 | TestPoint:TestPoint_Pad_D1.5mm |  | battery ADC
PM-C2-229 |  | I2S_MCLK | 1 | TP9 | TestPoint:TestPoint_Pad_D1.5mm |  | 12.288 MHz
PM-C2-230 |  | SD_CLK | 1 | TP10 | TestPoint:TestPoint_Pad_D1.5mm |  | SDIO clock
PM-C2-231 |  | USB_HS_DP | 1 | TP11 | TestPoint:TestPoint_Pad_D1.5mm |  | USB D+
PM-C2-232 |  | USB_HS_DM | 1 | TP12 | TestPoint:TestPoint_Pad_D1.5mm |  | USB D-
PM-C2-233 |  | AGND | 1 | TP13 | TestPoint:TestPoint_Pad_D1.5mm |  | analog ground
PM-C2-234 |  | DGND | 1 | TP14 | TestPoint:TestPoint_Pad_D1.5mm |  | digital ground
PM-C2-235 |  | PGND | 1 | TP15 | TestPoint:TestPoint_Pad_D1.5mm |  | power ground
PM-C2-236 |  | LED_DATA | 1 | TP16 | TestPoint:TestPoint_Pad_D1.5mm |  | WS2812 data (after shifter)
PM-C2-237 |  | CHIP_PU | 1 | TP17 | TestPoint:TestPoint_Pad_D1.5mm |  | reset
PM-C2-238 |  | BOOT | 1 | TP18 | TestPoint:TestPoint_Pad_D1.5mm |  | boot strap GPIO35
PM-C2-239 |  | 3V3_C6 | 1 | TP19 | TestPoint:TestPoint_Pad_D1.5mm |  | Wi-Fi/BLE coprocessor rail
PM-C2-240 |  | BL_20V | 1 | TP20 | TestPoint:TestPoint_Pad_D1.5mm |  | backlight rail
PM-C2-241 |  | C6_CS | 1 | TP21 | TestPoint:TestPoint_Pad_D1.5mm |  | C6 SPI select
PM-C2-242 |  | C6_RST | 1 | TP22 | TestPoint:TestPoint_Pad_D1.5mm |  | C6 reset
PM-C2-243 |  | N12_EXT | 1 | TP23 | TestPoint:TestPoint_Pad_D1.5mm |  | -12 V input from PWR-2 (rev.2)
PM-C2-244 |  | 5V_EXT | 1 | TP24 | TestPoint:TestPoint_Pad_D1.5mm |  | +5 V input from PWR-2 (rev.2)
PM-C2-245 |  | 5V_LED | 1 | TP25 | TestPoint:TestPoint_Pad_D1.5mm |  | LED rail from PWR-2 (rev.2)
PM-C2-246 |  | PWR_GOOD | 1 | TP26 | TestPoint:TestPoint_Pad_D1.5mm |  | PWR-2 supervisor (rev.2)
PM-C2-247 |  | EN_RAILS | 1 | TP27 | TestPoint:TestPoint_Pad_D1.5mm |  | EN analog rails (rev.2)
PM-C2-248 |  | LED_RET | 1 | TP28 | TestPoint:TestPoint_Pad_D1.5mm |  | LED return to PWR-2 Q7 (rev.3 DFM)
PM-C2-249 |  | I2S_BCK | 1 | TP29 | TestPoint:TestPoint_Pad_D1.5mm |  | audio bit clock (rev.3 DFM)
PM-C2-250 |  | I2S_LRCK | 1 | TP30 | TestPoint:TestPoint_Pad_D1.5mm |  | audio word clock (rev.3 DFM)
PM-C2-251 |  | MIC_DATA | 1 | TP31 | TestPoint:TestPoint_Pad_D1.5mm |  | MEMS I2S1 data (D-91)
PM-C2-252 |  | MIC_BCK | 1 | TP32 | TestPoint:TestPoint_Pad_D1.5mm |  | MEMS I2S1 bit clock (D-91)
