martiyanov/bukifon/hardware/panel2/BOM-panel2.csv

Номинал | Позиционное обозначение | Корпус / footprint | Артикул (черновой) | Кол-во | Примечание | DNP
0R | R112 | Resistor_SMD:R_0603_1608Metric | RC0603FR-070RL | 1 | net-tie GND-GNDA (одна точка)
100R | R100 R101 R98 R99 | Resistor_SMD:R_0603_1608Metric | RC0603FR-07100RL | 4 | защита CV IN (не влияет на точность: 0.1 % при 100k входа CORE-2)
100k | R120 | Resistor_SMD:R_0603_1608Metric |  | 1
100n | C1 C10 C11 C12 C13 C14 C15 C16 C17 C18 C19 C2 C20 C21 C22 C23 C24 C25 C26 C27 C28 C29 C3 C30 C31 C32 C33 C34 C35 C36 C37 C38 C39 C4 C40 C42 C43 C44 C45 C46 C47 C48 C49 C5 C50 C51 C53 C54 C55 C56 C57 C58 C59 C6 C60 C61 C62 C63 C64 C65 C66 C67 C68 C69 C7 C70 C71 C72 C8 C80 C82 C9 | Capacitor_SMD:C_0603_1608Metric | CC0603KRX7R9BB104 | 72 | RC фаз энкодеров, блокировка ИС/LED, фильтры джеков
10k | R1 R10 R11 R12 R13 R14 R15 R16 R17 R18 R19 R2 R20 R21 R22 R23 R24 R25 R26 R27 R28 R29 R3 R30 R31 R32 R33 R34 R35 R36 R37 R38 R39 R4 R40 R41 R42 R43 R44 R45 R46 R47 R48 R5 R6 R7 R8 R81 R82 R83 R84 R85 R86 R87 R88 R9 R92 | Resistor_SMD:R_0603_1608Metric | RC0603FR-0710KL | 57 | подтяжки фаз/кнопок энкодеров, столбцы матрицы, RESET/INT
10u | C81 | Capacitor_SMD:C_0603_1608Metric | CL10A106KP8NNNC | 1 | вход/выход boost подсветки
1N4148 | D1 D10 D11 D12 D13 D14 D15 D16 D17 D18 D19 D2 D20 D21 D22 D23 D24 D25 D26 D27 D28 D29 D3 D30 D31 D32 D33 D34 D35 D36 D37 D38 D39 D4 D40 D41 D42 D5 D6 D7 D8 D9 | Diode_SMD:D_SOD-323 | 1N4148W | 42 | диод матрицы (антифантом), анод=клавиша, катод=столбец
1k | R102 R104 R105 R114 R121 R49 R50 R51 R52 R53 R54 R55 R56 R57 R58 R59 R60 R61 R62 R63 R64 R65 R66 R67 R68 R69 R70 R71 R72 R73 R74 R75 R76 R77 R78 R79 R80 R94 R95 R96 R97 | Resistor_SMD:R_0603_1608Metric | RC0603FR-071KL | 41 | RC-фильтр фаз энкодеров; последовательные резисторы джеков
330R | R113 | Resistor_SMD:R_0603_1608Metric | RC0603FR-07330RL | 1 | последовательный резистор LED_DATA после буфера
33R | R122 R123 R124 | Resistor_SMD:R_0603_1608Metric | RC0603FR-0733RL | 3 | резистор подсветки LCD (ограничение тока LED-линейки)
4.7k | R103 R110 R111 | Resistor_SMD:R_0603_1608Metric | RC0603FR-074K7L | 3 | I2C pull-up (2 шт.); GATE IN последовательный (1 шт.)
74HCT1G125 | U6 | Package_TO_SOT_SMD:SOT-23-5 | 74HCT1G125 | 1 | буфер LED_DATA 3.3→5 В
74LVC1G17 | U5 | Package_TO_SOT_SMD:SOT-23-5 | 74LVC1G17 | 1 | триггер Шмитта GATE IN (3.3 В)
BAT54S | D53 | Package_TO_SOT_SMD:SOT-23 | BAT54S | 1 | кламп GATE IN к 3.3 В/GNDA
CHOC | KEY_L01 KEY_L02 KEY_L03 KEY_L04 KEY_L05 KEY_L06 KEY_L07 KEY_L08 KEY_L09 KEY_L10 KEY_L11 KEY_L12 KEY_L13 KEY_L14 KEY_L15 KEY_L16 KEY_L17 KEY_L18 KEY_L19 KEY_L20 KEY_L21 KEY_R01 KEY_R02 KEY_R03 KEY_R04 KEY_R05 KEY_R06 KEY_R07 KEY_R08 KEY_R09 KEY_R10 KEY_R11 KEY_R12 KEY_R13 KEY_R14 KEY_R15 KEY_R16 KEY_R17 KEY_R18 KEY_R19 KEY_R20 KEY_R21 |  | Kailh Choc v1 hot-swap (CPG1350) | 42 | Kailh Choc hot-swap (footprint нарисовать на PCB)
EC11 | ENC1 ENC10 ENC11 ENC12 ENC13 ENC14 ENC15 ENC16 ENC2 ENC3 ENC4 ENC5 ENC6 ENC7 ENC8 ENC9 | Rotary_Encoder:RotaryEncoder_Alps_EC11E-Switch_Vertical_H20mm | EC11E15244G1 | 16 | энкодер гладкий с кнопкой, Ø14
FB | FB1 | Inductor_SMD:L_Bourns_SRN6045TA | Ferrite bead 600 Ом @100 МГц (развязка MIC от WS2812/BL) | 1 | развязка питания микрофона от WS2812/подсветки
FFC40 | J12 | Connector_FFC-FPC:Hirose_FH12-40S-0.5SH_1x40-1MP_P0.50mm_Horizontal |  | 1
FPC40 | J11 | Connector_FFC-FPC:Hirose_FH12-40S-0.5SH_1x40-1MP_P0.50mm_Horizontal | Hirose FH12-40S-0.5SH (FPC-40, 0.5 мм, нижний контакт) | 1 | разъём FPC-40 экрана (0.5 мм)
HDR1x14 | J15 | Connector_PinHeader_2.54mm:PinHeader_1x14_P2.54mm_Vertical | 1x14 pin header 2.54 (SPI alt, DNP) | 1 | альтернативный SPI-дисплей (DNP) | да
ICS-43434 | U8 | Sensor_Audio:InvenSense_ICS-43434-6_3.5x2.65mm | ICS-43434 (TDK InvenSense, I2S MEMS, 24 бит, 3.3 В, −26 дБFS) | 1 | I2S MEMS-микрофон 24 бит/48 кГц, 3.3 В; акустический порт верхней кромки
IDC16 | J13 | Connector_IDC:IDC-Header_2x08_P2.54mm_Vertical | IDC-16 2x8 box header | 1 | цифровой шлейф к CORE-2
IDC26 | J14 | Connector_IDC:IDC-Header_2x13_P2.54mm_Vertical | IDC-26 2x13 box header | 1 | аналоговый шлейф к CORE-2
IDC6 | J16 | Connector_IDC:IDC-Header_2x03_P2.54mm_Vertical | IDC-6 2x3 box header (микрофонный шлейф к CORE-2) | 1 | шлейф MIC: BCK/WS/DATA + 3V3 + 2×GND
JACK | J01 J02 J03 J04 J05 J06 J07 J08 J09 J10 | Connector_Audio:Jack_3.5mm_CUI_SJ1-3523N_Horizontal | Rean NYS230 / NJ3FP6C (3.5 mm, панельный) | 10 | mini-jack 3.5 мм панельный
LED0603 | LED_MICON | LED_SMD:LED_0603_1608Metric | LED 0603 зелёный (MIC ON) | 1 | индикатор MIC ON (горит только при включённом питании микрофона)
M3 | H1 H2 H3 H4 H5 H6 | MountingHole:MountingHole_3.2mm_M3 | Mounting hole M3 (3.2 mm) | 6 | крепёж: 6 стоек PANEL-1 rev.2 (30/145/260 × 30/180)
MCP23017 | U1 U2 U3 U4 | Package_SO:SOIC-28W_7.5x17.9mm_P1.27mm | MCP23017-E/SO | 4 | I2C expander: 2× A/B, 1× SW энкодеров, 1× матрица
POT60 | F1 F2 | Potentiometer_THT:Potentiometer_Bourns_PTA6043_Single_Slide | Bourns PTA6043-2015DPB103 (10k, 60 mm) | 2 | фейдер 60 мм, 10 кОм, линейный
SMAJ12A | D44 D45 D46 D47 | Diode_SMD:D_SMA | SMAJ12A | 4 | TVS CV OUT (кламп 12 В)
SMAJ15A | D48 D49 D50 D51 | Diode_SMD:D_SMA | SMAJ15A | 4 | TVS CV IN (кламп 15 В, ±12 В вход не проводит)
SMAJ5.0A | D52 | Diode_SMD:D_SMA | SMAJ5.0A | 1 | TVS GATE OUT (кламп 5 В)
SRV05-4 | U9 | Package_TO_SOT_SMD:SOT-23-6 | SRV05-4 (ESD-матрица 4 линии, 3.3 В) | 1 | ESD-защита линий MIC_BCK/WS/DATA
SW_SPST | SW1 | Button_Switch_THT:SW_DIP_SPSTx01_Slide_6.7x4.1mm_W7.62mm_P2.54mm_LowProfile | SS-12D00 (SPST слайд, мьют питания микрофона) | 1 | аппаратный МЬЮТ: разрывает питание микрофона (R-37, docs/71)
TP | TP1 TP10 TP11 TP2 TP3 TP36 TP37 TP38 TP39 TP4 TP5 TP6 TP7 TP8 TP9 | TestPoint:TestPoint_Pad_D1.0mm | Test point 1.0 mm pad | 15 | тестпоинты
WS2812B-2020 | LED_ENC1 LED_ENC10 LED_ENC11 LED_ENC12 LED_ENC13 LED_ENC14 LED_ENC15 LED_ENC16 LED_ENC2 LED_ENC3 LED_ENC4 LED_ENC5 LED_ENC6 LED_ENC7 LED_ENC8 LED_ENC9 LED_STATUS | LED_SMD:LED_WS2812B-2020_PLCC4_2.0x2.0mm | WS2812B-2020 | 17 | RGB подсветка ручек/статус (5V_LED, возврат LED_RET)
ИТОГО |  |  |  | 361 | 36 уникальных позиций
