martiyanov/bukifon/hardware/power2/bench-bom.csv

ref | позиция | MPN/тип | кол-во | цена $/шт | итого $ | цена ₽/шт | итого ₽ | источник | примечание | статус
P-01 | TPS61088 boost-модуль (регулируемый, 10 А) | модуль | 1 | 3.5 | 3.5 | 280 | 280.0 | AliExpress | макет +12 В и +5 В стенда | draft; оценка ±30%
P-02 | TPS61088RHLR (QFN-20) | IC | 2 | 2.87 | 5.74 | 230 | 459.0 | Mouser 595-TPS61088RHLR | запас/bare-IC для PWR-2 | draft; оценка ±30%
P-03 | LMR33630ADDA (SOIC-8 PowerPAD) | IC | 2 | 2.1 | 4.2 | 168 | 336.0 | Mouser 595-LMR33630ADDA | IBB −12 В | draft; оценка ±30%
P-04 | TPS63802DLAR (SON-10) | IC | 2 | 2.4 | 4.8 | 192 | 384.0 | Mouser 595-TPS63802DLAR | 3.3 В buck-boost (D-49) | draft; оценка ±30%
P-05 | BQ24074RGTT (VQFN-16) | IC | 2 | 3.24 | 6.48 | 259 | 518.0 | Mouser 595-BQ24074RGTT | charge/power-path | draft; оценка ±30%
P-06 | MAX17048G+T (fuel gauge) | IC | 1 | 1.8 | 1.8 | 144 | 144.0 | Mouser 595-MAX17048G+T | I2C 0x36 | draft; оценка ±30%
P-07 | BMS 1S (DW01/FS312F, модуль) | модуль | 2 | 1.5 | 3.0 | 120 | 240.0 | AliExpress | защита 1S, макет | draft; оценка ±30%
P-08 | Холдер 18650 (2 слота) | держатель | 2 | 1.2 | 2.4 | 96 | 192.0 | AliExpress | пакет 1S2P | draft; оценка ±30%
P-09 | 18650 Li-Ion (тестовые, ≥2500 мА·ч) | ячейка | 2 | 6.0 | 12.0 | 480 | 960.0 | AliExpress/местный | ТОЛЬКО для стенда; в продукт — traceable pack | draft; оценка ±30%
P-10 | INA226 (I2C ток/напряжение) | модуль | 2 | 3.0 | 6.0 | 240 | 480.0 | AliExpress | измерение токов рельсов | draft; оценка ±30%
P-11 | USB-C PD trigger 12 В (модуль) | модуль | 1 | 3.0 | 3.0 | 240 | 240.0 | AliExpress | имитация внешнего 12 В | draft; оценка ±30%
P-12 | Электронная нагрузка USB (5 А) | прибор | 1 | 12.0 | 12.0 | 960 | 960.0 | AliExpress | load step/КЗ | draft; оценка ±30%
P-13 | Набор мощных резисторов (нагрузка) | набор | 1 | 8.0 | 8.0 | 640 | 640.0 | AliExpress | альтернатива нагрузке | draft; оценка ±30%
P-14 | Переходные платы SOIC/QFN→DIP | набор | 5 | 1.0 | 5.0 | 80 | 400.0 | AliExpress | монтаж bare-IC | draft; оценка ±30%
P-15 | Макетка + Dupont-провода | набор | 1 | 8.0 | 8.0 | 640 | 640.0 | AliExpress/местный | стенд | draft; оценка ±30%
P-16 | USB-C кабели (data/питание) | кабель | 2 | 2.5 | 5.0 | 200 | 400.0 | местный | — | draft; оценка ±30%
P-17 | Термопара K + адаптер к мультиметру | прибор | 1 | 8.0 | 8.0 | 640 | 640.0 | AliExpress | тепловой контроль DC/DC | draft; оценка ±30%
P-18 | Радиаторы/медная фольга (тепло) | набор | 1 | 4.0 | 4.0 | 320 | 320.0 | AliExpress | нагрев TPS61088/IBB | draft; оценка ±30%
P-19 | IDC-20 (2×10) + шлейф 20 pin | комплект | 1 | 3.0 | 3.0 | 240 | 240 | AliExpress | T13 (3 А на J3); ответный PWR-2 J3 | draft; оценка ±30%
P-20 | USB-I2C адаптер (CH341A или FT232H) | модуль | 1 | 5.0 | 5.0 | 400 | 400 | AliExpress | лог INA226×2–3 + MAX17048 (T5/T10) | draft; оценка ±30%
P-21 | PC817 ×1 + 2N7002 ×3 | набор | 1 | 2.0 | 2.0 | 160 | 160 | AliExpress | EN IBB/EN-линии (T4/T12) | draft; оценка ±30%
P-22 | AO3401A ×2 + MMBT3904 | набор | 1 | 2.0 | 2.0 | 160 | 160 | LCSC/Ali | master load-switch (T11) | draft; оценка ±30%
P-23 | AO3400A ×1 | IC | 1 | 1.0 | 1.0 | 80 | 80 | LCSC | LED-ключ (T3B/T12) | draft; оценка ±30%
P-24 | SS34 ×2 + полифьюзы 0.5/0.3/2/2.5 А + SMAJ15A/SMBJ5.0A + 2N7002 | набор | 1 | 4.0 | 4.0 | 320 | 320 | platan/Ali | воспроизвести D7/D8 на стенде (11.7/−11.55 В) | draft; оценка ±30%
P-25 | π-фильтры: L 4.7 мкГн ×2, L 10 мкГн, C 47 мкФ/25 В ×6, C 22 мкФ/25 В ×2 | набор | 1 | 4.0 | 4.0 | 320 | 320 | LCSC/Ali | T3 ripple/EMI шин | draft; оценка ±30%
P-EVM-01 | LMR33630ADDAEVM (IBB −12 В) | EVM | 1 | 45.0 | 45.0 | 3600 | 3600 | TI/Mouser | вариант A (D-76): главный риск IBB; D-79: утверждено; samples B параллельно (TI/Maxim EVB, 0 $, резерв/сверка) | утверждено, вариант A (D-79)
P-EVM-02 | TPS61088EVM-677 | EVM | 1 | 50.0 | 50.0 | 4000 | 4000 | TI/Mouser | вариант A (D-76): +12/+5 топология, КПД, шум; D-79: утверждено; samples B параллельно (TI/Maxim EVB, 0 $, резерв/сверка) | утверждено, вариант A (D-79)
P-EVM-03 | BQ24074EVM | EVM | 1 | 45.0 | 45.0 | 3600 | 3600 | TI/Mouser | вариант A (D-76): заряд/power-path/тепло (T6); D-79: утверждено; samples B параллельно (TI/Maxim EVB, 0 $, резерв/сверка) | утверждено, вариант A (D-79)
P-EVM-04 | MAX17048 breakout (Adafruit 5580) | breakout | 1 | 13.0 | 13.0 | 1040 | 1040 | Adafruit/Mouser | вариант A (D-76): гейдж (T10); D-79: утверждено; samples B параллельно (TI/Maxim EVB, 0 $, резерв/сверка) | утверждено, вариант A (D-79)
