martiyanov/bukifon/hardware/core/BOM-core.csv

Артикул | MPN | Номинал/Тип | Кол-во | Позиции | Корпус | Примечание
PM-CORE-001 |  | DC 5.5/2.1 12V | 1 | J14 |  | не на CORE-1 (панельный разъём); spec: J-DC; внешний БП
PM-CORE-002 |  | POWER | 1 | SW1 |  | не на CORE-1 (панельный разъём); тумблер питания (задняя стенка)
PM-CORE-003 |  | 2A | 1 | F1 | Fuse:Fuse_1206_3216Metric
PM-CORE-004 |  | SMAJ15A | 1 | D2 | Diode_SMD:D_SMA | TVS 15V
PM-CORE-005 |  | 1000uF/25V | 1 | C1 | Capacitor_SMD:CP_Elec_6.3x7.7
PM-CORE-006 |  | 100nF/50V | 3 | C2 C3 C10 | Capacitor_SMD:C_0805_2012Metric
PM-CORE-007 |  | SS34 | 1 | D1 | Diode_SMD:D_SMA | защита от переполюсовки
PM-CORE-008 |  | MP1584 5.1V/3A | 1 | U1 |  | модуль DC-DC
PM-CORE-009 |  | 100uF/10V | 2 | C4 C14 | Capacitor_SMD:CP_Elec_6.3x7.7
PM-CORE-010 |  | 100nF/25V | 1 | C5 | Capacitor_SMD:C_0805_2012Metric
PM-CORE-011 |  | AP2112K-3.3 | 1 | U2 | Package_TO_SOT_SMD:SOT-23-5 | LDO 3.3V 600mA
PM-CORE-012 |  | 1uF/10V | 2 | C6 C7 | Capacitor_SMD:C_0805_2012Metric
PM-CORE-013 |  | 100nF | 29 | C8 C16 C20 C21 C23 C25 C26 C29 C30 C31 C32 C34 C40 C41 C43 C44 C47 C48 C49 C50 C51 C54 C55 C56 C57 C58 C60 C62 C63 | Capacitor_SMD:C_0805_2012Metric
PM-CORE-014 |  | MC34063 | 1 | U3 | Package_DIP:DIP-8_W7.62mm | инвертор -12V
PM-CORE-015 |  | 0.33 | 1 | R74 | Resistor_SMD:R_0805_2012Metric | spec: Rsc; токовый шунт
PM-CORE-016 |  | 1.5nF | 1 | C59 | Capacitor_SMD:C_0805_2012Metric | spec: Ct
PM-CORE-017 |  | 220uH/0.5A | 1 | L1 | Inductor_SMD:L_1210_3225Metric
PM-CORE-018 |  | SS34 | 1 | D3 | Diode_SMD:D_SMA
PM-CORE-019 |  | 33k | 1 | R75 | Resistor_SMD:R_0805_2012Metric | spec: Rfb1
PM-CORE-020 |  | 3.9k | 1 | R76 | Resistor_SMD:R_0805_2012Metric | spec: Rfb2
PM-CORE-021 |  | 220uF/25V | 1 | C9 | Capacitor_SMD:CP_Elec_6.3x7.7 | полярность: + на PGND
PM-CORE-022 |  | 100uF/25V | 2 | C11 C12 | Capacitor_SMD:CP_Elec_6.3x7.7
PM-CORE-023 |  | 600R@100MHz | 5 | FB1 FB2 FB3 FB4 FB5 | Inductor_SMD:L_0805_2012Metric
PM-CORE-024 |  | 100uF/25V | 1 | C13 | Capacitor_SMD:CP_Elec_6.3x7.7 | полярность: + на PGND
PM-CORE-025 |  | 10uF/10V | 7 | C15 C17 C19 C22 C24 C33 C61 | Capacitor_SMD:C_0805_2012Metric
PM-CORE-026 |  | AGND=DGND | 1 | NT1 | NetTie:NetTie-2_SMD_Pad0.5mm | net-tie AGND-DGND (одна точка)
PM-CORE-027 |  | DGND=PGND | 1 | NT2 | NetTie:NetTie-2_SMD_Pad0.5mm | net-tie DGND-PGND (одна точка)
PM-CORE-028 |  | Raspberry Pi Pico (RP2040) | 1 | A1 | Module:RaspberryPi_Pico_SMD | SMD-пайка на кастеляцию, гребёнки опционально
PM-CORE-029 |  | 100nF | 1 | C18 | Capacitor_SMD:C_0805_2012Metric | ADC_VREF
PM-CORE-030 |  | SS34 | 1 | D4 | Diode_SMD:D_SMA | VSYS через Шоттки
PM-CORE-031 |  | 10k | 1 | R1 | Resistor_SMD:R_0805_2012Metric | pull-up RESET
PM-CORE-032 |  | RESET | 1 | SW2 |  | не на CORE-1 (панельный разъём); кнопка RESET (задняя стенка)
PM-CORE-033 |  | 330 | 1 | R2 | Resistor_SMD:R_0805_2012Metric | WS2812 data
PM-CORE-034 |  | 4.7k | 2 | R3 R4 | Resistor_SMD:R_0805_2012Metric | I2C pull-up
PM-CORE-035 | MCP4728A0-E/UN | MCP4728A0-E/UN (0x60) | 1 | U4 | Package_SO:MSOP-10_3x3mm_P0.5mm | 4x12bit I2C DAC, Vref 2.048V
PM-CORE-036 |  | 24LC32 | 1 | U5 | Package_DIP:DIP-8_W7.62mm | калибровка CV, адрес 0x57 (A2..A0=1)
PM-CORE-037 | MCP4728A1-E/UN | MCP4728A1-E/UN (0x61) | 1 | U16 | Package_SO:MSOP-10_3x3mm_P0.5mm | MCP4728 #2 (CV OUT 1/2), адрес 0x61 (EEPROM)
PM-CORE-038 |  | MCP3208 | 1 | U6 | Package_DIP:DIP-16_W7.62mm | 8x12bit SPI ADC
PM-CORE-039 |  | 6N137 | 1 | U7 | Package_DIP:DIP-8_W7.62mm | оптрон MIDI IN
PM-CORE-040 |  | 220 | 2 | R5 R8 | Resistor_SMD:R_0805_2012Metric
PM-CORE-041 |  | 4.7k | 1 | R6 | Resistor_SMD:R_0805_2012Metric | pull-up 6N137 (3.3V)
PM-CORE-042 |  | 74HCT125 | 1 | U8 | Package_SO:SOIC-14_3.9x8.7mm_P1.27mm | MIDI OUT буфер
PM-CORE-043 |  | 33 | 1 | R7 | Resistor_SMD:R_0805_2012Metric
PM-CORE-044 |  | 2N7000 | 1 | Q1 | Package_TO_SOT_THT:TO-92_Inline | open-drain GATE1
PM-CORE-045 |  | 1k | 9 | R9 R12 R15 R48 R49 R64 R65 R66 R69 | Resistor_SMD:R_0805_2012Metric
PM-CORE-046 |  | 100k | 5 | R10 R13 R16 R44 R46 | Resistor_SMD:R_0805_2012Metric
PM-CORE-047 |  | 4.7k | 1 | R11 | Resistor_SMD:R_0805_2012Metric | pull-up GATE1
PM-CORE-048 |  | 2N7000 | 1 | Q2 | Package_TO_SOT_THT:TO-92_Inline | open-drain GATE2
PM-CORE-049 |  | 4.7k | 1 | R14 | Resistor_SMD:R_0805_2012Metric | pull-up GATE2
PM-CORE-050 |  | 2N7002 | 1 | Q3 | Package_TO_SOT_SMD:SOT-23 | ключ подсветки LCD
PM-CORE-051 |  | PCM5102A | 1 | U9 | Package_SO:TSSOP-20_4.4x6.5mm_P0.65mm | I2S ЦАП 112dB
PM-CORE-052 |  | 1uF/10V | 1 | C27 | Capacitor_SMD:C_0805_2012Metric | charge-pump flying cap
PM-CORE-053 |  | 1uF/10V | 1 | C28 | Capacitor_SMD:CP_Elec_6.3x7.7 | полярность: + на AGND
PM-CORE-054 |  | 10k | 1 | R17 | Resistor_SMD:R_0805_2012Metric | unmute
PM-CORE-055 |  | 10uF/16V | 1 | C35 | Capacitor_SMD:CP_Elec_6.3x7.7 | AC-развязка L
PM-CORE-056 |  | 10uF/16V | 1 | C36 | Capacitor_SMD:CP_Elec_6.3x7.7 | AC-развязка R
PM-CORE-057 |  | 10k | 2 | R18 R19 | Resistor_SMD:R_0805_2012Metric
PM-CORE-058 |  | 1k | 1 | R20 | Resistor_SMD:R_0805_2012Metric | защита аудиовхода порта 0
PM-CORE-059 |  | BAT54S | 3 | D5 D6 D7 | Package_TO_SOT_SMD:SOT-23 | клэмп ±12V
PM-CORE-060 |  | 100pF | 5 | C37 C38 C39 C45 C46 | Capacitor_SMD:C_0805_2012Metric
PM-CORE-061 |  | 22k | 6 | R23 R24 R25 R26 R27 R28 | Resistor_SMD:R_0805_2012Metric
PM-CORE-062 |  | 1k | 1 | R21 | Resistor_SMD:R_0805_2012Metric | защита аудиовхода порта 1
PM-CORE-063 |  | 1k | 1 | R22 | Resistor_SMD:R_0805_2012Metric | защита аудиовхода порта 2
PM-CORE-064 |  | TL074 | 1 | U10 | Package_DIP:DIP-14_W7.62mm | сумматор L
PM-CORE-065 |  | 22k | 1 | R70 | Resistor_SMD:R_0805_2012Metric | Rf сумматора L
PM-CORE-066 |  | 22k | 1 | R71 | Resistor_SMD:R_0805_2012Metric | Rf сумматора R
PM-CORE-067 |  | 10uF/16V | 1 | C42 | Capacitor_SMD:CP_Elec_6.3x7.7 | AUD_IN из DAC L
PM-CORE-068 |  | 10k | 2 | R72 R73 | Resistor_SMD:R_0805_2012Metric | делитель x0.5
PM-CORE-069 |  | 1k | 1 | R29 | Resistor_SMD:R_0805_2012Metric | выход AUD_IN на шину
PM-CORE-070 |  | 10k log dual | 1 | RP1 |  | не на CORE-1 (панельный разъём); MASTER VOL (задняя стенка)
PM-CORE-071 |  | TL072 | 1 | U11 | Package_DIP:DIP-8_W7.62mm | буфер L
PM-CORE-072 |  | 100 | 2 | R30 R31 | Resistor_SMD:R_0805_2012Metric
PM-CORE-073 |  | LINE OUT 3.5mm stereo | 1 | J1 |  | не на CORE-1 (панельный разъём); панельный джек, к клеммнику TB1
PM-CORE-074 |  | PHONES 3.5mm stereo | 1 | J2 |  | не на CORE-1 (панельный разъём); панельный джек, к клеммнику TB1
PM-CORE-075 |  | TL074 | 1 | U12 | Package_DIP:DIP-14_W7.62mm | буфер CV1 x4.9
PM-CORE-076 |  | 39k | 1 | R32 | Resistor_SMD:R_0805_2012Metric | Rf CV1 x4.9
PM-CORE-077 |  | 10k | 1 | R36 | Resistor_SMD:R_0805_2012Metric | Rg CV1 x4.9
PM-CORE-078 |  | 1k | 1 | R40 | Resistor_SMD:R_0805_2012Metric | выход CV1
PM-CORE-079 |  | BAT54S | 1 | D9 | Package_TO_SOT_SMD:SOT-23 | защита CV1
PM-CORE-080 |  | 39k | 1 | R33 | Resistor_SMD:R_0805_2012Metric | Rf CV2 x4.9
PM-CORE-081 |  | 10k | 1 | R37 | Resistor_SMD:R_0805_2012Metric | Rg CV2 x4.9
PM-CORE-082 |  | 1k | 1 | R41 | Resistor_SMD:R_0805_2012Metric | выход CV2
PM-CORE-083 |  | BAT54S | 1 | D10 | Package_TO_SOT_SMD:SOT-23 | защита CV2
PM-CORE-084 |  | 39k | 1 | R34 | Resistor_SMD:R_0805_2012Metric | Rf CV3 x4.9
PM-CORE-085 |  | 10k | 1 | R38 | Resistor_SMD:R_0805_2012Metric | Rg CV3 x4.9
PM-CORE-086 |  | 1k | 1 | R42 | Resistor_SMD:R_0805_2012Metric | выход CV3
PM-CORE-087 |  | BAT54S | 1 | D11 | Package_TO_SOT_SMD:SOT-23 | защита CV3
PM-CORE-088 |  | 39k | 1 | R35 | Resistor_SMD:R_0805_2012Metric | Rf CV4 x4.9
PM-CORE-089 |  | 10k | 1 | R39 | Resistor_SMD:R_0805_2012Metric | Rg CV4 x4.9
PM-CORE-090 |  | 1k | 1 | R43 | Resistor_SMD:R_0805_2012Metric | выход CV4
PM-CORE-091 |  | BAT54S | 1 | D12 | Package_TO_SOT_SMD:SOT-23 | защита CV4
PM-CORE-092 |  | TL074 | 1 | U13 | Package_DIP:DIP-14_W7.62mm | CV IN1 сдвиг 1.65В
PM-CORE-093 |  | TL074 | 1 | U17 | Package_DIP:DIP-14_W7.62mm | буфер CV5 x4.9
PM-CORE-094 |  | 39k | 1 | R77 | Resistor_SMD:R_0805_2012Metric | Rf CV5 x4.9
PM-CORE-095 |  | 39k | 1 | R78 | Resistor_SMD:R_0805_2012Metric | Rf CV6 x4.9
PM-CORE-096 |  | 10k | 1 | R79 | Resistor_SMD:R_0805_2012Metric | Rg CV5 x4.9
PM-CORE-097 |  | 10k | 1 | R80 | Resistor_SMD:R_0805_2012Metric | Rg CV6 x4.9
PM-CORE-098 |  | 1k | 1 | R81 | Resistor_SMD:R_0805_2012Metric | выход CV5 (джек CV OUT 1)
PM-CORE-099 |  | 1k | 1 | R82 | Resistor_SMD:R_0805_2012Metric | выход CV6 (джек CV OUT 2)
PM-CORE-100 |  | BAT54S | 1 | D17 | Package_TO_SOT_SMD:SOT-23 | защита CV5
PM-CORE-101 |  | BAT54S | 1 | D18 | Package_TO_SOT_SMD:SOT-23 | защита CV6
PM-CORE-102 |  | CV OUT 1 (CV5) | 1 | J5 |  | не на CORE-1 (панельный разъём); панельный джек
PM-CORE-103 |  | CV OUT 2 (CV6) | 1 | J6 |  | не на CORE-1 (панельный разъём); панельный джек
PM-CORE-104 |  | 16.5k | 2 | R45 R47 | Resistor_SMD:R_0805_2012Metric | Rf, gain 0.165
PM-CORE-105 |  | BAT54S | 2 | D13 D14 | Package_TO_SOT_SMD:SOT-23
PM-CORE-106 |  | 47k | 2 | R50 R51 | Resistor_SMD:R_0805_2012Metric | 1.65V
PM-CORE-107 |  | 12k | 1 | R67 | Resistor_SMD:R_0805_2012Metric | +5V делитель
PM-CORE-108 |  | 18k | 1 | R68 | Resistor_SMD:R_0805_2012Metric | +5V делитель
PM-CORE-109 |  | CV IN 1 | 1 | J7 |  | не на CORE-1 (панельный разъём); панельный джек
PM-CORE-110 |  | CV IN 2 | 1 | J8 |  | не на CORE-1 (панельный разъём); панельный джек
PM-CORE-111 |  | GATE 1 | 1 | J9 |  | не на CORE-1 (панельный разъём); панельный джек
PM-CORE-112 |  | GATE 2 | 1 | J10 |  | не на CORE-1 (панельный разъём); панельный джек
PM-CORE-113 |  | MIDI IN (TRS-A) | 1 | J11 |  | не на CORE-1 (панельный разъём); панельный джек
PM-CORE-114 |  | MIDI OUT (TRS-A) | 1 | J12 |  | не на CORE-1 (панельный разъём); панельный джек
PM-CORE-115 |  | Bukifon Bus IDC-26 PORT1 | 1 | P1 | Connector_IDC:IDC-Header_2x13_P2.54mm_Latch_Vertical | порт 1
PM-CORE-116 |  | Bukifon Bus IDC-26 PORT2 | 1 | P2 | Connector_IDC:IDC-Header_2x13_P2.54mm_Latch_Vertical | порт 2
PM-CORE-117 |  | Bukifon Bus IDC-26 PORT3 | 1 | P3 | Connector_IDC:IDC-Header_2x13_P2.54mm_Latch_Vertical | порт 3
PM-CORE-118 |  | IDC-32 to PANEL-1 | 1 | J15 |  | spec: J-PANEL; шлейф 15 см
PM-CORE-119 |  | Jacks: LINE/PHONES/CV1/CV2/CVIN1 | 1 | TB1 | TerminalBlock_Phoenix:TerminalBlock_Phoenix_MKDS-1-12-3.81_1x12_P3.81mm_Horizontal | клеммник 3.81 мм
PM-CORE-120 |  | Jacks: CVIN2/GATE/MIDI | 1 | TB2 | TerminalBlock_Phoenix:TerminalBlock_Phoenix_MKDS-1-12-3.81_1x12_P3.81mm_Horizontal | клеммник 3.81 мм
PM-CORE-121 |  | SWD | 1 | J16 | Connector_PinHeader_2.54mm:PinHeader_1x03_P2.54mm_Vertical | spec: HDR-EXT; SWD 1x3
PM-CORE-122 |  | Pico SWD pads | 1 | J13 |  | контактные площадки Pico (DEBUG)
