martiyanov/bukifon/hardware/power/BOM-power.csv

Артикул | Позиция | Номинал / тип | Корпус / посадка | Кол-во | MPN / замены | Примечание | Цена, ₽
PM-PWR-001 | J1 | USB-C 16P (заряд) | USB_C_Receptacle_HRO_TYPE-C-31-M-12 | 1 | HRO TYPE-C-31-M-12 | зарядный вход 5 В; data-линии не используются (MIDI — на Pico)
PM-PWR-002 | R1 | 5.1k | R_0603_1608Metric | 1 | RC0603FR-075K1L | CC1 → GND: UFP-резистор, разрешает 5 В от USB-C
PM-PWR-003 | R2 | 5.1k | R_0603_1608Metric | 1 | RC0603FR-075K1L | CC2 → GND: второй UFP-резистор
PM-PWR-004 | U1 | USBLC6-2SC6 | SOT-23-6 | 1 | USBLC6-2SC6 | ESD-защита: I/O на VBUS (данные не используются), т.к. порт только зарядный
PM-PWR-005 | F2 | 1.1 A | Fuse_1206_3216Metric | 1 | MF-MSMF110 / 1206L110 | самовосстанавливающийся предохранитель по VBUS (заряд ≤ 1 А)
PM-PWR-006 | U2 | TP4056 | SOIC-8-1EP_3.9x4.9mm_P1.27mm_EP2.41x3.3mm | 1 | TP4056-42-ESOP8 | линейный заряд Li-ion 4.2 В, 1 А; BMS-защита стоит между BAT и банками
PM-PWR-007 | R3 | 1.2k | R_0603_1608Metric | 1 | RC0603FR-071K2L | PROG: Iзар = 1000 мА (R = 1200 Ом)
PM-PWR-008 | R4 | 1k | R_0603_1608Metric | 1 | RC0603FR-071KL | ток LED «ИДЁТ ЗАРЯД» (~3 мА)
PM-PWR-009 | R5 | 1k | R_0603_1608Metric | 1 | RC0603FR-071KL | ток LED «ЗАРЯД ОКОНЧЕН»
PM-PWR-010 | LED1 | RED заряд | LED_0603_1608Metric | 1 |  | индикация CHRG (красный)
PM-PWR-011 | LED2 | GREEN готово | LED_0603_1608Metric | 1 |  | индикация STDBY (зелёный)
PM-PWR-012 | C1 | 10uF | C_0805_2012Metric | 1 | CL21B106KOQNNNE | вход TP4056
PM-PWR-013 | C2 | 1uF | C_0805_2012Metric | 1 | CL21B105KBFNNNE | выход BAT TP4056
PM-PWR-014 | R6 | 10k | R_0603_1608Metric | 1 | RC0603FR-0710KL | верх плеча NTC: TEMP = 5 В · Rntc/(Rntc+10k) → 45…80 % VCC = рабочий диапазон TP4056
PM-PWR-015 | TH1 | NTC 10k B3950 | — (в отсеке) | 1 | NTC 10k B3950 (в батарейном отсеке) | термистор НА БАНКАХ, подключается через J3 pin3 (второй вывод — B−)
PM-PWR-016 | R7 | 200k | R_0603_1608Metric | 1 | RC0603FR-07200KL | делитель для АЦП 1/2 (см. R8); нагрузка плеча NTC ≈ 2 %
PM-PWR-017 | R8 | 200k | R_0603_1608Metric | 1 | RC0603FR-07200KL | нижнее плечо TEMP_ADC
PM-PWR-018 | C3 | 100n | C_0805_2012Metric | 1 | CL21B104KBCNNNC | RC-фильтр TEMP_ADC
PM-PWR-019 | BT1 | 18650 3.6V 3.5Ah | BatteryHolder_Keystone_1042_1x18650 | 1 | LiitoKala / Samsung INR18650-35E | банка 1 из 2 (параллельно); холдер в брюшном отсеке, не на плате
PM-PWR-020 | BT2 | 18650 3.6V 3.5Ah | BatteryHolder_Keystone_1042_1x18650 | 1 | LiitoKala / Samsung INR18650-35E | банка 2 из 2 (параллельно); холдер в брюшном отсеке, не на плате
PM-PWR-021 | J2 | BMS 1S 2P | PinHeader_1x04_P2.54mm_Vertical | 1 | BMS 1S 2P 5 A (DW01A+FS8205A) | готовый BMS-модуль: B−, B+, P−, P+ (защита от переразряда/перезаряда/КЗ)
PM-PWR-022 | J3 | BAT PACK 3P | TerminalBlock_4Ucon_1x03_P3.50mm_Vertical | 1 | KF128-3P / 3.81 мм | батарейный отсек: 1 = B+, 2 = B−, 3 = NTC
PM-PWR-023 | F3 | 2 A | Fuse_1206_3216Metric | 1 | MF-MSMF200 / 1206L200 | защита выхода батареи до выключателя (КЗ в шлейфе/плате)
PM-PWR-024 | SW1 | BATT ON/OFF | — (в отсеке) | 1 | MSK-12C02 (SPDT слайдер) | выключатель батареи: полностью отключает банки (хранение/транспорт); положение 2 = OFF
PM-PWR-025 | C4 | 22uF | C_1210_3225Metric | 1 | CL32A226KOJNNNE | вход буста (импульсный ток)
PM-PWR-026 | R9 | 100k | R_0603_1608Metric | 1 | RC0603FR-07100KL | pull-up EN буста (MT3608 включается при EN > 1.5 В)
PM-PWR-027 | Q1 | 2N7002 | SOT-23 | 1 | 2N7002 | гасит EN буста, когда есть внешние 12 В → батарея не разряжается
PM-PWR-028 | C5 | 100n | C_0805_2012Metric | 1 | CL21B104KBCNNNC | фильтр EN
PM-PWR-029 | R10 | 100k | R_0603_1608Metric | 1 | RC0603FR-07100KL | делитель EXT_DET: 12 В → 2.16 В
PM-PWR-030 | R11 | 22k | R_0603_1608Metric | 1 | RC0603FR-0722KL | нижнее плечо EXT_DET
PM-PWR-031 | C6 | 100n | C_0805_2012Metric | 1 | CL21B104KBCNNNC | задержка/фильтр EXT_DET (мягкий переход источник→батарея)
PM-PWR-032 | U3 | MT3608 | SOT-23-6 | 1 | MT3608 | boost 1.2 МГц, ключ 2 А; Vout = 0.6·(1+91k/4.7k) = 12.22 В (ОС снимается ПОСЛЕ D2)
PM-PWR-033 | L1 | 22uH / 3A | L_Bourns-SRN6028 | 1 | Bourns SRN6028-220M | индуктивность буста (насыщение ≥ 3 А — пиковый ток при 3.6 В → 12 В)
PM-PWR-034 | D2 | SS34 | D_SMA | 1 | SS34 (SMA) | диод ИЛИ батарейного плеча: не даёт шине 12 В утекать в буст и обратно
PM-PWR-035 | R12 | 91k | R_0603_1608Metric | 1 | RC0603FR-0791KL | верх ОС: 12.22 В
PM-PWR-036 | R13 | 4.7k | R_0603_1608Metric | 1 | RC0603FR-074K7L | низ ОС: Vref 0.6 В
PM-PWR-037 | C7 | 22uF/25V | C_1210_3225Metric | 1 | CL32A226KOJNNNE | выход буста 1
PM-PWR-038 | C8 | 22uF/25V | C_1210_3225Metric | 1 | CL32A226KOJNNNE | выход буста 2 (пульсации)
PM-PWR-039 | J4 | 12V IN | TerminalBlock_4Ucon_1x02_P3.50mm_Vertical | 1 | KF128-2P / 3.81 мм | вход внешнего БП 12 В: идёт с панельного J-DC (5.5/2.1) через пигтейл
PM-PWR-040 | F1 | 2 A | Fuse_1206_3216Metric | 1 | MF-MSMF200 / 1206L200 | защита входа 12 В (повторяет F1 CORE-1, стоит до пигтейла)
PM-PWR-041 | D3 | SS34 | D_SMA | 1 | SS34 (SMA) | диод ИЛИ внешнего плеча + защита от переполюсовки
PM-PWR-042 | D4 | SMAJ15A | D_SMA | 1 | SMAJ15A | TVS на входе 12 В (импульсы БП, статика)
PM-PWR-043 | C9 | 100uF/25V | CP_Elec_6.3x7.7 | 1 | Low ESR 100 мкФ 25 В | входной электролит (CORE-1 имеет свой 1000 мкФ после J-DC)
PM-PWR-044 | LED3 | GREEN внешний | LED_0603_1608Metric | 1 |  | индикатор «внешний БП подключён»
PM-PWR-045 | R14 | 2.2k | R_0603_1608Metric | 1 | RC0603FR-072K2L | ток LED3 ≈ 4.5 мА от 12 В
PM-PWR-046 | LED4 | BLUE батарея | LED_0603_1608Metric | 1 |  | индикатор «батарея включена» (после SW1)
PM-PWR-047 | R15 | 1k | R_0603_1608Metric | 1 | RC0603FR-071KL | ток LED4 ≈ 1.6 мА
PM-PWR-048 | J5 | 12V OUT → CORE-1 | TerminalBlock_4Ucon_1x02_P3.50mm_Vertical | 1 | KF128-2P / 3.81 мм | выход 12 В на CORE-1 (вход J-DC платы ядра) — все рельсы CORE-1 работают без переделки
PM-PWR-049 | J6 | MON → MCP3208 | PinHeader_1x03_P2.54mm_Vertical | 1 | PH-3P / XH-3P | контроль: 1 = BAT_ADC (CH4), 2 = TEMP_ADC (CH5), 3 = GND
PM-PWR-050 | R16 | 100k | R_0603_1608Metric | 1 | RC0603FR-07100KL | делитель VBAT: 3.0 В → 0.96 В, 4.2 В → 1.34 В (шкала АЦП 0…3.3 В)
PM-PWR-051 | R17 | 47k | R_0603_1608Metric | 1 | RC0603FR-0747KL | нижнее плечо BAT_ADC
PM-PWR-052 | C10 | 100n | C_0805_2012Metric | 1 | CL21B104KBCNNNC | RC-фильтр BAT_ADC (с R16/R17: 1 кГц)
PM-PWR-053 | TP1 | VBAT | TestPoint_Pad_D1.5mm | 1 |  | контроль напряжения банок
PM-PWR-054 | TP2 | 12V_OUT | TestPoint_Pad_D1.5mm | 1 |  | контроль 12.2 В на выходе буста
PM-PWR-055 | TP3 | GND | TestPoint_Pad_D1.5mm | 1 |  | земля для измерений
