martiyanov/bukifon/docs/p1-results-template.csv

run_id | date | platform | board | firmware_commit | workload_version | scenario | metric | value | unit | threshold | pass | fail_reason | checksum | notes
P4-001 |  | P4 | ESP32-P4-Function-EV-Board |  | v1.0 | fm_voice | p50_block |  | us | -
P4-002 |  | P4 | ESP32-P4-Function-EV-Board |  | v1.0 | fm_voice | p95_block |  | us | -
P4-003 |  | P4 | ESP32-P4-Function-EV-Board |  | v1.0 | fm_voice | p99_block |  | us | <=500
P4-004 |  | P4 | ESP32-P4-Function-EV-Board |  | v1.0 | fm_voice | max_block |  | us | <=650
P4-005 |  | P4 | ESP32-P4-Function-EV-Board |  | v1.0 | fm_voice | overruns |  | count | 0
P4-006 |  | P4 | ESP32-P4-Function-EV-Board |  | v1.0 | fm_voice | checksum |  | fnv1a | match
P4-007 |  | P4 | ESP32-P4-Function-EV-Board |  | v1.0 | granular_track | p50_block |  | us | -
P4-008 |  | P4 | ESP32-P4-Function-EV-Board |  | v1.0 | granular_track | p95_block |  | us | -
P4-009 |  | P4 | ESP32-P4-Function-EV-Board |  | v1.0 | granular_track | p99_block |  | us | <=500
P4-010 |  | P4 | ESP32-P4-Function-EV-Board |  | v1.0 | granular_track | max_block |  | us | <=650
P4-011 |  | P4 | ESP32-P4-Function-EV-Board |  | v1.0 | granular_track | overruns |  | count | 0
P4-012 |  | P4 | ESP32-P4-Function-EV-Board |  | v1.0 | granular_track | checksum |  | fnv1a | match
P4-013 |  | P4 | ESP32-P4-Function-EV-Board |  | v1.0 | mix_bus | p50_block |  | us | -
P4-014 |  | P4 | ESP32-P4-Function-EV-Board |  | v1.0 | mix_bus | p95_block |  | us | -
P4-015 |  | P4 | ESP32-P4-Function-EV-Board |  | v1.0 | mix_bus | p99_block |  | us | <=500
P4-016 |  | P4 | ESP32-P4-Function-EV-Board |  | v1.0 | mix_bus | max_block |  | us | <=650
P4-017 |  | P4 | ESP32-P4-Function-EV-Board |  | v1.0 | mix_bus | overruns |  | count | 0
P4-018 |  | P4 | ESP32-P4-Function-EV-Board |  | v1.0 | mix_bus | checksum |  | fnv1a | match
P4-019 |  | P4 | ESP32-P4-Function-EV-Board |  | v1.0 | psram_stream | p50_block |  | us | -
P4-020 |  | P4 | ESP32-P4-Function-EV-Board |  | v1.0 | psram_stream | p95_block |  | us | -
P4-021 |  | P4 | ESP32-P4-Function-EV-Board |  | v1.0 | psram_stream | p99_block |  | us | <=500
P4-022 |  | P4 | ESP32-P4-Function-EV-Board |  | v1.0 | psram_stream | max_block |  | us | <=650
P4-023 |  | P4 | ESP32-P4-Function-EV-Board |  | v1.0 | psram_stream | overruns |  | count | 0
P4-024 |  | P4 | ESP32-P4-Function-EV-Board |  | v1.0 | psram_stream | checksum |  | fnv1a | match
P4-025 |  | P4 | ESP32-P4-Function-EV-Board |  | v1.0 | psram_stream | psram_random_read |  | MB/s | P4>=40; H743>=60
P4-026 |  | P4 | ESP32-P4-Function-EV-Board |  | v1.0 | psram_stream | psram_ns_per_line |  | ns | <=250 (P4)
P4-027 |  | P4 | ESP32-P4-Function-EV-Board |  | v1.0 | ui_frame | fps_full |  | fps | >=30
P4-028 |  | P4 | ESP32-P4-Function-EV-Board |  | v1.0 | ui_frame | frame_p99_full |  | ms | <=33.3
P4-029 |  | P4 | ESP32-P4-Function-EV-Board |  | v1.0 | ui_frame | flush_MBps |  | MB/s | >=22.5
P4-030 |  | P4 | ESP32-P4-Function-EV-Board |  | v1.0 | ui_frame_partial | fps_partial |  | fps | >=60
P4-031 |  | P4 | ESP32-P4-Function-EV-Board |  | v1.0 | ui_frame_partial | frame_p99_partial |  | ms | <=16.7
P4-032 |  | P4 | ESP32-P4-Function-EV-Board |  | v1.0 | usb_descriptor | descriptor_build |  | ms | <=2
P4-033 |  | P4 | ESP32-P4-Function-EV-Board |  | v1.0 | usb_descriptor | enum_time |  | s | stable
P4-034 |  | P4 | ESP32-P4-Function-EV-Board |  | v1.0 | usb_descriptor | usb_drops |  | count | 0
P4-035 |  | P4 | ESP32-P4-Function-EV-Board |  | v1.0 | usb_descriptor | uac2_8x8_MBps |  | MB/s | 2.304
P4-036 |  | P4 | ESP32-P4-Function-EV-Board |  | v1.0 | full_profile | soak_xruns |  | count | 0
P4-037 |  | P4 | ESP32-P4-Function-EV-Board |  | v1.0 | full_profile | soak_overruns |  | count | 0
P4-038 |  | P4 | ESP32-P4-Function-EV-Board |  | v1.0 | full_profile | psram_errors |  | count | 0
P4-039 |  | P4 | ESP32-P4-Function-EV-Board |  | v1.0 | full_profile | temp_C |  | C | <=70
P4-040 |  | P4 | ESP32-P4-Function-EV-Board |  | v1.0 | full_profile | fps_full_soak |  | fps | >=30
P4-041 |  | P4 | ESP32-P4-Function-EV-Board |  | v1.0 | full_profile | fps_partial_soak |  | fps | >=60
H743-042 |  | H743 | NUCLEO-H743ZI2 |  | v1.0 | fm_voice | p50_block |  | us | -
H743-043 |  | H743 | NUCLEO-H743ZI2 |  | v1.0 | fm_voice | p95_block |  | us | -
H743-044 |  | H743 | NUCLEO-H743ZI2 |  | v1.0 | fm_voice | p99_block |  | us | <=500
H743-045 |  | H743 | NUCLEO-H743ZI2 |  | v1.0 | fm_voice | max_block |  | us | <=650
H743-046 |  | H743 | NUCLEO-H743ZI2 |  | v1.0 | fm_voice | overruns |  | count | 0
H743-047 |  | H743 | NUCLEO-H743ZI2 |  | v1.0 | fm_voice | checksum |  | fnv1a | match
H743-048 |  | H743 | NUCLEO-H743ZI2 |  | v1.0 | granular_track | p50_block |  | us | -
H743-049 |  | H743 | NUCLEO-H743ZI2 |  | v1.0 | granular_track | p95_block |  | us | -
H743-050 |  | H743 | NUCLEO-H743ZI2 |  | v1.0 | granular_track | p99_block |  | us | <=500
H743-051 |  | H743 | NUCLEO-H743ZI2 |  | v1.0 | granular_track | max_block |  | us | <=650
H743-052 |  | H743 | NUCLEO-H743ZI2 |  | v1.0 | granular_track | overruns |  | count | 0
H743-053 |  | H743 | NUCLEO-H743ZI2 |  | v1.0 | granular_track | checksum |  | fnv1a | match
H743-054 |  | H743 | NUCLEO-H743ZI2 |  | v1.0 | mix_bus | p50_block |  | us | -
H743-055 |  | H743 | NUCLEO-H743ZI2 |  | v1.0 | mix_bus | p95_block |  | us | -
H743-056 |  | H743 | NUCLEO-H743ZI2 |  | v1.0 | mix_bus | p99_block |  | us | <=500
H743-057 |  | H743 | NUCLEO-H743ZI2 |  | v1.0 | mix_bus | max_block |  | us | <=650
H743-058 |  | H743 | NUCLEO-H743ZI2 |  | v1.0 | mix_bus | overruns |  | count | 0
H743-059 |  | H743 | NUCLEO-H743ZI2 |  | v1.0 | mix_bus | checksum |  | fnv1a | match
H743-060 |  | H743 | NUCLEO-H743ZI2 |  | v1.0 | psram_stream | p50_block |  | us | -
H743-061 |  | H743 | NUCLEO-H743ZI2 |  | v1.0 | psram_stream | p95_block |  | us | -
H743-062 |  | H743 | NUCLEO-H743ZI2 |  | v1.0 | psram_stream | p99_block |  | us | <=500
H743-063 |  | H743 | NUCLEO-H743ZI2 |  | v1.0 | psram_stream | max_block |  | us | <=650
H743-064 |  | H743 | NUCLEO-H743ZI2 |  | v1.0 | psram_stream | overruns |  | count | 0
H743-065 |  | H743 | NUCLEO-H743ZI2 |  | v1.0 | psram_stream | checksum |  | fnv1a | match
H743-066 |  | H743 | NUCLEO-H743ZI2 |  | v1.0 | psram_stream | psram_random_read |  | MB/s | P4>=40; H743>=60
H743-067 |  | H743 | NUCLEO-H743ZI2 |  | v1.0 | psram_stream | psram_ns_per_line |  | ns | <=250 (P4)
H743-068 |  | H743 | NUCLEO-H743ZI2 |  | v1.0 | ui_frame | fps_full |  | fps | >=30
H743-069 |  | H743 | NUCLEO-H743ZI2 |  | v1.0 | ui_frame | frame_p99_full |  | ms | <=33.3
H743-070 |  | H743 | NUCLEO-H743ZI2 |  | v1.0 | ui_frame | flush_MBps |  | MB/s | >=22.5
H743-071 |  | H743 | NUCLEO-H743ZI2 |  | v1.0 | ui_frame_partial | fps_partial |  | fps | >=60
H743-072 |  | H743 | NUCLEO-H743ZI2 |  | v1.0 | ui_frame_partial | frame_p99_partial |  | ms | <=16.7
H743-073 |  | H743 | NUCLEO-H743ZI2 |  | v1.0 | usb_descriptor | descriptor_build |  | ms | <=2
H743-074 |  | H743 | NUCLEO-H743ZI2 |  | v1.0 | usb_descriptor | enum_time |  | s | stable
H743-075 |  | H743 | NUCLEO-H743ZI2 |  | v1.0 | usb_descriptor | usb_drops |  | count | 0
H743-076 |  | H743 | NUCLEO-H743ZI2 |  | v1.0 | usb_descriptor | uac2_8x8_MBps |  | MB/s | 2.304
H743-077 |  | H743 | NUCLEO-H743ZI2 |  | v1.0 | full_profile | soak_xruns |  | count | 0
H743-078 |  | H743 | NUCLEO-H743ZI2 |  | v1.0 | full_profile | soak_overruns |  | count | 0
H743-079 |  | H743 | NUCLEO-H743ZI2 |  | v1.0 | full_profile | psram_errors |  | count | 0
H743-080 |  | H743 | NUCLEO-H743ZI2 |  | v1.0 | full_profile | temp_C |  | C | <=70
H743-081 |  | H743 | NUCLEO-H743ZI2 |  | v1.0 | full_profile | fps_full_soak |  | fps | >=30
H743-082 |  | H743 | NUCLEO-H743ZI2 |  | v1.0 | full_profile | fps_partial_soak |  | fps | >=60
