martiyanov/bukifon/docs/usability-results-template.csv

participant | height_cm | experience | scenario | time_s | errors | comfort_1_5 | comment
P1 | 175 | experienced | hands_on_panel
P1 | 175 | experienced | far_encoder_reach
P1 | 175 | experienced | screen_angle_35
P1 | 175 | experienced | glare_two_lamps
P1 | 175 | experienced | wrist_edge_5min
P1 | 175 | experienced | faders_thumbs
P1 | 175 | experienced | three_postures
