martiyanov/bukifon/renders/mech/parts_all.png

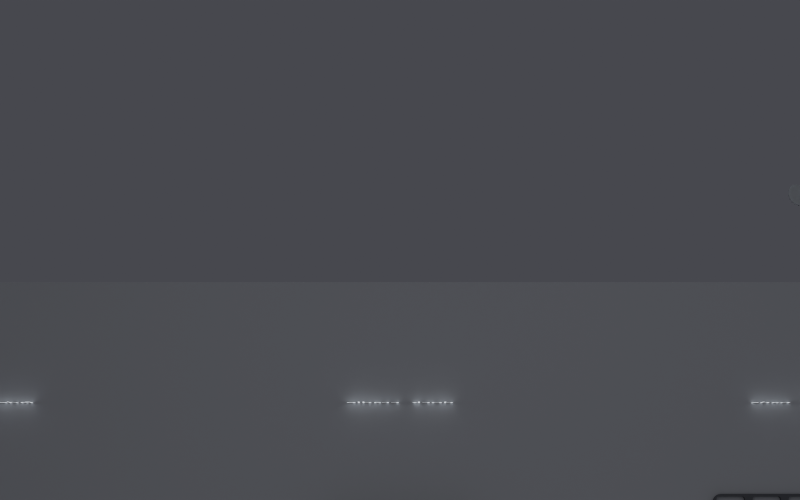
renders/mech/parts_all.png
