martiyanov/bukifon/mechanical/stl_v05_A_mic/bukifon_v05_A_mic_assembly.3mf

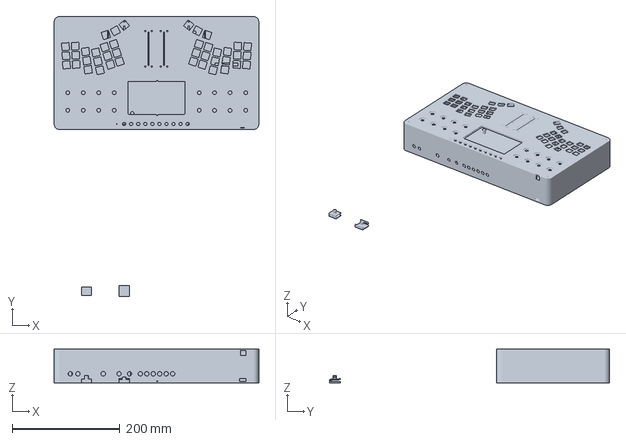
[picture p109: CAD file, 2026-11-06]
mechanical/stl_v05_A_mic/bukifon_v05_A_mic_assembly.3mf
380.0 x 520.0 x 63.0 mm
