martiyanov/bukifon/mechanical/stl_v05_B_light/bukifon_v05_B_light_assembly.3mf

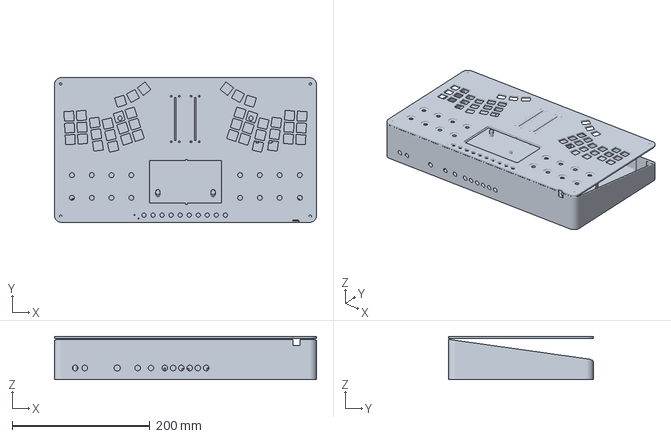
[picture p111: CAD file, 2026-11-06]
mechanical/stl_v05_B_light/bukifon_v05_B_light_assembly.3mf
380.0 x 210.0 x 63.0 mm
