martiyanov/bukifon/mechanical/stl_v05_C_mic/bukifon_v05_C_mic_assembly.3mf

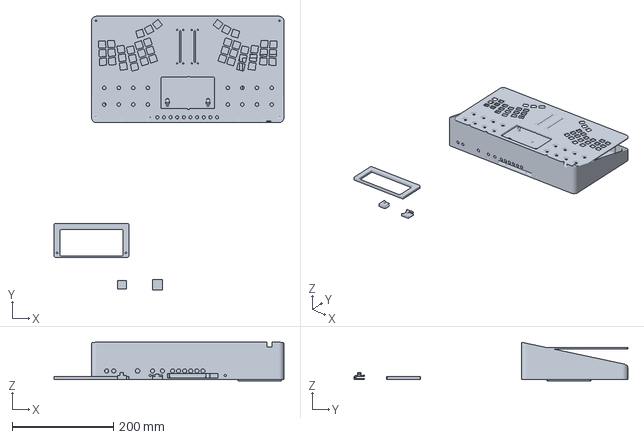
[picture p112: CAD file, 2026-11-06]
mechanical/stl_v05_C_mic/bukifon_v05_C_mic_assembly.3mf
454.0 x 540.0 x 76.2 mm
