martiyanov/bukifon/mechanical/board-fit/assembly.dxf

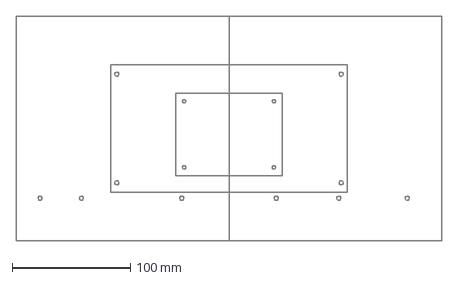
[picture p114: CAD file, 2026-11-06]
mechanical/board-fit/assembly.dxf
360.0 x 190.0 mm
