martiyanov/bukifon/mechanical/stl_v05_C/bukifon_v05_C_assembly.3mf

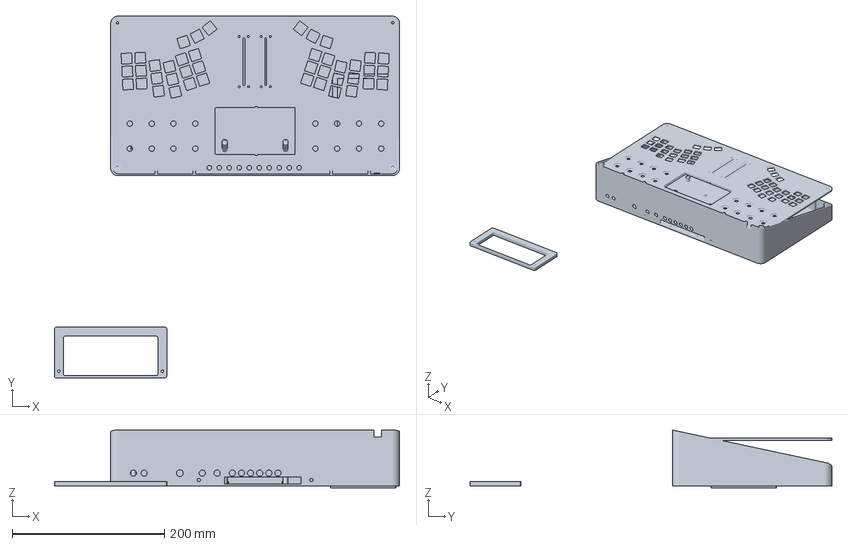
[picture p116: CAD file, 2026-11-06]
mechanical/stl_v05_C/bukifon_v05_C_assembly.3mf
454.0 x 476.0 x 76.2 mm
