martiyanov/bukifon/mechanical/step_v18/bukifon_v1_8_assembly.step

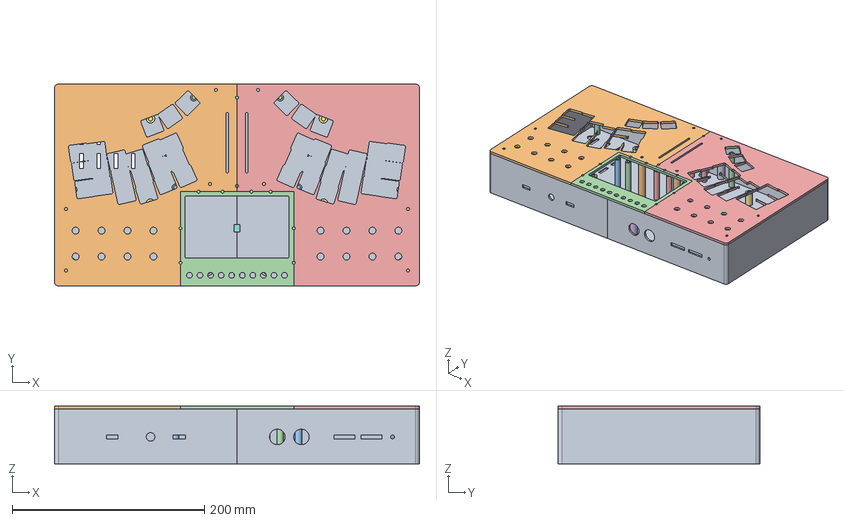
[picture p117: CAD file, 2026-11-05]
mechanical/step_v18/bukifon_v1_8_assembly.step
380.0 x 210.0 x 60.0 mm
