martiyanov/bukifon/mechanical/board-fit/panel2left.dxf

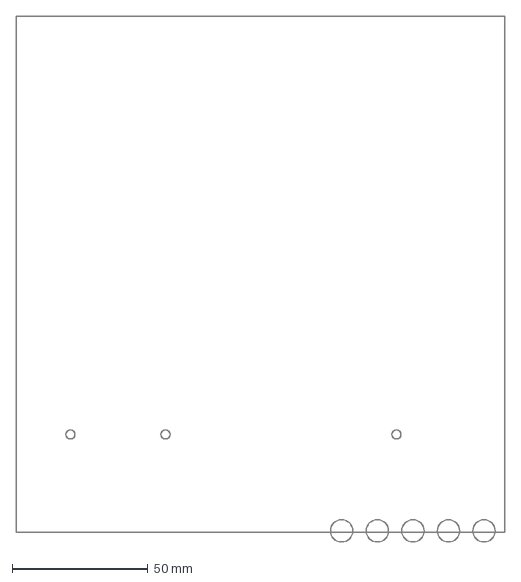
[picture p118: CAD file, 2026-11-06]
mechanical/board-fit/panel2left.dxf
180.0 x 193.6 mm
