martiyanov/bukifon/mechanical/step_v18/bukifon_v1_8_knob.step

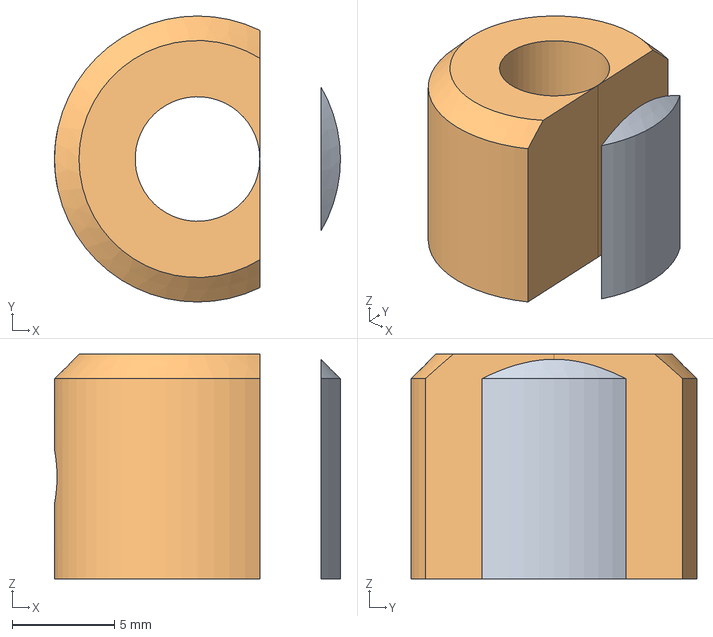
[picture p119: CAD file, 2026-11-05]
mechanical/step_v18/bukifon_v1_8_knob.step
14.0 x 14.0 x 11.0 mm
