martiyanov/bukifon/mechanical/stl_v05_A/body_R.3mf

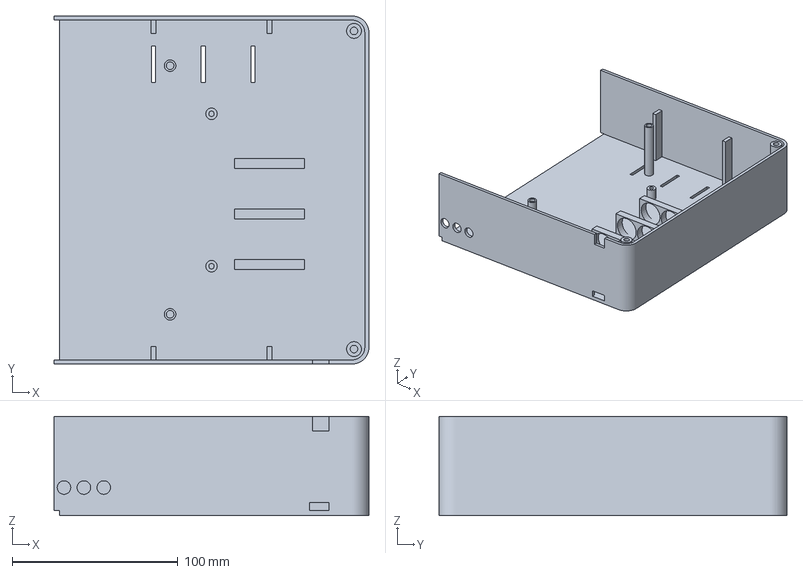
[picture p120: CAD file, 2026-11-06]
mechanical/stl_v05_A/body_R.3mf
190.0 x 210.0 x 60.0 mm
