martiyanov/bukifon/mechanical/stl_v05_B_mic/mic_clip_rear.step

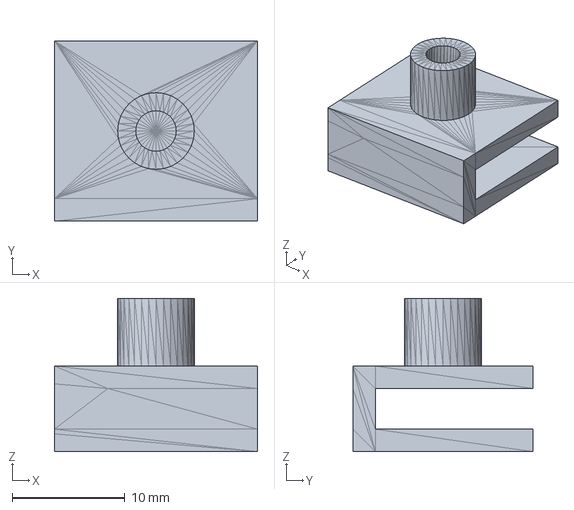
[picture p121: CAD file, 2026-11-06]
mechanical/stl_v05_B_mic/mic_clip_rear.step
18.0 x 16.0 x 13.6 mm
