martiyanov/bukifon/mechanical/stl_v05_C/body_L.3mf

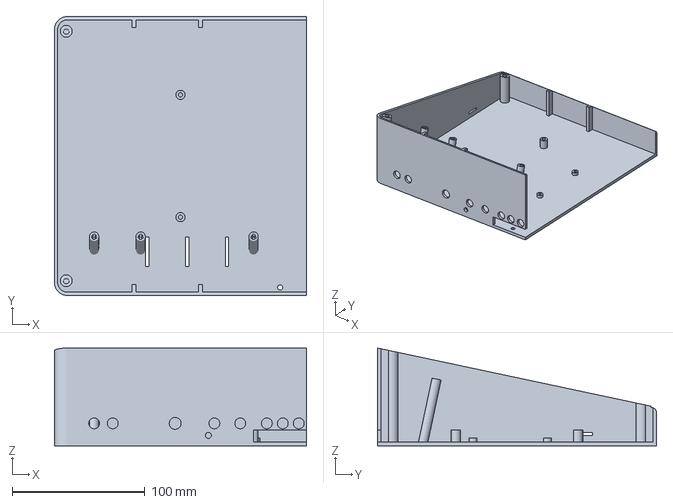
[picture p122: CAD file, 2026-11-06]
mechanical/stl_v05_C/body_L.3mf
190.0 x 210.0 x 73.7 mm
