martiyanov/bukifon/mechanical/test_fit/test_cross.stl

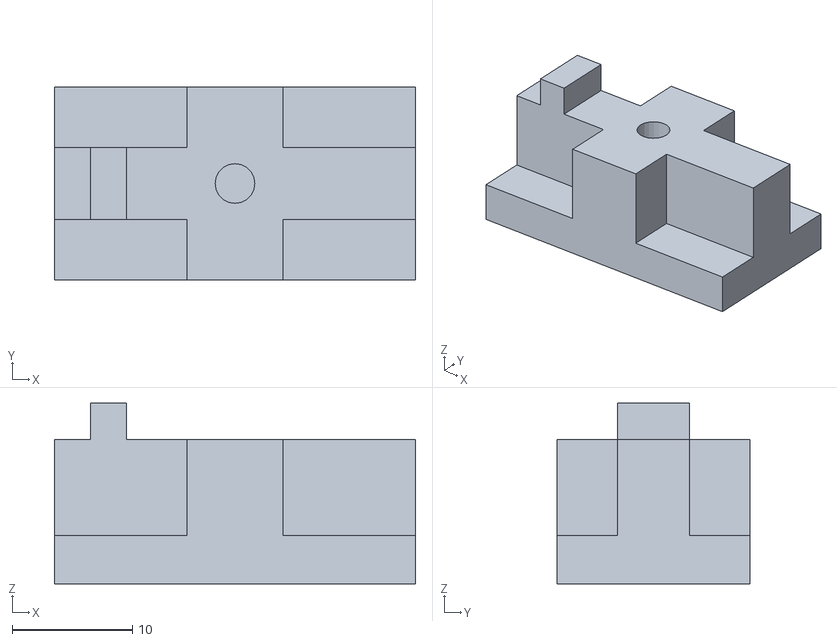
[picture p123: CAD file, 2026-11-05]
mechanical/test_fit/test_cross.stl
30.0 x 16.0 x 15.0
