martiyanov/bukifon/refs/handoff_v03/bukifon_v03_panel.dxf

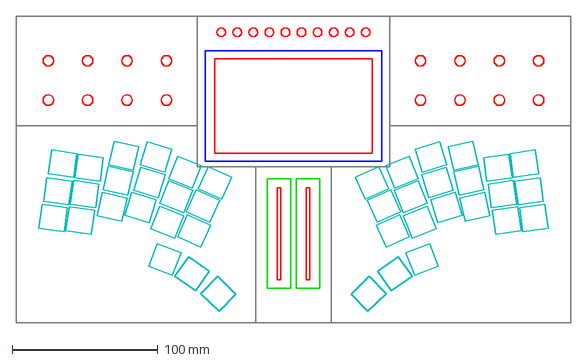
[picture p124: CAD file, 2026-11-05]
refs/handoff_v03/bukifon_v03_panel.dxf
380.0 x 210.0 mm
