martiyanov/bukifon/mechanical/board-fit/panel2right.dxf

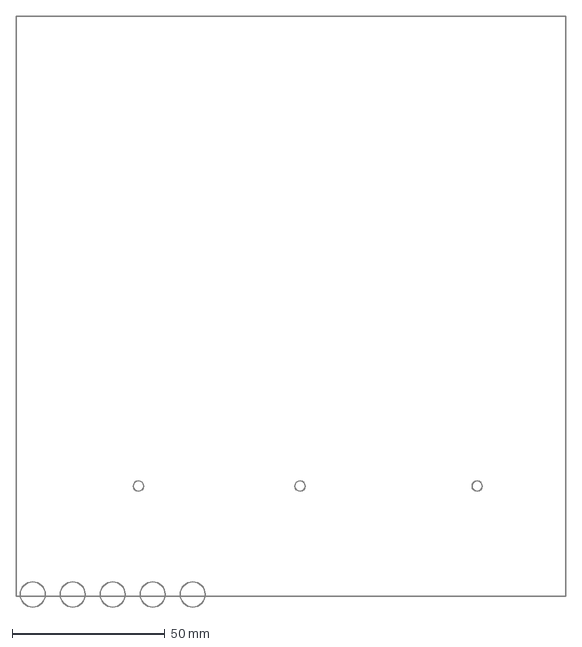
[picture p125: CAD file, 2026-11-06]
mechanical/board-fit/panel2right.dxf
180.0 x 193.6 mm
