martiyanov/bukifon/mechanical/step_v18/bukifon_v1_8_shell_L.step

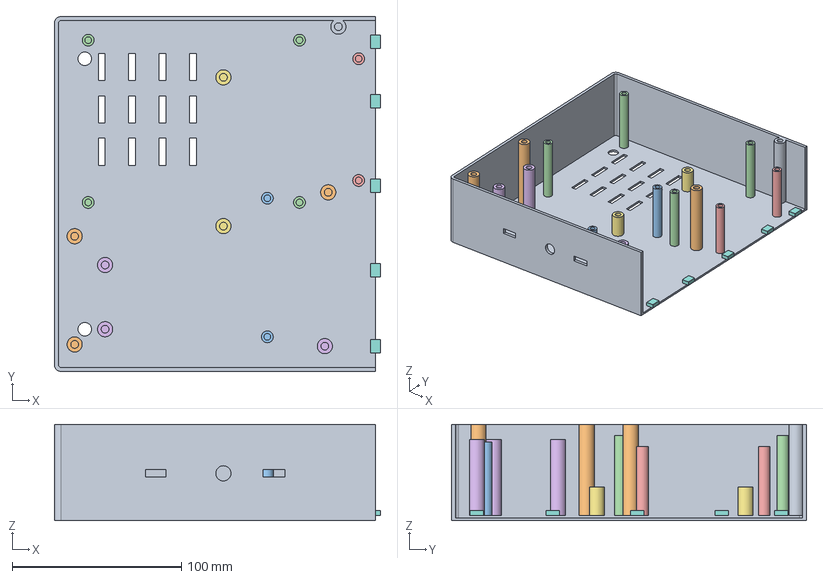
[picture p126: CAD file, 2026-11-05]
mechanical/step_v18/bukifon_v1_8_shell_L.step
193.0 x 210.0 x 57.0 mm
