martiyanov/bukifon/mechanical/stl_v05_A_mic/mic_guide.step

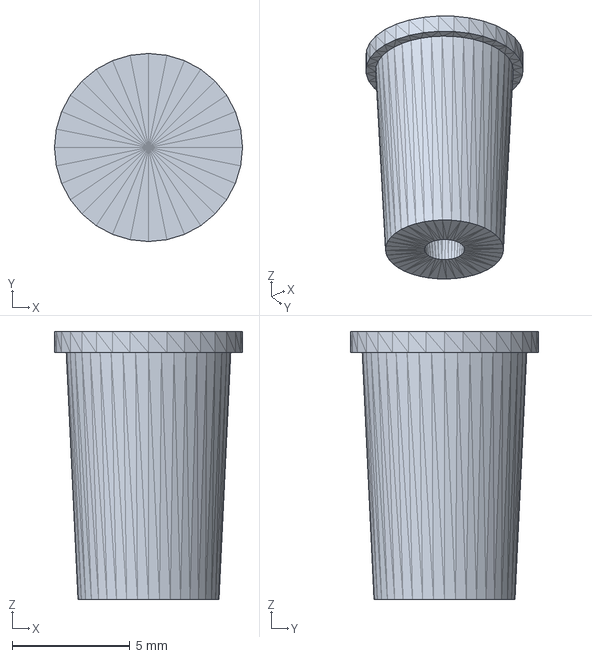
[picture p127: CAD file, 2026-11-06]
mechanical/stl_v05_A_mic/mic_guide.step
8.00 x 8.00 x 11.4 mm
