martiyanov/bukifon/mechanical/stl_v05_B/body_R.3mf

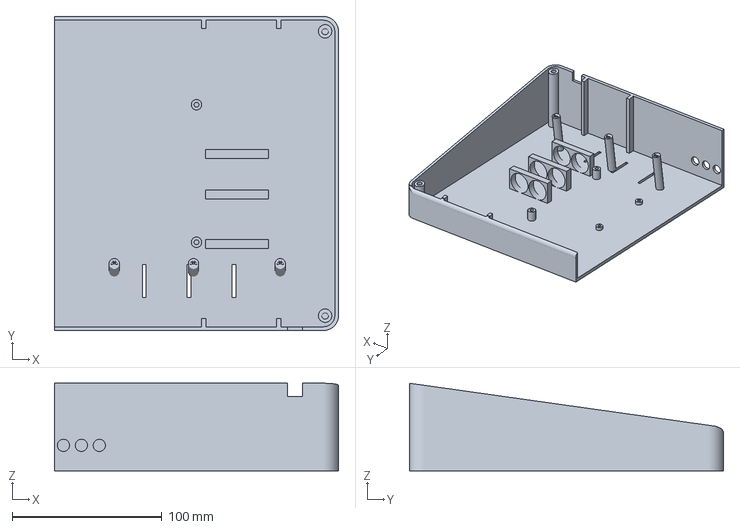
[picture p128: CAD file, 2026-11-06]
mechanical/stl_v05_B/body_R.3mf
190.0 x 210.0 x 58.5 mm
