martiyanov/bukifon/mechanical/stl_v05_C_mic/mic_holder_top.step

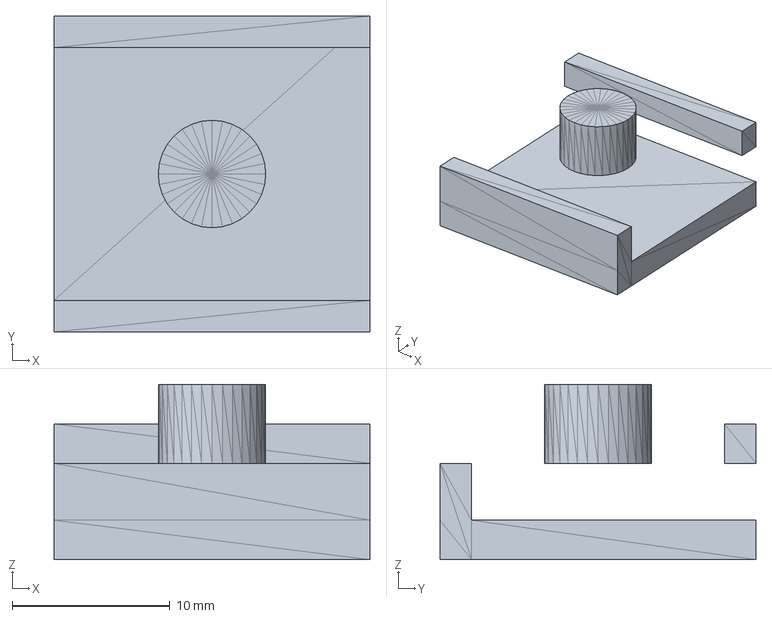
[picture p129: CAD file, 2026-11-06]
mechanical/stl_v05_C_mic/mic_holder_top.step
20.0 x 20.0 x 11.1 mm
