martiyanov/bukifon/mechanical/board-fit/pwr2.dxf

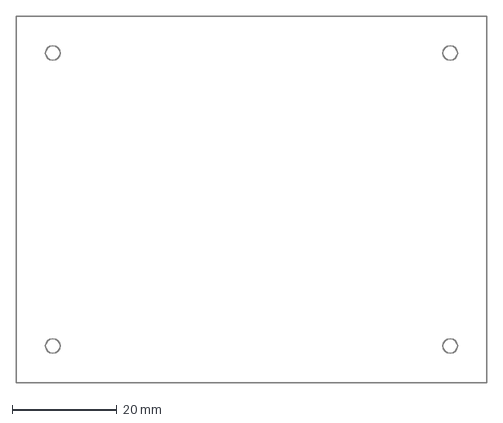
[picture p130: CAD file, 2026-11-06]
mechanical/board-fit/pwr2.dxf
90.0 x 70.0 mm
