martiyanov/bukifon/mechanical/step_v18/bukifon_v1_8_panel_L.step

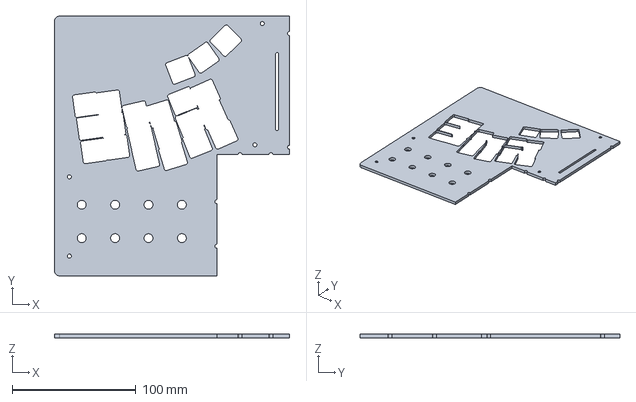
[picture p131: CAD file, 2026-11-05]
mechanical/step_v18/bukifon_v1_8_panel_L.step
190.0 x 210.0 x 3.00 mm
