martiyanov/bukifon/mechanical/stl_v05_C/stand.3mf

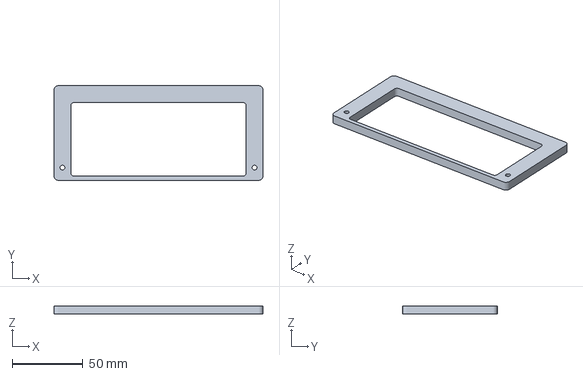
[picture p132: CAD file, 2026-11-06]
mechanical/stl_v05_C/stand.3mf
148.0 x 67.0 x 6.00 mm
