martiyanov/bukifon/mechanical/board-fit/core2.dxf

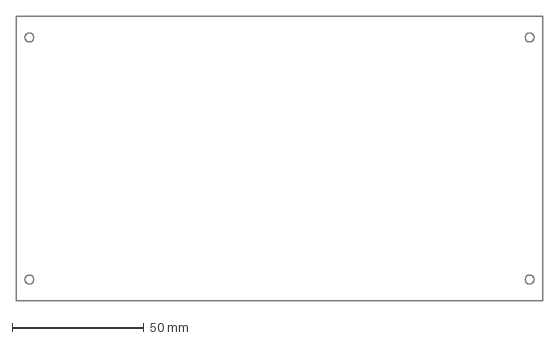
[picture p133: CAD file, 2026-11-06]
mechanical/board-fit/core2.dxf
200.0 x 108.0 mm
