martiyanov/bukifon/mechanical/step_v18/bukifon_v1_8_screen_carrier.step

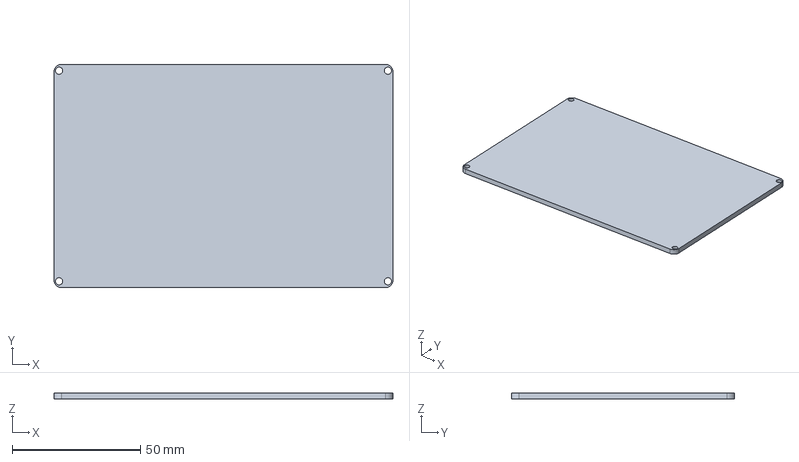
[picture p134: CAD file, 2026-11-05]
mechanical/step_v18/bukifon_v1_8_screen_carrier.step
132.0 x 87.0 x 2.50 mm
