martiyanov/bukifon/mechanical/stl_v05_C/battery_lid.3mf

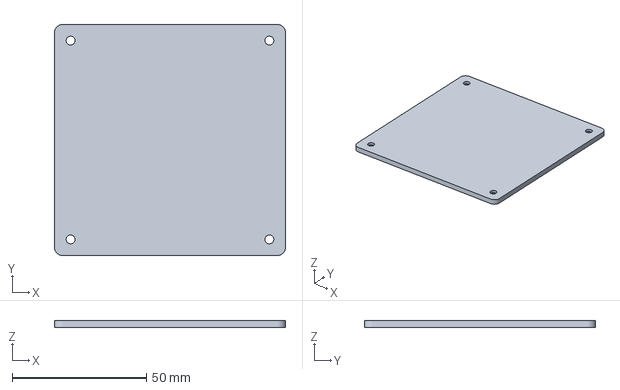
[picture p135: CAD file, 2026-11-06]
mechanical/stl_v05_C/battery_lid.3mf
86.0 x 86.0 x 2.50 mm
