martiyanov/bukifon/mechanical/step_v18/bukifon_v1_8_panel_C.step

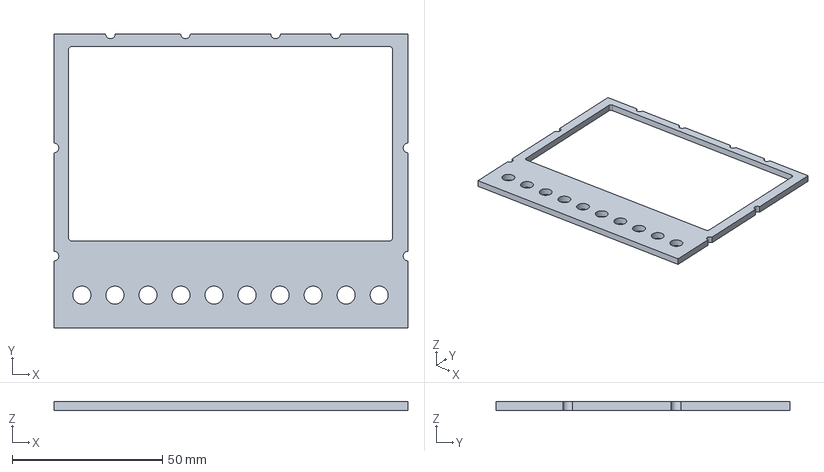
[picture p136: CAD file, 2026-11-05]
mechanical/step_v18/bukifon_v1_8_panel_C.step
117.9 x 98.0 x 3.00 mm
