martiyanov/bukifon/mechanical/stl_v05_B_light/panel_L.stl

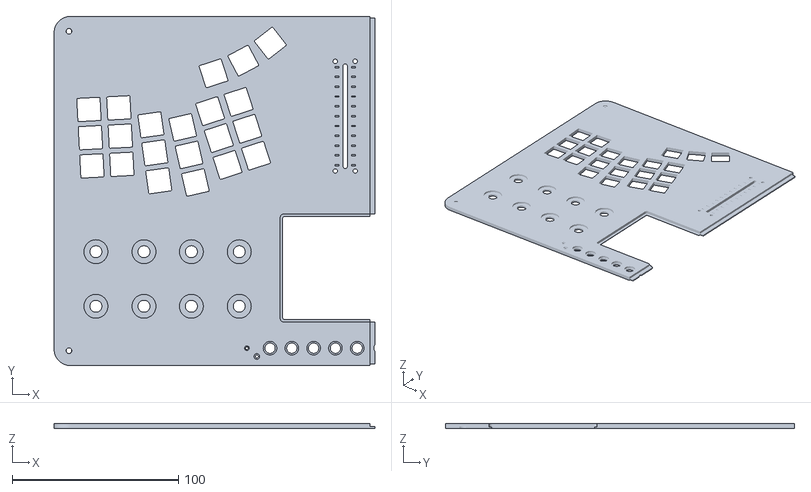
[picture p137: CAD file, 2026-11-06]
mechanical/stl_v05_B_light/panel_L.stl
193.0 x 210.0 x 3.00
