martiyanov/bukifon/mechanical/step_v18/bukifon_v1_8_fader_cap.step

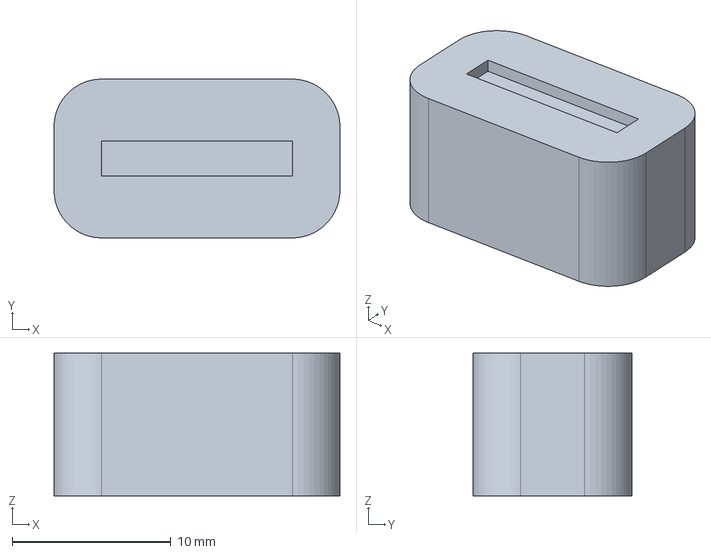
[picture p138: CAD file, 2026-11-05]
mechanical/step_v18/bukifon_v1_8_fader_cap.step
18.0 x 10.0 x 9.00 mm
