martiyanov/bukifon/mechanical/stl_v05_A_mic/panel_R.3mf

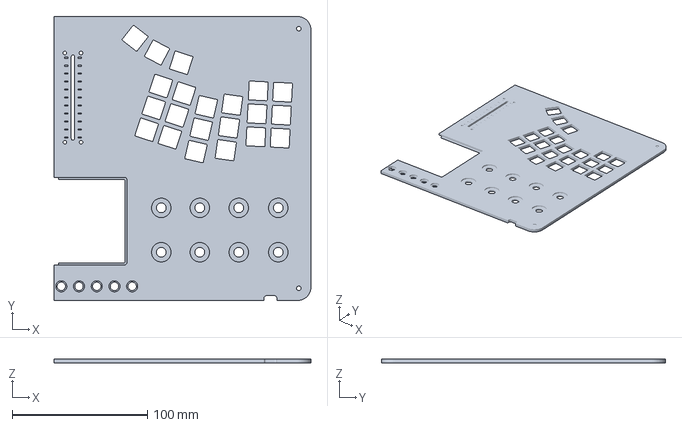
[picture p139: CAD file, 2026-11-05]
mechanical/stl_v05_A_mic/panel_R.3mf
190.0 x 210.0 x 3.00 mm
