martiyanov/bukifon/mechanical/stl_v05_A_mic/foot.3mf

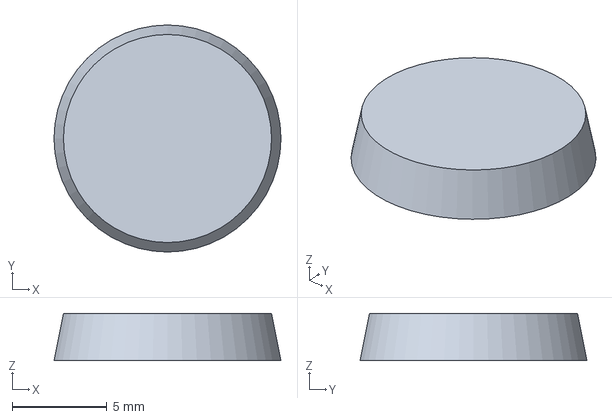
[picture p140: CAD file, 2026-11-05]
mechanical/stl_v05_A_mic/foot.3mf
12.0 x 12.0 x 2.50 mm
