martiyanov/bukifon/mechanical/stl_v05_A_mic/keycap_v17.3mf

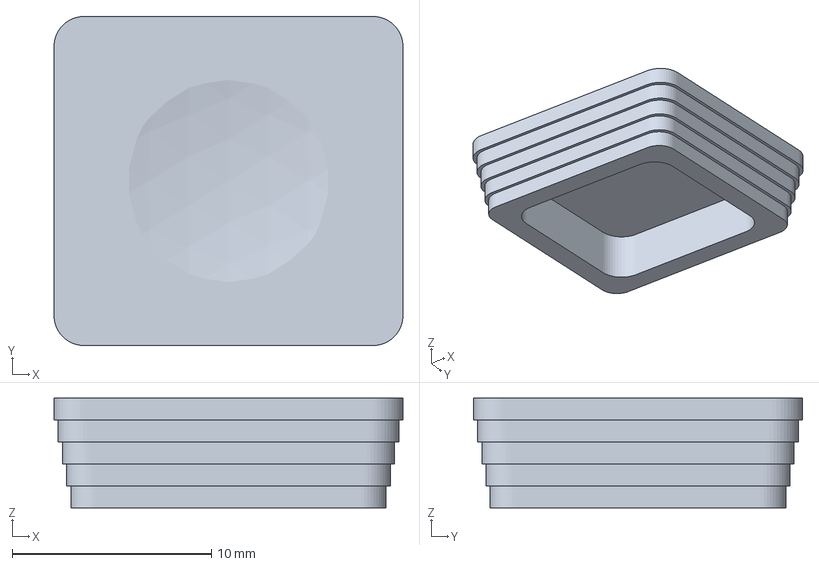
[picture p141: CAD file, 2026-11-05]
mechanical/stl_v05_A_mic/keycap_v17.3mf
17.5 x 16.5 x 5.51 mm
