martiyanov/bukifon/(list of files, cad)

Other CAD files:
mechanical/stl_v05_B_light/body_L.3mf
mechanical/stl_v05_C/body_R.3mf
mechanical/stl_v05_A/body_L.3mf
mechanical/stl_v05_B/body_L.3mf
mechanical/stl_v05_B_light/body_R.3mf
mechanical/stl_v05_B_mic/body_L.3mf
mechanical/stl_v05_C_mic/body_R.3mf
mechanical/step_v18/bukifon_v1_8_panel_R.step
mechanical/stl_v05_A_mic/body_L.3mf
mechanical/step_v18/bukifon_v1_8_shell_R.step
mechanical/stl_v05_A_mic/panel_L.3mf
mechanical/step_v17/bukifon_v1_7_assembly.step
mechanical/step_v17/bukifon_v1_7_fader_cap.step
mechanical/step_v17/bukifon_v1_7_knob.step
mechanical/step_v17/bukifon_v1_7_panel_C.step
mechanical/step_v17/bukifon_v1_7_panel_L.step
mechanical/step_v17/bukifon_v1_7_panel_R.step
mechanical/step_v17/bukifon_v1_7_screen_carrier.step
mechanical/step_v17/bukifon_v1_7_shell_L.step
mechanical/step_v17/bukifon_v1_7_shell_R.step
mechanical/stl/bay_hatch.stl
mechanical/stl/bottom_L.stl
mechanical/stl/bottom_R.stl
mechanical/stl/deck_plate_L_keys.stl
mechanical/stl/deck_plate_L_pads.stl
mechanical/stl/deck_plate_R_keys.stl
mechanical/stl/deck_plate_R_pads.stl
mechanical/stl/dock_cradle.stl
mechanical/stl/fader_cap.stl
mechanical/stl/grip_pad.stl
mechanical/stl/keycap.stl
mechanical/stl/knob.stl
mechanical/stl/light_guide.stl
mechanical/stl/pad_cap.stl
mechanical/stl/panel_upper_L.stl
mechanical/stl/panel_upper_R.stl
mechanical/stl/rear_plate_L.stl
mechanical/stl/rear_plate_R.stl
mechanical/stl/seam_key.stl
mechanical/stl/shoulder_cap.stl
mechanical/stl_v04/bukifon_v04_assembly.3mf
mechanical/stl_v05_A/body_L.stl
mechanical/stl_v05_A/body_R.stl
mechanical/stl_v05_A_mic/body_L.stl
mechanical/stl_v05_A_mic/body_R.stl
mechanical/stl_v05_A_mic/foot.stl
mechanical/stl_v05_A_mic/keycap_v17.stl
mechanical/stl_v05_A_mic/mic_clip_rear.3mf
mechanical/stl_v05_A_mic/mic_clip_rear.stl
mechanical/stl_v05_A_mic/mic_guide.3mf
mechanical/stl_v05_A_mic/mic_guide.stl
mechanical/stl_v05_A_mic/mic_holder_top.3mf
mechanical/stl_v05_A_mic/mic_holder_top.stl
mechanical/stl_v05_A_mic/panel_L.stl
mechanical/stl_v05_A_mic/panel_R.stl
mechanical/stl_v05_B/body_L.stl
mechanical/stl_v05_B/body_R.stl
mechanical/stl_v05_B_light/body_L.stl
mechanical/stl_v05_B_light/body_R.stl
mechanical/stl_v05_B_light/mic_clip_rear.3mf
mechanical/stl_v05_B_light/mic_guide.3mf
mechanical/stl_v05_B_light/mic_guide.stl
mechanical/stl_v05_B_light/mic_holder_top.3mf
mechanical/stl_v05_B_mic/body_L.stl
mechanical/stl_v05_B_mic/body_R.stl
mechanical/stl_v05_B_mic/mic_clip_rear.3mf
mechanical/stl_v05_B_mic/mic_guide.3mf
mechanical/stl_v05_B_mic/mic_guide.stl
mechanical/stl_v05_B_mic/mic_holder_top.3mf
mechanical/stl_v05_C/body_L.stl
mechanical/stl_v05_C/body_R.stl
mechanical/stl_v05_C_mic/battery_lid.stl
mechanical/stl_v05_C_mic/body_L.stl
mechanical/stl_v05_C_mic/body_R.stl
mechanical/stl_v05_C_mic/mic_clip_rear.3mf
mechanical/stl_v05_C_mic/mic_guide.3mf
mechanical/stl_v05_C_mic/mic_guide.stl
mechanical/stl_v05_C_mic/mic_holder_top.3mf
mechanical/stl_v05_C_mic/stand.stl
mechanical/stl_v17/bukifon_v17_assembly.3mf
mechanical/stl_v17/bukifon_v1_7_panel_C.stl
mechanical/stl_v17/bukifon_v1_7_panel_L.stl
mechanical/stl_v17/bukifon_v1_7_panel_R.stl
mechanical/stl_v17/bukifon_v1_7_screen_carrier.stl
mechanical/stl_v17/bukifon_v1_7_shell_L.stl
mechanical/stl_v17/bukifon_v1_7_shell_R.stl
mechanical/stl_v17/panel_L.3mf
mechanical/stl_v17/panel_L.stl
mechanical/stl_v17/panel_R.3mf
mechanical/stl_v17/panel_R.stl
mechanical/stl_v18/bukifon_v1_8_fader_cap.stl
mechanical/stl_v18/bukifon_v1_8_knob.stl
mechanical/stl_v18/bukifon_v1_8_panel_C.stl
mechanical/stl_v18/bukifon_v1_8_panel_L.stl
mechanical/stl_v18/bukifon_v1_8_panel_R.stl
mechanical/stl_v18/bukifon_v1_8_screen_carrier.stl
mechanical/stl_v18/bukifon_v1_8_shell_L.stl
mechanical/stl_v18/bukifon_v1_8_shell_R.stl
