martiyanov/bukifon/mechanical/prints.md

# Карта печати — Букифон v1.0

Комплект корпуса: **20 STL-файлов** (2 нижние половины, 2 верхние панели,
4 пластины deck в двух вариантах, ручки, колпачки, крышки, скоба дока,
накладки, шпонки) + калибровочный крест.

- **Оборудование:** Ender-3 / аналог, сопло 0.4, слой 0.2, стол 220 × 220.
  Максимальный габарит детали — 210 × 70 мм (`bay_hatch`), всё влезает.
- **Все детали печатаются БЕЗ ПОДДЕРЖЕК.** Ориентация в таблице подобрана так,
  чтобы вылеты были ≤ 45°, а мосты — короче 20 мм.
- **Периметры:** 3 × 0.4 = 1.2 мм; заполнение 25 % (кубическое); верх/низ 4 слоя.
- **Температуры (spec/30 §7):** PETG 240/80 °C; PLA 210/60 °C; TPU 225/40 °C,
  TPU — скорость 20–25 мм/с, ретракт 3 мм.

Оценка массы — по объёму STL × 0.36 (периметры + 25 % заполнения), плотности
PETG 1.27, PLA 1.24, TPU 1.21 г/см³. Время — по скорости съёма материала
≈ 12 см³/ч эффективного объёма (Ender-3, 0.2 мм/0.4).

## 1. Основные детали

| № | Деталь / файл | Кол-во | Материал | Ориентация на столе | Поддержки | Габарит, мм | Объём STL, см³ | Масса, г | Время, ч |
|---|---|---|---|---|---|---|---|---|---|
| 1 | `bottom_L.stl` | 1 | PETG | как в модели: дно (рукоятка/брюхо) на столе, **полость открыта вверх** | нет | 157.5 × 145 × 43 | 139.4 | 64 | 4.2 |
| 2 | `bottom_R.stl` | 1 | PETG | зеркально, также полостью вверх | нет | 157.5 × 145 × 43 | 139.9 | 64 | 4.2 |
| 3 | `panel_upper_L.stl` | 1 | PLA (или PETG) | **лицевой стороной вверх**, глухие отв. M2.5 — снизу | нет | 157.5 × 66 × 3 | 25.5 | 11 | 0.8 |
| 4 | `panel_upper_R.stl` | 1 | PLA (или PETG) | то же | нет | 157.5 × 66 × 3 | 25.5 | 11 | 0.8 |
| 5 | `deck_plate_L_pads.stl` | 1 | PLA | лицевой стороной вверх (зенковки сверху) | нет | 148 × 78 × 2.5 | 18.6 | 8 | 0.6 |
| 6 | `deck_plate_R_pads.stl` | 1 | PLA | то же | нет | 148 × 78 × 2.5 | 18.6 | 8 | 0.6 |
| 5к | `deck_plate_L_keys.stl` | (1) | PLA | вариант KEYS, лицевой вверх | нет | 148 × 78 × 2.5 | 17.6 | 8 | 0.5 |
| 6к | `deck_plate_R_keys.stl` | (1) | PLA | вариант KEYS | нет | 148 × 78 × 2.5 | 17.6 | 8 | 0.5 |
| 7 | `knob.stl` | 8 | PETG прозрачный | **указателем/накаткой вверх**, дно на столе | нет | Ø18 × 15 | 2.29 | 1.1/шт (8.4) | 0.6 |
| 8 | `pad_cap.stl` | 18 | TPU (или PLA) | **вогнутой площадкой вниз**, юбкой вверх | нет | 20 × 20 × 9 | 2.09 | 0.9/шт (16.4) | 1.1 |
| 9 | `keycap.stl` | 42 | PLA полупрозрачный | **площадкой вниз**, юбкой вверх | нет | 17.5 × 16.5 × 8 | 1.48 | 1.5/шт (27.7) | 1.9 |
| 10 | `fader_cap.stl` | 2 | PETG | **площадкой вниз**, штоком вверх | нет | 16 × 9 × 8 | 0.40 | 0.2/шт (0.4) | 0.1 |
| 11 | `shoulder_cap.stl` | 4 | PETG | **площадкой вниз**, полостью вверх | нет | Ø10 × 4 | 0.10 | 0.05/шт (0.2) | 0.1 |
| 12 | `light_guide.stl` | 9 | PETG прозрачный | куполом вверх, плоской пятой на столе | нет | Ø4 × 6 | 0.07 | 0.03/шт (0.3) | 0.1 |
| 13 | `dock_cradle.stl` | 1 | PETG | **полкой на стол**, стенки/скоба вверх (L-образная) | нет | 110 × 45 × 23 | 28.9 | 13 | 0.9 |
| 14 | `bay_hatch.stl` | 1 | PETG | плашмя, зенковки вверх | нет | 210 × 70 × 2 | 28.4 | 13 | 0.9 |
| 15 | `rear_plate_L.stl` | 1 | PETG | плашмя, **наружной стороной вниз** (зенковки на столе) | нет | 150 × 44 × 2 | 12.0 | 5.5 | 0.4 |
| 15 | `rear_plate_R.stl` | 1 | PETG | то же | нет | 150 × 44 × 2 | 13.0 | 6 | 0.5 |
| 16 | `grip_pad.stl` | 2 | TPU | **накладкой вниз**, ножками-демпферами вверх | нет | 55 × 85 × 3.5 | 8.86 | 3.9/шт (7.8) | 0.6 |
| 17 | `seam_key.stl` | 2 | PETG | плашмя, фаской вверх | нет | 6 × 3 × 2 | 0.04 | ~0.1 | — |

> Примечания.
> * Деталь 1/2 (нижние половины) — самая ответственная: печать с **полостью
>   вверх** (дно и рукоятки на столе). Брюхо при этом открыто вниз, но
>   соединяется с основной полостью окном 200 × 60 — потолков/мостов нет.
> * `panel_upper_*` — 3 мм, печатать лицевой стороной вверх; окна и отверстия
>   вертикальные. Глухие M2.5-отверстия экрана открыты снизу, печатаются
>   как углубления от стола.
> * `deck_plate_*` — два взаимозаменяемых варианта (PAD по умолчанию, KEYS —
>   на заказ); печатать только нужный комплект.
> * `knob` — прозрачный PETG; для лучшей прозрачности 100 % заполнение,
>   слой 0.12–0.16, скорость 25 мм/с. Внутри окно световода и D-отверстие
>   вала 6 мм — печатается без поддержек за счёт вертикальных стенок.
> * `pad_cap`/`grip_pad` — TPU; если TPU нет, `pad_cap` можно PLA (жёстче клик).
> * `bay_hatch` 210 мм — единственная длинная деталь; кладётся по диагонали
>   стола Ender-3 (220 × 220) без проблем.

## 2. Калибровочный крест (обязательно перед комплектом)

`mechanical/test_fit/test_cross.stl` — 1 шт., PLA/PETG, 0.2 мм, без поддержек:
- шип 6 × 3 и ответный паз с зазором 0.25 мм — проверка сопряжения половин;
- бобышка с отверстием Ø4.6 × 6.0 — проверка посадки термовтулки M3;
- отверстие Ø3.3 — проверка прохода винта M3.

Если втулка входит с усилием «туго, но до упора», а шип входит от руки —
печатать комплект. Если туго/болтается — скорректировать `FIT` в
`params.py` (0.25 ± 0.1) и перегенерировать STL.

## 3. Итого

| Показатель | Значение |
|---|---|
| Эффективный объём печати | ≈ 224 см³ |
| Масса комплекта | ≈ **281 г** (PETG 145 г, PLA 74 г, TPU 24 г + прозрачные) |
| Время печати | ≈ **18.7 ч** без учёта переналадок; с браком/перезапусками 20–22 ч |
| Поддержки | 0 г |
| Постобработка | снять заусенцы в окнах, пройти отверстия M3 сверлом 3.3, втулки — паяльником 260 °C |

Масса корпуса в сборе ≤ 700 г по spec/10 §1 — выполняется с запасом
(печатный пластик ≈ 281 г + винты/втулки/накладки ≈ 40 г).

## 4. Что проверить перед печатью

1. `mechanical/fit_check.md` — конфликтов 1 (стойки слайдеров vs CORE-1,
   требует 2 отверстий в плате; см. §4 отчёта).
2. Все STL watertight (проверяется генератором: `watertight=True`).
3. Габариты ≤ 220 × 220 × 220 (таблица в fit_check.md §2).
4. Ориентация — строго по таблице выше, иначе появятся поддержки.
<!-- section:v1.7-print -->

---

# Карта печати — Букифон v1.7 (380 × 210 × 63)

Комплект: **5 STL** (2 половины корпуса, 2 половины панели, ножка ×4)
+ печатные шпонки не нужны (шип/паз на самих половинах).
Материал: **PETG**, слой 0.2, сопло 0.4, периметры 3 × 0.4 = 1.2, заполнение 25 %,
верх/низ 4 слоя. PETG: 240/80 °C. Ножки — TPU 225/40 °C.

**Печать без поддержек.** Ориентация:
- `body_L` / `body_R` — **открытой полостью вверх**, дно на столе; все стойки,
  рёбра, седла батареи и стенки вертикальные; шип пола (3 × 3) — в первых слоях;
- `panel_L` / `panel_R` — **лицевой стороной вверх**; шип 3 × 1.2 и паз — в нижних
  слоях (лежат на столе), окна сквозные;
- `foot` — плашмя, суженной стороной вверх.

| Деталь | Кол-во | Материал | Ориентация | Поддержки | Габарит, мм | Объём STL, см³ | Масса, г | Время, ч |
|---|---|---|---|---|---|---|---|---|
| `body_L.stl` | 1 | PETG | полостью вверх, дно на столе | нет | 193 × 210 × 60 | 220.5 | 101 | 6.6 |
| `body_R.stl` | 1 | PETG | полостью вверх | нет | 190 × 210 × 60 | 218.1 | 100 | 6.5 |
| `panel_L.stl` | 1 | PETG | лицевой стороной вверх | нет | 193 × 210 × 3 | 92.3 | 42 | 2.8 |
| `panel_R.stl` | 1 | PETG | лицевой стороной вверх | нет | 190 × 210 × 3 | 91.1 | 42 | 2.7 |
| `foot.stl` | 4 | TPU | плашмя, узкой стороной вверх | нет | Ø12 × 2.5 | 0.26 | 0.1/шт | 0.03 |
| `keycap_v17.stl` | 42 | PLA (полупрозр.) | **площадкой вниз**, пазом Choc вверх | нет | 17.5 × 16.5 × 5.5 | 0.94 | 0.4/шт (17.5) | 1.2 |

**Итого v1.7:** ≈ 238 см³ эффективного объёма, **≈ 302 г** PETG/PLA/TPU,
**≈ 19.9 ч** печати, **0 г поддержек**.

Колпачок Choc: 17.5 × 16.5 × 5.5, скругление 1.5, вогнутость 0.45,
паз-крест 3.8 × 3.8 под шток Choc; печать площадкой вниз, без поддержек.
Панель: внутренний буртик окна экрана 1.5 мм (модуль не проваливается),
шкалы-риски у фейдеров (0.35 мм, 11 шт. с каждой стороны каждого окна).

Печать панели: 380 мм не влезает в 220 → панель делится на 193 + 190 мм по
X = 190; шов проходит через окно экрана, между джеками (184.5 / 195.5) и
фейдерами (180 / 200), по центральному зазору клавиатур — на лицевой стороне
видна тонкая линия только в промежутках между клавишами. Половины стыкуются
шипом 3 × 1.2 (панель) и 3 × 3 (дно корпуса) с зазором 0.2.

Постобработка: снять заусенцы в окнах; пройти Ø3.3 (M3), Ø2.7 (M2.5);
втулки M3 4.6 × 6 запрессовать в 4 угловых стойки корпуса, 6 стоек PANEL-1,
4 стойки CORE-1 (CORE — саморез M3 по Ø3.3).

Калибровочный крест — прежний `test_fit/test_cross.stl` (зазор 0.25, втулка M3).
<!-- section:v0.4-print -->

---

# Карта печати — Букифон v0.4 (панель по канону, корпус v1.7)

Изменена **только панель** (2 детали). Корпус `body_L/R`, ножки `foot`,
колпачки `keycap_v17` — без изменений, берутся из v1.7 (в `stl_v04/` лежат
копии). Панель: PETG, слой 0.2, сопло 0.4, 3 периметра, 25 % заполнения.

| Деталь | Кол-во | Материал | Ориентация | Поддержки | Габарит, мм | Объём STL, см³ | Масса, г | Время, ч |
|---|---|---|---|---|---|---|---|---|
| `panel_L.stl` | 1 | PETG | лицевой стороной вверх, шип 3×1.2 в нижних слоях | нет | 193 × 210 × 3 | 93.8 | 43 | 2.8 |
| `panel_R.stl` | 1 | PETG | лицевой стороной вверх, паз 3.2 в нижних слоях | нет | 190 × 210 × 3 | 92.6 | 42 | 2.8 |

**Итого v0.4:** панель ≈ 67 см³ эффективно, **≈ 85 г** PETG, **≈ 5.6 ч**,
0 г поддержек. Полный комплект с корпусом v1.7: ≈ 240 см³, **≈ 304 г**,
**≈ 20.0 ч** печати.

Отличия вырезов v0.4 от v1.7 (координаты — из `spec/panel-spec-v0.4.json`):
42 окна Choc 14 × 14 (точная Lapka-42, половины **+18° / −18°**), 16 × Ø7.2
с цековкой Ø14.4 × 1.4 (X 25.2/54.1/82.6/111.4 и 269.3/297.8/326.6/355.8,
Y 35.7/68.5), 10 × Ø6.2 с цековкой Ø8.2 × 1.5 (X 129.9…247.8, Y 10.5),
экран 108 × 64.8 с центром (190, 58.7) + буртик 1.5 мм, 2 окна фейдеров
2.5 × 63 с центром Y 150 + 4 × M2.5 на каждый + риски, 4 × M3 по углам,
USB-C на задней кромке. Итого **83 сквозных отверстия**.

Панель 380 мм печатается двумя половинами (193 + 190 мм) с шипом/пазом по
X = 190 — без поддержек, как в v1.7.
<!-- section:v0.5-B-print -->

---

# Карта печати — Букифон v0.5-B (клин 8°, базовый для v1.0-rc)

База — v0.4/v0.5; панель **не менялась** (все 83 выреза из
`spec/panel-spec-v0.4.json`). Корпус — клин 8° (перед 32 / зад 61.5 мм).
Материал PETG, слой 0.2, сопло 0.4, 3 периметра, 25 % заполнения;
колпачки — PLA, ножки — TPU.

| Деталь | Кол-во | Материал | Ориентация | Поддержки | Габарит, мм | Объём STL, см³ | Масса, г | Время, ч |
|---|---|---|---|---|---|---|---|---|
| `body_L.stl` | 1 | PETG | **дном на стол**, полостью вверх (клин 8°) | нет | 190 × 210 × 58.5 | 189.4 | 87 | 5.7 |
| `body_R.stl` | 1 | PETG | дном на стол, полостью вверх | нет | 190 × 210 × 58.5 | 194.4 | 89 | 5.8 |
| `panel_L.stl` | 1 | PETG | лицевой вверх (копия v0.4, шип 3×1.2) | нет | 193 × 210 × 3 | 93.8 | 43 | 2.8 |
| `panel_R.stl` | 1 | PETG | лицевой вверх (паз) | нет | 190 × 210 × 3 | 92.6 | 42 | 2.8 |
| `foot.stl` | 4 | TPU | плашмя | нет | Ø12 × 2.5 | 0.3 | 0.1/шт | 0.03 |
| `keycap_v17.stl` | 42 | PLA | площадкой вниз, пазом Choc вверх | нет | 17.5 × 16.5 × 5.5 | 0.9 | 0.4/шт | 1.2 |

**Итого v0.5-B:** ≈ 220 см³ эффективного объёма, **≈ 279 г** PETG/PLA/TPU,
**≈ 18.3 ч** печати, **0 г поддержек**.

Печать корпуса: дно плоское (лежит на столе), верхняя плоскость наклонена 8° —
стенки получаются трапециевидными, вылетов >45° нет; фаска R4 по передней
кромке печатается как наружное скругление (без поддержек). Полости открыты
вверх, шип/паз панели — в нижних слоях панели. Панель режется 193 + 190 мм.

Сборка/высоты: спереди 32.0 мм, сзади 61.5 мм, перепад 29.51 мм (210·tan 8°),
полная высота (панель) 61.5 мм; с ручками — до ~76 мм.
<!-- section:paperkit -->

---

# Бумажный макет (перед печатью пластика)

Перед печатью ~280 г PETG — собрать картонный макет и проверить эргономику:
**`renders/templates/bukifon_paperkit_1to1.pdf`** (4 × A4, 100 %),
инструкция — [`docs/28-paper-kit.md`](../docs/28-paper-kit.md).

| Стр. | Содержимое | Назначение |
|---|---|---|
| 1–2 | панель v0.4, 1:1 (2 листа, перекрытие 10 мм) | реальная раскладка 42 клавиш ±18°, 16 ручек, экран, 10 джеков, 2 фейдера |
| 3 | боковой профиль клина 8°, 1:1 (перед 32 / зад 61.5, глубина 210, R4) | вырезать 2 борта из картона 2 мм; лапки склейки, линейка 50 мм |
| 4 | карта проверки + чек-лист 7 пунктов | зоны панели, критерии отказа, поля для заметок/фото |

**Материалы:** картон 2 мм, клей/скотч, ножницы, линейка — 30 минут.
**Проверка масштаба:** линейка 50 мм на стр.3 = 50 мм на бумаге; печать только 100 %.
**Сборка:** профили-борта + низ 380×210 + планки 29/58.5 → клин; панель наклеить
сверху (перед 32, зад 61.5 мм); ручки-цилиндры Ø14×15, экран-картонка 108×64.8.

**Что проверять (docs/21):** ладони/кисти, досягаемость дальнего энкодера,
угол экрана 30/35/45°, блики, кромка R4 под запястье, доступность фейдеров,
три позы (сидя низко / прямо / стоя).

**Решение:** все 7 ✓ → печатать `mechanical/stl_v05_B/`;
есть ✗ → править геометрию до печати пластика (перепечатать только нужные листы).
Бумага не проверяет тактильность, вес/жёсткость PETG, блики реального стекла.
<!-- section:v0.5-B-light-print -->

---

# Карта печати — Букифон v0.5-B-light (народная версия, 228.9 г / 11.0 ч)

Облегчение **только корпуса** (body_L/R); панели/колпачки/ножки — те же файлы,
что в v0.5-B (панель и 83 выреза — из `spec/panel-spec-v0.4.json`, без изменений).
Файлы: `mechanical/stl_v05_B_light/` (STL + 3MF + сборка).

Первый прогон печати и проверка жёсткости/шва до полного комплекта —
[`docs/35-print-first.md`](../docs/35-print-first.md).

## Профиль печати (рекомендуемый)

| Параметр | Корпус body_L/R | Панели panel_L/R | Колпачки / ножки |
|---|---|---|---|
| Сопло | **0.6 мм** | 0.4 мм | 0.4 мм |
| Слой | **0.28–0.32 мм** | 0.20 мм | 0.15–0.20 мм |
| Периметры | **3** (локально **4** у 4 × M3, шва 193+190, стоек PANEL-2) | **3** по кромкам/окнам + 1 в поле | 2 |
| Заполнение | **gyroid 10 %** + локальные рёбра (8 стеновых + 6 под панелью) | 10 % + рёбра-модификаторы вокруг окон | 100 % (мелкие) |
| Стенки / дно | 2.0 / 1.8 мм (было 2.5 / 3.0) | 3.0 мм (геометрия из JSON) | — |
| Поддержки | нет | нет | нет |

> Важно: «3 периметра по всей площади панели» при 0.4 мм даёт ~80 % сплошного
> материала (панель 3 мм) — масса комплекта вырастает до ~408 г. Поэтому панели
> печатаются «оболочкой»: 3 периметра по контуру/окнам + 1 периметр в поле +
> 10 % и локальные рёбра; в модели это эффективная доля 0.30 (см. ниже).

## B vs B-light

| Параметр | B (текущий) | **B-light** | Δ |
|---|---|---|---|
| Масса комплекта (оценка модели) | 275.5 г | **228.9 г** | **−47 г (−17 %)** |
| Время печати | 18.3 ч | **11.0 ч** | **−7.2 ч (−39 %)** |
| Стенки / дно | 2.5 / 3.0 мм | 2.0 / 1.8 мм | тоньше |
| Периметры / инфилл | 2 / 25 % | 3 / 10 % gyroid | жёстче оболочка |
| Рёбра | 8 стеновых | 8 стеновых + 6 локальных + 2 седла батареи | больше локально |
| Сопло | 0.4 | 0.6 | быстрее |
| Жёсткость | базовая | **сохраняется**: 3 периметра (1.8 мм в стенке 2.0), рёбра у экрана/фейдеров/шва; 4 периметра у винтов | — |
| Риски | — | тоньше дно (1.8) → возможен «барабан» на НЧ; проверить на кручение 10 Н·м и с динамиком; панель-оболочка → локальные рёбра обязательны; 0.6 сопло — грубее поверхность | тест деталей |

## Вклад шагов (модель, калибрована по базе B = 275.5 г / 18.3 ч)

| Шаг | Масса | Время |
|---|---|---|
| B — база (0.4/0.2, 2 периметра, 25 %) | 275.5 г | 18.3 ч |
| + профиль 0.6 мм / слой 0.30 (материал −7 %) | 257 г (−19) | 12.4 ч (−5.9) |
| + тонкие стенки 2.0 / дно 1.8, лёгкий ложемент батареи, стойки Ø6.4 | 208 г (−50) | 10.0 ч (−2.4) |
| + 3 периметра / 10 % gyroid / локальные рёбра (жёсткость) | **228.9 г (+22)** | **11.0 ч (+1.0)** |

Оценка по модели генератора (эффективная доля материала: корпус 0.42, панели 0.30,
мелкие 0.36; PETG 1.27, PLA 1.24, TPU 1.21; скорость 0.6 сопла ≈ 16.5 см³/ч).
Реальный слайсер даст ±10–15 % — перед партией напечатать 1 половинку корпуса
и 1 панель, замерить массу/время.

## Что напечатать первым (проверка облегчения)

1. `body_L.stl` — контроль: масса ≈ 70 г, время ≈ 3.4 ч (0.6/0.30); тест на
   кручение (10 Н·м) и «барабан» (поставить на стол, постучать).
2. `panel_L.stl` — контроль жёсткости у окон энкодеров/фейдеров.
3. Если масса/жёсткость ок → печатать комплект; иначе вернуть стенки 2.2 / дно 2.0
   (+~20 г, +~1 ч) — компромисс в пределах цели (≈250 г / 12.1 ч).

## Итог v0.5-B-light

| Показатель | Значение |
|---|---|
| Эффективный объём печати | ≈ 182 см³ |
| Масса комплекта | **≈ 227.5 г** (без микрофона); **с микрофоном и вырезами ≈ 228.9 г*** |
| Время печати | **≈ 11.0 ч**; **с микрофоном ≈ 11.0 ч*** |
| Поддержки | 0 |
| Габарит деталей | body 190×210×58.5; panel 193/190×210×3 — все ≤ 220×220×200 |
<!-- section:v0.5-C-print -->

---

# Карта печати — Букифон v0.5-C (клин 12° + отсек 1S2P + подставка)

Третий печатный вариант (сравнительный/нишевый): наклон панели **12°**, перед 32 /
зад 76.6 мм, закрытый батарейный отсек 1S2P 18650 с крышкой, складная подставка,
кабельный канал. Панель и все 83 выреза — **без изменений** из
`spec/panel-spec-v0.4.json`. Файлы: `mechanical/stl_v05_C/` (body_L/R,
battery_lid, stand, panel_L/R, foot, keycap_v17 + 3MF + сборка).

## Профиль печати (стандартный, как B)

| Параметр | body_L/R | battery_lid | stand | панели | колпачки/ножки |
|---|---|---|---|---|---|
| Сопло / слой | 0.4 / 0.20 | 0.4 / 0.20 | 0.4 / 0.20 | 0.4 / 0.20 | 0.4 / 0.15–0.20 |
| Периметры / заполнение | 2 / 25 % | 2 / 25 % | 2 / 25 % | 2 / 25 % | 2 / 100 % |
| Ориентация | дном на стол, полостью вверх (клин 12°) | плашмя, цековкой снизу | плашмя, U-проёмом вверх | лицевой вверх | — |
| Поддержки | нет | нет | нет | нет | нет |

## Все варианты корпуса (сводная таблица)

| Вариант | Угол | Габарит в сборе (В×Ш×Г) | Масса | Время | Батарея | Подставка | Печать |
|---|---|---|---|---|---|---|---|
| **A — flat** | 0° | 380×210×63 | ≈301.0 г | ≈19.9 ч | нет | нет | 0.4/0.2, 2 пер, 25 % — **студийный/настольный**; вырезы 11 разъёмов + SD + USB-C |
| **A + mic** | 0° | 380×210×63 | ≈302.3 г | ≈20.0 ч | нет | нет | A + порт MEMS/LED/звуковод/клипса |
| B — клин 8° (v1.0-rc) | 8° | 380×210×61.5 | ≈275.5 г | ≈18.3 ч | открытый ложемент 2×18650 | нет | 0.4/0.2, 2 пер, 25 % |
| **B-light** (народная) | 8° | 380×210×61.5 | **≈228.9 г*** | **≈11.0 ч*** | открытый ложемент | нет | 0.6/0.28–0.32, 3 пер, gyroid 10 % |
| **B + mic** | 8° | 380×210×61.5 | ≈276.8 г | ≈18.3 ч | открытый ложемент | нет | + порт/LED/звуковод/клипса (D-94) |
| **C + mic** | 12° | 380×210×76.6 | ≈314.6 г | ≈20.7 ч | закрытый отсек 1S2P | складная U | + порт/LED/звуковод/клипса |
| **C — 12° + отсек + стойка** | 12° | **380×210×76.6** | **≈313.2 г** | **≈20.7 ч** | **закрытый отсек 1S2P + крышка 86×86×2.5 (4×M3)** | **складная U 148×67×6, 2 оси M3 сзади** | 0.4/0.2, 2 пер, 25 % |

**С микрофоном (опция, D-94):** `mechanical/stl_v05_B_mic/` и
`mechanical/stl_v05_C_mic/` — те же корпуса B/C, но в панелях прорезаны порт
Ø1.8 в (122.0, 5.5) + цековка Ø3.4×0.7, MEMS-углубление Ø5×1.2 снизу и LED
Ø1.6 в (116.0, 10.5); комплект включает звуковод/клипсу/держатель (STL+3MF+STEP).
Пересобрать: `python mechanical/generator/case_v05.py --mic` (или
`make_mic_variants.py`); B-light уже с микрофоном по умолчанию.
Масса B+mic ≈278 г / 18.3 ч; C+mic ≈316 г / 20.8 ч (fitcheck: 44 и 49 проверок, 0).

**A и A_mic пересобраны с вырезами** (раньше A был копией v0.4 без вырезов):
`stl_v05_A/` и `stl_v05_A_mic/` — добавлены 11 задних разъёмов (MIDI IN/OUT X30/44,
DC X91, EXPR X120.5, mic X140, LINE X160, PHONES X172, AUDIO IN L/R X184/196,
CV5/6 X208/220), SD-слот слева (12×2) и USB-C окно; в A_mic — ещё порт MEMS/LED
(122;5.5 и 116;10.5). Δ от вырезов ≈ −0.9 г, fitcheck A 19/0, A_mic 31/0.

Все варианты собраны генератором: `mechanical/stl_v05_A/`, `stl_v05_A_mic/`,
`stl_v05_B/`, `stl_v05_B_light/`, `stl_v05_C/` — панели/колпачки/ножки — копии
канона; A/B/C/B-light отличаются только body_L/R (+ детали у C).

Детали C: body_L/R 190×210×73.7; battery_lid 86×86×2.5; stand 148×67×6 — все
≤220×220×200, watertight, без поддержек. Fitcheck C — **37 проверок, 0 конфликтов**
(`mechanical/fit_check.md`, секция v0.5-C): панель по JSON (83 отверстия, 0 промахов),
батарея в отсеке, крышка снизу, подставка отдельной деталью, кабельный канал открыт.

> C выходит за эргономические допуски docs/21 (зад 76.6 > 63) — это осознанный
> «максимальный клин» для тех, кому нужен сильный наклон и встроенная батарея
> с подставкой. Масса/время +13 % к A и +36 % к B-light.

Сравнение профилей: `mechanical/preview_v05_compare/side_profile_all.jpg`
(0° / 8° / 12° в одном масштабе).
<!-- section:mic -->

---

# Микрофон: порт, сетка, клипса/держатель (D-94, docs/71)

**Порт в панели** (B-light; панель = канон v0.4 + 2 новых отверстия):
центр **(X 122.0, Y 5.5)** — верхняя/задняя кромка, слева от экрана.
- акустический порт **Ø1.8** сквозной;
- цековка под сетку/поролон **Ø3.4 × 0.7** (снаружи);
- углубление под MEMS/звуковод **Ø5 × 1.2** (снизу; остаётся ≈0.8 мм панели);
- LED MIC ON: **Ø1.6** + цековка Ø2.8 × 0.5 в **(X 116.0, Y 10.5)**.
Сетка/поролон: вырезать кружок Ø3.2 из поролона 0.5–1 мм, вклеить в цековку
заподлицо; сверху — сетка 0.3 мм (или акустическая ткань) на клей по контуру.

## Печатные детали (лежат в `mechanical/stl_v05_B_light/`)

| Деталь | Габарит, мм | Масса | Печать | Назначение |
|---|---|---|---|---|
| `mic_guide.stl` | 8 × 8 × 7.5 | ≈0.1 г | 0.4 / 0.12, 2 периметра, 100 % | звуковод панель → PANEL-2: флянец Ø8, канал Ø2.0→Ø4.5 |
| `mic_clip_rear.stl` | 18 × 16 × 14 | ≈0.65 г | 0.4 / 0.12, 3 периметра, 100 %, без поддержек | **клипса на заднюю кромку** панели, зев 3.6, гнездо Ø6.8×8 под шею 3.5 |
| `mic_holder_top.stl` | 20 × 20 × 11 | ≈0.63 г | то же | **короткий держатель на верхнюю кромку**, гнездо Ø6.8×5 |

Ориентация: клипса — «зевом» вверх (без поддержек, 45°-скосы), держатель —
плашмя; звуковод — флянцем на стол (раструб вверх). STEP-версии:
`mic_guide.step`, `mic_clip_rear.step`, `mic_holder_top.step` (экспорт FreeCAD).
Вес B-light с микрофоном: **≈228.9 г / 11.0 ч** (+1.4 г к 228.9 г; панели почти
без изменений — 2 отверстия).

## Что примерять

1. Сетка/поролон не выступает над панелью (палец не цепляет).
2. Звуковод вставляется в углубление Ø5, низ не касается PANEL-2 (зазор 0.5).
3. Клипса: надеть на заднюю кромку панели — держится без люфта, снимается рукой;
   гусиная шея 3.5 входит в гнездо и не вырывает его при изгибе.
4. Держатель на верхнюю кромку — низкий профиль не мешает джекам (X 129.9+)
   и экрану; гнездо не перекрывает панель.
5. LED MIC ON виден сверху, не засвечивает экран.
<!-- section:connector-cutouts -->

---

# Вырезы разъёмов в корпусе (полный список; docs/82, board-fit, hardware/core2)

Добавлены в генератор (`conn_cuts_v05.py` → `case_v05_light.py` для B-light,
`case_v05.py` для B/C) и пересобраны **B-light, B, C, B_mic, C_mic**.
Панель-канон не менялась: 10 верхних джеков (CV/GATE, Y=10.5) — на панели,
их вырезы из JSON (83) не трогали — **вырез в корпусе им не нужен**.

## Задняя стенка (ось Y, Z≈17)

| Узел | BOM | X (центр) | Ø | Z | Статус |
|---|---|---|---|---|---|
| MIDI IN TRS-A | J6 | **30.0** | 8.2 | 12.9…21.1 | добавлено (был DIN Ø14 X76 — исправлено на TRS) |
| MIDI OUT TRS-A | J7 | **44.0** | 8.2 | 12.9…21.1 | добавлено |
| DC 12 В | J12 | **91.0** | 9.0 | 12.5…21.5 | было |
| EXPRESSION (резерв) | J13 (DNP) | **120.5** | 8.2 | 12.9…21.1 | было (D-44 — резерв) |
| mic/headset | J20 | **140.0** | 8.2 | 12.9…21.1 | было (docs/71) |
| LINE OUT L/R | J8 | **160.0** | 8.2 | 12.9…21.1 | добавлено (стерео TRS — один джек) |
| PHONES | J9 | **172.0** | 8.2 | 12.9…21.1 | добавлено |
| AUDIO IN L | J10 | **184.0** | 8.2 | 12.9…21.1 | добавлено |
| AUDIO IN R | J11 | **196.0** | 8.2 | 12.9…21.1 | добавлено |
| CV OUT 5 | — | **208.0** | 8.2 | 12.9…21.1 | добавлено (задний джек, D-44) |
| CV OUT 6 | — | **220.0** | 8.2 | 12.9…21.1 | добавлено |
| USB-C | — | 346…356 | окно 10×4.5 | верх | было |

## Левая стенка

| Узел | Размер | Y | Z | Статус |
|---|---|---|---|---|
| microSD | слот 12×2 (сквозной) | 150…162 | 8…10 | добавлено ранее |

**Перемычки:** между Ø8.2 — **3.8 мм**; до рёбер X60/110/290/340 — ≥10 мм;
до краёв и групп — ≥10 мм. **Изменение против прошлого раунда:** MIDI был DIN
Ø14 X76 — по BOM/interfaces MIDI на TRS-A (J6/J7), поэтому Ø8.2 и два отверстия;
освободившееся место занято аудио-группой (LINE/PHONES/AUDIO IN/CV5-6).
EXPRESSION — DNP/резерв (D-44).

**Δ веса/времени** (относительно корпуса без вырезов): B-light **−0.56 г / −0.037 ч**;
B/C/B_mic/C_mic **−0.70 г / −0.046 ч**. Итоги: B-light ≈**228.9 г / 11.0 ч**
(с микрофоном), B ≈276.2/18.3, B+mic ≈277.2/18.4, C ≈313.2/20.8, C+mic ≈314.6/20.9.

**Fitcheck:** `mechanical/fit_check.md` — секция «вырезы разъёмов»: **16 проверок,
0 конфликтов** (все 11 отверстий + SD открыты, watertight, перемычки ≥3 мм,
панель не менялась); варианты: B-light 41/0, B 32/0, C 37/0, B-mic 44/0, C-mic 49/0,
board-fit 22/0.

**Превью:** `preview_v05_B_light/`, `preview_v05_B_mic/`, `preview_v05_C_mic/` —
`rear_ports.jpg` (видны все разъёмы: MIDI IN/OUT, DC, EXPR, mic, LINE, PHONES,
AUDIO IN L/R, CV5/6, USB-C), `left_ports.jpg` (SD), `side_profile.jpg`.
<!-- section:panel2-parallel -->

---

# PANEL-2 параллельна верхней панели (эргономика, D-94/round 35)

**Проблема заказчика:** на виде сбоку ручки/клавиши выглядели «вертикально» при
наклонной панели (8°/12°) — плата PANEL-2 должна лежать **в плоскости панели**,
а не на горизонтальной полке.

**Что изменено:** все 6 стоек PANEL-2 теперь **наклонены вместе с панелью**
(ось ∥ нормали панели, верх ∥ панели), втулки M3 — вдоль нормали; плата лежит
**параллельно панели** на **12 мм ниже её низа** (низ платы 13.6 мм). Рёбра под
платой опущены; звуковод удлинён до 11.5 мм (зазор 0.5 до платы).

**Проверки (fitcheck, строки [P]):**
- угол PANEL-2 к панели: **0.00°** (допуск 0.0±0.1°);
- зазор по нормали панель↔плата: **12.00 мм** (допуск 12.0±0.2);
- оси 6×M3 стоек ∥ нормали панели;
- энкодеры/клавиши/фейдеры — оси ⊥ панели, высоты одинаковы по площади;
- CORE-2/PWR-2 остаются горизонтальны; шлейфы J13/J14/J16 достают.

**A (flat)** не менялся (панель горизонтальна, эквивалентно). **B/B-light/C/B_mic/C_mic**
пересобраны.

**Вес/время (после правки стоек/рёбер):** B-light ≈**228.9 г / 11.0 ч**;
B ≈275.5/18.2; B+mic ≈276.8/18.3; C ≈313.2/20.7; C+mic ≈314.6/20.8;
A ≈301.0/19.9; A+mic ≈302.3/20.0.

**Превью:** `preview_v05_*/side_profile.jpg` — с осями энкодеров (⊥ панели),
`preview_v05_*/panel_parallel.jpg` — крупно панель, плата ∥, стойки, энкодеры.
