martiyanov/bukifon/docs/02-build-guide.md

# Букифон v1.0 — руководство по сборке

Документ — «монтажная диспетчерская»: порядок операций, контрольные точки, калибровка
и диагностика **по фактически готовым артефактам** репозитория. Подробности схем и
номиналов здесь не дублируются — даны ссылки на PDF, netlist, BOM и таблицы плат.

**Дата:** 2025-11-05 · **Ревизия контракта:** `spec/20-electronics.md` v1.1 (6 CV-выходов,
2 × MCP4728, GATE1 = GP22, GATE2 = GP26, DECK_ID = GP27, DECK_INT = GP28).
**Статус:** схемы, механика и host-прошивка готовы; **разводка печатных плат (PCB/DCR)
не выполнена** — это следующий этап. Сборка «в железе» станет возможной после изготовления
плат по netlist; всё остальное (порядок, калибровка, диагностика, проверки) применимо уже сейчас.

---

## Сборка v0.5 (draft) — короткая версия

> Ниже — **черновая** секция под новую архитектуру v0.5 (ESP32-P4, экран 5.0″, панель v0.4,
> корпус v0.5). Артефакты v0.5 ещё в работе: PCB rev.3/rev.2 не разведены, варианты корпуса
> A/B/C появятся в `mechanical/stl_v05_*`, прошивка под P4 — этап P4. Разделы §0–§11 ниже
> описывают **legacy v1.0** (Pico, 315×145) и остаются как справка по аналоговым модулям,
> калибровке и диагностике. Контракты: [`spec/90-requirements-registry.md`](../spec/90-requirements-registry.md),
> [`spec/70-v1.8-case.md`](../spec/70-v1.8-case.md), [`spec/panel-spec-v0.4.json`](../spec/panel-spec-v0.4.json).
> BOM — [`docs/BOM.md`](BOM.md) (draft), [`BOM.csv`](../BOM.csv).

### 1. Печать корпуса

1. **Варианты A/B/C** (появятся в `mechanical/stl_v05_*`): отличаются высотой/наклоном
   (wedge 8° — клин наклона панели/дна), местом батареи (вариант A — «батарейная спина»
   150 × 62 × 16, высота 63–64 мм, [`spec/50-v1.1.md`](../spec/50-v1.1.md) §1a) и разъёмами.
   До публикации v0.5 доступен корпус v0.4: [`mechanical/stl_v04/`](../mechanical/stl_v04/)
   (6 деталей, 380 × 210 × 63, панель режется 193 + 190 мм с шипом) и v1.7/v1.8:
   [`mechanical/stl_v05_B_light/`](../mechanical/stl_v05_B_light/), [`mechanical/stl_v05_A/`](../mechanical/stl_v05_A/).
2. Материал PETG, сопло 0.4, слой 0.2, **без поддержек**, детали ≤ 220×220;
   карта печати: [`mechanical/prints.md`](../mechanical/prints.md).
3. Сначала калибровочный крест [`mechanical/prints.md`](../mechanical/prints.md) (калибровка)
   (втулка M3 + шип + паз 0.25). Затем — панель/скорлупа; wedge 8° печатать как отдельную
   деталь-клин (ориентация по `prints.md`, иначе появятся поддержки).
4. Проверки: watertight, 0 пересечений (`renders/templates/bukifon_v04_collisions.json`,
   `mechanical/fit_check*.md`), панель 1:1 сверить с
   [`renders/templates/bukifon_v04_panel_1to1.pdf`](../renders/templates/bukifon_v04_panel_1to1.pdf).

### 2. Панель v0.4/v0.5

- 380 × 210 × 3: 42 клавиши Lapka-42 (2 × 21, splay ±18°), 16 энкодеров Ø14 (отв. Ø7.2),
  10 mini-jack (Ø6.0, шаг 13.1), окно экрана 108 × 64.8, 2 паза фейдеров 2.5 × 63.
- Раскладка — [`spec/panel-spec-v0.4.json`](../spec/panel-spec-v0.4.json) (единственный
  источник геометрии, см. [`AGENTS.md`](../AGENTS.md) §3); окна клавиш — по KiCad-футпринту
  Choc (`SW_Choc_V1V2_HS`), а не «колпачок + 1 мм».
- Сверка: 1:1 PDF, рендер (`renders/templates/bukifon_v04_render.png`), 0 пересечений.
- Крепёж панели: 8 × M3×8 в термовтулки (v1.8) или 6 × M3 (v0.4) — по выбранному варианту.

### 3. Платы

- Состав v0.5: **CORE-1 rev.3** (ESP32-P4, PCM5102A, PCM1808, 2 × MCP4728, MCP3208,
  2 × MCP23017, microSD, USB-C, питание), **PANEL-1 rev.2** (16 EC11, 10 джеков, 2 фейдера,
  LED-цепочки, FFC-дисплей), **DECK-KEYS-L42**, **DECK-PAD**, **PWR-1** (1S2P: TP4056/BQ24074,
  MT3608, MP1584, MC34063), 5 аналоговых картриджей.
- **Пока не разведены** (нет `.kicad_pcb`/герберов): схемы v1.x есть только под старую
  панель — [`hardware/core/`](../hardware/core/), [`hardware/power/`](../hardware/power/).
  Заказ плат — после бенчмарка P1 и фиксации MCU (`docs/12-roadmap.md`, P6).
- FFC-дисплей: 40/50-pin 0.5 мм, проверить распиновку панели даташитом; драйвер подсветки
  (~19 В, 40 мА) — отдельный boost/CC на PANEL-1.

### 4. Пайка

1. **PWR-1:** TP4056/BQ24074 → BMS → MT3608 → ideal-diode → 12 В; затем MP1584 (5 В),
   MC34063 (−12 В), AP2112K/MCP1700 (3.3 В). Сначала только DC-DC, проверить рельсы
   (12 / 5 / 3.3 / −12 В ±5 %) и ток покоя — потом ставить MCU и кодеки.
2. **CORE-1:** ESP32-P4-модуль/плата (проверить 3.3 В и USB до пайки), PCM5102A, PCM1808,
   MCP4728 ×2 (адреса 0x60/0x61 — варианты A0/A1), MCP3208, MCP23017, microSD, 6N137/74HCT125.
3. **PANEL-1:** FFC-разъём, EC11 (RC 10k/100n), джеки, фейдеры (RC 1k/100n), LED-цепочки;
   LED_DATA 3.3→5 В через 74HCT1G125.
4. **Деки:** 42 × Choc hot-swap + 42 × 1N4148 (матрица 6×7), SK6812; DECK-PAD — 18 пэдов
   (MCP23017) + 2 × 74HC4067 + FSR (опция).
5. После каждой платы — контроль: КЗ нет, питание в норме, I2C-адреса уникальны
   (0x50…0x52 модули, 0x57 24C32, 0x60/0x61 MCP4728, 0x20…0x23 MCP23017).

### 5. Прошивка

- Прошивка v0.5 под ESP32-P4 **ещё не готова** (этап P4 дорожной карты). Сейчас есть:
  host-тесты DSP (`make -C firmware/host test` — 67/67 в прототипе) и RP2040-прототип
  (`firmware/Bukifon`, PlatformIO); порт на P4/ESP-IDF — после P1.
- Порядок для P4: ESP-IDF → сборка `CORE-1 rev.3` → прошивка → панель (16 энкодеров,
  матрица 42 клавиш, 5″ UI 800×480) → калибровка. Команды появятся вместе с прошивкой
  (следить за `firmware/README.md`).

### 6. Калибровка

- CV out (2 × MCP4728, 6 каналов): 4 точки на канал (0/25/50/100 %), коэффициенты в 24C32.
- CV in (MCP3208): 0/±10 В, проверка кодов; фейдеры — 12 бит, дед-зона.
- Батарея: BAT_ADC (делитель 100k/47k) и TEMP_ADC (NTC/2) — на CH4/CH5 MCP3208
  (`spec/50-v1.1.md` §1a).
- Аналоговые картриджи — 1 В/окт по методике legacy §3.6 (RV3/RV4, ±3 цента).

### 7. ТБ

- **Аккумулятор:** только 18650 с защитой, одинаковые элементы 1S2P; BMS до холдера,
  предохранитель 3 А по выходу, NTC; не заряжать < 0 °C; при набухании — утилизировать;
  USB-C CHARGE без данных.
- **±12 В:** 1000 мкФ на входе разряжается не сразу; первый запуск — через БП с
  ограничением тока 0.3–0.5 А; аналоговые картриджи питать только с шины.
- **Статика:** ESP32-P4/кодеки/CMOS чувствительны — антистатический браслет/мат,
  пайка с заземлённым жалом; LED-цепочки — от 5 В с ограничением тока.

---

---

## 0. Что готово, а что нет (проверено по файлам)

| Артефакт | Статус | Где |
|---|---|---|
| CORE-1: схема, ERC 0/0, PDF/SVG, netlist, BOM, карта джеков | **готово** | [`hardware/core/README.md`](../hardware/core/README.md), [`CORE-1.pdf`](../hardware/core/CORE-1.pdf) |
| PANEL-1, DECK-PAD, DECK-KEYS: схемы, ERC 0/0, PDF, таблицы, verify_netlist 2967/0 | **готово** | [`hardware/panel/README.md`](../hardware/panel/README.md) |
| 5 аналоговых модулей: схемы, ERC 0/0, PDF, BOM (173 позиции), расчёты | **готово** (ENSEMBLE-1 — v0.9) | [`hardware/modules/README.md`](../hardware/modules/README.md) |
| Механика: 20 STL, prints/assembly/fit_check, генератор, рендеры | **готово** | [`mechanical/README.md`](../mechanical/README.md) |
| Прошивка: host-движок + тесты, RP2040-скетч, `platformio.ini` | **host — проверено; RP2040-сборка — нет** (см. §5) | [`firmware/README.md`](../firmware/README.md) |
| `firmware/tests/REPORT.md` | **в работе** (появится отдельно) | — |
| PCB разводка/DRC, герберы | **пока не готово** — только netlist | [`hardware/core/README.md`](../hardware/core/README.md) §6 |
| ENSEMBLE-1 (BBD-вариант) | **не разведён**; PT2399-вариант — v0.9 | [`hardware/modules/availability.md`](../hardware/modules/availability.md) |

**Правило:** всё, что не подтверждено файлом, в этом руководстве помечено «ожидается»
и сверяется со спецификацией. Числа из спецификации — контракт, числа из README плат —
факт реализации; при расхождении побеждает README платы (там же — список отклонений).

---

## 1. CORE-1 — сборка и проверка питания

Файлы: [`CORE-1.pdf`](../hardware/core/CORE-1.pdf) (A0), [`netlist.net`](../hardware/core/netlist.net),
[`wiring-jacks.md`](../hardware/core/wiring-jacks.md), [`BOM-core.csv`](../hardware/core/BOM-core.csv),
[`erc/erc.rpt`](../hardware/core/erc/erc.rpt) (0 ошибок).

Пайка — **строго в четыре этапа**, с проверкой между ними. Не впаивайте Pico, PCM5102A,
MCP4728, MCP3208 до проверки рельсов (п. 1.1).

### 1.1 Этап A — DC-DC и защита (только этот узел)

Ставить: J14 (DC), SW1, F1 2 A, D1 SS34, TVS SMAJ15A, 1000 мкФ/25 В, U1 MP1584,
U2 AP2112K-3.3, U3 MC34063 + L 220 мкГн, D3 SS34, Rsc 0.33, Ct 1.5 нФ, ферриты 600 Ом.

Подайте 12 В через лабораторный БП с ограничением **0.3 А** и измерьте (мультиметр,
4.5 знака):

| Рельс | Номинал | Допуск | Куда смотреть |
|---|---:|---|---|
| +12 В (вход после D1) | 12.0 В | 11.4…12.6 В | F1, D1, TVS |
| +5.1 В (MP1584) | 5.1 В | 4.85…5.35 В | делитель ОС MP1584 |
| +3.3 В (AP2112K) | 3.3 В | 3.14…3.46 В | LDO, ток ≤ 120 мА |
| −12 В (MC34063) | −12.0 В | −12.6…−11.4 В | делитель 33k/3.9k, «плавающая» земля |

Контроль: ток покоя платы **без ИС** — десятки мА; скачок >100 мА или нагрев — ищите КЗ.
Пульсации ±12 В — ≤20 мВ (pp) по [`hardware/modules/Calc.md`](../hardware/modules/Calc.md) §1.4
(там же методика измерения на 10 Ω). «Звезда» земель AGND/DGND/PGND сводится в net-tie
**NT1/NT2** — на схеме это два раздельных узла, соединение выполняется на PCB.

Если −12 В «плывёт» — MC34063 в инвертирующем включении: pin 4 = −12 В, проверьте
номиналы делителя, полярность D3 и индуктивность 220 мкГн.

### 1.2 Этап B — цифра

Ставить: Pico A1 (SMD на кастеляцию), U4/U16 MCP4728, U? MCP3208, 24C32, 6N137,
74HCT125, IDC-26 P1/P2/P3, IDC-32 J15, клеммники TB1/TB2, SWD J16, RESET SW2.

Важные факты из [`hardware/core/README.md`](../hardware/core/README.md) §5:

- **2 × MCP4728**: U4 = **MCP4728A0-E/UN (0x60)** — CV1…CV4 на шину; U16 =
  **MCP4728A1-E/UN (0x61)** — CV OUT 1/2 на джеки. У MSOP-10 нет адресных выводов:
  адрес задаётся исполнением A0/A1, поэтому заказывайте **именно эти два варианта**.
- **24C32 = 0x57** (A2/A1/A0 = 1), чтобы не конфликтовать с EEPROM модулей 0x50…0x52.
- **Pico 3V3 не подключается** (no-connect): Pico питается от VSYS (+5 В через SS34),
  внешний +3V3 даёт AP2112K — два регулятора параллельно не работают.
- **GP22 = GATE1, GP26 = GATE2, GP27 = DECK_ID (ADC1), GP28 = DECK_INT** — по v1.1.
- Обозначения: J-DC → J14, J-PANEL → J15, HDR-EXT → J16 (в BOM есть столбец «spec:»).

Проверьте до подачи: нет КЗ +5 В/3.3 В/12 В на землю; I2C SDA/SCL подтянуты 4.7 кΩ к 3.3 В.
Подайте питание: +3.3 В в норме, Pico определяется USB; если нет — пропаяйте кастеляцию
(все 40 выводов) и проверьте BOOTSEL.

### 1.3 Этап C — аналог

Ставить: PCM5102A + charge pump (CAPP/CAPM, VNEG, LDOO) + 10 мкФ; TL074 U10 (аудио-сумматор
Rf 22k, входы DAC 10k, порты 22k), TL074 U13 (4 CV-буфера ×4.9), TL074 U17 (CV OUT 1/2),
TL072 U11 (2 буфера LINE/PHONES), MASTER VOL; защита BAT54S 1k/100pF на аудио и CV;
2 × 2N7000 (GATE), 2N7002 Q3 (ключ подсветки).

Проверки:

- Аудиовыход сумматора: при MASTER VOL в минимуме — тишина, постоянка на LINE/PHONES
  отсутствует (конденсаторы 10 мкФ).
- CV-выходы: код 0…4095 → 0…10.04 В (коэффициент 4.9; точное значение — при калибровке,
  эталон 4.883 достигается заменой Rf 39k → 38.3k).
- **CV IN 1/2**: `Vadc = 1.65 − 0.165·Vin` (инвертирующий аттенюатор 100k/16.5k со сдвигом
  +1.65 В). При Vin = 0 В ожидается ≈1.65 В (код ≈2048), при +10 В — ≈0 В.
- GATE1/2: open-drain 2N7000, на джеке 0/5 В при нагрузке 4.7 кΩ.

### 1.4 Этап D — приёмка CORE-1

- [ ] Все 4 рельса в допуске, токи в лимитах §3: +12 ≤400 мА, −12 ≤200 мА, +5 ≤0.8 А,
      +3.3 ≤120 мА (LED-цепочки на +5 В — отдельная строка бюджета).
- [ ] I2C: видны 0x57 (24C32), 0x60, 0x61 (MCP4728); MCP3208 отвечает по SPI.
- [ ] Клеммники TB1/TB2 прозвонены по [`wiring-jacks.md`](../hardware/core/wiring-jacks.md).
- [ ] Плата не висит на джеках: джеки — панельные, к TB1/TB2 идут проводами.

---

## 2. PANEL-1 и деки

Файлы: [`hardware/panel/README.md`](../hardware/panel/README.md) (все решения и отклонения),
PDF: [`panel-1.pdf`](../hardware/panel/panel-1/panel-1.pdf),
[`deck-pad.pdf`](../hardware/panel/deck-pad/deck-pad.pdf),
[`deck-keys.pdf`](../hardware/panel/deck-keys/deck-keys.pdf),
таблицы: [`matrix-tables.md`](../hardware/panel/matrix-tables.md),
[`BOM-panel.csv`](../hardware/panel/BOM-panel.csv), [`coords-panel.csv`](../hardware/panel/coords-panel.csv),
ERC: [`erc/panel-1-erc.rpt`](../hardware/panel/erc/panel-1-erc.rpt) (0/0),
проверка netlist: 2967 утверждений, 0 ошибок.

### 2.1 PANEL-1

1. **6 × 74HC165** каскадом: `U1.Q7 → U2.DS → … → U6.Q7 = HC_QH`. Бит 0 = `U1.D0`,
   бит 47 = `U6.D7`; первым по MISO читается `U6.H`. Биты 28…47 (резерв) посажены на GND,
   `~Q7` — no-connect, `~CE` = GND.
2. **8 × EC11**: на каждую фазу 10 кΩ к +3.3 В + 100 нФ на GND (16 RC-цепочек),
   кнопка энкодера — отдельный 10 кΩ pull-up. Вал — гладкий, без фиксации, с кнопкой.
3. **4 плечевых 6×6** — на биты 24…27 (BTN_L1/L2/R1/R2), 10 кΩ pull-up.
4. **Экран 2.8″ ST7789 1×14**: SPI1 (GP10…GP15), `Q1` 2N7002 — ключ подсветки,
   R301 33 Ω / R302 100 Ω / R303 10k. **Ключ подсветки ставится только в одном месте:**
   на PANEL-1 (Q1), на CORE-1 Q3 не запаивать (и наоборот) — двойной ключ недопустим.
5. **9 × WS2812B-2020** — цепочка на **+5 В**: `LED_DATA` (GP7, 3.3 В) → буфер
   **U7 74HCT1G125** (VCC = +5 В, TTL-вход) → R300 330 Ω → `LED_IN` → LED_ENC1…8 →
   LED_STATUS → `LED_OUT` (pin 7 J-DECK). 100 нФ на каждый LED.
6. **Разъёмы**: J-CORE IDC-32 (pin 21 = +5 В для LED), J-DECK IDC-16 (pin 15 = FSR,
   **pin 16 = +5 В** для LED-цепочек деки). I2C-подтяжки 4.7 кΩ на панели для сегмента
   деки (итого ≈2.35 кΩ — допустимо).

**Проверить после пайки:** прозвонить CP/PL/QH и 6 регистров; подать 3.3 В и убедиться,
что на `LED_IN` 0 В; подать 5 В на LED-цепочку — первый LED загорается при подаче данных
(без прошивки можно проверить логическим анализатором/генератором).

### 2.2 DECK-PAD

- **18 × 12×12×5** (THT) — матрица 3×6 на MCP23017 (0x20): строки — выходы (активный
  низкий), столбцы — входы с внешними 10 кΩ pull-up (`R21…R26`). Антидребезг — в прошивке.
- **18 × WS2812B-2020** на +5 В, цепочка после `LED_IN`.
- **2 слайдера 30 мм 10 кΩ** → `SL1_RAW`/`SL2_RAW`; RC 1 кΩ + 100 нФ стоят на PANEL-1.
- **DECK_ID**: делитель **33k/3.3k** → **0.30 В** (допуск ±0.15 В).
- **FSR-опция**: 18 мест + 2 × 74HC4067 (`U2`, `U3`), 18 × 10 кΩ pull-up, выход `FSR`
  на pin 15 J-DECK → MCP3208 CH6. Без FSR — не паять мультиплексоры и плёнки.
- **IDC-16** — ответная часть в правом заднем углу; INT MCP23017 → `DECK_INT` (pin 5).

### 2.3 DECK-KEYS

- **42 × Kailh Choc hot-swap** + **42 × 1N4148** (матрица 6×7): анод диода = клавиша,
  катод = столбец; столбцы — с 10 кΩ pull-up, строки — выходы MCP23017 (0x20).
- **42 × SK6812MINI-E** на +5 В, своя цепочка после `LED_IN` (итого 9 + 42 = 51 LED).
- **DECK_ID**: делитель **3.3k/33k** → **3.00 В** (допуск ±0.15 В).
- 2 слайдера и 2 индикатора режима (`LED_MODE1/2` на GPA7/GPB7).
- Гнёзда Choc — SMD hot-swap; footprint в стоковой библиотеке KiCad отсутствует, при
  разводке платы нарисовать (CPG1350). Колпачки — печать (см. §4).

Смена деки: шлейф отключается **на стороне деки**, разъём на PANEL-1 не тянуть
(`mechanical/assembly.md` §8). Прошивка сама определяет тип по `DECK_ID`.

---

## 3. Аналоговые модули и калибровка 1 В/окт

Общее: [`hardware/modules/README.md`](../hardware/modules/README.md),
расчёты: [`Calc.md`](../hardware/modules/Calc.md), доступность/замены:
[`availability.md`](../hardware/modules/availability.md), чертёж картриджа:
[`CARTRIDGE.md`](../hardware/modules/CARTRIDGE.md), BOM: [`BOM-modules.csv`](../hardware/modules/BOM-modules.csv).
ERC 5/5 = 0 ошибок.

### 3.1 Общий порядок сборки картриджа

1. Шина: вилка IDC-26 (2×13) на длинной стороне; шлейф ≤15 см.
2. Сначала панельки DIP (AS3340/AS3320/LM13700/TL074/TL072/TL431/24C02), потом пассив,
   в конце — разъём и гребёнки (PROTO-1).
3. Развязка: 10 мкФ + 100 нФ на каждый рельс; C0G/NP0 — только там, где указано
   (тайминг VCO, интеграторы SVF, лестница); электролиты — 25 В.
4. **Проверка до установки ИС:** подайте питание с шины (или от БП через IDC-26):
   +12/−12/+5/+3.3 без ИС, ток каждой шины ≤5 мА; затем ставьте ОУ и спецИС.
5. EEPROM 24C02: адрес = 0x50 + порт, перемычки JP1…JP3 в положении 1-2 = 0, 2-3 = 1.
   PORT0 → 0x50, PORT1 → 0x51, PORT2 → 0x52. Дескриптор: `kind` = 1 VCO, 2 FILTER,
   7 LADDER, 8 ENSEMBLE, 0xFF PROTO.

### 3.2 VCO-1 (AS3340)

- CV-сумматор на TL074 + инвертор TL072, Rвх = Rос = 100 кΩ → **−10 мкА на 1 В CV**
  (AS3340: 1 В/окт, 100 кΩ на вольт).
- Опорное октав: TL431 (2.495 В) → делитель **20k/30k → 1.000 В**; токи смещения
  10.0 / 20.0 / 30.1 мкА для ×1/×2/×3 (резисторы 100k / 49.9k / 33.2k, 0.1%).
- **C1 = 1 нФ C0G** (pin 11) — обязательно NP0, X7R недопустим (дрейф).
- **RT1 = 1 кΩ 3300 ppm/K** между pin 1 и −12 В (термокомпенсация; у AS3340A допустимо
  1 кΩ 1% в неответственных сборках).
- Буфер выхода TL074: K = 1 + 10k/40.2k = 1.249 → ±5.0 В на `AUD_OUT`; подстройка RV5.
- Ток модуля: +12/−12 ≈20.4 мА, +5 ≈2.2 мА, +3.3 ≈1 мА — в лимитах шины с запасом ≥2×.

### 3.3 FILTER-1 (LM13700, SVF 12 дБ/окт)

- Два интегратора (OTA + TL074), LP/BP/HP, экспоненциальный срез (1 В/окт при 100 кΩ/В).
- Подстройка: **RV1** — резонанс, **R19** — точный 1 В/окт.
- Особенность: в текущем номинале RV1 = 1 МΩ Q ≈ 10 — сильный резонанс, но без
  самоосцилляции; для генерации уменьшить R3 до 1 кΩ (опция, см. README модулей).

### 3.4 LADDER-1 (AS3320, DIP-18)

- 4-полюсная лестница «как у Муга»: CV cutoff, резонанс, drive, LP/HP.
- AS3320 — дефицит: при недоступности — дискретная лестница на согласованных парах
  BCM847/SSM2212 (4 пары) + OTA; это другой BOM и другая подстройка, см.
  [`availability.md`](../hardware/modules/availability.md).
- Подстройка 1 В/окт — тем же способом, что VCO (п. 3.6), триммером шкалы.

### 3.5 ENSEMBLE-1 (v0.9, PT2399-вариант)

- Реализация: **2 × PT2399 + TL074 + CD4053**, LFO-модуляция задержки, формантный RC-фильтр,
  bypass. **BBD-вариант (MN3007/MN3207 + MN3102) не разведён** — только макет.
- Схема уровня v0.9: обвязка PT2399 и формантный каскад требуют макетирования.
  Порядок: собрать один PT2399-канал на макетке, проверить диапазон задержки и шум,
  затем второй канал и LFO; только после этого — плата.
- «1 В/окт» к ENSEMBLE не относится (эффект, не VCO): калибровка — по слуху/осциллографу
  (глубина модуляции, отсутствие клиппинга, баланс сухого/влажного).

### 3.6 Калибровка 1 В/окт (общая процедура)

Нужны: стабильный источник CV с шагом 1.000 В (CV OUT ядра после калибровки §6 или
лабораторный БП), частотомер/тюнер (или осциллограф + счётчик), мультиметр 4.5 знака,
прогрев 15 минут.

1. Подайте CV = 0.000 В. Триммером шкалы (**RV3** у VCO) выставьте базовую частоту
   32.7 Гц (C1) — по [`Calc.md`](../hardware/modules/Calc.md) §1.2.
2. CV = 1.000 В → ожидается 65.4 Гц; CV = 2.000 В → 130.8 Гц. Если ошибка растёт
   линейно — подстраивайте шкалу (RV3), если «расходится» к верхам — **RV4** (ВЧ-трекинг).
3. Прогон по октавам 0…8 В: отклонение в центах `1200·log2(f_изм/f_ожид)`.
   Цель — **≤ ±3 цента** на всём диапазоне (для 1 В/окт).
4. RV5 — амплитуда `AUD_OUT` ±5.0 В (осциллограф, синус/пила на выходе).
5. Повторите после 30 минут прогрева — уплывание не должно превышать ±2 цента.
6. Запишите результат в паспорт модуля (дата, температура, отклонения).

> Точность 1 В/окт зависит от резисторов 0.1% и C0G; при замене на 1% ждите
> разброс в несколько центов — это нормально для DIY и корректируется в прошивке
> (CV→параметр: 1V/oct с квантованием, `spec/40-firmware.md` §5).

---

## 4. Печать и сборка корпуса

Файлы: [`mechanical/prints.md`](../mechanical/prints.md) (карта печати),
[`assembly.md`](../mechanical/assembly.md) (порядок сборки),
[`fit_check.md`](../mechanical/fit_check.md) (проверка коллизий: 51 строка, 0 конфликтов),
[`README.md`](../mechanical/README.md) (отклонения от spec), STL — [`mechanical/stl_v05_A/`](../mechanical/stl_v05_A/),
рендеры — [`preview_v05_B_light/iso_top.jpg`](../mechanical/preview_v05_B_light/iso_top.jpg),
[`preview_v05_B_light/exploded.jpg`](../mechanical/preview_v05_B_light/exploded.jpg),
[`preview_v05_B_light/front_panel.jpg`](../mechanical/preview_v05_B_light/front_panel.jpg).

### 4.1 Печать

- Сначала **`test_fit/test_cross.stl`** (шип 6×3 + паз 0.25 + бобышка Ø4.6×6.0 + Ø3.3):
  втулка входит «туго, но до упора», шип — от руки. Не сошлось — правьте `FIT` в
  `mechanical/generator/params.py` и перегенерируйте STL.
- Комплект: **20 STL**, ≈281 г пластика (PETG 145 г, PLA 74 г, TPU 24 г + прозрачные),
  **≈18.7 ч** печати (с браком 20–22 ч), **без поддержек**.
- Режимы: PETG 240/80 °C, PLA 210/60 °C, TPU 225/40 °C (20–25 мм/с, ретракт 3 мм);
  сопло 0.4, слой 0.2, 3 периметра, 25% заполнения.
- Прозрачные детали (ручки, световоды) — 100% заполнения, слой 0.12–0.16.

### 4.2 Сборка (порядок из `assembly.md`)

1. Снять заусенцы, пройти M3 сверлом 3.3, M2.5 — 2.7. Запрессовать **24 термовтулки M3**
   паяльником 260 °C (bottom_L 13, bottom_R 11), заподлицо, с внутренней стороны.
2. Скорлупа: 2 шпонки `seam_key`, стяжка 4 × M3×16 через брюхо, щуп 0.1 мм не проходит.
3. **CORE-1 на 4 стойки (Z 16), 4 × M3×6**; **PANEL-1 на 6 стоек (Z 37), 6 × M3×6**;
   шлейф IDC-32 вдоль левой стенки, IDC-26 в брюхо через окно 200×60.
4. Экран — 4 × M2.5×6 к панельной пластине **до** её установки.
5. Панельные пластины: 8 × M3×8 потай; 8 ручек, 4 плечевых колпачка, 9 световодов.
6. Дека: пластина + PCB + 2 слайдера (4 × M2.5×8) + колпачки; 4 × M3×8 потай
   в точках (88/125/190/227, 138).
7. Задняя панель L/R — 6 × M3×10; крышка брюха — 4 × M3×8; док-скоба — 2 × M3×8.
8. Накладки TPU на VHB; проверить: ручки без задевания, колпачки без закусывания,
   слайдеры — полный ход 30 мм, шлейфы не пережаты, корпус не качается.

**Согласовать с PCB при разводке (из `fit_check.md` §4):**
- PANEL-1 300×132 и DECK 290×78 на одном Z = 37 → в PANEL-1 нужен **вырез 290×78**;
- 4 стойки панельных пластин и 4 стойки DECK проходят сквозь PANEL-1 (Ø6.2) — учесть;
- **решено:** 2 стойки слайдеров (Y = 94) проходят через зону CORE-1 → в плате CORE-1
  предусмотрены 2 выреза Ø6.4 (spec/20 §8a); вариант «2 отв. Ø6.4
  в CORE-1, либо перенос слайдеров;
- колпачки KEYS ставятся **над** пластиной (окно 14.2 — окно гнезда Choc), высота клавиш
  выше номинала `spec/30` §1 — это осознанное решение.

---

## 5. Прошивка и первый запуск

Файлы: [`firmware/README.md`](../firmware/README.md),
[`firmware/Bukifon/platformio.ini`](../firmware/Bukifon/platformio.ini),
[`firmware/host/Makefile`](../firmware/host/Makefile),
[`firmware/tests/run_tests.sh`](../firmware/tests/run_tests.sh),
результаты — `firmware/tests/out/` ([`fft_metrics.json`](../firmware/tests/out/fft_metrics.json)).
`firmware/tests/REPORT.md` — **в работе** (Lead: появится отдельно); ориентируйтесь на README.

### 5.1 Host-сборка (уже проверена, числа из README/`fft_metrics.json`)

```bash
make -C firmware/host test        # сборка + unit-тесты
firmware/tests/run_tests.sh       # build + tests + WAV + FFT-отчёт
```

Подтверждено host-прогоном: **67 тестов, 0 падений**; A4 = 440.0000 Гц (0.0000%);
алиасинг −68.6 дБ (лимит −60); 8/8 голосов; ADSR 961/960 samples (+0.10%);
5.00 с / 48 кГц / 16 бит stereo, 0 клипов; 8 FM-алгоритмов без субгармоник;
лестница при resonance 100% и 16-слотовая матрица с обратными связями стабильны.
WAV и метрики — в `firmware/tests/out/`.

### 5.2 Сборка под RP2040

```bash
pio run -d firmware/Bukifon              # сборка
pio run -d firmware/Bukifon -t upload    # прошивка
# либо: firmware/tools/build_pico.sh
```

**Честно:** в среде разработки RP2040-прошивка **не компилировалась** (PlatformIO
не смог писать `~/.platformio` в песочнице — см. `firmware/README.md` §«Build status»);
скетч, `platformio.ini` (`env:pico`, arduino-pico) и HAL-драйверы подготовлены.
На обычной машине выполните команды выше и зафиксируйте результат в `tests/REPORT.md`.

### 5.3 Первый запуск (ожидаемое поведение по спецификации)

Подать 12 В → Pico стартует. Ожидается (проверять по экрану/звуку после прошивки):

1. Заставка и страница 1 OSC; энкодеры листают параметры, нажатие — сброс.
2. Автоопределение деки по `DECK_ID`: PAD (0.30 В) / KEYS (3.00 В); в SYSTEM — тип деки.
3. LED-цепочка: 9 + 18 (PAD) или 9 + 42 (KEYS) = 27/51 LED, без «пропусков».
4. Сканирование 3 портов шины по I2C: модули с EEPROM 0x50…0x52 появляются в MODULES;
   без EEPROM порт показывается «пусто», аудио не блокируется.
5. Звук на LINE OUT, MIDI USB определяется, TRS MIDI обменивается Note On/Off.

Пока прошивка не прошита в железо, все пункты — **контракт**, а не подтверждённый факт.

---

## 6. Калибровка CV и DECK_ID

### 6.1 CV-выходы (DAC)

1. Ручной режим/меню калибровки (по `spec/40-firmware.md` §5 — 4 точки на канал).
2. Измерьте CV OUT 1/2 (джеки) и CV1…CV4 на шине (контакты 9/11/13/15 IDC-26)
   при кодах 0/25/50/100% диапазона. Ожидаемо 0…10.04 В (буфер ×4.9).
3. Введите измеренные значения в калибровку — коэффициенты пишутся в 24C32 (**0x57**)
   и сохраняются после выключения.
4. Проверка: шаг 1 В/окт на CV OUT, погрешность ≤ ±5 мВ на точку (после калибровки);
   при разбросе — заменить Rf 39k на 38.3k (см. `hardware/core/README.md` §5.9).

### 6.2 CV-входы (ADC)

Формула тракта: `Vadc = 1.65 − 0.165·Vin`; ожидаемый код MCP3208:
`code = Vadc / 3.3 · 4096`. Подайте **0 / +5 / +10 / −10 В**:

| Vin, В | Vadc, В | Ожидаемый код (≈) |
|---:|---:|---:|
| +10 | 0.00 | 0 |
| +5 | 0.825 | 1024 |
| 0 | 1.650 | 2048 |
| −10 | 3.30 | 4096 |

Калибровка: 2 точки на канал (по спецификации) с записью в EEPROM. Допуск после
калибровки — ±1% полной шкалы; сдвиг/усиление правятся в прошивке.

### 6.3 DECK_ID

Измерьте на **J-DECK pin 13** (или на делителе деки) относительно GND:

| Дека | Делитель | Ожидаемое | Допуск |
|---|---|---:|---:|
| DECK-PAD | 33k / 3.3k | **0.30 В** | ±0.15 В |
| DECK-KEYS | 3.3k / 33k | **3.00 В** | ±0.15 В |

Не сходится — проверьте пары резисторов и пайку; прошивка различает деки по порогам
0…0.5 В / 2.8…3.3 В (`spec/40-firmware.md` §4).

### 6.4 EEPROM модулей

Адрес 0x50 + порт; первые 32 байта — дескриптор (`magic 'PMOD'`, transport, kind,
params, version, name, CV-маршруты, ток, CRC16). Утилита записи — в `firmware/`
(по `spec/40-firmware.md` §8); на дату документа запись дескриптора в железе не
подтверждена — считать «ожидается».

---

## 7. Диагностика: симптом → причина → решение

| Симптом | Вероятная причина | Решение |
|---|---|---|
| Нет +3.3 В | AP2112K, пайка LDO; КЗ по 3.3 В | проверить вход/выход LDO, ток 3.3 В, пайку SOT-23-5 |
| +5 В «проседает» под нагрузкой | MP1584, дроссель/делитель ОС | пересчитать делитель под 5.1 В, проверить индуктивность и диод |
| −12 В не запускается/плывёт | MC34063 (инвертор, «плавающая» земля) | проверить pin 4 = −12 В, делитель 33k/3.9k, D3 SS34, L 220 мкГн |
| Ток покоя >100 мА без ИС | КЗ, переполюсовка | прозвонка рельсов, искать нагрев (тепловизор/палец) |
| Pico не определяется по USB | кастеляция, BOOTSEL | пропаять все 40 выводов, зажать BOOTSEL, другой кабель |
| I2C не видит MCP4728 | адрес A0/A1, нет подтяжек | заказать MCP4728A0 (0x60) и A1 (0x61); 4.7 кΩ на SDA/SCL |
| Экран белый/чёрный | распиновка 1×14, RST/DC/BL | сверить J-LCD, проверить Q1 2N7002 и R301/R302, 3.3 В |
| Подсветка не регулируется | ключ стоит дважды (PANEL Q1 + CORE Q3) | оставить один ключ, второй не запаивать |
| WS2812 не светится после N-го | направление данных, питание 5 В | проверить DOUT→DIN, +5 В на pin 16 J-DECK, первый LED |
| WS2812 «мигает»/греется | 3.3 В данные на 5 В ленте | буфер 74HCT1G125 на панели, ограничить яркость ≤10 мА/ LED |
| Энкодеры «дребезжат»/пропуски | RC-цепи, подтяжки | 10 кΩ + 100 нФ на фазах, 10 кΩ на кнопку, проверить пайку |
| Пэды/клавиши залипают | матрица, диоды, pull-up | строки активный низкий, 10 кΩ столбцы, диоды 1N4148 (KEYS) |
| Дека не определяется | DECK_ID | измерить 0.30/3.00 В, проверить делители и pin 13 J-DECK |
| Нет звука | PCM5102A/сумматор/MASTER VOL | I2S GP16/17/18, 5 В/3.3 В на ЦАП, 10 мкФ, VOL, TL074 |
| Фон 50 Гц | земляная петля, «звезда» | NT1/NT2 в одной точке, экранирование, питание LED отдельно |
| CV «не в строю» | 1 В/окт, термостабильность | прогрев, RV3/RV4, C0G 1 нФ, RT1 3300 ppm |
| Модуль не виден в MODULES | EEPROM/адрес/CRC | JP1…JP3 (0x50…0x52), дескриптор, CRC16, подтяжки только на CORE |
| Порт «пусто», но звук идёт | нет EEPROM | штатное поведение: порт пуст, аудио не блокируется |
| Треск/клиппинг на 8 голосах | уровень сумматора | MASTER VOL, Rf 22k, мягкий лимитер в прошивке |

---

## 8. Технические средства (ТС) и оснастка

| Средство | Зачем | Где в BOM |
|---|---|---|
| Паяльная станция 300–350 °C + фен | SMD 0603/0805, SOIC, Pico на кастеляцию | вне BOM (инструмент) |
| Мультиметр 4.5 знака | рельсы, CV, DECK_ID | вне BOM |
| Лабораторный БП с ограничением тока | первый запуск, проверка рельсов | вне BOM |
| Осциллограф + частотомер/тюнер | 1 В/окт, амплитуда ±5 В, пульсации | вне BOM |
| Логический анализатор (опц.) | SPI/I2C, LED-цепочка | вне BOM |
| 3D-принтер 220×220, сопло 0.4 | 20 STL | вне BOM |
| Паяльник для втулок / пресс | 24 термовтулки M3 | вне BOM |
| Припой, флюс, изопропанол | монтаж, отмывка | `R-01`, `R-02` |
| Крепёж M3 + термовтулки 4.6×6.0 | корпус | `M-03`, `M-04` |
| Шлейфы IDC-16/26/32, USB | соединения, прошивка | `K-01`, `K-02` |
| PlatformIO / arduino-cli | прошивка RP2040 | вне BOM |

---

## 9. Сверка сводного BOM с BOM плат (расхождения)

Сводный [`BOM.csv`](../BOM.csv) — 97 агрегированных позиций с ценами и вариантами
«бюджет/оптимум»; локальные BOM плат не содержат цен (`hardware/core/BOM-core.csv` —
внутренние коды `PM-CORE-NNN`, MPN только у двух MCP4728). **Количество закупать по
платам, деньги считать по сводному.**

| Позиция | Сводный BOM | BOM плат (CORE 122 / PANEL 43 / MODULES 173 поз.) | Δ | Действие |
|---|---:|---:|---:|---|
| MCP4728 | 1 | **2** (A0 0x60 + A1 0x61) | **+1** | заказать два варианта; критично для адресов |
| SS34 | 2 | 3 (D1, D3, D4) | +1 | добавить 1 |
| BAT54S | 8 | **18** (CORE 11 + модули 7) | **+10** | докупить 10 |
| TL074 | 4 (C-08 ×2 + A-03 ×2) | **8** (CORE 4 + модули 4) | **+4** | докупить 4 |
| TL072 | 2 (C-09 + A-04) | 3 (CORE 1 + модули 2) | +1 | докупить 1 |
| 24C02 | 3 (A-05) | **5** (по одному на модуль) | **+2** | докупить 2 |
| TL431 | 0 | 1 (VCO-1) | **+1** | добавить в закупку |
| 74HCT1G125 | 0 | 1 (буфер LED на PANEL-1) | **+1** | добавить (не путать с 74HCT125 MIDI) |
| 2N7002 | 1 | 2 места (CORE Q3 + PANEL Q1) | 0 | **запаять один**, второй не ставить |
| PT2399 | 2 (E-03, альтернатива BBD) | **2** (ENSEMBLE-1) | 0 | BBD-вариант (MN3007/MN3207/MN3102) **не покупать**, если PT2399 |
| 74HC4053 / CD4053 | 1 | 1 | 0 | допустимая замена |
| 74HC165, WS2812B, SK6812, 1N4148, EC11 | 6 / 27 / 42 / 42 / 8 | 6 / 27 / 42 / 42 / 8 | 0 | совпадает |
| MCP23017 | 2 (на две деки) | 2 (PAD + KEYS) | 0 | на одну деку — 1 |
| AS3340 / AS3320 / LM13700 / 6N137 / MCP3208 / PCM5102A / 24C32 | 1 каждого | 1 каждого | 0 | 24C32 — адрес 0x57 |
| Винты M2.5 | 0 | 8 (4 × M2.5×6 экран + 4 × M2.5×8 слайдеры) | **+8** | докупить M2.5 |
| Винты M3 | набор | 10×M3×6, 12×M3×8 потай, 2×M3×8 полукруг, 6×M3×10, 4×M3×16 | уточнить | в наборе M-03 может не быть M3×16/M3×10 |
| Термовтулки M3 | 100 шт (M-04) | 24 шт нужны | избыток | можно взять 25–30 шт |
| Печатные платы | 6 конструкций (B-01) + 3 (B-02) | фактически 8 файлов схем: CORE, PANEL, 2 деки, 5 модулей | **+** | B-01/B-02 в BOM.md устарели: модулей теперь 5 |

**Итог:** сводный BOM требует правки перед закупкой: **+1 MCP4728 (A1), +10 BAT54S,
+4 TL074, +1 TL072, +2 24C02, +1 TL431, +1 74HCT1G125, +1 SS34, +8 винтов M2.5**,
уточнить M3×16/M3×10 и число PCB (9 схем, не 8). Также обновить `docs/BOM.md` §1
по CV-контракту v1.1 (6 CV-выходов, 2 × MCP4728) — сейчас там указан один ЦАП.

---

## 10. Чек-лист готовности

**Электрика**
- [ ] 4 рельса в допуске, токи в лимитах, пульсации ≤20 мВ.
- [ ] I2C: 0x57 + 0x60 + 0x61; SPI MCP3208; 6 × 74HC165 читаются.
- [ ] Экран, подсветка (ШИМ), 8 энкодеров, 4 плечевых — работают.
- [ ] LED-цепочка 27 (PAD) / 51 (KEYS) без пропусков, яркость ≤10 мА/LED.
- [ ] Слайдеры/FSR/дека определяются, матрицы без залипаний.

**Калибровка**
- [ ] CV OUT 0…10 В, 1 В/окт, 4 точки в 24C32, сохраняется после выключения.
- [ ] CV IN ±10 В: коды по таблице §6.2, допуск ±1%.
- [ ] DECK_ID: 0.30 / 3.00 В ±0.15.
- [ ] VCO/FILTER: 1 В/окт ≤ ±3 цента на 0…8 В, амплитуда ±5 В.
- [ ] Модули видны по EEPROM (0x50…0x52), дескриптор с CRC.

**Механика**
- [ ] Тест-крест сошёлся; 20 STL напечатаны без поддержек, 24 втулки запрессованы.
- [ ] Корпус собран по `assembly.md`, щупа 0.1 мм нет на шве, ручки/колпачки без задеваний.
- [ ] Масса ≤700 г, корпус стоит на ножках, шлейфы не пережаты.
- [ ] Учтены вырезы плат из `spec/20 §8a` (PANEL-1 под DECK, 2 отв. Ø6.4 в CORE-1, стойки деки).

**Прошивка**
- [ ] `make -C firmware/host test` — 67/67; FFT: A4 440.0000 Гц, алиасинг ≤ −60 дБ.
- [ ] `pio run -d firmware/Bukifon` собирается на обычной машине; результат — в REPORT.md.
- [ ] Первый запуск: экран, деки, модули, звук, MIDI USB + TRS.
- [ ] Пресеты 64 шт, калибровки сохраняются, часы/счётчик в 24C32.

**Документация и закупка**
- [ ] BOM сверен с платами, расхождения §9 внесены в `BOM.csv`/`BOM.md`.
- [ ] PCB разведены и заказаны (пока не готово — следующий этап).
- [ ] Лицензии: `NOTICE`, файлы лицензий в корне (см. [`docs/09-licensing.md`](09-licensing.md) §10).

---

## 11. Ссылки на артефакты

| Что | Файлы |
|---|---|
| CORE-1 | [README](../hardware/core/README.md) · [PDF](../hardware/core/CORE-1.pdf) · [SVG](../hardware/core/svg/CORE-1.svg.gz) · [netlist](../hardware/core/netlist.net) · [BOM](../hardware/core/BOM-core.csv) · [джек-карта](../hardware/core/wiring-jacks.md) · [ERC](../hardware/core/erc/erc.rpt) · [блок-схема](../hardware/core/CORE-1-blocks.png) |
| PANEL-1 / деки | [README](../hardware/panel/README.md) · [PDF PANEL](../hardware/panel/panel-1/panel-1.pdf) · [PDF PAD](../hardware/panel/deck-pad/deck-pad.pdf) · [PDF KEYS](../hardware/panel/deck-keys/deck-keys.pdf) · [матрицы](../hardware/panel/matrix-tables.md) · [координаты](../hardware/panel/coords-panel.csv) · [BOM](../hardware/panel/BOM-panel.csv) |
| Модули | [README](../hardware/modules/README.md) · [расчёты](../hardware/modules/Calc.md) · [доступность](../hardware/modules/availability.md) · [картридж](../hardware/modules/CARTRIDGE.md) · [BOM](../hardware/modules/BOM-modules.csv) · PDF: [VCO](../hardware/modules/pdf/MOD-VCO-1.pdf), [FILTER](../hardware/modules/pdf/MOD-FILTER-1.pdf), [LADDER](../hardware/modules/pdf/MOD-LADDER-1.pdf), [ENSEMBLE](../hardware/modules/pdf/MOD-ENSEMBLE-1.pdf), [PROTO](../hardware/modules/pdf/MOD-PROTO-1.pdf) |
| Механика | [README](../mechanical/README.md) · [печать](../mechanical/prints.md) · [сборка](../mechanical/assembly.md) · [fit-check](../mechanical/fit_check.md) · [STL](../mechanical/stl/) · [рендеры](../mechanical/preview_v05_B_light/) |
| Прошивка | [README](../firmware/README.md) · [platformio.ini](../firmware/Bukifon/platformio.ini) · [host Makefile](../firmware/host/Makefile) · [тесты](../firmware/tests/run_tests.sh) · [метрики](../firmware/tests/out/fft_metrics.json) |
| Документы | [BOM](BOM.md) · [обзор](00-overview.md) · [quickstart](01-quickstart.md) · [лицензии](09-licensing.md) |
| Спецификация | [vision](../spec/00-vision.md) · [panel-ui](../spec/10-panel-ui.md) · [electronics](../spec/20-electronics.md) · [mechanics](../spec/30-mechanics.md) · [firmware](../spec/40-firmware.md) |
