martiyanov/bukifon/docs/34-assembly.md

# Сборка Букифона v0.5-B-light (S3-base) — пошаговый гайд

Версия: корпус **v0.5-B-light** (клин 8°, 228.9 г / 11.0 ч), ядро **CORE-S3 rev.0**,
панель **PANEL-2 rev.2**, питание **PWR-2 rev.1**, дисплей 5″ 800×480.
Сборочная карта: [`renders/templates/bukifon_assembly_map_1to1.pdf`](../renders/templates/bukifon_assembly_map_1to1.pdf)
(4 стр.); 3D-вид: [`mechanical/preview_v05_B_light/assembly_exploded.jpg`](../mechanical/preview_v05_B_light/assembly_exploded.jpg);
печать: [`mechanical/prints.md`](../mechanical/prints.md); что печатать первым:
[`docs/35-print-first.md`](35-print-first.md).

## 0. Порядок и почему он такой

**Физический порядок (принят):**
корпус → PANEL-2 → PWR-2 → CORE-S3 → дисплей → шлейфы → панель → энкодеры/клавиши/
джеки/фейдеры → прошивка → калибровка.

Порядок из ТЗ («корпус → панель → энкодеры…») переставить нельзя: **панель закрывает
доступ к стойкам PANEL-2, CORE-S3/PWR-2 и к дисплею** — их ставят до панели. Энкодеры,
клавиши, джеки и фейдеры, наоборот, ставятся **после** панели (гайки/колпачки сверху).
На сборочной карте слои пронумерованы снизу вверх 1→7; эта инструкция им соответствует.

## 1. Что нужно

**Инструмент:** крестовая отвёртка PH0/PH1, ключ/шестигранник 2 мм, пинцет, кусачки,
ESD-браслет (обязательно), мультиметр, штангенциркуль, изопропанол, липкая лента.
**Крепёж** (см. стр.4 карты): 4×M3×8 потай (панель), 6×M3×6 (PANEL-2), 4×M3×6
(CORE-S3), 4×M2.5×6 (дисплей), 8×M2.5×8 (фейдеры), опционально 4×M3×16 (стяжка
половин корпуса). Термовтулки M3 — если стойки без готовой резьбы (по проекту —
отверстия под термовтулки Ø4.0; проверьте партию).
**Шлейфы:** FFC-40 (LCD), IDC-26 (J14), IDC-16 (J13), IDC-20 (J17, питание),
IDC-12 (J18, управление); опционально IDC-26-шина P0/P1/P2.

## 2. Подготовка (10 мин)

1. Разложить детали по слоям, сверить с картой (стр.1): body_L, body_R, panel_L,
   panel_R, foot ×4, keycap ×42.
2. Обезжирить посадочные плоскости (изопропанол), удалить остатки поддержек
   (их быть не должно — профиль печати без поддержек).
3. Надеть ESD-браслет на голое тело/заземление, работать на антистатическом коврике.
4. **Ничего не подключать к питанию** до раздела 9.

## 3. Корпус (15 мин)

1. Вклеить/вставить 4 ножки TPU `foot` в гнёзда Ø13 в дне (изнутри, клеем для TPU
   или на трении — гнездо на 0.1 мм меньше).
2. Соединить body_L + body_R по X=190: торцы должны сойтись без ступеньки (допуск
   ≤0.2 мм). Шов держится шипом/пазом панели и 4×M3×16 (опция); **клей по шву не
   наносить**, пока не проверена электроника — корпус должен разбираться.
3. Проверить дно на стекле: качания не более 0.3 мм; при необходимости — подшкурить
   ножки.

## 4. PANEL-2 rev.2 (15 мин)

1. Уложить PANEL-2 (360×190, параллельно панели) на 6 стоек; верх стоек = 8 мм ниже
   панели. Совместить отверстия; **не притягивать винтами до проверки панели**.
2. 6×M3×6 — затягивать крест-накрест, 0.3–0.4 Н·м, без фанатизма (PETG течёт).
3. Подключить к PANEL-2 шлейфы J12 (FFC-40 — ЖК), J13 (IDC-16), J14 (IDC-26) —
   но пока **не** к CORE-S3 (сначала PWR-2/CORE-S3).
4. На PANEL-2 стоят 42 hot-swap-сокета, 16 EC11 (по факту — на панели), MCP23017
   (0x20–0x23), 10 джеков, 2 фейдера, WS2812B — проверить отсутствие заусенцев на
   разъёмах.

## 5. PWR-2 rev.1 (10 мин)

1. Установить PWR-2 (90×70) на 4 стойки Z6, 4×M2.5 — 0.2–0.25 Н·м.
2. **Батарею пока не ставить!** Сначала проверка без банок: подать внешние 12 В на
   разъём БП, измерить +5 В / +3V3 на тестовых точках, ток ХХ ≤50 мА.
3. Проверить полярность разъёма батареи: плюс — красный (BAT+), минус — чёрный;
   переполюсовка 18650 = КЗ и пожар. BMS — на PWR-2, NTC приклеить к банкам.
4. **±12 В** — только после проверки +5/+3V3; нагрузить 10 мА, проверить ±11.4…12.6 В.

## 6. CORE-S3 rev.0 (10 мин)

1. Уложить CORE-S3 (200×108) на 4 стойки Z12, 4×M3×6 — 0.3–0.4 Н·м.
2. Подключить J17 (IDC-20) ↔ PWR-2 J3, J18 (IDC-12) ↔ PWR-2 J4.
3. Подключить PANEL-2 J14 IDC-26 ↔ CORE-S3 J14, J13 IDC-16 ↔ J16.
4. **USB-C на CORE-S3** — проверка питания от кабеля (без батареи) до вставки
   дисплея и панели.

## 7. Дисплей 5″ (10 мин)

1. 4×M2.5×6 — дисплей к обратной стороне панели (снизу), стекло в окно 108×64.8
   (центр 190; 58.7), буртик 1.5 мм.
2. FFC-40: вставить в J15 (CORE-S3) и J12 (PANEL-2), **ключ-ориентация** — контакты
   к плате, замок закрыть до щелчка; перекос = нет изображения/КЗ.
3. Проверить, что шлейф не пережат стойкой PANEL-2 и не касается вентилятора/динамика.

## 8. Панель и органы управления (25 мин)

1. Уложить панель (panel_L 193 + panel_R 190 с шипом/пазом) на корпус: шип 3×1.2
   входит в паз, шов совпадает с X=190, задняя кромка 61.5 мм, передняя 32.0 мм.
2. 4×M3×8 потай по углам (9/9, 371/9, 9/201, 371/201) — **затягивать по нормали
   панели (8°)**, 0.4 Н·м, ключ с шаровым наконечником.
3. Энкодеры (16 EC11): вставить в окна, затянуть гайки Ø14.4 (не перетягивать —
   треснет 3-мм панель), поставить ручки Ø14×15 с фиксацией на D-вал.
4. Клавиши: 42 Choc v1 hot-swap в сокеты PANEL-2 (ответные пины через панель),
   колпачки keycap_v17 17.5×16.5 — до щелчка, не с усилием.
5. Джеки 3.5 мм: 10 шт, гайки Ø8.2 — 0.15 Н·м; фейдеры: 2 шт, 8×M2.5×8.
6. Проверить зазоры: клавиши не задевают панель, энкодеры не перекашиваются,
   фейдеры ходят без заеданий.

## 9. Прошивка (15 мин)

1. Подключить USB-C к компьютеру; драйвер CDC — порт `ttyACM*`/`COM*`.
2. Прошить S3-base: `idf.py -p <port> flash monitor` (или готовый .bin через
   `esptool`). Убедиться, что DECK_ID читается, PSRAM 8 МБ определяется.
3. Проверить I2C: PANEL-2 MCP23017 должны ответить на 0x20–0x23 (i2c-scan в консоли).
4. Проверить экран: тест RGB565, все три цвета заливки, отсутствие инверсии.

## 10. Калибровка (20 мин)

1. Энкодеры: прогнать 0…1023, проверить отсутствие пропусков/дребезга.
2. Фейдеры: калибровка крайних положений (ADC min/max), проверить плавность.
3. CV: 0 / +5 / +10 В по выходу CV OUT, погрешность ≤1 %, шум ≤5 мВ; CV IN —
   проверить делитель.
4. Батарея (опция): вставить 2×18650 с одинаковым напряжением (±0.05 В), проверить
   заряд/разряд, ток заряда ≤1 А, температуру банок ≤40 °C; **NTC подключить**.
5. Финальный прогон 30 мин под нагрузкой (экран + LED 50 % + картридж), проверить
   нагрев PWR-2/CORE-S3 ≤60 °C.

## 11. Чек-лист «перед включением»

- [ ] все 4 слоя плат закреплены, винты не перетянуты и не касаются трасс;
- [ ] шлейфы вставлены до конца, ключи совпали, замки закрыты; нет перекоса и КЗ;
- [ ] полярность 2×18650 и разъёма батареи проверена мультиметром;
- [ ] прозвонка: +5 В, +3V3, ±12 В относительно GND — нет КЗ на корпус;
- [ ] FFC-40 дисплея вставлен (контакты к плате), замок закрыт;
- [ ] нет свободных винтов/стружки внутри корпуса (потрясти);
- [ ] панель встала ровно: 32.0 / 61.5 мм, шов без ступеньки;
- [ ] сначала внешнее питание 12 В, ток ограничен 0.5 А, **без батареи**;
- [ ] ESD-браслет снят после сборки; питание подключать только при собранном корпусе.

## 12. Типовые ошибки

| Ошибка | Симптом | Лечение |
|---|---|---|
| Перевёрнутый FFC-40 | нет изображения, греется шлейф | перевставить, контакты к плате |
| Переполюсовка 18650 | КЗ, дым, срабатывание BMS | заменить банки/проверить BMS; полярность — по маркировке |
| Перетянутые M3 в 3-мм панель | трещины вокруг винтов, «паутина» | 0.4 Н·м; при трещинах — шайба/ремонт втулкой |
| PANEL-2 затянута до панели | клавиши/энкодеры зажаты, ход пропал | ослабить 6×M3, выставить зазор 8 мм |
| Панель поставлена до плат | нет доступа к PANEL-2/дисплею | разобрать: панель снимается 4×M3 |
| Шлейф пережат стойкой | плавающие ошибки I2C/экрана | переложить шлейф, проверить изгиб |
| Перепутаны IDC-26 и IDC-16 | нет аналога/цифры | разъёмы подписаны; проверить pinmap |
| Батарея стоит при первом включении | бросок тока, «кирпич» | первое включение — только от БП/12 В |

## 13. Ссылки

- Сборочная карта 1:1: `renders/templates/bukifon_assembly_map_1to1.pdf` (стр.1 — слои,
  стр.2–3 — панель 1:1, стр.4 — крепёж/шлейфы/чек-лист).
- `docs/21-ergonomics.md`, `hardware/cores3/README.md`, `hardware/panel2/README.md`,
  `hardware/core2/pinmap.md` — размеры/пинауты.
- Печать: `mechanical/prints.md`; первый прогон печати: `docs/35-print-first.md`.

## Микрофон (PANEL-2 rev.3 / CORE-2 rev.3)

1. **Панель**: акустический порт Ø1.8 (122.0, 5.5) — вставить **поролон 1–2 мм** в цековку
   Ø3.4×0.7, сверху **сетку** заподлицо; MEMS (ICS-43434) припаян на PANEL-2 под звуководом.
2. **Звуковод** `mic_guide`: флянцем вниз, канал Ø2–4.5 к порту; низ — на 0.5 мм выше PANEL-2
   (не давить на плату/микрофон).
3. **J16 ↔ J19**: шлейф IDC-6 **1:1** (1 BCK, 2 GND, 3 WS, 4 GND, 5 DATA, 6 +3V3), длина
   ≤150 мм; проверить 3V3 на пине 6 (не на BCK!), TP36/TP39 (панель) и TP31/TP32 (ядро).
4. **Mute-switch SW1** (панель) и **SW3** (ядро): проверить, что выключение разрывает питание
   микрофона, LED гаснет, запись в прошивке блокируется.
5. **3.5 мм jack J20** (задняя панель): bias 2.2 к; при вставленной гусиной шее — MIC_SEL=1
   (прошивка/меню), при line-in — 0. Не вставлять/вынимать под нагрузкой без mute.
6. **Клипса/держатель** (`mic_clip_rear`/`mic_holder_top`): зев 3.6 мм на кромку, гнездо
   Ø6.8; шея 3.5 входит в Ø3.6 без люфта.
7. **Тест** (self-test 21): речь/свист на 30 см, SNR ≥60 дБ, изоляция от WS2812/BL ≤3 дБ,
   задержка ≤5 мс; при провале — проверить сетку/поролон/полярность MIC_SEL.
