martiyanov/bukifon/docs/35-print-first.md

# Что печатать первым — **утверждено заказчиком 06.11.2025 (D-62)**: проверка облегчённого корпуса v0.5-B-light

Цель: до полной печати (~228.9 г / 11.0 ч) проверить, что облегчение (стенки 2.0 мм,
дно 1.8 мм, 3 периметра, 10 % gyroid, локальные рёбра) не убило жёсткость и шов.
Печатать на профиле из [`mechanical/prints.md`](../mechanical/prints.md):
**сопло 0.6, слой 0.30, 3 периметра (4 у винтов/шва), gyroid 10 %**, корпус без поддержек.

## 1. Первая деталь — `body_L.stl` (≈70 г, ≈3.4 ч)

Почему левая: она больше (193 мм с шипом) и содержит шип для шва. Если она выйдет
кривой — правая не нужна.

Приёмка после печати:
1. **Масса/время** — взвесить: ожидаемо **65–75 г** (при 0.6/0.30). Если >80 г —
   проверьте, не включился ли 25 % infill или 2 периметра.
2. **Плоскость дна** — положить на стекло/плитку: качание ≤0.3 мм, дно без «лодки».
3. **Толщина стенок** — штангенциркулем в 3 точках: 1.9–2.1 мм (стенка), дно
   1.7–1.9 мм. Тоньше 1.6 — вернуть параметры.
4. **Жёсткость на кручение** — зажать один угол в тиски/струбцину, к
   противоположному углу подвесить **5 кг** (≈10 Н·м при плече 190 мм): прогиб
   ≤1.5 мм, без белого «хруста» и трещин. Если больше — вернуть стенки 2.2 / дно 2.0.
5. **«Барабан»** — постучать по дну/стенкам: глухой звук ок; звонкий — мало рёбер,
   добавить 2 ребра под экраном/фейдерами.
6. **Мелочи** — нет расслоений, «паутины», стойки целые, резьбовые отверстия под
   термовтулки M3 не заплыли (прогнать метчиком/винтом).

## 2. Вторая деталь — `body_R.stl` (≈70 г, ≈3.4 ч)

Нужна, чтобы проверить **шов** (главный риск облегчения):

1. Сложить body_L + body_R по X=190: ступенька на дне/стенках **≤0.2 мм**, щель
   ≤0.2 мм; прижать струбциной — щель не «гуляет».
2. Проверить **шип/паз панели**: panel_L (шип 3×1.2) входит в паз panel_R без люфта
   и без закусывания (проверить на бумажных 1:1 листах из
   `renders/templates/bukifon_paperkit_1to1.pdf`, если панель ещё не напечатана).
3. Стойки: 4 угловых M3 + 6 стоек PANEL-2 совпадают по высоте (линейка/шаблон);
   панель, положенная сверху, не качается.
4. **Проверка винтами**: 4×M3×8 по углам — входят по нормали 8°, не срывают резьбу;
   6×M3×6 в стойки PANEL-2 — затягиваются на 0.3–0.4 Н·м.

Если шов/стойки ок → печатать комплект. Если ступенька >0.3 мм или панель качается —
правьте параметры (компенсация усадки по X, стенки 2.2) и перепечатайте только
правую половину.

## 3. Третья деталь — `panel_L.stl` (≈35 г, ≈2.3 ч на 0.4/0.20)

Панель — «оболочка»: 3 периметра по контуру/окнам, 1 в поле, 10 % + рёбра.
Проверить:
1. Масса 32–38 г, коробление ≤0.5 мм на 193 мм (положить на стекло).
2. Окна клавиш/энкодеров/джеков: вставить по одному Choc v1 (hot-swap) и EC11 —
   без закусывания; гайка EC11 затягивается, панель не трескается.
3. Жёсткость: нажать на центр панели (≈5 кг) — прогиб ≤1 мм; если больше —
   добавить рёбра-модификаторы или печатать поле 2 периметрами (+~4 г).
4. Шов: панель L + R стыкуются по шипу/пазу, ступенька ≤0.2 мм.

## 4. Дальше — весь комплект

| Порядок | Деталь | Масса | Время |
|---|---|---|---|
| 1 | body_L | ≈70 г | ≈3.4 ч |
| 2 | body_R | ≈70 г | ≈3.4 ч |
| 3 | panel_L | ≈35 г | ≈2.3 ч |
| 4 | panel_R | ≈34 г | ≈2.3 ч |
| 5 | keycap ×42 | ≈18 г | ≈1.2 ч |
| 6 | foot ×4 | ≈0.5 г | ≈0.1 ч |
| | **итого** | **≈228.9 г** | **≈11.0 ч** |

Печатать можно параллельно (2 принтера): body_L+body_R на одном профиле, панели —
на 0.4 мм; колпачки — отдельной партией.

## 5. Критерии «стоп» (не печатать комплект)

- масса половинки >80 г или время >4.5 ч — профиль не тот;
- прогиб при 10 Н·м >2 мм или трещины у стоек;
- ступенька шва >0.3 мм / панель качается;
- окна не принимают Choc/EC11;
- звонкий «барабан» не лечится рёбрами.

Тогда: стенки 2.2 / дно 2.0 (+~20 г, +~1 ч → ≈250 г / 12.1 ч — всё ещё в цели
225–245 г по массе, время в 11–14 ч). Правки — в `mechanical/generator/case_v05_light.py`
(`LW`, `LF`), STL не менять правкой вручную.

## 6. Что записать в отчёт

1. Фото первой половинки (сверху/сбоку/шов) + линейка в кадре.
2. Масса и время каждой детали (весы/слайсер).
3. Замеры: прогиб при 10 Н·м, ступенька шва, толщины стенок (3 точки).
4. Результат тестов с Choc/EC11/джеком/фейдером.
5. Вердикт: печатать комплект / править параметры (какие).
