martiyanov/bukifon/mechanical/assembly.md

# Порядок сборки корпуса Букифон v1.0

Все размеры в мм. Детали — `mechanical/stl/`, крепёж — M3 (термовтулки
4.6 × 6.0) и M2.5. Зазоры в сопряжениях 0.25 (spec/30 §3).

## 0. Комплектация

### Печатные детали (файл → кол-во)

| Деталь | Файл | Кол-во |
|---|---|---|
| Нижняя скорлупа левая | `bottom_L.stl` | 1 |
| Нижняя скорлупа правая | `bottom_R.stl` | 1 |
| Верхняя панель левая/правая | `panel_upper_L/R.stl` | 1 + 1 |
| Пластина deck PAD левая/правая | `deck_plate_L/R_pads.stl` | 1 + 1 |
| Пластина deck KEYS (опция) | `deck_plate_L/R_keys.stl` | — |
| Ручка | `knob.stl` | 8 |
| Колпачок пэда | `pad_cap.stl` | 18 |
| Колпачок клавиши | `keycap.stl` | 42 (только KEYS) |
| Колпачок слайдера | `fader_cap.stl` | 2 |
| Плечевая кнопка | `shoulder_cap.stl` | 4 |
| Световод | `light_guide.stl` | 9 |
| Скоба верхнего дока | `dock_cradle.stl` | 1 |
| Крышка брюха | `bay_hatch.stl` | 1 |
| Задняя панель L/R | `rear_plate_L/R.stl` | 2 |
| Накладка рукоятки (TPU, с 2 ножками) | `grip_pad.stl` | 2 |
| Шпонка шва 6 × 3 | `seam_key.stl` | 2 |

### Крепёж и расходники

| Позиция | Кол-во | Куда |
|---|---|---|
| Термовтулка M3 (4.6 × 6.0) | 24 | PANEL-1 — 6, верхние панели — 4, DECK — 4, задняя панель — 6, крышка брюха — 4 |
| Винт M3 × 6, полукруг | 10 | CORE-1 — 4, PANEL-1 — 6 |
| Винт M3 × 8, потай | 12 | панельные пластины — 8, крышка брюха — 4 |
| Винт M3 × 8, полукруг | 2 | лапки док-скобы |
| Винт M3 × 10, потай | 6 | задняя панель |
| Винт M3 × 16, полукруг | 4 | стяжка половин по шву (горизонтально) |
| Винт M2.5 × 6 | 4 | экран (снизу в panel_upper) |
| Винт M2.5 × 8 | 4 | слайдеры (2 на каждый) |
| Шпонки 6 × 3 | 2 | печатные `seam_key.stl` |
| Клей/скотч 3M VHB | — | накладки `grip_pad` на рукоятки |
| Шнур/стропа Ø3 | — | ушки ремня в рукоятках (опция) |

### Платы и модули (не входят в механику)

CORE-1 (200 × 108), PANEL-1 (300 × 132), DECK (290 × 78), экран 2.8" 85 × 50,
8 × EC11, 4 плечевые кнопки, 2 слайдера, шлейфы IDC-16/26/32.

## 1. Подготовка

1. Напечатать `test_fit/test_cross.stl`, проверить посадку термовтулки и
   зазор шипа 0.25 (см. `prints.md` §2). При необходимости поправить `FIT`
   в `params.py` и перегенерировать.
2. Снять заусенцы в окнах, пройти все отверстия M3 сверлом 3.3, M2.5 — 2.7.
3. Запрессовать 24 термовтулки паяльником 260 °C:
   - `bottom_L`: PANEL-1 (3), верхняя панель (2), DECK (2), задняя панель (4),
     крышка брюха (2) — 13 шт.;
   - `bottom_R`: те же гнёзда зеркально — 11 шт.
   Втулки ставить с внутренней стороны, заподлицо с бобышкой.

## 2. Сборка скорлупы

1. **Шов.** Вставить 2 шпонки `seam_key` в пазы на верхней кромке `bottom_L`
   (Y ≈ 30 и 55, Z 40.6…43); наложить `bottom_R` по X = 157.5, чтобы шпонки
   вошли в ответные пазы. Проверить, что полости совпадают без ступеньки.
2. **Стяжка половин.** Через брюхо (снизу, крышка ещё не стоит) вкрутить
   4 × M3 × 16 горизонтально в бобышки шва (Y = 52, 68, 84, 100; головка
   утоплена в левой бобышке, резьба — в правой). Тянуть 0.4 Н·м, без фанатизма.
3. Проверить плоскость стыка: щуп 0.1 мм не должен проходить на верхней кромке.

## 3. CORE-1 и PANEL-1

1. **CORE-1** положить сверху на 4 стойки (Z 16, отверстия 190 × 92 по
   центрам), прикрутить 4 × M3 × 6 сверху. Разъёмы портов — вниз, к брюху.
2. **PANEL-1** (300 × 132) опустить в полость на 6 стоек (Z 37), прикрутить
   6 × M3 × 6. Вырез PANEL-1 под DECK — к передней части; шлейф IDC-32
   CORE-1 ↔ PANEL-1 уложить вдоль левой стенки, не пережимая.
3. Шлейфы P1/P2 (IDC-26) вывести в брюхо через окно 200 × 60.
4. **Экран** прикрутить 4 × M2.5 × 6 к внутренней стороне `panel_upper_*`
   (глухие отверстия в 3-мм пластине, Z 43). Экран смотрит в окно 60 × 46.
   Сначала — левая панель с экраном (2 винта), затем правая.

## 4. Панельные пластины

1. Уложить `panel_upper_L` (окно экрана + 4 ручки + 2 плечевые) в «поясок»
   скорлупы, прикрутить 2 × M3 × 8 с потайной головкой (точки (12, 40),
   (100, 10)).
2. `panel_upper_R` — зеркально ((303, 40), (215, 10)).
3. Установить 8 ручек Ø18 на валы EC11 (D-вал 6 мм, посадка с натягом,
   при необходимости — капля фиксатора резьбы), указатель — на 12 часов.
4. Плечевые кнопки L1/L2/R1/R2 (`shoulder_cap`, Ø10) — в отверстия Ø8.
5. Световоды `light_guide` (Ø4 × 6) — под ручки (8 шт.) и статус (1 шт.,
   X 157.5, Y 76 на PANEL-1): вставить сверху в отверстия до упора.

## 5. Сменный DECK

1. Собрать модуль deck вне корпуса: пластина `deck_plate_*` + DECK PCB
   (290 × 78) + 2 слайдера (4 × M2.5 × 8) + колпачки.
   - PAD: 18 × `pad_cap`; KEYS: 42 × `keycap` (окна 14.2 — гнёзда Choc,
     колпачки ставятся сверху на пластину).
2. Подключить шлейф IDC-16 к разъёму в заднем правом углу ниши
   (на PANEL-1), разъём на deck не отсоединять при смене.
3. Опустить deck в нишу 300 × 79, прикрутить 4 × M3 × 8 с потайной головкой
   ((88, 138), (125, 138), (190, 138), (227, 138) — стойки сквозь PCB).
4. Установить 2 колпачка слайдеров `fader_cap` (шток в прорезь 8 × 34).

## 6. Задняя панель и брюхо

1. **Задняя панель**: наложить `rear_plate_L` + `rear_plate_R` на заднюю
   стенку (стык по X = 157.5, скрыт за скорлупой), прикрутить 6 × M3 × 10.
   Все разъёмы — на ней (J-DC, тумблер, USB-C Pico, RESET, LINE, PHONES,
   MIDI IN/OUT, 2 × CV OUT, 2 × CV IN, 2 × GATE, MASTER VOL).
2. **Крышка брюха**: уложить `bay_hatch` в фальц (окно PORT2 36 × 10 — по
   центру), прикрутить 4 × M3 × 8 через отверстия (62.5/252.5, 47.5/97.5).
3. **Док-скоба**: прикрутить `dock_cradle` 2 × M3 × 8 к задней кромке панели
   (Y ≈ 0, X 102.5…212.5); она стоит ЗА корпусом и не закрывает экран.
   Модуль верхнего дока вставляется в скобу, шлейф IDC-26 выходит через
   окно PORT0 (36 × 10, Y = 6).

## 7. Накладки и финиш

1. `grip_pad` (TPU) — в фальц на нижней стороне рукояток (утоплена на
   1.5 мм, выступает на 0.5), посадить на 3M VHB/клей. Ножки-демпферы —
   часть накладки (по 2 на каждую).
2. Ушки ремня Ø3 — в задней части рукояток; продеть стропу (опция).
3. Проверить:
   - ручки вращаются без задевания панели (зазор 14 между осями);
   - пэды/клавиши ходят без закусывания в окнах (зазор 0.3 на сторону);
   - слайдеры — полный ход 30 мм, колпачок не цепляет пластину;
   - шлейфы не пережаты рёбрами, крышка брюха садится без нажима;
   - корпус стоит на 4 ножках, не качается; наклон панели «седло» 0.8 мм
     (в этой версии панель плоская — см. README «Отклонения»).

## 8. Смена deck (PAD ↔ KEYS)

1. Открутить 4 винта пластины deck (сверху).
2. Отсоединить шлейф IDC-16 от разъёма на DECK (разъём на deck, не на
   PANEL-1 тянуть нельзя).
3. Поставить другой deck с собранными колпачками, подключить шлейф,
   прикрутить 4 винта. Прошивка определит тип по `DECK_ID`.

## 9. Меры предосторожности

- Не затягивать винты в термовтулки сильнее 0.4 Н·м — PETG течёт.
- Не гнуть шлейфы IDC под острым углом: радиус ≥ 10 мм, не пережимать
  крышкой брюха (spec/30 §5).
- CORE-1 крепить до установки PANEL-1 (доступ сверху).
- Экран крепить к панельной пластине ДО её установки на корпус.
- Накладки TPU клеить после проверки эргономики (можно снять и переклеить).
<!-- section:v1.7-assembly -->

---

# Порядок сборки — Букифон v1.7 (380 × 210 × 63)

## Комплектация

| Печатные детали | Кол-во |
|---|---|
| `body_L.stl`, `body_R.stl` (нижняя скорлупа, половины) | 1 + 1 |
| `panel_L.stl`, `panel_R.stl` (верхняя панель, половины) | 1 + 1 |
| `foot.stl` (TPU-ножки) | 4 |
| `keycap_v17.stl` (Choc-колпачки, печатные) | 42 |

Крепёж: 4 × M3 × 8 (панель по углам), 6 × M3 × 6 (PANEL-1 rev.2),
4 × M3 × 6 (CORE-1 rev.3), 4 × M2.5 × 6 (экран), 8 × M2.5 × 8 (2 фейдера),
24 термовтулки M3 4.6 × 6 (4 угла + 6 PANEL-1 + 4 CORE-1 — CORE под саморез,
10 запас).

## Порядок

1. **Подготовка.** Проверить печать калибровочным крестом, снять заусенцы,
   пройти отверстия, запрессовать втулки M3 (паяльник 260 °C) в 4 угловые
   стойки, 6 стоек PANEL-1; в стойки CORE-1 — отверстия Ø3.3 под саморез.
2. **Ножки.** 4 × `foot` (TPU) вставить в гнёзда Ø13 в дне (посадка с натягом,
   при необходимости — клей). Ножки утоплены: высота корпуса остаётся 63 мм.
3. **Стык корпуса.** Положить `body_L` и `body_R` на стол, совместить по шву
   X = 190: шип дна 3 × 3 входит в паз 3.2; проверить, что дно и стенки
   совпадают без ступеньки.
4. **CORE-1 rev.3** (200 × 108) — на 4 стойки Z12, 4 × M3 × 6 сверху.
   USB-C-кабель вывести к вырезу на задней кромке (окно 12 × 5 в задней стенке,
   вырез 9.4 × 3.6 в панели).
5. **Батарея 1S2P.** 2 × 18650 уложить в седла у правой стенки (X 300…340,
   Y 56…125), банки «минусом на плюс» не путать; клеммы — к PWR-BATT-1.
6. **PANEL-1 rev.2** (360 × 190) — на 6 стоек Z47, 6 × M3 × 6 сверху.
   Вырезы платы — под ручки/клавиши/джеки/фейдеры.
7. **Экран 5.0″** 800×480 — модуль прикрутить 4 × M2.5 × 6 к обратной стороне
   панели (глухие отверстия Ø2.2), стекло — вплотную в вырез 108 × 64.8.
8. **Компоненты панели:**
   - 16 × энкодеров Ø14 (EC11): гайка/втулка M7 — в утопление Ø14.4, вал в
     Ø7.2; ручки Ø14 — после проверки хода;
   - 10 × mini-jack 3.5 мм — гайка Ø8 в утопление Ø8.2, отверстие Ø6.2;
   - 2 × фейдера — 4 × M2.5 × 8 на каждый, колпачки в окна 8 × 68, ход 60 мм;
   - 42 × Choc v1/v2 — защёлками в окна 14 × 14 (поворот по spec JSON);
     печатные колпачки `keycap_v17` 17.5 × 16.5 × 5.5 — пазом-крестом на шток,
     ориентируясь по углу из JSON.
9. **Панель.** Наложить `panel_L` (с шипом 3 × 1.2) и `panel_R` (с пазом 3.2)
   на корпус, совместить по шву X = 190, прикрутить 4 × M3 × 8 с потайной
   головкой по углам (9/9, 371/9, 9/201, 371/201).
10. **Финиш:** проверить, что шов панели не «гуляет», ножки стоят ровно,
    фейдеры не цепляют панель, клавиши ходят без закусывания.

## Разборка

Обратный порядок: 4 винта панели → панель половинами (тянуть вверх, не
перекашивать шип) → шлейфы/разъёмы → PANEL-1 (6 винтов) → доступ к батарее,
CORE-1, USB-C.

## Особенности v1.7

- Экран без рамки: вырез = активная область 108 × 64.8; модуль крепится изнутри
  к панели (4 × M2.5), стекло вплотную к лицевой поверхности; внутренний буртик
  1.5 мм по контуру окна не даёт модулю провалиться наружу.
- Гайки джеков утоплены в панель на Ø8.2 × 1.5, энкодеров — Ø14.4 × 1.4.
- Шкалы-риски у фейдеров — неглубокие (0.35 мм) с обеих сторон окна.
- Динамиков и разъёмов под экраном нет (по ТЗ v1.7).
- Шов X = 190 проходит через окно экрана (скрыт стеклом), между джеками и
  фейдерами — на лицевой стороне видна тонкая линия в промежутках.
- Батарея — в седлах дна; доступ при снятой панели/PANEL-1.
<!-- section:v0.4-assembly -->

---

# Порядок сборки — Букифон v0.4 (панель по канону)

Корпус, ножки и крепёж — от v1.7 без изменений (см. раздел v1.7 выше).
Меняется только панель: `panel_L.stl` + `panel_R.stl` из `mechanical/stl_v04/`.

## Что переставить на панели (v0.4)

1. **42 клавиши Lapka-42**: половины развёрнуты на **+18° (левая) / −18° (правая)**;
   центры и углы каждой клавиши — 1:1 из `spec/panel-spec-v0.4.json`.
   Окна 14 × 14 под Choc — повёрнуты вместе с клавишами; колпачки `keycap_v17`
   17.5 × 16.5 × 5.5 ставятся пазом-крестом на шток, ориентируясь по углу
   `angle_deg` этой клавиши.
2. **16 энкодеров**: X 25.2/54.1/82.6/111.4 и 269.3/297.8/326.6/355.8,
   Y 35.7/68.5. Гайка/втулка M7 — в цековку Ø14.4 × 1.4, вал — в Ø7.2.
3. **10 mini-jack 3.5**: X 129.9…247.8 (шаг 13.1), Y 10.5; гайка Ø8 —
   в цековку Ø8.2 × 1.5, отверстие Ø6.2.
4. **Экран 5.0″** 800×480: вырез 108 × 64.8 с центром (190, 58.7), без рамки;
   модуль 120.7 × 75.8 прикручивается 4 × M2.5 к обратной стороне панели,
   стекло — вплотную; внутренний буртик 1.5 мм не даёт модулю провалиться.
5. **2 фейдера**: X 175.1 / 204.0, центр по Y = 150; прорезь 2.5 × 63,
   корпус 16 × 75 под панелью; крепление 4 × M2.5 × 8 на каждый;
   шкалы-риски по бокам прорези.
6. **Крепёж панели** (без изменений): 4 × M3 × 8 по углам (9/9, 371/9,
   9/201, 371/201), 6 × M3 × 6 на стойки PANEL-1, 4 × M2.5 × 6 на экран.

Порядок сборки — как в v1.7: корпус (шип/паз дна) → ножки → CORE-1 rev.3 →
батарея → PANEL-1 rev.2 → компоненты панели → панель (шип/паз по шву) →
4 винта по углам. Экран — до установки панели.
<!-- section:v0.5-B-assembly -->

---

# Порядок сборки — Букифон v0.5-B (клин 8°)

Файлы: `mechanical/stl_v05_B/` — body_L/R (клин), panel_L/R (копии v0.4),
foot ×4, keycap_v17 ×42. Внутри — посадочные места под CORE-2 (200×108,
горизонтально, Z12), PANEL-2 (360×190, параллельно панели, −8 мм по нормали),
PWR-2 (90×70, горизонтально, Z6) и батарею 1S2P 18650 (ложемент справа).

## Порядок

1. **Печать** (см. prints.md): половины корпуса, панели, ножки, колпачки.
   Панель — из stl_v04-комплекта (без изменений), вырезы — по JSON v0.4.
2. **Ножки**: 4 × TPU `foot` в гнёзда Ø13 в дне (дно плоское — корпус стоит
   ровно, панель наклонена 8°).
3. **Стык половин**: body_L + body_R по X=190 — прямой стык; соосность задаётся
   шипом/пазом панели (3 × 1.2) и 4 винтами M3 по углам. Сначала проверить
   совпадение дна и стенок без ступеньки.
4. **CORE-2** (200×108) — горизонтально на 4 стойки Z12, 4 × M3 × 6 сверху.
   USB-C-кабель — к окну в задней стенке (у верхней кромки).
5. **PWR-2** (90×70) — горизонтально на 4 стойки Z6 (M2.5), справа от CORE-2
   под ним.
6. **Батарея 1S2P**: 2 × 18650 — в седла у правой стенки (X 302/322, Y 56…121),
   «минусом на плюс» не путать; клеммы — к PWR-2.
7. **PANEL-2** (360×190) — на 6 стоек, верх которых параллелен панели
   (8 мм ниже её), 6 × M3 × 6. Плата — параллельно панели, т.к. клавиши
   и энкодеры жёстко связаны с панелью (это осознанное решение; CORE-2/PWR-2 —
   горизонтальные площадки).
8. **Экран 5.0″** — 4 × M2.5 к обратной стороне панели, стекло в окно
   108 × 64.8 (центр 190; 58.7), буртик 1.5 мм.
9. **Компоненты панели**: 16 энкодеров (Ø7.2 + цековка Ø14.4), 10 джеков
   (Ø6.2 + цековка Ø8.2 × 1.5), 42 Choc (окна 14×14, ±18° по JSON),
   2 фейдера (прорези 2.5×63, 4 × M2.5), колпачки.
10. **Панель**: половинки с шипом/пазом по X=190; 4 × M3 × 8 по углам —
    **винты вкручиваются по нормали панели (наклон 8°)**, нужен ключ с
    шаровым наконечником; тянуть 0.4 Н·м. После установки — проверить,
    что шов не «гуляет», а задняя кромка (61.5 мм) стоит выше передней (32 мм).
11. **Финиш**: проверить ход фейдеров/клавиш, отсутствие задевания за панель,
    устойчивость (4 ножки), кабель USB-C не пережат окном.

## Эргономика (docs/21-ergonomics.md)

- Наклон панели 8°, перед 32 мм, зад 61.5 мм, перепад 29.5 мм — в допусках.
- Фаска R4 по передней кромке корпуса — под запястье.
- Экран 35° к панели проверяется картонным профилем
  `renders/templates/bukifon_v05_wedge8_profile_1to1.pdf`.
<!-- section:v0.5-B-light-assemblykit -->

---

# Варианты корпуса v0.5 (сборка)

- **A — flat (0°)**: `mechanical/stl_v05_A/` — точная копия v0.4 (body 193/190×210×60,
  панель 193+190, foot ×4, keycap ×42), сборка `bukifon_v05_A_assembly.3mf`;
  студийный/настольный вариант (перед/зад 63 мм). Сборка — как v0.4: панель
  193+190 с шипом/пазом, 4×M3 по углам, PANEL-1/CORE/PWR — по v0.4.
- **B / B-light / C** — см. разделы ниже.

# Сборочный комплект v0.5-B-light (S3-base, народная версия)

Пошаговая сборка: [`docs/34-assembly.md`](../docs/34-assembly.md);
что печатать первым: [`docs/35-print-first.md`](../docs/35-print-first.md).

- **Сборочная карта 1:1**: `renders/templates/bukifon_assembly_map_1to1.pdf` —
  стр.1 разнесённая схема слоёв (корпус → батарея → PWR-2 → CORE-S3 → PANEL-2 →
  дисплей → панель), стр.2–3 панель 193+190 в масштабе 1:1 с точками крепежа и
  шипом/пазом, стр.4 крепёж/шлейфы/чек-лист «перед включением».
- **3D разнесённый вид**: `mechanical/preview_v05_B_light/assembly_exploded.jpg`
  (плейсхолдеры CORE-S3 200×108, PANEL-2 360×190, PWR-2 90×70, 2×18650, панель).

**Порядок слоёв (снизу вверх):**
1. body_L + body_R (B-light, 193+190, шип/паз) — 230 г/11.1 ч профиль;
2. батарея 1S2P 18650 в ложементе (опция, справа);
3. PWR-2 rev.1 90×70, Z6 — 4×M2.5; J17 IDC-20 / J18 IDC-12;
4. CORE-S3 rev.0 200×108, Z12 — 4×M3; J14/J15/J16;
5. PANEL-2 rev.2 360×190, 8 мм под панелью — 6×M3;
6. дисплей 5″ — 4×M2.5, FFC-40;
7. панель v0.4 193+190 — 4×M3×8 по углам; 42 Choc, 16 энкодеров, 2 фейдера,
   10 джеков — после панели (гайки сверху).

**Крепёж:** 4×M3×8 (панель), 6×M3×6 (PANEL-2), 4×M3×6 (CORE-S3), 4×M2.5×6
(дисплей), 8×M2.5×8 (фейдеры). **Шлейфы:** FFC-40, IDC-26 (J14), IDC-16 (J13),
IDC-20 (J17), IDC-12 (J18).

> PANEL-2 и дисплей ставятся **до** панели (панель перекрывает доступ к стойкам);
> энкодеры/клавиши/джеки/фейдеры — **после** укладки панели. Это отражено в карте
> и docs/34 (порядок из ТЗ скорректирован по физике сборки).
