martiyanov/bukifon/docs/72-assembly-workshops.md

# Где собрать Букифон: мастерские Москвы, СПб и Нижнего Новгорода

Практический гид: куда отдать **платы в сборку**, **корпус в печать** и **устройство в пилот**.
Данные собраны из открытых источников (06.11.2025); перед заказом уточняйте цены/сроки/наличие
у менеджеров — рынок и санкционные ограничения меняются.

## 1. Что именно нужно собрать

| Работа | Что требуется | Кто берёт |
|---|---|---|
| **Платы** | CORE-2 (6 слоёв, QFN/BGA-free, USB-C, PCM5102A/1808, MAX9814 TDFN, TS5A DGS), PANEL-2 (4 слоя, 360×190, 4× MCP23017, FPC-40 0.5 мм, IDC, 42 Choc THT, 16 EC11 THT), PWR-2 (4 слоя, TPS61088/LMR33630 QFN, BQ297) | контрактные EMS/прототипные участки |
| **Механика** | 6+ STL/3MF PETG (B-light 231 г), клипсы микрофона | 3D-печать на заказ / фаблаб |
| **Сборка устройства** | платы + корпус + клавиши/энкодеры/джеки + шлейфы + прошивка + self-test | EMS полного цикла или мастерская |
| **Пилот 5–25 шт** | повторяемость, тест, серийники/QR, упаковка | контрактное производство |

**Важно:** до заказа PCB нужны P1/PWR-замеры (PRE-FREEZE) — это не отменяется.

## 2. Москва

| Организация | Что делает | Почему подходит | Ссылка |
|---|---|---|---|
| **Резонит** (Зеленоград) | Прототипы и малые серии, срочный монтаж 2–3 дня, собственные трафареты; 0–1000 точек ≈ **3,5 ₽/точка**, подготовка ≈ 3000–3500 ₽ | Быстрые прототипы; 6-слойные платы; QFN — по запросу | [rezonit.ru/price_assembly](https://www.rezonit.ru/price_assembly/) |
| **А-Контракт** | Контрактное производство, монтаж от 01005, мелкие серии, прослеживаемость | Москва, 2-й Рощинский пр., 8; опыт мелких серий | [a-contract.ru](https://a-contract.ru/) |
| **Интер-Плата** | Опытные партии и малые серии **5–500 плат**, давальческие компоненты, под ключ, 1–2 дня расчёт | Хорошо для 5–10 прототипов с нашими компонентами | [контакт/профиль](https://electronix.ru/forum/profile/125771-inter-plata/) |
| **НПП «Асти»** | Мелкосерийное производство полного цикла: платы, кабели, корпусирование, прошивка, тест | Может собрать «изделие», а не только плату | [npp-asti.ru](https://npp-asti.ru/cities/moskva/elektronika/melkoseriynoe-proizvodstvo/) |
| **Пилотное производство Московского Политеха** | Малые/средние партии, AOI, ICT/FT, прошивка, DFM/DFT-аудит | Университетская площадка, хороша для пилота | [mospolytech.ru](https://mospolytech.ru/en/news/moscow-polytech-establishes-pilot-production-facility-for-electronic-device-development-and-assembly/) |
| **VG-Line** (Москва) | Ремонт/моддинг синтезаторов, разработка и **контрактное производство музыкального оборудования**, коворкинг | Единственный найденный профильный «синтезаторный» подрядчик | [modulargrid/vendor](https://modulargrid.net/e/vendors/view/968) |
| **Фаблаб Сколтеха** | Прототипирование, мелкие серии, станки/3D-печать | Для быстрых единичных прототипов | [skoltech.ru](https://www.skoltech.ru/center/fablab-and-machine-shop) |
| **3D-печать**: Modelica3D | Партии PETG (от 22 ₽/г, 118 принтеров) | Корпус B-light 231 г ≈ 5–7 тыс. ₽/шт партией | [modelica3d.ru](https://modelica3d.ru/blog/seriynaya-3d-pechat-petg-partii-detaley/) |
| **3D-печать**: ПИМТЕХ | FDM/SLA/SLS, прототипы и функциональные детали | Альтернатива по корпусам/клипсам | [pimteh.ru](https://pimteh.ru/3d-printing) |

## 3. Санкт-Петербург

| Организация | Что делает | Почему подходит | Ссылка |
|---|---|---|---|
| **Резонит СПб** | Срочный монтаж **2–3 дня**, все виды монтажа, отмывка, тестирование, жгуты, трафареты | Прототипы и малые серии рядом | [rezonit.ru](https://www.rezonit.ru/) |
| **AXIOMA Contract Production** | Сборка печатных плат полного цикла, ISO 9001/ГОСТ, IPC | Промышленная сборка плат | [axioma-smd.ru](https://axioma-smd.ru/kontraktnoye-proizvodstvo/montazh-pechatnih-plat/sborka-pechatnyh-plat-v-sankt-peterburge-polnyy-cikl/) |
| **ГК «Эрикон»** | 2 SMT-линии, отдельный участок мелкосерийного монтажа, 01005 | Мелкие серии, проверенная площадка | [профиль/аудит](https://arpe.ru/) |
| **Фаблаб Политех** | Фаблаб/мастерская: 3D-печать, лазер, электроника, прототипы | Для единичных корпусов/прототипов | [spbstu.ru](https://www.spbstu.ru/) |
| **ЛЭТИ, центр гибкой электроники** | Экспресс-прототипирование, мелкосерийные изделия микротехники | Сложные/гибкие платы, НИР | [ckp-rf.ru](https://ckp-rf.ru/ntirf/objects/ec/1864361/) |

## 4. Нижний Новгород

| Организация | Что делает | Почему подходит | Ссылка |
|---|---|---|---|
| **Телерем** | Контрактное производство электроники, SMD/THT/BGA, сборка приборов, настройка, комплектация; Ульянова, 10а | Полный цикл «плата → прибор» | [профиль](https://nizhniy-novgorod.tvoyaspravka.ru/company/242138009/print) |
| **НПО «Промышленные решения»** | Печатные платы, монтаж, комплектование, тестирование | Локальный производитель плат + сборка | [nnov.npo-pr.ru](https://nnov.npo-pr.ru/service/komplektovanie-elektronnyh-izdelij/) |

Фаблаба в НН на момент обзора нет (по материалам «Поиск НН»); для единичных прототипов —
вузовские лаборатории (НГТУ) и «Точки кипения», либо отправка в Москву/СПб.

## 5. Кого выбрать под задачу

| Задача | Рекомендация |
|---|---|
| **3 прототипа плат** (быстро, 1–2 недели) | Резонит (Зеленоград/СПб, 2–3 дня монтаж) или Интер-Плата (5–500 шт, давальческие) |
| **5–10 прототипов «под ключ»** | Интер-Плата / Резонит (свои компоненты + монтаж); VG-Line — если нужна сборка в корпус и профильная консультация |
| **Пилот 10–25 шт** | А-Контракт, НПП «Асти», Телерем, Пилотный центр МосПолитеха |
| **Корпус B-light** | Modelica3D/ПИМТЕХ (PETG-партия) или фаблаб; дома — свой принтер |
| **Сборка устройства + прошивка + self-test** | НПП «Асти» (полный цикл) или VG-Line (музыкальное оборудование) |

## 6. Что спросить в RFQ (шаблон)

1. Берёте **6-слойные** CORE-2 и **4-слойные** PANEL-2/PWR-2? Минимальная партия?
2. Монтаж **QFN/TDFN/DGS/LGA** (TPS61088, LMR33630, MAX9814, TS5A23157, BQ297, MAX17048, MEMS ICS-43434)? Есть ли AOI/рентген?
3. **Давальческие компоненты** (наши) + закупка недостающих? Компоненты в ленте/трей?
4. FPC-40 0.5 мм (Hirose FH12-40S) и IDC-разъёмы — пайка/установка?
5. **THT**: 42 hot-swap Choc, 16 EC11, 10 Thoniconn, фейдеры — ставите?
6. Подготовка: Gerber, BOM, **CPL/P&P**, stencil, панелизация — что нужно от нас?
7. Сроки: прототип 3–5 шт / пилот 25 шт; цена за точку + setup + stencil?
8. Тест: pogo-тест-пойнты, прошивка (ESP-IDF/PlatformIO), self-test 21 тест — можете прошить/прогнать?
9. Серийники/QR-этикетки (docs/55) — клеите/сканируете?
10. NDA и хранение документации; кто отвечает за замены/брак?

## 7. Ориентиры по цене (прототип, 5 комплектов)

| Статья | Оценка |
|---|---|
| Монтаж CORE-2 (≈1500 точек) | 3,5 ₽ × 1500 ≈ 5 250 ₽/плата |
| Монтаж PANEL-2 (≈2000 точек + THT) | ≈ 7 000–9 000 ₽/плата |
| Монтаж PWR-2 (≈500 точек) | ≈ 1 750 ₽/плата |
| Подготовка/трафареты | ≈ 3 000–3 500 ₽ × 3 |
| **Итого сборка 5 комплектов** | **≈ 90–120 тыс. ₽** (без компонентов) |
| Корпус B-light PETG 231 г | ≈ 5–7 тыс. ₽/шт партией |
| Сборка/прошивка/тест устройства | по запросу (зависит от объёма) |

Точную цену дают только по Gerber+BOM+P&P; в ТЗ приложить [docs/54](54-shopping-list.md)
и [BOM-p4.csv](../BOM-p4.csv).

## 8. Чек-лист перед отправкой

- [ ] Gerber + drill + **BOM с MPN/альтернативами** + **CPL/P&P** (позиции, стороны, повороты);
- [ ] панелизация/технологические поля, fiducials, tooling holes;
- [ ] test points/pogo-поле (DFM docs/38), TP1–TP32;
- [ ] стencil (если делает заказчик);
- [ ] компоненты: давальческие в ленте/трей, с запасом 5–10 %;
- [ ] инструкция по прошивке и self-test (docs/46), серийники (docs/55);
- [ ] контракт/NDA, сроки, приёмка (AOI-отчёт, фото, тест-лог);
- [ ] механика: STL/3MF + допуски, кто печатает и кто собирает.

## 9. DIY/сообщество (если хочется самому)

- **Фаблаб Сколтеха** (Москва), **Фаблаб Политех** (СПб) — 3D-печать, лазер, паяльные станции;
- **VG-Line** (Москва) — ремонт/моддинг/коворкинг, консультация по синтезаторам;
- локальные синт-DIY-встречи/чаты (Telegram/Discord) — пайка, помощь с BOM;
- самостоятельная сборка: паяльная станция + микроскоп, stencil, паста; self-test из docs/46
  и paperkit/assembly map (docs/28/34) позволяют собрать первый экземпляр.
