martiyanov/bukifon/renders/templates/bukifon_assembly_map_1to1.pdf

# БУКИФОН v0.5-B-light · СБОРОЧНАЯ КАРТА: ПОРЯДОК СЛОЁВ

Разнесённая схема (условный масштаб 1:2.5; линейка 50 мм — контроль печати). Панель 1:1 — стр.2–3. Сборка снизу вверх, слои 1→7.

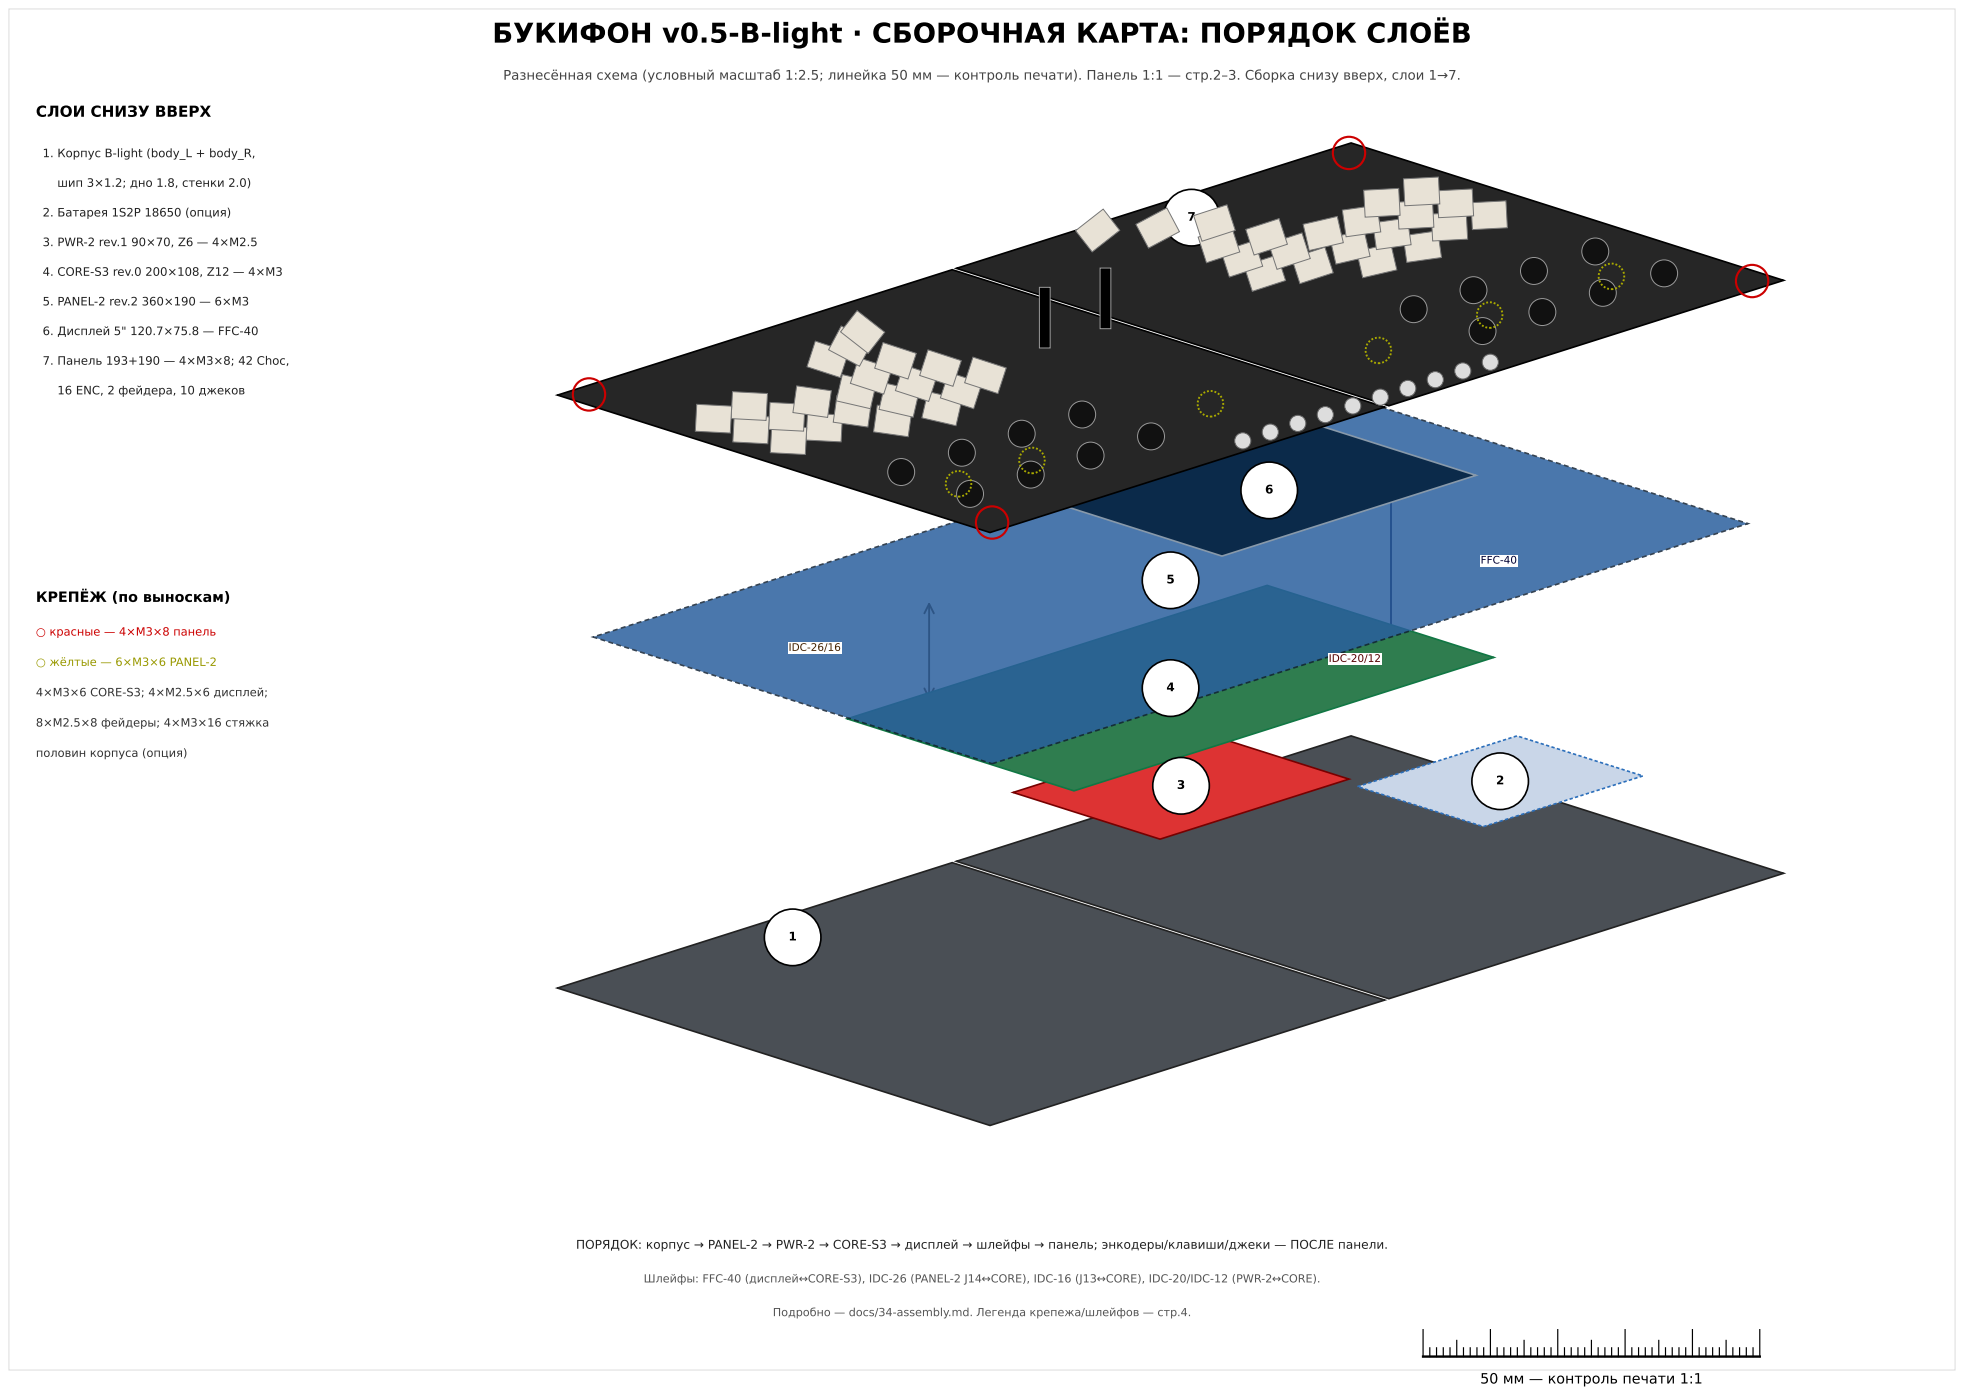
[picture p142: page 1]
1. Корпус B-light (body_L + body_R,; 2. Батарея 1S2P 18650 (опция); 3. PWR-2 rev.1 90×70, Z6 — 4×M2.5; 4. CORE-S3 rev.0 200×108, Z12 — 4×M3; 5. PANEL-2 rev.2 360×190 — 6×M3; 6. Дисплей 5" 120.7×75.8 — FFC-40; ○ красные — 4×M3×8 панель; ○ жёлтые — 6×M3×6 PANEL-2; 4×M3×6 CORE-S3; 4×M2.5×6 дисплей;; FFC-40; IDC-26/16; IDC-20/12

СЛОИ СНИЗУ ВВЕРХ

шип 3×1.2; дно 1.8, стенки 2.0)

7. Панель 193+190 — 4×M3×8; 42 Choc,
16 ENC, 2 фейдера, 10 джеков

КРЕПЁЖ (по выноскам)

8×M2.5×8 фейдеры; 4×M3×16 стяжка
половин корпуса (опция)

ПОРЯДОК: корпус → PANEL-2 → PWR-2 → CORE-S3 → дисплей → шлейфы → панель; энкодеры/клавиши/джеки — ПОСЛЕ панели.

Шлейфы: FFC-40 (дисплей↔CORE-S3), IDC-26 (PANEL-2 J14↔CORE), IDC-16 (J13↔CORE), IDC-20/IDC-12 (PWR-2↔CORE).

Подробно — docs/34-assembly.md. Легенда крепежа/шлейфов — стр.4.

50 мм — контроль печати 1:1

# БУКИФОН v0.5-B-light · ПАНЕЛЬ, половина ЛЕВАЯ (0…193 мм) · 1:1

Печать A4 100 %, без масштабирования. Линейка ниже = 50 мм. Стык по X=190: шип 3×1.2 (левая) / паз (правая).

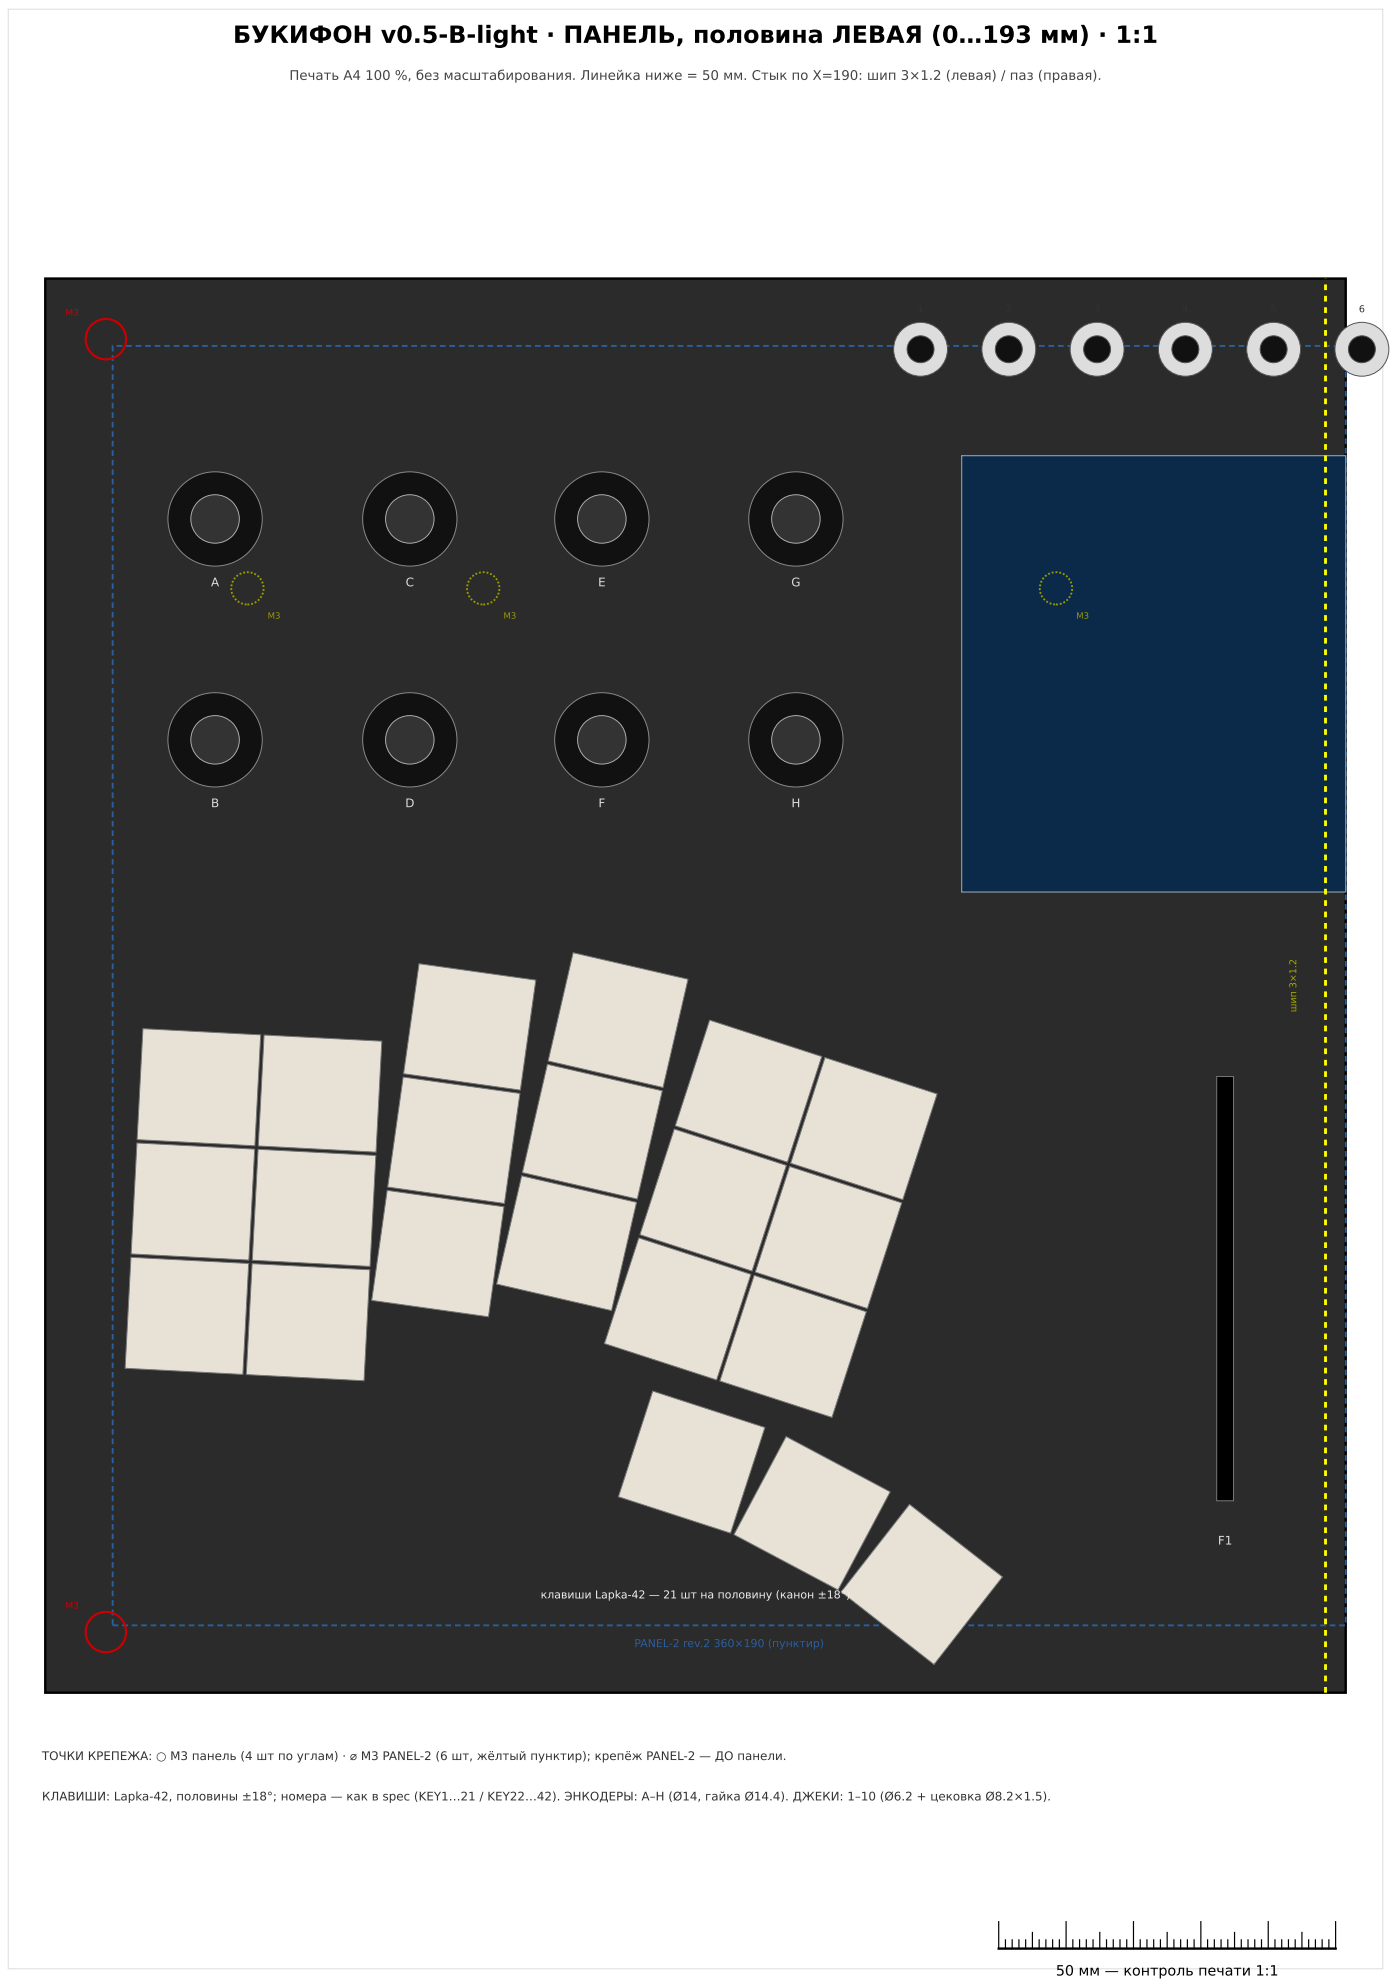
[picture p143: page 2]
шип 3×1.2

клавиши Lapka-42 — 21 шт на половину (канон ±18°)

PANEL-2 rev.2 360×190 (пунктир)

ТОЧКИ КРЕПЕЖА: ○ M3 панель (4 шт по углам) · ⌀ M3 PANEL-2 (6 шт, жёлтый пунктир); крепёж PANEL-2 — ДО панели.

КЛАВИШИ: Lapka-42, половины ±18°; номера — как в spec (KEY1…21 / KEY22…42). ЭНКОДЕРЫ: A–H (Ø14, гайка Ø14.4). ДЖЕКИ: 1–10 (Ø6.2 + цековка Ø8.2×1.5).

# БУКИФОН v0.5-B-light · ПАНЕЛЬ, половина ПРАВАЯ (190…380 мм) · 1:1

Печать A4 100 %, без масштабирования. Линейка ниже = 50 мм. Стык по X=190: шип 3×1.2 (левая) / паз (правая).

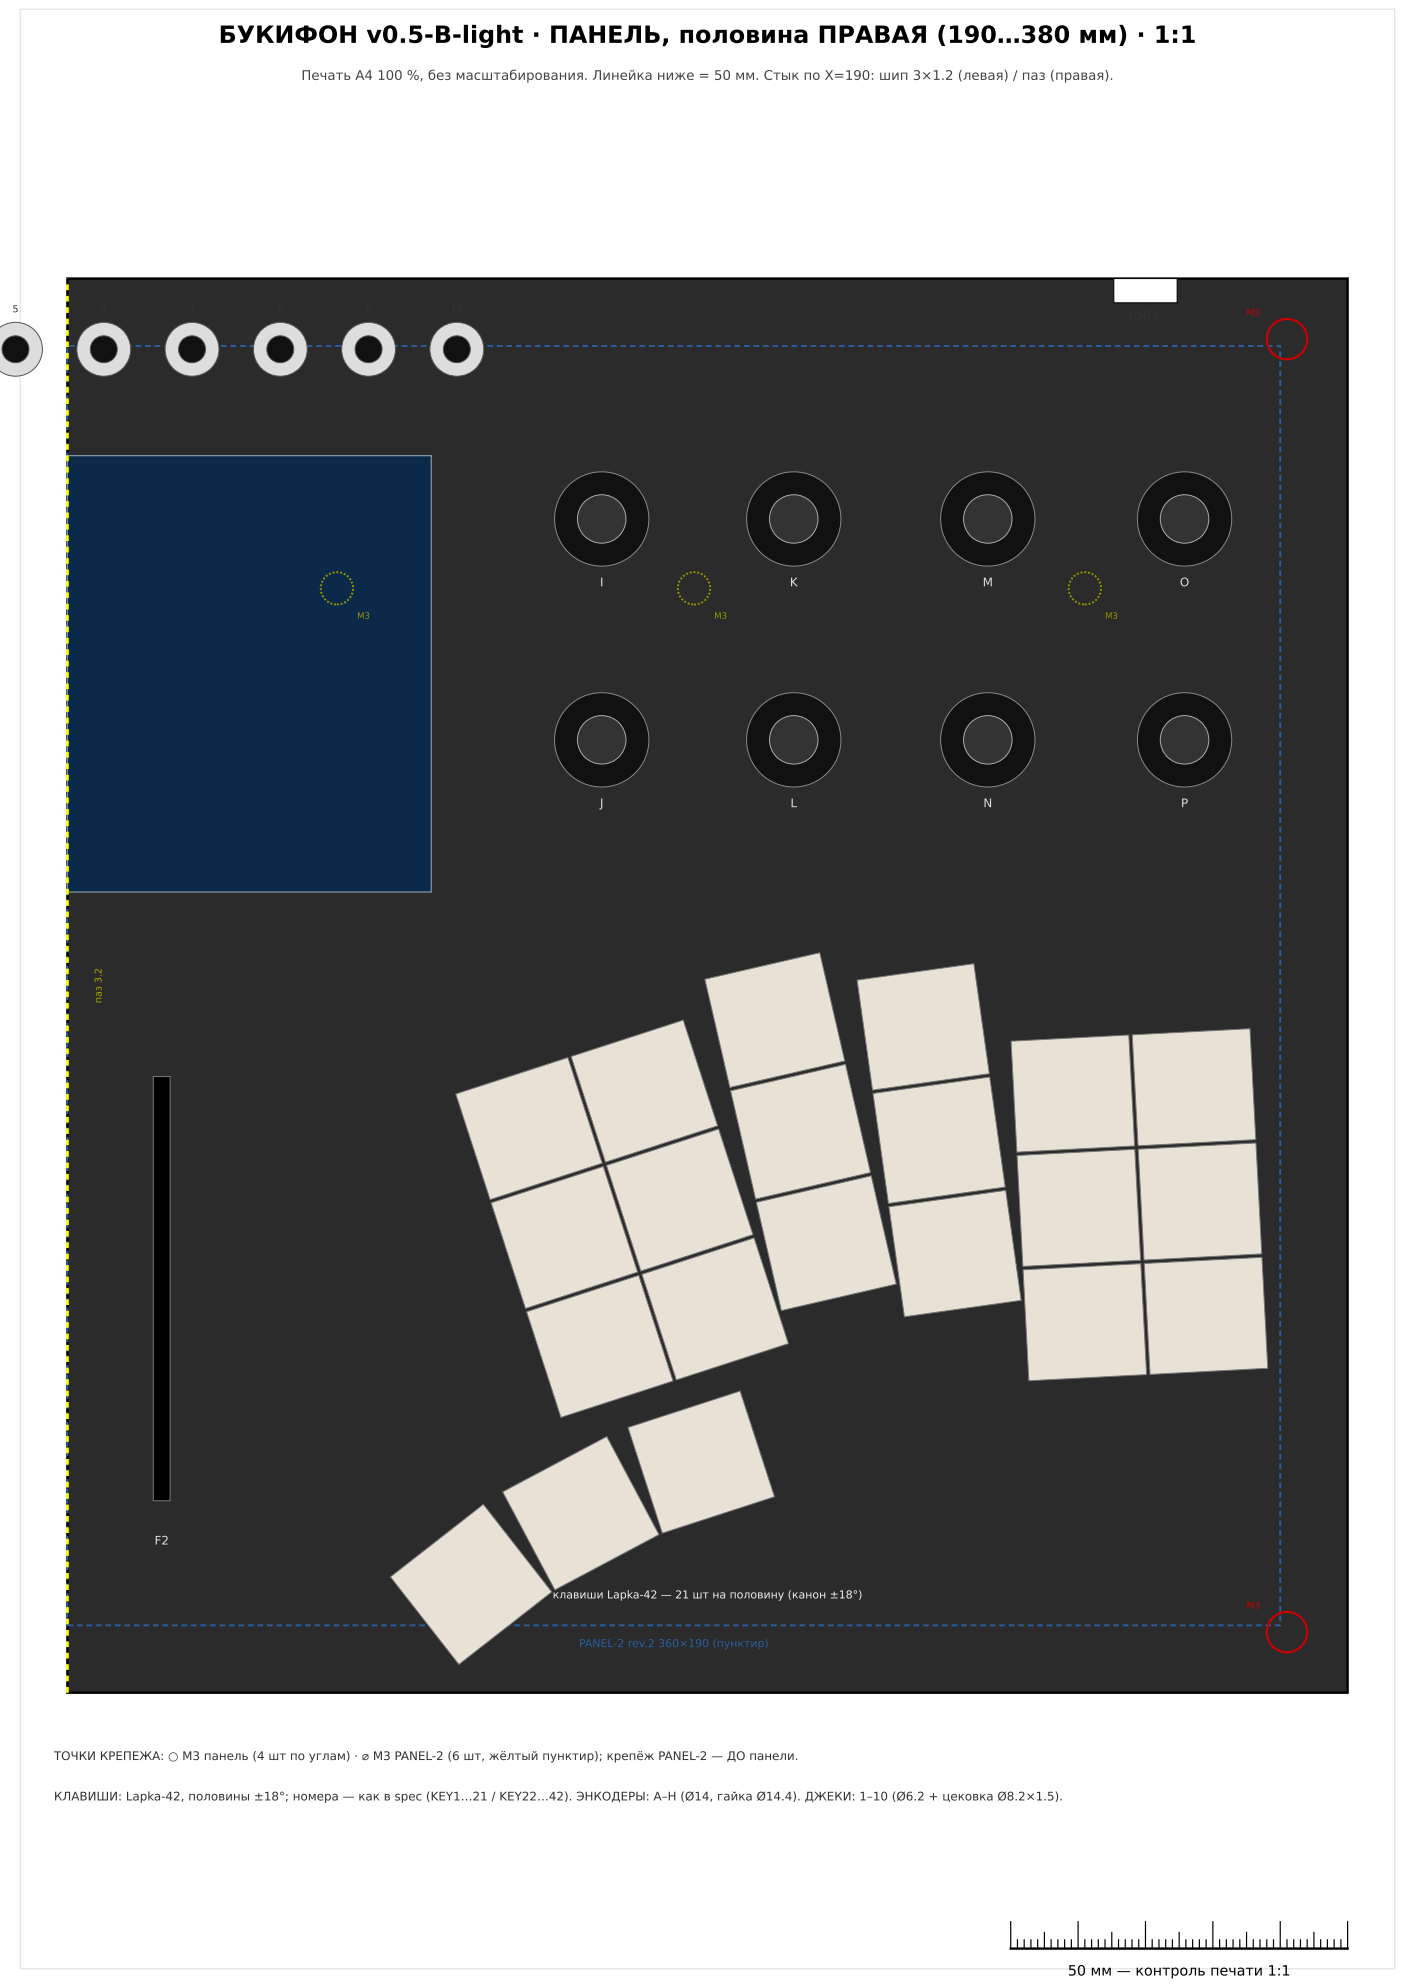
[picture p144: page 3]
USB-C; паз 3.2

клавиши Lapka-42 — 21 шт на половину (канон ±18°)

PANEL-2 rev.2 360×190 (пунктир)

ТОЧКИ КРЕПЕЖА: ○ M3 панель (4 шт по углам) · ⌀ M3 PANEL-2 (6 шт, жёлтый пунктир); крепёж PANEL-2 — ДО панели.

КЛАВИШИ: Lapka-42, половины ±18°; номера — как в spec (KEY1…21 / KEY22…42). ЭНКОДЕРЫ: A–H (Ø14, гайка Ø14.4). ДЖЕКИ: 1–10 (Ø6.2 + цековка Ø8.2×1.5).

# БУКИФОН v0.5-B-light (S3-base) · ЛЕГЕНДА, КРЕПЁЖ И ШЛЕЙФЫ

# ПОРЯДОК СЛОЁВ (снизу вверх)

### 1. body_L + body_R (B-light), шип/паз по X=190

# 2. Батарея 1S2P 18650 в ложементе (опция, справа)

### 3. PWR-2 rev.1 90×70 — 4×M2.5, Z6; J17 IDC-20 / J18 IDC-12

### 4. CORE-S3 rev.0 200×108 — 4×M3×6, Z12; J14/J15/J16

### 5. PANEL-2 rev.2 360×190 — 6×M3×6, 8 мм под панелью

### 6. Дисплей 5" — 4×M2.5×6 к панели, FFC-40

# 7. Панель 193+190 с шипом — 4×M3×8 по углам 8. Компоненты: 16 энкодеров, 42 Choc, 10 джеков, 2 фейдера

# КРЕПЁЖ

Винт | Кол-во | Куда
M3×8 потай | 4 | панель по углам (9/9, 371/9, 9/201, 371/201)
M3×6 | 6 | PANEL-2 на стойки (30/65/150/230/283/341, Y46)
M3×6 | 4 | CORE-S3 на стойки (95/285, Y59/151)
M2.5×6 | 4 | дисплей к панели
M2.5×8 | 8 | 2 фейдера (4 каждый)
M3×16 | 4 | стяжка половин корпуса (опция; шов панели держит шип)

# ШЛЕЙФЫ (проверить ориентацию ключа!)

Тип | Между | Длина
FFC-40 | дисплей ↔ CORE-S3 (J15) / PANEL-2 J12 | 1 шт, 10–15 см
IDC-26 | PANEL-2 J14 ↔ CORE-S3 J14 (аналог/джек) | 1 шт, 10 см
IDC-16 | PANEL-2 J13 ↔ CORE-S3 J16 (цифра/питание) | 1 шт, 10 см
IDC-20 | PWR-2 J3 ↔ CORE-S3 J17 (силовое) | 1 шт, 8–10 см
IDC-12 | PWR-2 J4 ↔ CORE-S3 J18 (управление) | 1 шт, 8–10 см
IDC-26 (шина) | P0/P1/P2 — картриджи/доки | опция

# ПЕРЕД ВКЛЮЧЕНИЕМ (минимум):

- все 4 слоя плат закреплены, шлейфы до конца в разъёмах (ключ совпал);
- полярность 2×18650 и разъёма батареи (переполюсовка = пожар);
- нет короткого замыкания +5/+3V3/±12 на корпус (прозвонить);
- дисплей FFC-40 вставлен, замок закрыт;
- винты затянуты 0.4 Н·м (PETG не перетягивать);
- USB-C/БП: сначала внешний 12 В без батареи, ток ≤0.5 А;
- прошивка: прошить, проверить DECK_ID/PANEL-2 I2C (0x20-0x23);
- калибровка: энкодеры 0…1023, фейдеры, CV out 0/5/10 В.

НЕ ЗАБЫТЬ: PANEL-2 и дисплей — ДО панели; энкодеры/клавиши/джеки/фейдеры — ПОСЛЕ укладки панели (гайки сверху). Порядок сборки и предупреждения — docs/34-assembly.md.
