martiyanov/bukifon/mechanical/preview_v05_B_light/assembly_exploded.jpg

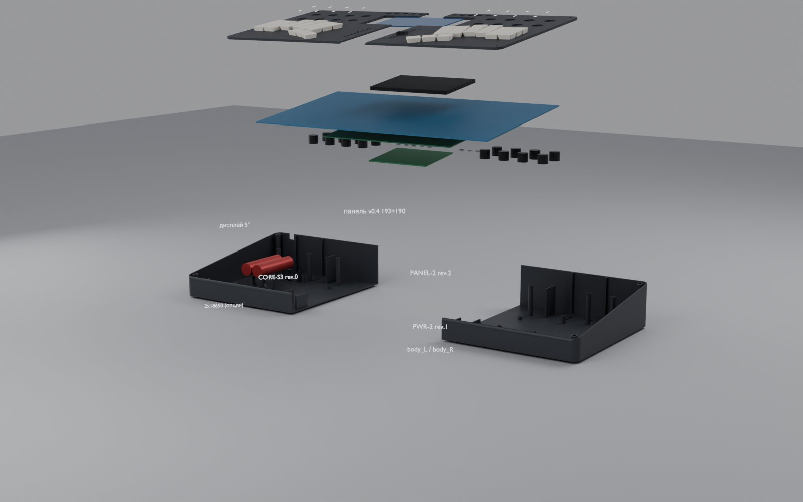
mechanical/preview_v05_B_light/assembly_exploded.jpg
