martiyanov/bukifon/renders/mech/iso_assembly.png

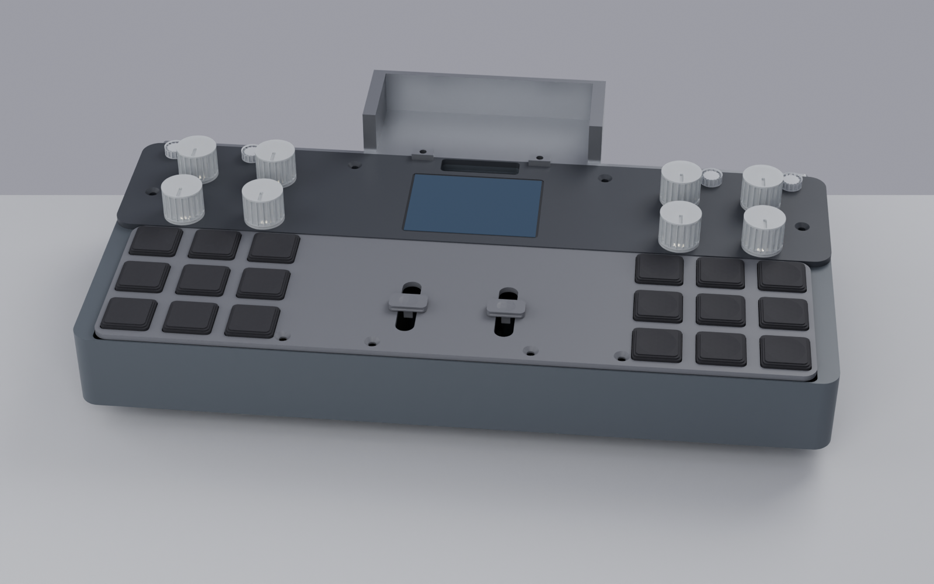
renders/mech/iso_assembly.png
