martiyanov/bukifon/renders/mech/iso_assembly_keys.png

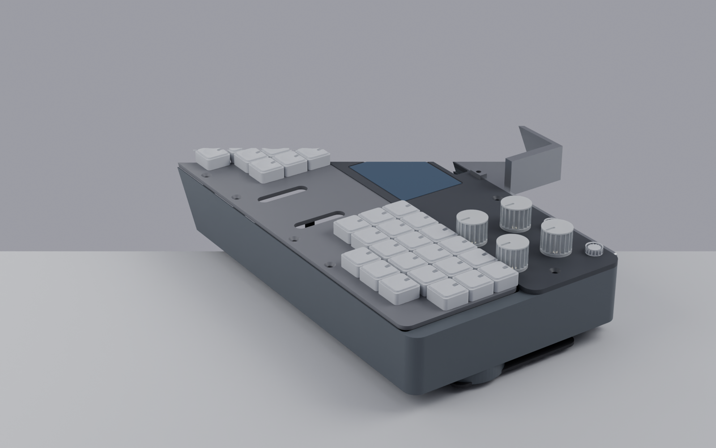
renders/mech/iso_assembly_keys.png
