martiyanov/bukifon/docs/pwr-results-template.csv

test_id | test_name | condition | limit | measured | unit | verdict | notes | date | tester
T1 | 3V3 rail ripple | Vin 5V, Iout 0.5A | <=30 |  | mV
T2 | 5V rail ripple | Vin 12V, Iout 1.0A | <=50 |  | mV
T3 | +12V rail | load 0-330mA | 12.0 ±5% |  | V
T4 | -12V rail | load 0-95mA | -12.0 ±5% |  | V
T5 | 5V load step | 0.2->1.4A | <=150 |  | mV
T6 | 12V load step | 0->0.3A | <=200 |  | mV
T7 | BMS charge | 1S LiPo 0.5C | 4.15-4.25 |  | V
T8 | BMS cutoff | discharge | 2.9-3.1 |  | V
T9 | MAX17048 SOC | known 50% | 45-55 |  | %
T10 | Efficiency 5V | 1A | >=85 |  | %
T11 | Thermal 5V 1A | 10 min | <=70 |  | C
T12 | USB-C 5V/3A | PD source | 4.9-5.1 |  | V
T13 | Protection OCP/OVP | trip test | <=3.3 |  | A
