martiyanov/bukifon/docs/57-usability-test.md

# Тест эргономики на бумажном/печатном макете

Цель — до траты пластика и денег проверить, что за инструментом удобно играть двумя руками,
читать экран и дотягиваться до всех органов. Макет: [paperkit 1:1](28-paper-kit.md) или
напечатанная половинка корпуса ([docs/35](35-print-first.md)).

## Кто и сколько

- 3–5 человек (не только автор): 1 опытный музыкант, 1 новичок, 1 «рост 190+», 1 «рост 160».
- 20–30 минут на человека, без обучения и подсказок.
- Макет на столе, стул обычный; экран-заглушка с картинкой UI (например, `firmware/artifacts/ui/synth.png`,
  напечатанная в размер 108×64.8 мм).

## 7 сценариев (записывать время и ошибки)

| # | Сценарий | Что оцениваем | Критерий «годно» |
|---|---|---|---|
| 1 | Положить обе ладони на панель, большие пальцы — на клавиши | посадка, свисание кистей | обе ладони лежат, большие пальцы достают клавиши без переноса |
| 2 | Дотянуться до дальнего энкодера (ENC A/H) без отрыва локтя | досягаемость | достаёт за ≤1.5 с, локоть на месте |
| 3 | Наклонить/повернуть макет, поймать угол экрана 30/35/45° | читаемость | 35° комфортнее 30° и 45° (отметить) |
| 4 | Два источника света (лампа слева/справа) → блики на экране | блики | при 35° блики не в зоне чтения |
| 5 | Запястье на передней кромке R4, 5 минут игры | давление/усталость | нет боли/вдавленности, кромка не режет |
| 6 | Фейдеры большими пальцами, не глядя | доступность | оба фейдера двигаются без перехвата |
| 7 | Три позы: сидя низко / прямо / стоя | общая эргономика | нет «затекания» за 3–5 мин в каждой |

## Форма записи

`docs/usability-results-template.csv` — колонки:
`participant,height,experience,scenario,time_s,errors,comfort_1_5,comment`
(1 — совсем неудобно, 5 — отлично). Заполнять по каждому сценарию.

## Критерии отказа (что менять в корпусе/панели)

- **≥2 участника** не достают дальний энкодер без переноса локтя → пересмотреть угол/глубину.
- Блики в зоне чтения при рекомендованном угле → матовое стекло/наклон/козырёк.
- Запястье устаёт за 5 минут → увеличить R4/скос/высоту передней кромки.
- Фейдеры требуют перехвата → сдвинуть/наклонить.
- Экран читается только в одной позе → козырёк/угол.

## 6a. Дистанционный blind-тест

Участник не рядом? Отправьте ссылку **https://martiyanov.github.io/bukifon/demo/?test=1** —
харнесс сам проведёт 8 задач с таймером и выдаст JSON. Протокол: [docs/74](74-usability-test-harness.md).

## Что сфотографировать

1. сверху (руки на панели, видно посадку);
2. сбоку (угол экрана, кромка, запястье);
3. три позы;
4. крупно экран при двух источниках света (блики);
5. фото с линейкой у кромки (высота/радиус).

## Что бумага/макет НЕ проверяет

- вес и жёсткость (проверяется печатной половинкой, docs/35);
- тактильность клавиш/энкодеров (только на реальных компонентах);
- тепло/шум;
- реальный UI (только заглушка).

## Результат

Сводка в `docs/57-usability-test.md` (таблица «участник → проблемы → решение»), решение:
какой корпус (A/B/B-light/C) и нужны ли правки панели до PCB.
