martiyanov/bukifon/firmware/bench/results/host.csv

scenario | blocks | block_frames | min_us | max_us | mean_us | p50_us | p95_us | p99_us | overruns | deterministic | pass | checksum
fm_voice | 2000 | 64 | 69.1670 | 315.3330 | 73.6721 | 70.0840 | 88.7184 | 137.9412 | 0 | 1 | 1 | 17058765422961135765
granular_track | 2000 | 64 | 10.8750 | 42.5830 | 11.4957 | 11.1250 | 12.6271 | 17.2109 | 0 | 1 | 1 | 1735647180516965950
mix_bus | 2000 | 64 | 4.9160 | 61.3750 | 5.2822 | 5.0000 | 5.2500 | 14.1254 | 0 | 1 | 1 | 5134474134364094870
psram_stream | 2000 | 64 | 1.2920 | 30.6670 | 1.8301 | 1.5840 | 2.7920 | 3.5848 | 0 | 1 | 1 | 17013409374725469234
ui_frame | 2000 | 64 | 50.5000 | 140.7080 | 52.9458 | 51.4580 | 57.1785 | 96.2592 | 0 | 1 | 1 | 12381763531129155184
ui_frame_partial | 2000 | 64 | 19.7910 | 105.8340 | 21.1707 | 20.2910 | 21.9581 | 47.6371 | 0 | 1 | 1 | 13118147200607307808
usb_descriptor | 2000 | 64 | 0.5830 | 8.1670 | 0.6422 | 0.6250 | 0.6670 | 0.7500 | 0 | 1 | 1 | 10642302694525822900
s3_profile | 2000 | 64 | 52.1250 | 215.9160 | 56.9744 | 53.1250 | 89.8371 | 111.7642 | 0 | 1 | 1 | 894414921837501835
p4_profile | 2000 | 64 | 72.4170 | 269.5420 | 77.6880 | 73.6250 | 100.7729 | 143.5897 | 0 | 1 | 1 | 3291457365238972008
