martiyanov/bukifon/firmware/bench/results/host_p4.csv

scenario | blocks | block_frames | min_us | max_us | mean_us | p50_us | p95_us | p99_us | overruns | deterministic | pass | checksum
p4_profile | 2000 | 64 | 72.3330 | 319.6660 | 76.9570 | 73.5830 | 97.2142 | 132.1723 | 0 | 1 | 1 | 3291457365238972008
