martiyanov/bukifon/firmware/bench/results/host_s3.csv

scenario | blocks | block_frames | min_us | max_us | mean_us | p50_us | p95_us | p99_us | overruns | deterministic | pass | checksum
s3_profile | 2000 | 64 | 51.1660 | 192.1250 | 56.7419 | 53.0830 | 86.5184 | 111.8426 | 0 | 1 | 1 | 894414921837501835
