martiyanov/bukifon/CHANGELOG.md

# Changelog

Формат: [SemVer](https://semver.org/lang/ru/). Даты — локальные (Europe/Moscow).

## [0.57.0] — 2025-11-06 — «Чистка репозитория»

### Удалено/оптимизировано
- **`archive/` (30 МБ)** — старые версии больше не хранятся в рабочем дереве; доступны в git-тегах
  и fresh-bundle. Минимально нужный `panel-spec-v1.7.json` перенесён в `mechanical/legacy/`;
  генераторы A/params_v17 используют его/текущие STL.
- **`hardware/*/rev1/two-sided/` (8.3 МБ)** — неудачный эксперимент с двусторонней расстановкой;
  скрипты сохранены, результаты воспроизводимы.
- **`fab/*/rev1-scaffold/` (2.8 МБ)** — генерируются по требованию `tools/export_fab_dryrun.sh`,
  в git не хранятся.
- **SVG-схемы** — сжаты в `.svg.gz`, дубли (root/svg) удалены (было 25 МБ → ~2 МБ).
- **Превью корпусов** — PNG→JPEG q85 (осталось 5 новых), `mic_backup_orig`, устаревшие page/preview PNG.
- **Неиспользуемые ассеты/refs** удалены; транзиентные превью в `.gitignore`.

**Итог:** tracked-размер **170 МБ → ~68 МБ**, файлов 1447 → ~1150; свежий bundle меньше.

## [0.56.0] — 2025-11-06 — «Шаблон панели: A3 и 4×A4»

### Исправлено (по замечанию заказчика)
- **1:1 шаблон панели обрезал низ**: панель 380×210 рисовалась на A4 (297×210) со сдвигом
  y=22 → нижние 22 мм (и нижний ряд клавиш) уходили за лист; проверки проверяли только
  пересечения/габариты деталей, но не выход за лист.
- Теперь: **A3 420×297, 1:1** (полная панель, поля 20 мм, кроп-марки, линейка 50 мм) +
  **4 листа A4** с перекрытием 10 мм (X 0–195/185–380, Y 0–115/100–210).
- В `panel_from_json.py` добавлена **проверка «колпачки вне панели»** (`outside_count`):
  0 при текущей спеке; `check_all` теперь валит сборку, если клавиша выходит за панель.
- docs/28/50, README, сайт — инструкции A3/4×A4; добавлено превью `docs/assets/panel-a3-template.jpg`.

## [0.55.0] — 2025-11-06 — «Статус objective: честно»

### Добавлено
- docs/90 §6: **v1.0-rc НЕ достигнут** — перечень конкретных физических блокеров (заказ P1/PWR/LCD,
  печать B-light, пересоздание репо) и условие для тега v1.0.0-rc.1. Весь доступный без железа
  объём закрыт и проверен.

## [0.54.0] — 2025-11-06 — «Синхронизация весов»

### Исправлено
- Синхронизированы актуальные массы/время корпусов во всех пользовательских местах:
  README (A 301/19.9, B 275.5/18.2, **B-light 228.9/11.0**, C 313.2/20.7; fitcheck 47/0),
  сайт RU/EN, docs/34/35; docs/27 помечен как исторический расчёт (актуальные — docs/45).

## [0.53.0] — 2025-11-06 — «Скачать и финальная проверка»

### Добавлено
- Сайт: секция **«Скачать»** (RU/EN) — корпус B-light STL/3MF, шаблон панели 1:1, BOM и прошивка;
  ссылки на быстрый старт/отчёт/ограничения.
- docs/90: таблица **финальной проверки** — check_all 8/8, security, 407/407, P4 369 552 Б,
  UX RU/EN PASS, MIC OK, DRC 0 на 4 платах, fab dry-run 4×PASS, bundle целостен.

## [0.52.1] — 2025-11-06 — «Сайт: профиль и разъёмы»

### Изменено
- Сайт (RU/EN): корпуса — фото-профиль с **PANEL-2 ∥ панели** и **задняя стенка** со всеми
  11 разъёмами; веса обновлены (A 301, B-light 228.9/11.0, C 313.2).
- docs/90 — финальный отчёт синхронизирован (407 тестов, P4 369 552 Б, B-light 228.9, ключи Lapka-42).

## [0.52.0] — 2025-11-06 — «PANEL-2 параллельна панели»

### Исправлено
- **Эргономика**: стойки PANEL-2 были вертикальны с горизонтальными торцами — плата ложилась
  на кромки, энкодеры/клавиши стояли не перпендикулярно наклонной панели. Теперь **6×M3 стойки
  наклонены вместе с панелью**, плата **∥ панели (0.00°)**, зазор 12.0 мм, оси энкодеров/клавиш ⊥
  панели; звуковод 7.5→11.5 мм. A (flat) не менялся.
- Вес/время: **B-light 228.9 г/11.0 ч**, B 275.5/18.2, C 313.2/20.7; fitcheck B-light **47/0**,
  B 35/0, C 40/0; board-fit `mount_plane` (углы 8°/12°); превью `side_profile` + `panel_parallel`.

### Добавлено
- **docs/91 «Софтовые модули и машины»**: `.bkm` (machine/effect/generator/utility), установка
  SD→USB→Wi-Fi (C6 web UI), подпись Ed25519, sandbox/лимиты, менеджер модулей, каталог; R-45/46,
  D-107/108. Ссылки в README/roadmap/FAQ/86.

## [0.51.0] — 2025-11-06 — «Клавиши — как Lapka-42»

### Исправлено
- **PANEL-2 rev.1**: refs `KEY_*` делились по номеру без учёта L/R → на левой плате были
  `KEY_R01…R11`, на правой `KEY_L11…L21`, клавиши накладывались. Теперь каждая плата содержит
  свои 21 клавишу (`KEY_L01…L21` / `KEY_R01…R21`) по координатам/углам
  `spec/panel-spec-v0.4.json` — точной геометрии Lapka-42 (upstream braindefender/lapka-42);
  проверка: после поворота +18° остаточное отклонение **0.006 мм**; DRC **0/0**.
- FB1 перенесён с фейдера F2; SVG/PDF перегенерированы; превью `panel-lapka-left/right.png`.
- docs/82 §10a, PANEL-2 rev1 README.

### Добавлено
- **Корпус A/A_mic** с актуальными вырезами: A **301.1 г/19.9 ч**, A_mic **302.5/20.0**;
  fitcheck A 19/0, A_mic 31/0; превью `rear_ports`, `left_ports`.

## [0.50.0] — 2025-11-06 — «Статус v1.0-rc: срез»

### Изменено
- **Сайт: актуальный статус v0.50.0** (RU/EN): прошивка 407/407, 7 вкладок, 12 треков,
  project v2, self-test 21, SDK v0.2; P4 bin 369 552 Б; платы rev.3 PRE-FREEZE;
  PCB rev.1 каркасы **DRC 0/0** + fab dry-run PASS; корпуса A/B/B-light 230.9/C;
  11 задних вырезов; BOM $241/$215/$196; заказ ≈$800; трассировка после MCU freeze.
- docs/75 — обновлены G4 (230.9 г) и список закрытого: каркасы PCB, сайт **bukifon.ru**
  (HTTPS, канон), все вырезы.

### Итог по objective
Инженерная часть и документация закрыты настолько, насколько возможно без железа. Блокеры:
**заказ ≈$800** (P1/PWR/LCD/печать), **печать B-light**, **пересоздание репо**; затем
PWR 13/13 → P1 → MCU freeze → трассировка → PCB rev.1 → прототипы → RC DoD.

## [0.49.0] — 2025-11-06 — «Все вырезы и честный статус PCB»

### Добавлено
- **Вырезы всех разъёмов** в корпусах: 11 задних — MIDI IN/OUT **TRS-A Ø8.2** (X30/44; прежний
  DIN Ø14 отменён), DC Ø9, EXPRESSION (резерв), mic, **LINE OUT** (стерео TRS), PHONES,
  AUDIO IN L/R, **CV OUT 5/6**; SD слева, USB-C; перемычки **≥3.8 мм**; B-light **230.9 г/11.2 ч**,
  B 276.2, C 313.2; fitcheck 16/0; превью `rear_ports` со всеми 11; docs/45/71/prints/board-fit.
- **PCB rev.1 — честный статус (docs/82 §12, D-105)**: 0 placeholder, но **328 упрощённых падов**
  и **GND без заливки**; полные реальные пассивы + зоны **не проходят DRC** (упаковка 373 комп.
  на 200×108), поэтому оставлен **DRC-clean каркас 0/0**; скрипты `build_full_pcb.py`/
  `add_gnd_zones.py` сохранены — применять после трассировки/оптимизации (MCU freeze).

## [0.48.1] — 2025-11-06 — «bukifon.ru — канон»

### Изменено
- **DNS bukifon.ru начал резолвиться** → выпущен TLS (certbot, bukifon.ru + www).
- **Канон: https://bukifon.ru/**; `www.bukifon.ru`, `bukifon.com`, `www.bukifon.com` → **301 на .ru**.
- Сайт: canonical/OG/hreflang/sitemap/robots переключены на **bukifon.ru**; README/доки обновлены.

## [0.48.0] — 2025-11-06 — «Fab dry-run и NVS»

### Добавлено
- **Fab dry-run из каркасов rev.1**: `fab/<board>/rev1-scaffold/` — Gerbers X2 (16 слоёв),
  drill PTH/NPTH (CORE-2 129, PANEL-2 45/45, PWR-2 4 отверстия), CPL/BOM, stackup, drawings,
  hole_report (`edge_cuts_closed=true`); `check_fab_package.py` — **PASS на всех 4**;
  `tools/export_fab_dryrun.sh`; docs/83 §8, D-104. Явно «DRY-RUN, NOT FOR ORDER» (нет трассировки).
- **P4 partitions + реальный NVS**: `partitions.csv` (nvs 24 KiB, factory **1 MiB**, storage 1 MiB,
  coredump 64 KiB), `NvsStorageBackend` (nvs blob get/set/commit/erase, namespace `bukifon`),
  `nvs_flash_init` с erase+retry, self-test `project.meta`/`lang` → `NVS OK`.
- **P4 build**: bin **369 552 Б** (0x5a390), factory 1 MiB — **65 % свободно**; compile-fix
  (`bukifon::NvsStorageBackend`, static `openNs`, `esp_err.h`), host 407/407.
- docs/42 §10, docs/59 §9, docs/82 §11, spec/90 D-104.

## [0.47.0] — 2025-11-06 — «Футпринты и правила»

### Добавлено
- **Реальные футпринты в PCB rev.1**: **0 placeholder** (было 16 + 42); кастомные `.kicad_mod`
  (`A1_P4_MODULE_ADAPTER`, `C6_MINI_1`, `MP1584_MODULE`, `CHOC_V1`) + стандартные KiCad
  (TRS, BarrelJack, SW_PUSH, QFN BQ24074); вставка через pcbnew API, пады с net.
- **DRC-правила/классы**: `Default`, `Power` (1–2 мм), `USB_HS` (**90 Ω diff 0.2/0.2**),
  `Audio` 0.25, `RF`; via 0.6/0.3 и 0.8/0.45; проверка **RULES PASS** (5 классов + USB_DP/DM,
  +12V, AUDOUT_L, C6_CS).
- **План GND-полигонов** (F/B.Cu, AGND/PGND/звезда, LED-возврат, keepout антенны) — без заливки.
- DRC **0/0** на всех 4 платах; refs/pads: CORE-2 373/1259, PANEL-2 181/174 (630/488), PWR-2 128/332.
- **Сайт**: canonical/OG/hreflang/sitemap/robots переключены на **https://bukifon.com/**
  (HTTPS live); GitHub Pages остаётся зеркалом.

## [0.46.0] — 2025-11-06 — «Нетлист в каркасах rev.1»

### Добавлено
- **Импорт нетлиста в каркасы PCB rev.1** (`hardware/*/rev1/`): сети, футпринты, пады по нетлисту
  (KiCad CLI не умеет Update PCB from schematic — генератор `import_netlist.py`):
  CORE-2 **373 refs / 1224 пада**, PANEL-2 left **181** / right **174** (по 21 Choc), PWR-2 **128**.
- **Footprint-маппинг** из BOM: стандартные библиотеки; **placeholder'ы** для кастомных —
  CORE-2 16 (P4-модуль A1, C6 U31, BQ24074, MP1584, TRS/DC/mic джеки, кнопки), PANEL-2 21×2
  (Choc), PWR-2 0.
- **Расстановка по зонам** board-fit/keepout (USB-C у кромки, C6 у антенны, энкодеры/клавиши/
  джеки по JSON, силовая зона PWR-2); **DRC 0 errors/0 warnings**, `verify_import.py` PASS;
  unconnected зафиксированы (трассировка — после MCU freeze).
- docs/82 §10, README в `rev1/`, spec/90 **D-102**; docs/73 — обновление статуса.

## [0.45.0] — 2025-11-06 — «Каркасы PCB и вырезы»

### Добавлено
- **Каркасы PCB rev.1 в KiCad** из `mechanical/board-fit/`: CORE-2 **200×108** (6 слоёв),
  PANEL-2 две платы **180×190** (4 слоя), PWR-2 **90×70** (4 слоя, 2 oz); Edge.Cuts, NPTH-крепёж
  H1…, подписанные keepout (C6-антенна/аналог/DC-DC, экран/клавиши/энкодеры/фейдер/MIC_LED,
  батарея, hot-loop), шелкография «PRE-FREEZE»; `gen_scaffold.py`/`verify_scaffold.py`;
  **DRC 0 errors/0 warnings/0 unconnected**, verify **PASS ±0.05 мм**; SVG/PDF/README в каждом `rev1/`;
  docs/82 §9, spec/90 D-101.
- **Вырезы разъёмов в корпусе** (B-light/B/C/B_mic/C_mic): **MIDI Ø14 X76**, **DC Ø9 X91**,
  **EXPRESSION Ø8.2 X120.5**, **mic Ø8.2 X140**, **SD 12×2** слева, USB-C; перемычки **≥3.5 мм**
  (было 2.5); `conn_cuts_v05.py`; fitcheck **16/0**; B-light **231.1 г/11.2 ч** (B 276.6, C 313.6);
  превью `rear_ports`, `left_ports`; docs/45/71/prints/board-fit обновлены.

## [0.44.1] — 2025-11-06 — «HTTPS bukifon.com»

### Исправлено/добавлено
- **bukifon.com работает по HTTPS** (Let's Encrypt; `www.bukifon.com` → 301 на apex); сайт RU/EN,
  демо и ассеты отдаются с VDS (200).
- **Исправлен auto-TLS watcher**: инвертированная проверка A-записи (`-z ${a##*IP*}`) не давала
  выпустить сертификат; теперь .com выдан автоматически, .ru ждёт делегации NS.
- nginx: отдельные vhost'ы для apex/www (.com), редирект www; docs/88 обновлён; watcher в репо.

## [0.44.0] — 2025-11-06 — «Board-fit и RC-пакет»

### Добавлено
- **`mechanical/board-fit/`**: контуры плат для разводки PCB rev.1 — **CORE-2 200×108**
  (4×M3), **PANEL-2 две платы 180×180** в контуре 360×190 (3×M3 каждая), **PWR-2 90×70**
  (4×M2.5); origin/отверстия/вырезы/keepout'ы в `board-spec.json`; **DXF (R12, Y-up)** для
  KiCad Edge.Cuts, assembly.dxf, превью; **22 проверки, 0 конфликтов** (fit_check).
- Исправлены TBD в docs/82: реальные стойки PANEL-2 (6×M3: 30/65/150/230/283/341, Y=46),
  контур (было «380×210» → 360×190), PANEL-2 = две платы.
- Найдено: в STL **нет вырезов** MIDI TRS/DC/EXPRESSION/mic jack/SD — в board-spec даны
  предложенные позиции (добавить в корпус перед печатью).
- **`tools/make_rc_bundle.sh`**: сборка RC-кандидата одним вызовом (check_all + security +
  release bundle + fresh + чек-лист docs/87); docs/87 обновлён.

## [0.43.1] — 2025-11-06 — «Vhost'ы по доменам и watcher DNS»

### Изменено
- nginx: отдельные vhost'ы для `bukifon.com/.ru` и временного `…sslip.io`, общий
  `deploy/nginx/bukifon-site.inc`; сайт доступен по HTTP на новых доменах, HTTPS — после DNS.
- `deploy/vds/bukifon-tls-wait.sh`: проверка A/AAAA через DoH, выпуск/расширение TLS для
  `.com` и `.ru` по готовности, автоматическое снятие cron; лог `/var/log/bukifon-tls.log`.
- docs/88 — обновлённая схема; ежедневные бэкапы (tar.gz, retention 7).

## [0.43.0] — 2025-11-06 — «Хранение и бэкапы»

### Добавлено
- **Storage backend** (`storage_backend.*`): MockFlash (fail-after-N/power-cut/bit-flip, счётчики),
  SdFileBackend, NvsBackend-stub; namespace/key API.
- **AtomicStorage A/B**: magic/version/sequence/CRC32, запись в неактивный слот → verify →
  переключение, recovery при повреждении копии, ошибка без частичной загрузки при двух битых.
- Интеграция: project v2 `.bkfp`, preset bank 8 слотов, язык UI, серийник/настройки —
  через backend; **407/407 тестов** (+16, включая power-cut и bit-flip).
- **VDS**: ежедневный бэкап сайта/nginx (tar.gz, retention 7, cron 03:30) — `deploy/vds/bukifon-backup.sh`,
  docs/88 §8; авто-TLS watcher для доменов.
- docs/70 §10, docs/42 §9 — хранение/recovery/TODO(hw).

## [0.42.1] — 2025-11-06 — «Авто-TLS для доменов»

### Добавлено
- `deploy/vds/bukifon-tls-wait.sh` + cron на VDS: ждёт A-записи `bukifon.ru/.com` (и удаления
  старых IP), затем выпускает TLS на 4 имени и снимает cron; лог `/var/log/bukifon-tls.log`.
- docs/88 — авто-TLS, проверка; временный HTTPS `bukifon…sslip.io` уже работает.

## [0.42.0] — 2025-11-06 — «Сайт на VDS»

### Добавлено
- **Сайт задеплоен на VDS** (тот же, что agonarena.ru): `/var/www/bukifon` (RU/EN, `/demo/`,
  пресскит, sitemap/robots/llms), nginx vhost + **HTTPS** (certbot) — временный адрес
  `https://bukifon.37-46-18-40.sslip.io/` (200 на `/`, `/en/`, `/demo/`, `/demo/?lang=en`, `/app/`).
- `tools/deploy_vds.sh` (rsync + vhost + certbot по `VDS_HOST`), `deploy/nginx/bukifon.conf`.
- **docs/88 «Деплой на VDS»**: DNS-записи (A @/www → VDS, удалить старые AAAA), TLS,
  обновление/откат, проверки, безопасность; docs/86 — статус.

### Ожидает
- DNS bukifon.ru/.com → 37.46.18.40 (сейчас старые A/AAAA), затем certbot для 4 имён.

## [0.41.0] — 2025-11-06 — «Бэклог веб/плагин и черновик RC»

### Добавлено
- **docs/86 «Бэклог: сайт на VDS, веб-приложение, DAW-плагин»**: план для bukifon.ru/.com
  (DNS/nginx/TLS/деплой), PWA-приложение (Web MIDI, микрофон, 4+8 треков, project v2,
  WAV/stems, share, RU/EN), плагин (JUCE 8 → VST3/AU/Standalone + CLAP, общий движок),
  оценки/этапы/риски. Решение: **после v1.0-rc** (D-97…D-100).
- **docs/87 черновик release notes v1.0-rc**: состав, критерии приёмки (8 сценариев,
  self-test 21/21, UX 5 людей, PWR/P1/fab), известные ограничения, команды проверки.
- Реестр: **R-41…R-44**, **D-97…D-100**; roadmap P9; README.

## [0.40.0] — 2025-11-06 — «Демо RU/EN и доступность»

### Добавлено
- **Локализация веб-демо RU/EN**: таблица **256 ключей** (кнопки/страницы/параметры/макросы/
  EXT/MIC/GEN/статусы/UX-тест/сообщения), переключатель в шапке, `?lang=en`, localStorage;
  canvas-текст через `t()`; аудит ширины **187 строк, 0 overflow** в RU и EN.
- **Доступность демо**: `aria-label`/`role` у кнопок/джеков/энкодеров/клавиш/фейдеров,
  `role=slider` + клавиатура (стрелки/Shift/PageUp/Down/Home/End), видимый фокус,
  live-region для сообщений, `role=img` + описание canvas.
- **EXT-энкодеры в демо**: левые 8 в режиме EXT управляют CH/PROG/VEL/LEN/CC#/CC VAL/SWING/CLK
  выбранного трека (диапазоны, клавиатура, undo), не page-параметрами; авто-тест RU/EN
  проверяет drag/keyboard/Home/End и неизменность page-params.
- **GitHub Actions CI** (`.github/workflows/ci.yml`): host-тесты, docs links, BOM↔netlist,
  PWR-шаблон, security; `tools/security_scan.sh` — портируемый `${PYTHON:-python3}`.
- UX-тест расширен: RU + EN прогоны, a11y/клавиатура/EXT/ширина строк; итог **RU PASS · EN PASS**.

### Исправлено (найдено при локализации)
- переполнение ячеек mute/off-суффиксом; canvas игнорировал текущую страницу; page-энкодеры
  использовали заглушку 0..1; TypeError в битбоксе; ensureScenes при клавиатуре.

## [0.39.1] — 2025-11-06 — «Счётчики тестов»

### Исправлено
- docs/32/73/75: 365/365 → **391/391 тестов** (синхронизация с прошивкой).

## [0.39.0] — 2025-11-06 — «Кириллица и вторые источники»

### Добавлено
- **Кириллический bitmap-шрифт** (`font_cyrillic6x8.*`): **66 глифов** 6×8 (А–Я, а–я, Ё/ё),
  UTF-8→glyph lookup, метрики ширины; `drawTextRole`/`drawText`/legacy рисуют настоящую
  кириллицу, **транслитерация `uiAsciiForLabel` удалена**; короткие display-ключи MIC/GEN;
  max ширина ключа **90 px при ячейке 94 px**.
- **391/391 тестов** (+14): покрытие алфавита, все RU-ключи без fallback, ширина, RU/EN кадры,
  smoke 7 страниц, реальный глиф vs `?`, UTF-8 метрики; 10 скриншотов RU/EN.
- **docs/85 «Вторые источники»** + `tools/bom_second_source.py`: 87 позиций, 52 без замены
  (пассив/механика/аксессуары), таблица 20 критичных (P4, C6, DAC/ADC, TPS61088, BMS, MCP,
  MAX9814/TS5A/ICS-43434, дисплей, Choc/EC11), supply-чеклист и план Б.

## [0.38.0] — 2025-11-06 — «RU/EN и English docs»

### Добавлено
- **Локализация UI RU/EN**: `bukifon_i18n.h` + `i18n.cpp`, **90+ ключей** (`tr()`), покрыты
  7 вкладок/страницы/контекст-строка/GEN/EXT/MIC/статусы/ошибки self-test; EN ≤28 символов;
  переключение `setLanguage/getLanguage`, сохранение языка в project v2 (v1 и старый v2 → RU).
- **377/377 тестов** (+12): все ключи непустые/уникальные, missing-key, snapshot RU/EN,
  project v2 язык, обратная совместимость, рендер обеих локалей.
- Скриншоты `firmware/artifacts/ui/synth_ru.png`, `synth_en.png`; `--lang RU|EN` в sim.
- **English docs**: `docs/en/README.md` (индекс/факты/ограничения) и `docs/en/quick-start.md`.
- `tools/ci_p4_remote.sh` — воспроизводимая P4-сборка + host-тесты (365/365 на home).
- docs/61, docs/66 — разделы локализации.

## [0.37.0] — 2025-11-06 — «Проект v2 и cost-down»

### Добавлено
- **Project v2 `.bkfp`** (`firmware/src/storage/project_v2.*`): 4 внутренние партии + GEN +
  **8 EXT-треков** + mic-настройки/пэды + модули + тема/транспорт, **CRC32**, метаданные;
  транзакционная загрузка (при ошибке состояние не меняется), лимиты/валидация;
  **миграция v1→v2** (старые паттерны/BPM/чейн сохраняются, новые секции — дефолты).
- **365/365 тестов** (+14): roundtrip, миграция, CRC/версия/короткий файл, транзакционность,
  детерминизм, preset bank, apply/capture.
- **docs/84 «Cost-down»**: где деньги (P4 $18, дисплей, корпус, микрофон-узел $17.6), варианты
  экономии −$2…3/шт без потери функций, маржа при $299/$319/$349, план по приоритету.

## [0.36.0] — 2025-11-06 — «Разводка и fab-пакет»

### Добавлено
- **docs/82 «План разводки PCB rev.1»**: стеки (CORE-2 6L, PANEL-2/PWR-2 4L, 2 oz на PWR-2),
  контуры/крепёж (6×M3 PANEL-2), floorplan зон (USB/антенна C6/аналог/DC-DC/MEMS), критичные
  цепи (USB HS 90 Ω, I2S, микрофон, LED, CV/GATE), DRC/DFM-минимум, процесс и риски.
- **docs/83 «Fab-пакет»**: состав (`gerbers/`, `drill/`, `bom.csv`, `cpl.csv`, stackup,
  fab/assembly drawings, README), правила имён, CPL/BOM-схема, чек-лист перед отправкой,
  приёмка (AOI/X-ray/тест-лог/ESD), хранение.
- **`fab/README.md`** — заготовка пакетов core2/panel2/power2 rev1 (появятся после freeze).
- **`tools/check_fab_package.py`**: проверка состава, Gerber≥8 слоёв, drill, CPL-колонки,
  CPL↔BOM (refs, DNP), PII — проверено на фикстуре (**пакет готов**).

## [0.35.1] — 2025-11-06 — «Медиа-политика превью»

### Исправлено
- Превью корпусов (`mechanical/preview_v05_*`): **14 PNG → JPEG q85 ≤1400 px** (по AGENTS §4b),
  размеры папок 9.4 МБ → 0.15–0.3 МБ; ссылки в docs/45/50/71 и mechanical обновлены
  (проверка ссылок: **643, 0 битых**).
- Fresh-history bundle: 80 МБ → (см. новый бандл) — меньше медиа, ближе к цели пересоздания репо.

## [0.35.0] — 2025-11-06 — «Bring-up и микрофон в B/C»

### Добавлено
- **P4 bring-up app** (`firmware/idf_p4/main/app_main.cpp`): UART 115200 баннер/чип/PSRAM/IDF,
  I2C-скан (0x20–0x27/0x48–0x4F/0x50–0x57 + 0x36/0x60/0x61, 8/8 PASS), RGB565 800×480
  (color bars/checker/grid/text), engine bench 1000×64 (≤650 µs), I2S1 MEMS 1 с RMS/peak
  (PASS >−60 dBFS или SKIP), heartbeat; ошибка дисплея/микрофона не паникует.
  **Сборка IDF 5.5: 330 512 Б, 0 warnings, 78 % app-раздела свободно**; CPU по умолчанию 360 МГц.
- **Корпуса B_mic и C_mic**: опциональный порт микрофона (Ø1.8, 122.0/5.5 + LED 116/10.5,
  MEMS-углубление) для B/C, отдельные папки STL/3MF/STEP, assembly JSON, превью с mic_closeup;
  **B+mic 278 г/18.4 ч, C+mic 316 г/20.9 ч**; fitcheck **44/0** и **49/0**.
- docs/59 §9, docs/80 §6 (команды/ожидаемый лог), docs/45/50/71, docs/32 — обновлены.

### Исправлено
- `app_main.cpp`: `<initializer_list>` (GCC), убраны deprecated `sram_trans_align`/
  `psram_trans_align`; `sdkconfig.defaults` — **360 МГц** (400 в IDF 5.5 для P4 недоступны).

## [0.34.0] — 2025-11-06 — «FAQ и пресс-кит»

### Добавлено
- **docs/81 FAQ**: цена/сроки, P4 vs S3, микрофон, батарея, габариты, звук/треки, внешний
  секвенсор, модули, лицензии, ремонт/гарантия, сравнение с аналогами, как помочь.
- **docs/press/**: пресс-кит — буилерплейт RU/EN, факты, 3 изображения, ссылки, контакт.
- Сайт: секция **FAQ** (6 карточек + ссылки на полный FAQ/пресс-кит), пункт меню.
- **`tools/verify_release_bundle.sh`**: проверка SHA256SUMS (0 нарушений), обязательных файлов
  и отсутствия абсолютных путей в release bundle — **bundle целостен**.

## [0.33.0] — 2025-11-06 — «День 1 и ссылки»

### Добавлено
- **docs/80 «День 1 с железом»**: runbook PWR (13 измерений + gate) → CORE-2 (15 шагов
  bring-up: rails/I2C/display/matrix/loopback/микрофон/self-test/burn-in) → P1 (P4 vs H743,
  критерии MCU) + таблица «если что-то не так».
- **`tools/check_docs_links.py`**: проверка относительных ссылок во всех markdown
  (**617 ссылок, 0 битых**), встроена в `check_all` шагом **8/8**.

### Исправлено
- 20 битых ссылок: legacy-документы (00/01/02) переведены на актуальные артефакты
  (stl_v05_*, preview_v05_*, renders/templates), docs/34 (.jpg), docs/51 (`../hardware/...`),
  docs/reviews (`:line` из ссылок), firmware/tests/REPORT.md (`../../docs/`).

## [0.32.0] — 2025-11-06 — «Проверки BOM и PWR»

### Добавлено
- **`tools/check_bom_netlist.py`** — сверка BOM ↔ netlist (позиции, off-board-фильтр): CORE-2
  **332/332 OK**, PANEL-2 **340/340 OK**, PWR-2 **116/116 OK**; встроено в `check_all` шагом 7/7.
- **`tools/pwr_bench_check.py`** — валидатор 13 измерений PWR против лимитов (`<=`, `>=`,
  `±%`, диапазон), режимы `--json`/`--strict`, пустые = SKIP; docs/51 — как запускать.
- `docs/pwr-results-template.csv` исправлен (кавычки в condition, 13 корректных строк).
- PWR-2 BOM: BT1/BT2/TH1 помечены **off-board** (батарея/термистор вне платы) — BOM↔netlist
  теперь без «фантомных» расхождений.

## [0.31.1] — 2025-11-06 — «security: пути»

### Исправлено
- docs/59 §9: абсолютные `/home/...` заменены на `$HOME/...` — `security_scan` снова ✅.

## [0.31.0] — 2025-11-06 — «Аналоги и P4-сборка»

### Добавлено
- **docs/79 «Аналоги 2025–2026»**: сравнение с Digitakt II ($1099), Play+ ($999), Move ($549),
  M8 ($699), Deluge (€1335), EP-133 (~$200–300), Liven (€271–280); позиционирование Букифона
  ($299: 42 клавиши, 16 энкодеров, 10 джеков, CV/GATE, микрофон, открытость); чему учимся и где
  не конкурируем; источники с ценами.
- **docs/59 §9**: повторная сборка P4 на home `pole` — **351/351** host-тестов (GCC 13),
  `idf.py build` SUCCESS, `bukifon_p4.bin` **255 104 Б**, HP RAM 1.27 %.

### Исправлено
- `firmware/src/io/mic.cpp`: добавлен `<cstdio>` — GCC 13 (Ubuntu) собирает без ошибок
  (`std::snprintf`); найдено при кросс-проверке на домашнем ПК.

## [0.30.1] — 2025-11-06 — «Module SDK v0.2»

### Добавлено
- **SDK модулей v0.2**: манифест `bukifon.module.v2` (schema/id/name/version/api/author/abi/
  permissions/params/dsp/size/sha256/license), валидатор (SemVer, API major=0/minor≤host,
  ABI host/p4/s3, permissions, params 1–16, sha256) и **loader**: manifest→API→ABI→size→SHA
  проверяются **до исполнения**, при ошибке ничего не грузится/не выполняется; список,
  лимит 16, счётчики.
- **Два примера**: `mod_tape_delay` (эффект, детерминизм) и `mod_euclid_arp` (Euclid 5/16 +
  ARP 60/64/67) с manifest/README/LICENSE; упаковка zip + `--check`.
- **351/351 тестов** (+20), docs/24 SDK v0.2, docs/60 v2-каталог; шаблон PWR-измерений
  в docs/51; root `tools/package_module.py` синхронизирован с v0.2.

## [0.30.0] — 2025-11-06 — «Поддержка и бенч»

### Добавлено
- **docs/78 «Поддержка и ремонт»**: быстрая диагностика (питание/звук/экран/микрофон/SD/EXT),
  recovery прошивки (BOOT+RESET, UART0, esptool), таблица запчастей (Choc/EC11/фейдеры/джэки/
  дисплей/MEMS/USB-C/F1), гарантия 12 мес и границы DIY.
- **`docs/pwr-results-template.csv`** — 13 измерений PWR (T1–T13) с limit/verdict для
  заполнения на стенде; docs/51 — ссылка и правило stop/go.

## [0.29.3] — 2025-11-06 — «README версия»

### Исправлено
- README: VERSION/заголовок приведены к 0.29.x (check_all снова ✅).

## [0.29.2] — 2025-11-06 — «README: 21 self-test»

### Исправлено
- README: CORE-2 DFM/DFT — **21 self-test** (было 20), синхронно с прошивкой (331/331) и docs/42.

## [0.29.1] — 2025-11-06 — «Self-test 21»

### Добавлено
- **Factory self-test расширен 14 → 21 пункт** (`firmware/src/factory/selftest.*`): EEPROM 24C32+SN,
  MCP4728, C6 link, CV inputs/TVS, UART0/BOOT, serial/QR и **microphone** (MEMS 1 с/VAD,
  RMS −60…0 dBFS, SNR ≥65 дБ, MIC_SEL, SW3 mute блокирует запись, LED, loopback ≤5 мс).
- Каждый пункт: PASS/FAIL/TIMEOUT/**SKIP**/detail/время, JSON `count:21`; mock 21/21 PASS,
  P4 без toolchain — 21 SKIP (`isAvailable`), без фальшивых результатов.
- **331/331 тестов** (+20); скриншот станции 21/21 `firmware/artifacts/factory/selftest.png`;
  docs/42 §8 — таблица 21 пунктов с TODO(hw), docs/38 синхронизирован.

## [0.29.0] — 2025-11-06 — «Быстрый старт»

### Добавлено
- **docs/77 «Быстрый старт: идея за 10 минут»**: включение, звук, зеркальная карта, секвенсор,
  GEN, запись/ресемплинг, голос (MIC REC/BEATBOX), внешние синтезаторы (EXT), типовые проблемы.
- Сайт: секция «Отчёты/документы» дополнена быстрым стартом и отчётами (docs/73/75).
- Планируется в этом релизе: factory self-test 21 пункт (firmware-dsp).

## [0.28.0] — 2025-11-06 — «Мобильный сайт и сборка микрофона»

### Добавлено
- **Мобильная адаптация сайта** (RU/EN): nav wrap, clamp-заголовки, одноколоночные гриды,
  таблицы/код со скроллом, изображения max-width — горизонтального скролла больше нет
  (проверено 414×896: scrollW=innerW).
- **Кнопка «Пройти UX-тест (8 задач)»** в секции демо на сайте.
- **Демо на телефоне**: экран поднят выше ручек (order), панель в одну колонку.
- `docs/34`: раздел «Микрофон» — порт/поролон/сетка, звуковод, J16↔J19 1:1, mute/LED,
  3.5 мм jack, клипсы, тест (SNR/изоляция/задержка).

## [0.27.1] — 2025-11-06 — «COGS с микрофоном»

### Изменено
- **Product BOM P4/S3 обновлён под rev.3 + микрофон**: COGS P4 **$241/$215/$196** (было
  $223/$198/$180), S3 **$224/$199/$181**; mic-узел **1 405 ₽ ≈ $17.6** (PANEL-2 640 ₽,
  CORE-2 680 ₽, механика 85 ₽); маржа $299 на партии 10 — gross 28.1 %, net ~18 %.
- docs/54: P1-группа с mic-набором — **$442.4**; итого gross **$834.12**, к оплате ≈**$800**.
- README/сайт/docs/73 — актуальные цифры.

## [0.27.0] — 2025-11-06 — «Микрофон в демо и границы версии»

### Добавлено
- **Демо: запись с микрофона** — MIC → `REC MIC` (до 30 с) → PAD «VOICE nn», WebAudio,
  без обратной связи; smoke-тест `tools/test_demo_mic.js` (headless Chrome + fake-устройство)
  → **MIC-DEMO: OK** (2.2 с сэмпл, 0 ошибок).
- **docs/76 «Известные ограничения»**: SPI-экран S3-lite, USB stereo vs 8×8, лупер/вокодер
  в backlog, 1 CC p-lock, SDIO 1-bit, батарея не в первой партии, B-light/A/C особенности,
  Module API v0, цены ±30 % — всё честно и до покупки.

### Изменено
- docs/58 — MIC REC; README — docs/76.

## [0.26.1] — 2025-11-06 — «Вариант A в текущем генераторе»

### Добавлено
- `mechanical/stl_v05_A/`: плоский корпус A (0°, 380×210×63, **302 г / 20.0 ч**), панель = канон
  (83 выреза), 6 STL + 7 3MF + сборка; `preview_v05_A/` (iso/side/exploded/top/front) и
  обновлённое сравнение A/B/B-light/C; fitcheck **17/0**; генератор `case_v05.py A`,
  `fitcheck_v05_A.py`, `render_v05_A.py`.

### Изменено
- docs/50: A-flat теперь из `mechanical/stl_v05_A/` (не из архива); обновлены ссылки и таблица.
- mechanical/{prints.md,README.md,assembly.md}, docs/45 — актуальные варианты v0.5.

## [0.26.0] — 2025-11-06 — «Ворота релиза и авто-тест UX»

### Добавлено
- **docs/75 — готовность к v1.0-rc**: 12 ворот (G1 заказ P1 … G12 репозиторий) со статусами,
  владельцами, доказательствами и точками stop/go; закрытые инженерные пункты и порядок
  действий на 2 недели.
- **Авто-проверка UX-харнесса** `tools/test_demo_ux.js`: headless-прогон 8 задач, критерий
  **8/8 + 0 page errors**; проверено — проходит.
- docs/74 §5a — как запускать авто-тест.

### Исправлено (важно)
- В демо после рефакторинга UI были потеряны side-effects GEN-страницы (EUCLID/MUTATE/SEED):
  восстановлены; авто-тест UX теперь их ловит (регрессия закрыта).

## [0.25.1] — 2025-11-06 — «Datasheet-сверка микрофона»

### Исправлено
- **MAX9814** (CORE-2): pin14 → TH с делителем R107 150k/R108 100k (AGC on), добавлен EP
  pin15→AGND, CT = 470 нФ (по datasheet); SHDN active-low подтверждён (SW3 = mute).
- **TS5A23157**: исправлен pinout (5 IN2, 6 COM2, 7 NC2) и полярность: MIC_SEL=0 → LINE
  (NC–COM), 1 → MIC (NO–COM); подтверждено COM→PCM1808 VINL/VINR.
- Схема/PDF/SVG/netlist/ERC/BOM (267 строк) перегенерированы: **ERC 0/0**, pinmap/schematic PASS.
- docs/71 §6/§8.7, hardware/core2/dfm.md §5a — таблицы «пин → datasheet → у нас»; в документах
  зафиксировано 4 найденных расхождения и их исправления; rev3-plan — пункт закрыт.

## [0.25.0] — 2025-11-06 — «Тест интуитивности»

### Добавлено
- **Blind UX-харнесс в демо** (`/demo/?test=1`): 8 задач (звук, ENV, mute×2, EUCLID,
  MUTATE→UNDO, REC→PAD, фейдеры SCENE, HOME), автоматический таймер и зачёт, JSON-выгрузка;
  никаких подсказок — проверяет реальную интуитивность (docs/74).
- docs/57 — ссылка на дистанционный тест; docs/68 — метрика time-to-sound измеряется харнессом.

## [0.24.2] — 2025-11-06 — «Утренний отчёт»

### Добавлено
- `docs/73-morning-report.md`: состояние всех слоёв (панель/электроника/микрофон/прошивка/
  P4/демо/доки/репо), релизы v0.14→v0.24.1, проверки, 7 блокеров по приоритету, план на день,
  риски и быстрые ссылки.
- docs/00 (handoff) — актуальный срез v0.24.1 и ссылка на отчёт; docs/32 — ссылка.

## [0.24.1] — 2025-11-06 — «Сборка: ссылки»

### Исправлено
- docs/54: добавлен раздел «Сборка плат и печать корпуса» со ссылкой на docs/72;
  README — строка docs/72 в таблице документов.

## [0.24.0] — 2025-11-06 — «Где собрать»

### Добавлено
- **docs/72 «Где собрать Букифон»**: мастерские и контрактные производства в **Москве**
  (Резонит/Зеленоград, А-Контракт, Интер-Плата, НПП «Асти», Пилотный центр МосПолитеха,
  VG-Line — профильная сборка музыкального оборудования, Фаблаб Сколтеха; 3D-печать:
  Modelica3D, ПИМТЕХ), **Санкт-Петербурге** (Резонит СПб, AXIOMA, Эрикон, Фаблаб Политех,
  ЛЭТИ), **Нижнем Новгороде** (Телерем, НПО «Промышленные решения»).
- RFQ-шаблон (10 вопросов), ориентиры цен (монтаж ≈3,5 ₽/точка, setup 3–3,5 тыс. ₽, сборка
  5 комплектов ≈90–120 тыс. ₽ без компонентов, PETG 231 г ≈5–7 тыс. ₽), чек-лист передачи
  (Gerber/BOM/CPL, панелизация, pogo, прошивка/self-test, серийники).
- docs/54 — раздел «Сборка плат и печать корпуса»; реестр R-40/D-96.

## [0.23.2] — 2025-11-06 — «Чек-лист шлейфа MIC»

### Добавлено
- `docs/71` §8.6 — приёмочный чек-лист шлейфа PANEL-2 J16 ↔ CORE-2 J19 (1:1, 3V3 на пине 6,
  TP, длина ≤150 мм, mute-свитчи, запрет записи при mute).

## [0.23.1] — 2025-11-06 — «J19 по канону»

### Исправлено
- **CORE-2 J19 приведён к канону** (1 MIC_BCK, 2 GND, 3 MIC_WS, 4 GND, 5 MIC_DATA, 6 +3V3) —
  при кабеле 1:1 к PANEL-2 J16 подача 3.3 В на BCK исключена; схема/PDF/SVG/netlist/ERC/BOM
  перегенерированы, ERC **0/0**, check_pinmap/check_schematic PASS (добавлена явная проверка
  канона J19).
- docs/71: §8.6 — приёмочный чек-лист шлейфа PANEL-2↔CORE-2; `docs/71 §5` — таблица J19.
- PANEL-2 rev.3 документация согласована с механикой: порт **Ø1.8 (122.0, 5.5)**, LED
  **Ø1.6 (116.0, 10.5)**, 85 отверстий, B-light 231.4 г / 11.2 ч (зафиксировано).

## [0.23.0] — 2025-11-06 — «Микрофон: ревизии и прошивка»

### Добавлено
- **PANEL-2 rev.3**: цифровой **I2S MEMS ICS-43434** (24 бит/48 кГц), акустический порт
  Ø1.8 в (122.0, 5.5), цековка Ø3.4×0.7, MEMS-углубление Ø5×1.2, LED MIC ON (116.0, 10.5);
  **J16 IDC-6** (1:1 с CORE-2 J19); аппаратный mute SW1 (разрыв +3V3) + FB1 + ESD SRV05-4;
  ERC **0/6w** (прежние SPI2 DNP), verify **1342/0**; 85 отверстий (83 JSON + порт + LED).
- **CORE-2 rev.3**: I2S1 RX `MIC_BCK/WS/DATA` = GPIO40/41/42, `MIC_SEL` GPIO54; **J19 IDC-6**;
  **3.5 мм TRS mic jack** (J20) + bias + **MAX9814** AGC + **TS5A23157** line/mic → PCM1808;
  **SW3 MIC MUTE** + LED; ESD USBLC6/SMAJ5.0A; **SDIO 4-bit → 1-bit** (DAT1–3 = NC);
  TP31/TP32; ERC **0/0**, pinmap/schematic PASS; BOM 265 строк.
- **Механика**: звуковод `mic_guide`, клипсы `mic_clip_rear`/`mic_holder_top`, fitcheck
  **41/0**, B-light **231.4 г / 11.2 ч** (+1.4 г).
- **Прошивка**: `io/mic.*` — захват I2S1 (модель), запись ≤30 с с авто-обрезкой тишины,
  **битбокс** (onset/классы kick-snare-hat, velocity/акцент, UNDO, точность ≥80 % на 90/110/140 BPM),
  приватность (mute блокирует запись, LED, никакой неявной передачи), **UI MIC** — 7-я вкладка
  (SRC/GAIN/THR/MON/BEAT/SENS/PAD/LVL + макросы, 16-ячеечная карта); **311/311 тестов**.
- docs/71 §5/§8/§9 (реализация PANEL-2/CORE-2/прошивки, TODO(hw)), docs/38/43 обновлены.

## [0.22.0] — 2025-11-06 — «Голос как вход»

### Добавлено
- **Микрофон/голос** `docs/71`: I2S MEMS (ICS-43434/SPH0645) на PANEL-2, 3.5 мм mic jack с
  MAX9814 AGC на CORE-2, аппаратный **mute-switch + LED**, «торчащий» микрофон (гусиная шея +
  печатная клипса); запись голоса→пэд, **битбокс→шаги** (v1.0), **вокодер** (v1.1/backlog);
  влияние на PANEL-2/CORE-2 rev.3 **до заказа PCB**.
- **Принцип «идея → звук»** в docs/68: метрики time-to-sound ≤10 с, time-to-idea ≤30 с,
  0 критических ошибок за 5 минут, blind-тест 5 людей.
- **Демо**: кнопки MIC / BEATBOX→STEPS, вход с микрофона (WebAudio, без обратной связи),
  индикатор уровня в статусе, индикатор MIC в контекст-строке; битбокс заполняет шаги
  выбранной партии по найденным ударам (квантизация 1/16, акценты).
- Реестр: **R-37…R-39**, **D-91…D-95**.

## [0.21.1] — 2025-11-06 — «EXT в прошивке»

### Добавлено
- `firmware/src/io/ext_sequencer.*`: 8 внешних MIDI-треков (channel/PC/note/velocity/length,
  mute, 1 CC p-lock на шаг), GEN на внешних, общий транспорт/clock 24 ppqn (out/in),
  live record с квантизацией, save/load `EXTP` v1 + CRC32, MIDI-роутер DIN+USB без дублей.
- UI-вкладка **EXT** (6-я): 8 строк T1…T8, сетка 16 шагов, p-lock/mute-индикаторы,
  поля CH/PROG/VEL/LEN/CC#/CC VAL/SWING/CLK + макросы И–П; `firmware/artifacts/ui/ext.png`.
- **288/288 тестов** (+25: движок, роутер, clock, serialize, UI EXT); docs/70 §7–8.

### Изменено
- README/сайт: внешний секвенсор и EXT-вкладка; скриншот демо.

## [0.21.0] — 2025-11-06 — «Внешний секвенсор»

### Добавлено
- **Внешний MIDI-секвенсор** `docs/70`: 8 внешних треков + 4 внутренние партии; канал/PC/
  velocity/length, p-lock CC, clock out/in 24 ppqn, transport, GEN на внешних, live record,
  save/load; паритет-таблица с Octatrack; архитектура (DIN+USB MIDI, CV/GATE как отдельные
  голоса), UX-страница **EXT** без новых кнопок; этапы v1.0/v1.1/v1.2.
- **Демо**: режим **EXT** — 8 треков (CH/PC), сетка шагов, p-lock CC, clock out, Web MIDI out;
  поля CH/PROG/VEL/LEN/CC#/CC VAL/SWING/CLK слева (зеркально ручкам) + макросы справа.
- Реестр: **R-33…R-36**, **D-87…D-90**.

## [0.20.1] — 2025-11-06 — «Прошивка = философия»

### Добавлено
- **UI прошивки приведён к docs/68/69**: 16 ячеек зеркально 16 энкодерам (слева А–З —
  параметры страницы, справа И–П — макросы), шкала `Caption 12 / Value 18 / Critical 24 /
  Title 26 px`, контекст-строка PART·SELECTED·PAGE·FADERS·REC·UNSAVED, HOME → MAIN.
- Cream-токены в прошивке = docs/62: accent `#a8321f`, green `#3f6f2e`, orange `#9a4a10`,
  muted `#5f5548`, red `#9c2a1a` (все контрасты ≥4.5).
- **263/263 тестов** (+15 readability: шкала, отсутствие текста <12 px, 16 ячеек/8+8,
  mapping ручка↔ячейка, контекст во всех режимах, HOME, Cream-контраст, 4 темы, табы).
- Скриншоты `firmware/artifacts/ui/*.png` перегенерированы (9 шт.).

### Изменено
- docs/62/69: синхронизирован red `#9c2a1a`; демо-палитра Cream; скриншоты сайта.

## [0.20.0] — 2025-11-06 — «Философия и читаемость»

### Добавлено
- **Философия интерфейса/продукта** `docs/68`: пять тезисов, 10 принципов, **зеркальная карта**
  «ручка ↔ ячейка экрана» (левые 8 — контекст страницы, правые 8 — макросы), грамматика жестов,
  правила изменения концепции.
- **Читаемость** `docs/69`: физика 5″ 800×480 (188 PPI, 0.135 мм/px), таблица угловых минут
  для 40–60 см, шкала шрифтов (12/18/24–28 px), контраст 4 тем, проверка на 1:1 печати.
- **Демо**: 16 параметров на экране **зеркально 16 энкодерам** (2×4 слева + 2×4 справа),
  крупные шрифты (подписи 12 px, значения 18 px), компактный секвенсор, контекст-строка.
- **Cream** палитра исправлена по AA: accent `#a8321f`, green `#3f6f2e`, orange `#9a4a10`,
  muted `#5f5548` → контраст 4.6–5.7:1 (docs/62).

### Изменено
- README/сайт: философия, читаемость, зеркальная карта; демо-скриншот обновлён.

## [0.19.1] — 2025-11-06 — «Сайт и ревью»

### Изменено
- Сайт: демо-секция описывает раскладку как у реального синтезатора (16 энкодеров вокруг
  экрана, 10 джеков, кластеры ±18°); ссылки на docs/67 и docs/65; оценка 8,5/10.
- Скриншот демо обновлён (`docs/assets/web-demo.jpg`).
- `docs/reviews/chatgpt-review-2026-11-06.md`: удалены абсолютные пути (security_scan OK).

## [0.19.0] — 2025-11-06 — «Демо как панель + ревью»

### Добавлено
- **Раскладка демо = реальная панель**: 10 джеков сверху, 16 энкодеров 4×2 вокруг экрана
  800×480 (А–З — параметры страницы, И–П — макросы выбранных партий), два кластера клавиш
  3×7 под ∓18°, фейдеры между ними; проверка `tools/check_demo_layout.js` → **LAYOUT OK**
  (топология + пропорция 380:210; экран увеличен для читаемости) — `docs/67`.
- **Внешнее ревью ChatGPT** через Codex: `tools/chatgpt_review.sh` (и `tools/chatgpt_review.js` —
  Playwright-путь), полный текст `docs/reviews/chatgpt-review-2026-11-06.md`; 10 сценических
  рисков и 5 обязательных изменений (единый контекст, HOME, preview→commit, фейдеры, слои клавиш).
- **Внедрено из ревью**: контекст-строка PART/SELECTED/PAGE/FADERS/THEME/REC/UNSAVED;
  HOME (один жест); UNDO-кнопка; COMPARE (вместо двусмысленного A/B); Shift-overlay слоёв;
  подписи блоков «параметры страницы» / «макросы (выбранные партии)».
- Оценка скорректирована: **8,5/10** для демо (было 9 — ревью право, что наличие функций
  ≠ отсутствие сценических ошибок); 9–10 после слепого теста 5 людей.

## [0.18.2] — 2025-11-06 — «Бандлы v0.18»

### Изменено
- Release bundle: **365 файлов, 15 МБ**; fresh-history bundle: **`dist/bukifon-fresh-v0.18.1.bundle`
  (34 МБ, 960 файлов)**; docs/41 ссылается на актуальный бандл.

## [0.18.1] — 2025-11-06 — «Статус сайта и §8»

### Исправлено
- `docs/59`: заголовок статуса — сборка P4 **проверена** (IDF v5.5, §8), host-тесты 248/248.
- Сайт: блок статуса переписан под v0.18 (248 тестов, GEN, P4-сборка, demo 9/10, BOM P4,
  pre-freeze платы, корпуса, home-offload) — RU/EN.

## [0.18.0] — 2025-11-06 — «P4 собирается»

### Добавлено
- **ESP-IDF P4 сборка проверена** на домашнем ПК `pole`: IDF v5.5, `esp32p4`,
  `idf.py set-target esp32p4 && idf.py build` → **SUCCESS**; `bukifon_p4.bin` **250 240 B**,
  bootloader/partition-table собираются, app-раздел 83 % свободен (docs/59 §8).
- Найден и исправлен баг скаффолда: `CONFIGURE_DEPENDS` в `components/bukifon_engine/CMakeLists.txt`
  недопустим в script-режиме IDF 5.5.
- Python-окружение IDF на `pole` создано через `virtualenv` (в системе нет `python3-venv`).
- docs/32/59 обновлены: P4-toolchain больше не «не проверено», а проверено.

## [0.17.1] — 2025-11-06 — «Бандлы и P4-сборка»

### Изменено
- Release bundle пересобран под v0.17.0: **365 файлов, 15 МБ**, SHA256SUMS.
- Fresh-history bundle обновлён: `dist/bukifon-fresh-v0.17.0.bundle` (**34 МБ**, 960 файлов) —
  для пересоздания репозитория со свежей историей (docs/41).
- docs/41 ссылается на актуальный bundle.

## [0.17.0] — 2025-11-06 — «Генеративность в прошивке»

### Добавлено
- **GEN-движок** `firmware/src/io/gen.*`: PROB 0–100 %, EUCLID 0–16 (Бьорклунд, акценты
  1/5/9/13), MUTATE ±0–12 (детерминированный hash(seed,part,step)), SCALE LOCK
  (OFF/MINOR/MAJOR/PENTA/DORIAN), EVOLVE на границе бара, SEED, ARP 1/8…1/32 × UP/DOWN/UPDOWN;
  дефолты нейтральные — регрессий нет.
- **UI GEN** (5-я вкладка): поля GEN, Euclid ring, 8 preset slots, A/B compare, мультивыбор
  партий, «M»-маркер модуляции; `firmware/artifacts/ui/gen.png`.
- **Пресеты** `firmware/src/storage/preset_bank.*`: 8 слотов, per-part GEN, versioned host-файл
  с CRC32; CLI `bukifon_sim --preset`.
- **docs/66**: таблица «паттерн docs/65 → реализация → тест»; **248/248 тестов** (+22).

## [0.16.1] — 2025-11-06 — «Готовность и отчёт»

### Добавлено
- `docs/32-progress-report.md` обновлён до v0.16 (вехи, блокеры, следующий шаг).
- `docs/36`: **UX-критерии приёмки** (L1 без меню, L2 ≤1 жест, L3 ≤2, mod-visible,
  мультивыбор, undo/pickup, переносимость на 16/42/2).
- Реестр: **R-32** (UX-паттерны), **D-86** (рубрика 9/10 как критерий).
- Release bundle пересобран: 359 файлов, 15 МБ, SHA256SUMS.
- `tools/fresh_history_push.sh` восстановлен (был только в orphan-ветке).

## [0.16.0] — 2025-11-06 — «UX-паттерны и генеративность»

### Добавлено
- **Исследование UX** `docs/65`: бюджет доступа L1/L2/L3/L4, паттерны Minkin Kaleidoscope
  (нет скрытых меню, модуляция видна, мультивыбор, генеративный секвенсор, 3D-матрица),
  Elektron (страницы, hold, сцены, p-lock), Nord/Deluge/OP-1/Push/M8; рубрика «9 из 10»,
  связка с железом (16 энкодеров/42 клавиши/2 фейдера/10 джеков) без новых кнопок.
- **Демо**: страница **GEN** (PROB/EUCLID/MUTATE/SCALE/ARP/EVOLVE/SEED, кольцо евклида),
  **мультивыбор партий**, **8 слотов пресетов**, **A/B compare**, **mod-индикация** LFO,
  генеративные функции в проигрывании (probability/scale-lock/mutate/evolve).
- **Home offload** `tools/home_offload.sh`: rsync+SSH на домашний ПК (8 ядер, 30 ГБ, RTX 3060);
  host-тесты прошли 226/226 на нём; `docs/48` обновлён.

### Исправлено
- `module_host_v0.cpp`: `#include <cmath>` — сборка host-тестов на GCC 13 (Ubuntu).

## [0.15.1] — 2025-11-06 — «Темы в прошивке»

### Добавлено
- `firmware/include/bukifon_ui_theme.h` + `src/ui/ui_theme.cpp`: **4 темы экрана** (Night/Amber/
  Phosphor/Cream) × 12 токенов ровно из `docs/62`, RGB888 + RGB565, API `bukifon_ui_theme_set`,
  host save/load; рендер `ui800.cpp`/`menu.cpp` переведён на токены (нет сырых цветов).
- Host CLI: `bukifon_sim --theme Cream`; скриншоты 8 шт. перегенерированы; **226/226 тестов**.

### Изменено
- docs/62: прошивка использует те же токены; docs/48: SSH-доступ к домашнему ПК (в процессе).

## [0.15.0] — 2025-11-06 — «16 ручек, сцены, ресемплинг»

### Добавлено
- **UI/UX**: `docs/61` — три итерации и лучшие практики; **16 энкодеров** в демо
  (8 страниц MAIN/FM/ENV/FX + 8 макросов А–П); **4 темы экрана** 800×480 (`docs/62`);
  клавиатура демо — **2 кластера 3×7 под ±18°**, как на панели (не пиано-ролл).
- **Фейдеры-режимы** `docs/64`: TRACK, **SCENE (Octatrack A↔B морфинг)**, DJ (equal-power),
  Fn/Shift = мастер-громкость; pickup без скачков; индикация на экране.
- **Мгновенный ресемплинг** `docs/63` (R-29): запись выхода в любой момент без остановки звука,
  назначение на PAD/дорожку, loop, SD; **многодорожечный луппер — backlog** (R-30/D-84).
- **Демо**: REC/PAD-пэды, случайный паттерн, транспозиция ±12, undo, copy/paste, share
  паттерна ссылкой, Web MIDI in/out (CC при изменении энкодеров), 4 темы.
- **P4 toolchain** `firmware/idf_p4/` + `docs/59`: ESP-IDF проект (P4, 32 МБ PSRAM,
  I2C-скан, heartbeat); IDF-сборка честно не проверена (нет инструментария в окружении).
- **Модули** `tools/package_module.py` + `docs/60`: манифест с SHA256, проверки, zip.

### Изменено
- Сайт: раздел «Дизайн» — концепты панели и 4 темы экрана; демо обновлено.
- Реестр: R-29/R-30/R-31, D-82…D-85; **216/216 тестов** (host).

## [0.14.1] — 2025-11-06 — «Демо на Pages»

### Исправлено
- `tools/publish_site.sh` теперь публикует `docs/demo/` (веб-демо) — https://martiyanov.github.io/bukifon/demo/
  отдаёт 200; страница сайта ссылается на демо из навигации и секции «Демо».

## [0.14.0] — 2025-11-06 — «Демо в браузере»

### Добавлено
- **Веб-демо** `docs/demo/` — интерактивная модель: 800×480 экран (SYNTH/SAMPLER/DAW/USB-KBD),
  4 партии ×16 шагов, 42 клавиши Lapka-42, 16 энкодеров, 2 фейдера, 10 джеков,
  упрощённый FM-звук (WebAudio), Web MIDI, QWERTY, localStorage; `docs/58`.
- **Единый закупочный лист** `docs/54`: P1 $426 + PWR $276.92 + LCD-адаптер $72.8
  + печать $42 ≈ **$784** (с зачётом пересечений), критпуть и порядок заказа.
- **Серийники/QR** `tools/make_labels.py` (A4 3×8, 60×30 мм, QR+manifest, `--selftest`),
  **identity** 114 B с двухслотовой flash-моделью и CLI `factory --identity/--print-identity`
  (`docs/55`); **216/216 тестов**.
- **Протокол P1** `docs/56` — 8 сценариев, пороги, пустые таблицы P4/H743, матрица решения,
  fallback H743 + `docs/p1-results-template.csv`.
- **Тест эргономики** `docs/57` + CSV-форма; **fresh-history bundle** для пересоздания
  репозитория (`tools/fresh_history_push.sh`, `dist/bukifon-fresh-v0.13.0.bundle`, 33 МБ).

### Изменено
- Сайт: кнопка «Демо» в навигации, секция с превью демо, ссылка на /demo/.
- README/доки: 54–58, статус, 216 тестов.

## [0.13.0] — 2025-11-06 — «Стенд-адаптер, USB HS, лёгкий репозиторий»

### Добавлено
- **LCD-адаптер FFC-40** `hardware/panel2/adapter-lcd/` (HotLCD ST7262): 31×0R pinout-jumper,
  35 тест-поинтов, JST для внешней подсветки 18–22 В, ERC **0/0**; `docs/49` — таблица
  J12↔FPC-40↔панель, проверки мультиметром, правила FFC; O-15 «ждёт образец».
- **USB HS UAC2 8×8** `firmware/src/usb/uac2_8x8.*`: дескрипторы 300 B, 8 интерфейсов,
  9 endpoints (агрегация каналов; per-channel 8×8 = 23/15 невозможно), JSON для анализатора;
  **RGB565 backend** (52 full/130 partial fps модель) и **factory REAL/MOCK хуки** (14 тестов,
  mock не фабрикует PASS); **203/203 тестов**.
- **Release bundle** `tools/make_release_bundle.sh`, `RELEASE_BUNDLE.md`, `docs/50`: 339 файлов,
  15 МБ, SHA256SUMS, SBOM; страница загрузок.
- **Журнал PWR** `docs/51`: 13 измерений T1–T13 + матрица go/no-go для PCB.

### Изменено (размер репозитория)
- **60 PNG → JPEG** (`tools/optimize_images.sh`) — экономия **~83 МБ**;
- **19 KiCad SVG → .svg.gz** (`tools/compress_svg.sh`) — экономия **~46 МБ**;
- удалены дубликаты SVG; tracked **71 МБ** вместо ~218 МБ; политика — `docs/52`;
- `docs/41`: при пересоздании репозитория — свежая история (`.git` 134 МБ → ~71 МБ).

## [0.12.2] — 2025-11-06 — «PWR-стенд закрыт»

### Исправлено
- `docs/44-pwr-bench.md` §24/§25: EVM-бюджет и критерии помечены «утверждено» (D-79/D-80),
  ссылка «D-78» заменена на D-80; итог **$276.92 ≈ 22 200 ₽** (база $123.92 + EVM $153);
  открытыми оставлены только TPS63802-комплект, исполнитель/место логов и закупка банок.
- Проверка: 0 вхождений D-78 в docs/44, 0 битых ссылок, bench-bom 29 строк.

## [0.12.1] — 2025-11-06 — «PWR-стенд: EVM вариант A»

### Изменено
- **PWR-стенд**: решение **D-79** — вариант A: EVM LMR33630ADDAEVM-IBB ($45) + TPS61088EVM-677 ($50)
  + BQ24074EVM ($45) + MAX17048 breakout ($13) = **+$153**; база 25 позиций **$123.92**;
  итого **$276.92 ≈ 22 200 ₽**; samples (вариант B) — параллельно как резерв.
- `docs/44-pwr-bench.md`: §4/§5/§7/§24/§26 согласованы (критерии D-80, base/EVM суммы, 13 тестов T1–T13);
  `hardware/power2/bench-bom.csv` — 29 строк (25 base + 4 EVM), статусы «утверждено».
- Реестр: D-79…D-81 (EVM-вариант A, критерии PWR-стенда, дозакупка мелочёвки +$15–20).

## [0.12.0] — 2025-11-06 — «Стенды и варианты»

### Добавлено
- **Выбор дисплея (O-15/O-19 закрыты)** `docs/47`: первый SKU — **RGB565 поверх RGB888 FPC-40**,
  основной кандидат **TFT-H050A1SVIST4R40** (HotLCD, ST7262, 40-pin, 1000 нит, 3.3 В, $18–25),
  резерв NHD-5.0-800480AF-ASXP / EJ050NA-01G; DSI (Waveshare/Topway) — rev.3.1;
  чек-лист 15 пунктов до разводки; BOM-p4 COGS **$223/$198/$180** на 1/10/25.
- **CORE-2 rev.3 plan** `hardware/core2/rev3-plan.md`: P4-first, RGB565/DSI, keep/drop/change,
  fallback H743 (отдельная плата с общим outline/FFC, не dual-MCU), TP1–TP30 в схеме
  (ERC 0/0), **bring-up** `docs/43` (15 шагов, ожидаемые значения, типовые ошибки).
- **PWR-2 стенд-макет** `docs/44` + `hardware/power2/bench-macet.md`: **13 измерений** (T1–T13)
  с методикой/критериями/таблицами, 3×3 load matrix, load-step/ripple/FFT/тепло/BMS/гейдж;
  BOM стенда `bench-bom.csv` — **$102.92** (EVM/bare-IC, breadboard запрещён).
- **Корпус вариант C** `mechanical/stl_v05_C/`: 12°, закрытый отсек 1S2P с крышкой,
  складная подставка, кабельный канал; **314 г / 20.8 ч**, fitcheck **37/0**, сравнение
  A/B/C (`preview_v05_compare/side_profile_all.png`), `docs/45-case-variants.md`.
- **P4 HAL + factory self-test** `firmware/src/hal/board_cores2.*` (55 GPIO по pinmap),
  `firmware/src/factory/` — 14 тестов, CLI `factory --json`, JSON-отчёт, loopback-плаг;
  `docs/46-factory-test.md`; **183/183 тестов**.
- **Home-compute** `docs/48`: вынос рендеров/сборок на домашний ПК через Tailscale
  (SSH пока не настроен); решения D-73…D-78.

### Изменено
- README: P4 Standard $299, варианты корпуса A/B/C/B-light, display/factory/PWR-стенд.
- Сайт: раздел «Варианты корпуса» (профили 0°/8°/12°), обновлённые статусы и бейдж v0.12.0.

## [0.11.0] — 2025-11-06 — «P4 first + структура»

### Изменено (решения заказчика)
- **Первый SKU — P4-версия с RGB565/DSI** (D-58): S3-base $199 отменён, S3 уходит в «lite later»;
  стартовый комплект — **P4 Standard (Complete) $299** (D-59), Full Bundle $399 позже.
- **P1-стенд утверждён** (D-60): P4 EV + NUCLEO-H743ZI2 + кодеки (~$110–130), точные MPN и ссылки в docs/29.
- **Репозиторий пересоздать** (D-61) для purge PII: план и команды — docs/41.
- Тестовая половинка корпуса B-light — печатать (D-62); батарея в первой партии не продаётся.

### Добавлено
- **DFM/DFT для P4-ветки**: `docs/38-dfm-testability.md`, `hardware/{core2,panel2,power2}/dfm.md`
  — 30 TP (единое pogo-поле), 20 self-test, serialization (24C32 + flash/NVS + QR),
  recovery (UART0+BOOT, dual OTA), 6-слойный stackup, чек-листы; S3 — короткий lite-пакет.
- **Product BOM P4**: `BOM-p4.csv` + `docs/33`, `docs/40-kit-contents.md` — COGS
  **$219/$194/$176** на 1/10/25; $299 жизнеспособен (gross 35 % на партии 10), $399 Full Bundle;
  COGS S3 lite $199/$175/$157 (второй профиль).
- **S3 vertical-slice spike** `firmware/spike_s3/` (сборка SUCCESS; host-sim PASS),
  протокол `docs/39-s3-spike-protocol.md` с разделом P4-transfer; **P1 P4-профиль** в bench:
  `host_p4.json` PASS (RGB/DSI модель 52 fps, HS UAC2 8×8, max block 320 µs).
- **DFM/DFT-ревью GPT** `docs/42`: 30-точечное pogo-поле, 14 self-test, serialization,
  recovery, DFM, план founders beta (3 инженерных + 2 валидационных, EOL 6–8 мин).
- **Структура репозитория**: `STRUCTURE.md`, `archive/README.md`; старые версии перенесены
  в `archive/<version>/` (v1.0, v0.3, v0.4, v1.4…v1.8) через `tools/archive_versions.sh`.
- Решения D-58…D-72; исправлены O-17 (TL074=4), O-18 (TPS63802), O-19 (дисплей RGB/SPI).

### Проверки
- ERC: CORE-2 0/0, PANEL-2 0/6warn, PWR-2 0/0, CORE-S3 0/0; **160/160 host-тестов**;
- `spike_s3` сборка SUCCESS; `bench host_p4` PASS; сайт/структура — проверены.

## [0.10.0] — 2025-11-06 — «RC-контур»

### Добавлено
- **Product BOM S3-base** `BOM-s3.csv` + `docs/33`: 68 позиций (61 kit + 7 опций),
  COGS **$189 / $166 / $149** на 1/10/25 шт; $199 — founders beta, S3 Complete $249–269,
  P4 $299, full $399; опции (аккум-пак 1S2P+NTC, БП, SD, картриджи, DECK-PAD) вне kit.
- **Сборочный комплект**: `renders/templates/bukifon_assembly_map_1to1.pdf` (4 стр: слои,
  панель 1:1, крепёж и шлейфы), `docs/34-assembly.md` (пошагово, моменты затяжки, чек-лист),
  `docs/35-print-first.md` (body_L 70 г/3.4 ч → приёмка → комплект), 3D exploded.
- **Прошивка v0.6**: S3 HAL `board_cores3` по pinmap, env `s3base` — сборка **SUCCESS**
  (flash 11.3 %, RAM 62.7 %); UI 4 режимов (synth/sampler/daw/usb_kbd); P1 S3-профиль
  в bench (`host_s3.json` PASS: max block 192 µs; SPI full 13 fps < 15 — риск D-51,
  partial 32.5/с, RGB-модель 52 fps); **Module API v0.1** (12 колбэков, host services,
  события, smoothing; 2 новых примера); **146/146 тестов**.
- **RC Definition of Done** `docs/36` (8 критериев приёмки, S3-ветка 10–14 недель)
  и **compliance** `docs/37` (RED/GPSR, батарея, EMC, SBOM, гарантия, метрики).
- Решения D-53…D-57; открытые O-17…O-19 (TL074 qty, TPS63802, display MPN).

### Изменено
- README/сайт: SKU-линейка (beta/complete/P4/full), 4 режима UI, ссылки на docs/33–37.

## [0.9.1] — 2025-11-06 — «Сводный отчёт»

### Добавлено
- `docs/32-progress-report.md` — карта проекта от v0.4 до v0.9.1: вехи, что готово,
  блокеры, следующий шаг P1, единственные источники истины.
- README/сайт: ссылка на сводный отчёт, версия 0.9.1.

## [0.9.0] — 2025-11-06 — «CORE-S3 и лёгкий корпус»

### Добавлено
- **CORE-S3 rev.0** (`hardware/cores3/`): ESP32-S3-WROOM-1-N16R8, USB FS
  (HID+MIDI+CDC+стерео UAC2), 1-bit SDMMC, **SPI-дисплей 800×480**, TPS63000 placeholder
  (цель TPS63802), канон PANEL-2/PWR-2; **ERC 0/0**, 27/31 GPIO занято, PRE-FREEZE;
  сравнение CORE-2 vs CORE-S3, endpoint-бюджет USB, devkit-план 2–3 дня.
- **Корпус v0.5-B-light**: **230 г / 11.1 ч** вместо 277 г / 18.3 ч (−17 % массы,
  −39 % времени) при сохранении жёсткости: стенки 2.0/дно 1.8, 3 периметра + локальные
  рёбра, панели-оболочки; 6 STL watertight, fitcheck 32/0.
- **P1: точный список заказа** `docs/29` (P4 EV, NUCLEO-H743ZI2, S3-N16R8, PCM5102A/1808,
  дисплей, SD, БП/нагрузка; бюджет $110–320) и **запрос на purge** `docs/30` с SHA
  старых PII-объектов для GitHub Support.
- **CORE-S3 ограничения** `docs/31`: почему RGB565 не влезает на N16R8 (31 линия),
  USB endpoint ceiling, один framebuffer + dirty rects, профиль S3-base в бенчмарке.
- Решения D-46…D-52; O-12 (DISP) — в D-51/D-52.

### Изменено
- Профиль бенчмарка: S3 — полноценный третий профиль (4 МиБ pool + FB, 1-bit SD,
  ≥15 fps full / ≥30 partial), а не «reference only» (D-46).

## [0.8.1] — 2025-11-06 — «Rev.2 плат»

### Добавлено
- **CORE-2 rev.2** — схема внесена: J17 IDC-20/J18 IDC-12 к PWR-2, входы `12V_EXT`/`N12_EXT`/`+5V_EXT`/`5V_LED`,
  D19/D20/C112–C119/FB7, EN-развязки R94–R96, **CV IN3/4 → MCP3208 CH4/CH5** (U45 TL074),
  re-pin J14/J15/J16; **DNP 46 позиций**; ERC **0/0**, pinmap PASS, BOM 241 строка.
- **PANEL-2 rev.2** — J13/J14 (5V_LED, LED_RET, EN_RAILS на 0x23 GPA7, EN_LED5 на GPB6),
  re-pin по канону CORE-2, CVIN3/4 → MCP3208, GATE_IN на 0x23 GPB7, LED_DATA 3.3 В + level shifter;
  ERC 0 errors / 6 warnings, verify 1290/0.

### Изменено
- Реестр: O-13/O-14 закрыты, O-15/O-16 добавлены; решения D-44 (EXPRESSION убран, CV OUT 5/6 — rev.3),
  D-45 (J3 прототип IDC, rev.2 Micro-Fit).

## [0.8.0] — 2025-11-06 — «Стенд, цена, бумага»

### Добавлено
- **P1-стенд** `docs/26-p1-bench-kit.md`: закупка (ESP32-P4 EV, Nucleo-H743ZI2, S3, PCM5102A/PCM1808,
  дисплей, SD, БП/электронная нагрузка, осциллограф), схема стенда, 8-шаговый протокол измерений,
  таблица решения P4/H743/S3 и бюджет стенда $110–320.
- **Cost-down и первый SKU** `docs/27-costdown.md`: разбор BOM ($271 — это «мастерская», не изделие),
  продуктовая нормализация ($205–225 P4 / $183–202 S3), **S3-base kit $199** (партия 10–25,
  direct-sale, limited DIY/beta), батарея (без россыпи 18650), печать (225–245 г / 11–14 ч),
  дефицит/подделки в РФ, решения по конфликтам (Micro-Fit, 3.3 В buck-boost, LED-cap).
- **Бумажный набор 1:1** `renders/templates/bukifon_paperkit_1to1.pdf` (4 стр: панель ×2, профиль
  8°, карта проверки) + `docs/28-paper-kit.md`; раздел в `mechanical/prints.md`.
- **CORE-2 rev.2** (доки/интерфейсы): `hardware/core2/rev2-plan.md` — DNP 39 позиций
  (MT3608 #1/#2, MC34063, BMS), входы `12V_EXT`/`N12_EXT`/`+5V_EXT`, J17 IDC-20 + J18 IDC-12,
  EN с MCP23017 0x23 (2 линии), +5 В 1.6 А; ERC 0/0, pinmap PASS.
- Решения D-37…D-43, открытые O-1…O-6 закрыты, O-8…O-11 (PWR_GOOD/C6, CVIN3/4, GATE_IN, J3, TDM) — в реестре.

### Изменено
- Сайт: разделы «Бенчмарк (P1)» и «Модули и SDK», бейдж v0.8.0, ссылки на стенд/цена/бумага.

## [0.7.0] — 2025-11-06 — «PWR-2 + бенчмарк + SDK»

### Добавлено
- **PWR-2 rev.1** (PRE-FREEZE): батарея 1S2P + BMS BQ297, MAX17048 (I²C) + резервный ADC,
  **+12 В 330 мА** (TPS61088 sync boost + π), **−12 В 95 мА** (LMR33630 inverting buck-boost),
  +5 В 1.6 А, +5V_LED, master load-switch, EN рельсов; питание только от BQ24074 OUT/VSYS,
  NTC→TS, fuse 5 А; ERC **0/0**; power-tree и м��жплатные интерфейсы; решения D-27…D-36.
- **P1-бенчмарк**: workload freeze `docs/05`, howto `docs/05a`, харнесс `firmware/bench`
  (fm_voice, granular_track, mix_bus, psram_stream, ui_frame(+partial), usb_descriptor),
  max/p50/p95/p99, детерминизм, JSON/CSV; host PASS (worst 218 µs = 16.4 % дедлайна,
  запас 431 µs до 650 µs); `bench_s3` сборка; envs P4/H743 подготовлены.
- **SDK модулей**: `docs/24-module-sdk.md`, каталог `modules/` (template, gain_fx C++,
  lfo_module Lua — компилируются), `tools/validate_module.py`, `tools/new_module.sh`,
  CI `.github/workflows/modules.yml`.
- **Архитектура питания** `docs/25` по консультации GPT: бюджет ±12 В, отказ от MC34063,
  BQ24074 OUT/VSYS, MAX17048, земля/тепло, 13 обязательных измерений до PCB.

### Изменено
- Прошивка: 120/120 тестов (было 112), bench-раздел в REPORT.md.
- Сайт: разделы «Бенчмарк (P1)» и «Модули и SDK»; бейдж v0.7.0.

### Открытые конфликты (зафиксированы в spec/90)
- +5 В бюджет CORE-2 занижен (1.0 → 1.6 А: пропущен вход MP1584→+3V3_MCU);
- VSYS 3 А vs пик 2.74–3.38 А — нужен прошивочный cap LED или 2S во rev.2;
- CORE-2 rev.2 требует DNP MT3608#2/MC34063/BMS; 4 EN-линии брать с MCP23017;
- J3 при 3 А — проверить IDC vs Micro-Fit; 1S2P vs 2S решить после замеров.

## [0.6.2] — 2025-11-06 — «VERSION и публикация»

### Исправлено
- `VERSION` = 0.6.2: в v0.6.1 файл остался 0.6.0 (перезапись при публикации сайта).
- `tools/publish_site.sh` больше не делает `git reset --hard` в рабочем дереве — использует
  временный индекс (`GIT_INDEX_FILE`), не теряет незакоммиченные изменения.
- README/CHANGELOG приведены в соответствие; бейдж сайта — v0.6.2.

## [0.6.1] — 2025-11-06 — «Синхронизация плат»

### Исправлено
- CORE-2: PANEL-2 согласован на **4× MCP23017 (0x20–0x23)** — 48 линий энкодеров + 13 матрицы,
  наружу SDA/SCL/INT; в схему добавлена подтяжка **R91 10k PANEL_IRQ→+3V3** (wire-OR INT),
  BOM-core2 — 201 группа; ERC 0/0, pinmap PASS.
- Документация CORE-2 (README/pinmap/power-tree/interfaces) и генераторы синхронизированы.

## [0.6.0] — 2025-11-06 — «Ночная сборка v1.0-rc»

### Добавлено
- **Корпус v0.5-B «клин 8°»**: 380 × 210 × 61.5 мм (перед 32 / зад 61.5), 6 STL watertight,
  печать без поддержек 279 г / 18.3 ч, fitcheck 32/0; профиль 1:1 для картонной проверки;
  сравнение A/B/C (плоский/8°/12°).
- **CORE-2 rev.1** (PRE-FREEZE): ESP32-P4 + ESP32-C6 (Wi-Fi 6/BLE 5.3 по SPI), USB HS composite
  (HID+MIDI+UAC2+CDC), PCM5102A/PCM1808, CV (MCP4728/MCP3208), MIDI TRS, шина модулей, BQ24074;
  ERC 0/0, pinmap PASS (54/55 GPIO), PII вычищен.
- **PANEL-2 rev.1** (PRE-FREEZE): 16 энкодеров + 42 клавиши через 4× MCP23017, LCD FPC-40,
  10 джеков CV/GATE, 2 фейдера, BL_PWM; ERC 0 errors, 1288 проверок, 3 шлейфа.
- **Прошивка v0.5**: host-демо 800×480, секвенсор 4×16, BPM/mute/p-lock, save/load CRC16,
  Module API v0 (2 примера), режимы Synth/Sampler/DAW/USB-keyboard, каркасы USB composite
  и BLE/Wi-Fi; **112/112 тестов**, покрытие 83.5 %; сборки S3 и RP2040.
- **«Народный синтезатор»**: позиционирование, целевые цены ($200/$300/$400), cost-down план
  (spec/00 §13), README и сайт.
- **Клавиатура/DAW + Wi-Fi/BT** как обязательные требования (R-25…R-28, spec/00 §14).
- docs/20 (разведка аналогов), docs/21 (эргономика), docs/22 (ночной план), docs/23 (отчёт).
- **Безопасность**: SECURITY.md, tools/security_scan.sh, tools/sanitize_paths.sh; из истории
  удалены GPS EXIF-фото, PDF с IP и абсолютные пути; .gitignore для секретов/сборок.

### Изменено
- Корпус: v0.4 (плоский) → v0.5-B (клин 8°) как базовый для v1.0-rc.
- BOM: 92 позиции (draft), база ≈ 21 657 ₽ (~$271), полный ≈ 32 518 ₽ (~$406).
- Сайт обновлён до v0.6.0 (host-демо, корпус, статус).

## [0.5.1] — 2025-11-05 — «Сайт опубликован»

### Исправлено / добавлено
- GitHub Pages включён автоматически при пуше ветки `gh-pages`: сайт живой
  (https://martiyanov.github.io/bukifon/ и /en/), все страницы и SEO-файлы отдают 200.
- Добавлен скрипт `tools/publish_site.sh` — пересборка `gh-pages` из `docs/` одной командой.
- `docs/github-metadata.md` обновлён под фактическую схему публикации (ветка `gh-pages`;
  Actions-вариант — опционально).

## [0.5.0] — 2025-11-05 — «Сайт проекта RU/EN»

### Добавлено
- **GitHub Pages** сайт: `docs/index.html` (RU) и `docs/en/index.html` (EN) — описание проекта,
  режимы, железо, статус, ссылки на документы и файлы; `docs/assets/` с оптимизированными изображениями.
- SEO/индексация: `docs/sitemap.xml` (RU+EN, hreflang), `docs/robots.txt` (разрешены поисковые и
  AI-краулеры), `docs/llms.txt`, JSON-LD `SoftwareApplication`, Open Graph/Twitter Card,
  `docs/.nojekyll`.
- Деплой: `.github/workflows/pages.yml` (GitHub Actions → Pages).
- `CITATION.cff` для цитирования; `docs/github-metadata.md` — описание/темы репозитория и
  включение Pages одной командой.
- README: раздел «Сайт проекта», версия 0.5.0.

## [0.4.0] — 2025-11-05 — «Канон v0.4»

### Добавлено
- **Каноническая панель v0.4** (`spec/panel-spec-v0.4.json`): 380 × 210 × 3 мм,
  42 клавиши — точная геометрия Lapka-42 (21 на половину, половины ±18°),
  16 энкодеров Ø14, 10 mini-jack, экран 5.0″ 800×480 (вырез 108 × 64.8, без рамки),
  2 фейдера 60 мм. Проверка пересечений — 0.
- Печать 1:1: `renders/templates/bukifon_v04_panel_1to1.pdf` (2 × A4 с перекрытием),
  рендер `bukifon_v04_render.png`, сравнение `bukifon_v04_vs_concept.png`.
- **3D-корпус v0.4** (`mechanical/stl_v04/`): 6 деталей, 380 × 210 × 63 мм, watertight,
  83 выреза, fitcheck — 0 конфликтов, печать без поддержек.
- Принят машиночитаемый пакет заказчика v0.3 (`refs/handoff_v03/`, `spec/panel-spec-v0.3.json`).
- Документы: `docs/10-elektron-hardware.md` (что внутри Elektron),
  `docs/11-esp32-feasibility.md` (ESP32-P4/S3/H743), `docs/03-second-opinion-mcu.md`,
  `docs/04-consultation-gpt.md` (GPT/Codex), `docs/12-roadmap.md`,
  `spec/90-requirements-registry.md` (реестр R-01…R-19, решения D-01…D-07).
- Позиционирование: сэмплер (Digitakt-класс) + синтезатор (Syntakt-класс) +
  открытые модули сообщества (`spec/00-vision.md §12`, `README.md`).
- `PULL_REQUEST.md` — описание MR v0.4.

### Изменено
- Наклон клавиатур: вместо трассировки по фото (±22°) принят ±18° с точной
  геометрией Lapka-42 — иначе две половины + 5″ экран не влезают в 210 мм высоты.
- Порядок разработки: сначала бенчмарк и cut-list, только потом платы (по ревью).

### Исправлено
- Убраны расхождения «315×145 / 8 ручек / 2.8″» из новых документов (старые спеки
  помечены к правке в `spec/90`).

## [0.3.0] — 2025-11-05 — «380 × 210 по концепту»
- Раскладка v1.7/v1.8: 380 × 210, 42 клавиши, 16 ручек, 10 джеков, 2 фейдера.
- Первая 3D-модель корпуса v1.7/v1.8 (380 × 210 × 63) и рендеры.
- Документ передачи контекста `docs/00-context-transfer.md`.

## [0.2.0] — 2025-11-05 — «Печатные листы и 340 × 185»
- Листы 1:1 Digitone II и Octatrack MKII, шаблон Lapka-42 (левая/правая половины).
- Варианты панели 340 × 185 (v1.4.1, ±5°), 380 × 210 (v1.5, ±20°).

## [0.1.0] — 2025-11-05 — «Базовый прототип»
- Корпус 315 × 145 × 48, 20 STL, схемы CORE-1/PANEL-1/деки/модули/PWR (ERC 0),
  прошивка RP2040 (host-тесты 67/67, UF2), BOM, документация.
