martiyanov/bukifon/docs/81-faq.md

# FAQ: частые вопросы о Букифоне

Коротко и честно. Подробности — в ссылках; ограничения — [docs/76](76-known-limitations.md).

## Покупка и цена

**Что такое Букифон?**
Открытый настольный синтезатор-сэмплер-секвенсор: 42 клавиши, 16 энкодеров, 5″ 800×480,
10 джеков, 2 фейдера, микрофон; корпус печатается на 3D-принтере (231–314 г), схемы KiCad,
прошивка C++, модули.

**Сколько стоит?**
Цель: **P4 Standard $299**, Full Bundle $399; S3-lite — $199/$175 (β). COGS P4 на партии 10 —
**$215**, маржа тонкая (gross ~28 %); цены в BOM ±30 % ([docs/33](33-bom-s3.md)).

**Когда можно купить?**
Пока **не продаётся**: v1.0-rc после PWR 13/13, P1-замеров (MCU), PCB rev.1, 3–5 прототипов
и RC DoD. Следить — GitHub/сайт; статус — [docs/75](75-release-readiness.md).

**Можно купить набор для самостоятельной сборки?**
Да, планируется kit: платы + BOM + STL + paperkit. Сборка — [docs/72](72-assembly-workshops.md)
(мастерские) или сам ([docs/34](34-assembly.md)).

## Железо

**P4 или S3?**
P4 — основной: RGB565/DSI, USB HS UAC2 8×8, 32 МБ PSRAM. S3 — lite: SPI-экран (медленнее),
USB stereo. Решение — после P1 ([docs/56](56-p1-measurements.md)).

**Микрофон для чего?**
Запись голоса → сэмпл/пэд, битбокс → шаги секвенсора, вокодер — v1.1. Аппаратный mute + LED,
не «always-on» ([docs/71](71-mic-voice.md)).

**Есть ли батарея?**
В первой партии — внешний БП; батарея 1S LiPo — опция позже (D-39/D-56).

**Сколько весит/какие габариты?**
380×210×61.5 (B-light инпут) / 63 мм; 231–314 г в зависимости от варианта; 4 варианта корпуса
([docs/45](45-case-variants.md)).

**Можно напечатать корпус дома?**
Да, PETG, 0.4/0.2, детали ≤220×220, B-light на 231 г/11.2 ч ([docs/35](35-print-first.md)).

## Звук и софт

**Сколько голосов/дорожек?**
4 внутренние партии + 8 внешних MIDI-треков; P4 — 8 стерео/8 голосов; S3 — 8 моно/6 голосов.

**Можно ли управлять внешними синтезаторами?**
Да: 8 MIDI-треков (канал/PC/vel/length, p-lock CC), clock in/out 24 ppqn, DIN+USB MIDI,
CV/GATE ([docs/70](70-external-sequencer.md)).

**Генеративность?**
PROB/EUCLID/MUTATE/SCALE/ARP/EVOLVE/SEED для внутренних и внешних треков ([docs/66](66-ux-implementation.md)).

**Можно ли загружать софтовые модули/синтезаторы?**
Да, в планах (бэклог v1.1+): `.bkm`-«машины»/эффекты/генераторы, установка по USB/SD/Wi-Fi,
менеджер модулей, подпись и sandbox — [docs/91](91-software-modules.md).

**Модули?**
SDK v0.2: манифест, безопасный loader, примеры; в v1.0 модули статически линкуются, динамика —
после P1 ([docs/24](24-module-sdk.md)).

**Прошивка открыта?**
Да, C++17, host-тесты 351, SDK; обновление по USB, recovery UART ([docs/42](42-dfm-review-gpt.md)).

## Открытость и ремонт

**Лицензии?**
Железо — CERN-OHL-S-2.0, прошивка — GPL-3.0-or-later, документация — CC-BY-SA-4.0
([docs/09](09-licensing.md)).

**Можно ли делать и продавать свои?**
Да по CERN-OHL-S (с сохранением открытости); коммерческая сборка — по [docs/72](72-assembly-workshops.md).

**Ремонт?**
12 мес гарантия (при покупке), открытые схемы, self-test 21, запчасти ([docs/78](78-support-repair.md)).

## Сравнение

**Чем отличается от Digitakt/Move/M8?**
Полная клавиатура + 16 энкодеров + CV/GATE + микрофон, открытые схемы/прошивка/STL, $299;
подробно — [docs/79](79-competitors-2026.md).

**Это «ещё один грувбокс»?**
Нет: гибрид синтезатора, сэмплера, секвенсора и MIDI-хаба, который можно собрать/починить/изменить.

## Участие

**Как помочь?**
Пройти UX-тест (`/demo/?test=1`, [docs/74](74-usability-test-harness.md)), собрать по paperkit и
прислать замечания, предложить модуль, помочь с BOM/поставками, напечатать корпус.
