martiyanov/bukifon/hardware/core2/CORE-2.pdf

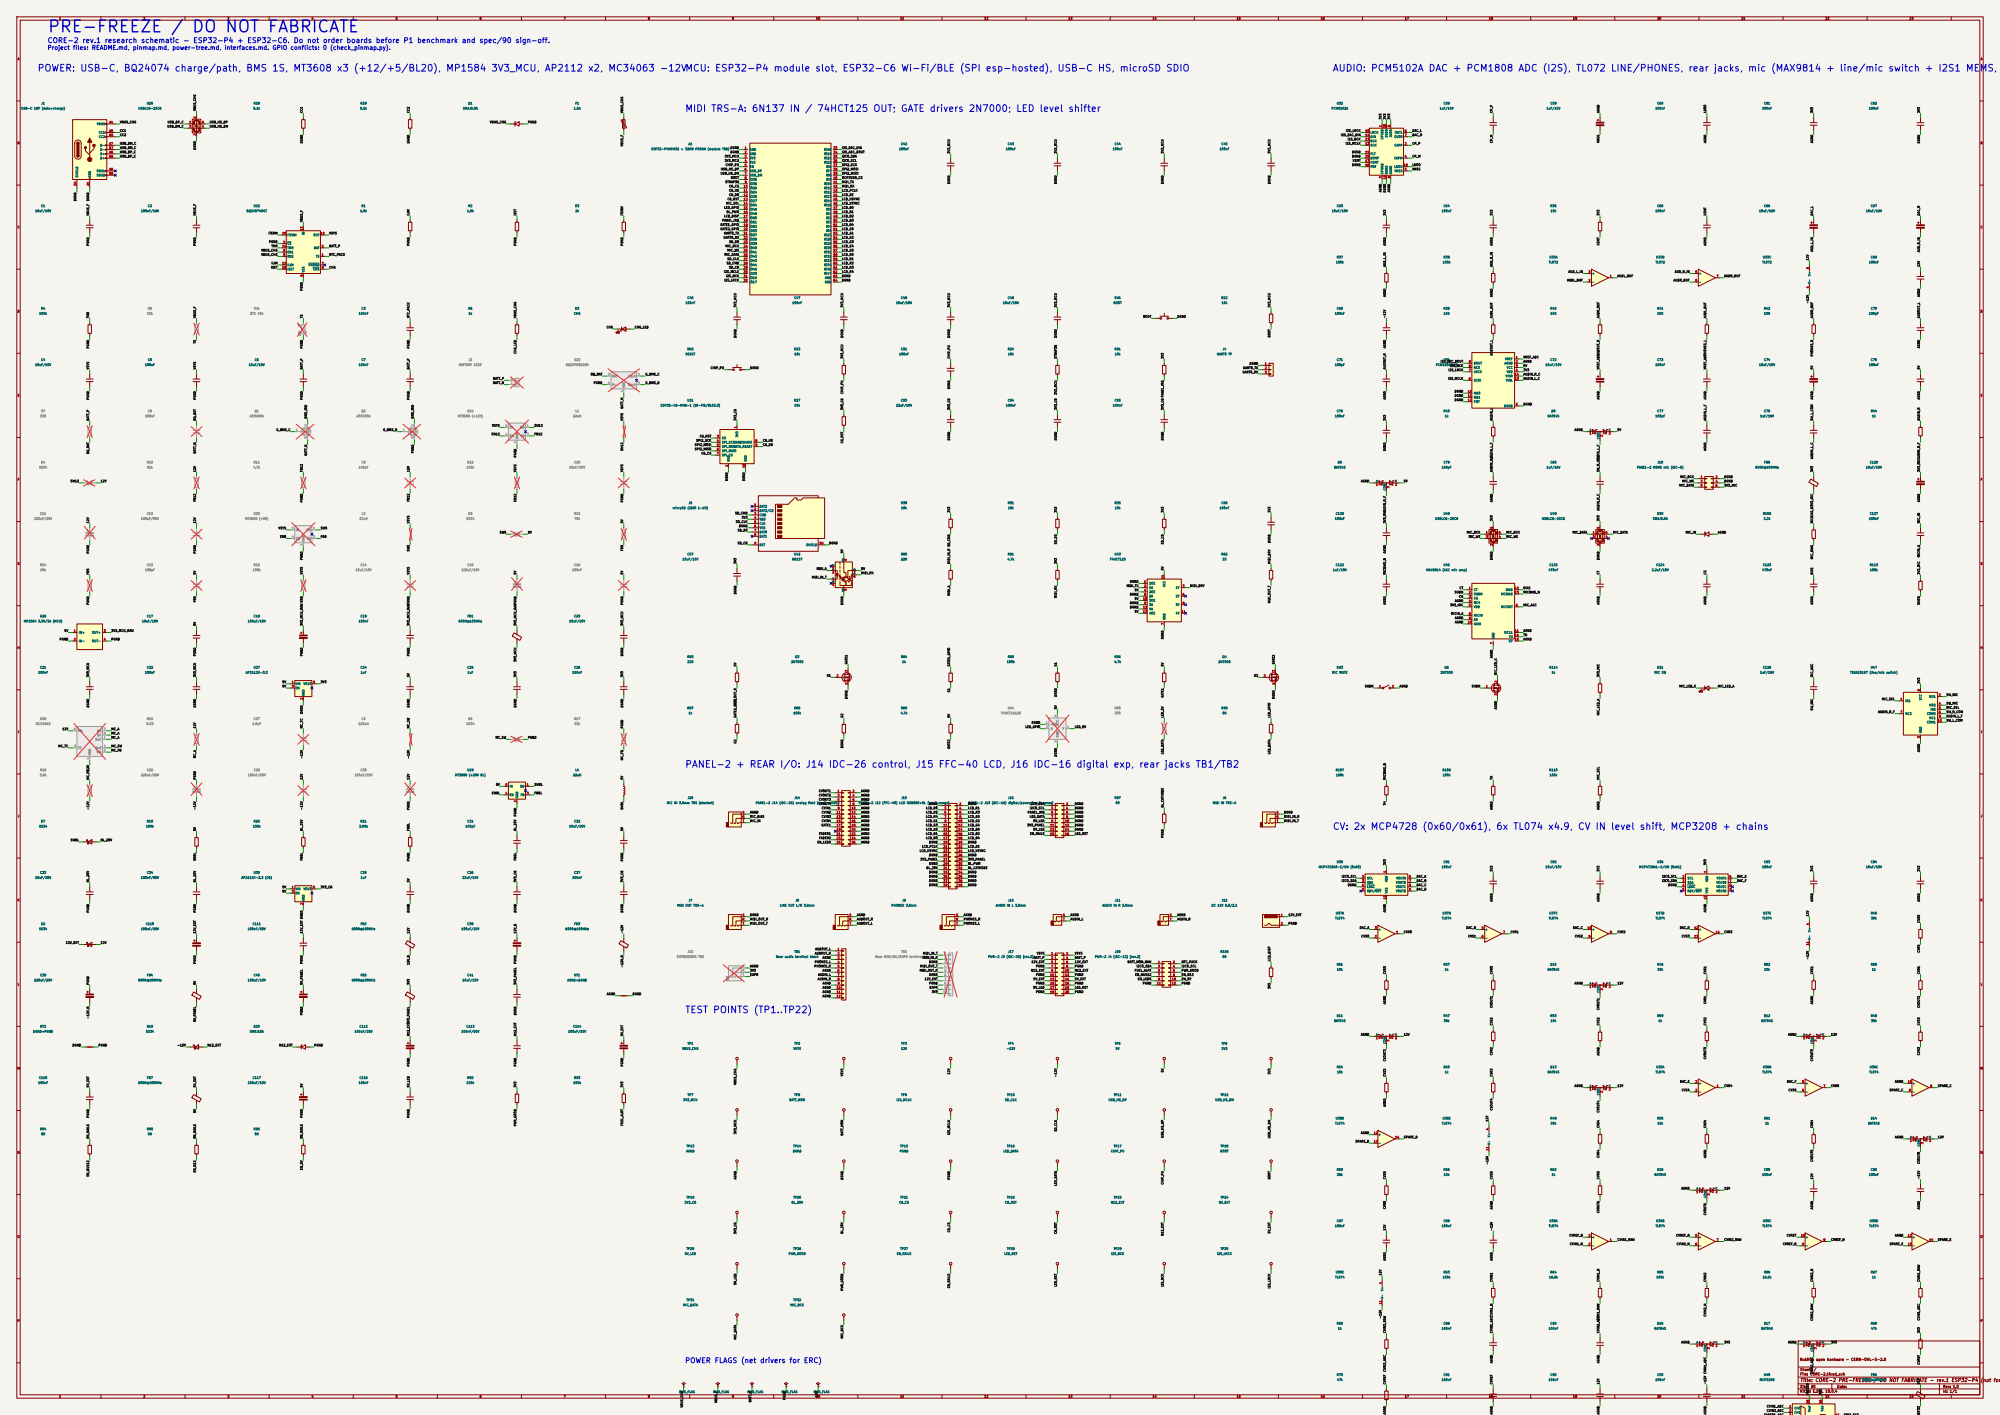
[picture p148: page 1]

PRE-FREEZE / DO NOT FABRICATE

CORE-2 rev.1 research schematic - ESP32-P4 + ESP32-C6. Do not order boards before P1 benchmark and spec/90 sign-off.
Project files: README.md, pinmap.md, power-tree.md, interfaces.md. GPIO conflicts: 0 (check_pinmap.py).

MCU: ESP32-P4 module slot, ESP32-C6 Wi-Fi/BLE (SPI esp-hosted), USB-C HS, microSD SDIO

MIDI TRS-A: 6N137 IN / 74HCT125 OUT; GATE drivers 2N7000; LED level shifter

J19 PANEL-2 MEMS mic (IDC-6) D30

PANEL-2 + REAR I/O: J14 IDC-26 control, J15 FFC-40 LCD, J16 IDC-16 digital exp, rear jacks TB1/TB2

J14 PANEL-2 J14 (IDC-26) analog field [rev.2 canon]

J15 PANEL-2 J12 (FFC-40) LCD RGB565+BL [rev.2 canon]
AGND

CV: 2x MCP4728 (0x60/0x61), 6x TL074 x4.9, CV IN level shift, MCP3208 + chains

POWER FLAGS (net drivers for ERC)

Bukifon open hardware - CERN-OHL-S-2.0

Sheet: /
File: CORE-2.kicad_sch
Title: CORE-2 PRE-FREEZE / DO NOT FABRICATE - rev.1 ESP32-P4 (not for fabrication)

Size: A0 | Rev: 1.0
KiCad E.D.A. 10.0.4 | Id: 1/1
