martiyanov/bukifon/hardware/core/CORE-1.pdf

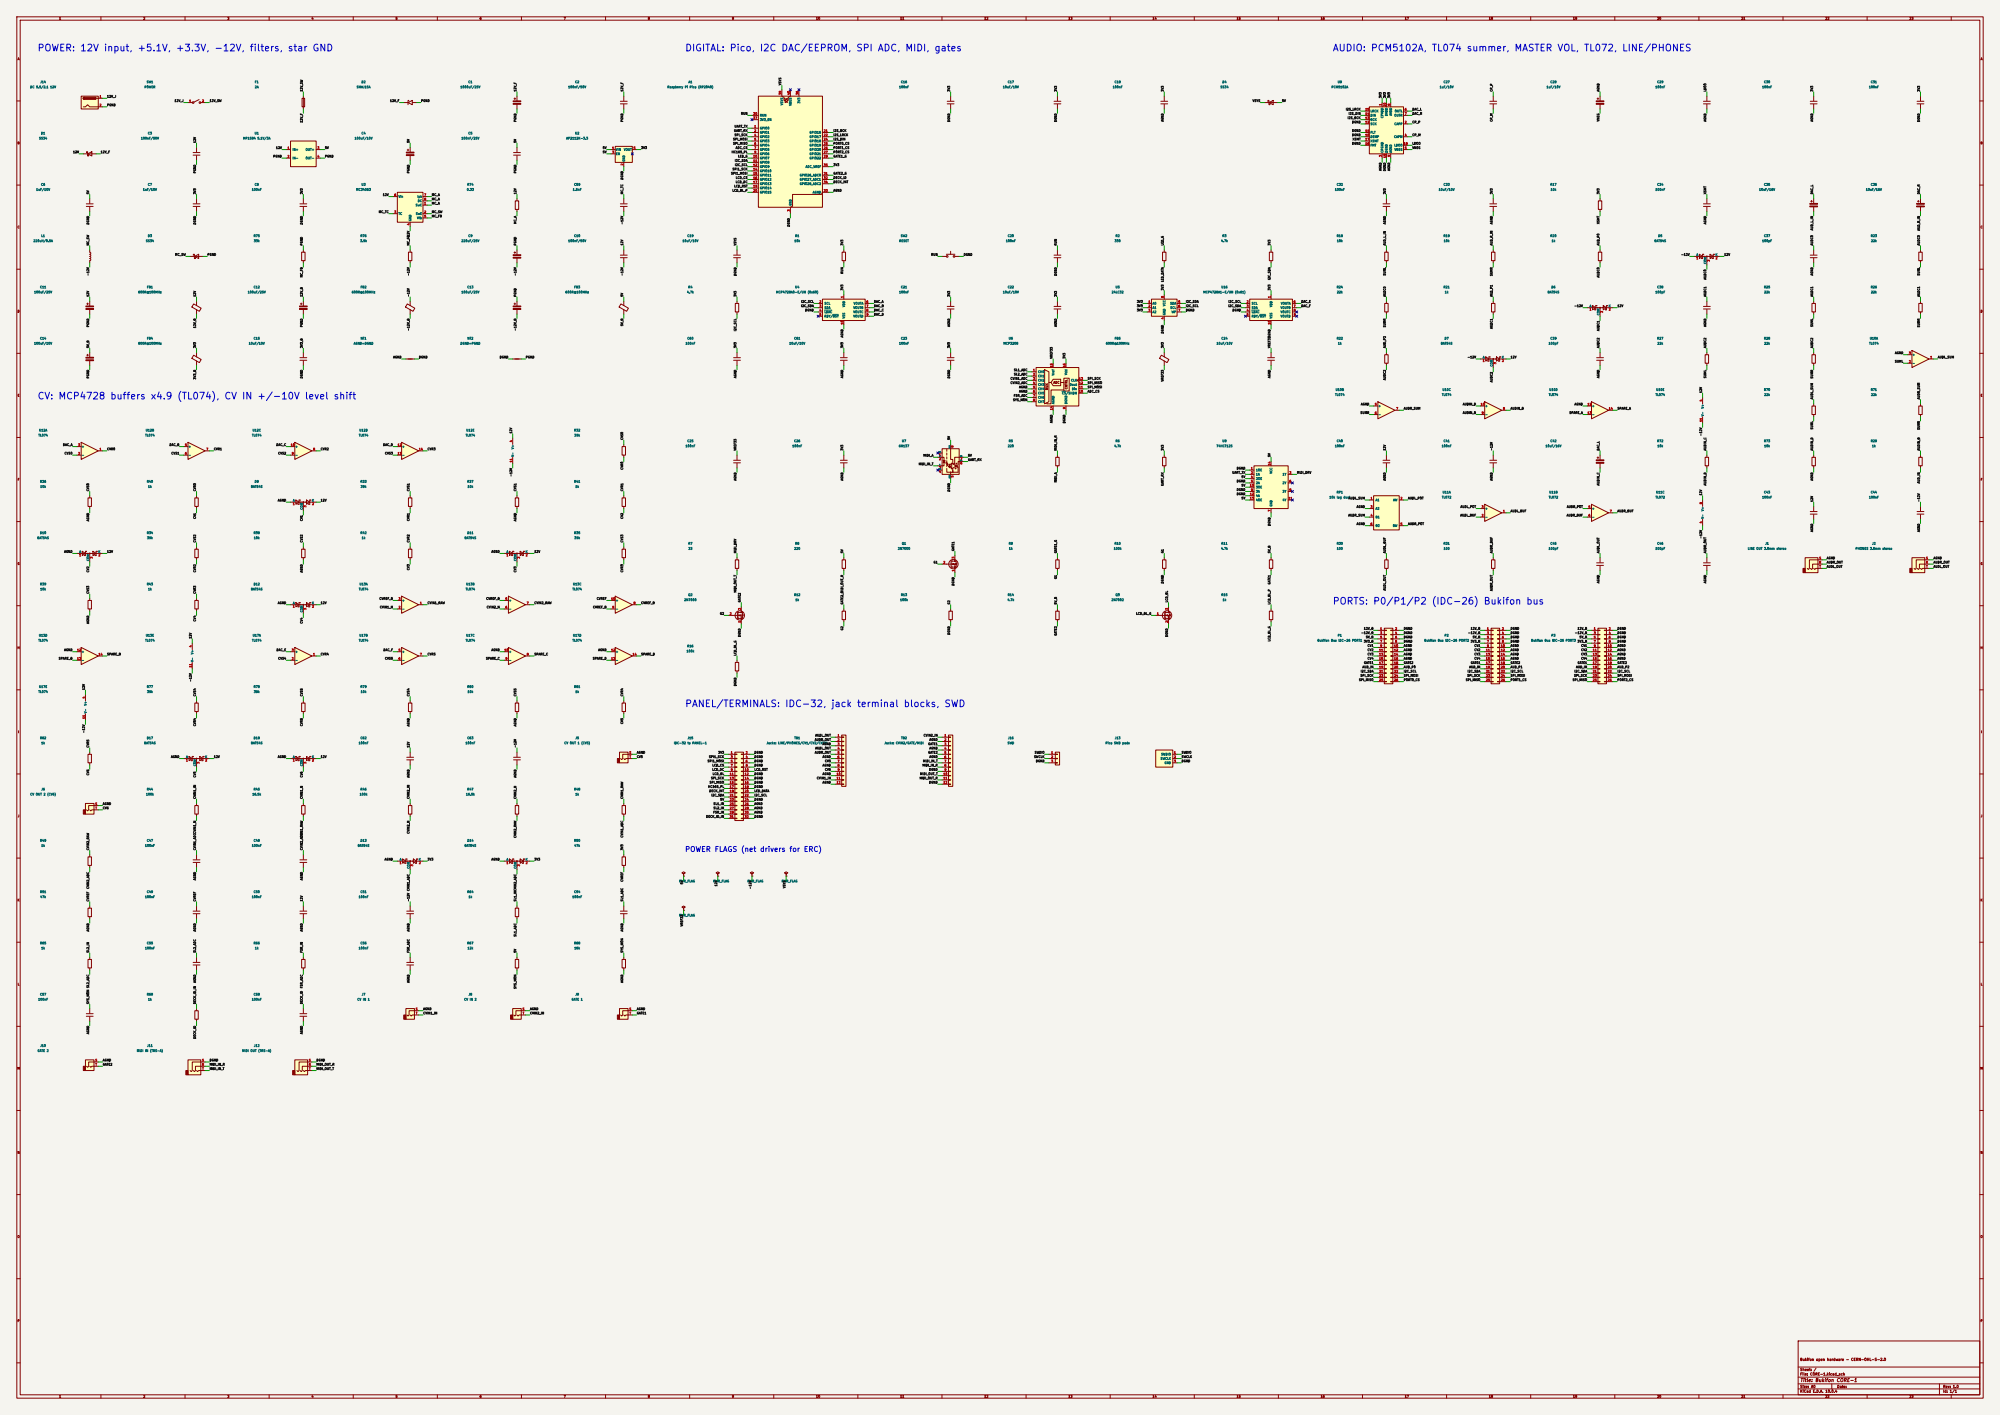
[picture p152: page 1]

AUDIO: PCM5102A, TL074 summer, MASTER VOL, TL072, LINE/PHONES

CV: MCP4728 buffers x4.9 (TL074), CV IN +/-10V level shift

PORTS: P0/P1/P2 (IDC-26) Bukifon bus

PANEL/TERMINALS: IDC-32, jack terminal blocks, SWD

POWER FLAGS (net drivers for ERC)

Bukifon open hardware - CERN-OHL-S-2.0

Size: A0 | Rev: 1.0
KiCad E.D.A. 10.0.4 | Id: 1/1
