martiyanov/bukifon/hardware/power/PWR-BATT-1.pdf

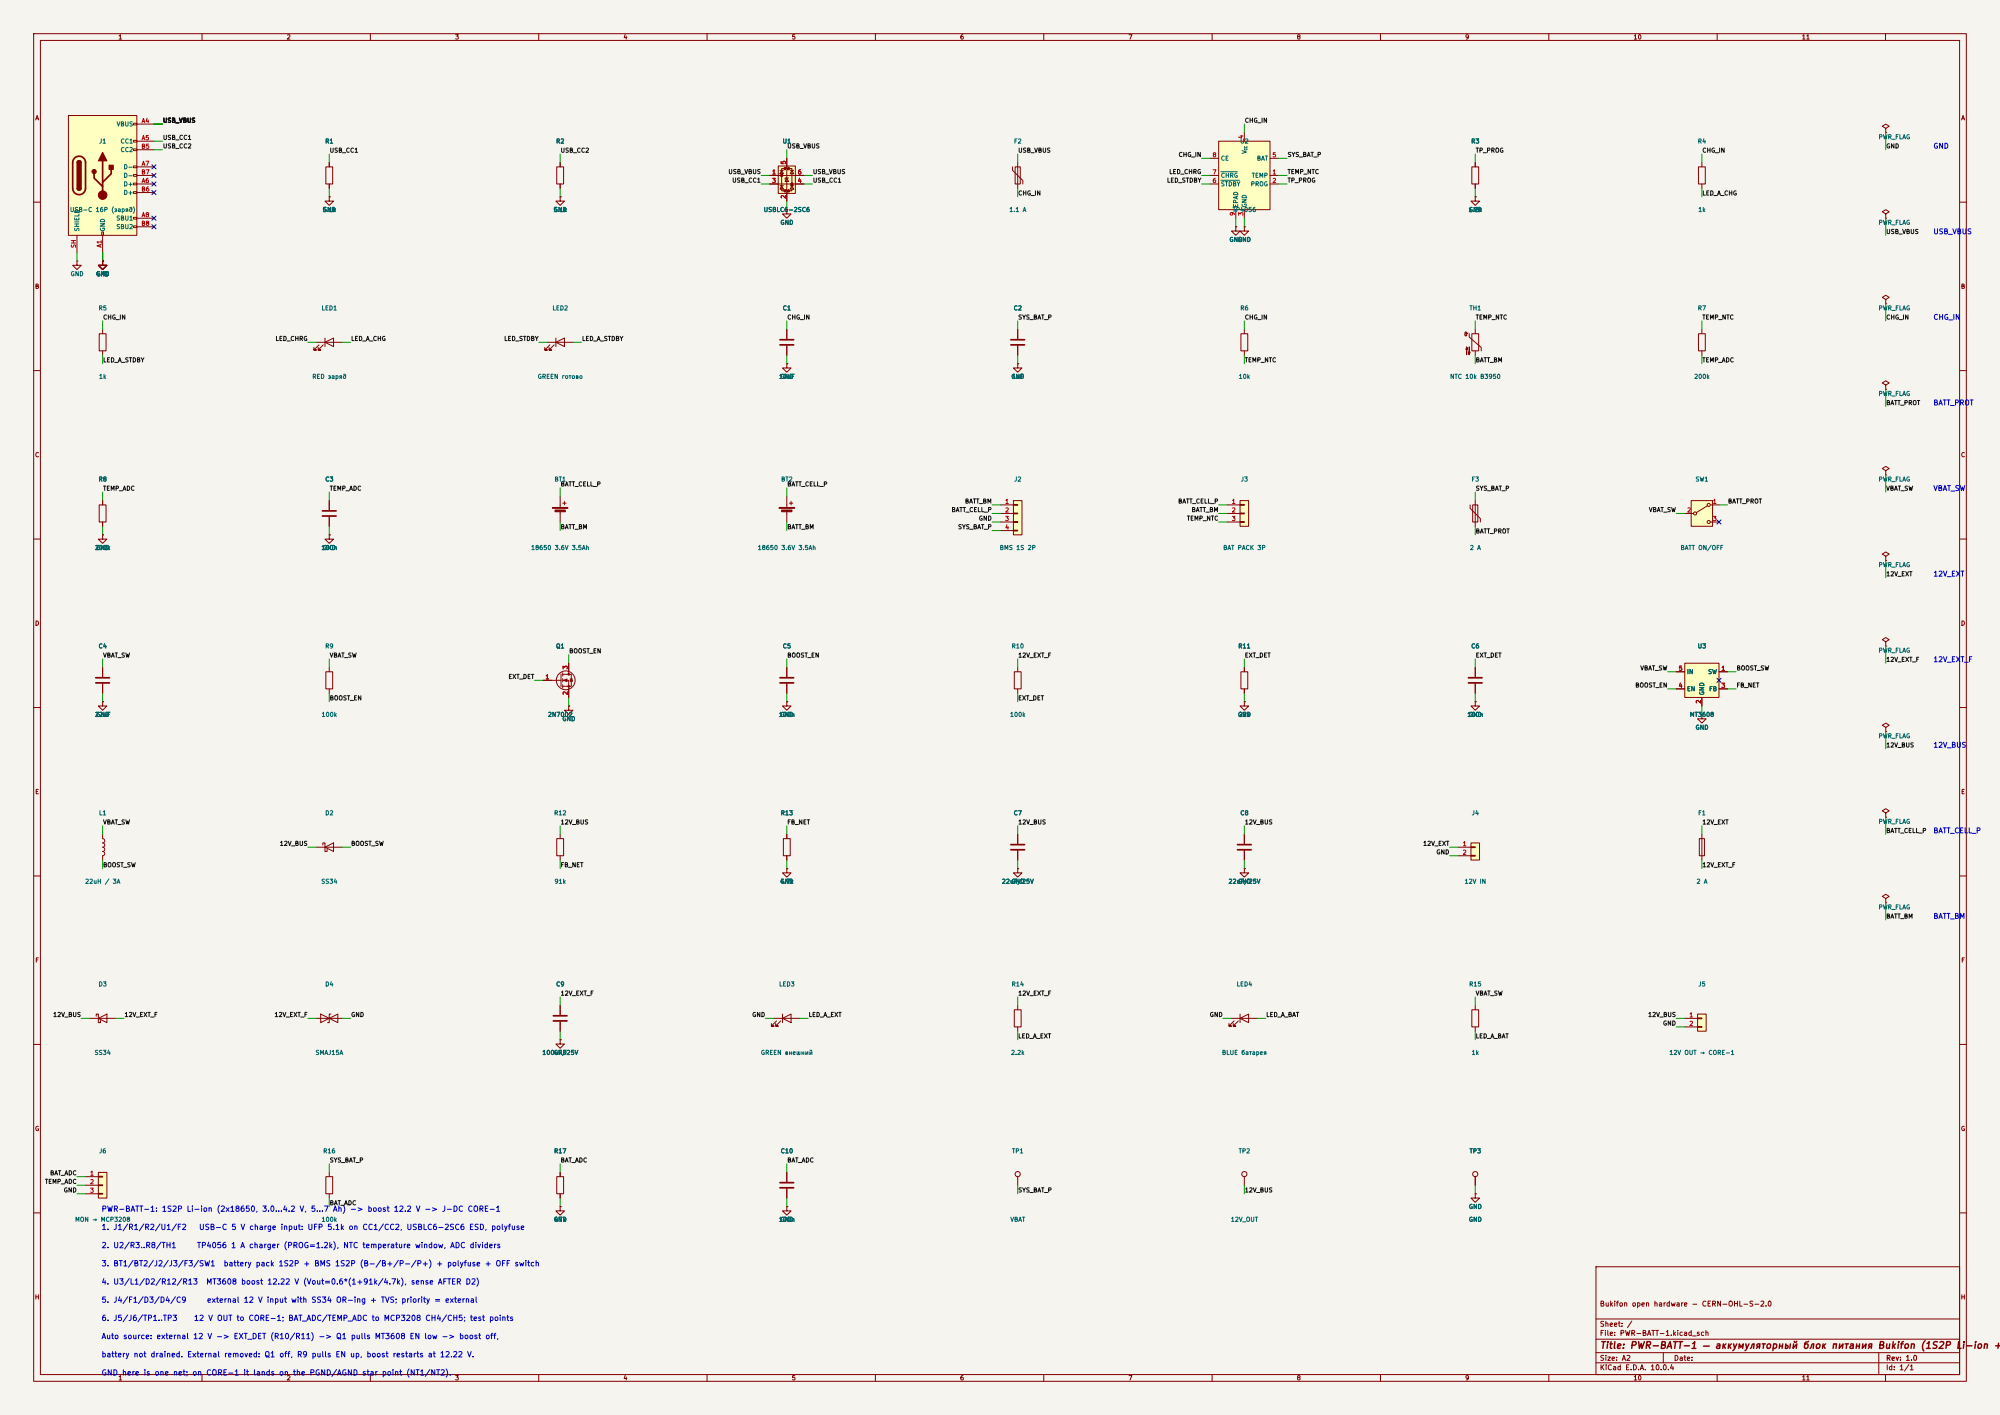
[picture p153: page 1]

SW1 BATT ON/OFF SW

PWR-BATT-1: 1S2P Li-ion (2x18650, 3.0...4.2 V, 5...7 Ah) -> boost 12.2 V -> J-DC CORE-1

3. BT1/BT2/J2/J3/F3/SW1 battery pack 1S2P + BMS 1S2P (B-/B+/P-/P+) + polyfuse + OFF switch

4. U3/L1/D2/R12/R13 MT3608 boost 12.22 V (Vout=0.6*(1+91k/4.7k), sense AFTER D2)

Bukifon open hardware - CERN-OHL-S-2.0

Sheet: /
File: PWR-BATT-1.kicad_sch
Title: PWR-BATT-1 — аккумуляторный блок питания Bukifon (1S2P Li-ion + USB-C + boost 12.2 В)

Auto source: external 12 V -> EXT_DET (R10/R11) -> Q1 pulls MT3608 EN low -> boost off,

battery not drained. External removed: Q1 off, R9 pulls EN up, boost restarts at 12.22 V.

Size: A2 | Rev: 1.0
KiCad E.D.A. 10.0.4 | Id: 1/1

GND here is one net; on CORE-1 it lands on the PGND/AGND star point (NT1/NT2).
