martiyanov/bukifon/hardware/panel2/rev1/PANEL-2-left-rev1.pdf

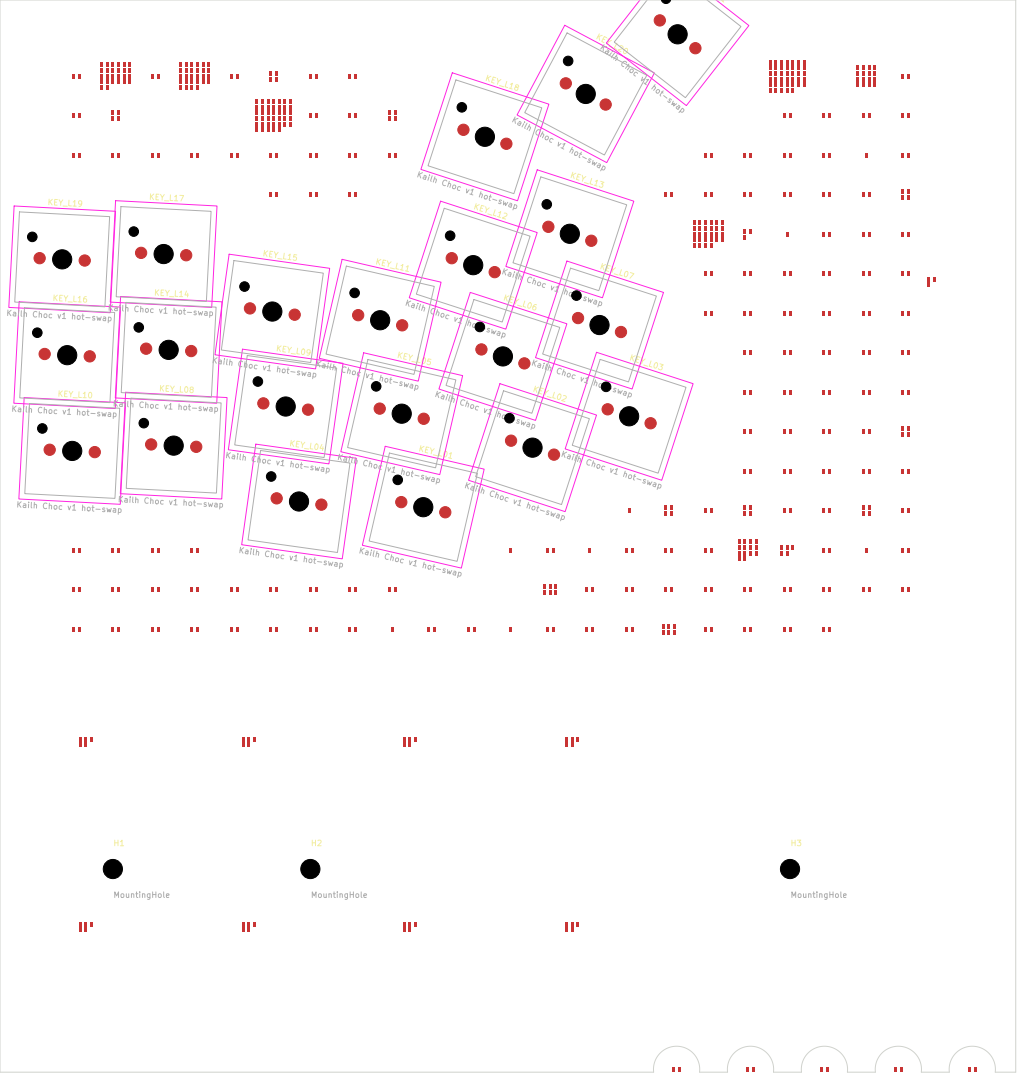
[picture p154: page 1]

Kailh Choc v1 hot-swap

Kailh Choc v1 hot-swap MountingHole

KEY_L16 Kailh Choc v1 hot-swap

Kailh Choc v1 hot-swap Kailh Kailh Choc v1 hot-swap Choc v1 hot-swap MountingHole

Kailh Choc v1 hot-swap Kailh Choc v1 hot-swap MountingHole
