martiyanov/bukifon/hardware/panel2/rev1/PANEL-2-right-rev1.pdf

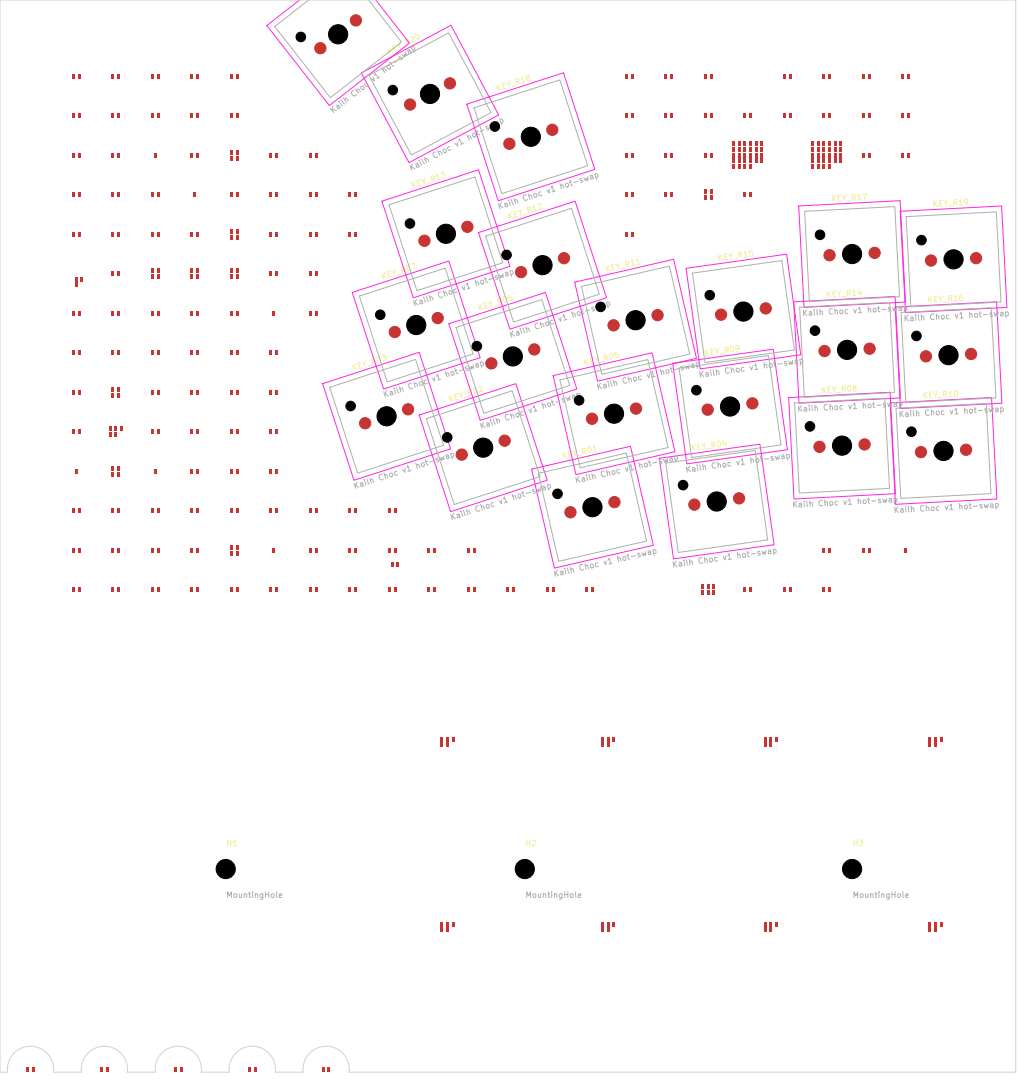
[picture p155: page 1]

Kailh Choc v1 hot-swap MountingHole MountingHole

Kailh Choc v1 hot-swap

Kailh Choc v1 hot-swap Kailh Choc v1 hot-swap MountingHole Kailh Choc v1 hot-swap Kailh Choc v1 hot-swap Kailh Choc v1 hot-swap Kailh Choc v1 hot-swap

KEY_R05 Kailh Choc v1 hot-swap
