martiyanov/bukifon/hardware/core2/rev1/CORE-2-rev1.pdf

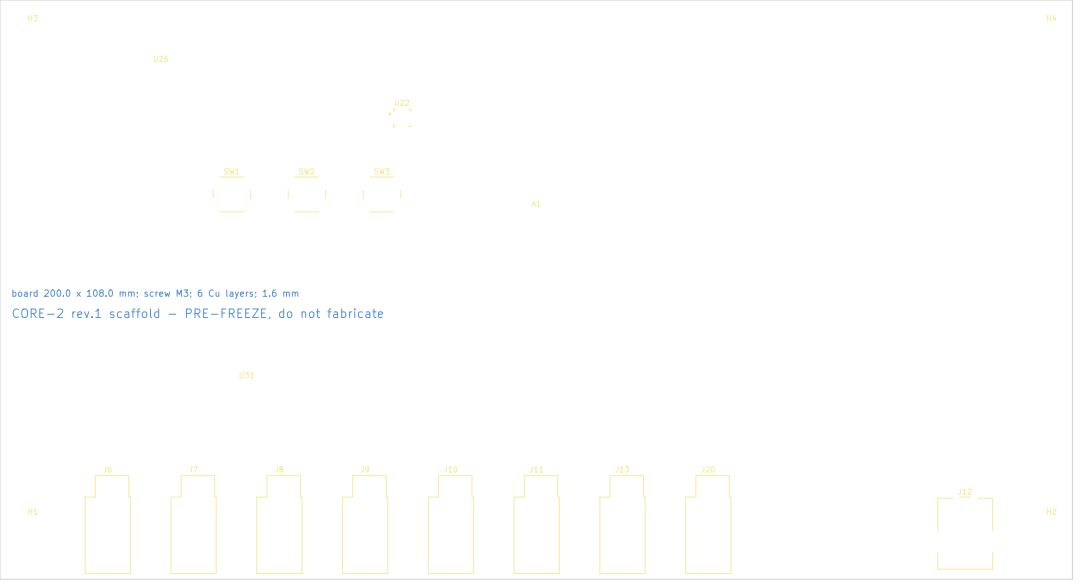
[picture p156: page 1]

J7 board 200.0 x 108.0 mm; screw M3; 6 Cu layers; 1.6 mm CORE-2 rev.1 scaffold - PRE-FREEZE, do not fabricate
