martiyanov/bukifon/hardware/panel2/adapter-lcd/LCD-ADAPTER.pdf

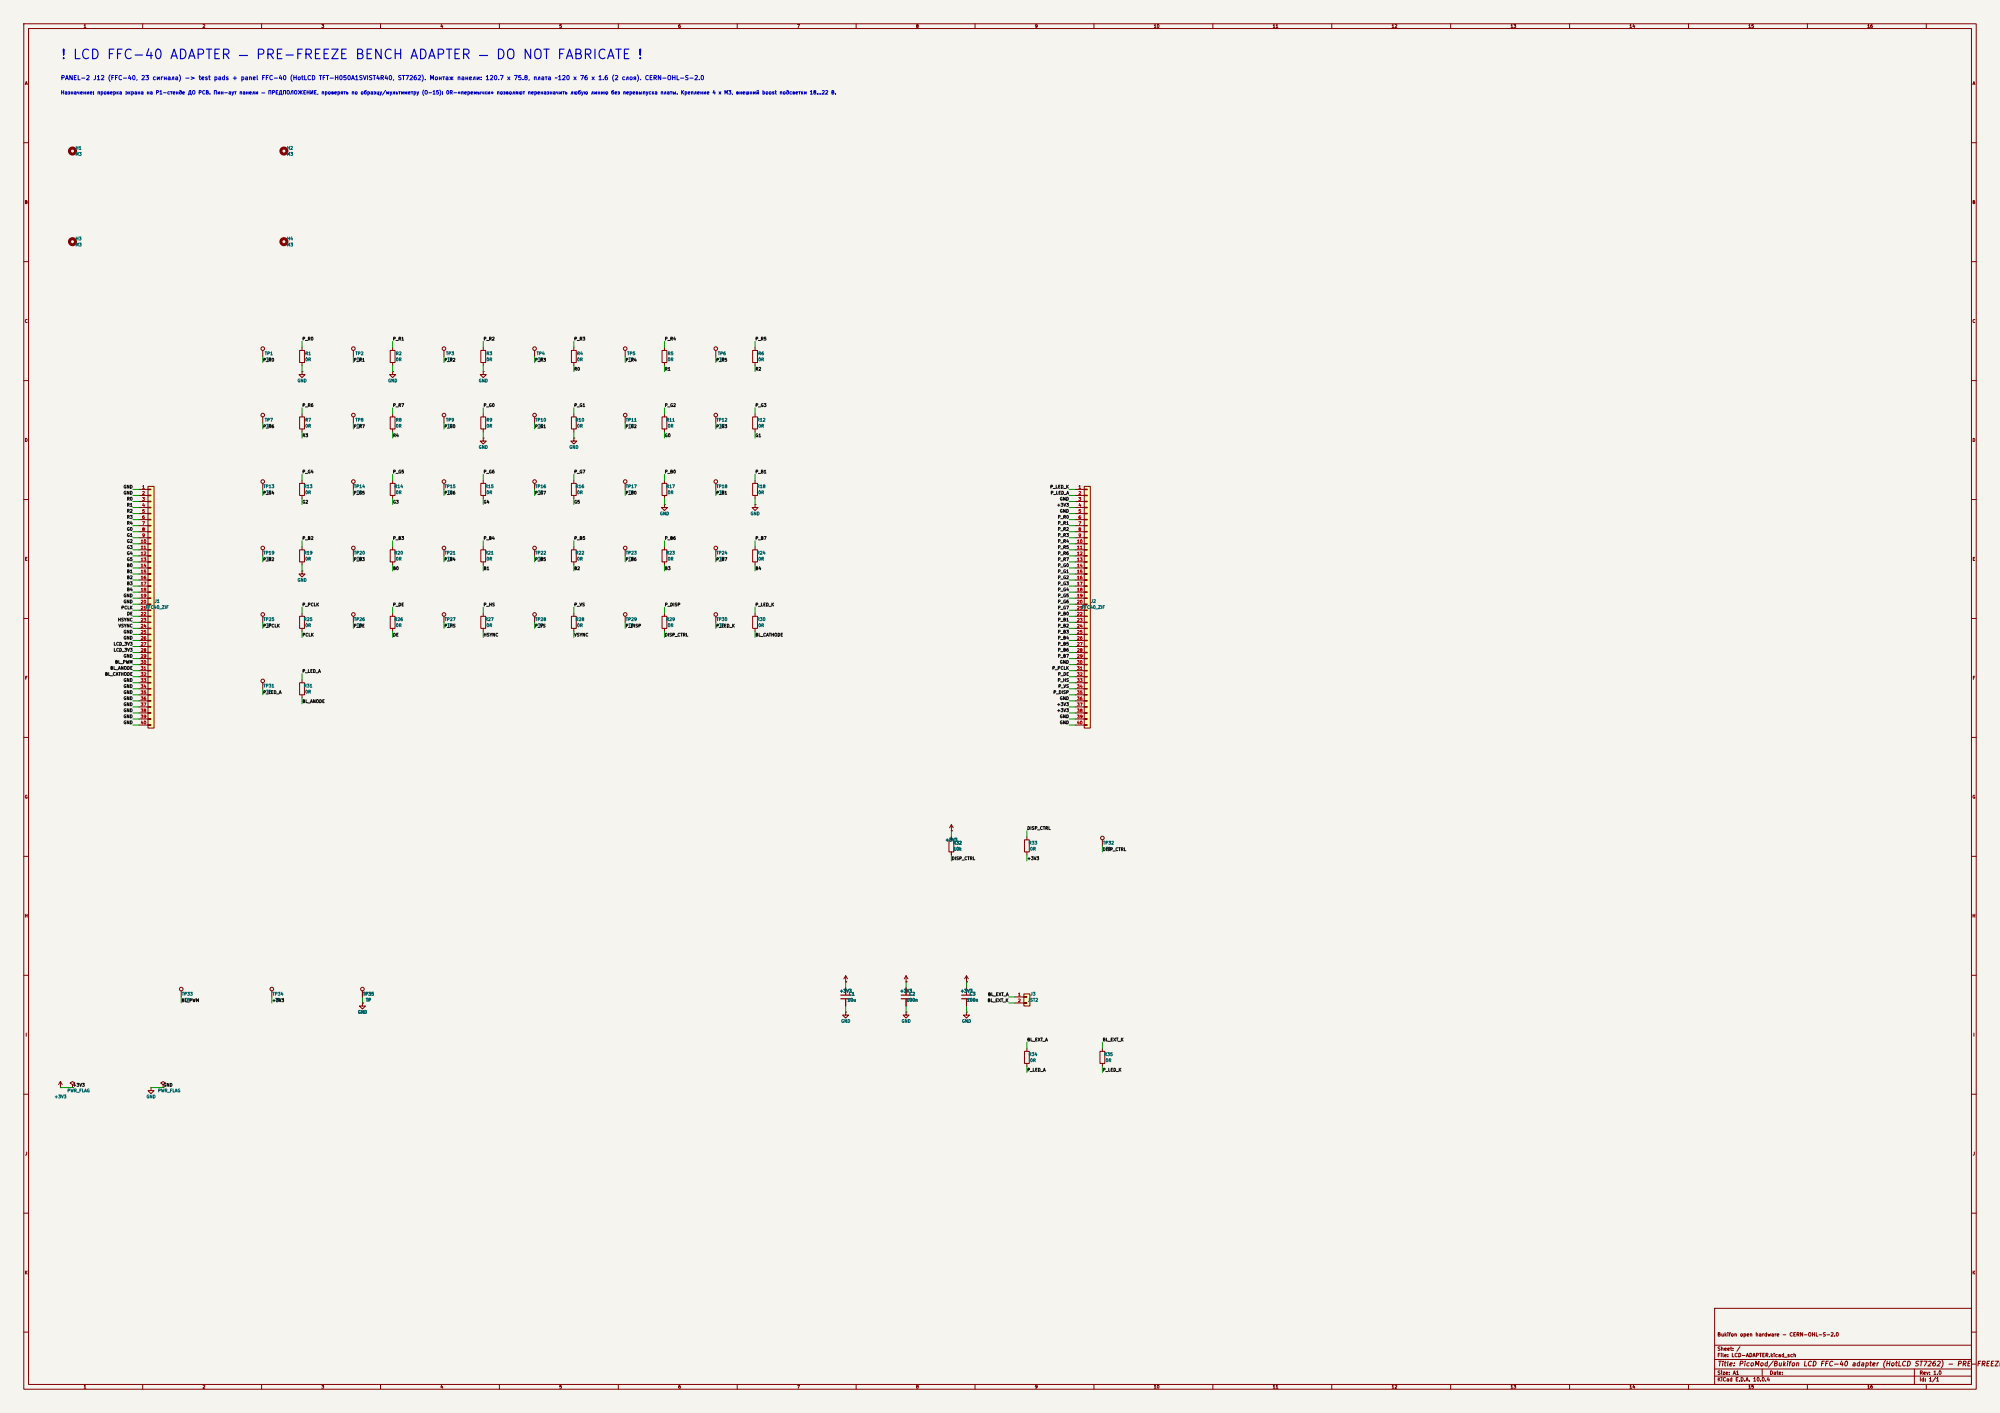
[picture p157: page 1]

! LCD FFC-40 ADAPTER — PRE-FREEZE BENCH ADAPTER — DO NOT FABRICATE !

PANEL-2 J12 (FFC-40, 23 сигнала) -> test pads + panel FFC-40 (HotLCD TFT-H050A1SVIST4R40, ST7262). Монтаж панели: 120.7 x 75.8, плата ~120 x 76 x 1.6 (2 слоя). CERN-OHL-S-2.0

Назначение: проверка экрана на P1-стенде ДО PCB. Пин-аут панели — ПРЕДПОЛОЖЕНИЕ, проверять по образцу/мультиметру (O-15): 0R-«перемычки» позволяют переназначить любую линию без перевыпуска платы. Крепление 4 x M3, внешний boost подсветки 18…22 В.

Bukifon open hardware - CERN-OHL-S-2.0

Sheet: /
File: LCD-ADAPTER.kicad_sch
Title: PicoMod/Bukifon LCD FFC-40 adapter (HotLCD ST7262) - PRE-FREEZE bench adapter, DO NOT FABRICATE

Size: A1 | Rev: 1.0
KiCad E.D.A. 10.0.4 | Id: 1/1
