martiyanov/bukifon/hardware/modules/pdf/MOD-ENSEMBLE-1.pdf

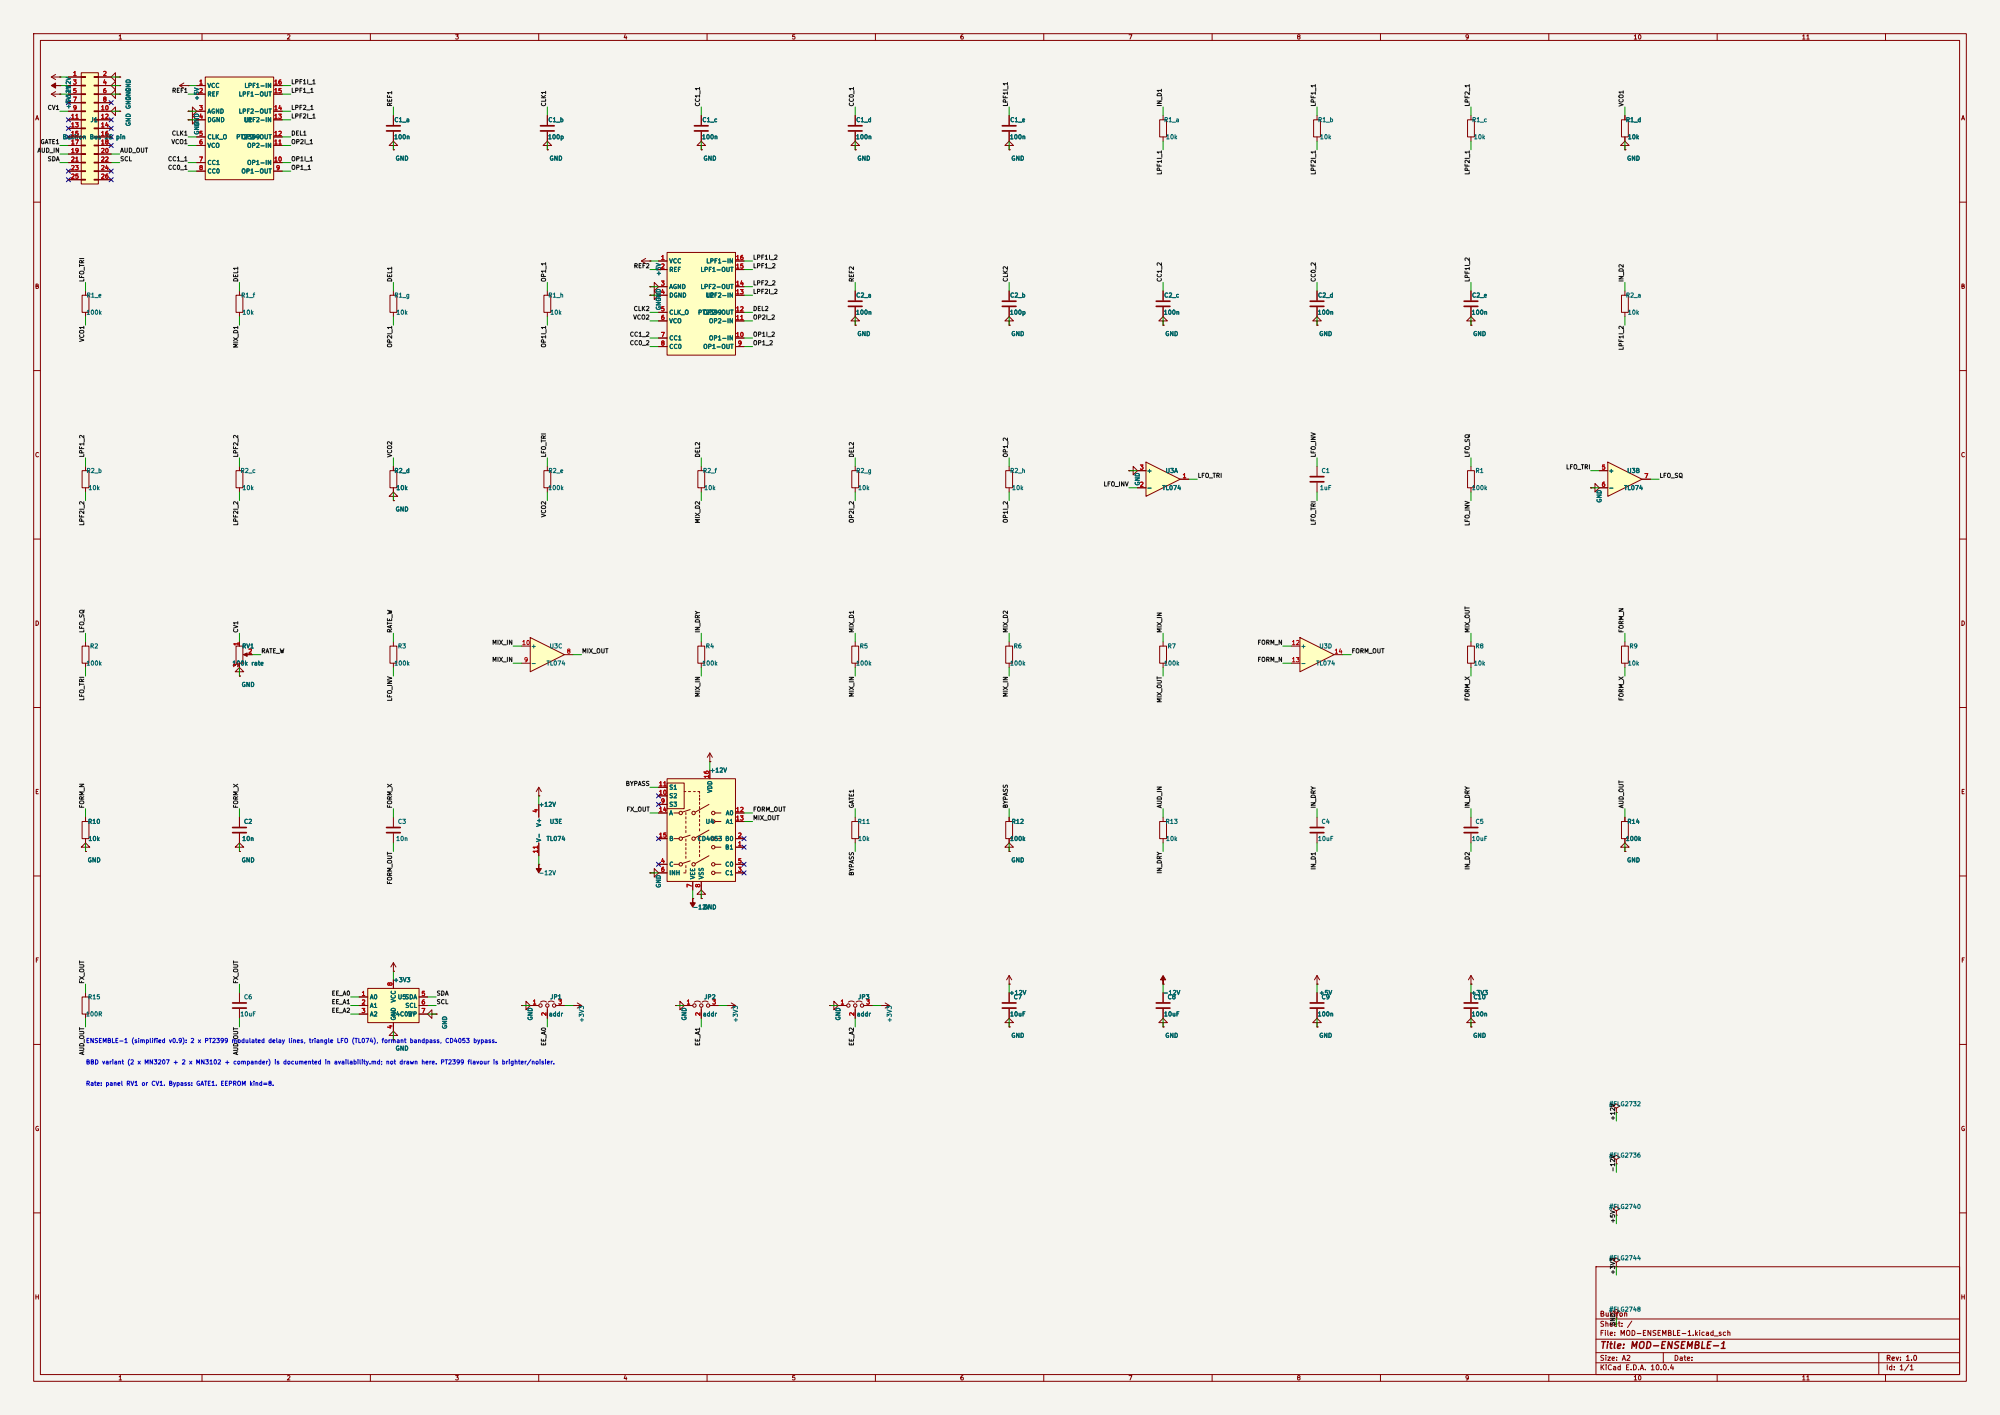
[picture p158: page 1]

BBD variant (2 x MN3207 + 2 x MN3102 + compander) is documented in availability.md; not drawn here. PT2399 flavour is brighter/noisier. Rate: panel RV1 or CV1. Bypass: GATE1. EEPROM kind=8. ENSEMBLE-1 (simplified v0.9): 2 x PT2399 modulated delay lines, triangle LFO (TL074), formant bandpass, CD4053 bypass.

Size: A2 | Rev: 1.0
KiCad E.D.A. 10.0.4 | Id: 1/1
