martiyanov/bukifon/hardware/modules/pdf/MOD-FILTER-1.pdf

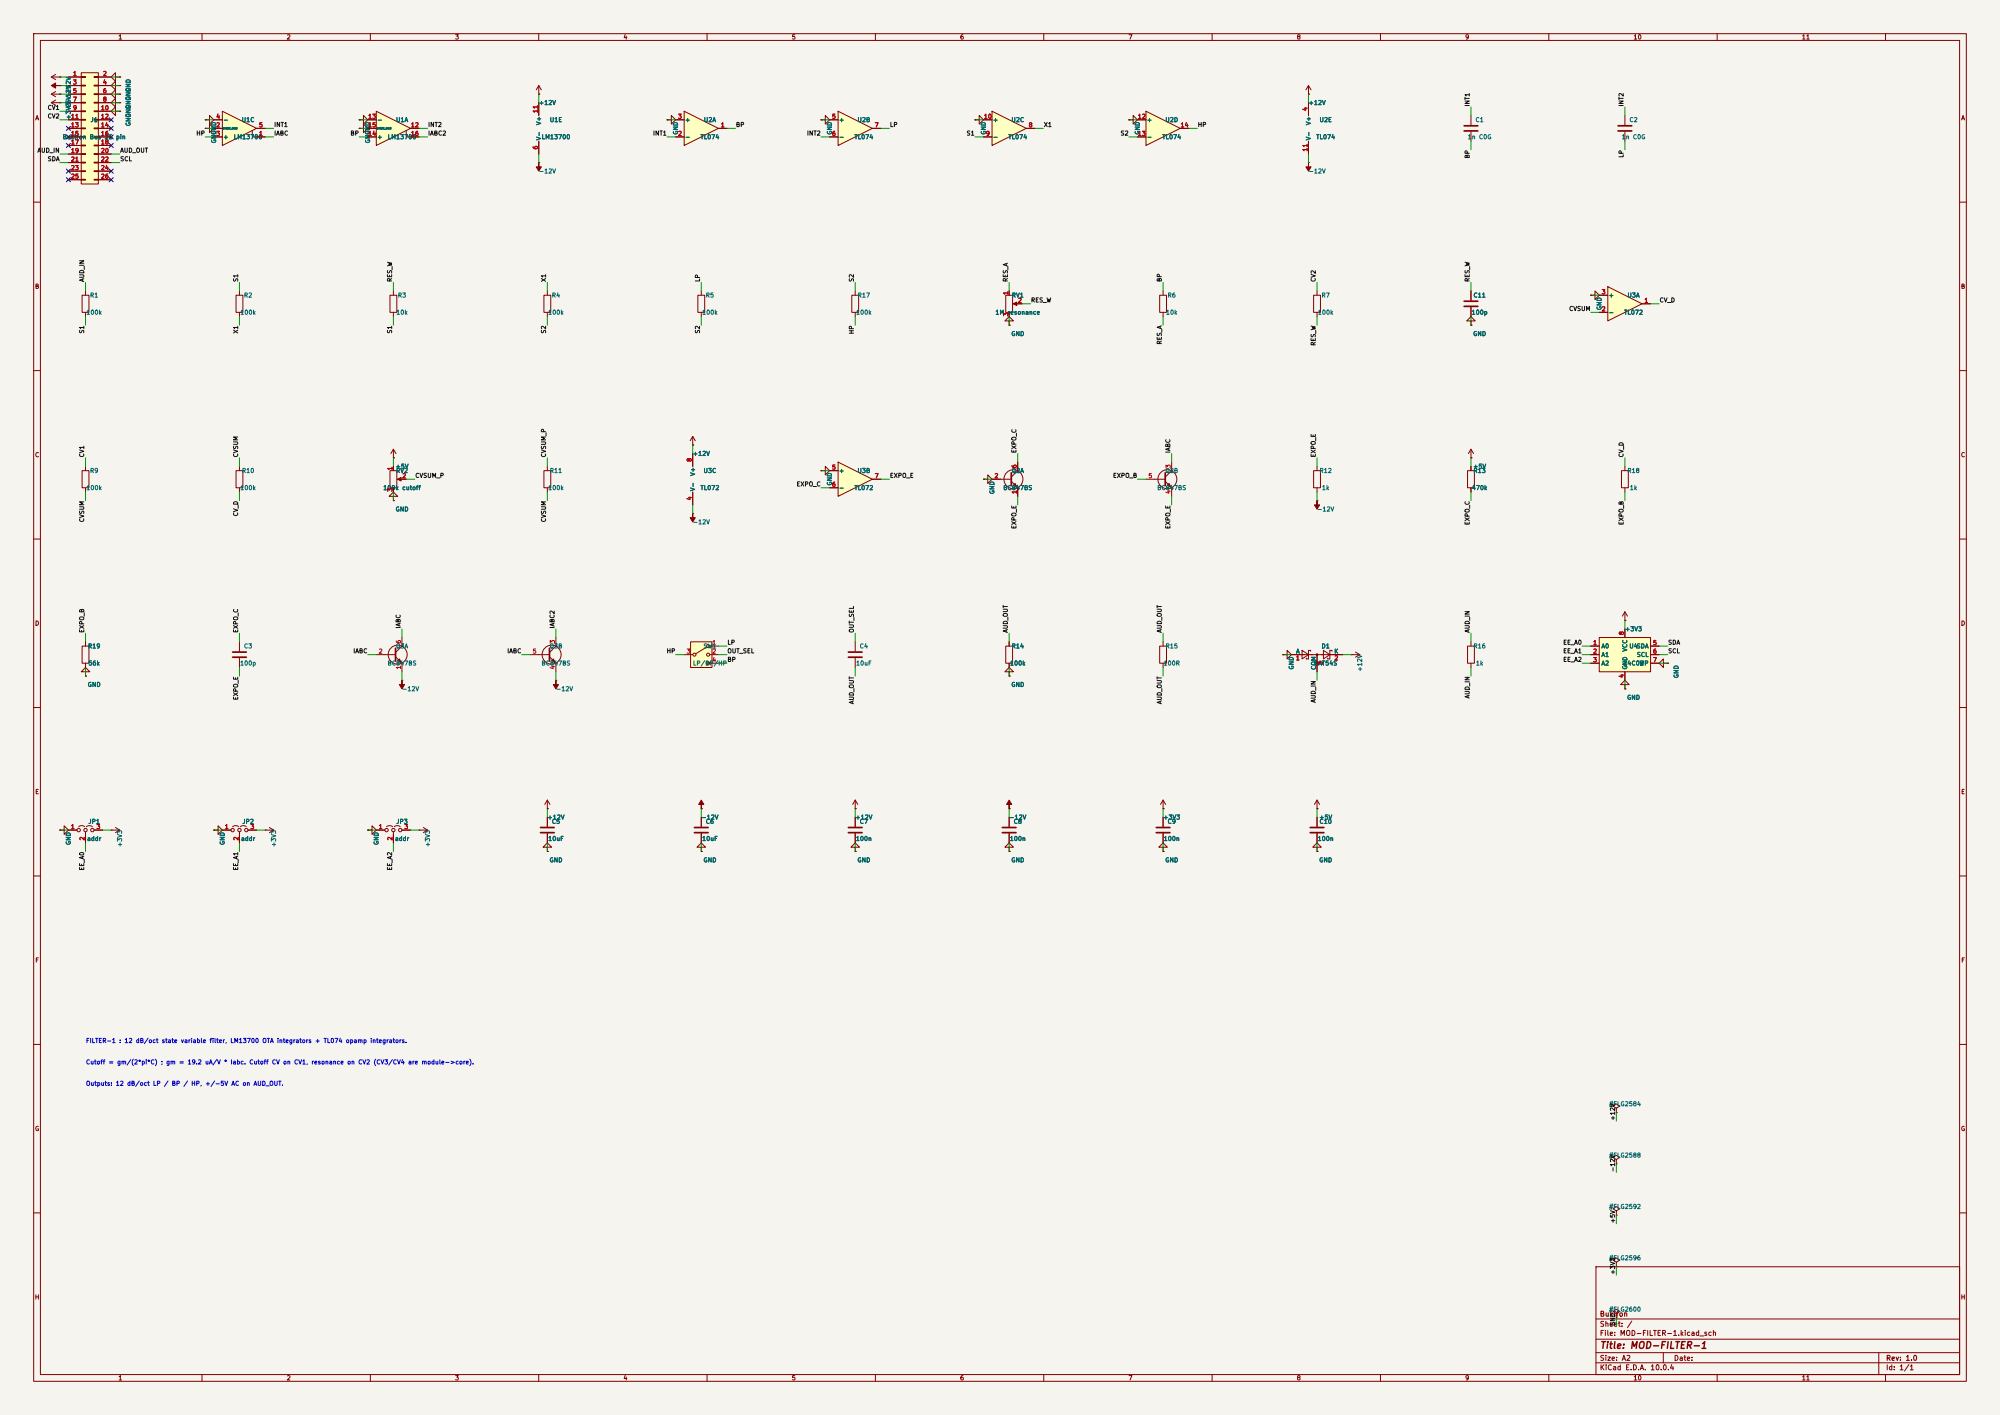
[picture p159: page 1]

IABC Outputs: 12 dB/oct LP / BP / HP, +/-5V AC on AUD_OUT. FILTER-1 : 12 dB/oct state variable filter, LM13700 OTA integrators + TL074 opamp integrators. Cutoff = gm/(2*pi*C) ; gm = 19.2 uA/V * Iabc. Cutoff CV on CV1, resonance on CV2 (CV3/CV4 are module->core).

Size: A2 | Rev: 1.0
KiCad E.D.A. 10.0.4 | Id: 1/1
