martiyanov/bukifon/hardware/modules/pdf/MOD-LADDER-1.pdf

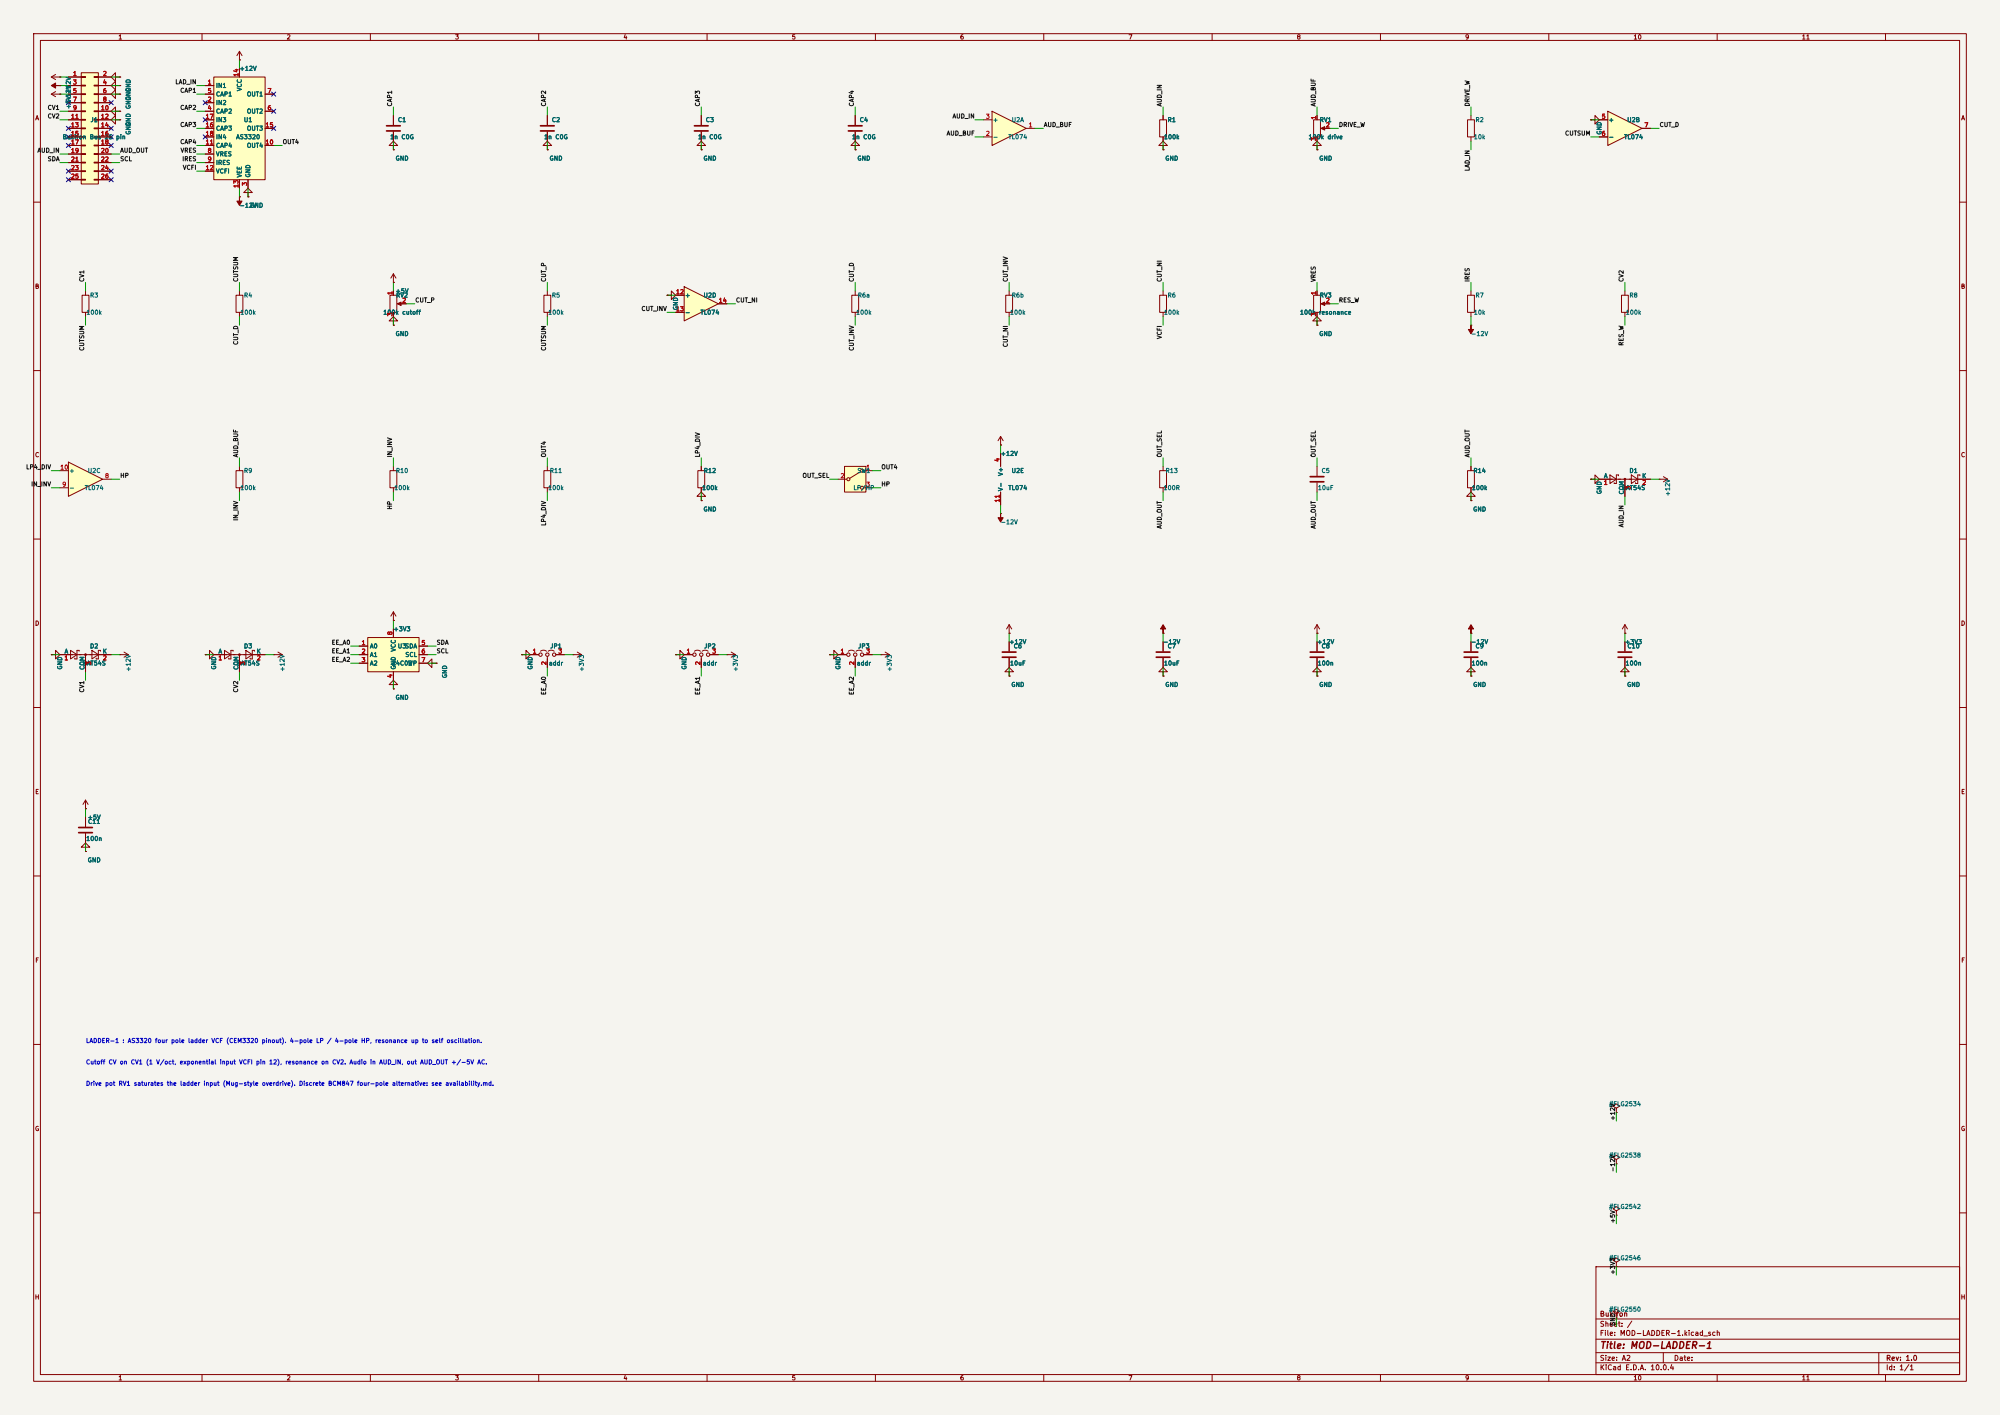
[picture p160: page 1]

Size: A2 | Rev: 1.0
KiCad E.D.A. 10.0.4 | Id: 1/1
