martiyanov/bukifon/hardware/modules/pdf/MOD-PROTO-1.pdf

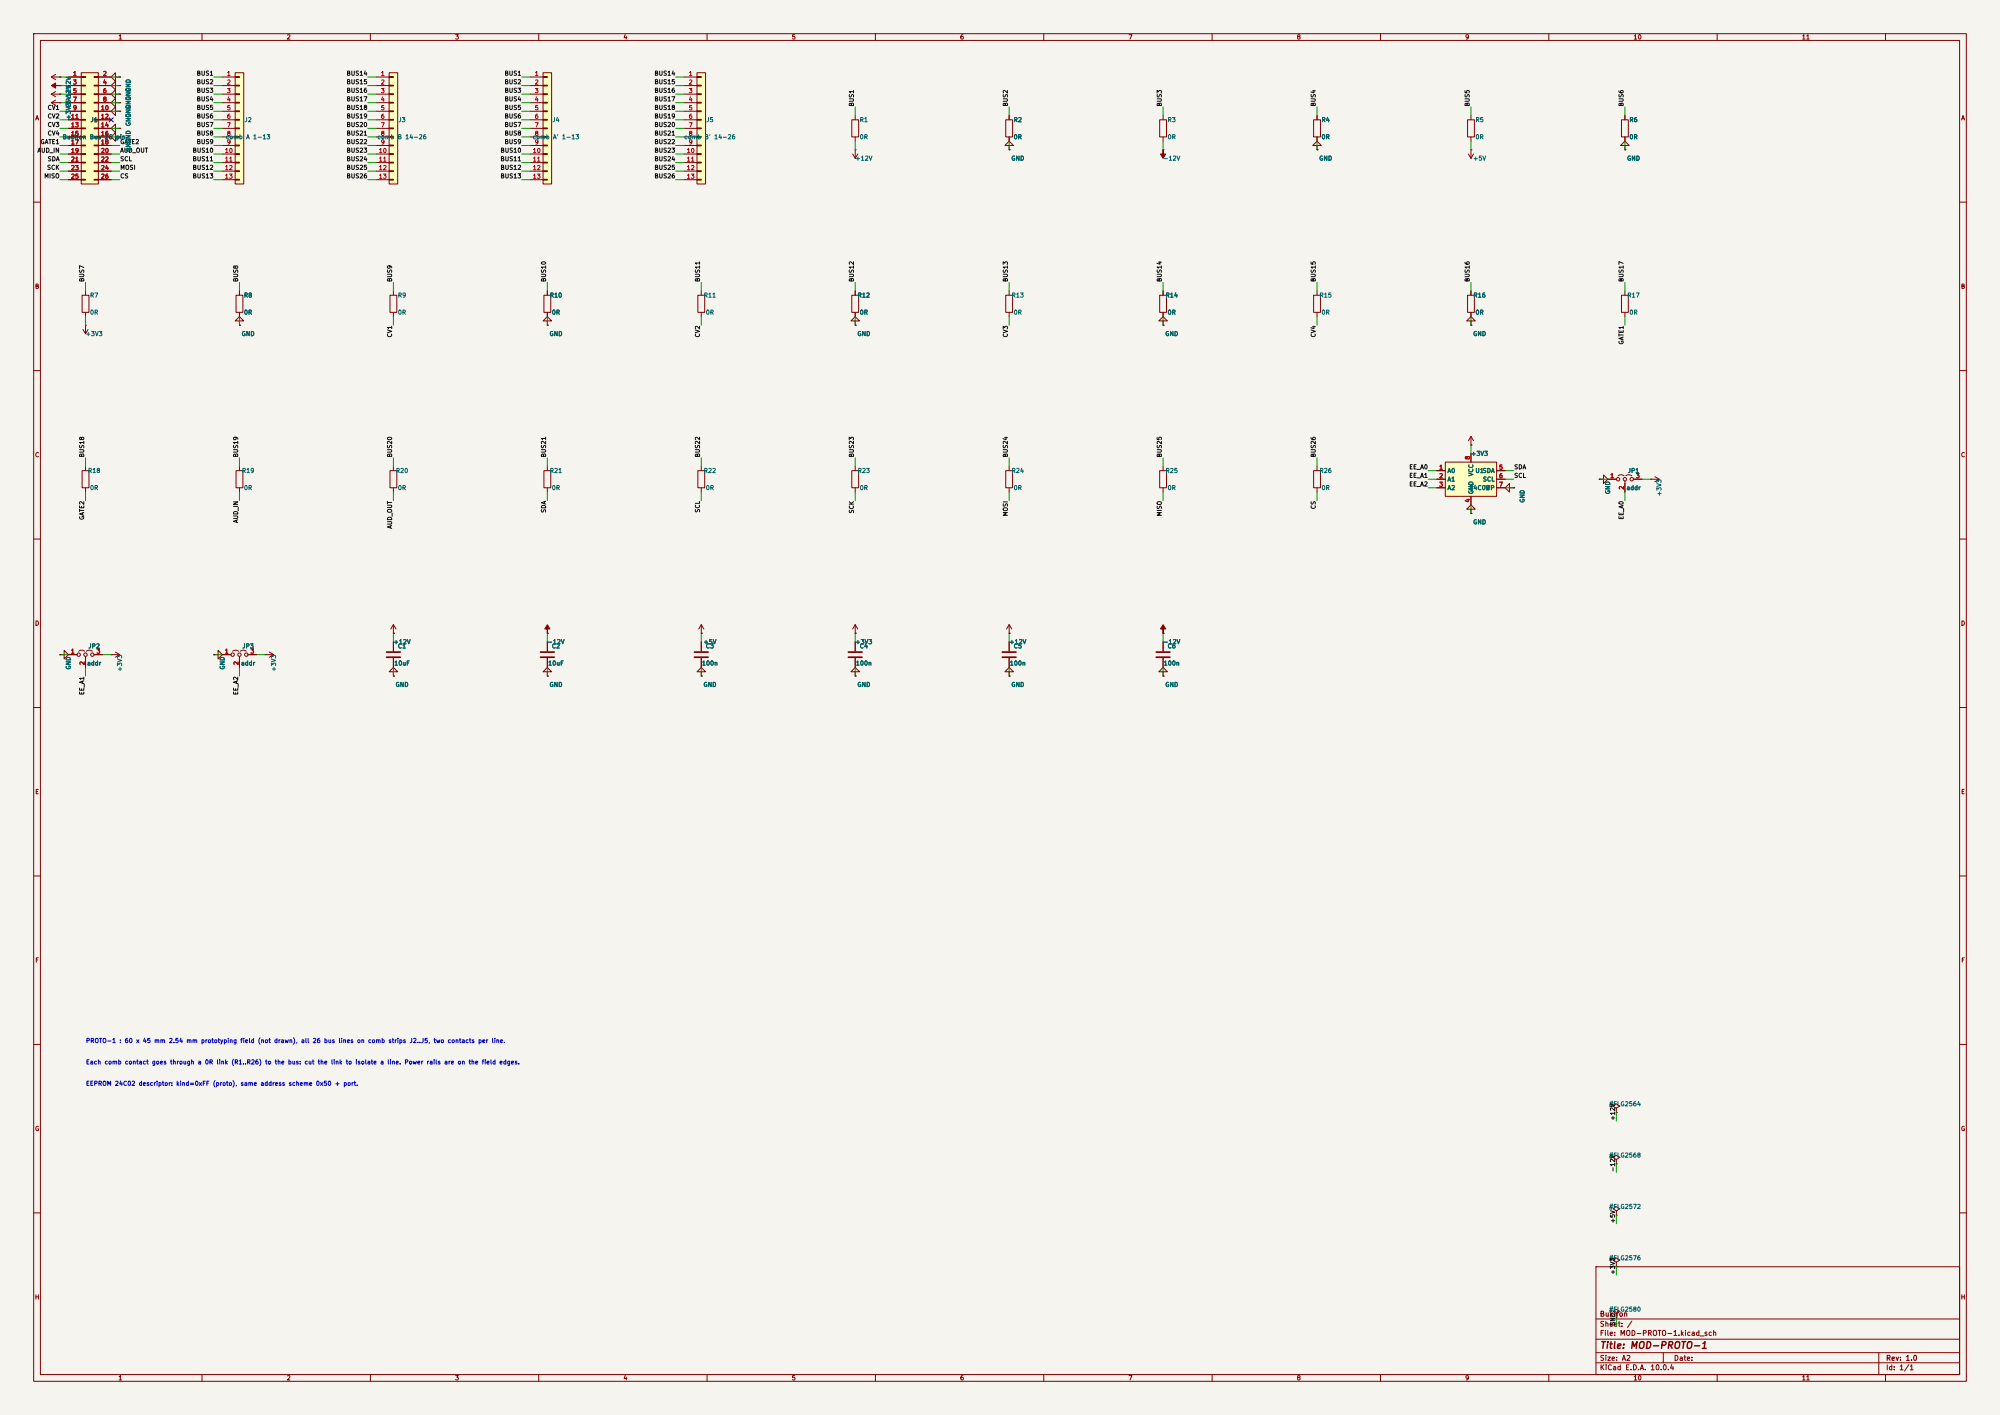
[picture p161: page 1]

EEPROM 24C02 descriptor: kind=0xFF (proto), same address scheme 0x50 + port. Each comb contact goes through a 0R link (R1..R26) to the bus: cut the link to isolate a line. Power rails are on the field edges. PROTO-1 : 60 x 45 mm 2.54 mm prototyping field (not drawn), all 26 bus lines on comb strips J2..J5, two contacts per line. GND GND
GND -12V
J1 Bukifon Bus 26 pin GND

Size: A2 | Rev: 1.0
KiCad E.D.A. 10.0.4 | Id: 1/1
