martiyanov/bukifon/hardware/modules/pdf/MOD-VCO-1.pdf

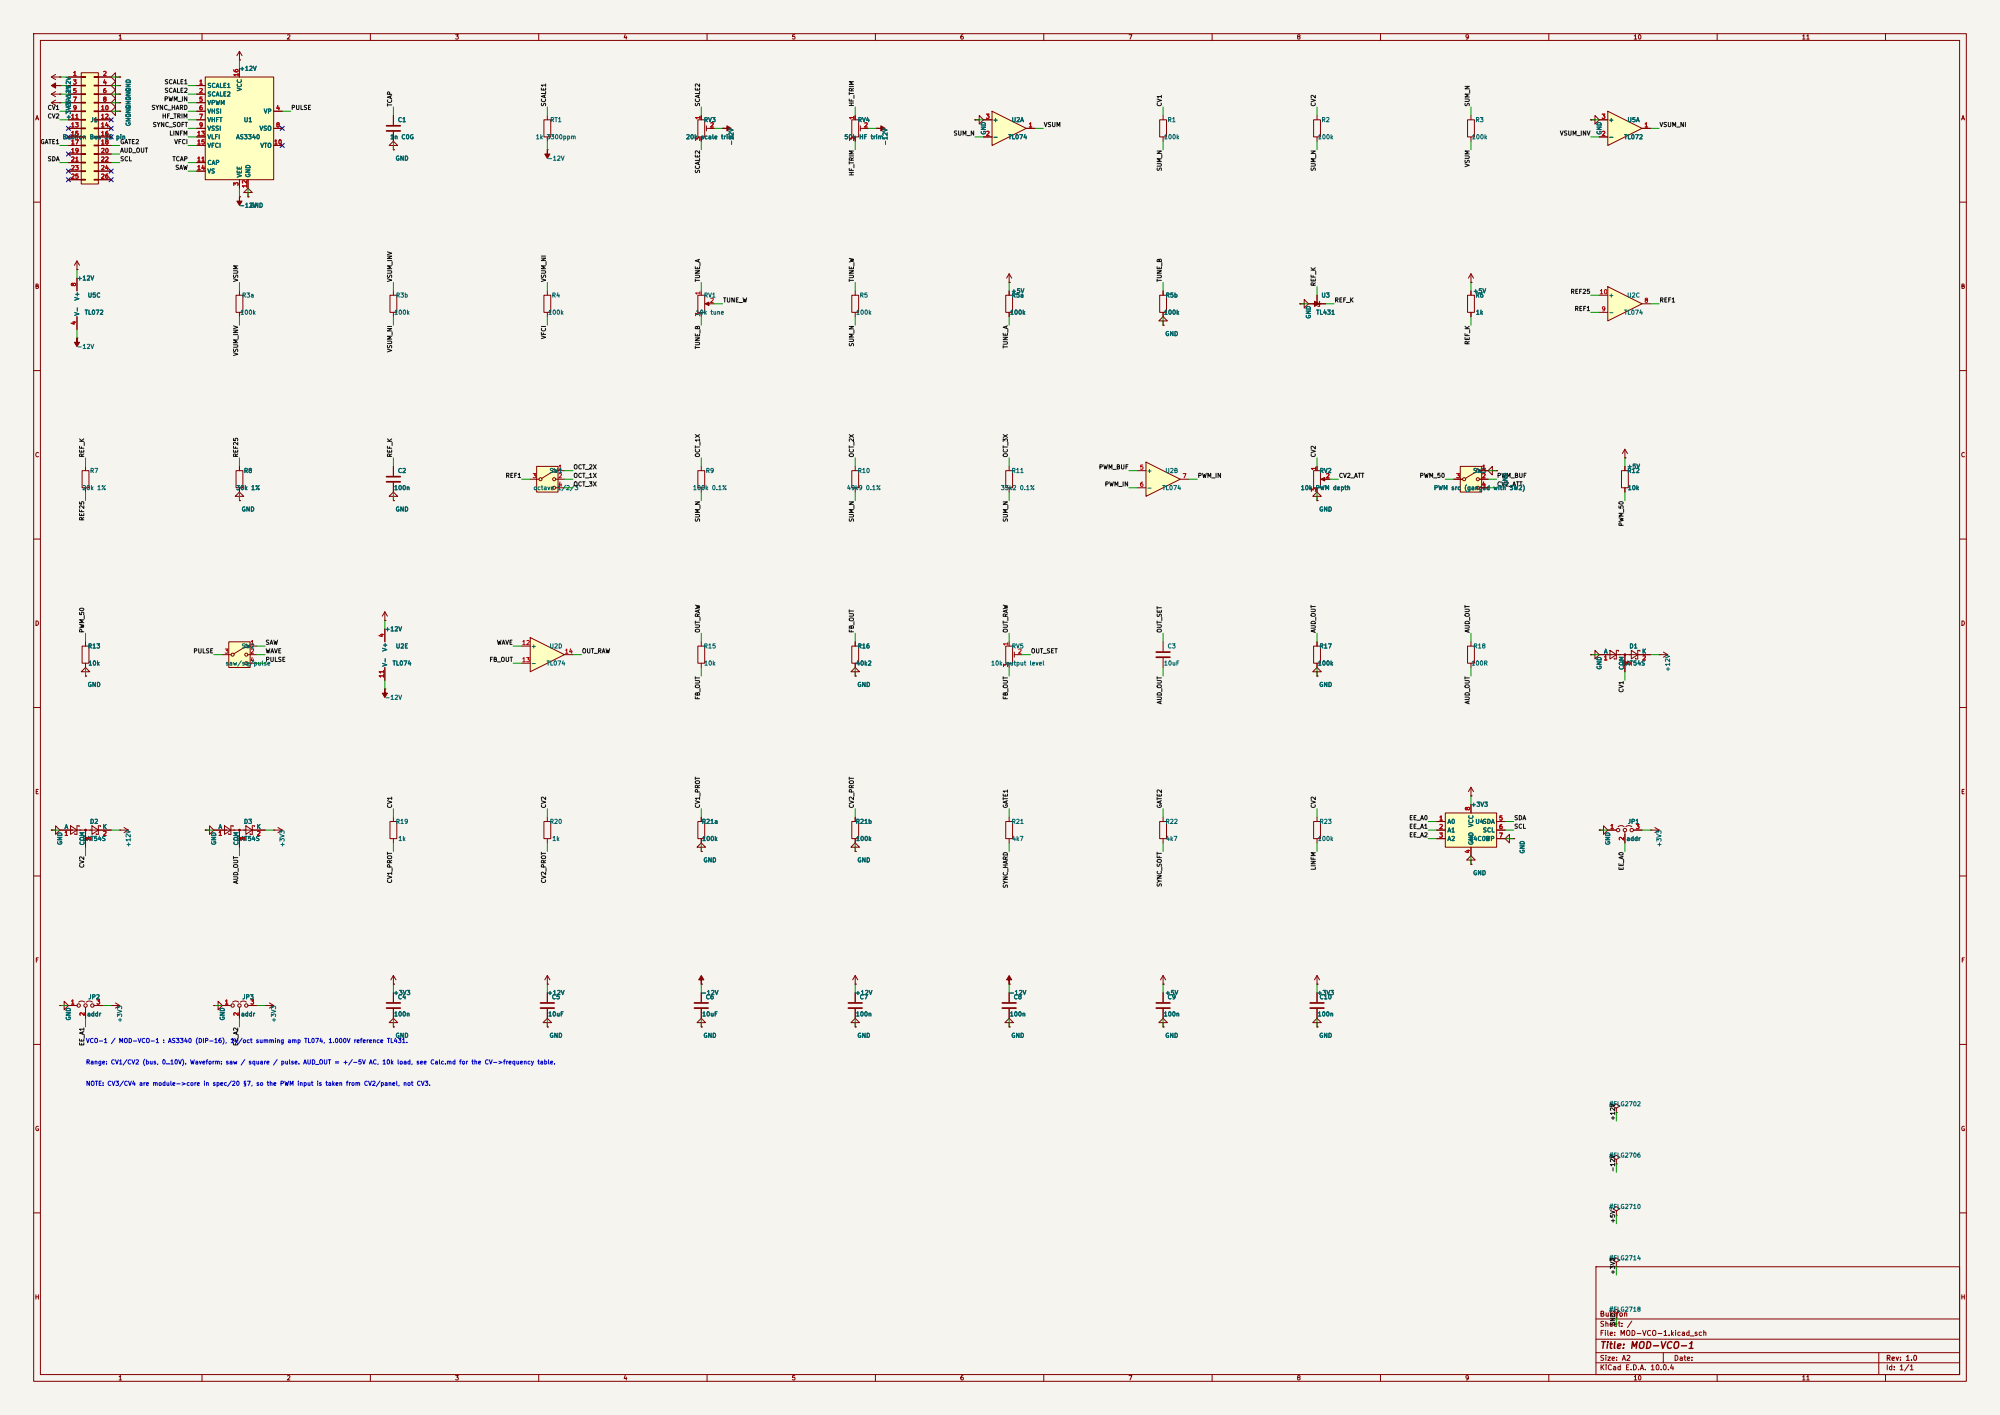
[picture p162: page 1]

SW3 PWM src (ganged with SW2) +5V R6

1k +5V SW3 PWM src (ganged with SW2) 1

10k PWM depth GND GND

NOTE: CV3/CV4 are module->core in spec/20 §7, so the PWM input is taken from CV2/panel, not CV3. Range: CV1/CV2 (bus, 0..10V). Waveform: saw / square / pulse. AUD_OUT = +/-5V AC, 10k load, see Calc.md for the CV->frequency table. VCO-1 / MOD-VCO-1 : AS3340 (DIP-16), 1V/oct summing amp TL074, 1.000V reference TL431.

Size: A2 | Rev: 1.0
KiCad E.D.A. 10.0.4 | Id: 1/1
