martiyanov/bukifon/hardware/panel/panel-1/panel-1.pdf

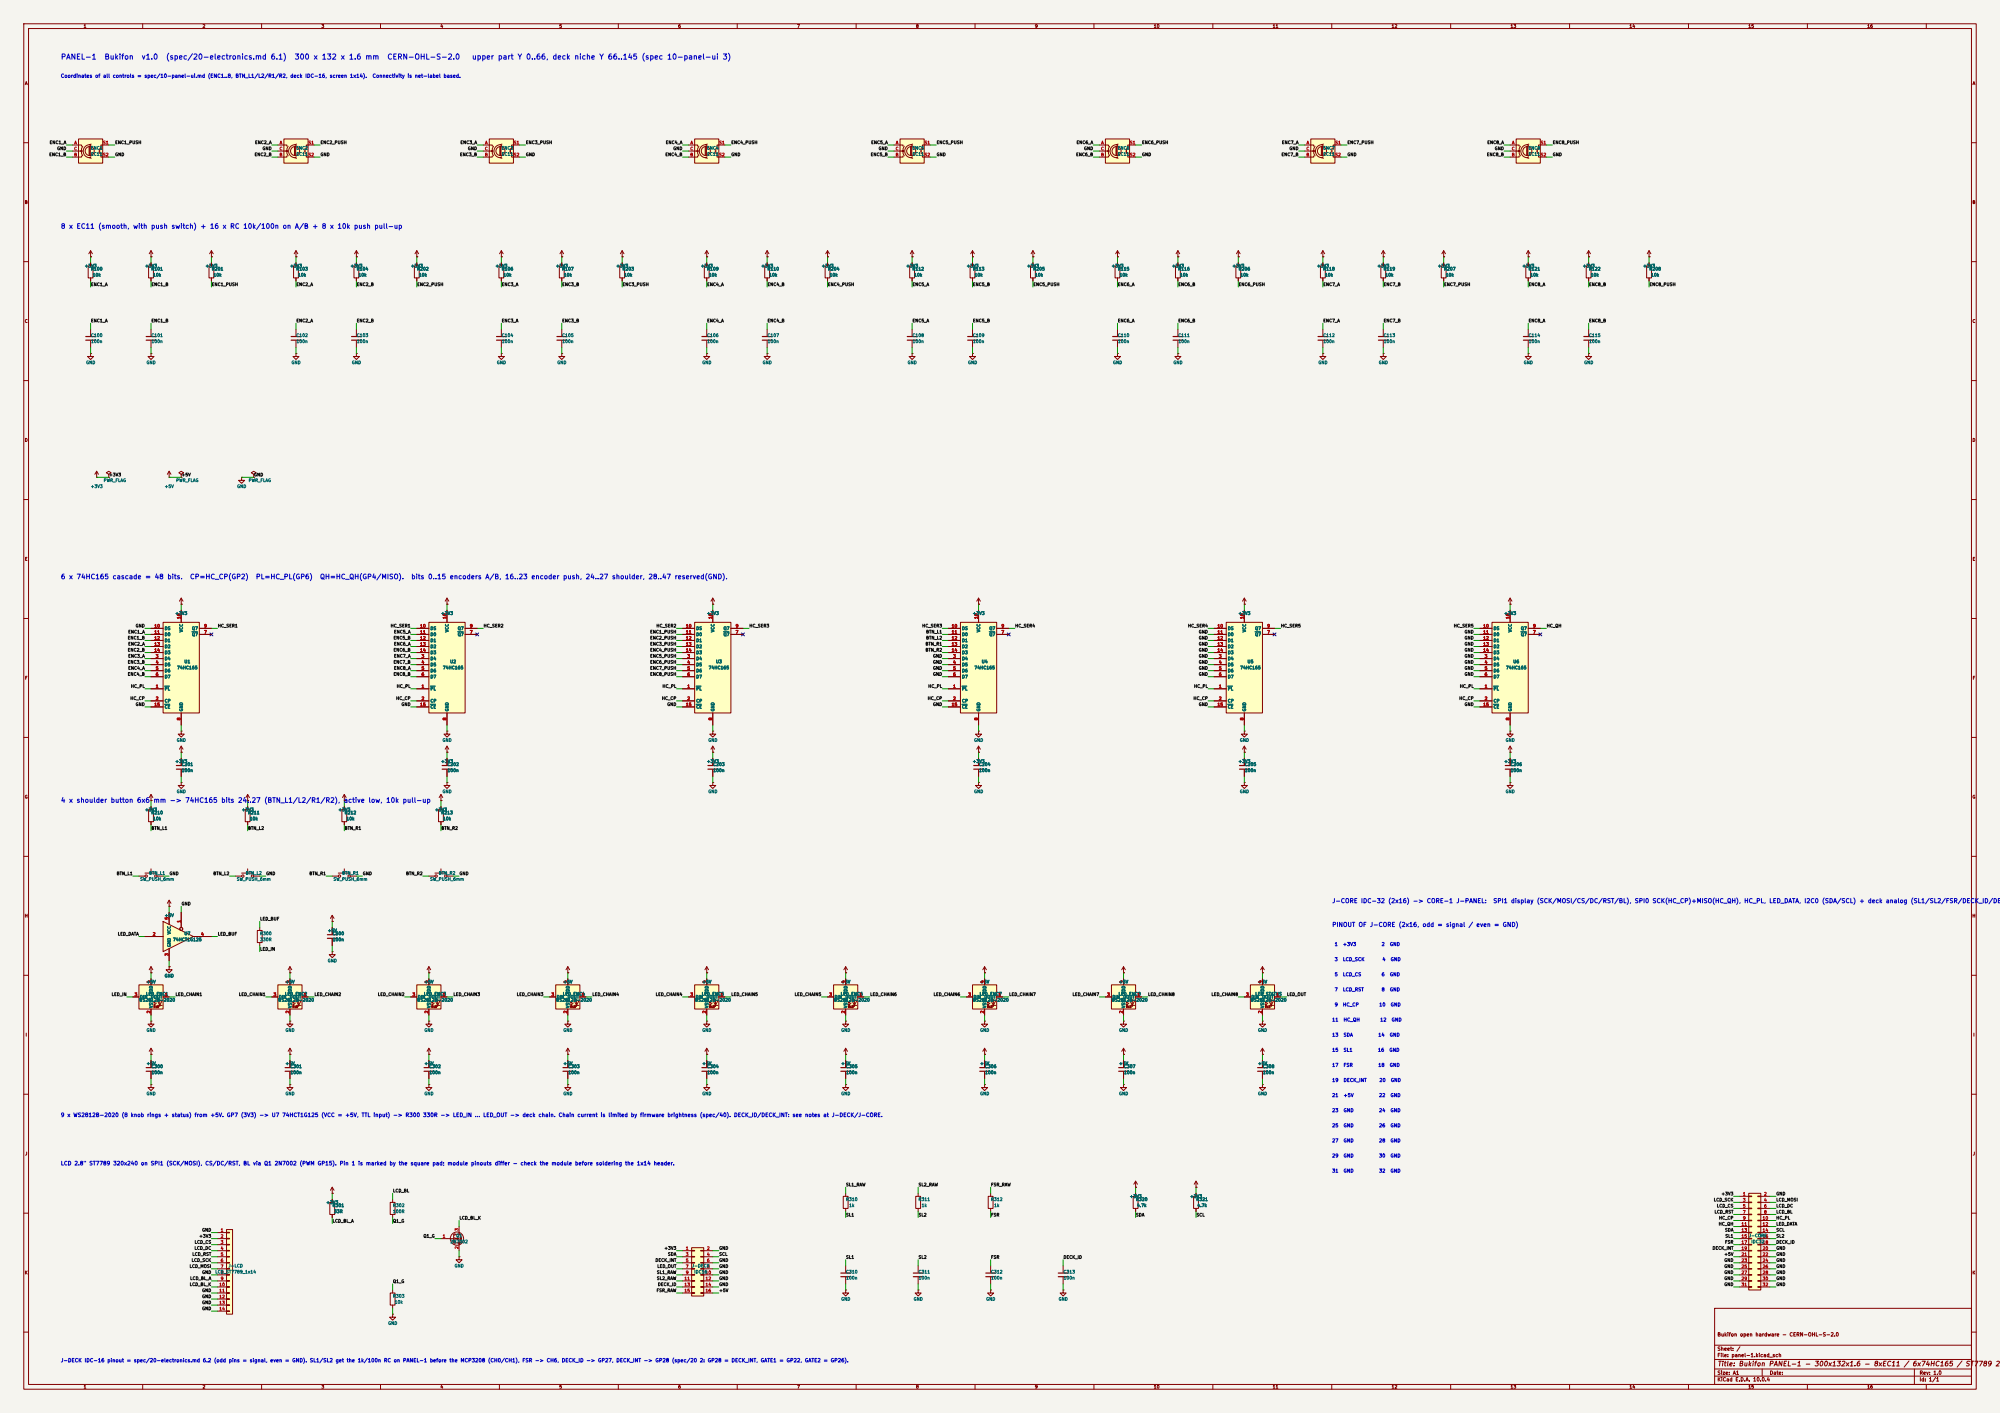
[picture p165: page 1]

Coordinates of all controls = spec/10-panel-ui.md (ENC1..8, BTN_L1/L2/R1/R2, deck IDC-16, screen 1x14). Connectivity is net-label based.

8 x EC11 (smooth, with push switch) + 16 x RC 10k/100n on A/B + 8 x 10k push pull-up

6 x 74HC165 cascade = 48 bits. CP=HC_CP(GP2) PL=HC_PL(GP6) QH=HC_QH(GP4/MISO). bits 0..15 encoders A/B, 16..23 encoder push, 24..27 shoulder, 28..47 reserved(GND).

Bukifon open hardware - CERN-OHL-S-2.0

J-DECK IDC-16 pinout = spec/20-electronics.md 6.2 (odd pins = signal, even = GND). SL1/SL2 get the 1k/100n RC on PANEL-1 before the MCP3208 (CH0/CH1), FSR -> CH6, DECK_ID -> GP27, DECK_INT -> GP28 (spec/20 2: GP28 = DECK_INT, GATE1 = GP22, GATE2 = GP26).

Size: A1 | Rev: 1.0
KiCad E.D.A. 10.0.4 | Id: 1/1
