martiyanov/bukifon/renders/templates/bukifon_paperkit_1to1.pdf

# Букифон bukifon_v04 · панель 1:1 · левая часть (X 0…190 мм)

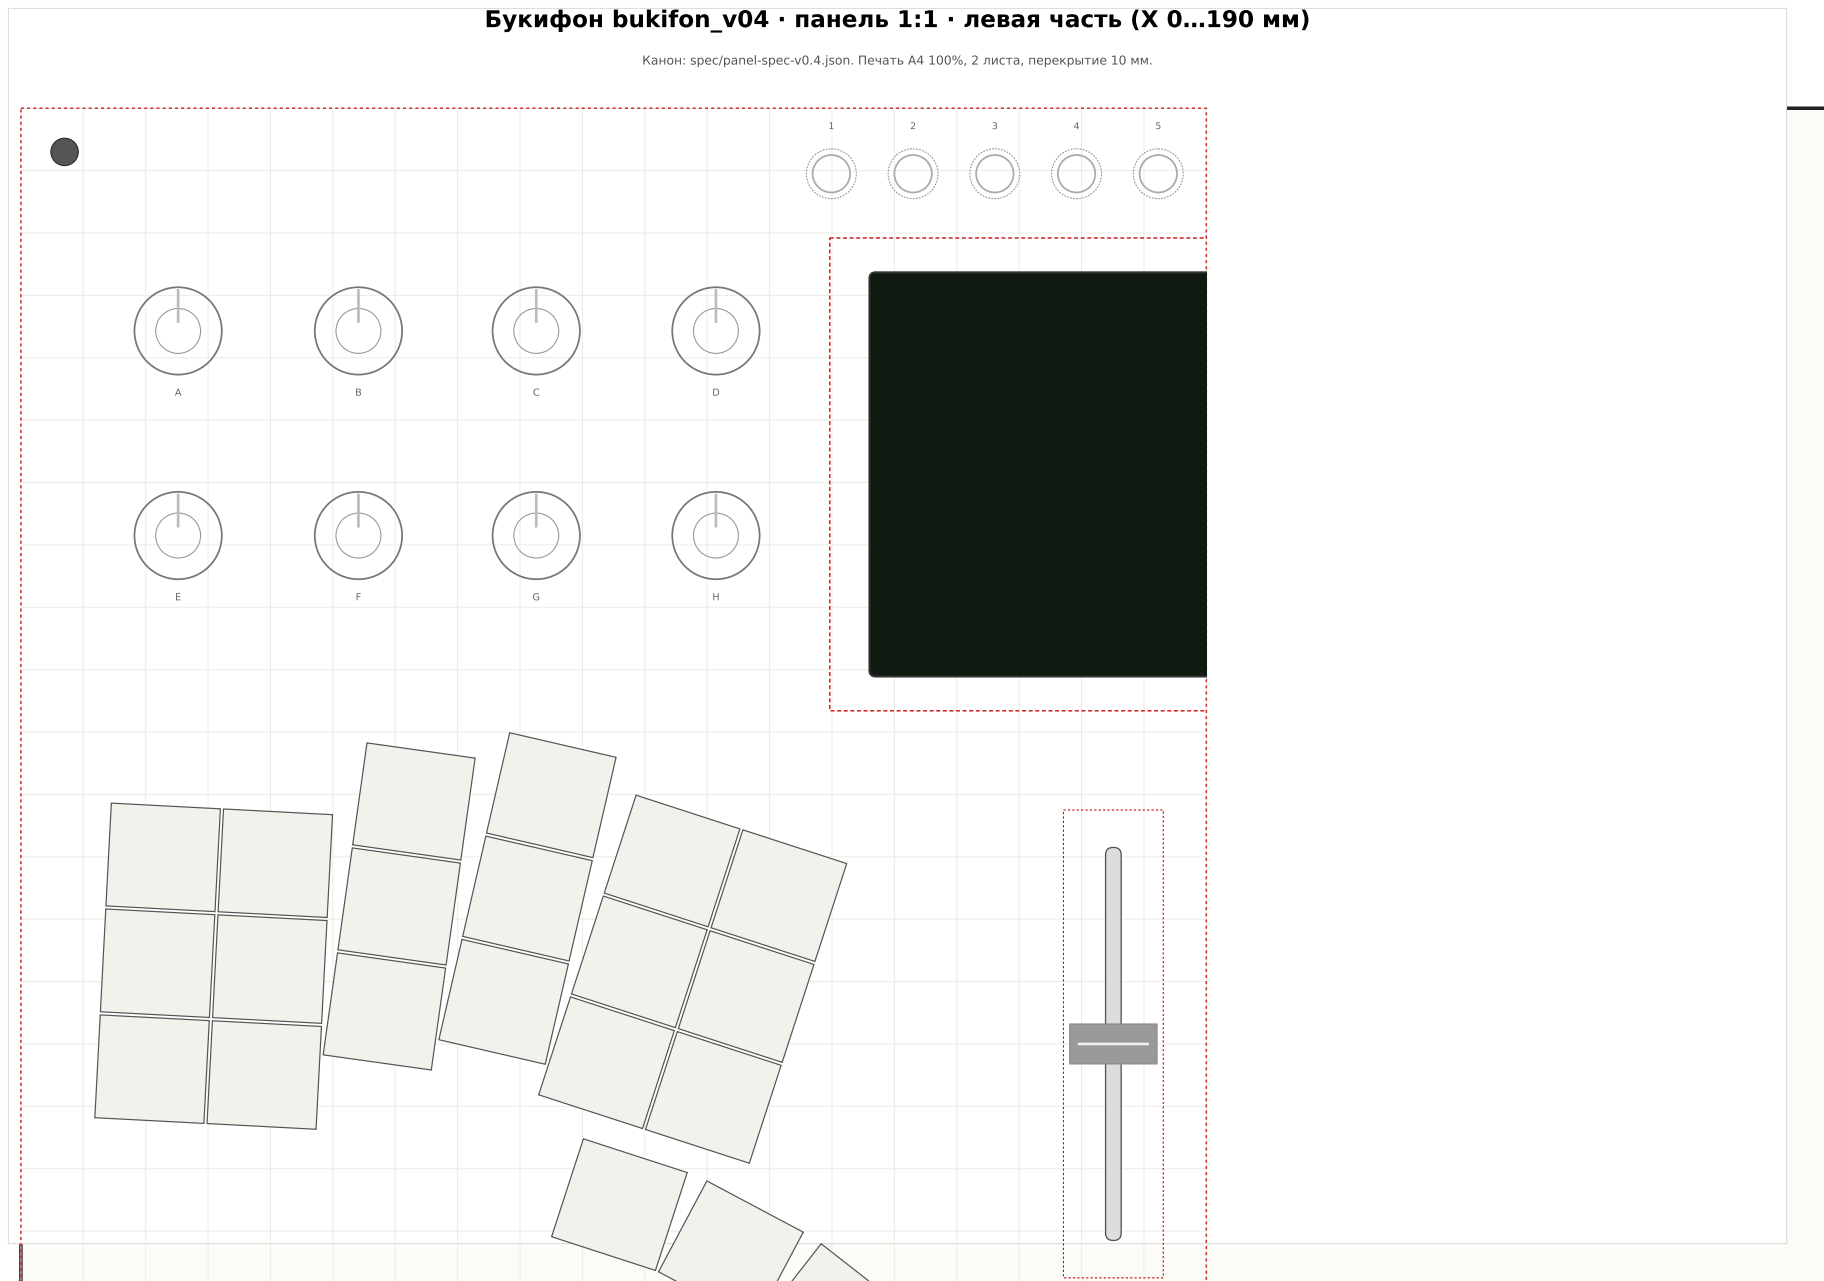
[picture p166: page 1]

Канон: spec/panel-spec-v0.4.json. Печать A4 100%, 2 листа, перекрытие 10 мм.

# Букифон bukifon_v04 · панель 1:1 · правая часть (X 180…380 мм)

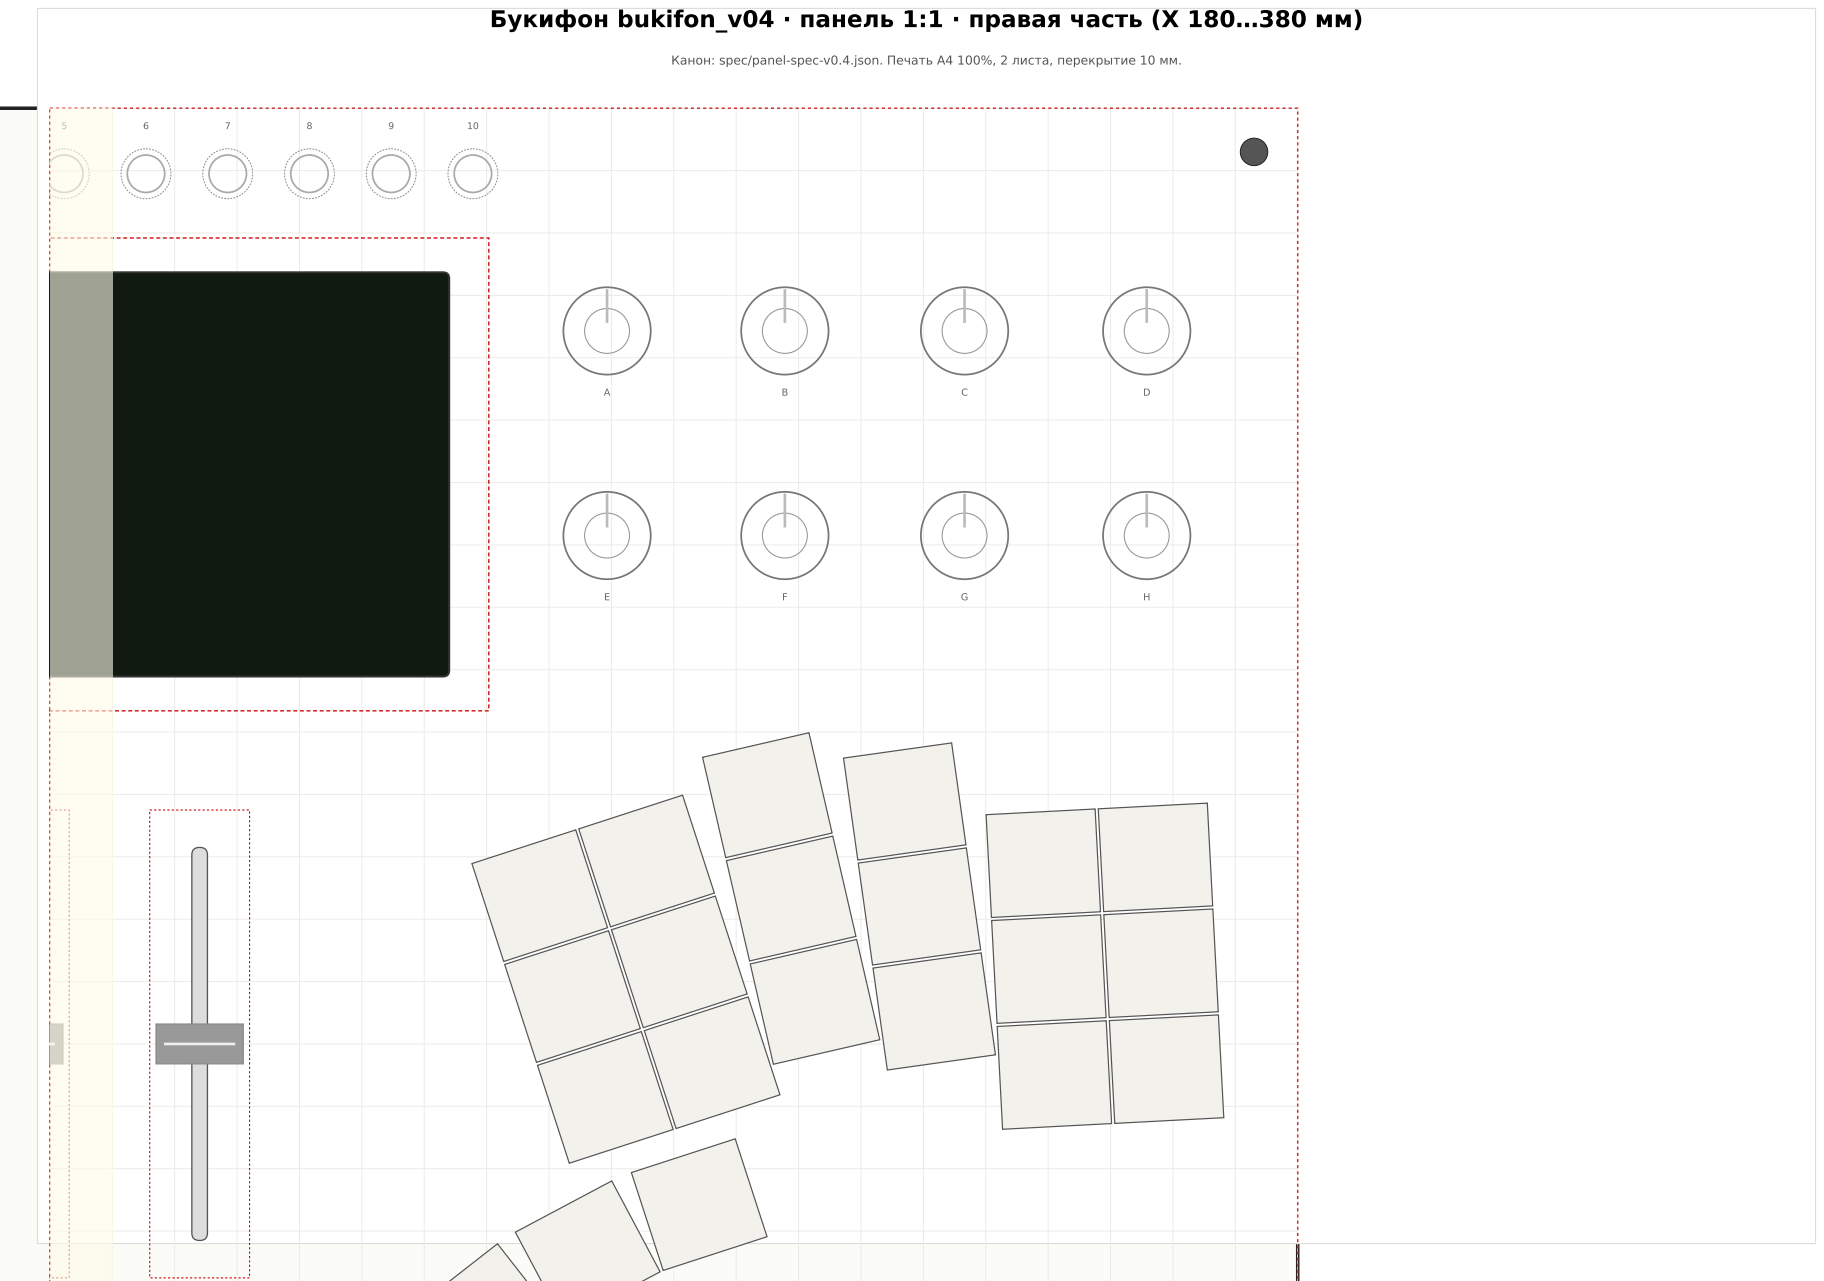
[picture p167: page 2]

Канон: spec/panel-spec-v0.4.json. Печать A4 100%, 2 листа, перекрытие 10 мм.

# БУКИФОН — БУМАЖНЫЙ МАКЕТ v0.5-B (клин 8°) · стр.3/4

Печать A4 100 % (без «по размеру страницы»). Проверка масштаба — линейка 50 мм. Вырезать 2 одинаковых профиля (левый и правый борт).

## 1. ВЫРЕЗАТЬ

- 2 профиля по сплошной
линии (борта L/R).
- Картон 2 мм: низ

380 × 210; передняя

планка 380 × 29;

задняя 380 × 58.5.

## 2. СОБРАТЬ

- Отогнуть лапки по
пунктиру (10 мм).
- Склеить борта с низом
и планками (ПВА /
двусторонний скотч).
- Дать просохнуть 5 мин.

## 3. ПАНЕЛЬ И ПРОВЕРКИ

- Наклеить панель
(листы 1–2) на кромку:
перед 32, зад 61.5 мм.
- Ручки Ø14×15, экран-
картонка на шарнире.
- Пройти 7 проверок (стр.4).

### ВРЕМЯ: 30 МИН · МАТЕРИАЛЫ: КАРТОН 2 ММ, КЛЕЙ, НОЖНИЦЫ, ЛИНЕЙКА

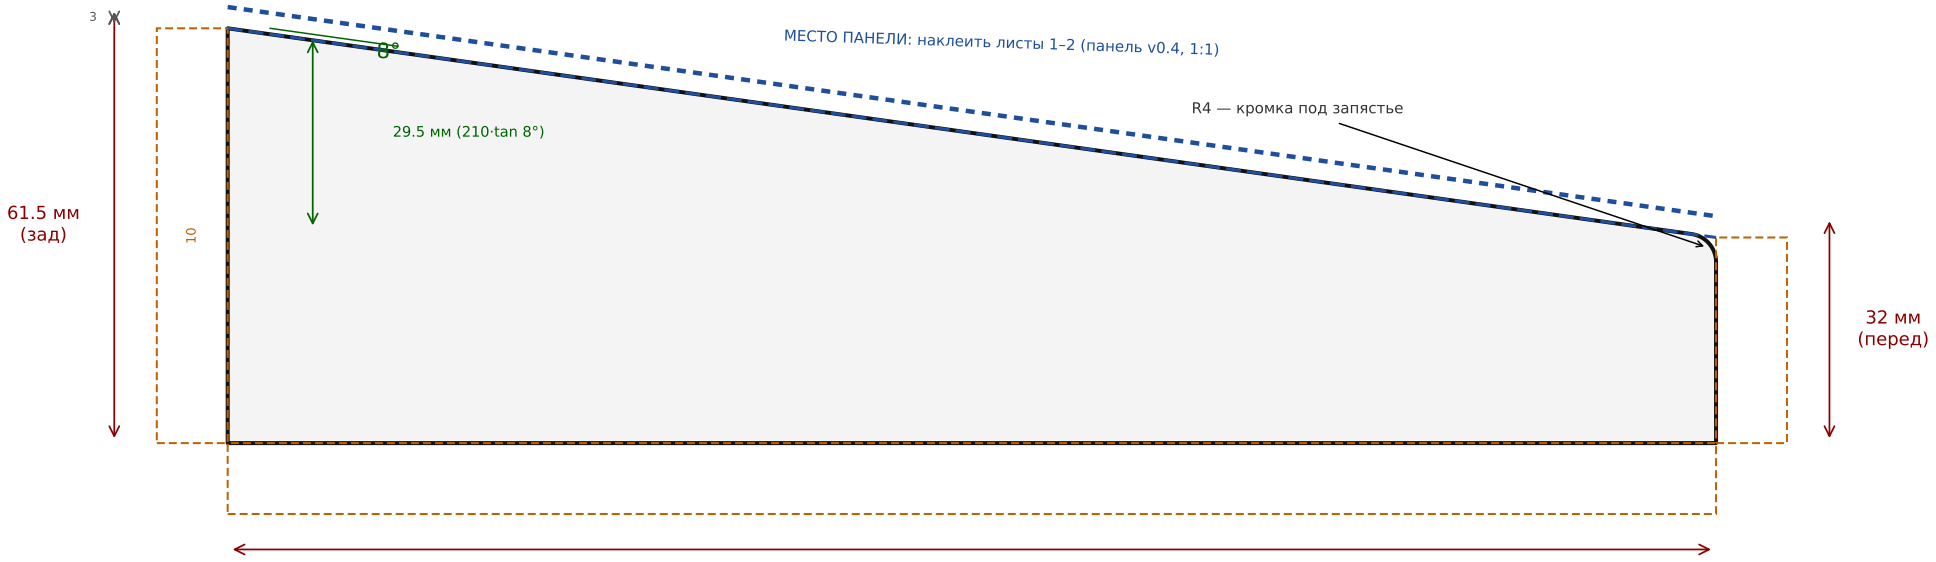
[picture p168: figure]
32 мм (перед); 61.5 мм (зад); 29.5 мм (210·tan 8°); R4 — кромка под запястье

## МЕСТО ПАНЕЛИ: наклеить листы 1–2 (панель v0.4, 1:1)

### лапка склейки 10 мм — отогнуть по пунктиру и приклеить к нижней пластине

## 210 мм — глубина (Y)

верхняя линия = кромка корпуса; панель 3 мм — сверху

## 50 мм — контроль печати 1:1

если линейка не 50 мм — печатать заново, 100 % Профиль — это борт макета. Вырезать ДВА (L и R), зеркалить не нужно. Низ 380×210 склеить из двух A4-листов картона встык (2 мм).

# БУКИФОН — КАРТА ПРОВЕРКИ ЭРГОНОМИКИ · стр.4/4

Ставится на собранный картонный макет. Версия панели: v0.4 (канон, 42 клавиши ±18°). Печать A4 100 %.

## СХЕМА ЗОН ПАНЕЛИ (1:2)

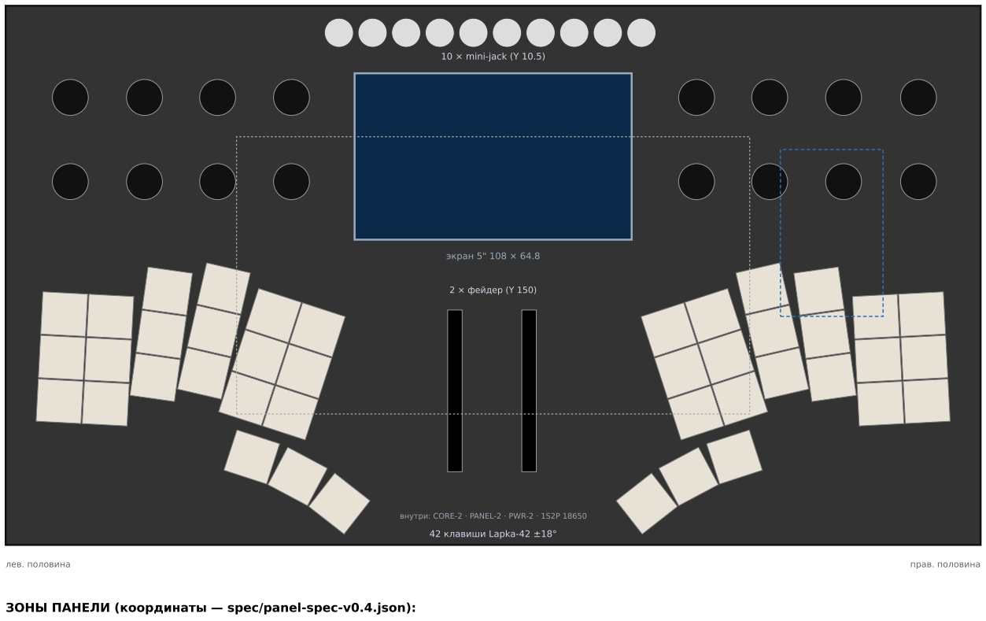
[picture p169: figure]
экран 5" 108 × 64.8; 10 × mini-jack (Y 10.5); 42 клавиши Lapka-42 ±18°; 2 × фейдер (Y 150); лев. половина; прав. половина; ЗОНЫ ПАНЕЛИ (координаты — spec/panel-spec-v0.4.json):

внутри: CORE-2 · PANEL-2 · PWR-2 · 1S2P 18650

- 42 клавиши Choc, колпачок 17.5×16.5, шаг 18×17, половины ±18°
- 16 энкодеров Ø14: X 25.2/54.1/82.6/111.4 и 269.3/297.8/326.6/355.8; Y 35.7/68.5
- экран 5" 800×480: вырез 108 × 64.8, центр (190; 58.7), без рамки
- 10 mini-jack 3.5 мм: X 129.9…247.8 (шаг 13.1), Y 10.5
- 2 фейдера: X 175.1 / 204.0, центр Y 150, прорезь 2.5 × 63
- внутри: CORE-2 200×108 (Z12), PANEL-2 360×190, PWR-2 90×70, 1S2P 18650

## 7 ПРОВЕРОК (docs/21-ergonomics.md)

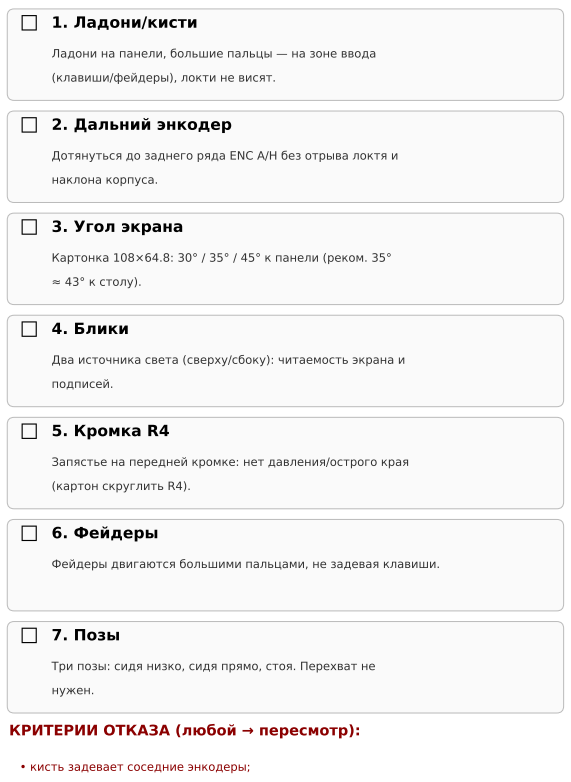
[picture p170: figure]
☐ 1. Ладони/кисти; (клавиши/фейдеры), локти не висят.; ☐ 2. Дальний энкодер; наклона корпуса.; ☐ 3. Угол экрана; ≈ 43° к столу).; ☐ 4. Блики; подписей.; ☐ 5. Кромка R4; (картон скруглить R4).; ☐ 6. Фейдеры; ☐ 7. Позы; нужен.; КРИТЕРИИ ОТКАЗА (любой → пересмотр):; • кисть задевает соседние энкодеры;

Ладони на панели, большие пальцы — на зоне ввода

Дотянуться до заднего ряда ENC A/H без отрыва локтя и

Картонка 108×64.8: 30° / 35° / 45° к панели (реком. 35°

Два источника света (сверху/сбоку): читаемость экрана и

Запястье на передней кромке: нет давления/острого края

Фейдеры двигаются большими пальцами, не задевая клавиши.

Три позы: сидя низко, сидя прямо, стоя. Перехват не

- дальний ряд требует отрыва локтя;
- экран перекрывает разъёмы/ручки;
- запястье на острой кромке;
- фейдеры недоступны большими пальцами.
ФОТО для обратной связи:
1) сверху; 2) сбоку (профиль); 3) три позы; 4) экран при 35°.

Дата / имя: ______________________

Заметки: ______________________________

_______________________________________

Вердикт: ☐ ок ☐ доработать: ______________
