martiyanov/bukifon/renders/templates/bukifon_v04_panel_1to1.pdf

## Букифон bukifon_v04 · панель 1:1 · A3 (420×297 мм) · печать 100%

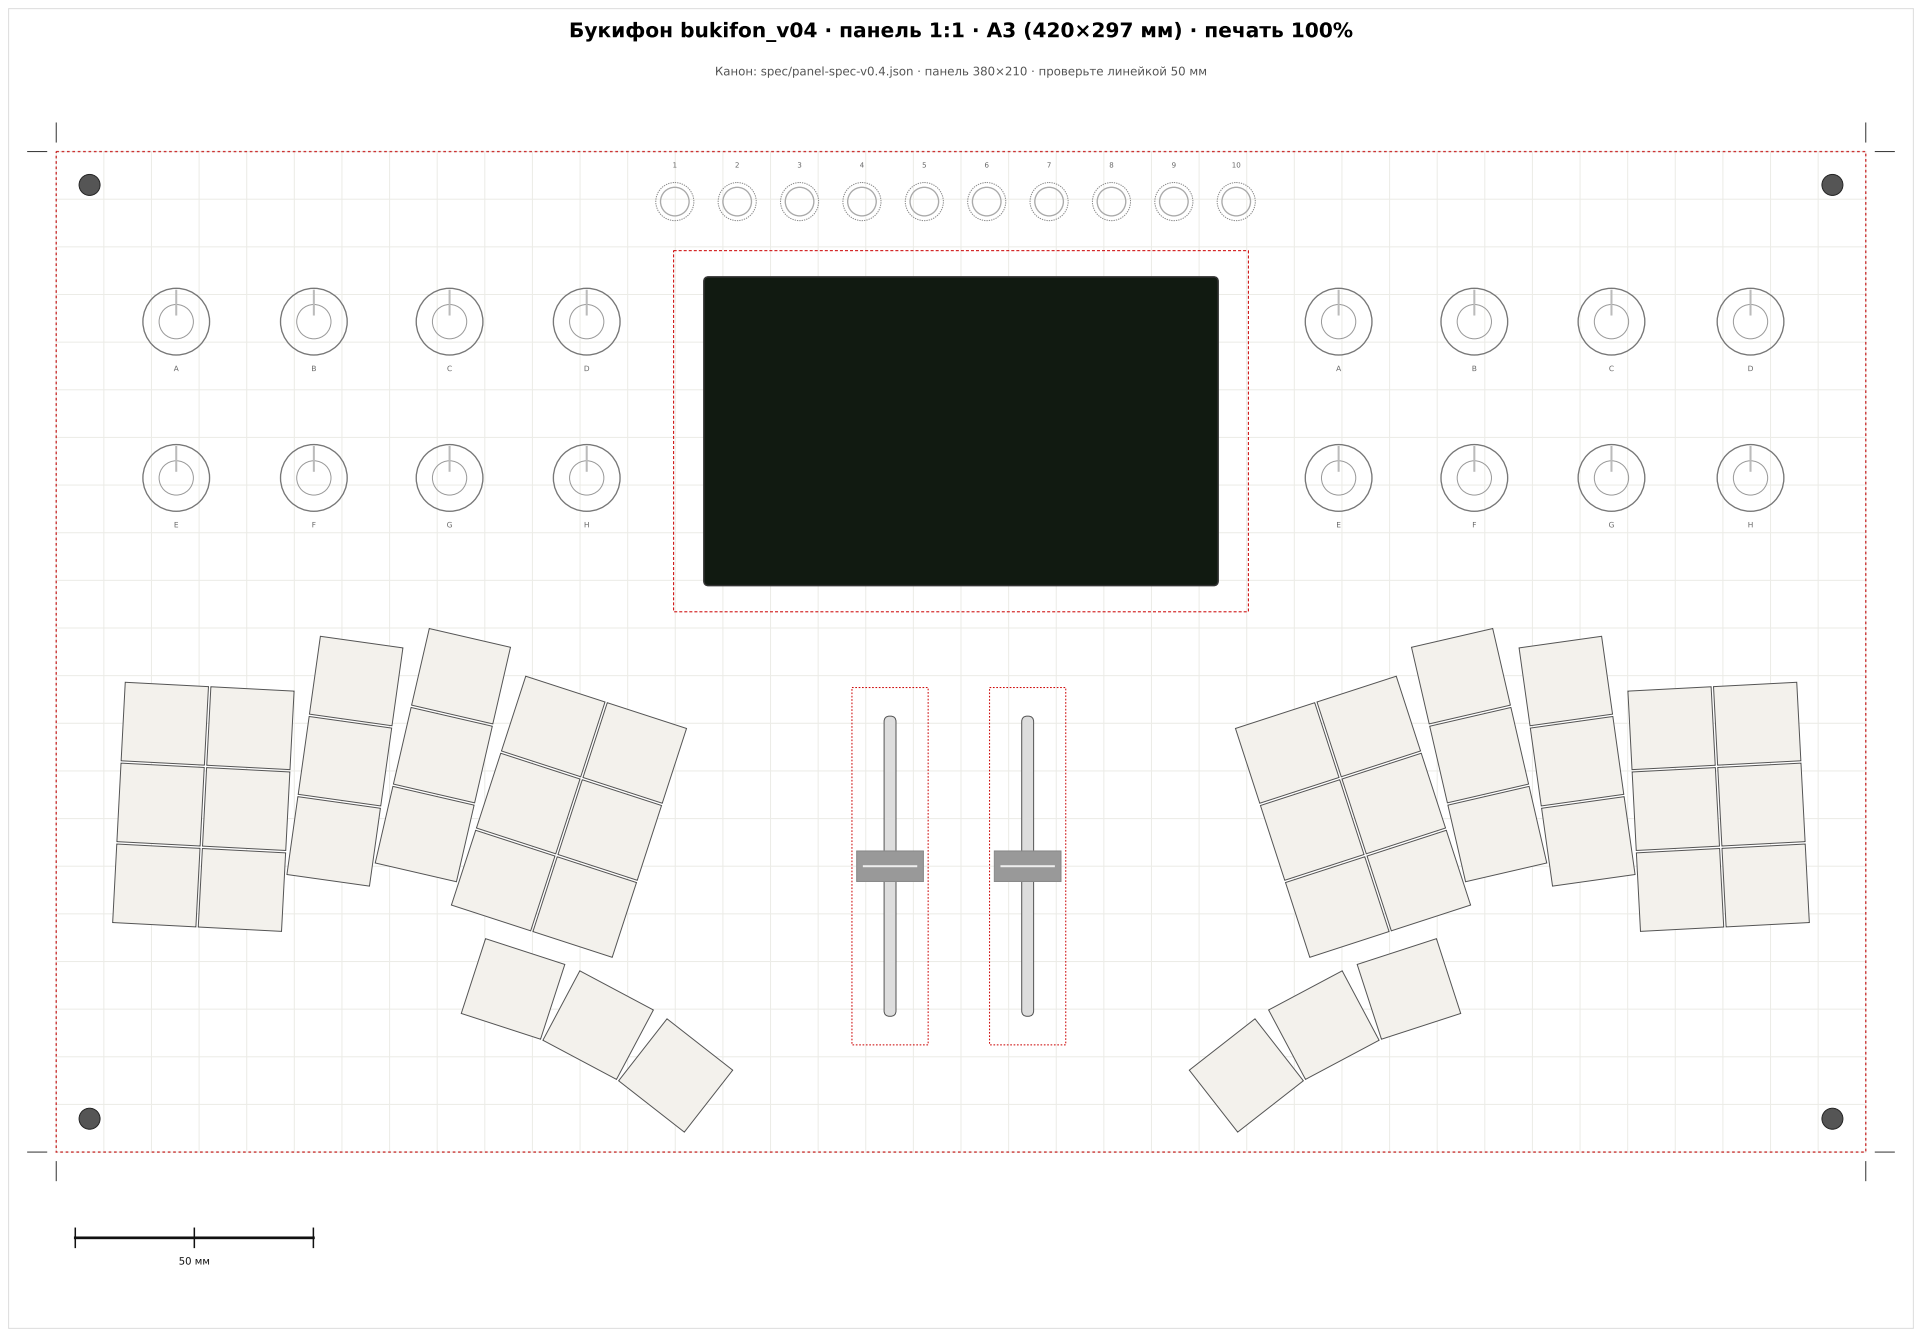
[picture p171: page 1]

Канон: spec/panel-spec-v0.4.json · панель 380×210 · проверьте линейкой 50 мм
