martiyanov/bukifon/renders/templates/bukifon_v04_panel_tiles_A4.pdf

## Букифон bukifon_v04 · панель 1:1 · A4 / лист 1: X 0…195, Y 0…115

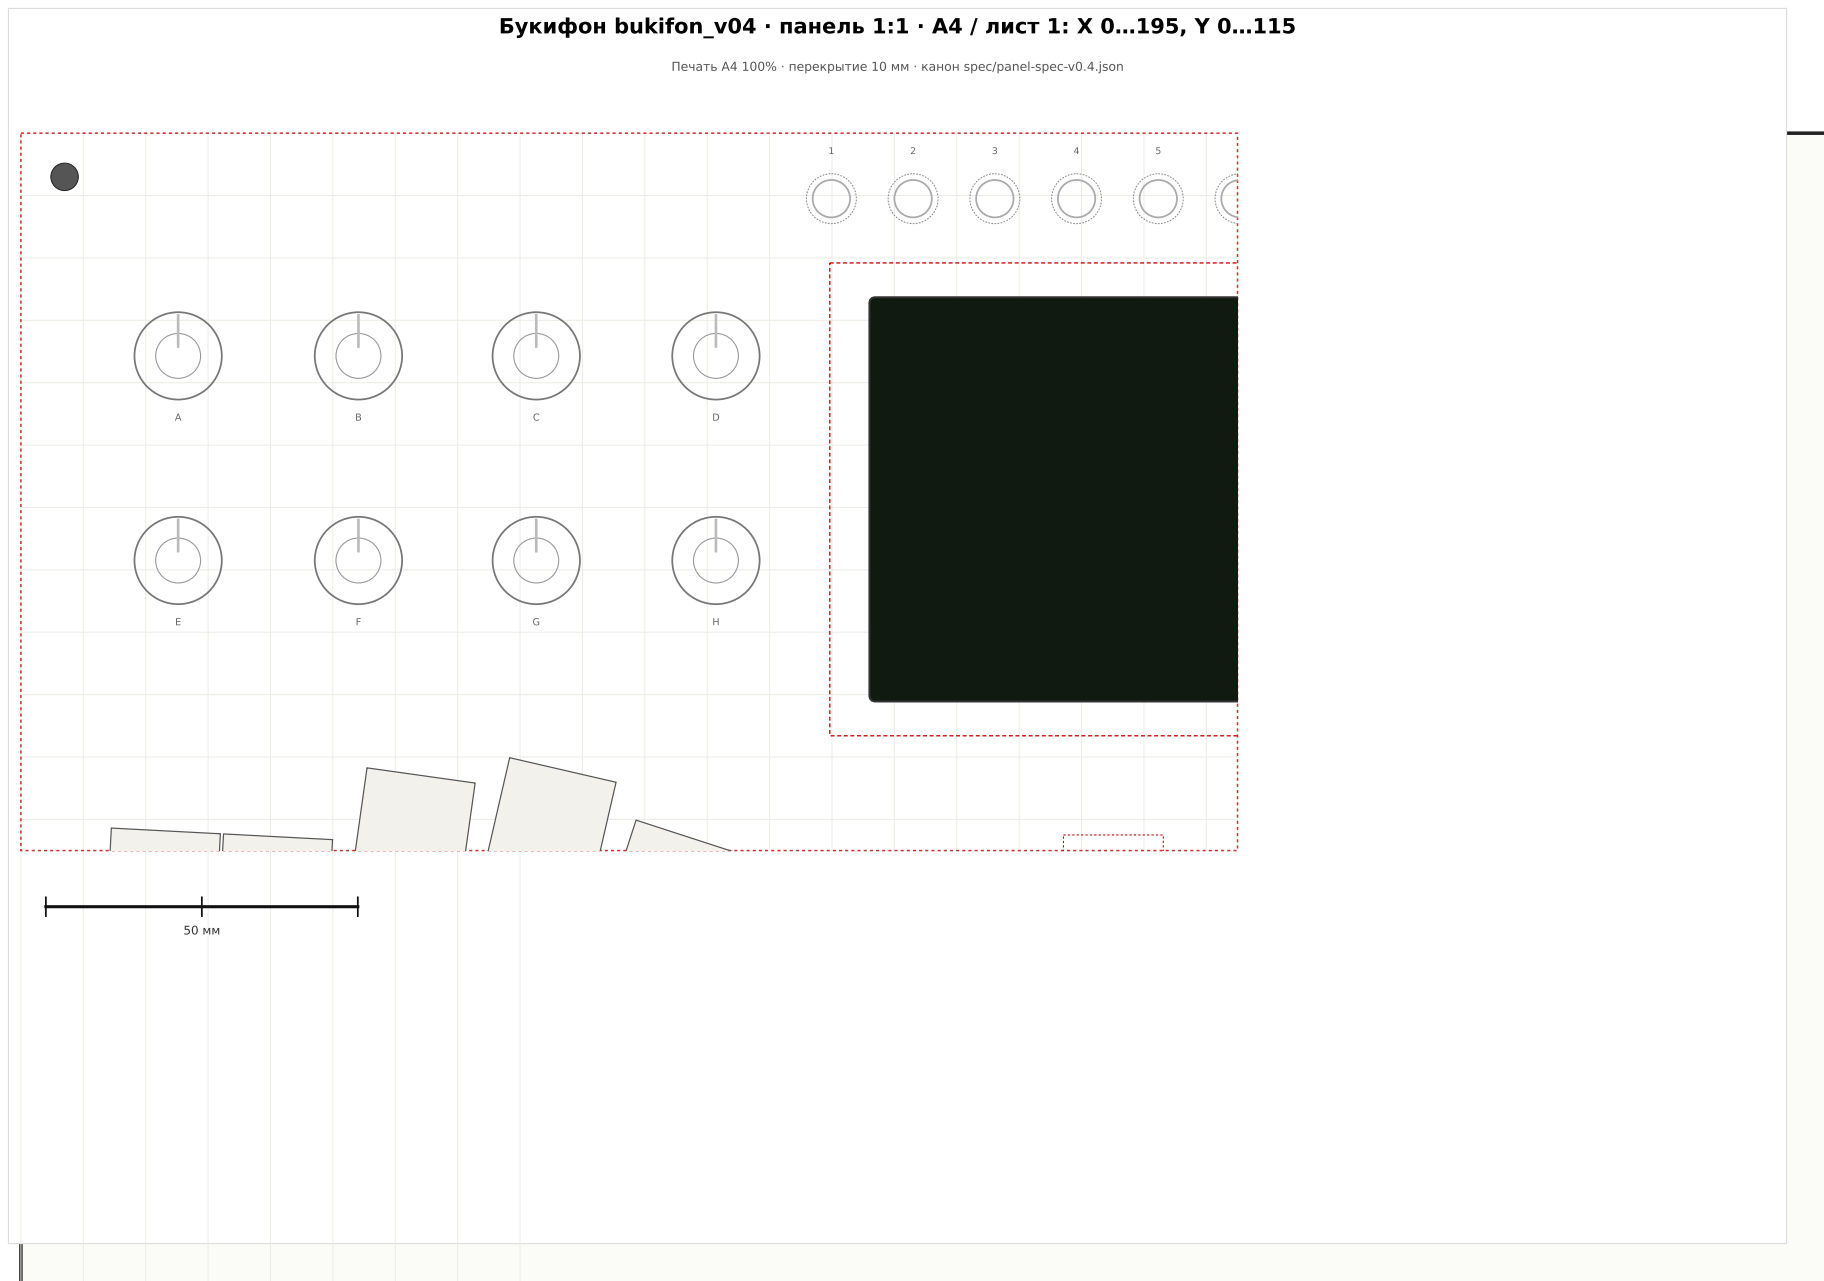
[picture p172: page 1]

Печать A4 100% · перекрытие 10 мм · канон spec/panel-spec-v0.4.json

## Букифон bukifon_v04 · панель 1:1 · A4 / лист 2: X 185…380, Y 0…115

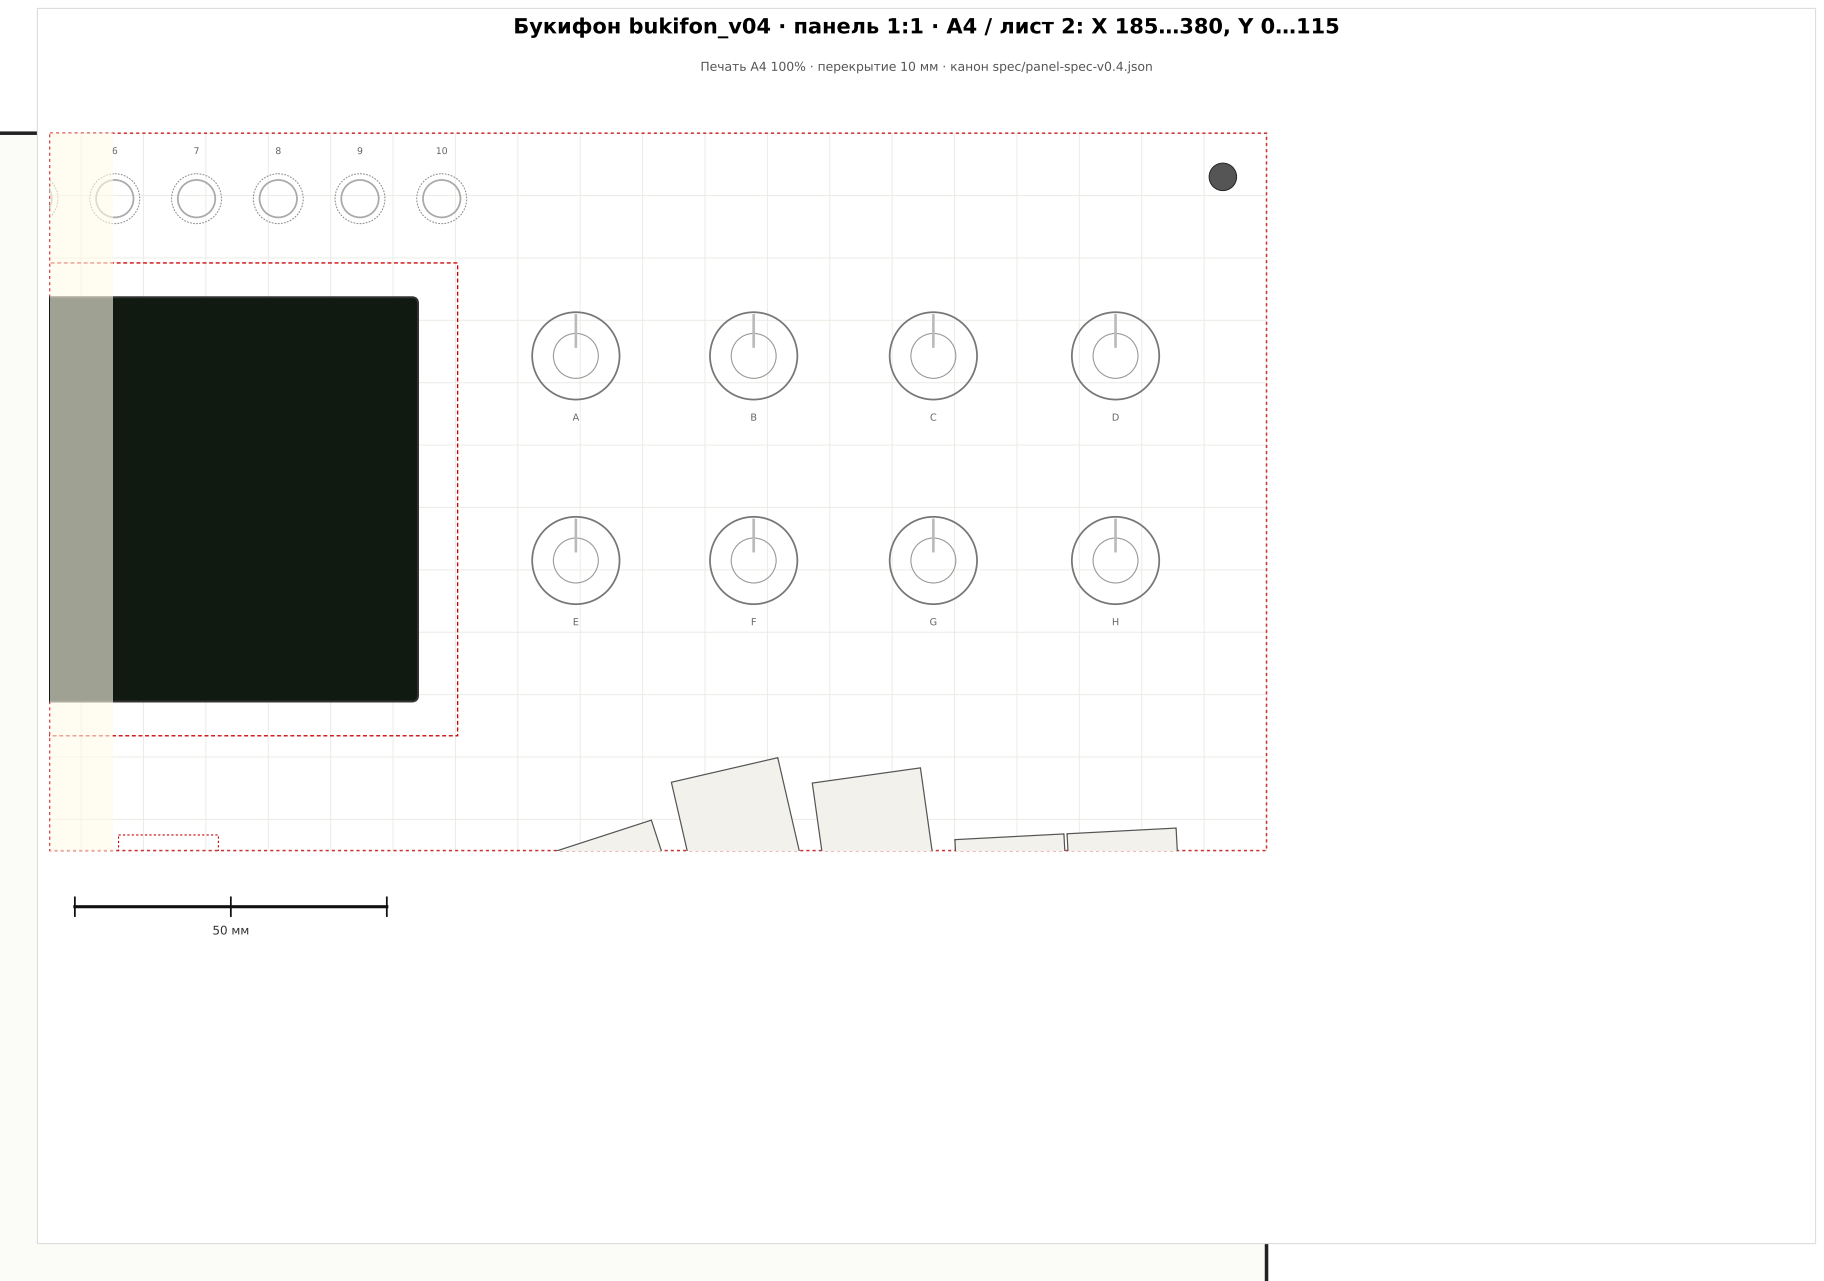
[picture p173: page 2]

Букифон bukifon_v04 · панель 1:1 | · A4 | / лист 3: X | 0…195, Y 100…210

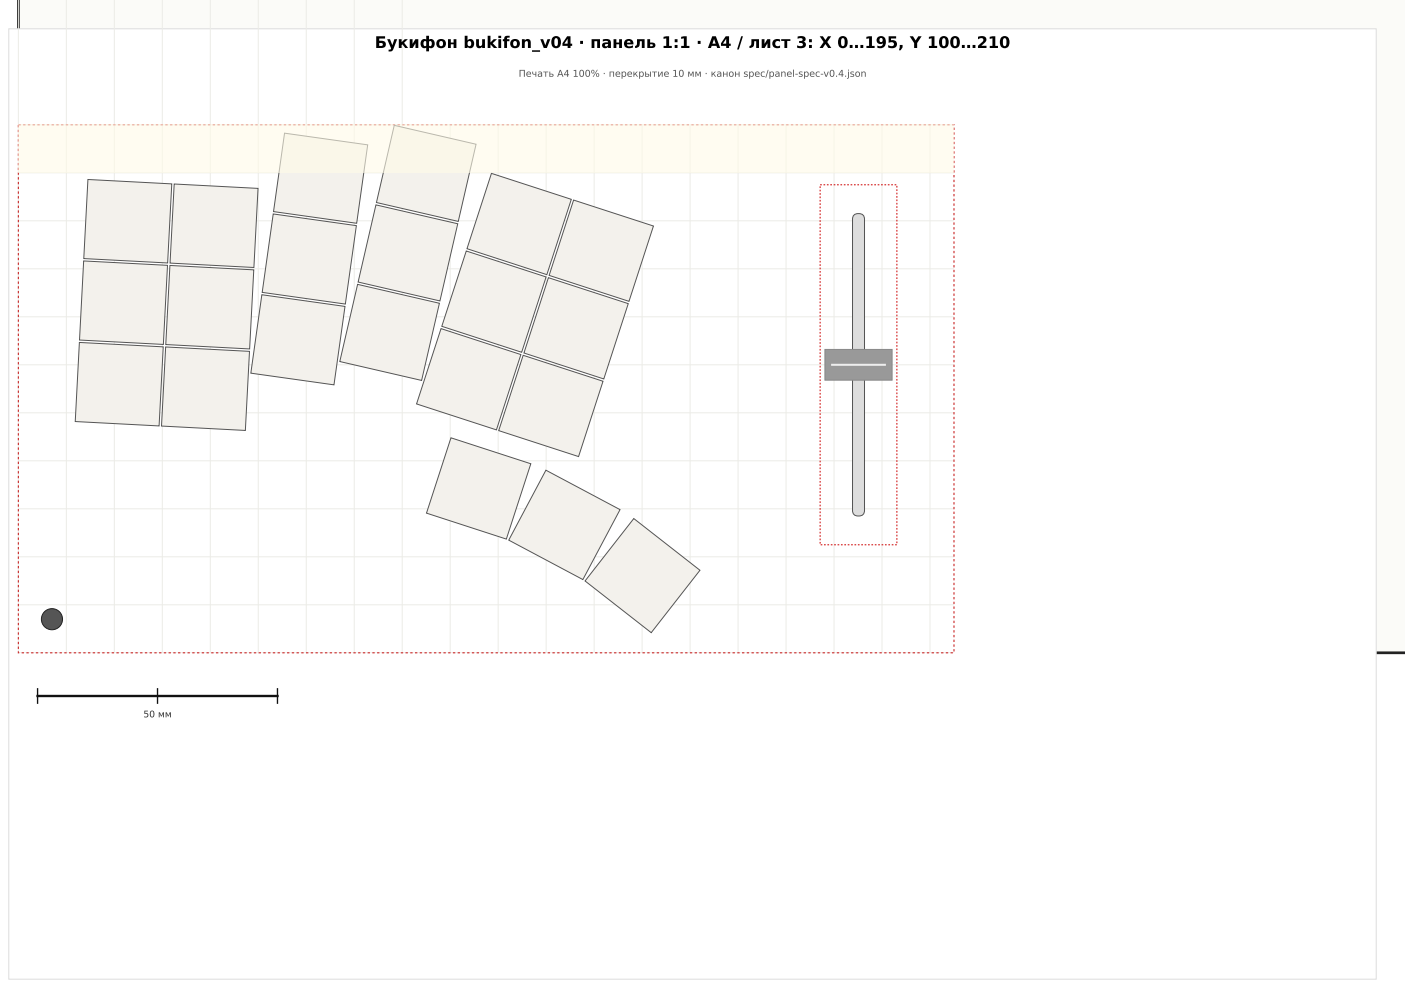
[picture p174: page 3]

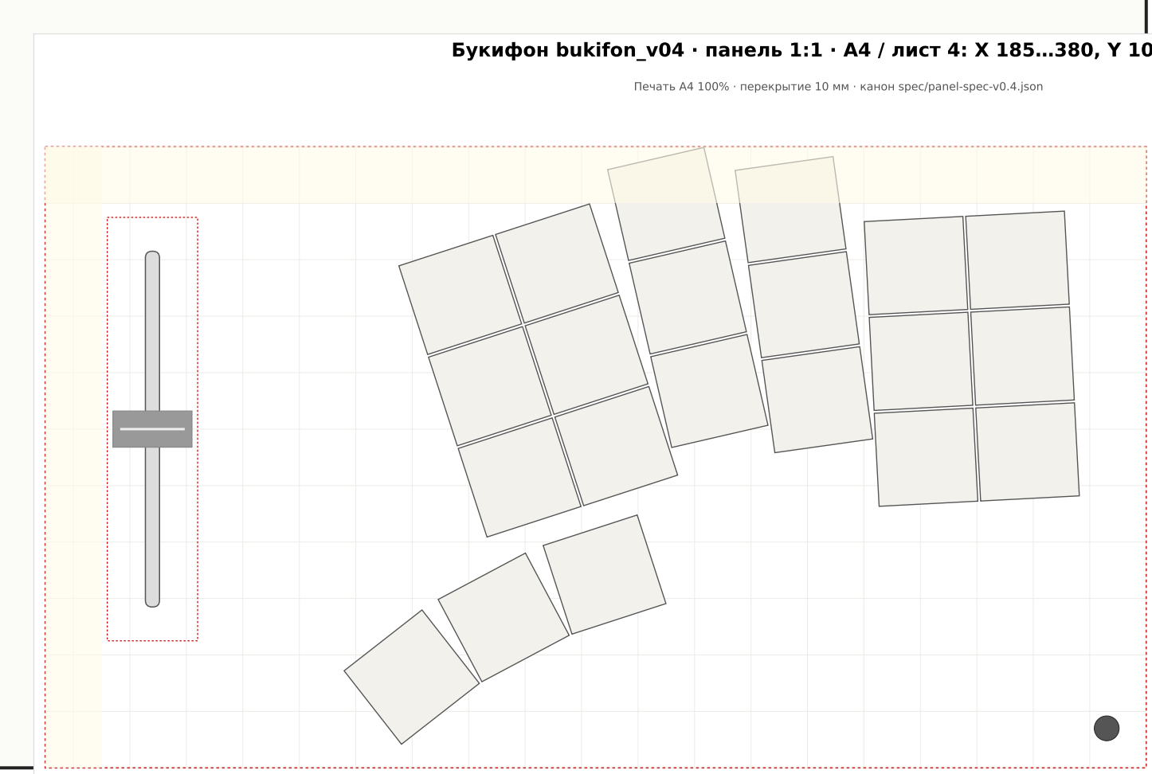
[picture p175: figure]

## Букифон bukifon_v04 · панель 1:1 · A4 / лист 4: X 185…380, Y 100…210

50 мм
