martiyanov/bukifon/renders/templates/bukifon_v1_6_traced_1to1.pdf

# Букифон v1.6 · трассировка макета · 1:1 · левая часть

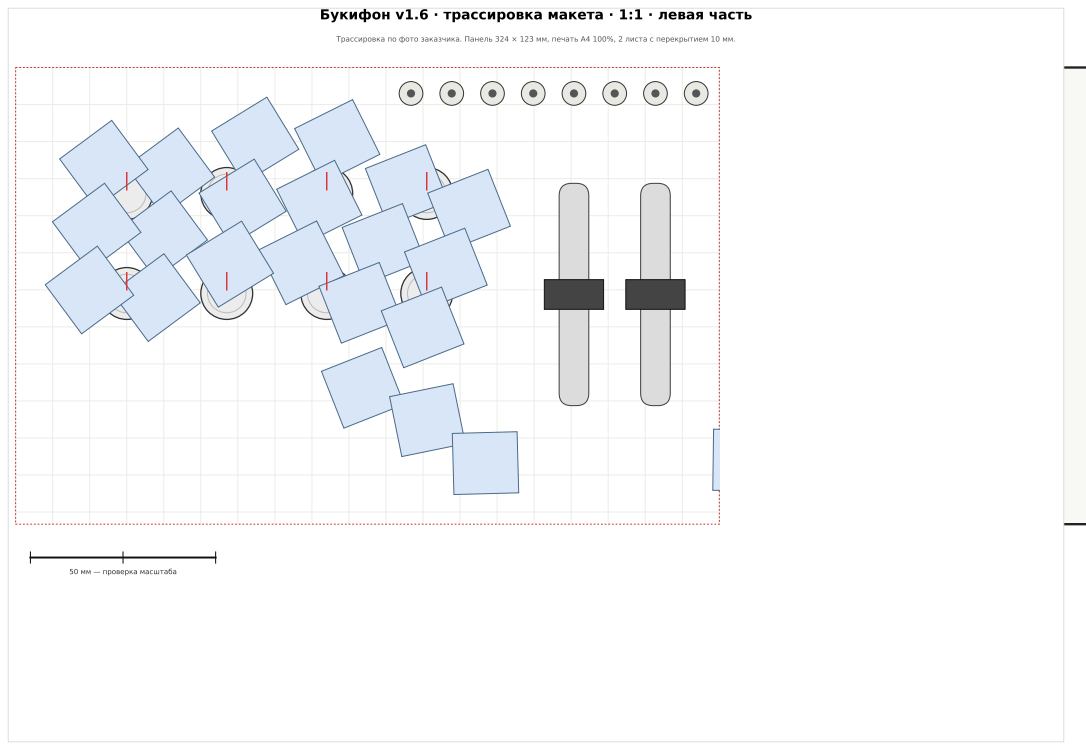
[picture p176: page 1]

Трассировка по фото заказчика. Панель 324 × 123 мм, печать A4 100%, 2 листа с перекрытием 10 мм.

50 мм — проверка масштаба

# Букифон v1.6 · трассировка макета · 1:1 · правая часть

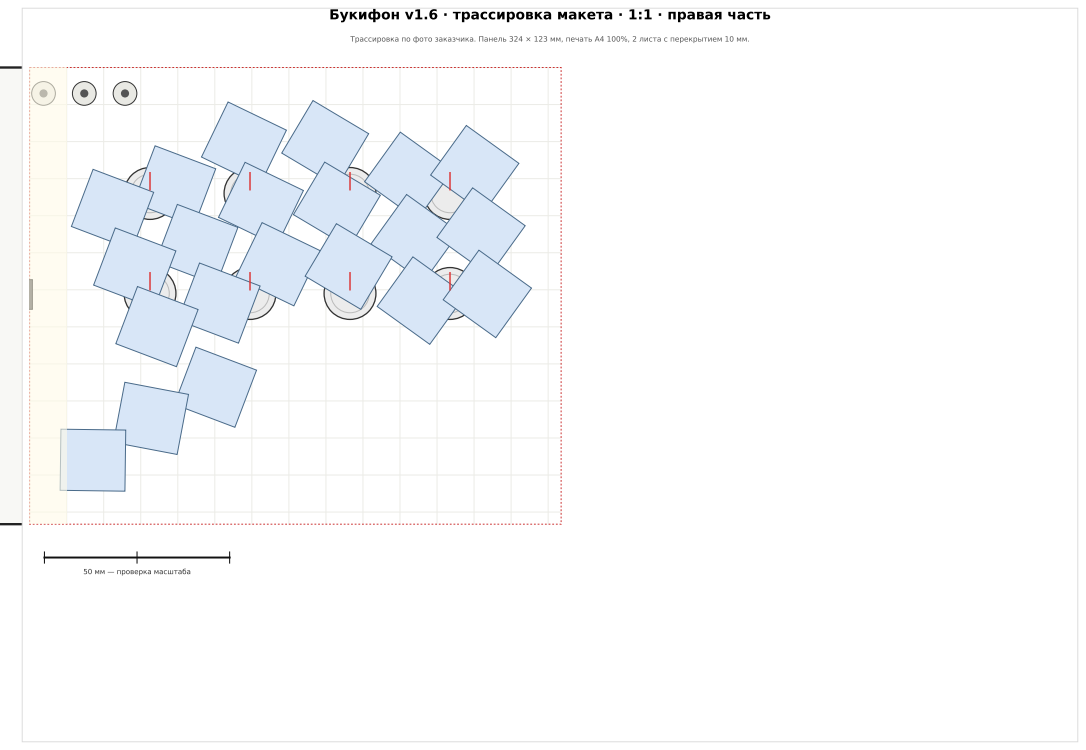
[picture p177: page 2]
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

50 мм — проверка масштаба
