martiyanov/bukifon/renders/templates/octatrack_mk2_1to1.pdf

# Elektron Octatrack MKII · 1:1 · левая часть панели (X 0…160 мм)

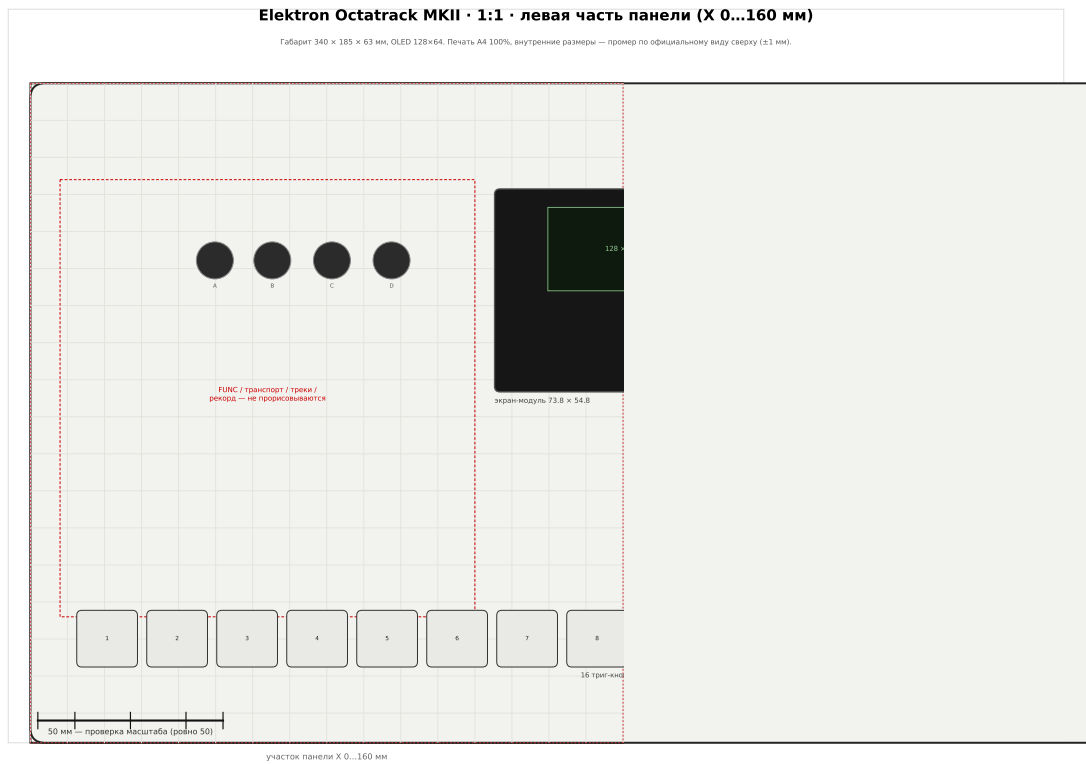
[picture p180: page 1]
16 триг-кнопок; 128 × 64 OLED; экран-модуль 73.8 × 54.8

Габарит 340 × 185 × 63 мм, OLED 128×64. Печать A4 100%, внутренние размеры — промер по официальному виду сверху (±1 мм).

FUNC / транспорт / треки /
рекорд — не прорисовываются

50 мм — проверка масштаба (ровно 50)

участок панели X 0…160 мм

# Elektron Octatrack MKII · 1:1 · правая часть панели (X 150…340 мм)

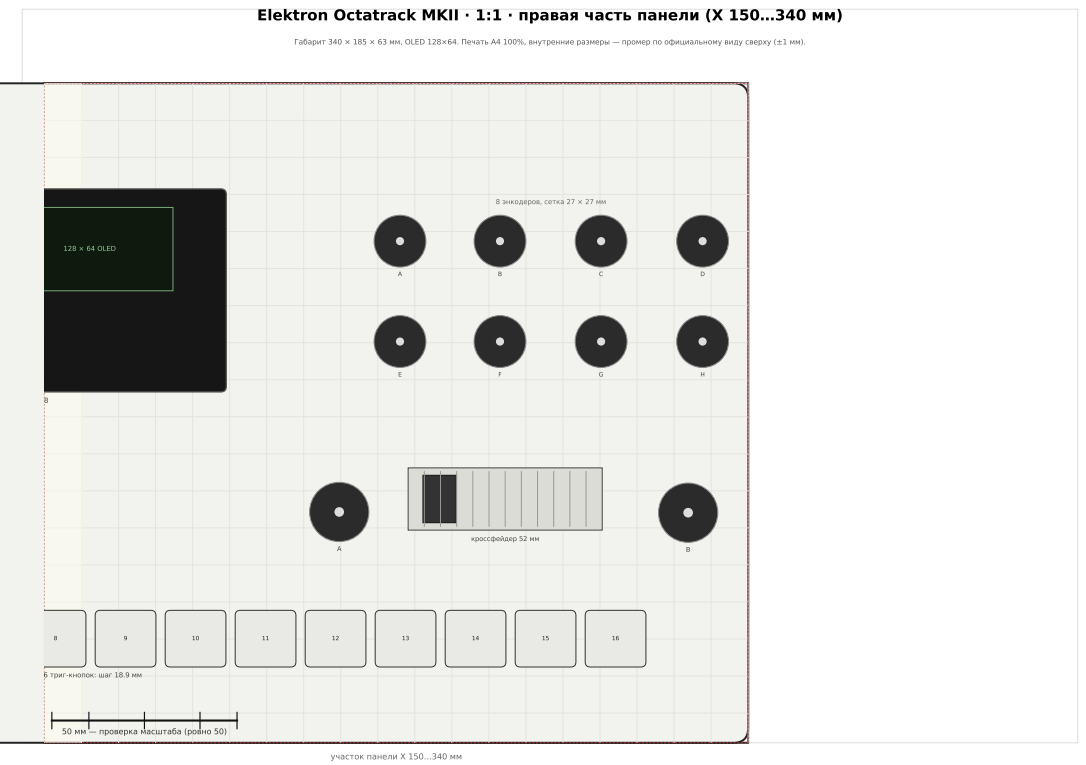
[picture p181: page 2]
кроссфейдер 52 мм; 128 × 64 OLED; экран-модуль 73.8 × 54.8

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

8 энкодеров, сетка 27 × 27 мм

16 триг-кнопок: шаг 18.9 мм

участок панели X 150…340 мм

## Octatrack MKII 1:1 на панели Букифон 315 × 145: триг-ряд, экран, кроссфейдер

Триг-ряд Octatrack (312.9 мм) почти точно ложится на нашу панель 315 мм. 8 энкодеров Octatrack выходят за край на ~13 мм — видно, где нужен сдвиг/уплотнение.

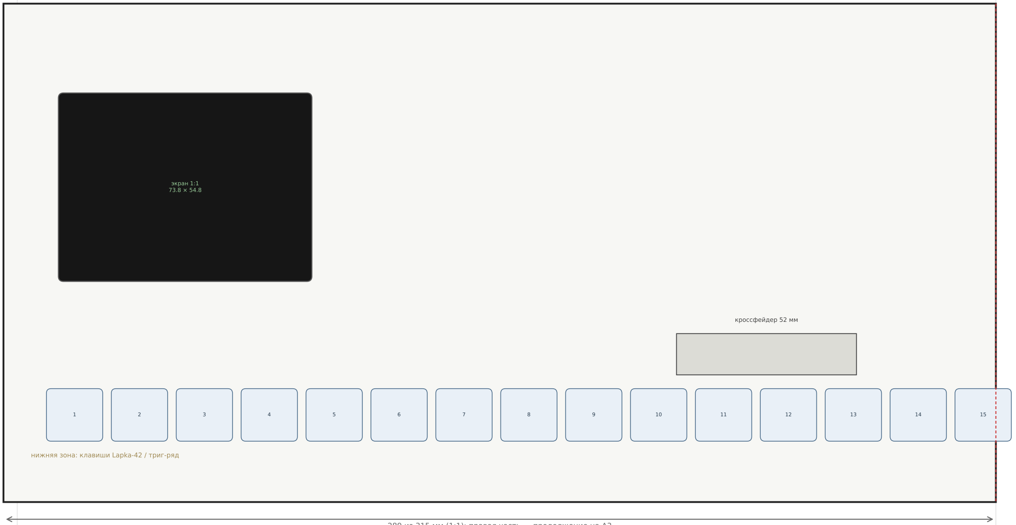
[picture p182: figure]
экран 1:1 73.8 × 54.8; кроссфейдер 52 мм

нижняя зона: клавиши Lapka-42 / триг-ряд

289 из 315 мм (1:1); правая часть — продолжение на A3
