martiyanov/bukifon/renders/templates/digitone2_top_1to1.pdf

# Elektron Digitone II · верхняя панель 1:1 · экран + 8 энкодеров

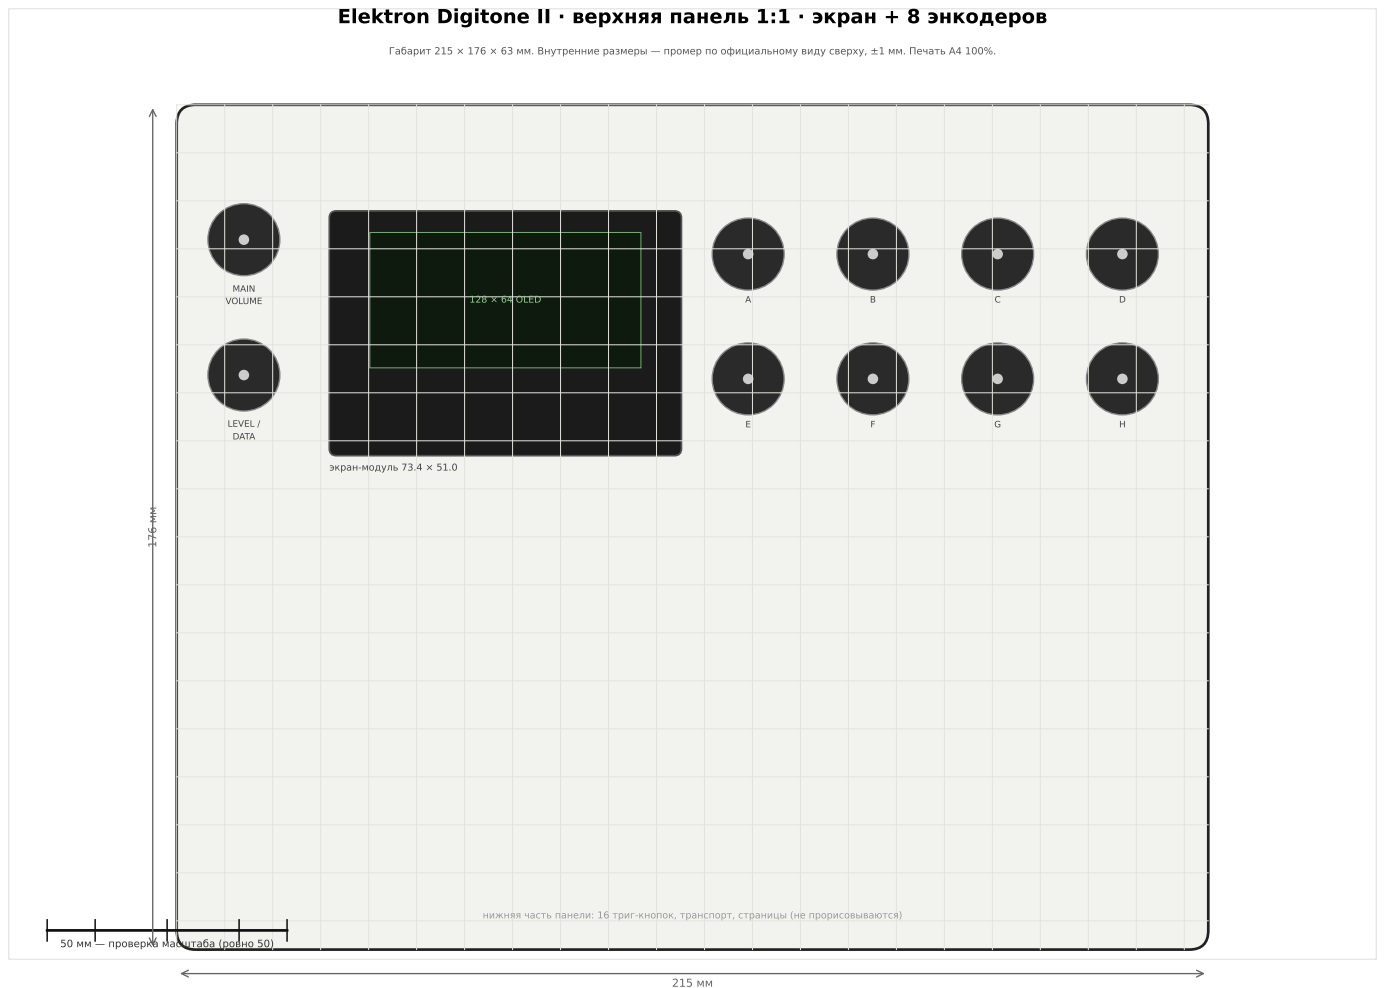
[picture p183: page 1]
128 × 64 OLED; экран-модуль 73.4 × 51.0; MAIN VOLUME; LEVEL / DATA

Габарит 215 × 176 × 63 мм. Внутренние размеры — промер по официальному виду сверху, ±1 мм. Печать A4 100%.

нижняя часть панели: 16 триг-кнопок, транспорт, страницы (не прорисовываются)

50 мм — проверка масштаба (ровно 50)

# Букифон · панель 315 × 145 · блок Digitone II наложен 1:1

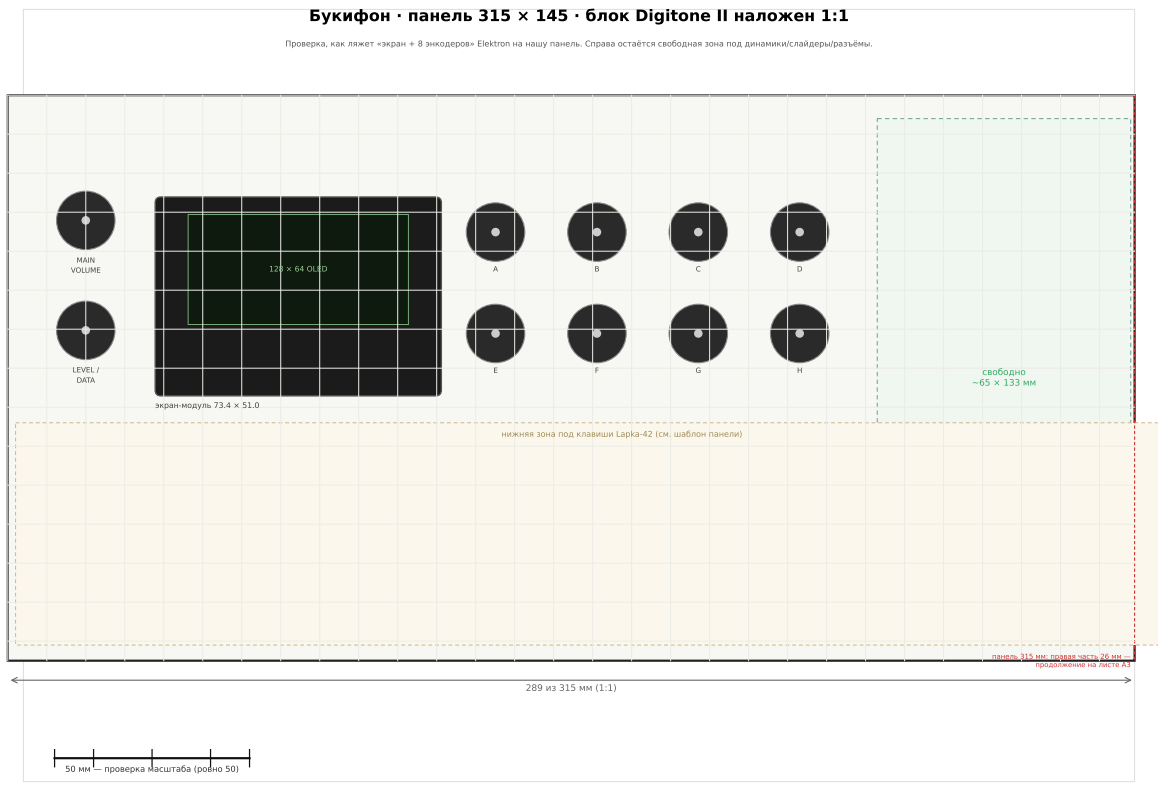
[picture p184: page 2]
128 × 64 OLED; MAIN VOLUME

Проверка, как ляжет «экран + 8 энкодеров» Elektron на нашу панель. Справа остаётся свободная зона под динамики/слайдеры/разъёмы.

LEVEL / DATA | экран-модуль 73.4 × 51.0 | E | F | G | H | ~65 × 133 мм | свободно

нижняя зона под клавиши Lapka-42 (см. шаблон панели)

панель 315 мм: правая часть 26 мм —

продолжение на листе A3

50 мм — проверка масштаба (ровно 50)
