martiyanov/bukifon/renders/templates/lapka42_keycaps_1to1.pdf

# Букифон · клавиши Lapka-42 для вырезания · масштаб 1:1

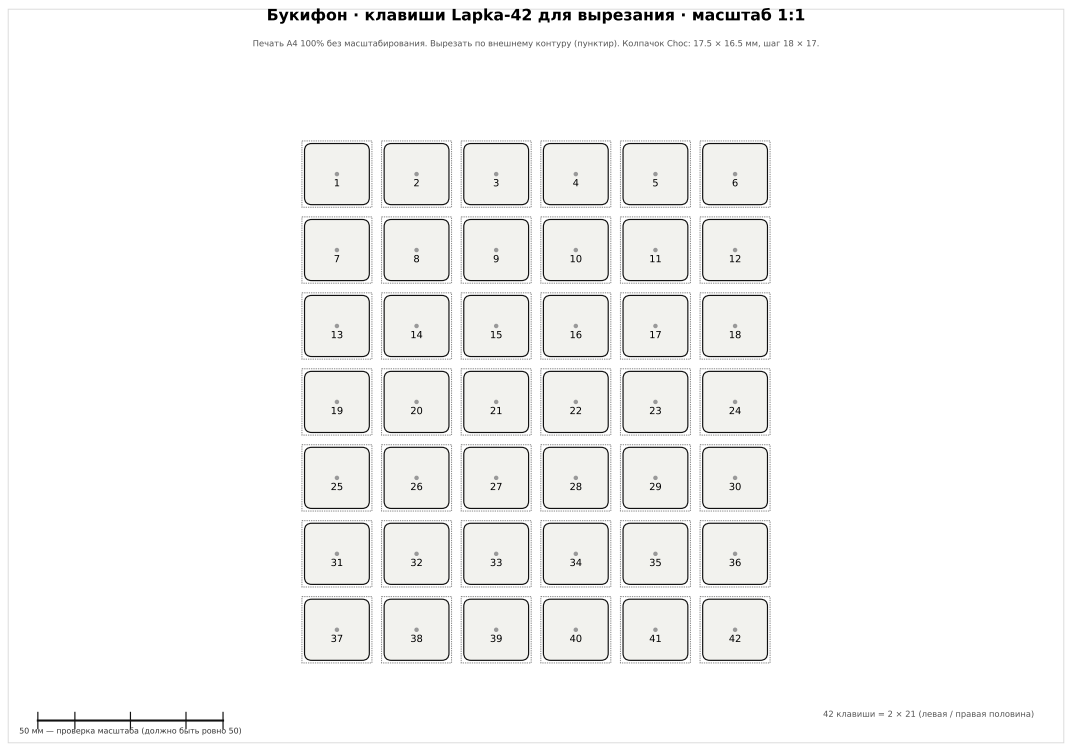
[picture p185: page 1]

Печать A4 100% без масштабирования. Вырезать по внешнему контуру (пунктир). Колпачок Choc: 17.5 × 16.5 мм, шаг 18 × 17.

42 клавиши = 2 × 21 (левая / правая половина)

50 мм — проверка масштаба (должно быть ровно 50)
