martiyanov/bukifon/renders/templates/lapka42_layout_1to1.pdf

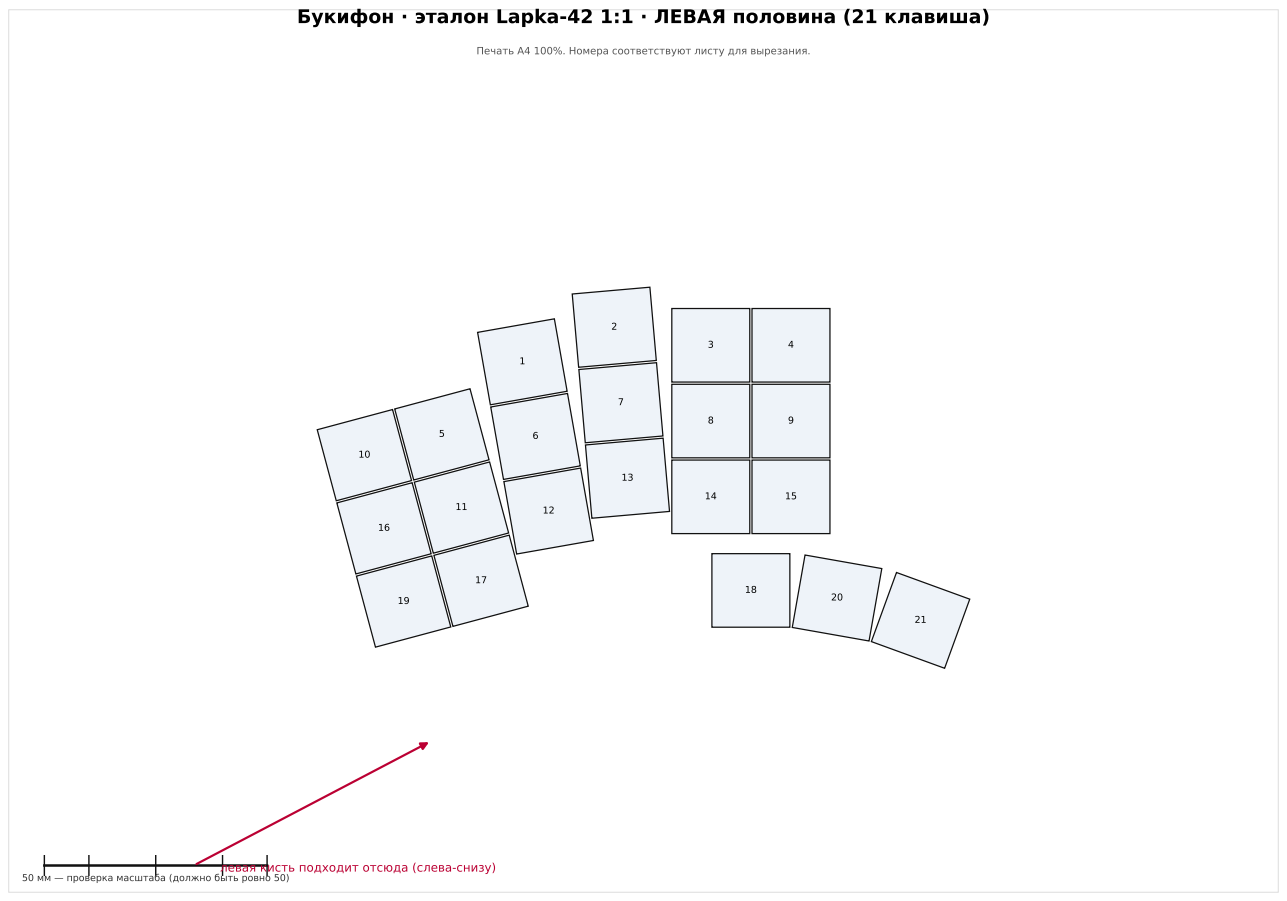
[picture p186: page 1]

Букифон · эталон Lapka-42 1:1 · ЛЕВАЯ половина (21 клавиша)

Печать A4 100%. Номера соответствуют листу для вырезания.

левая кисть подходит отсюда (слева-снизу)

50 мм — проверка масштаба (должно быть ровно 50)

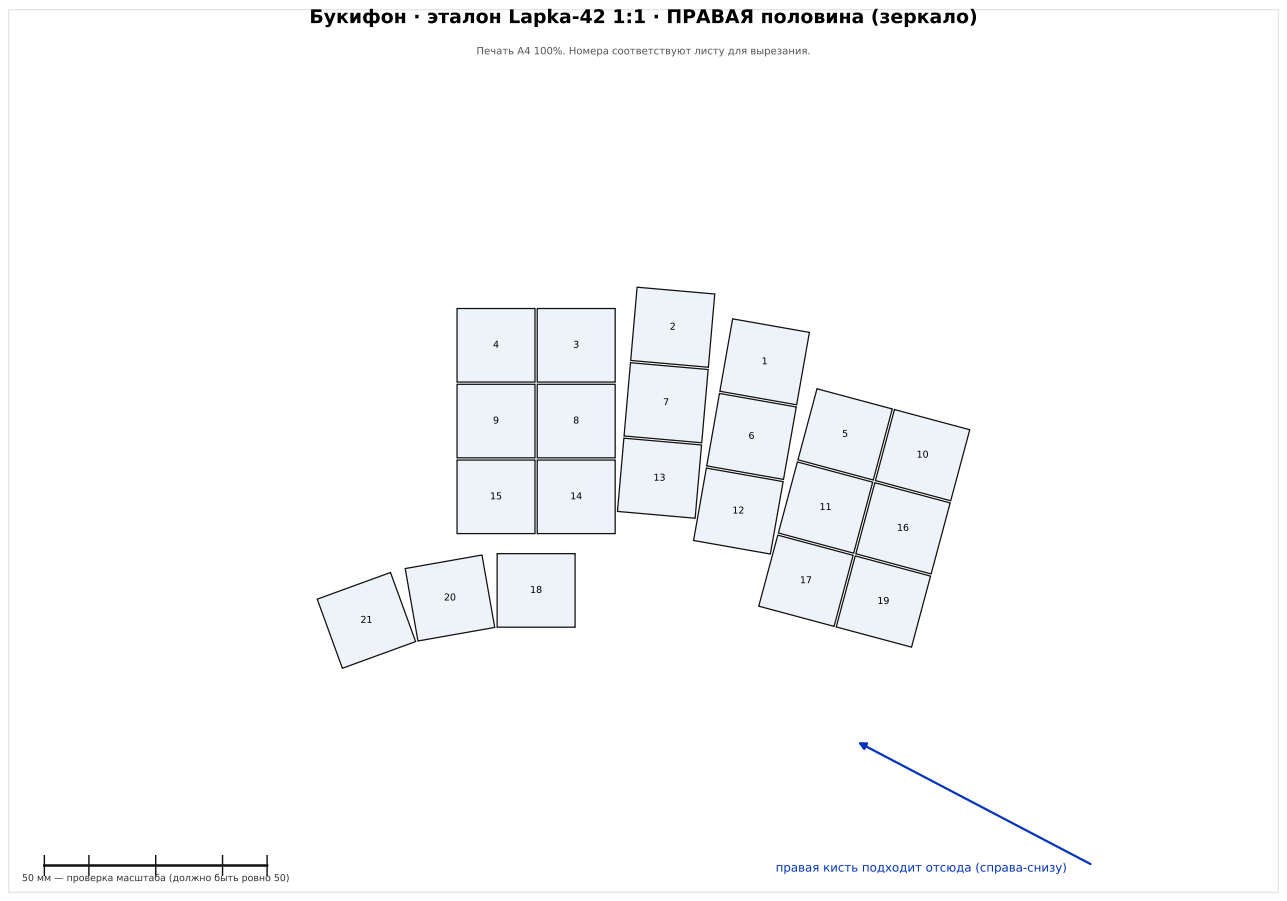
[picture p187: page 2]

Букифон · эталон Lapka-42 1:1 · ПРАВАЯ половина (зеркало)

Печать A4 100%. Номера соответствуют листу для вырезания.

правая кисть подходит отсюда (справа-снизу)

50 мм — проверка масштаба (должно быть ровно 50)
