martiyanov/bukifon/renders/templates/bukifon_v1_8_panel_1to1.pdf

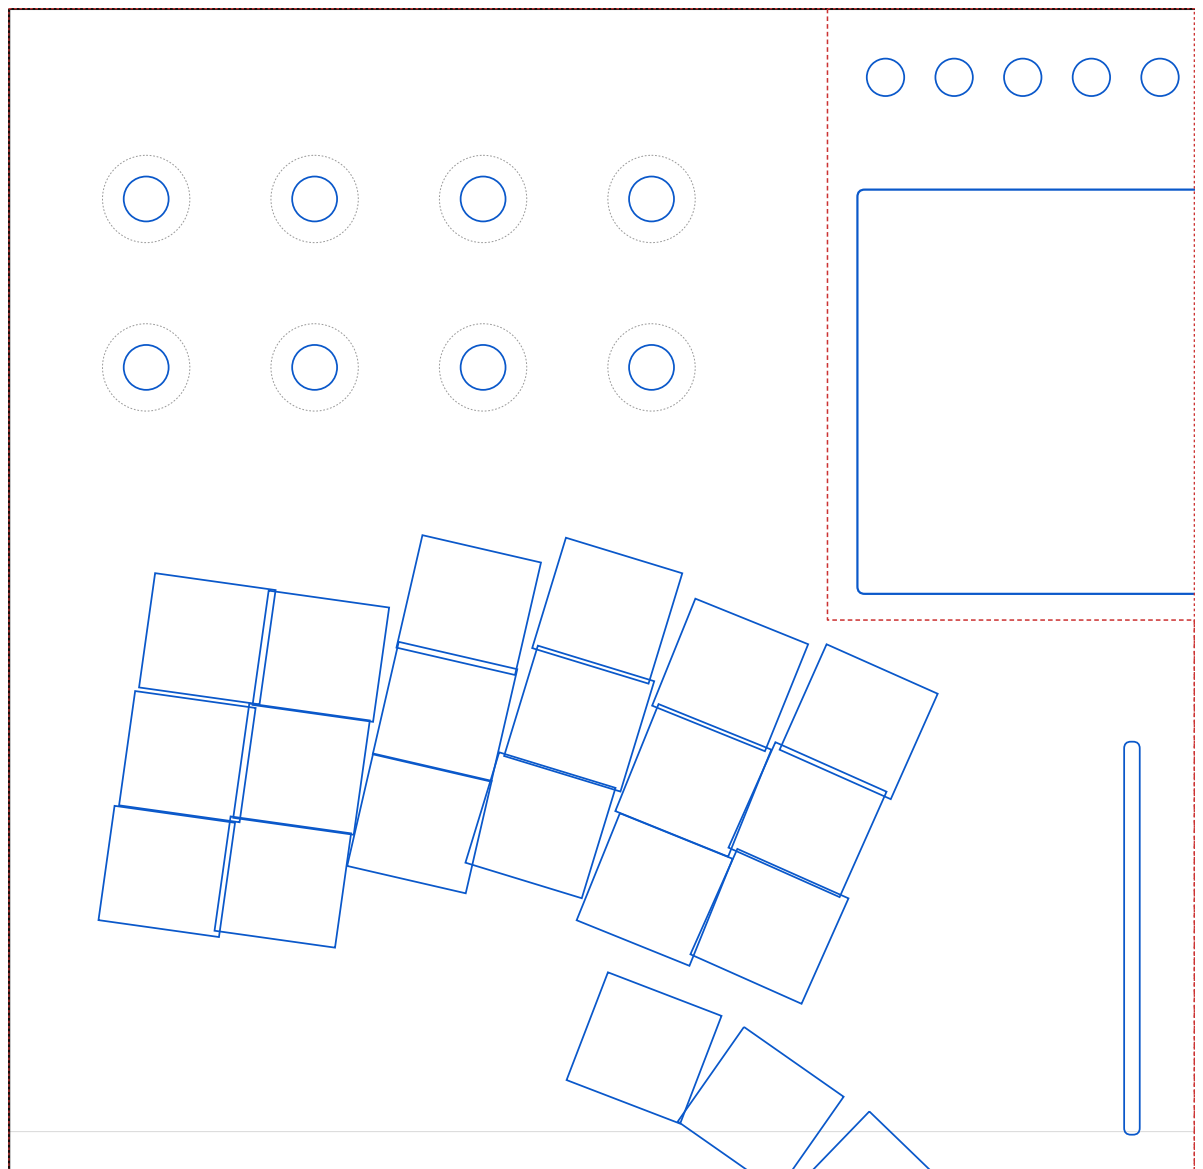
[picture p188: page 1]

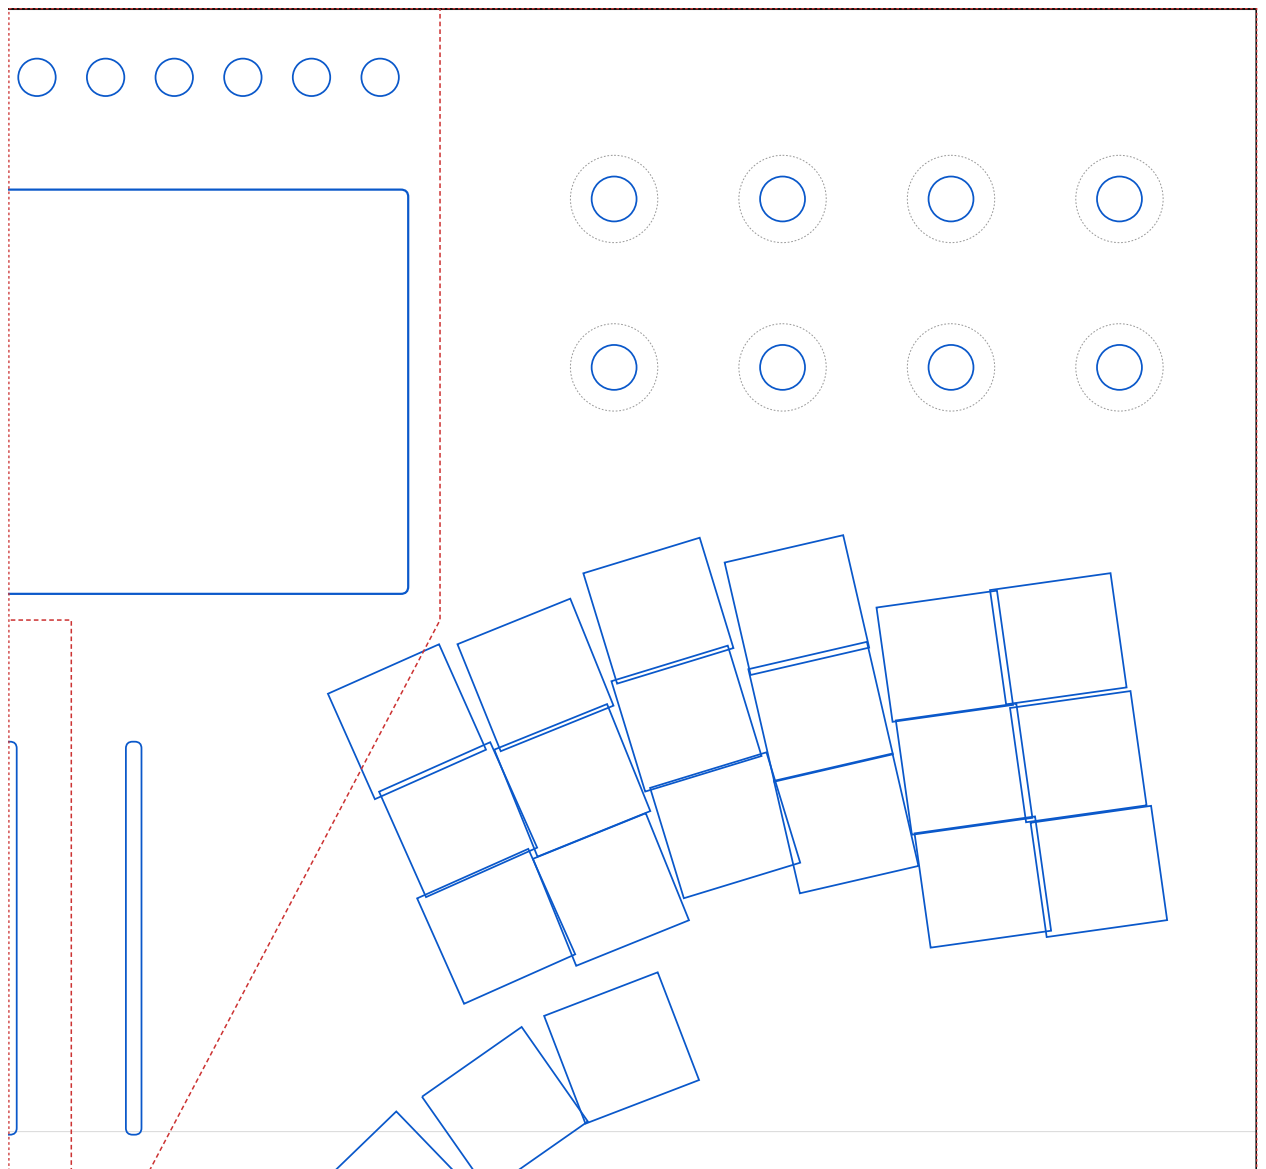
[picture p189: page 2]

# Букифон v1.8 — координаты элементов (мм, Y от верхней кромки)

LCD | вырез 108.0 × 64.8 | X 136.0…244.0 | Y 29.0…93.8 | 0°
J01 | джек 3.5 Ø6.0 | X 140.5 | Y 11.0 | —
J02 | джек 3.5 Ø6.0 | X 151.5 | Y 11.0 | —
J03 | джек 3.5 Ø6.0 | X 162.5 | Y 11.0 | —
J04 | джек 3.5 Ø6.0 | X 173.5 | Y 11.0 | —
J05 | джек 3.5 Ø6.0 | X 184.5 | Y 11.0 | —
J06 | джек 3.5 Ø6.0 | X 195.5 | Y 11.0 | —
J07 | джек 3.5 Ø6.0 | X 206.5 | Y 11.0 | —
J08 | джек 3.5 Ø6.0 | X 217.5 | Y 11.0 | —
J09 | джек 3.5 Ø6.0 | X 228.5 | Y 11.0 | —
J10 | джек 3.5 Ø6.0 | X 239.5 | Y 11.0 | —
ENC | вал Ø7.2 / ручка Ø14 | X 22.0 | Y 30.5 | —
ENC | вал Ø7.2 / ручка Ø14 | X 49.0 | Y 30.5 | —
ENC | вал Ø7.2 / ручка Ø14 | X 76.0 | Y 30.5 | —
ENC | вал Ø7.2 / ручка Ø14 | X 103.0 | Y 30.5 | —
ENC | вал Ø7.2 / ручка Ø14 | X 22.0 | Y 57.5 | —
ENC | вал Ø7.2 / ручка Ø14 | X 49.0 | Y 57.5 | —
ENC | вал Ø7.2 / ручка Ø14 | X 76.0 | Y 57.5 | —
ENC | вал Ø7.2 / ручка Ø14 | X 103.0 | Y 57.5 | —
ENC | вал Ø7.2 / ручка Ø14 | X 277.0 | Y 30.5 | —
ENC | вал Ø7.2 / ручка Ø14 | X 304.0 | Y 30.5 | —
ENC | вал Ø7.2 / ручка Ø14 | X 331.0 | Y 30.5 | —
ENC | вал Ø7.2 / ручка Ø14 | X 358.0 | Y 30.5 | —
ENC | вал Ø7.2 / ручка Ø14 | X 277.0 | Y 57.5 | —
ENC | вал Ø7.2 / ручка Ø14 | X 304.0 | Y 57.5 | —
ENC | вал Ø7.2 / ручка Ø14 | X 331.0 | Y 57.5 | —
ENC | вал Ø7.2 / ручка Ø14 | X 358.0 | Y 57.5 | —
F1 | паз 2.5 × 63 | X 180.0 | Y 117.5…180.5 | 0°
F2 | паз 2.5 × 63 | X 200.0 | Y 117.5…180.5 | 0°
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
R_K20 | окно 19.5 × 18.5 R1.5 | X 259.5 | Y 176.4 | -35.0°
R_K21 | окно 19.5 × 18.5 R1.5 | X 241.5 | Y 190.2 | -44.0°

Источник: handoff v0.3 (фото-реконструкция ±1–2 мм); до производства — импорт KiCad Lapka-42. Швы панели: шапка X 131.2…249.1 до Y 98.0, ниже X=190.
