martiyanov/bukifon/renders/templates/bukifon_v03_panel_1to1.pdf

# Букифон v0.3 · панель 1:1 · левая часть (X 0…190 мм)

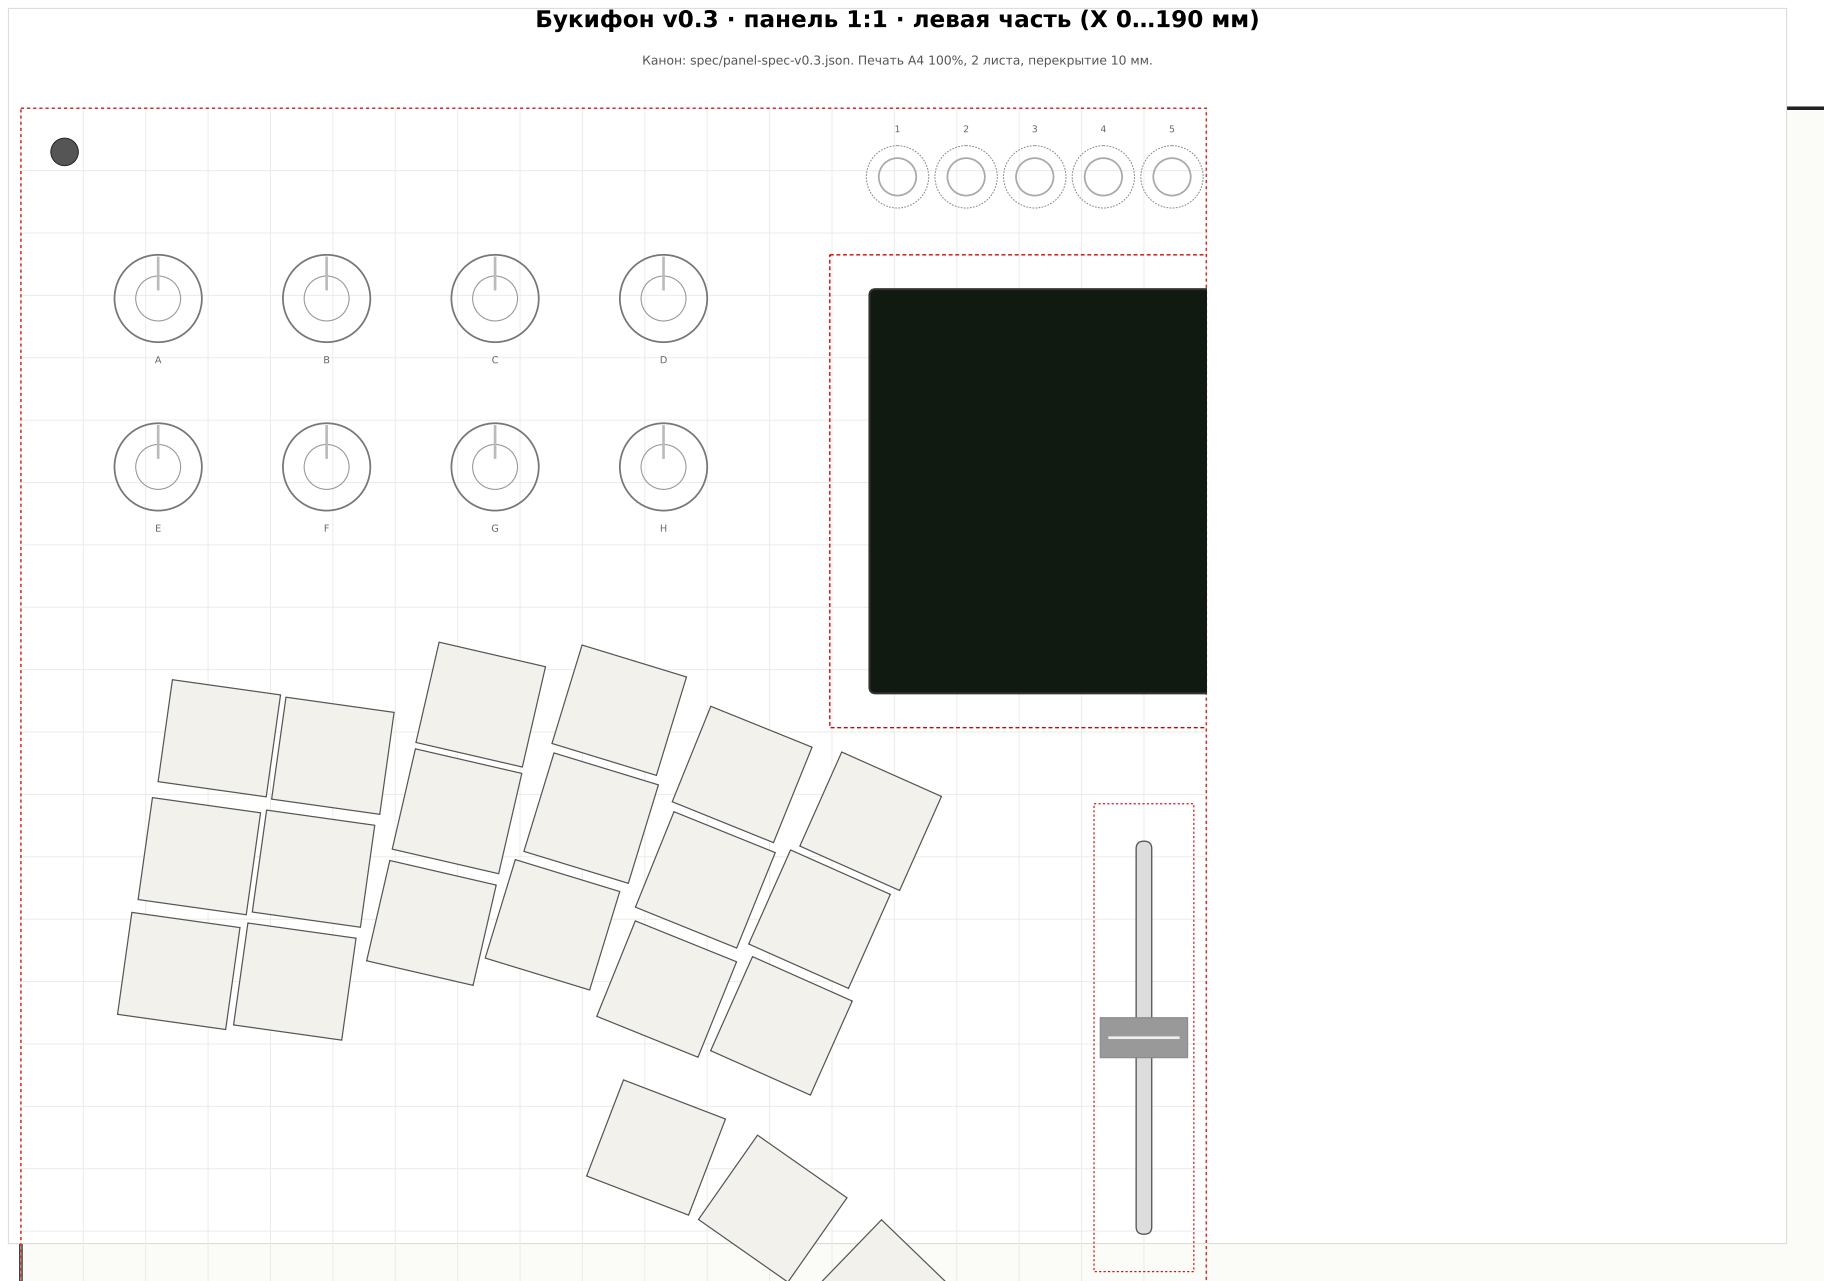
[picture p190: page 1]

Канон: spec/panel-spec-v0.3.json. Печать A4 100%, 2 листа, перекрытие 10 мм.

# Букифон v0.3 · панель 1:1 · правая часть (X 180…380 мм)

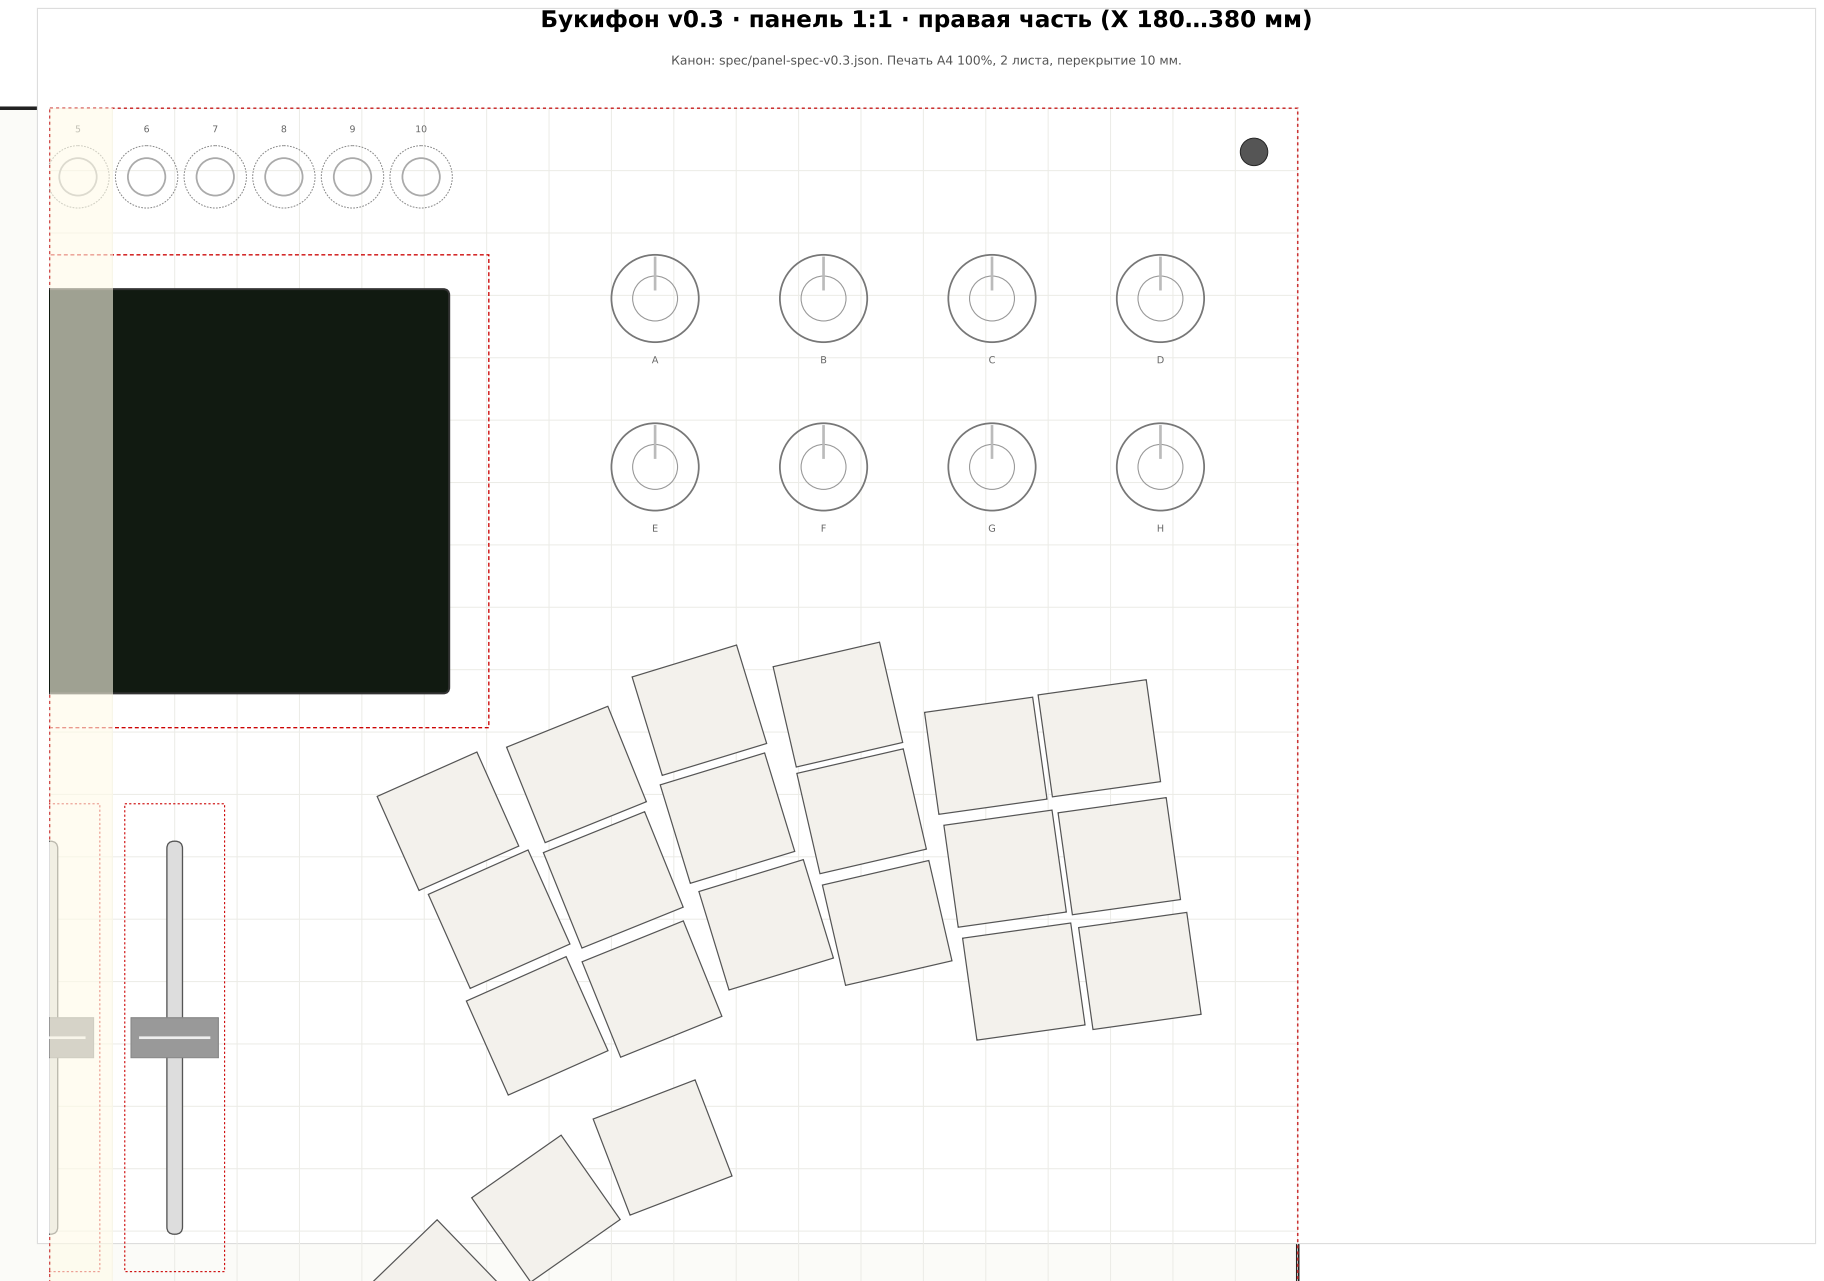
[picture p191: page 2]

Канон: spec/panel-spec-v0.3.json. Печать A4 100%, 2 листа, перекрытие 10 мм.
