martiyanov/bukifon/renders/templates/bukifon_v1_7_panel_1to1.pdf

# Букифон v1.7 · панель 1:1 · левая часть (X 0…190 мм)

## ◉ БУКИФОН

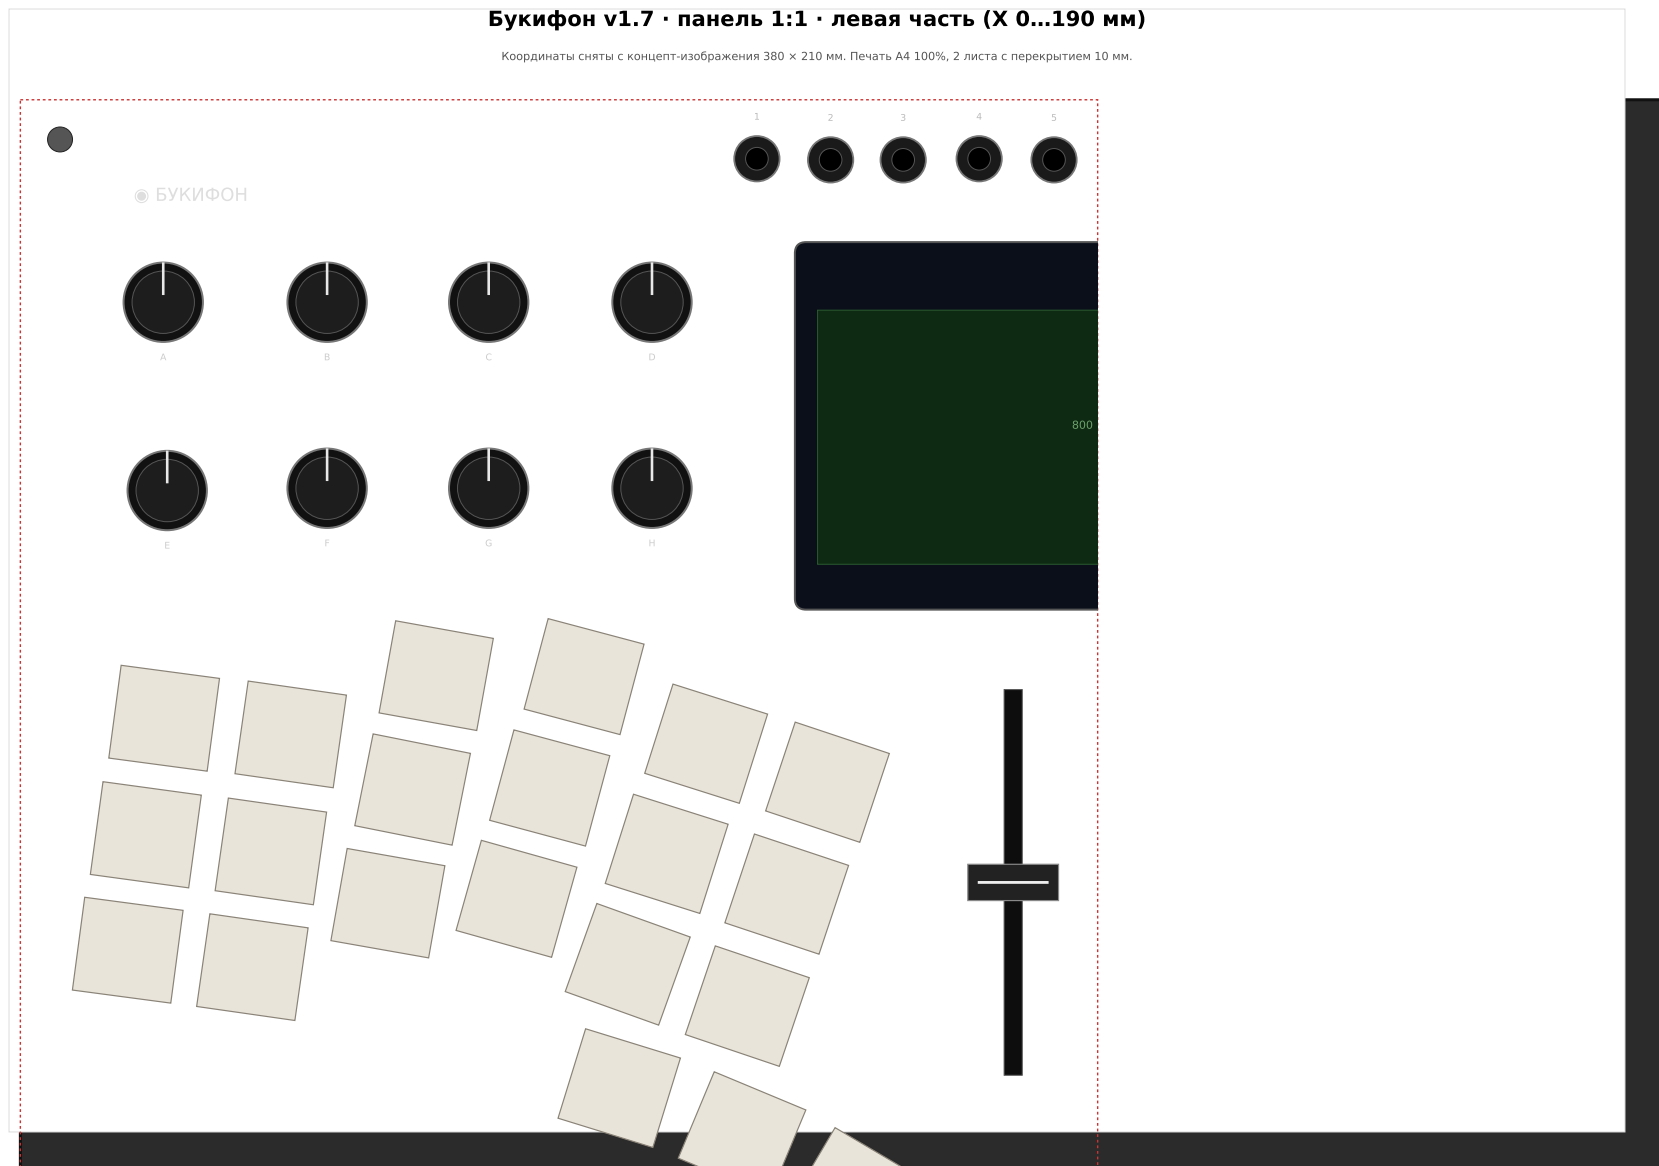
[picture p192: page 1]

Координаты сняты с концепт-изображения 380 × 210 мм. Печать A4 100%, 2 листа с перекрытием 10 мм.

# Букифон v1.7 · панель 1:1 · правая часть (X 180…380 мм)

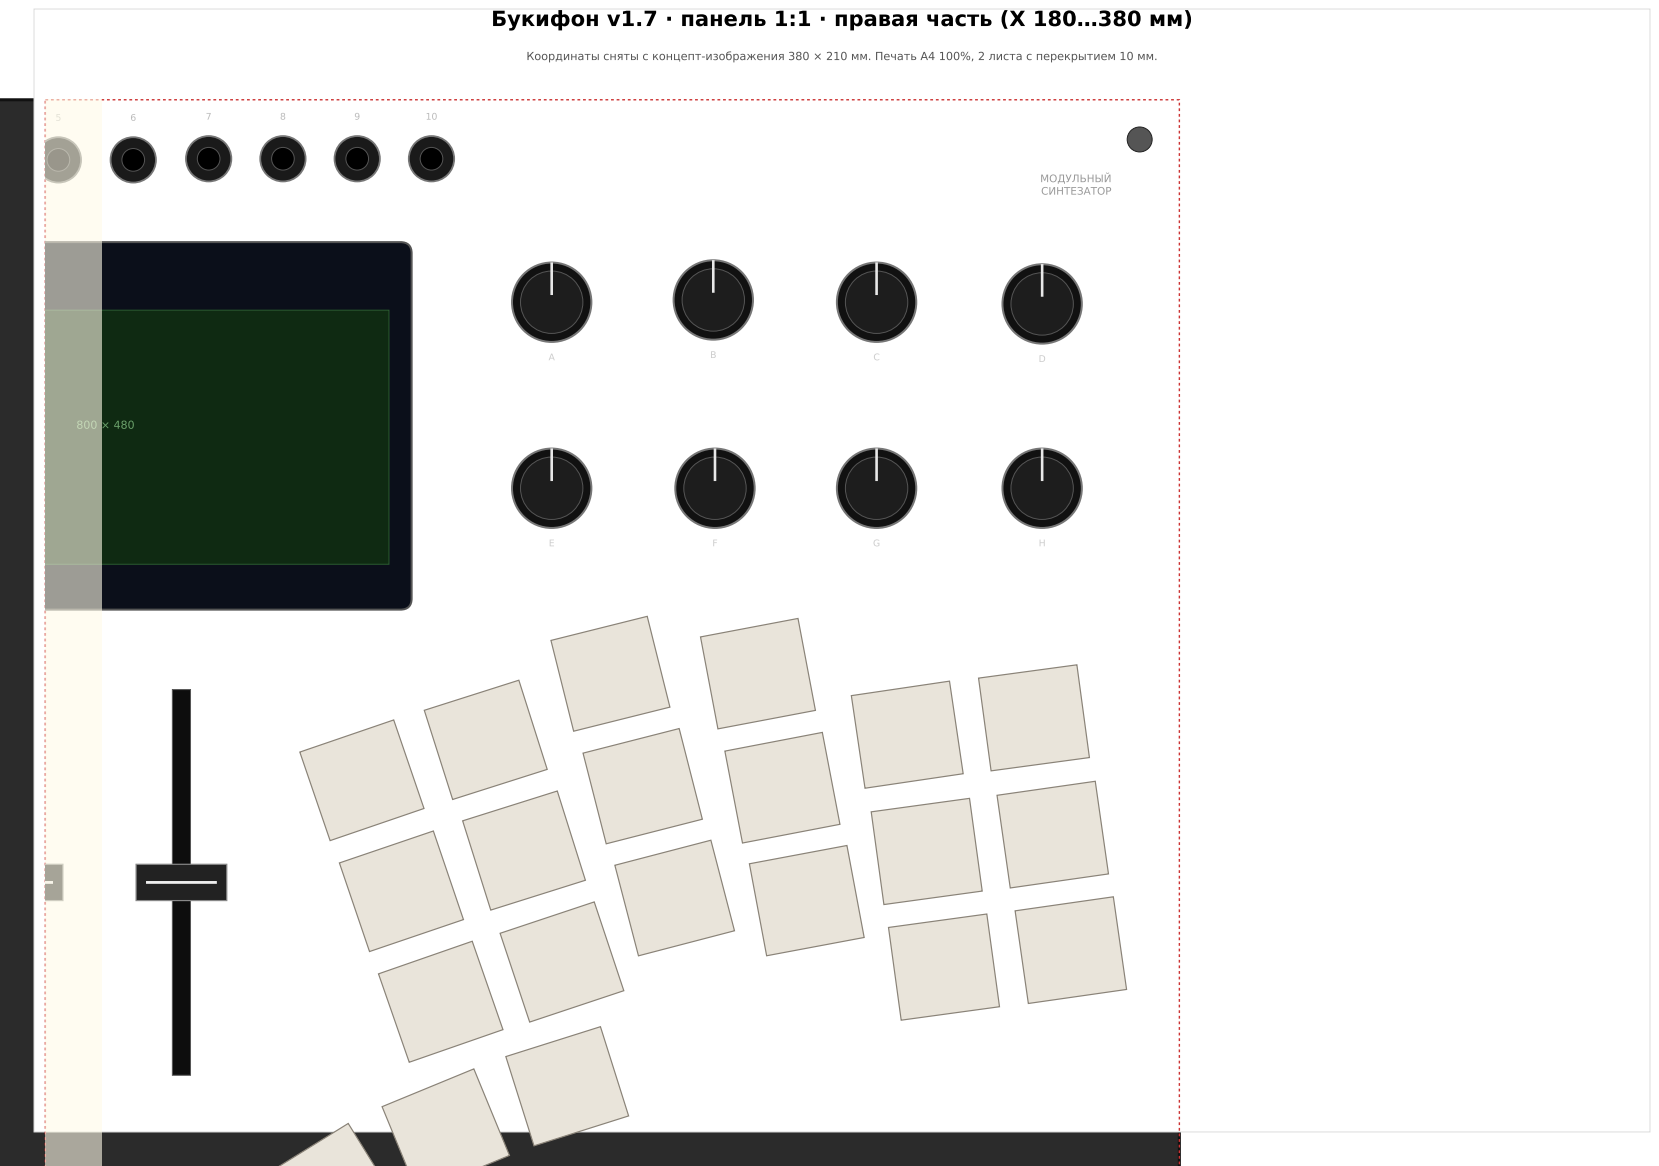
[picture p193: page 2]
МОДУЛЬНЫЙ СИНТЕЗАТОР

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
