martiyanov/bukifon/renders/templates/bukifon_v1_4_panel_1to1.pdf

# Букифон v1.4 · панель 1:1 · левая часть (X 0…170 мм)

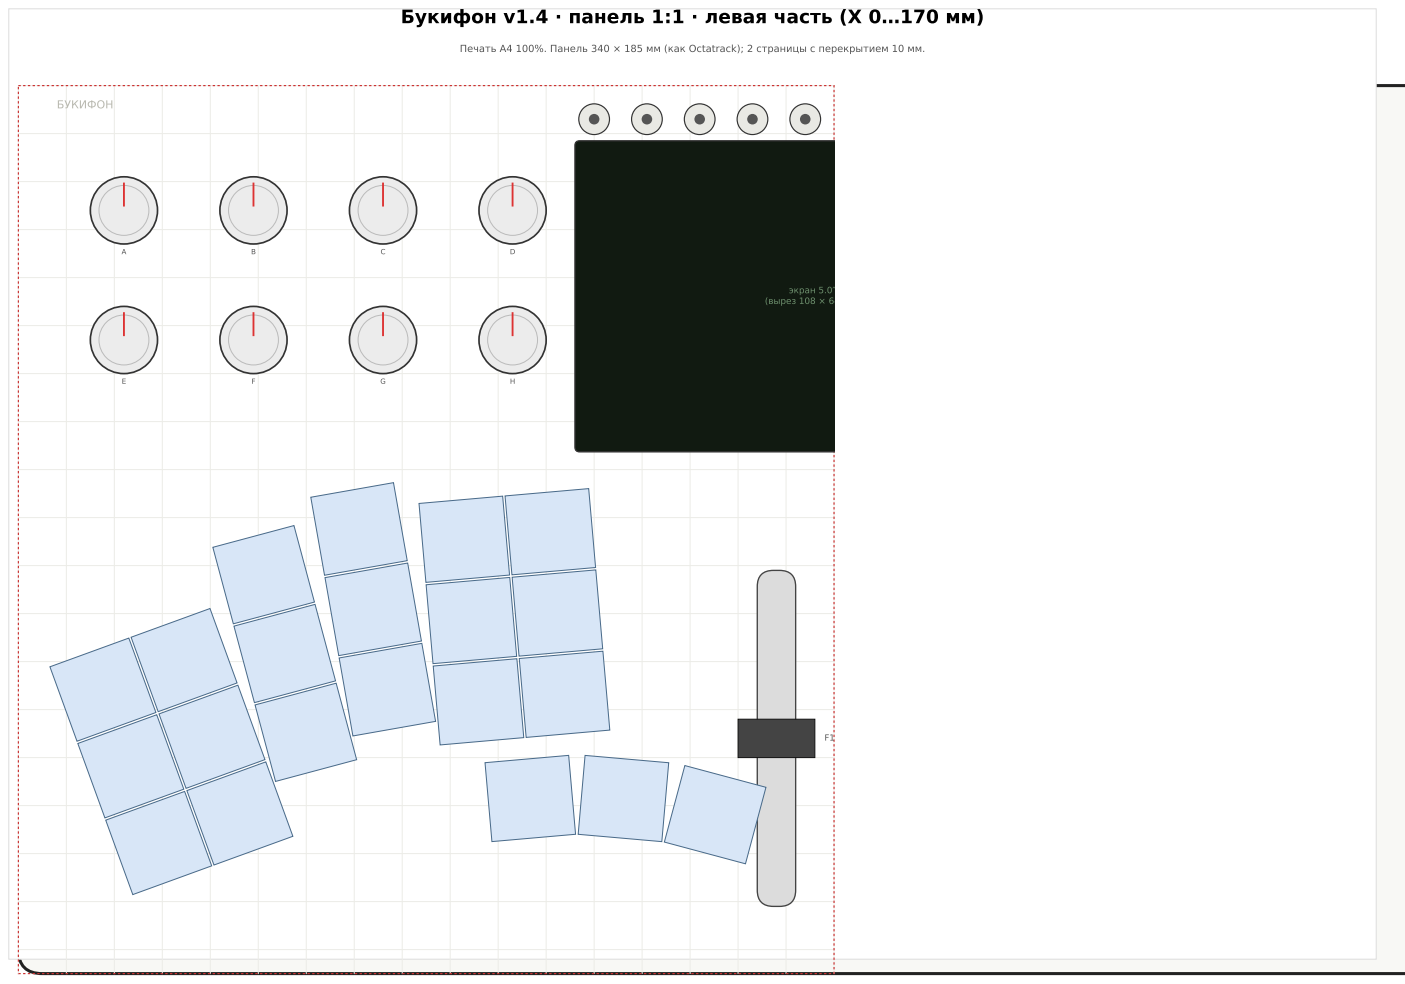
[picture p194: page 1]
БУКИФОН; экран 5.0″ (вырез 108 × 64.8,

Печать A4 100%. Панель 340 × 185 мм (как Octatrack); 2 страницы с перекрытием 10 мм.

# Букифон v1.4 · панель 1:1 · правая часть (X 160…340 мм)

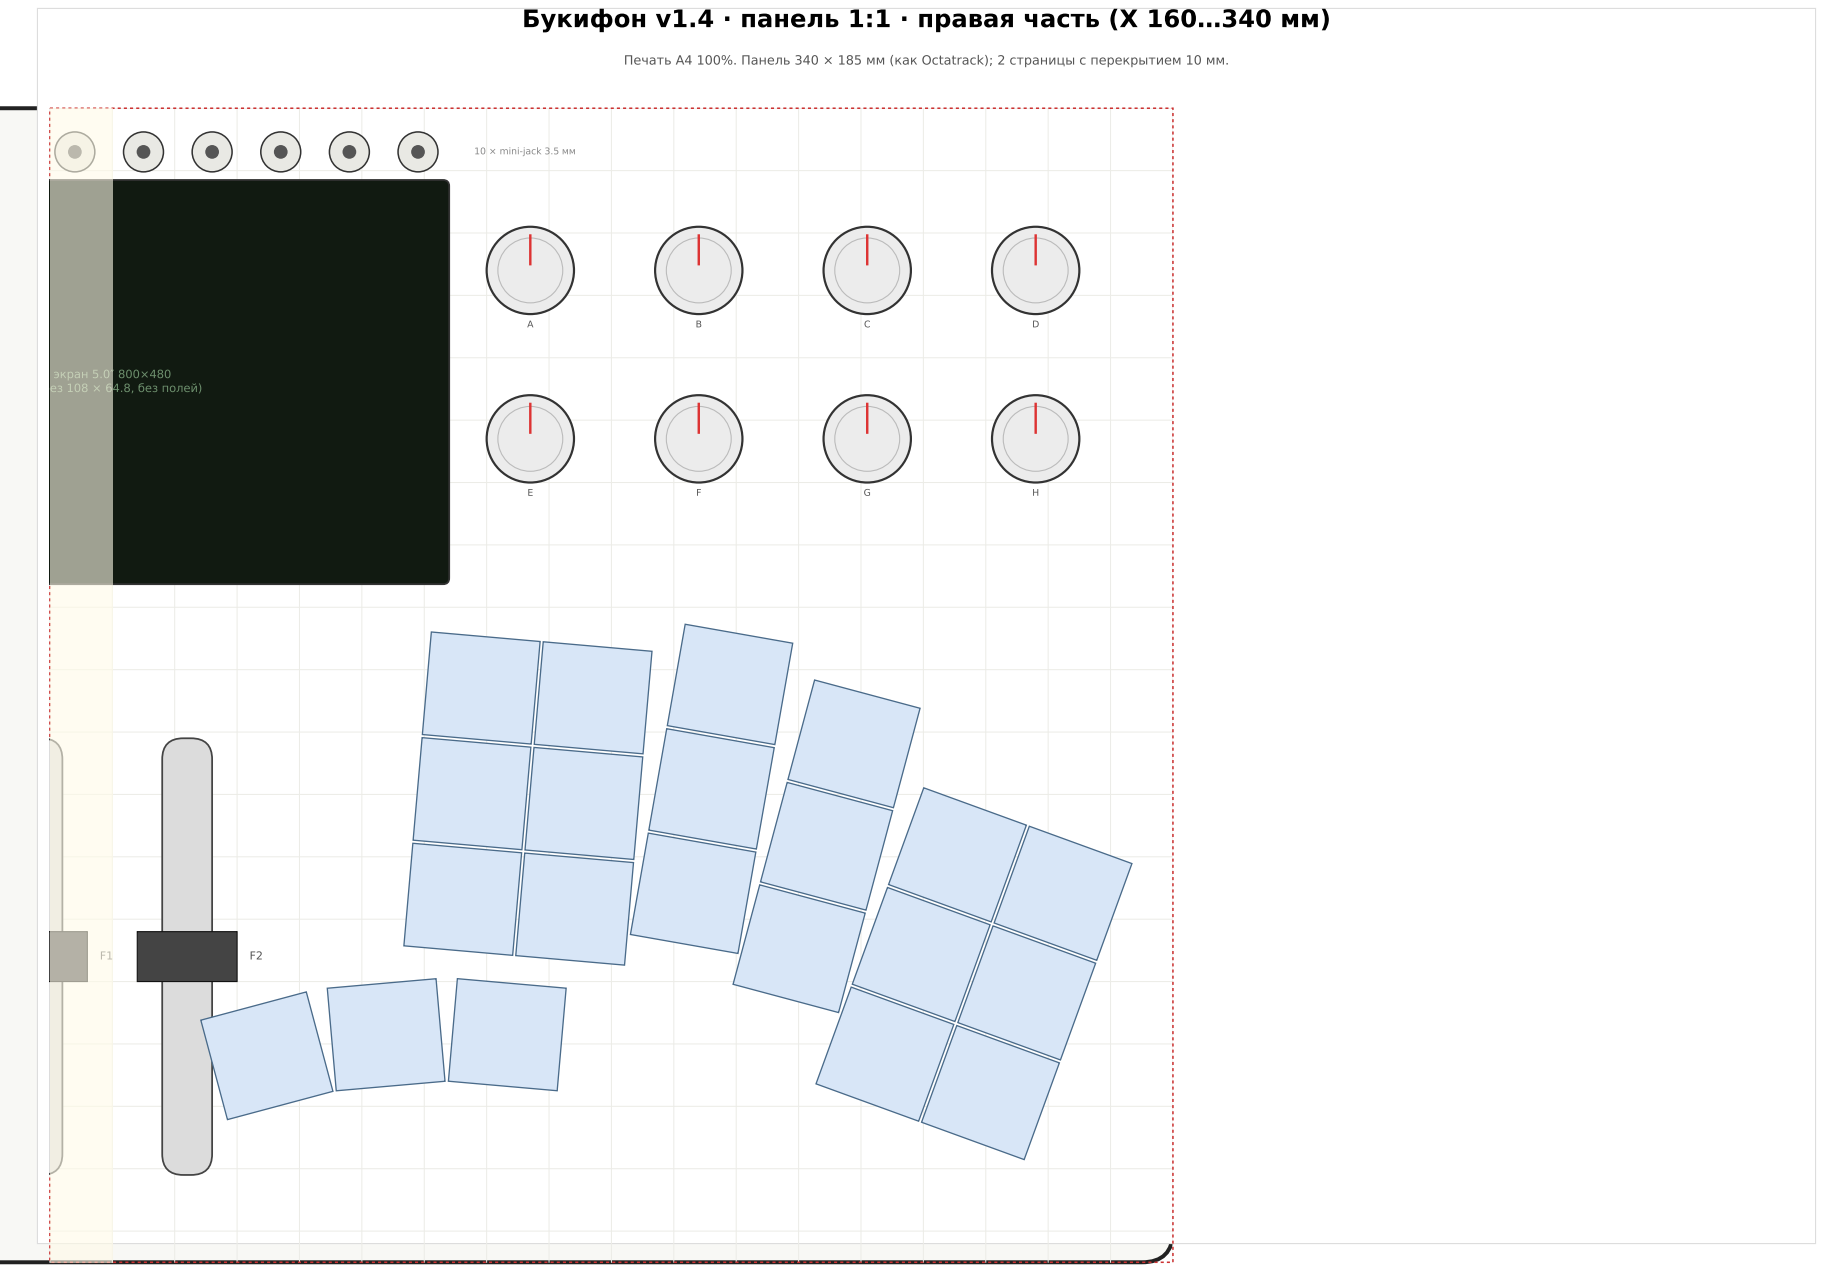
[picture p195: page 2]

Печать A4 100%. Панель 340 × 185 мм (как Octatrack); 2 страницы с перекрытием 10 мм.

10 × mini-jack 3.5 мм

экран 5.0″ 800×480
(вырез 108 × 64.8, без полей)
