martiyanov/bukifon/hardware/panel2/rev1/PANEL-2-right-rev1.kicad_pcb

## KiCad design hardware/panel2/rev1/PANEL-2-right-rev1.kicad_pcb (2026-11-06)

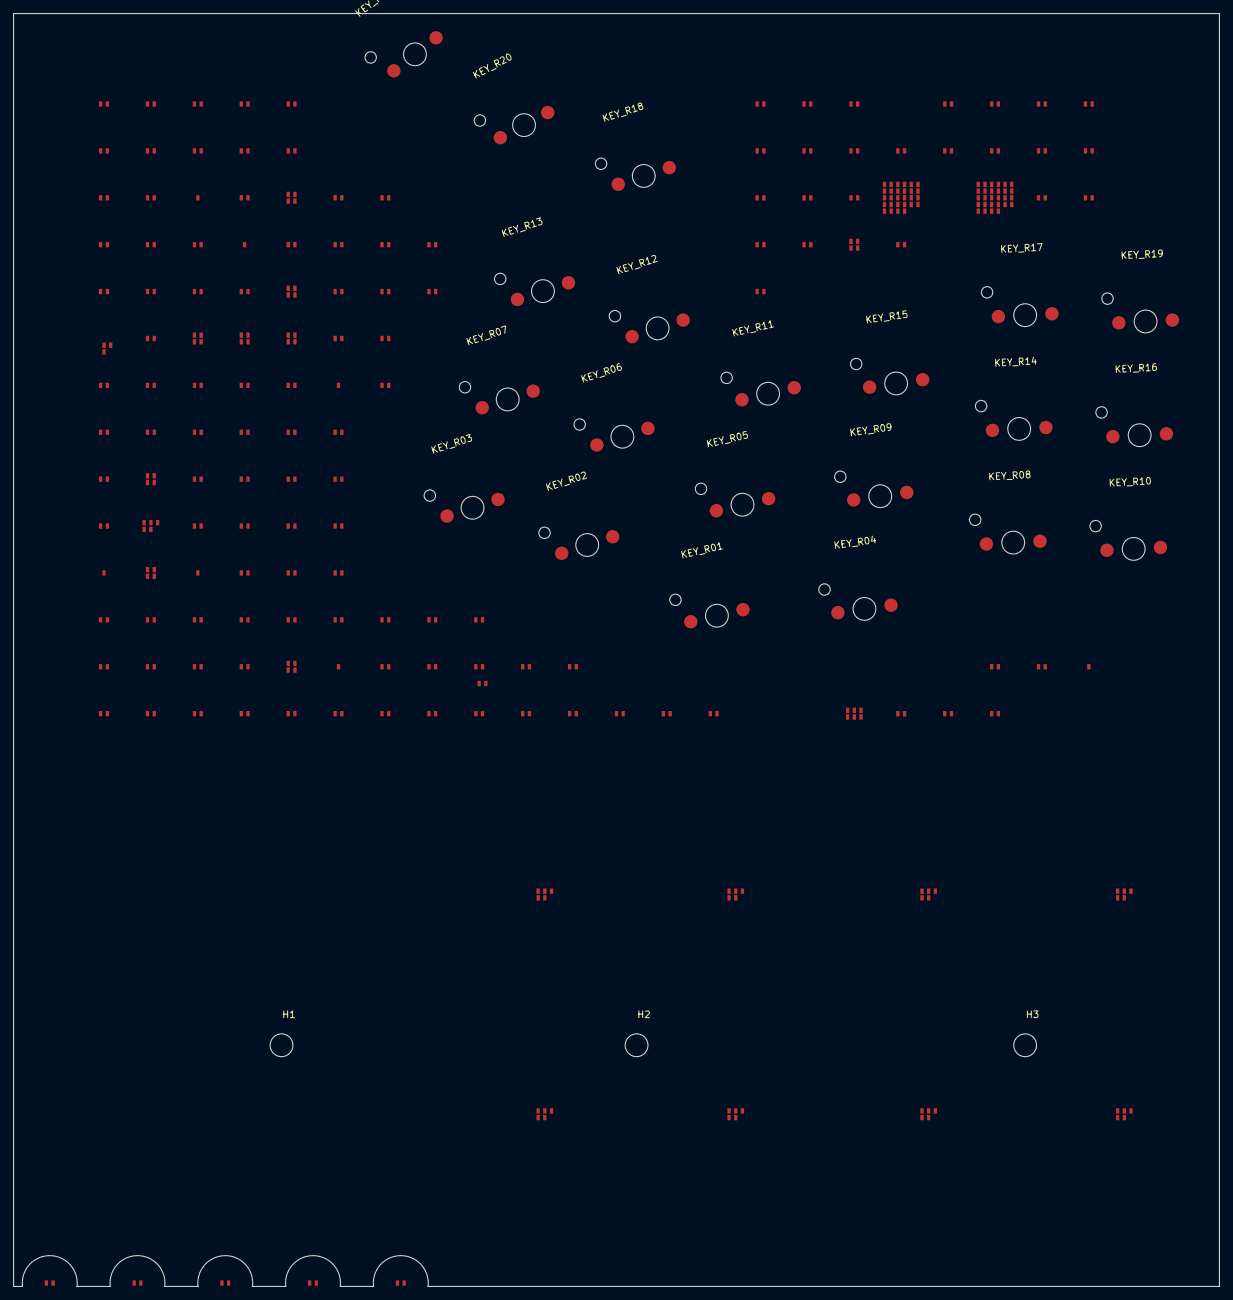
[picture p196: board PANEL-2-right-rev1.kicad_pcb from above]

Board: 4 copper layers, 180.0 x 190.0 mm, 177 parts (0 on the bottom side), 95 nets, no tracks yet.

Parts:
C2, C4, C5, C6, C10, C12, C14, C16, C18, C21, C23, C25, C27, C29, C30, C32, C34, C36, C38, C42, C44, C46, C48, C51, C54, C56, C58, C61, C63, C65, C67, C69, C70, C72, C80, C82: 100n; C_0603_1608Metric
D1, D3, D6, D8, D11, D13, D15, D17, D19, D20, D22, D24, D26, D28, D31, D33, D35, D37, D39, D40, D42: 1N4148; D_SOD-323
D45, D47: SMAJ12A; D_SMA
D49, D50: SMAJ15A; D_SMA
D52: SMAJ5.0A; D_SMA
ENC9, ENC10, ENC11, ENC12, ENC13, ENC14, ENC15, ENC16: EC11; RotaryEncoder_Alps_EC11E-Switch_Vertical_H20mm
F2: POT60; Potentiometer_Bourns_PTA6043_Single_Slide
FB1: FB; L_Bourns_SRN6045TA
H1, H2, H3: MountingHole; MountingHole_M3_3.4mm
J06, J07, J08, J09, J10: JACK; Jack_3.5mm_CUI_SJ1-3523N_Horizontal
KEY_R01, KEY_R02, KEY_R03, KEY_R04, KEY_R05, KEY_R06, KEY_R07, KEY_R08, KEY_R09, KEY_R10, KEY_R11, KEY_R12, KEY_R13, KEY_R14, KEY_R15, KEY_R16, KEY_R17, KEY_R18, KEY_R19, KEY_R20, KEY_R21: Kailh Choc v1 hot-swap; CHOC_V1
LED_ENC3, LED_ENC5, LED_ENC7, LED_ENC9, LED_ENC10, LED_ENC12, LED_ENC14, LED_ENC16: WS2812B-2020; LED_WS2812B-2020_PLCC4_2.0x2.0mm
LED_STATUS: WS2812B-2020; LED_WS2812B-2020_PLCC4_2.0x2.0mm
R2, R4, R6, R8, R9, R10, R14, R16, R18, R21, R23, R25, R27, R29, R30, R32, R34, R36, R38, R41, R43, R45, R47, R81, R83, R85, R87: 10k; R_0603_1608Metric
R49, R50, R52, R54, R56, R58, R61, R63, R65, R67, R69, R70, R72, R74, R76, R78, R94, R96, R105, R114: 1k; R_0603_1608Metric
R98, R101: 100R; R_0603_1608Metric
R103, R110: 4.7k; R_0603_1608Metric
R112: 0R; R_0603_1608Metric
R120: 100k; R_0603_1608Metric
R122, R124: 33R; R_0603_1608Metric
SW1: SW_SPST; SW_DIP_SPSTx01_Slide_6.7x4.1mm_W7.62mm_P2.54mm_LowProfile
TP2, TP4, TP6, TP8, TP10, TP36, TP38: TP; TestPoint_Pad_D1.0mm
U1, U3: MCP23017; SOIC-28W_7.5x17.9mm_P1.27mm
U5: 74LVC1G17; SOT-23-5
U8: ICS-43434; InvenSense_ICS-43434-6_3.5x2.65mm

Connections:
5V_LED: C56.1, C58.1, C61.1, C63.1, C65.1, C67.1, C69.1, C70.1, C72.1, LED_ENC3.4, LED_ENC5.4, LED_ENC7.4, LED_ENC9.4, LED_ENC10.4, LED_ENC12.4, LED_ENC14.4, LED_ENC16.4, LED_STATUS.4, TP6.1
+3V3: C34.1, C36.1, F2.1, R2.1, R4.1, R6.1, R8.1, R9.1, R10.1, R14.1, R16.1, R18.1, R21.1, R23.1, R25.1, R27.1, R29.1, R30.1, R32.1, R34.1, R36.1, R38.1, R41.1, R43.1, R45.1, R47.1, R81.1, R83.1, R85.1, R87.1, R110.1, SW1.1, U1.9, U3.9, U3.16, U5.5
COL1: D19.1, D31.1, D37.1, D40.1, R81.2
COL2: D8.1, D17.1, D35.1
COL3: D15.1, R83.2
COL4: D1.1, D11.1, D22.1, D26.1
COL5: D6.1, D33.1, R85.2
COL6: D3.1, D13.1, D24.1, D28.1
COL7: D20.1, D39.1, D42.1, R87.2
ENC1_A: R49.2, U1.21
ENC1_B: C2.1, R50.2, U1.1
ENC1_B_RAW: R2.2, R50.1
ENC2_B: C4.1, R52.2, U1.2
ENC2_B_RAW: R4.2, R52.1
ENC2_SW: R34.2, U3.22
ENC3_A: C5.1, U1.23
ENC3_B: C6.1, R54.2, U1.3
ENC3_B_RAW: R6.2, R54.1
ENC4_B: R56.2, U1.4
ENC4_B_RAW: R8.2, R56.1
ENC4_SW: R36.2, U3.24
ENC5_B: C10.1, R58.2, U1.5
ENC5_B_RAW: R10.2, R58.1
ENC6_B: C12.1, U1.6
ENC6_SW: R38.2, U3.26
ENC7_A: R61.2, U1.27
ENC7_B: C14.1, U1.7
ENC8_A: R63.2, U1.28
ENC8_B: C16.1, U1.8
ENC9_A_RAW: ENC9.A, R65.1
ENC9_B_RAW: ENC9.B, R18.2
ENC9_SW: ENC9.S1, R41.2, U3.1
ENC10_A_RAW: ENC10.A, R67.1
ENC10_SW: ENC10.S1, U3.2
ENC11_A: C21.1, R69.2
ENC11_A_RAW: ENC11.A, R21.2, R69.1
ENC11_B_RAW: ENC11.B, R70.1
ENC11_SW: ENC11.S1, R43.2, U3.3
ENC12_A_RAW: ENC12.A, R23.2
ENC12_B_RAW: ENC12.B, R72.1
ENC12_SW: ENC12.S1, U3.4
ENC13_A_RAW: ENC13.A, R25.2
ENC13_B_RAW: ENC13.B, R74.1
ENC13_SW: ENC13.S1, R45.2, U3.5
ENC14_A_RAW: ENC14.A, R27.2
ENC14_B_RAW: ENC14.B, R76.1
ENC14_SW: ENC14.S1, U3.6
ENC15_A_RAW: ENC15.A, R29.2
ENC15_B: C30.1, R78.2
ENC15_B_RAW: ENC15.B, R30.2, R78.1
ENC15_SW: ENC15.S1, R47.2, U3.7
ENC16_B_RAW: ENC16.B, R32.2
ENC16_SW: ENC16.S1, U3.8
FADER2: C54.1, R105.2
FADER2_RAW: F2.2, R105.1
GATE_IN_BUF: R114.1, U5.4
GATE_IN_RAW: C51.1, R103.2, U5.2
GND: C2.2, C4.2, C5.2, C6.2, C10.2, C12.2, C14.2, C16.2, C18.2, C21.2, C23.2, C25.2, C27.2, C29.2, C30.2, C32.2, C34.2, C36.2, C38.2, C72.2, C80.2, C82.2, ENC9.C, ENC9.S2, ENC10.C, ENC10.S2, ENC11.C, ENC11.S2, ENC12.C, ENC12.S2, ENC13.C, ENC13.S2, ENC14.C, ENC14.S2, ENC15.C, ENC15.S2, ENC16.C, ENC16.S2, R112.1, R120.2, U1.10, U1.15, U1.16, U1.17, U3.10, U3.15, U3.17, U5.3, U8.2, U8.3
GNDA: C42.2, C44.2, C46.2, C48.2, C51.2, C54.2, D45.2, D47.2, D49.2, D50.2, D52.2, F2.3, J06.S, J07.S, J08.S, J09.S, J10.S, R112.2, TP8.1
INT: U1.20, U3.20
K_L11_N: D11.2, KEY_R01.2
K_L13_N: D13.2, KEY_R04.2
K_L15_N: D15.2, KEY_R08.2
K_L17_N: D17.2, KEY_R13.2
K_L19_N: D19.2, KEY_R16.2
K_L20_N: D20.2, KEY_R19.2
K_R12_N: D33.2, KEY_R03.2
K_R14_N: D35.2, KEY_R07.2
K_R16_N: D37.2, KEY_R10.2
K_R18_N: D39.2, KEY_R15.2
K_R19_N: D40.2, KEY_R17.2
K_R21_N: D42.2, KEY_R20.2
LED_CH9: LED_ENC9.1, LED_ENC10.3
LED_CH16: LED_ENC16.1, LED_STATUS.3
LED_RET: C56.2, C58.2, C61.2, C63.2, C65.2, C67.2, C69.2, C70.2, LED_ENC3.2, LED_ENC5.2, LED_ENC7.2, LED_ENC9.2, LED_ENC10.2, LED_ENC12.2, LED_ENC14.2, LED_ENC16.2, LED_STATUS.2
MCP_RST: U1.18, U3.18
MIC_DATA: R124.1, TP38.1
MIC_DATA_M: R124.2, U8.6
MIC_VDD: C82.1, FB1.2, U8.5
MIC_VDD_SW: C80.1, FB1.1, R120.1, SW1.2
MIC_WS_M: R122.2, U8.1
ROW2: KEY_R06.1, KEY_R11.1, KEY_R19.1
ROW3: KEY_R01.1, KEY_R02.1, KEY_R04.1, KEY_R08.1, KEY_R13.1, KEY_R16.1, KEY_R21.1
ROW5: KEY_R07.1, KEY_R10.1, KEY_R18.1
ROW6: KEY_R03.1, KEY_R05.1, KEY_R09.1, KEY_R12.1, KEY_R17.1, KEY_R20.1
SCL: TP2.1, U1.12, U3.12
SDA: R110.2, U1.13, U3.13
TIP_CVIN1: C46.1, R98.1
TIP_CVIN2: D49.1, J06.T
TIP_CVIN3: C48.1, D50.1, J07.T
TIP_CVIN4: J08.T, R101.1
TIP_CVOUT1: C42.1, R94.2
TIP_CVOUT3: C44.1, R96.2
TIP_GATE_IN: J10.T, R103.1
TIP_GATE_OUT: D52.1, J09.T
