martiyanov/bukifon/hardware/power2/rev1/PWR-2-rev1.kicad_pcb

## KiCad design hardware/power2/rev1/PWR-2-rev1.kicad_pcb (2026-11-06)

Schematic: PWR-2.kicad_sch, PWR-2 PRE-FREEZE / DO NOT FABRICATE - battery + bus rails (…

Parts:
BT1, BT2: 18650 3.6V 3.5Ah; BatteryHolder_Keystone_1042_1x18650
C1, C2, C5, C8, C9, C12, C13, C14, C17, C20, C23, C24, C27, C28, C31, C32, C34, C35, C36, C37, C38, C39, C40: 100n; C_0805_2012Metric
C3, C6, C7, C25, C26: 22uF; C_1210_3225Metric
C4, C15: 1uF; C_0805_2012Metric
C10, C11, C21, C22: 47uF/25V; CP_Elec_6.3x7.7
C16, C18, C19: 22uF/25V; C_1210_3225Metric
C29, C30, C33: 47uF; CP_Elec_6.3x7.7
D1, D2, D5, D6: SMBJ5.0A; D_SMA
D3, D4: SMAJ15A; D_SMA
D7, D8: SS34; D_SMA
F1: 5 A; Fuse_1206_3216Metric
F2: 0.5 A; Fuse_1206_3216Metric
F3: 0.3 A; Fuse_1206_3216Metric
F4: 2 A; Fuse_1206_3216Metric
F5: 2.5 A; Fuse_1206_3216Metric
J1: PACK 3P; TerminalBlock_4Ucon_1x03_P3.50mm_Vertical
J2: SW panel; PinHeader_1x02_P2.54mm_Vertical
J3: J-PWR (IDC-20); IDC-Header_2x10_P2.54mm_Vertical
J4: J-CTRL (IDC-12); IDC-Header_2x06_P2.54mm_Vertical
L1: 10uH / 4A; L_Bourns_SRN6045TA
L2, L6: 4.7uH; L_Bourns_SRN6045TA
L3: 22uH / 2A; L_Bourns_SRN6045TA
L4: 10uH; L_Bourns_SRN6045TA
L5: 10uH / 6A; L_Bourns_SRN6045TA
Q1, Q4, Q5: AO3401A P-FET; SOT-23
Q2, Q3, Q7: AO3400A; SOT-23
Q6: MMBT3904; SOT-23
Q9, Q10: 2N7002; SOT-23
R1, R4, R5, R6, R8, R9, R14, R16, R22, R23, R25, R27, R29, R36, R37, R39: 100k; R_0603_1608Metric
R2, R33, R34, R35, R38: 100R; R_0603_1608Metric
R3, R13, R21, R28, R32: 1k; R_0603_1608Metric
R7, R20: 10k; R_0603_1608Metric
R10: 10R; R_0603_1608Metric
R11, R12: 22R; R_0603_1608Metric
R15: 11k; R_0603_1608Metric
R17, R24: 4.7k; R_0603_1608Metric
R19: 110k; R_0603_1608Metric
R26: 30.9k; R_0603_1608Metric
SW1: POWER OFF/ON
TH1: NTC 10k B3950
TP1: BATT_CELL_P; TestPoint_Pad_D1.5mm
TP2: VBAT; TestPoint_Pad_D1.5mm
TP3: VSYS_SW; TestPoint_Pad_D1.5mm
TP4: 12V_BUS; TestPoint_Pad_D1.5mm
TP5: N12_BUS; TestPoint_Pad_D1.5mm
TP6: 5V_BUS; TestPoint_Pad_D1.5mm
TP7: LED_RET; TestPoint_Pad_D1.5mm
TP8: PWR_GOOD; TestPoint_Pad_D1.5mm
TP9: PGND; TestPoint_Pad_D1.5mm
U1: BQ297xy; SOT-23-6
U2: MAX17048; SOT-23-6
U3, U6: TPS61088; QFN-20-1EP_3x3mm_P0.4mm_EP1.65x1.65mm
U4: LMR33630; SOIC-8_3.9x4.9mm_P1.27mm
U5: PC817; DIP-4_W7.62mm
U7: MCP130-270; SOT-23

Connections:
5V_BUS: C32.1, D5.1 (A1), F4.2, F5.1, J3.13, J3.14, R28.1, TP6.1
5V_F: C29.1, C30.1, C31.1, F4.1, L6.2
5V_LED: C33.1, C34.1, D6.1 (A1), F5.2, J3.17, R32.1
5V_SW: L6.1, R25.1, U6.10 (VOUT), U6.11 (VOUT)
12V_BUS: C13.1, D3.1 (A1), D7.1 (K), J3.5, J3.6, R17.1, TP4.1
12V_F: C10.1, C11.1, C12.1, F2.1, L2.2
12V_OG: D7.2 (A), F2.2
12V_SW: L2.1, R14.1, U3.10 (VOUT), U3.11 (VOUT)
BATT_BM: BT1.2 (-), BT2.2 (-), C1.2, D1.2 (A2), J1.2, Q1.1 (G), Q2.3 (D), R1.2, TH1.2, U1.4 (VSS)
BATT_CELL_P: BT1.1 (+), BT2.1 (+), F1.1, J1.1, R10.1, R13.1, TP1.1
BATT_MON: J4.1, R13.2
BMS_BAT: C1.1, R2.2, U1.5 (BAT)
BMS_MID: Q2.2 (S), Q3.2 (S), R4.2, R5.2
BOOT_N12: C14.1, U4.7 (BOOT)
CS_BMS: R3.1, U1.6 (V-)
EN5_IC: C38.1, Q10.3 (D), R27.2, U6.2 (EN)
EN12_IC: C35.1, Q9.3 (D), R16.2, U3.2 (EN)
EN_5V: C40.1, Q10.1 (G), R38.2, R39.1
EN_5V_C: J4.10, R38.1
EN_BUS12: Q9.1 (G), R33.2, R36.1
EN_BUS12_C: J4.7, R33.1
EN_LED5: C37.1, Q7.1 (G), R35.2, R37.1
EN_LED5_C: J4.9, R35.1
EN_N12: C36.1, R21.1, R22.1, R34.2
EN_N12_C: J4.8, R34.1
EN_N12_IC: C20.1, R23.1, U4.3 (EN), U5.4
FB_5: R25.2, R26.1, U6.4 (FB)
FB_12: R14.2, R15.1, U3.4 (FB)
FB_N12: R19.2, R20.1, U4.5 (FB)
FUEL_ALRT: J4.5, U2.5 (ALRT)
FUEL_SCL: R12.1, U2.4 (SCL)
FUEL_SCL_C: J4.4, R12.2
FUEL_SDA: R11.1, U2.3 (SDA)
FUEL_SDA_C: J4.3, R11.2
G_CHG: Q3.1 (G), R5.1, U1.2 (Cout)
G_DIS: Q2.1 (G), R4.1, U1.3 (Dout)
G_MASTER: C2.1, Q4.1 (G), Q5.1 (G), Q6.2 (C), R6.2
LED_RET: C39.1, J3.18, Q7.3 (D), R29.1, TP7.1
MASTER_SW: J2.2, R7.1, R9.1, SW1.2 (B)
N12_BUS: C24.2, D4.2 (A2), D8.2 (A), J3.9, J3.10, R24.1, TP5.1
N12_F: C21.2, C22.2, C23.2, F3.1, L4.2
N12_OG: D8.1 (K), F3.2
N12_SW: C15.2, C16.2, C17.2, C18.2, C19.2, C20.2, L4.1, R20.2, U4.1 (GND), U4.9 (GND), U5.3
NTC_PACK: J1.3, J4.2, TH1.1
OPT_ANODE: R21.2, U5.1
PACK_F: D1.1 (A1), F1.2, Q1.3 (D)
PGND: C3.2, C4.2, C5.2, C6.2, C7.2, C8.2, C9.2, C10.2, C11.2, C12.2, C13.2, C18.1, C19.1, C21.1, C22.1, C23.1, C24.1, C25.2, C26.2, C27.2, C28.2, C29.2, C30.2, C31.2, C32.2, C33.2, C34.2, C35.2, C36.2, C37.2, C38.2, C39.2, C40.2, D2.2 (A2), D3.2 (A2), D4.1 (A1), D5.2 (A2), D6.2 (A2), J3.7, J3.8, J3.11, J3.12, J3.15, J3.16, J3.19, J3.20, J4.11, J4.12, L3.2, Q3.3 (D), Q6.3 (E), Q7.2 (S), Q9.2 (S), Q10.2 (S), R3.2, R8.2, R9.2, R15.2, R17.2, R19.1, R22.2, R24.2, R26.2, R28.2, R29.2, R32.2, R36.2, R37.2, R39.2, TP9.1, U2.2 (GND), U2.6 (QSTRT), U3.5 (MODE), U3.6 (GND), U3.7 (PGND), U3.12 (AGND), U3.13 (EP), U5.2, U6.5 (MODE), U6.6 (GND), U6.7 (PGND), U6.12 (AGND), U6.13 (EP), U7.3 (VSS)
PWR_GOOD: J4.6, TP8.1, U7.1 (~RST)
Q6_B: Q6.1 (B), R7.2, R8.1
SS_5: C28.1, U6.3 (SS)
SS_12: C9.1, U3.3 (SS)
SW_5: L5.2, U6.8 (SW), U6.9 (SW)
SW_12: L1.2, U3.8 (SW), U3.9 (SW)
SW_N12: C14.2, L3.1, U4.8 (SW)
VBAT: J3.3, J3.4, Q1.2 (S), R1.1, R2.1, TP2.1
VCC_N12: C15.1, U4.6 (VCC)
VGAUGE: C4.1, C5.1, R10.2, U2.1 (VDD)
VSYS: C2.2, J2.1, J3.1, J3.2, Q4.2 (S), R6.1, SW1.1 (A)
VSYS_MID: Q4.3 (D), Q5.2 (S)
VSYS_SW: C3.1, C6.1, C7.1, C8.1, C16.1, C17.1, C25.1, C26.1, C27.1, D2.1 (A1), L1.1, L5.1, Q5.3 (D), R16.1, R23.2, R27.1, TP3.1, U3.1 (VIN), U4.2 (VIN), U6.1 (VIN), U7.2 (VDD)

Notes on the sheet:
PRE-FREEZE / DO NOT FABRICATE
PWR-2 rev.1 research schematic - 1S2P 18650 + BMS + MAX17048 + TPS61088/+12 V + LMR33630 IBB/-12 V + TPS61088/+5 V.
Charger/power-path (BQ24074) stays on CORE-2: PWR-2 converters are fed ONLY by VSYS (BQ24074 OUT). No MC34063, no charge pump.
Docs: README.md, power-tree-pwr2.md, interfaces.md, docs/schema/pwr2.md
PACK 1S2P: 2x18650 parallel, J1 pack, F1 5 A, Q1 reverse-FET, D1 TVS, TH1 NTC
BMS 1S: BQ297xy + 2x AO3400A (common source), OVP/UVP/OCP/SCP; VBAT = P+ -> BQ24074 BAT
MASTER LOAD SWITCH: back-to-back AO3401A, MMBT3904 high-side driver, panel switch J2/SW1, TVS
FUEL GAUGE MAX17048 (I2C 0x36) + Kelvin sense at the cell + analog backup BATT_MON
BUS +12 V: TPS61088 sync boost 12.15 V -> C-L-C pi-filter -> polyfuse 0.5 A -> TVS (budget 330 mA)
BUS -12 V: LMR33630 IBB (GND МС = -12 V, VIN = VSYS+12 V) + opto EN -> pi-filter -> polyfuse 0.3 A (budget 95 mA)
LOGIC/AUDIO +5 V: TPS61088 sync boost 5.10 V -> pi-filter -> polyfuse 2 A (budget 1.0 A)
LED BRANCH: polyfuse 2.5 A + AO3400A low-side switch on the LED return (EN_LED5, OFF by default)
SUPERVISOR + EN INPUTS: MCP130-270 (PWR_GOOD open-drain), 100R/100n EN filters (3.3 V-safe)
INTERFACE: J3 IDC-20 (VSYS/VBAT/+12/-12/+5/5V_LED/LED_RET/pairs), J4 IDC-12 (sense/I2C/status/EN)
TEST POINTS TP1..TP9
POWER FLAGS (net drivers for ERC)

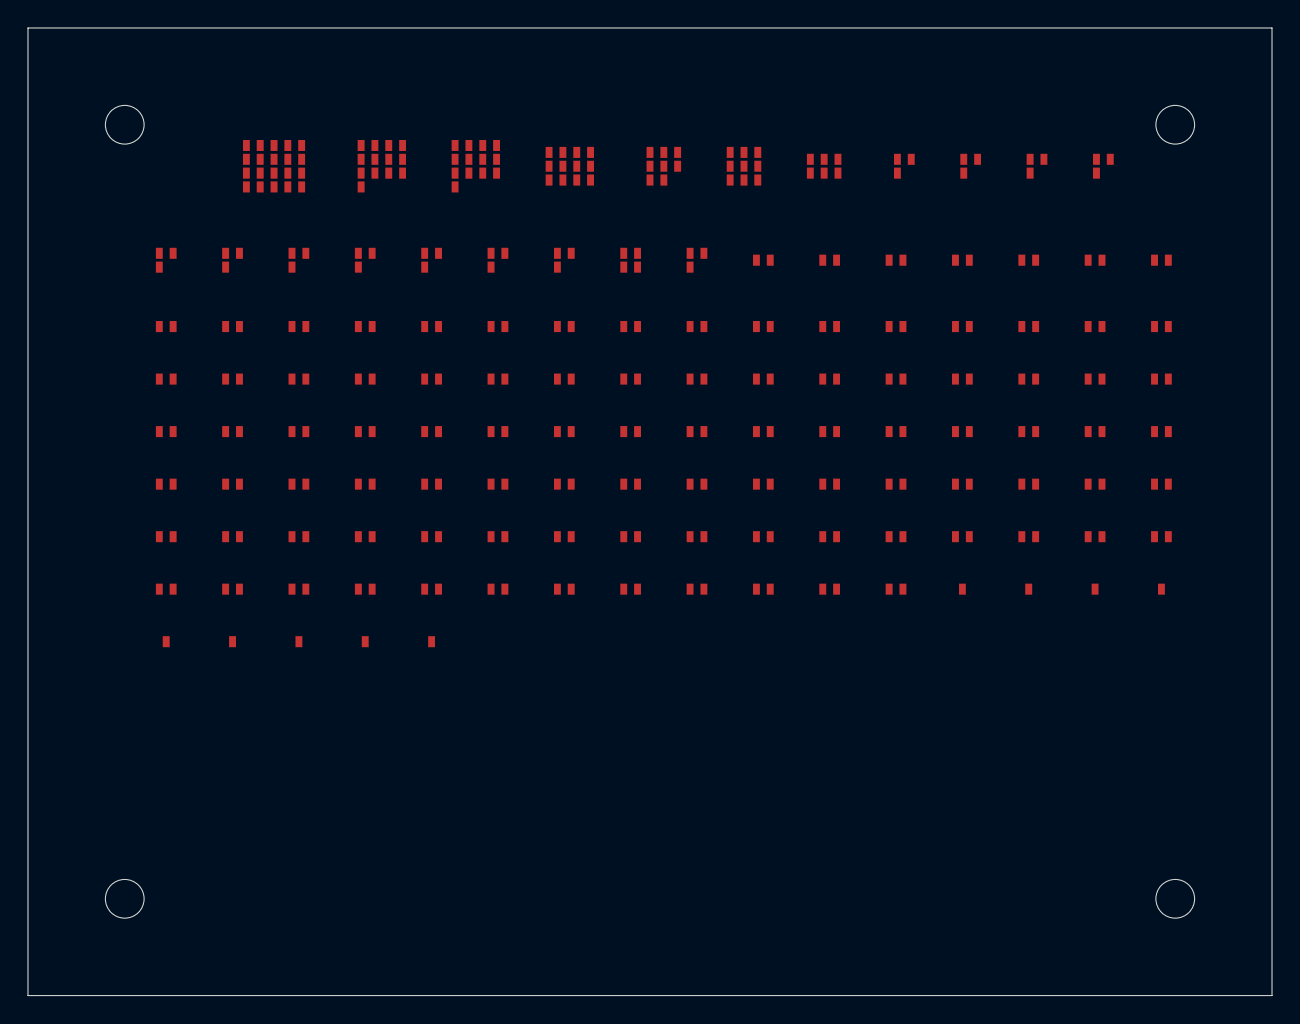
[picture p198: board PWR-2-rev1.kicad_pcb from above]

Board: 4 copper layers, 90.0 x 70.0 mm, 132 parts (0 on the bottom side), 60 nets, no tracks yet.

Other parts of the board:
H1, H2, H3, H4: MountingHole; MountingHole_M2.5_2.8mm
