martiyanov/bukifon/hardware/core/CORE-1.kicad_sch

## KiCad design hardware/core/CORE-1.kicad_sch (2026-11-05)

Schematic: CORE-1.kicad_sch

Parts:
A1: Raspberry Pi Pico (RP2040); RaspberryPi_Pico_SMD
C1: 1000uF/25V; CP_Elec_6.3x7.7
C2, C3, C10: 100nF/50V; C_0805_2012Metric
C4, C14: 100uF/10V; CP_Elec_6.3x7.7
C5: 100nF/25V; C_0805_2012Metric
C6, C7, C27: 1uF/10V; C_0805_2012Metric
C8, C16, C18, C20, C21, C23, C25, C26, C29, C30, C31, C32, C34, C40, C41, C43, C44, C47, C48, C49, C50, C51, C54, C55, C56, C57, C58, C60, C62, C63: 100nF; C_0805_2012Metric
C9: 220uF/25V; CP_Elec_6.3x7.7
C11, C12, C13: 100uF/25V; CP_Elec_6.3x7.7
C15, C17, C19, C22, C24, C33, C61: 10uF/10V; C_0805_2012Metric
C28: 1uF/10V; CP_Elec_6.3x7.7
C35, C36, C42: 10uF/16V; CP_Elec_6.3x7.7
C37, C38, C39, C45, C46: 100pF; C_0805_2012Metric
C59: 1.5nF; C_0805_2012Metric
D1, D3, D4: SS34; D_SMA
D2: SMAJ15A; D_SMA
D5, D6, D7, D9, D10, D11, D12, D13, D14, D17, D18: BAT54S; SOT-23
F1: 2A; Fuse_1206_3216Metric
FB1, FB2, FB3, FB4, FB5: 600R@100MHz; L_0805_2012Metric
J1: LINE OUT 3.5mm stereo
J2: PHONES 3.5mm stereo
J5: CV OUT 1 (CV5)
J6: CV OUT 2 (CV6)
J7: CV IN 1
J8: CV IN 2
J9: GATE 1
J10: GATE 2
J11: MIDI IN (TRS-A)
J12: MIDI OUT (TRS-A)
J13: Pico SWD pads
J14: DC 5.5/2.1 12V
J15: IDC-32 to PANEL-1
J16: SWD; PinHeader_1x03_P2.54mm_Vertical
L1: 220uH/0.5A; L_1210_3225Metric
NT1: AGND=DGND; NetTie-2_SMD_Pad0.5mm
NT2: DGND=PGND; NetTie-2_SMD_Pad0.5mm
P1: Bukifon Bus IDC-26 PORT1; IDC-Header_2x13_P2.54mm_Latch_Vertical
P2: Bukifon Bus IDC-26 PORT2; IDC-Header_2x13_P2.54mm_Latch_Vertical
P3: Bukifon Bus IDC-26 PORT3; IDC-Header_2x13_P2.54mm_Latch_Vertical
Q1, Q2: 2N7000; TO-92_Inline
Q3: 2N7002; SOT-23
R1, R17, R18, R19, R36, R37, R38, R39, R72, R73, R79, R80: 10k; R_0805_2012Metric
R2: 330; R_0805_2012Metric
R3, R4, R6, R11, R14: 4.7k; R_0805_2012Metric
R5, R8: 220; R_0805_2012Metric
R7: 33; R_0805_2012Metric
R9, R12, R15, R20, R21, R22, R29, R40, R41, R42, R43, R48, R49, R64, R65, R66, R69, R81, R82: 1k; R_0805_2012Metric
R10, R13, R16, R44, R46: 100k; R_0805_2012Metric
R23, R24, R25, R26, R27, R28, R70, R71: 22k; R_0805_2012Metric
R30, R31: 100; R_0805_2012Metric
R32, R33, R34, R35, R77, R78: 39k; R_0805_2012Metric
R45, R47: 16.5k; R_0805_2012Metric
R50, R51: 47k; R_0805_2012Metric
R67: 12k; R_0805_2012Metric
R68: 18k; R_0805_2012Metric
R74: 0.33; R_0805_2012Metric
R75: 33k; R_0805_2012Metric
R76: 3.9k; R_0805_2012Metric
RP1: 10k log dual
SW1: POWER
SW2: RESET
TB1: Jacks: LINE/PHONES/CV1/CV2/CVIN1; TerminalBlock_Phoenix_MKDS-1-12-3.81_1x12_P3.81mm_Horizontal
TB2: Jacks: CVIN2/GATE/MIDI; TerminalBlock_Phoenix_MKDS-1-12-3.81_1x12_P3.81mm_Horizontal
U1: MP1584 5.1V/3A
U2: AP2112K-3.3; SOT-23-5
U3: MC34063; DIP-8_W7.62mm
U4: MCP4728A0-E/UN (0x60); MSOP-10_3x3mm_P0.5mm
U5: 24LC32; DIP-8_W7.62mm
U6: MCP3208; DIP-16_W7.62mm
U7: 6N137; DIP-8_W7.62mm
U8: 74HCT125; SOIC-14_3.9x8.7mm_P1.27mm
U9: PCM5102A; TSSOP-20_4.4x6.5mm_P0.65mm
U10, U12, U13, U17: TL074; DIP-14_W7.62mm
U11: TL072; DIP-8_W7.62mm
U16: MCP4728A1-E/UN (0x61); MSOP-10_3x3mm_P0.5mm

Connections:
3V3: A1.35 (ADC_VREF), C7.1, C8.1, C16.1, C17.1, C18.1, C21.1, C22.1, C23.1, C26.1, C30.1, C31.1, C32.1, C33.1, C60.1, C61.1, D13.2 (K), D14.2 (K), FB4.1, FB5.1, J15.1, R1.1, R3.1, R4.1, R6.1, R17.1, R50.1, U2.5 (VOUT), U4.1 (VDD), U5.1 (A0), U5.2 (A1), U5.3 (A2), U5.8 (VCC), U6.16 (Vdd), U9.1 (CPVDD), U9.8 (AVDD), U9.20 (DVDD), U16.1 (VDD)
3V3_B: C15.1, FB4.2, P1.7, P2.7, P3.7
5V: C4.1, C5.1, C6.1, D4.2 (A), FB3.1, J15.23, R8.1, R67.1, U1.3 (OUT+), U2.1 (VIN), U2.3 (EN), U7.7 (EN), U7.8 (VCC), U8.4 (2OE), U8.10 (3OE), U8.13 (4OE), U8.14 (VCC)
5V_B: C14.1, FB3.2, P1.5, P2.5, P3.5, R11.1, R14.1
12V: C3.1, C10.1, C11.1, C40.1, C43.1, C50.1, C62.1, D1.1 (K), D5.2 (K), D6.2 (K), D7.2 (K), D9.2 (K), D10.2 (K), D11.2 (K), D12.2 (K), D17.2 (K), D18.2 (K), FB1.1, R74.1, U1.1 (IN+), U3.6 (Vin), U10.4 (V+), U11.8 (V+), U12.4 (V+), U13.4 (V+), U17.4 (V+)
12V_B: C12.1, FB1.2, P1.1, P2.1, P3.1
12V_F: C1.1, C2.1, D1.2 (A), D2.1 (A1), F1.2
12V_J: J14.1, SW1.1 (A)
12V_SW: F1.1, SW1.2 (B)
-12V: C9.2, C10.2, C41.1, C44.1, C51.1, C59.2, C63.1, D5.1 (A), D6.1 (A), D7.1 (A), FB2.1, L1.2, R76.2, U3.4 (GND), U10.11 (V-), U11.4 (V-), U12.11 (V-), U13.11 (V-), U17.11 (V-)
-12V_B: C13.2, FB2.2, P1.3, P2.3, P3.3
ADC_CS: A1.7 (GPIO5), U6.10 (~CS/SHDN)
AGND: A1.33 (AGND), C18.2, C21.2, C22.2, C24.2, C25.2, C26.2, C28.1, C29.2, C30.2, C32.2, C33.2, C34.2, C37.2, C38.2, C39.2, C40.2, C41.2, C43.2, C44.2, C45.2, C46.2, C47.2, C48.2, C49.2, C50.2, C51.2, C54.2, C55.2, C56.2, C57.2, C58.2, C60.2, C61.2, C62.2, C63.2, D9.1 (A), D10.1 (A), D11.1 (A), D12.1 (A), D13.1 (A), D14.1 (A), D17.1 (A), D18.1 (A), J1.S, J2.S, J5.S, J6.S, J7.S, J8.S, J9.S, J10.S, J15.26, J15.28, J15.30, NT1.1, P1.10, P1.12, P1.14, P1.16, P2.10, P2.12, P2.14, P2.16, P3.10, P3.12, P3.14, P3.16, R36.2, R37.2, R38.2, R39.2, R51.2, R68.2, R73.2, R79.2, R80.2, RP1.3 (A2), RP1.6 (B2), TB1.3, TB1.6, TB1.8, TB1.10, TB1.12, TB2.2, TB2.4, TB2.6, U4.10 (VSS), U6.5 (CH4), U6.6 (CH5), U6.14 (AGND), U9.3 (CPGND), U9.9 (AGND), U10.3 (+), U10.5 (+), U10.12 (+), U13.12 (+), U16.10 (VSS), U17.10 (+), U17.12 (+)
AUDC0: C37.1, D5.3 (COM), R20.2, R23.1, R24.1
AUDC1: C38.1, D6.3 (COM), R21.2, R25.1, R26.1
AUDC2: C39.1, D7.3 (COM), R22.2, R27.1, R28.1
AUDIN_B: R29.1, U10.8, U10.9 (-)
AUDIN_C: C42.2, R72.1
AUDIN_D: R72.2, R73.1, U10.10 (+)
AUDL_BUF: R30.1, U11.1, U11.2 (-)
AUDL_OUT: C45.1, J1.T, J2.T, R30.2, TB1.1, TB1.4
AUDL_POT: RP1.2 (AW), U11.3 (+)
AUDL_SUM: R70.1, RP1.1 (A1), U10.1
AUDR_BUF: R31.1, U11.6 (-), U11.7
AUDR_OUT: C46.1, J1.R, J2.R, R31.2, TB1.2, TB1.5
AUDR_POT: RP1.5 (BW), U11.5 (+)
AUDR_SUM: R71.1, RP1.4 (B1), U10.7
AUD_IN: P1.19, P2.19, P3.19, R29.2
AUD_L_IN: C35.2, R18.1
AUD_P0: P1.20, R20.1
AUD_P1: P2.20, R21.1
AUD_P2: P3.20, R22.1
AUD_R_IN: C36.2, R19.1
CP_M: C27.2, U9.4 (CAPM)
CP_P: C27.1, U9.2 (CAPP)
CV1: D9.3 (COM), P1.9, P2.9, P3.9, R40.2
CV2: D10.3 (COM), P1.11, P2.11, P3.11, R41.2
CV3: D11.3 (COM), P1.13, P2.13, P3.13, R42.2
CV4: D12.3 (COM), P1.15, P2.15, P3.15, R43.2
CV5: D17.3 (COM), J5.T, R81.2, TB1.7
CV6: D18.3 (COM), J6.T, R82.2, TB1.9
CVIN1_ADC: C47.1, D13.3 (COM), R48.2, U6.3 (CH2)
CVIN1_IN: J7.T, R44.1, TB1.11
CVIN1_N: R44.2, R45.1, U13.2 (-)
CVIN1_RAW: R45.2, R48.1, U13.1
CVIN2_ADC: C48.1, D14.3 (COM), R49.2, U6.4 (CH3)
CVIN2_IN: J8.T, R46.1, TB2.1
CVIN2_N: R46.2, R47.1, U13.6 (-)
CVIN2_RAW: R47.2, R49.1, U13.7
CVR0: R32.2, R40.1, U12.1
CVR1: R33.2, R41.1, U12.7
CVR2: R34.2, R42.1, U12.8
CVR3: R35.2, R43.1, U12.14
CVR4: R77.2, R81.1, U17.1
CVR5: R78.2, R82.1, U17.7
CVREF: C49.1, R50.2, R51.1, U13.10 (+)
CVREF_B: U13.3 (+), U13.5 (+), U13.8, U13.9 (-)
CVS0: R32.1, R36.1, U12.2 (-)
CVS1: R33.1, R37.1, U12.6 (-)
CVS2: R34.1, R38.1, U12.9 (-)
CVS3: R35.1, R39.1, U12.13 (-)
CVS4: R77.1, R79.1, U17.2 (-)
CVS5: R78.1, R80.1, U17.6 (-)
DAC_A: U4.6 (VOUTA), U12.3 (+)
DAC_B: U4.7 (VOUTB), U12.5 (+)
DAC_C: U4.8 (VOUTC), U12.10 (+)
DAC_D: U4.9 (VOUTD), U12.12 (+)
DAC_E: U16.6 (VOUTA), U17.3 (+)
DAC_F: U16.7 (VOUTB), U17.5 (+)
DAC_L: C35.1, C42.1, U9.6 (OUTL)
DAC_R: C36.1, U9.7 (OUTR)
DECK_ID: A1.32 (GPIO27_ADC1), C58.1, R69.2
DECK_ID_IN: J15.31, R69.1
DECK_INT: A1.34 (GPIO28_ADC2), J15.19
DGND: A1.3 (GND), A1.8 (GND), A1.13 (GND), A1.18 (GND), A1.23 (GND), A1.28 (GND), A1.38 (GND), C6.2, C7.2, C8.2, C15.2, C16.2, C17.2, C19.2, C20.2, C23.2, C31.2, J11.S, J12.S, J13.3 (GND), J15.2, J15.4, J15.6, J15.8, J15.12, J15.14, J15.16, J15.18, J15.24, J15.32, J16.3, NT1.2, NT2.1, P1.2, P1.4, P1.6, P1.8, P2.2, P2.4, P2.6, P2.8, P3.2, P3.4, P3.6, P3.8, Q1.1 (S), Q2.1 (S), Q3.2 (S), R10.2, R13.2, R16.2, SW2.2, TB2.9, TB2.12, U2.2 (GND), U4.4 (~LDAC), U5.4 (GND), U5.7 (WP), U6.9 (DGND), U7.5 (GND), U8.1 (1OE), U8.5 (2A), U8.7 (GND), U8.9 (3A), U8.12 (4A), U9.10 (DEMP), U9.11 (FLT), U9.12 (SCK), U9.16 (FMT), U9.19 (DGND), U16.4 (~LDAC)
FSR_ADC: C56.1, R66.2, U6.7 (CH6)
FSR_IN: J15.29, R66.1
G1: Q1.2 (G), R9.2, R10.1
G2: Q2.2 (G), R12.2, R13.1
GATE1: J9.T, P1.17, P2.17, P3.17, Q1.3 (D), R11.2, TB2.3
GATE1_G: A1.29 (GPIO22), R9.1
GATE2: J10.T, P1.18, P2.18, P3.18, Q2.3 (D), R14.2, TB2.5
GATE2_G: A1.31 (GPIO26_ADC0), R12.1
HC165_PL: A1.9 (GPIO6), J15.17
I2C_SCL: A1.12 (GPIO9), J15.22, P1.22, P2.22, P3.22, R4.2, U4.2 (SCL), U5.6 (SCL), U16.2 (SCL)
I2C_SDA: A1.11 (GPIO8), J15.21, P1.21, P2.21, P3.21, R3.2, U4.3 (SDA), U5.5 (SDA), U16.3 (SDA)
I2S_BCK: A1.21 (GPIO16), U9.13 (BCK)
I2S_DIN: A1.24 (GPIO18), U9.14 (DIN)
I2S_LRCK: A1.22 (GPIO17), U9.15 (LRCK)
LCD_BL: J15.11, Q3.3 (D)
LCD_BL_G: Q3.1 (G), R15.2, R16.1
LCD_BL_P: A1.20 (GPIO15), R15.1
LCD_CS: A1.16 (GPIO12), J15.7
LCD_DC: A1.17 (GPIO13), J15.9
LCD_RST: A1.19 (GPIO14), J15.10
LDOO: C29.1, U9.18 (LDOO)
LED_DATA: J15.20, R2.2
LED_G: A1.10 (GPIO7), R2.1
MC_A: R74.2, U3.1 (SwC), U3.7 (Ipk), U3.8 (DC)
MC_FB: R75.2, R76.1, U3.5 (Vfb)
MC_SW: D3.1 (K), L1.1, U3.2 (SwE)
MC_TC: C59.1, U3.3 (TC)
MIDI_A: R5.2, U7.2 (A)
MIDI_DRV: R7.1, U8.3 (1Y)
MIDI_IN_R: J11.R, R5.1, TB2.8
MIDI_IN_T: J11.T, TB2.7, U7.3 (C)
MIDI_OUT_R: J12.R, R8.2, TB2.11
MIDI_OUT_T: J12.T, R7.2, TB2.10
PGND: C1.2, C2.2, C3.2, C4.2, C5.2, C9.1, C11.2, C12.2, C13.1, C14.2, D2.2 (A2), D3.2 (A), J14.2, NT2.2, R75.1, U1.2 (IN-), U1.4 (OUT-)
PORT0_CS: A1.25 (GPIO19), P1.26
PORT1_CS: A1.26 (GPIO20), P2.26
PORT2_CS: A1.27 (GPIO21), P3.26
RUN: A1.30 (RUN), C20.1, R1.2, SW2.1
SL1_ADC: C54.1, R64.2, U6.1 (CH0)
SL1_IN: J15.25, R64.1
SL2_ADC: C55.1, R65.2, U6.2 (CH1)
SL2_IN: J15.27, R65.1
SPARE_A: U10.13 (-), U10.14
SPARE_B: U13.13 (-), U13.14
SPARE_C: U17.8, U17.9 (-)
SPARE_D: U17.13 (-), U17.14
SPI1_MOSI: A1.15 (GPIO11), J15.5
SPI1_SCK: A1.14 (GPIO10), J15.3
SPI_MISO: A1.6 (GPIO4), J15.15, P1.25, P2.25, P3.25, U6.12 (Dout)
SPI_MOSI: A1.5 (GPIO3), P1.24, P2.24, P3.24, U6.11 (Din)
SPI_SCK: A1.4 (GPIO2), J15.13, P1.23, P2.23, P3.23, U6.13 (CLK)
SUML: R18.2, R23.2, R25.2, R27.2, R70.2, U10.2 (-)
SUMR: R19.2, R24.2, R26.2, R28.2, R71.2, U10.6 (-)
SWCLK: J13.2 (SWCLK), J16.2
SWDIO: J13.1 (SWDIO), J16.1
SYS_MON: C57.1, R67.2, R68.1, U6.8 (CH7)
UART_RX: A1.2 (GPIO1), R6.2, U7.6 (VO)
UART_TX: A1.1 (GPIO0), U8.2 (1A)
VNEG: C28.2, U9.5 (VNEG)
VREF33: C24.1, C25.1, FB5.2, U6.15 (Vref)
VSYS: A1.39 (VSYS), C19.1, D4.1 (K)
XSMT: C34.1, R17.2, U9.17 (XSMT)

Notes on the sheet:
POWER: 12V input, +5.1V, +3.3V, -12V, filters, star GND
DIGITAL: Pico, I2C DAC/EEPROM, SPI ADC, MIDI, gates
AUDIO: PCM5102A, TL074 summer, MASTER VOL, TL072, LINE/PHONES
CV: MCP4728 buffers x4.9 (TL074), CV IN +/-10V level shift
PANEL/TERMINALS: IDC-32, jack terminal blocks, SWD
PORTS: P0/P1/P2 (IDC-26) Bukifon bus
POWER FLAGS (net drivers for ERC)
