martiyanov/bukifon/hardware/cores3/CORE-S3.kicad_sch

## KiCad design hardware/cores3/CORE-S3.kicad_sch (2026-11-05)

Schematic: CORE-S3.kicad_sch

Parts:
A1: ESP32-S3-WROOM-1-N16R8 (16 MB flash, 8 MB octal P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
C1, C4, C6, C32, C41, C48, C49, C57, C63, C82, C84, C94, C122: 10uF/10V; C_0805_2012Metric
C2: 100nF/16V; C_0805_2012Metric
C3, C5, C7, C42, C43, C44, C45, C46, C47, C51, C52, C56, C60, C61, C62, C64, C65, C68, C69, C73, C75, C76, C81, C83, C85, C86, C87, C88, C89, C90, C91, C92, C93, C95, C96, C97, C98, C101, C102, C103, C115, C116, C118, C119, C120, C121, C126: 100nF; C_0805_2012Metric
C31, C70, C71, C77, C79, C125: 100pF; C_0805_2012Metric
C33: 10uF/35V; C_0805_2012Metric
C34, C104, C106, C107, C109, C111, C113: 100nF/50V; C_0805_2012Metric
C38, C110, C112: 100uF/25V; CP_Elec_6.3x7.7
C39: 220uF/25V; CP_Elec_6.3x7.7
C40, C114, C117: 100uF/10V; CP_Elec_6.3x7.7
C58: 1uF/10V; C_0805_2012Metric
C59: 1uF/10V; CP_Elec_6.3x7.7
C66, C67: 10uF/16V; CP_Elec_6.3x7.7
C72, C74: 10uF/10V; CP_Elec_6.3x7.7
C78, C80: 1uF/16V; C_0805_2012Metric
C105, C108: 10uF/25V; CP_Elec_6.3x7.7
C123: 22uF/6.3V; CP_Elec_6.3x7.7
C124: 22uF/6.3V; C_0805_2012Metric
D1: SMAJ5.0A; D_SMA
D2, D7, D18, D19, D21, D22, D28: SS34; D_SMA
D3: CHG; C_0805_2012Metric
D8, D9, D10, D11, D12, D13, D14, D15, D16, D17, D24, D25: BAT54S; SOT-23
D20, D23, D29: SMAJ15A; D_SMA
F1: 1.5A; Fuse_1206_3216Metric
F2, F4: 0.5A; Fuse_1206_3216Metric
F3, F5: 0.3A; Fuse_1206_3216Metric
FB2, FB3, FB4, FB5, FB6, FB7: 600R@100MHz; L_0805_2012Metric
J1: USB-C 16P (data+charge); USB_C_Receptacle_HRO_TYPE-C-31-M-12
J5: microSD (1-bit SDMMC); microSD_HC_Hirose_DM3AT-SF-PEJM5
J6: MIDI IN TRS-A
J7: MIDI OUT TRS-A
J8: LINE OUT L/R 3.5mm
J9: PHONES 3.5mm
J10: AUDIO IN L 3.5mm
J11: AUDIO IN R 3.5mm
J12: DC 12V 5.5/2.1
J14: PANEL-2 J14 (IDC-26) analog field [rev.2 canon]; IDC-Header_2x13_P2.54mm_Latch12.0mm_Vertical
J15: PANEL-2 J12 (FFC-40) SPI LCD [CORE-S3]; Hirose_FH12-40S-0.5SH_1x40-1MP_P0.50mm_Horizontal
J16: PANEL-2 J13 (IDC-16) digital/power [rev.2 canon]; IDC-Header_2x08_P2.54mm_Latch6.5mm_Vertical
J17: PWR-2 J3 (IDC-20) [rev.2]; IDC-Header_2x10_P2.54mm_Vertical
J18: PWR-2 J4 (IDC-12) [rev.2]; IDC-Header_2x06_P2.54mm_Vertical
L4: 22uH; L_1210_3225Metric
L5: 1.5uH; L_1210_3225Metric
NT1: AGND=DGND; NetTie-2_SMD_Pad0.5mm
NT2: DGND=PGND; NetTie-2_SMD_Pad0.5mm
P1: PicoMod analog bus IDC-26 PORT1; IDC-Header_2x13_P2.54mm_Latch12.0mm_Vertical
P2: PicoMod analog bus IDC-26 PORT2; IDC-Header_2x13_P2.54mm_Latch12.0mm_Vertical
Q3: 2N7000; TO-92_Inline
R1, R2: 1.5k; R_0805_2012Metric
R3: 2k; R_0805_2012Metric
R4, R19, R20, R25, R26, R37, R38, R63, R65, R75, R85, R92, R93, R99, R100, R107: 100k; R_0805_2012Metric
R6, R43, R44, R57, R58, R59, R60, R61, R62, R67, R68, R71, R72, R84, R103, R104: 1k; R_0805_2012Metric
R21: 3.09k; R_0805_2012Metric
R22, R23, R24, R30, R31, R36, R51, R52, R53, R54, R55, R56, R77, R91: 10k; R_0805_2012Metric
R28, R29: 5.1k; R_0805_2012Metric
R39, R40, R41, R42: 100; R_0805_2012Metric
R45, R46, R47, R48, R49, R50: 39k; R_0805_2012Metric
R64, R66, R101, R102: 16.5k; R_0805_2012Metric
R69, R70, R76: 47k; R_0805_2012Metric
R78, R79: 2.2k; R_0805_2012Metric
R80, R83: 220; R_0805_2012Metric
R81, R86: 4.7k; R_0805_2012Metric
R82: 33; R_0805_2012Metric
R94, R95, R96, R97, R98: 0R; R_0805_2012Metric
R106: 560k; R_0805_2012Metric
SW1: BOOT
SW2: RESET
TB1: Rear audio terminal block; TerminalBlock_Phoenix_MKDS-1-12-3.81_1x12_P3.81mm_Horizontal
TH2: NTC 10k; R_0805_2012Metric
TP1: VBUS_CHG
TP2: VSYS
TP3: 12V
TP4: -12V
TP5: 5V
TP6: 3V3
TP8: BATT_MON
TP9: I2S_MCLK
TP10: SD_CLK
TP11: USB_HS_DP
TP12: USB_HS_DM
TP13: AGND
TP14: DGND
TP15: PGND
TP16: LED_DATA
TP17: CHIP_PU
TP18: BOOT
TP20: BL_20V
TP23: N12_EXT
TP24: 5V_EXT
TP25: 5V_LED
TP26: PWR_GOOD
TP27: EN_RAILS
U20: USBLC6-2SC6; SOT-23-6
U22: BQ24074RGT
U29: MT3608 (+20V BL); SOT-23-6
U32: PCM5102A; TSSOP-20_4.4x6.5mm_P0.65mm
U33: TL072; DIP-8_W7.62mm
U34: PCM1808PWR; TSSOP-14_4.4x5mm_P0.65mm
U35: MCP4728A0-E/UN (0x60); MSOP-10_3x3mm_P0.5mm
U36: MCP4728A1-E/UN (0x61); MSOP-10_3x3mm_P0.5mm
U37, U38, U39, U45: TL074; DIP-14_W7.62mm
U40: MCP3208; DIP-16_W7.62mm
U41: 24LC32A; DIP-8_W7.62mm
U42: 6N137; DIP-8_W7.62mm
U43: 74HCT125; SOIC-14_3.9x8.7mm_P1.27mm
U46: TPS63000 (placeholder; replace with TPS63802/TPS6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; VSON-10-1EP_3x3mm_P0.5mm_EP1.65x2.4mm

Connections:
3V3: A1.2 (3V3), C42.1, C43.1, C44.1, C45.1, C46.1, C47.1, C48.1, C49.1, C56.1, C57.1, C61.1, C62.1, C63.1, C64.1, C76.1, C81.1, C82.1, C83.1, C84.1, C96.1, C103.1, C123.1, C124.1, C125.1, D16.2 (K), D17.2 (K), D24.2 (K), D25.2 (K), FB5.1, FB6.1, J5.4 (VDD), R22.1, R23.1, R24.2, R30.1, R31.1, R36.1, R69.1, R78.1, R79.1, R81.1, R91.1, R92.1, R93.1, R106.1, TH2.1, TP6.1, U32.1 (CPVDD), U32.8 (AVDD), U32.20 (DVDD), U34.4 (VDD), U35.1 (VDD), U36.1 (VDD), U40.16 (Vdd), U41.1 (A0), U41.2 (A1), U41.3 (A2), U41.8 (VCC), U46.1 (VOUT)
3V3_PANEL: C41.1, FB5.2, J15.9, J15.27, J15.28, J16.11
5V: C32.1, C74.1, C75.1, C117.1, D8.2 (K), D9.2 (K), FB4.1, FB7.2, L4.1, R19.1, R83.1, R86.1, TP5.1, U29.5 (IN), U34.3 (VCC), U42.7 (EN), U42.8 (VCC), U43.4 (2OE), U43.10 (3OE), U43.13 (4OE), U43.14 (VCC)
5V_EXT: C114.1, C115.1, FB7.1, J17.13, J17.14, TP24.1
5V_LED: C116.1, J16.9, J16.13, J17.17, TP25.1
5V_PANEL: C40.1, FB4.2
12V: C68.1, C85.1, C87.1, C92.1, C120.1, D2.2 (A), D10.2 (K), D11.2 (K), D12.2 (K), D13.2 (K), D14.2 (K), D15.2 (K), FB2.1, TP3.1, U33.8 (V+), U37.4 (V+), U38.4 (V+), U39.4 (V+), U45.4 (V+)
12V_B: C38.1, D18.2 (A), D21.2 (A), F2.1, F4.1, FB2.2
12V_EXT: C110.1, C111.1, D2.1 (K), J12.1, J17.5, J17.6
12V_P1: C104.1, C105.1, D18.1 (K), D29.1 (A1), F2.2, P1.1
12V_P2: C107.1, C108.1, D21.1 (K), D23.1 (A1), F4.2, P2.1
-12V: C69.1, C86.1, C88.1, C93.1, C121.1, D19.1 (K), FB3.1, TP4.1, U33.4 (V-), U37.11 (V-), U38.11 (V-), U39.11 (V-), U45.11 (V-)
-12V_B: C39.2, D22.1 (K), D28.1 (K), F3.1, F5.1, FB3.2
AGND: C59.1, C60.2, C61.2, C63.2, C64.2, C65.2, C68.2, C69.2, C70.2, C71.2, C72.2, C73.2, C74.2, C75.2, C77.2, C79.2, C81.2, C82.2, C83.2, C84.2, C85.2, C86.2, C87.2, C88.2, C89.2, C90.2, C91.2, C92.2, C93.2, C94.2, C95.2, C96.2, C97.2, C98.2, C101.2, C102.2, C118.2, C119.2, C120.2, C121.2, D8.1 (A), D9.1 (A), D10.1 (A), D11.1 (A), D12.1 (A), D13.1 (A), D14.1 (A), D15.1 (A), D16.1 (A), D17.1 (A), D24.1 (A), D25.1 (A), J8.S, J9.S, J10.S, J11.S, J14.2, J14.4, J14.6, J14.8, J14.10, J14.12, J14.14, J14.16, J14.18, J14.20, J14.22, J14.24, J14.26, NT1.1, P1.6, P1.8, P1.10, P1.12, P1.18, P1.20, P1.22, P1.24, P2.6, P2.8, P2.10, P2.12, P2.18, P2.20, P2.22, P2.24, R37.2, R38.2, R51.2, R52.2, R53.2, R54.2, R55.2, R56.2, R70.2, R76.2, R77.2, TB1.3, TB1.6, TB1.9, TB1.10, TB1.11, TB1.12, TP13.1, U32.3 (CPGND), U32.9 (AGND), U34.2 (AGND), U35.10 (VSS), U36.10 (VSS), U38.10 (+), U38.12 (+), U39.12 (+), U40.14 (AGND), U45.10 (+), U45.12 (+)
AUDIN_L: J10.T, P1.17, P2.17, R43.1, TB1.7
AUDIN_L_C: C78.2, U34.13 (VINL)
AUDIN_L_F: C77.1, C78.1, D8.3 (COM), R43.2
AUDIN_R: J11.T, P1.19, P2.19, R44.1, TB1.8
AUDIN_R_C: C80.2, U34.14 (VINR)
AUDIN_R_F: C79.1, C80.1, D9.3 (COM), R44.2
AUDL_BUF: R39.1, R41.1, U33.1, U33.2 (-)
AUDOUT_L: C70.1, J8.T, P1.21, P2.21, R39.2, TB1.1
AUDOUT_R: C71.1, J8.R, P1.23, P2.23, R40.2, TB1.2
AUDR_BUF: R40.1, R42.1, U33.6 (-), U33.7
AUD_L_IN: C66.2, R37.1, U33.3 (+)
AUD_R_IN: C67.2, R38.1, U33.5 (+)
BATT_MON: C101.1, R75.2, R76.1, TP8.1, U40.7 (CH6)
BATT_MON_RAW: J18.1, R75.1
BATT_P: C6.1, C7.1, J17.3, J17.4, U22.2 (BAT), U22.3 (BAT)
BL_20V: C31.1, C33.1, C34.1, D7.2 (A), J15.11, R20.1, TP20.1
BL_CATHODE: J15.12, R97.1
BL_PWM: A1.23 (IO21), J15.8
BOOT: A1.27 (IO0), R22.2, SW1.1, TP18.1
CC1: J1.A5 (CC1), R28.1
CC2: J1.B5 (CC2), R29.1
CHG: D3.1 (K), U22.9 (~CHG)
CHG_LED: D3.2 (A), R6.2
CP_M: C58.2, U32.4 (CAPM)
CP_P: C58.1, U32.2 (CAPP)
CVIN1: J14.9, R63.1
CVIN1_ADC: C89.1, D16.3 (COM), R67.2, U40.1 (CH0)
CVIN1_N: R63.2, R64.1, U39.2 (-)
CVIN1_RAW: R64.2, R67.1, U39.1
CVIN2: J14.11, R65.1
CVIN2_ADC: C90.1, D17.3 (COM), R68.2, U40.2 (CH1)
CVIN2_N: R65.2, R66.1, U39.6 (-)
CVIN2_RAW: R66.2, R68.1, U39.7
CVIN3: J14.13, R99.1
CVIN3_ADC: C118.1, D24.3 (COM), R103.2, U40.5 (CH4)
CVIN3_N: R99.2, R101.1, U45.2 (-)
CVIN3_RAW: R101.2, R103.1, U45.1
CVIN4: J14.15, R100.1
CVIN4_ADC: C119.1, D25.3 (COM), R104.2, U40.6 (CH5)
CVIN4_N: R100.2, R102.1, U45.6 (-)
CVIN4_RAW: R102.2, R104.1, U45.7
CVOUT1: D10.3 (COM), J14.1, P1.5, P2.5, R57.2
CVOUT2: D11.3 (COM), J14.3, P1.7, P2.7, R58.2
CVOUT3: D12.3 (COM), J14.5, P1.9, P2.9, R59.2
CVOUT4: D13.3 (COM), J14.7, P1.11, P2.11, R60.2
CVOUT5: D14.3 (COM), R61.2
CVOUT6: D15.3 (COM), R62.2
CVR0: R45.2, R57.1, U37.1
CVR1: R46.2, R58.1, U37.7
CVR2: R47.2, R59.1, U37.8
CVR3: R48.2, R60.1, U37.14
CVR4: R49.2, R61.1, U38.1
CVR5: R50.2, R62.1, U38.7
CVREF: C91.1, R69.2, R70.1, U39.10 (+)
CVREF_B: U39.3 (+), U39.5 (+), U39.8, U39.9 (-), U45.3 (+), U45.5 (+)
CVS0: R45.1, R51.1, U37.2 (-)
CVS1: R46.1, R52.1, U37.6 (-)
CVS2: R47.1, R53.1, U37.9 (-)
CVS3: R48.1, R54.1, U37.13 (-)
CVS4: R49.1, R55.1, U38.2 (-)
CVS5: R50.1, R56.1, U38.6 (-)
DAC_A: U35.6 (VOUTA), U37.3 (+)
DAC_B: U35.7 (VOUTB), U37.5 (+)
DAC_C: U35.8 (VOUTC), U37.10 (+)
DAC_D: U35.9 (VOUTD), U37.12 (+)
DAC_E: U36.6 (VOUTA), U38.3 (+)
DAC_F: U36.7 (VOUTB), U38.5 (+)
DAC_L: C66.1, U32.6 (OUTL)
DAC_R: C67.1, U32.7 (OUTR)
DGND: A1.1 (GND), A1.40 (GND), A1.41 (GND), C41.2, C42.2, C43.2, C44.2, C45.2, C46.2, C47.2, C48.2, C49.2, C51.2, C52.2, C56.2, C57.2, C62.2, C76.2, C103.2, J1.A1 (GND), J1.A12 (GND), J1.B1 (GND), J1.B12 (GND), J1.SH (SHIELD), J5.6 (VSS), J5.SH (SHIELD), J6.S, J7.S, J15.1, J15.2, J15.10, J15.13, J15.14, J15.15, J15.16, J15.17, J15.18, J15.19, J15.20, J15.21, J15.22, J15.23, J15.24, J15.25, J15.26, J15.29, J15.30, J15.31, J15.32, J15.33, J15.34, J15.35, J15.36, J15.37, J15.38, J15.39, J15.40, J16.2, J16.4, J16.6, J16.8, J16.10, J16.12, J16.14, NT1.2, NT2.1, P1.14, P1.16, P2.14, P2.16, Q3.1 (S), R26.2, R28.2, R29.2, R85.2, SW1.2, SW2.2, TP14.1, U20.2 (GND), U32.10 (DEMP), U32.11 (FLT), U32.16 (FMT), U32.19 (DGND), U34.5 (DGND), U34.10 (MD0), U34.11 (MD1), U34.12 (FMT), U35.4 (~LDAC), U36.4 (~LDAC), U40.9 (DGND), U41.4 (GND), U41.7 (WP), U42.5 (GND), U43.1 (1OE), U43.5 (2A), U43.7 (GND), U43.9 (3A), U43.12 (4A)
ENBL: R19.2, U29.4 (EN)
EN_5V: J18.10, R96.2
EN_BUS12: J18.7, R94.2
EN_LED5: J14.25, J18.9
EN_N12: J18.8, R95.2
EN_RAILS: J16.15, R94.1, R95.1, R96.1, TP27.1
EN_S3: A1.3 (EN), C51.1, R23.2, SW2.1, TP17.1
FADER1: J14.21, R71.1
FADER1_ADC: C97.1, R71.2, U40.3 (CH2)
FADER2: J14.23, R72.1
FADER2_ADC: C98.1, R72.2, U40.4 (CH3)
FB3V3: C125.2, R106.2, R107.1, U46.10 (FB)
FBBL: C31.2, R20.2, R21.1, U29.3 (FB)
FUEL_ALRT: J18.5, R93.2
G1: Q3.2 (G), R84.2, R85.1
GATE1: J14.17, P1.13, P2.13, Q3.3 (D), R86.2
GATE1_GPIO: A1.25 (IO48), R84.1
GATE2: P1.15, P2.15
I2C0_SCL: A1.10 (IO17), J16.3, J18.4, R79.2, U35.2 (SCL), U36.2 (SCL), U41.6 (SCL)
I2C0_SDA: A1.9 (IO16), J16.1, J18.3, R78.2, U35.3 (SDA), U36.3 (SDA), U41.5 (SDA)
I2S_ADC_DOUT: A1.32 (IO39), U34.9 (DOUT)
I2S_BCK: A1.39 (IO1), U32.13 (BCK), U34.8 (BCK)
I2S_DAC_DIN: A1.31 (IO38), U32.14 (DIN)
I2S_LRCK: A1.38 (IO2), U32.15 (LRCK), U34.7 (LRCK)
I2S_MCLK: A1.11 (IO18), TP9.1, U32.12 (SCK), U34.6 (SCKI)
ILIM: R1.1, U22.12 (ILIM)
ISET: R2.1, U22.16 (ISET)
ITERM: R3.1, U22.15 (ITERM)
LCD_CS: A1.18 (IO10), J15.5
LCD_DC: A1.17 (IO9), J15.6
LCD_MOSI: A1.19 (IO11), J15.4
LCD_RST: A1.12 (IO8), J15.7
LCD_SCK: A1.20 (IO12), J15.3
LDOO: C60.1, U32.18 (LDOO)
LED_DATA: J16.7, R98.2, TP16.1
LED_GPIO: A1.35 (IO42), R98.1
LED_RET: J16.16, J17.18
LX1: L5.1, U46.4 (L1)
LX2: L5.2, U46.2 (L2)
MCP3208_CS: A1.7 (IO7), U40.10 (~CS/SHDN)
MIDI_A: R80.2, U42.2 (A)
MIDI_DRV: R82.1, U43.3 (1Y)
MIDI_IN_R: J6.R, R80.1
MIDI_IN_T: J6.T, U42.3 (C)
MIDI_OUT_R: J7.R, R83.2
MIDI_OUT_T: J7.T, R82.2
MIDI_RX: A1.34 (IO41), R81.2, U42.6 (VO)
MIDI_TX: A1.33 (IO40), U43.2 (1A)
N12V_P1: C106.1, D28.2 (A), F3.2, P1.3
N12V_P2: C109.1, D22.2 (A), F5.2, P2.3
N12_EXT: C112.1, C113.1, D19.2 (A), D20.1 (A1), J17.9, J17.10, TP23.1
NTC_PACK: C3.1, J18.2, U22.1 (TS)
PANEL_IRQ: A1.24 (IO47), J16.5, R91.2
PGND: C1.2, C2.2, C3.2, C4.2, C5.2, C6.2, C7.2, C32.2, C33.2, C34.2, C38.2, C39.1, C40.2, C104.2, C105.2, C106.2, C107.2, C108.2, C109.2, C110.2, C111.2, C112.2, C113.2, C114.2, C115.2, C116.2, C117.2, C122.2, C123.2, C124.2, C126.2, D1.2 (A2), D20.2 (A2), D23.2 (A2), D29.2 (A2), J12.2, J17.7, J17.8, J17.11, J17.12, J17.15, J17.16, J17.19, J17.20, J18.11, J18.12, NT2.2, P1.2, P1.4, P2.2, P2.4, R1.2, R2.2, R3.2, R4.2, R21.2, R97.2, R107.2, TP15.1, U22.4 (~CE), U22.8 (VSS), U22.17 (VSS), U29.2 (GND), U46.3 (PGND), U46.9 (GND), U46.11 (PGND)
PHONES_L: J9.T, R41.2, TB1.4
PHONES_R: J9.R, R42.2, TB1.5
PWR_GOOD: A1.15 (IO3), J18.6, R92.2, TP26.1
SD_CLK: A1.8 (IO15), J5.5 (CLK), TP10.1
SD_CMD: A1.22 (IO14), J5.3 (CMD), R30.2
SD_D0: A1.21 (IO13), J5.7 (DAT0), R31.2
SPARE_C: U38.8, U38.9 (-)
SPARE_D: U38.13 (-), U38.14
SPARE_E: U39.13 (-), U39.14
SPARE_F: U45.8, U45.9 (-)
SPARE_G: U45.13 (-), U45.14
SPI3_MISO: A1.6 (IO6), U40.12 (Dout)
SPI3_MOSI: A1.5 (IO5), U40.11 (Din)
SPI3_SCK: A1.4 (IO4), U40.13 (CLK)
SWBL: D7.1 (K), L4.2, U29.1 (SW)
TEMP_MON: C102.1, R77.1, TH2.2, U40.8 (CH7)
TMR: R4.1, U22.14 (TMR)
USB_DM_C: J1.A7 (D-), J1.B7 (D-), U20.3 (I/O2)
USB_DP_C: J1.A6 (D+), J1.B6 (D+), U20.1 (I/O1)
USB_FS_DM: A1.13 (USB_D-), TP12.1, U20.4 (I/O2)
USB_FS_DP: A1.14 (USB_D+), TP11.1, U20.6 (I/O1)
VBUS_CHG: D1.1 (A1), F1.1, J1.A4 (VBUS), J1.A9 (VBUS), J1.B4 (VBUS), J1.B9 (VBUS), R6.1, R25.1, TP1.1, U20.5 (VBUS), U22.5 (EN2), U22.6 (EN1)
VBUS_F: C1.1, C2.1, F1.2, U22.13 (IN)
VNEG: C59.2, U32.5 (VNEG)
VREF33: C94.1, C95.1, FB6.2, U40.15 (Vref)
VREF_ADC: C72.1, C73.1, U34.1 (VREF)
VSYS: C4.1, C5.1, C122.1, C126.1, J17.1, J17.2, TP2.1, U22.10 (OUT), U22.11 (OUT), U46.5 (VIN), U46.6 (EN), U46.7 (PS/SYNC), U46.8 (VINA)
XSMT: C65.1, R36.2, U32.17 (XSMT)

Notes on the sheet:
PRE-FREEZE / DO NOT FABRICATE
CORE-S3 research schematic - ESP32-S3-WROOM-1-N16R8 (USB FS, 8 MB PSRAM). Do not order boards before P1 benchmark and spec/90 sign-off.
GPIO conflicts: 0 (check_pinmap.py). Docs: README.md, pinmap.md, power-tree.md, interfaces.md, comparison in README. PRE-FREEZE.
POWER: USB-C + BQ24074 charge/path, TPS63000 3V3 buck-boost (D-41), +-12V/+5V from PWR-2 J17, BL boost
MCU: ESP32-S3-WROOM-1-N16R8 (USB FS, 8 MB PSRAM), microSD SPI, BOOT/RESET, UART0 TP
AUDIO: PCM5102A DAC + PCM1808 ADC (I2S), TL072 LINE/PHONES, rear jacks
CV: 2x MCP4728 (0x60/0x61), 6x TL074 x4.9, CV IN level shift (1-4), MCP3208 + chains
MIDI TRS-A: 6N137 IN / 74HCT125 OUT; GATE_OUT driver
MODULE BUS: 2x IDC-26 analog bus (+-12V, CV1..4, GATE, audio), per-port protection
PANEL-2 rev.2 canon: J14 IDC-26 analog, J15 FFC-40 SPI display, J16 IDC-16 digital; rear jacks; J17/J18 PWR-2
TEST POINTS (TP1..TP22)
POWER FLAGS (net drivers for ERC)
