martiyanov/bukifon/hardware/modules/MOD-ENSEMBLE-1.kicad_sch

## KiCad design hardware/modules/MOD-ENSEMBLE-1.kicad_sch (2026-11-05)

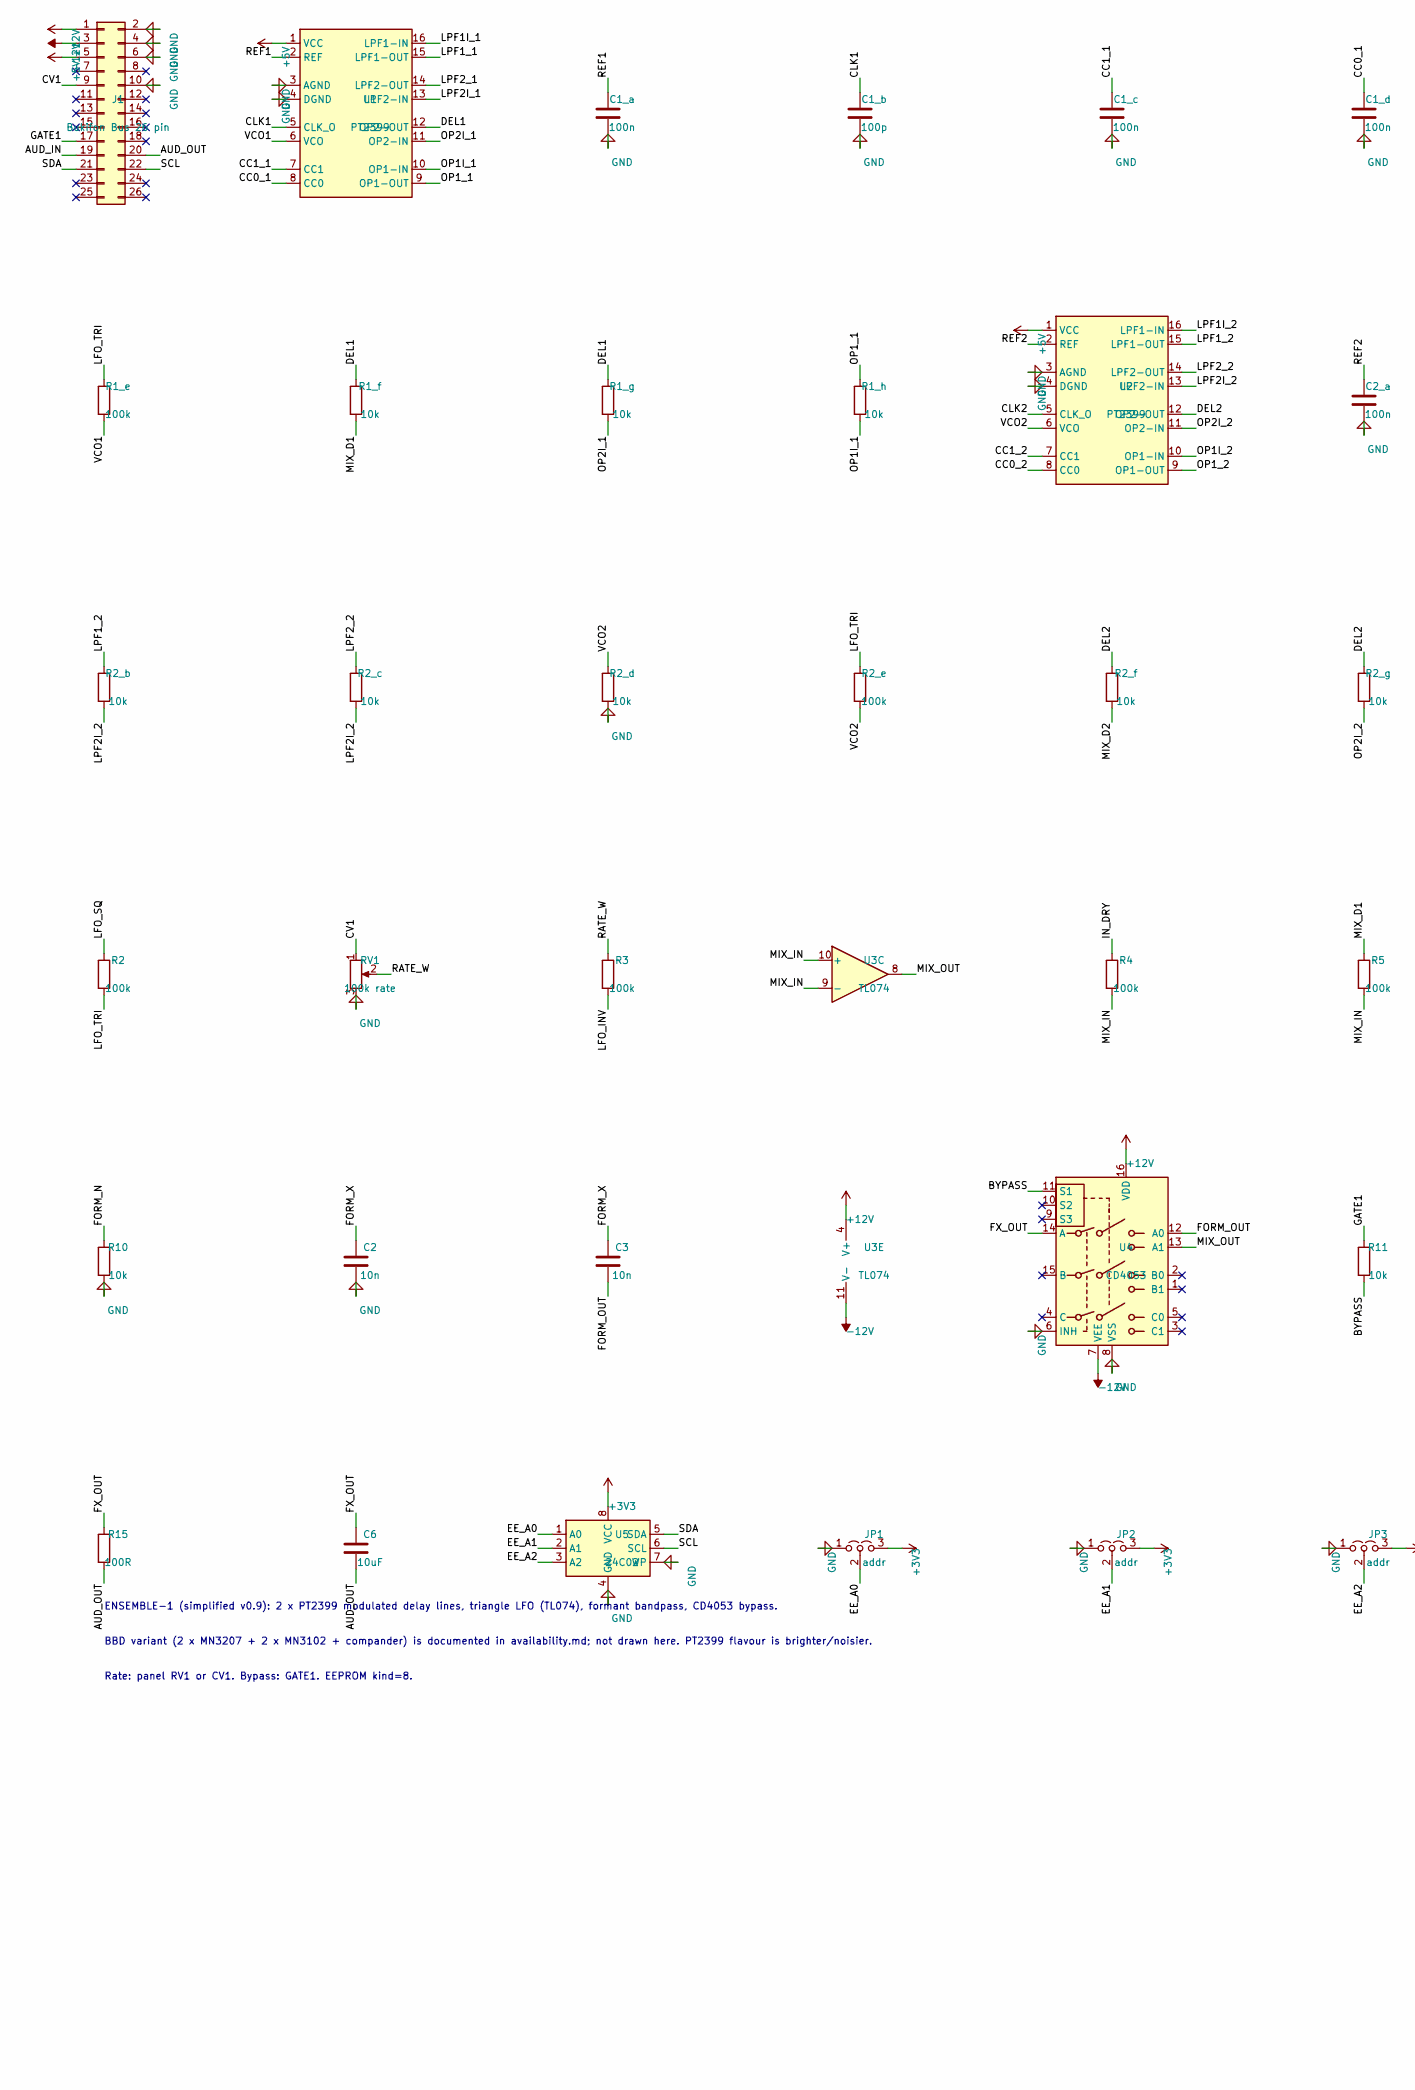
[picture p199: schematic MOD-ENSEMBLE-1.kicad_sch, part in row 1, column 1]

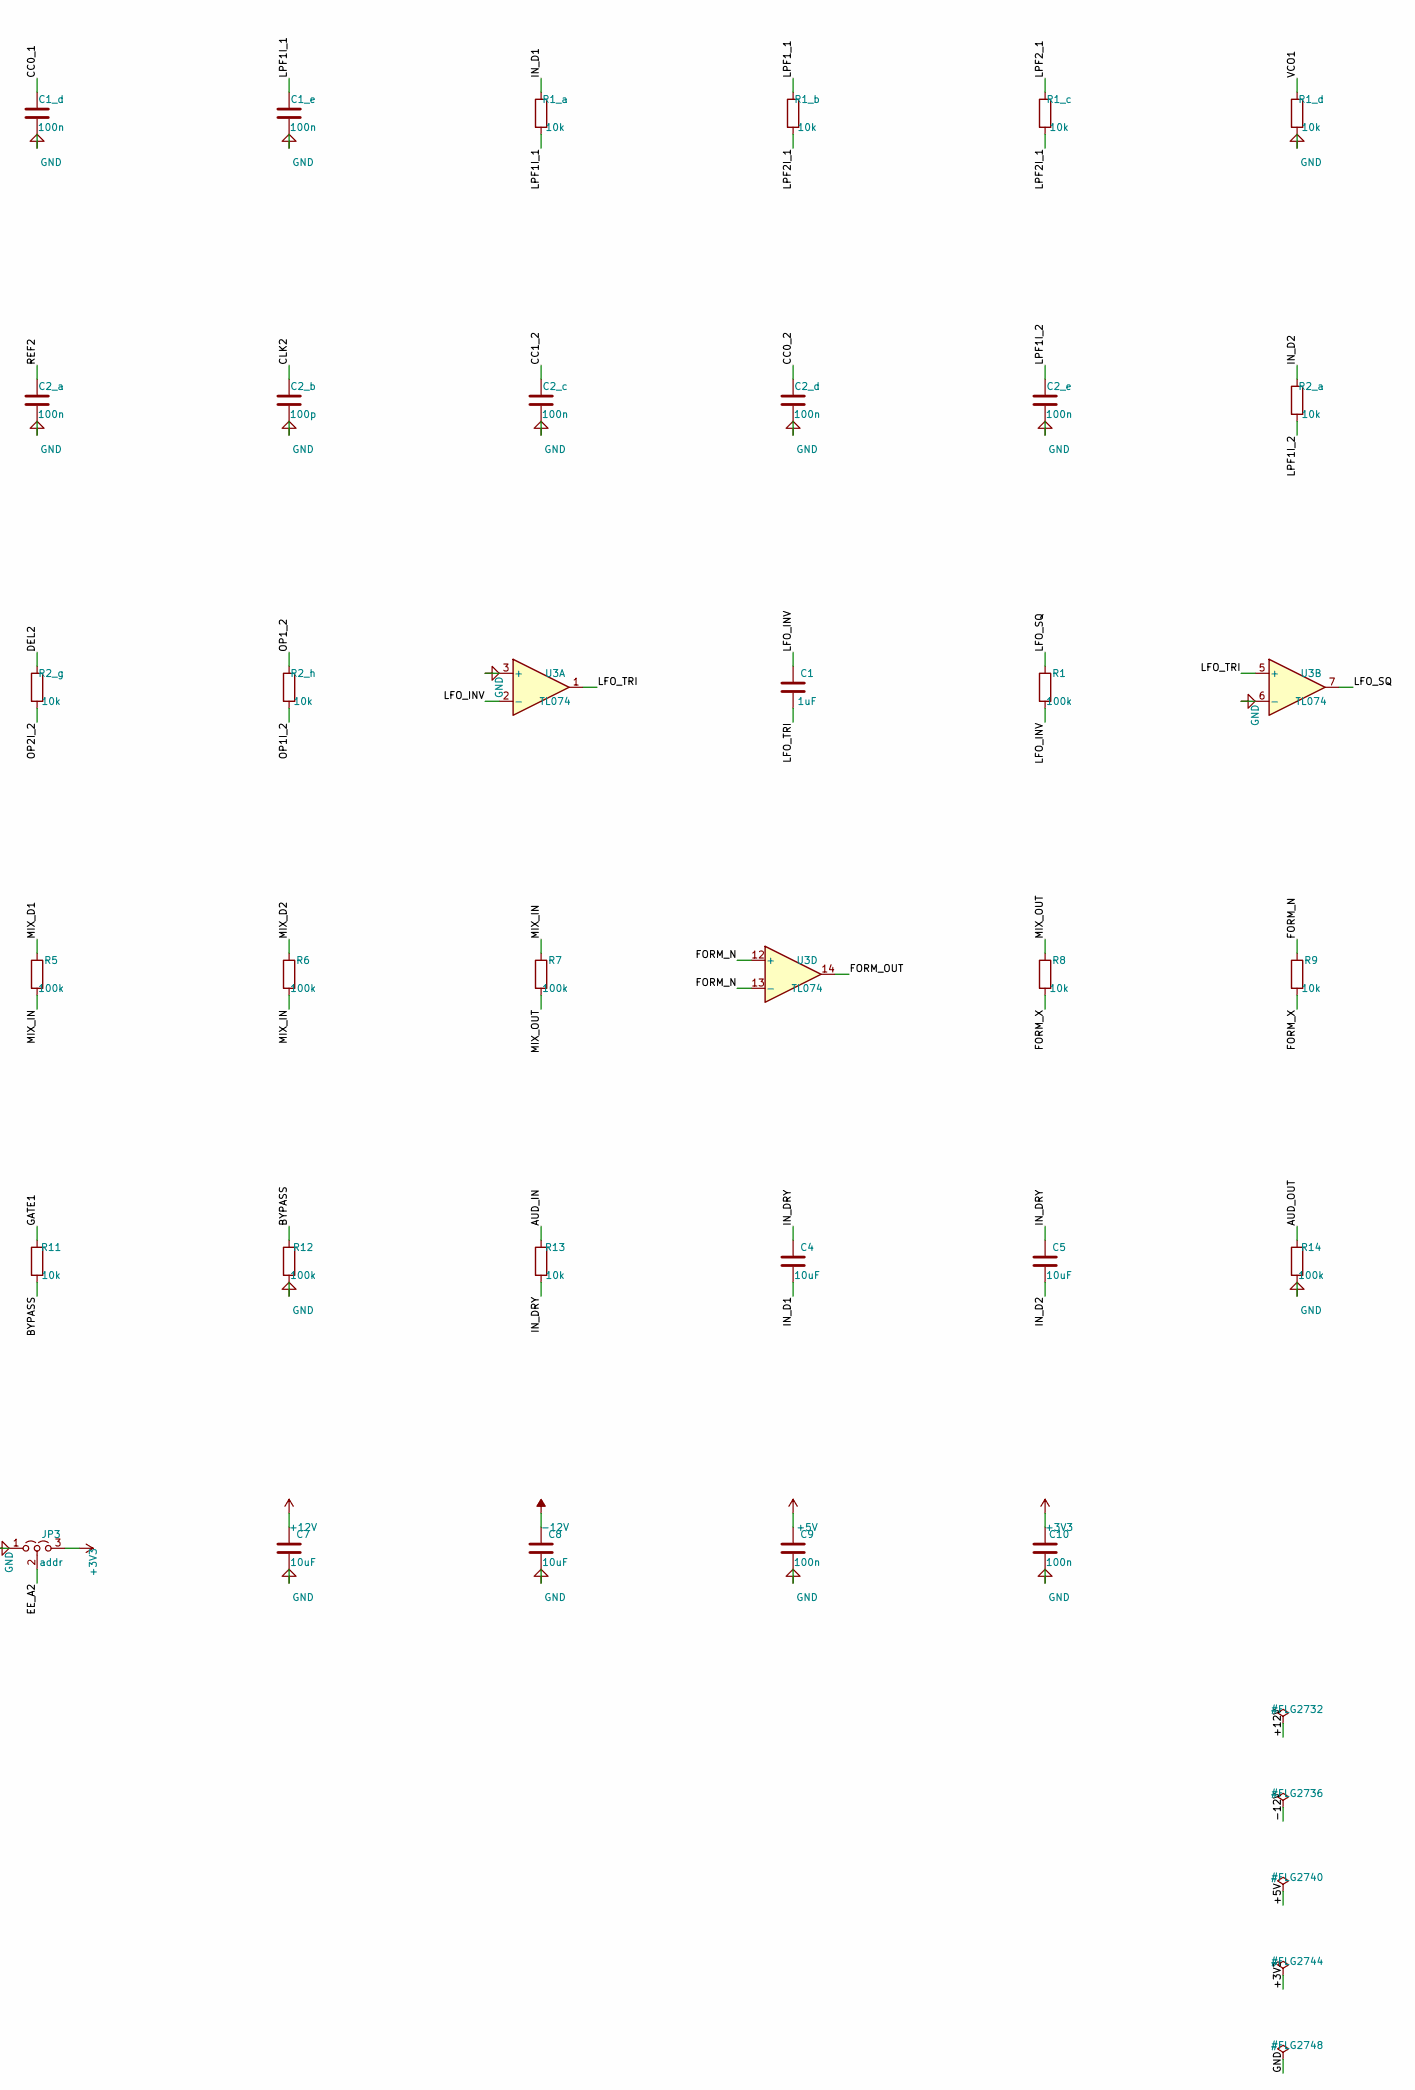
[picture p200: schematic MOD-ENSEMBLE-1.kicad_sch, part in row 1, column 2]

Parts:
C1: 1uF; CP_Radial_D6.3mm_P2.50mm
C1_a, C1_c, C1_d, C1_e, C2_a, C2_c, C2_d, C2_e: 100n; C_Disc_D5.0mm_W2.5mm_P5.00mm
C1_b, C2_b: 100p; C_Disc_D5.0mm_W2.5mm_P5.00mm
C2, C3: 10n; C_Disc_D5.0mm_W2.5mm_P5.00mm
C4, C5, C6, C7, C8: 10uF; CP_Radial_D6.3mm_P2.50mm
C9, C10: 100n; CP_Radial_D6.3mm_P2.50mm
J1: Bukifon Bus 26 pin; IDC-Header_2x13_P2.54mm_Vertical
JP1, JP2, JP3: addr; D_SOD-323
R1, R1_e, R2, R2_e, R3, R4, R5, R6, R7, R12, R14: 100k; R_Axial_DIN0207_L6.3mm_D2.5mm_P7.62mm_Horizontal
R1_a, R1_b, R1_c, R1_d, R1_f, R1_g, R1_h, R2_a, R2_b, R2_c, R2_d, R2_f, R2_g, R2_h, R8, R9, R10, R11, R13: 10k; R_Axial_DIN0207_L6.3mm_D2.5mm_P7.62mm_Horizontal
R15: 100R; R_Axial_DIN0207_L6.3mm_D2.5mm_P7.62mm_Horizontal
RV1: 100k rate; Potentiometer_Alpha_RD901F-40-00D_Single_Vertical
U1, U2: PT2399; DIP-16_W7.62mm
U3: TL074; DIP-14_W7.62mm
U4: CD4053; DIP-16_W7.62mm
U5: 24C02; DIP-8_W7.62mm

Connections:
+3V3: C10.1, JP1.3 (B), JP2.3 (B), JP3.3 (B), U5.8 (VCC)
+5V: C9.1, J1.5, U1.1 (VCC), U2.1 (VCC)
+12V: C7.1, J1.1, U3.4 (V+), U4.16 (VDD)
-12V: C8.1, J1.3, U3.11 (V-), U4.7 (VEE)
AUD_IN: J1.19, R13.1
AUD_OUT: C6.2, J1.20, R14.1, R15.2
BYPASS: R11.2, R12.1, U4.11 (S1)
CC0_1: C1_d.1, U1.8 (CC0)
CC0_2: C2_d.1, U2.8 (CC0)
CC1_1: C1_c.1, U1.7 (CC1)
CC1_2: C2_c.1, U2.7 (CC1)
CLK1: C1_b.1, U1.5 (CLK_O)
CLK2: C2_b.1, U2.5 (CLK_O)
CV1: J1.9, RV1.1
DEL1: R1_f.1, R1_g.1, U1.12 (OP2-OUT)
DEL2: R2_f.1, R2_g.1, U2.12 (OP2-OUT)
EE_A0: JP1.2 (C), U5.1 (A0)
EE_A1: JP2.2 (C), U5.2 (A1)
EE_A2: JP3.2 (C), U5.3 (A2)
FORM_N: R9.1, R10.1, U3.12 (+), U3.13 (-)
FORM_OUT: C3.2, U3.14, U4.12 (A0)
FORM_X: C2.1, C3.1, R8.2, R9.2
FX_OUT: C6.1, R15.1, U4.14 (A)
GATE1: J1.17, R11.1
GND: C1_a.2, C1_b.2, C1_c.2, C1_d.2, C1_e.2, C2.2, C2_a.2, C2_b.2, C2_c.2, C2_d.2, C2_e.2, C7.2, C8.2, C9.2, C10.2, J1.2, J1.4, J1.6, J1.10, JP1.1 (A), JP2.1 (A), JP3.1 (A), R1_d.2, R2_d.2, R10.2, R12.2, R14.2, RV1.3, U1.3 (AGND), U1.4 (DGND), U2.3 (AGND), U2.4 (DGND), U3.3 (+), U3.6 (-), U4.6 (INH), U4.8 (VSS), U5.4 (GND), U5.7 (WP)
IN_D1: C4.2, R1_a.1
IN_D2: C5.2, R2_a.1
IN_DRY: C4.1, C5.1, R4.1, R13.2
LFO_INV: C1.1, R1.2, R3.2, U3.2 (-)
LFO_SQ: R1.1, R2.1, U3.7
LFO_TRI: C1.2, R1_e.1, R2.2, R2_e.1, U3.1, U3.5 (+)
LPF1I_1: C1_e.1, R1_a.2, U1.16 (LPF1-IN)
LPF1I_2: C2_e.1, R2_a.2, U2.16 (LPF1-IN)
LPF1_1: R1_b.1, U1.15 (LPF1-OUT)
LPF1_2: R2_b.1, U2.15 (LPF1-OUT)
LPF2I_1: R1_b.2, R1_c.2, U1.13 (LPF2-IN)
LPF2I_2: R2_b.2, R2_c.2, U2.13 (LPF2-IN)
LPF2_1: R1_c.1, U1.14 (LPF2-OUT)
LPF2_2: R2_c.1, U2.14 (LPF2-OUT)
MIX_D1: R1_f.2, R5.1
MIX_D2: R2_f.2, R6.1
MIX_IN: R4.2, R5.2, R6.2, R7.1, U3.9 (-), U3.10 (+)
MIX_OUT: R7.2, R8.1, U3.8, U4.13 (A1)
OP1I_1: R1_h.2, U1.10 (OP1-IN)
OP1I_2: R2_h.2, U2.10 (OP1-IN)
OP1_1: R1_h.1, U1.9 (OP1-OUT)
OP1_2: R2_h.1, U2.9 (OP1-OUT)
OP2I_1: R1_g.2, U1.11 (OP2-IN)
OP2I_2: R2_g.2, U2.11 (OP2-IN)
RATE_W: R3.1, RV1.2
REF1: C1_a.1, U1.2 (REF)
REF2: C2_a.1, U2.2 (REF)
SCL: J1.22, U5.6 (SCL)
SDA: J1.21, U5.5 (SDA)
VCO1: R1_d.1, R1_e.2, U1.6 (VCO)
VCO2: R2_d.1, R2_e.2, U2.6 (VCO)

Notes on the sheet:
ENSEMBLE-1 (simplified v0.9): 2 x PT2399 modulated delay lines, triangle LFO (TL074), formant bandpass, CD4053 bypass.
BBD variant (2 x MN3207 + 2 x MN3102 + compander) is documented in availability.md; not drawn here. PT2399 flavour is brighter/noisier.
Rate: panel RV1 or CV1. Bypass: GATE1. EEPROM kind=8.
