martiyanov/bukifon/hardware/modules/MOD-FILTER-1.kicad_sch

## KiCad design hardware/modules/MOD-FILTER-1.kicad_sch (2026-11-05)

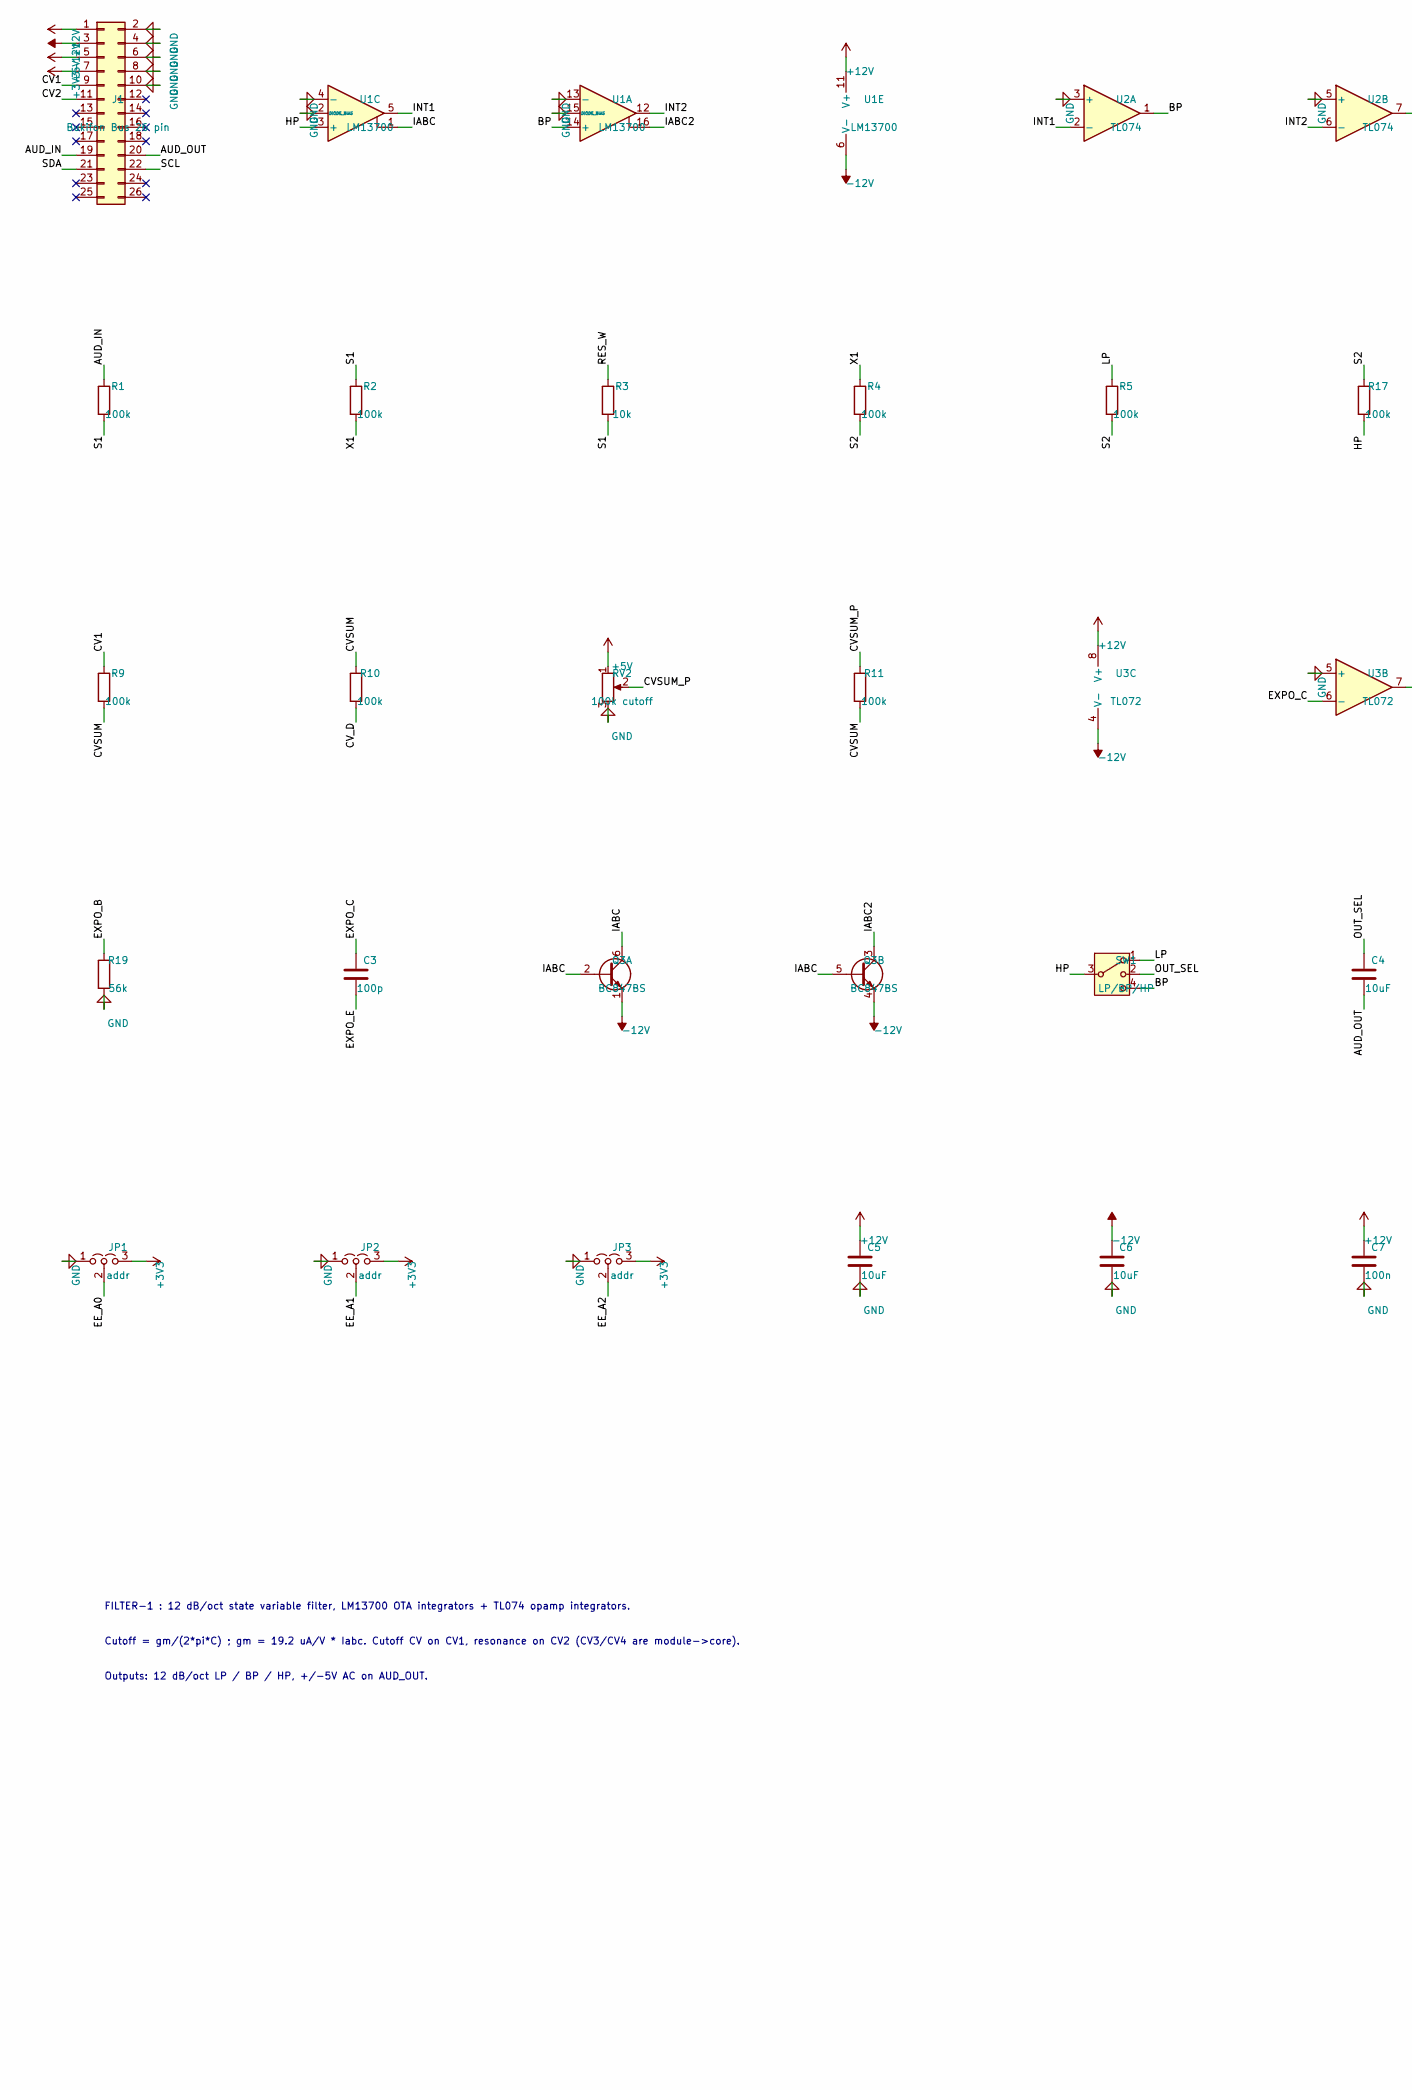
[picture p201: schematic MOD-FILTER-1.kicad_sch, part in row 1, column 1]

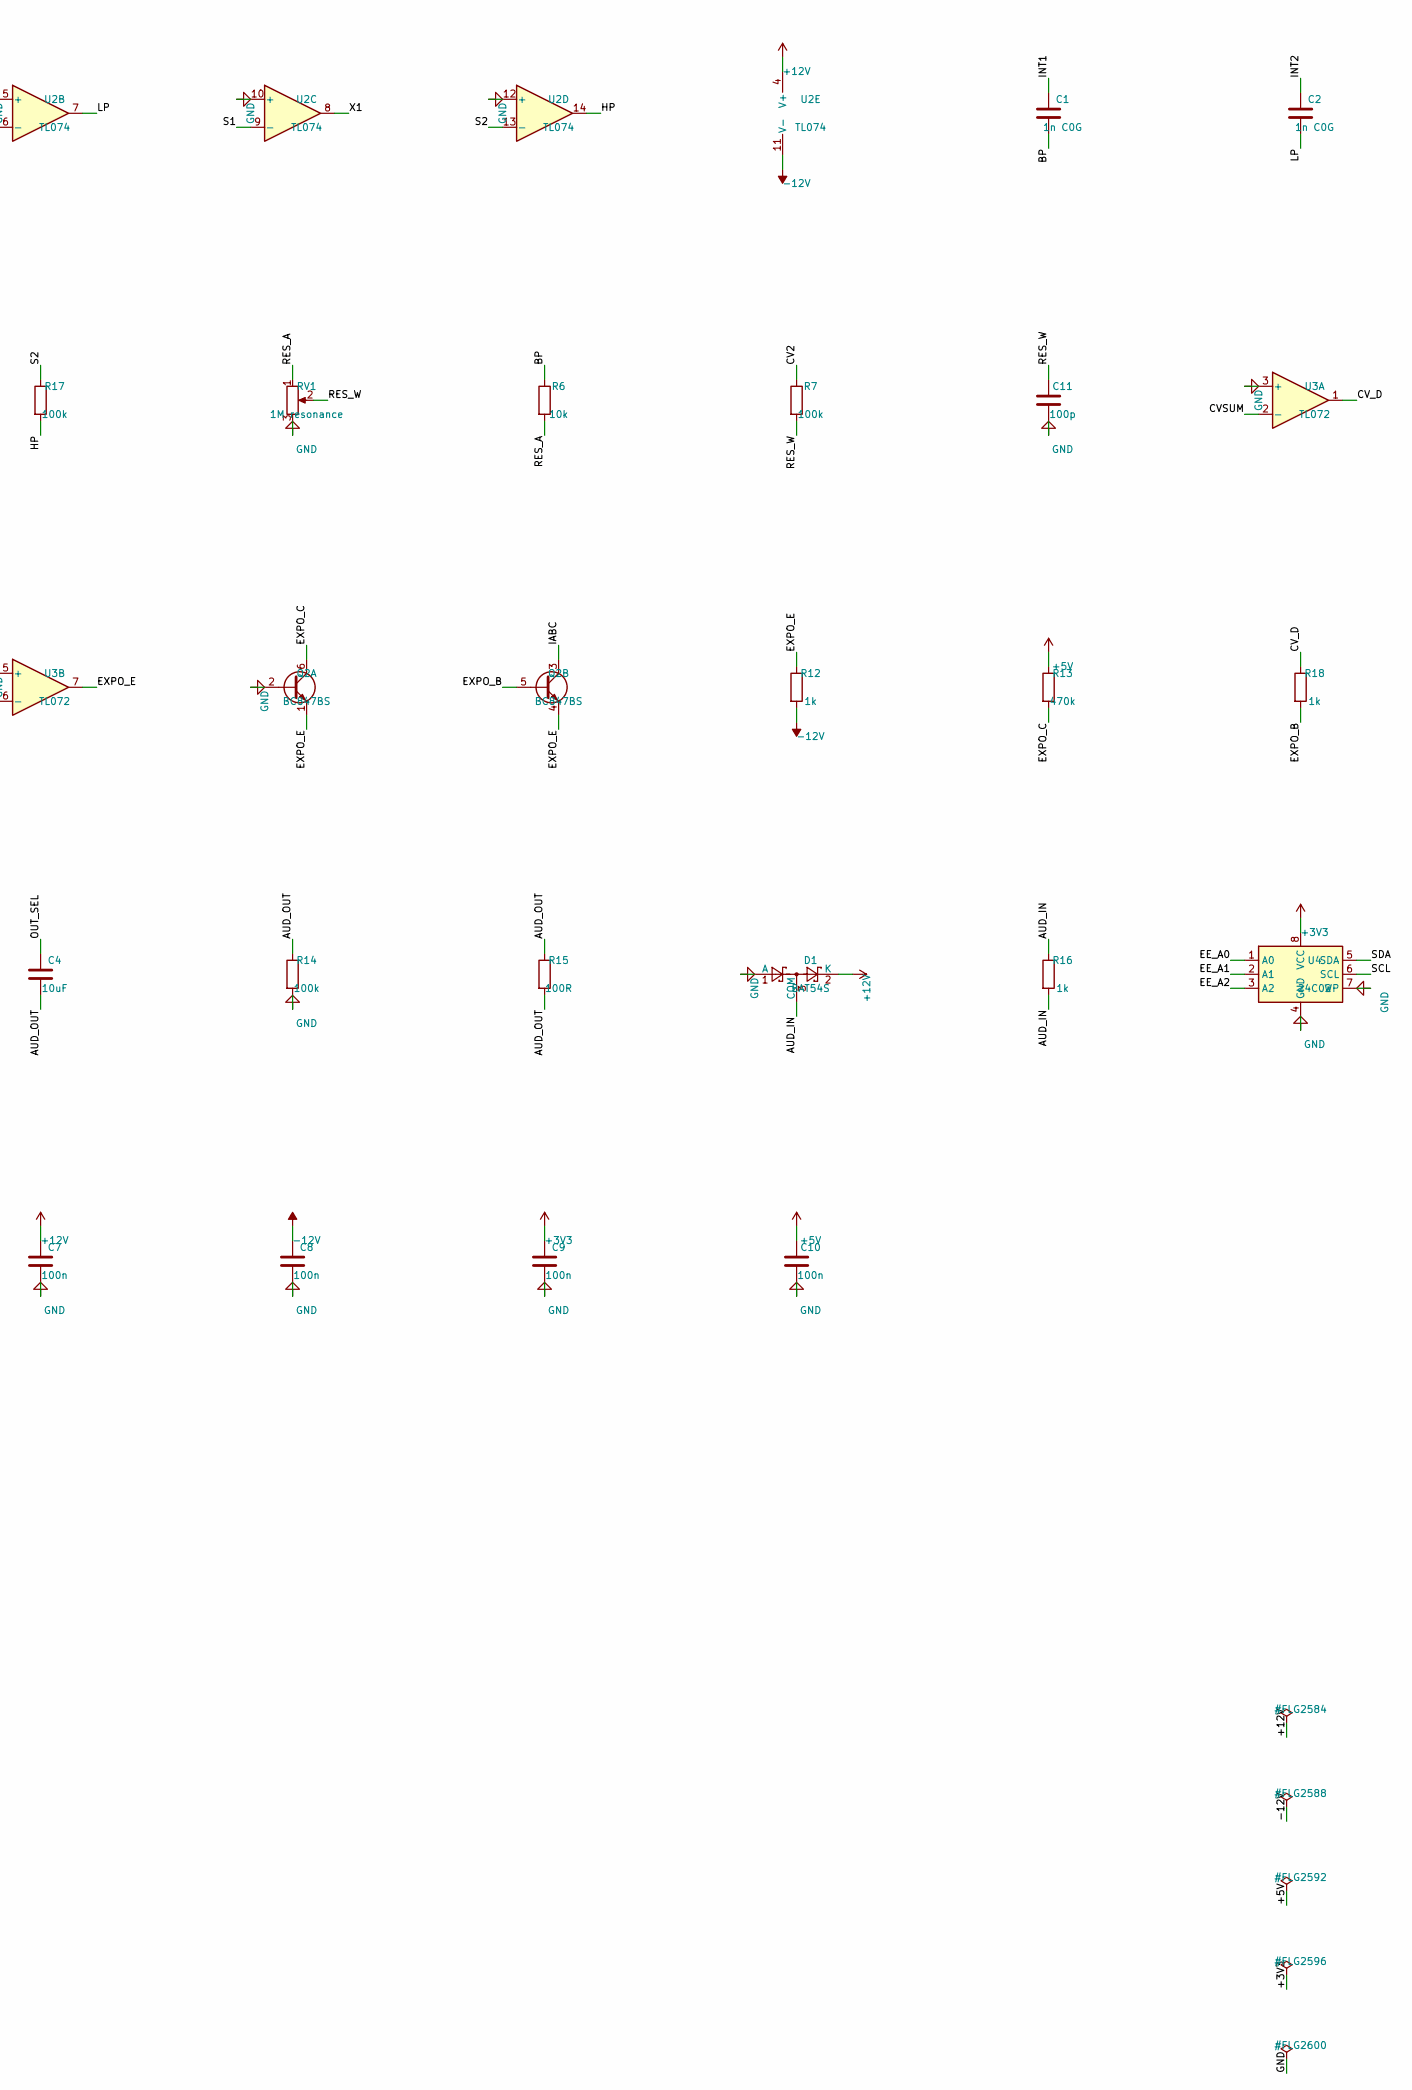
[picture p202: schematic MOD-FILTER-1.kicad_sch, part in row 1, column 2]

Parts:
C1, C2: 1n C0G; C_Disc_D5.0mm_W2.5mm_P5.00mm
C3, C11: 100p; C_Disc_D5.0mm_W2.5mm_P5.00mm
C4, C5, C6: 10uF; CP_Radial_D6.3mm_P2.50mm
C7, C8, C9, C10: 100n; CP_Radial_D6.3mm_P2.50mm
D1: BAT54S; D_SOD-323
J1: Bukifon Bus 26 pin; IDC-Header_2x13_P2.54mm_Vertical
JP1, JP2, JP3: addr; D_SOD-323
Q2, Q3: BC847BS; SOT-23
R1, R2, R4, R5, R7, R9, R10, R11, R14, R17: 100k; R_Axial_DIN0207_L6.3mm_D2.5mm_P7.62mm_Horizontal
R3, R6: 10k; R_Axial_DIN0207_L6.3mm_D2.5mm_P7.62mm_Horizontal
R12, R16, R18: 1k; R_Axial_DIN0207_L6.3mm_D2.5mm_P7.62mm_Horizontal
R13: 470k; R_Axial_DIN0207_L6.3mm_D2.5mm_P7.62mm_Horizontal
R15: 100R; R_Axial_DIN0207_L6.3mm_D2.5mm_P7.62mm_Horizontal
R19: 56k; R_Axial_DIN0207_L6.3mm_D2.5mm_P7.62mm_Horizontal
RV1: 1M resonance; Potentiometer_Alpha_RD901F-40-00D_Single_Vertical
RV2: 100k cutoff; Potentiometer_Alpha_RD901F-40-00D_Single_Vertical
SW1: LP/BP/HP
U1: LM13700; DIP-16_W7.62mm
U2: TL074; DIP-14_W7.62mm
U3: TL072; DIP-8_W7.62mm
U4: 24C02; DIP-8_W7.62mm

Connections:
+3V3: C9.1, J1.7, JP1.3 (B), JP2.3 (B), JP3.3 (B), U4.8 (VCC)
+5V: C10.1, J1.5, R13.1, RV2.1
+12V: C5.1, C7.1, D1.2 (K), J1.1, U1.11 (V+), U2.4 (V+), U3.8 (V+)
-12V: C6.1, C8.1, J1.3, Q3.1 (E1), Q3.4 (E2), R12.2, U1.6 (V-), U2.11 (V-), U3.4 (V-)
AUD_IN: D1.3 (COM), J1.19, R1.1, R16.1, R16.2
AUD_OUT: C4.2, J1.20, R14.1, R15.1, R15.2
BP: C1.2, R6.1, SW1.4, U1.14 (+), U2.1
CV1: J1.9, R9.1
CV2: J1.11, R7.1
CVSUM: R9.2, R10.1, R11.2, U3.2 (-)
CVSUM_P: R11.1, RV2.2
CV_D: R10.2, R18.1, U3.1
EE_A0: JP1.2 (C), U4.1 (A0)
EE_A1: JP2.2 (C), U4.2 (A1)
EE_A2: JP3.2 (C), U4.3 (A2)
EXPO_B: Q2.5 (B2), R18.2, R19.1
EXPO_C: C3.1, Q2.6 (C1), R13.2, U3.6 (-)
EXPO_E: C3.2, Q2.1 (E1), Q2.4 (E2), R12.1, U3.7
GND: C5.2, C6.2, C7.2, C8.2, C9.2, C10.2, C11.2, D1.1 (A), J1.2, J1.4, J1.6, J1.8, J1.10, JP1.1 (A), JP2.1 (A), JP3.1 (A), Q2.2 (B1), R14.2, R19.2, RV1.3, RV2.3, U1.2 (DIODE_BIAS), U1.4 (-), U1.13 (-), U1.15 (DIODE_BIAS), U2.3 (+), U2.5 (+), U2.10 (+), U2.12 (+), U3.3 (+), U3.5 (+), U4.4 (GND), U4.7 (WP)
HP: R17.2, SW1.3, U1.3 (+), U2.14
IABC: Q2.3 (C2), Q3.2 (B1), Q3.5 (B2), Q3.6 (C1), U1.1
IABC2: Q3.3 (C2), U1.16
INT1: C1.1, U1.5, U2.2 (-)
INT2: C2.1, U1.12, U2.6 (-)
LP: C2.2, R5.1, SW1.1, U2.7
OUT_SEL: C4.1, SW1.2
RES_A: R6.2, RV1.1
RES_W: C11.1, R3.1, R7.2, RV1.2
S1: R1.2, R2.1, R3.2, U2.9 (-)
S2: R4.2, R5.2, R17.1, U2.13 (-)
SCL: J1.22, U4.6 (SCL)
SDA: J1.21, U4.5 (SDA)
X1: R2.2, R4.1, U2.8

Notes on the sheet:
FILTER-1 : 12 dB/oct state variable filter, LM13700 OTA integrators + TL074 opamp integrators.
Cutoff = gm/(2*pi*C) ; gm = 19.2 uA/V * Iabc. Cutoff CV on CV1, resonance on CV2 (CV3/CV4 are module->core).
Outputs: 12 dB/oct LP / BP / HP, +/-5V AC on AUD_OUT.
