martiyanov/bukifon/hardware/modules/MOD-LADDER-1.kicad_sch

## KiCad design hardware/modules/MOD-LADDER-1.kicad_sch (2026-11-05)

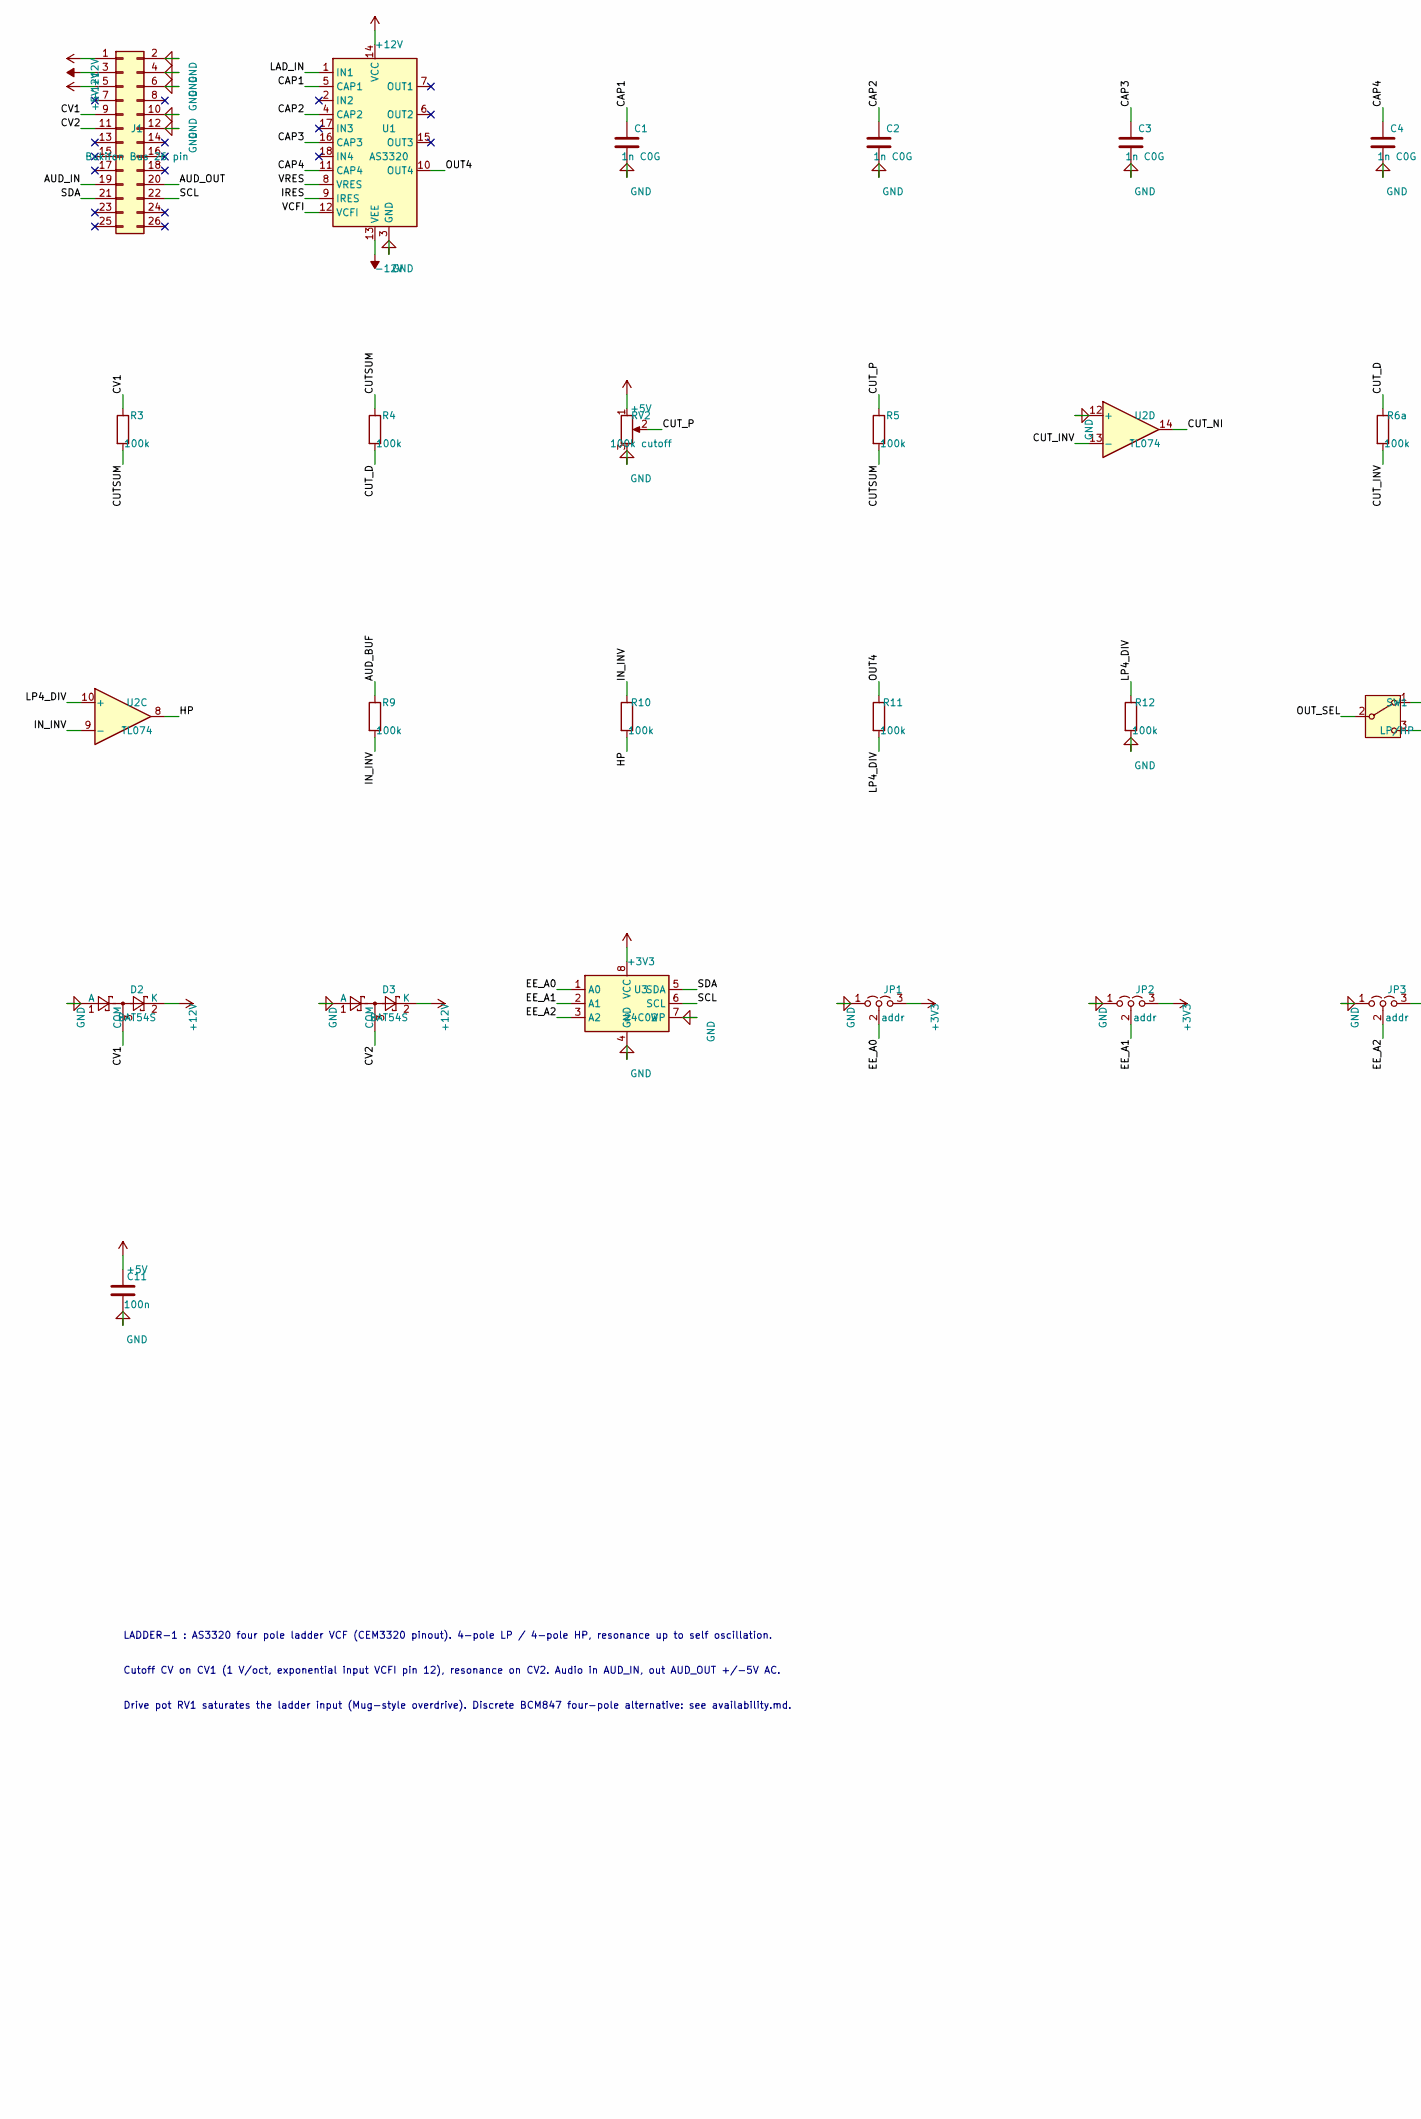
[picture p203: schematic MOD-LADDER-1.kicad_sch, part in row 1, column 1]

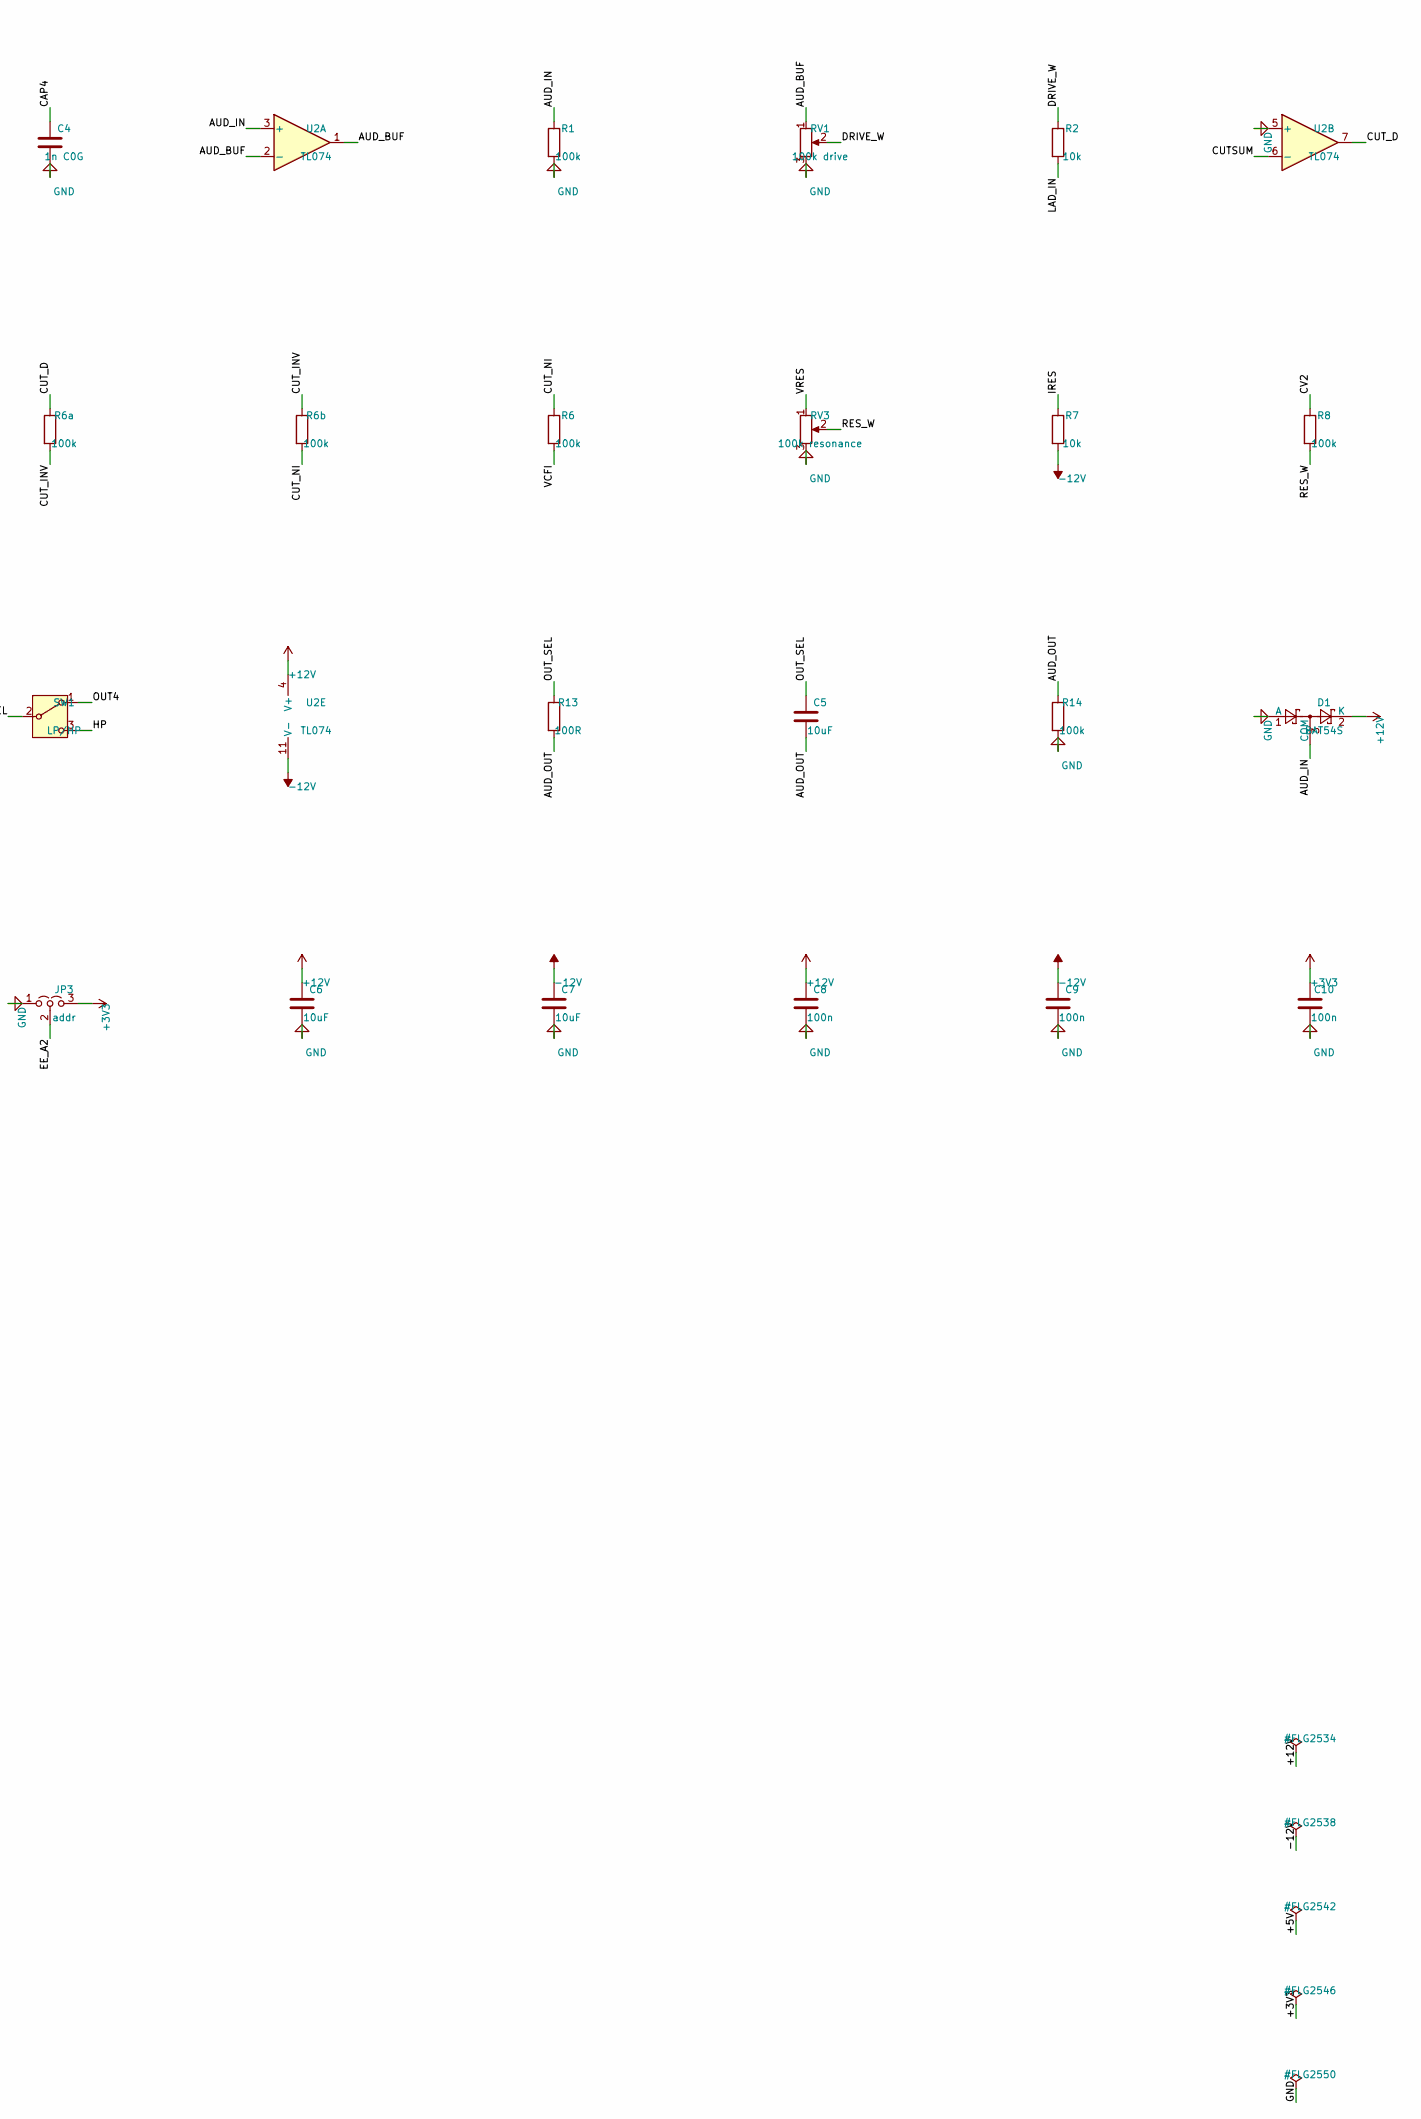
[picture p204: schematic MOD-LADDER-1.kicad_sch, part in row 1, column 2]

Parts:
C1, C2, C3, C4: 1n C0G; C_Disc_D5.0mm_W2.5mm_P5.00mm
C5, C6, C7: 10uF; CP_Radial_D6.3mm_P2.50mm
C8, C9, C10, C11: 100n; CP_Radial_D6.3mm_P2.50mm
D1, D2, D3: BAT54S; D_SOD-323
J1: Bukifon Bus 26 pin; IDC-Header_2x13_P2.54mm_Vertical
JP1, JP2, JP3: addr; D_SOD-323
R1, R3, R4, R5, R6, R6a, R6b, R8, R9, R10, R11, R12, R14: 100k; R_Axial_DIN0207_L6.3mm_D2.5mm_P7.62mm_Horizontal
R2, R7: 10k; R_Axial_DIN0207_L6.3mm_D2.5mm_P7.62mm_Horizontal
R13: 100R; R_Axial_DIN0207_L6.3mm_D2.5mm_P7.62mm_Horizontal
RV1: 100k drive; Potentiometer_Alpha_RD901F-40-00D_Single_Vertical
RV2: 100k cutoff; Potentiometer_Alpha_RD901F-40-00D_Single_Vertical
RV3: 100k resonance; Potentiometer_Alpha_RD901F-40-00D_Single_Vertical
SW1: LP/HP
U1: AS3320; DIP-18_W7.62mm
U2: TL074; DIP-14_W7.62mm
U3: 24C02; DIP-8_W7.62mm

Connections:
+3V3: C10.1, JP1.3 (B), JP2.3 (B), JP3.3 (B), U3.8 (VCC)
+5V: C11.1, J1.5, RV2.1
+12V: C6.1, C8.1, D1.2 (K), D2.2 (K), D3.2 (K), J1.1, U1.14 (VCC), U2.4 (V+)
-12V: C7.1, C9.1, J1.3, R7.2, U1.13 (VEE), U2.11 (V-)
AUD_BUF: R9.1, RV1.1, U2.1, U2.2 (-)
AUD_IN: D1.3 (COM), J1.19, R1.1, U2.3 (+)
AUD_OUT: C5.2, J1.20, R13.2, R14.1
CAP1: C1.1, U1.5 (CAP1)
CAP2: C2.1, U1.4 (CAP2)
CAP3: C3.1, U1.16 (CAP3)
CAP4: C4.1, U1.11 (CAP4)
CUTSUM: R3.2, R4.1, R5.2, U2.6 (-)
CUT_D: R4.2, R6a.1, U2.7
CUT_INV: R6a.2, R6b.1, U2.13 (-)
CUT_NI: R6.1, R6b.2, U2.14
CUT_P: R5.1, RV2.2
CV1: D2.3 (COM), J1.9, R3.1
CV2: D3.3 (COM), J1.11, R8.1
DRIVE_W: R2.1, RV1.2
EE_A0: JP1.2 (C), U3.1 (A0)
EE_A1: JP2.2 (C), U3.2 (A1)
EE_A2: JP3.2 (C), U3.3 (A2)
GND: C1.2, C2.2, C3.2, C4.2, C6.2, C7.2, C8.2, C9.2, C10.2, C11.2, D1.1 (A), D2.1 (A), D3.1 (A), J1.2, J1.4, J1.6, J1.10, J1.12, JP1.1 (A), JP2.1 (A), JP3.1 (A), R1.2, R12.2, R14.2, RV1.3, RV2.3, RV3.3, U1.3 (GND), U2.5 (+), U2.12 (+), U3.4 (GND), U3.7 (WP)
HP: R10.2, SW1.3 (C), U2.8
IN_INV: R9.2, R10.1, U2.9 (-)
IRES: R7.1, U1.9 (IRES)
LAD_IN: R2.2, U1.1 (IN1)
LP4_DIV: R11.2, R12.1, U2.10 (+)
OUT4: R11.1, SW1.1 (A), U1.10 (OUT4)
OUT_SEL: C5.1, R13.1, SW1.2 (B)
RES_W: R8.2, RV3.2
SCL: J1.22, U3.6 (SCL)
SDA: J1.21, U3.5 (SDA)
VCFI: R6.2, U1.12 (VCFI)
VRES: RV3.1, U1.8 (VRES)

Notes on the sheet:
LADDER-1 : AS3320 four pole ladder VCF (CEM3320 pinout). 4-pole LP / 4-pole HP, resonance up to self oscillation.
Cutoff CV on CV1 (1 V/oct, exponential input VCFI pin 12), resonance on CV2. Audio in AUD_IN, out AUD_OUT +/-5V AC.
Drive pot RV1 saturates the ladder input (Mug-style overdrive). Discrete BCM847 four-pole alternative: see availability.md.
