martiyanov/bukifon/hardware/modules/MOD-PROTO-1.kicad_sch

## KiCad design hardware/modules/MOD-PROTO-1.kicad_sch (2026-11-05)

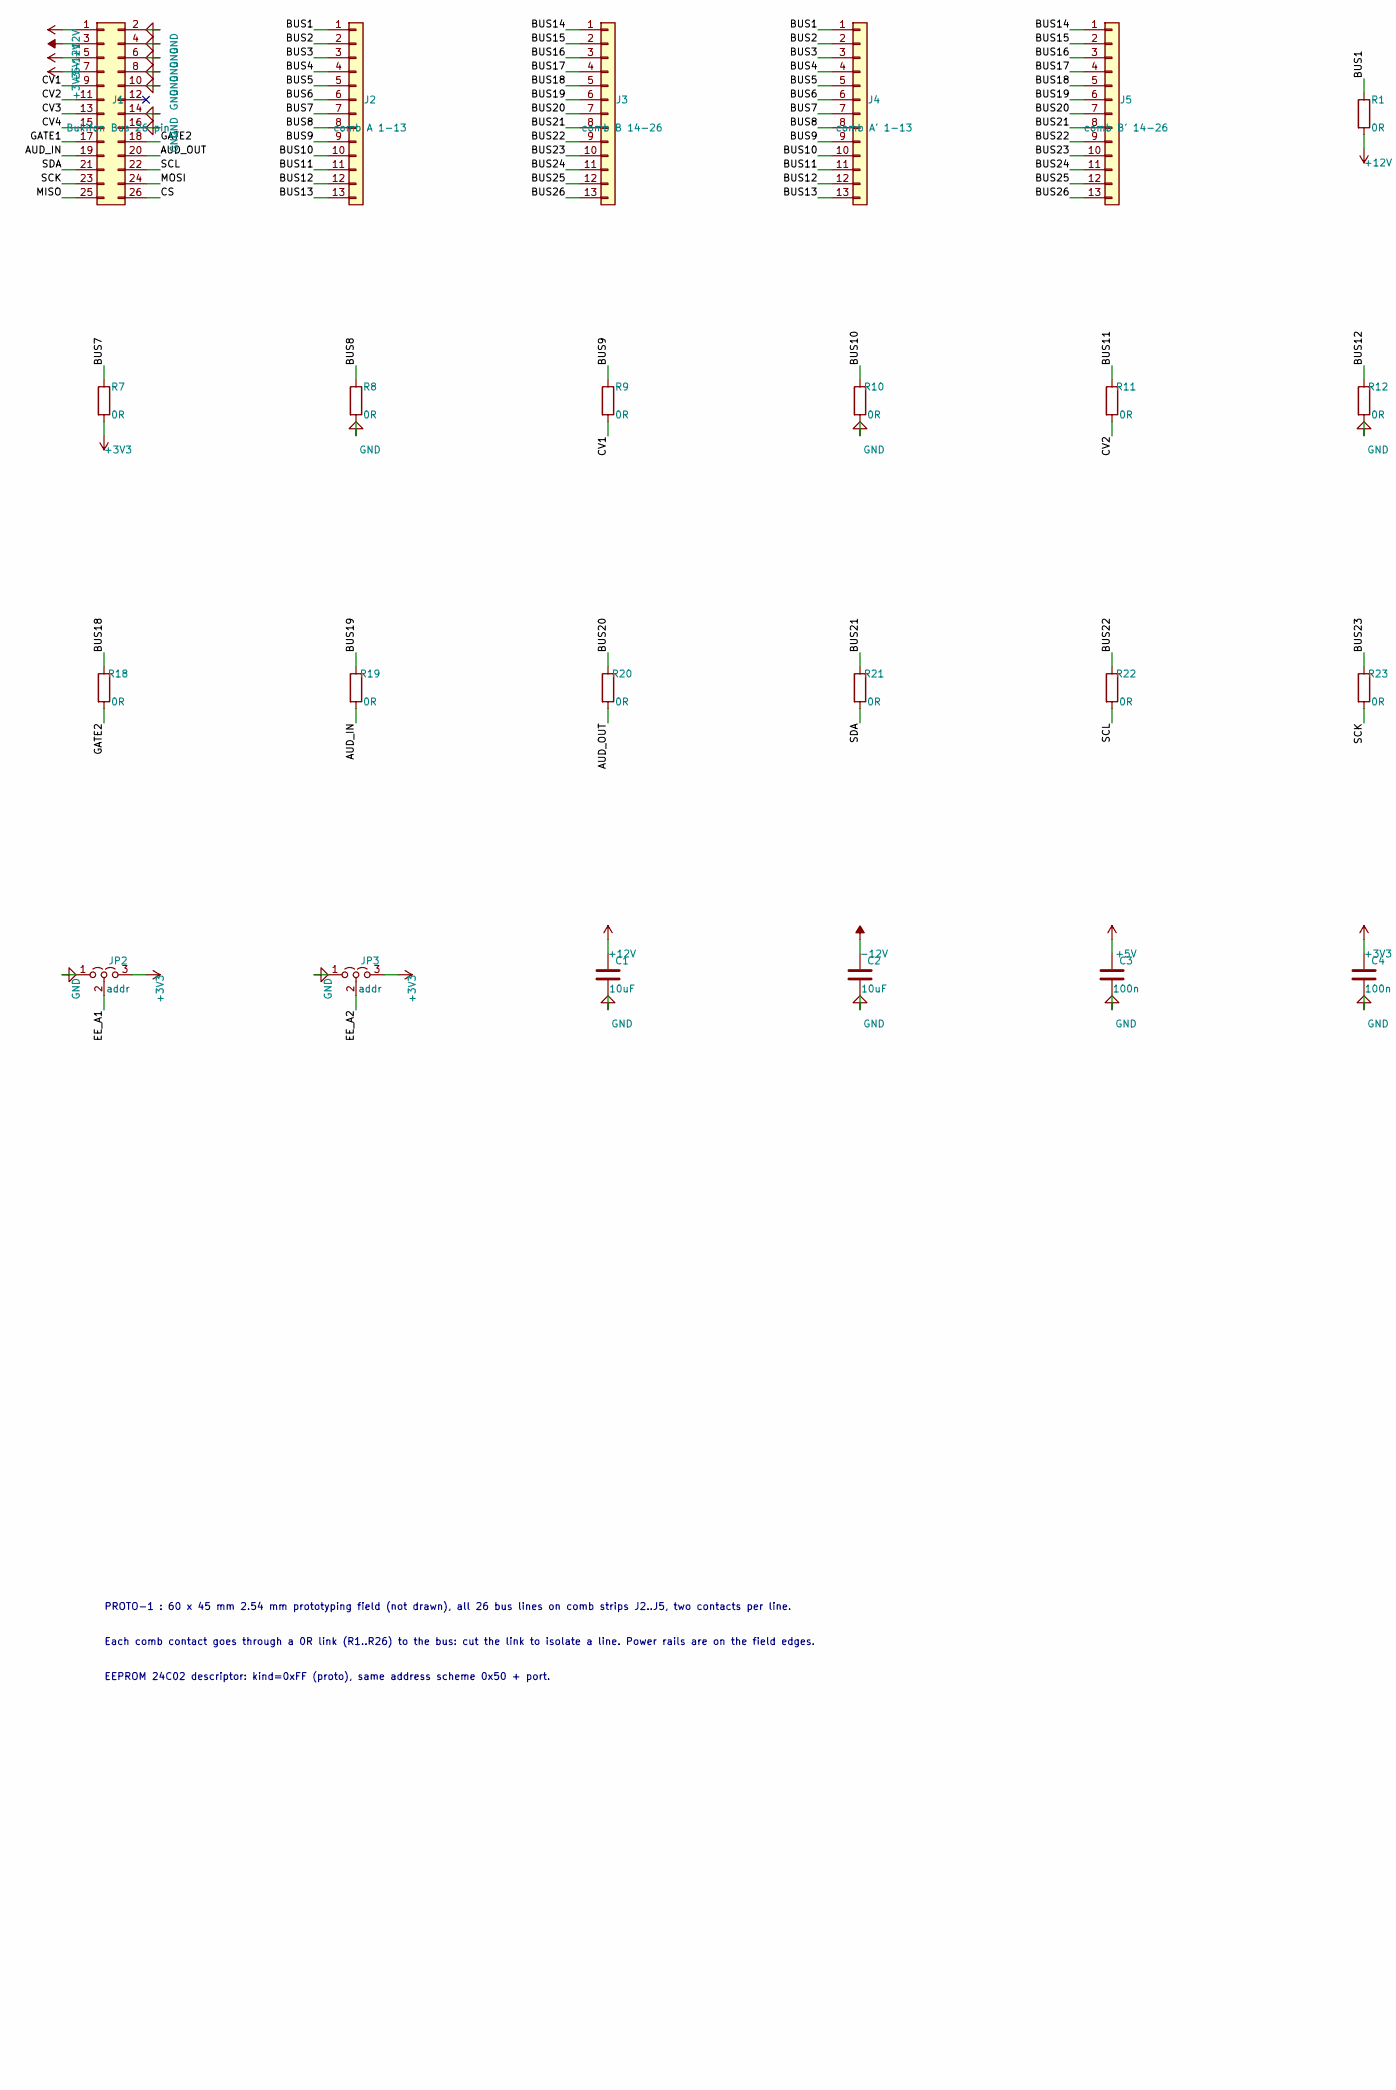
[picture p205: schematic MOD-PROTO-1.kicad_sch, part in row 1, column 1]

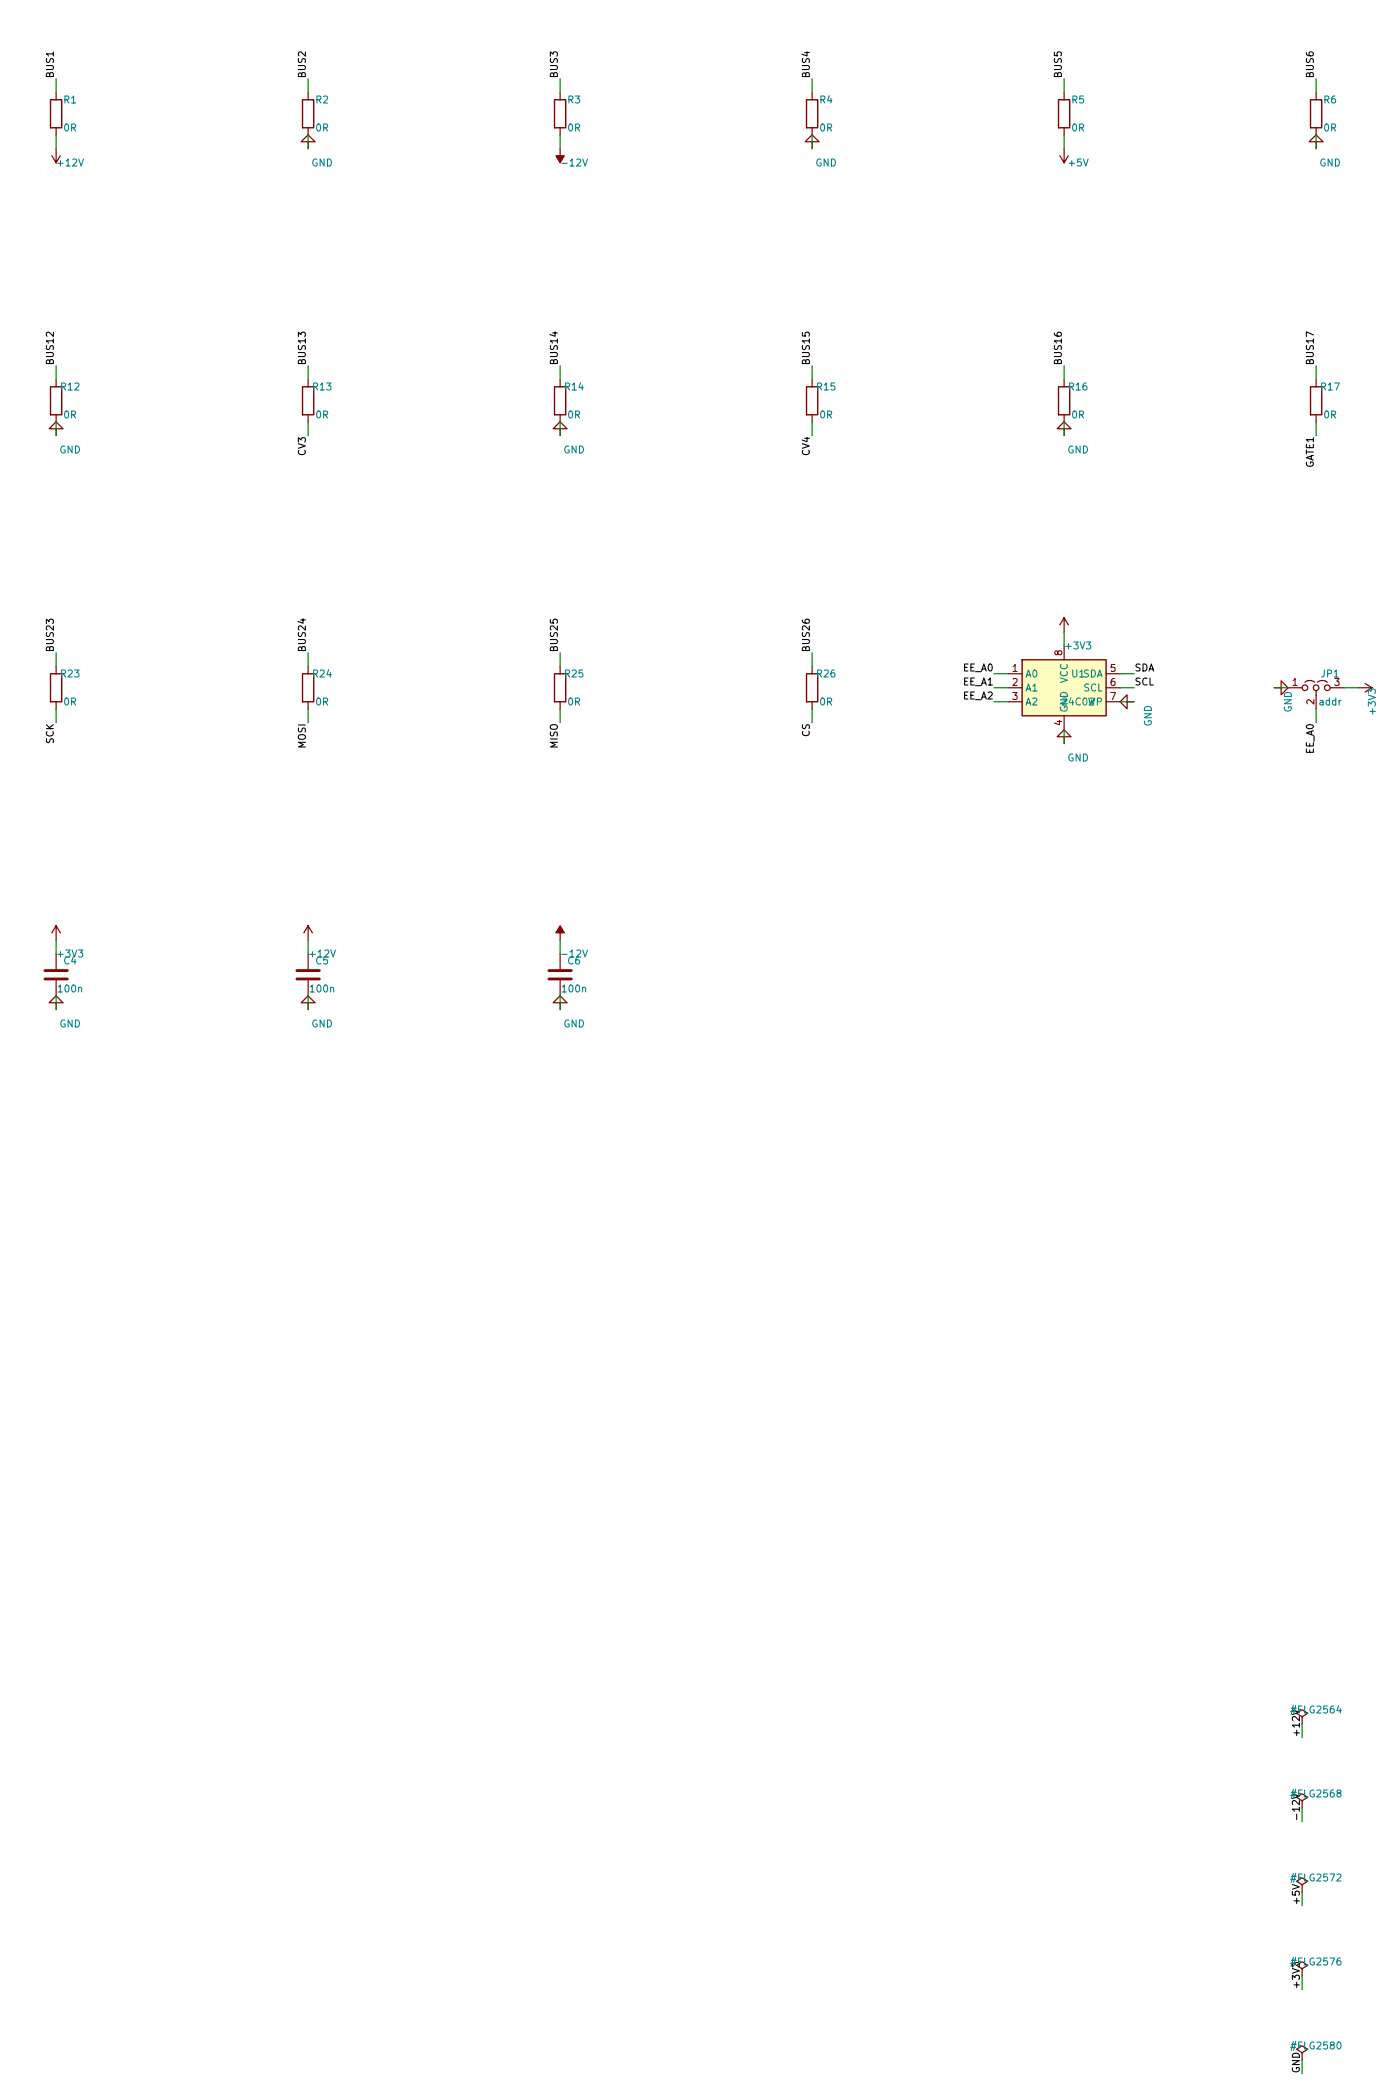
[picture p206: schematic MOD-PROTO-1.kicad_sch, part in row 1, column 2]

Parts:
C1, C2: 10uF; CP_Radial_D6.3mm_P2.50mm
C3, C4, C5, C6: 100n; CP_Radial_D6.3mm_P2.50mm
J1: Bukifon Bus 26 pin; IDC-Header_2x13_P2.54mm_Vertical
J2: comb A 1-13; PinHeader_1x13_P2.54mm_Vertical
J3: comb B 14-26; PinHeader_1x13_P2.54mm_Vertical
J4: comb A' 1-13; PinHeader_1x13_P2.54mm_Vertical
J5: comb B' 14-26; PinHeader_1x13_P2.54mm_Vertical
JP1, JP2, JP3: addr; D_SOD-323
R1, R2, R3, R4, R5, R6, R7, R8, R9, R10, R11, R12, R13, R14, R15, R16, R17, R18, R19, R20, R21, R22, R23, R24, R25, R26: 0R; R_Axial_DIN0207_L6.3mm_D2.5mm_P7.62mm_Horizontal
U1: 24C02; DIP-8_W7.62mm

Connections:
+3V3: C4.1, J1.7, JP1.3 (B), JP2.3 (B), JP3.3 (B), R7.2, U1.8 (VCC)
+5V: C3.1, J1.5, R5.2
+12V: C1.1, C5.1, J1.1, R1.2
-12V: C2.1, C6.1, J1.3, R3.2
AUD_IN: J1.19, R19.2
AUD_OUT: J1.20, R20.2
BUS1: J2.1, J4.1, R1.1
BUS2: J2.2, J4.2, R2.1
BUS3: J2.3, J4.3, R3.1
BUS4: J2.4, J4.4, R4.1
BUS5: J2.5, J4.5, R5.1
BUS6: J2.6, J4.6, R6.1
BUS7: J2.7, J4.7, R7.1
BUS8: J2.8, J4.8, R8.1
BUS9: J2.9, J4.9, R9.1
BUS10: J2.10, J4.10, R10.1
BUS11: J2.11, J4.11, R11.1
BUS12: J2.12, J4.12, R12.1
BUS13: J2.13, J4.13, R13.1
BUS14: J3.1, J5.1, R14.1
BUS15: J3.2, J5.2, R15.1
BUS16: J3.3, J5.3, R16.1
BUS17: J3.4, J5.4, R17.1
BUS18: J3.5, J5.5, R18.1
BUS19: J3.6, J5.6, R19.1
BUS20: J3.7, J5.7, R20.1
BUS21: J3.8, J5.8, R21.1
BUS22: J3.9, J5.9, R22.1
BUS23: J3.10, J5.10, R23.1
BUS24: J3.11, J5.11, R24.1
BUS25: J3.12, J5.12, R25.1
BUS26: J3.13, J5.13, R26.1
CS: J1.26, R26.2
CV1: J1.9, R9.2
CV2: J1.11, R11.2
CV3: J1.13, R13.2
CV4: J1.15, R15.2
EE_A0: JP1.2 (C), U1.1 (A0)
EE_A1: JP2.2 (C), U1.2 (A1)
EE_A2: JP3.2 (C), U1.3 (A2)
GATE1: J1.17, R17.2
GATE2: J1.18, R18.2
GND: C1.2, C2.2, C3.2, C4.2, C5.2, C6.2, J1.2, J1.4, J1.6, J1.8, J1.10, J1.14, J1.16, JP1.1 (A), JP2.1 (A), JP3.1 (A), R2.2, R4.2, R6.2, R8.2, R10.2, R12.2, R14.2, R16.2, U1.4 (GND), U1.7 (WP)
MISO: J1.25, R25.2
MOSI: J1.24, R24.2
SCK: J1.23, R23.2
SCL: J1.22, R22.2, U1.6 (SCL)
SDA: J1.21, R21.2, U1.5 (SDA)

Notes on the sheet:
PROTO-1 : 60 x 45 mm 2.54 mm prototyping field (not drawn), all 26 bus lines on comb strips J2..J5, two contacts per line.
Each comb contact goes through a 0R link (R1..R26) to the bus: cut the link to isolate a line. Power rails are on the field edges.
EEPROM 24C02 descriptor: kind=0xFF (proto), same address scheme 0x50 + port.
