martiyanov/bukifon/hardware/modules/MOD-VCO-1.kicad_sch

## KiCad design hardware/modules/MOD-VCO-1.kicad_sch (2026-11-05)

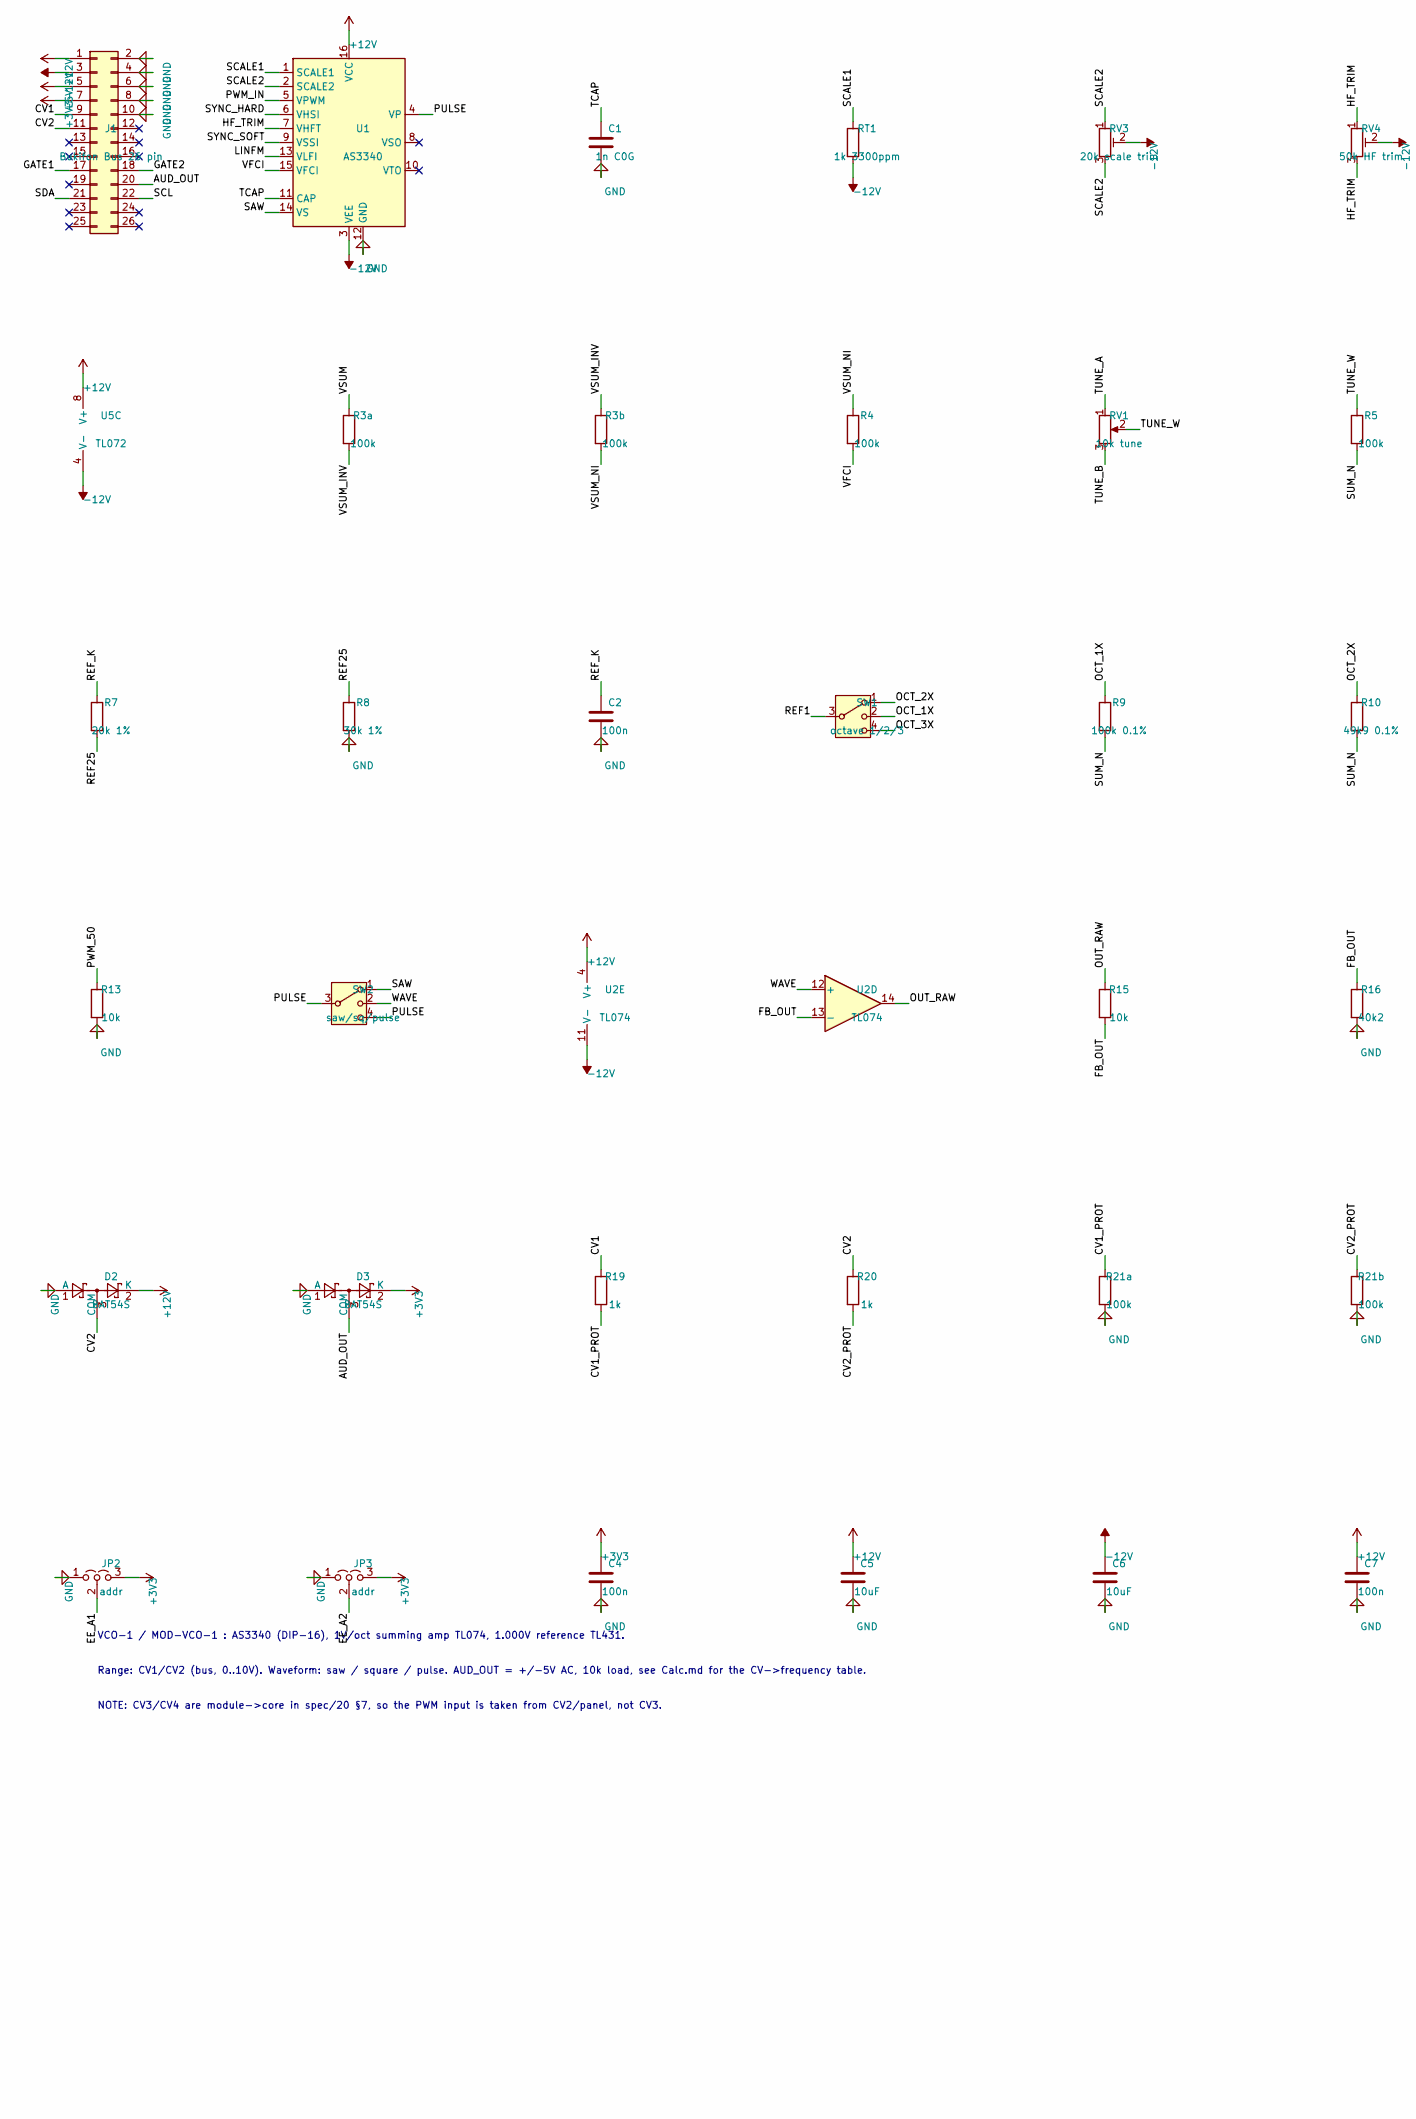
[picture p207: schematic MOD-VCO-1.kicad_sch, part in row 1, column 1]

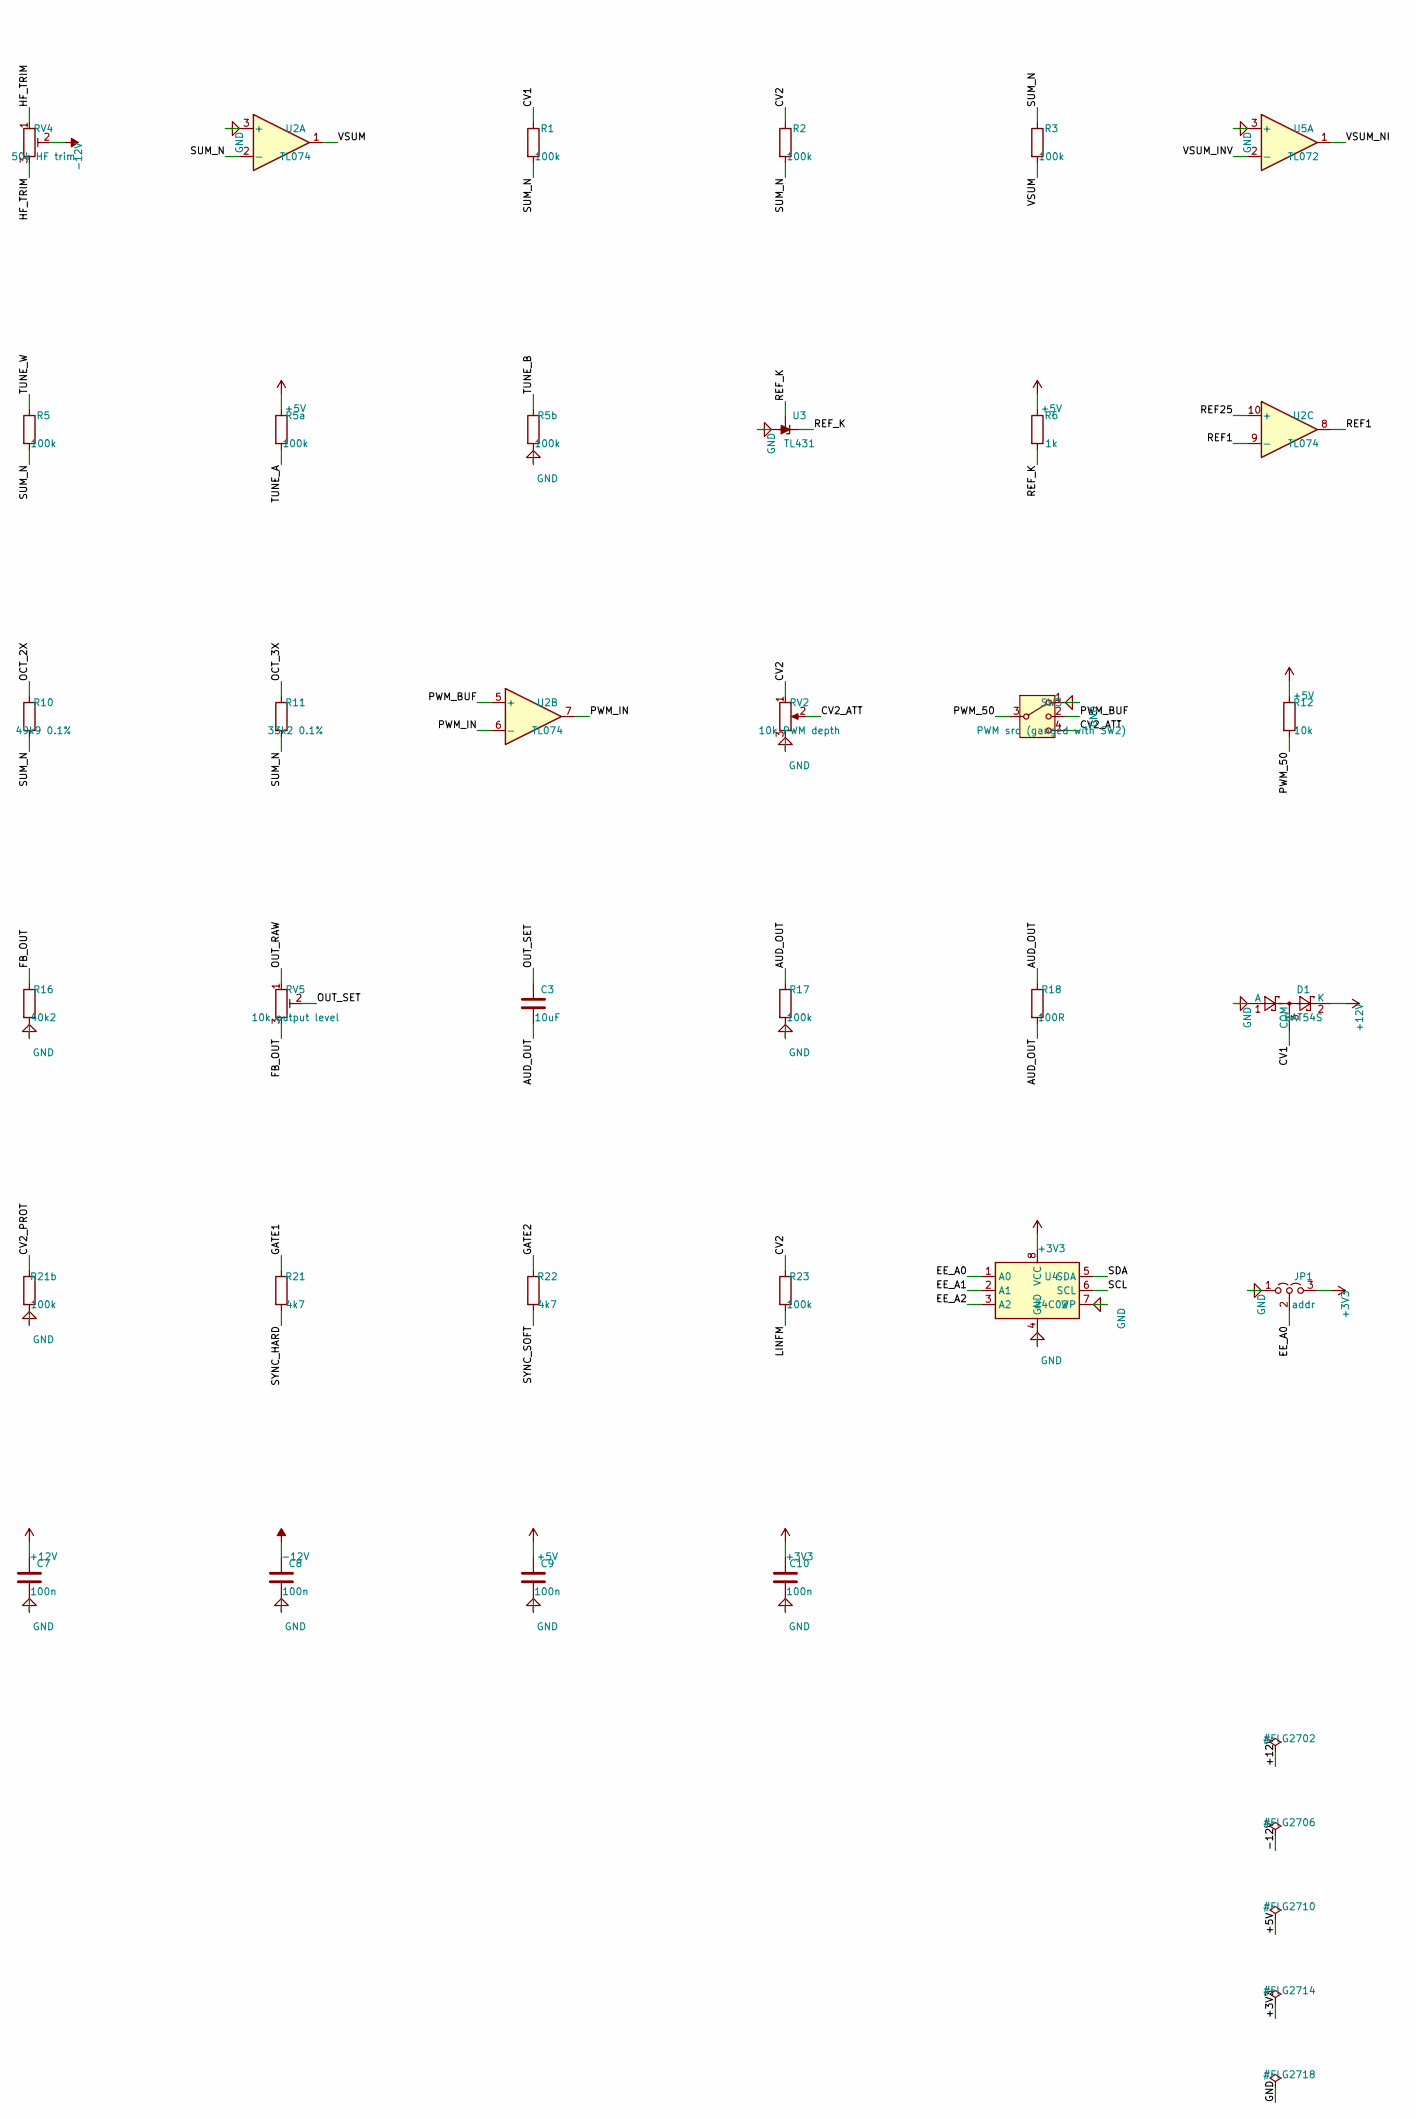
[picture p208: schematic MOD-VCO-1.kicad_sch, part in row 1, column 2]

Parts:
C1: 1n C0G; C_Disc_D5.0mm_W2.5mm_P5.00mm
C2, C4: 100n; C_Disc_D5.0mm_W2.5mm_P5.00mm
C3, C5, C6: 10uF; CP_Radial_D6.3mm_P2.50mm
C7, C8, C9, C10: 100n; CP_Radial_D6.3mm_P2.50mm
D1, D2, D3: BAT54S; D_SOD-323
J1: Bukifon Bus 26 pin; IDC-Header_2x13_P2.54mm_Vertical
JP1, JP2, JP3: addr; D_SOD-323
R1, R2, R3, R3a, R3b, R4, R5, R5a, R5b, R17, R21a, R21b, R23: 100k; R_Axial_DIN0207_L6.3mm_D2.5mm_P7.62mm_Horizontal
R6, R19, R20: 1k; R_Axial_DIN0207_L6.3mm_D2.5mm_P7.62mm_Horizontal
R7: 20k 1%; R_Axial_DIN0207_L6.3mm_D2.5mm_P7.62mm_Horizontal
R8: 30k 1%; R_Axial_DIN0207_L6.3mm_D2.5mm_P7.62mm_Horizontal
R9: 100k 0.1%; R_Axial_DIN0207_L6.3mm_D2.5mm_P7.62mm_Horizontal
R10: 49k9 0.1%; R_Axial_DIN0207_L6.3mm_D2.5mm_P7.62mm_Horizontal
R11: 33k2 0.1%; R_Axial_DIN0207_L6.3mm_D2.5mm_P7.62mm_Horizontal
R12, R13, R15: 10k; R_Axial_DIN0207_L6.3mm_D2.5mm_P7.62mm_Horizontal
R16: 40k2; R_Axial_DIN0207_L6.3mm_D2.5mm_P7.62mm_Horizontal
R18: 100R; R_Axial_DIN0207_L6.3mm_D2.5mm_P7.62mm_Horizontal
R21, R22: 4k7; R_Axial_DIN0207_L6.3mm_D2.5mm_P7.62mm_Horizontal
RT1: 1k 3300ppm; R_Axial_DIN0207_L6.3mm_D2.5mm_P7.62mm_Horizontal
RV1: 10k tune; Potentiometer_Alpha_RD901F-40-00D_Single_Vertical
RV2: 10k PWM depth; Potentiometer_Alpha_RD901F-40-00D_Single_Vertical
RV3: 20k scale trim; Potentiometer_Bourns_3296W_Vertical
RV4: 50k HF trim; Potentiometer_Bourns_3296W_Vertical
RV5: 10k output level; Potentiometer_Bourns_3296W_Vertical
SW1: octave 1/2/3
SW2: saw/sq/pulse
SW3: PWM src (ganged with SW2)
U1: AS3340; DIP-16_W7.62mm
U2: TL074; DIP-14_W7.62mm
U3: TL431; TO-92_Inline
U4: 24C02; DIP-8_W7.62mm
U5: TL072; DIP-8_W7.62mm

Connections:
+3V3: C4.1, C10.1, D3.2 (K), J1.7, JP1.3 (B), JP2.3 (B), JP3.3 (B), U4.8 (VCC)
+5V: C9.1, J1.5, R5a.1, R6.1, R12.1
+12V: C5.1, C7.1, D1.2 (K), D2.2 (K), J1.1, U1.16 (VCC), U2.4 (V+), U5.8 (V+)
-12V: C6.1, C8.1, J1.3, RT1.2, RV3.2, RV4.2, U1.3 (VEE), U2.11 (V-), U5.4 (V-)
AUD_OUT: C3.2, D3.3 (COM), J1.20, R17.1, R18.1, R18.2
CV1: D1.3 (COM), J1.9, R1.1, R19.1
CV1_PROT: R19.2, R21a.1
CV2: D2.3 (COM), J1.11, R2.1, R20.1, R23.1, RV2.1
CV2_ATT: RV2.2, SW3.4
CV2_PROT: R20.2, R21b.1
EE_A0: JP1.2 (C), U4.1 (A0)
EE_A1: JP2.2 (C), U4.2 (A1)
EE_A2: JP3.2 (C), U4.3 (A2)
FB_OUT: R15.2, R16.1, RV5.3, U2.13 (-)
GATE1: J1.17, R21.1
GATE2: J1.18, R22.1
GND: C1.2, C2.2, C4.2, C5.2, C6.2, C7.2, C8.2, C9.2, C10.2, D1.1 (A), D2.1 (A), D3.1 (A), J1.2, J1.4, J1.6, J1.8, J1.10, JP1.1 (A), JP2.1 (A), JP3.1 (A), R5b.2, R8.2, R13.2, R16.2, R17.2, R21a.2, R21b.2, RV2.3, SW3.1, U1.12 (GND), U2.3 (+), U3.2 (A), U4.4 (GND), U4.7 (WP), U5.3 (+)
HF_TRIM: RV4.1, RV4.3, U1.7 (VHFT)
LINFM: R23.2, U1.13 (VLFI)
OCT_1X: R9.1, SW1.2
OCT_2X: R10.1, SW1.1
OCT_3X: R11.1, SW1.4
OUT_RAW: R15.1, RV5.1, U2.14
OUT_SET: C3.1, RV5.2
PULSE: SW2.3, SW2.4, U1.4 (VP)
PWM_50: R12.2, R13.1, SW3.3
PWM_BUF: SW3.2, U2.5 (+)
PWM_IN: U1.5 (VPWM), U2.6 (-), U2.7
REF1: SW1.3, U2.8, U2.9 (-)
REF25: R7.2, R8.1, U2.10 (+)
REF_K: C2.1, R6.2, R7.1, U3.1 (REF), U3.3 (K)
SAW: SW2.1, U1.14 (VS)
SCALE1: RT1.1, U1.1 (SCALE1)
SCALE2: RV3.1, RV3.3, U1.2 (SCALE2)
SCL: J1.22, U4.6 (SCL)
SDA: J1.21, U4.5 (SDA)
SUM_N: R1.2, R2.2, R3.1, R5.2, R9.2, R10.2, R11.2, U2.2 (-)
SYNC_HARD: R21.2, U1.6 (VHSI)
SYNC_SOFT: R22.2, U1.9 (VSSI)
TCAP: C1.1, U1.11 (CAP)
TUNE_A: R5a.2, RV1.1
TUNE_B: R5b.1, RV1.3
TUNE_W: R5.1, RV1.2
VFCI: R4.2, U1.15 (VFCI)
VSUM: R3.2, R3a.1, U2.1
VSUM_INV: R3a.2, R3b.1, U5.2 (-)
VSUM_NI: R3b.2, R4.1, U5.1
WAVE: SW2.2, U2.12 (+)

Notes on the sheet:
VCO-1 / MOD-VCO-1 : AS3340 (DIP-16), 1V/oct summing amp TL074, 1.000V reference TL431.
Range: CV1/CV2 (bus, 0..10V). Waveform: saw / square / pulse. AUD_OUT = +/-5V AC, 10k load, see Calc.md for the CV->frequency table.
NOTE: CV3/CV4 are module->core in spec/20 §7, so the PWM input is taken from CV2/panel, not CV3.
