martiyanov/bukifon/hardware/power/PWR-BATT-1.kicad_sch

## KiCad design hardware/power/PWR-BATT-1.kicad_sch (2026-11-05)

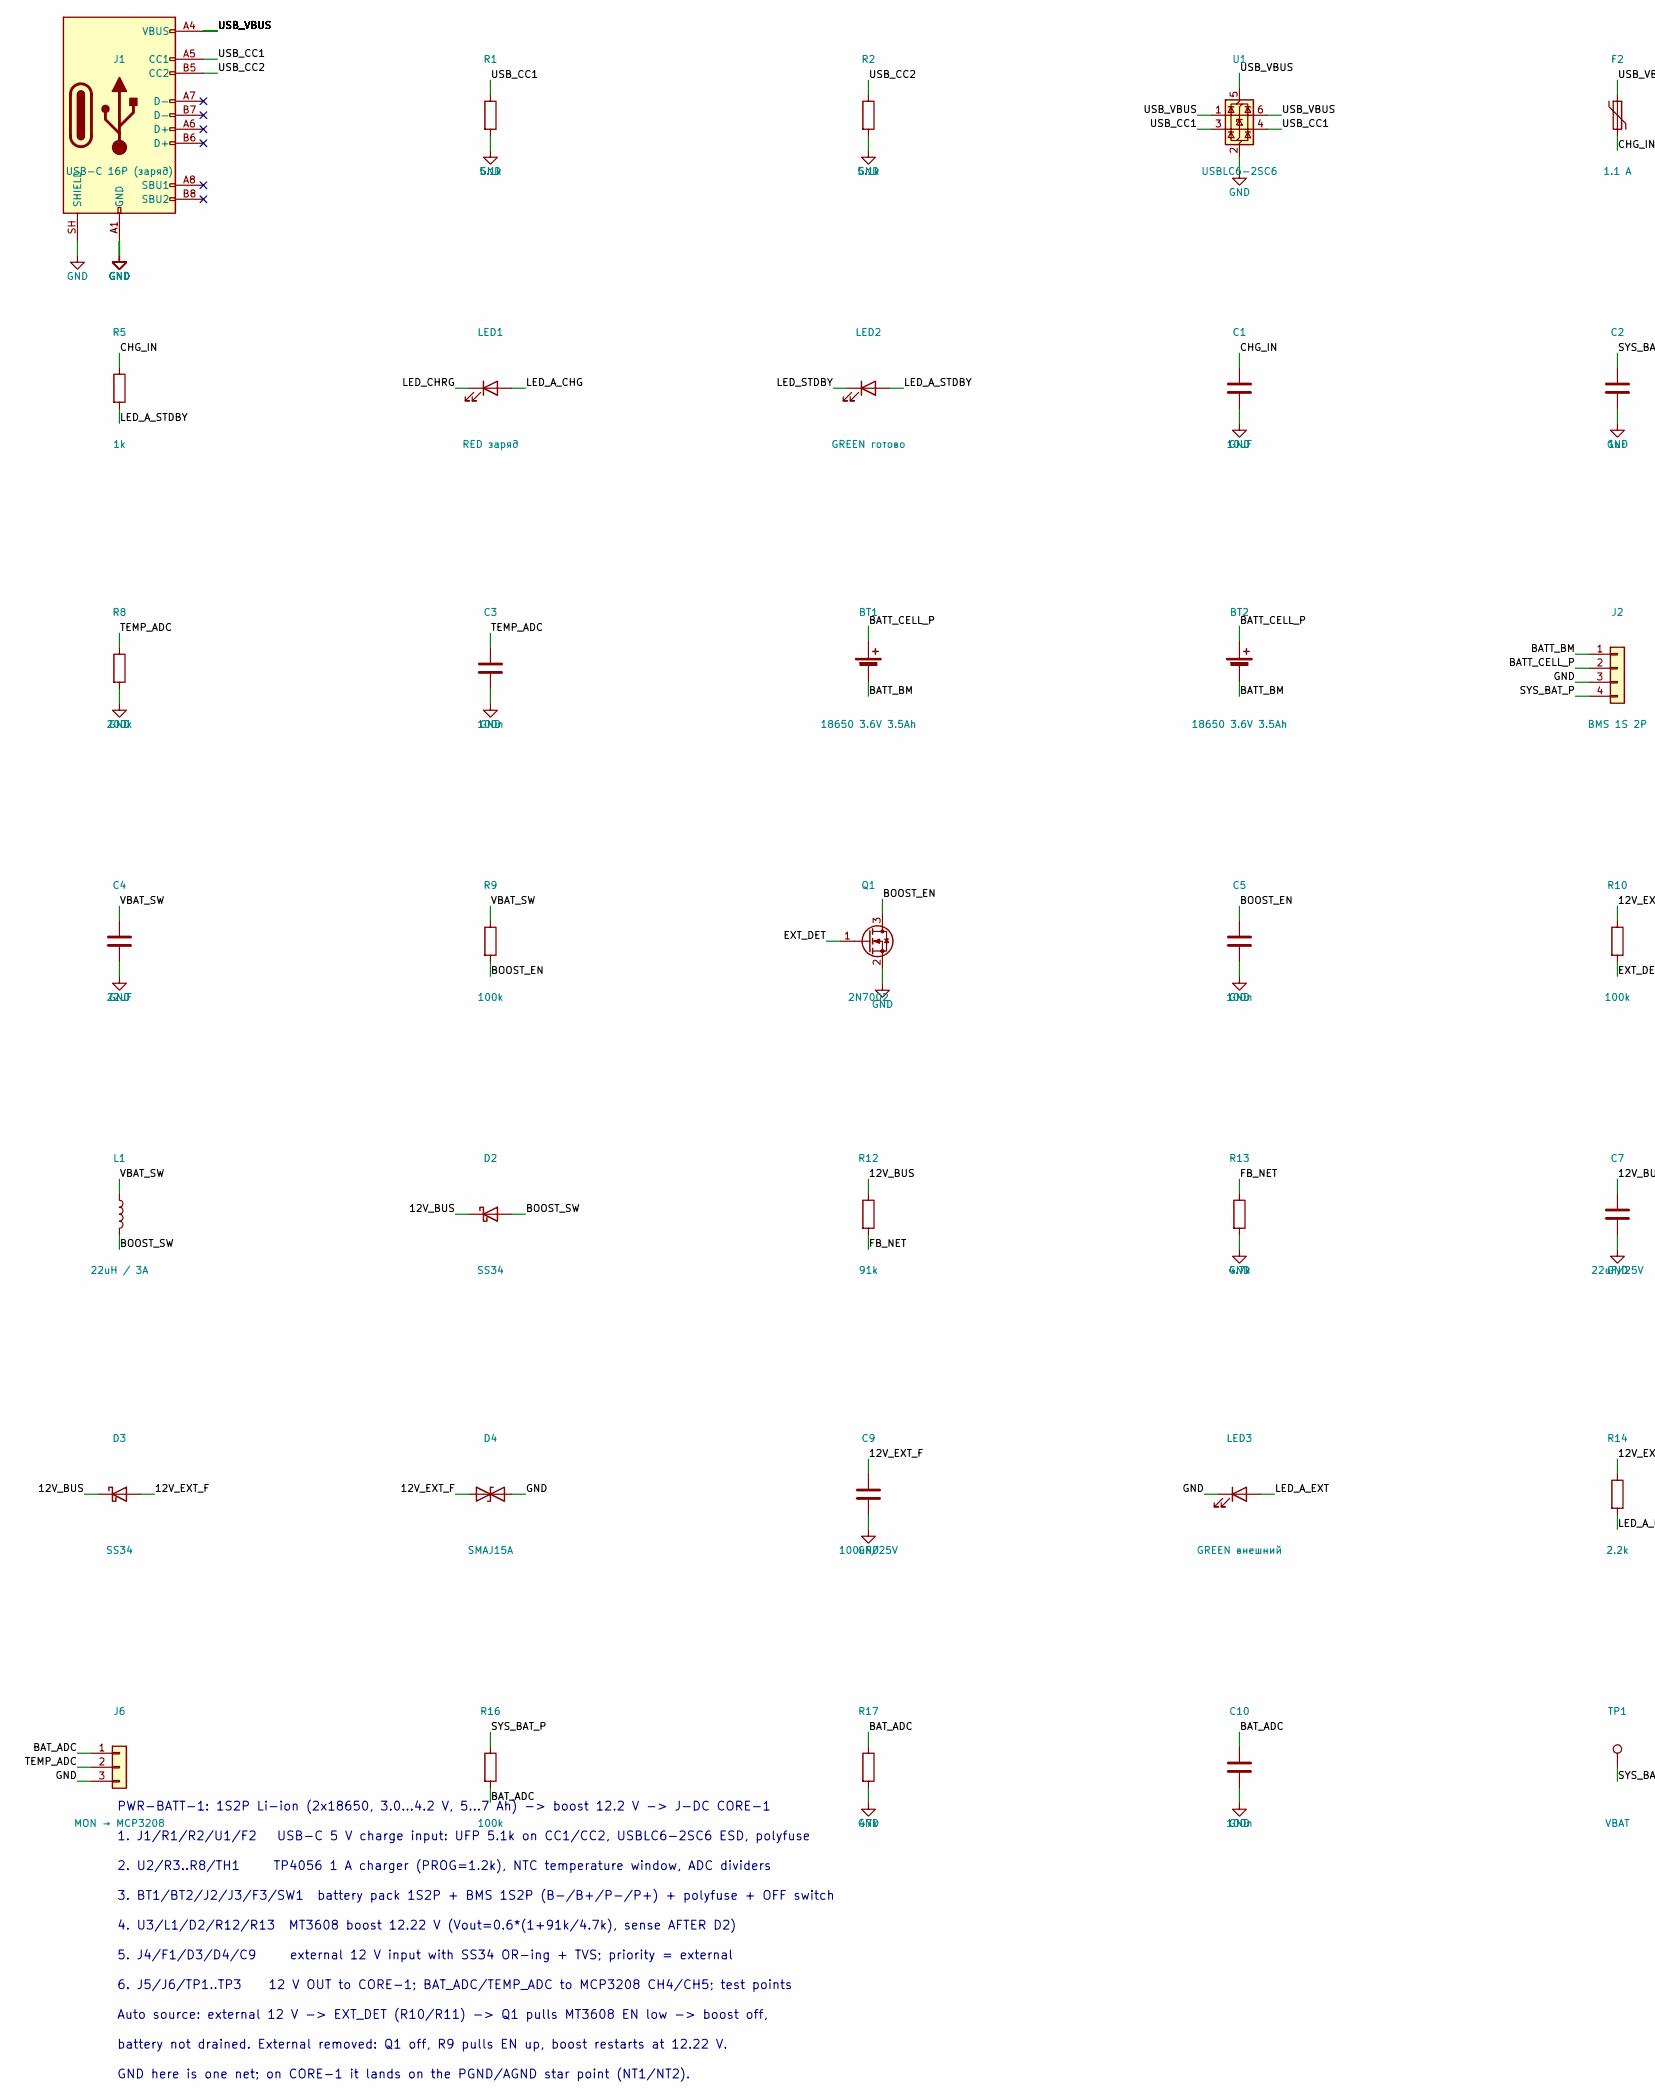
[picture p209: schematic PWR-BATT-1.kicad_sch, part in row 1, column 1]

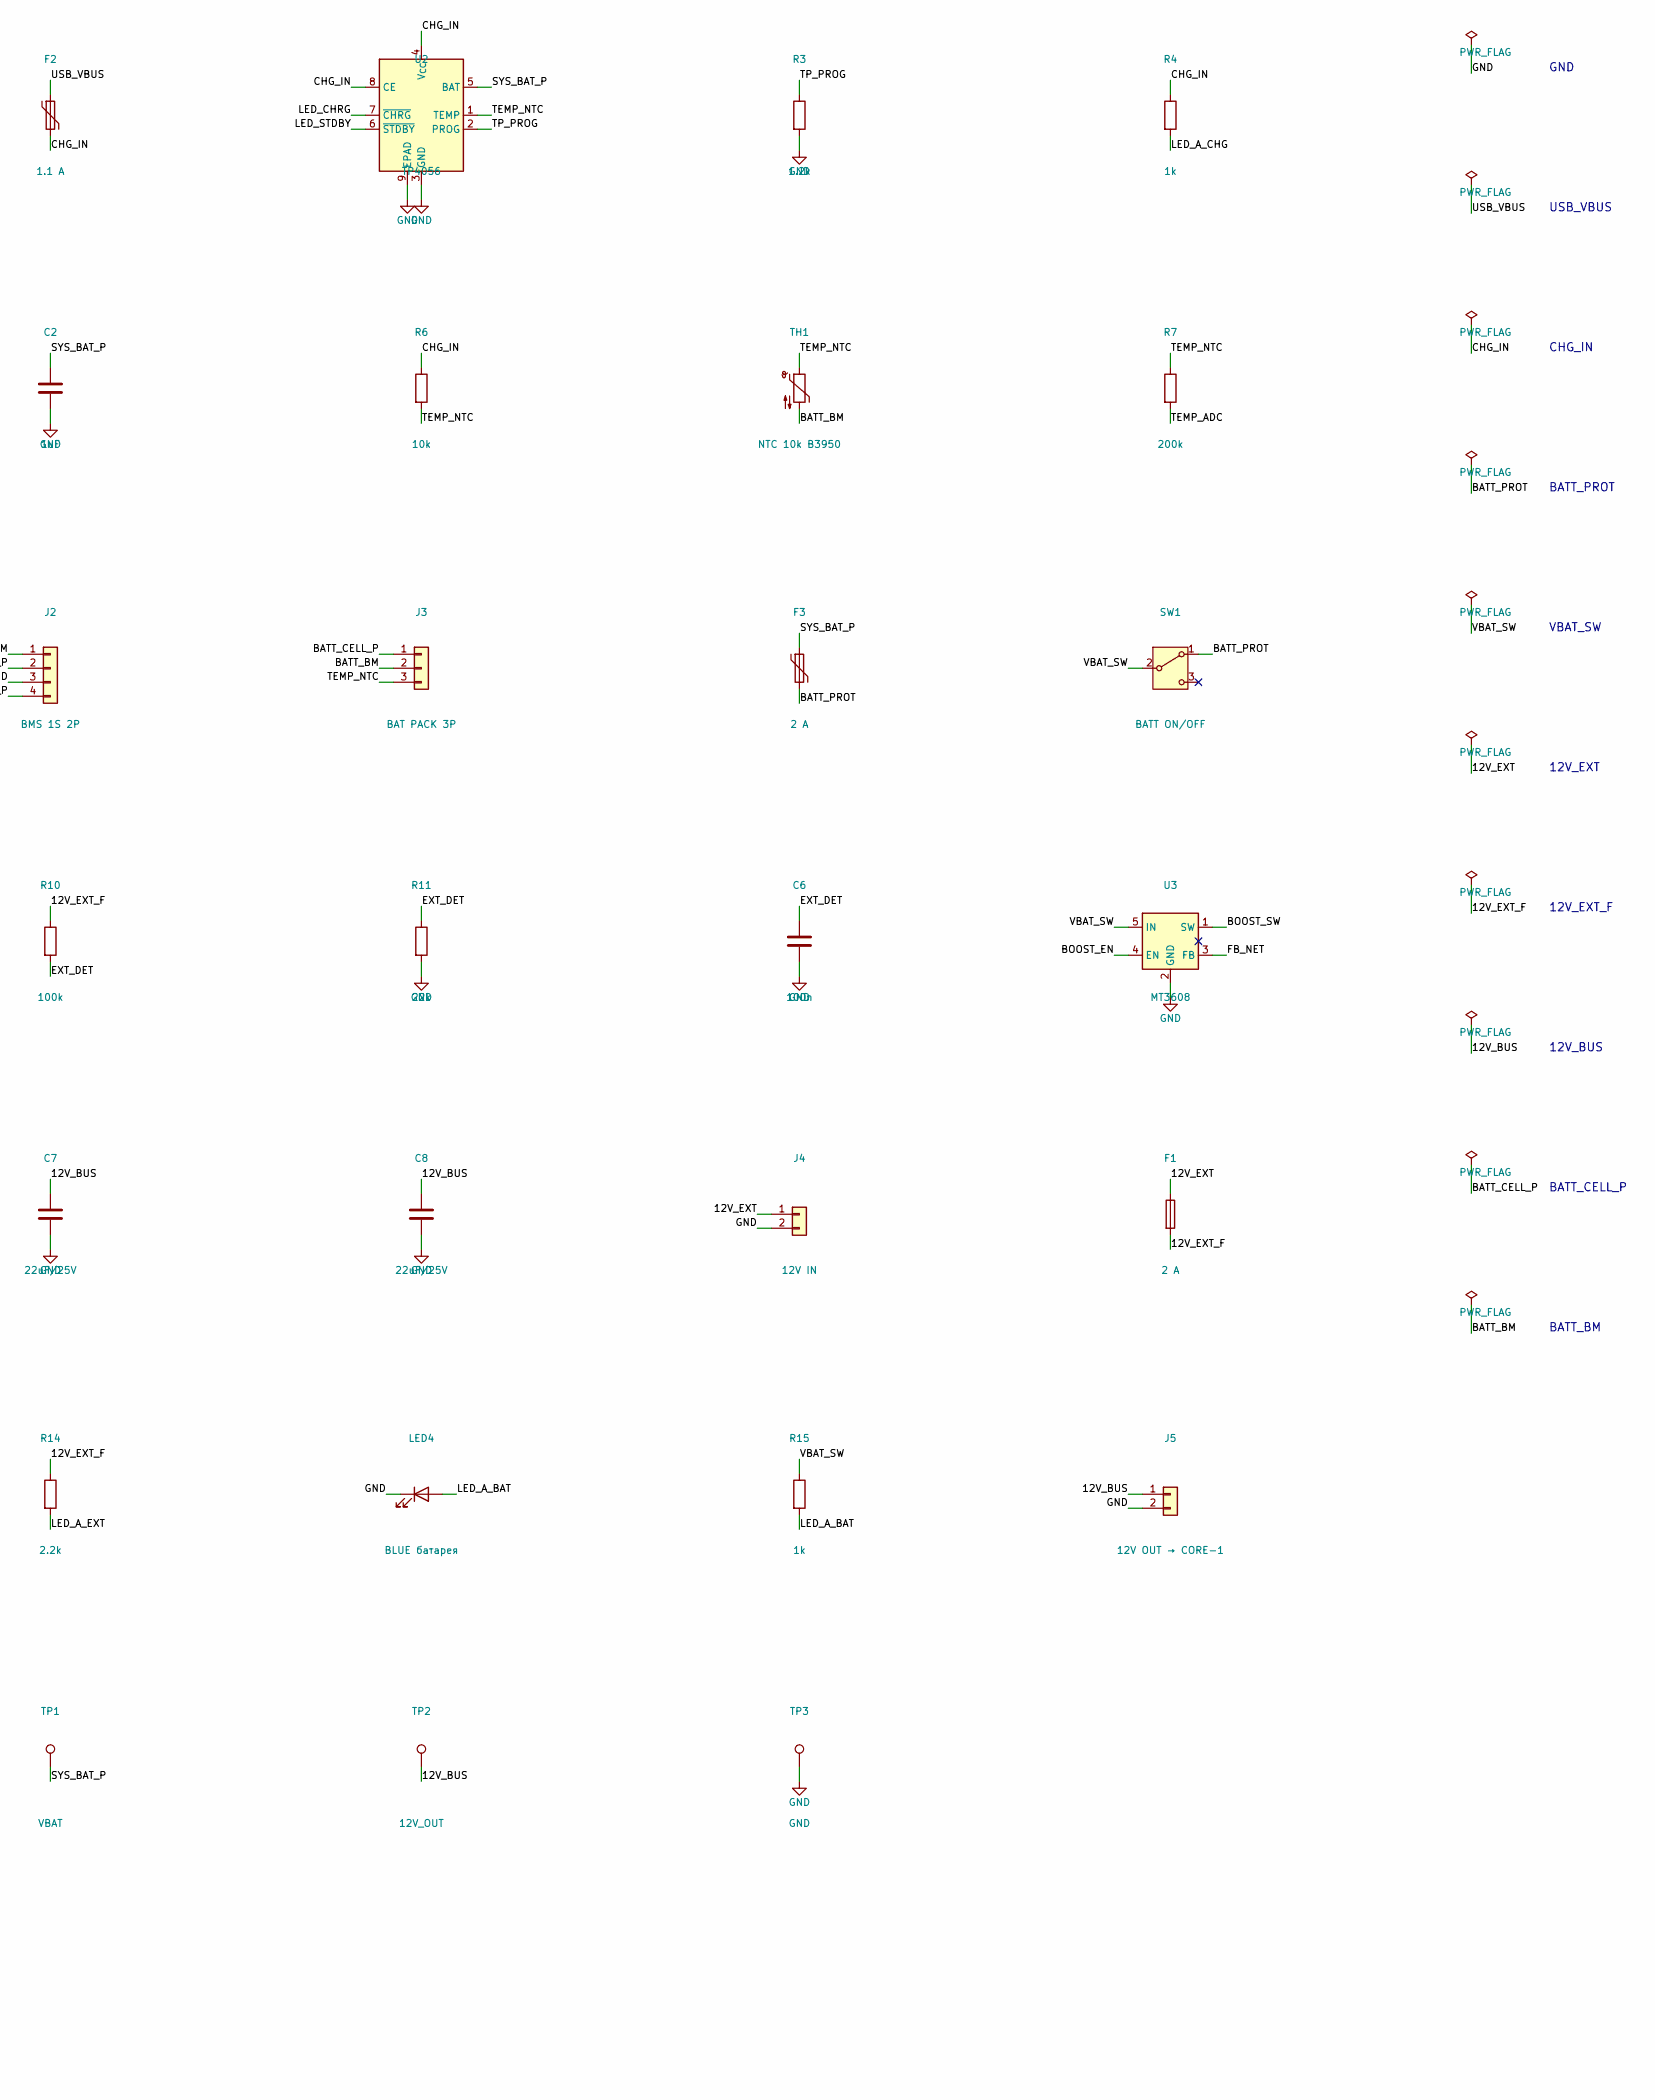
[picture p210: schematic PWR-BATT-1.kicad_sch, part in row 1, column 2]

Parts:
BT1, BT2: 18650 3.6V 3.5Ah; BatteryHolder_Keystone_1042_1x18650; MPN LiitoKala / Samsung INR18650-35E
C1: 10uF; C_0805_2012Metric; MPN CL21B106KOQNNNE
C2: 1uF; C_0805_2012Metric; MPN CL21B105KBFNNNE
C3, C5, C6, C10: 100n; C_0805_2012Metric; MPN CL21B104KBCNNNC
C4: 22uF; C_1210_3225Metric; MPN CL32A226KOJNNNE
C7, C8: 22uF/25V; C_1210_3225Metric; MPN CL32A226KOJNNNE
C9: 100uF/25V; CP_Elec_6.3x7.7; MPN Low ESR 100 мкФ 25 В
D2, D3: SS34; D_SMA; MPN SS34 (SMA)
D4: SMAJ15A; D_SMA; MPN SMAJ15A
F1, F3: 2 A; Fuse_1206_3216Metric; MPN MF-MSMF200 / 1206L200
F2: 1.1 A; Fuse_1206_3216Metric; MPN MF-MSMF110 / 1206L110
J1: USB-C 16P (заряд); USB_C_Receptacle_HRO_TYPE-C-31-M-12; MPN HRO TYPE-C-31-M-12
J2: BMS 1S 2P; PinHeader_1x04_P2.54mm_Vertical; MPN BMS 1S 2P 5 A (DW01A+FS8205A)
J3: BAT PACK 3P; TerminalBlock_4Ucon_1x03_P3.50mm_Vertical; MPN KF128-3P / 3.81 мм
J4: 12V IN; TerminalBlock_4Ucon_1x02_P3.50mm_Vertical; MPN KF128-2P / 3.81 мм
J5: 12V OUT → CORE-1; TerminalBlock_4Ucon_1x02_P3.50mm_Vertical; MPN KF128-2P / 3.81 мм
J6: MON → MCP3208; PinHeader_1x03_P2.54mm_Vertical; MPN PH-3P / XH-3P
L1: 22uH / 3A; L_Bourns-SRN6028; MPN Bourns SRN6028-220M
LED1: RED заряд; LED_0603_1608Metric
LED2: GREEN готово; LED_0603_1608Metric
LED3: GREEN внешний; LED_0603_1608Metric
LED4: BLUE батарея; LED_0603_1608Metric
Q1: 2N7002; SOT-23; MPN 2N7002
R1, R2: 5.1k; R_0603_1608Metric; MPN RC0603FR-075K1L
R3: 1.2k; R_0603_1608Metric; MPN RC0603FR-071K2L
R4, R5, R15: 1k; R_0603_1608Metric; MPN RC0603FR-071KL
R6: 10k; R_0603_1608Metric; MPN RC0603FR-0710KL
R7, R8: 200k; R_0603_1608Metric; MPN RC0603FR-07200KL
R9, R10, R16: 100k; R_0603_1608Metric; MPN RC0603FR-07100KL
R11: 22k; R_0603_1608Metric; MPN RC0603FR-0722KL
R12: 91k; R_0603_1608Metric; MPN RC0603FR-0791KL
R13: 4.7k; R_0603_1608Metric; MPN RC0603FR-074K7L
R14: 2.2k; R_0603_1608Metric; MPN RC0603FR-072K2L
R17: 47k; R_0603_1608Metric; MPN RC0603FR-0747KL
SW1: BATT ON/OFF; MPN MSK-12C02 (SPDT слайдер)
TH1: NTC 10k B3950; MPN NTC 10k B3950 (в батарейном отсеке)
TP1: VBAT; TestPoint_Pad_D1.5mm
TP2: 12V_OUT; TestPoint_Pad_D1.5mm
TP3: GND; TestPoint_Pad_D1.5mm
U1: USBLC6-2SC6; SOT-23-6; MPN USBLC6-2SC6
U2: TP4056; SOIC-8-1EP_3.9x4.9mm_P1.27mm_EP2.41x3.3mm; MPN TP4056-42-ESOP8
U3: MT3608; SOT-23-6; MPN MT3608

Connections:
12V_BUS: C7.1, C8.1, D2.1 (K), D3.1 (K), J5.1, R12.1, TP2.1
12V_EXT: F1.1, J4.1
12V_EXT_F: C9.1, D3.2 (A), D4.1 (A1), F1.2, R10.1, R14.1
BATT_BM: BT1.2 (-), BT2.2 (-), J2.1, J3.2, TH1.2
BATT_CELL_P: BT1.1 (+), BT2.1 (+), J2.2, J3.1
BATT_PROT: F3.2, SW1.1 (A)
BAT_ADC: C10.1, J6.1, R16.2, R17.1
BOOST_EN: C5.1, Q1.3 (D), R9.2, U3.4 (EN)
BOOST_SW: D2.2 (A), L1.2, U3.1 (SW)
CHG_IN: C1.1, F2.2, R4.1, R5.1, R6.1, U2.4 (V_{CC}), U2.8 (CE)
EXT_DET: C6.1, Q1.1 (G), R10.2, R11.1
FB_NET: R12.2, R13.1, U3.3 (FB)
GND: C1.2, C2.2, C3.2, C4.2, C5.2, C6.2, C7.2, C8.2, C9.2, C10.2, D4.2 (A2), J1.A1 (GND), J1.A12 (GND), J1.B1 (GND), J1.B12 (GND), J1.SH (SHIELD), J2.3, J4.2, J5.2, J6.3, LED3.1 (K), LED4.1 (K), Q1.2 (S), R1.2, R2.2, R3.2, R8.2, R11.2, R13.2, R17.2, TP3.1, U1.2 (GND), U2.3 (GND), U2.9 (EPAD), U3.2 (GND)
LED_A_BAT: LED4.2 (A), R15.2
LED_A_CHG: LED1.2 (A), R4.2
LED_A_EXT: LED3.2 (A), R14.2
LED_A_STDBY: LED2.2 (A), R5.2
LED_CHRG: LED1.1 (K), U2.7 (~CHRG)
LED_STDBY: LED2.1 (K), U2.6 (~STDBY)
SYS_BAT_P: C2.1, F3.1, J2.4, R16.1, TP1.1, U2.5 (BAT)
TEMP_ADC: C3.1, J6.2, R7.2, R8.1
TEMP_NTC: J3.3, R6.2, R7.1, TH1.1, U2.1 (TEMP)
TP_PROG: R3.1, U2.2 (PROG)
USB_CC1: J1.A5 (CC1), R1.1, U1.3 (I/O2), U1.4 (I/O2)
USB_CC2: J1.B5 (CC2), R2.1
USB_VBUS: F2.1, J1.A4 (VBUS), J1.A9 (VBUS), J1.B4 (VBUS), J1.B9 (VBUS), U1.1 (I/O1), U1.5 (VBUS), U1.6 (I/O1)
VBAT_SW: C4.1, L1.1, R9.1, R15.1, SW1.2 (B), U3.5 (IN)

Notes on the sheet:
PWR-BATT-1: 1S2P Li-ion (2x18650, 3.0...4.2 V, 5...7 Ah) -> boost 12.2 V -> J-DC CORE-1
1. J1/R1/R2/U1/F2 USB-C 5 V charge input: UFP 5.1k on CC1/CC2, USBLC6-2SC6 ESD, polyfuse
2. U2/R3..R8/TH1 TP4056 1 A charger (PROG=1.2k), NTC temperature window, ADC dividers
3. BT1/BT2/J2/J3/F3/SW1 battery pack 1S2P + BMS 1S2P (B-/B+/P-/P+) + polyfuse + OFF switch
4. U3/L1/D2/R12/R13 MT3608 boost 12.22 V (Vout=0.6*(1+91k/4.7k), sense AFTER D2)
5. J4/F1/D3/D4/C9 external 12 V input with SS34 OR-ing + TVS; priority = external
6. J5/J6/TP1..TP3 12 V OUT to CORE-1; BAT_ADC/TEMP_ADC to MCP3208 CH4/CH5; test points
Auto source: external 12 V -> EXT_DET (R10/R11) -> Q1 pulls MT3608 EN low -> boost off,
battery not drained. External removed: Q1 off, R9 pulls EN up, boost restarts at 12.22 V.
GND here is one net; on CORE-1 it lands on the PGND/AGND star point (NT1/NT2).
GND
USB_VBUS
CHG_IN
BATT_PROT
VBAT_SW
12V_EXT
12V_EXT_F
12V_BUS
BATT_CELL_P
BATT_BM
