martiyanov/bukifon/hardware/panel/deck-keys/deck-keys.kicad_sch

## KiCad design hardware/panel/deck-keys/deck-keys.kicad_sch (2026-11-05)

Schematic: deck-keys.kicad_sch

Parts:
C1, C101, C102, C103, C104, C105, C106, C107, C108, C109, C110, C111, C112, C113, C114, C115, C116, C117, C118, C119, C120, C121, C122, C123, C124, C125, C126, C127, C128, C129, C130, C131, C132, C133, C134, C135, C136, C137, C138, C139, C140, C141, C142: 100n; C_0603_1608Metric
D1, D2, D3, D4, D5, D6, D7, D8, D9, D10, D11, D12, D13, D14, D15, D16, D17, D18, D19, D20, D21, D22, D23, D24, D25, D26, D27, D28, D29, D30, D31, D32, D33, D34, D35, D36, D37, D38, D39, D40, D41, D42: 1N4148; D_SOD-323
J-DECK: IDC16; IDC-Header_2x08_P2.54mm_Vertical
KEY1, KEY2, KEY3, KEY4, KEY5, KEY6, KEY7, KEY8, KEY9, KEY10, KEY11, KEY12, KEY13, KEY14, KEY15, KEY16, KEY17, KEY18, KEY19, KEY20, KEY21, KEY22, KEY23, KEY24, KEY25, KEY26, KEY27, KEY28, KEY29, KEY30, KEY31, KEY32, KEY33, KEY34, KEY35, KEY36, KEY37, KEY38, KEY39, KEY40, KEY41, KEY42: CHOC
LED_KEY1, LED_KEY2, LED_KEY3, LED_KEY4, LED_KEY5, LED_KEY6, LED_KEY7, LED_KEY8, LED_KEY9, LED_KEY10, LED_KEY11, LED_KEY12, LED_KEY13, LED_KEY14, LED_KEY15, LED_KEY16, LED_KEY17, LED_KEY18, LED_KEY19, LED_KEY20, LED_KEY21, LED_KEY22, LED_KEY23, LED_KEY24, LED_KEY25, LED_KEY26, LED_KEY27, LED_KEY28, LED_KEY29, LED_KEY30, LED_KEY31, LED_KEY32, LED_KEY33, LED_KEY34, LED_KEY35, LED_KEY36, LED_KEY37, LED_KEY38, LED_KEY39, LED_KEY40, LED_KEY41, LED_KEY42: SK6812MINI-E; LED_SK6812MINI-E_3.2x2.8mm_P1.5mm_ReverseMount
LED_MODE1, LED_MODE2: LED; LED_0603_1608Metric
R1, R21, R22, R23, R24, R25, R26, R27: 10k; R_0603_1608Metric
R2, R3: 1k; R_0603_1608Metric
R4: 3.3k; R_0603_1608Metric
R5: 33k; R_0603_1608Metric
SL1, SL2: POT30; Potentiometer_Bourns_PTA3043_Single_Slide
U1: MCP23017; DIP-28_W7.62mm

Connections:
+3V3: C1.1, J-DECK.1, LED_MODE1.2 (A), LED_MODE2.2 (A), R1.1, R4.1, R21.1, R22.1, R23.1, R24.1, R25.1, R26.1, R27.1, SL1.1, SL2.1, U1.9 (V_{DD})
+5V: C101.1, C102.1, C103.1, C104.1, C105.1, C106.1, C107.1, C108.1, C109.1, C110.1, C111.1, C112.1, C113.1, C114.1, C115.1, C116.1, C117.1, C118.1, C119.1, C120.1, C121.1, C122.1, C123.1, C124.1, C125.1, C126.1, C127.1, C128.1, C129.1, C130.1, C131.1, C132.1, C133.1, C134.1, C135.1, C136.1, C137.1, C138.1, C139.1, C140.1, C141.1, C142.1, J-DECK.16, LED_KEY1.3 (VDD), LED_KEY2.3 (VDD), LED_KEY3.3 (VDD), LED_KEY4.3 (VDD), LED_KEY5.3 (VDD), LED_KEY6.3 (VDD), LED_KEY7.3 (VDD), LED_KEY8.3 (VDD), LED_KEY9.3 (VDD), LED_KEY10.3 (VDD), LED_KEY11.3 (VDD), LED_KEY12.3 (VDD), LED_KEY13.3 (VDD), LED_KEY14.3 (VDD), LED_KEY15.3 (VDD), LED_KEY16.3 (VDD), LED_KEY17.3 (VDD), LED_KEY18.3 (VDD), LED_KEY19.3 (VDD), LED_KEY20.3 (VDD), LED_KEY21.3 (VDD), LED_KEY22.3 (VDD), LED_KEY23.3 (VDD), LED_KEY24.3 (VDD), LED_KEY25.3 (VDD), LED_KEY26.3 (VDD), LED_KEY27.3 (VDD), LED_KEY28.3 (VDD), LED_KEY29.3 (VDD), LED_KEY30.3 (VDD), LED_KEY31.3 (VDD), LED_KEY32.3 (VDD), LED_KEY33.3 (VDD), LED_KEY34.3 (VDD), LED_KEY35.3 (VDD), LED_KEY36.3 (VDD), LED_KEY37.3 (VDD), LED_KEY38.3 (VDD), LED_KEY39.3 (VDD), LED_KEY40.3 (VDD), LED_KEY41.3 (VDD), LED_KEY42.3 (VDD)
COL1: D1.1 (K), D7.1 (K), D13.1 (K), D22.1 (K), D28.1 (K), D34.1 (K), R21.2, U1.1 (GPB0)
COL2: D2.1 (K), D8.1 (K), D14.1 (K), D23.1 (K), D29.1 (K), D35.1 (K), R22.2, U1.2 (GPB1)
COL3: D3.1 (K), D9.1 (K), D15.1 (K), D24.1 (K), D30.1 (K), D36.1 (K), R23.2, U1.3 (GPB2)
COL4: D4.1 (K), D10.1 (K), D16.1 (K), D25.1 (K), D31.1 (K), D37.1 (K), R24.2, U1.4 (GPB3)
COL5: D5.1 (K), D11.1 (K), D17.1 (K), D26.1 (K), D32.1 (K), D38.1 (K), R25.2, U1.5 (GPB4)
COL6: D6.1 (K), D12.1 (K), D18.1 (K), D27.1 (K), D33.1 (K), D39.1 (K), R26.2, U1.6 (GPB5)
COL7: D19.1 (K), D20.1 (K), D21.1 (K), D40.1 (K), D41.1 (K), D42.1 (K), R27.2, U1.7 (GPB6)
DECK_ID: J-DECK.13, R4.2, R5.1
DECK_INT: J-DECK.5, U1.20 (INTA)
GND: C1.2, C101.2, C102.2, C103.2, C104.2, C105.2, C106.2, C107.2, C108.2, C109.2, C110.2, C111.2, C112.2, C113.2, C114.2, C115.2, C116.2, C117.2, C118.2, C119.2, C120.2, C121.2, C122.2, C123.2, C124.2, C125.2, C126.2, C127.2, C128.2, C129.2, C130.2, C131.2, C132.2, C133.2, C134.2, C135.2, C136.2, C137.2, C138.2, C139.2, C140.2, C141.2, C142.2, J-DECK.2, J-DECK.6, J-DECK.8, J-DECK.10, J-DECK.12, J-DECK.14, J-DECK.15, LED_KEY1.1 (VSS), LED_KEY2.1 (VSS), LED_KEY3.1 (VSS), LED_KEY4.1 (VSS), LED_KEY5.1 (VSS), LED_KEY6.1 (VSS), LED_KEY7.1 (VSS), LED_KEY8.1 (VSS), LED_KEY9.1 (VSS), LED_KEY10.1 (VSS), LED_KEY11.1 (VSS), LED_KEY12.1 (VSS), LED_KEY13.1 (VSS), LED_KEY14.1 (VSS), LED_KEY15.1 (VSS), LED_KEY16.1 (VSS), LED_KEY17.1 (VSS), LED_KEY18.1 (VSS), LED_KEY19.1 (VSS), LED_KEY20.1 (VSS), LED_KEY21.1 (VSS), LED_KEY22.1 (VSS), LED_KEY23.1 (VSS), LED_KEY24.1 (VSS), LED_KEY25.1 (VSS), LED_KEY26.1 (VSS), LED_KEY27.1 (VSS), LED_KEY28.1 (VSS), LED_KEY29.1 (VSS), LED_KEY30.1 (VSS), LED_KEY31.1 (VSS), LED_KEY32.1 (VSS), LED_KEY33.1 (VSS), LED_KEY34.1 (VSS), LED_KEY35.1 (VSS), LED_KEY36.1 (VSS), LED_KEY37.1 (VSS), LED_KEY38.1 (VSS), LED_KEY39.1 (VSS), LED_KEY40.1 (VSS), LED_KEY41.1 (VSS), LED_KEY42.1 (VSS), R2.2, R3.2, R5.2, SL1.3, SL2.3, U1.10 (V_{SS}), U1.15 (A0), U1.16 (A1), U1.17 (A2)
KEY1_N: D1.2 (A), KEY1.2
KEY2_N: D2.2 (A), KEY2.2
KEY3_N: D3.2 (A), KEY3.2
KEY4_N: D4.2 (A), KEY4.2
KEY5_N: D5.2 (A), KEY5.2
KEY6_N: D6.2 (A), KEY6.2
KEY7_N: D7.2 (A), KEY7.2
KEY8_N: D8.2 (A), KEY8.2
KEY9_N: D9.2 (A), KEY9.2
KEY10_N: D10.2 (A), KEY10.2
KEY11_N: D11.2 (A), KEY11.2
KEY12_N: D12.2 (A), KEY12.2
KEY13_N: D13.2 (A), KEY13.2
KEY14_N: D14.2 (A), KEY14.2
KEY15_N: D15.2 (A), KEY15.2
KEY16_N: D16.2 (A), KEY16.2
KEY17_N: D17.2 (A), KEY17.2
KEY18_N: D18.2 (A), KEY18.2
KEY19_N: D19.2 (A), KEY19.2
KEY20_N: D20.2 (A), KEY20.2
KEY21_N: D21.2 (A), KEY21.2
KEY22_N: D22.2 (A), KEY22.2
KEY23_N: D23.2 (A), KEY23.2
KEY24_N: D24.2 (A), KEY24.2
KEY25_N: D25.2 (A), KEY25.2
KEY26_N: D26.2 (A), KEY26.2
KEY27_N: D27.2 (A), KEY27.2
KEY28_N: D28.2 (A), KEY28.2
KEY29_N: D29.2 (A), KEY29.2
KEY30_N: D30.2 (A), KEY30.2
KEY31_N: D31.2 (A), KEY31.2
KEY32_N: D32.2 (A), KEY32.2
KEY33_N: D33.2 (A), KEY33.2
KEY34_N: D34.2 (A), KEY34.2
KEY35_N: D35.2 (A), KEY35.2
KEY36_N: D36.2 (A), KEY36.2
KEY37_N: D37.2 (A), KEY37.2
KEY38_N: D38.2 (A), KEY38.2
KEY39_N: D39.2 (A), KEY39.2
KEY40_N: D40.2 (A), KEY40.2
KEY41_N: D41.2 (A), KEY41.2
KEY42_N: D42.2 (A), KEY42.2
LED_CH1: LED_KEY1.4 (DOUT), LED_KEY2.2 (DIN)
LED_CH2: LED_KEY2.4 (DOUT), LED_KEY3.2 (DIN)
LED_CH3: LED_KEY3.4 (DOUT), LED_KEY4.2 (DIN)
LED_CH4: LED_KEY4.4 (DOUT), LED_KEY5.2 (DIN)
LED_CH5: LED_KEY5.4 (DOUT), LED_KEY6.2 (DIN)
LED_CH6: LED_KEY6.4 (DOUT), LED_KEY7.2 (DIN)
LED_CH7: LED_KEY7.4 (DOUT), LED_KEY8.2 (DIN)
LED_CH8: LED_KEY8.4 (DOUT), LED_KEY9.2 (DIN)
LED_CH9: LED_KEY9.4 (DOUT), LED_KEY10.2 (DIN)
LED_CH10: LED_KEY10.4 (DOUT), LED_KEY11.2 (DIN)
LED_CH11: LED_KEY11.4 (DOUT), LED_KEY12.2 (DIN)
LED_CH12: LED_KEY12.4 (DOUT), LED_KEY13.2 (DIN)
LED_CH13: LED_KEY13.4 (DOUT), LED_KEY14.2 (DIN)
LED_CH14: LED_KEY14.4 (DOUT), LED_KEY15.2 (DIN)
LED_CH15: LED_KEY15.4 (DOUT), LED_KEY16.2 (DIN)
LED_CH16: LED_KEY16.4 (DOUT), LED_KEY17.2 (DIN)
LED_CH17: LED_KEY17.4 (DOUT), LED_KEY18.2 (DIN)
LED_CH18: LED_KEY18.4 (DOUT), LED_KEY19.2 (DIN)
LED_CH19: LED_KEY19.4 (DOUT), LED_KEY20.2 (DIN)
LED_CH20: LED_KEY20.4 (DOUT), LED_KEY21.2 (DIN)
LED_CH21: LED_KEY21.4 (DOUT), LED_KEY22.2 (DIN)
LED_CH22: LED_KEY22.4 (DOUT), LED_KEY23.2 (DIN)
LED_CH23: LED_KEY23.4 (DOUT), LED_KEY24.2 (DIN)
LED_CH24: LED_KEY24.4 (DOUT), LED_KEY25.2 (DIN)
LED_CH25: LED_KEY25.4 (DOUT), LED_KEY26.2 (DIN)
LED_CH26: LED_KEY26.4 (DOUT), LED_KEY27.2 (DIN)
LED_CH27: LED_KEY27.4 (DOUT), LED_KEY28.2 (DIN)
LED_CH28: LED_KEY28.4 (DOUT), LED_KEY29.2 (DIN)
LED_CH29: LED_KEY29.4 (DOUT), LED_KEY30.2 (DIN)
LED_CH30: LED_KEY30.4 (DOUT), LED_KEY31.2 (DIN)
LED_CH31: LED_KEY31.4 (DOUT), LED_KEY32.2 (DIN)
LED_CH32: LED_KEY32.4 (DOUT), LED_KEY33.2 (DIN)
LED_CH33: LED_KEY33.4 (DOUT), LED_KEY34.2 (DIN)
LED_CH34: LED_KEY34.4 (DOUT), LED_KEY35.2 (DIN)
LED_CH35: LED_KEY35.4 (DOUT), LED_KEY36.2 (DIN)
LED_CH36: LED_KEY36.4 (DOUT), LED_KEY37.2 (DIN)
LED_CH37: LED_KEY37.4 (DOUT), LED_KEY38.2 (DIN)
LED_CH38: LED_KEY38.4 (DOUT), LED_KEY39.2 (DIN)
LED_CH39: LED_KEY39.4 (DOUT), LED_KEY40.2 (DIN)
LED_CH40: LED_KEY40.4 (DOUT), LED_KEY41.2 (DIN)
LED_CH41: LED_KEY41.4 (DOUT), LED_KEY42.2 (DIN)
LED_IN: J-DECK.7, LED_KEY1.2 (DIN)
LED_MODE1_K: LED_MODE1.1 (K), R2.1, U1.28 (GPA7)
LED_MODE2_K: LED_MODE2.1 (K), R3.1, U1.8 (GPB7)
MCP_RST: R1.2, U1.18 (~RESET)
ROW1: KEY1.1, KEY2.1, KEY3.1, KEY4.1, KEY5.1, KEY6.1, KEY19.1, U1.21 (GPA0)
ROW2: KEY7.1, KEY8.1, KEY9.1, KEY10.1, KEY11.1, KEY12.1, KEY20.1, U1.22 (GPA1)
ROW3: KEY13.1, KEY14.1, KEY15.1, KEY16.1, KEY17.1, KEY18.1, KEY21.1, U1.23 (GPA2)
ROW4: KEY22.1, KEY23.1, KEY24.1, KEY25.1, KEY26.1, KEY27.1, KEY40.1, U1.24 (GPA3)
ROW5: KEY28.1, KEY29.1, KEY30.1, KEY31.1, KEY32.1, KEY33.1, KEY41.1, U1.25 (GPA4)
ROW6: KEY34.1, KEY35.1, KEY36.1, KEY37.1, KEY38.1, KEY39.1, KEY42.1, U1.26 (GPA5)
SCL: J-DECK.4, U1.12 (SCK)
SDA: J-DECK.3, U1.13 (SDA)
SL1_RAW: J-DECK.9, SL1.2
SL2_RAW: J-DECK.11, SL2.2

Notes on the sheet:
DECK-KEYS Bukifon v1.0 290 x 78 x 1.6 mm (spec/10-panel-ui.md 3.2, spec/20-electronics.md 6.4) CERN-OHL-S-2.0
42 x Kailh Choc (hot-swap socket) + 42 x 1N4148, matrix 6 rows x 7 columns on MCP23017 (0x20) + 42 x SK6812MINI-E + 2 x 30 mm fader + IDC-16
Matrix 6 rows x 7 cols: ROW1..3 = left half, ROW4..6 = right half, COL1..6 = main columns, COL7 = thumb row. ROWn = MCP23017 GPA0..GPA5 (driven low), COLn = GPB0..GPB6 (read with pull-up). Full KEYn <-> (row,col) <-> panel coordinate table: matrix-tables.md
42 x SK6812MINI-E, chain after LED_IN from PANEL-1, powered from +5V (J-DECK pin 16), 100n per LED; last DOUT = no connect.
Matrix 42 keys uses GPA0..5 + GPB0..6; GPA7/GPB7 drive the 2 central-zone mode indicators (1k series, active low).
SL1/SL2 in the central zone (x 110..205, same coordinates as DECK-PAD): 30 mm slide pots across 3V3, 1k/100n RC on PANEL-1.
DECK_ID for DECK-KEYS: 3.3k / 33k -> 3.3*33/36.3 = 3.00 V (spec/20-electronics.md 6.2: 3.00 V +-0.15 V)
J-DECK pin 15 (FSR) is not used on DECK-KEYS -> GND; pin 16 = +5V (LED chain).
