martiyanov/bukifon/hardware/panel/deck-pad/deck-pad.kicad_sch

## KiCad design hardware/panel/deck-pad/deck-pad.kicad_sch (2026-11-05)

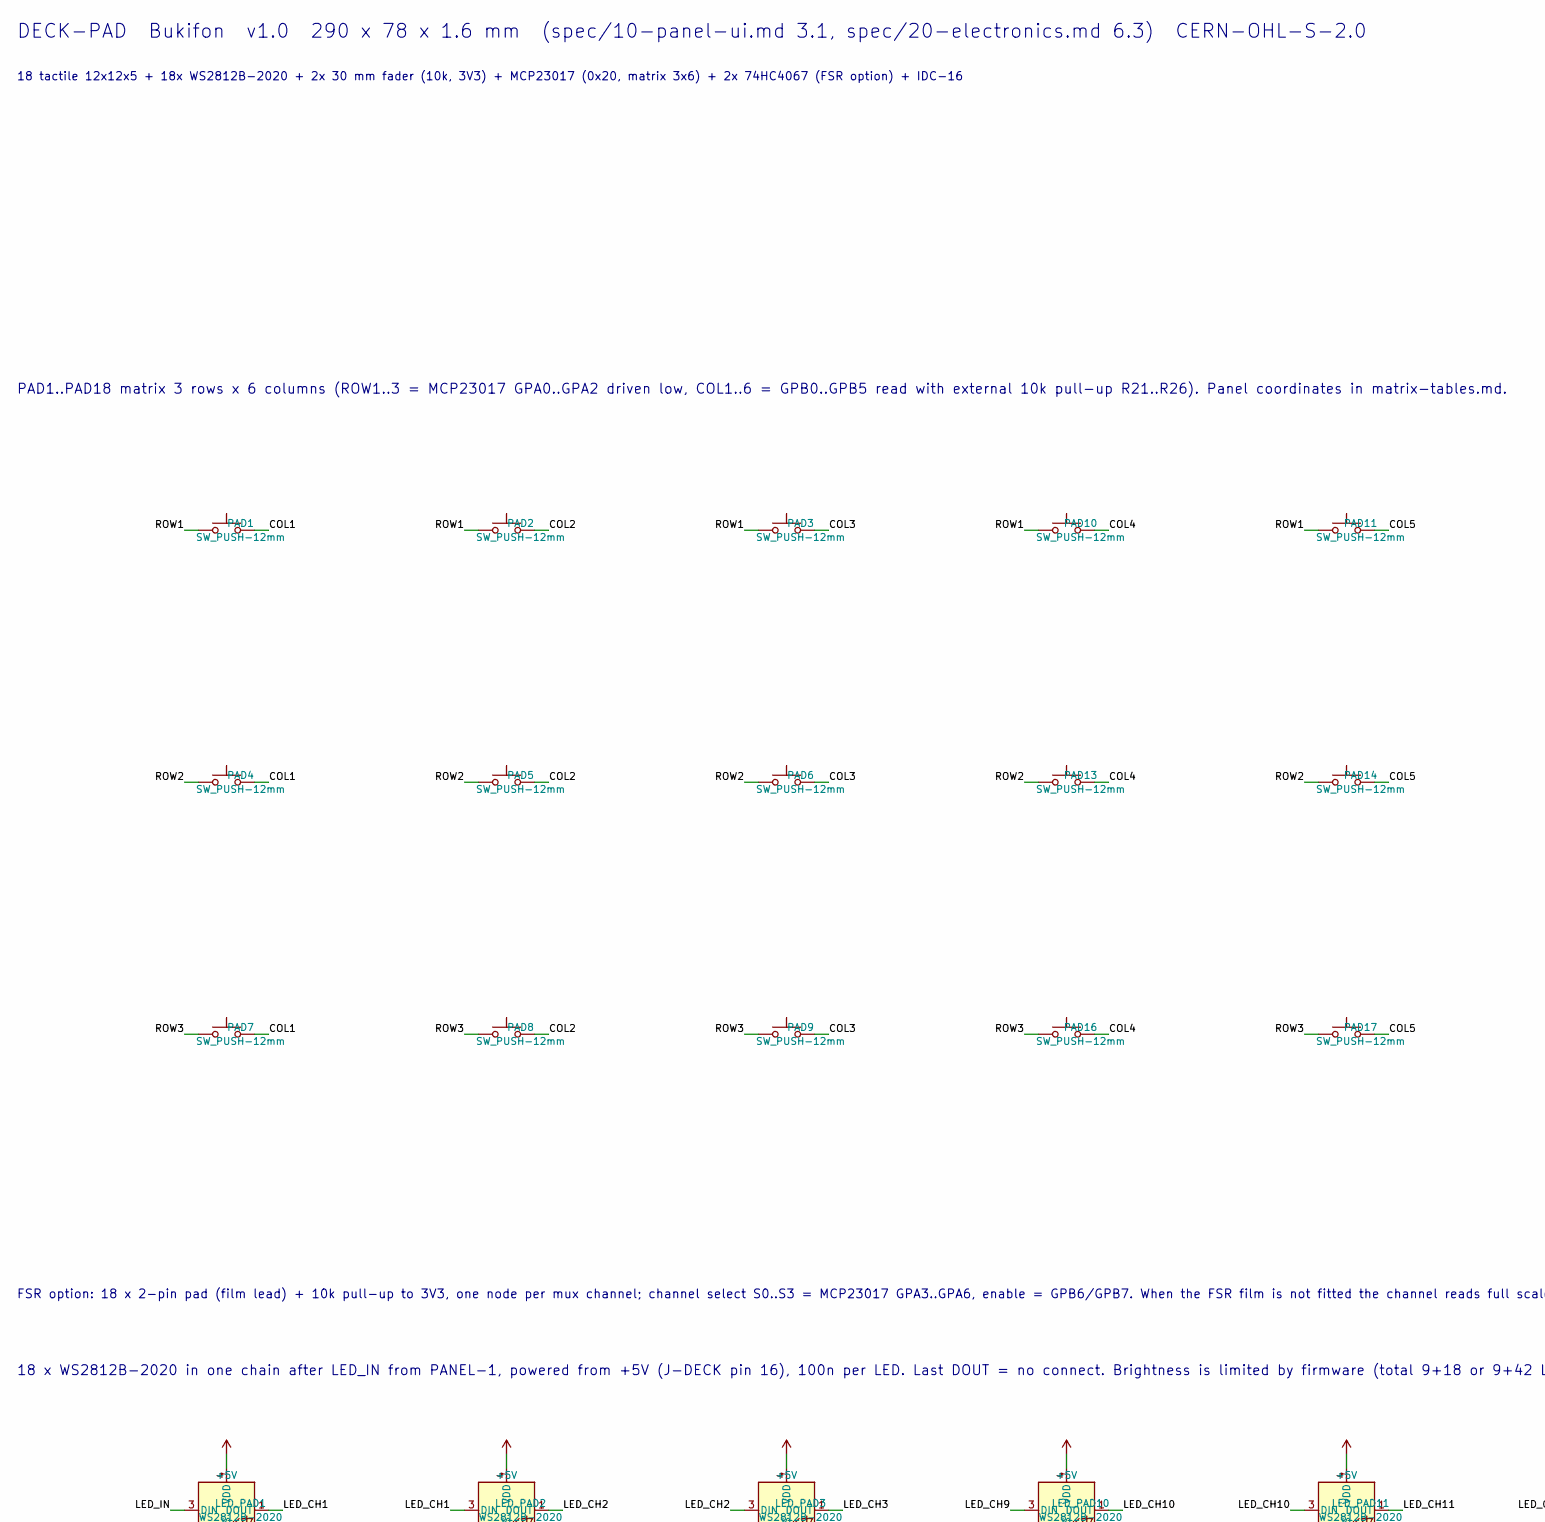
[picture p211: schematic deck-pad.kicad_sch, part in row 1, column 1]

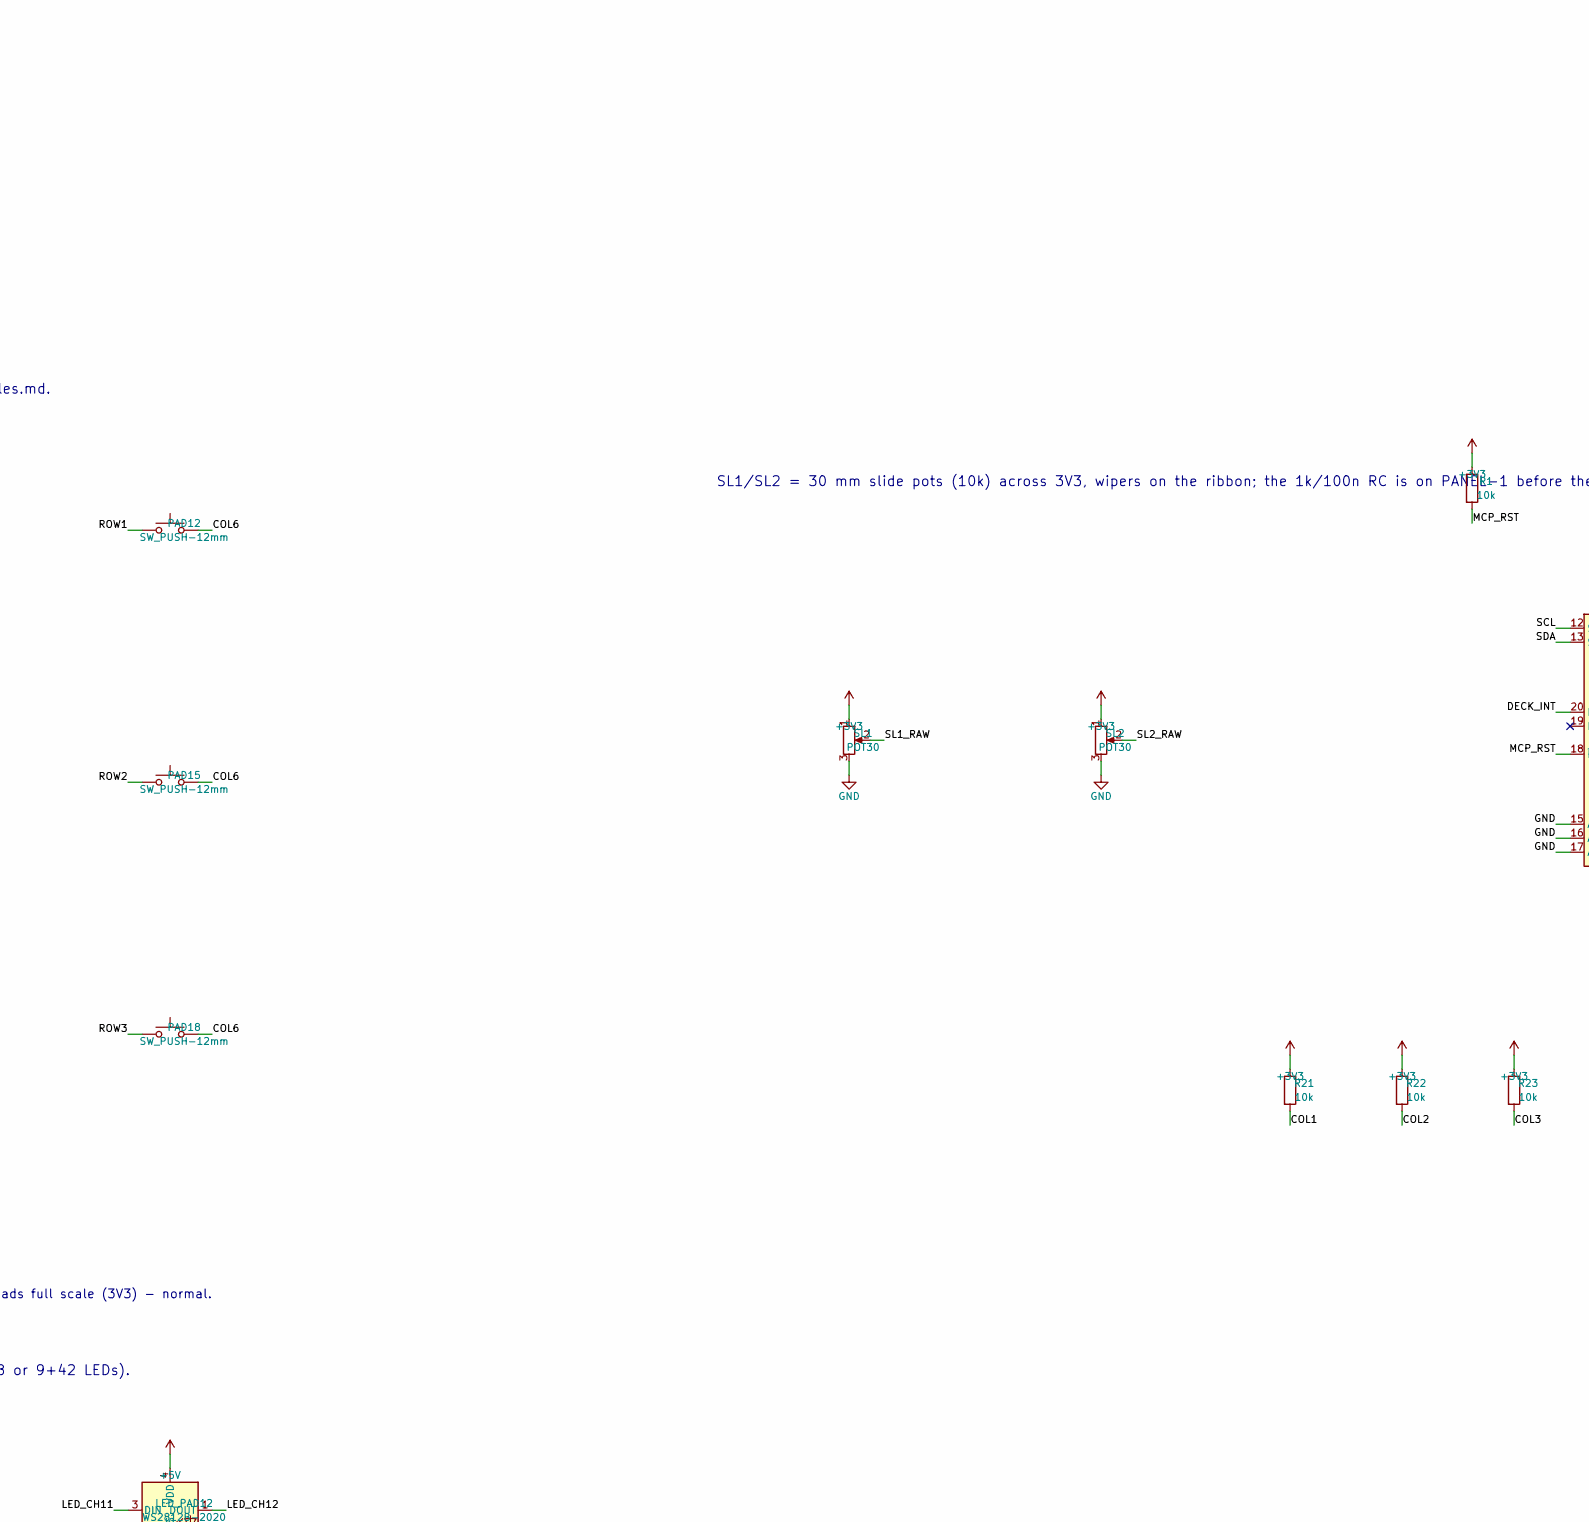
[picture p212: schematic deck-pad.kicad_sch, part in row 1, column 2]

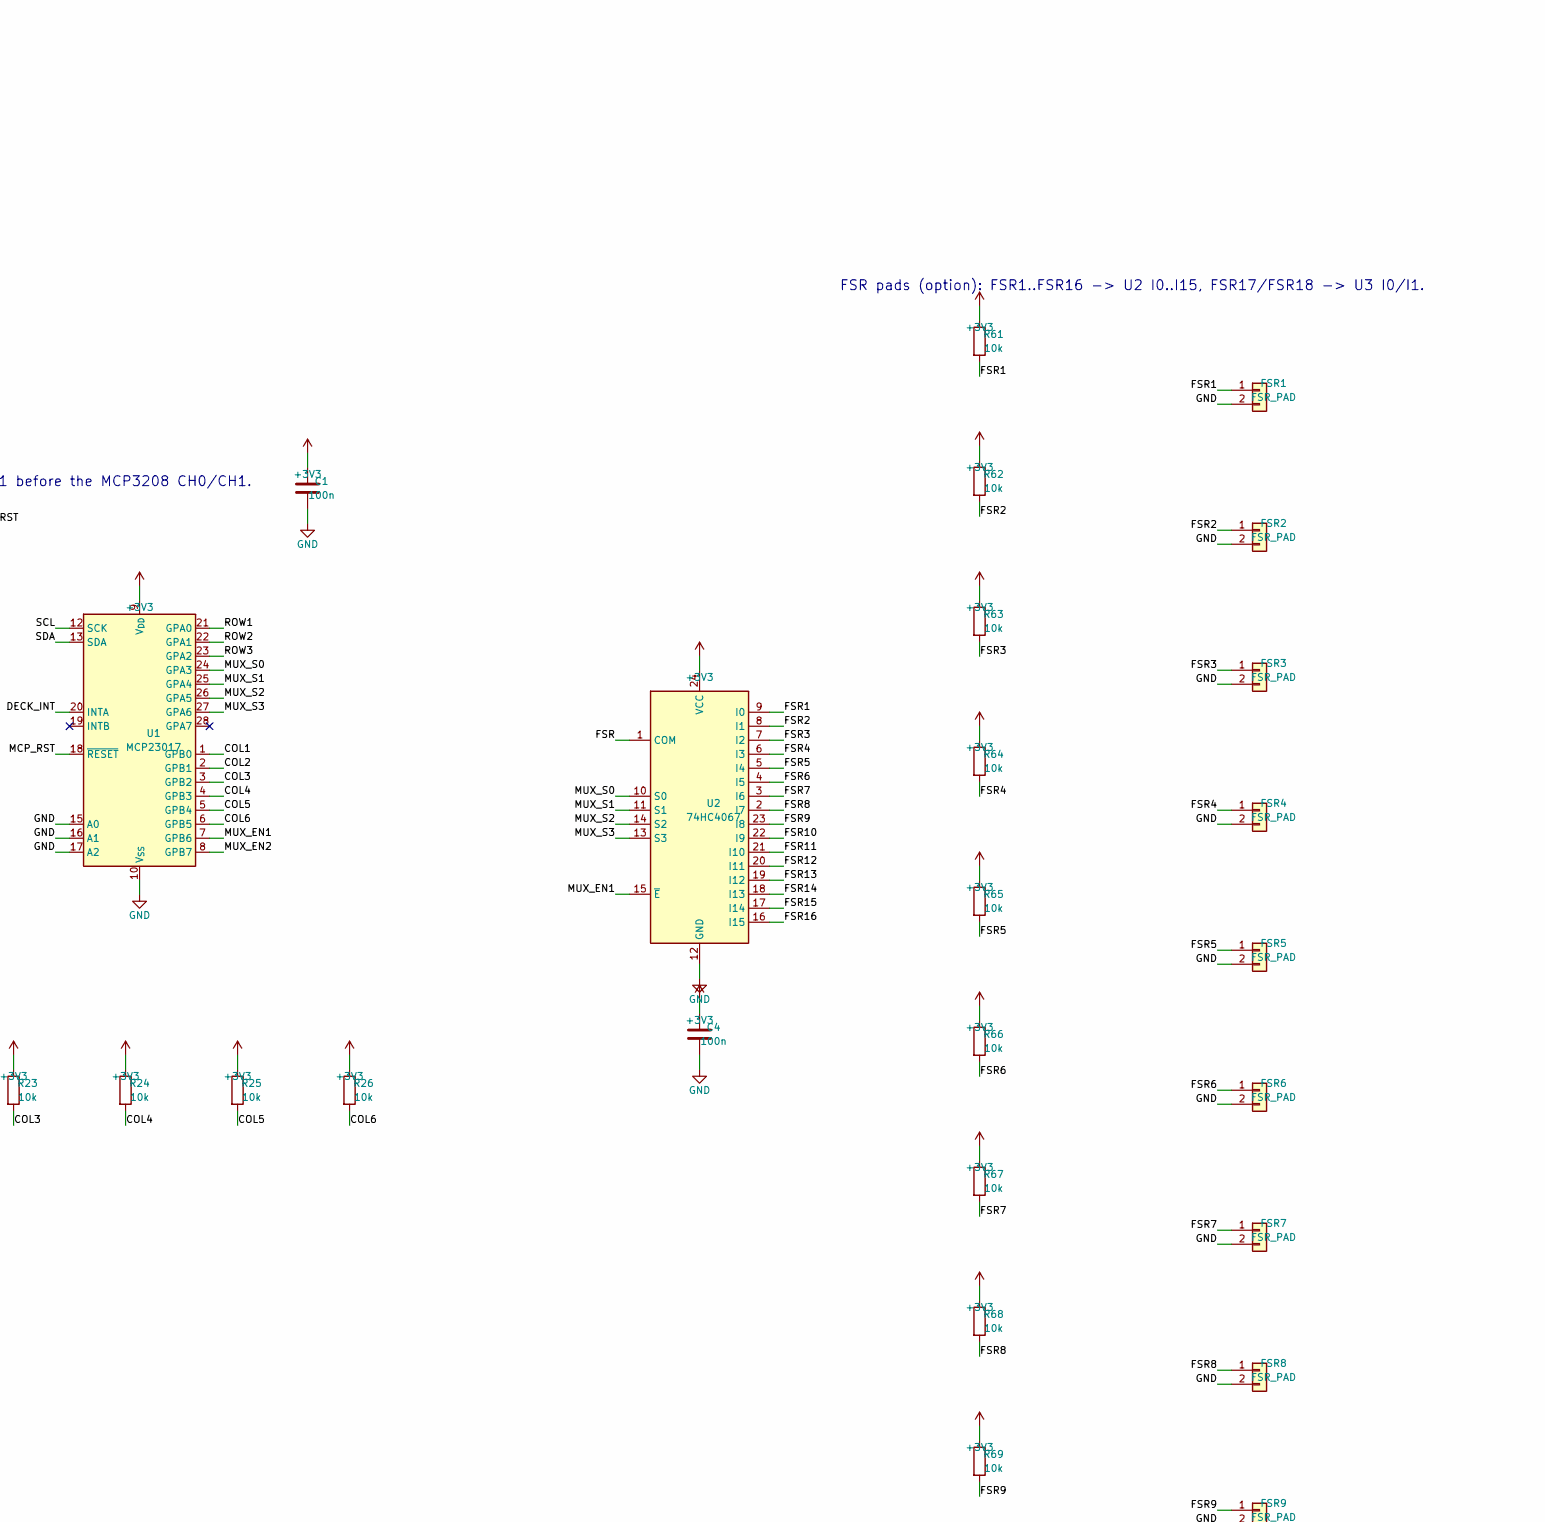
[picture p213: schematic deck-pad.kicad_sch, part in row 1, column 3]

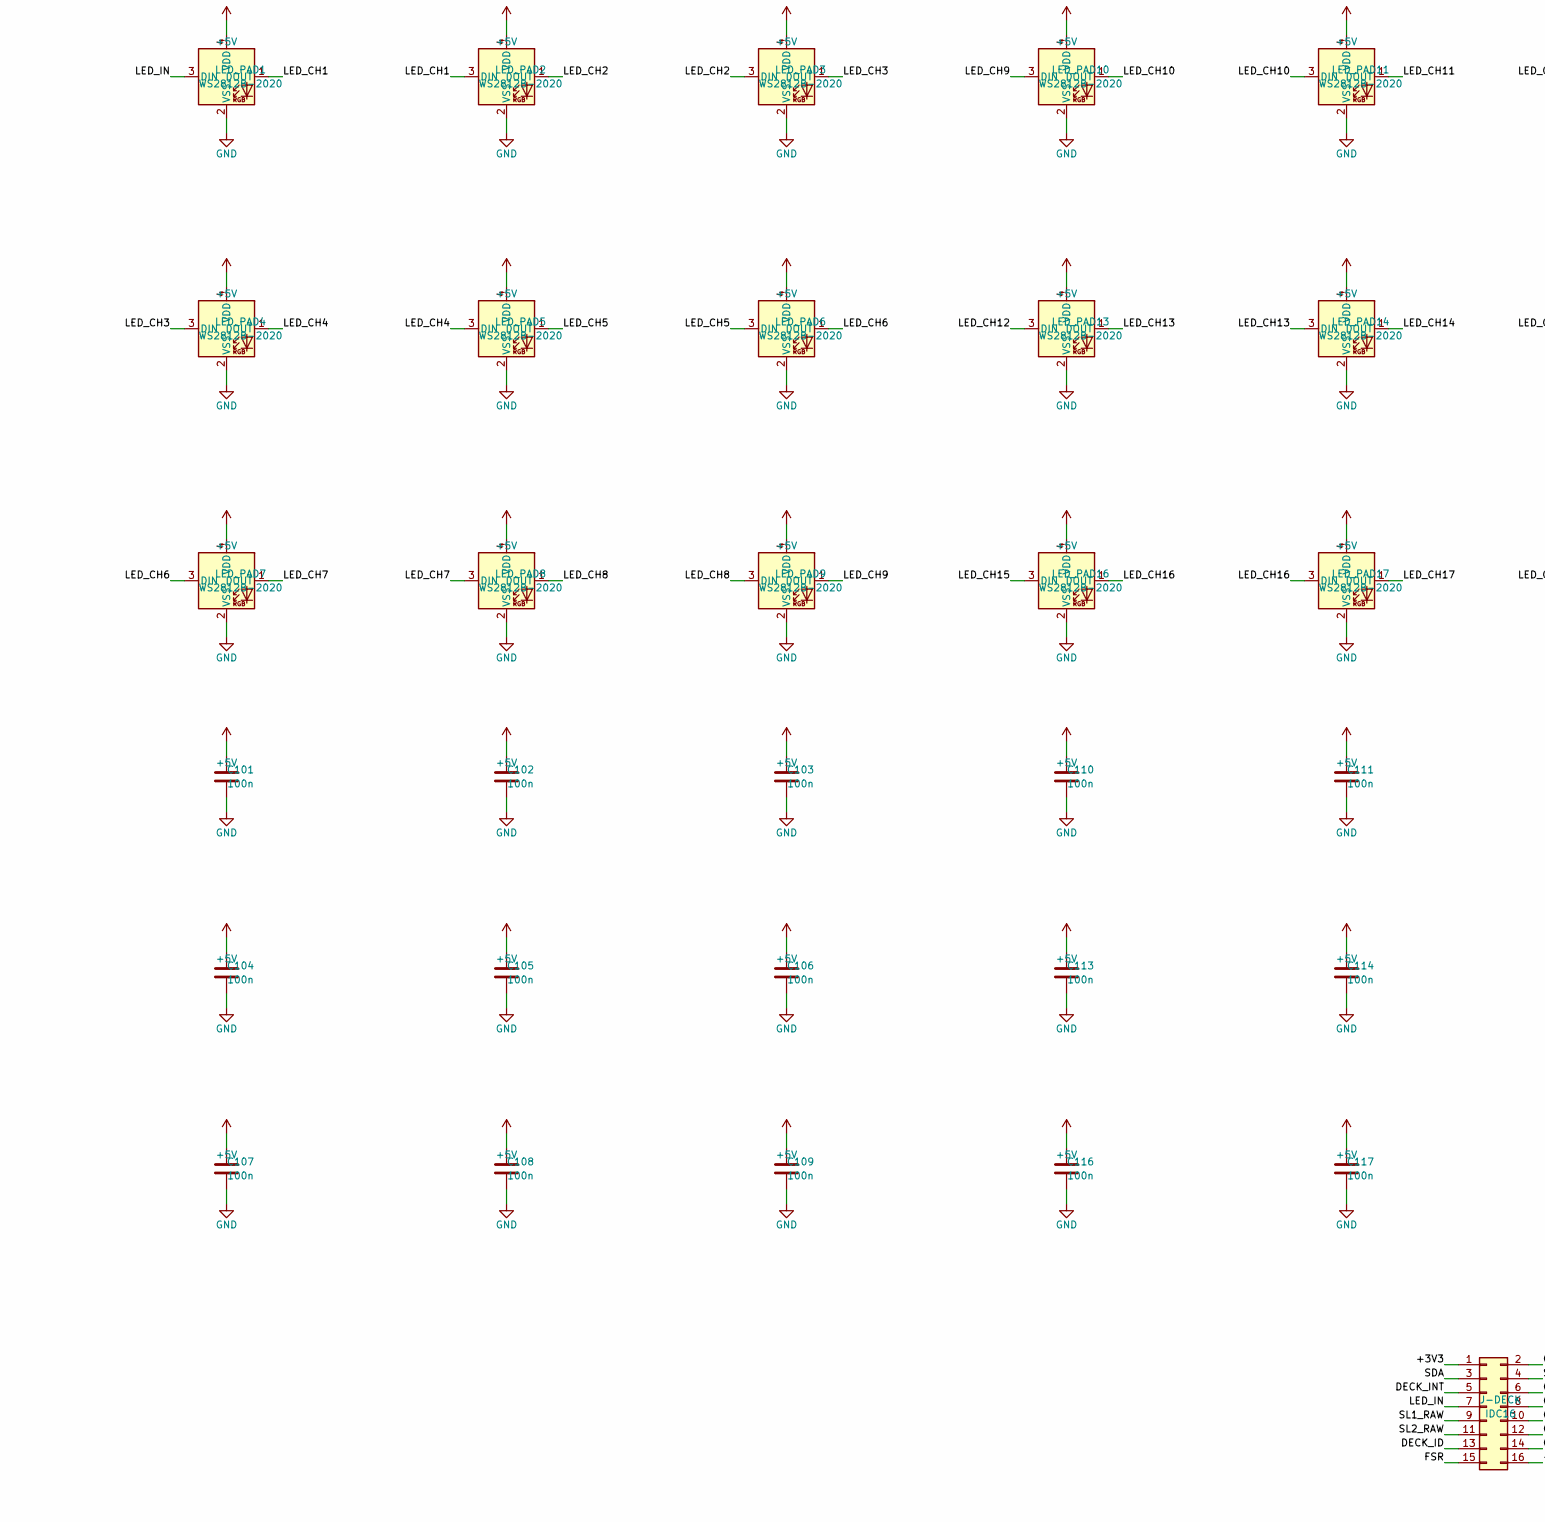
[picture p214: schematic deck-pad.kicad_sch, part in row 2, column 1]

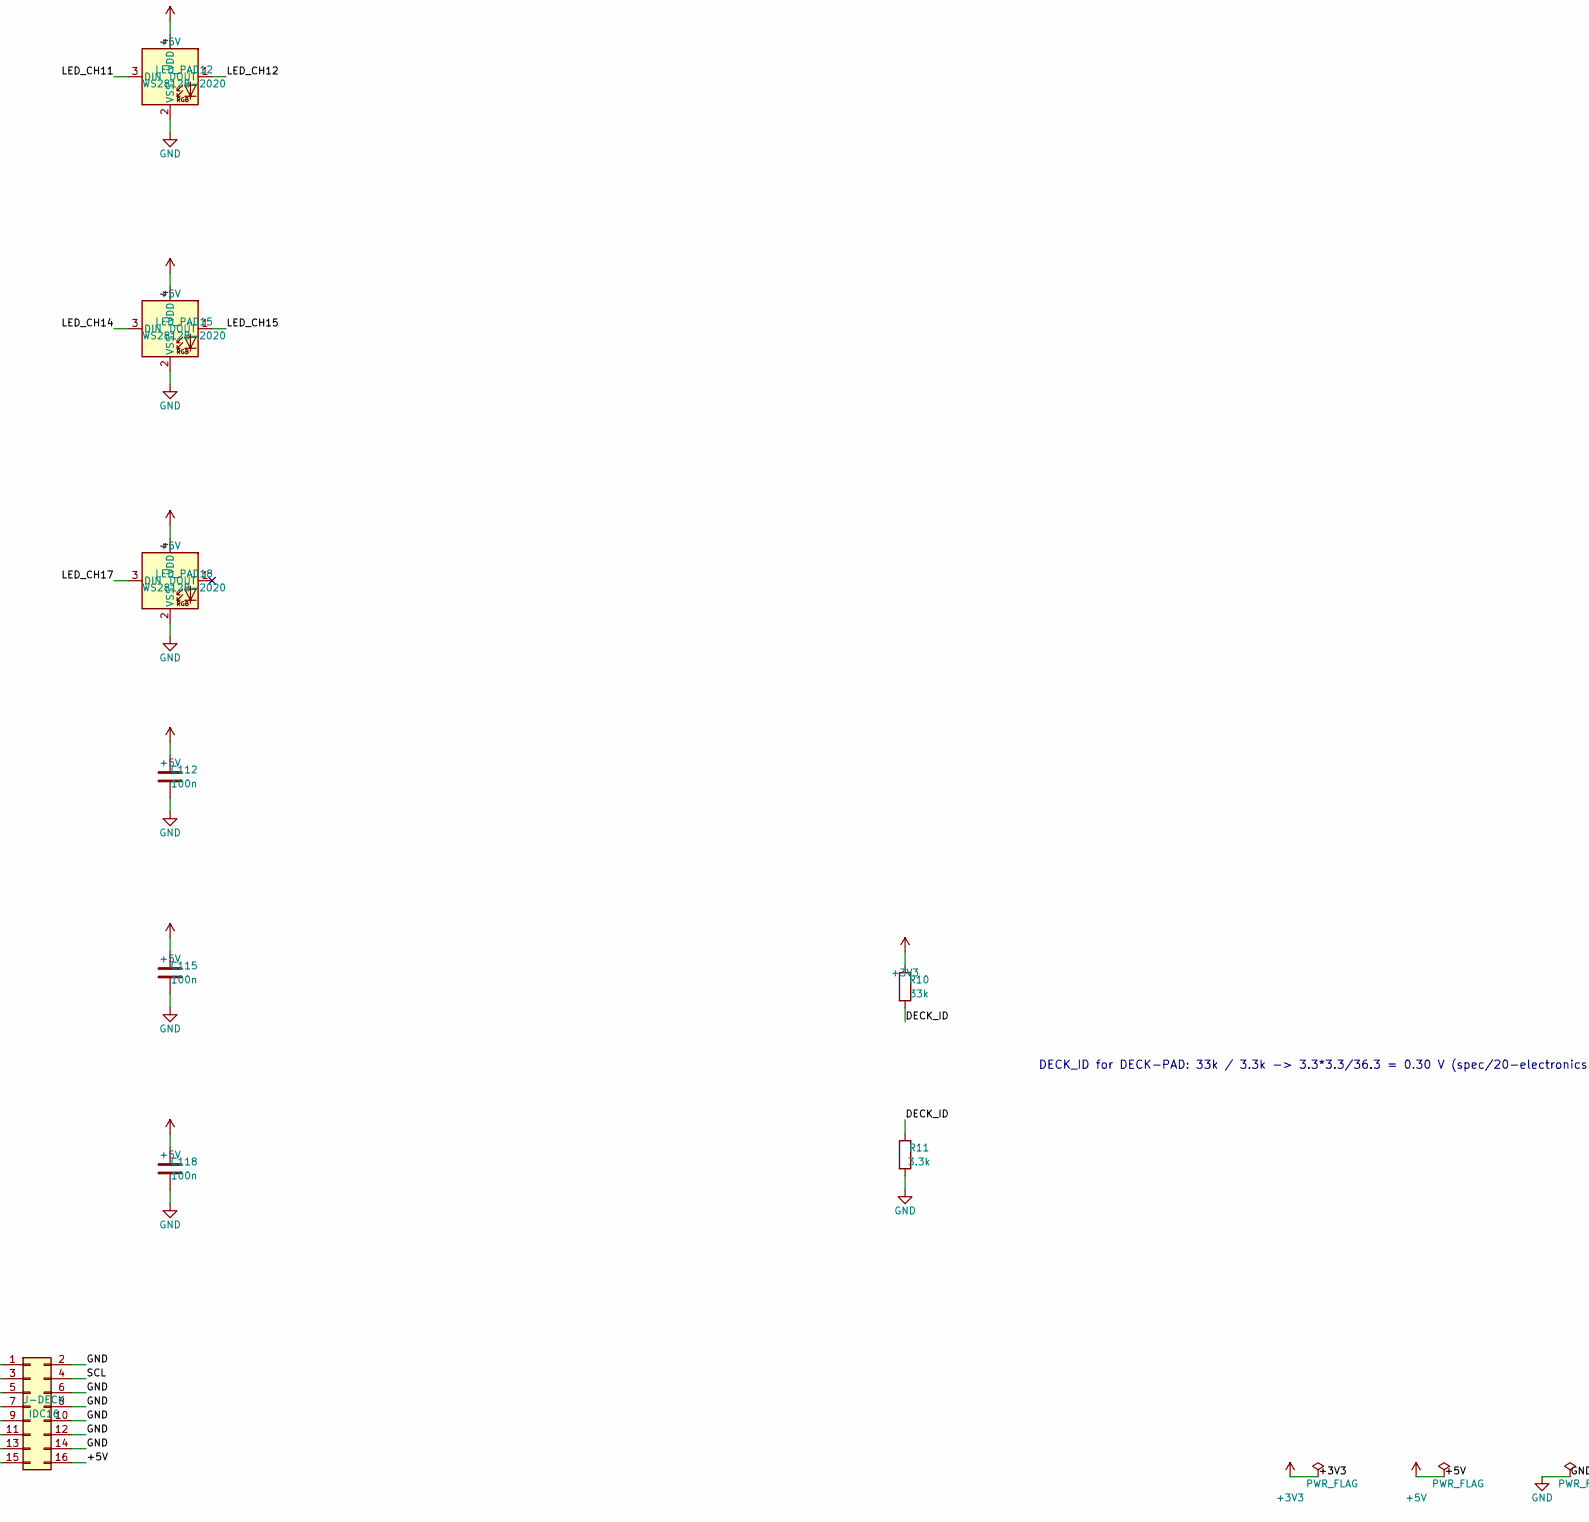
[picture p215: schematic deck-pad.kicad_sch, part in row 2, column 2]

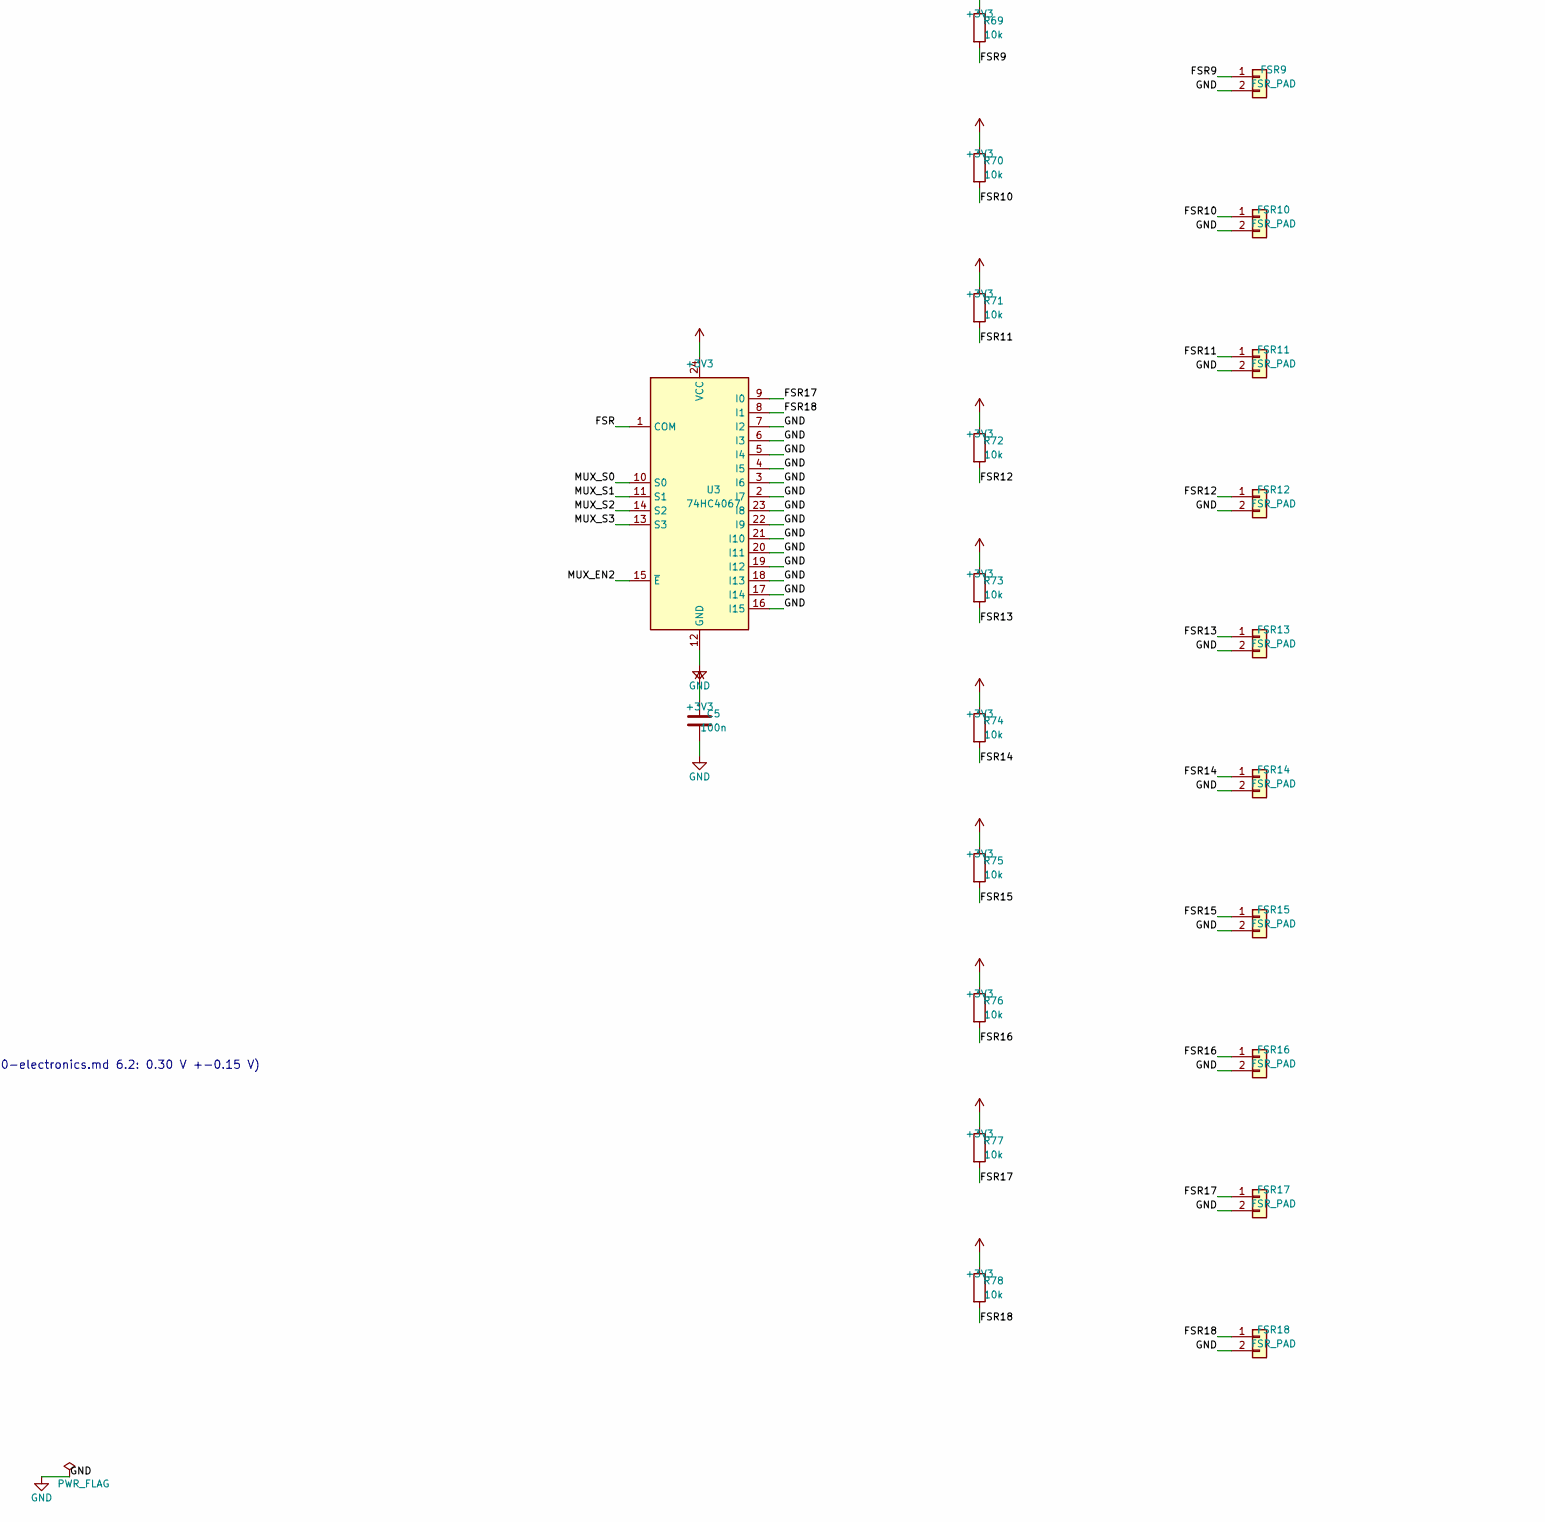
[picture p216: schematic deck-pad.kicad_sch, part in row 2, column 3]

Parts:
C1, C4, C5, C101, C102, C103, C104, C105, C106, C107, C108, C109, C110, C111, C112, C113, C114, C115, C116, C117, C118: 100n; C_0603_1608Metric
FSR1, FSR2, FSR3, FSR4, FSR5, FSR6, FSR7, FSR8, FSR9, FSR10, FSR11, FSR12, FSR13, FSR14, FSR15, FSR16, FSR17, FSR18: FSR_PAD; PinHeader_1x02_P2.54mm_Vertical
J-DECK: IDC16; IDC-Header_2x08_P2.54mm_Vertical
LED_PAD1, LED_PAD2, LED_PAD3, LED_PAD4, LED_PAD5, LED_PAD6, LED_PAD7, LED_PAD8, LED_PAD9, LED_PAD10, LED_PAD11, LED_PAD12, LED_PAD13, LED_PAD14, LED_PAD15, LED_PAD16, LED_PAD17, LED_PAD18: WS2812B-2020; LED_WS2812B-2020_PLCC4_2.0x2.0mm
PAD1, PAD2, PAD3, PAD4, PAD5, PAD6, PAD7, PAD8, PAD9, PAD10, PAD11, PAD12, PAD13, PAD14, PAD15, PAD16, PAD17, PAD18: SW_PUSH-12mm
R1, R21, R22, R23, R24, R25, R26, R61, R62, R63, R64, R65, R66, R67, R68, R69, R70, R71, R72, R73, R74, R75, R76, R77, R78: 10k; R_0603_1608Metric
R10: 33k; R_0603_1608Metric
R11: 3.3k; R_0603_1608Metric
SL1, SL2: POT30; Potentiometer_Bourns_PTA3043_Single_Slide
U1: MCP23017; DIP-28_W7.62mm
U2, U3: 74HC4067; SOIC-24W_7.5x15.4mm_P1.27mm

Connections:
+3V3: C1.1, C4.1, C5.1, J-DECK.1, R1.1, R10.1, R21.1, R22.1, R23.1, R24.1, R25.1, R26.1, R61.1, R62.1, R63.1, R64.1, R65.1, R66.1, R67.1, R68.1, R69.1, R70.1, R71.1, R72.1, R73.1, R74.1, R75.1, R76.1, R77.1, R78.1, SL1.1, SL2.1, U1.9 (V_{DD}), U2.24 (VCC), U3.24 (VCC)
+5V: C101.1, C102.1, C103.1, C104.1, C105.1, C106.1, C107.1, C108.1, C109.1, C110.1, C111.1, C112.1, C113.1, C114.1, C115.1, C116.1, C117.1, C118.1, J-DECK.16, LED_PAD1.4 (VDD), LED_PAD2.4 (VDD), LED_PAD3.4 (VDD), LED_PAD4.4 (VDD), LED_PAD5.4 (VDD), LED_PAD6.4 (VDD), LED_PAD7.4 (VDD), LED_PAD8.4 (VDD), LED_PAD9.4 (VDD), LED_PAD10.4 (VDD), LED_PAD11.4 (VDD), LED_PAD12.4 (VDD), LED_PAD13.4 (VDD), LED_PAD14.4 (VDD), LED_PAD15.4 (VDD), LED_PAD16.4 (VDD), LED_PAD17.4 (VDD), LED_PAD18.4 (VDD)
COL1: PAD1.2, PAD4.2, PAD7.2, R21.2, U1.1 (GPB0)
COL2: PAD2.2, PAD5.2, PAD8.2, R22.2, U1.2 (GPB1)
COL3: PAD3.2, PAD6.2, PAD9.2, R23.2, U1.3 (GPB2)
COL4: PAD10.2, PAD13.2, PAD16.2, R24.2, U1.4 (GPB3)
COL5: PAD11.2, PAD14.2, PAD17.2, R25.2, U1.5 (GPB4)
COL6: PAD12.2, PAD15.2, PAD18.2, R26.2, U1.6 (GPB5)
DECK_ID: J-DECK.13, R10.2, R11.1
DECK_INT: J-DECK.5, U1.20 (INTA)
FSR: J-DECK.15, U2.1 (COM), U3.1 (COM)
FSR1: FSR1.1, R61.2, U2.9 (I0)
FSR2: FSR2.1, R62.2, U2.8 (I1)
FSR3: FSR3.1, R63.2, U2.7 (I2)
FSR4: FSR4.1, R64.2, U2.6 (I3)
FSR5: FSR5.1, R65.2, U2.5 (I4)
FSR6: FSR6.1, R66.2, U2.4 (I5)
FSR7: FSR7.1, R67.2, U2.3 (I6)
FSR8: FSR8.1, R68.2, U2.2 (I7)
FSR9: FSR9.1, R69.2, U2.23 (I8)
FSR10: FSR10.1, R70.2, U2.22 (I9)
FSR11: FSR11.1, R71.2, U2.21 (I10)
FSR12: FSR12.1, R72.2, U2.20 (I11)
FSR13: FSR13.1, R73.2, U2.19 (I12)
FSR14: FSR14.1, R74.2, U2.18 (I13)
FSR15: FSR15.1, R75.2, U2.17 (I14)
FSR16: FSR16.1, R76.2, U2.16 (I15)
FSR17: FSR17.1, R77.2, U3.9 (I0)
FSR18: FSR18.1, R78.2, U3.8 (I1)
GND: C1.2, C4.2, C5.2, C101.2, C102.2, C103.2, C104.2, C105.2, C106.2, C107.2, C108.2, C109.2, C110.2, C111.2, C112.2, C113.2, C114.2, C115.2, C116.2, C117.2, C118.2, FSR1.2, FSR2.2, FSR3.2, FSR4.2, FSR5.2, FSR6.2, FSR7.2, FSR8.2, FSR9.2, FSR10.2, FSR11.2, FSR12.2, FSR13.2, FSR14.2, FSR15.2, FSR16.2, FSR17.2, FSR18.2, J-DECK.2, J-DECK.6, J-DECK.8, J-DECK.10, J-DECK.12, J-DECK.14, LED_PAD1.2 (VSS), LED_PAD2.2 (VSS), LED_PAD3.2 (VSS), LED_PAD4.2 (VSS), LED_PAD5.2 (VSS), LED_PAD6.2 (VSS), LED_PAD7.2 (VSS), LED_PAD8.2 (VSS), LED_PAD9.2 (VSS), LED_PAD10.2 (VSS), LED_PAD11.2 (VSS), LED_PAD12.2 (VSS), LED_PAD13.2 (VSS), LED_PAD14.2 (VSS), LED_PAD15.2 (VSS), LED_PAD16.2 (VSS), LED_PAD17.2 (VSS), LED_PAD18.2 (VSS), R11.2, SL1.3, SL2.3, U1.10 (V_{SS}), U1.15 (A0), U1.16 (A1), U1.17 (A2), U2.12 (GND), U3.2 (I7), U3.3 (I6), U3.4 (I5), U3.5 (I4), U3.6 (I3), U3.7 (I2), U3.12 (GND), U3.16 (I15), U3.17 (I14), U3.18 (I13), U3.19 (I12), U3.20 (I11), U3.21 (I10), U3.22 (I9), U3.23 (I8)
LED_CH1: LED_PAD1.1 (DOUT), LED_PAD2.3 (DIN)
LED_CH2: LED_PAD2.1 (DOUT), LED_PAD3.3 (DIN)
LED_CH3: LED_PAD3.1 (DOUT), LED_PAD4.3 (DIN)
LED_CH4: LED_PAD4.1 (DOUT), LED_PAD5.3 (DIN)
LED_CH5: LED_PAD5.1 (DOUT), LED_PAD6.3 (DIN)
LED_CH6: LED_PAD6.1 (DOUT), LED_PAD7.3 (DIN)
LED_CH7: LED_PAD7.1 (DOUT), LED_PAD8.3 (DIN)
LED_CH8: LED_PAD8.1 (DOUT), LED_PAD9.3 (DIN)
LED_CH9: LED_PAD9.1 (DOUT), LED_PAD10.3 (DIN)
LED_CH10: LED_PAD10.1 (DOUT), LED_PAD11.3 (DIN)
LED_CH11: LED_PAD11.1 (DOUT), LED_PAD12.3 (DIN)
LED_CH12: LED_PAD12.1 (DOUT), LED_PAD13.3 (DIN)
LED_CH13: LED_PAD13.1 (DOUT), LED_PAD14.3 (DIN)
LED_CH14: LED_PAD14.1 (DOUT), LED_PAD15.3 (DIN)
LED_CH15: LED_PAD15.1 (DOUT), LED_PAD16.3 (DIN)
LED_CH16: LED_PAD16.1 (DOUT), LED_PAD17.3 (DIN)
LED_CH17: LED_PAD17.1 (DOUT), LED_PAD18.3 (DIN)
LED_IN: J-DECK.7, LED_PAD1.3 (DIN)
MCP_RST: R1.2, U1.18 (~RESET)
MUX_EN1: U1.7 (GPB6), U2.15 (~E)
MUX_EN2: U1.8 (GPB7), U3.15 (~E)
MUX_S0: U1.24 (GPA3), U2.10 (S0), U3.10 (S0)
MUX_S1: U1.25 (GPA4), U2.11 (S1), U3.11 (S1)
MUX_S2: U1.26 (GPA5), U2.14 (S2), U3.14 (S2)
MUX_S3: U1.27 (GPA6), U2.13 (S3), U3.13 (S3)
ROW1: PAD1.1, PAD2.1, PAD3.1, PAD10.1, PAD11.1, PAD12.1, U1.21 (GPA0)
ROW2: PAD4.1, PAD5.1, PAD6.1, PAD13.1, PAD14.1, PAD15.1, U1.22 (GPA1)
ROW3: PAD7.1, PAD8.1, PAD9.1, PAD16.1, PAD17.1, PAD18.1, U1.23 (GPA2)
SCL: J-DECK.4, U1.12 (SCK)
SDA: J-DECK.3, U1.13 (SDA)
SL1_RAW: J-DECK.9, SL1.2
SL2_RAW: J-DECK.11, SL2.2

Notes on the sheet:
DECK-PAD Bukifon v1.0 290 x 78 x 1.6 mm (spec/10-panel-ui.md 3.1, spec/20-electronics.md 6.3) CERN-OHL-S-2.0
18 tactile 12x12x5 + 18x WS2812B-2020 + 2x 30 mm fader (10k, 3V3) + MCP23017 (0x20, matrix 3x6) + 2x 74HC4067 (FSR option) + IDC-16
PAD1..PAD18 matrix 3 rows x 6 columns (ROW1..3 = MCP23017 GPA0..GPA2 driven low, COL1..6 = GPB0..GPB5 read with external 10k pull-up R21..R26). Panel coordinates in matrix-tables.md.
18 x WS2812B-2020 in one chain after LED_IN from PANEL-1, powered from +5V (J-DECK pin 16), 100n per LED. Last DOUT = no connect. Brightness is limited by firmware (total 9+18 or 9+42 LEDs).
SL1/SL2 = 30 mm slide pots (10k) across 3V3, wipers on the ribbon; the 1k/100n RC is on PANEL-1 before the MCP3208 CH0/CH1.
FSR option: 18 x 2-pin pad (film lead) + 10k pull-up to 3V3, one node per mux channel; channel select S0..S3 = MCP23017 GPA3..GPA6, enable = GPB6/GPB7. When the FSR film is not fitted the channel reads full scale (3V3) - normal.
FSR pads (option): FSR1..FSR16 -> U2 I0..I15, FSR17/FSR18 -> U3 I0/I1.
DECK_ID for DECK-PAD: 33k / 3.3k -> 3.3*3.3/36.3 = 0.30 V (spec/20-electronics.md 6.2: 0.30 V +-0.15 V)
