martiyanov/bukifon/hardware/panel/panel-1/panel-1.kicad_sch

## KiCad design hardware/panel/panel-1/panel-1.kicad_sch (2026-11-05)

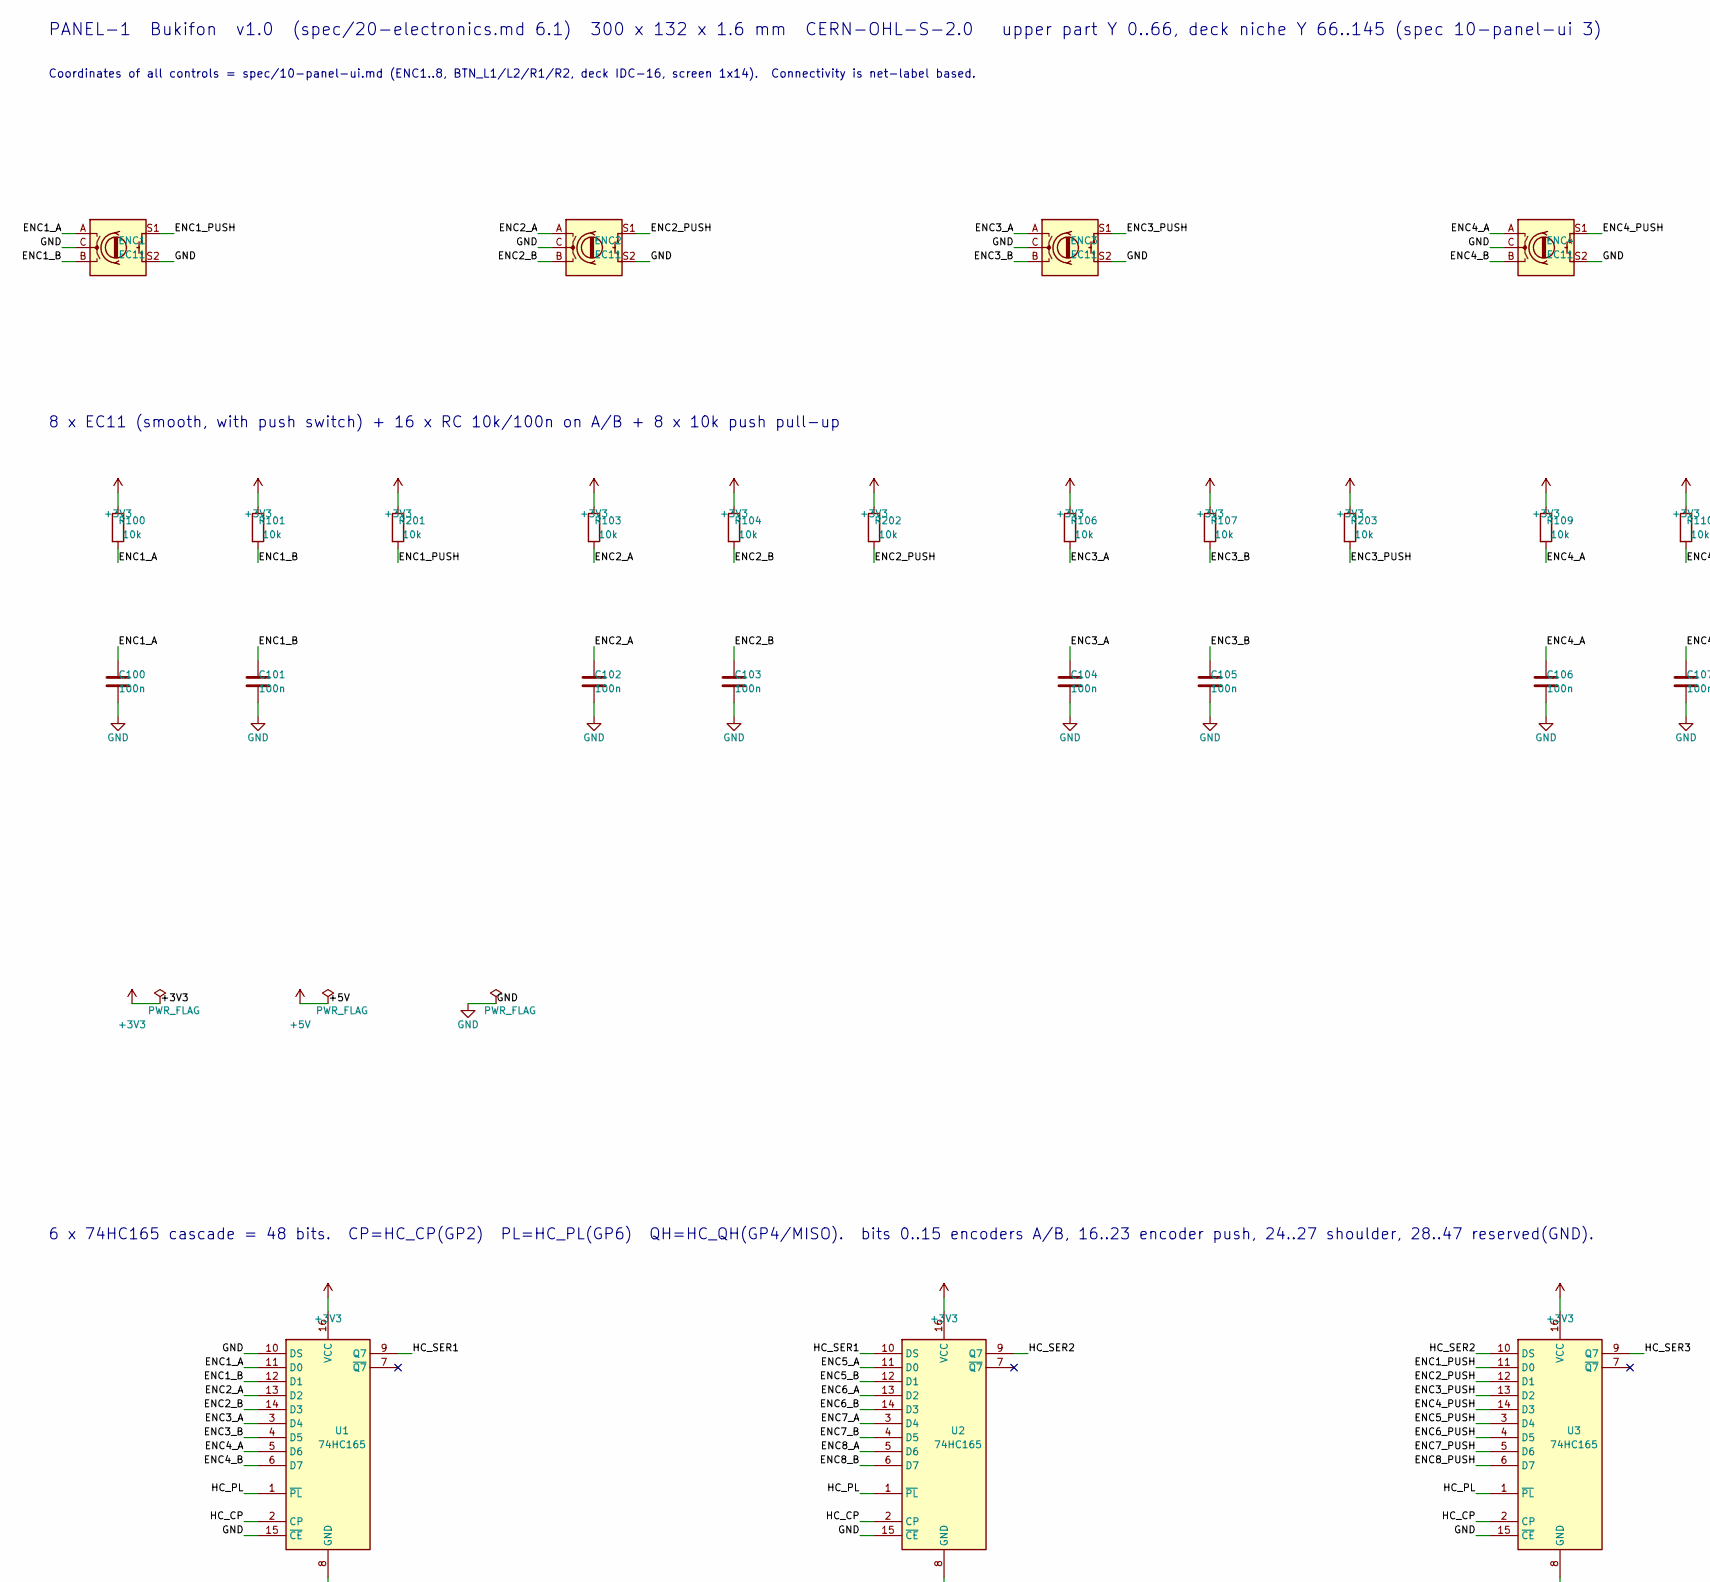
[picture p217: schematic panel-1.kicad_sch, part in row 1, column 1]

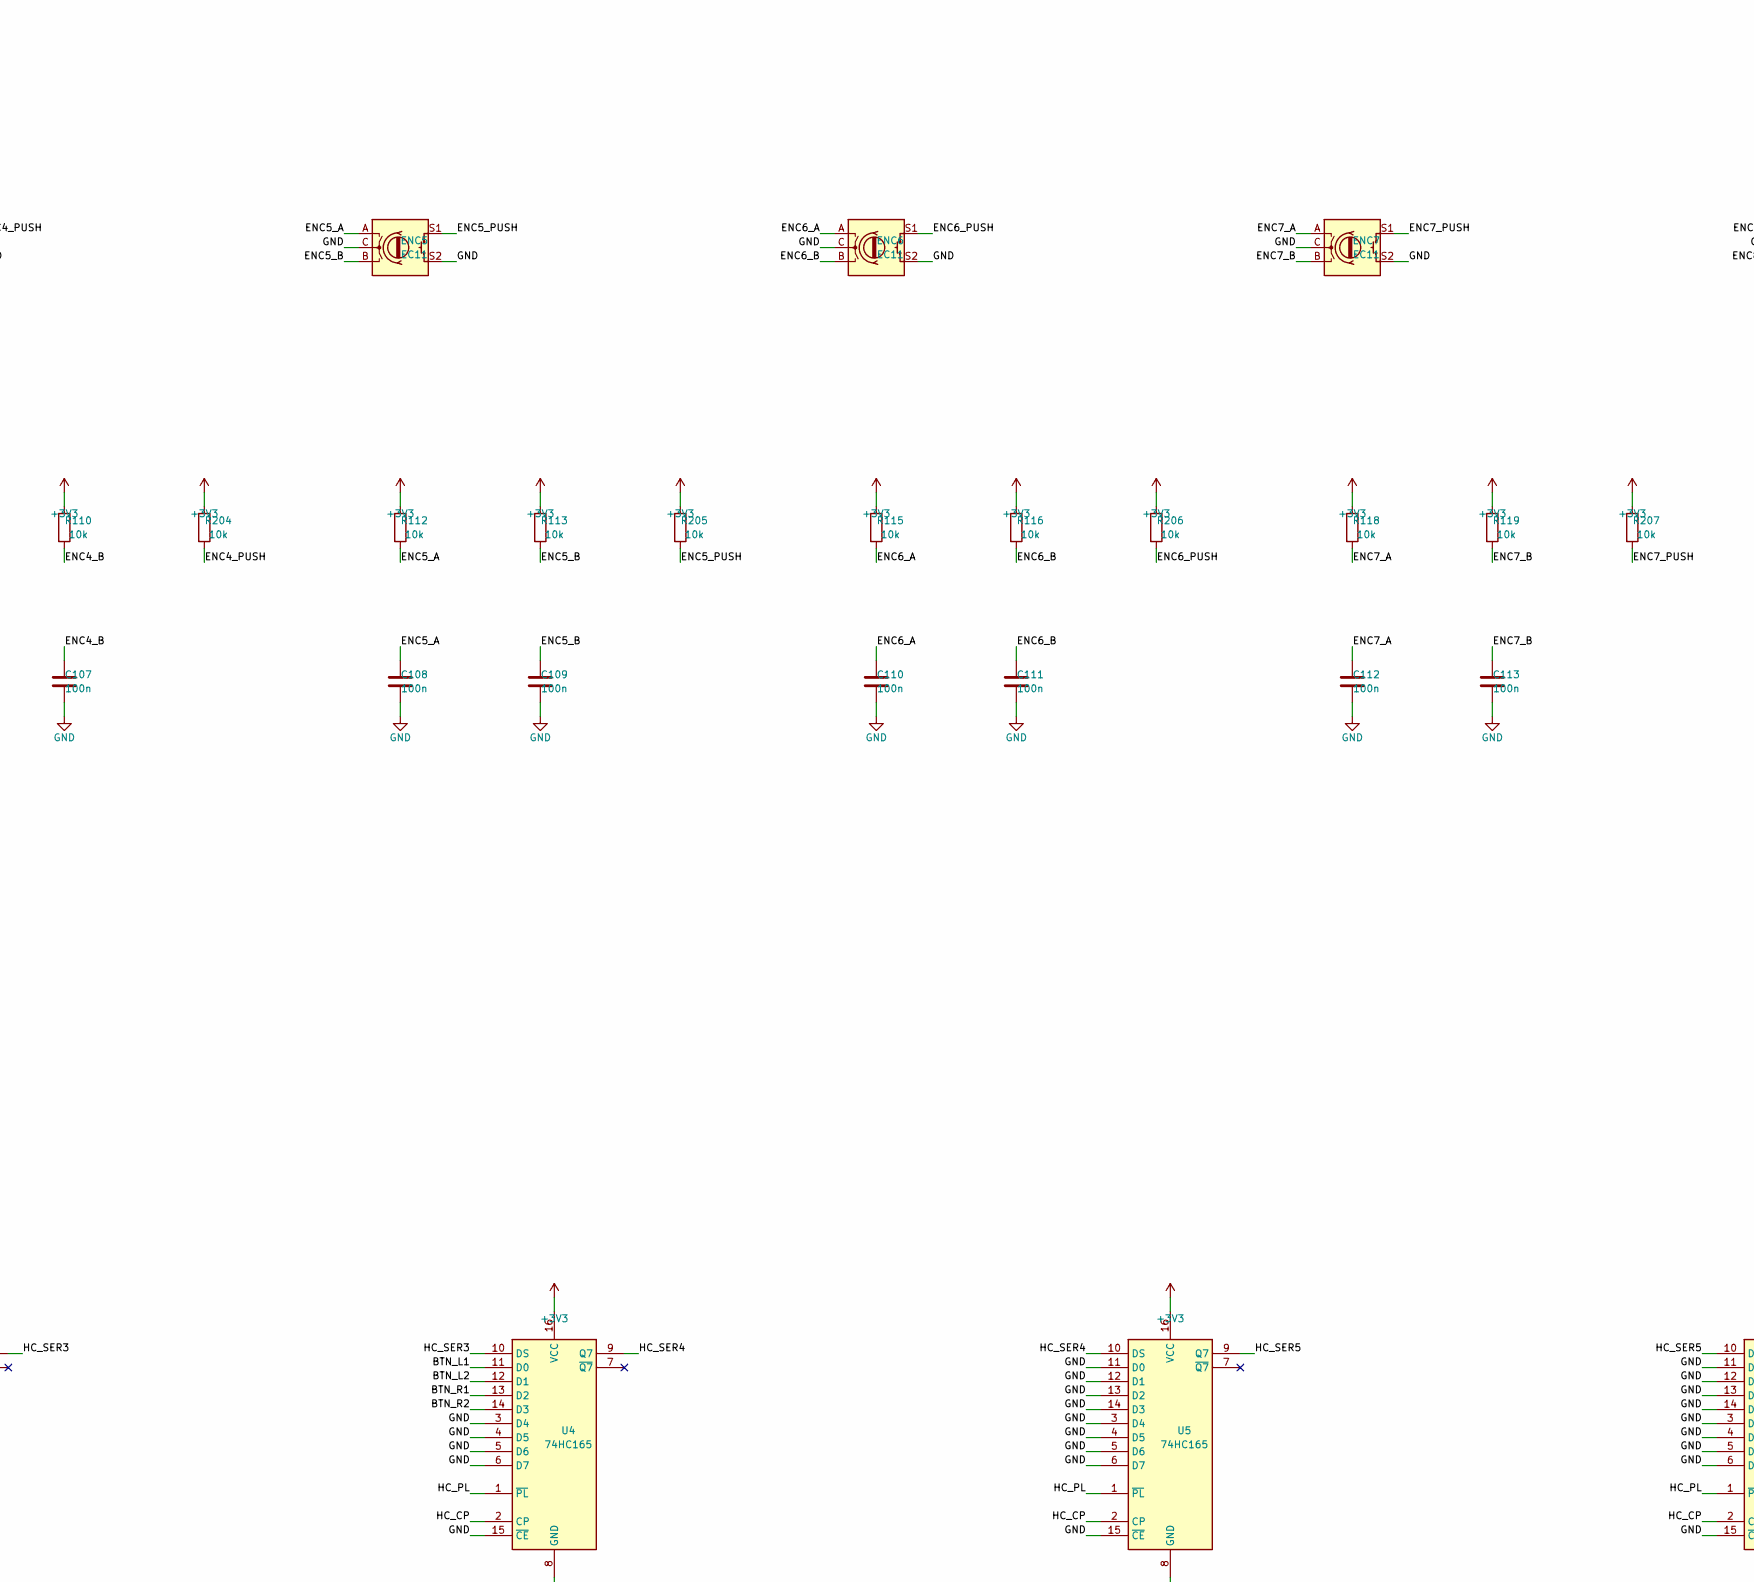
[picture p218: schematic panel-1.kicad_sch, part in row 1, column 2]

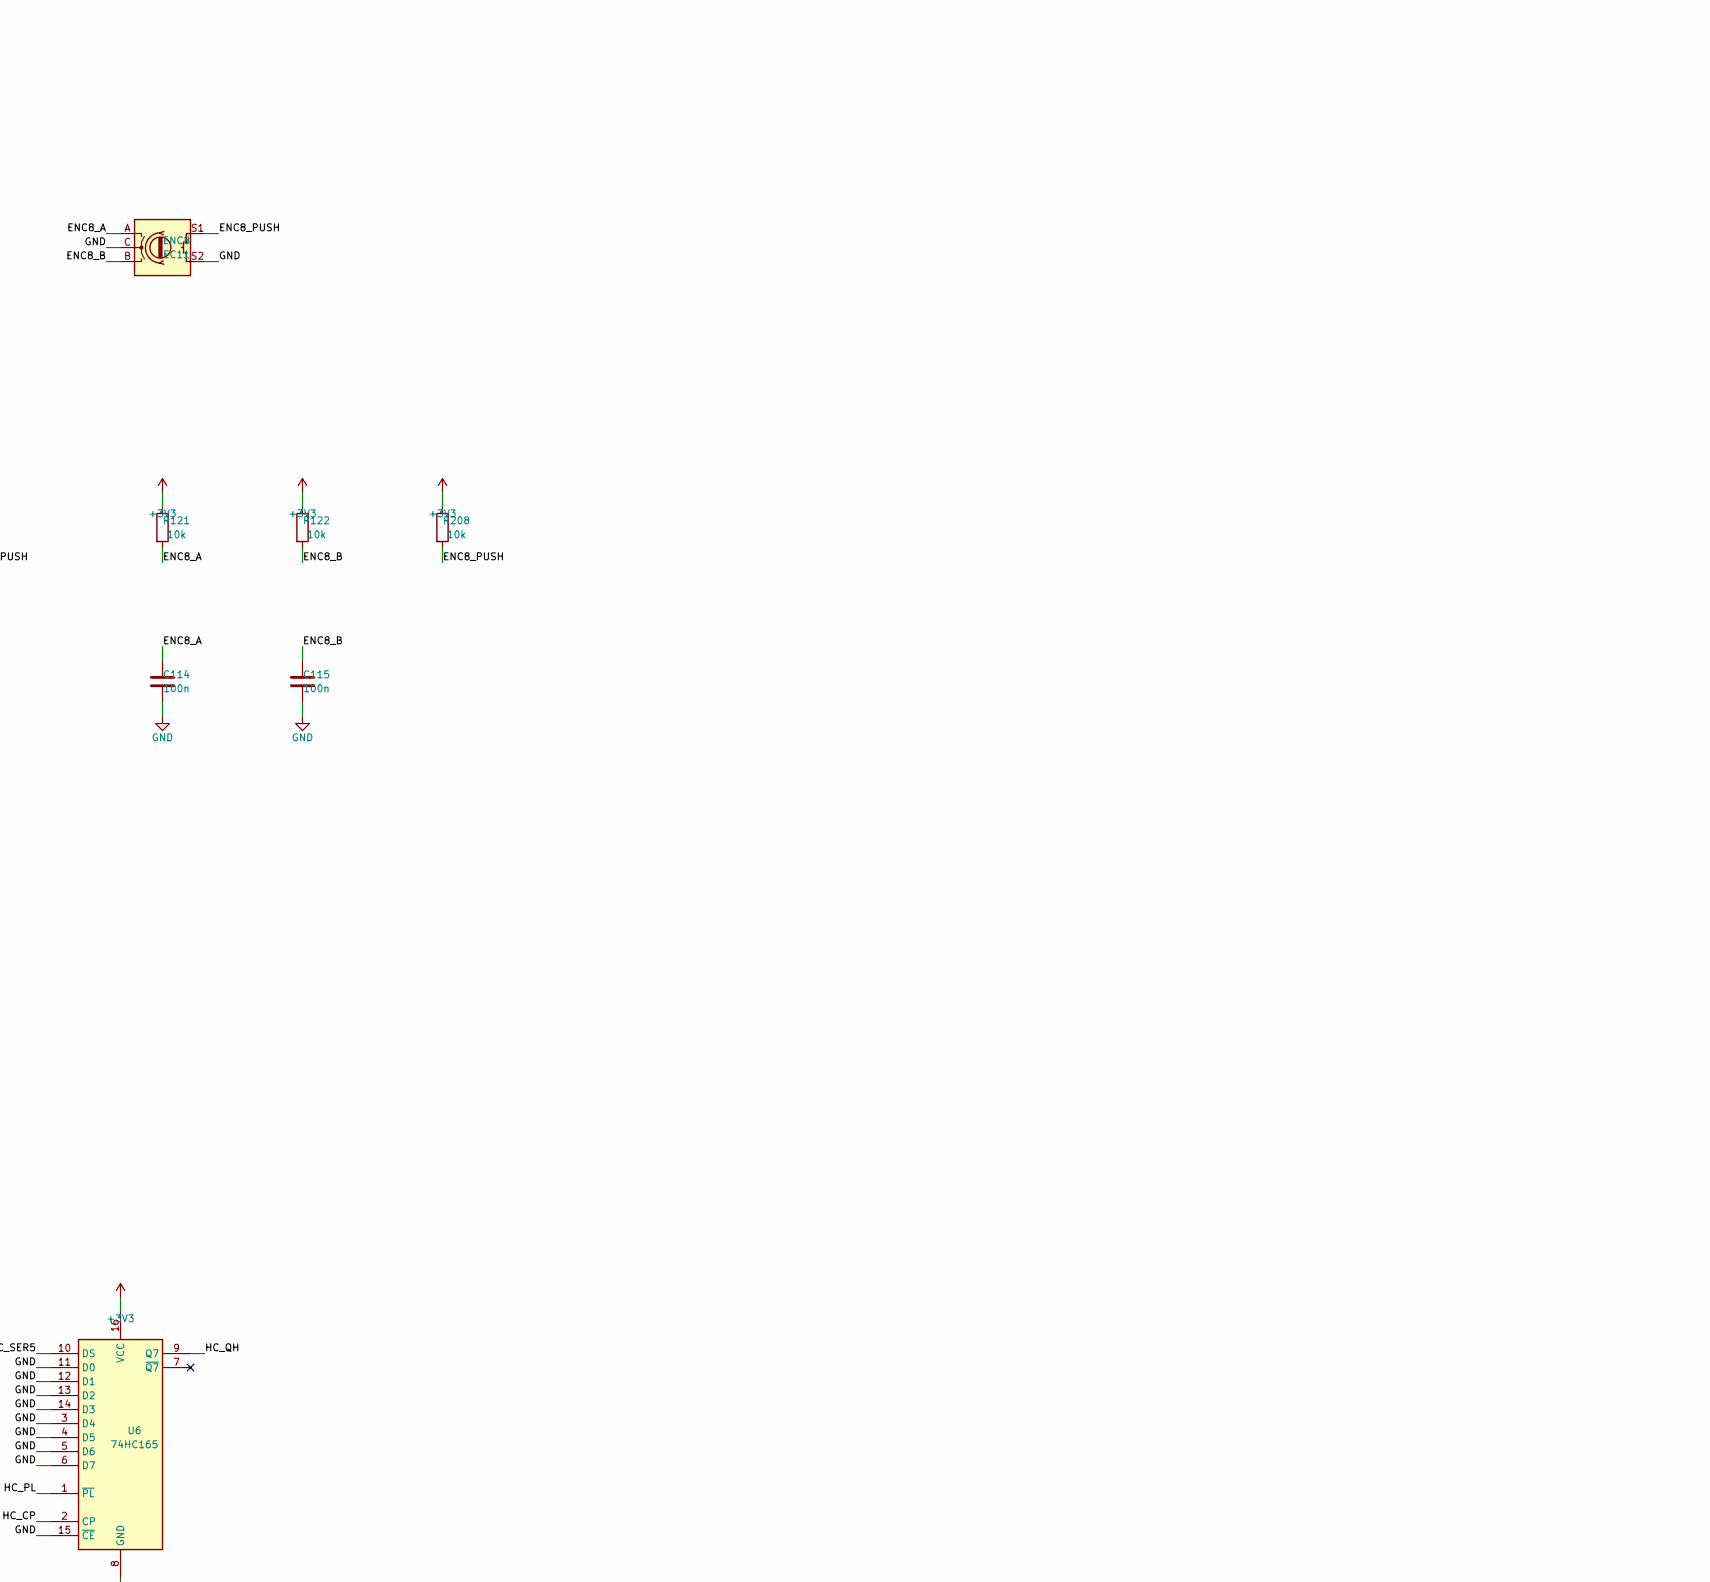
[picture p219: schematic panel-1.kicad_sch, part in row 1, column 3]

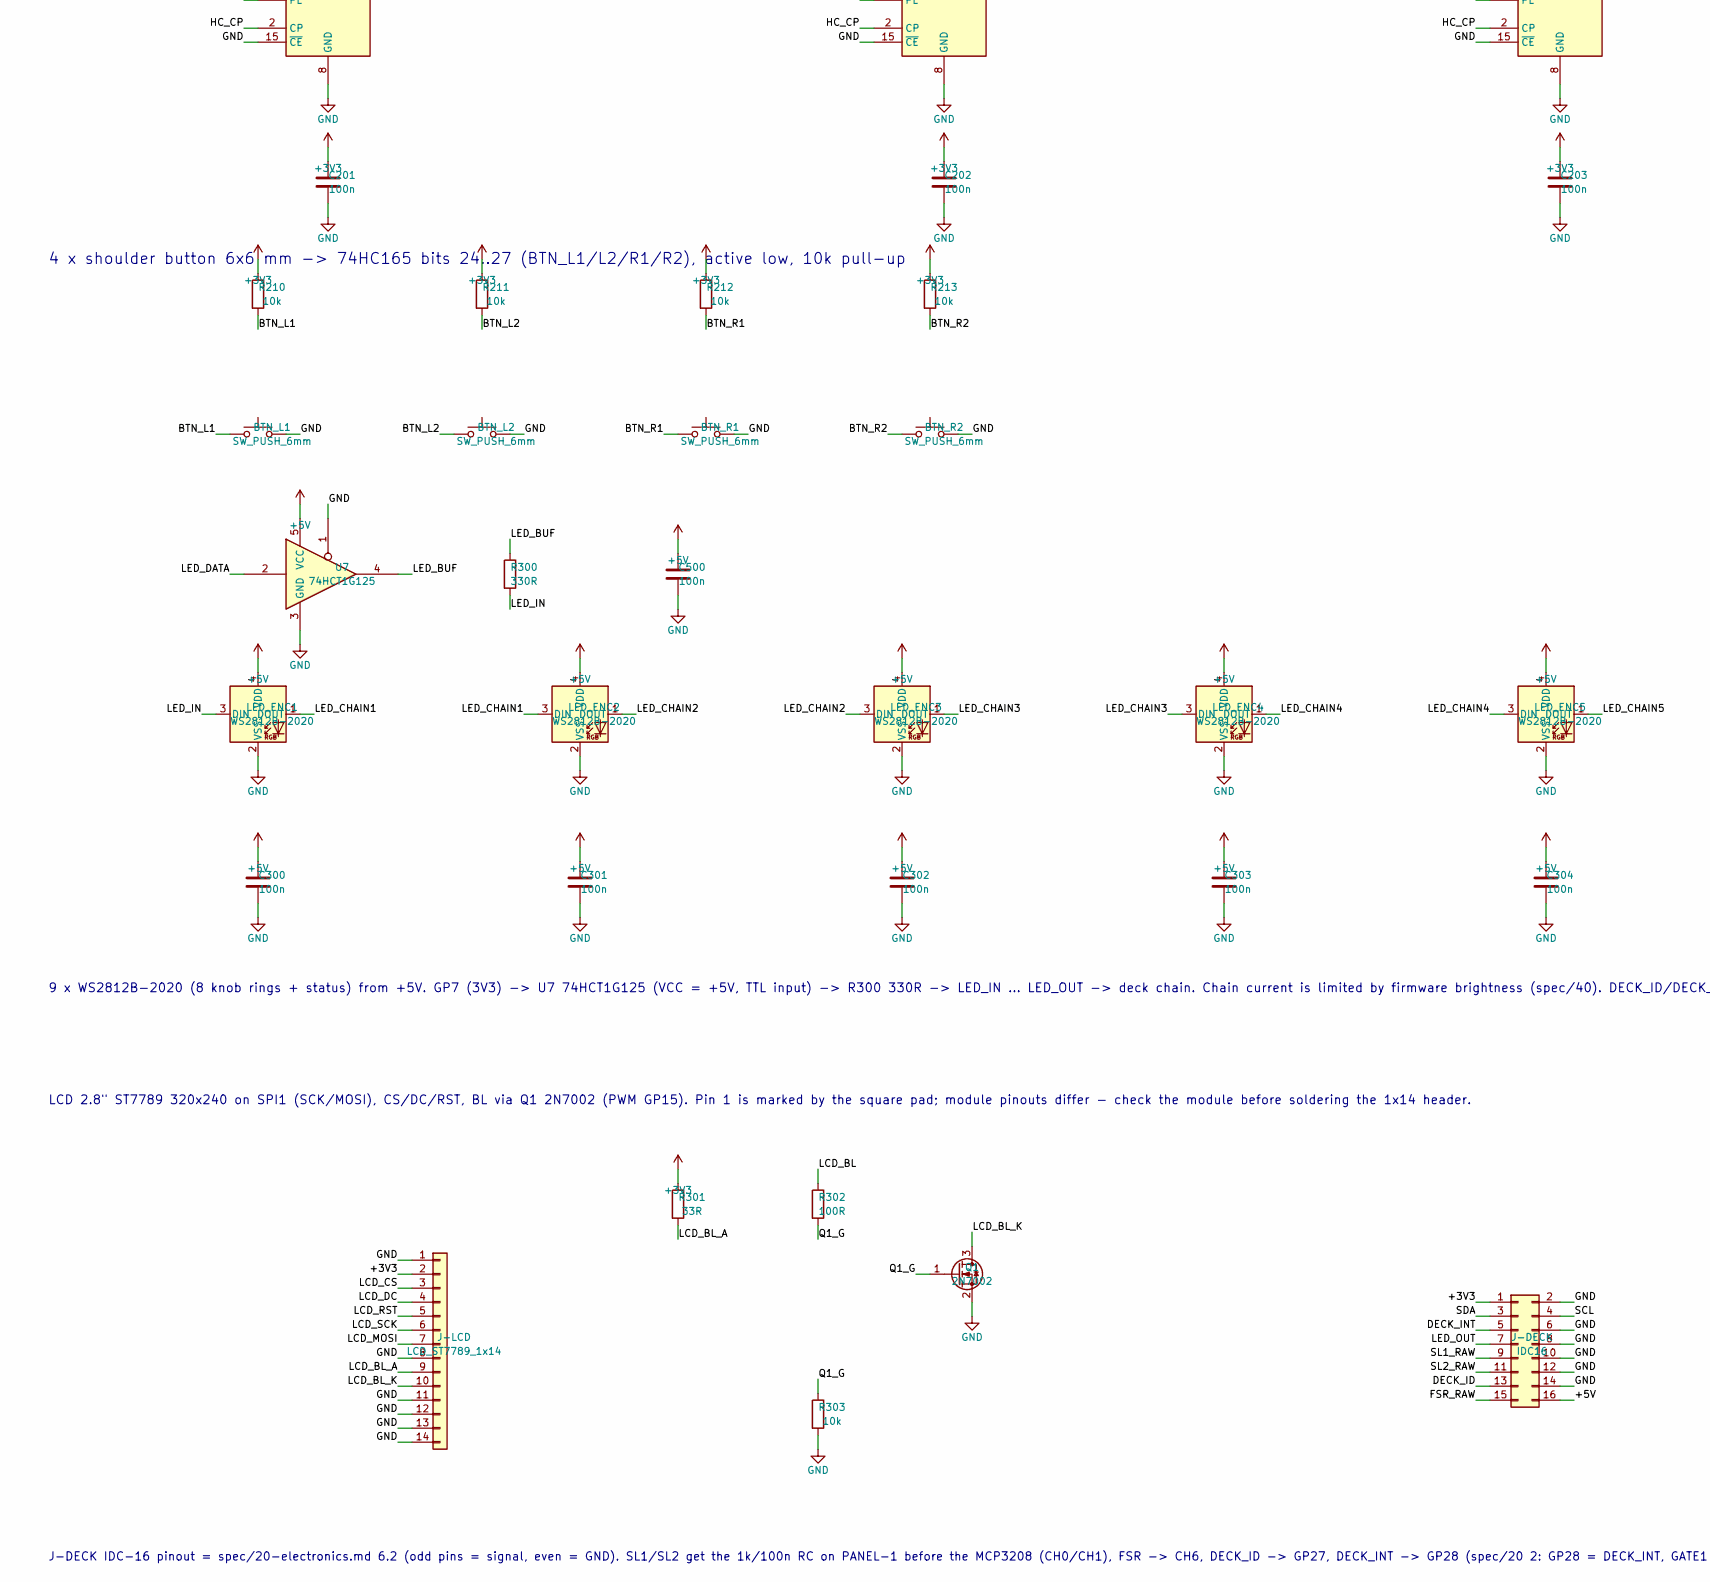
[picture p220: schematic panel-1.kicad_sch, part in row 2, column 1]

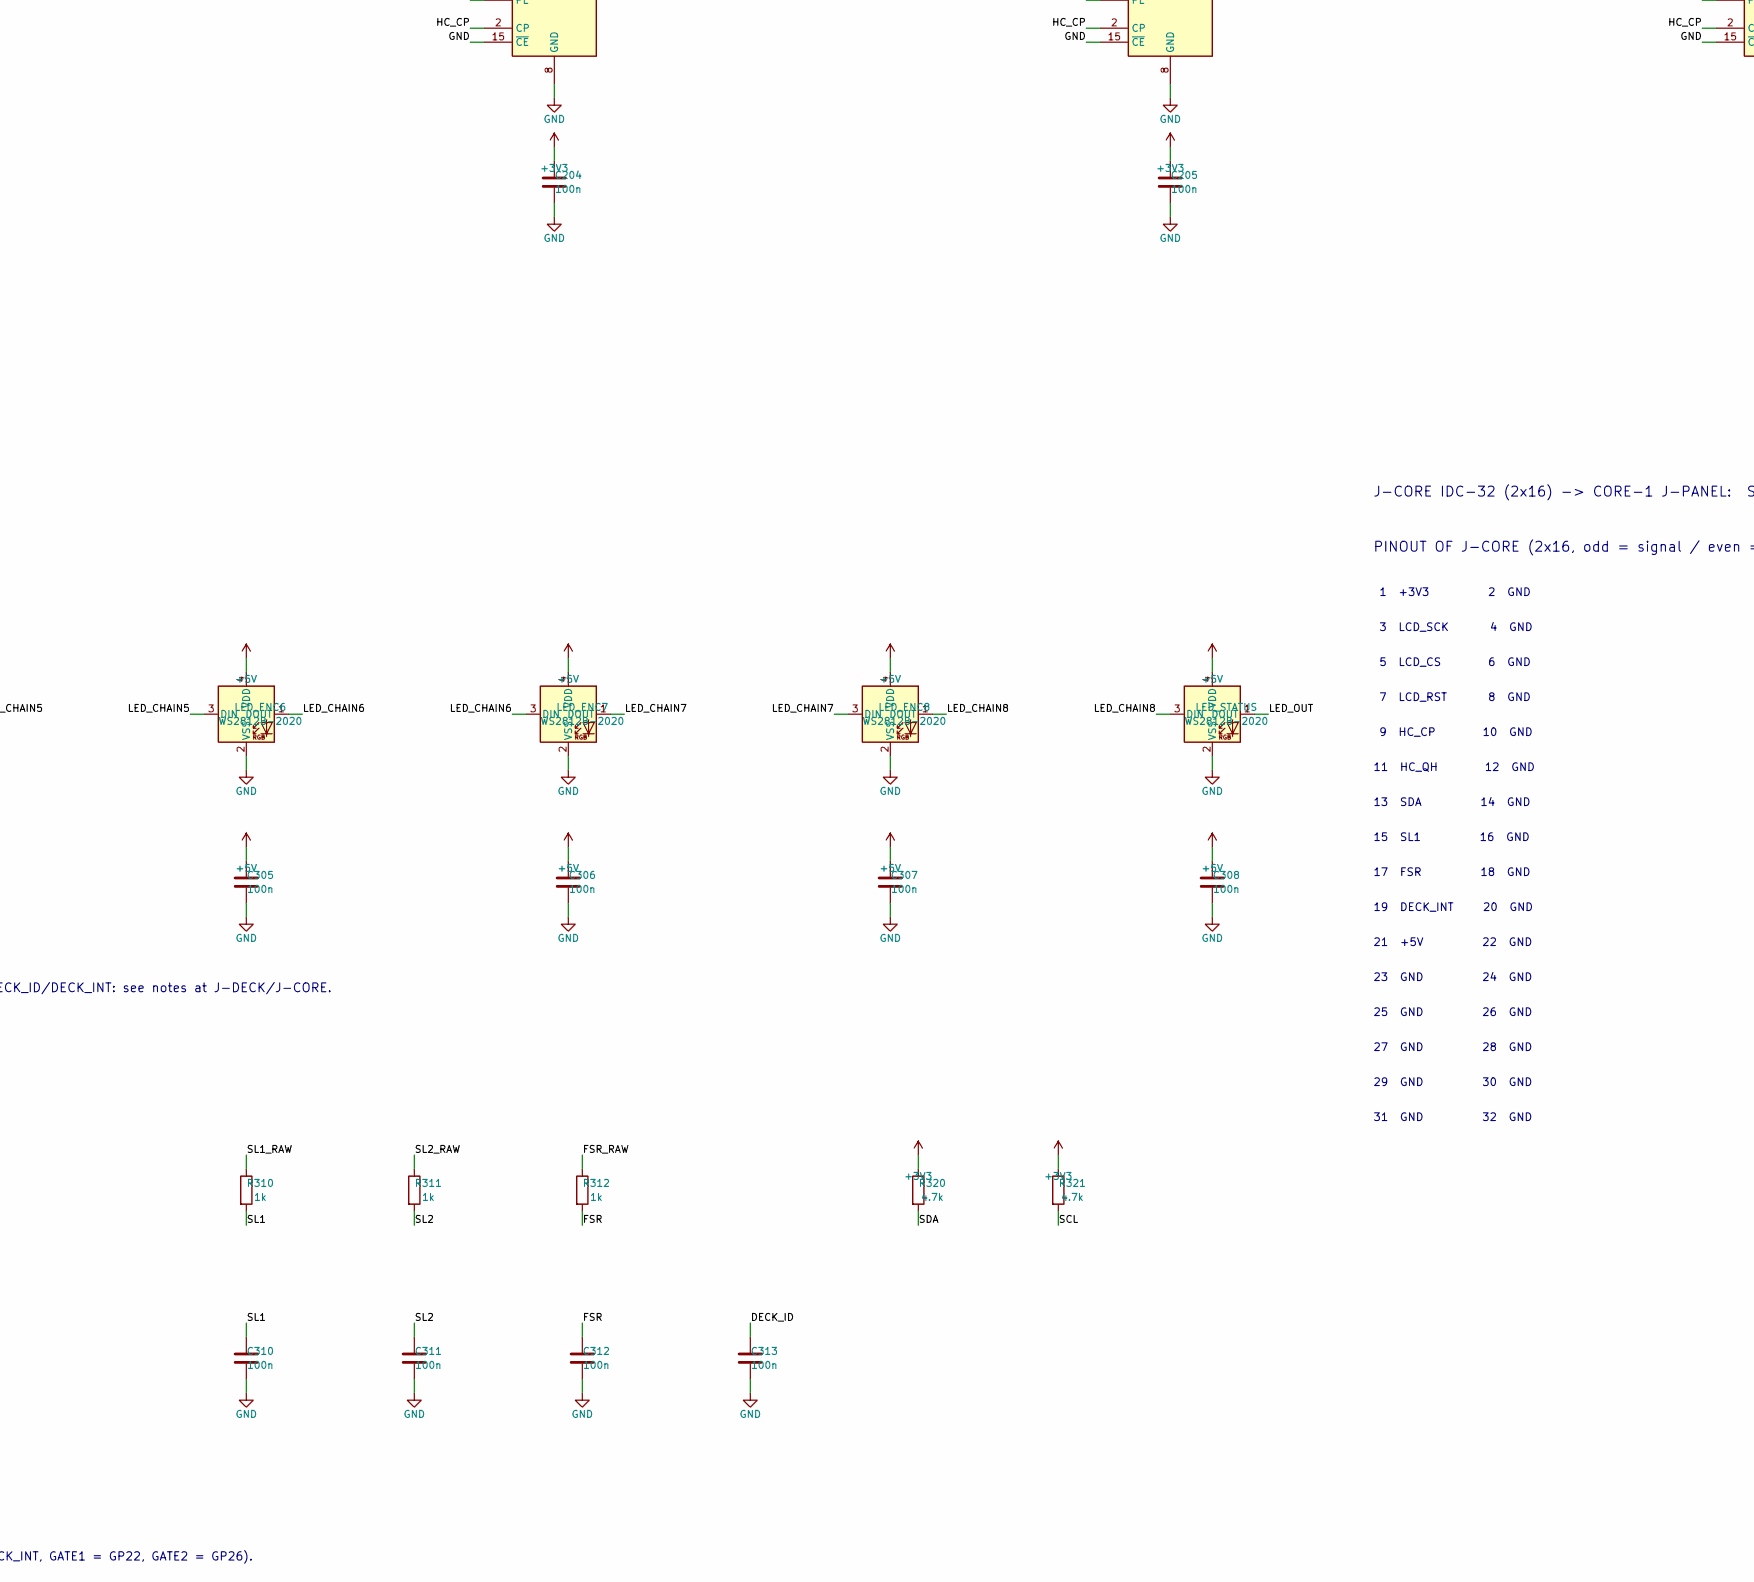
[picture p221: schematic panel-1.kicad_sch, part in row 2, column 2]

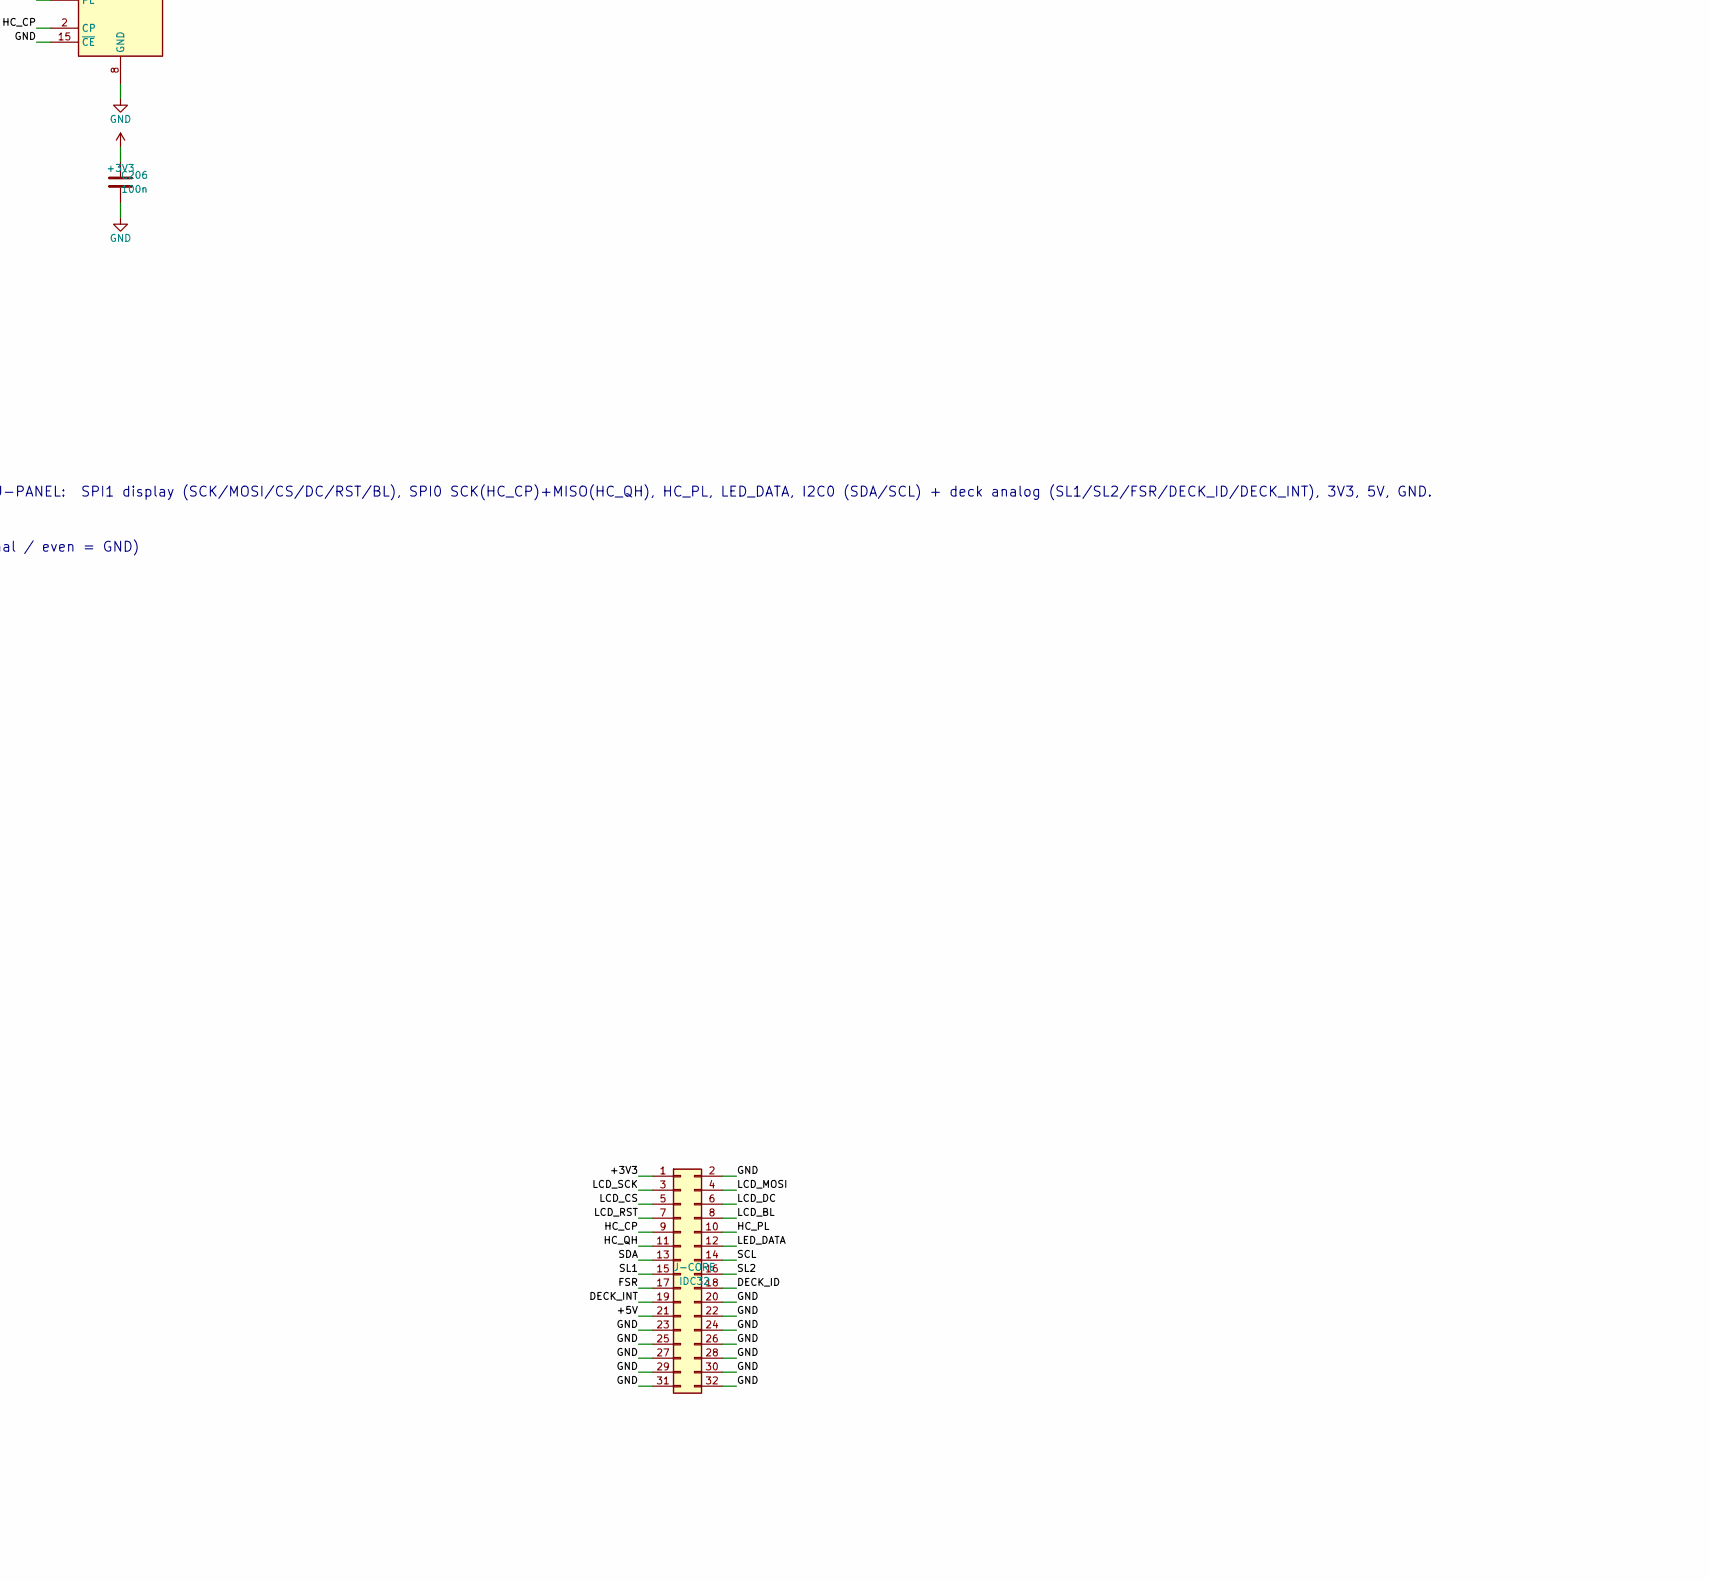
[picture p222: schematic panel-1.kicad_sch, part in row 2, column 3]

Parts:
BTN_L1, BTN_L2: SW_PUSH_6mm
BTN_R1, BTN_R2: SW_PUSH_6mm
C100, C101, C102, C103, C104, C105, C106, C107, C108, C109, C110, C111, C112, C113, C114, C115, C201, C202, C203, C204, C205, C206, C300, C301, C302, C303, C304, C305, C306, C307, C308, C310, C311, C312, C313, C500: 100n; C_0603_1608Metric
ENC1, ENC2, ENC3, ENC4, ENC5, ENC6, ENC7, ENC8: EC11; RotaryEncoder_Alps_EC11E-Switch_Vertical_H20mm
J-CORE: IDC32; PinHeader_2x16_P2.54mm_Vertical
J-DECK: IDC16; IDC-Header_2x08_P2.54mm_Vertical
J-LCD: LCD_ST7789_1x14; PinHeader_1x14_P2.54mm_Vertical
LED_ENC1, LED_ENC2, LED_ENC3, LED_ENC4, LED_ENC5, LED_ENC6, LED_ENC7, LED_ENC8: WS2812B-2020; LED_WS2812B-2020_PLCC4_2.0x2.0mm
LED_STATUS: WS2812B-2020; LED_WS2812B-2020_PLCC4_2.0x2.0mm
Q1: 2N7002; SOT-23
R100, R101, R103, R104, R106, R107, R109, R110, R112, R113, R115, R116, R118, R119, R121, R122, R201, R202, R203, R204, R205, R206, R207, R208, R210, R211, R212, R213, R303: 10k; R_0603_1608Metric
R300: 330R; R_0603_1608Metric
R301: 33R; R_0603_1608Metric
R302: 100R; R_0603_1608Metric
R310, R311, R312: 1k; R_0603_1608Metric
R320, R321: 4.7k; R_0603_1608Metric
U1, U2, U3, U4, U5, U6: 74HC165; SOIC-16_3.9x9.9mm_P1.27mm
U7: 74HCT1G125; SOT-23-5

Connections:
+3V3: C201.1, C202.1, C203.1, C204.1, C205.1, C206.1, J-CORE.1, J-DECK.1, J-LCD.2, R100.1, R101.1, R103.1, R104.1, R106.1, R107.1, R109.1, R110.1, R112.1, R113.1, R115.1, R116.1, R118.1, R119.1, R121.1, R122.1, R201.1, R202.1, R203.1, R204.1, R205.1, R206.1, R207.1, R208.1, R210.1, R211.1, R212.1, R213.1, R301.1, R320.1, R321.1, U1.16 (VCC), U2.16 (VCC), U3.16 (VCC), U4.16 (VCC), U5.16 (VCC), U6.16 (VCC)
+5V: C300.1, C301.1, C302.1, C303.1, C304.1, C305.1, C306.1, C307.1, C308.1, C500.1, J-CORE.21, J-DECK.16, LED_ENC1.4 (VDD), LED_ENC2.4 (VDD), LED_ENC3.4 (VDD), LED_ENC4.4 (VDD), LED_ENC5.4 (VDD), LED_ENC6.4 (VDD), LED_ENC7.4 (VDD), LED_ENC8.4 (VDD), LED_STATUS.4 (VDD), U7.5 (VCC)
BTN_L1: BTN_L1.1, R210.2, U4.11 (D0)
BTN_L2: BTN_L2.1, R211.2, U4.12 (D1)
BTN_R1: BTN_R1.1, R212.2, U4.13 (D2)
BTN_R2: BTN_R2.1, R213.2, U4.14 (D3)
DECK_ID: C313.1, J-CORE.18, J-DECK.13
DECK_INT: J-CORE.19, J-DECK.5
ENC1_A: C100.1, ENC1.A, R100.2, U1.11 (D0)
ENC1_B: C101.1, ENC1.B, R101.2, U1.12 (D1)
ENC1_PUSH: ENC1.S1, R201.2, U3.11 (D0)
ENC2_A: C102.1, ENC2.A, R103.2, U1.13 (D2)
ENC2_B: C103.1, ENC2.B, R104.2, U1.14 (D3)
ENC2_PUSH: ENC2.S1, R202.2, U3.12 (D1)
ENC3_A: C104.1, ENC3.A, R106.2, U1.3 (D4)
ENC3_B: C105.1, ENC3.B, R107.2, U1.4 (D5)
ENC3_PUSH: ENC3.S1, R203.2, U3.13 (D2)
ENC4_A: C106.1, ENC4.A, R109.2, U1.5 (D6)
ENC4_B: C107.1, ENC4.B, R110.2, U1.6 (D7)
ENC4_PUSH: ENC4.S1, R204.2, U3.14 (D3)
ENC5_A: C108.1, ENC5.A, R112.2, U2.11 (D0)
ENC5_B: C109.1, ENC5.B, R113.2, U2.12 (D1)
ENC5_PUSH: ENC5.S1, R205.2, U3.3 (D4)
ENC6_A: C110.1, ENC6.A, R115.2, U2.13 (D2)
ENC6_B: C111.1, ENC6.B, R116.2, U2.14 (D3)
ENC6_PUSH: ENC6.S1, R206.2, U3.4 (D5)
ENC7_A: C112.1, ENC7.A, R118.2, U2.3 (D4)
ENC7_B: C113.1, ENC7.B, R119.2, U2.4 (D5)
ENC7_PUSH: ENC7.S1, R207.2, U3.5 (D6)
ENC8_A: C114.1, ENC8.A, R121.2, U2.5 (D6)
ENC8_B: C115.1, ENC8.B, R122.2, U2.6 (D7)
ENC8_PUSH: ENC8.S1, R208.2, U3.6 (D7)
FSR: C312.1, J-CORE.17, R312.2
FSR_RAW: J-DECK.15, R312.1
GND: BTN_L1.2, BTN_L2.2, BTN_R1.2, BTN_R2.2, C100.2, C101.2, C102.2, C103.2, C104.2, C105.2, C106.2, C107.2, C108.2, C109.2, C110.2, C111.2, C112.2, C113.2, C114.2, C115.2, C201.2, C202.2, C203.2, C204.2, C205.2, C206.2, C300.2, C301.2, C302.2, C303.2, C304.2, C305.2, C306.2, C307.2, C308.2, C310.2, C311.2, C312.2, C313.2, C500.2, ENC1.C, ENC1.S2, ENC2.C, ENC2.S2, ENC3.C, ENC3.S2, ENC4.C, ENC4.S2, ENC5.C, ENC5.S2, ENC6.C, ENC6.S2, ENC7.C, ENC7.S2, ENC8.C, ENC8.S2, J-CORE.2, J-CORE.20, J-CORE.22, J-CORE.23, J-CORE.24, J-CORE.25, J-CORE.26, J-CORE.27, J-CORE.28, J-CORE.29, J-CORE.30, J-CORE.31, J-CORE.32, J-DECK.2, J-DECK.6, J-DECK.8, J-DECK.10, J-DECK.12, J-DECK.14, J-LCD.1, J-LCD.8, J-LCD.11, J-LCD.12, J-LCD.13, J-LCD.14, LED_ENC1.2 (VSS), LED_ENC2.2 (VSS), LED_ENC3.2 (VSS), LED_ENC4.2 (VSS), LED_ENC5.2 (VSS), LED_ENC6.2 (VSS), LED_ENC7.2 (VSS), LED_ENC8.2 (VSS), LED_STATUS.2 (VSS), Q1.2 (S), R303.2, U1.8 (GND), U1.10 (DS), U1.15 (~CE), U2.8 (GND), U2.15 (~CE), U3.8 (GND), U3.15 (~CE), U4.3 (D4), U4.4 (D5), U4.5 (D6), U4.6 (D7), U4.8 (GND), U4.15 (~CE), U5.3 (D4), U5.4 (D5), U5.5 (D6), U5.6 (D7), U5.8 (GND), U5.11 (D0), U5.12 (D1), U5.13 (D2), U5.14 (D3), U5.15 (~CE), U6.3 (D4), U6.4 (D5), U6.5 (D6), U6.6 (D7), U6.8 (GND), U6.11 (D0), U6.12 (D1), U6.13 (D2), U6.14 (D3), U6.15 (~CE), U7.1, U7.3 (GND)
HC_CP: J-CORE.9, U1.2 (CP), U2.2 (CP), U3.2 (CP), U4.2 (CP), U5.2 (CP), U6.2 (CP)
HC_PL: J-CORE.10, U1.1 (~PL), U2.1 (~PL), U3.1 (~PL), U4.1 (~PL), U5.1 (~PL), U6.1 (~PL)
HC_QH: J-CORE.11, U6.9 (Q7)
HC_SER1: U1.9 (Q7), U2.10 (DS)
HC_SER2: U2.9 (Q7), U3.10 (DS)
HC_SER3: U3.9 (Q7), U4.10 (DS)
HC_SER4: U4.9 (Q7), U5.10 (DS)
HC_SER5: U5.9 (Q7), U6.10 (DS)
LCD_BL: J-CORE.8, R302.1
LCD_BL_A: J-LCD.9, R301.2
LCD_BL_K: J-LCD.10, Q1.3 (D)
LCD_CS: J-CORE.5, J-LCD.3
LCD_DC: J-CORE.6, J-LCD.4
LCD_MOSI: J-CORE.4, J-LCD.7
LCD_RST: J-CORE.7, J-LCD.5
LCD_SCK: J-CORE.3, J-LCD.6
LED_BUF: R300.1, U7.4
LED_CHAIN1: LED_ENC1.1 (DOUT), LED_ENC2.3 (DIN)
LED_CHAIN2: LED_ENC2.1 (DOUT), LED_ENC3.3 (DIN)
LED_CHAIN3: LED_ENC3.1 (DOUT), LED_ENC4.3 (DIN)
LED_CHAIN4: LED_ENC4.1 (DOUT), LED_ENC5.3 (DIN)
LED_CHAIN5: LED_ENC5.1 (DOUT), LED_ENC6.3 (DIN)
LED_CHAIN6: LED_ENC6.1 (DOUT), LED_ENC7.3 (DIN)
LED_CHAIN7: LED_ENC7.1 (DOUT), LED_ENC8.3 (DIN)
LED_CHAIN8: LED_ENC8.1 (DOUT), LED_STATUS.3 (DIN)
LED_DATA: J-CORE.12, U7.2
LED_IN: LED_ENC1.3 (DIN), R300.2
LED_OUT: J-DECK.7, LED_STATUS.1 (DOUT)
Q1_G: Q1.1 (G), R302.2, R303.1
SCL: J-CORE.14, J-DECK.4, R321.2
SDA: J-CORE.13, J-DECK.3, R320.2
SL1: C310.1, J-CORE.15, R310.2
SL1_RAW: J-DECK.9, R310.1
SL2: C311.1, J-CORE.16, R311.2
SL2_RAW: J-DECK.11, R311.1

Notes on the sheet:
PANEL-1 Bukifon v1.0 (spec/20-electronics.md 6.1) 300 x 132 x 1.6 mm CERN-OHL-S-2.0 upper part Y 0..66, deck niche Y 66..145 (spec 10-panel-ui 3)
Coordinates of all controls = spec/10-panel-ui.md (ENC1..8, BTN_L1/L2/R1/R2, deck IDC-16, screen 1x14). Connectivity is net-label based.
8 x EC11 (smooth, with push switch) + 16 x RC 10k/100n on A/B + 8 x 10k push pull-up
6 x 74HC165 cascade = 48 bits. CP=HC_CP(GP2) PL=HC_PL(GP6) QH=HC_QH(GP4/MISO). bits 0..15 encoders A/B, 16..23 encoder push, 24..27 shoulder, 28..47 reserved(GND).
4 x shoulder button 6x6 mm -> 74HC165 bits 24..27 (BTN_L1/L2/R1/R2), active low, 10k pull-up
9 x WS2812B-2020 (8 knob rings + status) from +5V. GP7 (3V3) -> U7 74HCT1G125 (VCC = +5V, TTL input) -> R300 330R -> LED_IN ... LED_OUT -> deck chain. Chain current is limited by firmware brightness (spec/40). DECK_ID/DECK_INT: see notes at J-DECK/J-CORE.
LCD 2.8" ST7789 320x240 on SPI1 (SCK/MOSI), CS/DC/RST, BL via Q1 2N7002 (PWM GP15). Pin 1 is marked by the square pad; module pinouts differ - check the module before soldering the 1x14 header.
J-DECK IDC-16 pinout = spec/20-electronics.md 6.2 (odd pins = signal, even = GND). SL1/SL2 get the 1k/100n RC on PANEL-1 before the MCP3208 (CH0/CH1), FSR -> CH6, DECK_ID -> GP27, DECK_INT -> GP28 (spec/20 2: GP28 = DECK_INT, GATE1 = GP22, GATE2 = GP26).
J-CORE IDC-32 (2x16) -> CORE-1 J-PANEL: SPI1 display (SCK/MOSI/CS/DC/RST/BL), SPI0 SCK(HC_CP)+MISO(HC_QH), HC_PL, LED_DATA, I2C0 (SDA/SCL) + deck analog (SL1/SL2/FSR/DECK_ID/DECK_INT), 3V3, 5V, GND.
PINOUT OF J-CORE (2x16, odd = signal / even = GND)
1 +3V3 2 GND
3 LCD_SCK 4 GND
5 LCD_CS 6 GND
7 LCD_RST 8 GND
9 HC_CP 10 GND
11 HC_QH 12 GND
13 SDA 14 GND
15 SL1 16 GND
17 FSR 18 GND
19 DECK_INT 20 GND
21 +5V 22 GND
23 GND 24 GND
25 GND 26 GND
27 GND 28 GND
29 GND 30 GND
31 GND 32 GND
