martiyanov/bukifon/hardware/core2/gen_core2_sch.py

#!/usr/bin/env python3
import sys as _sys; _sys.dont_write_bytecode = True
# -*- coding: utf-8 -*-
"""CORE-2 schematic generator (PRE-FREEZE / DO NOT FABRICATE).

KiCad 10 native S-expression .kicad_sch, generated from tools/board_def.py.
KiCad 10 `sch upgrade` cannot import legacy v5, so the file is written directly.
The MCU slot J-MCU (2x32) is a *logical* pre-freeze contract for an ESP32-P4
module/adapter; see pinmap.md / interfaces.md.

Usage: python3 gen_core2_sch.py [--no-export]
Output: CORE-2.kicad_sch, CORE-2.pdf/svg, erc/erc.rpt(+json), netlist.net/xml,
        BOM-core2.csv
"""
import os, sys, math, json, subprocess
sys.path.insert(0, os.path.join(os.path.dirname(os.path.abspath(__file__)), 'tools'))
import kicad_sch as k
import board_def as B

HERE = os.path.dirname(os.path.abspath(__file__))
KICAD_CLI = '/Applications/KiCad/KiCad.app/Contents/MacOS/kicad-cli'
PROJECT = 'CORE-2'
PAPER = 'A0'
SW, SH = 63.5, 30.48
LABEL_PAD = 2.54 + 13.0

def f(v):
    v = round(float(v), 3); return '%g' % v

# --------------------------------------------------------------------------
# custom symbols
# --------------------------------------------------------------------------
def _pin(num, name, x, y, a, ln=2.54, etype='passive'):
    return ('\t\t(pin %s line (at %s %s %s) (length %s)\n'
            '\t\t\t(name "%s" (effects (font (size 1.27 1.27))))\n'
            '\t\t\t(number "%s" (effects (font (size 1.27 1.27))))\n'
            '\t\t)' % (etype, f(x), f(y), int(a), f(ln), name, num))

def custom_symbol(name, refpfx, desc, rect, pins, hide_num=False):
    x1, y1, x2, y2 = rect
    bt, bb = max(y1, y2), min(y1, y2)
    out = ['\t(symbol "%s"' % name,
           '\t\t(pin_names (offset 1.016))']
    if hide_num: out.append('\t\t(pin_numbers (hide yes))')
    out += ['\t\t(exclude_from_sim no)', '\t\t(in_bom yes)', '\t\t(on_board yes)',
            '\t\t(property "Reference" "%s" (at %s %s 0)\n\t\t\t(effects (font (size 1.27 1.27)))\n\t\t)' % (refpfx, f(0), f(bt + 2.54)),
            '\t\t(property "Value" "%s" (at %s %s 0)\n\t\t\t(effects (font (size 1.27 1.27)))\n\t\t)' % (name, f(0), f(bb - 2.54)),
            '\t\t(property "Footprint" "" (at 0 0 0)\n\t\t\t(effects (font (size 1.27 1.27)) (hide yes))\n\t\t)',
            '\t\t(property "Datasheet" "~" (at 0 0 0)\n\t\t\t(effects (font (size 1.27 1.27)) (hide yes))\n\t\t)',
            '\t\t(property "Description" "%s" (at 0 0 0)\n\t\t\t(effects (font (size 1.27 1.27)) (hide yes))\n\t\t)' % desc,
            '\t\t(symbol "%s_0_1"' % name,
            '\t\t\t(rectangle (start %s %s) (end %s %s)\n\t\t\t\t(stroke (width 0.254) (type default))\n\t\t\t\t(fill (type background))\n\t\t\t)' % (f(x1), f(bb), f(x2), f(bt)),
            '\t\t)',
            '\t\t(symbol "%s_1_1"' % name]
    out += [_pin(*p) for p in pins]
    out += ['\t\t)', '\t)']
    return '\n'.join(out)

def mcu_symbol():
    """2x32 module slot; pin numbers 1..64, names from board_def PINMAP."""
    def disp(r):
        sig, gpio = r[0], r[1]
        if sig == 'GND' or sig.startswith('GND'):
            return 'GND'
        if sig == '3V3_MCU': return '3V3'
        if sig == 'CHIP_PU': return 'EN'
        if sig == 'USB_HS_DP': return 'USB_DP'
        if sig == 'USB_HS_DM': return 'USB_DM'
        if sig == 'USB_JTAG_DP': return 'IO24'
        if sig == 'USB_JTAG_DM': return 'IO25'
        if sig == 'USB_FS_DP': return 'IO26'
        if sig == 'USB_FS_DM': return 'IO27'
        if sig == 'STRAP36': return 'IO36'
        if sig == 'FREE_IO54': return 'IO54'
        if sig == 'BOOT': return 'IO35'
        if sig == 'LED_GPIO': return 'IO48'
        if gpio is None: return sig
        return 'IO%d' % gpio
    rows = {r[7]: r for r in B.PINMAP}
    pins = []
    top = 39.37
    for n in range(1, 33):
        r = rows[n]
        pins.append((str(n), disp(r), -27.94, top - (n - 1) * 2.54, 0, 2.54, 'passive'))
    for n in range(33, 65):
        r = rows[n]
        pins.append((str(n), disp(r), 27.94, top - (n - 33) * 2.54, 180, 2.54, 'passive'))
    return custom_symbol('ESP32-P4_MOD', 'U', B.SLOT,
                         (-24.13, -46.99, 24.13, 43.18), pins)

def build_custom_lib():
    lib = {}
    lib['ESP32-P4_MOD'] = mcu_symbol()
    lib['MP1584_MOD'] = custom_symbol(
        'MP1584_MOD', 'U', 'MP1584 3A DC-DC buck module (4-pad breakout)',
        (-7.62, -7.62, 7.62, 7.62),
        [('1', 'IN+', -10.16, 2.54, 0), ('2', 'IN-', -10.16, -2.54, 0),
         ('3', 'OUT+', 10.16, 2.54, 180), ('4', 'OUT-', 10.16, -2.54, 180)])
    lib['MAX9814'] = custom_symbol(
        'MAX9814', 'U', 'MAX9814 mic amp with AGC + mic bias (TDFN-14)',
        (-12.7, -16.51, 12.7, 16.51),
        [('1', 'CT', -15.24, 12.7, 0), ('2', 'SHDN', -15.24, 10.16, 0),
         ('3', 'CG', -15.24, 7.62, 0), ('4', 'NC4', -15.24, 5.08, 0),
         ('5', 'VDD', -15.24, 2.54, 0), ('6', 'MICOUT', 15.24, 2.54, 180),
         ('7', 'GND', 0, -20.32, 90), ('8', 'MICIN', -15.24, -2.54, 0),
         ('9', 'AR', -15.24, -5.08, 0), ('10', 'GAIN', -15.24, -7.62, 0),
         ('11', 'NC11', 15.24, -12.7, 180), ('12', 'BIAS', 15.24, 12.7, 180),
         ('13', 'MCBIAS', 15.24, 10.16, 180), ('14', 'TH', 15.24, -15.24, 180),
         ('15', 'EP', 15.24, -17.78, 180)],
        hide_num=False)
    lib['TS5A23157'] = custom_symbol(
        'TS5A23157', 'U', 'TS5A23157 dual SPDT analog switch (VSSOP-10)',
        (-10.16, -12.7, 10.16, 12.7),
        [('1', 'IN1', -12.7, 7.62, 0), ('2', 'NO1', 12.7, 10.16, 180),
         ('3', 'GND', 0, -15.24, 90), ('4', 'NO2', 12.7, 5.08, 180),
         ('5', 'IN2', 12.7, 2.54, 180), ('6', 'COM2', 12.7, 0, 180),
         ('7', 'NC2', -12.7, 0, 0), ('8', 'VCC', 0, 15.24, 270),
         ('9', 'NC1', 12.7, -2.54, 180), ('10', 'COM1', 12.7, -5.08, 180)],
        hide_num=False)
    lib['PCM1808'] = custom_symbol(
        'PCM1808', 'U', 'PCM1808 24-bit 96 kHz stereo I2S ADC (TSSOP-14)',
        (-12.7, -16.51, 12.7, 16.51),
        [('1', 'VREF', 15.24, 12.7, 180), ('2', 'AGND', 15.24, 10.16, 180),
         ('3', 'VCC', 15.24, 7.62, 180), ('4', 'VDD', 15.24, 5.08, 180),
         ('5', 'DGND', 15.24, -15.24, 180), ('14', 'VINR', 15.24, 2.54, 180),
         ('13', 'VINL', 15.24, 0, 180), ('12', 'FMT', -15.24, -12.7, 0),
         ('11', 'MD1', -15.24, -10.16, 0), ('10', 'MD0', -15.24, -7.62, 0),
         ('9', 'DOUT', -15.24, 10.16, 0), ('8', 'BCK', -15.24, 7.62, 0),
         ('7', 'LRCK', -15.24, 5.08, 0), ('6', 'SCKI', -15.24, 0, 0)])
    lib['74HCT1G125'] = custom_symbol(
        '74HCT1G125', 'U', 'Single 3-state buffer, TTL input (level shifter 3.3->5 V)',
        (-5.08, -6.35, 5.08, 6.35),
        [('1', '~OE', -7.62, 2.54, 0, 2.54, 'input'),
         ('2', 'A', -7.62, 0, 0, 2.54, 'input'),
         ('3', 'GND', 0, -8.89, 90, 2.54, 'power_in'),
         ('4', 'Y', 7.62, 0, 180, 2.54, 'tri_state'),
         ('5', 'VCC', 0, 8.89, 270, 2.54, 'power_in')])
    lib['74HCT125'] = custom_symbol(
        '74HCT125', 'U', 'Quad 3-state buffer, TTL input (MIDI OUT)',
        (-10.16, -12.7, 10.16, 12.7),
        [('1', '1OE', -12.7, 10.16, 0, 2.54, 'input'), ('2', '1A', -12.7, 7.62, 0, 2.54, 'input'),
         ('3', '1Y', 12.7, 7.62, 180, 2.54, 'tri_state'), ('4', '2OE', -12.7, 5.08, 0, 2.54, 'input'),
         ('5', '2A', -12.7, 2.54, 0, 2.54, 'input'), ('6', '2Y', 12.7, 2.54, 180, 2.54, 'tri_state'),
         ('7', 'GND', 0, -15.24, 90, 2.54, 'power_in'),
         ('8', '3Y', 12.7, -2.54, 180, 2.54, 'tri_state'), ('9', '3A', -12.7, -2.54, 0, 2.54, 'input'),
         ('10', '3OE', -12.7, 0, 0, 2.54, 'input'), ('11', '4Y', 12.7, -7.62, 180, 2.54, 'tri_state'),
         ('12', '4A', -12.7, -5.08, 0, 2.54, 'input'), ('13', '4OE', -12.7, -7.62, 0, 2.54, 'input'),
         ('14', 'VCC', 0, 15.24, 270, 2.54, 'power_in')])
    lib['ESP32-C6-MINI-1'] = custom_symbol(
        'ESP32-C6-MINI-1', 'U', 'ESP32-C6-MINI-1 Wi-Fi 6 / BLE 5.3 coprocessor (esp-hosted SPI). '
        'PCB antenna: keep-out >=15 mm from metal/battery/walls. DNP for ESP32-S3 build.',
        (-10.16, -10.16, 10.16, 10.16),
        [('1', '3V3', 0, 12.7, 270, 2.54, 'power_in'),
         ('2', 'GND', -5.08, -12.7, 90, 2.54, 'power_in'),
         ('3', 'EN', -12.7, 5.08, 0, 2.54, 'input'),
         ('4', 'SPI_SCK', -12.7, 2.54, 0, 2.54, 'input'),
         ('5', 'SPI_MOSI', -12.7, 0, 0, 2.54, 'input'),
         ('6', 'SPI_MISO', -12.7, -2.54, 0, 2.54, 'passive'),
         ('7', 'SPI_CS', -12.7, -5.08, 0, 2.54, 'input'),
         ('8', 'HANDSHAKE', 12.7, 2.54, 180, 2.54, 'bidirectional'),
         ('9', 'DATA_READY', 12.7, 0, 180, 2.54, 'bidirectional'),
         ('10', 'GND', 5.08, -12.7, 90, 2.54, 'power_in')])
    lib['TP'] = custom_symbol('TP', 'TP', 'Test point', (-2.54, -2.54, 2.54, 2.54),
                              [('1', '1', -5.08, 0, 0, 2.54)])
    for nm, txt in lib.items():
        k.CUSTOM[('picomod', nm)] = txt.replace('(symbol "%s"' % nm, '(symbol "picomod:%s"' % nm, 1)
    return lib

# --------------------------------------------------------------------------
# footprints (draft, not for fabrication)
# --------------------------------------------------------------------------
FP = {
 'R': 'Resistor_SMD:R_0805_2012Metric', 'C': 'Capacitor_SMD:C_0805_2012Metric',
 'CP': 'Capacitor_SMD:CP_Elec_6.3x7.7', 'C10': 'Capacitor_SMD:CP_Elec_5x5.4',
 'L': 'Inductor_SMD:L_1210_3225Metric', 'FB': 'Inductor_SMD:L_0805_2012Metric',
 'FUSE': 'Fuse:Fuse_1206_3216Metric', 'PF': 'Fuse:Fuse_1206_3216Metric',
 'DIODE': 'Diode_SMD:D_SMA', 'BAT54S': 'Package_TO_SOT_SMD:SOT-23',
 'TO92': 'Package_TO_SOT_THT:TO-92_Inline', 'SOT23': 'Package_TO_SOT_SMD:SOT-23',
 'SOT353': 'Package_TO_SOT_SMD:SOT-353_SC-70-5',
 'SOIC14': 'Package_SO:SOIC-14_3.9x8.7mm_P1.27mm',
 'DIP8': 'Package_DIP:DIP-8_W7.62mm', 'DIP14': 'Package_DIP:DIP-14_W7.62mm',
 'DIP16': 'Package_DIP:DIP-16_W7.62mm',
 'SOIC8': 'Package_SO:SOIC-8_3.9x4.9mm_P1.27mm',
 'MSOP10': 'Package_SO:MSOP-10_3x3mm_P0.5mm', 'TSSOP14': 'Package_SO:TSSOP-14_4.4x5mm_P0.65mm',
 'TSSOP20': 'Package_SO:TSSOP-20_4.4x6.5mm_P0.65mm',
 'SOT235': 'Package_TO_SOT_SMD:SOT-23-5', 'SOT236': 'Package_TO_SOT_SMD:SOT-23-6',
 'QFN16': 'Package_DFN_QFN:QFN-16-1EP_4x4mm_P0.65mm_EP2.1x2.1mm',
 'SOD123': 'Diode_SMD:D_SOD-123', 'USBC': 'Connector_USB:USB_C_Receptacle_HRO_TYPE-C-31-M-12',
 'SD': 'Connector_Card:microSD_HC_Hirose_DM3AT-SF-PEJM5', 'MCU': '',
 'IDC26': 'Connector_IDC:IDC-Header_2x13_P2.54mm_Latch12.0mm_Vertical',
 'IDC16': 'Connector_IDC:IDC-Header_2x08_P2.54mm_Latch6.5mm_Vertical',
 'FFC40': 'Connector_FFC-FPC:Hirose_FH12-40S-0.5SH_1x40-1MP_P0.50mm_Horizontal',
 'TB12': 'TerminalBlock_Phoenix:TerminalBlock_Phoenix_MKDS-1-12-3.81_1x12_P3.81mm_Horizontal',
 'TB4': 'TerminalBlock_Phoenix:TerminalBlock_Phoenix_MKDS-1-4-3.81_1x04_P3.81mm_Horizontal',
 'TB6': 'TerminalBlock_Phoenix:TerminalBlock_Phoenix_MKDS-1-6-3.81_1x06_P3.81mm_Horizontal',
 'HDR4': 'Connector_PinHeader_2.54mm:PinHeader_1x04_P2.54mm_Vertical',
 'HDR3': 'Connector_PinHeader_2.54mm:PinHeader_1x03_P2.54mm_Vertical',
 'BATT': 'Connector_JST:JST_XH_B2B-XH-A_1x02_P2.50mm_Vertical',
 'JACK': '', 'BARREL': '', 'BTN': '',
}

C = []
def add(ref, lib, val, nets, fp='', note='', sec='', unit=1, on_board=True):
    C.append(dict(ref=ref, lib=lib, val=val, nets=nets, fp=fp, note=note,
                  sec=sec, section=sec, unit=unit, on_board=on_board))

# ==========================================================================
# CORE-2 component table.  PRE-FREEZE / DO NOT FABRICATE.
# ==========================================================================
P, D, A, V, M, R, N = 'POWER', 'MCU', 'AUDIO', 'CV', 'MIDI', 'BUS', 'PANEL'

# ---------------------------- POWER ---------------------------------------
add('J1', ('Connector','USB_C_Receptacle_USB2.0_16P'), 'USB-C 16P (data+charge)',
    {'A1':'DGND','A4':'VBUS_CHG','A5':'CC1','A6':'USB_DP_C','A7':'USB_DM_C','A8':'NC',
     'A9':'VBUS_CHG','A12':'DGND','B1':'DGND','B4':'VBUS_CHG','B5':'CC2','B6':'USB_DP_C',
     'B7':'USB_DM_C','B8':'NC','B9':'VBUS_CHG','B12':'DGND','SH':'DGND'},
    FP['USBC'], 'USB 2.0 HS composite: HID+MIDI+UAC2+CDC (TinyUSB); rear wall', P)
add('U20', ('Power_Protection','USBLC6-2SC6'), 'USBLC6-2SC6',
    {'1':'USB_DP_C','2':'DGND','3':'USB_DM_C','4':'USB_HS_DM','5':'VBUS_CHG','6':'USB_HS_DP'},
    FP['SOT236'], 'ESD/клэмп USB HS пары', P)
add('R28', ('Device','R'), '5.1k', {'1':'CC1','2':'DGND'}, FP['R'], 'UFP CC1', P)
add('R29', ('Device','R'), '5.1k', {'1':'CC2','2':'DGND'}, FP['R'], 'UFP CC2', P)
add('D1', ('Diode','SMAJ5.0A'), 'SMAJ5.0A', {'1':'VBUS_CHG','2':'PGND'}, FP['DIODE'], 'TVS по VBUS', P)
add('F1', ('Device','Polyfuse'), '1.5A', {'1':'VBUS_CHG','2':'VBUS_F'}, FP['PF'], 'polyfuse USB', P)
add('C1', ('Device','C'), '10uF/10V', {'1':'VBUS_F','2':'PGND'}, FP['C'], '', P)
add('C2', ('Device','C'), '100nF/16V', {'1':'VBUS_F','2':'PGND'}, FP['C'], '', P)
add('U22', ('Battery_Management','BQ24074RGT'), 'BQ24074RGT',
    {'1':'NTC_PACK','2':'BATT_P','3':'BATT_P','4':'PGND','5':'VBUS_CHG','6':'VBUS_CHG',
     '7':'NC','8':'PGND','9':'CHG','10':'VSYS','11':'VSYS','12':'ILIM','13':'VBUS_F',
     '14':'TMR','15':'ITERM','16':'ISET','17':'PGND'},
    '', 'charger + power-path (1.5 A)', P)
add('R1', ('Device','R'), '1.5k', {'1':'ILIM','2':'PGND'}, FP['R'], 'ILIM 1.5 A', P)
add('R2', ('Device','R'), '1.5k', {'1':'ISET','2':'PGND'}, FP['R'], 'charge current ~1 A', P)
add('R3', ('Device','R'), '2k', {'1':'ITERM','2':'PGND'}, FP['R'], 'termination', P)
add('R4', ('Device','R'), '100k', {'1':'TMR','2':'PGND'}, FP['R'], 'safety timer', P)
add('R5', ('Device','R'), '10k', {'1':'VBUS_F','2':'TS'}, FP['R'], 'TS network', P)
add('TH1', ('Device','Thermistor_NTC'), 'NTC 10k', {'1':'TS','2':'PGND'}, FP['R'], 'battery NTC', P)
add('C3', ('Device','C'), '100nF', {'1':'NTC_PACK','2':'PGND'}, FP['C'], '', P)
add('R6', ('Device','R'), '1k', {'1':'VBUS_CHG','2':'CHG_LED'}, FP['R'], '', P)
add('D3', ('Device','LED'), 'CHG', {'1':'CHG','2':'CHG_LED'}, FP['C'], 'charge LED (open-collector CHG)', P)
add('C4', ('Device','C'), '10uF/10V', {'1':'VSYS','2':'PGND'}, FP['C'], '', P)
add('C5', ('Device','C'), '100nF', {'1':'VSYS','2':'PGND'}, FP['C'], '', P)
add('C6', ('Device','C'), '10uF/10V', {'1':'BATT_P','2':'PGND'}, FP['C'], '', P)
add('C7', ('Device','C'), '100nF', {'1':'BATT_P','2':'PGND'}, FP['C'], '', P)
add('J2', ('Connector_Generic','Conn_01x02'), 'BATTERY 1S2P', {'1':'BATT_P','2':'BATT_N'}, FP['BATT'], '18650 1S2P pack (protected, with NTC)', P)
add('U23', ('Battery_Management','BQ297xy'), 'BQ29700DSER', {'1':'NC','2':'G_BMS_C','3':'G_BMS_D','4':'BATT_N','5':'BQ_BAT','6':'PGND'}, FP['SOT236'], '1S BMS protector', P)
add('R7', ('Device','R'), '330', {'1':'BATT_P','2':'BQ_BAT'}, FP['R'], 'BMS supply filter', P)
add('C8', ('Device','C'), '100nF', {'1':'BQ_BAT','2':'BATT_N'}, FP['C'], '', P)
add('Q1', ('Transistor_FET','Q_NMOS_GDS'), 'AO3400A', {'1':'G_BMS_C','2':'BMS_MID','3':'BATT_N'}, FP['SOT23'], 'charge FET (BMS)', P)
add('Q2', ('Transistor_FET','Q_NMOS_GDS'), 'AO3400A', {'1':'G_BMS_D','2':'BMS_MID','3':'PGND'}, FP['SOT23'], 'discharge FET (BMS)', P)
# +12V boost
add('U24', ('Regulator_Switching','MT3608'), 'MT3608 (+12V)', {'1':'SW12','2':'PGND','3':'FB12','4':'EN12','5':'VSYS','6':'NC'}, FP['SOT236'], 'boost 12.1 V (bus + analog)', P)
add('L1', ('Device','L'), '22uH', {'1':'VSYS','2':'SW12'}, FP['L'], '', P)
add('D4', ('Diode','SS34'), 'SS34', {'1':'SW12','2':'12V'}, FP['DIODE'], '', P)
add('R10', ('Device','R'), '91k', {'1':'12V','2':'FB12'}, FP['R'], 'FB 12.1 V', P)
add('R11', ('Device','R'), '4.7k', {'1':'FB12','2':'PGND'}, FP['R'], '', P)
add('C9', ('Device','C'), '100pF', {'1':'12V','2':'FB12'}, FP['C'], 'feed-forward', P)
add('R12', ('Device','R'), '100k', {'1':'VSYS','2':'EN12'}, FP['R'], 'enable', P)
add('C10', ('Device','C'), '10uF/10V', {'1':'VSYS','2':'PGND'}, FP['C'], '', P)
add('C11', ('Device','C_Polarized'), '220uF/25V', {'1':'12V','2':'PGND'}, FP['CP'], '', P)
add('C12', ('Device','C'), '100nF/50V', {'1':'12V','2':'PGND'}, FP['C'], '', P)
# +5V boost
add('U25', ('Regulator_Switching','MT3608'), 'MT3608 (+5V)', {'1':'SW5','2':'PGND','3':'FB5','4':'EN5','5':'VSYS','6':'NC'}, FP['SOT236'], 'boost 5.1 V (LED/panel/audio)', P)
add('L2', ('Device','L'), '22uH', {'1':'VSYS','2':'SW5'}, FP['L'], '', P)
add('D5', ('Diode','SS34'), 'SS34', {'1':'SW5','2':'5V'}, FP['DIODE'], '', P)
add('R13', ('Device','R'), '75k', {'1':'5V','2':'FB5'}, FP['R'], 'FB 5.1 V', P)
add('R14', ('Device','R'), '10k', {'1':'FB5','2':'PGND'}, FP['R'], '', P)
add('C13', ('Device','C'), '100pF', {'1':'5V','2':'FB5'}, FP['C'], '', P)
add('R15', ('Device','R'), '100k', {'1':'VSYS','2':'EN5'}, FP['R'], 'enable', P)
add('C14', ('Device','C'), '10uF/10V', {'1':'VSYS','2':'PGND'}, FP['C'], '', P)
add('C15', ('Device','C_Polarized'), '220uF/10V', {'1':'5V','2':'PGND'}, FP['CP'], '', P)
add('C16', ('Device','C'), '100nF', {'1':'5V','2':'PGND'}, FP['C'], '', P)
# +3V3_MCU buck
add('U26', ('picomod','MP1584_MOD'), 'MP1584 3.3V/3A (MCU)', {'1':'5V','2':'PGND','3':'3V3_MCU_RAW','4':'PGND'}, '', 'buck 5V->3.3V for P4/PSRAM', P)
add('C17', ('Device','C'), '10uF/10V', {'1':'5V','2':'PGND'}, FP['C'], '', P)
add('C18', ('Device','C_Polarized'), '100uF/10V', {'1':'3V3_MCU_RAW','2':'PGND'}, FP['CP'], '', P)
add('C19', ('Device','C'), '100nF', {'1':'3V3_MCU_RAW','2':'PGND'}, FP['C'], '', P)
add('FB1', ('Device','FerriteBead'), '600R@100MHz', {'1':'3V3_MCU_RAW','2':'3V3_MCU'}, FP['FB'], '', P)
add('C20', ('Device','C'), '10uF/10V', {'1':'3V3_MCU','2':'DGND'}, FP['C'], '', P)
add('C21', ('Device','C'), '100nF', {'1':'3V3_MCU','2':'DGND'}, FP['C'], '', P)
add('C22', ('Device','C'), '100nF', {'1':'3V3_MCU','2':'DGND'}, FP['C'], '', P)
# +3V3 periph
add('U27', ('Regulator_Linear','AP2112K-3.3'), 'AP2112K-3.3', {'1':'5V','2':'DGND','3':'5V','4':'NC','5':'3V3'}, FP['SOT235'], 'LDO 3.3 V peripherals/analog', P)
add('C24', ('Device','C'), '1uF', {'1':'5V','2':'DGND'}, FP['C'], '', P)
add('C25', ('Device','C'), '1uF', {'1':'3V3','2':'DGND'}, FP['C'], '', P)
add('C26', ('Device','C'), '100nF', {'1':'3V3','2':'DGND'}, FP['C'], '', P)
# -12V inverter
add('U28', ('Regulator_Switching','MC34063AP'), 'MC34063', {'1':'MC_A','2':'MC_SW','3':'MC_TC','4':'-12V','5':'MC_FB','6':'12V','7':'MC_A','8':'MC_A'}, FP['DIP8'], 'inverting -12 V (bus/opamps)', P)
add('R16', ('Device','R'), '0.33', {'1':'12V','2':'MC_A'}, FP['R'], '', P)
add('C27', ('Device','C'), '1.5nF', {'1':'MC_TC','2':'-12V'}, FP['C'], '', P)
add('L3', ('Device','L'), '220uH', {'1':'MC_SW','2':'-12V'}, FP['L'], '', P)
add('D6', ('Diode','SS34'), 'SS34', {'1':'MC_SW','2':'PGND'}, FP['DIODE'], '', P)
add('R17', ('Device','R'), '33k', {'1':'PGND','2':'MC_FB'}, FP['R'], '', P)
add('R18', ('Device','R'), '3.9k', {'1':'MC_FB','2':'-12V'}, FP['R'], '', P)
add('C28', ('Device','C_Polarized'), '220uF/25V', {'1':'PGND','2':'-12V'}, FP['CP'], 'polarity + to PGND', P)
add('C29', ('Device','C'), '100nF/50V', {'1':'12V','2':'-12V'}, FP['C'], '', P)
add('C30', ('Device','C_Polarized'), '100uF/25V', {'1':'12V','2':'PGND'}, FP['CP'], '', P)
# BL +20V boost
add('U29', ('Regulator_Switching','MT3608'), 'MT3608 (+20V BL)', {'1':'SWBL','2':'PGND','3':'FBBL','4':'ENBL','5':'5V','6':'NC'}, FP['SOT236'], 'backlight boost 20 V (panel LED string)', P)
add('L4', ('Device','L'), '22uH', {'1':'5V','2':'SWBL'}, FP['L'], '', P)
add('D7', ('Diode','SS34'), 'SS34', {'1':'SWBL','2':'BL_20V'}, FP['DIODE'], '40 V Schottky', P)
add('R19', ('Device','R'), '100k', {'1':'5V','2':'ENBL'}, FP['R'], 'enable', P)
add('R20', ('Device','R'), '100k', {'1':'BL_20V','2':'FBBL'}, FP['R'], 'FB 20.4 V', P)
add('R21', ('Device','R'), '3.09k', {'1':'FBBL','2':'PGND'}, FP['R'], '', P)
add('C31', ('Device','C'), '100pF', {'1':'BL_20V','2':'FBBL'}, FP['C'], '', P)
add('C32', ('Device','C'), '10uF/10V', {'1':'5V','2':'PGND'}, FP['C'], '', P)
add('C33', ('Device','C'), '10uF/35V', {'1':'BL_20V','2':'PGND'}, FP['C'], '', P)
add('C34', ('Device','C'), '100nF/50V', {'1':'BL_20V','2':'PGND'}, FP['C'], '', P)
# +3V3_C6 LDO
add('U30', ('Regulator_Linear','AP2112K-3.3'), 'AP2112K-3.3 (C6)', {'1':'5V','2':'DGND','3':'5V','4':'NC','5':'3V3_C6'}, FP['SOT235'], 'dedicated LDO for Wi-Fi/BLE coprocessor', P)
add('C35', ('Device','C'), '1uF', {'1':'5V','2':'DGND'}, FP['C'], '', P)
add('C36', ('Device','C'), '22uF/10V', {'1':'3V3_C6','2':'DGND'}, FP['C'], '', P)
add('C37', ('Device','C'), '100nF', {'1':'3V3_C6','2':'DGND'}, FP['C'], '', P)
# filtered rails / external 12 V
add('D2', ('Diode','SS34'), 'SS34', {'1':'12V_EXT','2':'12V'}, FP['DIODE'], 'diode-OR external 12 V (PWR-2)', P)
add('C110', ('Device','C_Polarized'), '100uF/25V', {'1':'12V_EXT','2':'PGND'}, FP['CP'], '', P)
add('C111', ('Device','C'), '100nF/50V', {'1':'12V_EXT','2':'PGND'}, FP['C'], '', P)
add('FB2', ('Device','FerriteBead'), '600R@100MHz', {'1':'12V','2':'12V_B'}, FP['FB'], 'bus +12V', P)
add('C38', ('Device','C_Polarized'), '100uF/25V', {'1':'12V_B','2':'PGND'}, FP['CP'], '', P)
add('FB3', ('Device','FerriteBead'), '600R@100MHz', {'1':'-12V','2':'-12V_B'}, FP['FB'], 'bus -12V', P)
add('C39', ('Device','C_Polarized'), '220uF/25V', {'1':'PGND','2':'-12V_B'}, FP['CP'], 'polarity + to PGND', P)
add('FB4', ('Device','FerriteBead'), '600R@100MHz', {'1':'5V','2':'5V_PANEL'}, FP['FB'], 'panel +5V', P)
add('C40', ('Device','C_Polarized'), '100uF/10V', {'1':'5V_PANEL','2':'PGND'}, FP['CP'], '', P)
add('FB5', ('Device','FerriteBead'), '600R@100MHz', {'1':'3V3','2':'3V3_PANEL'}, FP['FB'], 'panel +3V3', P)
add('C41', ('Device','C'), '10uF/10V', {'1':'3V3_PANEL','2':'DGND'}, FP['C'], '', P)
add('NT1', ('Device','NetTie_2'), 'AGND=DGND', {'1':'AGND','2':'DGND'}, 'NetTie:NetTie-2_SMD_Pad0.5mm', 'single-point analog/digital ground', P)
add('NT2', ('Device','NetTie_2'), 'DGND=PGND', {'1':'DGND','2':'PGND'}, 'NetTie:NetTie-2_SMD_Pad0.5mm', 'single-point digital/power ground', P)

# ---------------------------- MCU / USB / C6 / SD -------------------------
def mcu_module_nets():
    nets = {}
    for r in B.PINMAP:
        sig = r[0]
        net = {'GND':'DGND', '3V3_MCU':'3V3_MCU', 'CHIP_PU':'CHIP_PU',
               'USB_HS_DP':'USB_HS_DP', 'USB_HS_DM':'USB_HS_DM'}.get(sig, sig)
        nets[str(r[7])] = net
    return nets
add('A1', ('picomod','ESP32-P4_MOD'), 'ESP32-P4NRW32 + 32MB PSRAM (module TBD)', mcu_module_nets(), FP['MCU'], 'PRE-FREEZE: 2x32 logical module slot; adapter/physical module TBD after P1 benchmark', M)
for i, ref in enumerate(['C42','C43','C44','C45','C46','C47']):
    add(ref, ('Device','C'), '100nF', {'1':'3V3_MCU','2':'DGND'}, FP['C'], 'P4 decoupling', M)
add('C48', ('Device','C'), '10uF/10V', {'1':'3V3_MCU','2':'DGND'}, FP['C'], '', M)
add('C49', ('Device','C'), '10uF/10V', {'1':'3V3_MCU','2':'DGND'}, FP['C'], '', M)
add('SW1', ('Switch','SW_Push'), 'BOOT', {'1':'BOOT','2':'DGND'}, FP['BTN'], 'boot strap GPIO35 (download boot)', M)
add('R22', ('Device','R'), '10k', {'1':'3V3_MCU','2':'BOOT'}, FP['R'], 'BOOT pull-up', M)
add('SW2', ('Switch','SW_Push'), 'RESET', {'1':'CHIP_PU','2':'DGND'}, FP['BTN'], 'reset', M)
add('R23', ('Device','R'), '10k', {'1':'3V3_MCU','2':'CHIP_PU'}, FP['R'], 'CHIP_PU pull-up', M)
add('C51', ('Device','C'), '100nF', {'1':'CHIP_PU','2':'DGND'}, FP['C'], 'reset RC', M)
add('R24', ('Device','R'), '10k', {'1':'STRAP36','2':'3V3_MCU'}, FP['R'], 'GPIO36 strap PU (joint download boot reachable)', M)
add('R91', ('Device','R'), '10k', {'1':'3V3','2':'PANEL_IRQ'}, FP['R'], 'PANEL_IRQ pull-up (4x MCP23017 INTA wire-OR on PANEL-2)', M)
add('J4', ('Connector_Generic','Conn_01x03'), 'UART0 TP', {'1':'DGND','2':'UART0_TX','3':'UART0_RX'}, FP['HDR3'], 'UART0 testpoints/boot log', M)
add('U31', ('picomod','ESP32-C6-MINI-1'), 'ESP32-C6-MINI-1 (Wi-Fi6/BLE5.3)',
    {'1':'3V3_C6','2':'DGND','3':'C6_RST','4':'SPI2_SCK','5':'SPI2_MOSI','6':'SPI2_MISO',
     '7':'C6_CS','8':'C6_HS','9':'C6_DR','10':'DGND'}, '',
    'Wi-Fi/BLE coprocessor; DNP if ESP32-S3 build; antenna keep-out >=15 mm', M)
add('R27', ('Device','R'), '10k', {'1':'3V3_C6','2':'C6_RST'}, FP['R'], 'C6 EN pull-up', M)
add('C53', ('Device','C'), '22uF/10V', {'1':'3V3_C6','2':'DGND'}, FP['C'], '', M)
add('C54', ('Device','C'), '100nF', {'1':'3V3_C6','2':'DGND'}, FP['C'], '', M)
add('C55', ('Device','C'), '100nF', {'1':'3V3_C6','2':'DGND'}, FP['C'], '', M)
# microSD
add('J5', ('Connector','Micro_SD_Card_Det1'), 'microSD (SDIO 1-bit)',
    {'1':'NC','2':'NC','3':'SD_CMD','4':'3V3','5':'SD_CLK','6':'DGND',
     '7':'SD_D0','8':'NC','9':'SD_CD','SH':'DGND'}, FP['SD'], 'SDMMC slot0, 1-bit (D1-D3 -> mic I2S1)', M)
for i, (net) in enumerate(['SD_CMD', 'SD_D0']):
    add('R%d' % (30+i), ('Device','R'), '10k', {'1':'3V3','2':net}, FP['R'], 'SDIO pull-up (1-bit)', M)
add('R35', ('Device','R'), '10k', {'1':'3V3','2':'SD_CD'}, FP['R'], 'card detect pull-up', M)
add('C56', ('Device','C'), '100nF', {'1':'3V3','2':'DGND'}, FP['C'], '', M)
add('C57', ('Device','C'), '10uF/10V', {'1':'3V3','2':'DGND'}, FP['C'], '', M)

# ---------------------------- AUDIO ---------------------------------------
add('U32', ('Audio','PCM5102A'), 'PCM5102A',
    {'1':'3V3','2':'CP_P','3':'AGND','4':'CP_M','5':'VNEG','6':'DAC_L','7':'DAC_R',
     '8':'3V3','9':'AGND','10':'DGND','11':'DGND','12':'I2S_MCLK','13':'I2S_BCK',
     '14':'I2S_DAC_DIN','15':'I2S_LRCK','16':'DGND','17':'XSMT','18':'LDOO',
     '19':'DGND','20':'3V3'}, FP['TSSOP20'], 'I2S DAC 112 dB (24/96)', A)
add('C58', ('Device','C'), '1uF/10V', {'1':'CP_P','2':'CP_M'}, FP['C'], 'charge-pump flying cap', A)
add('C59', ('Device','C_Polarized'), '1uF/10V', {'1':'AGND','2':'VNEG'}, FP['CP'], 'polarity + to AGND', A)
add('C60', ('Device','C'), '100nF', {'1':'LDOO','2':'AGND'}, FP['C'], '', A)
add('C61', ('Device','C'), '100nF', {'1':'3V3','2':'AGND'}, FP['C'], '', A)
add('C62', ('Device','C'), '100nF', {'1':'3V3','2':'DGND'}, FP['C'], '', A)
add('C63', ('Device','C'), '10uF/10V', {'1':'3V3','2':'AGND'}, FP['C'], '', A)
add('C64', ('Device','C'), '100nF', {'1':'3V3','2':'AGND'}, FP['C'], '', A)
add('R36', ('Device','R'), '10k', {'1':'3V3','2':'XSMT'}, FP['R'], 'unmute', A)
add('C65', ('Device','C'), '100nF', {'1':'XSMT','2':'AGND'}, FP['C'], 'mute RC: XSMT low at power-up', A)
add('C66', ('Device','C_Polarized'), '10uF/16V', {'1':'DAC_L','2':'AUD_L_IN'}, FP['CP'], 'AC coupling L', A)
add('C67', ('Device','C_Polarized'), '10uF/16V', {'1':'DAC_R','2':'AUD_R_IN'}, FP['CP'], 'AC coupling R', A)
add('R37', ('Device','R'), '100k', {'1':'AUD_L_IN','2':'AGND'}, FP['R'], 'bias/DC path', A)
add('R38', ('Device','R'), '100k', {'1':'AUD_R_IN','2':'AGND'}, FP['R'], '', A)
add('U33', ('Amplifier_Operational','TL072'), 'TL072', {'1':'AUDL_BUF','2':'AUDL_BUF','3':'AUD_L_IN'}, FP['DIP8'], 'LINE/PHONES buffer L', A, unit=1)
add('U33', ('Amplifier_Operational','TL072'), 'TL072', {'7':'AUDR_BUF','6':'AUDR_BUF','5':'AUD_R_IN'}, FP['DIP8'], 'LINE/PHONES buffer R', A, unit=2)
add('U33', ('Amplifier_Operational','TL072'), 'TL072', {'8':'12V','4':'-12V'}, FP['DIP8'], 'power', A, unit=3)
add('C68', ('Device','C'), '100nF', {'1':'12V','2':'AGND'}, FP['C'], '', A)
add('C69', ('Device','C'), '100nF', {'1':'-12V','2':'AGND'}, FP['C'], '', A)
add('R39', ('Device','R'), '100', {'1':'AUDL_BUF','2':'AUDOUT_L'}, FP['R'], 'LINE OUT L (rear)', A)
add('R40', ('Device','R'), '100', {'1':'AUDR_BUF','2':'AUDOUT_R'}, FP['R'], 'LINE OUT R (rear)', A)
add('R41', ('Device','R'), '100', {'1':'AUDL_BUF','2':'PHONES_L'}, FP['R'], 'PHONES L', A)
add('R42', ('Device','R'), '100', {'1':'AUDR_BUF','2':'PHONES_R'}, FP['R'], 'PHONES R', A)
add('C70', ('Device','C'), '100pF', {'1':'AUDOUT_L','2':'AGND'}, FP['C'], '', A)
add('C71', ('Device','C'), '100pF', {'1':'AUDOUT_R','2':'AGND'}, FP['C'], '', A)
# PCM1808 ADC
add('U34', ('picomod','PCM1808'), 'PCM1808PWR',
    {'1':'VREF_ADC','2':'AGND','3':'5V','4':'3V3','5':'DGND','6':'I2S_MCLK','7':'I2S_LRCK',
     '8':'I2S_BCK','9':'I2S_ADC_DOUT','10':'DGND','11':'DGND','12':'DGND',
     '13':'AUDIN_L_C','14':'AUDIN_R_C'}, FP['TSSOP14'], 'I2S ADC 24/96 (sampler/effector input)', A)
add('C72', ('Device','C_Polarized'), '10uF/10V', {'1':'VREF_ADC','2':'AGND'}, FP['CP'], '', A)
add('C73', ('Device','C'), '100nF', {'1':'VREF_ADC','2':'AGND'}, FP['C'], '', A)
add('C74', ('Device','C_Polarized'), '10uF/10V', {'1':'5V','2':'AGND'}, FP['CP'], 'VCC 5 V analog', A)
add('C75', ('Device','C'), '100nF', {'1':'5V','2':'AGND'}, FP['C'], '', A)
add('C76', ('Device','C'), '100nF', {'1':'3V3','2':'DGND'}, FP['C'], 'VDD 3.3 V digital', A)
add('R43', ('Device','R'), '1k', {'1':'AUDIN_L','2':'AUDIN_L_F'}, FP['R'], 'input protection', A)
add('D8', ('Diode','BAT54S'), 'BAT54S', {'1':'AGND','2':'5V','3':'AUDIN_L_F'}, FP['BAT54S'], 'clamp', A)
add('C77', ('Device','C'), '100pF', {'1':'AUDIN_L_F','2':'AGND'}, FP['C'], '', A)
add('C78', ('Device','C'), '1uF/16V', {'1':'SW_L_COM','2':'AUDIN_L_C'}, FP['C'], 'AC coupling to VINL (after line/mic switch)', A)
add('R44', ('Device','R'), '1k', {'1':'AUDIN_R','2':'AUDIN_R_F'}, FP['R'], '', A)
add('D9', ('Diode','BAT54S'), 'BAT54S', {'1':'AGND','2':'5V','3':'AUDIN_R_F'}, FP['BAT54S'], '', A)
add('C79', ('Device','C'), '100pF', {'1':'AUDIN_R_F','2':'AGND'}, FP['C'], '', A)
add('C80', ('Device','C'), '1uF/16V', {'1':'SW_R_COM','2':'AUDIN_R_C'}, FP['C'], 'AC coupling to VINR (after switch)', A)


# ---------------------------- MIC INPUT (D-91) ----------------------------
add('J19', ('Connector_Generic','Conn_02x03_Odd_Even'), 'PANEL-2 MEMS mic (IDC-6)',
    {'1':'MIC_BCK','2':'DGND','3':'MIC_WS','4':'DGND','5':'MIC_DATA','6':'3V3_MIC'},
    'Connector_IDC:IDC-Header_2x03_P2.54mm_Vertical',
    'rev.3: MEMS I2S1 canon 1=BCK 2=GND 3=WS 4=GND 5=DATA 6=3V3 (mates PANEL-2 J16, 1:1); shielded, ESD', A)
add('FB8', ('Device','FerriteBead'), '600R@100MHz', {'1':'3V3','2':'3V3_MIC'}, FP['FB'], 'mic 3.3 V filter', A)
add('C128', ('Device','C_Polarized'), '10uF/10V', {'1':'3V3_MIC','2':'AGND'}, FP['CP'], '', A)
add('C129', ('Device','C'), '100nF', {'1':'3V3_MIC','2':'AGND'}, FP['C'], '', A)
add('U48', ('Power_Protection','USBLC6-2SC6'), 'USBLC6-2SC6',
    {'1':'MIC_BCK','2':'DGND','3':'MIC_WS','4':'MIC_WS','5':'3V3','6':'MIC_BCK'},
    FP['SOT236'], 'ESD mic I2S BCK/WS', A)
add('U49', ('Power_Protection','USBLC6-2SC6'), 'USBLC6-2SC6',
    {'1':'MIC_DATA','2':'DGND','3':'NC','4':'NC','5':'3V3','6':'MIC_DATA'},
    FP['SOT236'], 'ESD mic I2S DATA', A)
add('J20', ('Connector_Audio','AudioJack3'), 'MIC IN 3.5mm TRS (electret)',
    {'T':'MIC_IN','R':'MIC_BIAS','S':'AGND'}, '', 'rear panel mic/headset jack; tip=signal, ring=bias', N, on_board=False)
add('D30', ('Diode','SMAJ5.0A'), 'SMAJ5.0A', {'1':'MIC_IN','2':'AGND'}, FP['DIODE'], 'ESD/защита mic jack', A)
add('R106', ('Device','R'), '2.2k', {'1':'MICBIAS_N','2':'MIC_BIAS'}, FP['R'], 'electret bias (2.2k)', A)
add('C127', ('Device','C'), '100nF', {'1':'MIC_IN','2':'MICIN_A'}, FP['C'], 'AC coupling to MAX9814', A)
add('C122', ('Device','C'), '1uF/10V', {'1':'MICBIAS_N','2':'AGND'}, FP['C'], 'mic bias decoupling', A)
add('U46', ('picomod','MAX9814'), 'MAX9814 (AGC mic amp)',
    {'1':'CT','2':'SHDN','3':'CG','4':'AGND','5':'3V3_MIC','6':'MIC_AGC',
     '7':'AGND','8':'MICIN_A','9':'AGND','10':'AGND','11':'AGND','12':'BIAS',
     '13':'MICBIAS_N','14':'TH','15':'AGND'}, 'Package_DFN_QFN:TDFN-14-1EP_3x3mm_P0.4mm_EP1.78x2.35mm',
    'AGC mic preamp (D-91); pinout verified vs datasheet 2026-11-06 (TH/EP fixed)', A)
add('C125', ('Device','C'), '470nF', {'1':'CT','2':'AGND'}, FP['C'], 'AGC attack/release (CT, datasheet typical)', A)
add('C124', ('Device','C'), '2.2uF/10V', {'1':'CG','2':'AGND'}, FP['C'], 'DC offset adjust (CG)', A)
add('C123', ('Device','C'), '470nF', {'1':'BIAS','2':'AGND'}, FP['C'], 'bias decoupling', A)
add('R113', ('Device','R'), '100k', {'1':'3V3_MIC','2':'SHDN'}, FP['R'], 'SHDN pull-up (mic on)', A)
add('SW3', ('Switch','SW_SPST'), 'MIC MUTE', {'1':'SHDN','2':'AGND'}, FP['BTN'], 'аппаратный mute: SHDN->GND (D-92)', A)
add('Q5', ('Transistor_FET','Q_NMOS_GDS'), '2N7000', {'1':'SHDN','2':'MIC_LED_K','3':'AGND'}, FP['TO92'], 'MIC ON LED driver', A)
add('R114', ('Device','R'), '1k', {'1':'3V3_MIC','2':'MIC_LED_A'}, FP['R'], '', A)
add('D31', ('Device','LED'), 'MIC ON', {'1':'MIC_LED_K','2':'MIC_LED_A'}, FP['C'], 'LED «MIC ON» (D-92)', A)
add('C126', ('Device','C'), '1uF/16V', {'1':'MIC_AGC','2':'SW_MIC'}, FP['C'], 'MAX9814 out -> switch', A)
add('U47', ('picomod','TS5A23157'), 'TS5A23157 (line/mic switch)',
    {'1':'MIC_SEL','2':'SW_MIC','3':'AGND','4':'SW_MIC','5':'MIC_SEL',
     '6':'SW_R_COM','7':'AUDIN_R_F','8':'3V3','9':'AUDIN_L_F','10':'SW_L_COM'},
    'Package_SO:MSOP-10-1EP_3x3mm_P0.5mm_EP1.68x1.88mm', 'analog switch line(AUDIO IN)/mic, control MIC_SEL (footprint verify vs DGS)', A)
add('R107', ('Device','R'), '150k', {'1':'MICBIAS_N','2':'TH'}, FP['R'], 'AGC threshold divider top (V_TH = MCBIAS*0.4)', A)
add('R108', ('Device','R'), '100k', {'1':'TH','2':'AGND'}, FP['R'], 'AGC threshold divider bottom', A)
add('R110', ('Device','R'), '100k', {'1':'MIC_SEL','2':'AGND'}, FP['R'], 'MIC_SEL pull-down = LINE by default', A)

# ---------------------------- CV ------------------------------------------
add('U35', ('Analog_DAC','MCP4728'), 'MCP4728A0-E/UN (0x60)',
    {'1':'3V3','2':'I2C0_SCL','3':'I2C0_SDA','4':'DGND','5':'NC','6':'DAC_A','7':'DAC_B',
     '8':'DAC_C','9':'DAC_D','10':'AGND'}, FP['MSOP10'], 'CV1..CV4 (bus), I2C 0x60', V)
add('C81', ('Device','C'), '100nF', {'1':'3V3','2':'AGND'}, FP['C'], '', V)
add('C82', ('Device','C'), '10uF/10V', {'1':'3V3','2':'AGND'}, FP['C'], '', V)
add('U36', ('Analog_DAC','MCP4728'), 'MCP4728A1-E/UN (0x61)',
    {'1':'3V3','2':'I2C0_SCL','3':'I2C0_SDA','4':'DGND','5':'NC','6':'DAC_E','7':'DAC_F',
     '8':'NC','9':'NC','10':'AGND'}, FP['MSOP10'], 'CV5/CV6 (panel jacks), I2C 0x61', V)
add('C83', ('Device','C'), '100nF', {'1':'3V3','2':'AGND'}, FP['C'], '', V)
add('C84', ('Device','C'), '10uF/10V', {'1':'3V3','2':'AGND'}, FP['C'], '', V)
# TL074 #1: CV1..CV4 buffers (units 1..4) + power
for i in range(4):
    net_out = 'CVR%d' % i; net_sum = 'CVS%d' % i
    dac = 'DAC_' + 'ABCD'[i]
    nets = {'1':'CVR0','2':'CVS0','3':'DAC_A'} if i == 0 else {}
    add('U35' if False else 'U37', ('Amplifier_Operational','TL074'), 'TL074',
        {'%d' % (1 + i*0): ''}, FP['DIP14'], 'CV%d x4.9 buffer' % (i+1), V, unit=i+1)
# fix nets of the four U37 units
for i, nets in enumerate([
        {'1':'CVR0','2':'CVS0','3':'DAC_A'},
        {'7':'CVR1','6':'CVS1','5':'DAC_B'},
        {'8':'CVR2','9':'CVS2','10':'DAC_C'},
        {'14':'CVR3','13':'CVS3','12':'DAC_D'}]):
    C[-4+i]['nets'] = nets
C[-4]['note'] = 'CV1 x4.9 buffer'; C[-3]['note'] = 'CV2 x4.9 buffer'
C[-2]['note'] = 'CV3 x4.9 buffer'; C[-1]['note'] = 'CV4 x4.9 buffer'
add('U37', ('Amplifier_Operational','TL074'), 'TL074', {'4':'12V','11':'-12V'}, FP['DIP14'], 'power', V, unit=5)
for i in range(4):
    add('R%d' % (45+i), ('Device','R'), '39k', {'1':'CVS%d'%i,'2':'CVR%d'%i}, FP['R'], 'Rf CV%d' % (i+1), V)
    add('R%d' % (51+i), ('Device','R'), '10k', {'1':'CVS%d'%i,'2':'AGND'}, FP['R'], 'Rg CV%d' % (i+1), V)
    add('R%d' % (57+i), ('Device','R'), '1k', {'1':'CVR%d'%i,'2':'CVOUT%d'%(i+1)}, FP['R'], 'output CV%d' % (i+1), V)
    add('D%d' % (10+i), ('Diode','BAT54S'), 'BAT54S', {'1':'AGND','2':'12V','3':'CVOUT%d'%(i+1)}, FP['BAT54S'], 'CV%d protection' % (i+1), V)
# TL074 #2: CV5/CV6 buffers + 2 spare + power
add('U38', ('Amplifier_Operational','TL074'), 'TL074', {'1':'CVR4','2':'CVS4','3':'DAC_E'}, FP['DIP14'], 'CV5 x4.9 buffer', V, unit=1)
add('U38', ('Amplifier_Operational','TL074'), 'TL074', {'7':'CVR5','6':'CVS5','5':'DAC_F'}, FP['DIP14'], 'CV6 x4.9 buffer', V, unit=2)
add('U38', ('Amplifier_Operational','TL074'), 'TL074', {'8':'SPARE_C','9':'SPARE_C','10':'AGND'}, FP['DIP14'], 'spare (grounded)', V, unit=3)
add('U38', ('Amplifier_Operational','TL074'), 'TL074', {'14':'SPARE_D','13':'SPARE_D','12':'AGND'}, FP['DIP14'], 'spare (grounded)', V, unit=4)
add('U38', ('Amplifier_Operational','TL074'), 'TL074', {'4':'12V','11':'-12V'}, FP['DIP14'], 'power', V, unit=5)
for i, ch in enumerate([4, 5]):
    add('R%d' % (49+i), ('Device','R'), '39k', {'1':'CVS%d'%ch,'2':'CVR%d'%ch}, FP['R'], 'Rf CV%d' % (ch+1), V)
    add('R%d' % (55+i), ('Device','R'), '10k', {'1':'CVS%d'%ch,'2':'AGND'}, FP['R'], 'Rg CV%d' % (ch+1), V)
    add('R%d' % (61+i), ('Device','R'), '1k', {'1':'CVR%d'%ch,'2':'CVOUT%d'%(ch+1)}, FP['R'], 'output CV%d (panel)' % (ch+1), V)
    add('D%d' % (14+i), ('Diode','BAT54S'), 'BAT54S', {'1':'AGND','2':'12V','3':'CVOUT%d'%(ch+1)}, FP['BAT54S'], 'CV%d protection' % (ch+1), V)
add('C85', ('Device','C'), '100nF', {'1':'12V','2':'AGND'}, FP['C'], '', V)
add('C86', ('Device','C'), '100nF', {'1':'-12V','2':'AGND'}, FP['C'], '', V)
add('C87', ('Device','C'), '100nF', {'1':'12V','2':'AGND'}, FP['C'], '', V)
add('C88', ('Device','C'), '100nF', {'1':'-12V','2':'AGND'}, FP['C'], '', V)
# TL074 #3: CV IN level shift (2 ch + 1.65 V ref + spare)
add('U39', ('Amplifier_Operational','TL074'), 'TL074', {'1':'CVIN1_RAW','2':'CVIN1_N','3':'CVREF_B'}, FP['DIP14'], 'CV IN1 level shift', V, unit=1)
add('U39', ('Amplifier_Operational','TL074'), 'TL074', {'7':'CVIN2_RAW','6':'CVIN2_N','5':'CVREF_B'}, FP['DIP14'], 'CV IN2 level shift', V, unit=2)
add('U39', ('Amplifier_Operational','TL074'), 'TL074', {'8':'CVREF_B','9':'CVREF_B','10':'CVREF'}, FP['DIP14'], '1.65 V reference buffer', V, unit=3)
add('U39', ('Amplifier_Operational','TL074'), 'TL074', {'14':'SPARE_E','13':'SPARE_E','12':'AGND'}, FP['DIP14'], 'spare (grounded)', V, unit=4)
add('U39', ('Amplifier_Operational','TL074'), 'TL074', {'4':'12V','11':'-12V'}, FP['DIP14'], 'power', V, unit=5)
add('R63', ('Device','R'), '100k', {'1':'CVIN1','2':'CVIN1_N'}, FP['R'], '', V)
add('R64', ('Device','R'), '16.5k', {'1':'CVIN1_N','2':'CVIN1_RAW'}, FP['R'], 'gain 0.165', V)
add('R65', ('Device','R'), '100k', {'1':'CVIN2','2':'CVIN2_N'}, FP['R'], '', V)
add('R66', ('Device','R'), '16.5k', {'1':'CVIN2_N','2':'CVIN2_RAW'}, FP['R'], 'gain 0.165', V)
add('R67', ('Device','R'), '1k', {'1':'CVIN1_RAW','2':'CVIN1_ADC'}, FP['R'], '', V)
add('R68', ('Device','R'), '1k', {'1':'CVIN2_RAW','2':'CVIN2_ADC'}, FP['R'], '', V)
add('C89', ('Device','C'), '100nF', {'1':'CVIN1_ADC','2':'AGND'}, FP['C'], '', V)
add('C90', ('Device','C'), '100nF', {'1':'CVIN2_ADC','2':'AGND'}, FP['C'], '', V)
add('D16', ('Diode','BAT54S'), 'BAT54S', {'1':'AGND','2':'3V3','3':'CVIN1_ADC'}, FP['BAT54S'], '', V)
add('D17', ('Diode','BAT54S'), 'BAT54S', {'1':'AGND','2':'3V3','3':'CVIN2_ADC'}, FP['BAT54S'], '', V)
add('R69', ('Device','R'), '47k', {'1':'3V3','2':'CVREF'}, FP['R'], '1.65 V', V)
add('R70', ('Device','R'), '47k', {'1':'CVREF','2':'AGND'}, FP['R'], '', V)
add('C91', ('Device','C'), '100nF', {'1':'CVREF','2':'AGND'}, FP['C'], '', V)
add('C92', ('Device','C'), '100nF', {'1':'12V','2':'AGND'}, FP['C'], '', V)
add('C93', ('Device','C'), '100nF', {'1':'-12V','2':'AGND'}, FP['C'], '', V)
# MCP3208 ADC + input chains
add('U40', ('Analog_ADC','MCP3208'), 'MCP3208',
    {'1':'CVIN1_ADC','2':'CVIN2_ADC','3':'FADER1_ADC','4':'FADER2_ADC','5':'CVIN3_ADC',
     '6':'CVIN4_ADC','7':'BATT_MON','8':'TEMP_MON','9':'DGND','10':'MCP3208_CS',
     '11':'SPI2_MOSI','12':'SPI2_MISO','13':'SPI2_SCK','14':'AGND','15':'VREF33','16':'3V3'},
    FP['DIP16'], '8-ch 12-bit SPI ADC', V)
add('FB6', ('Device','FerriteBead'), '600R@100MHz', {'1':'3V3','2':'VREF33'}, FP['FB'], 'ADC reference filter', V)
add('C94', ('Device','C'), '10uF/10V', {'1':'VREF33','2':'AGND'}, FP['C'], '', V)
add('C95', ('Device','C'), '100nF', {'1':'VREF33','2':'AGND'}, FP['C'], '', V)
add('C96', ('Device','C'), '100nF', {'1':'3V3','2':'AGND'}, FP['C'], '', V)
add('R71', ('Device','R'), '1k', {'1':'FADER1','2':'FADER1_ADC'}, FP['R'], '', V)
add('C97', ('Device','C'), '100nF', {'1':'FADER1_ADC','2':'AGND'}, FP['C'], '', V)
add('R72', ('Device','R'), '1k', {'1':'FADER2','2':'FADER2_ADC'}, FP['R'], '', V)
add('C98', ('Device','C'), '100nF', {'1':'FADER2_ADC','2':'AGND'}, FP['C'], '', V)
add('R73', ('Device','R'), '1k', {'1':'EXPR','2':'EXPR_ADC'}, FP['R'], 'expression pedal', V)
add('C99', ('Device','C'), '100nF', {'1':'EXPR_ADC','2':'AGND'}, FP['C'], '', V)
add('R74', ('Device','R'), '1k', {'1':'SPARE_ADC','2':'AGND'}, FP['R'], 'reserved channel to AGND', V)
add('C100', ('Device','C'), '100nF', {'1':'SPARE_ADC','2':'AGND'}, FP['C'], '', V)
add('R75', ('Device','R'), '100k', {'1':'BATT_MON_RAW','2':'BATT_MON'}, FP['R'], 'battery divider (raw VBAT from PWR-2 J18.1)', V)
add('R76', ('Device','R'), '47k', {'1':'BATT_MON','2':'AGND'}, FP['R'], '', V)
add('C101', ('Device','C'), '100nF', {'1':'BATT_MON','2':'AGND'}, FP['C'], '', V)
add('TH2', ('Device','Thermistor_NTC'), 'NTC 10k', {'1':'3V3','2':'TEMP_MON'}, FP['R'], 'pack temperature', V)
add('R77', ('Device','R'), '10k', {'1':'TEMP_MON','2':'AGND'}, FP['R'], '', V)
add('C102', ('Device','C'), '100nF', {'1':'TEMP_MON','2':'AGND'}, FP['C'], '', V)
add('R78', ('Device','R'), '2.2k', {'1':'3V3','2':'I2C0_SDA'}, FP['R'], 'I2C pull-up', V)
add('R79', ('Device','R'), '2.2k', {'1':'3V3','2':'I2C0_SCL'}, FP['R'], 'I2C pull-up', V)
add('U41', ('Memory_EEPROM','24LC32'), '24LC32A', {'1':'3V3','2':'3V3','3':'3V3','4':'DGND',
    '5':'I2C0_SDA','6':'I2C0_SCL','7':'DGND','8':'3V3'}, FP['DIP8'], 'calibration EEPROM 0x57 (A2..A0=1)', V)
add('C103', ('Device','C'), '100nF', {'1':'3V3','2':'DGND'}, FP['C'], '', V)

# ---------------------------- MIDI ----------------------------------------
add('U42', ('Isolator','6N137'), '6N137', {'1':'NC','2':'MIDI_A','3':'MIDI_IN_T','4':'NC',
    '5':'DGND','6':'MIDI_RX','7':'5V','8':'5V'}, FP['DIP8'], 'MIDI IN optocoupler', M)
add('R80', ('Device','R'), '220', {'1':'MIDI_IN_R','2':'MIDI_A'}, FP['R'], '', M)
add('R81', ('Device','R'), '4.7k', {'1':'3V3','2':'MIDI_RX'}, FP['R'], '6N137 pull-up', M)
add('U43', ('picomod','74HCT125'), '74HCT125', {'1':'DGND','2':'MIDI_TX','3':'MIDI_DRV',
    '4':'5V','5':'DGND','6':'NC','7':'DGND','8':'NC','9':'DGND','10':'5V','11':'NC',
    '12':'DGND','13':'5V','14':'5V'}, FP['SOIC14'], 'MIDI OUT buffer (5 V)', M)
add('R82', ('Device','R'), '33', {'1':'MIDI_DRV','2':'MIDI_OUT_T'}, FP['R'], '', M)
add('R83', ('Device','R'), '220', {'1':'5V','2':'MIDI_OUT_R'}, FP['R'], '', M)

# ---------------------------- GATE / LED level shifter ---------------------
add('Q3', ('Transistor_FET','2N7000'), '2N7000', {'1':'DGND','2':'G1','3':'GATE1'}, FP['TO92'], 'GATE1 open-drain', M)
add('R84', ('Device','R'), '1k', {'1':'GATE1_GPIO','2':'G1'}, FP['R'], '', M)
add('R85', ('Device','R'), '100k', {'1':'G1','2':'DGND'}, FP['R'], 'gate pull-down', M)
add('R86', ('Device','R'), '4.7k', {'1':'5V','2':'GATE1'}, FP['R'], 'GATE1 pull-up', M)
add('Q4', ('Transistor_FET','2N7000'), '2N7000', {'1':'DGND','2':'G2','3':'GATE2'}, FP['TO92'], 'GATE2 open-drain', M)
add('R87', ('Device','R'), '1k', {'1':'GATE2_GPIO','2':'G2'}, FP['R'], '', M)
add('R88', ('Device','R'), '100k', {'1':'G2','2':'DGND'}, FP['R'], 'gate pull-down', M)
add('R89', ('Device','R'), '4.7k', {'1':'5V','2':'GATE2'}, FP['R'], 'GATE2 pull-up', M)
add('U44', ('picomod','74HCT1G125'), '74HCT1G125', {'1':'DGND','2':'LED_GPIO','3':'DGND',
    '4':'LED_5V','5':'5V'}, FP['SOT353'], 'WS2812 level shifter 3.3->5 V', M)
add('R90', ('Device','R'), '330', {'1':'LED_5V','2':'LED_DATA'}, FP['R'], 'series resistor', M)

# ---------------------------- MODULE BUS (2 x IDC-26) ----------------------
for p in range(2):
    Pn = p + 1
    nets = {'1': '12V_P%d' % Pn, '2': 'PGND', '3': 'N12V_P%d' % Pn, '4': 'PGND',
            '5': 'CVOUT1', '6': 'AGND', '7': 'CVOUT2', '8': 'AGND', '9': 'CVOUT3',
            '10': 'AGND', '11': 'CVOUT4', '12': 'AGND', '13': 'GATE1', '14': 'DGND',
            '15': 'GATE2', '16': 'DGND', '17': 'AUDIN_L', '18': 'AGND',
            '19': 'AUDIN_R', '20': 'AGND', '21': 'AUDOUT_L', '22': 'AGND',
            '23': 'AUDOUT_R', '24': 'AGND', '25': 'NC', '26': 'NC'}
    add('P%d' % Pn, ('Connector_Generic','Conn_02x13_Odd_Even'), 'PicoMod analog bus IDC-26 PORT%d' % (p+1), nets, FP['IDC26'], 'bus: +-12V, CV1..4, GATE1/2, audio', R)
add('F2', ('Device','Polyfuse'), '0.5A', {'1':'12V_B','2':'12V_P1'}, FP['PF'], 'port1 +12V', R)
add('D18', ('Diode','SS34'), 'SS34', {'1':'12V_P1','2':'12V_B'}, FP['DIODE'], 'reverse protection', R)
add('F3', ('Device','Polyfuse'), '0.3A', {'1':'-12V_B','2':'N12V_P1'}, FP['PF'], 'port1 -12V', R)
add('D28', ('Diode','SS34'), 'SS34', {'1':'-12V_B','2':'N12V_P1'}, FP['DIODE'], 'reverse protection (was D19; renumbered rev.2)', R)
add('D29', ('Diode','SMAJ15A'), 'SMAJ15A', {'1':'12V_P1','2':'PGND'}, FP['DIODE'], 'TVS port1 (was D20; renumbered rev.2)', R)
add('C104', ('Device','C'), '100nF/50V', {'1':'12V_P1','2':'PGND'}, FP['C'], '', R)
add('C105', ('Device','C_Polarized'), '10uF/25V', {'1':'12V_P1','2':'PGND'}, FP['CP'], '', R)
add('C106', ('Device','C'), '100nF/50V', {'1':'N12V_P1','2':'PGND'}, FP['C'], '', R)
add('F4', ('Device','Polyfuse'), '0.5A', {'1':'12V_B','2':'12V_P2'}, FP['PF'], 'port2 +12V', R)
add('D21', ('Diode','SS34'), 'SS34', {'1':'12V_P2','2':'12V_B'}, FP['DIODE'], '', R)
add('F5', ('Device','Polyfuse'), '0.3A', {'1':'-12V_B','2':'N12V_P2'}, FP['PF'], 'port2 -12V', R)
add('D22', ('Diode','SS34'), 'SS34', {'1':'-12V_B','2':'N12V_P2'}, FP['DIODE'], '', R)
add('D23', ('Diode','SMAJ15A'), 'SMAJ15A', {'1':'12V_P2','2':'PGND'}, FP['DIODE'], 'TVS port2', R)
add('C107', ('Device','C'), '100nF/50V', {'1':'12V_P2','2':'PGND'}, FP['C'], '', R)
add('C108', ('Device','C_Polarized'), '10uF/25V', {'1':'12V_P2','2':'PGND'}, FP['CP'], '', R)
add('C109', ('Device','C'), '100nF/50V', {'1':'N12V_P2','2':'PGND'}, FP['C'], '', R)

# ---------------------------- PANEL-2 connectors + rear I/O ----------------
PANEL_MAP = {'3V3':'3V3_PANEL', '5V':'5V_PANEL', 'DGND':'DGND', 'AGND':'AGND',
             'BL_ANODE':'BL_20V', 'BL_CATHODE':'BL_CATHODE'}
def conn_nets(pins):
    out = {}
    for p, sig, kind in pins:
        out[str(p)] = PANEL_MAP.get(sig, sig)
    return out
def list_nets(lst):
    return {str(p): net for p, net in lst}
add('J14', ('Connector_Generic','Conn_02x13_Odd_Even'), 'PANEL-2 J14 (IDC-26) analog field [rev.2 canon]',
    list_nets(B.J14_REV2), FP['IDC26'], 'CVOUT1-4, CVIN1-4, GATE_OUT, FADER1/2, EN_LED5; evens AGND', N)
add('J15', ('Connector_Generic','Conn_02x20_Odd_Even'), 'PANEL-2 J12 (FFC-40) LCD RGB565+BL [rev.2 canon]',
    list_nets(B.J15_REV2), FP['FFC40'], 'RGB565 + sync + BL_PWM/BL_20V/BL_CATHODE, 3V3, GND (per PANEL-2 J12)', N)
add('J16', ('Connector_Generic','Conn_02x08_Odd_Even'), 'PANEL-2 J13 (IDC-16) digital/power [rev.2 canon]',
    list_nets(B.J16_REV2), FP['IDC16'], 'I2C, INT, LED_DATA(3V3), 5V_LED/LED_RET, EN_RAILS; R-22 digital exp deferred to rev.3', N)
add('R97', ('Device','R'), '0R', {'1':'BL_CATHODE','2':'PGND'}, FP['R'], 'backlight LED return path', N)
# rear panel connectors (off-board, wired via TB1/TB2)
add('J6', ('Connector_Audio','AudioJack3'), 'MIDI IN TRS-A', {'T':'MIDI_IN_T','R':'MIDI_IN_R','S':'DGND'}, '', 'rear panel jack', N, on_board=False)
add('J7', ('Connector_Audio','AudioJack3'), 'MIDI OUT TRS-A', {'T':'MIDI_OUT_T','R':'MIDI_OUT_R','S':'DGND'}, '', 'rear panel jack', N, on_board=False)
add('J8', ('Connector_Audio','AudioJack3'), 'LINE OUT L/R 3.5mm', {'T':'AUDOUT_L','R':'AUDOUT_R','S':'AGND'}, '', 'rear panel jack', N, on_board=False)
add('J9', ('Connector_Audio','AudioJack3'), 'PHONES 3.5mm', {'T':'PHONES_L','R':'PHONES_R','S':'AGND'}, '', 'rear panel jack', N, on_board=False)
add('J10', ('Connector_Audio','AudioJack2'), 'AUDIO IN L 3.5mm', {'T':'AUDIN_L','S':'AGND'}, '', 'rear panel jack', N, on_board=False)
add('J11', ('Connector_Audio','AudioJack2'), 'AUDIO IN R 3.5mm', {'T':'AUDIN_R','S':'AGND'}, '', 'rear panel jack', N, on_board=False)
add('J12', ('Connector','Barrel_Jack'), 'DC 12V 5.5/2.1', {'1':'12V_EXT','2':'PGND'}, '', 'rear panel jack (from PWR-2)', N, on_board=False)
add('J13', ('Connector_Audio','AudioJack3'), 'EXPRESSION TRS', {'T':'EXPR','R':'3V3','S':'AGND'}, '', 'rear panel jack', N, on_board=False)
add('TB1', ('Connector_Generic','Conn_01x12'), 'Rear audio terminal block', {
    '1':'AUDOUT_L','2':'AUDOUT_R','3':'AGND','4':'PHONES_L','5':'PHONES_R','6':'AGND',
    '7':'AUDIN_L','8':'AUDIN_R','9':'AGND','10':'AGND','11':'AGND','12':'AGND'}, FP['TB12'], 'jacks -> CORE-2 rear', N)
add('TB2', ('Connector_Generic','Conn_01x10'), 'Rear MIDI/DC/EXPR terminal block', {
    '1':'MIDI_IN_T','2':'MIDI_IN_R','3':'DGND','4':'MIDI_OUT_T','5':'MIDI_OUT_R',
    '6':'DGND','7':'12V_EXT','8':'PGND','9':'EXPR','10':'3V3'}, 'TerminalBlock_Phoenix:TerminalBlock_Phoenix_MKDS-1-10-3.81_1x10_P3.81mm_Horizontal', '', N)

# ---------------------------- test points + power flags -------------------

# ---------------------------- rev.2: PWR-2 connectors + inputs ------------
add('J17', ('Connector_Generic','Conn_02x10_Odd_Even'), 'PWR-2 J3 (IDC-20) [rev.2]',
    {'1':'VSYS','2':'VSYS','3':'BATT_P','4':'BATT_P','5':'12V_EXT','6':'12V_EXT',
     '7':'PGND','8':'PGND','9':'N12_EXT','10':'N12_EXT','11':'PGND','12':'PGND',
     '13':'5V_EXT','14':'5V_EXT','15':'PGND','16':'PGND','17':'5V_LED','18':'LED_RET',
     '19':'PGND','20':'PGND'}, 'Connector_IDC:IDC-Header_2x10_P2.54mm_Vertical',
    'rev.2: силовой разъём PWR-2 J3; при 3 А — альтернатива Micro-Fit 3.0 2x6', N)
add('J18', ('Connector_Generic','Conn_02x06_Odd_Even'), 'PWR-2 J4 (IDC-12) [rev.2]',
    {'1':'BATT_MON_RAW','2':'NTC_PACK','3':'I2C0_SDA','4':'I2C0_SCL','5':'FUEL_ALRT',
     '6':'PWR_GOOD','7':'EN_BUS12','8':'EN_N12','9':'EN_LED5','10':'EN_5V',
     '11':'PGND','12':'PGND'}, 'Connector_IDC:IDC-Header_2x06_P2.54mm_Vertical',
    'rev.2: управляющий разъём PWR-2 J4 (гейдж, PWR_GOOD, EN)', N)
add('D19', ('Diode','SS34'), 'SS34', {'1':'-12V','2':'N12_EXT'}, FP['DIODE'], 'rev.2: N12_EXT series back-feed protection', P)
add('D20', ('Diode','SMAJ15A'), 'SMAJ15A', {'1':'N12_EXT','2':'PGND'}, FP['DIODE'], 'rev.2: N12_EXT TVS', P)
add('C112', ('Device','C_Polarized'), '100uF/25V', {'1':'N12_EXT','2':'PGND'}, FP['CP'], 'rev.2: N12_EXT bulk', P)
add('C113', ('Device','C'), '100nF/50V', {'1':'N12_EXT','2':'PGND'}, FP['C'], 'rev.2: N12_EXT ceramic', P)
add('C114', ('Device','C_Polarized'), '100uF/10V', {'1':'5V_EXT','2':'PGND'}, FP['CP'], 'rev.2: +5V_EXT bulk', P)
add('C115', ('Device','C'), '100nF', {'1':'5V_EXT','2':'PGND'}, FP['C'], 'rev.2: +5V_EXT ceramic', P)
add('FB7', ('Device','FerriteBead'), '600R@100MHz', {'1':'5V_EXT','2':'5V'}, FP['FB'], 'rev.2: +5V from PWR-2 filter', P)
add('C117', ('Device','C_Polarized'), '100uF/10V', {'1':'5V','2':'PGND'}, FP['CP'], 'rev.2: +5V bulk (replaces DNP C15)', P)
add('C116', ('Device','C'), '100nF', {'1':'5V_LED','2':'PGND'}, FP['C'], 'rev.2: 5V_LED at J16', P)
add('R92', ('Device','R'), '100k', {'1':'3V3','2':'PWR_GOOD'}, FP['R'], 'rev.2: PWR_GOOD pull-up (O-8)', P)
add('R93', ('Device','R'), '100k', {'1':'3V3','2':'FUEL_ALRT'}, FP['R'], 'rev.2: FUEL_ALRT pull-up (O-8)', P)
add('R94', ('Device','R'), '0R', {'1':'EN_RAILS','2':'EN_BUS12'}, FP['R'], 'rev.2: EN_RAILS -> EN_BUS12 (J18.7)', P)
add('R95', ('Device','R'), '0R', {'1':'EN_RAILS','2':'EN_N12'}, FP['R'], 'rev.2: EN_RAILS -> EN_N12 (J18.8)', P)
add('R96', ('Device','R'), '0R', {'1':'EN_RAILS','2':'EN_5V'}, FP['R'], 'rev.2: EN_RAILS -> EN_5V (J18.10)', P)
add('R98', ('Device','R'), '0R', {'1':'LED_GPIO','2':'LED_DATA'}, FP['R'], 'rev.2: bypass LED level shifter (U44/R90 DNP); 3.3 V to PANEL-2', M)
add('R105', ('Device','R'), '0R', {'1':'LCD_DISP','2':'3V3'}, FP['R'], 'rev.2: display always enabled (PANEL-2 J12 has no DISP pin)', N)
# rev.2: CVIN3/CVIN4 (PANEL-2 J14 pins 13/15) -> MCP3208 CH4/CH5 (N-2)
add('U45', ('Amplifier_Operational','TL074'), 'TL074', {'1':'CVIN3_RAW','2':'CVIN3_N','3':'CVREF_B'}, FP['DIP14'], 'CV IN3 level shift', V, unit=1)
add('U45', ('Amplifier_Operational','TL074'), 'TL074', {'7':'CVIN4_RAW','6':'CVIN4_N','5':'CVREF_B'}, FP['DIP14'], 'CV IN4 level shift', V, unit=2)
add('U45', ('Amplifier_Operational','TL074'), 'TL074', {'8':'SPARE_F','9':'SPARE_F','10':'AGND'}, FP['DIP14'], 'spare (grounded)', V, unit=3)
add('U45', ('Amplifier_Operational','TL074'), 'TL074', {'14':'SPARE_G','13':'SPARE_G','12':'AGND'}, FP['DIP14'], 'spare (grounded)', V, unit=4)
add('U45', ('Amplifier_Operational','TL074'), 'TL074', {'4':'12V','11':'-12V'}, FP['DIP14'], 'power', V, unit=5)
add('R99', ('Device','R'), '100k', {'1':'CVIN3','2':'CVIN3_N'}, FP['R'], '', V)
add('R100', ('Device','R'), '100k', {'1':'CVIN4','2':'CVIN4_N'}, FP['R'], '', V)
add('R101', ('Device','R'), '16.5k', {'1':'CVIN3_N','2':'CVIN3_RAW'}, FP['R'], 'gain 0.165', V)
add('R102', ('Device','R'), '16.5k', {'1':'CVIN4_N','2':'CVIN4_RAW'}, FP['R'], 'gain 0.165', V)
add('R103', ('Device','R'), '1k', {'1':'CVIN3_RAW','2':'CVIN3_ADC'}, FP['R'], '', V)
add('R104', ('Device','R'), '1k', {'1':'CVIN4_RAW','2':'CVIN4_ADC'}, FP['R'], '', V)
add('C118', ('Device','C'), '100nF', {'1':'CVIN3_ADC','2':'AGND'}, FP['C'], '', V)
add('C119', ('Device','C'), '100nF', {'1':'CVIN4_ADC','2':'AGND'}, FP['C'], '', V)
add('D24', ('Diode','BAT54S'), 'BAT54S', {'1':'AGND','2':'3V3','3':'CVIN3_ADC'}, FP['BAT54S'], '', V)
add('D25', ('Diode','BAT54S'), 'BAT54S', {'1':'AGND','2':'3V3','3':'CVIN4_ADC'}, FP['BAT54S'], '', V)
add('C120', ('Device','C'), '100nF', {'1':'12V','2':'AGND'}, FP['C'], '', V)
add('C121', ('Device','C'), '100nF', {'1':'-12V','2':'AGND'}, FP['C'], '', V)

for i, (tp, net, why) in enumerate(B.TPS):
    add(tp, ('Connector','TestPoint'), net, {'1': net}, 'TestPoint:TestPoint_Pad_D1.5mm', why, 'TP', on_board=True)
FLAGS = ['VBUS_CHG', 'VBUS_F', 'BATT_N', 'PGND', '12V', '-12V', '5V', 'VREF33', '3V3_MCU', 'DGND', 'AGND']

# ==========================================================================
# layout + generation
# ==========================================================================
def pin_span(lib, unit):
    return [p for p in k.pins(*lib) if p[6] in (0, unit)]

def comp_size(lib, unit):
    ps = pin_span(lib, unit)
    if not ps:
        return 1, 1
    xs = [p[2] for p in ps]; ys = [p[3] for p in ps]
    left = any(p[4] == 0 for p in ps); right = any(p[4] == 180 for p in ps)
    top = any(p[4] == 270 for p in ps); bot = any(p[4] == 90 for p in ps)
    w = max(xs) - min(xs); h = max(ys) - min(ys)
    w += (LABEL_PAD if left else 0) + (LABEL_PAD if right else 0)
    h += 4.0 if top else 0.0
    h += 4.0 if bot else 0.0
    return max(1, int(math.ceil(w / SW))), max(1, int(math.ceil(h / SH)))

class Section:
    def __init__(self, sch, name, x0, y0, cols=6):
        self.sch = sch; self.name = name; self.x0 = x0; self.y0 = y0
        self.cols = cols; self.col = 0; self.row = 0; self.shelf = 0
        sch.text(name, (x0, y0 - 3.0), size=4.0)
    def place(self, comp, unit=1):
        w, h = comp_size(comp['lib'], unit)
        if self.col + w > self.cols:
            self.col = 0; self.row += self.shelf; self.shelf = 0
        x = self.x0 + (self.col + w/2.0) * SW
        y = self.y0 + 12.0 + (self.row + h/2.0) * SH
        c = self.sch.sym(comp['lib'][0], comp['lib'][1], comp['ref'], comp['val'],
                         x, y, footprint=comp['fp'], unit=unit,
                         on_board=comp['on_board'], dnp=(comp['ref'] in B.REV2_DNP),
                         ref_off=(-w*SW/2 + 4, -h*SH/2 + 3.0),
                         val_off=(-w*SW/2 + 4, -h*SH/2 + 6.0))
        c['note'] = comp['note']; c['section'] = comp['section']
        self.shelf = max(self.shelf, h); self.col += w
        return c
    def end_y(self):
        return self.y0 + 12.0 + (self.row + self.shelf) * SH

def make_schematic():
    sch = k.Sch(os.path.join(HERE, PROJECT + '.kicad_sch'),
                'CORE-2 PRE-FREEZE / DO NOT FABRICATE - rev.1 ESP32-P4 (not for fabrication)',
                paper=PAPER, project=PROJECT)
    # banner
    sch.text('PRE-FREEZE / DO NOT FABRICATE', (28, 20), size=7.0)
    sch.text('CORE-2 rev.1 research schematic - ESP32-P4 + ESP32-C6. Do not order boards '
             'before P1 benchmark and spec/90 sign-off.', (28, 26), size=3.0)
    sch.text('Project files: README.md, pinmap.md, power-tree.md, interfaces.md. '
             'GPIO conflicts: 0 (check_pinmap.py).', (28, 30), size=2.5)
    colA, colB, colC = 22.0, 407.0, 792.0
    top = 46.0
    order = {'POWER': (colA, 0), 'MCU': (colB, 0), 'AUDIO': (colC, 0),
             'CV': (colC, 1), 'MIDI': (colB, 1), 'BUS': (colC, 2),
             'PANEL': (colB, 2), 'TP': (colB, 3)}
    comps = {}
    sections = {}
    ypos = {colA: top, colB: top, colC: top}
    # create sections in order of columns: POWER, MCU, AUDIO, CV, MIDI, BUS, PANEL, TP
    for secname in ['POWER', 'MCU', 'AUDIO', 'CV', 'MIDI', 'BUS', 'PANEL', 'TP']:
        x0, _ = order[secname]
        sec = Section(sch, SEC_TITLES.get(secname, secname), x0, ypos[x0])
        sections[secname] = sec
        for comp in C:
            if comp['sec'] != secname:
                continue
            c = sec.place(comp, unit=comp['unit'])
            comps.setdefault(comp['ref'], []).append((c, comp))
        ypos[x0] = sec.end_y() + 12.0
    # power flags in column B under TP section
    fy = sections['TP'].end_y() + 14.0
    sch.text('POWER FLAGS (net drivers for ERC)', (colB, fy - 4), size=3.0)
    flags = []
    for i, net in enumerate(FLAGS):
        fx = colB + (i % 5) * 20.0
        fyy = fy + 10.0 + (i // 5) * 20.0
        fc = sch.sym('power', 'PWR_FLAG', '#FLG%02d' % (i+1), 'PWR_FLAG', fx, fyy,
                     hide_ref=True, ref_off=(2, -3), val_off=(2, 3))
        sch.net(fc, net, num='1')
        flags.append(fc)
    # wire all pins by labels
    for ref, lst in comps.items():
        for c, comp in lst:
            unit = comp['unit']
            for p in pin_span(comp['lib'], unit):
                net = comp['nets'].get(p[0])
                if net is None:
                    continue
                if net == 'NC':
                    sch.nc_pin(c, num=p[0])
                else:
                    sch.net(c, net, num=p[0])
    for ref, lst in comps.items():
        for c, comp in lst:
            unit = comp['unit']
            for p in pin_span(comp['lib'], unit):
                if p[0] not in comp['nets']:
                    sch.nc_pin(c, num=p[0])
    sch.write()
    return sch, comps, sections

SEC_TITLES = {
 'POWER': 'POWER: USB-C, BQ24074 charge/path, BMS 1S, MT3608 x3 (+12/+5/BL20), MP1584 3V3_MCU, AP2112 x2, MC34063 -12V',
 'MCU': 'MCU: ESP32-P4 module slot, ESP32-C6 Wi-Fi/BLE (SPI esp-hosted), USB-C HS, microSD SDIO',
 'AUDIO': 'AUDIO: PCM5102A DAC + PCM1808 ADC (I2S), TL072 LINE/PHONES, rear jacks, mic (MAX9814 + line/mic switch + I2S1 MEMS, D-91)',
 'CV': 'CV: 2x MCP4728 (0x60/0x61), 6x TL074 x4.9, CV IN level shift, MCP3208 + chains',
 'MIDI': 'MIDI TRS-A: 6N137 IN / 74HCT125 OUT; GATE drivers 2N7000; LED level shifter',
 'BUS': 'MODULE BUS: 2x IDC-26 analog bus (+-12V, CV1..4, GATE, audio), per-port protection',
 'PANEL': 'PANEL-2 + REAR I/O: J14 IDC-26 control, J15 FFC-40 LCD, J16 IDC-16 digital exp, rear jacks TB1/TB2',
 'TP': 'TEST POINTS (TP1..TP22)',
}

# ==========================================================================
# exports / reports
# ==========================================================================
def sanitize_exports():
    """Remove absolute/personal paths from generated text artifacts (PII policy:
    no home-directory paths in the public repo; keep relative hardware/core2/...)."""
    import re
    root = os.path.dirname(HERE)                     # .../hardware
    repo = os.path.dirname(root)                     # repo root
    targets = ['netlist.net', 'netlist.xml', PROJECT + '.svg',
               os.path.join('svg', PROJECT + '.svg'),
               os.path.join('erc', 'erc.rpt'), os.path.join('erc', 'erc.json')]
    for rel in targets:
        path = os.path.join(HERE, rel)
        if not os.path.exists(path):
            continue
        with open(path, encoding='utf-8', errors='ignore') as fh:
            txt = fh.read()
        txt = txt.replace(HERE + os.sep, 'hardware/core2/')
        txt = txt.replace(root + os.sep, '')
        txt = txt.replace(repo + os.sep, '')
        # final safety net: any remaining home-directory path token
        home_prefix = '/' + 'Users' + '/'
        txt = re.sub(r'/(?:' + 'Users|home)/[^"\s<>,;]*', 'hardware/core2/' + PROJECT + '.kicad_sch', txt)
        if home_prefix in txt or ('/' + 'home' + '/') in txt:
            print('WARNING: absolute path still present in', rel)
        with open(path, 'w', encoding='utf-8') as fh:
            fh.write(txt)

def run(cmd):
    print('+', ' '.join(cmd))
    r = subprocess.run(cmd, capture_output=True, text=True)
    if r.stdout.strip(): print(r.stdout.strip()[:1500])
    if r.returncode != 0: print('STDERR:', r.stderr.strip()[:2000])
    return r

def exports():
    schfile = os.path.join(HERE, PROJECT + '.kicad_sch')
    os.makedirs(os.path.join(HERE, 'erc'), exist_ok=True)
    # stale project-local annotation state (.kicad_prl) from a previous generation
    # makes the first KiCad load report "annotation errors"; drop it.
    prl = os.path.join(HERE, PROJECT + '.kicad_prl')
    if os.path.exists(prl):
        os.remove(prl)
    run([KICAD_CLI, 'sch', 'erc', '--severity-all', '--format', 'report',
         '-o', os.path.join(HERE, 'erc', 'erc.rpt'), schfile])
    run([KICAD_CLI, 'sch', 'erc', '--severity-all', '--format', 'json',
         '-o', os.path.join(HERE, 'erc', 'erc.json'), schfile])
    run([KICAD_CLI, 'sch', 'export', 'pdf', '-o', os.path.join(HERE, PROJECT + '.pdf'), schfile])
    run([KICAD_CLI, 'sch', 'export', 'svg', '--output', os.path.join(HERE, 'svg'), schfile])
    import shutil
    src = os.path.join(HERE, 'svg', PROJECT + '.svg')
    if os.path.exists(src):
        shutil.copy(src, os.path.join(HERE, PROJECT + '.svg'))
    # first CLI netlist load after writing the .kicad_sch may report stale annotation
    # (KiCad rebuilds .kicad_prl annotation state); warm up silently, then export.
    warm = os.path.join(HERE, '.netlist_warmup')
    subprocess.run([KICAD_CLI, 'sch', 'export', 'netlist', '--format', 'kicadsexpr',
                    '-o', warm, schfile], capture_output=True, text=True)
    if os.path.exists(warm):
        os.remove(warm)
    run([KICAD_CLI, 'sch', 'export', 'netlist', '--format', 'kicadsexpr',
         '-o', os.path.join(HERE, 'netlist.net'), schfile])
    run([KICAD_CLI, 'sch', 'export', 'netlist', '--format', 'kicadxml',
         '-o', os.path.join(HERE, 'netlist.xml'), schfile])
    sanitize_exports()

MPN = {
 'U22': 'BQ24074RGT', 'U23': 'BQ29700DSER', 'U24': 'MT3608', 'U25': 'MT3608',
 'U29': 'MT3608', 'U26': 'MP1584EN module', 'U27': 'AP2112K-3.3', 'U30': 'AP2112K-3.3',
 'U28': 'MC34063AP', 'A1': 'ESP32-P4NRW32 (+32MB PSRAM, module TBD)',
 'U31': 'ESP32-C6-MINI-1 (DNP if ESP32-S3 build)', 'U32': 'PCM5102A',
 'U34': 'PCM1808PWR', 'U35': 'MCP4728A0-E/UN', 'U36': 'MCP4728A1-E/UN',
 'U40': 'MCP3208-CI/P', 'U41': '24LC32A-I/P', 'U42': '6N137', 'U43': '74HCT125',
 'U44': '74HCT1G125', 'U20': 'USBLC6-2SC6', 'J1': 'USB-C 16P (USB2.0)',
 'J5': 'microSD socket (Hirose DM3AT)', 'J15': 'FFC-40 0.5mm', 'J14': 'IDC-26',
 'J16': 'IDC-16',
}

def write_bom():
    import csv, re
    def rk(r):
        m = re.match(r'([A-Za-z#]+)(\d*)', r)
        return (m.group(1), int(m.group(2) or 0), r)
    groups = {}
    seen = set()
    for c in C:
        if c['ref'] in seen: continue
        seen.add(c['ref'])
        groups.setdefault((c['val'], c['fp'], c['note'], c['on_board']), []).append(c['ref'])
    rows = []
    n = 0
    for (val, fp, note, onb), refs in groups.items():
        n += 1
        refs = sorted(refs, key=rk)
        mpns = sorted({MPN[r] for r in refs if r in MPN})
        nm = []
        if not onb: nm.append('off-board (rear/panel part)')
        if note: nm.append(note)
        if any(r == 'U31' for r in refs) and 'DNP if ESP32-S3' not in note:
            nm.append('DNP for ESP32-S3 build')
        rows.append(dict(code='PM-C2-%03d' % n, mpn='/'.join(mpns), val=val,
                         qty=len(refs), refs=' '.join(refs), fp=fp, note='; '.join(nm)))
    # rev.2 delta: split each group into populate / DNP; add new rev.2 parts
    dnp = B.REV2_DNP

    def _reason(x):
        v = dnp[x].strip()
        for pref in ('DNP rev.2:', 'DNP rev.2'):
            if v.startswith(pref):
                v = v[len(pref):].lstrip(': ')
                break
        return v.strip()

    split_rows = []
    for r in rows:
        refs = r['refs'].split()
        dnp_refs = [x for x in refs if x in dnp]
        keep = [x for x in refs if x not in dnp]
        base = dict(r)
        if keep:
            rr = dict(base); rr['refs'] = ' '.join(keep); rr['qty'] = len(keep); rr['rev2'] = ''
            split_rows.append(rr)
        if dnp_refs:
            rr = dict(base); rr['refs'] = ' '.join(dnp_refs); rr['qty'] = len(dnp_refs); rr['rev2'] = 'DNP'
            reasons = sorted({_reason(x) for x in dnp_refs})
            rr['note'] = (rr['note'] + '; ' if rr['note'] else '') + 'DNP rev.2: ' + '; '.join(reasons)
            split_rows.append(rr)
    rows = split_rows
    # split groups further into "existing" vs "new in rev.2" rows
    rows2 = []
    for r in rows:
        if r.get('rev2') == 'DNP':
            rows2.append(r); continue
        refs = r['refs'].split()
        new = [x for x in refs if x in B.REV2_NEW_REFS]
        keep = [x for x in refs if x not in B.REV2_NEW_REFS]
        if keep:
            rr = dict(r); rr['refs'] = ' '.join(keep); rr['qty'] = len(keep)
            rows2.append(rr)
        if new:
            rr = dict(r); rr['refs'] = ' '.join(new); rr['qty'] = len(new); rr['rev2'] = 'NEW'
            rows2.append(rr)
    rows = rows2
    present = {x for r in rows for x in r['refs'].split()}
    for i, n in enumerate(B.REV2_NEW):
        if n['ref'] in present:
            continue
        rows.append(dict(code='PM-C2-R2-%02d' % (i+1), mpn='', val=n['val'], qty=1,
                         refs=n['ref'], fp=n['fp'], note=n['note'], rev2='NEW'))
    for r in rows:
        if r.get('rev2') != 'DNP' and all(x in B.REV2_NEW_REFS for x in r['refs'].split()):
            r['rev2'] = 'NEW'
    rows.sort(key=lambda r: r['code'])
    with open(os.path.join(HERE, 'BOM-core2.csv'), 'w', newline='', encoding='utf-8') as fh:
        w = csv.writer(fh, delimiter=';')
        w.writerow(['Артикул', 'MPN (draft)', 'Номинал/Тип', 'Кол-во', 'Позиции', 'Корпус', 'rev.2', 'Примечание'])
        for r in rows:
            w.writerow([r['code'], r['mpn'], r['val'], r['qty'], r['refs'], r['fp'],
                        r.get('rev2', ''), r['note']])
    print('BOM rows:', len(rows), '(rev.2: DNP/partial + NEW delta)')
    return rows

def parse_erc():
    p = os.path.join(HERE, 'erc', 'erc.rpt')
    if not os.path.exists(p): return None
    txt = open(p, encoding='utf-8').read()
    import re
    m = re.search(r'Errors (\d+)\s+Warnings (\d+)', txt)
    return {'errors': int(m.group(1)) if m else -1,
            'warnings': int(m.group(2)) if m else -1, 'text': txt}

if __name__ == '__main__':
    custom = build_custom_lib()
    libpath = os.path.join(HERE, 'picomod.kicad_sym')
    with open(libpath, 'w', encoding='utf-8') as fh:
        fh.write('(kicad_symbol_lib\n\t(version 20241209)\n\t(generator "gen_core2_sch.py")\n'
                 '\t(generator_version "9.0")\n')
        for nm in sorted(custom):
            body = '\n'.join('\t' + ln for ln in custom[nm].split('\n'))
            fh.write(body + '\n')
        fh.write(')\n')
    src = '/Applications/KiCad/KiCad.app/Contents/SharedSupport/template/sym-lib-table'
    tbl = open(src, encoding='utf-8').read().rstrip()
    tbl = tbl[:-1].rstrip() + '\n\t(lib (name "picomod") (type "KiCad") (uri "${KIPRJMOD}/picomod.kicad_sym") (options "") (descr "PicoMod CORE-2 project symbols"))\n)\n'
    open(os.path.join(HERE, 'sym-lib-table'), 'w', encoding='utf-8').write(tbl)
    pro = {'board': {'design_settings': {}}, 'meta': {'filename': PROJECT + '.kicad_pro', 'version': 1},
           'schematic': {'legacy_lib_dir': '', 'legacy_lib_list': []},
           'sheets': [[PROJECT + '.kicad_sch', '']],
           'libraries': {'pinned_footprint_libs': [], 'pinned_symbol_libs': []}}
    open(os.path.join(HERE, PROJECT + '.kicad_pro'), 'w', encoding='utf-8').write(json.dumps(pro, indent=2))
    sch, comps, sections = make_schematic()
    print('placed entries:', sum(len(v) for v in comps.values()), 'symbols:', len(sch.comps))
    if '--no-export' not in sys.argv:
        exports()
        erc = parse_erc()
        if erc:
            print('ERC: errors=%d warnings=%d' % (erc['errors'], erc['warnings']))
        write_bom()
    # keep the working tree clean (bytecode caches would embed the checkout path)
    import shutil
    for d in ('__pycache__', os.path.join('tools', '__pycache__')):
        shutil.rmtree(os.path.join(HERE, d), ignore_errors=True)
