martiyanov/bukifon/(commit log)

2026-11-05 Букифон v1.2: 62HP×3U HEAD + деки Lapka-42/PAD, динамики, эффектор; схемы, прошивка, корпус, документация
    [BOM-core.csv, BOM-modules.csv, BOM-panel.csv, BOM-power.csv, BOM.csv, CORE-1.kicad_sch, MOD-ENSEMBLE-1.kicad_sch, MOD-FILTER-1.kicad_sch]
2026-11-05 v1.2: чертежи HEAD 62HP×3U и дек Lapka-42/PAD, геометрия Lapka-42, раздел репозитория
2026-11-05 Атрибуция геометрии Lapka-42 (NOTICE, spec/60)
2026-11-05 v1.3: варианты нижней клавишной зоны (12/18/24/36 клавиш) на панели 315×145
2026-11-05 Печатный шаблон 1:1 для эскиза раскладки клавиш + инструкция
2026-11-05 Раскладка: 18 клавиш (домашний+тамбы), разворот наружу; шаблон 1:1 для фото
2026-11-05 Печатные листы 1:1: 42 клавиши для вырезания + эталон раскладки Lapka-42
2026-11-05 Превью эталонного листа раскладки
2026-11-05 fix(print): правильный знак поворота клавиш на эталонных листах (позиции Lapka-42 не изменены, 0 пересечений)
2026-11-05 Печать: отдельные листы Lapka-42 (левая/правая) + листы 1:1 с блоком экрана/ручек Digitone II
2026-11-05 Печать: Octatrack MKII 1:1 (2 части + наложение на панель 315×145)
2026-11-05 v1.4: панель 340×185 по фото (16 ручек, экран, 21 mini-jack, 2 фейдера, 2×21 Lapka)
2026-11-05 v1.4.1: наклон клавиатур ±5° как на фото, экран 5" без полей, без динамиков и нижних джеков
2026-11-05 v1.5: наклон клавиатур ±20° по фото (панель 380×210), замер по контурам клавиш
2026-11-05 Handoff: docs/00-context-transfer.md, panel-spec JSON (v1.4.1/v1.5), v1.6 трассировка
2026-11-05 ignore dist/ (снапшоты для передачи)
2026-11-05 context: фото макета IMG_0704 (HEIC) + анализ габарита: при наклоне 15-20° AABB половины МЕНЬШЕ (132x101), 340x185 реален
    goal: проверить вывод v1.4.1 о невозможности 340x185 при наклоне
    decision: 167x114 из ТЗ - завышенная оценка (формула прямоугольника); реальный AABB по колпачкам при 20° = 128x105
    question: наклон 15° или 20° - согласовать с заказчиком после сборки v1.7
2026-11-05 v1.7: раскладка снята с концепт-изображения 380×210 (42 клавиши, 16 ручек, 10 джеков, экран 5", 2 фейдера) + spec JSON
2026-11-05 v0.4: каноническая раскладка (точная Lapka-42 ±18° + концепт): JSON, 1:1 шаблон, рендер, сравнение, проверка пересечений; принят handoff v0.3
    [body_L.3mf, body_L.stl, body_R.3mf, body_R.stl, bukifon_v03_mockup.scad, bukifon_v03_panel.dxf, bukifon_v17_assembly.3mf, bukifon_v1_7_assembly.step]
2026-11-05 v0.4: каноническая панель по handoff v0.3 + точная Lapka-42 ±18°; 3D-корпус v0.4 (0 конфликтов, 83 выреза); позиционирование платформы: сэмплер + синтез + открытые модули
    [body_L.3mf, body_L.stl, body_R.3mf, body_R.stl, bukifon_v04_assembly.3mf, bukifon_v1_8_assembly.step, bukifon_v1_8_fader_cap.step, bukifon_v1_8_fader_cap.stl]
2026-11-05 docs: железо Elektron, выполнимость ESP32 (S3/P4), дорожная карта P1-P7
2026-11-05 docs: описание MR (v0.4) для GitHub
2026-11-05 docs: второе мнение по MCU (P4 + HS USB + DSI), reorder дорожной карты (бенчмарк -> требования -> ядро -> rev.3), реестр требований spec/90
2026-11-05 v1.8: панель+корпус по handoff заказчика v0.3 (фото-геометрия 42 клавиш)
    context: refs/v03_handoff (JSON/DXF/PNG заказчика) — единственный источник раскладки
    goal: совпадение эскиза с эталоном заказчика + 3D-корпус, STL/STEP, чертёж 1:1
    decision: экран = голое стекло 5" (плата Waveshare B 121x87 задевает угол K04); Choc стек 9.0мм над PCB; фейдер RS60N11 (60мм), паз 2.5x63 как в handoff; панель 3 детали (шапка X131.2-249.1 до Y98), скорлупа 2 половины
    decision: стойки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
    [bukifon_v1_8_assembly.step, bukifon_v1_8_fader_cap.step, bukifon_v1_8_knob.step, bukifon_v1_8_panel_C.step, bukifon_v1_8_panel_L.step, bukifon_v1_8_panel_R.step, bukifon_v1_8_screen_carrier.step, bukifon_v1_8_screen_carrier.stl]
2026-11-05 release: v0.4.0 — канон панели v0.4, корпус v0.4, реестр требований, ревью MCU (DeepSeek + GPT), дорожная карта; README/CHANGELOG/VERSION + правила SemVer
2026-11-05 docs: развилка v1.8/v0.4 и рекомендация (канон клавиатуры = точная Lapka ±18°, датаситы и экран-стекло из v1.8)
    question: подтвердить канон клавиатуры (v0.4 Lapka ±18°) — тогда перенесу реальные размеры компонентов в case_v04
    recon: compares/ref_v18_v04.png — v0.4 ближе к эталону по вееру клавиш
2026-11-05 release: v0.5.0 — сайт GitHub Pages RU/EN (SEO, sitemap, robots, llms.txt, hreflang, JSON-LD), workflow деплоя, CITATION, метаданные репозитория
2026-11-05 release: v0.5.1 — сайт опубликован (gh-pages), скрипт publish_site.sh, фактические метаданные
2026-11-05 night: scope freeze (docs/22), эргономика wedge 8° (docs/21), разведка аналогов (docs/20), скрипт check_all.sh
2026-11-05 positioning: «народный синтезатор» — принципы, целевые цены ($200/$300/$400), cost-down в spec/00 §13, README, сайт RU/EN; + BOM/доки v0.5 (docs-bom)
    [BOM.csv, body_L.3mf, body_L.stl, body_R.3mf, body_R.stl, bukifon_v05_B_assembly.3mf, foot.3mf, foot.stl]
2026-11-05 feat(req): режим компьютерной клавиатуры/DAW (USB HID+MIDI+UAC2), Wi-Fi/BT обязательны (S3 нативно, P4 + ESP32-C6), BLE-MIDI/HID — spec/90 R-25..R-28, spec/00 §14, README
    [BOM-panel2.csv, PANEL-2-kicad-bom.csv, PANEL-2.kicad_sch, body_L.3mf, body_L.stl, body_R.3mf, body_R.stl, bukifon_v05_B_assembly.3mf]
2026-11-05 hw(panel2): PANEL-2 pre-freeze (ERC 0 err/6 warn, 1314 проверок), 3 шлейфа FFC-40+IDC-16+IDC-26, 4×MCP23017; решения D-15..D-19 (аудио на rear, BL на CORE-2, 6×M3)
2026-11-05 case(v0.5-B): клин 8° — 380×210×61.5 (перед 32/зад 61.5), 6 STL watertight, fitcheck 32/0, профиль 1:1, рендеры; PANEL-2 доки обновлены (BL на CORE-2, аудио rear, режимы)
    [BOM-panel2.csv, PANEL-2-kicad-bom.csv, PANEL-2.kicad_sch, pinmap.csv]
2026-11-05 wip: ночной снапшот перед security-rewrite (PANEL-2 update, firmware core, UI)
    [pinmap.csv]
2026-11-05 security: вычищена история (GPS EXIF, PDF с IP, /Users/a123), SECURITY.md, .gitignore, tools/security_scan.sh; очищенные фото (EXIF/GPS/Artist срезаны)
2026-11-05 security: убрать из репозитория полноразмерное фото макета и его кропы (только обезличенный оверлей без EXIF); refs/datasheets и HEIC в .gitignore
    [BOM-core2.csv, CORE-2.kicad_sch]
2026-11-05 security: относительные пути, .gitignore для сборки, security_scan в чек-листе
    [CORE-2.kicad_sch]
2026-11-05 security: повторная санитизация путей (netlist CORE-2)
    [BOM-core2.csv, CORE-2.kicad_sch, pinmap.csv]
2026-11-05 hw(core2): CORE-2 rev.1 PRE-FREEZE — ERC 0/0, pinmap PASS (54/55 GPIO), ESP32-C6 по SPI (SDIO не влезает), USB HS composite, аудио/джеки на rear, BL на CORE-2; PII вычищен
    [BOM-core2.csv, CORE-2.kicad_sch, pinmap.csv]
2026-11-05 release: v0.6.0 — ночная сборка v1.0-rc: корпус v0.5-B (клин 8°), CORE-2/PANEL-2 pre-freeze, прошивка host-демо + 112 тестов + API v0, «народный синтезатор», безопасность (GPS/PDF/пути вычищены)
    [CORE-2.kicad_sch, bukifon_v04_assembly.3mf, panel_L.3mf, panel_R.3mf, pinmap.csv]
2026-11-05 hw(core2): синхронизация PANEL-2 4× MCP23017 (0x20–0x23), регенерация netlist
    [BOM-core2.csv]
2026-11-05 release: v0.6.1 — синхронизация CORE-2 ↔ PANEL-2 (4× MCP23017, R91 INT pull-up)
    [bukifon_v04_assembly.3mf, panel_L.3mf, panel_R.3mf]
2026-11-05 site: бейдж v0.6.1
2026-11-05 site: publish_site.sh — force-push gh-pages (после rewrite истории)
2026-11-05 release: v0.6.2 — VERSION/CHANGELOG/README согласованы, безопасная публикация сайта (временный индекс), бейдж сайта
    [bukifon_v04_assembly.3mf, panel_L.3mf, panel_R.3mf]
2026-11-05 sdk: Module API v0 — docs/24, каталог modules/ (template + 2 примера, компилируются), tools/validate_module.py, tools/new_module.sh, CI workflow modules.yml
2026-11-05 site: раздел «Модули и SDK» (RU/EN) со ссылками на docs/24, каталог, валидатор и примеры
    [bukifon_v04_assembly.3mf, panel_L.3mf, panel_R.3mf]
2026-11-05 docs: архитектура питания по консультации GPT (docs/25) — ±12В бюджет, без MC34063, BQ24074 OUT/VSYS, MAX17048, стенд до PCB; решения D-27..D-31
2026-11-05 bench(P1): workload freeze (docs/05, 05a) + переносимый харнесс firmware/bench (7 сценариев, JSON/CSV, детерминизм, 0 аллокаций), host PASS (max 218 µs = 16.4% дедлайна), 120/120 тестов, bench_s3 сбо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
    [PWR-2.kicad_sch, host.csv]
2026-11-05 site/README: раздел «Бенчмарк (P1)» и ссылки на docs/05,05a,25,firmware/bench
    [BOM-power2.csv, bukifon_v04_assembly.3mf, panel_L.3mf, panel_R.3mf]
2026-11-05 README: ссылки на docs/05,05a,20-25, modules/, firmware/bench/, SECURITY
2026-11-05 hw(pwr2): PWR-2 rev.1 PRE-FREEZE — TPS61088 +12/+5, LMR33630 IBB −12 (без MC34063), BQ24074 OUT/VSYS, BMS 1S+BQ297, MAX17048, master load-switch, EN рельсов, ERC 0/0, power-tree/mежплатные интерфейсы
    [BOM-power2.csv, PWR-2.kicad_sch]
2026-11-05 release: v0.7.0 — PWR-2 rev.1 (TPS61088/LMR33630 IBB, ERC 0/0), P1-бенчмарк (workload freeze + harness, host PASS, bench_s3 OK), SDK модулей (API v0 + каталог + валидатор + CI), архитектура питания; 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
    [bukifon_v04_assembly.3mf, panel_L.3mf, panel_R.3mf]
2026-11-05 docs: P1-стенд (docs/26), cost-down и первый SKU S3-kit $199 (docs/27), бумажный набор 1:1 (paperkit PDF 4 стр + docs/28 + prints.md)
2026-11-05 spec: решения D-37..D-43 (product BOM, S3-kit $199, battery, Micro-Fit, 3.3V buck-boost, VSYS cap, display MPN); O-1..O-6 закрыты
2026-11-05 hw(core2): rev.2 план и DNP-список (MT3608#2, MC34063, BMS; входы 12V_EXT/N12_EXT/+5V_EXT; EN от MCP23017; +5В 1.6А; J17/J18), ERC 0/0, BOM/интерфейсы синхронизированы с PWR-2
    [BOM-core2.csv, CORE-2.kicad_sch]
2026-11-05 spec: O-8..O-11 — PWR_GOOD/ALRT через C6, CVIN3/4→MCP3208, GATE_IN через MCP23017, TDM отложен, J3 прототип IDC/rev.2 Micro-Fit
2026-11-05 release: v0.8.0 — P1-стенд (docs/26), cost-down и первый SKU S3-kit $199 (docs/27), бумажный макет 1:1 (paperkit PDF + docs/28), CORE-2 rev.2 план/DNP, решения D-37..D-43
    [bukifon_v04_assembly.3mf, panel_L.3mf, panel_R.3mf]
2026-11-05 hw(panel2): rev.2 — J13/J14 (5V_LED, LED_RET, EN_RAILS, EN_LED5), re-pin по канону, CVIN3/4→MCP3208, GATE_IN на MCP23017 0x23 GPB7, LED_DATA 3.3В + level shifter; ERC 0err/6warn, verify 1290/0; O-12.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
    [BOM-core2.csv, BOM-panel2.csv, CORE-2.kicad_sch, PANEL-2-kicad-bom.csv, PANEL-2.kicad_sch, pinmap.csv]
2026-11-05 hw(core2): rev.2 схема внесена — J17/J18, входы 12V_EXT/N12_EXT/+5V_EXT/5V_LED, D19/D20/C112-C119/FB7, EN-развязки R94-R96, CV IN3/4 на MCP3208 (U45 TL074), re-pin J14/J15/J16; DNP 46; ERC 0/0; O-12.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
    [BOM-core2.csv, CORE-2.kicad_sch]
2026-11-05 release: v0.8.1 — CORE-2 rev.2 схема (ERC 0/0, DNP 46) + PANEL-2 rev.2 (ERC 0/6warn, verify 1290/0); O-13..O-16, D-44/D-45
    [bukifon_v04_assembly.3mf, panel_L.3mf, panel_R.3mf]
2026-11-05 docs: P1 точный список заказа (docs/29) + запрос на purge старых PII-объектов GitHub с SHA (docs/30)
2026-11-05 docs: CORE-S3 ограничения (docs/31): GPIO 38-40, 1-bit SD, USB endpoint ceiling, RGB+1FB, TPS63802; профиль S3-base в бенчмарке; решения D-46..D-50
    [BOM-cores3.csv, CORE-S3.kicad_sch, body_L.3mf, body_L.stl, body_R.3mf, body_R.stl, bukifon_v05_B_light_assembly.3mf, foot.3mf]
2026-11-05 case(v0.5-B-light): 230 г / 11.1 ч (−17% массы, −39% времени) — стенки 2.0/дно 1.8, 3 периметра + локальные рёбра, панели-оболочки; 6 STL watertight, fitcheck 32/0, доки prints/27 §5
    [BOM-cores3.csv]
2026-11-05 hw(cores3): CORE-S3 rev.0 — ESP32-S3-N16R8, 1-bit SD, SPI-дисплей (RGB не влезает: 31 линия), USB FS стерео UAC2, TPS63000 placeholder; ERC 0/0, GPIO 27 занято/5 свободно; D-51/D-52
    [BOM-cores3.csv, CORE-S3.kicad_sch, pinmap.csv]
2026-11-05 release: v0.9.0 — CORE-S3 rev.0 (народная плата, ERC 0/0), корпус B-light 230 г/11.1 ч, P1 заказ (docs/29), purge-запрос (docs/30), S3-ограничения (docs/31), D-46..D-52
    [bukifon_v04_assembly.3mf, panel_L.3mf, panel_R.3mf]
2026-11-05 release: v0.9.1 — сводный отчёт docs/32 (v0.4→v0.9.1), README/сайт обновлены
    [bukifon_v04_assembly.3mf, panel_L.3mf, panel_R.3mf]
2026-11-05 docs: RC Definition of Done (docs/36) + compliance/SKU-экономика (docs/37) по консультации GPT; D-53..D-57
    [BOM-s3.csv]
2026-11-05 bom: product BOM S3-base kit (BOM-s3.csv + docs/33) — COGS $189/166/149 на 1/10/25, опции, маржа; O-17..O-19
2026-11-05 docs(assembly): сборочная карта 4 стр (1:1 панель + слои + крепёж/шлейфы), docs/34 пошаговая сборка, docs/35 print-first, 3D exploded с платами; B-light fitcheck
    [host_s3.csv]
2026-11-05 release: v0.10.0 — RC-контур: product BOM S3 ($189/$166/$149), сборочная карта+гайд+print-first, прошивка S3 HAL/UI 4 режимов/API v0.1 (146/146), RC DoD (docs/36), compliance (docs/37), D-53..D-57
    [bukifon_v04_assembly.3mf, host.csv, host_s3.csv, panel_L.3mf, panel_R.3mf]
2026-11-05 site: комплекты founders beta $199 / S3 Complete $249–269 / P4 $299 / Full $399, ссылки на RC DoD, compliance и product BOM
2026-11-05 decisions: первый SKU — P4 с RGB (S3 lite позже), Complete $299, P1-стенд заказан, репо пересоздать, тестовая половинка печатать, батарея вне первой партии (D-58..D-62)
    [BOM-cores3.csv, CORE-S3.kicad_sch]
2026-11-05 decisions docs: P4+RGB первого SKU (docs/36/37), P1-стенд утверждён с точными MPN (docs/29), печать тестовой половинки утверждена (docs/35), план пересоздания репо с purge PII (docs/41)
    [BOM-cores3.csv, CORE-S3.kicad_sch]
2026-11-05 docs: DFM/DFT-ревью GPT (docs/42) — 30-точечное pogo-поле, 14 self-test, serialization flash/NVS+24C32, recovery dual OTA, 4 слоя, EOL 2–2.5 мин, founders beta 3+2; D-63..D-67
2026-11-05 security: убрать ложное срабатывание сканера в docs/41 (пример команды)
    [BOM-p4.csv]
2026-11-05 hw(dfm): P4-ветка — docs/38 + hardware/{core2,panel2,power2}/dfm.md: 30 TP, 20 self-test, serialization 24C32, recovery, 6-слойный stackup, чек-листы; S3-lite отдельно; O-17 (TL074=4) и O-18 (TPS6380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
    [BOM-s3.csv]
2026-11-05 spec: ответы на DFM-вопросы — UART+BOOT/JTAG DNP, 24C32 карта, TP28-30, MAX17048 0x36/EN, RGB565 первый SKU/DSI rev.3 (D-68..D-72)
2026-11-05 release: v0.11.0 — P4-first (RGB/DSI, $299), DFM/DFT P4 (30 TP, 20 self-test), BOM-p4 ($219/$194/$176), spike_s3 + p4_profile (160/160), структура: archive/<version> + STRUCTURE.md; D-58..D-72
    [bay_hatch.stl, body_L.3mf, body_L.stl, body_R.3mf, body_R.stl, bottom_L.stl, bottom_R.stl, bukifon_v04_assembly.3mf]
2026-11-05 docs: home-compute через Tailscale (docs/48); решения D-73..D-78 по дисплею RGB565 (MIDAS), DSI rev.3.1, PWR-EVM стенду, раздельной CORE-2-H743
    [BOM-core2.csv, BOM-p4.csv, BOM-s3.csv, CORE-2.kicad_sch, battery_lid.3mf, battery_lid.stl, bench-bom.csv, body_L.3mf]
2026-11-05 hw(core2): rev.3 план (RGB565/DSI, fallback H743), TP28–TP30 в схеме, ERC 0/0; docs/43 bring-up; display selection docs/47 (HotLCD ST7262 40-pin) + BOM/29; PWR bench BOM $102.92 + docs/44
2026-11-05 case(v0.5-C): третий вариант — 12°, закрытый отсек 1S2P с крышкой, складная подставка, кабельный канал; 314 г/20.8 ч, fitcheck 37/0, сравнение A/B/C; docs/45
2026-11-05 release: v0.12.0 — дисплей RGB565 (HotLCD ST7262), CORE-2 rev.3 + TP30 + bring-up, PWR-стенд 13 измерений ($102.92 + EVM вариант A), корпус C 12°, factory self-test 14 (183/183), home-compute; docs/4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
    [bench-bom.csv, body_L.3mf, body_R.3mf, bukifon_v05_B_light_assembly.3mf]
2026-11-05 release: v0.12.1 — PWR-стенд: EVM вариант A утверждён ($123.92 + $153 = $276.92), критерии D-80, bench-bom 29 строк, docs/44 согласован
    [bench-bom.csv, body_L.3mf, body_R.3mf, bukifon_v05_B_light_assembly.3mf]
2026-11-05 release: v0.12.2 — PWR-стенд закрыт (D-79/D-80 статусы, D-78→D-80, $276.92), docs/44 §24/§25
    [body_L.3mf, body_R.3mf, bukifon_v05_B_light_assembly.3mf]
2026-11-05 docs: журнал 13 измерений PWR-2 и матрица go/no-go (docs/51)
2026-11-05 release: v0.13.0 — LCD-адаптер FFC-40 (ERC 0/0), USB HS UAC2 8×8 + RGB565 backend + factory hooks (203/203), release bundle 339 файлов/15МБ, журнал PWR; репозиторий: PNG→JPEG (−83МБ), SVG→.svg.gz (−4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
    [BOM-lcd-adapter.csv, LCD-ADAPTER.kicad_sch, body_L.3mf, body_R.3mf, bukifon_v05_B_light_assembly.3mf, pinout-adapter.csv]
2026-11-05 tools: fresh-history bundle для пересоздания репо (33 МБ); docs: протокол теста эргономики (docs/57 + CSV-форма)
    [usability-results-template.csv]
2026-11-05 release: v0.14.0 — веб-демо (docs/demo, WebAudio FM, 42 клавиши/16 энкодеров, 4 режима), единый закупочный лист $784 (docs/54), QR-метки+identity (docs/55, 216/216), протокол P1 (docs/56+CSV), тест э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
    [body_L.3mf, body_R.3mf, bukifon_v05_B_light_assembly.3mf, p1-results-template.csv]
2026-11-05 site: publish docs/demo (веб-демо) в gh-pages
2026-11-05 release: v0.14.1 — публикация docs/demo на GitHub Pages, сайт ссылается на /demo/
    [body_L.3mf, body_R.3mf, bukifon_v05_B_light_assembly.3mf]
2026-11-05 demo: sharing паттерна через URL + Web MIDI OUT (CC при изменении энкодеров); modules: package_module.py + манифесты + docs/60 (распространение модулей)
2026-11-05 release: v0.15.0 — UI/UX: 16 энкодеров, фейдеры TRACK/SCENE(DJ)+Shift, REC-ресемплинг, 4 темы экрана 800×480, клавиатура 2×3×7 ±18°; docs/59–64, P4 IDF scaffold, упаковка модулей, 216/216 тестов
    [body_L.3mf, body_R.3mf, bukifon_v05_B_light_assembly.3mf]
2026-11-05 release: v0.15.1 — темы экрана в прошивке (4 темы × 12 токенов, рендер на токенах, CLI --theme), 226/226 тестов
    [body_L.3mf, body_R.3mf, bukifon_v05_B_light_assembly.3mf]
2026-11-05 release: v0.16.0 — UX-паттерны (docs/65), GEN-страница/мультивыбор/пресеты/A-B/mod в демо, home offload (tests 226/226 на pole), cmath fix
    [body_L.3mf, body_R.3mf, bukifon_v05_B_light_assembly.3mf]
2026-11-05 release: v0.16.1 — UX-критерии в RC DoD, прогресс-отчёт v0.16, R-32/D-86, release bundle 359 файлов, fresh-history script восстановлен
2026-11-05 release: v0.17.0 — GEN-движок (PROB/EUCLID/MUTATE/SCALE/ARP/EVOLVE/SEED), UI GEN + пресеты + A/B + мультивыбор, 248/248 тестов; docs/66
    [body_L.3mf, body_R.3mf, bukifon_v05_B_light_assembly.3mf]
2026-11-05 release: v0.17.1 — release bundle 365 файлов/15МБ, fresh-history bundle v0.17.0 (34МБ, 960 файлов), docs/41
2026-11-05 release: v0.18.0 — ESP-IDF P4 сборка проверена (idf.py build → bukifon_p4.bin 250 КБ, 83% free), fix CONFIGURE_DEPENDS, docs/59 §8
    [body_L.3mf, body_R.3mf, bukifon_v05_B_light_assembly.3mf]
2026-11-05 release: v0.18.1 — статус сайта под v0.18, docs/59 статус «проверено», 248 тестов
    [body_L.3mf, body_R.3mf, bukifon_v05_B_light_assembly.3mf]
2026-11-05 release: v0.18.2 — бандлы v0.18 (365 файлов/15МБ, fresh 34МБ), docs/41
2026-11-05 release: v0.19.0 — демо-панель как реальная (16 энкодеров вокруг экрана, проверка LAYOUT OK), ChatGPT-ревью + внедрение (контекст-строка/HOME/UNDO/COMPARE/overlay), docs/67, 8.5/10
    [body_L.3mf, body_R.3mf, bukifon_v05_B_light_assembly.3mf]
2026-11-05 site: демо-панель как реальный синтезатор (docs/67), ревью 8.5/10, скриншот обновлён
    [body_L.3mf, body_R.3mf, bukifon_v05_B_light_assembly.3mf]
2026-11-05 release: v0.19.1 — сайт про демо-панель (docs/67), скриншот, sanitize ревью
    [body_L.3mf, body_R.3mf, bukifon_v05_B_light_assembly.3mf]
2026-11-05 release: v0.20.0 — философия интерфейса (docs/68), читаемость 5″ (docs/69), зеркальная карта 16 ручек↔16 ячеек в демо, Cream AA-палитра
    [body_L.3mf, body_R.3mf, bukifon_v05_B_light_assembly.3mf]
2026-11-05 release: v0.20.1 — UI прошивки = философия/читаемость (16 ячеек зеркально, 12/18/24 px, контекст-строка, HOME, Cream AA), 263/263 тестов
    [body_L.3mf, body_R.3mf, bukifon_v05_B_light_assembly.3mf]
2026-11-05 release: v0.21.0 — внешний MIDI-секвенсор: 8 треков + 4 партии, clock/PC/p-lock CC/GEN, режим EXT в демо, docs/70; R-33..36/D-87..90
    [body_L.3mf, body_R.3mf, bukifon_v05_B_light_assembly.3mf]
2026-11-05 release: v0.21.1 — внешний секвенсор в прошивке (8 треков, clock, GEN, save/load, роутер DIN+USB), UI EXT, 288/288 тестов
    [body_L.3mf, body_R.3mf, bukifon_v05_B_light_assembly.3mf]
2026-11-05 release: v0.22.0 — голос как вход: docs/71 (I2S MEMS + 3.5 мм jack, mute+LED, битбокс, вокодер), метрики «идея→звук» в docs/68, MIC/BEATBOX в демо; R-37..39/D-91..95
    [body_L.3mf, body_R.3mf, bukifon_v05_B_light_assembly.3mf]
2026-11-05 release: v0.23.0 — микрофон: PANEL-2 rev.3 (ICS-43434, J16, mute+LED), CORE-2 rev.3 (I2S1, J19, MAX9814/TS5A, SDIO 1-bit), механика (порт/клипсы, 231.4 г), прошивка (запись/битбокс/приватность/UI MIC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
    [BOM-core2.csv, BOM-panel2.csv, CORE-2.kicad_sch, PANEL-2-kicad-bom.csv, PANEL-2.kicad_sch, body_L.3mf, body_R.3mf, bukifon_v05_B_light_assembly.3mf]
2026-11-06 release: v0.23.1 — J19 CORE-2 по канону J16 (1 BCK/2 GND/3 WS/4 GND/5 DATA/6 3V3), ERC 0/0, чек-лист шлейфа; PANEL-2 координаты порта согласованы с механикой
    [BOM-core2.csv, CORE-2.kicad_sch, body_L.3mf, body_R.3mf, bukifon_v05_B_light_assembly.3mf, pinmap.csv]
2026-11-06 release: v0.23.2 — чек-лист шлейфа PANEL-2↔CORE-2 (docs/71 §8.6)
    [body_L.3mf, body_R.3mf, bukifon_v05_B_light_assembly.3mf]
2026-11-06 release: v0.24.0 — гид «где собрать» (docs/72): Москва/СПб/НН, RFQ-шаблон, цены, чек-лист; сайт-секция; docs/54; R-40/D-96
    [body_L.3mf, body_R.3mf, bukifon_v05_B_light_assembly.3mf]
2026-11-06 release: v0.24.1 — ссылка на docs/72 в docs/54 и README
    [body_L.3mf, body_R.3mf, bukifon_v05_B_light_assembly.3mf]
2026-11-06 release: v0.24.2 — утренний отчёт docs/73 (состояние, блокеры, план, риски), handoff/32 обновлены
    [body_L.3mf, body_R.3mf, bukifon_v05_B_light_assembly.3mf]
2026-11-06 release: v0.25.0 — blind UX-харнесс в демо (?test=1: 8 задач, таймер, JSON), docs/74; доки 57/68/README
    [body_L.3mf, body_R.3mf, bukifon_v05_B_light_assembly.3mf]
2026-11-06 docs: ссылка на дистанционный UX-тест в docs/57
2026-11-06 release: v0.25.1 — datasheet-сверка MAX9814/TS5A: 4 расхождения исправлены (TH/EP, CT 470нФ, pinout/полярность TS5A), ERC 0/0; последний инженерный блокер перед PCB закрыт
    [BOM-core2.csv, CORE-2.kicad_sch, body_L.3mf, body_R.3mf, bukifon_v05_B_light_assembly.3mf]
2026-11-06 release: v0.26.0 — ворота v1.0-rc (docs/75 G1–G12), авто-тест UX-харнесса 8/8, фикс потерянных GEN side-effects в демо
    [body_L.3mf, body_L.stl, body_R.3mf, body_R.stl, bukifon_v05_A_assembly.3mf, bukifon_v05_B_light_assembly.3mf, foot.3mf, foot.stl]
2026-11-06 release: v0.26.1 — плоский вариант A в текущем генераторе (302 г/20 ч, fitcheck 17/0), docs/50/45/prints/README обновлены
    [body_L.3mf, body_R.3mf, bukifon_v05_B_light_assembly.3mf]
2026-11-06 release: v0.27.0 — запись с микрофона в демо (REC MIC → PAD, smoke OK), docs/76 «известные ограничения» + сайт; docs/58
    [BOM-p4.csv, body_L.3mf, body_R.3mf, bukifon_v05_B_light_assembly.3mf]
2026-11-06 release: v0.27.1 — COGS с микрофоном (P4 $241/$215/$196, mic-узел $17.6), P1-группа $442.4, итого ≈$800; README/сайт/73
    [BOM-p4.csv, BOM-s3.csv, body_L.3mf, body_R.3mf, bukifon_v05_B_light_assembly.3mf]
2026-11-06 release: v0.28.0 — мобильный сайт RU/EN без overflow, UX-тест CTA, мобильное демо, docs/34 сборка микрофона
    [body_L.3mf, body_R.3mf, bukifon_v05_B_light_assembly.3mf]
2026-11-06 release: v0.29.0 — быстрый старт docs/77, сайт-ссылки (старт/отчёты/ворота), README
    [body_L.3mf, body_R.3mf, bukifon_v05_B_light_assembly.3mf]
2026-11-06 release: v0.29.1 — factory self-test 21 (mic/EEPROM/MCP4728/C6/CV-in/UART/QR), 331/331 тестов, docs/42/38
    [body_L.3mf, body_R.3mf, bukifon_v05_B_light_assembly.3mf]
2026-11-06 release: v0.29.2 — README: 21 self-test (синхронизация с прошивкой)
    [body_L.3mf, body_R.3mf, bukifon_v05_B_light_assembly.3mf]
2026-11-06 release: v0.29.3 — README версия 0.29.x, check_all зелёный
    [body_L.3mf, body_R.3mf, bukifon_v05_B_light_assembly.3mf]
2026-11-06 release: v0.30.0 — docs/78 поддержка/ремонт, PWR bench CSV-шаблон (T1–T13), сайт-ссылка
    [body_L.3mf, body_R.3mf, bukifon_v05_B_light_assembly.3mf, pwr-results-template.csv]
2026-11-06 release: v0.30.1 — Module SDK v0.2 (манифест/loader/2 примера/упаковка), 351/351 тестов; PWR-шаблон в docs/51; root package_module v0.2
    [body_L.3mf, body_R.3mf, bukifon_v05_B_light_assembly.3mf]
2026-11-06 release: v0.31.0 — docs/79 аналоги 2025–2026, P4-сборка на home (351/351, bin 255КБ), фикс cstdio в mic.cpp
    [body_L.3mf, body_R.3mf, bukifon_v05_B_light_assembly.3mf]
2026-11-06 release: v0.31.1 — security: убраны абсолютные $HOME пути в docs/59
    [body_L.3mf, body_R.3mf, bukifon_v05_B_light_assembly.3mf]
2026-11-06 release: v0.32.0 — check_bom_netlist (332/340/116 OK, шаг 7/7), pwr_bench_check (лимиты/--strict), шаблон PWR, off-board пометки
    [BOM-power2.csv, body_L.3mf, body_R.3mf, bukifon_v05_B_light_assembly.3mf, pwr-results-template.csv]
2026-11-06 release: v0.33.0 — docs/80 день-1 runbook (PWR→P1→CORE-2, 15 шагов), check_docs_links (617/0), 20 битых ссылок исправлено; check_all 8/8
    [body_L.3mf, body_R.3mf, bukifon_v05_B_light_assembly.3mf]
2026-11-06 release: v0.34.0 — FAQ (docs/81) + пресс-кит (docs/press) + сайт-FAQ; verify_release_bundle (SHA256/файлы/PII)
    [body_L.3mf, body_R.3mf, bukifon_v05_B_light_assembly.3mf]
2026-11-06 release: v0.35.0 — P4 bring-up app (сборка 330КБ/0 warnings, I2C/display/bench/MEMS), корпуса B_mic/C_mic (278/316 г, fitcheck 44/0, 49/0), docs 45/50/59/71/80/32
    [battery_lid.3mf, battery_lid.stl, body_L.3mf, body_L.stl, body_R.3mf, body_R.stl, bukifon_v05_B_assembly.3mf, bukifon_v05_B_light_assembly.3mf]
2026-11-06 release: v0.35.1 — превью корпусов PNG→JPEG q85 ≤1400px (media policy §4b), ссылки 643/0
    [body_L.3mf, body_R.3mf, bukifon_v05_B_light_assembly.3mf]
2026-11-06 release: v0.36.0 — план разводки PCB rev.1 (docs/82), fab-пакет (docs/83, fab/), checker пакета; ссылки 663/0
    [body_L.3mf, body_R.3mf, bukifon_v05_B_light_assembly.3mf]
2026-11-06 release: v0.37.0 — project v2 (.bkfp: партии+EXT+mic+модули, CRC32, миграция v1, транзакционная загрузка), 365/365 тестов; docs/84 cost-down
    [body_L.3mf, body_R.3mf, bukifon_v05_B_light_assembly.3mf]
2026-11-06 release: v0.38.0 — локализация UI RU/EN (90+ ключей, project v2 lang, 377/377), English docs index/quick start, ci_p4_remote
    [body_L.3mf, body_R.3mf, bukifon_v05_B_light_assembly.3mf]
2026-11-06 release: v0.39.0 — кириллический шрифт 66 глифов (транслит удалён, 391/391), docs/85 вторые источники + bom_second_source
    [body_L.3mf, body_R.3mf, bukifon_v05_B_light_assembly.3mf]
2026-11-06 release: v0.39.1 — синхронизация счётчиков тестов (391/391) в docs/32/73/75
    [body_L.3mf, body_R.3mf, bukifon_v05_B_light_assembly.3mf]
2026-11-06 release: v0.40.0 — демо RU/EN (256 ключей, a11y, EXT-энкодеры, UX-тест RU/EN PASS), GitHub Actions CI, портируемый security_scan
    [body_L.3mf, body_R.3mf, bukifon_v05_B_light_assembly.3mf]
2026-11-06 release: v0.41.0 — бэклог веб-экосистемы (VDS/букифон.ру, PWA, DAW-плагин) R-41..44/D-97..100, черновик release notes v1.0-rc; roadmap P9
    [body_L.3mf, body_R.3mf, bukifon_v05_B_light_assembly.3mf]
2026-11-06 release: v0.42.0 — сайт задеплоен на VDS (HTTPS, sslip), deploy_vds.sh + nginx + docs/88; DNS bukifon.ru/.com ожидает
    [body_L.3mf, body_R.3mf, bukifon_v05_B_light_assembly.3mf]
2026-11-06 release: v0.42.1 — авто-TLS watcher для bukifon.ru/.com (cron на VDS), docs/88; сайт уже на HTTPS (sslip)
    [body_L.3mf, body_R.3mf, bukifon_v05_B_light_assembly.3mf]
2026-11-06 release: v0.43.0 — storage backend + атомарное A/B хранение (project/presets/язык, recovery, 407/407), VDS-бэкапы, авто-TLS
    [body_L.3mf, body_R.3mf, bukifon_v05_B_light_assembly.3mf]
2026-11-06 release: v0.43.1 — nginx vhosts по доменам (bukifon.com/.ru/sslip), DoH-проверка DNS в auto-TLS watcher, docs/88
    [body_L.3mf, body_R.3mf, bukifon_v05_B_light_assembly.3mf]
2026-11-06 release: v0.44.0 — board-fit для PCB rev.1 (контуры/DXF/22 проверки), исправление TBD в docs/82, make_rc_bundle
    [assembly.dxf, body_L.3mf, body_R.3mf, bukifon_v05_B_light_assembly.3mf, core2.dxf, panel2left.dxf, panel2right.dxf, pwr2.dxf]
2026-11-06 release: v0.44.1 — bukifon.com переведён на HTTPS (www→apex 301), исправлен auto-TLS watcher (инвертированная проверка A), docs/88
    [body_L.3mf, body_R.3mf, bukifon_v05_B_light_assembly.3mf]
2026-11-06 release: v0.45.0 — каркасы PCB rev.1 (4 платы, DRC 0/0, verify PASS) + вырезы разъёмов во всех корпусах (перемычки 3.5 мм, B-light 231.1 г)
    [CORE-2-rev1.kicad_pcb, PANEL-2-left-rev1.kicad_pcb, PANEL-2-right-rev1.kicad_pcb, PWR-2-rev1.kicad_pcb, battery_lid.3mf, body_L.3mf, body_L.stl, body_R.3mf]
2026-11-06 release: v0.46.0 — импорт нетлиста и футпринтов в каркасы PCB rev.1 (CORE-2 373 refs, PANEL-2 181/174, PWR-2 128; DRC 0/0, verify PASS)
    [CORE-2-rev1.kicad_pcb, PANEL-2-left-rev1.kicad_pcb, PANEL-2-right-rev1.kicad_pcb, PWR-2-rev1.kicad_pcb, body_L.3mf, body_R.3mf, bukifon_v05_B_light_assembly.3mf]
2026-11-06 release: v0.47.0 — реальные футпринты (0 placeholder), DRC-классы/90Ω USB/RULES PASS, план GND; canonical на bukifon.com
    [CORE-2-rev1.kicad_pcb, PANEL-2-left-rev1.kicad_pcb, PANEL-2-right-rev1.kicad_pcb, PWR-2-rev1.kicad_pcb, body_L.3mf, body_R.3mf, bukifon_v05_B_light_assembly.3mf]
2026-11-06 release: v0.48.0 — fab dry-run 4 плат (checker PASS) + P4 partitions/NVS (bin 369КБ, 65% factory free); компиляционные фиксы
    [CORE-2-rev1-B_Courtyard.gbr, CORE-2-rev1-B_Cu.gbl, CORE-2-rev1-B_Fab.gbr, CORE-2-rev1-B_Mask.gbs, CORE-2-rev1-B_Paste.gbp, CORE-2-rev1-B_Silkscreen.gbo, CORE-2-rev1-Edge_Cuts.gm1, CORE-2-rev1-F_Courtyard.gbr]
2026-11-06 release: v0.48.1 — bukifon.ru канон (HTTPS), .com/www → 301, canonical/sitemap на .ru
    [CORE-2-rev1.kicad_pcb, PANEL-2-left-rev1.kicad_pcb, PANEL-2-right-rev1.kicad_pcb, PWR-2-rev1.kicad_pcb, battery_lid.3mf, body_L.3mf, body_L.stl, body_R.3mf]
2026-11-06 release: v0.49.0 — все вырезы разъёмов (MIDI TRS, LINE/PHONES/AUDIO IN/CV5-6, B-light 230.9 г), честный статус PCB (D-105: упрощённые пады/GND до трассировки)
    [CORE-2-rev1.kicad_pcb, PANEL-2-left-rev1.kicad_pcb, PANEL-2-right-rev1.kicad_pcb, PWR-2-rev1.kicad_pcb, battery_lid.3mf, body_L.3mf, body_R.3mf, bukifon_v05_A_assembly.3mf]
2026-11-06 release: v0.50.0 — срез статуса v1.0-rc (сайт RU/EN, docs/75): 407 тестов, PCB каркасы DRC 0/0 + fab dry-run, bukifon.ru канон, B-light 230.9
    [body_L.3mf, body_R.3mf, bukifon_v05_B_light_assembly.3mf]
2026-11-06 fix(panel): клавиши PANEL-2 по Lapka-42 (KEY_L/R раздельно, spec-координаты/углы, DRC 0/0); корпус A/A_mic с вырезами; release v0.51.0
    [CORE-2-rev1.kicad_pcb, PANEL-2-left-rev1.kicad_pcb, PANEL-2-right-rev1.kicad_pcb, PWR-2-rev1.kicad_pcb, battery_lid.3mf, body_L.3mf, body_L.stl, body_R.3mf]
2026-11-06 release: v0.52.0 — PANEL-2 параллельна панели (стойки/плата 0.00°, зазор 12 мм), B-light 228.9 г; софтовые модули/машины в бэклог (docs/91, R-45/46)
    [battery_lid.3mf, body_L.3mf, body_L.stl, body_R.3mf, body_R.stl, bukifon_v05_A_assembly.3mf, bukifon_v05_A_mic_assembly.3mf, bukifon_v05_B_assembly.3mf]
2026-11-06 release: v0.52.1 — сайт: профиль PANEL-2 ∥ панели и задние разъёмы, веса; docs/90 финальный отчёт; проверки 407/P4 369КБ
    [body_L.3mf, body_R.3mf, bukifon_v05_B_light_assembly.3mf]
2026-11-06 release: v0.53.0 — сайт-секция «Скачать» (STL/PDF/BOM/прошивка), docs/90 финальная проверка (8/8, 407, P4 369КБ, DRC 0, fab PASS)
    [body_L.3mf, body_R.3mf, bukifon_v05_B_light_assembly.3mf]
2026-11-06 release: v0.54.0 — синхронизация весов корпусов (README/сайт/docs 34/35), docs/27 исторический; check_all 8/8
    [body_L.3mf, body_R.3mf, bukifon_v05_B_light_assembly.3mf]
2026-11-06 release: v0.55.0 — docs/90 §6: v1.0-rc не достигнут, физические блокеры и условие тега rc.1
    [body_L.3mf, body_R.3mf, bukifon_v05_B_light_assembly.3mf]
2026-11-06 release: v0.56.0 — шаблон панели 1:1 на A3 + 4×A4 с перекрытием (низ больше не обрезается), проверка колпачков вне панели в check_all
    [body_L.3mf, body_R.3mf, bukifon_v05_B_light_assembly.3mf]
2026-11-06 release: v0.57.0 — чистка репозитория: удалены archive/ (30МБ), two-sided (8.3МБ), fab dry-run (2.8МБ), gzip SVG, JPEG-превью, unused assets; legacy spec для генераторов; tracked 170МБ→~68МБ
    [CORE-2-rev1-B_Courtyard.gbr, CORE-2-rev1-B_Cu.gbl, CORE-2-rev1-B_Fab.gbr, CORE-2-rev1-B_Mask.gbs, CORE-2-rev1-B_Paste.gbp, CORE-2-rev1-B_Silkscreen.gbo, CORE-2-rev1-Edge_Cuts.gm1, CORE-2-rev1-F_Courtyard.gbr]
2026-11-07 docs: бриф для ChatGPT по развитию проекта (контекст, статус, вопросы)
